kartben/hw-testing-rack/firmware/README.md

# Firmware (Zephyr)

Two applications, both on an ESP32-S3, share this tree:

| | |
|---|---|
| **Bay node** (this page) | one per bay: the board under test over USB/IP, its 5 V, its console |
| **[Power hub](power-hub/README.md)** | one per rack: USB-C PD in, rows A–D, the rack bus (CAN) master |

They speak the rack bus protocol ([docs/rack-protocol.md](../docs/rack-protocol.md))
and share [`common/`](common/): the protocol, the CH224A and CH446Q drivers,
Wi-Fi, hostname and DNS-SD, the web pages' CSS and helpers, xterm.js, the development server
and the screenshot tooling.

Firmware for the ESP32-S3 on each [bay node](../electronics/bay-node/design.py):
it exports the board under test (DUT) over the network with Zephyr's
**USB/IP host service**, switches and meters its 5 V, and gives remote access
to its console and RESET/BOOT lines.  It dogfoods Zephyr's new USB host stack
(`uhc_dwc2` on the ESP32-S3 OTG controller + `subsys/usb/host/usbip.c`).

> **Status:** builds against Zephyr main (4.5.0-rc2, pinned in
> [`west.yml`](west.yml)); **not yet run on hardware** — no bay node PCB has
> been assembled.  See [open items](#open-items).

```
firmware/
  west.yml                       west manifest (Zephyr main + hal_espressif + crypto)
  boards/hwtr/bay_node/          board definition: bay_node/esp32s3/procpu
  boards/hwtr/power_hub/         board definition: power_hub/esp32s3/procpu
  dts/bindings/                  hwtr,* bindings (dut-port, usb-mux, rack-bus, rack-rows,
                                 power-hub) and wch,ch224a (the hub's PD sink, a regulator)
  common/                        shared by both applications
    include/hwtr/, lib/          rack bus protocol (frames, hub and node state machines), Wi-Fi
    drivers/                     CH224A USB PD sink as a regulator (out of tree)
    web/                         rack.css, rack.mjs, vendor/xterm (xterm.js 6.0.0, MIT),
                                 devserver.py, shots.py
    tests/rack_bus/              the rack bus on a simulated rack (ztest, native_sim)
    tests/usbip/                 the patched USB/IP service on native_sim's virtual USB bus,
                                 a device unplugged mid-session (test_usbip.py)
  spikes/usb-hub/                bench app: a hub and several DUTs behind an ESP32-S3
  spikes/coproc/                 build-only: the DATA ×4 v2 co-processor's jobs on a Pico 2 (RP2350)
  power-hub/                     the power hub application (its own README)
  bay-node/                      the bay node application
    boards/esp32s3_devkitc_procpu.overlay   stand-in: same pin map on a DevKitC-1
    i2c-400k.overlay             the I²C bus at 400 kHz, to try at bring-up (100 kHz by default)
    app.overlay, data-x4.dtsi    a DATA ×4 on the DATA lead (the application's, not the board's: MCUboot)
    data-x6.dtsi                 or a DATA ×6: the same lead and image, told apart at each probe
    boards/m5stack_stamps3_procpu.*         bench node on a StampS3: console + network, no USB host
    boards/m5stack_cores3_procpu.*          bench node on a CoreS3: USB host and USB/IP on its USB-C ([docs/bench.md](../docs/bench.md))
    boards/xiao_esp32s3_procpu.*            bench node on a XIAO ESP32-S3: octal PSRAM as the node, USB host on its USB-C (same doc)
    web/index.html               status page and serial console (embedded gzipped)
    web/dev_server.py            the page against a simulated node, to work on the UI
    web/camera/, grab_camera.py  its camera's frames, grabbed from the 3D viewer (site/)
    tests/rfc2217/               host test of the RFC 2217 server against pyserial
    tests/console_sim/           the console, web server and RFC 2217 code on native_sim, with a Zephyr DUT
    wifi.conf.example            build-time Wi-Fi credentials (copy to wifi.conf)
```

## Building

A dedicated workspace, with this repository as the manifest repository:

```bash
west init -m https://github.com/kartben/hw-testing-rack --mf firmware/west.yml rack-ws
cd rack-ws
west update
west patch apply                        # Zephyr patches, until upstream (zephyr/patches.yml)
west blobs fetch hal_espressif          # Wi-Fi binary blobs
west packages pip --install             # esptool & co. for the ESP32 build
west build --sysbuild -b bay_node/esp32s3/procpu hw-testing-rack/firmware/bay-node
```

`--sysbuild` builds MCUboot in front of the application, for the updates
over the network ([docs/firmware.md › Over the network](../docs/firmware.md#over-the-network));
the images are signed with MCUboot's public test key unless
`HWTR_SIGNING_KEY` points at your own ([Signing key](../docs/firmware.md#signing-key)).
Without `--sysbuild`: the application alone, no updates over the network.

The repository is a Zephyr module (`zephyr/module.yml` at its root: the
boards, the bindings, `firmware/common/`).  West finds it in the workspace
above; each application also adds it itself (`ZEPHYR_EXTRA_MODULES`), so a
plain build works from any Zephyr workspace at a recent `main` (with
`hal_espressif` blobs fetched).  Sysbuild needs it known before the
application: there, add `-- -DEXTRA_ZEPHYR_MODULES=path/to/hw-testing-rack`.

```bash
west build -b bay_node/esp32s3/procpu path/to/hw-testing-rack/firmware/bay-node
west build -b power_hub/esp32s3/procpu path/to/hw-testing-rack/firmware/power-hub
```

No bay node yet?  An ESP32-S3-DevKitC-1 with the same GPIO map stands in
(status on the devkit's RGB LED, DUT on its "USB" port through an OTG adapter):

```bash
west build --sysbuild -b esp32s3_devkitc/esp32s3/procpu hw-testing-rack/firmware/bay-node
```

An M5Stack StampS3 is an even smaller bench node for the serial console and
the network side: no muxes, INA226 or USB host, and its USB-C port carries
the node's shell and logs (USB-Serial-JTAG).  The AUX UART and the
RESET/BOOT lines are on header pins (G1/G2, G4/G5; the map is in
[the overlay](bay-node/boards/m5stack_stamps3_procpu.overlay)), and
`bay aux loopback on` loops the UART back on itself to try the console
without a DUT:

```bash
west build --sysbuild -b m5stack_stamps3/esp32s3/procpu hw-testing-rack/firmware/bay-node
west flash --erase    # over its USB-C port; --erase once, see below
```

A module that ran other firmware may hold something else where the
settings live (`settings unavailable (-45)` at boot, nothing saved): erase
the flash once (`west flash --erase`, or just the `storage` partition).

Wi-Fi credentials can be built in — handy to flash a whole rack:

```bash
cp hw-testing-rack/firmware/bay-node/wifi.conf.example hw-testing-rack/firmware/bay-node/wifi.conf   # edit it
west build --sysbuild -b bay_node/esp32s3/procpu hw-testing-rack/firmware/bay-node -- -DEXTRA_CONF_FILE=wifi.conf
```

`wifi.conf` is git-ignored.  On Windows keep the workspace and build
directory on a short path (e.g. `C:\rack-ws`): `hal_espressif` and
`tf-psa-crypto` have file paths long enough to hit `MAX_PATH`.

## Flashing

The node runs from its row: the hub must have the row on (on a desk: 15–30 V
on J1, pin 1 +: the buck starts above 13.5 V).

1. Slide the bay's **SERVICE** switch on and plug a laptop into the front
   **PC** port, both on the fascia.  The firmware stops its USB host and
   hands the ESP32-S3's single USB PHY back to the USB-Serial-JTAG (LED
   yellow), which shows up as a serial port (and a JTAG adapter for
   OpenOCD).  A blank module shows it at once.
2. `west flash` (esptool resets the chip into its ROM loader over USB).  If
   the firmware is wedged (it takes the PHY and never lets it go), pull the
   drawer out, hold **BOOT** and tap **RESET**, or keep BOOT held while the
   hub power-cycles the row from its page (the row's other bays restart too):
   RESET sits partly under the drawer's left ledge, BOOT is clear.
3. SERVICE off: the host controller restarts and the DUT is back on USB/IP.

Both boards, recovery and the update plan (MCUboot, over Wi-Fi):
[docs/firmware.md › Programming](../docs/firmware.md#programming).

## First boot

The shell runs on the UART test pads (TP1 = TXD0, TP2 = RXD0, 115200 8N1) and,
once the node is on the network, over telnet (port 23).

```console
uart:~$ wifi cred add -s MyLab -k 1 -p secret      # stored in flash (settings)
uart:~$ wifi cred auto_connect
uart:~$ bay id b3                                   # hostname bay-b3.local, stored
uart:~$ bay status
```

Then, from any Linux machine on the LAN:

```console
$ usbip list -r bay-b3.local
$ sudo usbip attach -r bay-b3.local -b 1-1
$ open http://bay-b3.local/                # status page and DUT console
$ telnet bay-b3.local                     # bay shell
$ python -m serial.tools.miniterm rfc2217://bay-b3.local:4001 115200   # DUT console
```

## What it does

| Feature | Implementation |
|---|---|
| USB/IP export of the DUT | `CONFIG_USBIP` on `zephyr_uhc0` (= `&usb_otg`, DWC2 host, ESP32-S3 FS quirk), with the rack's patch (`zephyr/patches.yml`); TCP 3240; bus id by port: `1-1` (`1-1.<n>` behind a hub) |
| DUT power | TPS2553 EN on IO41, kept **on** at boot (the board pulls it up); `bay power on/off/cycle`.  Node v1.0 (`dut_port`'s `vin-efuse`): IO41 is the TPS26600's SHDN on the DATA lead's 20–28 V, **off** at boot and on only through [the DATA lead's power-on rule](../docs/firmware.md#the-data-leads-power-on-rule-node-v10) (SCL/SDA high, the INA226 answers, DATA_VIN up, the DATA board answers within `CONFIG_BAY_DATA_ANSWER_MS`); `CONFIG_BAY_DATA_POWER_AT_BOOT` tries it at boot |
| Over-current | TPS2553 ~FAULT on IO40 (interrupt): logged and counted; after `CONFIG_BAY_DUT_FAULT_OFF_MS` (1 s) in current limit VBUS is switched off and the fault latched until `bay power on`.  v1.0: the eFuse's ~FLT, or a DATA board that misses two polls, switches DATA_VIN off at once until `bay power on` |
| Telemetry | INA226 @ 0x40 through the Zephyr sensor API (`ti,ina226`, 50 mΩ, 50 µA/LSB, 4× averaging, 8.8 ms a reading): bus mV, mA, mW in `bay power` / `bay status` |
| Data path | reads PC_DET (IO13) and SVC (IO15); `bay mode classic` drives MUX_FORCE_PC (IO14), persisted |
| DATA ×4 co-processor | its image (a `no_flash` UF2, `bayctl coproc load`) in the `coproc` partition, loaded into its SRAM over PICOBOOT whenever it shows up in its bootloader on hub port 5 (`src/coproc.c`, [docs/firmware.md](../docs/firmware.md#open-items)); `/api/coproc`, `bay coproc` |
| SERVICE mode | stops the USB host and routes the internal PHY to the USB-Serial-JTAG (`CONFIG_BAY_SERVICE_PHY_HANDOVER`); restarts the host when SERVICE goes off |
| AUX console | UART1 (IO47 TX / IO21 RX), interrupt driven, shared by the web console (WebSocket, xterm.js), an RFC 2217 server (port 4001) and raw TCP (port 4000); settings persisted per bay; BREAK; TX released while the DUT is off.  See [Serial console](#serial-console) |
| AUX RESET/BOOT | open-drain pulses (IO12/IO48): `bay reset`, `bay boot`, the console's buttons, optionally RFC 2217 DTR/RTS (esptool) |
| Status LED | WS2812B on IO38 through the RMT (`worldsemi,ws2812-pulse-io`), see below |
| Buttons | BOOT (IO0) once booted: short press confirms an access claim, held ≥ 1 s power-cycles the DUT, ≥ 10 s resets access control.  RESET is the ESP32's EN |
| Camera | an Arducam Mega on J6 (SPI2, 4 MHz) and its light (LEDC PWM, 25 kHz), optional: snapshots and an MJPEG stream on TCP 8081, frames in PSRAM.  See [Camera](#camera) |
| Access control | who may use which service, a CI reservation, an admin key confirmed by a BOOT press; Zephyr's packet filter for the TCP services, a check per HTTP request.  See [Access control](#access-control) |
| USB devices | each enumerated device on the page's USB devices card, in `/api/usb` and `bay usb`: its name (the product string, else a table of known IDs, else vid:pid), maker, serial number, the classes of its interfaces (CDC ACM, HID, mass storage, CMSIS-DAP…), speed, bus id and slot, and its USB/IP client.  A thread reads each device's strings once, as it shows up, into PSRAM (`src/usb_info.c`) |
| DATA ×4 | a DATA ×4 board in the drawer (probed after each DUT_5V on): four ports, each switched on through the bay's budget, its ~FAULT, current and RESET/BOOT; `bay port`, `/api/ports`.  See [docs/multi-dut-node.md](../docs/multi-dut-node.md) |
| DATA ×6 | a DATA ×6 instead, on the same lead with the same image: the probe tells the boards apart (a DATA ×4 answers at 0x21, a DATA ×6 at 0x4C); six ports, each switched on through the bay's budget, its ~FAULT and current, no RESET/BOOT; the co-processor's hub port is its USB-C 6, left to USB/IP.  Tested on native_sim, not on a board yet ([docs/multi-dut-node.md › Which board](../docs/multi-dut-node.md#which-board-data-4-or-data-6)) |
| Board targets | each slot's Zephyr board, runner, probe and console, in NVS for the device in it; `/api/boards`, the page's Edit; `bayctl hwmap` reads them ([Board targets](#board-targets)) |
| Rack bus | CAN on the row cable (TWAI, IO18 TX / IO17 RX, 250 kbit/s) and the POS token (IO16 in, IO42 out): the node takes its position from the hub (node id = row × 16 + position, `C3` = 0x23), sends STATUS every second and INFO (IP, firmware) every 10 s, an ALERT on a DUT fault, and runs the hub's commands (power, reset, bootloader, identify, reboot; the ones that disturb the board are refused while the bay is reserved).  `src/rack.c` on `common/lib/rack_node.c`; the protocol is [docs/rack-protocol.md](../docs/rack-protocol.md) |
| Network | Wi-Fi station, DHCP, Wi-Fi credentials library (settings or build time), reconnects on its own; hostname `bay-<id>` answered over mDNS, its services advertised over DNS-SD (below); no power save, 20 MHz channels and 11 dBm of TX power, see [Wi-Fi in the rack](#wi-fi-in-the-rack) (`common/lib/net.c`, as the hub) |
| Shell | `bay …` commands, `radio`, plus the stock `wifi`, `net` shells, on UART0 and telnet |
| Fatal errors | restart the node instead of halting it (`src/fault.c`): a bay has to come back by itself, and its console is the USB host's.  The reason, the thread and the warnings and errors logged just before are kept across the restart in RTC memory, then reported: the log, `bay status` ("restarted: …"), `bay fault`, `/api/status`'s `last_fault`.  Gone at power-on |
| Web | Zephyr HTTP server on port 80: status page, JSON API (same actions as the shell), Prometheus `/metrics` through Zephyr's Prometheus library |

### Shell

| Command | Effect |
|---|---|
| `bay status` | id/hostname, IP, rack position, data path, USB host (devices, USB/IP sessions), power and V/I/P, fault count, AUX stats |
| `bay fault` | the fatal error that restarted the node and the log just before it; the warnings and errors since this boot |
| `bay power` | DUT VBUS state and V/I/P |
| `bay power on` / `off` | switch DUT VBUS (`on` also clears a latched fault) |
| `bay power cycle [ms]` | off, wait (default 1000 ms), on |
| `bay reset [ms]` | pulse the DUT's RESET line low (default 100 ms) |
| `bay reset hold` / `release` | hold / release RESET |
| `bay boot` | hold BOOT, pulse RESET, release BOOT 200 ms later: ROM bootloader on most MCUs |
| `bay boot hold` / `release` | hold / release the BOOT strap |
| `bay usb` | the USB devices: bus id, vid:pid, name and maker, serial number, read-ahead, USB/IP client |
| `bay port` | the DATA board (×4 or ×6) and its ports: busid, on/off, fault, V/I, USB device |
| `bay port <n> on` / `off` / `cycle [ms]` | one port (`on` through the bay's budget, and clears a latched fault) |
| `bay port <n> reset` / `boot [cycle]` | its RESET pulse; BOOT held across a RESET pulse, or across a power cycle of the port (a DATA ×4's ports; a DATA ×6 has no such line) |
| `bay mode [usbip\|classic]` | show, or force/release classic mode (persistent) |
| `bay aux` | AUX UART settings, consoles connected, byte counters |
| `bay aux <baud> [8N1]` | set and save the AUX UART baud rate and format (`7E1`, `8O2`, …) |
| `bay aux break [ms]` | hold the DUT's RX line low (default 250 ms) |
| `bay aux send <text>` | send a line to the DUT (with the console's Enter) |
| `bay aux loopback [on\|off]` | test without a DUT: the UART loops its TX back to its RX (ESP32) |
| `bay id [id]` | show or set the bay id (persistent), hostname `bay-<id>.local`; without one, the rack position (`bay-c3.local`) |
| `bay camera` | the camera: model, clients, frames, and its settings |
| `bay camera set <name> <value>` | one setting, saved: `exposure auto` or `1200`, `white_balance cloudy`, `brightness -1`, … ([Camera](#camera)) |
| `bay camera reset` | the image settings back to automatic (resolution, quality, light, rotation kept) |
| `bay access` | access control: admin key, rules, lease, connections, refusals |
| `bay access claim` | confirm a pending claim, like a short press on BOOT (not over telnet) |
| `bay access on` / `off` | apply the rules / let every address use everything (`off`: not over telnet) |
| `bay access release` | end the lease |
| `bay access reset` | forget the admin key, the rules and the lease (not over telnet) |
| `radio [<dBm>]` | show, or set and save, the Wi-Fi TX power (2–20 dBm; the hub has it too) |

### Network services

| Port | Service |
|---|---|
| TCP 3240 | USB/IP (`usbip list` / `usbip attach`) |
| TCP 80 | status page, serial console (WebSocket `/console/ws/<n>`), JSON API, `/metrics` (`CONFIG_BAY_HTTP_PORT`) |
| TCP 23 | telnet shell (no login of its own: give the shell right to admin hosts only) |
| TCP 4001 | AUX UART, RFC 2217, one client (`CONFIG_BAY_RFC2217_PORT`) |
| TCP 4000 | AUX UART, raw bytes, one client (`CONFIG_BAY_AUX_TCP_PORT`) |
| TCP 8081 | the camera: `/snapshot.jpg`, `/stream.mjpg`, up to 3 clients (`CONFIG_BAY_CAMERA_PORT`, `_CLIENTS`); 503 without a camera |
| UDP 5353 | mDNS: `bay-<id>.local`; without an id, the rack position the hub gave (`bay-c3.local`); before that `bay<MAC>`.  DNS-SD, under that name: `_http._tcp` (80), `_usbip._tcp` (3240) while the DUT is on the S3's USB (not in classic or service mode), `_rfc2217._tcp` (4001) while it listens; TXT `id`, `pos` (rack position), `fw`, `mode` (`usbip`, `classic`, `service`) and `slots` with a DATA ×4.  Checked every 2 s (`common/lib/dnssd.c`), answers kept 2 min in caches (`avahi-browse -rt _usbip._tcp`, `dns-sd -B _usbip._tcp`) |

Which address may use which of them: [Access control](#access-control).
Until a node is claimed it is open, as it always was.

### Wi-Fi in the rack

Twelve nodes in rows A–C (sixteen if row D is used), the hub and the DUTs' own radios
share one room, with each node's antenna about 10 cm from its DUTs.  So each
node (and the hub, through `common/lib/net.c`) sets its station's radio
before every connection.  A BabbleSim model of the rack
([docs/wifi-coexistence.md](../docs/wifi-coexistence.md)) ranks what helps a
BLE link between two DUTs: the host's channel classification first, then the
node's TX power and the AP's distance; the Wi-Fi channel and the number of
nodes hardly matter.

- **No power save**: the radio stays awake.  In modem sleep (the ESP32 driver's
  default) the AP holds every frame for the node until the next DTIM beacon:
  the bench XIAO answered a ping from a wired PC in 174 ms on average, up to
  350 ms, against 13–16 ms awake.  It costs about 0.2 W per node, already in
  [the power budget](../docs/power.md)'s 0.7–1 W.
- **20 MHz channels** (HT20): a 40 MHz channel would spill onto the next one.
- **11 dBm of TX power** instead of the radio's full 20 dBm
  (`CONFIG_HWTR_NET_TX_POWER_DBM`; `radio <dBm>` changes it and saves it).
  With the AP 1–3 m away that still leaves 30 dB of margin, and the DUTs hear
  much less of the nodes.  On the bench XIAO (RSSI −49 dBm) the status page
  loaded no slower at 11 or 8 dBm than at 20.
- **A lost link is held**: 15 s without the AP's beacons before the link
  counts as lost (`CONFIG_HWTR_NET_BEACON_TIMEOUT_S`, 6 s by default), then up
  to 30 s with the interface up and its address kept while the station
  reconnects (`CONFIG_ESP32_WIFI_STA_LINK_HOLD_MS`, a patch in
  [zephyr/patches.yml](../zephyr/patches.yml)).  Without it, every drop took
  the address and every USB/IP session down.  The connections stay open; a
  transfer in flight still has to end within its client's timeout (30 s for a
  mass storage command).  `bay fault` lists each loss with its reason ("Link
  lost, reason N").

Set the AP up for it:

- one channel for the whole rack, **6 or 11**, not 1: a DATA ×4's USB hub
  runs a 480 MHz PLL, whose 5th harmonic is 2.400 GHz, at the bottom of channel 1;
- that channel **fixed**, not chosen automatically, and **one AP, without mesh
  nodes or repeaters**: on the bench a home mesh dropped its stations now and
  then (reason 200, beacons missing; reason 6, sent away, at RSSI −46), the
  node and a PC on another of its APs at the same second, and moved the node
  from channel 6 to 2;
- 20 MHz wide on 2.4 GHz;
- 1–3 m from the rack, behind it or beside it, not in front of the drawers.

How much one channel carries (an ns-3 study, [wifi-capacity-ns3.md](../docs/wifi-capacity-ns3.md)):
- 8 simultaneous USB/IP flashes at full speed;
- saturation between 8 and 12 flashes, at about 3.2 MB/s;
- half of that when the DUTs' own Wi-Fi or a neighbour shares the channel.

So:
- a dedicated AP with 11b off;
- the DUTs' Wi-Fi inside the bays on the rack's channel, and distant DUT networks on the other;
- at most 8 flashes at once per channel.

**Radio-quiet mode** (not built yet).  A DUT's own RF test, a range or
sensitivity measurement, wants the node's radio as quiet as it can be for its
duration.  Planned: `radio quiet <s>` (and the API) drops the TX power to
2 dBm and holds the USB/IP traffic of the node's other DUTs, until the time
runs out or `radio quiet off`, then puts both back.  The node stays
associated: the session that runs the test keeps its link.

### Web page and API

`http://bay-<id>.local/` is a single self-contained page: plain HTML, CSS and
an ES module, no framework or CDN, about 25 KB gzipped in flash (plus
xterm.js for the console, below).  It follows the browser's light/dark
theme, polls `/api/status` every 2 s while visible, and offers the shell's
main actions.

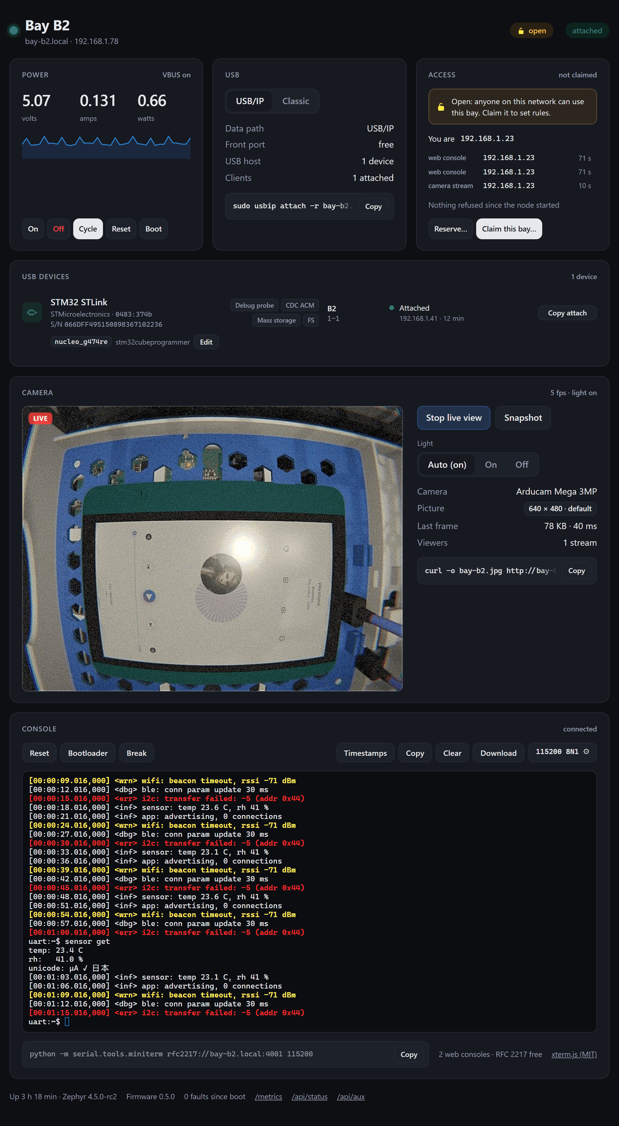
[picture p6: docs/img/web-ui-dark.png]
Status page of bay B2, dark theme: VBUS on with live V/I/P and a current sparkline, a USB/IP client attached


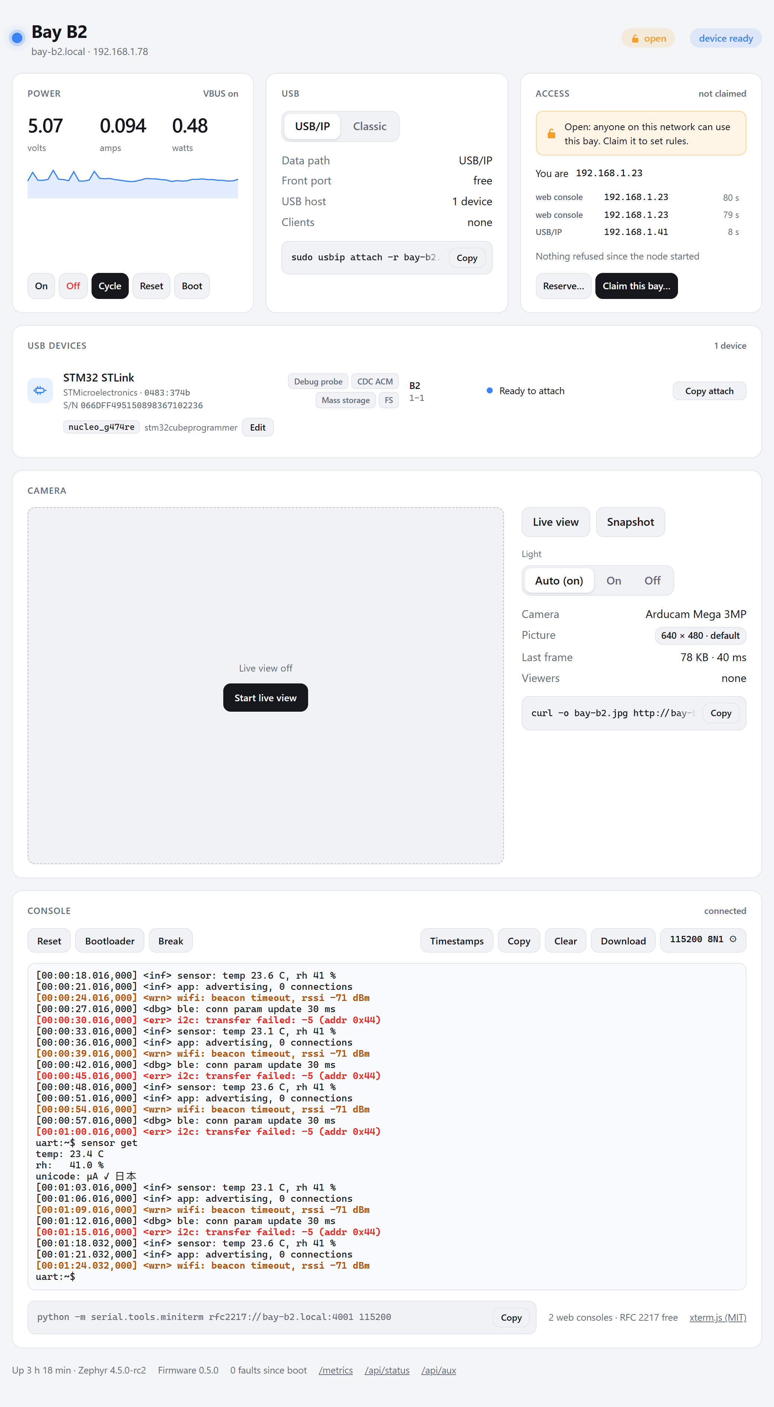
[picture p7: docs/img/web-ui-light.png]
Status page, light theme: the DUT is enumerated and ready to be attached
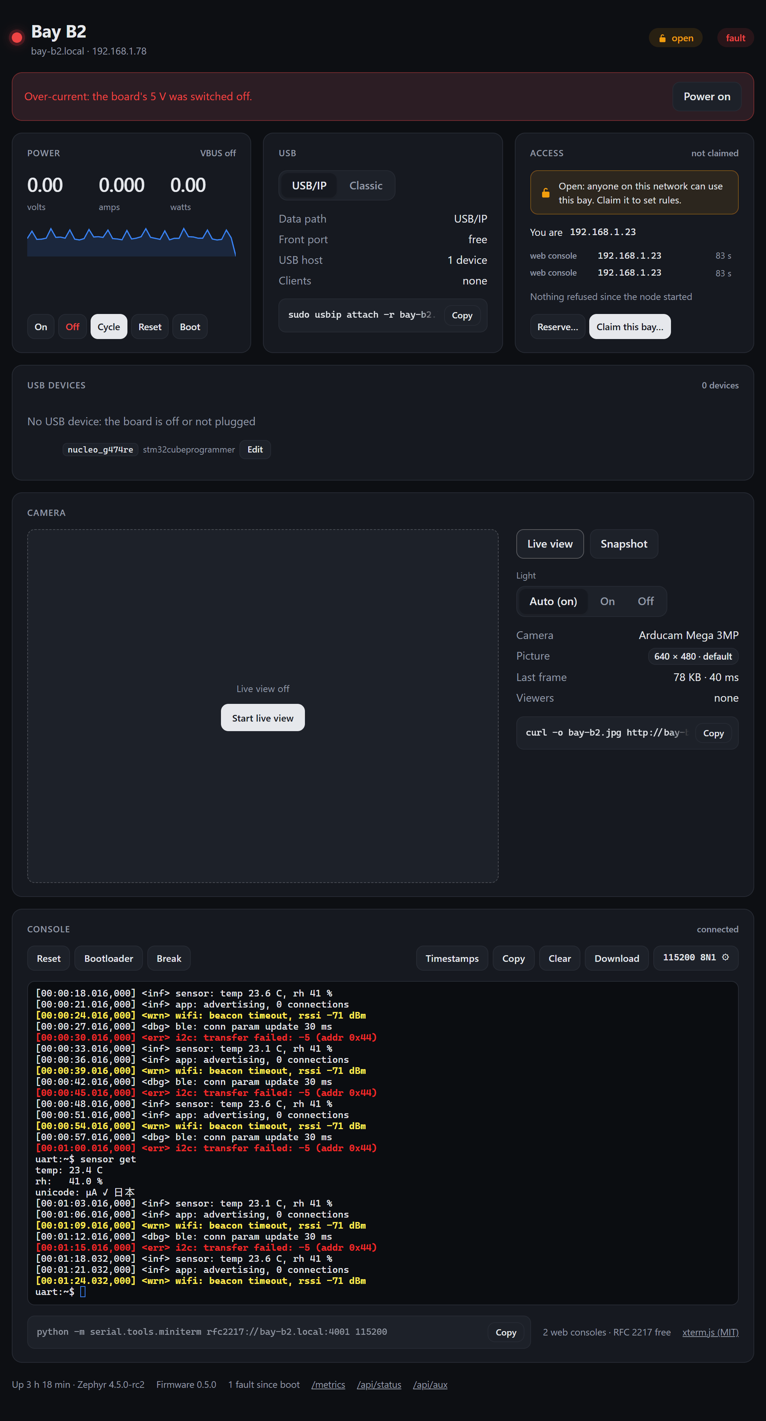
[picture p8: docs/img/web-ui-fault.png]
Status page after an over-current trip: red banner with a Power on button, VBUS off
|  |  |
|---|---|
| Light theme, DUT enumerated and ready to attach | Over-current: VBUS cut by the firmware |

| Endpoint | |
|---|---|
| `GET /api/status` | everything `bay status` shows, as JSON; `data_board`: the board on the DATA lead, `"x4"`, `"x6"`, `"unknown"` (something at 0x20 that is neither, left alone) or `null`, shown as the page's header badge; `rack`: `node` (0 before the hub gave one), `pos` (`"C3"`), the hub's contract; `camera` (camera builds): `GET /api/camera` without the settings and choices; `last_fault`: the fatal error that restarted the node ("fatal error 4 in usbh: …"), "" none since power-on; `budget`: what the ports are switched on within, `unit` `mW` (node v1.0, on DATA_VIN) or `mA` (the first design, on DUT_5V), `limit` (the hub's grant when `granted`, else the bay's own), `reserve` for a start, `draw` now, `waiting` ports, `sheds` since boot, `board` (a DATA board answers), `lead_off`: why v1.0's DATA lead is off ("SCL or SDA held low: DATA lead reversed?", …), null when it is not; each port's `power.state`: `on`, `off`, `fault`, `waiting` (wanted, kept off for its turn or for power), `shed` (shed for power, back once there is room); `power.queued`: a request to switch it on as soon as there is room is waiting |
| `POST /api/power` | `{"action": "on" \| "off" \| "cycle", "ms": 1000}` |
| `POST /api/reset` | `{"ms": 100}` (body optional) |
| `POST /api/boot` | DUT into its bootloader (BOOT held across a RESET pulse) |
| `GET /api/ports` | the boards: a DATA ×4's four ports or a DATA ×6's six, or the one DUT as port 1, each with its `hub_port` and `lines` (it has RESET and BOOT) ([docs/multi-dut-node.md](../docs/multi-dut-node.md)) |
| `GET /api/usb` | the USB devices: `{"hub": {vid, pid, name, data_x4 (true on a DATA ×4 only)} or null, "devices": [{busid, slot, hub_port, vid, pid, name, name_from (product, table, ids), manufacturer, serial, strings, speed, classes, ttys, usbip: {client, since_s, offered, read_ahead}, ma}]}`; `offered`: the USB/IP service exports it (not a hub, within `USBIP_DEVICES_COUNT`); `ttys`: the interfaces a host makes a tty of, numbered as udev does (`[{"if": "02"}]`, `"port": 0` for a serial bridge's); the strings come from the devices, escaped; the serial numbers are for everyone with the status right (twister hardware maps) |
| `POST /api/ports/<n>/power`, `/reset`, `/boot` | one port; `boot` takes `{"power_cycle": true}`; 409 when the bay's budget has no room (the message gives the draw, the reserve and the limit, and says when it is the hub's grant; the request is not queued).  `{"action": "on", "when": "available"}` queues it instead: 202 and `power.state` `waiting` until it goes on by itself, in its turn among the ports waiting; `{"action": "cancel"}` (409 when nothing is queued) or an `off` withdraws it.  On a DATA ×4 node `/api/power`, `/reset` and `/boot` need `"port": n` |
| `GET /api/boards` | each slot's [board target](#board-targets) and the device in the slot now: `{"slots": [{slot, port, board, runner, probe_id, console, map, pinned: {vid, pid, serial}, device: {busid, vid, pid, manufacturer, product, serial, strings, ttys}, mismatch}]}`, `null` where unset or empty |
| `GET`, `PUT /api/ports/<n>/board` | one slot's (`n` is 1 on a one-board node); `PUT {"board": "nucleo_g474re", "runner": "stm32cubeprogrammer", "probe_id": "…", "console": "usb" \| "usb:02" \| "aux" \| "none", "map": true}` saves it for the device in the slot now, or for `"pin": {"vid", "pid", "serial"}` (a restore); no `board` clears it; control right, and the port's lease |
| `GET /board-targets.json` | the targets the page suggests, by USB ID: `mechanical/boards/boards.yaml` at build time (`web/board_targets.py`) |
| `POST /api/mode` | `{"mode": "usbip" \| "classic"}` (persistent) |
| `GET /api/aux` | AUX UART settings, consoles connected, byte counters |
| `POST /api/aux` | any of `{"baud": 115200, "data_bits": 8, "parity": "none" \| "odd" \| "even", "stop_bits": 1, "enter": "cr" \| "lf" \| "crlf", "echo": false, "esptool_reset": false}`, applied and saved; answers with `GET /api/aux` |
| `POST /api/aux/break` | `{"ms": 250}` (body optional) |
| `POST /api/console/ticket` | a single-use ticket (10 s) for the next WebSocket, for an address with the console right |
| `GET /console/ws/<n>?t=<ticket>` | WebSocket to the AUX UART, `n` < `CONFIG_BAY_CONSOLE_WEB_CLIENTS` (see below) |
| `GET /api/camera` | the camera: `present` (false: no camera answered on J6), `model`, `port`, `resolution`, `quality`, `light` (the bay's setting), `rotation`, `lit`, `clients`, `streams`, `frames`, `errors`, `last_bytes`, `last_ms`, `fps`; its `settings` and the `choices` (lists and ranges) |
| `POST /api/camera` | any of the settings ([Camera](#camera)), e.g. `{"exposure": 1200, "white_balance": "cloudy", "brightness": -1}`, and `"reset": true` (image settings back to automatic first); all or nothing, saved; control right; 404 without a camera |
| `GET /metrics` | Prometheus: `bay_dut_vbus_volts`, `bay_dut_current_amperes`, `bay_dut_power_watts`, `bay_dut_power_on`, `bay_dut_fault`, `bay_dut_faults_total`, `bay_usb_devices`, `bay_usbip_sessions`, `bay_aux_{rx,tx}_bytes_total`, `bay_access_refused_total`, `bay_power_limit_watts` (v1.0: the grant, or the bay's own limit), `bay_ports_waiting`, `bay_ports_shed_total`, all labelled `bay="<id>"` |
| `GET /api/access` | the caller's address and rights, the lease, the connections; signed: the rules and the refusal log too |
| `POST /api/lease` | `{"ttl_s": 3600, "note": "twister job 8812"}` reserves or renews, `{"release": true}` ends it |
| `GET /api/access/nonce` | a single-use nonce (60 s) to sign an admin request |
| `POST /api/access/claim` | `{}` or `{"key": "<64 hex>"}` starts a claim, then `{"ticket": "..."}` until someone presses BOOT |
| `POST /api/access/rules` | signed: `{"enabled": true, "everyone": ["status"], "sources": [{"name": "ci-runners", "cidr": "192.168.1.40/30", "allow": ["status", "control", "console", "usbip"]}]}` |
| `POST /api/access/kick` | signed: `{"id": "usbip:51234"}`, an id from `GET /api/access` |
| `POST /api/access/key` | signed: `{"key": "<64 hex>"}`, a new admin key |
| `GET /api/update` | the firmware: `version`, image `id`, `test_key`, `trial` (what it waits for, time left), `last` update (`confirmed`, `rolled back`); also `firmware` in `/api/status` (MCUboot builds) |
| `POST /api/update/begin` | signed: `{"size": N, "sha256": "<64 hex>", "force": false}` → `{"ticket": …}`; a reserved bay needs `force` |
| `POST /api/update?ticket=…` | the image (`zephyr.signed.bin`), streamed into slot 1 → `{"state": "rebooting", "version": …}`, then a test boot ([docs/firmware.md › Over the network](../docs/firmware.md#over-the-network)) |

Every action POST answers with the new status document; errors come back as
`{"error": "..."}` with a 4xx status: 403 when the access rules refuse the
caller (with `reason`, `service` and the address the node saw), 423 while
another address holds the lease.

```console
$ curl -s bay-b3.local/api/status | jq .dut
$ curl -s -X POST bay-b3.local/api/power -d '{"action":"cycle","ms":2000}'
$ curl -s bay-b3.local/metrics
```

To work on the page without a node, `python firmware/bay-node/web/dev_server.py`
serves it on <http://localhost:8766> with a simulated node, console included
(a fake Zephyr board that boots, logs in colour and runs a small shell;
`/dev/fault` trips a fake over-current, `/dev/attach` toggles a fake USB/IP
client; `/dev/image?version=0.6.0` is an image to try a firmware update
with, `/dev/rollback` makes the next update roll back), and its camera on the
next port (8767): bay B2's camera as the [3D viewer](https://kartben.github.io/hw-testing-rack/?bay=B2&view=camera&camlight=1&preview=B2)
renders it, lens, noise and JPEG included, the GIGA's screen playing, the
light on or off (`/dev/camera` unplugs it);
`python firmware/bay-node/web/grab_camera.py` grabs those frames again from `site/`.
The screenshots come from that simulation:
`python firmware/bay-node/web/screenshots.py` (Playwright, Pillow and an
installed Chrome or Edge) regenerates `docs/img/web-ui-*.png`.

### Board targets

Each slot (the bay, or a DATA board's A1.1–A1.4 or A1.1–A1.6) keeps the Zephyr board in it,
in NVS (`src/boards.c`): its target, west runner, probe id, the console
twister reads, and whether it goes in the hardware map.  The USB devices
card shows it under the device, with Edit (control right); the dialog
suggests the targets `mechanical/boards/boards.yaml` lists for the
device's USB ID (`usb:`, per board and per target).

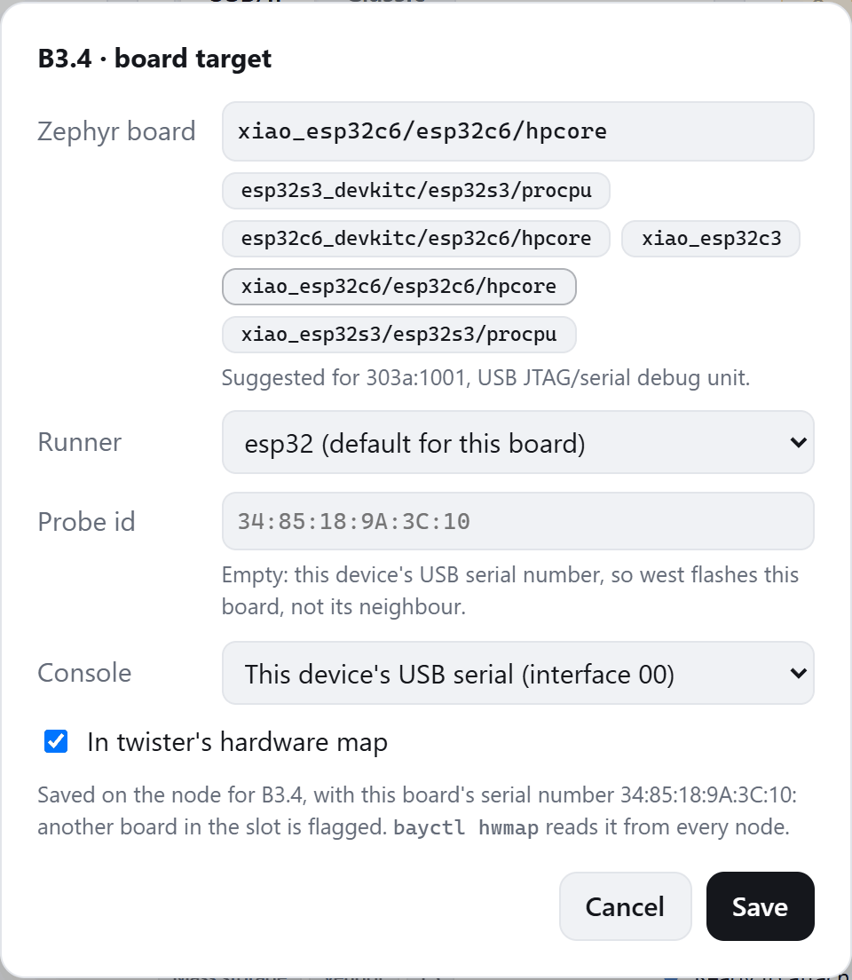
[picture p9: docs/img/web-ui-board-target.png]
Board target dialog of B3.4, a XIAO ESP32-C6 (303a:1001): the Zephyr board xiao_esp32c6/esp32c6/hpcore picked from five suggestions, runner esp32 (the board's default), probe id empty (the device's serial number), console the device's USB serial, in twister's hardware map


- **Pinned to the board.**  The target is saved for the device in the slot
  then (USB ID and serial number); another board in the slot shows
  "Another board in the slot" until its target is saved.
- **Probe id**: empty means the device's USB serial number, so west flashes
  this board and not its neighbour.
- **Console**: `usb`, the device's first tty
  (`/dev/serial/by-id/usb-…-if02` on the CI host); `usb:NN`, another
  interface; `aux`, the bay's AUX UART over RFC 2217 (one-board nodes);
  `none`.
- **`bayctl hwmap`** builds twister's hardware map from every node's
  targets, through the hub's node list, and `bayctl export lab` /
  `import lab` back them up ([docs/ci.md](../docs/ci.md)).

### Camera

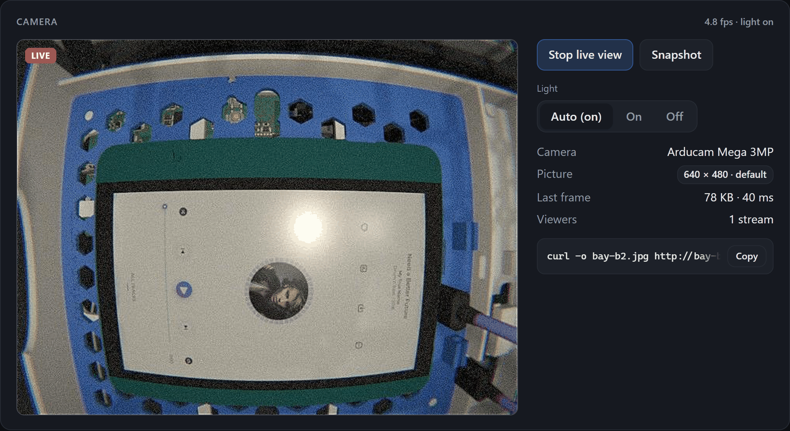
[picture p10: docs/img/web-ui-camera.png]
Camera card of bay B2: the live view of its GIGA R1 and the board's screen (simulated: as the 3D viewer renders them), the light switch (auto, on, off), the camera's model, its picture settings, the last frame's size and time, one stream watching


Each bay may have its own camera: an Arducam Mega (3 or 5 MP, JPEG made in
the camera) on a PH 8 lead to J6, and white LEDs beside it, switched by the
node.  On its own port, so that a stream never holds the web server:

| Request (TCP 8081) | |
|---|---|
| `GET /snapshot.jpg` | one JPEG, with its length |
| `GET /stream.mjpg` | MJPEG (`multipart/x-mixed-replace`), at most 5 frames a second (`CONFIG_BAY_CAMERA_FPS`) |
| `?light=on\|off\|auto` | for this client; `auto` is the bay's setting.  While the bay is reserved, only the lease holder's wish switches the light |

```console
$ curl -o b3.jpg 'http://bay-b3.local:8081/snapshot.jpg?light=on'
$ ffplay http://bay-b3.local:8081/stream.mjpg
```

One thread (`src/camera.c`) owns the camera and sends each frame to every
client, page and scripts alike.  The light comes on while frames are taken
for someone who wants it, and the first frame waits 300 ms for the sensor's
auto exposure.  Frames land in two 512 KB buffers in PSRAM, read whole
from the camera's FIFO (no SPI DMA); a frame is cut at its JPEG end
(`common/lib/jpeg.c`, host-tested), since the FIFO may run past it.  The
upstream driver keeps capturing once started (its stream stop does not stop
its work item, which spins while no buffer is queued): the node plugs the
driver's work queue between frames and runs it at the lowest priority.
Without a camera, its driver does not start: the port
answers 503, `present` is false and the rest of the node runs as before.
The hub shows which bays have one (rack bus STATUS byte 6).

**Settings**, saved per bay and applied between two frames (the page's
picture button, `POST /api/camera`, `bay camera set`):

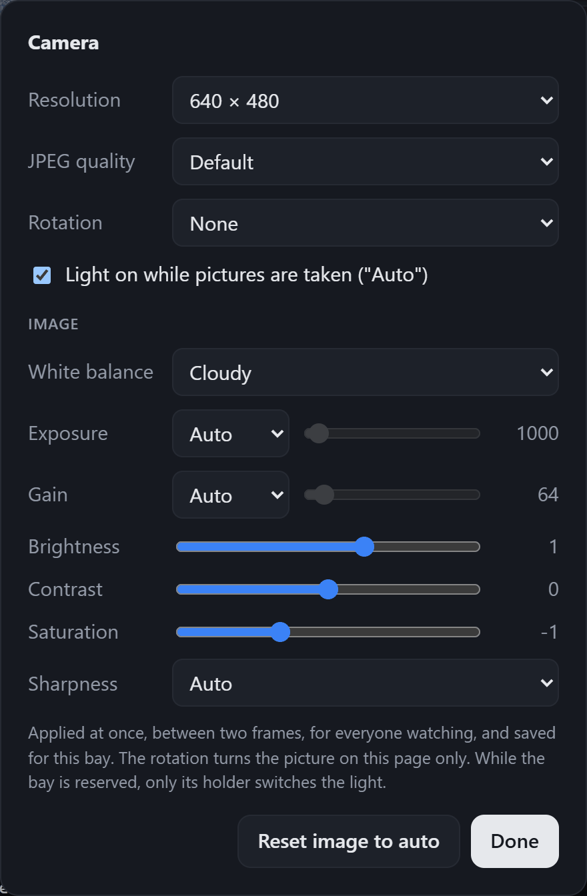
[picture p11: docs/img/web-ui-camera-settings.png]
The camera settings of bay B2: resolution, JPEG quality, rotation, the light, then the image: white balance cloudy, exposure and gain automatic, brightness +1, contrast 0, saturation -1, sharpness automatic, and a Reset image to auto button


| Setting | Values | |
|---|---|---|
| `resolution` | `320x240`, `640x480`, `1280x720`, `1600x1200`, `1920x1080` | |
| `quality` | `high`, `default`, `low` | JPEG compression |
| `light` | `on`, `off` | what `?light=auto` means |
| `rotation` | `0`, `90`, `180`, `270` | the page turns the picture (the camera's JPEGs are as taken) |
| `exposure` | `auto`, `manual`, or a value 0–30000 (manual) | the manual value in `exposure_value`, kept while automatic; the sensor's own unit, to calibrate on the bench |
| `gain` | `auto`, `manual`, or 0–1023 (manual) | `gain_value` likewise |
| `white_balance` | `auto`, `sunny`, `office`, `cloudy`, `home` | presets of the camera |
| `brightness` | −4 … 4 | 0 is the camera's default |
| `contrast`, `saturation` | −3 … 3 | |
| `sharpness` | `auto`, 1–8 | 3 MP Mega only (`none` on a 5 MP) |

They go through the Zephyr video controls of `arducam,mega`.  Two of the
driver's quirks are handled here: for it 1 means automatic exposure (Zephyr's
enum says 0), and the control framework skips a value equal to the one it
has cached, a cache that starts without the camera being written, so each
control is first written through another value.  Not offered: colour
effects, exposure compensation (the driver's is broken: every value ends as
the default), mirroring (not in the driver: use `rotation`), focus (below).

**Focusing the lens.**  The 3 MP Mega's M12 lens has no autofocus: it is
focused once, by hand, at the real distance (lens tip to board ≈ 75–80 mm).

1. Pod mounted, drawer in, a board on the plate (or a printed target:
   small text, a ruler) at its working height.
2. Bay page › Camera: resolution 1600 × 1200 (the Picture button), light on,
   **Live view**.  Each frame takes about half a second at 4 MHz.
3. Loosen the lock nut on the lens barrel and turn the lens in small steps,
   waiting a frame each time, until the silkscreen text is sharpest.  Take a
   **Snapshot** and zoom in the browser to judge.  Boards stand 36–42 mm
   high: focus on a board of middle height and the others stay sharp enough.
4. Hold the lens still and tighten the nut finger-tight; check with one
   more snapshot, then set the resolution back (640 × 480 for the stream).

### Wires

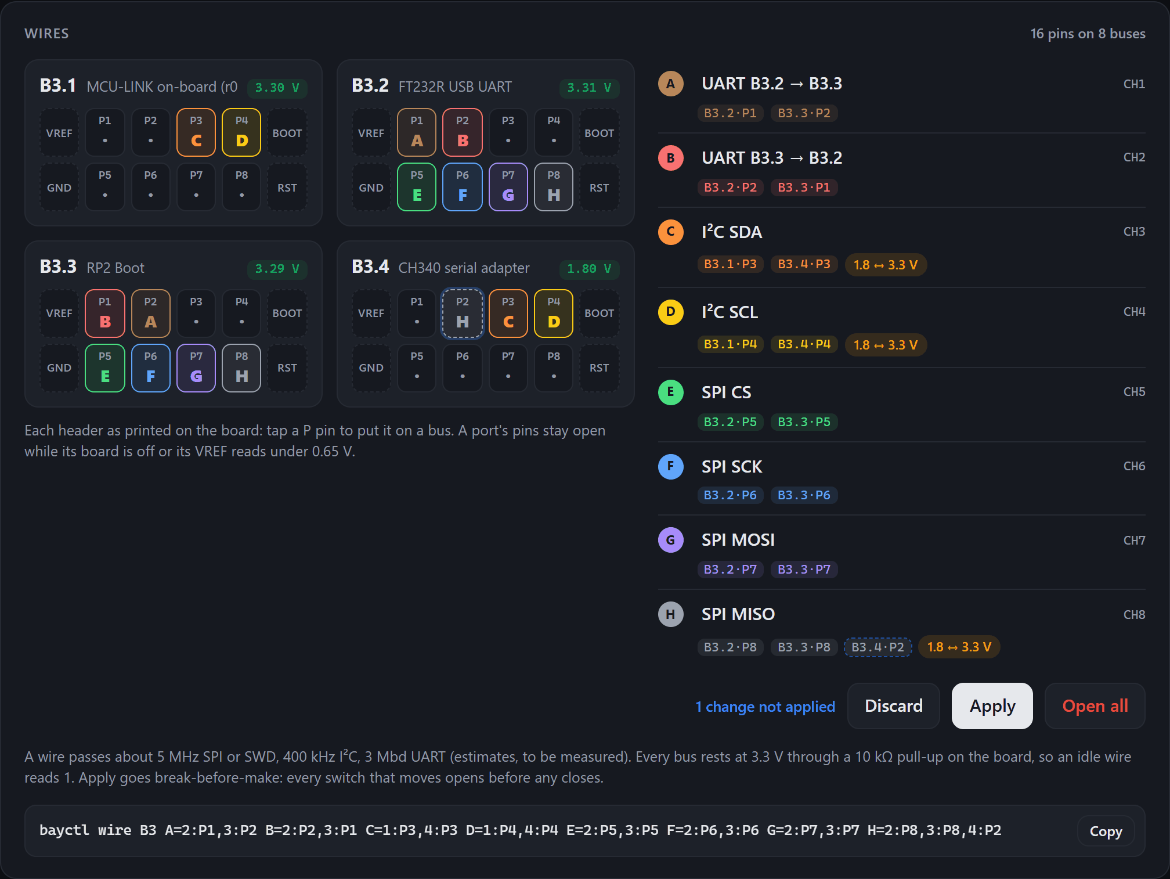
[picture p12: docs/img/web-ui-wires.png]
Wires card of a DATA ×4 bay (simulated): each port's 2 × 6 header as printed, its board and VREF; the buses A–H named, each with its pins: a UART each way between B3.2 and B3.3, I²C from B3.1 to the 1.8 V board in B3.4 (tagged 1.8 ↔ 3.3 V), SPI; one pin moved and not applied yet


On a DATA ×4 bay the page has a card for the pin matrix (`web/wires-card.mjs`,
served as `/wires-card.mjs`; `/api/wires`, `src/wires.c`).  Each port's
header is drawn as printed on the board; a P pin tapped goes on one of the
buses A–H, which the analyzer reads as CH1–8.  Changes are staged, then
**Apply** sends them together: the node opens every switch that moves before
it closes any.  **Open all** stages every pin off the buses.  The buses'
names are kept on the node, and the Logic analyzer card names its lanes
with them.  A port's pins stay open while it is off (striped), or while its
VREF reads under 0.65 V; on the v1.0 the node has no VREF reading yet
(`VREF ?`).  A tag marks a bus joining a 1.8 V and a 3.3 V board, a single
pin (probe only) and two pins of one board.  `bayctl wire B3 A=2:P1,3:P2`
does the same from a terminal; the card shows the line.  Not tried on
hardware yet.

### Logic analyzer

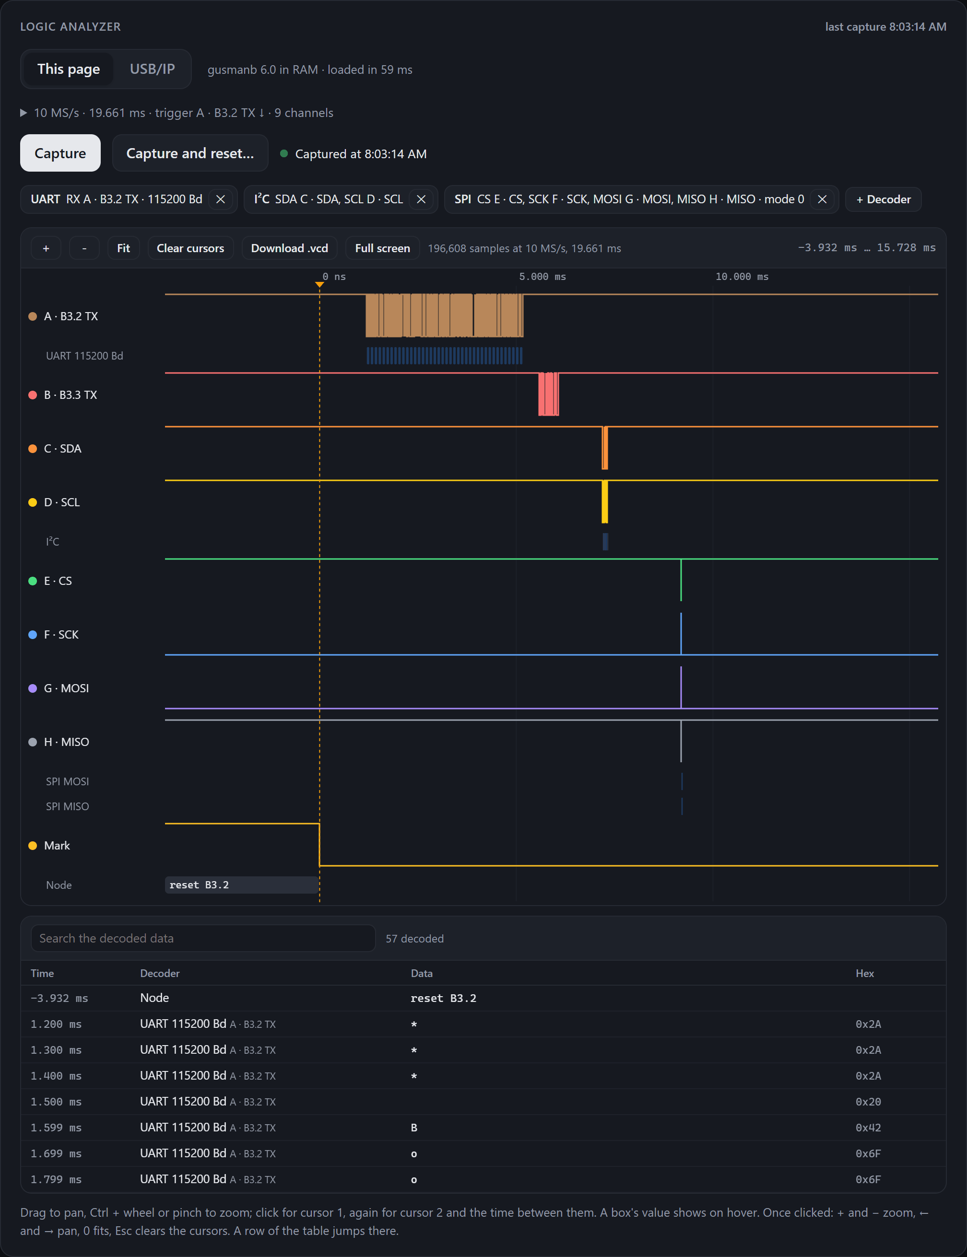
[picture p13: docs/img/web-ui-analyzer.png]
Logic analyzer card of a DATA ×4 bay (simulated) after Capture and reset on B3.2: the settings folded to one line, the buses A–H named with the Mark lane, the decoded rows under them, and the decoded table with its search


On a DATA ×4 bay the co-processor runs gusmanb's LogicAnalyzer, and the
bay page has a card for it (`web/analyzer-card.mjs`, served as
`/analyzer/card.mjs`; it loads only when `/api/status` has an `analyzer`).
Its channels are the buses A–H, which the Wires card joins to the boards'
pins, and the node's MARK on CH13.  The card captures through the node's
relay (`src/analyzer.c`, `/analyzer/ws`) with the analyzer page's own
modules (the protocol, the viewer, the decoders), and holds the analyzer
only while it captures.  **Capture and reset** turns the Mark lane on, arms
the analyzer on MARK's fall and pulses a board's RESET: the capture starts
as the board leaves reset.  **USB/IP** hands the analyzer to gusmanb's
desktop app or PulseView (`usbip attach` on the busid it shows) until it is
switched back.  Bus names, settings and decoders stay in the browser.

The card and the standalone analyzer page are one UI (`panel.mjs`).  After a
capture the settings fold to one line and the viewer takes the room; **Full
screen** gives it the window.  The decoded data is also a table: search it,
click a row or walk it with the arrows, and the viewer jumps there.  A UART's
bytes make one row per line of text, or per burst of a binary protocol, so a
search finds a whole word.  **PWM / clock** gives a signal's frequency and duty
cycle; periods alike to a sample make one box, so a change shows.  **1-Wire**
reads resets, presence, ROM commands and codes with their CRC, and bytes, at
standard speed.  **CAN** reads classic frames on a controller's TX or RX pin,
before its transceiver: identifier, data, CRC and ACK; an FD frame is named and
skipped.  **SWD** reads requests by name, ACKs and data, with their parity, line
resets and the switch from JTAG: what to look at when a flash fails.  Over a
box, a tooltip gives its value.  With the viewer focused, + and − zoom, ← and
→ pan, 0 fits and Esc clears the cursors.

A trigger fires at once if its line already rests at the level the edge leads
to, seen on the bench: `A:fall` on a line that is low does not wait for a fall.

You ask for a duration, and the card says what the buffer holds at that
rate.  It warns when the duration does not fit, or when the rate is low for a
decoder (under ten samples a bit for a UART, 10 MS/s for WS2812B; for I²C and
SPI, once a capture shows clock pulses 1 or 2 samples wide), with a button for
a rate that does.

**Save capture** writes a JSON file with the samples, the names and the
decoders; **Open a capture…** reads it back on either page, with no analyzer
there.  `format`, `version`, `channels`, `names`, `rate`, `pre`, `post`,
`decoders`, `bytesPerSample` and `samples` (base64 of little-endian words, bit
*i* = `channels[i]`, sample `pre` the trigger) are all a script needs to read it.
**Download .vcd** stays for PulseView and GTKWave.

`bayctl capture` does the same with no browser, so that a test can assert what
a board sent:

```bash
python tools/bayctl.py capture B3 --ch A --rate 10M --duration 20ms --trigger A:fall \
    --decode uart:rx=A,baud=115200 -o run1
```

It prints `armed` once the analyzer waits, then saves `run1.capture.json`, which
either page opens, and `run1.decoded.json`, with each decoded row's boxes, its
`values` in order and, where the decoder groups them, its `frames` (a UART's
lines, with their `bytes`) and `stats` (PWM's frequency and duty cycle: `min`,
`max`, `mean`).  `--reset B3.2` triggers as that board leaves reset.  A
trigger that does not come in `--timeout` seconds exits 3.  It runs the page's
own modules on Node 22 or later (`tools/analyzer_capture.mjs`), so its results
are what the viewer shows; the rest of bayctl needs only Python.  For sigrok's
many other decoders, `sigrok-cli` reads the page's .vcd as a program of its own.
`dev_server.py --ports 4` simulates the analyzer: a UART on A and B, I²C on
C and D, SPI on E–H, MARK around a reset.

### Front display (study)

A Waveshare 1.9" touch LCD (ST7789V2, 320 × 170; CST816 touch on I2C) with
the bay's status in LVGL, for the node's revision B: revision A has no
connector for it.  Built with the `front-display` snippet on the
application only:

```
west build -b bay_node/esp32s3/procpu firmware/bay-node --sysbuild -- -Dbay-node_SNIPPET=front-display
```

The panel shares SPI2 with the camera (CS on IO5, DC on IO6, the two free
pins), its reset and the touch controller's tie to EN, the backlight stays
on and the touch controller is polled (no INT pin).  LVGL's heap, render
buffer and state go to PSRAM: in internal RAM the node overflows by 15 KB.
`display` in the shell prints the refresh times.

| On bay_node | Without | With the display |
|---|---|---|
| Image | 1059 KB | 1307 KB (+247 KB, of a 3712 KB slot) |
| Internal RAM (dram0) | 345424 B, 90.7 % | 351136 B, 92.2 % (+5.7 KB: LVGL's thread stack, touch queue) |
| PSRAM, static | | +44.5 KB (27 KB render buffer, 16 KB LVGL heap) |

On the XIAO, SPI at 10 MHz without DMA: a full frame in 132 ms, one value
redrawn in 15 ms, a status refresh with nothing changed in 0.1 ms.

## Access control

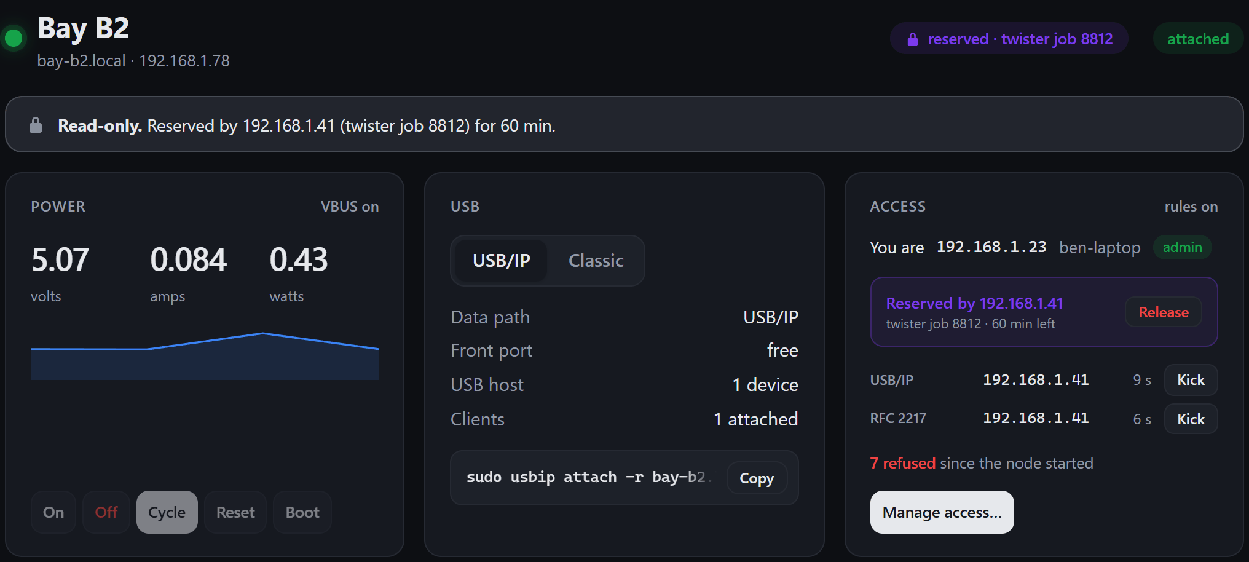
[picture p14: docs/img/web-ui-access.png]
Access card of bay B2 seen by its admin while a CI job holds the bay: the lease with its note and time left, the job's USB/IP and RFC 2217 connections with Kick buttons, the count of refused attempts


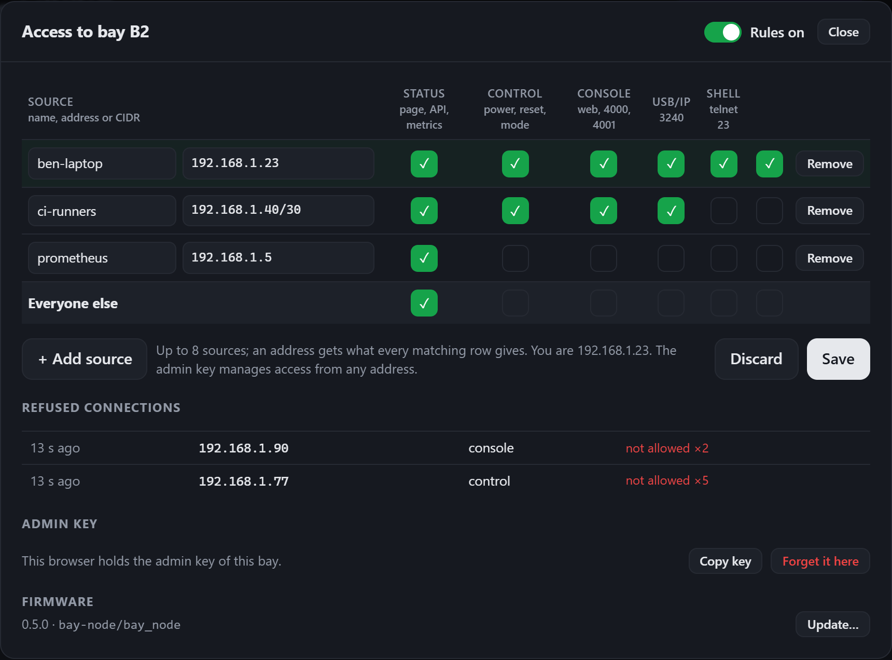
[picture p15: docs/img/web-ui-access-rules.png]
Manage access dialog: sources ben-laptop (everything), ci-runners 192.168.1.40/30 (status, control, console, USB/IP) and prometheus (status), everyone else status only, and the refused connections
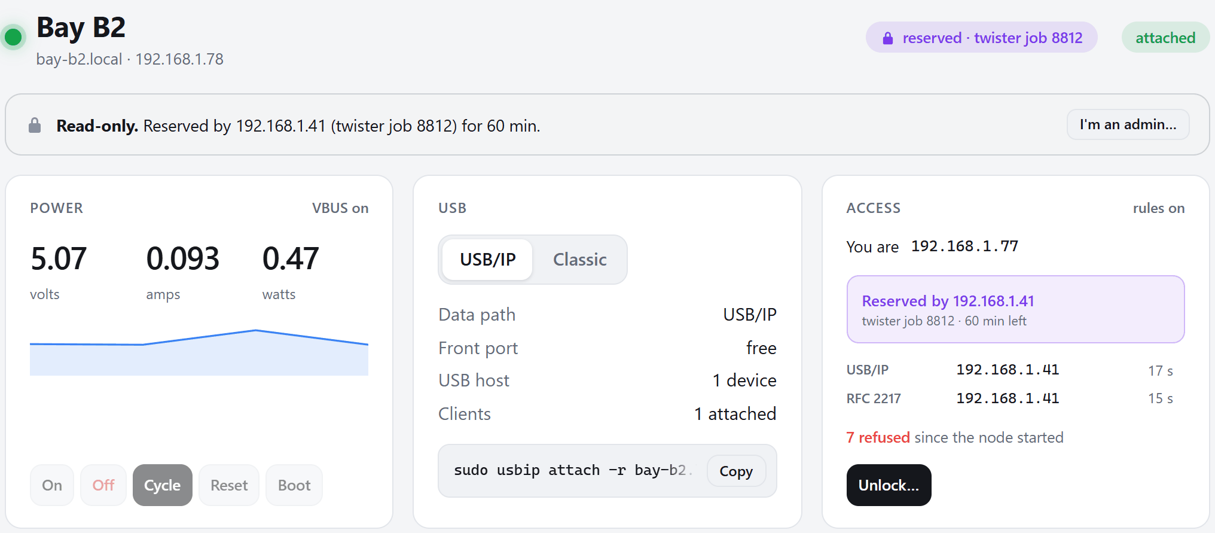
[picture p16: docs/img/web-ui-access-readonly.png]
The same bay from 192.168.1.77, light theme: read-only banner, power buttons greyed out, Unlock button
|  |  |
|---|---|
| Manage access: who may use what, refused connections | From an address without the control right |

Each node decides by itself who may use its bay.  Out of the box it is
**open**, as before: anyone on the network may do anything until the node
is claimed and its rules are switched on.

**Services.**  A rule gives an address (or a CIDR) some of six services:

| Service | Covers |
|---|---|
| status | the page, `/api/status`, `/api/aux` (read), `/metrics` |
| control | power, reset, boot, mode; taking a lease |
| console | the web console, the raw (4000) and RFC 2217 (4001) ports, the AUX settings and BREAK |
| usbip | USB/IP (3240) |
| shell | the telnet shell (23), which can do everything: admin hosts only |
| camera | the camera's pictures (8081); its settings are control's |

Up to 8 sources per node, plus a row for everyone else (status only by
default).  An address gets what every source it matches allows.

**Where it is enforced.**  TCP connections to USB/IP, telnet and the AUX
ports go through Zephyr's packet filter (`CONFIG_NET_PKT_FILTER`, its
local-in hook with our own match function): a refused client's SYN is
dropped before USB/IP or the shell, which Zephyr runs itself, ever see it
(the client times out); the AUX ports check again at `accept()`.  The web
server checks every request (403, or 423 while reserved) and the web
console needs a ticket from an address with the console right, because a
WebSocket descriptor carries no peer address.  When the rules or the lease
change, connections that are no longer allowed are closed.  mDNS and DNS-SD
are left alone.

**Reservation (lease).**  An address with the control right can reserve
the bay for 10 s to 24 h (`POST /api/lease`, `bayctl lease`, or *Reserve…*
on the page): while it lasts, control, console and USB/IP answer only that
address, and everyone else's sessions are closed when it starts.  It works
on an open node too, so CI jobs keep out of each other's way before any
rule exists.  The holder renews or releases it; it lapses by itself when a
job dies; an admin can break it.  It lives in RAM: a reboot ends it.

**Connections, kicks, refusals.**  The Access card lists who holds the
console, USB/IP and the shell; an admin's *Kick* closes a connection and
refuses its address that service for `CONFIG_BAY_ACCESS_KICK_S` (60 s).
The node keeps the last 16 kinds of refusal (address, service, reason,
count) for the admin view, and counts them in `bay_access_refused_total`.

**Admin key.**  Whoever holds the node's 32-byte key edits the rules, kicks
and breaks leases, from any address.  The first key comes from a **claim**:
*Claim this bay…* on the page (or `bayctl access claim`), then a short press
on the node's BOOT button within `CONFIG_BAY_ACCESS_CLAIM_S` (60 s) while
its LED blinks white, or `bay access claim` on the UART pads.  Nobody can
claim a node from the network alone.  The claimer may bring a key, so that
every bay shares the rack's key (`bayctl access keygen`).  After that,
admin requests carry `X-Bay-Auth: <nonce>:<HMAC-SHA256(key, nonce \n
method \n path \n body)>` with a single-use nonce from
`/api/access/nonce`: the key crosses the network once, at claim time.  The
page keeps it in the browser's local storage; `bayctl` reads `BAYCTL_KEY`.

**Recovery.**  On the node: `bay access off` (rules off), `bay access
reset` (no key, no rules), or hold BOOT for 10 s
(`CONFIG_BAY_ACCESS_RESET_HOLD_MS`) for the same reset.  These are refused
over telnet.

**Limits.**  There is no TLS on the node: the rules stop mistakes and
uninvited hosts, not someone who spoofs an allowed address on the same
network, and the key travels in clear once, when a node is claimed (claim
on a network you trust).  For more, put the rack behind a VPN or a gateway.
Refused TCP connections are dropped, not reset: `usbip attach` from a
refused host waits for its timeout.

**Code.**  The rules, the lease, the refusal log and HMAC-SHA256 are plain
C without Zephyr ([`common/lib/acl.c`](common/lib/acl.c)), tested on the
host against Python's `hashlib`/`hmac`; the admin key, its nonces, the
signature check and the claim are [`common/lib/admin.c`](common/lib/admin.c),
shared with the power hub (whose page signs its actions the same way, with
the same `rack.mjs` code); [`src/access.c`](bay-node/src/access.c) applies
them (packet filter, settings `access/rules` and `access/key`, kicks,
connections).  One key can serve the whole rack: a claim may bring it.

```bash
python firmware/bay-node/tests/acl/test_acl.py                       # CC=gcc by default
python3 firmware/bay-node/tests/console_sim/test_access.py --workspace <west workspace> --build <dir>
```

`test_access.py` runs the node on native_sim and talks to it from several
loopback addresses: claim, signed requests, rules, the web console ticket,
the AUX ports refused at `accept()`, kicks, the lease, persistence across a
restart, the local reset.  The packet filter itself (host sockets bypass
Zephyr's IP stack there), USB/IP and telnet are not covered.

**Cost.**  On `bay_node`, against the build before it: +13 KB of flash
(the page grew from 9 to 18 KB gzipped) and +5.3 KB of static RAM, now at
96.4 % (385 of 399 KB): the rules, lease and refusal log, a 1 KB request
buffer, header capture and longer header lines for `X-Bay-Auth`, and one
3 KB response buffer that replaced two.

## Serial console

The DUT's console on the AUX connector (UART1) is reachable three ways at
once.  Everything the board sends goes to every client; everything a client
sends goes to the board, so with several writers the keystrokes simply
interleave: one person typing at a time is the rule.

| Client | How | Port settings |
|---|---|---|
| Web console | the Console card of the status page (xterm.js over a binary WebSocket), up to `CONFIG_BAY_CONSOLE_WEB_CLIENTS` (2) browsers | the page's ⚙ panel: applied at once and saved for the bay (Zephyr settings) |
| RFC 2217 | one client on TCP 4001: pyserial `rfc2217://`, labgrid `NetworkSerialPort`, esptool | set by the client for its session; the saved ones come back when it disconnects |
| Raw TCP | one client on TCP 4000: `socat`, `nc` | the saved ones |

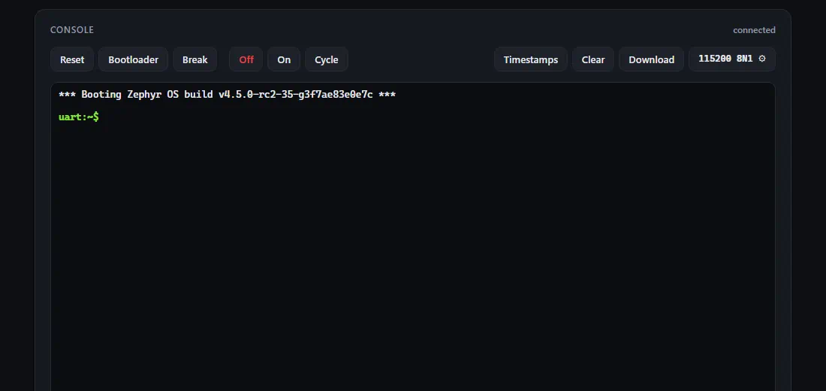
[picture p17: docs/img/web-console.webp]
Screencast of the web console: the DUT's Zephyr shell answers help and kernel version (with tab completion), the baud rate is changed from the settings panel, RESET reboots the DUT and its boot banner appears


*Recorded on [native_sim](bay-node/tests/console_sim/): the node's real
console, web server and RFC 2217 code, with Zephyr's shell sample running
as the DUT on its AUX UART.  `python firmware/bay-node/web/screencast.py
--workspace <west workspace>` records it again (Docker, Playwright, ffmpeg).*

**Web console.**  Raw bytes both ways, so full VT100/xterm escape
sequences and UTF-8 work.  The node keeps the last
`CONFIG_BAY_AUX_LOG_SIZE` (16 KB) received in RAM and replays them to a
browser that connects, so a page opened after a crash still shows it; a page
that reconnects (Wi-Fi hiccup) skips what it already shows, and marks a node
reboot.  Next to the terminal: RESET and BOOT pulses, DUT power off/on/cycle,
BREAK, timestamps (added by the browser to each line), clear, and download
of everything received since the page opened.  The ⚙ panel sets the baud
rate (9600–921600 or any value from 300 to 5 M), data bits, parity, stop
bits, what Enter sends (CR, LF, CR LF), local echo, and whether RFC 2217
DTR/RTS drive BOOT/RESET.  Default: 115200 8N1, CR, no echo.

**RFC 2217.**  Telnet with the Com Port Control option (baud, data bits,
parity none/odd/even, stop bits 1/2, BREAK, DTR/RTS, purge); mark/space
parity, 1.5 stop bits and flow control are refused, as a client expects.

```console
$ python -m serial.tools.miniterm rfc2217://bay-b3.local:4001 115200
$ esptool --port 'rfc2217://bay-b3.local:4001' chip-id    # with "DTR/RTS drive BOOT/RESET" on
```

```yaml
# labgrid
NetworkSerialPort:
  host: bay-b3.local
  port: 4001
  speed: 115200
  protocol: rfc2217
```

With *DTR/RTS drive BOOT/RESET* on, the lines behave like the two-transistor
auto-reset circuit of ESP32 boards (RESET while RTS and not DTR, BOOT while
DTR and not RTS), so esptool can reset an ESP32 DUT into its ROM loader and a
terminal that raises both lines leaves the board alone.  Off by default.

**BREAK and the TX line.**  BREAK holds the board's RX line low (`tx-gpios`
of `hwtr,dut-port` takes the pin from the UART for the duration).  While the
DUT is powered off the same pin is released (input), so the node does not
feed the unpowered board through its RX pin; it goes back to the UART when
the power comes back.

**Cost.**  About +170 KB of flash (xterm.js and its CSS, 91 KB gzipped, the
WebSocket and console code) and +25 KB of RAM: the 16 KB receive log, a
1 KB transmit ring, one 3 KB thread for all the console sockets, two
WebSocket contexts and their buffers, two more TCP contexts.  Static data
RAM is now at 95 % (379 of 399 KB, heaps included).  The knobs, if a
feature needs RAM later: `CONFIG_BAY_AUX_LOG_SIZE`,
`CONFIG_BAY_CONSOLE_WEB_CLIENTS`, and `CONFIG_USBIP_BUF_POOL_SIZE` (64 KB by
default upstream, the largest single buffer in the image).

The RFC 2217 server ([`src/rfc2217.c`](bay-node/src/rfc2217.c)) has no Zephyr
dependency and is tested on the host against pyserial's client, with a
looped-back "UART":

```bash
pip install pyserial
python firmware/bay-node/tests/rfc2217/test_rfc2217.py      # needs a C compiler (CC, default gcc)
```

The whole console also runs on native_sim, no hardware needed (Linux, or the
Zephyr build image in Docker as `screencast.py` does):
[`tests/console_sim`](bay-node/tests/console_sim/) builds `aux_console.c`,
`rfc2217.c` and `web.c` with the hardware stubbed and host sockets (NSOS),
and `run.py` starts it next to Zephyr's shell sample, wired to its AUX UART
as the DUT; RESET and the power buttons restart or stop that DUT.

```bash
python3 firmware/bay-node/tests/console_sim/run.py --workspace <west workspace> --build <dir>
# http://localhost/ (port 80), rfc2217://localhost:4001
```

### Status LED

| Colour | Meaning |
|---|---|
| off | no firmware / booting |
| white / blue, fast | identify: the hub's page asked "which one is it?" |
| white, blinking | access claim pending: press BOOT briefly to confirm |
| red, blinking | DUT VBUS in current limit, or switched off by a fault |
| yellow | SERVICE: front port → node |
| magenta | classic: DUT → front port (laptop plugged, or `bay mode classic`) |
| dim white | DUT power switched off |
| orange, blinking | USB/IP mode, no network yet |
| dim blue | USB/IP ready, nothing enumerated on the DUT port |
| blue | USB/IP, DUT enumerated and exportable |
| green | USB/IP, a client is attached |

## Pin map

From `electronics/bay-node/design.py` (U3, ESP32-S3-WROOM-1-N8R8: 8 MB flash, 8 MB octal PSRAM on IO35–IO37;
the WROOM-1 has no IO26/IO33/IO34); devicetree in
[`boards/hwtr/bay_node/bay_node.dtsi`](boards/hwtr/bay_node/bay_node.dtsi) and
[`bay_node-pinctrl.dtsi`](boards/hwtr/bay_node/bay_node-pinctrl.dtsi).  Since node v1.0 the DATA lead has no INT
(map B): the node polls the DATA board over I²C, and IO4 carries the camera's CS.

| ESP32-S3 | Net | Use | Devicetree |
|---|---|---|---|
| IO0 | BOOT | SW2 BOOT button (strapping pin, 10k pull-up); input once booted | `boot_button` (`sw0`), `gpio-keys` |
| IO1 | I2C_SCL | I²C0; also out on J7.7 to the drawer's DATA board | `&i2c0` |
| IO2 | I2C_SDA | I²C0 → INA226 @ 0x40 (2.2k pull-ups, 100 kHz: the DATA lead; `i2c-400k.overlay` tries 400 kHz); also out on J7.6 to the drawer's DATA board (its devices keep off 0x40) | `&i2c0`, `ina226` |
| IO4 | CAM_CS | camera SPI2 CS → J6.7 (33 Ω; 10k pull-up R37 beside the pin; IO8 before node v1.0) | `&spi2` `cs-gpios` |
| IO7 | CAM_LED | camera light: AO3400A Q4 gate → J6.6 LED_K (J6.8 before node v1.0; 100k pull-down: off at boot), LEDC PWM ≥ 20 kHz or on/off | `camera_light` (`pwm-leds`, `&ledc0` channel 0, 25 kHz) |
| IO9 | CAM_MISO | camera SPI2 MISO ← J6.5 (J6.6 before node v1.0; 33 Ω; R35 divider footprint if the Mega drives 5 V) | `&spi2` (`camera`: `arducam,mega`) |
| IO10 | CAM_MOSI | camera SPI2 MOSI → J6.4 (J6.5 before node v1.0; 33 Ω) | `&spi2` |
| IO11 | CAM_SCK | camera SPI2 SCK → J6.2 (J6.3 before node v1.0; 33 Ω), mode 0, 4 MHz | `&spi2` |
| IO12 | AUX_RST_CTL | 2N7002 Q2 → AUX RESET (open drain, 100k pull-down) | `dut_port` `reset-gpios` |
| IO13 | PC_DET | front port VBUS via 10k/20k: laptop plugged | `usb_mux` `pc-detect-gpios` |
| IO14 | MUX_FORCE_PC | OR gate → MUX_DUT SEL: force classic (100k pull-down) | `usb_mux` `force-pc-gpios` |
| IO15 | SVC | SERVICE slide switch | `usb_mux` `service-gpios` |
| IO16 | POS_IN | POS token from J1.6 (10k, BAT54S clamp, 100k pull-down) | `rack_bus` `pos-in-gpios` |
| IO17 | CAN_RXD | TJA1462AT RXD (rack CAN bus) | `&twai` |
| IO18 | CAN_TXD | TJA1462AT TXD | `&twai` |
| IO19 | ESP_DN | USB D−, internal FS PHY → MUX_DUT / MUX_PC | `zephyr_uhc0: &usb_otg` |
| IO20 | ESP_DP | USB D+ | `zephyr_uhc0: &usb_otg` |
| IO21 | AUX_RX | UART1 RX ← AUX pin 4 (1k) | `&uart1` |
| IO38 | LED_DIN | WS2812B (33 Ω), RMT channel 0 (the DevKitC-1 v1.1's own RGB LED pin) | `status_led` |
| IO39 | INA_ALERT_N | INA226 ~ALERT (10k pull-up): over 1.25 A on the DATA lead's supply (DUT_5V; DATA_VIN, 20–28 V, from node v1.0), the DATA ×4 port switched on last goes off (`src/ports.c`) | `ina226` `alert-gpios` |
| IO40 | DUT_FLT_N | TPS2553 ~FAULT (10k pull-up); from node v1.0 the TPS26600's ~FLT through 1k (R43), also low while it is off or ramping | `dut_port` `fault-gpios` |
| IO41 | DUT_EN | TPS2553 EN (100k pull-up: on without firmware); from node v1.0 the TPS26600's SHDN (10k pull-down: **off** without firmware, [docs/firmware.md](../docs/firmware.md#the-data-leads-power-on-rule-node-v10)) | `dut_port` `enable-gpios` |
| IO42 | POS_OUT | POS token to J2.1 (10k, BAT54S clamp): low until addressed | `rack_bus` `pos-out-gpios` |
| IO47 | AUX_TX | UART1 TX → AUX pin 3 (1k) | `&uart1` (`dut_port` `uart`) |
| IO48 | AUX_BOOT_CTL | 2N7002 Q3 → AUX BOOT (open drain, 100k pull-down) | `dut_port` `boot-gpios` |
| TXD0 (IO43) | U0TX | TP1, console + shell | `&uart0` |
| RXD0 (IO44) | U0RX | TP2 | `&uart0` |
| EN | EN | SW1 RESET button (10k/1µF) | — |

Each signal sits on the module edge that faces where it goes on the board: the right column feeds
the DUT power block (I²C at its rear end) and POS_OUT runs to J2 (docs/can.md); the bottom row the
AUX connector (right half), the mode logic and the camera's SPI (left half); the left column the
rack bus block (CAN transceiver, POS input), SERVICE, the camera's light, and its CS at the column's
rear end (IO4 since node v1.0: under the module along the B.Cu lane the DATA board's INT left;
IO8 before).  IO5, IO6 and IO8 are free.  The rack bus protocol runs on the CAN pins (`src/rack.c`, [docs/rack-protocol.md](../docs/rack-protocol.md)).
Strapping pins IO3/IO45/IO46 are not used; IO39–IO42 are the pad JTAG pins, free as GPIOs since
the node debugs over USB-Serial-JTAG.  The map is chosen so that an ESP32-S3-DevKitC-1 v1.1
(N8R8, the same module) takes it as is: every pin is on its headers, none is the octal PSRAM's
(IO35–IO37), and the status LED is the devkit's own RGB LED on IO38 (on a v1.0 devkit that LED is
on IO48, AUX_BOOT_CTL here: harmless).

`python3 firmware/tools/check_pinmap.py` checks this table and the board
devicetree against U3 in `design.py`; CI ([`firmware.yml`](../.github/workflows/firmware.yml))
runs it and builds both targets with warnings as errors on every push.

## Open items

* **Rack bus not on hardware.**  The node's and the hub's protocol code
  passes the simulated rack (`common/tests/rack_bus`: enumeration, reboots,
  dead and lost nodes, retries); the TWAI, the TJA1462AT and the POS chain
  over real row cables are untested.
* **Hardware bring-up not done.**  Nothing here has run on a bay node yet:
  the board definition, the INA226 calibration, the LED timing and the
  SERVICE-mode PHY handover (stop host → route the PHY to USB-Serial-JTAG →
  restart host) are untested.
* **Serial console: tested off the board only.**  The RFC 2217 server
  passes its host test against pyserial; the console, WebSocket and web
  server code ran on native_sim with a Zephyr DUT (the screencast), over host
  sockets rather than the node's Wi-Fi/TCP stack.  That run found that a
  browser's keep-alive connections can hold all the HTTP client slots (the
  server then stops accepting, the console's WebSocket waits), hence the 3 s
  idle timeout in `prj.conf` (on native_sim the idle timeout cannot free a
  slot at all, so the simulation uses 8 slots).  On a XIAO ESP32-S3 over
  Wi-Fi, 3 slots were too few: a browser loading the page opens up to 6
  connections at once and one over the limit is closed unanswered (the page
  came up without its CSS), so 6 slots, with `ZVFS_POLL_MAX` at 2 + 6 (the
  server polls its eventfd, listener and clients in one call; the hub's
  default of 3 made every second client drop them all).  There the node's
  and the hub's pages load whole and the web console connects.  On a StampS3 (no Wi-Fi credentials yet): it
  boots, the HTTP, RFC 2217, raw TCP and telnet listeners are up, the AUX
  settings persist, and with `bay aux loopback on` every byte sent comes
  back at 115200 and 921600, also with the DUT "off"; 22 KB of system heap
  free before Wi-Fi connects, the console thread at 768 of 3072 bytes of
  stack with no client.  Not yet over the network.  To check on a DevKitC with a
  USB-UART adapter on IO47/IO21: throughput at 921600 baud, the console
  thread's stack (3 KB, unmeasured), BREAK and the TX release on power off
  with a scope, two browsers plus miniterm at once, esptool flashing an ESP32
  DUT through RFC 2217.
* **USB transfer types.**  The DWC2 host driver does control, bulk and
  interrupt IN; interrupt OUT, isochronous and split transactions (hubs) are
  not implemented yet.  Probes with an interrupt OUT endpoint, UAC/UVC
  devices and DUTs behind an on-board hub won't work over USB/IP.
* **USB/IP service** is experimental upstream.  The rack patches it
  (`zephyr/patches.yml`, until Zephyr has it): bus ids by port, no hubs on
  offer, a DUT that resets or goes ends its session cleanly (tested on
  native_sim, `firmware/common/tests/usbip`, not yet on a node).  No access
  control of its own (the node's packet filter applies the access rules in
  front of it).
* **Access control: tested off the board only.**  The rules engine passes
  its host test; claim, signed requests, rules, tickets, kicks and leases
  passed on native_sim and against `dev_server.py`.  The packet-filter path
  (USB/IP, telnet, the AUX ports dropped before accept) has only been
  built, not run: check on a node that a refused host's `usbip attach`
  and `telnet` time out, that a kick ends a USB/IP session (shutdown of a
  socket that the USB/IP thread owns), and the BOOT presses.
* **Updates over the network not run on hardware yet** (MCUboot, signed
  images over Wi-Fi, the trial and the rollback: tested on native_sim and
  against the simulated node), then over the rack bus:
  [docs/firmware.md › Over the network](../docs/firmware.md#over-the-network).
* **Not yet written:** the shell on the USB-Serial-JTAG in SERVICE mode,
  RFC 2217 line/modem state notifications (the server
  answers polls with CTS/DSR/CD up).
* **Zephyr's HTTP server** registers every WebSocket of a resource with that
  resource's one data buffer, so two consoles on one resource would share
  it: the firmware declares one resource per console slot instead.
* **Zephyr's Prometheus library** wants exactly one label per metric and
  refuses negative gauge values (the INA226 reads a few mA below zero at no
  load), so the firmware labels everything `bay="<id>"` and clamps at 0.
