kartben/hw-testing-rack/docs/electronics.md

# Electronics

Five boards (the bay node, the power hub, the drawer's DATA port or a converted bay's DATA ×4, the camera pod), all **schematics as code**: `electronics/<board>/design.py`
describes parts (with MPN, manufacturer, LCSC number), the nets their pins
connect to and PCB placement hints.  From that single description
`electronics/tools/` writes a real hierarchical KiCad 10 project (one sheet
per functional block), builds the matching `.kicad_pcb` (footprints, nets,
outline, zones, keep-outs, mounting holes from `config/rack.yaml`), autoroutes
it with Freerouting, and proves the two views agree with KiCad's own ERC and
DRC (schematic parity).

```console
$ tools/kicad.sh bay-node                  # schematic + placed PCB + ERC/DRC
$ tools/kicad.sh bay-node --route --fab    # + Freerouting + Gerbers/CPL/BOM/PDF/renders/STEP/GLB
$ tools/kicad.sh bay-node --ses --fab      # re-import the last Freerouting session (no re-route)
$ tools/kicad.sh bay-node --check          # ERC + read-only DRC of the PCB as it is (what CI runs)
$ tools/kicad.sh bay-node --clean          # take the routed PCB's antennas off (no re-route)
```

`tools/kicad.sh` runs everything in the official `kicad/kicad:10.0-full`
image (and Freerouting in a JRE image), so the only prerequisite is Docker.
The generated projects open in a local KiCad 10 as normal projects.

**Antennas** (the layout review, 2026-10-28): every import ends with
pcbgen's `clean_antennas()`, which takes off what the router and the tidy pass
leave hanging.  That is a track end that meets nothing of its net, a via that
meets its net on one layer only, a router track lying over another of its net,
and slivers (0.1 mm or shorter), folded into their neighbours where the
clearances allow.  Drawn copper is never touched.  `electronics/tools/antennas.py`
finds them in the board file, and `tools/tests/test_antennas.py` holds every
board to none, but the ones `electronics/antennas.json` still lists.  KiCad's
DRC reports a dangling track or via as an error.

**Zone priorities** (2026-11-02): two pours of different nets on one layer,
closer than their clearance, must not share a priority.  One of them pulls
back, and with equal priorities KiCad picks it by the zones' UUIDs, which are
new at each rebuild and in each panel copy.  The fill can then flip between
builds while DRC stays clean (the DATA ×4 v2's panel halves, the DATA ×6's
power plane).  `electronics/tools/zoneprio.py` finds such pairs in the board
file; `--check` prints them and fails on any, and
`tools/tests/test_zone_priorities.py` holds every board to none.

**Decoupling** (the same review): each board's `design.py` names, in
`b.pcb["decoupling"]`, the power pin every decoupling capacitor serves.
`electronics/tools/decoupling.py` measures, from the board file, the capacitor's
pad to that pin (2 mm at most, edge to edge) and its GND pad to the nearest GND
via (1 mm at most).  `tools/tests/test_decoupling.py` prints each board's table
and holds it to both, but on the boards `electronics/decoupling.json` still
lists.  Bulk, bootstrap, timing and RC capacitors serve no one pin and stay
undeclared; the table names them.  A capacitor whose place a datasheet's
reference layout sets gets its own limit, its reason beside it: each buck's
first 10 µF input capacitor keeps TI's spot, 2.65 mm from VIN on the pins'
own top-side islands, under a 3 mm limit.  A capacitor of 100 nF or less also keeps the
pin → cap → via order: the pin reaches its pad by copper on their one layer,
with no via on the way, and reaches no via of its rail but through that pad.
On an island the pin, the capacitor and the rail's vias share (a buck's
input), a via only breaks it if it lies nearer the pin than the capacitor.  A
via that only leads on to test pads (a probe's branch) feeds nothing and
doesn't count.  The boards `decoupling.json`'s `order_pending` list names still
break it.  A capacitor that cannot keep the order where it sits (no via fits
past its pad, or its rail comes in at the pin) is exempt by name, in
`b.pcb["decoupling_order_exempt"]`, with the reason and the measures; the
table still shows its order, and an exemption no longer needed fails the test.
The DATA ×4 v2 has nine: the hub's C11 and C15, the crosspoints' C20 and C23,
the co-processor's C40, C41, C44, C45 and C46.

**Schematics** are drawn, not just generated: every part in `design.py` has
an `sch=` position on the 0.1" grid and the main paths are real wires
(`Sheet.wire("U1.SW", "L1.1")`), so each sheet reads left to right like a
hand-made schematic — power path, then control, notes with the design maths.
Pins left unwired get a short stub with their net label.  The writer adds the
junctions and refuses any wire that would touch another net's pin or wire, and
KiCad's ERC plus the PCB's schematic-parity check catch the rest.

**Stackup** (bay node, 4 layers, symmetric): F.Cu signals + GND pour · In1 solid
GND · In2 power only (+3V3 under the module, the LDO and the logic around them; +5V from the buck
to the LDO input, the DUT switch, the camera fuse and the DUT-side ESD part; the VRACK bus strip
between J1 and J2; +3V3 again under the front edge, fed by a B.Cu track) · B.Cu signals + GND
pour.  No signal is routed on In2.  The board declares JLCPCB's standard
JLC04161H-7628 build (0.21 mm prepreg between F.Cu and In1, 1.065 mm core, 0.5 oz
inner copper) and lead-free HASL (since 2026-10-19; ENIG before); the hub v1.0 the same build,
lead-free HASL too since its quote (`stackup` / `finish` in `design.py`, written into the board by `pcbgen.py`).  Before routing,
every GND and supply pin gets a short track to a via of its own on its plane (`fanout_nets` in
`design.py`, `fanout_pads()` in `pcbgen.py`), locked so Freerouting keeps it: no pin depends on
the outer GND pours, which stay as a bonus, stitched to In1.  **No drill under 0.3 mm**: JLCPCB's
0.25 mm option costs ≈ $40 more on a 20-board order (it forces a 4-wire Kelvin test and FR4 Tg155), so
the smallest via is 0.5/0.3 mm (`SMALL_VIA` in `pcbgen.py`, also written into `<board>.kicad_pro` as
the DRC minimum); most vias are 0.6/0.3 mm.  **Thermal reliefs against tombstoning, never as a
current bottleneck** (since 2026-10-20, `power_pads()` in `pcbgen.py`).  A board declares its power
nets (`power_nets` in `design.py`: GND, the bus, the supplies, ≳ 0.5 A).  On them, the pins of ICs,
connectors and inductors, and any pad of 2.5 mm² or more (bulk capacitors, TVSs, power FETs),
connect **solid** to their pour: one 0.4 mm spoke would be the narrowest point of the current's
path.  A small part (R, C, D, Q, LED) gets the same connection on every end: solid where every end
sits on a pour (a decoupling capacitor between a power island and the GND pour), reliefs where one
end is a track, the pours' reliefs (0.3 mm gap, 0.4 mm spokes) otherwise; so it heats evenly in
reflow and doesn't tombstone.  Through-hole pins keep their reliefs, so they take solder (0.8 mm
spokes on a hand-soldered power pin).  `<board>.kicad_dru` says it twice: a rule connects the
power nets' IC, connector and inductor pins solid, and another asks each power net's relieved pads
for its minimum spokes (2 on the bus and the supplies); a single spoke stays allowed elsewhere, where
fine-pitch neighbours leave no room for two.  A third (since 2026-10-27, the DATA ×4 v2 review's X2-4)
holds a supply's through-hole connector, IC and inductor pins to 4 spokes of 0.8 mm or more.  Where
fewer fit, the pin meets its plane solid (`solid` in its placement): the DATA ×4 v2's J1.8, the lead's
+5V, had 3, the split beside it taking the fourth.  GND's through-hole pins are left out: a header's GND
carries a signal's return.  No other board's pins fall short.  The LMR51625's hot loop (CIN – VIN – GND) and
its output capacitors sit on small solid top-side islands, with hand-placed
vias to In1, as TI's layout guide asks; the AP2114H's tab gets a solid +3V3
island with vias to In2.  Hand-soldered through-hole pads always get thermal
reliefs, even on solid pours.  Connectors that overhang the outline on purpose
are listed as `edge_parts`: their silkscreen may cross the board edge (the fab
clips it), every other silkscreen check still applies.

The layout review's rules are generated from what a board declares (`electronics/tools/netrules.py`), so
every board is built and checked with them; a board that declares nothing gets nothing new:

- A netclass pattern (`_patterns` in `NETCLASSES`) that matches no net stops the build.  KiCad compares
  a pattern with the whole net name, sheet path included: a bare `VIN` misses a sub-sheet's `/Power/VIN`
  and leaves it in Default without a word.  The error names the wildcard that reaches it (`*VIN`).
- A class's `_min_width` (mm) becomes a DRC error under that track width, except where
  `b.pcb["min_width_except"]` says (courtyards, nets: a fine-pitch part's fan-out).
- A `Sensitive` class (enables, faults, resets) beside a `USB` class is kept 3 × the USB track width off
  it, the layout review's spacing between a fast bus and the lines outside it.  Freerouting routes with
  it too: the DSN gets a `class_class` clearance between the two classes.
- `b.pcb["severities"]` (`{check: error | warning | ignore}`) sets one board's DRC severities in its
  `.kicad_pro`, by KiCad's check names; an unknown check or severity stops the build.  The generator
  itself silences nothing.
- A keep-out with `"footprints": True` (`b.pcb["keepouts"]`) is a rule area that bars parts, their
  courtyards included (DRC's `items_not_allowed`), and lets copper through: where a printed part
  holds the board.  Named `parts:<name>`, it stays on the routed board, stays out of Freerouting's DSN,
  and `--rules` keeps it in step with the design.

`tools/kicad.sh <board> --rules` rewrites a routed board's `.kicad_dru`, its `.kicad_pro` DRC settings
and its footprint keep-outs from the design, then runs DRC, without touching its copper.

How the routing flow keeps ground honest (`electronics/tools/pcbgen.py`):

1. The router sees the inner GND plane and the outer GND pours, and connects
   every other net with real copper.
2. Freerouting trusts the pours to connect the GND pads, but once KiCad fills
   them with real clearances they can break into pieces.  After the SES is
   imported, `stitch_gnd()` first drops a grid of GND vias tying the pours to
   the plane.  Then every fragment still without a via gets one, at the first
   spot where it fits.
3. A GND pad that no connected fill reaches gets a thin track squeezed out to
   connected GND or to a via spot.
4. Pads the router walls in completely are listed under `fanout` in the
   board's `design.py`: a dog-bone via outside the package is reserved
   before routing (a keep-out) and placed after it.  The bay node needs none: its
   `fanout_nets` give every GND and supply pin its via before routing.
5. Finally KiCad's own DRC lists the GND pads still unconnected, and each gets
   a short track to a GND via or to a spot where a small via fits.

> **Status: bay node v1.0 — the row cable becomes 6-pin (VRACK 20 / 28 V, CAN, POS:
> [can.md](can.md)), CAN transceiver and POS token added, GCT USB4105 receptacles, the bay's camera on
> J6 (Arducam Mega SPI + LEDs, PH 8) with the WROOM-1-N8R8 module (octal PSRAM; the board 10 mm longer at the rear), autorouted, checked with Konnect ([review-konnect.md](review-konnect.md)), not yet ordered.  Power hub v1.0 —
> USB-C PD input (CH224A, no input switch), 4 layers, rows off until the controller enables them, autorouted,
> checked with Konnect, quoted (2026-10-19, with the AP33772S before), not yet ordered.  Camera pod v1.0 — lead, the camera's header and 3.3 V, the
> light, autorouted, not yet ordered or quoted.  DATA port v1.0 — the drawer's USB-C port on a
> 8-wire lead to the node's J7, autorouted, not yet ordered or quoted.  DATA ×4, first design — a converted bay's
> drawer board (hub, four switched and measured USB-C), autorouted, checked with Konnect, not yet ordered
> or quoted.**  On every board ERC is clean and DRC reports
> no copper errors, no unconnected items and full schematic parity.  The buck's hot loop, the
> VRACK bus, the hub's input and VRACK pours, its Kelvin sense pair and the USB High-Speed pairs are placed or
> drawn by hand in `design.py`; the rest is the router's draft: before
> ordering, look at it in KiCad and re-run DRC.  Hand edits to the PCB are
> fine — just don't re-run the generator over them (or move the routed board
> aside first).

## Revisions at the fab

v1.0 of the five boards went to fabrication on 2026-11-11, from commit `125c4ece`: 5 PCBs and 2 assembled boards of each, at NextPCB.  What to check when they arrive: [bring-up.md](bring-up.md).

| Board | Revision | Sent | Status |
|---|---|---|---|
| Bay node (`bay-node`) | v1.0 | 2026-11-11 | at the fab |
| Power hub (`power-hub`) | v1.0 | 2026-11-11 | at the fab |
| Camera pod (`camera-pod`) | v1.0 | 2026-11-11 | at the fab |
| DATA ×6 (`data-port-x6`) | v1.0 | 2026-11-11 | at the fab |
| DATA ×4 (`data-port-x4`), assembled with its logic | v1.0 | 2026-11-11 | at the fab |

**A released revision is frozen.**  Its Gerbers, BOM and placement file stay as they were sent, so the repository always shows the boards that are on the bench.  From now on any change to one of these boards goes into a new revision, however small: a silkscreen text, a part value, one track.

1. In the board's `design.py`, raise the revision in `Board(…, "1.0")` and in its title block (`title_block("… v1.0", …)`), then make the change.
2. Regenerate the board (`tools/kicad.sh <board> --fab`; `--route` only if it needs a new routing) and update this page's headings.
3. Leave the released entry alone.  When the new revision is ordered, add its own entry: `python tools/released.py --record <board> --date … --fab …` prints it.

[`electronics/released.json`](../electronics/released.json) holds the list, with the SHA-256 of each file sent.  `python tools/released.py` compares it with the tree, and `tools/tests/test_released_boards.py` runs it with the other tool tests: a commit that changes a v1.0 board's fabrication files without a new revision fails there.  Firmware, documentation, 3D models and renders are free to change: they are not in the list.

What the bench finds on v1.0 (a wrong value, a swapped pin, a bodge wire) is written down in [bring-up.md](bring-up.md#what-the-bench-finds) and fixed in the next revision, not in v1.0.

## Bay node (×1 per unit) — 4 layers, 74 × 90 mm

Sheets: **Power · MCU · USB · DUT power & AUX · Rack bus** — see the PDF in
`electronics/bay-node/docs/`.

| Block | Parts | Notes |
|---|---|---|
| Row cable in/out | 2 × JST PH 6, side entry, SMD (S6B-PH-SM4-TB).  J1 (IN): 1 VRACK · 2 GND · 3 CAN_H · 4 CAN_L · 5 GND · 6 POS in; J2 (OUT) mirrored: 1 POS out · 3 CAN_L · 4 CAN_H · 6 VRACK ([can.md](can.md)) | daisy chain, 2 A per contact; the hub's 1.6 A eFuse protects it; each power pin on a solid island with vias to its plane; every net runs straight across (J1.1 → J2.6, J1.3/4 → J2.4/3): the jumper between nodes lies flat, no twist |
| Rack bus | TJA1462AT (NXP), signal improvement (VCC 5 V, VIO 3.3 V, STB tied low) + PESD2CAN on the tap; POS in: 10k + BAT54S + 150k pull-down (100k until the PCBA review, 470k until the schematic review's S1: a floating upstream pin and warm BAT54S leakage); POS out: 10k + BAT54S | transceiver right on the pair (stubs 1.8 / 2.3 mm routed, ≤ 20 mm asked), no termination (both are in the hub); a wrong cable (VRACK on a POS pin) costs ≈ 2.5 mA at 28 V |
| Protection | SUD50P06 P-FET + 12 V zener, SMBJ33A, 100 µF/50 V | reverse polarity, hot-plug clamp < 54 V |
| 5 V | LMR51625YDDCR (60 V, 2.5 A, synchronous, 1.1 MHz) + 4.7 µH Vishay IHLP2525CZ (75 V, for 28 V EPR; on the FXL0630 land, the part until 2026-11-01) | TI typical application (SLUSF64B table 8-1): 3 × 22 µF out (the table asks 22 µF), 2 × 10 µF + 100 nF in; the node alone, ≤ 0.8 A (the camera and its light ≤ 0.42 A) since the DATA lead takes VIN (DATA power, below; it was sized for 2.25 A with the DATA board's 5 V on it: the inductor peaks at ≈ 2.65 A from 28 V, under the 2.9 A minimum peak limit); FB 100k/18k → 5.24 V; EN 100k/10k: on above 13.5 V, off below 10.8 V |
| 3.3 V | AP2114H-3.3 (U2, C150716, SOT-223) | logic only; stable with the ceramic C11 / C12, where the AMS1117 it replaced (the schematic counter-review, 2026-10-23) guaranteed it only with 22 µF tantalum; the same SOT-223 pinout and copper |
| MCU | ESP32-S3-WROOM-1-N8R8 (8 MB flash, 8 MB octal PSRAM for the camera's frames; the DevKitC-1-N8R8's module), C2913201 | antenna on the rear edge, keep-out on all layers (the footprint's own ±24 mm band); `bench:ESP32-S3-WROOM-1_NoEPVias` (no 0.2 mm vias in the exposed pad: a GND island stitched around it); rated −40…+65 °C |
| DATA power | TPS26600 eFuse (U9: R_ILIM 6.8k → ≈ 1.76 A, 1.67–1.85 A: above the DATA ×6's ≈ 1.5 A fully loaded at 15 V, 1.0–1.2 A at 20 V, under the PH contact's 2 A; dVdT 22 nF → 3.8 ms at 20 V, 5.3 ms at 28 V; UVLO, OVP and MODE to GND: 15 V, 31–34 V, current limit with auto-retry), DFLS260-7 (D8: 60 V, 2 A, 0.62 V at 2 A, the B260A class of TI's TPS26600-02EVM, in PowerDI-123) from GND to DATA_VIN at J7 for the lead's kick when it cuts a short, 50 mΩ Kelvin shunt, INA226 @0x40 | VIN (after Q1, on D2's clamp) → DATA_VIN_SW → shunt → DATA_VIN, the DATA board's supply (it makes its ports' 5 V); the INA226 runs from +3V3 and reads the shunt's own sense pads (SHUNT_P/N), Vbus tied to Vin− at its pins (DATA_VIN at the shunt's load end, ≤ 34 V behind the eFuse's OVP); default **off** (SHDN pulled down by R17): the firmware turns it on; fault flag (~FLT, 10k pull-up R18; also low while off or starting) to IO40 through 1k (R43, the PCB review's BN-01, 2026-11-09: in USB-OTG download boot the ROM drives IO40 high against ~FLT, which is low while the eFuse is off; R43 holds that to 3.3 mA, under the pin's 10 mA) |
| USB | 2 × FSUSB42 + 74LVC1G32 (150k from its output back to PC_DET for ≈ 0.14 V of hysteresis: the laptop's VBUS rises far slower than its 10 ns/V, datasheet audit F3), 2 × USBLC6-2SC6 (100 nF on each VBUS pin: C25, C26), 1 × USB-C GCT USB4105-GF-A-120 (J3, the PC port) | modes in [architecture.md](architecture.md); the DUT side leaves on the DATA lead (J7), no receptacle on the node since the 74 × 90 re-layout (below); the classic-mode path (J3 → J7) is hand-routed for High-Speed, see below |
| UI | WS2812B-2020, SERVICE slide switch, RESET/BOOT, UART pads | |
| AUX | J5, JST PH 6, side entry, SMD (S6B-PH-SM4-TB, the row cable's type) on the right edge: GND, 3V3 (1k: a reference for the DUT's levels, not a supply), TX/RX (1k), RESET/BOOT open-drain (2N7002) | in front of J7, both facing the drag chain's fixed end (below), its 2N7002s and resistors in a column on its left; `pcb.bay_node.aux` is its centre |
| DATA | J7, JST PH 8, side entry, SMD (S8B-PH-SM4-TB, the data port's J2 type) on the right edge: 1 DATA_VIN (20–28 V, ≤ 1.76 A) · 2 GND · 3 D+ · 4 D− · 5 GND · 6 SDA · 7 SCL · 8 GND (an INT until node v1.0: the node polls the DATA board); USB through U8 (USBLC6, flow-through, at the lead's node end), I²C = the node's bus (IO2/IO1, 2.2k pull-ups) | the node's only DUT port: the lead to the drawer's DATA board (×6, or ×4 where a DUT needs wires), which makes its own 5 V from DATA_VIN; `pcb.bay_node.right.data` is its centre (KiCad y) |
| Camera | J6, JST PH 8, vertical, SMD (B8B-PH-SM4-TB): 1 GND · 2 SCK · 3 CAM_5V · 4 MOSI · 5 MISO · 6 LED_K · 7 CS · 8 GND (node v1.0; CAM_5V and LED_K reach their pads' east ends, the SPI lines the west ends); 33 Ω series on the SPI lines, 2 × USBLC6 on the lead side (their VBUS pins on +3V3 with C28 100 nF between them, datasheet audit F4; +3V3, not CAM_5V: with CAM_5V off the SPI lines can't feed the pod through them, and the clamp stays under the ESP32's 3.6 V), AO3400A low side for the LEDs (100k gate pull-down), CAM_5V through a 0.75 A PTC | this bay's Arducam Mega SPI camera and white LEDs (below); at the rear right, its lead straight back, its parts in a block west of it; `pcb.bay_node.cam` in `config/rack.yaml` is J6's centre |

**USB High-Speed path.** In classic mode a laptop on the front port talks to the DUT through both
muxes, at 480 Mb/s if the DUT can.  Freerouting can't route differential pairs, so that chain (J3 →
U4 → U5 → U6 → U8 → J7) is drawn by `usb_hs_routes()` in `design.py` and locked before routing
(`b.pcb["tracks"]`): coupled pairs on F.Cu over In1, 0.25 mm / 0.15 mm gap (≈ 90 Ω, field-solver
estimate), ESD parts in flow-through (the connector side is its own net, `PC_CONN_*` /
`DUT_CONN_*`, so the signal can only pass through the USBLC6).  Since v0.4 the PC pair runs
straight up the middle of the board from U4 to U5, right under the module; U5 → U6 → U8 → J7 then
runs east.  The two FSUSB42s need one crossover between them (PCPATH_DN hops under PCPATH_DP on
B.Cu); four small bumps on PC_DP, on the straight run, make up the two vias.  From U8 the pair runs
straight into J7's pads, one 45° step each, D− to the north on both (J7 takes D+ on pin 3, D− on
pin 4 for that; the data port's J2 and U1 follow), and J3 → J7 is matched to ≈ 0.3 mm, ≈ 2 ps (vias
counted as the 1.6 mm they cross).  Moving U4–U8 or the connectors means re-drawing those tracks.

**Kelvin shunt.** R19 uses `bench:R_1206_3216Metric_Kelvin`
(generated by `electronics/tools/footprints.py` from the stock 1206): sense pads on the inner edge of
each terminal, tied to it by net-tie pad groups, so the INA226 reads the resistor and not the load
copper.

**GPIO map** (since v0.5: each signal leaves the module on the edge that faces where it goes): right
column IO41 DUT_EN · IO40 DUT_FLT_N · IO39 INA_ALERT · IO2/IO1 I²C SDA/SCL (the DUT power block
sits in the rear-right corner) · IO42 POS_OUT towards J2 · IO38 LED; bottom row IO47/IO21 UART1
TX/RX · IO12 AUX_RST · IO48 AUX_BOOT · IO13 PC_DET · IO14 MUX_FORCE_PC and the camera on SPI2
through the GPIO matrix, IO11 SCK · IO10 MOSI · IO9 MISO; left column IO15 SVC · IO16 POS_IN ·
IO17/IO18 CAN RX/TX (TWAI) · IO4 the camera's CS (node v1.0, IO8 before) · IO7 its light; IO19/IO20 USB; TXD0/RXD0 on test
pads (bottom side).  IO5, IO6 and IO8 are free (IO4 was the DATA board's INT on J7.8 until node v1.0).  The WROOM-1's octal PSRAM takes IO35–IO37 and it has no
IO26/IO33/IO34; IO3, IO45 and IO46 (strapping) stay unused.  The map is the one an
ESP32-S3-DevKitC-1 v1.1 (N8R8, the same module) can take as is: every pin on its headers, the
status LED on its own RGB LED's IO38, so the bench stand-in needs no remap.  `firmware/README.md` has the full table, checked against the schematic by
`firmware/tools/check_pinmap.py`.

**Row power VRACK, 20 or 28 V.** The hub negotiates 20 V, or 28 V (EPR), from a USB-C PD charger
and passes it to the rows as VRACK (pin 1 of the row cable; the node's net `VRACK`, then `VIN`
after the reverse-polarity P-FET).  The input stage takes both: the SMBJ33A stands off 33 V
(28 V + 5 % = 29.4 V), the LMR51625 runs from 4.3 to 60 V and its EN divider (100k/10k) starts it
above 13.5 V, and the P-FET and its 12 V gate zener are rated 60 V.  At 20 V a row draws more
current for the same load; the hub's eFuse still caps it at 1.6 A.  The hub keeps every row off
until the PD contract is final, so a node sees one clean power-up.

**USB-C roles:** the front PC port is a sink (5.1 k Rd on CC) whose VBUS is
only sensed.  The DUT's USB-C is on the DATA board in the drawer, a source (56 k Rp, "default USB power"), its VBUS
switched here.

**Camera (J6).**  Each bay's camera, an Arducam Mega 3MP SPI (M12 version B0434, the 145° LN018 lens) in
the pod under the bay's ceiling, and its 2–4 white 5 V LEDs hang on one ≈ 50 cm PH 8 lead from the
bay's own node.  SPI2 runs in mode 0 at 4 MHz (2 MHz fallback); the 33 Ω series resistors sit
under J6, 50–65 mm of track from the module, i.e. at the source as far as the 50 cm lead is concerned;
GND on pins 2 and 4 keeps a return next to SCK.  CS has a 10k pull-up (deselected before
firmware); the light's AO3400A (5.7 A, 48 mΩ at 2.5 V gate; the 2N7002 is rated 115 mA with a 2.5 V threshold, short of
the LEDs' 150 mA) is held off by its 100k gate pull-down, PWM ≥ 20 kHz (LEDC) or plain on/off, as
slow PWM bands a rolling shutter.  CAM_5V stays behind the 0.75 A PTC (0.5 A until the schematic review's S6): the camera ≤ 317 mA
(Arducam's figure), the LEDs ≤ 102 mA.  The camera and the LEDs sit on the [camera pod board](#camera-pod-v10--2-layers-40--27-mm),
which runs the Mega from 3.3 V: its MISO is a 3.3 V output.  R35 (680 Ω, footprint fitted, not
populated) stays a fallback for a camera fed 5 V that drives MISO at 5 V: R33 becomes 330 Ω and
R35 goes on, 3.37 V.  The right edge holds J7 and J5, so J6 stays vertical, at the
rear right (below); the lead rises from it (mated height 8 mm, 14 mm to the drawer) and leaves
straight back, clear of the antenna band.

**WROOM-1 and the longer board.**  The camera's frames want PSRAM: U3 is the ESP32-S3-WROOM-1-N8R8
(8 MB flash, 8 MB octal PSRAM), the bench stand-in's own module, 18 × 25.5 mm instead of the
MINI-1's 15.4 × 20.5.  The board grew 10 mm at the rear (64 × 90, the only side with room in the
plenum): the whole layout moved 10 mm along KiCad's y, so the front edge, the four M3 holes (the
tray's standoffs) and every part keep their place in the tray, and the module's top edge sits on
the new rear edge with its antenna band (the rear 6 mm, ±24 mm around the module: no copper, no
part).  The stock footprint's 0.2 mm vias in the exposed pad are below the boards' 0.3 mm minimum
hole and wick the pad's solder: `bench:ESP32-S3-WROOM-1_NoEPVias` drops them, and the pad sits on a
top-side GND island with eight vias to In1 around it.  AUX (J5) became a vertical PH 6 like J6 and
J7 (both side entry again since the 74 × 90 re-layout, below).  The power hub keeps the MINI-1-N8.

**74 × 90 mm, the DUT on the DATA lead only.**  AUX and DATA leave the node to the right, to the
drag chain's fixed end, CAM to the rear, along the plenum to the tray's rear slot; on 64 mm they sat
30 × 38 mm apart, with no room left on the right edge.  The user chose (2026-10-19) a board 10 mm
wider on the right, then, the same day, to drop the DUT receptacle J4: in the rack every DUT hangs
on the DATA lead (a port board, or a DATA ×4 board, in the drawer), and a DUT on the bench takes
the same lead and a port board.  J7 DATA (S8B, centre y 30.0) and J5 AUX (S6B, y 50.6) now enter
from the right edge, facing the chain, pin 1 to the front; J6 CAM stays vertical at the rear right
(59.0, 17.2), its lead straight back, outside the antenna band; J2 (ROW OUT) sits on the new edge
too.  U8, the DUT side's USBLC6, is the last part before J7 (flow-through, `DUT_CONN_*` from it to
J7), the DUT power block took J4's place, J5's transistors and resistors stand in a column on its
left, and the camera's 33 Ω row, ESD, light FET and PTC in a block west of J6 (`EDGE_X` and `DX`
in `design.py`).  The front half kept its place.  The four M3 holes: the right pair at x 70.5,
with the edge, the left pair at x 3.5 as before, under the tray's left ledge: the tray has a Ø6.4
hole through the ledge over each (screw and screwdriver go through, drawer out); its standoffs and
those holes follow `pcb.bay_node.holes`.

**J7, the DATA lead (8 wires).**  Since the density decisions (2026-10-19) the DATA lead also
carries the node's I²C, for the DATA board in the drawer (its own I²C devices), on the camera's
lead type (PH 8, "Same direction").  Since node v1.0 pin 1 is DATA_VIN, the rack's VIN (20–28 V)
through the TPS26600 eFuse: one PH contact (2 A) carries its ≈ 1.76 A limit, and the DATA board
makes its own 5 V; two GND pins frame the pair, and pin 8 is GND too (the INT it carried went: the
node polls the DATA board).  The I²C bus then reaches ≈ 50 cm of lead: 400 kHz with the node's 2.2k pull-ups
(≈ 100–150 pF: ≈ 0.2 µs rise time; 5.1k until pcba-review N2), the far board adds no strong pull-ups and
keeps its addresses off the INA226's 0x40.
U8 clamps D±
right behind J7; no room was left for an ESD array on the I²C pins: the far board protects
its lines where they meet the outside.  J7 is a side-entry S8B on the right edge, pin 1 at the
front, its pads facing west, towards U8 and the DUT power block; its D± are the end of the
hand-drawn High-Speed chain (above).  J6 and J7 take the same lead type, and the silkscreen names
them (CAM, DATA): plug by the names.  The pinouts (node v1.0) make a wrong plug harmless, either
lead variant:

- a camera lead in J7: J7.1 (DATA_VIN) lands on one of the pod's end GND pins and J7.8 on the other,
  a short the eFuse cuts; the pod's other pins meet node signals at 3.3 V or less;
- a 1:1 DATA lead: J7.1 lands on the DATA board's pin 1, unconnected;
- a DATA lead in J6: no VIN there; CAM_5V (J6.3, behind its PTC) meets the DATA board's D+ or SDA (a 60 V
  pass FET and a 5 V-stand-off ESD), never its GND;
- a 1:1 camera lead: CAM_5V meets the pod's LED cathodes (pin 3), as it always did, not a camera line.

**No DUT receptacle on the node.**  Until the 74 × 90 re-layout J7 tapped the DUT pair at J4's own
pads, and whichever port was unused hung on the pair as a stub (a DATA lead left in J7 was ≈ 40 cm
of open cable for a board on J4).  With J4 gone, J7 is the pair's only end: one DUT path, no stub,
and the ESD where the lead leaves the board.  A node on the bench, out of its rack, takes a DATA
lead and a port board like a bay.

**For the next node revision** (nothing to do for this one):
- **Move C1 out from under the tray's left ledge.**  C1 is the 100 µF / 50 V bulk electrolytic
  (CP_Elec_8x10, KiCad (6, 58.4)).  The tray dropped a gusset there (2026-10-21), so the ledge now
  bridges 38 mm over C1 with 1.5 mm to spare.  That prints, but moving C1 out of the tray-frame band
  would restore the gusset.  The band is carrier y 29.5–39.8, and `NODE_C1` in
  `mechanical/lib/carrier.scad` mirrors C1's position.  A lower can is no real way out: the gusset
  needs one under 5 mm tall ([printed-parts-fdm-review.md](printed-parts-fdm-review.md)), and the
  usual 100 µF / 50 V cans are 8 × 10 or larger.

## Power hub v1.0 — 4 layers, 76 × 100 mm

One per rack.  It lives in the power box ([mechanical.md](mechanical.md#power-box)); its outline,
holes, row connectors, front LEDs and rear PD input are set in `config/rack.yaml` ›
`pcb.power_hub`, and the box is drawn around them.  KiCad y = 0 is the rear edge (the module's
antenna, the USB-C PD input), y = 100 the front (LEDs, console USB-C).  Why USB-C PD, the charger
and the sequencing: [power.md](power.md).  It was 76 × 140 until 2026-10-20: at 100 mm (86 × 100
with JLC's rails) it gets JLC's 4-layer offer, without the $25 engineering fee
([power-distribution-review.md](power-distribution-review.md), option B1).

| Block | Parts | Notes |
|---|---|---|
| USB-C PD in | GCT USB4105 (5 A) → SMAJ30A → VRACK, 100 µF / 50 V; no input switch | the whole rack's current, ≤ 5 A, in top pours.  VBUS is VRACK: the eFuses keep the rows off until the contract is final and block reverse current, so nothing switches the input (the AP33772S version had a 5 mΩ shunt and back-to-back IRF7842 NMOS here) |
| PD sink | WCH CH224A (ESSOP-10): 9 V at plug-in (CFG1 6.8 k, the one-resistor mode, I²C on), its own Rd on CC1/CC2, supply (VHV and VBUS tied) through 56 Ω + 1 µF 50 V, I²C + PG to the controller, its own LED in the front wall (PD) | the controller asks for 20 V over I²C (28 V EPR opt-in); rows stay locked out below 15 V; the chip keeps the contract through controller resets.  Its pins are rated 32 V: the RC takes surges' fast edges off |
| Rows A–D | 4 × TPS26600 (1.6 A, soft start 100 nF: ≈ 16 ms at 20 V, 22 ms at 28 V, UV 15 V / OV 31–34 V, current-limit mode, auto-retry) → 6-pin JST PH S6B-PH-SM4-TB on the left edge | pinout and bus in [can.md](can.md).  A row of four nodes is ≈ 450 µF: the soft start charges it at ≈ 0.56 A, under the limit even at the corners; the eFuse takes ≈ 7–9 W typically, ≈ 14 W worst, for 19–24 ms, inside TI's thermal-shutdown curve with its 30 % margin (Fig. 55).  22 nF until 2026-10-23 needed ≈ 2.6 A; 47 nF until 2026-10-26 met the shutdown time at 28 V and 85 °C (datasheet audit U1).  **All four rows fitted** since 2026-11-01 (below) |
| Row control | SHDN pulled low by 10 k (the pin sources up to 10 µA: 0.1 V, under its 0.55 V threshold; 100 k gave 1 V, enough to turn a row on without firmware); the controller drives ROW_EN high through 10 k (1.65 V) | **rows are off without firmware**; on once the contract is final, one after the other |
| Per row | ON (green, from the row's own output through 18 k by the eFuse: 1.4 mA, 37 mW at 28 V); FAULT (red) from the row's ROW_EN into the open-drain FLT, so it lights only for a fault on an enabled row (the TPS26600 also pulls FLT low while a row is off or starting); FLT also to the controller (100 k pull-up); a DFLS260-7 (60 V, 2 A, the B260A class of TI's TPS26600-02EVM) from GND to the output at the connector, for the cable's kick when the eFuse cuts a short | Kingbright KPA-3010 side-view LEDs in the box's front wall |
| Row current | IMON 18 k → 1.4 V/A, 1 k + 47 nF to the ESP32's ADC: the pin is a current source, so τ = (18k + 1k) × 47 nF ≈ 0.9 ms (the firmware polls every 250 ms) | |
| Controller supply | LMR51625 (2.5 A; the controller takes < 0.7 A) + 4.7 µH Vishay IHLP2525CZ (75 V, for 28 V EPR; on the FXL0630 land, the part until 2026-11-01) from VRACK, the bay node's pair (TI SLUSF64B table 8-1; the LMR51635 and 3.3 µH until 2026-10-23, same pinout and footprint) (EN 39k/18k: from ≈ 3.9 V, off below ≈ 3.8 V, the internal UVLO; FB 100k/18k: 5.24 V; the bay node's layout), B5819W diode OR with the console USB-C's VBUS → +5V, AP2112K (250 mV dropout) → 3.3 V | alive from the charger's first 5 V; runs on the console USB alone for flashing |
| Controller | ESP32-S3-MINI-1 (antenna at the rear edge), RESET / BOOT, native USB on a USB4105 (USBLC6), CTL LED | GPIO map in the controller sheet's notes |
| PD interface | SDA / SCL (the CH224A's CFG3 / CFG2) with 5.1 k pull-ups fed from a GPIO (I2C_PU), PG (open drain, low once the contract is in place) with a 10 k pull-up to 3.3 V on the net PD_INT, VBUS_SENSE 100 k / 10 k to an ADC | the pull-ups come on only once VBUS is up: a USB-powered controller never back-feeds an unpowered CH224A |
| CAN | TJA1462AT (NXP), signal improvement (VCC 5 V, VIO 3.3 V, bus pins −36 / +40 V), two split terminations 2 × 56 Ω + 47 nF (56 Ω in all), PESD2CAN | the star centre; nodes carry no termination |
| POS | 4 GPIOs → 10 k → pin 1 of each row output (the outputs have the bay nodes' OUT pinout: 1 POS · 2 GND · 3 CAN_L · 4 CAN_H · 5 GND · 6 VRACK), BAT54S clamp to GND / 3.3 V | survives a wrong cable (VRACK on POS) |

**Layout**, with the bay node's practices: JLC's 4-layer stackup (JLC04161H-7628), ENIG for now (the
node went to lead-free HASL on 2026-10-19).

* The four rows sit 17.5 mm apart down the left edge (rows A–D at y 81 / 63.5 / 46 / 28.5), each
  eFuse cluster beside its connector.  The input block and its bulk capacitor (C8) are at the rear
  right, beside the module; the buck under them, then the LDO and the CAN block down the right column.
  The front screws are at (4, 93.5) and (72, 86), clear of the LEDs and the console USB-C.
* **In1** is a solid GND plane.  **In2** carries power only: VRACK under the input block, along a
  band 8 mm wide right under the module (y 21.6–29.6, with a notch where row D's FLT pull-up takes
  +3V3) and down the eFuse column (x 16–25); +3V3 everywhere else, in one piece wrapping around it.
  +5V and the PD nets run on the outer layers.
* Every GND and supply pin gets a via of its own to its plane before routing (fan-out).  The
  eFuses' UVLO / OVP / MODE / RTN / GND pins go straight onto the exposed pad, which has six tented
  GND vias.  The outer GND pours are stitched to In1.
* The input's current runs in a top-side VRACK pour, kept free of other tracks (`exclusive`):
  connector → TVS → input capacitors → vias to In2, which carries VRACK under the whole input
  block; a 0.8 mm bottom track feeds the buck.  The buck's own VRACK island (`buck-vin`, 2.2 mm
  wide) is `exclusive` too: another net's track used to cut it in two.
* The CH224A sits beside the connector: CC1 / CC2 a few millimetres, its supply's RC and CFG1
  resistor at its pins.
* The console's USB pair runs hand-drawn on F.Cu, over In1, from the module to U5: 0.25 mm tracks
  0.2 mm apart, east just under the module, then down the free column at x ≈ 45 (87 mm each, no
  via; it crossed In2's split on B.Cu before).
  EN's 1 µF sits at the module's pin 45, beside the antenna keep-out.
* Power pads connect solid (`power_nets`): J1's GND and VBUS pins, the row connectors' GND pins,
  the eFuses' IN and GND pins and exposed pads, the buck, the LDO's GND, C8 and D1.  Decoupling
  capacitors between a VRACK island and the GND pour (C1, C2, C11–C14) are solid on both ends; R3
  (VBUS sense, one end a track) is relieved on both.
* Each eFuse has a top VRACK island on its IN pins and input capacitor, with three vias to In2.
  Each row's output runs in a hand-drawn 0.8 mm track to its connector, its output capacitor and
  its ON LED's resistor.  The SHDN pull-down and series resistor sit just below the eFuse.

The schematic uses the generator's automatic layout (blocks with labelled stubs); it is not drawn
like the bay node's yet.

## DATA port v1.0 — 2 layers, 40 × 17 mm

**Retired from the rack on 2026-10-31:** every drawer now holds a DATA ×6, or a DATA ×4 v2 where a bay
needs wires, and the drawer has lost this board's bosses.  It stays for the standalone Solo box
([standalone.md](standalone.md)) and the assembly notice's drawer step, which still draws it.

The drawer's USB-C port for the board under test (×1 per drawer): a small board screwed
components up to the floor of the drawer's rear bay (2 × PT 2.3×8 from above, one each end), the
receptacle's mouth behind a U in the port wall, an 8-wire JST PH lead from its rear edge to
the node's J7 through the drag chain ([cabling.md](cabling.md)).  It replaces the USB-C coupler
and the 90° extension.  Geometry in `config/rack.yaml` › `pcb.data_port`.

| Block | Parts | Notes |
|---|---|---|
| USB-C | GCT USB4105-GF-A-120 (J1) on the front edge at x 30.5, the board's right edge 9.5 mm from it (clear of the chain foot's lock screw); its centre 1.63 mm below the component face, 3.23 mm below the back face | a source: 56k Rp on CC1 and CC2 ("default USB power", as on the DATA ×4: the node's switch limits at 1.34–1.52 A, short of the 1.5 A that 22k would advertise); 10 µF on VBUS (C2) behind it; the shell to GND.  Its mouth stands 0.28 mm past the board edge, inside the port wall's U (checked in SolidCraft on B-rep: 2.2 mm clear each side, and a USB-C plug overmold of the spec's largest size, 12.35 × 6.5 mm, clears the U by 0.2 mm) |
| ESD | USBLC6-2SC6 (U1) flow-through, 100 nF at its VBUS pin (C3, 0402, its own GND via) and at the lead (C1): D+ through pins 1/6, D− through 3/4: J2's 5 / 6 swapped with J7's 3 / 4 (D+ on J7.3, so the node's pair runs straight), and U1's channels with them, so every pad keeps the copper it had | right at the receptacle, where the plugs go in |
| Lead | JST PH 8, side entry, SMD (S8B-PH-SM4-TB, J2), rear edge at x 14.4 (its courtyard clear of the USB4105's on a 17 mm deep board): 1–3 open (the node's INT and I²C) · 4 GND · 5 D− · 6 D+ · 7 GND · 8 VBUS | the node's J7 mirrored: a "Same direction" PH 8 lead (pin n ↔ pin 9−n), the camera's type, joins them; 8 pins, so a 6-pin row cable (VRACK) cannot go in |

USB 2.0 only: High Speed PC ↔ board in classic mode, Full Speed to the node's ESP32 otherwise.
VBUS is drawn in `design.py` (`vbus_tracks()`, netclass Power): 0.8 mm F.Cu from J2.8 under the PH's
housing to J1's two VBUS pad pairs, necked to 0.5 mm at the pad row, ≈ 15 mΩ (the routed 0.25 mm
was ≈ 0.13 Ω, 0.18 V lost at the node's 1.4 A); thin tracks feed the Rp, C1 and the ESD's VBUS pin (C3 on it).
The lead's GND pins (J2.4, J2.7: the whole DUT return) each have a drawn via to the B.Cu pour beside their pad,
and the ESD's GND (U1.2) one under the part, between its rows.
Both sides are GND pours; Freerouting does the rest like on the other boards.  Power pads connect solid
(`power_nets`: GND, VBUS): J1's four GND pins, J2's two and the ESD's; C1–C3 keep reliefs (their VBUS
end is a track).  JLC: Economic PCBA (one
side, no Standard-only part), ≈ $34 for 10 PCBs with 8 assembled (estimate in `tools/bom.py`).

A review of both boards with the Konnect MCP server (findings, fixes, what is
still open) is in [review-konnect.md](review-konnect.md).

## DATA ×4, first design (retired) — 4 layers, 100 × 37 mm

**Retired 2026-10-26:** never ordered; the DATA ×4 v2's base variant does its job, and its folder
(electronics/data-port-x4 then) is gone (git history keeps it; the folder name now holds the standing board below).  This section stays because the v2 builds on it.

A converted bay's drawer board (×1 per converted bay, `population › boards:` in `config/rack.yaml`): one
bay node serves up to four small USB boards, sub-slots `<bay>.1`–`.4` ([multi-dut-node.md](multi-dut-node.md)).
It replaces the DATA port on the drawer's rear-bay floor (3 × PT 2.3×8 from above), on the same PH 8
lead from the node's J7; its four USB-C sit behind the port wall's U's at drawer x 26 / 44 / 62 / 80
(18 mm apart, `.1` on the left).  100 mm long since 2026-10-20, for JLC's 4-layer offer (JLC adds a $25
engineering fee above 100 mm): it was 108 × 24 with a rear notch for the lead; now it is 13 mm deeper
towards the rear (as deep as the v2), the lead at the rear end of its right edge and the LDO behind it.  Geometry in
`config/rack.yaml` › `pcb.data_port_x4`; its three holes stand where they were, on the drawer's DATA ×4
bosses (the v2's first three); no fourth (v2's own lands outside it).

| Block | Parts | Notes |
|---|---|---|
| Lead | JST PH 8, side entry (S8B-PH-SM4-TB, J1) at the rear end of the right edge, its mouth out of it (drawer x 115), pin 1 at the front (drawer y 176): 1 INT · 2 SCL · 3 SDA · 4 GND · 5 D− · 6 D+ · 7 GND · 8 +5V; the plug (drawer y 174–192) drops its wires into the drawer's side window beside the board, clear of the chain foot's boss | the node's J7 mirrored ("Same direction" lead); SDA, SCL and INT pass through two USBLC6 (U4, U5, VBUS pin open; `LEAD_*` on the lead's side): the node has no ESD on them |
| I²C isolation | three 2N7002 (Q1–Q3), gate on +3V3, one per line (NXP AN10441's shifter, 3.3 V on both sides); 4.7k / 4.7k / 10k pull-ups on this board's side, the node's on the lead's (`BUS_*`) | with DUT_5V off the FETs open: the node's pull-ups cannot feed the dead +3V3 through the INA226 and TCA6408A clamps (INA226: VS + 0.3 V at most), and the node's own INA226 keeps its bus.  The firmware sets the expanders and INA226s up again after each DUT_5V on and leaves them alone while it is off |
| Hub | USB2514B (U1) on its straps (CFG_SEL 00, NON_REM 00: every strap pin on a 100k to GND, NON_REM1 sharing CFG_SEL0's), 24 MHz crystal hand-routed with no via (XI 6 mm, XO 7.7 mm), 12k RBIAS, RC reset | multi-TT, self-powered, off the I²C bus; hub port n is USB-C n (busid `1-1.n`); PRTPWR and OCS_N unused: the switches follow the expanders |
| Ports ×4 | TPS2553DBVR-1 (47k: 0.50–0.62 A; limits for 7.5 ms, then latches off until EN toggles) → 100 mΩ Kelvin shunt → VBUS; INA226 across the shunt; GCT USB4105 with Rp 56k on each CC ("default USB power"); USBLC6 in flow-through | `+5V` → `PORTn_5V_SW` → `PORTn_VBUS`, 0.4 mm tracks (netclass Port); INA226 at 0x41 / 0x43 / 0x44 / 0x45 for ports 1–4 (the node's own is 0x40), its Vbus on the shunt's load-side sense pad; 100 nF at each USBLC6's VBUS pin |
| Expanders | two TCA6408A in the rear row, each between the two ports it drives: U2 (0x20) ports 1–2, U6 (0x21) ports 3–4.  Left port of a pair: P0 RESET, P1 BOOT, P2 EN, P3 FAULT_N; right port: P4 EN, P5 FAULT_N, P6 BOOT, P7 RESET | only SDA, SCL and INT cross the board; the pins come up as inputs: **every port off until the firmware enables it** (EN pulled down by 10k, the owner's decision of 2026-10-19: four ports at 0.50–0.62 A would trip the node's 1.34–1.52 A switch), RESET/BOOT held released; both INT wired-OR with the four INA226 ALERTs to the node's IO4.  KiCad's VQFN-16 footprint with TI's 1.45 mm exposed pad (RGT0016A) |
| RESET / BOOT | per port the expander pin, open drain emulated (output register 0, the pin switched between input and output low), through 1k to a 1 × 3 2.54 mm header (GND, RESET_N, BOOT_N) | Dupont jumpers to the board's own pins; the header is not fitted (decision of 2026-10-19: decided later, soldered by hand), the 1k are.  100k pull-ups (0402) hold each expander input high with nothing plugged in: the TCA6408A has no pull-ups and no interrupt mask, a floating input would raise INT |
| 3.3 V | AP2112K-3.3 (U3) on top-side copper (VIN, EN and GND islands with vias to the planes) | ≈ 50 mV dropout: the hub, the expanders and the INA226s keep running down to ≈ 3.4 V in while the ports sag, so the firmware still sees the bay and sheds a port.  Keep a 600 mA part with thermal shutdown here: the hub draws up to 155 mA at high speed with four ports busy (84 mA at full speed), ≈ 0.31 W in the LDO from 5.24 V, above what a 200 mA SOT-23 LDO such as the basic XC6206 is rated for (tried and reverted, 2026-10-19) |

**Stackup and pairs.**  JLC04161H-7628: F.Cu signals · In1 solid GND · In2 power only (+5V, with a
+3V3 area under the ports' rear rows, the expanders, each INA226 and the hub) · B.Cu signals.  All the
ports' current crosses In2 under the hub's bottom row, a 2.5 mm +5V neck below a shallow +3V3 tab with no
via in it (the row's GND pads take an F.Cu bus to a via at each end).  The five USB pairs
are drawn in `design.py` (`usb_routes()`), 0.25 mm tracks with a 0.15 mm gap (≈ 90 Ω, as the bay
node's): ports 1–3 leave the hub through vias and run on B.Cu over the In2 plane behind the
receptacles, down beside each ESD; port 4, next to the hub, stays on F.Cu.  Each USBLC6 passes both
lines through (connector side and hub side are separate nets); its connector side runs under the
receptacle into A7 / A6, B6 joins A6 by a loop behind the pad row and B7 joins the D− line through
B.Cu.  The upstream pair goes from J1's pins 6 / 5 through two vias just inside its pads, west on
B.Cu, 45° south-west past the lead's ESDs (the +3V3 area's edge follows it on In2), west and down into the
hub's top pins with no crossover: ≈ 15 mm (≈ 25 mm round the hub's east side on the 108 mm board).  The
B.Cu pairs keep one reference plane end to end: In2's +3V3 area has a notch under the upstream pair's run
to the hub and another under PORT1's start, so all of them run over +5V.  A few short links are drawn too,
where Freerouting left one open run after run or took a detour: each left port's RESET and BOOT lines
(RESET under its header through B.Cu), every port's RESET/BOOT pull-ups, each port's switch output, R_ILIM,
VBUS and CC at its receptacle, the lead's SDA / SCL / INT from J1 into their USBLC6s, the hub's right side (RESET_N up
to R2 and C13, the CFG and NON_REM straps down to R3 / R4 / R5, VDD33 and VBUS_DET to vias), the crystal
with PLLFILT and RBIAS, and the bottom row's +3V3 and GND.  Freerouting does the rest (on the Mac, ≈ 15 s a
pass).  Power pads connect solid (`power_nets`: GND, +5V, each port's 5V_SW and VBUS): the receptacles' and
J1's GND pins, the ICs' GND pins and exposed pads (hub, expanders, INA226s, switches, ESDs) and the LDO's
VIN, EN and GND on its islands; small parts with an end on a track keep reliefs.  The ports' 5V_SW and VBUS
run in tracks, so their pads don't change.

**Power.**  The four ports share the node's DUT_5V (≈ 1.4 A, its TPS2553); the board's logic takes
≈ 0.1 A of it.  Four small boards draw 0.3–0.8 A in all (typical figures from datasheets and
measurements); the firmware admits a port only within the budget and sheds one when the node's own
INA226 alerts ([multi-dut-node.md](multi-dut-node.md)).  No batteries on the boards of a converted bay:
a LiPo charging takes more than a port's 0.5 A.

JLC: Economic PCBA (one side, no module, 4 layers allowed), ≈ $85 for 5 PCBs with 2 assembled
(estimate in `tools/bom.py`).

## DATA ×4 v1.0 (data-port-x4) — 100 × 70 mm, standing

Printed and in its KiCad title block as v1.0 (2026-11-02): no DATA ×4 was ever made, so this is the first
revision built.  Its folder and files are `electronics/data-port-x4` (`data-port-x4-v2` until 2026-11-02);
"v2" stays in the text below, where it tells it from the first design.

v1 plus virtual wires and a logic analyzer: 32 switchable pins on 8 buses and an RP2350B
co-processor (the why in [data-x4-v2-research.md](data-x4-v2-research.md), its firmware in
[coproc-firmware-research.md](coproc-firmware-research.md)).  One PCB, two assemblies: DATA-4x-logic
for the analyzer bays (B3 first), and the base DATA-4x for the other converted bays, the same board with
the logic left off (the user, 2026-10-20: "pour la data 4x on attend la version verticale"; v1 is not
ordered for the proto).  Its key ICs against their datasheets and design guides, before the order:
[datasheet-audit-data-x4-v2.md](datasheet-audit-data-x4-v2.md) (2026-10-24: nine items to fix, ten questions for the user).

**It stands.**  The board stands behind the port wall instead of lying in the drawer's rear bay
([data-x4-v2-layout-options.md](data-x4-v2-layout-options.md), option B, decided 2026-10-20).  Geometry
in `config/rack.yaml` › `pcb.data_port_x4_v2`.
- **Size and place.**  100 × 70 mm, drawer x 4–104.  KiCad x = drawer x − 4 and y = 72.5 − z, so
  y = 0 is the top edge.  The bottom edge rests on the drawer floor.
- **Holding.**  A printed cradle on the drawer's DATA ×4 bosses holds the board (the Mechanics session's
  interface, 2026-10-20), so the board has no holes:
  - its slots take each end's 5.5 mm; both faces keep those bands free of parts;
  - two T-heads come up through notches in the bottom edge (3.4 × 4.5 mm at x 31 and 67), against
    unplugging, with the front face free over each T-head bar (5.3 × 4.3 mm);
  - the base pushes on the rear face 5.3–9.3 mm above the bottom edge, which stays bare.
- **USB-C.**  Vertical receptacles (GCT USB4145-03-0170-C, 7.46 mm tall, its four shell stakes 1.70 mm long through the 1.6 mm board; the HRO TYPE-C-31-D-06 until 2026-11-02, whose 0.95 mm legs were drawn for 0.8 mm) on the front face, which faces the
  wall.  Their mouths sit 1 mm behind the wall's openings, at the ports' x and z 11, as v1's.
- **One-sided assembly.**  Every part JLC places is on the front face, so JLC's Economic assembly applies.
- **Rear face.**  Only the lead's PH 8 and the headers' tails, all soldered by hand.  J1 is a through-hole
  JST B8B-PH-K-S (C157974) at x 90, its pins in a vertical row (z 41 → 27): the lead comes up from the
  cable window beside the board's right end and plugs in from the rear.
- **SWD header** (the user, 2026-10-27, on a review suggestion).  J2 is a 1 × 5 2.54 mm through-hole header
  (hanxia HX PZ2.54-1x5P ZZ, C32713271), soldered by hand, on the logic only.
  - Its pins: 1 SWCLK · 2 GND · 3 SWDIO · 4 RUN · 5 3V3 (the probe's VTref: the board's +3V3, on the power
    plane there; +3V3_CP is the same rail through FB2).
  - Pins 1–3 follow the Pico 2's debug header, so the Raspberry Pi Debug Probe's 3-pin lead plugs straight
    on.  RUN and 3V3 serve a J-Link or an ST-Link on Dupont wires.
  - It sits on the front face's top edge, right of the co-processor, at x 59.2–69.4 (z ≈ 68.5).  Both
    faces are free there, and a probe reaches it from above with the board in its cradle.  A box4 cover
    lifts off first: the pins stop 1 mm short of its front wall.
  - The names are spelled out on the front silkscreen, over and under alternately from pin 1 (west).
  - No via within 1.6 mm of its pins: a solder bridge there on the rear face would ground SWCLK.
  - SWCLK, SWDIO and RUN reach it on the rear face, in three parallel lines along the top edge, drawn in
    `design.py` (the router left two of them open).
  - The rear test points stay: TP1–TP3 and TP12 carry the same nets.

**Two assemblies.**  `design.py` declares a variant, `b.pcb["variants"]["base"]`.  `build_board.py` then
writes a BOM and a CPL for each assembly of the same PCB, from the same Gerbers:
- **DATA-4x-logic**, everything fitted: `fab/data-port-x4-bom-jlcpcb.csv`, `…-cpl-jlcpcb.csv`.
- **DATA-4x**, the base: `fab/data-port-x4-base-bom-jlcpcb.csv`, `…-base-cpl-jlcpcb.csv`, and the
  detailed `data-port-x4-base-bom.csv`, where the unfitted parts carry DNP.  91 parts stay off:
  - the matrix sheet whole: both CH446Q, the TPS60400 and its capacitors, the TCA9534A, FB1;
  - the co-processor sheet whole: the RP2350B, its ferrite, crystal, core regulator, USB 27 Ω, LED, bus
    pull-ups and dividers;
  - each port's pin chain: both H5VU25UC, the 100 Ω arrays, the LSF0108, its Vref_B 200k and 100 nF,
    and the VREF divider.

What stays is v1's board, checked against v1's list of functions and review fixes (the DATA ×4
session's review, 2026-10-20):
- the hub;
- the four ports, each with its switch (off by default), R_ILIM, INA226, USBLC6, CC resistors, VBUS
  bulk capacitor and VBUS LED;
- the two expanders with RESET/BOOT through 1k and their 100k pull-ups;
- the lead's ESD and its I²C isolation (2N7002 ×3 with 4.7k / 4.7k / 10k);
- the 3.3 V LDO.

No base signal passes through a logic part, so the base needs no 0 Ω or solder jumper:
- The header's GND, RESET and BOOT stay live. Its P pins and VREF end on empty pads.  The base solders two
  2 × 1 pieces per port instead of the 2 × 6: the header's end columns, GND/VREF (pins 1, 2) and RESET/BOOT
  (11, 12); 16 joints for the four ports.
- Hub port 5 ends on R23/R24's empty pads: the host sees a 7-port hub with ports 1–4 in use, as with the
  logic version, whose ports 6–7 are empty too. Strapping 5–7 off (PRT_DIS pull-ups) would take six more
  resistors and gains nothing.
- +5V_MX, −5 V and +3V3_CP have no source and no load.
- The bus nets float, with nothing on them.

ENIG is there for the RP2350B's 0.4 mm QFN-80. The base's finest pitch is the hub's 0.5 mm, which v1
places on lead-free HASL. If the base is ordered on its own, HASL saves $12.

**Price.**  `tools/bom.py` prices both assemblies and the order panel below, from JLC's catalogue and fees
(`bom/README.md` › JLC).  J1 and the four headers come loose from LCSC.

The logic's core-regulator inductor (L1, Abracon AOTA-B201610S3R3-101-T, C42411119) had 3 in JLC's stock
that day: JLC Global Sourcing, as `catalog.py` notes.

**Order panel** (the orchestrator's call, 2026-10-20).  One 1 × 2 mouse-bite panel, ENIG, Economic: $240
for the rack's 2 + 2, against $270 as two orders.
- **Layout.**  100 × 142 mm.  The logic board stays as drawn; the base is turned 180° above it, top edge
  to top edge, 2 mm apart.  The bottom edges, which carry the T-head notches and sit on the cradle's base,
  and the 5.5 mm slot ends stay milled.
- **Tabs.**  Two, on the top-edge joint, at x 9 and 91: each is the other's mirror, so they meet.  These are
  the only spots both top edges leave bare, between the cradle's ends and the parts and routes across the
  top: the co-processor's test pads (on the rear), the crystal, CP_RUN and the bus tracks.
  - Each tab is 6 mm wide, with seven 0.6 mm holes at a 1 mm pitch (0.4 mm between holes) on each side,
    0.2 mm into the edge: 28 holes, within JLC's guide (5–8 a set, 0.35–0.4 mm apart).
  - The guide also asks for a set every 50–60 mm; these are 82 mm apart.  **Depanel by cutting the tabs**
    (side cutters through the bites, then sand), not by snapping the joint: bending it strains the 0402s
    along the top edge.
  - No copper within 1.2 mm of the edge there (`b.pcb["keepouts"]` "tab0", "tab1").  From a hole's edge
    (`tools/panel.sh`): the nearest copper 0.85 mm (a GND via beside a tab), the nearest courtyard 2.93 mm
    (C6, along the edge).  C17, the hub's 100 nF, sat 1.84 mm from tab1's bites, across the joint; it now
    sits over its pin 46, 7.6 mm in (R3, the strap it took the spot of, over RN1).
  - The silkscreen "DATA ×4 v2.0" moved off the left tab, to x 17.
- **Files:** `fab/data-port-x4-panel-gerbers.zip`, `-panel-bom-jlcpcb.csv` (41 lines) and
  `-panel-cpl-jlcpcb.csv`.
  - The CPL has 316 parts: 204 on the logic board (`<ref>_L`), 112 on the base (`<ref>_B`).
  - The base's 92 logic parts are DNP; their pads stay.
- **Checks.**  DRC: 0 errors, 0 unconnected, the boards' 4 silkscreen warnings twice.  All 418 models
  resolve.  Each half matches its variant's BOM and CPL.  Each copy's zone fills equal the board's.

Rebuild it after any change to the board: `tools/kicad.sh data-port-x4 --fab`, then
`tools/panel.sh data-port-x4`.

| Block | Parts | Notes |
|---|---|---|
| Lead | J1 on the rear face (pin 1 INT at the top … pin 8 +5V at the bottom); SDA, SCL and INT through an H5VU25UC (U4, right beside pins 1–3), then a 2N7002 each (Q1–Q3, gate on +3V3) with 4.7k / 4.7k / 10k pull-ups on this side (R6–R8) | One ESD part where v1 has two USBLC6.  The FETs work as v1's (PCBA review X2): with DUT_5V off they open, so the node's pull-ups cannot feed this board's dead +3V3 through the chips' clamps.  They sit in the right-hand column under J1; its +5V pin lands on a +5V tab of the power plane |
| Hub | USB2517I (U1) on its internal default configuration (CFG_SEL 110: strap options disabled, no SMBus; the other strap pins keep their pull-downs, unread), 24 MHz crystal, RBIAS 12k | 7 ports: 1–4 the USB-C (busid `1-1.n` as v1), 5 the co-processor, 6–7 declared but unused (cosmetic: the host sees a 7-port hub).  On purpose: PRTPWR unused and OCS_N open on their internal pull-ups, since the node switches each port (EN) and reads its FAULT_N through the expanders; VBUS_DET on 3.3 V, right for a self-powered hub.  Top-right corner, right over J1, turned so the downstream pins face down towards the ports; its 24 MHz crystal (Y1) 2 mm west of XTAL1/XTAL2 (the layout review, 2026-10-28): XI and XO drawn on F.Cu with no via, 5.4 and 7.5 mm with the branches to their load capacitors (C4, C5, each on its pad) and to R10, XO under the case between its two east pads; the F.Cu and B.Cu GND pours round it, In1 under it, and no other net's track or via over its four parts (a DRC rule).  Before, XI ran 16 mm and XO 19 mm through two vias.  The straps sit in two rows over its north face (RN1, RN2, R3–R5, R9), plus RN3 at its south-east corner.  CFG_SEL 110 keeps D+ / D− from being read as port-disable straps (below).  RESET_N comes from a MAX809S supervisor (U5, UMW, C347371; the audit's fix 6): its errata (DS80000628A, Module 2) say the internal POR misses a brown-out and name a MAX809S, so a DUT_5V sag can no longer leave the hub hung.  1 MΩ (R10) across its crystal, as the datasheet's Fig. 9-1 draws it, and 4.7 µF on VDD18 / VDD18PLL (C7, C8: the 1.0 µF ± 20 % the datasheet asks had no margin left once a 0402's DC bias is counted; VDD18PLL's 100 nF, C10, 0.6 mm from pin 62, C8 right behind it, under the crystal); the audit's U2 and U10 |
| Ports ×4 | As v1; EN pulled down (a port stays off until the node switches it on), R_ILIM right beside the switch's ILIM pin, the INA226's Vbus on the shunt's load-side sense pad, 100 nF at each USBLC6's VBUS pin | PCBA review X3, X4, X9.  Each port's power cluster sits between its header and its receptacle.  The USBLC6 is right of the receptacle, the CC resistors left of it  A green VBUS LED per port (D101–D401, KT-0805G through 1k, ≈ 3 mA) on its switched 5 V, before the shunt, so the INA226 doesn't count it: on while the port is on (the user, 2026-10-21).  **Source only**: Rp from the switched VBUS, no CC detection.  A foreign source that back-feeds a port is cut by the TPS2553 within ≈ 4 ms (latched, FAULT_N); the node's firmware will refuse EN while Vbus is already there |
| Expanders | As v1 (U2 0x20, U6 0x21); 100k pull-ups on the RESET/BOOT expander lines; each RESET through 10k to +3V3 (R11, R12) | X6: they float with nothing plugged in.  TI asks for a pull-up on RESET when nothing drives it (the audit's U9).  Each pair's expander sits between its two power clusters |
| 3.3 V | AP2114H-3.3 (U3, C150716, SOT-223) from +5V, 22 µF in and out (C2, C3) | It takes the hub, the expanders and the INA226s.  The USB2517I draws 330 mA with four High-Speed ports busy (its datasheet, all supplies, typical; 460 mA at most, with seven), against the USB2514B's 155 mA on v1; with the co-processor, the expanders, the INA226s and the pull-ups, 0.51 A at worst.  That is 0.74 W typical in the LDO, ≈ 1.0 W at worst from the +5V's 5.22 V, too much for v1's AP2112K in SOT-23-5.  The AP2114H keeps v1's low dropout (≈ 0.16 V at 0.35 A), so the hub keeps running while the ports sag the +5V.  It is rated 1 A with thermal shutdown at 160 °C, 128 °C/W bare.  Its tab sits on +3V3 copper that runs west to the edge band on both faces, with fifteen vias (six into the +3V3 plane), its VIN on a +5V island with two vias; Diodes gives no figure for board copper, so the bring-up measures it (pass: ≤ ≈ 86 °C/W in the closed drawer: ≤ 125 °C at 40 °C).  Left-hand column, across the power plane's split.  The AMS1117 (basic) would save $3.07 but drops 1.1 V.  Since 2026-10-21 it also feeds the co-processor (+3V3_CP through FB2, ≈ 15–45 mA), in the 0.51 A above |
| Headers ×4 | 2 × 6 2.54 mm through-hole (J102–J402), read as two rows: upper VREF · P1 · P2 · P3 · P4 · BOOT, lower GND · P5 · P6 · P7 · P8 · RESET | Soldered by hand, not by JLC (hanxia HX PZ2.54-2x6P ZZ, C32713279): out of the JLC BOM and CPL.  Through-hole, easier to solder than the SMD version (the user, 2026-10-20).  The rear face carries only J1, so the tails (1.5 mm) are free.  Layout B (the usability review; the user, 2026-10-21: "oui je valide"): one 2 × 6 per port, centred at the port's x and z 28.5, pins forward over the plate.  The odd pins are on the lower row, the even on the upper.  The names are on the silkscreen over each header, where they stay readable with the jumpers in, in two lines stacked like the rows (VREF, GND, BOOT, RST spelt out); a big port number and the port's VBUS LED sit over its west end.  Each port's pins are a voltage domain of their own (its VREF), so the four groups stay four whatever the header (layouts A and C, and the one bank, in the review).  RESET/BOOT go through an H5VU25UC in flow-through (U109–U409, fitted on the base too; the audit's fix 7 and the schematic review's N4), then 1k as v1, the 1k right behind the ESD over the header's east end (port 4's over its LSF0108's east end, clear of the pairs coming down from the hub); the expander lines' 100k pull-ups in a column right of the header (ports 1–3's lowered since the HS review, 2026-10-22: the band over the headers carries the USB pairs).  VREF has an H5VU25UC of its own (U108–U408, logic only), west of the port's LED: VREF and RESET/BOOT sit at the header's two ends, 12.7 mm apart under the pairs' trunk, too far for one part in flow-through on both.  Strain-relieve the jumpers (tie them down) rather than letting them pull on the header.  The DUT's own RESET/BOOT pull-ups should be 4.7 kΩ or more: against a 1 kΩ pull-up, the 1k in series stops an asserted line at ≈ 1.65 V |
| Pins ×4 | 2 × H5VU25UC in flow-through, 100 Ω per pin (4 × 0402 arrays), LSF0108 (U107–U407); VREF through a third H5VU25UC (U108–U408) | A side = the DUT's VREF, B side = 3.3 V.  Vref_B and EN come from the board's +5V_MX through 200k (the usability review, 2026-10-21; before, from the port's VBUS): each group is a voltage domain of its own, any board on any group, two groups for a board that needs 16 pins.  TI requires Vref_B ≥ Vref_A + 0.8 V and recommends 1.0 V: with +5V_MX at its 4.75 V low, a VREF up to ≈ 3.9 V translates as specified (the VREF rule below).  The bias current (≈ 20 µA) leaves the LSF0108 by Vref_A, so the VREF divider to the co-processor's ADC (VREF / 2, then 100k to the pin: the audit's U8) is 10k / 10k: an unwired VREF stays ≈ 0.4 V, under the 0.65 V minimum TI specifies for translation (through 100k / 100k it would float up to ≈ 2.1 V and translate).  That alone does not isolate the group: TI guarantees the off state only with EN low (SDLS966M §8.3.2), and under Vref_A + VTH the pass gates still conduct, so lows pass both ways and highs into A clamp at ≈ 0.4 V (the audit's fix 8; how it behaves at ≈ 0.4 V is a bench check).  The isolation is the crosspoints': the firmware keeps a port's switches open while its VREF reads under 0.65 V (GPIO40–43 under 0.33 V).  A DUT that is off (SLVA675B §5.6) and a board that is off (EN low with +5V_MX off) do isolate.  A wired VREF supplies VREF / 20k (165 µA at 3.3 V).  The ESD arrays are hongjiacheng's H5VU25UC (C20615800, JLC "preferred extended": no part-type fee) in place of TI's TPD4E05U06 (2026-10-20).  The same I/O and GND pins (I/O 1, 2, 4, 5; GND 8); its 3, 6, 7, 9, 10 have no internal connection (its function diagram, checked 2026-10-25), and our copper joins each line's pair of pads; its own DFN2510-10L land (`bench:`, pads 3 and 8 one bar).  The 32 P lines are drawn and locked in `design.py` › `p_lines()` (the kicad-happy review's X2-1, 2026-10-27: Freerouting had run six of them from the header straight to the 100 Ω array, the ESD on a stub), every port alike: header pin → B.Cu under the USB pairs that cross the band on F.Cu → a via (two staggered rows) → the ESD pad → across to its partner → the 100 Ω array.  Each array's GND pads, between its two middle lanes, go down to a via of their own.  `electronics/tools/flowthru.py` checks every listed line (`flow-through.json`: the P lines, VREF, RESET and BOOT) runs connector → ESD pad → partner pad → next part with no bypass or stub, and `tools/tests/test_flow_through.py` runs it in CI for every board that lists its lines.  Ports 1 and 4's 5V_SW (to the VBUS LED) are drawn too, past the header where the P lines left room.  Its stand-off is 5 V (TI's 5.5 V), breakdown 6 V at least: every line it guards stays at 5 V or less, a DUT's pins at its VREF (≤ 5 V), the lead's I²C and INT at 3.3 V |
| Matrix | 2 × CH446Q at ±5 V (U7: ports 1–2, U8: ports 3–4; their Y0–Y7 joined = buses D C B A E F G H), TPS60400 for −5 V (U9), TCA9534A at 0x38 (U10); their +5V (+5V_MX) through a 600 Ω ferrite (FB1, GZ2012D601TF) | The −5 V stays on purpose: at a single 5 V the CH446Q's R_on is 120–225 Ω, and a 1.8 V board's I²C low through it would fail.  The ferrite gives the matrix a DC path of its own (≈ 1 µH low down, it filters little at the pump's 50–250 kHz).  It carries the crosspoints, the inverter, the four LSF0108s' bias and the +5V sense divider: ≈ 1–4 mA; the co-processor takes +3V3 since 2026-10-21.  TCA9534A: P0 DAT · P1 CK · P2 STB U7 · P3 STB U8 · P4 RST (pulled up: every switch open until the node writes it) · P5 co-processor RUN · P6 BOOTSEL · P7 mark.  Each bus is pulled up to 3.3 V by 10k (RN8, RN9), the B-side pull-up of whatever pins it joins |
| Co-processor | RP2350B (U11) wired like a Pico 2 less its flash: it comes up in the USB bootloader and the analyzer is loaded into its SRAM at each power-up (an RP2354B is a drop-in that boots from its in-package flash; NextPCB had none, 2026-11-03); 12 MHz ABM8-272-T3, core regulator with 3.3 µH and 3 × 4.7 µF; its 3.3 V (+3V3_CP) from the board's +3V3 through a 600 Ω ferrite (FB2, C1017) | The core regulator is Raspberry Pi's RP2350B Minimal R4 block, turned 180° with the chip (the audit's fixes 1–3): CIN and COUT across VIN / PGND, L1 behind them along the chip's edge, its dot (pad 1, the land's silk and fab dot) on +1V1 as Fig. 26 draws it (the user's reading, 2026-10-25).  Its copper is theirs: the LX, +1V1 and PGND copper areas of their RP2350B Minimal R4-S1 file, turned with the chip, with their two V_OUT vias (VREG_FB taken there) and PGND's two adjacent GND vias; CFILT on its own via.  CIN and COUT sit on Raspberry Pi's own 0402 land (pads 0.56 mm apart, 0.94 mm pitch), so LX runs between them 0.3 mm wide as theirs.  The F.Cu GND pour leaves a hole round the block, so its high-current GND meets the main GND only through those two vias ("only connect to main GND at one point"), and nothing else lies under L1 or beside LX; no copper under LX and L1 on In1, In2 and B.Cu either.  Raspberry Pi's hardware design guide (Release 3) asks for exactly their layout: "if you choose not to use our example, then you do so at your own risk".  DVDD pin 32, the furthest from the regulator, on 4.7 µF (C47).  GPIO45 reads −5 V through 10k / 100k from +3V3_CP (R40, R41: 2.55 V nominal, ≥ −0.48 V even unpowered).  Hub port 5.  GPIO2–9 = buses A–H (gusmanb's CH1–8); GPIO0 → GPIO1 bridged (its trigger); GPIO14 = mark; GPIO25 = LED.  GPIO19, 18, 17, 16, 13, 12, 11, 10 switch the 2.2k pull-ups of buses A–H (our firmware); RN6/RN7 sit right beside them on the same face.  GPIO40, 43, 42, 41 = VREF 1–4 / 2 (through 100k; ports 2 and 4 swapped so their lines reach B.Cu round C45, DVDD pin 51's 100 nF), GPIO44–45 = the ±5 V rails.  SWD on J2, a 1 × 5 2.54 mm header on the front face's top edge (SWCLK, GND, SWDIO, RUN, 3V3; logic only), and on two test pads on the rear face, along the top edge, beside a GND (TP1–TP3).  Its crystal Y2 (the layout review, 2026-10-28): the lines drawn on F.Cu with no via, XIN 7.8 mm up between the case's two bottom pads to the top-right one, XOUT 5.6 mm up beside it and over C47 (no longer under its body, between its pads) to R22, C48 and C49 on their pads; no other net over its parts on F.Cu (a DRC rule: BUS_D, which passed under it with a via, goes round); the slow SWD/RUN lines to J2 still run under it on B.Cu, In1's solid GND between.  No LDO of its own since 2026-10-21 (the usability review: an extended part type less): U3 takes its ≈ 15–45 mA.  USB through 27 Ω (R23/R24, C25100, extended), the value Raspberry Pi specifies (22 Ω basic until 2026-11-01: Raspberry Pi publishes no driver impedance to justify it) |

**Hub configuration: CFG_SEL 110 (2026-10-25).**  The USB2517 reads CFG_SEL[2:0] as RESET_N rises; 110 is
"Internal Default Configuration, Strap Options are Disabled" (DS00001598C Table 5-2 p. 16, the user's reading;
100 and 101 add dynamic power switching, 111 is ganged / LED mode).
- The hub loads Table 7-1's internal defaults (§7.4 p. 41; straps override them only when enabled, §7.5).  They
  are what the straps used to set (Table 7-1 pp. 19–20): CFG1 9Bh (self-powered, individual port power switching,
  individual over-current sensing on the OCS_N inputs, still open on their pull-ups), NRD 00h, BOOST 00h, PRT_SWP
  00h, CFG2 20h (no dynamic power switching, 8 ms over-current timer), CFG3 00h.
- With the straps off, D+ / D− are no longer sampled as port-disable straps (PDS = PDB = 00h: all seven ports
  enabled).  So a self-powered DUT attached while the hub resets keeps its port, and the co-processor's D+
  pull-up on port 5 no longer races RESET_N: the schematic review's S2 (D2, CP_RUN to HUB_RST_N) is gone.
- CFG_SEL1 (HS_IND, pin 42) and CFG_SEL2 (pin 13) go up through their 10k (one element each of RN2 and RN3),
  CFG_SEL0 (SCL) stays down: static, stable at RESET_N's rise.  HS_IND drives after reset (I/O12, 12 mA): its
  10k takes 0.33 mA, and no LED hangs on it (CFG_SEL1 high makes it active low).
- The pins that were straps keep their pull-downs (RN1, R3, R4, R5, R9; the user's call, 2026-10-27).  110
  no longer reads them, but they are LED outputs and SUSP_IND, I/O12 buffers that may go high-impedance with
  nothing on them.  Nothing in DS00001598C says their input receiver is off then (Table 5-3 p. 16; Table 8-2
  p. 50 gives a ±10 µA tri-state leakage only).  The 10k keep the floating inputs from drawing current or
  picking up noise.  They also keep a return to strap mode open by reworking only CFG_SEL's two pull-ups.

**Bring-up test points (the DFT rule, 2026-10-26).**  Bare pads on the rear face (B.Cu, mask open, no paste,
out of the BOM and CPL), each named on B.SilkS under it: 1.5 mm on GND and the rails, 1.0 mm on signals.
They carry the bring-up's checks (no short from a supply to GND, then each rail at its voltage) and a probe
on each line that a header or J1 doesn't already bring out: the resets, the faults, SWD and the buses.
- **Rules.**  Each pad is more than 2 mm from the THT pads and from J1, the rear face's only part.  All
  stay clear of the cradle's 5.5 mm ends, the push band and the notches.  None sits on a USB pair.  The
  positions are meant to stay from one revision to the next.
- **The co-processor, along the top edge:** TP13 BOOT (CP_BOOT_N, its QSPI_SS), TP12 RUN, TP2 SWDIO,
  TP1 SWCLK, TP3 GND, TP10 +3V3_CP.  SWD was on the front face before; the front face has J2, the SWD
  header, instead.  Its core rail, TP11 +1V1, sits
  under it, on that rail's own rear track.
- **The matrix, in the left-hand column** by its TCA9534A and the TPS60400:
  - TP14 DAT, TP15 CK, TP16 STB1, TP17 STB2, TP19 GND; STB1 sits on its own rear track, and so does
    TP18 MX RST, under the co-processor's row;
  - TP4 −5V, TP5 +5V_MX, TP6 GND.
- **The supplies, lower in that column** by the AP2114H: TP7 +3V3, TP8 GND, TP9 +5V (the lead's).
- **The hub, top right:** TP20 HUB RST (HUB_RST_N, U5's output), TP21 GND, TP22 1V8 (its core rail).
- **Below J1:** TP23 INT, TP24 SDA, TP25 SCL (the board side of the lead's isolation), TP26 GND.
- **Each port's FAULT_N:** TP101–TP401 FLT1–FLT4, each on its own rear track between its expander and its
  switch.  TP27 and TP28 are GND points by the expanders.
- **The expanders' RESET** (the layout review, 2026-10-27): TP38 EXP1 RST and TP39 EXP2 RST, each by its pull-up's
  via (R11, R12).
- **The buses A–H** (the same review): TP29–TP36, named A to H, behind the co-processor's east side where all
  eight pass between it, the pull-ups and the two crosspoints, with TP37 GND.  A, B, E and F sit on a rear
  track of their own, C, D and G beside one; H, which runs on the front only, comes down a via of its own.
  Not a grid: each pad goes where its own bus passes, 2.6 mm or more from the next.
- **Left out:** VREF, RESET_N and BOOT_N (on each header), the lead's own lines (on J1) and the USB pairs.
- **LOGIC ONLY.**  The co-processor's row, its +1V1, the matrix's group and the buses carry that mark (all but
  their GND): the base leaves their parts off, so its pads there float.
- **Where the router stopped.**  Most links are Freerouting's.  Where it gave up, a TP sits on a rear track
  of its own net, or a short drawn link joins it: RUN up onto CP_RUN's track, +3V3_CP through a via to
  FB2, BUS H down its via, and TP37 to a GND via east of it (the automatic one, west, moved RN8's dog-bones).

**The VREF rule.**  Virtual wires and the analyzer are specified for boards with 0.95–3.6 V logic: wire VREF
to the board's I/O supply.
- A 5 V board works if its inputs are TTL-compatible (AVR / ATmega, most 5 V Arduinos).  Wire VREF to the
  board's own 3.3 V pin: the board receives ≈ 3.3 V highs, which its TTL inputs read, the LSF0108 stays
  within spec (Vref_B ≥ Vref_A + 0.8 V) and the bus stays at 3.3 V.
- With VREF at 5 V the bus rises to ≈ 4.0–4.2 V.  That is outside TI's recommended conditions, but nothing
  breaks: the other ports clamp to their own VREF, and the RP2350B's GPIO2–9 tolerate 5 V while it is powered.
- Strict-CMOS 5 V inputs are not guaranteed.  True 5 V support would be a v2.1: a ≈ 6.5 V rail to bias
  Vref_B, and the bus pull-ups moved to 5 V.

**Pin map.**  Each port's eight pins land on one crosspoint's X lines, in the order the layout gives;
the firmware maps them:

| Port | P1 | P2 | P3 | P4 | P5 | P6 | P7 | P8 |
|---|---|---|---|---|---|---|---|---|
| 1 (U7), 3 (U8) | X15 | X7 | X9 | X11 | X14 | X6 | X8 | X10 |
| 2 (U7), 4 (U8) | X12 | X4 | X2 | X0 | X13 | X5 | X3 | X1 |

X and Y are the chips' pin names; CH446Q's serial address codes for them follow its datasheet's table.
Y0–Y7 = buses D, C, B, A, E, F, G, H on both chips.  Y0–Y3 leave by the chips' north side, towards the
co-processor; Y4–Y7 leave by the south side.

**Layout.**  The board is laid out in bands, top to bottom:
1. The co-processor in the middle, between the two crosspoints.
   - Its bus pins face the right-hand crosspoint (south-east corner).
   - The pull-up enables and their arrays sit on its east face.
   - The ADC inputs and the ±5 V dividers are on its west face.
   - The core regulator and the USB resistors are under it.
   - The crystal and the LED are on top, by the board's edge; the
     area under it stays free for the buses between the two crosspoints.
   - The hub sits in the top-right corner, the matrix expander in the top-left one.
   - The left-hand column takes the −5 V inverter (beside the left crosspoint), the +5V_MX ferrite and
     the board's 3.3 V LDO (on the power plane's split).  The right-hand one takes J1 and its parts.
2. Per port, its pin chain, straight up from its header.
   - The header's lines leave it west → east: VREF, then P5 P1 P6 P2 P7 P3 P8 P4.  Each lower-row pin's line
     passes just west of its upper-row neighbour's.
   - Each one passes an ESD channel (flow-through), then its 100 Ω.
   - It then enters the LSF0108 from below.  The LSF0108 is turned so its A face points down, with the
     channels in the same order.
   - Its B lines turn into the crosspoint's face beside it, the westmost line at the top on the west of
     the chip, the eastmost at the top on the east.  So nothing crosses.
3. The headers.
4. Per port, its power cluster (switch, shunt, INA226).  The expanders sit between the clusters.
5. The receptacles with their ESD and CC resistors.

The power plane is split: +3V3 above the receptacles (the power clusters included), +5V under that line.
- Each port switch's IN takes its +5V by a 0.6 mm track down to a via under the split, drawn before the
  routing.  J1's pin 8 (through-hole) lands on a +5V tab of the plane.
- The loads above the split take +5V_MX, routed like a signal: the crosspoints' VDD, the −5 V inverter and
  the LSF0108s' bias.
- Both planes stay 1.4 mm in from the edge, the notches included, 1 mm further than the other copper.  GND
  vias every 5 mm round the edge, 0.9 mm in, drawn before the routing (`edge_fence`), close the GND plane
  and the outer pours on it: the power planes' cavity doesn't radiate from the edge.
- Freerouting treats a plane net's pads as connected through the plane, even over the other net's area.
  So pads there must be drawn by hand, or sit on a net of their own.  The
co-processor's +3V3_CP and +1V1 are routed as tracks.  A power-plane island poured after the routing
joins the +3V3_CP vias under the RP2350B.

Dense rules at JLC's multilayer floor:
- 0.127 mm signal tracks;
- 0.1 mm clearance (JLC: 0.09);
- 0.5 / 0.3 mm vias;
- 0.2 mm from a via hole to a track (JLC's minimum).

Routing (2026-10-22, after the user found jogs where tracks leave J1's pads).  Freerouting's optimizer only
runs on a board it sees fully routed, and its first-found routes leave many pads by a short straight, a
0.2 mm jog and then their diagonal.  So nothing is left for the pours to join:
- each QFN's exposed pad takes a via in the pad (left open at 4 layers: fine in a thermal pad, below); the
  RP2350B's takes three, at the crossings of its nine paste windows that the buses under the pad leave free
  on B.Cu (two of them since the PCB review's X4B-03, 2026-11-09: the pad is the chip's only ground but
  VREG_PGND, and one via left it no spare); the hub's 4.7 mm pad takes nine, 3 × 3 at 1.2 mm, for its
  ≈ 1.1 W.  Its paste is cut into 16 windows between
  them (0.85 mm, 47 % of the pad, 0.12 mm from each via's ring:
  `bench:QFN-64-1EP_9x9mm_P0.5mm_EP4.7x4.7mm_Paste4x4`), so no paste sits on an open hole;
- U3's islands, the hub's pin 19 and RN3's spare pad are joined by drawn tracks;
- every drawn track ends on its pad's very centre: Freerouting joins a track to a pin there only (2.5 µm off,
  it had left the HS pairs and the port switches' IN open);
- the power plane's +3V3 and +5V areas no longer overlap (they did by 0.2 mm along J1's +5V tab).
After the import, `tidy` (pcbgen's `tidy_tracks()`, on every board since 2026-10-22) straightens what the
optimizer leaves: a run of the router's segments becomes the fewest straight and 45° segments that join its
ends, where that is no longer and the clearances allow, and a run holding one under 0.6 mm loses it.  Its last
step (`unjog()`, since 2026-10-26, the user's find of micro zigzags) takes the router's micro-jogs: a few short
segments (each under 0.25 mm, 0.2 mm aside in all) stepping a track sideways between two parallel runs, often
where it necks down to pass two pads, or up and back down.  One run slides onto the other's line, each segment
keeping its width.  Where the clearance needs the offset, the jog becomes one 45° step.  The DATA ×4 v2 lost 39
of them.  J1's leads now leave their pads by one diagonal.  Jogs into vias stay, and so do the buses that weave together
between vias (on B.Cu; on In2 and In3 at 6 layers): the vias would have to move
(docs/autorouting-benchmark.md, "Straight tracks").
The switches' IN feeds stay drawn: without them no run of the portfolio came out clean.

Power tracks:
- The routed +5V stretches are 0.6 mm, as v1.
- The ports' 5V_SW and VBUS are 0.3 mm (v1: 0.4).  The vertical USB-C's VBUS pads are 0.3 mm wide at a
  0.5 mm pitch, so a wider track can't reach them without necking down.  At the switch's 0.62 A limit,
  15 mm of 0.3 mm outer copper drops ≈ 15 mV.

The USB pairs.  The hub's host is the node's ESP32-S3, full speed only (12 Mbit/s), except in classic mode:
a laptop on the bay's PC port then takes the hub at High Speed.  After the RF review (2026-10-21, against
a bench node whose Wi-Fi a USB 3 hub beside its antenna knocked out; this board has no SuperSpeed) and the
HS review (2026-10-22, the user's rule: "keep them over a continuous GND reference, preferably on F.Cu
above In1.Cu"):
- the five High-Speed pairs are drawn and locked in `design.py` as coupled pairs: their two lines side by
  side all the way, 0.15 mm apart (≈ 90 Ω, below), equal in length by construction (two bumps on D−, where
  D+ goes on to the far pin);
- the four port pairs run on F.Cu over the GND plane, from under the hub's south row to their ESD: ports 1–3
  west in three lanes over the headers, then each down its header gap; port 4 down the board's east side.
  95, 77, 61 and 47 mm.  Under the hub, ports 2 and 3 run 25 µm out from their pins' centre, so C15 (pin
  5's 100 nF) fits between them, 0.79 mm under its pin.  Freerouting had put them mostly on B.Cu, over the split power plane, each line its
  own way (up to 16 mm apart);
- the upstream pair's pins sit between the hub's straps and its crystal, walled off from J1 on F.Cu by the
  downstream pairs: it dives under the hub's body to B.Cu for ≈ 11 mm (over the +3V3 plane, among the hub's
  decoupling), then runs down the east side on F.Cu to J1, ≈ 40 mm;
- the expanders' RST_IO of ports 2 and 4 (pin 10, between INT and BOOT_IO on the side facing a pair) is drawn
  to a via south of the package: ports 1 and 3's pairs step 0.75 mm east there to leave the room;
- no B.Cu track crosses the power plane's split (+3V3 / +5V, and the +5V tab's edge by J1): a keep-out along
  it (on In3 too at 6 layers) makes every signal that does cross on F.Cu, over the GND plane, so the return
  current never changes plane there;
- the hub's two south VDD33 pins (5, 10) take their vias under its body, so its downstream pairs leave the
  south row unboxed;
- each port's leg from its ESD to its receptacle (≈ 10 mm, where D+ and D− reach the USB-C's two rows) is
  routed by Freerouting: its crossing dives to B.Cu, 6–9 mm over the +5V area (to In2 or In3 at 6 layers).
  Pad to ESD pin, D+ and D− differ by −0.06 to +1.96 mm with the plug one way and −2.22 to −3.93 mm the other
  (measured 2026-10-29): at most 3.9 mm, ≈ 25 ps against a 2.08 ns High-Speed bit, left uncompensated.  On any
  USB-C receptacle the second row mirrors the first (D+ and D− swap places), so one line's A–B link crosses the
  other's and the two ways differ: no meander evens both, and on these few millimetres one would add its own
  impedance step and only move the skew from one way to the other;
- the co-processor's pair (Full Speed only) is routed by Freerouting on F.Cu and B.Cu, matched by `match`
  (at 6 layers, mostly on In3, where it places no meander, its lines differ by 2 mm: 13 ps against an 83 ns
  bit);
- the hub's 480 MHz PLL puts its 5th harmonic at 2.400 GHz, the band's edge, 1 MHz under Wi-Fi channel 1.

ENIG, flat for the RP2350B's 0.4 mm QFN-80.

**Stackup: 4 layers** again since 2026-10-23 (the user's choice), JLC04161H-7628: F.Cu signals and the High-Speed
pairs · In1 GND · In2 power (+3V3 / +5V, the +3V3_CP island) · B.Cu signals.
- Why: the routing portfolio and its fixes (split planes, straightening, the neck-down floor, no via in an SMD pad)
  route it clean, cheaper and faster than 6 ([autorouting-benchmark.md](autorouting-benchmark.md), "The DATA ×4
  v2 on 4 layers").  On 2026-10-22 one 4-layer run had left 27–29 links open, and the HS review took it to 6.
- The 6-layer build (`X4V2_LAYERS=6`: F · GND · sig · sig · power · B) was kept routed in its own folder until
  2026-10-25; git history has it.
- Routed with the portfolio's `ripup30-order2`: 750 vias, 5194 mm, 1930 bends; F.Cu 3213 mm, B.Cu 1981 mm; In1
  and In2 carry no signal track.  The 6-layer board: 810 vias, 4828 mm, 1491 bends, B.Cu 102 mm, the rest on In2
  and In3.
- B.Cu references the split power plane: none of its tracks crosses the +3V3 / +5V split (keep-out), 9
  segments cross the +3V3_CP island's edge (21 on In3 at 6 layers).
- ≈ 90 Ω on the outer layers: 0.25 mm lines 0.15 mm apart over 0.21 mm of 7628 (estimated, not field-solved;
  0.15 mm over 0.1 mm of 3313 at 6 layers).
- Vias in pads: only the 8 drawn in the QFNs' thermal pads, left open (JLC fills and caps vias for free only
  from 6 layers), fine in a thermal pad (design review, 2026-10-23).  No via lands on any other SMD pad, where an open
  via drains the joint; the 6-layer board, routed before that rule, has 17 there, filled for free.
- Finish: ENIG for the order panel and the logic board, flat for the RP2350B's 0.4 mm QFN-80; the base ordered
  alone can take lead-free HASL (its finest pitch is the hub's 0.5 mm).
- Cost (jlcpcb.com, 5 pieces; 2026-10-20 at 4 layers, 2026-10-22 at 6): the order panel, 100 × 142 mm ENIG,
  $52.00 ($60.40 at 6 layers); one logic board alone, 100 × 70 mm ENIG, $25.40 ($49.40); one base alone in
  lead-free HASL $13.20; the black mask $8.00 an order ($33.10); 3–4 days (8–9).

## Camera pod v1.0 — 2 layers, 40 × 27 mm

The board in each camera pod, under the bay's ceiling beside the Arducam Mega (×1 per camera; 2 to
start), so that nothing is crimped or soldered by hand.  Mounted components down (the LEDs face
the bay), 2 × PT 2.6 into the printed pod.  Geometry in `config/rack.yaml` › `pcb.camera_pod`
(KiCad y = 0 is the edge beside the camera).

| Block | Parts | Notes |
|---|---|---|
| Lead | J1, JST PH 8, side entry, SMD (S8B-PH-SM4-TB), mouth out of the right edge: 1 GND · 2 CS · 3 LED_K · 4 MISO · 5 MOSI · 6 CAM_5V · 7 SCK · 8 GND (node v1.0) | the node's J6 mirrored: a ready-made "Same direction" PH 8 lead (pin n ↔ pin 9−n); GND on both end pins (the DATA lead's cross-plug rule, above) |
| Camera | J2, 1 × 6 pin header, 2.54 mm, SMD (staggered pins), in the Mega's own order VCC · GND · SCK · MISO · MOSI · CS, the names on the silkscreen | an XH 2.54 6-pin → Dupont cable from the Mega's side connector (its own, if it ends in Dupont sockets), plugged on by name |
| 3.3 V | AP2114H-3.3 (U1, C150716, the node's U2; the AMS1117 until the datasheet audit's F1: specified stable only with 22 µF tantalum) from CAM_5V, 10 µF in, 22 µF + 100 nF out, its tab on a top-side +3V3 pour and a bottom-side island (three vias) | the Mega at 3.3 V (≈ 0.5 W in U1 at its 317 mA max, Arducam): MISO at 3.3 V, the node's R35 stays unpopulated |
| Light | 4 × XL-2835UWC-02 (white, 2835, 20–33 lm at 60 mA), each from CAM_5V through 100 Ω 0805 to LED_K | 18–26 mA each over the LEDs' Vf spread and CAM_5V 5.0–5.2 V, ≤ 66 mW in a 125 mW resistor, ≤ 102 mA for the four, inside the node's camera budget (the PCBA review's P1: 56 Ω 0603 gave 36–44 mA, up to 108 mW in 100 mW).  About a third less light than the 32 mA first planned, ≈ 0.6 EV that the Mega's auto-exposure takes.  Along the edge next to the camera, beside the lens, not around it; the node's AO3400A pulls LED_K low; a thin PETG diffuser 5–10 mm in front, in the pod |

Both sides are GND pours; routed by Freerouting.  Power pads connect solid (`power_nets`: GND, CAM_5V):
J1's GND pins, J2's GND and the AP2114H's; C1–C3 keep reliefs (an end on a track).  JLC: Economic PCBA, ≈ $23 for 5 PCBs with 2
assembled (estimate in `tools/bom.py`).

For a later bay node: CAM_5V has only the PTC, no switch, and the Mega has no reset pin, so a hung
camera needs a power cycle of the whole bay (the review's P3).  A load switch on CAM_5V from a free
GPIO (IO5 or IO6) would let the firmware restart the camera alone.

## Title block

Every board's title block is the same (`electronics/tools/silk.py`, `title_block()`): the BitBunk logo
25.5 mm wide (the user, 2026-11-02), and 0.6 mm under it one line, left-aligned with it: the board's name and
revision at 1.5 mm, then 1.5 mm further the revision's date at 1.0 mm on the same baseline (pcbgen places it
from the name's ink).  On B.SilkS, read from below; about 10.3 mm tall, so it fits the camera pod's 40 × 27.
Each sits in the rear face's top-right corner as read from below (top view: x 0, y 0), at the nearest spot
that keeps 1 mm from any other silk text or mark, 0.3 mm from pads, holes and courtyards, 4 mm from the
connectors (the user: away from the connectors), and 0.5 mm outside a mounting hole's courtyard, where its
screw head, washer or standoff sits.  `electronics/tools/silkair.py` measures it on the shapes KiCad plots
(text ink, outlines); `build_board.py --check` fails on a closer item.  The bay node stays against the rear
edge 5.25 mm in (clear of H1's screw head), the DATA ×6 19 mm in; the DATA ×4 v2, with no free edge, is 17 mm
in and 19 mm down.  The camera pod's is the whole block at 0.96 scale (`POD_TITLE_SCALE`: the largest that
clears H1's screw head, its test pads and their names; the user, 2026-11-02), 3 mm along the rear edge.  The
power hub's corner has no spot clear of H2's screw head, VSNS and the UART pads nearer than 26 mm down: its
block is in the rear face's bottom-left as read from below (the user's pick), 14 mm in from the side edge and
centred between the front edge and FLT A / IMON A.

The logo is not printable as drawn: the boards on its shelves have pins and chips 1–2 units wide.
`derive_logo()` makes its silk variant from `bitbunk-logo.svg`: each shelf's board a plain silhouette, the
gaps round the frame, the B, the boards and the i's dot opened to the wordmark's tightest letter gap, the
slivers left by those cuts dropped.  At 25.5 mm its gaps are 0.25 mm (0.15 left after a 0.05 mm ink spread a
side) and its lines 0.30 mm or more; `tools/tests/test_silk.py` holds both.  The outlines the boards take are
`bitbunk-logo.silk.json`, written by `python3 electronics/tools/silk.py` (shapely, which the KiCad image
lacks); the test checks they still match the SVG.

## Test pads

Every board has bare test pads on the bottom.  Each is named on B.SilkS.  They are not in the BOM or the CPL, so there is no part and no assembly fee.  Supply and GND pads are 1.5 mm; signal pads are 1.0 mm.  Every pad is more than 2 mm from any THT pad or hole.  On the four boards below, the closest is 4.7 mm (the pod's second GND).  On the DATA ×4 v2 it is 2.1 mm (TP27, by J101); TP23 is 2.0 mm from J1's courtyard.  Their positions are fixed in each `design.py`, so a fixture or a probe card still fits after a new revision.

| Board | Pads (silkscreen names) |
|---|---|
| Bay node | under the module: TX, RX, 3V3, GND, EN, IO0, FLT (DUT_FLT_N), ALRT (INA_ALERT_N), SDA, SCL, GND; along the bottom edge: GND, VIN, 5V, 3V3, DUT 5V, CAM 5V; second round (kicad-happy review BN-2), a GND in each group: the camera SPI by R31–R34 (SCK, MOSI, MISO, CS, on the lead side of the 33 Ω); CAN TXD/RXD and POS IN by U11; AUX TX/RX, RST, BOOT and POS OUT by the AUX column.  Each on a drawn via on one of its net's tracks or on its B.Cu track: no routing moved |
| Power hub | TX, RX, 3V3, GND, EN, IO0; PD SDA/SCL (CH224A); 5V, VRACK, two more GND; FLT and IMON for each row (A–D); second round (kicad-happy review PH-2): 5V BUCK, USB 5V, VHV (CH224A); ROW A–D and EN A–D; CANH, CANL, TXD, RXD and a GND by them (U6); PD PG; VSNS.  Each on a via of its net or a B.Cu track's end: no routing moved, no new via on In2's VRACK band |
| Camera pod | GND, 5V, 3V3; a second GND at the far end; second round (kicad-happy review CP-3), 1.0 mm by J1: SCK, MOSI, MISO, CS, LED (the LEDs' switched cathode), each on a drawn via on its F.Cu track, clear of the LDO's B.Cu island |
| DATA port | 5V (VBUS), GND; a second GND by the receptacle (kicad-happy review DP-6) |
| DATA ×4 v2 | 32, listed with the board above: 8 GND; +3V3, +5V, the hub's 1V8 and the logic's −5V, +5V_MX, +3V3_CP, +1V1; SWDIO, SWCLK, RUN, BOOT; the matrix's DAT, CK, STB1, STB2, MX RST; HUB RST; INT, SDA, SCL; FLT1–FLT4 |

## Fiducials

Each of the five ordered boards has three fiducials on its top face (FID1–FID3), the marks a pick-and-place camera aligns on.  Each is 1 mm of bare copper in a 2 mm mask opening (KiCad's `Fiducial_1mm_Mask2mm`).  They are not in the BOM or the CPL.  The bottom faces have none: no machine places a part there.

Their positions are in each `design.py` (`FIDUCIALS`).  On each board they form the widest triangle among the places the routed board leaves free.  A place counts as free when the mark's centre is 1.5 mm from any other copper, courtyard or silkscreen, and 3 mm from an edge.  The camera pod is too small for that: its marks keep 1.15 mm to other copper, and two are 1.75 mm from an edge.

They were added to the routed boards on 2026-11-10 without moving a track, a via or a part.  `design.py` places them like any other part, so a regenerated board has them at the same places.

| Board | FID1 | FID2 | FID3 |
|---|---|---|---|
| Bay node | 5.75, 5.75 | 70.25, 6.0 | 58.0, 86.25 |
| Power hub | 5.75, 9.75 | 70.25, 54.0 | 10.25, 94.75 |
| Camera pod | 27.5, 3.5 | 1.75, 22.5 | 38.0, 25.25 |
| DATA ×4 v2 | 74.5, 3.75 | 7.0, 46.25 | 90.25, 66.0 |
| DATA ×6 | 9.75, 17.75 | 90.25, 18.0 | 18.0, 66.25 |

## Bring-up measurements

What the PCBA review ([pcba-review.md](pcba-review.md)) left to the bench, per board, on the first ones built.  The datasheet audit ([datasheet-audit.md](datasheet-audit.md), 2026-10-24) adds its own bring-up checks.  So does the schematic review ([schematic-review-2026-10-25.md](schematic-review-2026-10-25.md)).

| Board | What | How | Expect |
|---|---|---|---|
| DATA ×4 | VBUS at each USB-C against the total load (X11) | a resistor or an electronic load on a USB-C breakout per port, 0.25 A steps up to the admission limit (1.15 A in all, the board included); a meter at the receptacle, against the port's INA226 | ≥ 4.75 V up to ≈ 1 A in all; ≈ 4.54 V at the node's 1.34 A limit (estimate).  Lower: raise the node's +5V, or lower the admission limit |
| DATA ×4 | Ports off at power-up (X3) | DUT_5V on, no firmware command: each `PORTn_VBUS` | 0 V until the firmware enables the port |
| DATA ×4 | No back-feed with DUT_5V off (X2) | node running, DUT_5V off: the board's +3V3; an I²C scan from the node | +3V3 under 0.1 V; the node's INA226 (0x40) still answers, 0x20/0x21/0x41–0x45 don't |
| DATA port | VBUS at the receptacle at the node's limit (D1) | a 1.3 A load on a USB-C breakout; a meter at J1 and at J2.8 | under 30 mV between them (≈ 15 mΩ of copper) |
| Camera pod | 3.3 V and the LDO's heat: the AP2114H (stable on its 22 µF MLCC since the datasheet audit's F1) drops ≈ 0.5 W at the Mega's 317 mA | scope on C2, 20 MHz limit, at power-up, with the camera streaming and the LEDs switching; the tab's temperature at full capture | 3.3 V ± 3 %, no sustained ringing; the tab under ≈ 100 °C |
| Camera pod | LED current (P1) | the voltage across one 100 Ω, LEDs on | 1.8–2.6 V (18–26 mA) |

## Sourcing

Every non-generic part carries `MPN`, `Manufacturer` and `LCSC` fields
(verified against JLCPCB's live library on 2026-10-16 through the
`@jlcpcb/mcp` server — see `tools/jlc_mcp.py`).  Generic passives are
resolved to JLC **basic** parts by `electronics/tools/passives.py` (cached in
`electronics/lib/passives.json`); values were nudged to basic-library E-series
where it didn't matter (e.g. 150k RT, 100k/18k FB).

`--fab` writes, per board:

* `fab/<board>-gerbers.zip` (Gerber X2 + Excellon), ready for JLCPCB/PCBWay;
* `fab/<board>-bom-jlcpcb.csv` (one line per LCSC part) and
  `fab/<board>-cpl-jlcpcb.csv` (placement, corrected to JLC's footprints: see
  [Placement corrections](#placement-corrections));
* `<board>-bom.csv` (detailed, one line per value: MPN, manufacturer, LCSC,
  alternatives);
* `docs/<board>-schematic.pdf`, SVGs, top/bottom/iso renders;
* `fab/<board>.step` and `fab/<board>.glb` (the web viewer and the renders use the GLB: `tools/pcb_glb.py`
  turns the bay node's, the power hub's, the DATA port's, the camera pod's and the DATA ×4 v2's into
  `site/assets/pcb/<board>.glb`, each drawn where the rack puts the board; the DATA ×4 v2's GLB is its STEP's, every body, kept whole and
  meshopt-compressed, with a plain copy in `render/assets/pcb` for the renders.  Every board is painted in
  the rack's solder mask, `config/rack.yaml › pcb.solder_mask` (black since 2026-10-21: JLC's satin black, white
  silkscreen, the traces showing only by their relief; tick "PCB Color: Black" in the JLC order, free on 2 layers,
  $8.00 an order on 4, which the BOM adds); the v2's both faces are painted
  from `build/<board>-art.json`, so its base variant's empty footprints show);
* `build/<board>-3d.json`: which placed parts the 3D export gives a body.

**3D models.**  Some parts have no model in KiCad's 3D library: the ESP32-S3 module, the JST PH SMD
side-entry connectors, the side-view LEDs, the buttons.  A footprint whose model file is missing
just vanishes from the STEP, the GLB and the renders, without an error.  So the catalog attaches a
vendor model to each of them (`Cat.model`, files in `electronics/lib/3dmodels`, see its README):
Espressif's own STEP for the module, kept in the repo, and LCSC / EasyEDA models for the rest,
fetched by `python tools/fetch_pcb_models.py` into a git-ignored cache.  Run it before `--fab`.
`python tools/pcb_glb.py --check` then lists any placed part still without a body and exits 1;
the viewer conversion falls back to a stand-in of the part's real outline (or fails, `--strict`).
`build_board.py` checks the models with ERC and DRC, on every run (`check_models()`, into
`build/summary.json`): each footprint's model must resolve to a file (KiCad's library, the repo's,
or the EasyEDA cache), and a footprint without one must have no body by nature (holes, test points,
net ties, fiducials) or be listed in the board's `b.pcb["no_model"]`; otherwise `--check` fails.  An
EasyEDA model not fetched yet is only reported.  Where KiCad lacks the exact package, the catalog
borrows its nearest body: the TCA6408A's VQFN-16 3 × 3 takes the QFN-16 3 × 3 one.  Where it has no
near body (the DATA ×4 v2's RP2350B QFN-80, USB2517I QFN-64 with a 4.7 mm pad and LSF0108 DHVQFN-20),
`tools/make_step_models.py` draws one: a black body at the datasheet's size and a pin-1 dot.

The bay node has no through-hole part since v0.4, and the hub none since v0.5: their JST PH
connectors are the SMD S*B-PH-SM4-TB, and the USB-C receptacles' shield tabs go through
pin-in-paste, all placed by JLC in the same reflow pass.  A part marked `hand_solder=True` in
`electronics/tools/catalog.py` would be kept out of the JLC BOM and CPL, and flagged
"hand-solder, buy loose (LCSC)" in the detailed BOM's `Assembly` column.  A board assembled two ways
on the same PCB declares its variants in `b.pcb["variants"]` (name → the references it leaves off):
`build_board.py` writes `<board>-<variant>-bom-jlcpcb.csv`, `…-cpl-jlcpcb.csv` and the detailed
`<board>-<variant>-bom.csv` beside the board's own, and a part left off never shares a BOM line with
its fitted twins (the DATA ×4 v2's base DATA-4x).

**Order panels.**  A board ordered as a panel of its variants declares it in `b.pcb["panel"]`.
`electronics/tools/panelize.py` builds it with KiKit (`tools/panel.sh <board>`: the KiCad image plus
KiKit 1.8.1, built once), after `tools/kicad.sh <board> --fab`, which keeps the panel's outputs.
- **Placement.**  Copy 1 stays where the board is drawn.  Each next copy is turned by its `rot` and
  placed above the last, `gap` mm away.  The copies meet only through mouse-bite tabs at the given x:
  a bridge `tab_width` wide, and a line of holes along each board's edge.
- **Names.**  Parts become `<ref>_<tag>`, nets and netclasses `<tag>_<name>`, each copy keeping its own
  connectivity.  The separator is `_` because KiCad also reads a netclass pattern as a regular
  expression, and `L-+5V` would take `L--5V`.  The board's custom rules follow the renamed nets, so the
  zones fill as on the board.
- **Assembly.**  Each copy's variant leaves its parts DNP.
- **Outputs:**
  - `fab/<board>-panel-gerbers.zip`;
  - one JLC BOM and CPL for both assemblies: `fab/<board>-panel-bom-jlcpcb.csv`, `-panel-cpl-jlcpcb.csv`;
  - `docs/<board>-panel-top.jpg`.
  - The panel's KiCad project is git-ignored: the script rebuilds it.
- **Checks:**
  - DRC (no parity: the panel has no schematic);
  - every footprint's 3D model;
  - the holes against copper (≥ 0.5 mm from a hole's edge) and parts (≥ 1 mm to a courtyard);
  - each copy's rows of the panel's CPL and BOM against its variant's own files, moved and turned with it
    (`panelize.py <board> --check`, and `tools/tests/test_panel.py` on the committed files).

## Assembly at JLCPCB

Real quote taken on jlcpcb.com on 2026-10-16 from the `fab/` files (USD,
indicative; shipping, DHL ≈ $27–40, and import VAT come on top).  The full
breakdown was in [`bom/README.md`](../bom/README.md) and `tools/bom.py` (`JLC_QUOTE`) until the
bay node's estimate of 2026-10-19 (below) replaced it there:

| Board | Order | PCB | PCBA | Total |
|---|---|---:|---:|---:|
| bay node | 20 PCBs, 4-layer ENIG (JLC adds 5 mm edge rails for Standard PCBA), 16 assembled, Standard | $58.90 | $308.81, of which components $181.21 and feeders $65.10 | **$367.71** |
| power hub v0.3 (replaced by v0.4) | 5 PCBs, 2-layer ENIG, 2 assembled, Economic | $25.70 | $48.43, of which components $17.56 and extended parts $15.45 | **$74.13** |

**Bay node order: 10 PCBs, lead-free HASL, 10 assembled** (the user, 2026-10-19: 8 bays and 2
spares).  Not re-quoted yet (the full PCBA quote needs the user's JLC sign-in): `tools/bom.py`
carries an estimate from JLC's current fees, ≈ **$319**.  PCB $19.50 (10 × 74 × 90 mm 4-layer HASL,
$19.30 read live, the same as at 64 × 90: JLC's offer covers up to 100 × 100 mm; + the 5 mm rails
Standard PCBA may add; no engineering fee up to 10 PCBs).  PCBA $299:
setup $25.56, stencil $8.21, $1.53 per unique part type (38: $58.14; four values merged onto values
the board has: EN 100k/10k, PC_DET 10k/18k, I²C 5.1k, AUX VREF 33 Ω), SMT $5.90 (369 joints a
board), X-ray $16.40 ($1.64 a board, mandatory for the WROOM-1), packaging $0.52, components ≈
$185 (catalogue × 1.12; the TPS2553D saves ≈ $0.35 a board).  The 74 × 90 re-layout took ≈ $15 off (J4, its Rp pair, two part types).  ENIG would add ≈ $12.60.  JLC's page also lists a Standard handling fee
(≥ $14.93) that the 2026-10-16 quote didn't carry: to confirm at the real quote.

**Power hub v0.5: quoted on 2026-10-19, $222.48 without its AP33772S.**  On jlcpcb.com, from main's
fab files (gerbers, the JLC BOM and CPL): 5 PCBs, 4-layer, ENIG, 2 assembled, Standard PCBA.  It carries the
ESP32-S3 module, so it needs Standard PCBA, with X-ray, like the bay node.
- PCB $50.50: engineering fee $25, ENIG $18, board $7.50.  JLC adds two 5 mm rails for Standard PCBA,
  so the board was 86 × 140 mm (76 × 140 then).
- PCBA $171.98: setup $25.75, stencil $8.27, components $57.89 (47 lines), feeders $72.85, SMT $3.30,
  X-ray $3.30, packaging $0.50.  JLC charges $0.12 for the USB4105s (J1, J6), which it flags as hard to
  process.
- Shipping: ≈ $23.48 by DHL.

Two parts were out of stock that day:
- **TCAN1462V (U6), LCSC C7399456.**  Quoted as its documented alternate, NXP's TJA1462AT/0Z
  (C3234095, 10 500 in stock): same SOIC-8 pinout, signal improvement kept, bus pins −36 / +40 V
  instead of ±58 V.  Both boards take it since (hub U6, node U11; the user, 2026-10-19), and the
  TCAN1462V stays an alternate.
- **AP33772S FA01 (U1).**  LCSC has 0 (the FA02 is out until ≈ 14/12/2026), so it was left out of the
  quote.  It comes through JLC Global Sourcing from DigiKey: 5 parts with JLC's reported ≈ 50 % markup,
  ≈ $17, plus its ≈ $3 loading fee, and ≈ 2 weeks for them to clear into JLC.

`tools/bom.py` carries the quote plus that U1 line, ≈ $243.  The estimate before was ≈ $227: X-ray
cost less than estimated, feeders more.

The user found that dear.  What JLC charges for, checked on its calculator (2026-10-19, 5 boards,
4 layers):
- **The $25 engineering fee comes from the length.**  At 86 × 100 mm (the rails included) JLC's
  4-layer offer applies: $8 instead of $25 + $7.50.
- **ENIG costs $18.00, lead-free HASL $5.30.**

Two savings are applied since, as adjustments to the quote (≈ $213):
- **Lead-free HASL, as the node.**  It was ENIG for the MINI-1's LGA pads; JLC X-rays the module
  either way.  −$12.70.
- **Eleven values merged** onto values the board already has (no footprint moved), so eleven fewer
  part types at $1.55 each in Standard PCBA's feeders: 48 → 37.  −$17.05.
  - FB 100k/18k: 5.24 V, as the node; ≈ 4.9 V after D4 for the TJA1462AT.
  - EN 39k/18k: on at 3.9 V, off below ≈ 3.8 V (the internal UVLO; the divider alone 3.1 V).
  - PD INT divider 10k/18k: 3.2 V.
  - I²C pull-ups 5.1k.
  - Every front LED on 1k (1.2–1.4 mA).
  - The IMON filters and the CAN split caps on the eFuses' dVdT value (22 nF then, 47 nF from 2026-10-23; the dVdT went to 100 nF on 2026-10-26, the filters stay on 47 nF).
  - The LDO's input cap 1 µF 0805 (the eFuses' part; the buck's 3 × 22 µF sit just before D4).

**The CH224A instead of the AP33772S: ≈ $185.**  The AP33772S had no LCSC stock; the CH224A
(C42459160, 12 739 in stock, $0.43) is a plain LCSC part, and it needs no input switch:
- No Global Sourcing for U1: the quote's $20.04 for 5, $13.22 for the 3 the order bought
  since.  −$13.22.
- Out the 2 × IRF7842, the 5 mΩ shunt, the NTC and their passives; in the CH224A, its 56 Ω and
  its 6.8k.  −$2.79 of parts for the 2 boards.
- Three placed part types fewer (36 → 33, the CH224A included).  −$4.65.

**76 × 100 mm instead of 76 × 140: ≈ $161** (2026-10-20, the same parts).  86 × 100 with the rails,
so JLC's 4-layer offer: $8.00 for the 5 boards and lead-free HASL $5.20, no $25 engineering fee
(jlcpcb.com calculator).  −$24.60.  Above 10 PCBs the fee comes back (`JLC_PCB_PRICE`).

**Why 34 part types.**  The hub does five jobs, and each brings its own parts.  The four eFuse
rows add no type: they repeat the same nine.  Many values are set by a datasheet equation (eFuse
current limit and IMON, the CH224A's CFG1, the buck's FB).

| Block | Its own types |
|---|---|
| PD input | 4: CH224A, 6.8k (CFG1), SMAJ30A, 100 µF (the AP33772S version had 8: the switch, shunt and NTC) |
| 4 eFuse rows | 6: TPS26600, S6B, red LED, BAT54S, 7.5k ILIM, DFLS260-7 (the outputs' clamp, since 2026-11-02) |
| 5 V buck, 3.3 V LDO | 5: LMR51625, inductor, AP2112K, 22 µF, 39k |
| ESP32 and USB console | 4: ESP32-S3-MINI-1, USBLC6, 2 buttons, 1 µF 0603 |
| CAN | 2: TJA1462AT, PESD2CAN |
| shared | 13: 100n, 47n, 1 µF 0805, 10 µF 1206, green LED, USB4105, B5819W (the buck's OR), 1k, 100k, 10k, 5.1k, 56 Ω, 18k |

**All four rows are fitted** (the user, 2026-11-01: a third row is coming).  From 2026-10-23 rows C
and D were DNP: their eFuses U13 / U14, row connectors J4 / J5 and front LEDs D13 / D14 (ON),
D23 / D24 (FAULT).  JLC's quote of 2026-10-23 left them out; `JLC_SINCE_QUOTE` adds them back
(+$9.46 of parts and +$0.32 of joints for the 2 hubs, no part type more).

`FITTED` in `design.py` still lists the rows fitted.  A row left out keeps its footprints and routing,
its eFuse, connector and LEDs DNP; its passives stay, so FLT stays high (100k) and IMON at 0 V (18k),
and the firmware disables the row in the hub's devicetree (`power_hub.dtsi`, its `status`).

The charger stays the 100 W one: at 20 V a row is capped at ≈ 32 W, and three rows of four bays outgrow
100 W only at their worst, which the hub's budget sheds ([power.md](power.md#budget)).

The routing did not move.  JLC assembles at least 2 boards in Standard PCBA, so one hub plus a spare
is the minimum.  The MINI-1, like every ESP32 module JLC stocks, is "Standard PCBA only"; the
controller needs Wi-Fi (status page, API, updates).

Two changes were made after that quote and are not re-quoted (`JLC_FINISH`
and `jlc_order()` in `tools/bom.py` apply them, indicatively):

* (v0.3 only) **Power hub in lead-free HASL** instead of ENIG.  v0.4 has the
  ESP32 module and goes back to ENIG.
* **Through-hole connectors soldered by hand**: node J1 J2 J6 (JST PH),
  hub J1 (JST VH) and J2–J6 (JST PH).  JLC's hand-soldering fee ($3.61 per board
  order) goes, and so do the loading fees of these extended part types (pro
  rata of the quoted fee: one type on the node, −$3.43; two on the hub,
  −$4.41).  The connectors cost the same bought loose from LCSC, plus LCSC's
  shipping.

That brings the order to ≈ **$360.67** for the nodes and ≈ **$49.51** for
the hub.  The quote's "manual assembly" lines are kept: re-quote to see
whether they go too.

Rev 0.2 came after the quote as well and is not re-quoted: on the node the
LMR51635 + FXL0630 replace the TPS54360B, its B560C Schottky, the FXL1040 and
the compensation network (≈ +$0.70 of parts per board, one extended part type
fewer), and the JST PH connectors cost less than the VH ones.  Rev 0.3 (the
Konnect review) adds no part type: the hub's power pours and thermal vias are
copper only, and the node's Kelvin shunt is the same LCSC part on a new
footprint.  Rev 0.4 puts the node's JST PH connectors back in JLC's hands, as SMD parts: two
extended part types (C295747, C265405, ≈ $3 loading fee each per order), ≈ +$0.86 of parts per
board over the through-hole ones, and nothing left to solder by hand on the node.  Rev 0.5 (the rack
bus) turns J1/J2 into the 6-pin S6B (C265405, already the AUX connector: no new type) and adds three
extended part types, the CAN transceiver (TCAN1462V, C7399456, then the TJA1462AT, C3234095, when it ran out; alternate TCAN1044AV, C3234993), the PESD2CAN (C75176) and the BAT54S (C7420333).
Its USB-C receptacles become the GCT USB4105-GF-A-120 (C5184243, the part the user chose for the
hub: 5 A on VBUS), one extended type for another.  In all ≈ +$9 of loading fees per order and
≈ +$2.38 of parts per board, $1.44 of it for the two GCT receptacles.  `JLC_SINCE_QUOTE` in
`tools/bom.py` adds both to the node's order: ≈ **$387.73** for 16 assembled nodes, against
$364.10 for v0.4.  Re-quote before ordering.

* **Bay node: Standard PCBA.** JLC can only place the ESP32-S3-MINI-1 module
  (C2913206; the node's WROOM-1-N8R8 since the camera, C2913201) and the WS2812B-2020 LED with its Standard PCBA service, not
  Economic, so the node pays Standard fees (setup $25.75, stencil $8.27, X-ray
  $13.28 in the quote above).  These parts are flagged `standard_only` in
  `electronics/tools/catalog.py`, which `tools/bom.py` reads.  The WS2812C-2020-V6
  (C55109522) is Economic-capable, but the module keeps the board on Standard
  anyway.  Check the WS2812C pinout against the WS2812B-2020 footprint before
  swapping it in.  Every ESP32-S3/S2 module at JLC is Standard-only; the
  Economic-capable Ai-M62-32S (BL616) is evaluated, and kept for a v2, in
  [mcu-alternatives.md](mcu-alternatives.md).
* **Power hub: Standard PCBA since v0.4** (the ESP32 module).  Its 100 µF bulk capacitor uses
  C3352, the Economic-capable listing of RVT1H101M0810, like the node's.
* **No Basic drop-ins.** Every extended part was checked against JLC's Basic
  library (October 2026): none has a Basic equivalent with the same ratings
  and footprint, so the extended-part loading fees stay (the node's $65.10 of
  feeders, the hub's $15.45).  Near misses were rejected:
  * SS54 Schottky: 40 V, below the buck's 60 V input rating;
  * AO3401A P-FET: 30 V, on a 24 V bus with transients up to 53 V;
  * 100 mΩ / 250 mW 1206 shunt: INA226 full scale would drop to 0.82 A, below
    the 1.5 A DUT limit.
* **One BOM line per LCSC part.** JLC refuses several lines that resolve to
  the same part ("Multiple lines in the BOM have been matched to the same
  part") and deselects them, so the JLC BOM merges them: SW1/SW2,
  U5/U6 on the node; D3 + D11–D15 on the hub.  Merged lines carry
  the MPN as comment.

### Placement corrections

JLC does not place KiCad's footprint: for each LCSC part it takes its own
(EasyEDA) footprint, puts that footprint's origin on the CPL's Mid X/Y and
turns it by the CPL rotation.  Where JLC's footprint has a different 0° or a
different origin from KiCad's (connectors anchored on pin 1, SOT-23 drawn the
other way round, ICs drawn with pin 1 at the bottom), the part lands rotated
or shifted.  `JLC_CPL_FIX` in `electronics/tools/build_board.py` corrects the
CPL per LCSC part: an extra rotation (degrees, counter-clockwise) and an
origin offset in the KiCad footprint's own axes, both turned with the part.
The export stops if a part listed there changes footprint.

On the bottom side JLC takes the position as seen from the top (the pos
file's) and the rotation as seen from above the part, i.e. from below the
board: the CPL gets 180° − KiCad's rotation, plus the part's correction (KiCad
draws a bottom footprint at θ as its library footprint mirrored top-bottom,
then turned θ; an origin offset is mirrored with it).  The fits for bottom
parts un-mirror KiCad's pads first.  DATA ×4 v2 is the first
board with parts there: its bottom rows have to be confirmed in the preview
like any new row.

The values were worked out on 2026-10-16 by fitting each part's EasyEDA
footprint pads (`https://easyeda.com/api/products/<LCSC>/components`) onto
the KiCad pads, pin by pin, then checking that the bodies overlap and that
diodes, LEDs and electrolytics keep their cathode or + side.  JLC's
placement preview had shown the first three rows wrong before the fix; the
others come from the fit alone.  The through-hole connectors are soldered by
hand now and are no longer in the CPL, so their rows (JST PH/VH) don't
matter for JLC: they stay in the table for an order where JLC places them.

| LCSC part | Refs | Correction | Status |
|---|---|---|---|
| C173752 JST S2B-PH-K | node J1 J2 J6 | 180°, +1.00 mm x | was wrong in the preview; hand-soldered now, not in the CPL |
| C6186 AMS1117 SOT-223 | node U2 until 2026-10-23, camera pod U1 until the datasheet audit (F1) | 180° | looked wrong in the preview; confirm the fix |
| C165948 HRO TYPE-C-31-M-12 | node J3 J4 until v0.4 | −1.57 mm y | not on the boards since v0.5 |
| C2913206 ESP32-S3-MINI-1 | hub U4 (node U3 until the camera) | +2.55 mm y | to confirm |
| C2913201 ESP32-S3-WROOM-1-N8R8 | node U3 | +3.63 mm y | to confirm |
| C471518 JST B6B-PH-SM4-TB | node J5 until the 74 × 90 re-layout | 180°, −0.63 mm y | not on the node any more |
| C431540 MSK12C02 | node SW3 | −0.55 mm y (on its pegs: KiCad's footprint is Shouhan's land pattern, JLC's draws its pads 0.13 mm further out; −0.25 mm until the PCBA review left the pegs 0.30 mm off their 0.85 mm holes) | to confirm, drills shown |
| C45262770 LMR51635 TSOT-23-6 | node U1 and hub U2 until 2026-10-23 | 270° (same EasyEDA footprint as C7519) | to confirm |
| C44991044 LMR51625 SOT-23-6 | node U1, hub U2 | 270° (EasyEDA draws it as C45262770 and C7519) | to confirm |
| C11355 FSUSB42 MSOP-10 | node U5 U6 | 270° | to confirm |
| C49851 INA226 VSSOP-10 | node U10, DATA ×4 U102–U402 | 270° | to confirm |
| C7519 USBLC6-2SC6 SOT-23-6 | node U4 U8 U12 U13, data port U1, DATA ×4 U4 U5 U103–U403 | 270° | to confirm |
| C55266 TPS2553 SOT-23-6 | node U9 until the TPS2553D | 180° | not on the node any more |
| C521201 TPS2553D SOT-23-6 | node U9 | 270° (EasyEDA draws it as C7519, not as C55266) | to confirm |
| C10096 74LVC1G32 SOT-23-5 | node U7 | 180° | to confirm |
| C8545 2N7002 SOT-23 | node Q2 Q3 | 180° | to confirm |
| C7503186 SUD50P06 TO-252 | node Q1, hub Q1 | −1.89 mm x | to confirm |
| C495809 IRF7842 SOIC-8 | hub Q1 Q2 until the CH224A | 270° (drawn as C3234095) | not on the hub any more |
| C598310 KPA-3010CGCK / C4555382 KPA-3010SURCK | hub D3 D8 D11–D14 / D21–D24 | +0.825 mm y (JLC's origin is the pads' centre); polarity: the green's right pad is A, the red's is marked "+" | from the PCBA review; to confirm |
| C544399 TPS26600 HTSSOP-16 | hub U1–U5 | 270° | to confirm |
| C160315 JST B2P-VH | hub J1 | +1.98 mm x | hand-soldered, not in the CPL |
| C295747 JST S2B-PH-SM4-TB | node J6 until the camera | none (fit: +0.08 mm y, left alone) | not on the node since the camera |
| C495548 JST B8B-PH-SM4-TB | node J6 | −0.63 mm y | to confirm |
| C20917 AO3400A SOT-23 | node Q4 | 180° | to confirm |
| C265405 JST S6B-PH-SM4-TB | node J1 J2 J5, hub row outputs | 180° | to confirm |
| C3234095 TJA1462AT/0Z SOIC-8 (alternates C7399456 TCAN1462V, C3234993 TCAN1044AV) | node U11, hub U6 | 270° | to confirm |
| C75176 PESD2CAN SOT-23 | node D5, hub D9 | 180° | to confirm |
| C7420333 BAT54S SOT-23 | node D6 D7, hub POS clamps | 180° | to confirm |
| C5184243 GCT USB4105-GF-A-120 | node J3 (J4 too until the 74 × 90 re-layout), hub USB-C, data port J1, DATA ×4 J101–J401 | −1.30 mm y | to confirm |
| C265104 JST S5B-PH-SM4-TB | data port J2 until the 8-wire DATA lead | 180°, +0.14 mm y | not on the data port any more |
| C265085 JST B5B-PH-SM4-TB | node J7 until the 8-wire DATA lead | 180°, −0.62 mm y | not on the node any more |
| C265121 JST S8B-PH-SM4-TB | node J7, camera pod J1, data port J2, DATA ×4 J1 | none (fit: −0.03 mm y) | to confirm |
| C16251 USB2514B QFN-36 | DATA ×4 U1 | 270° | to confirm |
| C111738 TPS2553DBVR-1 SOT-23-6 | DATA ×4 U101–U401 | 270° (EasyEDA draws it as C7519, not as C55266) | to confirm |
| C51118 AP2112K-3.3 SOT-23-5 | hub U3, DATA ×4 U3 | 270° | to confirm |
| C181499 TCA6408ARGTR QFN-16 | DATA ×4 U2 U6 | 270° | to confirm |
| C2843876 XL-2835UWC-02 | camera pod D1–D4 | +0.24 mm x | to confirm |
| C41417363 HX PZ2.54-1x6P TP-YQ | camera pod J2 | 270° | to confirm |
| C109471 CH446Q LQFP-44 | DATA ×4 v2 U7 U8 | 270° | to confirm |
| C130008 LSF0108 DHVQFN-20 | DATA ×4 v2 U107–U407 | 270° | to confirm |
| C20615800 H5VU25UC DFN2510-10L | DATA ×4 v2 U4, U105… | 270° (fit by pin name: pin 1 on pin 1, 0.005 mm rms; `test_jlc_cpl.py` checks pin 1) | to confirm |
| C206010 TCA9534A TSSOP-16 | DATA ×4 v2 U10 | 270° | to confirm |
| C9839 TPS60400 SOT-23-5 | DATA ×4 v2 U9 | 180° (not C51118's 270°: another EasyEDA drawing) | to confirm |
| C150716 AP2114H-3.3 SOT-223 | node U2 (since 2026-10-23), DATA ×4 v2 U3, camera pod U1 (since the datasheet audit's F1) | 180°, as C6186 (fit: −0.03 mm x) | to confirm |
| C25725, C48442, C26075 4 × 0402 arrays | DATA ×4 v2 RN… | 90° (four equal resistors: 90° or 270°) | to confirm |
| C347371 MAX809S SOT-23 (UMW) | DATA ×4 v2 U5 | 180°, as the other SOT-23s (not fitted: no EasyEDA data on 2026-10-25) | to confirm |
| C48009678 Vishay IHLP2525CZEK4R7M01 | node L1, hub L1, DATA ×6 L2 L3 (since 2026-11-01) | none (fit on C553961's EasyEDA land, the same part on another reel: centred, pads along x; the EK listing has no footprint) | to confirm |

Checked by the fit and left alone: resistors, capacitors and the PTC (0603,
0805, 1206), the electrolytics (+ pad), the diodes and LEDs (cathode side),
the WS2812B-2020, the FXL0630 inductors (C167219, C167220: one EasyEDA footprint), the TS-1187A buttons and the 3225 crystal (C15643);
for DATA ×4 v2 the RP2350B (C42415655; the RP2354B C39843328 before 2026-11-03), the USB2517I (C478081), the ABM8 crystal
(C20625731) and the AOTA 3.3 µH inductor (C42411119: by pin name on our bench land, pad 1 the dot, on +1V1
since 2026-10-25; JLC's part has its polarity mark at its pad 1 but a silkscreen dot by pad 2: check the dot in
the preview, the v2 audit's U13).  The green
LED C2297 numbers its pads the other way round (pad 2 is the cathode), but
its cathode sits where KiCad's pad 1 is at 0°: don't "fix" it from the pad
numbers.

To confirm a part, upload the Gerber zip, BOM and CPL at jlcpcb.com, and in
the "Component Placement" step look at it in JLC's 2D and 3D preview:

1. The body sits over its pads, centred (a shift of half a pin pitch means
   an origin offset is wrong).
2. Pin 1, the cathode bar or the + side lines up with the board's silkscreen
   mark.
3. Side-entry connectors (SH, USB-C) open towards the board edge.

If a part is off, rotate or move it in JLC's editor until it fits, then copy
that change into `JLC_CPL_FIX` (add the extra degrees; an offset measured on
the board has to be turned back into the footprint's axes) and re-export with
`tools/kicad.sh <board> --check --fab`, so the next order needs no hand
correction.  Mark the row confirmed here once a preview shows it right.  A new
LCSC part needs the same check: until it is in the table it is placed exactly
as KiCad has it.

## Custom library

`electronics/lib/bench.kicad_sym` holds the symbols the stock library
lacks: TPS2553DBV, LMR51635 (the LMR51625's too, same pinout; KiCad's LMR51430 has another), and for
DATA ×4 v2 the CH446Q and the USB2517I (generated by
`electronics/tools/symbols.py`, pin names as in their datasheets).  The
footprints and 3D models come from KiCad 10's standard libraries, the few
variants in `electronics/lib/bench.pretty` from stock ones
(`electronics/tools/footprints.py`).

## Future: chip-down ESP32-S3 (v2)

Every ESP32-S3 *module* (MINI-1, MINI-1U, WROOM-1, all memory variants) is
Standard-PCBA-only at JLC, which is what keeps the bay node off Economic
PCBA.  The bare **ESP32-S3FH4R2** (C3013940, ≈ $3.67, QFN-56 7 × 7 mm, 4 MB
flash + 2 MB PSRAM in package) is Economic-capable and is the same SoC, so the
Zephyr firmware (Wi-Fi, `uhc_dwc2` USB host) carries over unchanged.

* Saves ≈ $35–45 per 16-node order: about $1 per chip, plus Economic instead
  of Standard setup and stencil fees, and no added edge rails.  That is ≈ €2.5
  per node, more for larger runs.
* Costs: 40 MHz crystal, antenna (PCB trace or ceramic chip) with a matching
  network to tune on a VNA, extra decoupling, and the loss of the module's
  radio certification.  4 MB flash is enough for the USB/IP firmware with
  dual-slot updates.
* Not worth the RF risk at 16 nodes; worth revisiting for ≥ 50.

Alternatives considered:
* ESP32-S2FN4R2: cheaper, Economic, Zephyr Wi-Fi, but `uhc_dwc2` is not yet
  validated on the S2.
* ESP32-C3/C5/C6: no USB OTG, so no USB host.
* nRF54LM20 + nRF7002, or ESP32-P4 + C6: USB host supported, but two chips and
  more cost.
* NXP RW612: good Zephyr support, but no module stocked at LCSC.
