kartben/hw-testing-rack/docs/architecture.md

# Architecture

hw-testing-rack is a desk-sized, tilted ("stadium") rack, printed end to end,
that holds 12 development boards in its default 4 × 3 layout (more by adding
columns or rows) and makes every one of them reachable over the network
**and** pluggable by hand:

* each bay has its own **bay node** — an ESP32-S3 that switches the board's
  5 V, measures its current, and exposes its USB port over **USB/IP**
  (Zephyr's `usbip` host service);
* each bay is a **drawer** that slides out 140 mm along the slope while the
  board stays powered and connected (a drag chain hidden under the floor
  carries the cable), or, per bay and on the same tray, a **sled** without a
  chain (unplug, then pull; its DATA port stays behind) or the same sled
  screwed **fixed**;
* boards are screwed onto **form-factor plates** that drop into any drawer;
* one **USB-C PD charger** powers the rack through a **power box** under the
  first column: the hub negotiates 20 or 28 V, an eFuse per row, and the rack
  controller (CAN master), see [power.md](power.md) and [can.md](can.md);
* optional **camera pods** look down into selected bays.

One bay, exploded: tray with the bay node and drag chain, drawer, board plate, board, camera pod

*One bay (B2), bottom to top: the tray with the bay-node PCB and the drag chain, the drawer with its DATA board, the board plate, the board, and the camera pod (an Arducam Mega and the pod board with its light) hanging from the ceiling above.*

## Rows, bays and columns

The structure is the **panel frame** (config: `frame:` and `rows:` in
[`config/rack.yaml`](../config/rack.yaml)): printed side walls ("ladders")
stand between the columns and are shared by neighbouring bays, one ladder per
row, stacked on base ladders and topped by cap strips; each bay's **tray**
slides into the grooves of its two ladders; an X **brace** behind every bay and
row keeps the grid square.  Rows are tilted 20° by default and stacked
`rows[].height` apart; the column pitch is 165.8 mm.  The default build is
three rows of four bays: rows A and B of plate bays, and on top row C, 120 mm high, of dense bays whose
boards stand on edge in a slotted bin, six to a bay (`population › plate: slots`, `drawer.slot_bin`).  A
fourth row is one more `rows` entry; the power hub has four row outputs.

Changing the config regenerates everything that depends on it: the OpenSCAD
constants, the web scene, the BOM and the PCB outlines/connector positions.

## One bay, top to bottom

```
            ┌───────── ceiling: tray of the row above, or the cap plate (camera pod inserts) ─────────┐
            │                                                                                         │
 drawer ──▶ │  [front panel + label]  board on its plate  ⟵ short USB ⟶ [DATA port] [rear bay]       │
 ledges ──▶ ├──── C-channel lips ────────────────────────────────────────────────── magnet detent ──┤
 plenum ──▶ │  [bay node PCB]  ─ext cable→ [chain fixed end] ⊂═══ drag chain U ═══⊃ [foot]          │
 fascia ──▶ │  PC USB-C · status LED · SERVICE switch                                                 │
            └──────── tray: runners in the grooves of the ladders on both sides (tilted) ────────────┘
```

* **Tray** (printed): slides into the ladders' grooves and clicks in; forms
  the 23 mm *plenum* that hides the bay node and the drag chain; its front
  wall is the fascia, its bottom the ceiling of the bay below; two side
  ledges under C-channel lips carry the drawer, the left one the
  closed-position magnet.
* **Drawer** (printed): front panel with label recess and finger pull, plate
  pocket, rear bay with the DATA port (our small board screwed to the floor,
  its USB-C behind a U in the port wall, the 8-wire PH lead from the node
  plugged into its rear) and the cable window; a
  foot under the rear carries the chain's moving end.
* **Plate** (printed, per board form factor): heat-set-insert or snap-pin
  standoffs at the board's holes, or corner fences for hole-less boards.

See [mechanical.md](mechanical.md) and [cabling.md](cabling.md).

## Data paths and modes

```mermaid
flowchart LR
  subgraph Node["Bay node (ESP32-S3)"]
    ESP["ESP32-S3<br/>USB OTG (FS) / USB-Serial-JTAG"]
    MUXD["MUX_DUT<br/>FSUSB42"]
    MUXP["MUX_PC<br/>FSUSB42"]
    OR["OR gate"]
    SW["TPS26600<br/>eFuse on VIN"]
    INA["INA226"]
  end
  DUT["Board under test"] -- "USB data" --> MUXD
  MUXD -- "HSD1 (USB/IP mode)" --> ESP
  MUXD -- "HSD2 (classic)" --> MUXP
  PC["Laptop on the<br/>front PC port"] --> MUXP
  MUXP -- "HSD2 (SERVICE)" --> ESP
  SW -- "20–28 V ≤1.8 A" --> INA -- "DATA board: its own 5 V" --> DUT
  PC -. "VBUS sensed only" .-> OR --> MUXD
  ESP -. "MUX_FORCE_PC" .-> OR
  ESP -. "Wi-Fi: USB/IP, REST, mDNS" .-> LAN(("LAN"))
```

| SERVICE switch | Laptop on PC port | DUT data goes to | Use |
|---|---|---|---|
| off | no | ESP32-S3 USB OTG → **USB/IP** over Wi-Fi | default, remote |
| off | yes | the laptop (**classic mode**) — automatic, even with no firmware | debugging on the bench |
| on | any | disconnected; laptop ↔ ESP32 USB-Serial-JTAG | flash / debug the node itself |

Firmware can also force classic mode (`MUX_FORCE_PC`).  In every mode the
node keeps control of the board's power (switch it off/on, read V/I) and of
the AUX lines (UART, open-drain RESET/BOOT).

**Speed.** The ESP32-S3 has one internal full-speed PHY: through USB/IP every
board enumerates at 12 Mbit/s.  That is plenty for CMSIS-DAP/J-Link/ST-LINK
probes, UARTs and DFU; mass-storage drag-and-drop of large images is slower.
Classic mode is a plain analog path (the FSUSB42 is a 480 Mbit/s switch), so a
laptop gets full high-speed.

## Power

A USB PD charger (100 W at 20 V by default, 140 W EPR at 28 V as an option; a 5 A e-marked
cable) → the power hub in the power box under A1 (CH224A sink: 20 V, or 28 V EPR on the
controller's request when offered; TVS, no input switch, one 1.6 A TPS26600 eFuse per row, off until the
contract is final) → one 6-pin JST PH feed per row (VRACK, CAN, POS) →
daisy-chained bay to bay through the ladders → each bay node's own 60 V LMR51625
buck to 5 V.  Details and alternatives (a 24 V brick, internal mains supply,
PoE++) are in [power.md](power.md); the rack bus is in [can.md](can.md).

## Radio: the nodes' antennas and the rack's Wi-Fi

Each node's ESP32-S3-WROOM-1 has its PCB antenna on the node's rear edge, in the tray under the
drawer, flat and pointing to the back of the bay.  On the node, its keep-out holds on every layer
(the rear 6 mm, ±24 mm).  What is around it, in a closed bay (review of 2026-10-21):

| What | From the antenna | Note |
|---|---|---|
| The drawer floor, the plate | 12.5 / 15–20 mm above | PETG |
| The DUT boards | 25–32 mm above.  In 6 of 8 bays within 4 mm sideways, in 2 straight over it | the closest copper, and often a radio of its own (nRF DK, GIGA R1, UNO R4 WiFi) |
| The camera lead (camera bays) | 30 mm beside its right end, routed as in [cabling.md](cabling.md) | 18 mm if run straight back from J6 |
| The DATA lead | 50 mm (J7), 55 mm (the chain's fixed end) | USB 2.0 high speed on a twisted pair |
| The DATA ×4 v2 | 117 mm to its hub's 24 MHz crystal, 126 mm to the USB2517I; behind and 60–70 mm above | USB 2.0 only.  Its PLL's 5th harmonic is at 2.400 GHz, just under channel 1 |
| The next node | ≈ 166 mm sideways, ≈ 165 mm up or down | |

So, for the rack's Wi-Fi:
- **Use one channel** for the nodes and the Wi-Fi DUTs, 6 or 11 (not 1), at 20 MHz (set the AP's
  2.4 GHz radio to 20 MHz).  Nodes 17 cm apart on neighbouring channels block each other; on one
  channel they take turns.
- **Cap the nodes' transmit power at ≈ 10 dBm** when the AP is a few metres away.  That still leaves
  30 dB or more of margin, and puts 10 dB less into the DUTs' radios 3 cm above.
- **Put the AP 1–3 m away, behind or beside the rack, at mid-height**, not on top of it.  A node
  looks out through the back and the sides of its bay; above it are its drawer and its DUT.
- **Keep big DUT boards off the plate's left-rear part** when the pegs allow: 70–100 mm from the
  plate's front edge, its left 50 mm.  That is right over the antenna.

## Software

Each node runs Zephyr: `uhc_dwc2` (ESP32-S3 OTG in host mode) + the
`usbip` host service + Wi-Fi + a small REST/shell API for power, AUX and
telemetry, mDNS-advertised as `bay-<id>.local`, its services over DNS-SD.  See [firmware.md](firmware.md).

```console
$ usbip list -r bay-b3.local
$ sudo usbip attach -r bay-b3.local -b 1-1     # the Pico in B3 is now a local USB device
```
