kartben/hw-testing-rack/docs/coproc-firmware-research.md

# DATA ×4 v2 co-processor: the firmware question (research)

**Status (2026-10-19): research and a build-only spike, nothing designed.**  **2026-11-03:** U11 is an
RP2350B (NextPCB had no RP2354B): no flash, so it comes up in the USB bootloader at each power-up and runs a
RAM image loaded into its SRAM (`picotool load -x` from the lab server over USB/IP, later the node over
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
