kartben/hw-testing-rack/docs/img/data-x4-v2-layout-ac.jpg

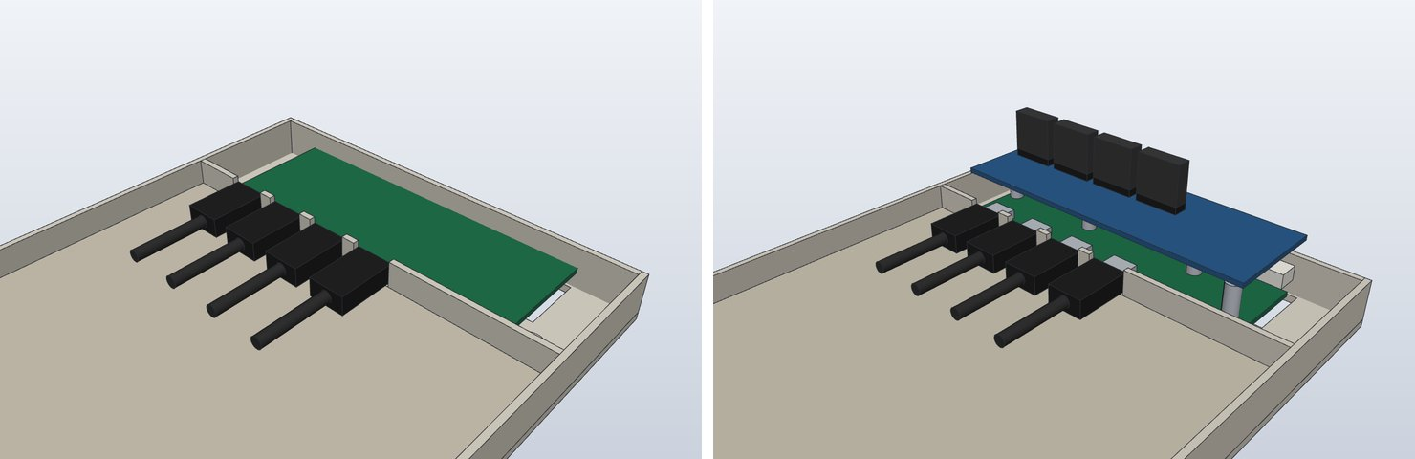
docs/img/data-x4-v2-layout-ac.jpg
