kartben/hw-testing-rack/docs/img/data-x4-v2-vertical-side.jpg

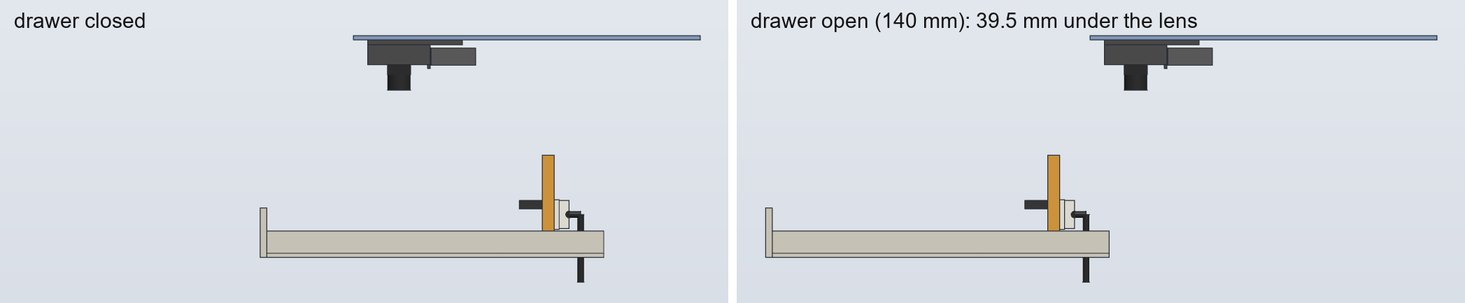
docs/img/data-x4-v2-vertical-side.jpg
