kartben/hw-testing-rack/docs/img/hero.jpg

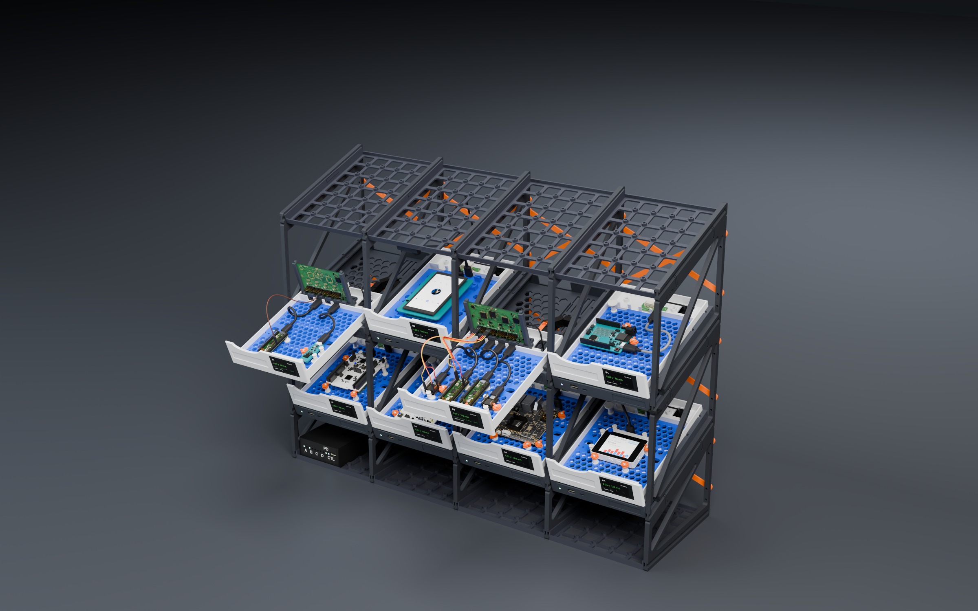
docs/img/hero.jpg
