kartben/hw-testing-rack/docs/img/hub-100mm-options.png

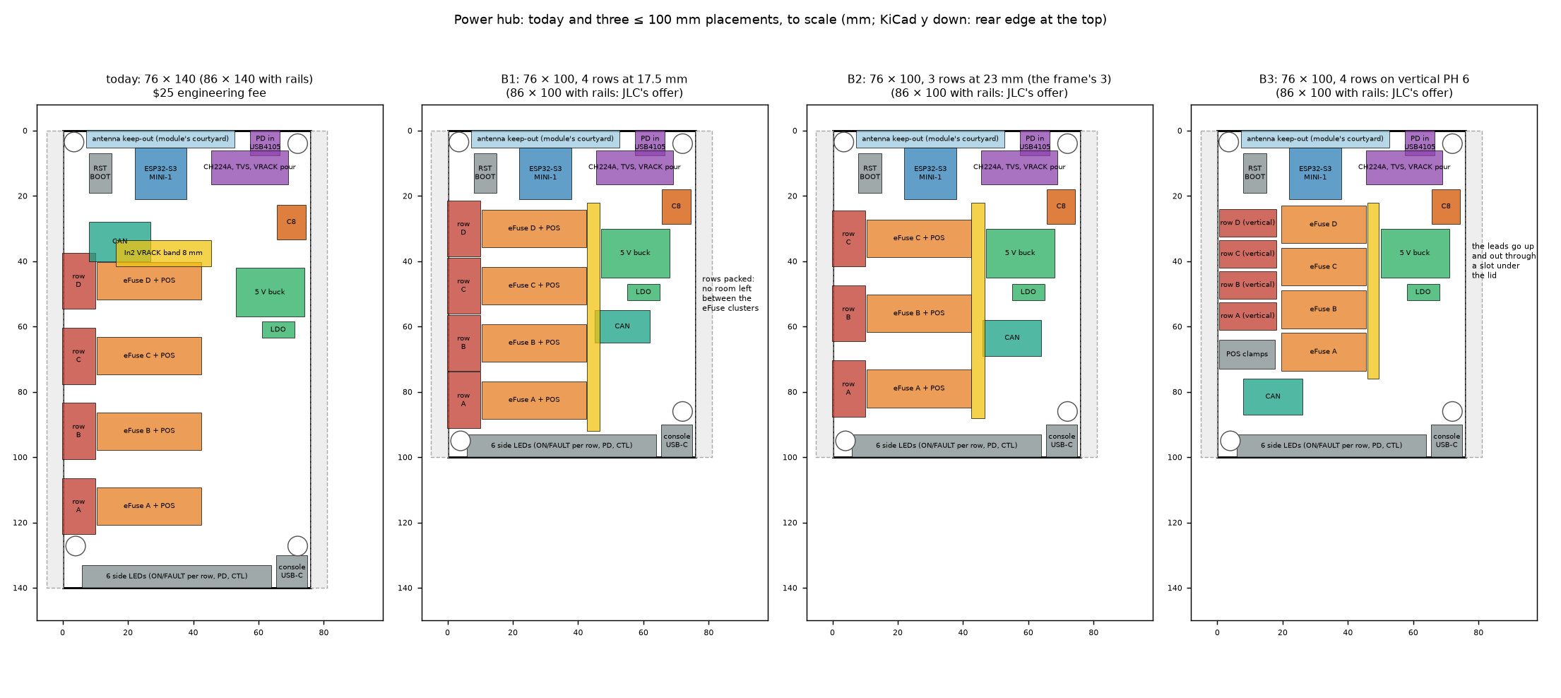
docs/img/hub-100mm-options.png
