kartben/hw-testing-rack/docs/img/row-currents.png

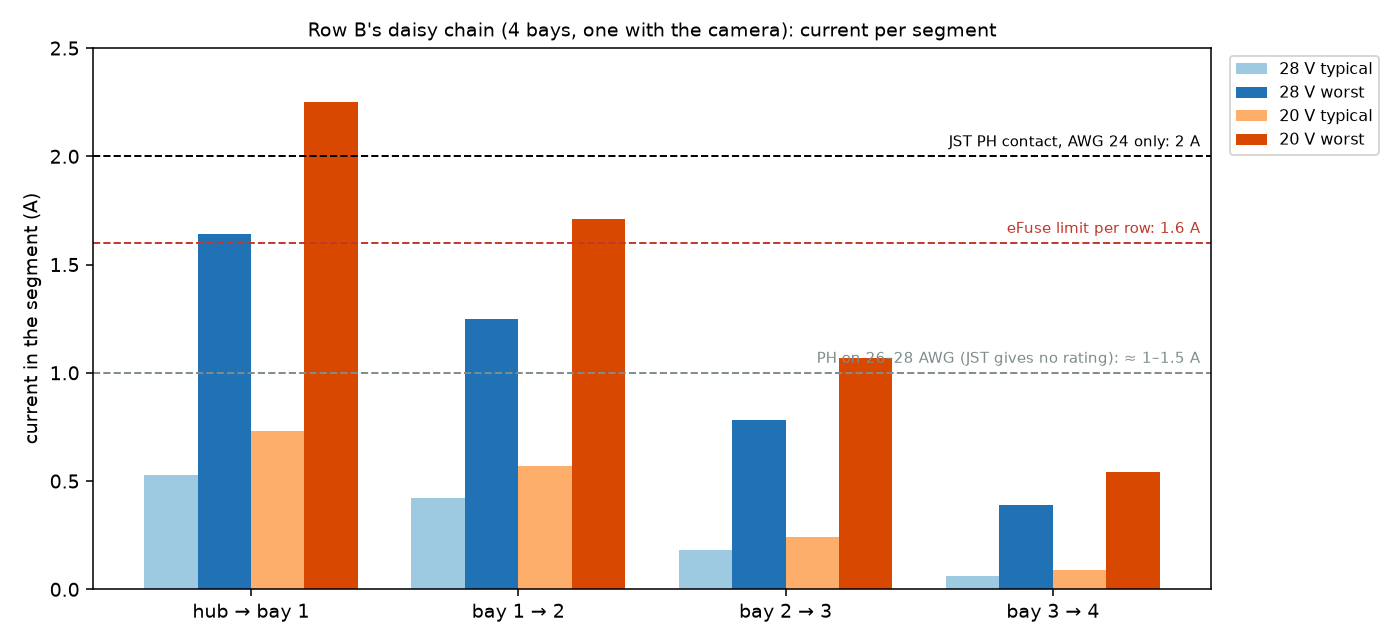
docs/img/row-currents.png
