kartben/hw-testing-rack/docs/img/web-ui-console.png

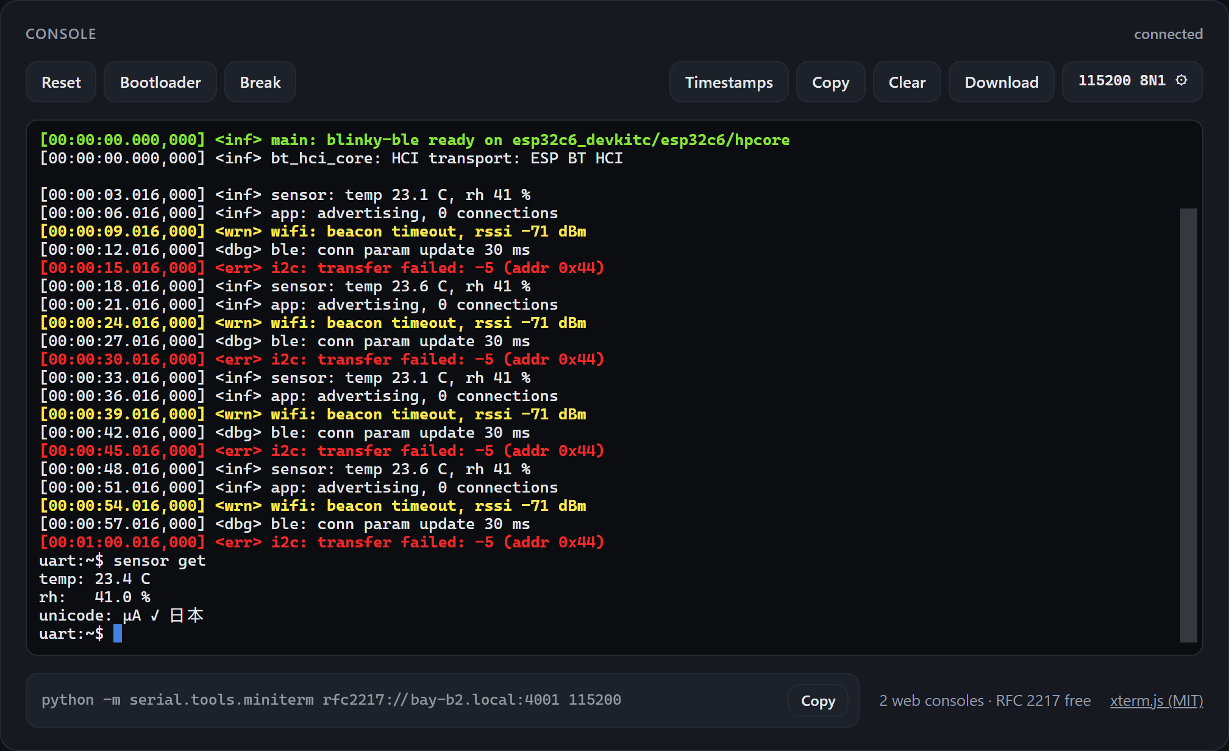
docs/img/web-ui-console.png
