kartben/hw-testing-rack/electronics/bay-node/docs/bay-node-bottom.jpg

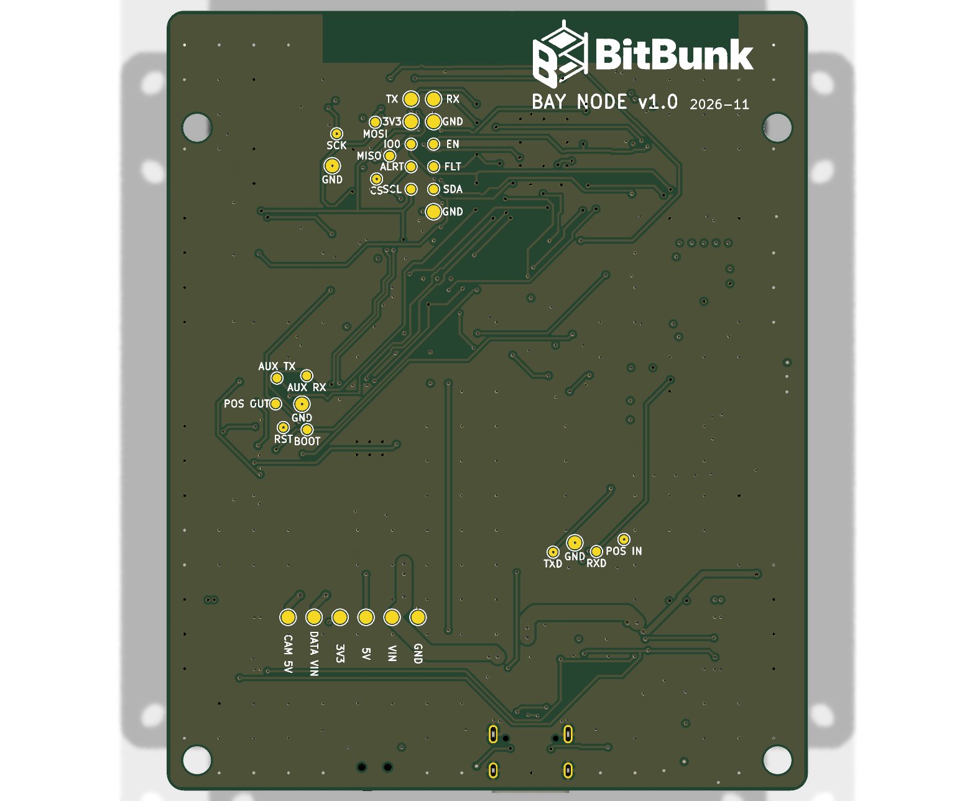
electronics/bay-node/docs/bay-node-bottom.jpg
