kartben/hw-testing-rack/electronics/bay-node/docs/bay-node-top.jpg

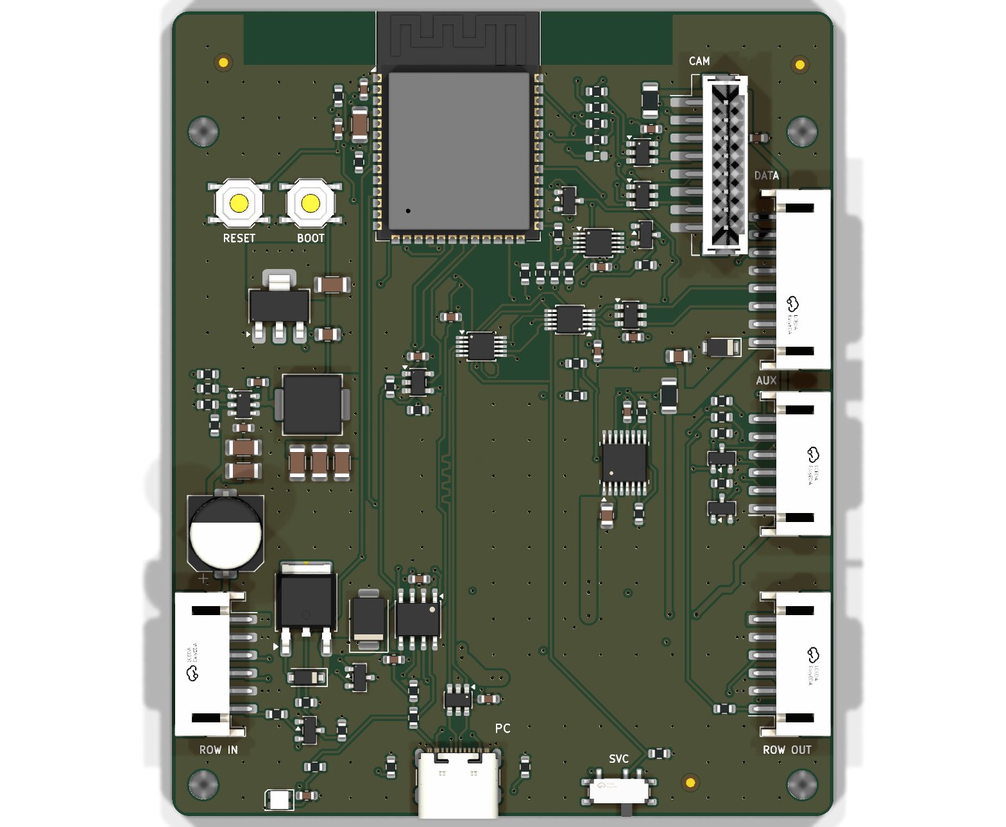
electronics/bay-node/docs/bay-node-top.jpg
