kartben/hw-testing-rack/electronics/camera-pod/docs/camera-pod-bottom.jpg

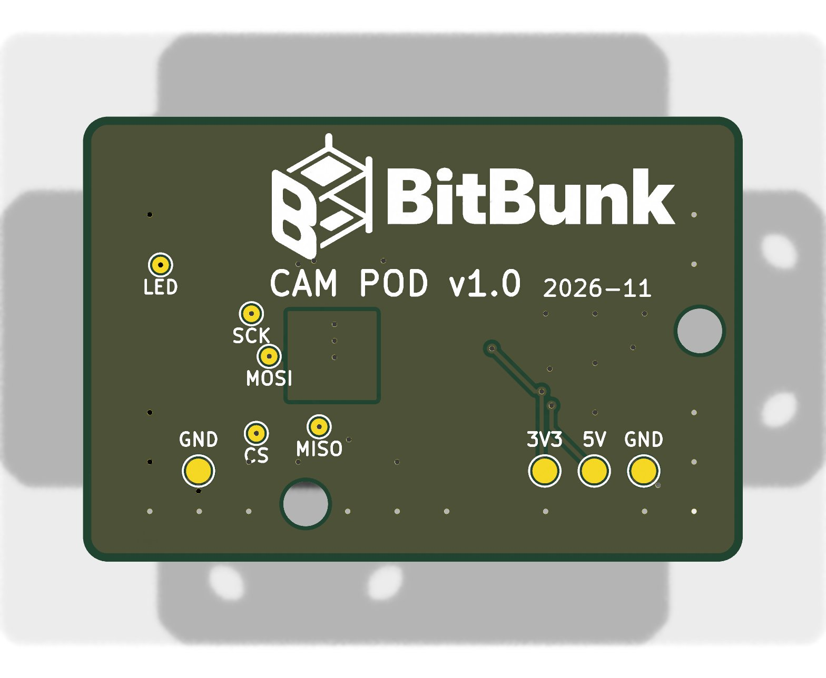
electronics/camera-pod/docs/camera-pod-bottom.jpg
