kartben/hw-testing-rack/electronics/camera-pod/docs/camera-pod-iso.jpg

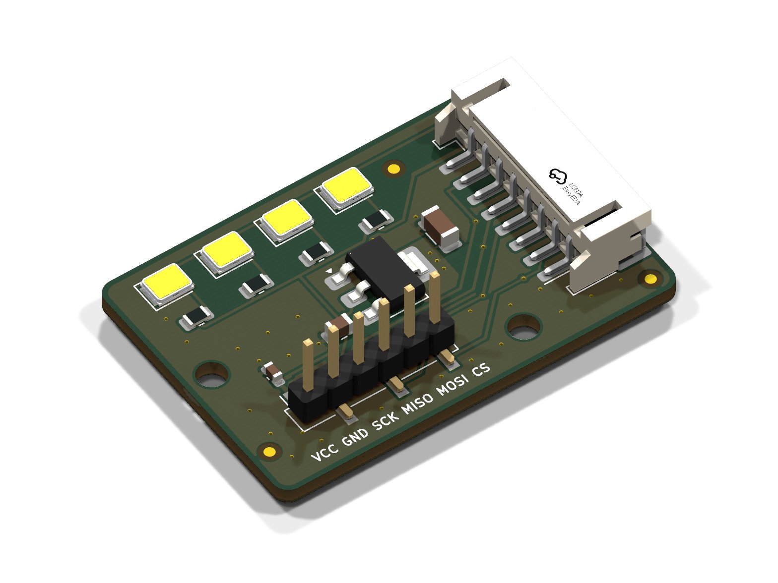
electronics/camera-pod/docs/camera-pod-iso.jpg
