kartben/hw-testing-rack/electronics/camera-pod/docs/camera-pod-top.jpg

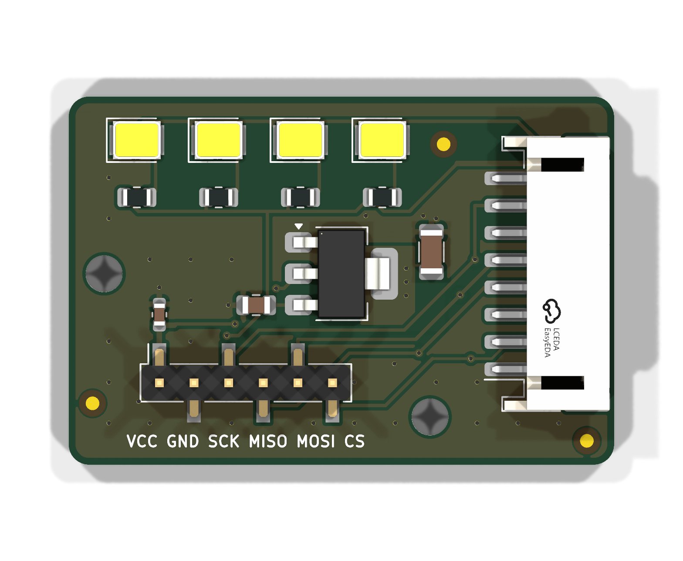
electronics/camera-pod/docs/camera-pod-top.jpg
