kartben/hw-testing-rack/electronics/data-port-x4/docs/data-port-x4-bottom.jpg

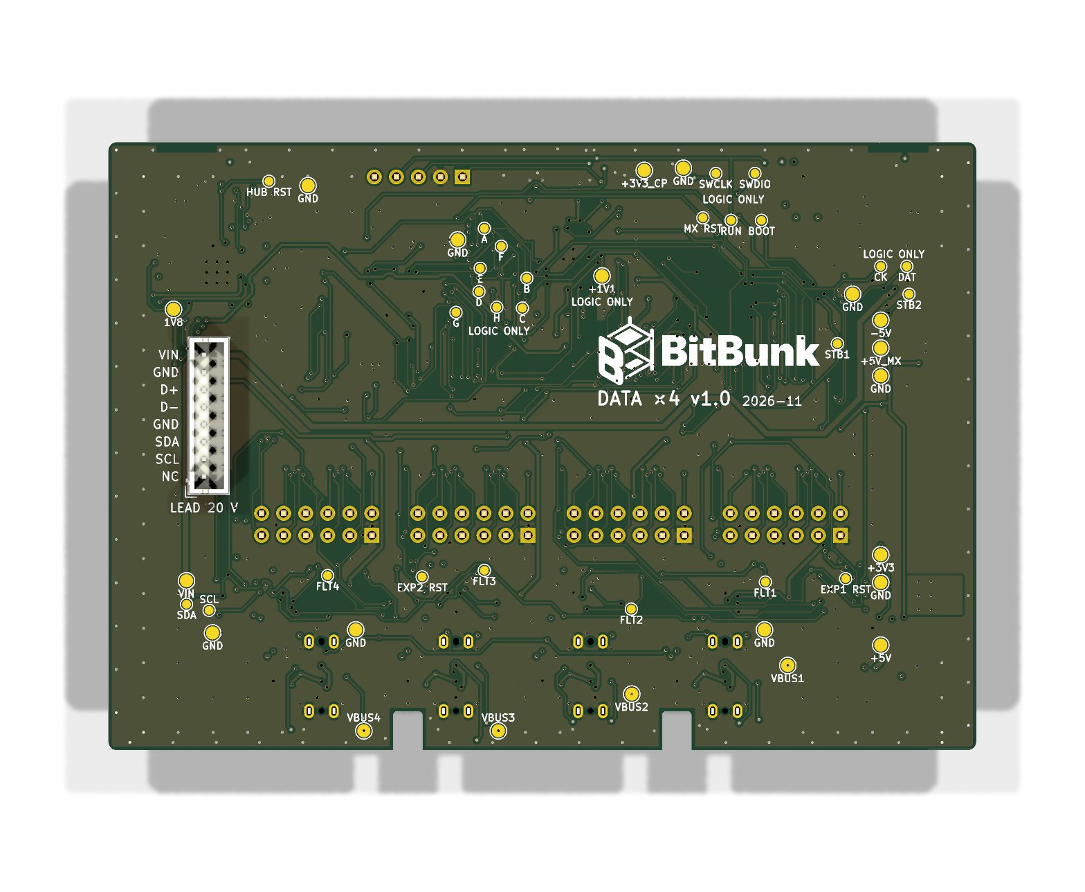
electronics/data-port-x4/docs/data-port-x4-bottom.jpg
