kartben/hw-testing-rack/electronics/data-port-x4/docs/data-port-x4-panel-top.jpg

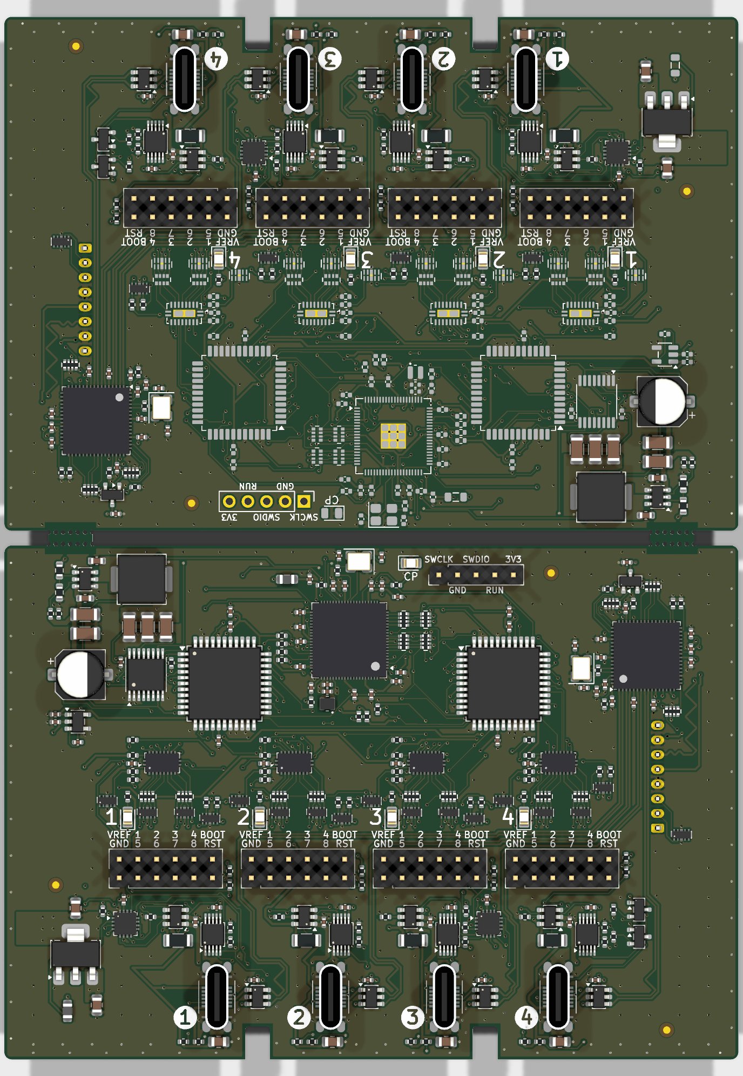
electronics/data-port-x4/docs/data-port-x4-panel-top.jpg
