kartben/hw-testing-rack/electronics/data-port-x6/docs/data-port-x6-bottom.jpg

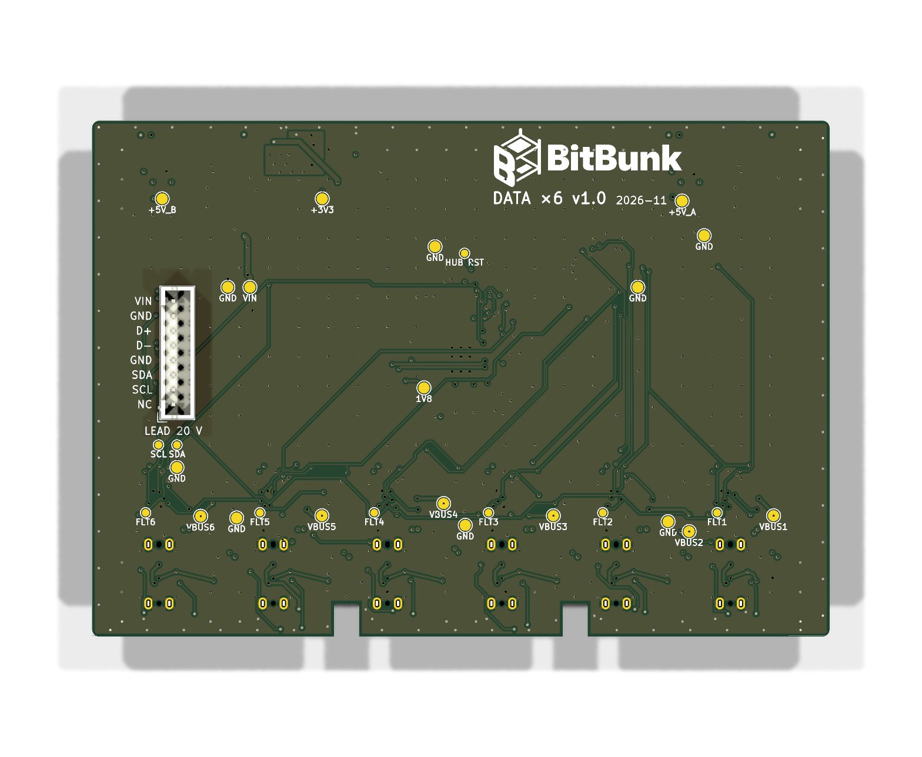
electronics/data-port-x6/docs/data-port-x6-bottom.jpg
