kartben/hw-testing-rack/electronics/data-port/docs/data-port-bottom.jpg

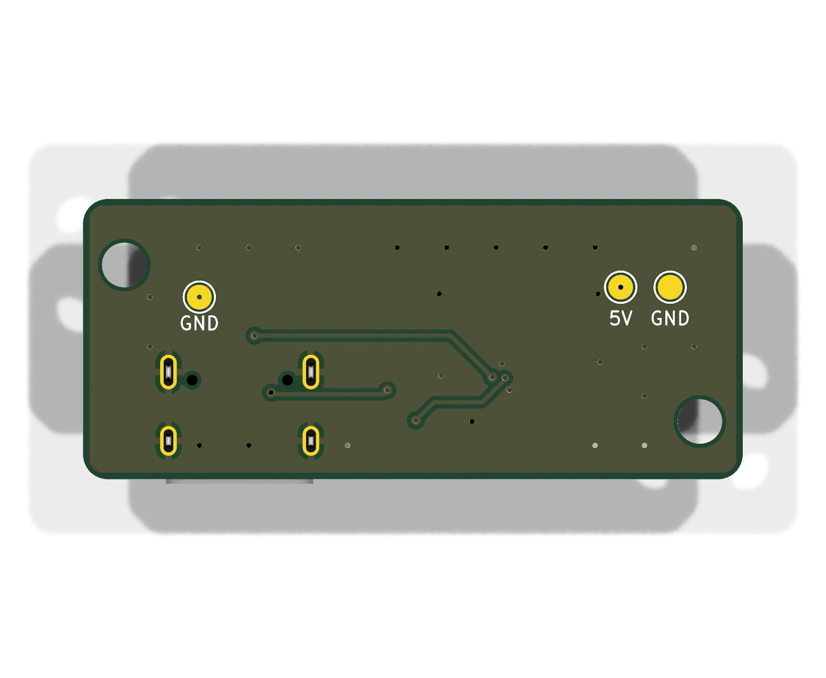
electronics/data-port/docs/data-port-bottom.jpg
