kartben/hw-testing-rack/electronics/data-port/docs/data-port-iso.jpg

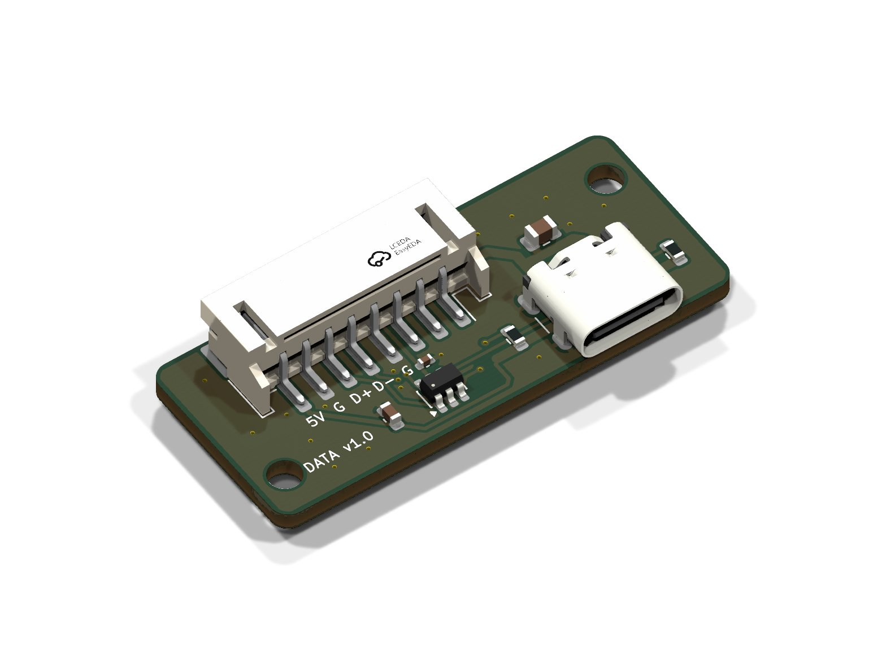
electronics/data-port/docs/data-port-iso.jpg
