kartben/hw-testing-rack/electronics/data-port/docs/data-port-top.jpg

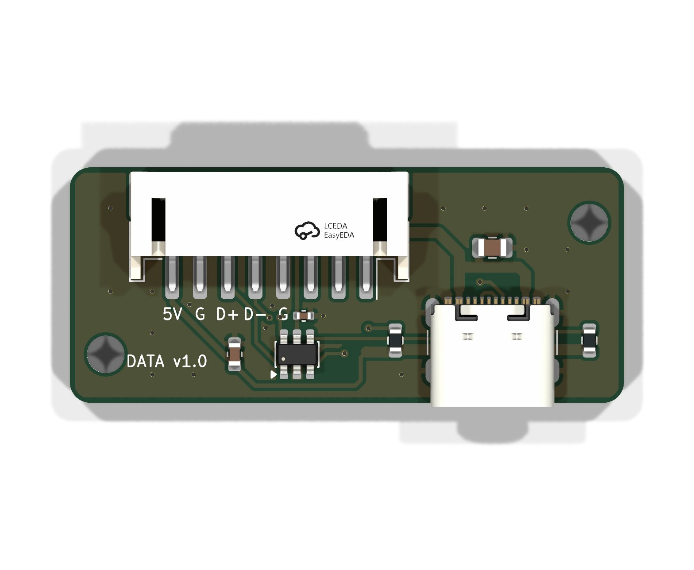
electronics/data-port/docs/data-port-top.jpg
