kartben/hw-testing-rack/electronics/power-hub/docs/power-hub-bottom.jpg

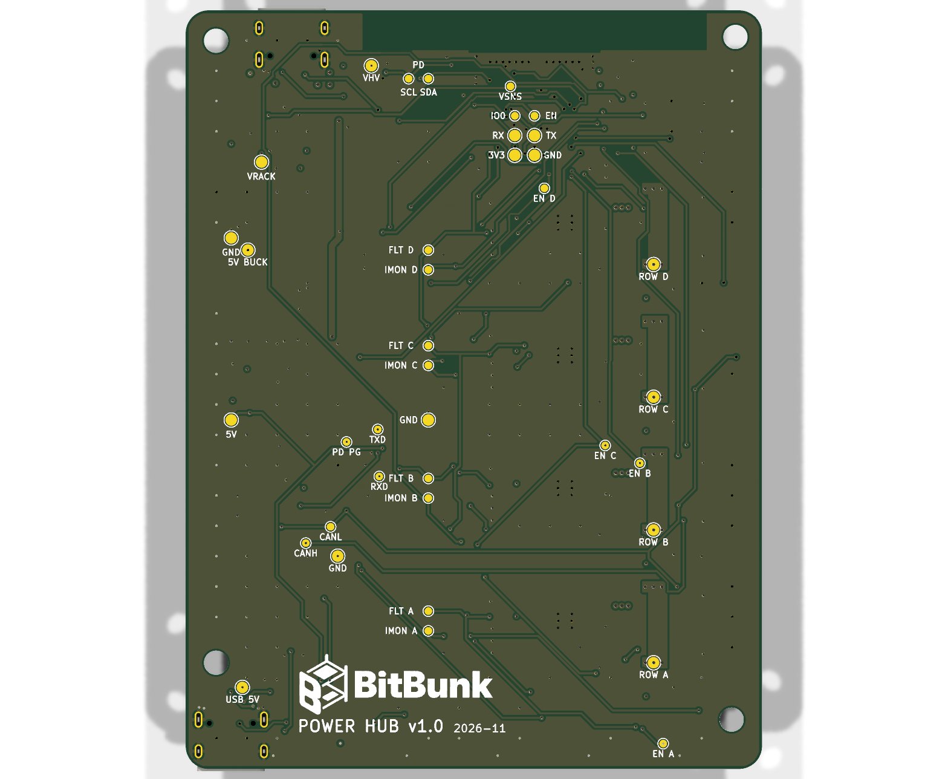
electronics/power-hub/docs/power-hub-bottom.jpg
