kartben/hw-testing-rack/electronics/power-hub/docs/power-hub-iso.jpg

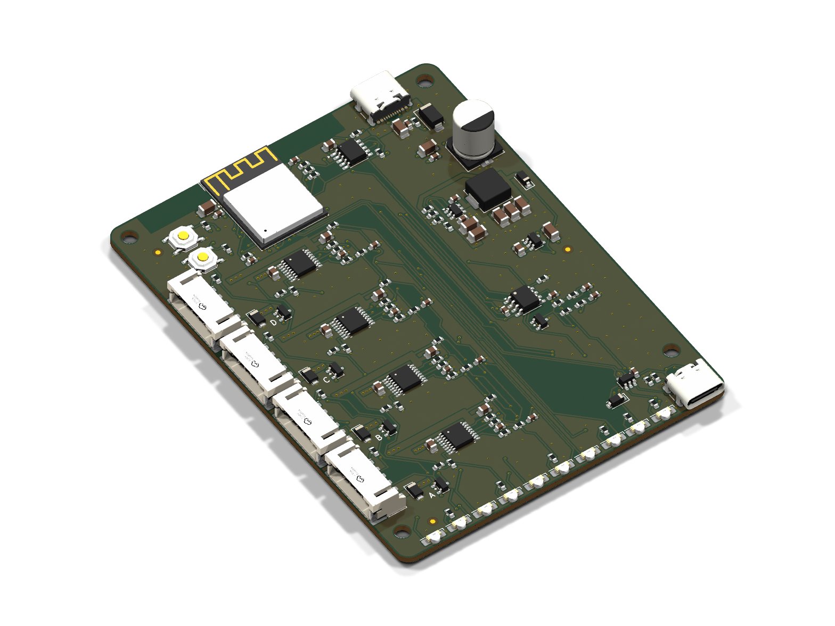
electronics/power-hub/docs/power-hub-iso.jpg
