kartben/hw-testing-rack/electronics/power-hub/docs/power-hub-top.jpg

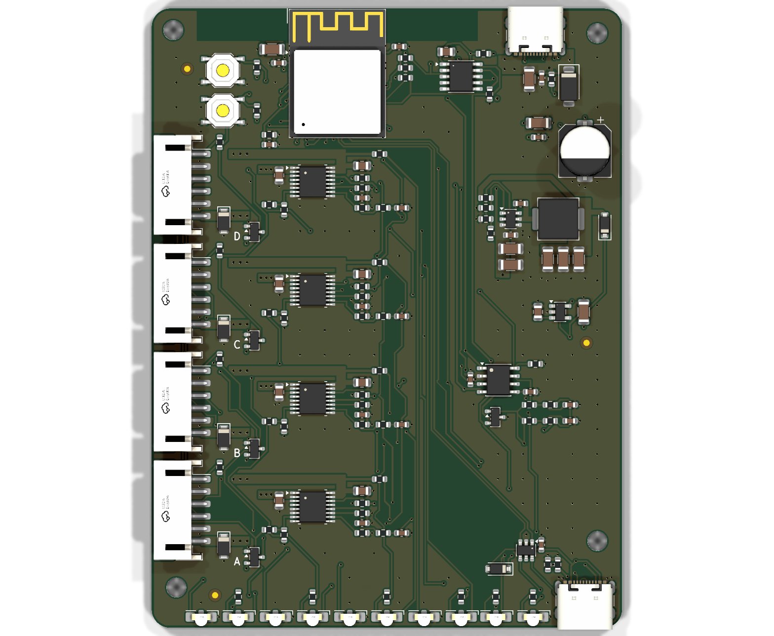
electronics/power-hub/docs/power-hub-top.jpg
