kartben/hw-testing-rack/firmware/bay-node/web/camera/b2-640x480-off-0.jpg

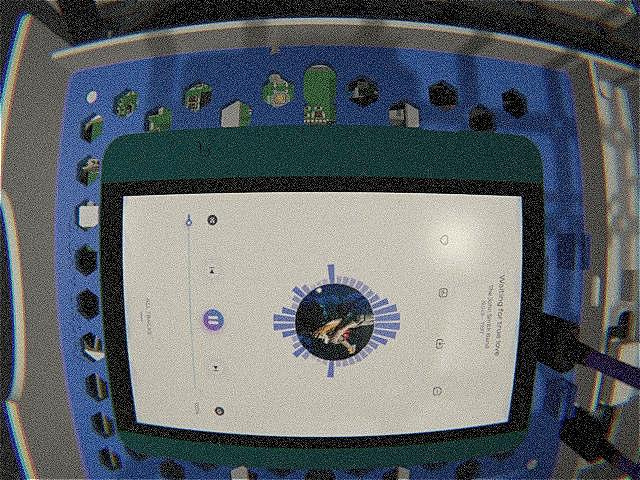
firmware/bay-node/web/camera/b2-640x480-off-0.jpg
