kartben/hw-testing-rack/mechanical/review/pairs/anchor_boss_proposed.png

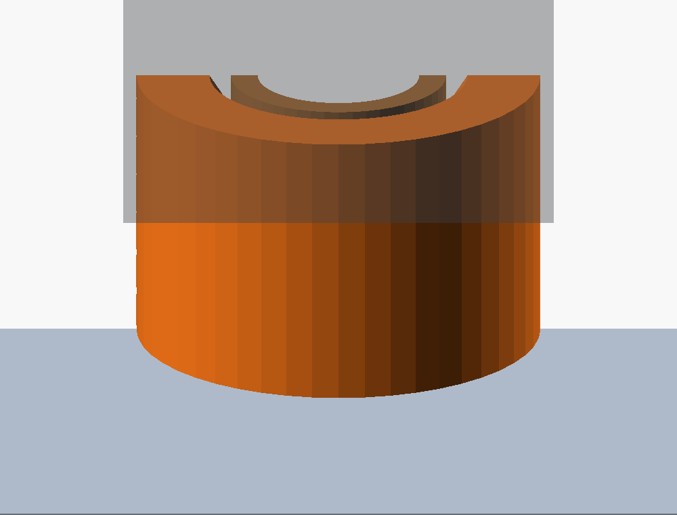
mechanical/review/pairs/anchor_boss_proposed.png
