kartben/hw-testing-rack/mechanical/review/pairs/anchor_boss_today.png

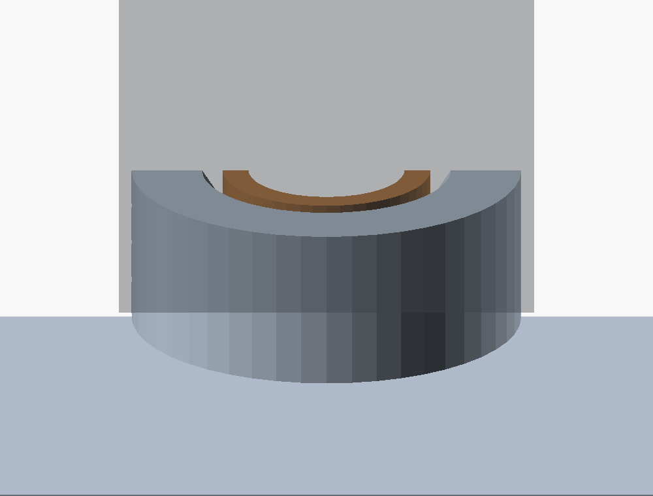
mechanical/review/pairs/anchor_boss_today.png
