kartben/hw-testing-rack/mechanical/review/pairs/cam_pin_proposed.png

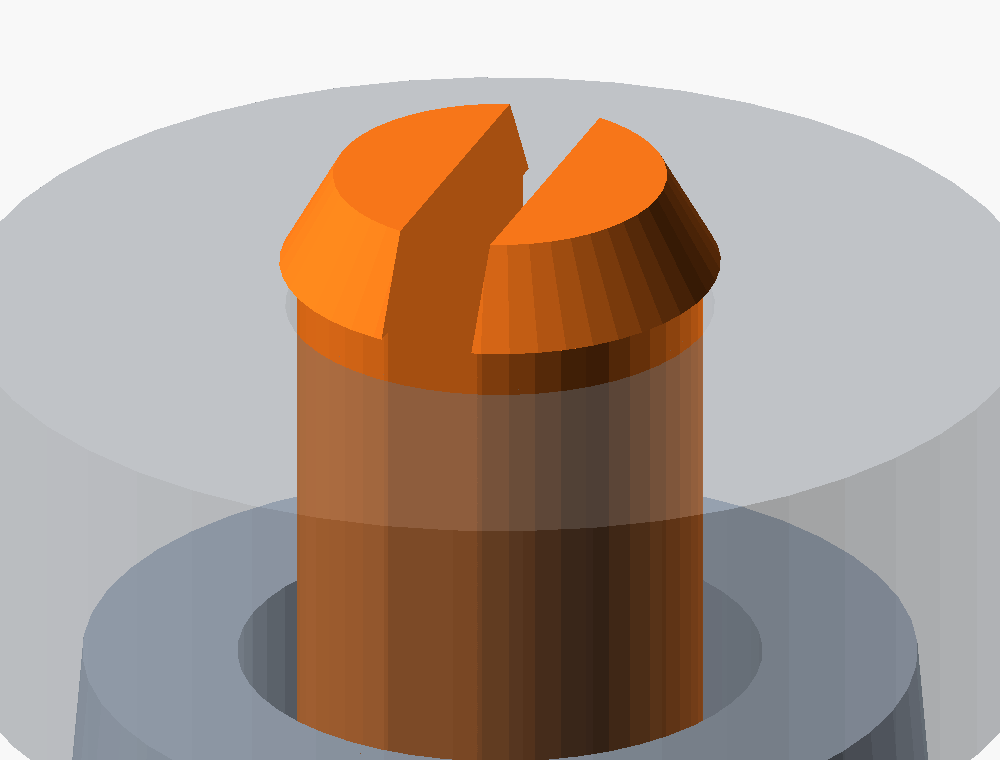
mechanical/review/pairs/cam_pin_proposed.png
