kartben/hw-testing-rack/mechanical/review/pairs/cradle_finger_proposed.png

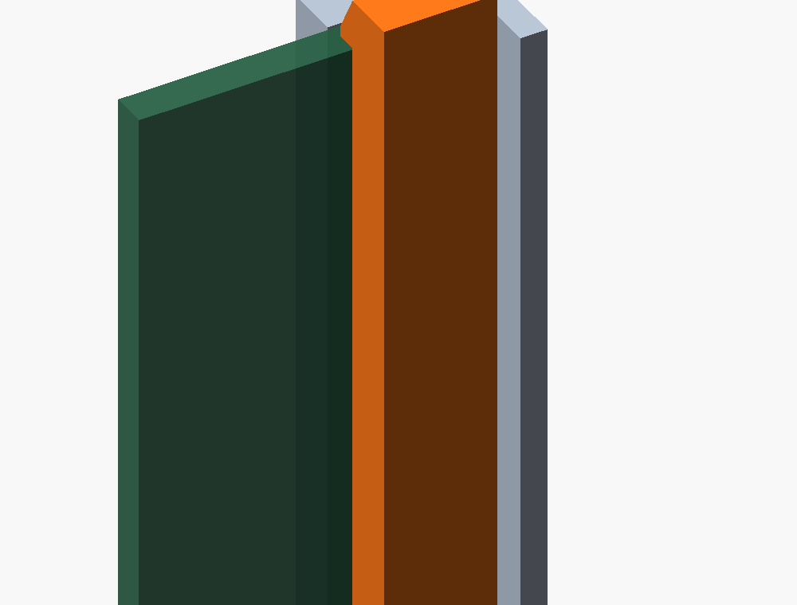
mechanical/review/pairs/cradle_finger_proposed.png
