kartben/hw-testing-rack/mechanical/review/pairs/cradle_finger_today.png

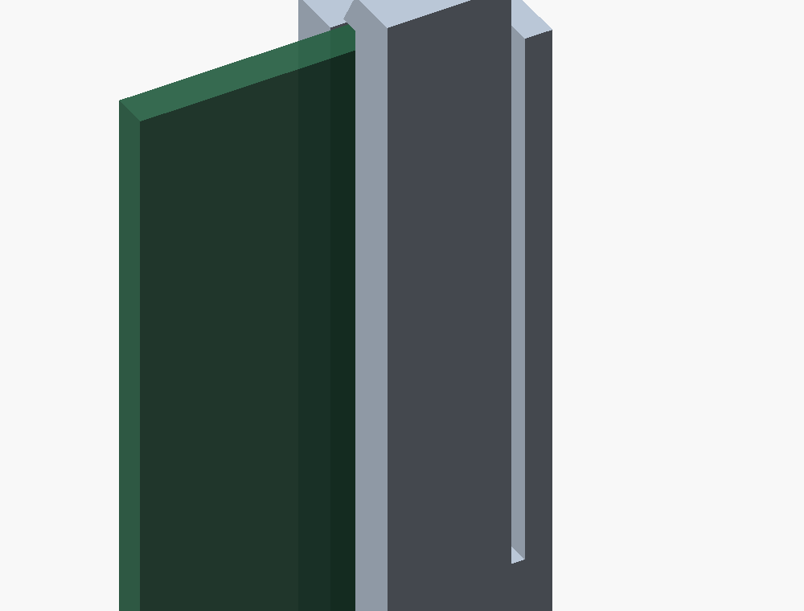
mechanical/review/pairs/cradle_finger_today.png
