kartben/hw-testing-rack/mechanical/review/pairs/detent_proposed.png

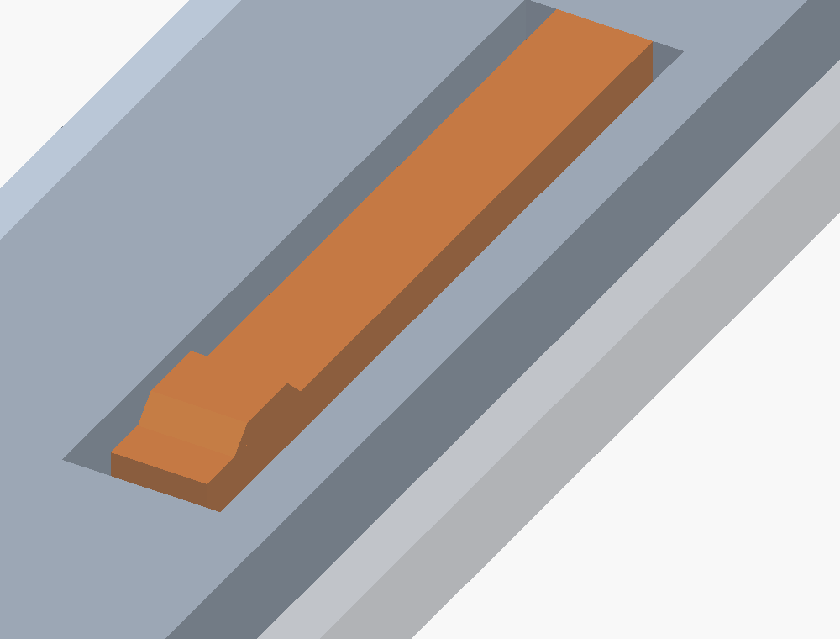
mechanical/review/pairs/detent_proposed.png
