kartben/hw-testing-rack/mechanical/review/pairs/detent_today.png

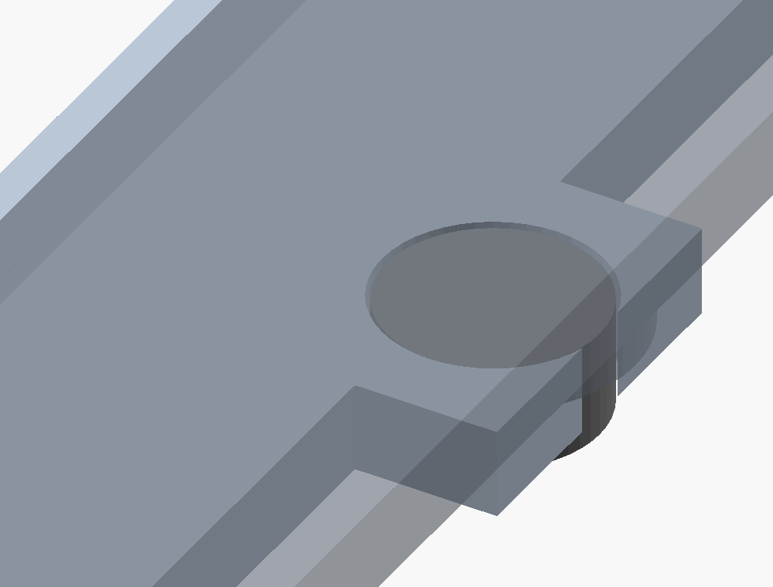
mechanical/review/pairs/detent_today.png
