kartben/hw-testing-rack/mechanical/review/pairs/ladder_hook_proposed.png

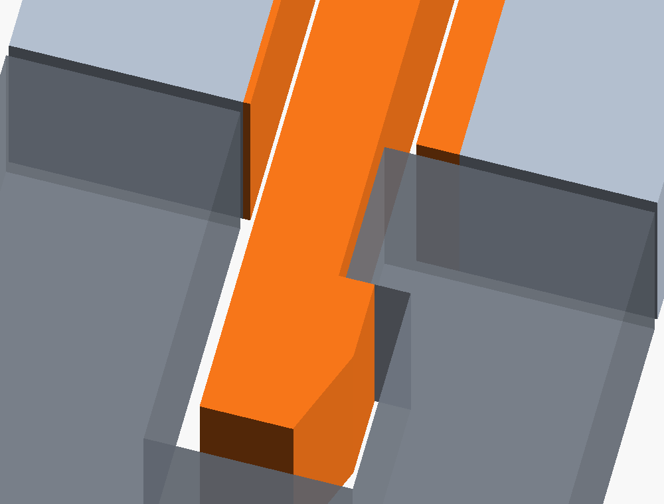
mechanical/review/pairs/ladder_hook_proposed.png
