kartben/hw-testing-rack/mechanical/review/pairs/ladder_hook_today.png

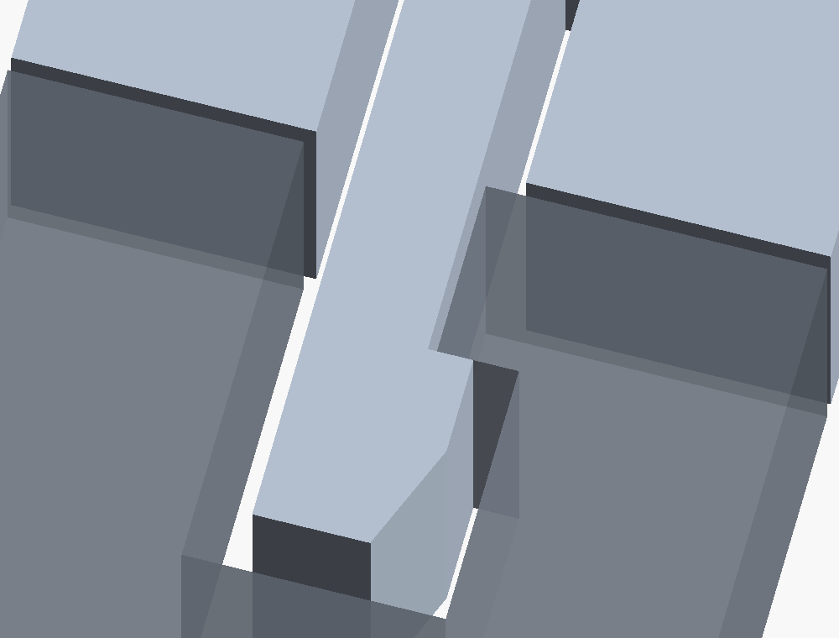
mechanical/review/pairs/ladder_hook_today.png
