kartben/hw-testing-rack/mechanical/review/pairs/ladder_nut_trap_proposed.png

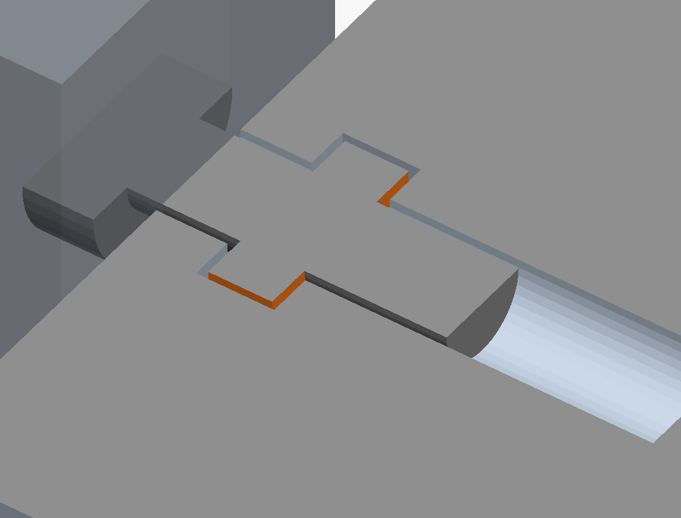
mechanical/review/pairs/ladder_nut_trap_proposed.png
