kartben/hw-testing-rack/mechanical/review/pairs/ladder_nut_trap_today.png

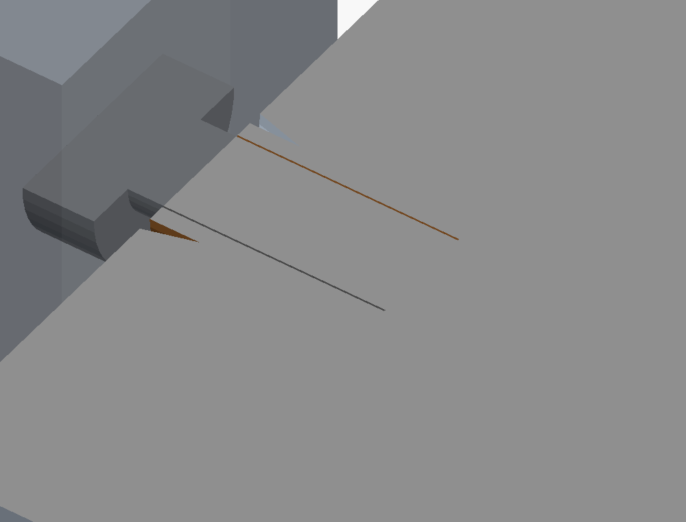
mechanical/review/pairs/ladder_nut_trap_today.png
