kartben/hw-testing-rack/mechanical/review/pairs/latch_arm_proposed.png

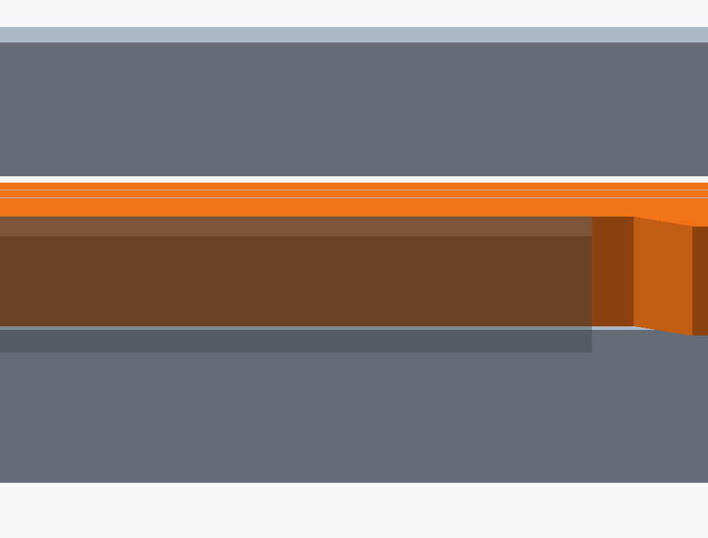
mechanical/review/pairs/latch_arm_proposed.png
