kartben/hw-testing-rack/mechanical/review/pairs/latch_arm_today.png

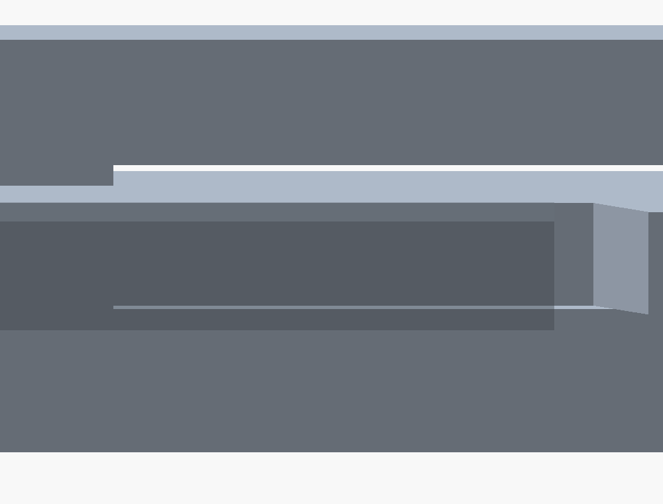
mechanical/review/pairs/latch_arm_today.png
