kartben/hw-testing-rack/mechanical/review/pairs/peg_skin_proposed.png

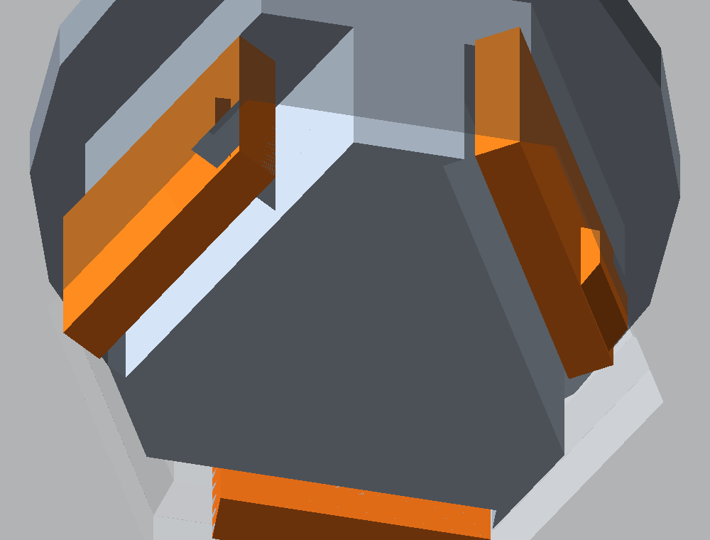
mechanical/review/pairs/peg_skin_proposed.png
