kartben/hw-testing-rack/mechanical/review/pairs/peg_skin_today.png

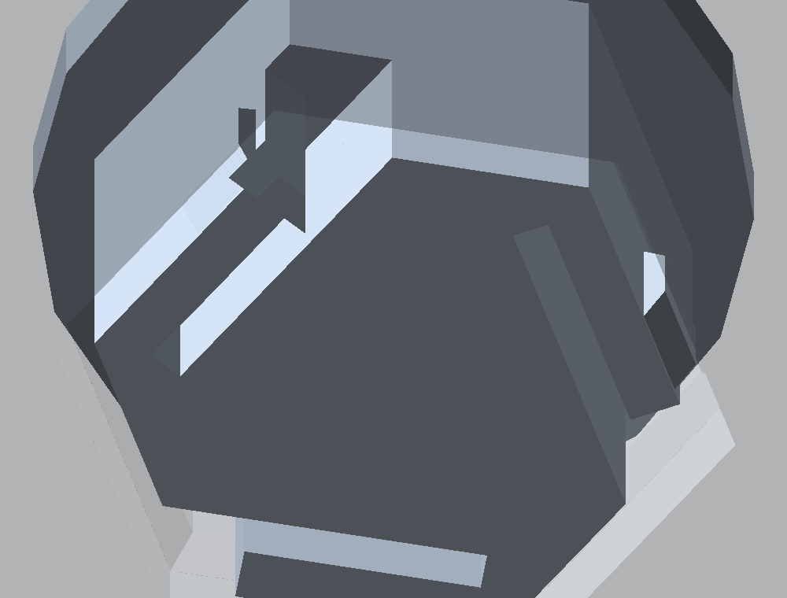
mechanical/review/pairs/peg_skin_today.png
