kartben/hw-testing-rack/mechanical/review/pairs/power_box_labels_plain.png

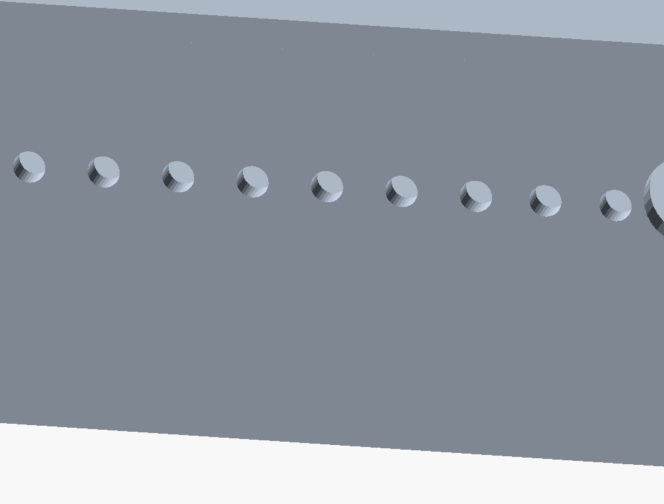
mechanical/review/pairs/power_box_labels_plain.png
