kartben/hw-testing-rack/mechanical/review/pairs/power_box_labels_small.png

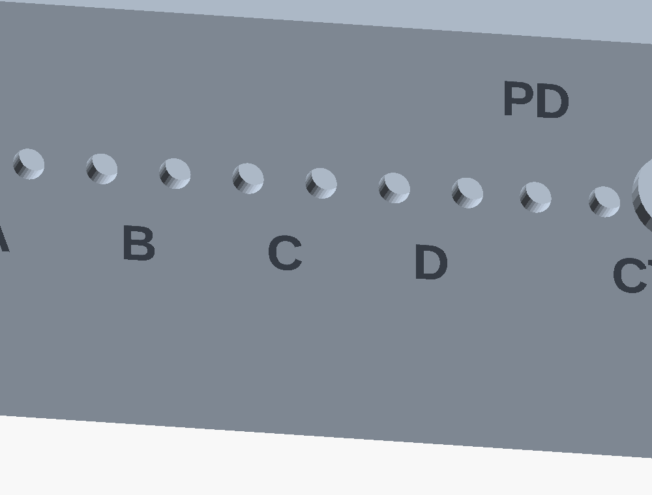
mechanical/review/pairs/power_box_labels_small.png
