kartben/hw-testing-rack/mechanical/review/pairs/power_box_labels_today.png

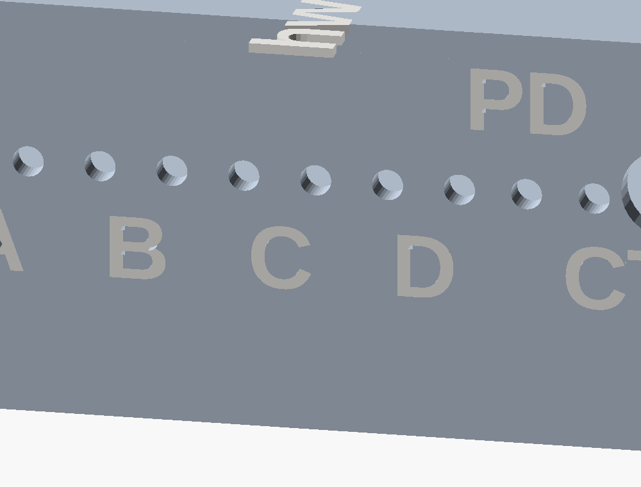
mechanical/review/pairs/power_box_labels_today.png
