kartben/hw-testing-rack/mechanical/review/pairs/sleeve_tab_proposed.png

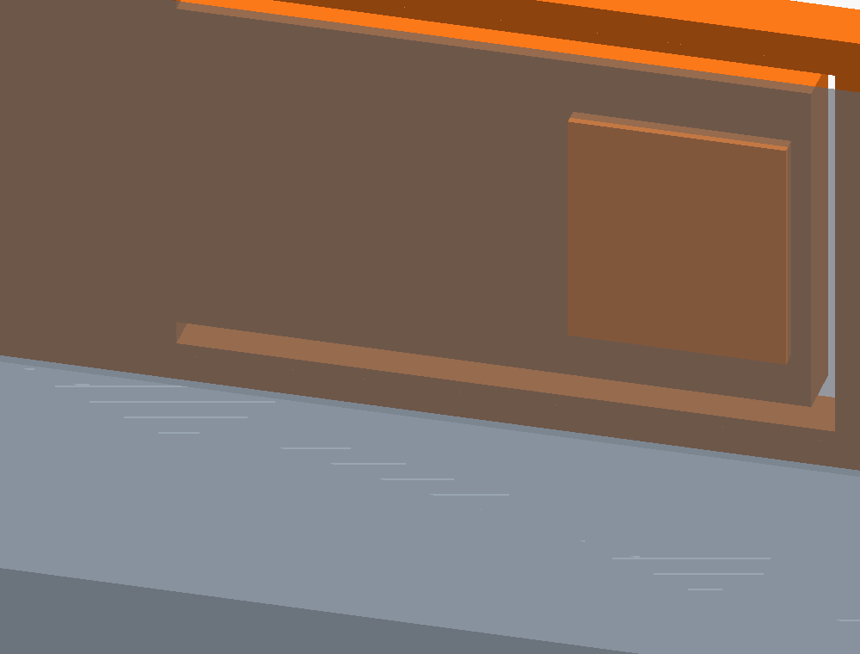
mechanical/review/pairs/sleeve_tab_proposed.png
