kartben/hw-testing-rack/mechanical/review/pairs/sleeve_tab_today.png

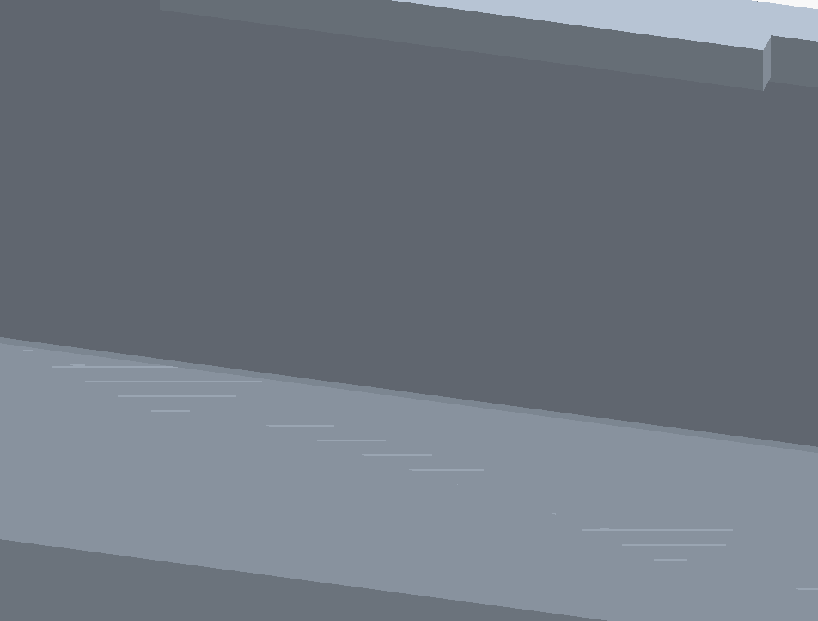
mechanical/review/pairs/sleeve_tab_today.png
