kartben/hw-testing-rack/mechanical/review/pairs/visual_language_proposed.png

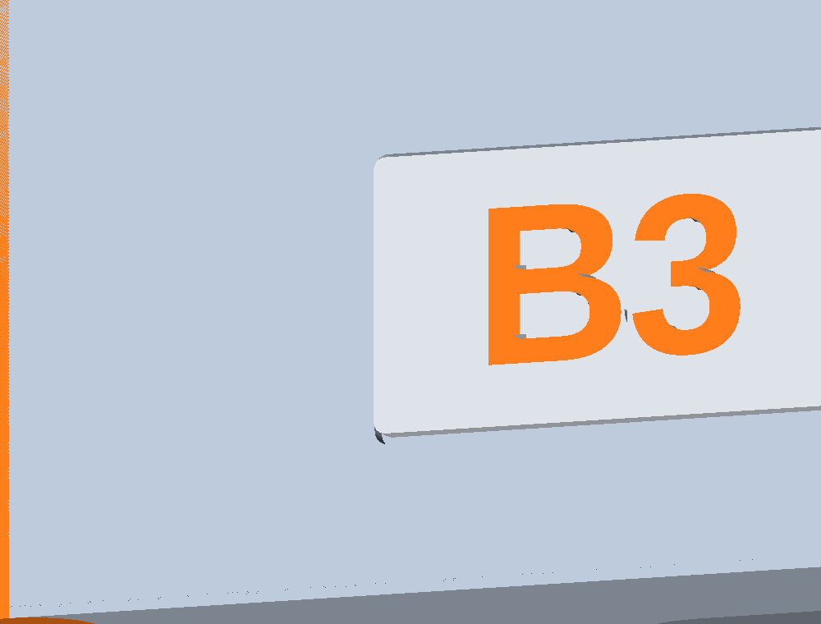
mechanical/review/pairs/visual_language_proposed.png
