kartben/hw-testing-rack/mechanical/review/pairs/visual_language_today.png

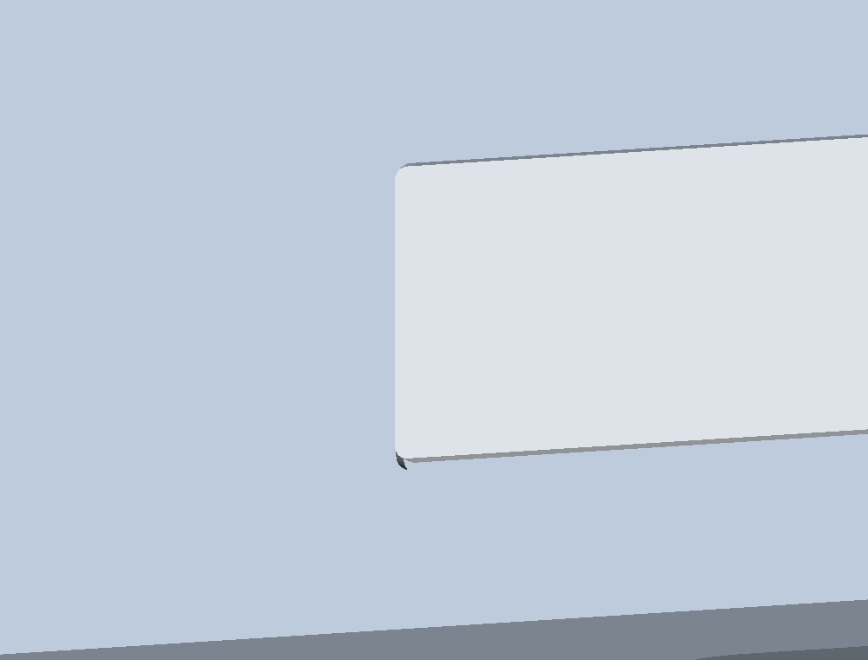
mechanical/review/pairs/visual_language_today.png
