kartben/hw-testing-rack/bom/README.md

# Bill of materials

Generated by `python tools/bom.py` from `config/rack.yaml`, the KiCad BOMs and the STL volumes.
Configuration: **12 bays** (4 columns × 3 rows) in the panel frame. Prices are indicative (EUR excl. VAT, small quantities, October 2026); re-quote before ordering. The boards follow a real JLCPCB quote of 2026-10-16, adjusted for the changes since (below, converted at $1 = €0.92); every board goes in one cart, so one shipment (DHL ≈ $27–40, $34 counted); import VAT is extra.

| Category | Cost (€) |
|---|---:|
| Electronics | 1,016 |
| Cables | 177 |
| Printed parts | 86 |
| Cameras | 73 |
| Power | 58 |
| Motion | 29 |
| Fasteners | 15 |
| Analyzer | 7 |
| **Total** | **1,461** |

≈ **€122 per bay** all-in.

Full line-item list: [`rack-bom.csv`](rack-bom.csv) · per-board JLCPCB files: `electronics/<board>/fab/` · interactive table: the viewer's BOM page.

## JLCPCB orders (estimates)

USD, without the one shipment (DHL ≈ $27–40, a line of its own) and import VAT.  The power hub is a real quote (jlcpcb.com, 2026-10-19, from the fab files, with the AP33772S then: out of stock, a Global Sourcing estimate on top; the CH224A since, from LCSC).  Every other board is an **estimate** built from JLC's fees and catalogue prices: the node's last real quote (2026-10-16: 20 PCBs ENIG, 16 assembled, $367.71) priced it before rev 0.5.  The bay node is the order the user chose on 2026-10-19: 10 PCBs, lead-free HASL, 10 assembled (8 bays, 2 spares).  The per-part lines below use catalogue prices; a *Components* line per board brings them up to the estimated components figure.  *Order* applies what changed since: the through-hole connectors hand-soldered from loose LCSC parts (LCSC shipping extra).  The DATA ×4 v2's two variants go on one order panel (data-port-x4-panel: one logic and one base per panel, one Economic order); their own estimates stay for single orders.  Every other bay's DATA board, the DATA ×6, is an estimate from JLC's fees and parts prices until a real quote.  Re-quote before ordering (the full PCBA quote needs the user's JLC sign-in).

| Board | Order | Line | USD |
|---|---|---|---:|
| bay-node | 10 PCBs (4-layer 74×90 mm (84×90 with JLC's rails), lead-free HASL), 10 assembled, Standard PCBA | PCB: special offer $14.00, lead-free HASL $5.40 | 19.40 |
| | | PCBA: setup $25.75, stencil $8.27, components $143.36, feeders $62.00, SMT $6.96, packaging $0.52, special components $0.30 | 247.16 |
| | | **Quoted total** | **266.56** |
| | | Order (indicative): IHLP2525CZ for the FXL0630 (L1, 28 V EPR): 10 at JLC's price (+$5.94 components) | 272.50 |
| power-hub | 5 PCBs (4-layer 76×100 mm (86×100 with JLC's rails), lead-free HASL), 2 assembled, Standard PCBA | PCB: special offer $8.00, lead-free HASL $5.20 | 13.20 |
| | | PCBA: setup $25.75, stencil $8.27, components $40.41, feeders $51.15, SMT $2.30, X-ray $3.30, packaging $0.50, special components $0.12 | 131.80 |
| | | **Quoted total** | **145.00** |
| | | Order (indicative): IHLP2525CZ for the FXL0630 (L1, 28 V EPR): 2 at JLC's price (+$1.19 components); rows C and D fitted: their eFuses, connectors and LEDs, 2 hubs at JLC's price (+$9.46 components); rows C and D fitted: their joints, 2 hubs (+$0.32 SMT) | 155.97 |
| data-port-x6 | 10 PCBs (4-layer 100×70 mm, JLC04161H-7628, ENIG), 10 assembled, Economic PCBA | PCB: board $19.40, ENIG $12.80 | 32.20 |
| | | PCBA: setup $8.24, stencil $1.55, components $251.99, extended parts $43.26, SMT $12.41, special components $1.80 | 319.25 |
| | | **Estimated total** | **351.45** |
| | | Order (indicative): as quoted | 351.45 |
| camera-pod | 5 PCBs (2-layer 40×27 mm, lead-free HASL), 2 assembled, Economic PCBA | PCB: special offer $4.00, lead-free HASL $1.10 | 5.10 |
| | | PCBA: setup $8.24, stencil $1.55, components $2.08, extended parts $9.27, SMT $0.18, nitrogen reflow $0.86 | 22.18 |
| | | **Quoted total** | **27.28** |
| | | Order (indicative): AP2114H-3.3 for the AMS1117 (datasheet audit F1): its extended part type (+$3.09 extended parts); AP2114H-3.3 for the AMS1117: 2 at JLC's price (+$0.05 components) | 30.42 |
| data-port-x4 | 5 PCBs (4-layer 100×70 mm, JLC04161H-7628, ENIG), 2 assembled, Economic PCBA | PCB: special offer $8.00, ENIG $17.40 | 25.40 |
| | | PCBA: setup $8.24, stencil $1.55, components $63.19, extended parts $52.53, SMT $4.30, special components $0.24 | 130.05 |
| | | **Estimated total** | **155.45** |
| | | In the rack's order on the data-port-x4-panel (one per panel) | |
| data-port-x4-base | 5 PCBs (4-layer 100×70 mm, JLC04161H-7628, lead-free HASL), 2 assembled, Economic PCBA | PCB: special offer $8.00, lead-free HASL $5.20 | 13.20 |
| | | PCBA: setup $8.24, stencil $1.55, components $31.19, extended parts $24.72, SMT $2.26, special components $0.24 | 68.20 |
| | | **Estimated total** | **81.40** |
| | | In the rack's order on the data-port-x4-panel (one per panel) | |
| data-port-x4-panel | 5 panels (4-layer 100×142 mm panel of a logic and a base, JLC04161H-7628, ENIG, mouse bites), 2 assembled: 2 of each board, Economic PCBA | PCB: engineering $25.00, ENIG $18.20, board $8.80 | 52.00 |
| | | PCBA: setup $8.24, stencil $1.55, components $101.52, extended parts $64.89, SMT $6.77, special components $0.48 | 183.45 |
| | | **Quoted total** | **235.45** |
| | | Order (indicative): C60 (33 µF 50 V), Standard-only at JLC: 4 Economic ones at JLC's price (+$0.24 components); C60: its extended part type (+$3.09 extended parts); USB-C: GCT USB4145 for the HRO TYPE-C-31-D-06, 16 at JLC's price (+$14.90 components); R23/R24 27 Ω (C25100) for 22 Ω: its extended part type (+$3.09 extended parts); R53 18.7k (C22893) for 18k: its extended part type (+$3.09 extended parts) | 259.86 |

## JLC cost

What each order pays once, whatever the number of boards, against what grows with the boards assembled (USD, the orders above).  JLC's fees (help page of 2026-09-09): **Standard** PCBA $25.75 setup + $8.27 stencil + $1.55 per unique part type, basic or extended; **Economic** PCBA $8.24 + $1.55 + $3.09 per *extended* type (basic and preferred-extended types are free); X-ray $1.64 per board with a leadless part.  A board takes Standard when one of its parts is Standard-only (every ESP32-S3 module, the WS2812B-2020), or when its mask is not green on 4 layers or more: Economic takes black on 2 layers only, in HASL (jlcpcb.com/capabilities/pcb-assembly-capabilities, 2026-10-23).  A 4-layer board within 100 × 100 mm costs $8.00 for 5 PCBs; above 100 × 100 mm, a $25 engineering fee comes on top: the v2 order panel (100 × 142 mm) pays $25.00 + $8.80 for 5, before its finish.  ENIG adds $12.40 over lead-free HASL.  A panel of different designs pays $8.21 more at PCBA and a fee at PCB.  Every board goes in one cart: one shipment for the lot ($34), the only cost the designs share.

| Board | PCBA | Needed / assembled | Part types (extended) | Type fees | Once per order | With the boards | Today | After obvious levers | After decisions |
|---|---|---|---|---:|---:|---:|---:|---:|---:|
| bay-node | Standard (ESP32-S3-WROOM-1-N8R8, WS2812B-2020-V6) | 12 / 10 | 44 (24 + 1 pref.) | 68.20 | 115.94 | 156.56 | **272.50** | 272.50 | 247.27 |
| power-hub | Standard (ESP32-S3-MINI-1-N8) | 1 / 2 | 34 (16 + 2 pref.) | 52.70 | 98.87 | 57.10 | **155.97** | 155.97 | 153.06 |
| data-port-x6 | Economic | 10 / 10 | 35 (14 + 3 pref.) | 43.26 | 85.25 | 266.20 | **351.45** | 351.45 | 351.45 |
| camera-pod | Economic | 2 / 2 | 8 (4) | 12.36 | 28.11 | 2.31 | **30.42** | 30.42 | 29.63 |
| data-port-x4-panel | Economic | 1 / 2 | 50 (24 + 3 pref.) | 74.16 | 135.95 | 123.91 | **259.86** | 259.86 | 257.84 |
| shipping | one cart, DHL | | | | 34.00 | | 34.00 | 34.00 | 34.00 |
| **All** | | | | | | | **1104.20** | **1104.20** | **1073.25** |

Levers (*obvious*: an engineering choice the board's owner applies; *decision*: the user's):

| Board | Lever | USD | Kind |
|---|---|---:|---|
| bay-node | 9 assembled instead of 10 (8 bays and 1 spare): eight parts cross back over a price break (the WROOM-1 alone $0.63 more each), so one board less saves little | 0.84 | decision |
| bay-node | USB-C J3: HRO TYPE-C-31-M-12 (C165948, 5 A, 20 V) instead of the GCT USB4105: a new footprint, re-route, mechanical check | 5.37 | decision |
| bay-node | JST PH SMD clones instead of JST's S*B / B8B-PH-SM4-TB, no-name ≈ $0.06 (SHOU HAN 2.0-xP WT / LT; CJT A2001WR / WV at $0.16-0.20 saves about 60 % of this): footprint geometry to check (5 a board) | 13.98 | decision |
| bay-node | USBLC6-2SC6 second source (UMW C2687116, same SOT-23-6 and pinout) instead of ST's C7519 (4 a board) | 5.04 | decision |
| power-hub | JST PH SMD clones instead of JST's S*B / B8B-PH-SM4-TB, no-name ≈ $0.06 (SHOU HAN 2.0-xP WT / LT; CJT A2001WR / WV at $0.16-0.20 saves about 60 % of this): footprint geometry to check (4 a board, rows A–D) | 2.66 | decision |
| power-hub | USBLC6-2SC6 second source (UMW C2687116, same SOT-23-6 and pinout) instead of ST's C7519 | 0.25 | decision |
| camera-pod | JST PH SMD clones instead of JST's S*B / B8B-PH-SM4-TB, no-name ≈ $0.06 (SHOU HAN 2.0-xP WT / LT; CJT A2001WR / WV at $0.16-0.20 saves about 60 % of this): footprint geometry to check | 0.79 | decision |
| data-port-x4-panel | USBLC6-2SC6 second source (UMW C2687116, same SOT-23-6 and pinout) instead of ST's C7519 (4 a board, 8 a panel) | 2.02 | decision |

### At volume

Unit cost (USD) of a board for n assembled in one order: the fees per order spread over n; the parts at JLC's price breaks for that quantity (the quoted components scaled by [`jlc-parts.md`](jlc-parts.md)'s prices, catalog of 2026-11-04); X-ray per board by JLC's tiers; the bare PCBs at JLC's price for that quantity (`JLC_PCB_PRICE`, measured on the calculator).  *Floor*: parts at the 100-board breaks, joints, X-ray and PCB per board, once the fees per order no longer count.

| Board | 2 | 5 | 10 | 50 | 100 | Floor |
|---|---:|---:|---:|---:|---:|---:|
| bay-node | 72.62 | 39.50 | 27.25 | 17.17 | 14.58 | 13.62 |
| power-hub | 77.97 | 46.40 | 34.78 | 23.67 | 20.94 | 20.08 |
| data-port-x6 | 69.44 | 43.94 | 35.14 | 25.89 | 23.48 | 22.95 |
| camera-pod | 15.21 | 6.78 | 3.98 | 1.79 | 1.38 | 1.15 |
| data-port-x4-panel | 129.93 | 82.53 | 67.78 | 50.32 | 46.68 | 45.61 |

One rack (12 bay-node, 1 power-hub, 10 data-port-x6, 2 camera-pod, 1 data-port-x4-panel) when building several in one order, one shipment ($34, held: it grows with the weight):

| Racks | bay-node | power-hub | data-port-x6 | camera-pod | data-port-x4-panel | Per rack |
|---|---:|---:|---:|---:|---:|---:|
| 1 | 310.48 | 155.95 | 351.45 | 30.42 | 259.86 | **1142.16** |
| 5 | 202.78 | 46.40 | 258.88 | 7.97 | 82.53 | **605.36** |
| 10 | 171.90 | 34.78 | 234.84 | 5.36 | 67.78 | **518.07** |

## Printed parts

| Part | Qty | g each (est.) | STL |
|---|---:|---:|---|
| bay_label_a1 | 1 | 0.4 | `mechanical/stl/bay_label_a1.stl` |
| bay_label_a1_inlay | 1 | – | `mechanical/stl/bay_label_a1_inlay.stl` |
| bay_label_a2 | 1 | 0.4 | `mechanical/stl/bay_label_a2.stl` |
| bay_label_a2_inlay | 1 | – | `mechanical/stl/bay_label_a2_inlay.stl` |
| bay_label_a3 | 1 | 0.4 | `mechanical/stl/bay_label_a3.stl` |
| bay_label_a3_inlay | 1 | – | `mechanical/stl/bay_label_a3_inlay.stl` |
| bay_label_a4 | 1 | 0.4 | `mechanical/stl/bay_label_a4.stl` |
| bay_label_a4_inlay | 1 | – | `mechanical/stl/bay_label_a4_inlay.stl` |
| bay_label_b1 | 1 | 0.4 | `mechanical/stl/bay_label_b1.stl` |
| bay_label_b1_inlay | 1 | – | `mechanical/stl/bay_label_b1_inlay.stl` |
| bay_label_b2 | 1 | 0.4 | `mechanical/stl/bay_label_b2.stl` |
| bay_label_b2_inlay | 1 | – | `mechanical/stl/bay_label_b2_inlay.stl` |
| bay_label_b3 | 1 | 0.4 | `mechanical/stl/bay_label_b3.stl` |
| bay_label_b3_inlay | 1 | – | `mechanical/stl/bay_label_b3_inlay.stl` |
| bay_label_b4 | 1 | 0.4 | `mechanical/stl/bay_label_b4.stl` |
| bay_label_b4_inlay | 1 | – | `mechanical/stl/bay_label_b4_inlay.stl` |
| bay_label_c1 | 1 | 0.4 | `mechanical/stl/bay_label_c1.stl` |
| bay_label_c1_inlay | 1 | – | `mechanical/stl/bay_label_c1_inlay.stl` |
| bay_label_c2 | 1 | 0.4 | `mechanical/stl/bay_label_c2.stl` |
| bay_label_c2_inlay | 1 | – | `mechanical/stl/bay_label_c2_inlay.stl` |
| bay_label_c3 | 1 | 0.4 | `mechanical/stl/bay_label_c3.stl` |
| bay_label_c3_inlay | 1 | – | `mechanical/stl/bay_label_c3_inlay.stl` |
| bay_label_c4 | 1 | 0.4 | `mechanical/stl/bay_label_c4.stl` |
| bay_label_c4_inlay | 1 | – | `mechanical/stl/bay_label_c4_inlay.stl` |
| brace_a | 4 | 6.6 | `mechanical/stl/brace_a.stl` |
| brace_b | 4 | 6.6 | `mechanical/stl/brace_b.stl` |
| brace_base | 4 | 6.4 | `mechanical/stl/brace_base.stl` |
| brace_c | 4 | 5.9 | `mechanical/stl/brace_c.stl` |
| camera_diffuser | 2 | 0.6 | `mechanical/stl/camera_diffuser.stl` |
| camera_pod | 2 | 12.2 | `mechanical/stl/camera_pod.stl` |
| cap_plate | 4 | 39.9 | `mechanical/stl/cap_plate.stl` |
| chain_anchor | 11 | 1.4 | `mechanical/stl/chain_anchor.stl` |
| chain_foot | 11 | 1.4 | `mechanical/stl/chain_foot.stl` |
| drawer | 11 | 35.6 | `mechanical/stl/drawer.stl` |
| drawer_block | 1 | 17.1 | `mechanical/stl/drawer_block.stl` |
| drawer_front | 12 | 13.7 | `mechanical/stl/drawer_front.stl` |
| drawer_sled | 1 | 19.0 | `mechanical/stl/drawer_sled.stl` |
| floor_plate | 4 | 38.8 | `mechanical/stl/floor_plate.stl` |
| ladder_a | 5 | 47.9 | `mechanical/stl/ladder_a.stl` |
| ladder_b | 5 | 47.9 | `mechanical/stl/ladder_b.stl` |
| ladder_base | 5 | 48.4 | `mechanical/stl/ladder_base.stl` |
| ladder_c | 5 | 43.5 | `mechanical/stl/ladder_c.stl` |
| ladder_cap | 5 | 14.7 | `mechanical/stl/ladder_cap.stl` |
| peg_base_h11 | 3 | 0.5 | `mechanical/stl/peg_base_h11.stl` |
| peg_base_h12 | 5 | 0.5 | `mechanical/stl/peg_base_h12.stl` |
| peg_base_h6 | 9 | 0.3 | `mechanical/stl/peg_base_h6.stl` |
| peg_base_h9 | 3 | 0.4 | `mechanical/stl/peg_base_h9.stl` |
| peg_bobbin | 5 | 0.9 | `mechanical/stl/peg_bobbin.stl` |
| peg_cam | 20 | 0.2 | `mechanical/stl/peg_cam.stl` |
| peg_pin_d21_h9 | 3 | 0.3 | `mechanical/stl/peg_pin_d21_h9.stl` |
| peg_pin_d32_h12 | 1 | 0.5 | `mechanical/stl/peg_pin_d32_h12.stl` |
| peg_pin_d32_h6 | 1 | 0.3 | `mechanical/stl/peg_pin_d32_h6.stl` |
| peg_stop_h11 | 4 | 0.5 | `mechanical/stl/peg_stop_h11.stl` |
| peg_stop_h12 | 3 | 0.6 | `mechanical/stl/peg_stop_h12.stl` |
| peg_stop_h6 | 11 | 0.4 | `mechanical/stl/peg_stop_h6.stl` |
| plate | 7 | 41.0 | `mechanical/stl/plate.stl` |
| plate_giga-r1-display | 1 | 68.3 | `mechanical/stl/plate_giga-r1-display.stl` |
| power_box_base | 1 | 35.2 | `mechanical/stl/power_box_base.stl` |
| power_box_labels | 1 | 0.1 | `mechanical/stl/power_box_labels.stl` |
| power_box_lid | 1 | 15.2 | `mechanical/stl/power_box_lid.stl` |
| slot_bin | 4 | 56.7 | `mechanical/stl/slot_bin.stl` |
| tray | 12 | 82.0 | `mechanical/stl/tray.stl` |
| x4_cradle | 12 | 12.4 | `mechanical/stl/x4_cradle.stl` |
| x4_strip | 12 | 1.3 | `mechanical/stl/x4_strip.stl` |
| cover_box4 (optional) | 12 | 31.1 | `mechanical/stl/cover_box4.stl` |

## Line items

| Category | Item | Qty | Unit € | Total € | Source |
|---|---|---:|---:|---:|---|
| Electronics | 100u/50V — 100 µF 50 V aluminium electrolytic | 10  | 0.06 | 0.64 | LCSC/JLCPCB C3352 |
| Electronics | 10u — Capacitor 10u 1206 | 20  | 0.25 | 5.01 | LCSC/JLCPCB C13585 |
| Electronics | 100n — Capacitor 100n 0603 | 140  | 0.01 | 1.74 | LCSC/JLCPCB C14663 |
| Electronics | 22u — Capacitor 22u 1206 | 50  | 0.11 | 5.69 | LCSC/JLCPCB C12891 |
| Electronics | 10u — Capacitor 10u 0805 | 10  | 0.04 | 0.40 | LCSC/JLCPCB C15850 |
| Electronics | 1u — Capacitor 1u 0603 | 10  | 0.01 | 0.13 | LCSC/JLCPCB C15849 |
| Electronics | 1u — Capacitor 1u 0805 | 20  | 0.03 | 0.54 | LCSC/JLCPCB C28323 |
| Electronics | 22n — Capacitor 22n 0603 | 10  | 0.01 | 0.07 | LCSC/JLCPCB C21122 |
| Electronics | BZT52C12 — 12 V zener, P-FET gate clamp | 10  | 0.02 | 0.18 | LCSC/JLCPCB C43491 |
| Electronics | SMBJ33A — TVS 33 V stand-off, 600 W (unidirectional) | 10  | 0.06 | 0.64 | LCSC/JLCPCB C78419 |
| Electronics | WS2812B-2020-V6 — addressable RGB LED, 3.3–5.3 V | 10  | 0.08 | 0.83 | LCSC/JLCPCB C52917434 |
| Electronics | PESD2CAN — CAN bus ESD protection, 24 V stand-off | 10  | 0.07 | 0.72 | LCSC/JLCPCB C75176 |
| Electronics | BAT54S — dual Schottky in series: clamps a line to GND and +3V3 | 20  | 0.01 | 0.24 | LCSC/JLCPCB C7420333 |
| Electronics | DFLS260-7 — 60 V 2 A Schottky, 0.62 V at 2 A | 10  | 0.31 | 3.13 | LCSC/JLCPCB C209346 |
| Electronics | 0.75A — PTC 0.75 A hold, 1.5 A trip, 1206 | 10  | 0.07 | 0.74 | LCSC/JLCPCB C20987 |
| Electronics | ROW IN — JST PH 6-pin, side entry, SMD | 10  | 0.36 | 3.59 | LCSC/JLCPCB C265405 |
| Electronics | ROW OUT — JST PH 6-pin, side entry, SMD | 10  | 0.36 | 3.59 | LCSC/JLCPCB C265405 |
| Electronics | PC — USB-C receptacle, USB 2.0, 16 pins, 5 A on VBUS | 10  | 0.84 | 8.37 | LCSC/JLCPCB C5184243 |
| Electronics | AUX — JST PH 6-pin, side entry, SMD | 10  | 0.36 | 3.59 | LCSC/JLCPCB C265405 |
| Electronics | CAM — JST PH 8-pin, vertical, SMD | 10  | 0.52 | 5.24 | LCSC/JLCPCB C495548 |
| Electronics | DATA — JST PH 8-pin, side entry, SMD | 10  | 0.41 | 4.14 | LCSC/JLCPCB C265121 |
| Electronics | 4.7u — 4.7 µH, 75 V, 10 A sat (−20 %), 5.5 A heat (ΔT 40 °C), 37 mΩ (40 max), molded | 10  | 0.63 | 6.35 | LCSC/JLCPCB C48009678 |
| Electronics | SUD50P06-15(UMW) — P-MOSFET 60 V, reverse-polarity protection | 10  | 0.33 | 3.31 | LCSC/JLCPCB C7503186 |
| Electronics | 2N7002 — N-MOSFET 60 V (open-drain AUX outputs) | 20  | 0.02 | 0.37 | LCSC/JLCPCB C8545 |
| Electronics | AO3400A — N-MOSFET 30 V 5.7 A, 48 mΩ at 2.5 V (the camera light's low side) | 10  | 0.09 | 0.92 | LCSC/JLCPCB C20917 |
| Electronics | 100k — Resistor 100k 0603 | 80  | 0.00 | 0.23 | LCSC/JLCPCB C25803 |
| Electronics | 10k — Resistor 10k 0603 | 100  | 0.00 | 0.48 | LCSC/JLCPCB C25804 |
| Electronics | 18k — Resistor 18k 0603 | 20  | 0.00 | 0.07 | LCSC/JLCPCB C25810 |
| Electronics | 33 — Resistor 33 0603 | 50  | 0.00 | 0.11 | LCSC/JLCPCB C23140 |
| Electronics | 5.1k — Resistor 5.1k 0603 | 20  | 0.00 | 0.03 | LCSC/JLCPCB C23186 |
| Electronics | 6.8k — Resistor 6.8k 0603 | 10  | 0.00 | 0.02 | LCSC/JLCPCB C23212 |
| Electronics | 50m — 50 mΩ 1 % 1 W current shunt | 10  | 0.11 | 1.10 | LCSC/JLCPCB C601102 |
| Electronics | 2.2k — Resistor 2.2k 0603 | 20  | 0.00 | 0.03 | LCSC/JLCPCB C4190 |
| Electronics | 1k — Resistor 1k 0603 | 40  | 0.00 | 0.07 | LCSC/JLCPCB C21190 |
| Electronics | 150k — Resistor 150k 0603 | 20  | 0.00 | 0.03 | LCSC/JLCPCB C22807 |
| Electronics | RESET — tactile switch 5.1 × 5.1 mm | 10  | 0.02 | 0.18 | LCSC/JLCPCB C318884 |
| Electronics | BOOT — tactile switch 5.1 × 5.1 mm | 10  | 0.02 | 0.18 | LCSC/JLCPCB C318884 |
| Electronics | SERVICE — SPDT slide switch, side actuated | 10  | 0.06 | 0.55 | LCSC/JLCPCB C431540 |
| Electronics | LMR51625YDDCR — 4.3–60 V 2.5 A synchronous buck, 1.1 MHz, PFM + spread spectrum | 10  | 1.09 | 10.95 | LCSC/JLCPCB C44991044 |
| Electronics | AP2114H-3.3TRG1 — 3.3 V 1 A LDO, 450 mV dropout at 1 A, SOT-223 | 10  | 0.21 | 2.12 | LCSC/JLCPCB C150716 |
| Electronics | ESP32-S3-WROOM-1-N8R8 — ESP32-S3 module, 8 MB flash, 8 MB octal PSRAM, PCB antenna, USB OTG (full speed) | 10  | 4.62 | 46.18 | LCSC/JLCPCB C2913201 |
| Electronics | USBLC6-2SC6 — USB ESD protection | 40  | 0.17 | 6.62 | LCSC/JLCPCB C7519 |
| Electronics | MUX_PC — USB 2.0 HS 2:1 switch | 10  | 0.29 | 2.85 | LCSC/JLCPCB C11355 |
| Electronics | MUX_DUT — USB 2.0 HS 2:1 switch | 10  | 0.29 | 2.85 | LCSC/JLCPCB C11355 |
| Electronics | SN74LVC1G32DBVR — single 2-input OR | 10  | 0.06 | 0.64 | LCSC/JLCPCB C10096 |
| Electronics | TPS26600PWPR — 4.2–60 V 2.23 A eFuse | 10  | 1.42 | 14.17 | LCSC/JLCPCB C544399 |
| Electronics | INA226AIDGSR — 36 V current/voltage/power monitor, I2C | 10  | 0.69 | 6.90 | LCSC/JLCPCB C49851 |
| Electronics | TJA1462AT — CAN FD SIC transceiver, VCC 5 V, VIO 2.95–5.5 V, bus pins −36/+40 V (MCP2562 pinout) | 10  | 0.93 | 9.29 | LCSC/JLCPCB C3234095 |
| Electronics | Bare PCB bay-node (4-layer 74×90 mm (84×90 with JLC's rails), lead-free HASL) | 10  | 1.78 | 17.85 | JLCPCB quote 2026-10-23 |
| Electronics | Standard PCBA, 10 boards: setup, stencil, feeders, SMT, packaging, special components | 1  | 95.50 | 95.50 | JLCPCB quote 2026-10-23, adjusted |
| Electronics | Components bay-node: JLC quote minus the catalogue prices above | 1  | -28.46 | -28.46 | JLCPCB quote 2026-10-23, adjusted |
| Electronics | 10u — Capacitor 10u 1206 | 8  | 0.25 | 2.00 | LCSC/JLCPCB C13585 |
| Electronics | 100n — Capacitor 100n 0603 | 24  | 0.01 | 0.30 | LCSC/JLCPCB C14663 |
| Electronics | 1u — Capacitor 1u 0805 | 20  | 0.03 | 0.54 | LCSC/JLCPCB C28323 |
| Electronics | 100u/50V — 100 µF 50 V aluminium electrolytic | 2  | 0.06 | 0.13 | LCSC/JLCPCB C3352 |
| Electronics | 47n — Capacitor 47n 0603 | 12  | 0.01 | 0.09 | LCSC/JLCPCB C1622 |
| Electronics | 22u — Capacitor 22u 1206 | 10  | 0.11 | 1.14 | LCSC/JLCPCB C12891 |
| Electronics | 1u — Capacitor 1u 0603 | 4  | 0.01 | 0.05 | LCSC/JLCPCB C15849 |
| Electronics | SMAJ30A — TVS 30 V stand-off, 400 W (unidirectional): above a 28 V EPR contract | 2  | 0.04 | 0.08 | LCSC/JLCPCB C113965 |
| Electronics | PD — green LED, side view 3 × 2 × 1 mm | 2  | 0.22 | 0.44 | LCSC/JLCPCB C598310 |
| Electronics | B5819W SL — 40 V 1 A Schottky | 4  | 0.03 | 0.11 | LCSC/JLCPCB C8598 |
| Electronics | CTL — green LED, side view 3 × 2 × 1 mm | 2  | 0.22 | 0.44 | LCSC/JLCPCB C598310 |
| Electronics | PESD2CAN,215 — CAN bus ESD protection, 24 V stand-off | 2  | 0.07 | 0.14 | LCSC/JLCPCB C75176 |
| Electronics | ON — green LED, side view 3 × 2 × 1 mm | 8  | 0.22 | 1.77 | LCSC/JLCPCB C598310 |
| Electronics | FAULT — red LED, side view 3 × 2 × 1 mm | 8  | 0.17 | 1.32 | LCSC/JLCPCB C4555382 |
| Electronics | BAT54S — dual Schottky in series: clamps a line to GND and +3V3 | 8  | 0.01 | 0.10 | LCSC/JLCPCB C7420333 |
| Electronics | DFLS260-7 — 60 V 2 A Schottky, 0.62 V at 2 A | 8  | 0.31 | 2.50 | LCSC/JLCPCB C209346 |
| Electronics | PD IN — USB-C receptacle, USB 2.0, 16 pins, 5 A on VBUS | 2  | 0.84 | 1.67 | LCSC/JLCPCB C5184243 |
| Electronics | ROW A — JST PH 6-pin, side entry, SMD | 2  | 0.36 | 0.72 | LCSC/JLCPCB C265405 |
| Electronics | ROW B — JST PH 6-pin, side entry, SMD | 2  | 0.36 | 0.72 | LCSC/JLCPCB C265405 |
| Electronics | ROW C — JST PH 6-pin, side entry, SMD | 2  | 0.36 | 0.72 | LCSC/JLCPCB C265405 |
| Electronics | ROW D — JST PH 6-pin, side entry, SMD | 2  | 0.36 | 0.72 | LCSC/JLCPCB C265405 |
| Electronics | USB — USB-C receptacle, USB 2.0, 16 pins, 5 A on VBUS | 2  | 0.84 | 1.67 | LCSC/JLCPCB C5184243 |
| Electronics | 4.7u — 4.7 µH, 75 V, 10 A sat (−20 %), 5.5 A heat (ΔT 40 °C), 37 mΩ (40 max), molded | 2  | 0.63 | 1.27 | LCSC/JLCPCB C48009678 |
| Electronics | 1k — Resistor 1k 0603 | 20  | 0.00 | 0.03 | LCSC/JLCPCB C21190 |
| Electronics | 100k — Resistor 100k 0603 | 12  | 0.00 | 0.03 | LCSC/JLCPCB C25803 |
| Electronics | 10k — Resistor 10k 0603 | 32  | 0.00 | 0.15 | LCSC/JLCPCB C25804 |
| Electronics | 56 — Resistor 56 0603 | 10  | 0.00 | 0.02 | LCSC/JLCPCB C25196 |
| Electronics | 6.8k — Resistor 6.8k 0603 | 2  | 0.00 | 0.00 | LCSC/JLCPCB C23212 |
| Electronics | 5.1k — Resistor 5.1k 0603 | 10  | 0.00 | 0.01 | LCSC/JLCPCB C23186 |
| Electronics | 7.5k — Resistor 7.5k 0603 | 8  | 0.00 | 0.01 | LCSC/JLCPCB C23234 |
| Electronics | 18k — Resistor 18k 0603 | 20  | 0.00 | 0.07 | LCSC/JLCPCB C25810 |
| Electronics | 39k — Resistor 39k 0603 | 2  | 0.00 | 0.00 | LCSC/JLCPCB C23153 |
| Electronics | RESET — tactile switch 5.1 × 5.1 mm | 2  | 0.02 | 0.04 | LCSC/JLCPCB C318884 |
| Electronics | BOOT — tactile switch 5.1 × 5.1 mm | 2  | 0.02 | 0.04 | LCSC/JLCPCB C318884 |
| Electronics | CH224A — USB PD 3.2 sink controller (EPR 28 V, PPS/AVS), I2C, power-good output | 2  | 0.40 | 0.79 | LCSC/JLCPCB C42459160 |
| Electronics | LMR51625YDDCR — 4.3–60 V 2.5 A synchronous buck, 1.1 MHz, PFM + spread spectrum | 2  | 1.09 | 2.19 | LCSC/JLCPCB C44991044 |
| Electronics | AP2112K-3.3TRG1 — 3.3 V 600 mA LDO, 250 mV dropout | 2  | 0.16 | 0.31 | LCSC/JLCPCB C51118 |
| Electronics | ESP32-S3-MINI-1-N8 — ESP32-S3 module, 8 MB flash, PCB antenna, USB OTG (full speed) | 2  | 4.34 | 8.68 | LCSC/JLCPCB C2913206 |
| Electronics | USBLC6-2SC6 — USB ESD protection | 2  | 0.17 | 0.33 | LCSC/JLCPCB C7519 |
| Electronics | TJA1462AT — CAN FD SIC transceiver, VCC 5 V, VIO 2.95–5.5 V, bus pins −36/+40 V (MCP2562 pinout) | 2  | 0.93 | 1.86 | LCSC/JLCPCB C3234095 |
| Electronics | TPS26600PWPR — 4.2–60 V 2.23 A eFuse | 8  | 1.42 | 11.33 | LCSC/JLCPCB C544399 |
| Electronics | Bare PCB power-hub (4-layer 76×100 mm (86×100 with JLC's rails), lead-free HASL) | 5  | 2.43 | 12.14 | JLCPCB quote 2026-10-23 |
| Electronics | Standard PCBA, 2 boards: setup, stencil, feeders, SMT, X-ray, packaging, special components | 1  | 84.37 | 84.37 | JLCPCB quote 2026-10-23, adjusted |
| Electronics | Components power-hub: JLC quote minus the catalogue prices above | 1  | 2.45 | 2.45 | JLCPCB quote 2026-10-23, adjusted |
| Electronics | 22u — Capacitor 22u 0805 | 80  | 0.18 | 14.28 | LCSC/JLCPCB C45783 |
| Electronics | 33p — Capacitor 33p 0402 | 20  | 0.00 | 0.06 | LCSC/JLCPCB C1562 |
| Electronics | 100n — Capacitor 100n 0402 | 230  | 0.01 | 1.17 | LCSC/JLCPCB C1525 |
| Electronics | 4.7u — Capacitor 4.7u 0402 | 20  | 0.01 | 0.21 | LCSC/JLCPCB C23733 |
| Electronics | 33u — 33 µF 50 V aluminium electrolytic, 6.3 × 7.7 mm | 10  | 0.05 | 0.54 | LCSC/JLCPCB C240518 |
| Electronics | 10u — Capacitor 10u 1206 | 40  | 0.25 | 10.02 | LCSC/JLCPCB C13585 |
| Electronics | 100n — Capacitor 100n 0603 | 40  | 0.01 | 0.50 | LCSC/JLCPCB C14663 |
| Electronics | 22u — Capacitor 22u 1206 | 60  | 0.11 | 6.83 | LCSC/JLCPCB C12891 |
| Electronics | 1u — Capacitor 1u 0402 | 60  | 0.01 | 0.38 | LCSC/JLCPCB C52923 |
| Electronics | KT-0805G — green LED 0805 | 60  | 0.02 | 1.10 | LCSC/JLCPCB C2297 |
| Electronics | LEAD — JST PH 8-pin, vertical, through-hole | 10  | 0.08 | 0.79 | LCSC (hand-solder, buy loose) C157974 |
| Electronics | PORT1 — USB-C receptacle, USB 2.0, 16 pins, vertical (top mount, 7.46 mm), 5 A on VBUS, 1.70 mm shell stakes | 10  | 0.99 | 9.94 | LCSC/JLCPCB C5181332 |
| Electronics | PORT2 — USB-C receptacle, USB 2.0, 16 pins, vertical (top mount, 7.46 mm), 5 A on VBUS, 1.70 mm shell stakes | 10  | 0.99 | 9.94 | LCSC/JLCPCB C5181332 |
| Electronics | PORT3 — USB-C receptacle, USB 2.0, 16 pins, vertical (top mount, 7.46 mm), 5 A on VBUS, 1.70 mm shell stakes | 10  | 0.99 | 9.94 | LCSC/JLCPCB C5181332 |
| Electronics | PORT4 — USB-C receptacle, USB 2.0, 16 pins, vertical (top mount, 7.46 mm), 5 A on VBUS, 1.70 mm shell stakes | 10  | 0.99 | 9.94 | LCSC/JLCPCB C5181332 |
| Electronics | PORT5 — USB-C receptacle, USB 2.0, 16 pins, vertical (top mount, 7.46 mm), 5 A on VBUS, 1.70 mm shell stakes | 10  | 0.99 | 9.94 | LCSC/JLCPCB C5181332 |
| Electronics | PORT6 — USB-C receptacle, USB 2.0, 16 pins, vertical (top mount, 7.46 mm), 5 A on VBUS, 1.70 mm shell stakes | 10  | 0.99 | 9.94 | LCSC/JLCPCB C5181332 |
| Electronics | 4.7u — 4.7 µH, 75 V, 10 A sat (−20 %), 5.5 A heat (ΔT 40 °C), 37 mΩ (40 max), molded | 20  | 0.63 | 12.70 | LCSC/JLCPCB C48009678 |
| Electronics | 2N7002 — N-MOSFET 60 V (open-drain AUX outputs) | 20  | 0.02 | 0.37 | LCSC/JLCPCB C8545 |
| Electronics | 12k — Resistor 12k 0402 | 10  | 0.00 | 0.02 | LCSC/JLCPCB C25752 |
| Electronics | 10k — Resistor 10k 0402 | 170  | 0.00 | 0.24 | LCSC/JLCPCB C25744 |
| Electronics | 4.7k — Resistor 4.7k 0402 | 20  | 0.00 | 0.04 | LCSC/JLCPCB C25900 |
| Electronics | 1M — Resistor 1M 0402 | 10  | 0.00 | 0.02 | LCSC/JLCPCB C26083 |
| Electronics | 100k — Resistor 100k 0402 | 10  | 0.00 | 0.01 | LCSC/JLCPCB C25741 |
| Electronics | 100k — Resistor 100k 0603 | 20  | 0.00 | 0.06 | LCSC/JLCPCB C25803 |
| Electronics | 18.7k — Resistor 18.7k 0603 | 20  | 0.00 | 0.00 | LCSC/JLCPCB C22893 |
| Electronics | 45.3k — Resistor 45.3k 0402 | 60  | 0.00 | 0.00 | LCSC/JLCPCB C2933099 |
| Electronics | 56k — Resistor 56k 0402 | 120  | 0.00 | 0.20 | LCSC/JLCPCB C25796 |
| Electronics | 100m — 100 mΩ 1 % 0.25 W, as a current shunt | 60  | 0.01 | 0.53 | LCSC/JLCPCB C25334 |
| Electronics | 1k — Resistor 1k 0402 | 60  | 0.00 | 0.07 | LCSC/JLCPCB C11702 |
| Electronics | 10k — 4 × resistor array 0402, 5 % | 40  | 0.00 | 0.00 | LCSC/JLCPCB C25725 |
| Electronics | USB2517I-JZX — USB 2.0 hub, 7 ports, one transaction translator per port (MTT), industrial | 10  | 4.15 | 41.49 | LCSC/JLCPCB C478081 |
| Electronics | TCA9535RTWR — 16-bit I2C I/O expander, push-pull outputs, open-drain INT, WQFN-24 4 × 4 | 10  | 1.18 | 11.78 | LCSC/JLCPCB C129354 |
| Electronics | AP2114H-3.3TRG1 — 3.3 V 1 A LDO, 450 mV dropout at 1 A, SOT-223 | 10  | 0.21 | 2.12 | LCSC/JLCPCB C150716 |
| Electronics | H5VU25UC — 4-line ESD, 0.8 pF, 5 V stand-off, DFN2510-10L, flow-through (6, 7, 9, 10 NC inside; our copper joins each pair) | 10  | 0.03 | 0.29 | LCSC/JLCPCB C20615800 |
| Electronics | MAX809S — reset supervisor 2.93 V, ≥ 150 ms, push-pull active-low RESET, SOT-23 | 10  | 0.04 | 0.39 | LCSC/JLCPCB C347371 |
| Electronics | LMR51625YDDCR — 4.3–60 V 2.5 A synchronous buck, 1.1 MHz, PFM + spread spectrum | 20  | 1.09 | 21.90 | LCSC/JLCPCB C44991044 |
| Electronics | TPS2553DBVR-1 — adjustable current-limited power switch, latch-off after 7.5 ms in limit | 60  | 0.27 | 16.01 | LCSC/JLCPCB C111738 |
| Electronics | INA226AIDGSR — 36 V current/voltage/power monitor, I2C | 60  | 0.69 | 41.40 | LCSC/JLCPCB C49851 |
| Electronics | USBLC6-2SC6 — USB ESD protection | 60  | 0.17 | 9.94 | LCSC/JLCPCB C7519 |
| Electronics | X322524MSB4SI — 24 MHz crystal, 20 pF load, ±10 ppm, 3225 | 10  | 0.09 | 0.87 | LCSC/JLCPCB C15643 |
| Electronics | Bare PCB data-port-x6 (4-layer 100×70 mm, JLC04161H-7628, ENIG) | 10  | 2.96 | 29.62 | estimate, not quoted |
| Electronics | Economic PCBA, 10 boards: setup, stencil, extended parts, SMT, special components | 1  | 61.88 | 61.88 | estimate, not quoted |
| Electronics | Components data-port-x6: JLC quote minus the catalogue prices above | 1  | -24.14 | -24.14 | estimate, not quoted |
| Electronics | 10u — Capacitor 10u 0805 | 2  | 0.04 | 0.08 | LCSC/JLCPCB C15850 |
| Electronics | 22u — Capacitor 22u 1206 | 2  | 0.11 | 0.23 | LCSC/JLCPCB C12891 |
| Electronics | 100n — Capacitor 100n 0603 | 2  | 0.01 | 0.02 | LCSC/JLCPCB C14663 |
| Electronics | XL-2835UWC-02 — LED white 6000–7500 K, 2835, 20–33 lm at 60 mA | 8  | 0.01 | 0.09 | LCSC/JLCPCB C2843876 |
| Electronics | LEAD — JST PH 8-pin, side entry, SMD | 2  | 0.41 | 0.83 | LCSC/JLCPCB C265121 |
| Electronics | MEGA — pin header 1 × 6, 2.54 mm, SMD | 2  | 0.07 | 0.15 | LCSC/JLCPCB C41417363 |
| Electronics | 100 — Resistor 100 0805 | 8  | 0.00 | 0.03 | LCSC/JLCPCB C17408 |
| Electronics | AP2114H-3.3TRG1 — 3.3 V 1 A LDO, 450 mV dropout at 1 A, SOT-223 | 2  | 0.21 | 0.42 | LCSC/JLCPCB C150716 |
| Electronics | Bare PCB camera-pod (2-layer 40×27 mm, lead-free HASL) | 5  | 0.94 | 4.69 | JLCPCB quote 2026-10-23 |
| Electronics | Economic PCBA, 2 boards: setup, stencil, extended parts, SMT, nitrogen reflow | 1  | 21.33 | 21.33 | JLCPCB quote 2026-10-23, adjusted |
| Electronics | Components camera-pod: JLC quote minus the catalogue prices above | 1  | 0.11 | 0.11 | JLCPCB quote 2026-10-23, adjusted |
| Electronics | 22u — Capacitor 22u 0805 | 12  | 0.18 | 2.14 | LCSC/JLCPCB C45783 |
| Electronics | 33p — Capacitor 33p 0402 | 4  | 0.00 | 0.01 | LCSC/JLCPCB C1562 |
| Electronics | 100n — Capacitor 100n 0402 | 82  | 0.01 | 0.42 | LCSC/JLCPCB C1525 |
| Electronics | 4.7u — Capacitor 4.7u 0402 | 10  | 0.01 | 0.10 | LCSC/JLCPCB C23733 |
| Electronics | 1u — Capacitor 1u 0402 | 18  | 0.01 | 0.11 | LCSC/JLCPCB C52923 |
| Electronics | 4.7u — Capacitor 4.7u 0402 | 4  | 0.01 | 0.04 | LCSC/JLCPCB C23733 |
| Electronics | 15p — Capacitor 15p 0402 | 4  | 0.00 | 0.01 | LCSC/JLCPCB C1548 |
| Electronics | 33u — 33 µF 50 V aluminium electrolytic, 6.3 × 7.7 mm | 2  | 0.05 | 0.11 | LCSC/JLCPCB C240518 |
| Electronics | 10u — Capacitor 10u 1206 | 4  | 0.25 | 1.00 | LCSC/JLCPCB C13585 |
| Electronics | 100n — Capacitor 100n 0603 | 4  | 0.01 | 0.05 | LCSC/JLCPCB C14663 |
| Electronics | 22u — Capacitor 22u 1206 | 6  | 0.11 | 0.68 | LCSC/JLCPCB C12891 |
| Electronics | KT-0805G — green LED 0805 | 10  | 0.02 | 0.18 | LCSC/JLCPCB C2297 |
| Electronics | GZ2012D601TF — ferrite bead 600 Ω @ 100 MHz, 500 mA, 0805 | 4  | 0.02 | 0.07 | LCSC/JLCPCB C1017 |
| Electronics | LEAD — JST PH 8-pin, vertical, through-hole | 2  | 0.08 | 0.16 | LCSC (hand-solder, buy loose) C157974 |
| Electronics | SWD — pin header 1 × 5, 2.54 mm, through-hole | 2  | 0.04 | 0.07 | LCSC (hand-solder, buy loose) C32713271 |
| Electronics | PORT1 — USB-C receptacle, USB 2.0, 16 pins, vertical (top mount, 7.46 mm), 5 A on VBUS, 1.70 mm shell stakes | 2  | 0.99 | 1.99 | LCSC/JLCPCB C5181332 |
| Electronics | PINS1 — pin header 2 × 6, 2.54 mm, through-hole, soldered by hand: Dupont jumpers to a DUT's pins | 2  | 0.09 | 0.17 | LCSC (hand-solder, buy loose) C32713279 |
| Electronics | PORT2 — USB-C receptacle, USB 2.0, 16 pins, vertical (top mount, 7.46 mm), 5 A on VBUS, 1.70 mm shell stakes | 2  | 0.99 | 1.99 | LCSC/JLCPCB C5181332 |
| Electronics | PINS2 — pin header 2 × 6, 2.54 mm, through-hole, soldered by hand: Dupont jumpers to a DUT's pins | 2  | 0.09 | 0.17 | LCSC (hand-solder, buy loose) C32713279 |
| Electronics | PORT3 — USB-C receptacle, USB 2.0, 16 pins, vertical (top mount, 7.46 mm), 5 A on VBUS, 1.70 mm shell stakes | 2  | 0.99 | 1.99 | LCSC/JLCPCB C5181332 |
| Electronics | PINS3 — pin header 2 × 6, 2.54 mm, through-hole, soldered by hand: Dupont jumpers to a DUT's pins | 2  | 0.09 | 0.17 | LCSC (hand-solder, buy loose) C32713279 |
| Electronics | PORT4 — USB-C receptacle, USB 2.0, 16 pins, vertical (top mount, 7.46 mm), 5 A on VBUS, 1.70 mm shell stakes | 2  | 0.99 | 1.99 | LCSC/JLCPCB C5181332 |
| Electronics | PINS4 — pin header 2 × 6, 2.54 mm, through-hole, soldered by hand: Dupont jumpers to a DUT's pins | 2  | 0.09 | 0.17 | LCSC (hand-solder, buy loose) C32713279 |
| Electronics | AOTA-B201610S3R3-101-T — 3.3 µH 2.4 A molded inductor, 0806, polarity dot on pad 1 (RP2350 core regulator) | 2  | 0.26 | 0.52 | LCSC/JLCPCB C42411119 |
| Electronics | 3.3u — 3.3 µH, 75 V, 13.5 A sat (−20 %), 6 A heat, 28 / 30 mΩ, molded | 2  | 0.65 | 1.31 | LCSC/JLCPCB C506574 |
| Electronics | 2N7002 — N-MOSFET 60 V (open-drain AUX outputs) | 4  | 0.02 | 0.07 | LCSC/JLCPCB C8545 |
| Electronics | 12k — Resistor 12k 0402 | 2  | 0.00 | 0.00 | LCSC/JLCPCB C25752 |
| Electronics | 10k — Resistor 10k 0402 | 52  | 0.00 | 0.07 | LCSC/JLCPCB C25744 |
| Electronics | 4.7k — Resistor 4.7k 0402 | 4  | 0.00 | 0.01 | LCSC/JLCPCB C25900 |
| Electronics | 1M — Resistor 1M 0402 | 2  | 0.00 | 0.00 | LCSC/JLCPCB C26083 |
| Electronics | 33 — Resistor 33 0402 | 2  | 0.00 | 0.00 | LCSC/JLCPCB C25105 |
| Electronics | 1k — Resistor 1k 0402 | 30  | 0.00 | 0.04 | LCSC/JLCPCB C11702 |
| Electronics | 27 — Resistor 27 0402 | 4  | 0.00 | 0.00 | LCSC/JLCPCB C25100 |
| Electronics | 100k — Resistor 100k 0402 | 30  | 0.00 | 0.04 | LCSC/JLCPCB C25741 |
| Electronics | 47k — Resistor 47k 0402 | 2  | 0.00 | 0.00 | LCSC/JLCPCB C25792 |
| Electronics | 100k — Resistor 100k 0603 | 2  | 0.00 | 0.01 | LCSC/JLCPCB C25803 |
| Electronics | 18.7k — Resistor 18.7k 0603 | 2  | 0.00 | 0.00 | LCSC/JLCPCB C22893 |
| Electronics | 45.3k — Resistor 45.3k 0402 | 8  | 0.00 | 0.00 | LCSC/JLCPCB C2933099 |
| Electronics | 56k — Resistor 56k 0402 | 16  | 0.00 | 0.03 | LCSC/JLCPCB C25796 |
| Electronics | 100m — 100 mΩ 1 % 0.25 W, as a current shunt | 8  | 0.01 | 0.07 | LCSC/JLCPCB C25334 |
| Electronics | 200k — Resistor 200k 0402 | 8  | 0.00 | 0.01 | LCSC/JLCPCB C25764 |
| Electronics | 10k — 4 × resistor array 0402, 5 % | 10  | 0.00 | 0.00 | LCSC/JLCPCB C25725 |
| Electronics | 2.2k — 4 × resistor array 0402, 5 % | 4  | 0.00 | 0.00 | LCSC/JLCPCB C26075 |
| Electronics | 100 — 4 × resistor array 0402, 5 % | 16  | 0.00 | 0.00 | LCSC/JLCPCB C48442 |
| Electronics | USB2517I-JZX — USB 2.0 hub, 7 ports, one transaction translator per port (MTT), industrial | 2  | 4.15 | 8.30 | LCSC/JLCPCB C478081 |
| Electronics | TCA6408ARGTR — 8-bit I2C I/O expander, 5.5 V tolerant I/O, open-drain INT | 4  | 0.81 | 3.24 | LCSC/JLCPCB C181499 |
| Electronics | AP2114H-3.3TRG1 — 3.3 V 1 A LDO, 450 mV dropout at 1 A, SOT-223 | 2  | 0.21 | 0.42 | LCSC/JLCPCB C150716 |
| Electronics | H5VU25UC — 4-line ESD, 0.8 pF, 5 V stand-off, DFN2510-10L, flow-through (6, 7, 9, 10 NC inside; our copper joins each pair) | 34  | 0.03 | 0.97 | LCSC/JLCPCB C20615800 |
| Electronics | MAX809S — reset supervisor 2.93 V, ≥ 150 ms, push-pull active-low RESET, SOT-23 | 2  | 0.04 | 0.08 | LCSC/JLCPCB C347371 |
| Electronics | CH446Q — 8 × 16 analog crosspoint switch, 45–65 Ω at 12 V span, serial or parallel addressing | 4  | 1.46 | 5.85 | LCSC/JLCPCB C109471 |
| Electronics | TPS60400DBVR — charge pump voltage inverter, 60 mA | 2  | 0.73 | 1.45 | LCSC/JLCPCB C9839 |
| Electronics | TCA9534APWR — 8-bit I2C I/O expander, push-pull outputs, A version (0x38–0x3F) | 2  | 1.25 | 2.50 | LCSC/JLCPCB C206010 |
| Electronics | RP2350B — RP2350, no flash in the package, QFN-80 (48 GPIO) | 2  | 1.18 | 2.36 | LCSC/JLCPCB C42415655 |
| Electronics | LMR51635YDDCR — 4.3–60 V 3.5 A synchronous buck, 1.1 MHz, PFM + spread spectrum | 2  | 1.73 | 3.46 | LCSC/JLCPCB C45262770 |
| Electronics | TPS2553DBVR-1 — adjustable current-limited power switch, latch-off after 7.5 ms in limit | 8  | 0.27 | 2.13 | LCSC/JLCPCB C111738 |
| Electronics | INA226AIDGSR — 36 V current/voltage/power monitor, I2C | 8  | 0.69 | 5.52 | LCSC/JLCPCB C49851 |
| Electronics | USBLC6-2SC6 — USB ESD protection | 8  | 0.17 | 1.32 | LCSC/JLCPCB C7519 |
| Electronics | LSF0108RKSR — 8-bit passive FET level translator, auto-bidirectional, open drain and push-pull (TI's RKS VQFN-20 has the BQ pinout) | 8  | 1.04 | 8.32 | LCSC/JLCPCB C130008 |
| Electronics | X322524MSB4SI — 24 MHz crystal, 20 pF load, ±10 ppm, 3225 | 2  | 0.09 | 0.17 | LCSC/JLCPCB C15643 |
| Electronics | ABM8-272-T3 — 12 MHz crystal, 10 pF load, 50 Ω ESR, ±30 ppm, 3225 | 2  | 0.60 | 1.20 | LCSC/JLCPCB C20625731 |
| Electronics | 22u — Capacitor 22u 0805 | 12  | 0.18 | 2.14 | LCSC/JLCPCB C45783 |
| Electronics | 33p — Capacitor 33p 0402 | 4  | 0.00 | 0.01 | LCSC/JLCPCB C1562 |
| Electronics | 100n — Capacitor 100n 0402 | 40  | 0.01 | 0.20 | LCSC/JLCPCB C1525 |
| Electronics | 4.7u — Capacitor 4.7u 0402 | 4  | 0.01 | 0.04 | LCSC/JLCPCB C23733 |
| Electronics | 33u — 33 µF 50 V aluminium electrolytic, 6.3 × 7.7 mm | 2  | 0.05 | 0.11 | LCSC/JLCPCB C240518 |
| Electronics | 10u — Capacitor 10u 1206 | 4  | 0.25 | 1.00 | LCSC/JLCPCB C13585 |
| Electronics | 100n — Capacitor 100n 0603 | 4  | 0.01 | 0.05 | LCSC/JLCPCB C14663 |
| Electronics | 22u — Capacitor 22u 1206 | 6  | 0.11 | 0.68 | LCSC/JLCPCB C12891 |
| Electronics | 1u — Capacitor 1u 0402 | 8  | 0.01 | 0.05 | LCSC/JLCPCB C52923 |
| Electronics | KT-0805G — green LED 0805 | 8  | 0.02 | 0.15 | LCSC/JLCPCB C2297 |
| Electronics | LEAD — JST PH 8-pin, vertical, through-hole | 2  | 0.08 | 0.16 | LCSC (hand-solder, buy loose) C157974 |
| Electronics | PORT1 — USB-C receptacle, USB 2.0, 16 pins, vertical (top mount, 7.46 mm), 5 A on VBUS, 1.70 mm shell stakes | 2  | 0.99 | 1.99 | LCSC/JLCPCB C5181332 |
| Electronics | PINS1 — pin header 2 × 6, 2.54 mm, through-hole, soldered by hand: Dupont jumpers to a DUT's pins | 2  | 0.09 | 0.17 | LCSC (hand-solder, buy loose) C32713279 |
| Electronics | PORT2 — USB-C receptacle, USB 2.0, 16 pins, vertical (top mount, 7.46 mm), 5 A on VBUS, 1.70 mm shell stakes | 2  | 0.99 | 1.99 | LCSC/JLCPCB C5181332 |
| Electronics | PINS2 — pin header 2 × 6, 2.54 mm, through-hole, soldered by hand: Dupont jumpers to a DUT's pins | 2  | 0.09 | 0.17 | LCSC (hand-solder, buy loose) C32713279 |
| Electronics | PORT3 — USB-C receptacle, USB 2.0, 16 pins, vertical (top mount, 7.46 mm), 5 A on VBUS, 1.70 mm shell stakes | 2  | 0.99 | 1.99 | LCSC/JLCPCB C5181332 |
| Electronics | PINS3 — pin header 2 × 6, 2.54 mm, through-hole, soldered by hand: Dupont jumpers to a DUT's pins | 2  | 0.09 | 0.17 | LCSC (hand-solder, buy loose) C32713279 |
| Electronics | PORT4 — USB-C receptacle, USB 2.0, 16 pins, vertical (top mount, 7.46 mm), 5 A on VBUS, 1.70 mm shell stakes | 2  | 0.99 | 1.99 | LCSC/JLCPCB C5181332 |
| Electronics | PINS4 — pin header 2 × 6, 2.54 mm, through-hole, soldered by hand: Dupont jumpers to a DUT's pins | 2  | 0.09 | 0.17 | LCSC (hand-solder, buy loose) C32713279 |
| Electronics | 3.3u — 3.3 µH, 75 V, 13.5 A sat (−20 %), 6 A heat, 28 / 30 mΩ, molded | 2  | 0.65 | 1.31 | LCSC/JLCPCB C506574 |
| Electronics | 2N7002 — N-MOSFET 60 V (open-drain AUX outputs) | 4  | 0.02 | 0.07 | LCSC/JLCPCB C8545 |
| Electronics | 12k — Resistor 12k 0402 | 2  | 0.00 | 0.00 | LCSC/JLCPCB C25752 |
| Electronics | 10k — Resistor 10k 0402 | 30  | 0.00 | 0.04 | LCSC/JLCPCB C25744 |
| Electronics | 4.7k — Resistor 4.7k 0402 | 4  | 0.00 | 0.01 | LCSC/JLCPCB C25900 |
| Electronics | 1M — Resistor 1M 0402 | 2  | 0.00 | 0.00 | LCSC/JLCPCB C26083 |
| Electronics | 100k — Resistor 100k 0402 | 18  | 0.00 | 0.03 | LCSC/JLCPCB C25741 |
| Electronics | 100k — Resistor 100k 0603 | 2  | 0.00 | 0.01 | LCSC/JLCPCB C25803 |
| Electronics | 18.7k — Resistor 18.7k 0603 | 2  | 0.00 | 0.00 | LCSC/JLCPCB C22893 |
| Electronics | 45.3k — Resistor 45.3k 0402 | 8  | 0.00 | 0.00 | LCSC/JLCPCB C2933099 |
| Electronics | 56k — Resistor 56k 0402 | 16  | 0.00 | 0.03 | LCSC/JLCPCB C25796 |
| Electronics | 100m — 100 mΩ 1 % 0.25 W, as a current shunt | 8  | 0.01 | 0.07 | LCSC/JLCPCB C25334 |
| Electronics | 1k — Resistor 1k 0402 | 24  | 0.00 | 0.03 | LCSC/JLCPCB C11702 |
| Electronics | 10k — 4 × resistor array 0402, 5 % | 6  | 0.00 | 0.00 | LCSC/JLCPCB C25725 |
| Electronics | USB2517I-JZX — USB 2.0 hub, 7 ports, one transaction translator per port (MTT), industrial | 2  | 4.15 | 8.30 | LCSC/JLCPCB C478081 |
| Electronics | TCA6408ARGTR — 8-bit I2C I/O expander, 5.5 V tolerant I/O, open-drain INT | 4  | 0.81 | 3.24 | LCSC/JLCPCB C181499 |
| Electronics | AP2114H-3.3TRG1 — 3.3 V 1 A LDO, 450 mV dropout at 1 A, SOT-223 | 2  | 0.21 | 0.42 | LCSC/JLCPCB C150716 |
| Electronics | H5VU25UC — 4-line ESD, 0.8 pF, 5 V stand-off, DFN2510-10L, flow-through (6, 7, 9, 10 NC inside; our copper joins each pair) | 10  | 0.03 | 0.29 | LCSC/JLCPCB C20615800 |
| Electronics | MAX809S — reset supervisor 2.93 V, ≥ 150 ms, push-pull active-low RESET, SOT-23 | 2  | 0.04 | 0.08 | LCSC/JLCPCB C347371 |
| Electronics | LMR51635YDDCR — 4.3–60 V 3.5 A synchronous buck, 1.1 MHz, PFM + spread spectrum | 2  | 1.73 | 3.46 | LCSC/JLCPCB C45262770 |
| Electronics | TPS2553DBVR-1 — adjustable current-limited power switch, latch-off after 7.5 ms in limit | 8  | 0.27 | 2.13 | LCSC/JLCPCB C111738 |
| Electronics | INA226AIDGSR — 36 V current/voltage/power monitor, I2C | 8  | 0.69 | 5.52 | LCSC/JLCPCB C49851 |
| Electronics | USBLC6-2SC6 — USB ESD protection | 8  | 0.17 | 1.32 | LCSC/JLCPCB C7519 |
| Electronics | X322524MSB4SI — 24 MHz crystal, 20 pF load, ±10 ppm, 3225 | 2  | 0.09 | 0.17 | LCSC/JLCPCB C15643 |
| Electronics | Bare PCB data-port-x4-panel (4-layer 100×142 mm panel of a logic and a base, JLC04161H-7628, ENIG, mouse bites) | 5  | 9.57 | 47.84 | JLCPCB quote 2026-11-01 |
| Electronics | Economic PCBA, 2 panels: setup, stencil, extended parts, SMT, special components | 1  | 83.90 | 83.90 | JLCPCB quote 2026-11-01, adjusted |
| Electronics | Components data-port-x4-panel: JLC quote minus the catalogue prices above | 1  | 4.31 | 4.31 | JLCPCB quote 2026-11-01, adjusted |
| Electronics | JLCPCB shipping: every board in one cart | 1  | 31.28 | 31.28 | JLCPCB |
| Printed parts | PETG filament | 4.3 kg | 20.00 | 86.00 | any |
| Printed parts | Rear bay covers (optional) | 12  | 0.00 | 0.00 | printed |
| Fasteners | M3 heat-set insert, 5.7 mm (generic brass, Ruthex-compatible holes) | 158  | 0.03 | 4.74 | AliExpress (bulk) / Ruthex |
| Fasteners | M3 square nut, DIN 562 (5.5 × 5.5 × 1.8) | 80  | 0.02 | 1.60 | AliExpress (bulk) |
| Fasteners | M3×8 pan head, Phillips (ISO 7045): rear braces, chain anchor, node PCB, power box lid, camera pods, the DATA board's cradle | 178  | 0.02 | 3.56 | AliExpress (bulk) |
| Fasteners | M3 male-female hex spacer, 12 mm + 6 mm thread, brass (≤ 5.5 mm AF) | 4  | 0.10 | 0.40 | AliExpress (bulk) |
| Fasteners | PT 2.3×8 pan head, thread-forming for plastics (M2.3×8 "ST", head ≤ Ø4.5): every printed pilot.  A drawer bay: the foot lock, 4 for the chain's end pieces, the guide lip's stop; a sled bay: its stop and 2 port-block locks (and 2 sled locks if fixed); every bay: 5 for the strip over its DATA board's receptacles (its cradle takes M3 × 8 into inserts), 2 that pull its front onto the drawer from inside | 153  | 0.02 | 3.06 | AliExpress (bulk, HZYUEGOU: M2.3×8 self-tapping pan head, stainless, ≈ €2.13 / 100) |
| Fasteners | M2×5 pan head, ISO 7045 (the front display: 4 through its frame into the module's stand-offs, from behind) | 48  | 0.02 | 0.96 | AliExpress (bulk) |
| Fasteners | M2.5 washer, DIN 125 (chain end pieces: their tab holes can be 4.3 mm) | 44  | 0.01 | 0.44 | AliExpress (bulk) |
| Motion | Drag chain 7×7 mm, links open on both sides (outer 13.5 × 10.2 mm, R18), ≈ 180 mm per drawer with its two end pieces | 3 m | 4.00 | 12.00 | Olimex DRAG-CHAIN-7X7 |
| Motion | End pieces for 7×7 chain (pair: tab with 2 holes 8 mm apart), the drawers beyond one pair per metre of chain | 8  | 2.17 | 17.36 | AliExpress 1005003181041939, "7x7mm" (or one more metre of chain per pair) |
| Cables | JST PH 8-pin lead, pin n ↔ pin 9−n (flat, no twist), 50 cm, lot of 5 (DATA leads: node J7 → drag chain → DATA board; camera leads: node J6 → pod J1) | 3 lot | 4.50 | 13.50 | AliExpress https://www.aliexpress.com/item/1005008045292937.html, "Same direction", 8P, Length50CM |
| Cables | JST PH pre-crimped lead ASPHSPH24K152, 152 mm, 24 AWG UL1007, SPH-002T-P0.5S at both ends (row cables: the 9 bay-to-bay jumpers, 6 a cable) | 58  | 0.27 | 15.43 | Digi-Key FR 455-3082-ND (or Mouser FR) |
| Cables | JST PH pre-crimped lead ASPHSPH24K305, 305 mm, 24 AWG UL1007, SPH-002T-P0.5S at both ends (row cables: the feed to row A, 6 a cable) | 8  | 0.44 | 3.52 | Digi-Key FR 455-3083-ND (or Mouser FR) |
| Cables | JST PH 6-pin housing PHR-6-R, red: a row cable's IN end (the node's J1) | 14  | 0.05 | 0.63 | LCSC C495652 |
| Cables | JST PH 6-pin housing PHR-6-BK, black: a row cable's OUT end (the node's J2, the hub's row outputs) | 14  | 0.04 | 0.55 | LCSC C495651 |
| Cables | JST PH crimp contact SPH-002T-P0.5S, 24–30 AWG, insulation Ø 0.8–1.5 mm (the feeds JST's leads don't reach: row B (60 cm), row C (80 cm)) | 50  | 0.01 | 0.41 | LCSC C111515 |
| Cables | Wire, 24 AWG stranded, UL1007 (Ø ≈ 1.4 mm, within the contact's 1.5), black, 10 m (the crimped feeds) | 1 spool | 4.00 | 4.00 | AliExpress (UL1007 24AWG) |
| Cables | Crimper for open-barrel contacts, 28–18 AWG (the crimped feeds' contacts) | 1  | 20.00 | 20.00 | IWISS SN-28B (or Engineer PA-09, ≈ €40) |
| Cables | Cable tie 2.5 × 100 mm: the row jumpers, 2 each, through the tray's two tie anchors at its front right (docs/cabling.md) | 18  | 0.02 | 0.36 | AliExpress (bulk) |
| Cables | USB-C straight ↔ USB-C 90°, 15 cm (DUT cable: BEAGLEPLAY, GIGA + display, WIO TERMINAL) | 3  | 3.69 | 11.07 | AliExpress 1005009683032517 (HDR Store, flat USB 2.0 cable, "Type-C-bend-straight", 15cm) |
| Cables | USB-C ↔ USB-C, straight, 15–20 cm (DUT cable: ESP32-C6, NANO MATTER, UNO R4, WIO TERMINAL, XIAO) | 13  | 3.69 | 47.97 | AliExpress 1005009683032517 (HDR Store, flat USB 2.0 cable, "straight-straight", 15cm) |
| Cables | USB-C ↔ USB-C, straight, 20 cm (DUT cable: UNO R4) | 1  | 4.09 | 4.09 | AliExpress 1005009683032517 (HDR Store, flat USB 2.0 cable, "straight-straight", 20cm) |
| Cables | USB-C straight ↔ micro-B straight, 25 cm, on a micro-B 90° adapter (DUT cable: NUCLEO-144, NUCLEO-64) | 2  | 4.39 | 8.78 | AliExpress 1005007989121951 (Waveshare, flat USB 2.0 cable, "Straight-Straight", 25cm) |
| Cables | USB-C ↔ micro-B, straight, 15 cm (DUT cable: ESP32-S3, MICRO:BIT, NUCLEO-64, PICO 2) | 11  | 3.69 | 40.59 | AliExpress 1005007989121951 (Waveshare, flat USB 2.0 cable, "Straight-Straight", 15cm) |
| Cables | Micro-B 90° adapter, male → female, up and down, one of each per board | 4  | 1.00 | 4.00 | AliExpress (DIY-018, "UP" and "DOWN") |
| Analyzer | Raspberry Pi Pico 2 (RP2350), the logic analyzer in B3.3 | 1  | 5.50 | 5.50 | Raspberry Pi approved reseller (Kubii, The Pi Hut, Pimoroni) |
| Analyzer | Dupont jumper wires, female–female, 10 cm, a 40-wire strip | 1  | 1.50 | 1.50 | AliExpress |
| Cables | Dupont jumper wires, female–female, 20 cm, a 40-wire strip (DATA ×4 RESET/BOOT headers → the boards' pins: 1 wire) | 1  | 2.00 | 2.00 | AliExpress |
| Power | USB PD charger, 100 W (20 V × 5 A), single port (e.g. Anker Nano 100 W, A2679) | 1  | 46.00 | 46.00 | Anker (anker.com/fr) / UGREEN / any PD 100 W |
| Power | USB-C to USB-C cable, 5 A, e-marked (100 W or 240 W rated), 1–2 m | 1  | 12.00 | 12.00 | any (check the 5 A e-marker) |
| Cameras | Arducam Mega 3MP SPI camera, M12 version (B0434), 33 × 33 mm | 2  | 28.25 | 56.50 | Welectron (33.90 € TTC) / Arducam (≈ $30) / DigiKey |
| Cameras | Arducam LN018 M12 lens (M40160M12), 1/4", 1.6 mm, 145° diagonal, 118° × 92° (the stock 90° is too narrow for a NUCLEO-144 / nRF DK) | 2  | 7.48 | 14.96 | Welectron (8.90 € TTC) |
| Cameras | Cable JST XH 2.54 6-pin → Dupont female, one 6-pin housing, 10–20 cm (the Mega → pod J2, VCC GND SCK MISO MOSI CS in order) | 2  | 0.50 | 1.00 | AliExpress |
| Cameras | Pod hardware: 2 × PT 2.6×14 (the pod board, through the diffuser's posts), cable ties 2.5 × 100 (the lead: 1 at the tray's rear slot, 3 under the ceiling) | 2 set | 0.30 | 0.60 | AliExpress (bulk) |

## Standalone bays (optional, outside the totals above)

One bay out of the rack, on a desk ([docs/standalone.md](../docs/standalone.md)): what a unit takes beyond its boards (the node and its DATA board, from the boards' order above) and a USB-C PD charger offering 20 V.  The printed parts at the estimate above (PETG, from the STL's volume).

**Solo (the node + the single DATA port board)**: ≈ €4.80, 46 g of PETG

| Item | Qty | Unit € | Total € | Source |
|---|---:|---:|---:|---|
| standalone_solo_base (printed) | 1 | 0.62 | 0.62 | `mechanical/stl/standalone_solo_base.stl` |
| standalone_solo_lid (printed) | 1 | 0.29 | 0.29 | `mechanical/stl/standalone_solo_lid.stl` |
| USB-C PD trigger module, CH224K with a DIP switch set to 20 V (a "decoy" board, ≤ 30 × 21 mm): feeds the node's J1 in place of the power hub, from any PD charger offering 20 V, ≥ 30 W (docs/cabling.md) | 1 | 2.00 | 2.00 | AliExpress 3256811726090162; its size goes in config/rack.yaml › standalone.pd_module |
| Double-sided foam pad, 1 mm, ≈ 20 × 10 mm (the PD module against its wall) | 1 | 0.05 | 0.05 | any |
| PD lead: JST PHR-6 housing, 2 × SPH-002T-P0.5S, 2 × 15 cm 24 AWG (red VRACK on pin 1, black GND on pin 2), soldered to the module's output pads | 1 | 0.30 | 0.30 | LCSC / AliExpress |
| JST PH 8-pin lead, pin n ↔ pin 9−n, 15 cm (node J7 → the DATA board): the rack's DATA lead, shorter | 1 | 0.90 | 0.90 | AliExpress https://www.aliexpress.com/item/1005008045292937.html, "Same direction", 8P |
| M3 heat-set insert, 5.7 mm | 8 | 0.03 | 0.24 | AliExpress (bulk) |
| M3×8 pan head (ISO 7045) | 8 | 0.02 | 0.16 | AliExpress (bulk) |
| PT 2.3×8 pan head, thread-forming | 2 | 0.02 | 0.04 | AliExpress (bulk) |
| Rubber bumper, self-adhesive, Ø10 × 3 mm | 4 | 0.05 | 0.20 | AliExpress (bulk) |

**Quad (the node + the DATA ×4 v2)**: ≈ €5.84, 100 g of PETG

| Item | Qty | Unit € | Total € | Source |
|---|---:|---:|---:|---|
| standalone_quad_base (printed) | 1 | 1.49 | 1.49 | `mechanical/stl/standalone_quad_base.stl` |
| standalone_quad_shelf (printed) | 1 | 0.22 | 0.22 | `mechanical/stl/standalone_quad_shelf.stl` |
| standalone_quad_lid (printed) | 1 | 0.28 | 0.28 | `mechanical/stl/standalone_quad_lid.stl` |
| USB-C PD trigger module, CH224K with a DIP switch set to 20 V (a "decoy" board, ≤ 30 × 21 mm): feeds the node's J1 in place of the power hub, from any PD charger offering 20 V, ≥ 30 W (docs/cabling.md) | 1 | 2.00 | 2.00 | AliExpress 3256811726090162; its size goes in config/rack.yaml › standalone.pd_module |
| Double-sided foam pad, 1 mm, ≈ 20 × 10 mm (the PD module against its wall) | 1 | 0.05 | 0.05 | any |
| PD lead: JST PHR-6 housing, 2 × SPH-002T-P0.5S, 2 × 15 cm 24 AWG (red VRACK on pin 1, black GND on pin 2), soldered to the module's output pads | 1 | 0.30 | 0.30 | LCSC / AliExpress |
| JST PH 8-pin lead, pin n ↔ pin 9−n, 15 cm (node J7 → the DATA board): the rack's DATA lead, shorter | 1 | 0.90 | 0.90 | AliExpress https://www.aliexpress.com/item/1005008045292937.html, "Same direction", 8P |
| M3 heat-set insert, 5.7 mm | 8 | 0.03 | 0.24 | AliExpress (bulk) |
| M3×8 pan head (ISO 7045) | 8 | 0.02 | 0.16 | AliExpress (bulk) |
| Rubber bumper, self-adhesive, Ø10 × 3 mm | 4 | 0.05 | 0.20 | AliExpress (bulk) |

**Desk frame, for either (the rack's honeycomb plate in it: the DUTs held by its pegs)**: ≈ €1.39, 69 g of PETG

| Item | Qty | Unit € | Total € | Source |
|---|---:|---:|---:|---|
| standalone_desk_frame (printed) | 1 | 0.57 | 0.57 | `mechanical/stl/standalone_desk_frame.stl` |
| plate (printed) | 1 | 0.82 | 0.82 | `mechanical/stl/plate.stl` |
