kartben/hw-testing-rack/bom/rack-bom.csv

category | group | item | qty | unit | unit_eur | ext_eur | supplier | part | mpn | manufacturer | ref | notes
Electronics | bay-node | 100u/50V — 100 µF 50 V aluminium electrolytic | 10 | pcs | 0.0635 | 0.64 | LCSC/JLCPCB | C3352 | RVT1H101M0810 | Honor Elec | C1 | 1 per board × 10 boards
Electronics | bay-node | 10u — Capacitor 10u 1206 | 20 | pcs | 0.2504 | 5.01 | LCSC/JLCPCB | C13585 | CL31A106KBHNNNE | Samsung Electro-Mechanics | C2,C3 | 2 per board × 10 boards
Electronics | bay-node | 100n — Capacitor 100n 0603 | 140 | pcs | 0.0124 | 1.74 | LCSC/JLCPCB | C14663 | CC0603KRX7R9BB104 | YAGEO | C4,C5,C14,C16,C17,C18,C19,C22,C23,C24,C25,C26,C27,C28 | 14 per board × 10 boards
Electronics | bay-node | 22u — Capacitor 22u 1206 | 50 | pcs | 0.1138 | 5.69 | LCSC/JLCPCB | C12891 | CL31A226KAHNNNE | Samsung Electro-Mechanics | C7,C8,C9,C12,C13 | 5 per board × 10 boards
Electronics | bay-node | 10u — Capacitor 10u 0805 | 10 | pcs | 0.0403 | 0.4 | LCSC/JLCPCB | C15850 | CL21A106KAYNNNE | Samsung Electro-Mechanics | C11 | 1 per board × 10 boards
Electronics | bay-node | 1u — Capacitor 1u 0603 | 10 | pcs | 0.013 | 0.13 | LCSC/JLCPCB | C15849 | CL10A105KB8NNNC | Samsung Electro-Mechanics | C15 | 1 per board × 10 boards
Electronics | bay-node | 1u — Capacitor 1u 0805 | 20 | pcs | 0.0268 | 0.54 | LCSC/JLCPCB | C28323 | CL21B105KBFNNNE | Samsung Electro-Mechanics | C20,C21 | 2 per board × 10 boards
Electronics | bay-node | 22n — Capacitor 22n 0603 | 10 | pcs | 0.0069 | 0.07 | LCSC/JLCPCB | C21122 | CL10B223KB8NNNC | Samsung Electro-Mechanics | C29 | 1 per board × 10 boards
Electronics | bay-node | BZT52C12 — 12 V zener, P-FET gate clamp | 10 | pcs | 0.0184 | 0.18 | LCSC/JLCPCB | C43491 | BZT52C12 | CJ | D1 | 1 per board × 10 boards
Electronics | bay-node | SMBJ33A — TVS 33 V stand-off, 600 W (unidirectional) | 10 | pcs | 0.0644 | 0.64 | LCSC/JLCPCB | C78419 | SMBJ33A | Brightking | D2 | 1 per board × 10 boards
Electronics | bay-node | WS2812B-2020-V6 — addressable RGB LED, 3.3–5.3 V | 10 | pcs | 0.0828 | 0.83 | LCSC/JLCPCB | C52917434 | WS2812B-2020-V6 | Worldsemi | D4 | 1 per board × 10 boards; alternative: WS2812C-2020-V6 (C55109522) is Economic-PCBA capable; check its pinout before swapping
Electronics | bay-node | PESD2CAN — CAN bus ESD protection, 24 V stand-off | 10 | pcs | 0.0718 | 0.72 | LCSC/JLCPCB | C75176 | PESD2CAN,215 | Nexperia | D5 | 1 per board × 10 boards
Electronics | bay-node | BAT54S — dual Schottky in series: clamps a line to GND and +3V3 | 20 | pcs | 0.012 | 0.24 | LCSC/JLCPCB | C7420333 | BAT54S | hongjiacheng | D6,D7 | 2 per board × 10 boards
Electronics | bay-node | DFLS260-7 — 60 V 2 A Schottky, 0.62 V at 2 A | 10 | pcs | 0.3128 | 3.13 | LCSC/JLCPCB | C209346 | DFLS260-7 | Diodes Inc. | D8 | 1 per board × 10 boards
Electronics | bay-node | 0.75A — PTC 0.75 A hold, 1.5 A trip, 1206 | 10 | pcs | 0.0736 | 0.74 | LCSC/JLCPCB | C20987 | SMD1206P075TF | RUILON | F1 | 1 per board × 10 boards
Electronics | bay-node | ROW IN — JST PH 6-pin, side entry, SMD | 10 | pcs | 0.3588 | 3.59 | LCSC/JLCPCB | C265405 | S6B-PH-SM4-TB(LF)(SN) | JST | J1 | 1 per board × 10 boards
Electronics | bay-node | ROW OUT — JST PH 6-pin, side entry, SMD | 10 | pcs | 0.3588 | 3.59 | LCSC/JLCPCB | C265405 | S6B-PH-SM4-TB(LF)(SN) | JST | J2 | 1 per board × 10 boards
Electronics | bay-node | PC — USB-C receptacle, USB 2.0, 16 pins, 5 A on VBUS | 10 | pcs | 0.8372 | 8.37 | LCSC/JLCPCB | C5184243 | USB4105-GF-A-120 | GCT | J3 | 1 per board × 10 boards
Electronics | bay-node | AUX — JST PH 6-pin, side entry, SMD | 10 | pcs | 0.3588 | 3.59 | LCSC/JLCPCB | C265405 | S6B-PH-SM4-TB(LF)(SN) | JST | J5 | 1 per board × 10 boards
Electronics | bay-node | CAM — JST PH 8-pin, vertical, SMD | 10 | pcs | 0.5244 | 5.24 | LCSC/JLCPCB | C495548 | B8B-PH-SM4-TB(LF)(SN) | JST | J6 | 1 per board × 10 boards
Electronics | bay-node | DATA — JST PH 8-pin, side entry, SMD | 10 | pcs | 0.414 | 4.14 | LCSC/JLCPCB | C265121 | S8B-PH-SM4-TB(LF)(SN) | JST | J7 | 1 per board × 10 boards
Electronics | bay-node | 4.7u — 4.7 µH, 75 V, 10 A sat (−20 %), 5.5 A heat (ΔT 40 °C), 37 mΩ (40 max), molded | 10 | pcs | 0.6348 | 6.35 | LCSC/JLCPCB | C48009678 | IHLP2525CZEK4R7M01 | Vishay | L1 | 1 per board × 10 boards; alternative: IHLP2525CZER4R7M01 (C553961): the same part on a 2000-piece reel
Electronics | bay-node | SUD50P06-15(UMW) — P-MOSFET 60 V, reverse-polarity protection | 10 | pcs | 0.3312 | 3.31 | LCSC/JLCPCB | C7503186 | SUD50P06-15(UMW) | UMW | Q1 | 1 per board × 10 boards; alternative: C7472883 (TECH PUBLIC), C141584 (Vishay)
Electronics | bay-node | 2N7002 — N-MOSFET 60 V (open-drain AUX outputs) | 20 | pcs | 0.0184 | 0.37 | LCSC/JLCPCB | C8545 | 2N7002 | CJ | Q2,Q3 | 2 per board × 10 boards
Electronics | bay-node | AO3400A — N-MOSFET 30 V 5.7 A, 48 mΩ at 2.5 V (the camera light's low side) | 10 | pcs | 0.092 | 0.92 | LCSC/JLCPCB | C20917 | AO3400A | Alpha & Omega Semicon | Q4 | 1 per board × 10 boards
Electronics | bay-node | 100k — Resistor 100k 0603 | 80 | pcs | 0.0029 | 0.23 | LCSC/JLCPCB | C25803 | 0603WAF1003T5E | UNI-ROYAL(Uniroyal Elec) | R1,R2,R4,R13,R26,R27,R36,R39 | 8 per board × 10 boards
Electronics | bay-node | 10k — Resistor 10k 0603 | 100 | pcs | 0.0048 | 0.48 | LCSC/JLCPCB | C25804 | 0603WAF1002T5E | UNI-ROYAL(Uniroyal Elec) | R3,R6,R7,R11,R17,R18,R20,R28,R30,R37 | 10 per board × 10 boards
Electronics | bay-node | 18k — Resistor 18k 0603 | 20 | pcs | 0.0037 | 0.07 | LCSC/JLCPCB | C25810 | 0603WAF1802T5E | UNI-ROYAL(Uniroyal Elec) | R5,R12 | 2 per board × 10 boards
Electronics | bay-node | 33 — Resistor 33 0603 | 50 | pcs | 0.0023 | 0.11 | LCSC/JLCPCB | C23140 | 0603WAF330JT5E | UNI-ROYAL(Uniroyal Elec) | R8,R31,R32,R33,R34 | 5 per board × 10 boards
Electronics | bay-node | 5.1k — Resistor 5.1k 0603 | 20 | pcs | 0.0014 | 0.03 | LCSC/JLCPCB | C23186 | 0603WAF5101T5E | UNI-ROYAL(Uniroyal Elec) | R9,R10 | 2 per board × 10 boards
Electronics | bay-node | 6.8k — Resistor 6.8k 0603 | 10 | pcs | 0.0021 | 0.02 | LCSC/JLCPCB | C23212 | 0603WAF6801T5E | UNI-ROYAL(Uniroyal Elec) | R16 | 1 per board × 10 boards
Electronics | bay-node | 50m — 50 mΩ 1 % 1 W current shunt | 10 | pcs | 0.1104 | 1.1 | LCSC/JLCPCB | C601102 | HoLR1206-1W-50mR-1%-75ppm | Milliohm | R19 | 1 per board × 10 boards
Electronics | bay-node | 2.2k — Resistor 2.2k 0603 | 20 | pcs | 0.0017 | 0.03 | LCSC/JLCPCB | C4190 | 0603WAF2201T5E | UNI-ROYAL(Uniroyal Elec) | R21,R22 | 2 per board × 10 boards
Electronics | bay-node | 1k — Resistor 1k 0603 | 40 | pcs | 0.0017 | 0.07 | LCSC/JLCPCB | C21190 | 0603WAF1001T5E | UNI-ROYAL(Uniroyal Elec) | R23,R24,R25,R43 | 4 per board × 10 boards
Electronics | bay-node | 150k — Resistor 150k 0603 | 20 | pcs | 0.0015 | 0.03 | LCSC/JLCPCB | C22807 | 0603WAF1503T5E | UNI-ROYAL(Uniroyal Elec) | R29,R42 | 2 per board × 10 boards
Electronics | bay-node | RESET — tactile switch 5.1 × 5.1 mm | 10 | pcs | 0.0184 | 0.18 | LCSC/JLCPCB | C318884 | TS-1187A-B-A-B | XKB | SW1 | 1 per board × 10 boards
Electronics | bay-node | BOOT — tactile switch 5.1 × 5.1 mm | 10 | pcs | 0.0184 | 0.18 | LCSC/JLCPCB | C318884 | TS-1187A-B-A-B | XKB | SW2 | 1 per board × 10 boards
Electronics | bay-node | SERVICE — SPDT slide switch, side actuated | 10 | pcs | 0.0552 | 0.55 | LCSC/JLCPCB | C431540 | MSK12C02 | SHOU HAN | SW3 | 1 per board × 10 boards
Electronics | bay-node | LMR51625YDDCR — 4.3–60 V 2.5 A synchronous buck, 1.1 MHz, PFM + spread spectrum | 10 | pcs | 1.0948 | 10.95 | LCSC/JLCPCB | C44991044 | LMR51625YDDCR | Texas Instruments | U1 | 1 per board × 10 boards; alternative: LMR51625YFDDCR (C45262768): same, forced PWM, no spread spectrum; LMR51635YDDCR (C45262770): 3.5 A, 3.3 µH
Electronics | bay-node | AP2114H-3.3TRG1 — 3.3 V 1 A LDO, 450 mV dropout at 1 A, SOT-223 | 10 | pcs | 0.2116 | 2.12 | LCSC/JLCPCB | C150716 | AP2114H-3.3TRG1 | Diodes Incorporated | U2 | 1 per board × 10 boards
Electronics | bay-node | ESP32-S3-WROOM-1-N8R8 — ESP32-S3 module, 8 MB flash, 8 MB octal PSRAM, PCB antenna, USB OTG (full speed) | 10 | pcs | 4.6184 | 46.18 | LCSC/JLCPCB | C2913201 | ESP32-S3-WROOM-1-N8R8 | Espressif | U3 | 1 per board × 10 boards
Electronics | bay-node | USBLC6-2SC6 — USB ESD protection | 40 | pcs | 0.1656 | 6.62 | LCSC/JLCPCB | C7519 | USBLC6-2SC6 | STMicroelectronics | U4,U8,U12,U13 | 4 per board × 10 boards; alternative: C2687116 (UMW clone)
Electronics | bay-node | MUX_PC — USB 2.0 HS 2:1 switch | 10 | pcs | 0.2852 | 2.85 | LCSC/JLCPCB | C11355 | FSUSB42MUX | onsemi | U5 | 1 per board × 10 boards
Electronics | bay-node | MUX_DUT — USB 2.0 HS 2:1 switch | 10 | pcs | 0.2852 | 2.85 | LCSC/JLCPCB | C11355 | FSUSB42MUX | onsemi | U6 | 1 per board × 10 boards
Electronics | bay-node | SN74LVC1G32DBVR — single 2-input OR | 10 | pcs | 0.0644 | 0.64 | LCSC/JLCPCB | C10096 | SN74LVC1G32DBVR | Texas Instruments | U7 | 1 per board × 10 boards
Electronics | bay-node | TPS26600PWPR — 4.2–60 V 2.23 A eFuse | 10 | pcs | 1.4168 | 14.17 | LCSC/JLCPCB | C544399 | TPS26600PWPR | Texas Instruments | U9 | 1 per board × 10 boards
Electronics | bay-node | INA226AIDGSR — 36 V current/voltage/power monitor, I2C | 10 | pcs | 0.69 | 6.9 | LCSC/JLCPCB | C49851 | INA226AIDGSR | Texas Instruments | U10 | 1 per board × 10 boards
Electronics | bay-node | TJA1462AT — CAN FD SIC transceiver, VCC 5 V, VIO 2.95–5.5 V, bus pins −36/+40 V (MCP2562 pinout) | 10 | pcs | 0.9292 | 9.29 | LCSC/JLCPCB | C3234095 | TJA1462AT/0Z | NXP Semiconductors | U11 | 1 per board × 10 boards; alternative: Same pinout: TI TCAN1462VDRQ1 (C7399456, SIC, bus pins ±58 V; LCSC stock 0 on 2026-10-18 and 19) or TCAN1044AVDRQ1 (C3234993, no SIC, ±58 V)
Electronics | bay-node | Bare PCB bay-node (4-layer 74×90 mm (84×90 with JLC's rails), lead-free HASL) | 10 | pcs | 1.7848 | 17.85 | JLCPCB quote 2026-10-23 |  |  |  |  | special offer $14.00, lead-free HASL $5.40 = $19.40 for 10 PCBs, 10 of them assembled
Electronics | bay-node | Standard PCBA, 10 boards: setup, stencil, feeders, SMT, packaging, special components | 1 | pcs | 95.5 | 95.5 | JLCPCB quote 2026-10-23, adjusted |  |  |  |  | setup $25.75, stencil $8.27, feeders $62.00, SMT $6.96, packaging $0.52, special components $0.30; IHLP2525CZ for the FXL0630 (L1, 28 V EPR): 10 at JLC's price (+$5.94 components); Standard because ESP32-S3-WROOM-1-N8R8, WS2812B-2020-V6 cannot be placed with Economic PCBA
Electronics | bay-node | Components bay-node: JLC quote minus the catalogue prices above | 1 | pcs | -28.46 | -28.46 | JLCPCB quote 2026-10-23, adjusted |  |  |  |  | quoted components $143.36 + $5.94 since (≈ €137.36) for 10 boards; catalogue unit prices give €165.82
Electronics | power-hub | 10u — Capacitor 10u 1206 | 8 | pcs | 0.2504 | 2.0 | LCSC/JLCPCB | C13585 | CL31A106KBHNNNE | Samsung Electro-Mechanics | C1,C9,C104,C105 | 4 per board × 2 boards
Electronics | power-hub | 100n — Capacitor 100n 0603 | 24 | pcs | 0.0124 | 0.3 | LCSC/JLCPCB | C14663 | CC0603KRX7R9BB104 | YAGEO | C2,C3,C10,C21,C22,C23,C24,C106,C107,C114,C116,C117 | 12 per board × 2 boards
Electronics | power-hub | 1u — Capacitor 1u 0805 | 20 | pcs | 0.0268 | 0.54 | LCSC/JLCPCB | C28323 | CL21B105KBFNNNE | Samsung Electro-Mechanics | C4,C11,C12,C13,C14,C31,C32,C33,C34,C111 | 10 per board × 2 boards
Electronics | power-hub | 100u/50V — 100 µF 50 V aluminium electrolytic | 2 | pcs | 0.0635 | 0.13 | LCSC/JLCPCB | C3352 | RVT1H101M0810 | Honor Elec | C8 | 1 per board × 2 boards
Electronics | power-hub | 47n — Capacitor 47n 0603 | 12 | pcs | 0.0071 | 0.09 | LCSC/JLCPCB | C1622 | CL10B473KB8NNNC | Samsung Electro-Mechanics | C61,C62,C63,C64,C118,C119 | 6 per board × 2 boards
Electronics | power-hub | 22u — Capacitor 22u 1206 | 10 | pcs | 0.1138 | 1.14 | LCSC/JLCPCB | C12891 | CL31A226KAHNNNE | Samsung Electro-Mechanics | C108,C109,C110,C112,C113 | 5 per board × 2 boards
Electronics | power-hub | 1u — Capacitor 1u 0603 | 4 | pcs | 0.013 | 0.05 | LCSC/JLCPCB | C15849 | CL10A105KB8NNNC | Samsung Electro-Mechanics | C115,C120 | 2 per board × 2 boards
Electronics | power-hub | SMAJ30A — TVS 30 V stand-off, 400 W (unidirectional): above a 28 V EPR contract | 2 | pcs | 0.0405 | 0.08 | LCSC/JLCPCB | C113965 | SMAJ30A | MDD | D1 | 1 per board × 2 boards
Electronics | power-hub | PD — green LED, side view 3 × 2 × 1 mm | 2 | pcs | 0.2208 | 0.44 | LCSC/JLCPCB | C598310 | KPA-3010CGCK | Kingbright | D3 | 1 per board × 2 boards
Electronics | power-hub | B5819W SL — 40 V 1 A Schottky | 4 | pcs | 0.0276 | 0.11 | LCSC/JLCPCB | C8598 | B5819W SL | Changjing | D4,D5 | 2 per board × 2 boards
Electronics | power-hub | CTL — green LED, side view 3 × 2 × 1 mm | 2 | pcs | 0.2208 | 0.44 | LCSC/JLCPCB | C598310 | KPA-3010CGCK | Kingbright | D8 | 1 per board × 2 boards
Electronics | power-hub | PESD2CAN,215 — CAN bus ESD protection, 24 V stand-off | 2 | pcs | 0.0718 | 0.14 | LCSC/JLCPCB | C75176 | PESD2CAN,215 | Nexperia | D9 | 1 per board × 2 boards
Electronics | power-hub | ON — green LED, side view 3 × 2 × 1 mm | 8 | pcs | 0.2208 | 1.77 | LCSC/JLCPCB | C598310 | KPA-3010CGCK | Kingbright | D11,D12,D13,D14 | 4 per board × 2 boards
Electronics | power-hub | FAULT — red LED, side view 3 × 2 × 1 mm | 8 | pcs | 0.1656 | 1.32 | LCSC/JLCPCB | C4555382 | KPA-3010SURCK | Kingbright | D21,D22,D23,D24 | 4 per board × 2 boards
Electronics | power-hub | BAT54S — dual Schottky in series: clamps a line to GND and +3V3 | 8 | pcs | 0.012 | 0.1 | LCSC/JLCPCB | C7420333 | BAT54S | hongjiacheng | D31,D32,D33,D34 | 4 per board × 2 boards
Electronics | power-hub | DFLS260-7 — 60 V 2 A Schottky, 0.62 V at 2 A | 8 | pcs | 0.3128 | 2.5 | LCSC/JLCPCB | C209346 | DFLS260-7 | Diodes Inc. | D41,D42,D43,D44 | 4 per board × 2 boards
Electronics | power-hub | PD IN — USB-C receptacle, USB 2.0, 16 pins, 5 A on VBUS | 2 | pcs | 0.8372 | 1.67 | LCSC/JLCPCB | C5184243 | USB4105-GF-A-120 | GCT | J1 | 1 per board × 2 boards
Electronics | power-hub | ROW A — JST PH 6-pin, side entry, SMD | 2 | pcs | 0.3588 | 0.72 | LCSC/JLCPCB | C265405 | S6B-PH-SM4-TB(LF)(SN) | JST | J2 | 1 per board × 2 boards
Electronics | power-hub | ROW B — JST PH 6-pin, side entry, SMD | 2 | pcs | 0.3588 | 0.72 | LCSC/JLCPCB | C265405 | S6B-PH-SM4-TB(LF)(SN) | JST | J3 | 1 per board × 2 boards
Electronics | power-hub | ROW C — JST PH 6-pin, side entry, SMD | 2 | pcs | 0.3588 | 0.72 | LCSC/JLCPCB | C265405 | S6B-PH-SM4-TB(LF)(SN) | JST | J4 | 1 per board × 2 boards
Electronics | power-hub | ROW D — JST PH 6-pin, side entry, SMD | 2 | pcs | 0.3588 | 0.72 | LCSC/JLCPCB | C265405 | S6B-PH-SM4-TB(LF)(SN) | JST | J5 | 1 per board × 2 boards
Electronics | power-hub | USB — USB-C receptacle, USB 2.0, 16 pins, 5 A on VBUS | 2 | pcs | 0.8372 | 1.67 | LCSC/JLCPCB | C5184243 | USB4105-GF-A-120 | GCT | J6 | 1 per board × 2 boards
Electronics | power-hub | 4.7u — 4.7 µH, 75 V, 10 A sat (−20 %), 5.5 A heat (ΔT 40 °C), 37 mΩ (40 max), molded | 2 | pcs | 0.6348 | 1.27 | LCSC/JLCPCB | C48009678 | IHLP2525CZEK4R7M01 | Vishay | L1 | 1 per board × 2 boards; alternative: IHLP2525CZER4R7M01 (C553961): the same part on a 2000-piece reel
Electronics | power-hub | 1k — Resistor 1k 0603 | 20 | pcs | 0.0017 | 0.03 | LCSC/JLCPCB | C21190 | 0603WAF1001T5E | UNI-ROYAL(Uniroyal Elec) | R2,R51,R52,R53,R54,R61,R62,R63,R64,R211 | 10 per board × 2 boards
Electronics | power-hub | 100k — Resistor 100k 0603 | 12 | pcs | 0.0029 | 0.03 | LCSC/JLCPCB | C25803 | 0603WAF1003T5E | UNI-ROYAL(Uniroyal Elec) | R3,R91,R92,R93,R94,R207 | 6 per board × 2 boards
Electronics | power-hub | 10k — Resistor 10k 0603 | 32 | pcs | 0.0048 | 0.15 | LCSC/JLCPCB | C25804 | 0603WAF1002T5E | UNI-ROYAL(Uniroyal Elec) | R4,R11,R71,R72,R73,R74,R81,R82,R83,R84,R101,R102,R103,R104,R209,R210 | 16 per board × 2 boards
Electronics | power-hub | 56 — Resistor 56 0603 | 10 | pcs | 0.0024 | 0.02 | LCSC/JLCPCB | C25196 | 0603WAF560JT5E | UNI-ROYAL(Uniroyal Elec) | R5,R215,R216,R217,R218 | 5 per board × 2 boards
Electronics | power-hub | 6.8k — Resistor 6.8k 0603 | 2 | pcs | 0.0021 | 0.0 | LCSC/JLCPCB | C23212 | 0603WAF6801T5E | UNI-ROYAL(Uniroyal Elec) | R6 | 1 per board × 2 boards
Electronics | power-hub | 5.1k — Resistor 5.1k 0603 | 10 | pcs | 0.0014 | 0.01 | LCSC/JLCPCB | C23186 | 0603WAF5101T5E | UNI-ROYAL(Uniroyal Elec) | R13,R14,R212,R213,R214 | 5 per board × 2 boards
Electronics | power-hub | 7.5k — Resistor 7.5k 0603 | 8 | pcs | 0.0017 | 0.01 | LCSC/JLCPCB | C23234 | 0603WAF7501T5E | UNI-ROYAL(Uniroyal Elec) | R21,R22,R23,R24 | 4 per board × 2 boards
Electronics | power-hub | 18k — Resistor 18k 0603 | 20 | pcs | 0.0037 | 0.07 | LCSC/JLCPCB | C25810 | 0603WAF1802T5E | UNI-ROYAL(Uniroyal Elec) | R31,R32,R33,R34,R41,R42,R43,R44,R206,R208 | 10 per board × 2 boards
Electronics | power-hub | 39k — Resistor 39k 0603 | 2 | pcs | 0.0021 | 0.0 | LCSC/JLCPCB | C23153 | 0603WAF3902T5E | UNI-ROYAL(Uniroyal Elec) | R205 | 1 per board × 2 boards
Electronics | power-hub | RESET — tactile switch 5.1 × 5.1 mm | 2 | pcs | 0.0184 | 0.04 | LCSC/JLCPCB | C318884 | TS-1187A-B-A-B | XKB | SW1 | 1 per board × 2 boards
Electronics | power-hub | BOOT — tactile switch 5.1 × 5.1 mm | 2 | pcs | 0.0184 | 0.04 | LCSC/JLCPCB | C318884 | TS-1187A-B-A-B | XKB | SW2 | 1 per board × 2 boards
Electronics | power-hub | CH224A — USB PD 3.2 sink controller (EPR 28 V, PPS/AVS), I2C, power-good output | 2 | pcs | 0.3956 | 0.79 | LCSC/JLCPCB | C42459160 | CH224A | WCH | U1 | 1 per board × 2 boards; alternative: CH224Q (C46061833, DFN-10-EP 2x2, the same family); the AP33772SDKZ-13-FA01 (C24374260, another board)
Electronics | power-hub | LMR51625YDDCR — 4.3–60 V 2.5 A synchronous buck, 1.1 MHz, PFM + spread spectrum | 2 | pcs | 1.0948 | 2.19 | LCSC/JLCPCB | C44991044 | LMR51625YDDCR | Texas Instruments | U2 | 1 per board × 2 boards; alternative: LMR51625YFDDCR (C45262768): same, forced PWM, no spread spectrum; LMR51635YDDCR (C45262770): 3.5 A, 3.3 µH
Electronics | power-hub | AP2112K-3.3TRG1 — 3.3 V 600 mA LDO, 250 mV dropout | 2 | pcs | 0.1564 | 0.31 | LCSC/JLCPCB | C51118 | AP2112K-3.3TRG1 | Diodes Incorporated | U3 | 1 per board × 2 boards
Electronics | power-hub | ESP32-S3-MINI-1-N8 — ESP32-S3 module, 8 MB flash, PCB antenna, USB OTG (full speed) | 2 | pcs | 4.3424 | 8.68 | LCSC/JLCPCB | C2913206 | ESP32-S3-MINI-1-N8 | Espressif | U4 | 1 per board × 2 boards
Electronics | power-hub | USBLC6-2SC6 — USB ESD protection | 2 | pcs | 0.1656 | 0.33 | LCSC/JLCPCB | C7519 | USBLC6-2SC6 | STMicroelectronics | U5 | 1 per board × 2 boards; alternative: C2687116 (UMW clone)
Electronics | power-hub | TJA1462AT — CAN FD SIC transceiver, VCC 5 V, VIO 2.95–5.5 V, bus pins −36/+40 V (MCP2562 pinout) | 2 | pcs | 0.9292 | 1.86 | LCSC/JLCPCB | C3234095 | TJA1462AT/0Z | NXP Semiconductors | U6 | 1 per board × 2 boards; alternative: Same pinout: TI TCAN1462VDRQ1 (C7399456, SIC, bus pins ±58 V; LCSC stock 0 on 2026-10-18 and 19) or TCAN1044AVDRQ1 (C3234993, no SIC, ±58 V)
Electronics | power-hub | TPS26600PWPR — 4.2–60 V 2.23 A eFuse | 8 | pcs | 1.4168 | 11.33 | LCSC/JLCPCB | C544399 | TPS26600PWPR | Texas Instruments | U11,U12,U13,U14 | 4 per board × 2 boards
Electronics | power-hub | Bare PCB power-hub (4-layer 76×100 mm (86×100 with JLC's rails), lead-free HASL) | 5 | pcs | 2.4288 | 12.14 | JLCPCB quote 2026-10-23 |  |  |  |  | special offer $8.00, lead-free HASL $5.20 = $13.20 for 5 PCBs, 2 of them assembled
Electronics | power-hub | Standard PCBA, 2 boards: setup, stencil, feeders, SMT, X-ray, packaging, special components | 1 | pcs | 84.37 | 84.37 | JLCPCB quote 2026-10-23, adjusted |  |  |  |  | setup $25.75, stencil $8.27, feeders $51.15, SMT $2.62, X-ray $3.30, packaging $0.50, special components $0.12; IHLP2525CZ for the FXL0630 (L1, 28 V EPR): 2 at JLC's price (+$1.19 components); rows C and D fitted: their eFuses, connectors and LEDs, 2 hubs at JLC's price (+$9.46 components); rows C and D fitted: their joints, 2 hubs (+$0.32 SMT); Standard because ESP32-S3-MINI-1-N8 cannot be placed with Economic PCBA
Electronics | power-hub | Components power-hub: JLC quote minus the catalogue prices above | 1 | pcs | 2.45 | 2.45 | JLCPCB quote 2026-10-23, adjusted |  |  |  |  | quoted components $40.41 + $10.65 since (≈ €46.98) for 2 boards; catalogue unit prices give €44.53
Electronics | data-port-x6 | 22u — Capacitor 22u 0805 | 80 | pcs | 0.1785 | 14.28 | LCSC/JLCPCB | C45783 | CL21A226MAQNNNE | Samsung Electro-Mechanics | C2,C3,C102,C202,C302,C402,C502,C602 | 8 per board × 10 boards
Electronics | data-port-x6 | 33p — Capacitor 33p 0402 | 20 | pcs | 0.0029 | 0.06 | LCSC/JLCPCB | C1562 | 0402CG330J500NT | FH (Guangdong Fenghua Advanced Tech) | C4,C5 | 2 per board × 10 boards
Electronics | data-port-x6 | 100n — Capacitor 100n 0402 | 230 | pcs | 0.0051 | 1.17 | LCSC/JLCPCB | C1525 | CL05B104KO5NNNC | Samsung Electro-Mechanics | C6,C9,C10,C11,C12,C13,C14,C15,C16,C17,C18,C103,C104,C203,C204,C303,C304,C403,C404,C503,C504,C603,C604 | 23 per board × 10 boards
Electronics | data-port-x6 | 4.7u — Capacitor 4.7u 0402 | 20 | pcs | 0.0104 | 0.21 | LCSC/JLCPCB | C23733 | CL05A475MP5NRNC | Samsung Electro-Mechanics | C7,C8 | 2 per board × 10 boards
Electronics | data-port-x6 | 33u — 33 µF 50 V aluminium electrolytic, 6.3 × 7.7 mm | 10 | pcs | 0.0543 | 0.54 | LCSC/JLCPCB | C240518 | VH1H330ME077000CE0 | Changzhou Huawei Electronics | C60 | 1 per board × 10 boards; alternative: Panasonic EEEFK1H330XP (C344076): 33 µF 50 V, 6.3 × 7.7 mm, 146 mA at 120 Hz; RVT1H330M0607 (C72509, JLC Standard PCBA only)
Electronics | data-port-x6 | 10u — Capacitor 10u 1206 | 40 | pcs | 0.2504 | 10.02 | LCSC/JLCPCB | C13585 | CL31A106KBHNNNE | Samsung Electro-Mechanics | C61,C62,C71,C72 | 4 per board × 10 boards
Electronics | data-port-x6 | 100n — Capacitor 100n 0603 | 40 | pcs | 0.0124 | 0.5 | LCSC/JLCPCB | C14663 | CC0603KRX7R9BB104 | YAGEO | C63,C64,C73,C74 | 4 per board × 10 boards
Electronics | data-port-x6 | 22u — Capacitor 22u 1206 | 60 | pcs | 0.1138 | 6.83 | LCSC/JLCPCB | C12891 | CL31A226KAHNNNE | Samsung Electro-Mechanics | C65,C66,C67,C75,C76,C77 | 6 per board × 10 boards
Electronics | data-port-x6 | 1u — Capacitor 1u 0402 | 60 | pcs | 0.0063 | 0.38 | LCSC/JLCPCB | C52923 | CL05A105KA5NQNC | Samsung Electro-Mechanics | C101,C201,C301,C401,C501,C601 | 6 per board × 10 boards
Electronics | data-port-x6 | KT-0805G — green LED 0805 | 60 | pcs | 0.0184 | 1.1 | LCSC/JLCPCB | C2297 | KT-0805G | Hubei KENTO | D101,D201,D301,D401,D501,D601 | 6 per board × 10 boards
Electronics | data-port-x6 | LEAD — JST PH 8-pin, vertical, through-hole | 10 | pcs | 0.0791 | 0.79 | LCSC (hand-solder, buy loose) | C157974 | B8B-PH-K-S(LF)(SN) | JST | J1 | 1 per board × 10 boards; hand-solder, buy loose (LCSC)
Electronics | data-port-x6 | PORT1 — USB-C receptacle, USB 2.0, 16 pins, vertical (top mount, 7.46 mm), 5 A on VBUS, 1.70 mm shell stakes | 10 | pcs | 0.9936 | 9.94 | LCSC/JLCPCB | C5181332 | USB4145-03-0170-C | GCT | J101 | 1 per board × 10 boards
Electronics | data-port-x6 | PORT2 — USB-C receptacle, USB 2.0, 16 pins, vertical (top mount, 7.46 mm), 5 A on VBUS, 1.70 mm shell stakes | 10 | pcs | 0.9936 | 9.94 | LCSC/JLCPCB | C5181332 | USB4145-03-0170-C | GCT | J201 | 1 per board × 10 boards
Electronics | data-port-x6 | PORT3 — USB-C receptacle, USB 2.0, 16 pins, vertical (top mount, 7.46 mm), 5 A on VBUS, 1.70 mm shell stakes | 10 | pcs | 0.9936 | 9.94 | LCSC/JLCPCB | C5181332 | USB4145-03-0170-C | GCT | J301 | 1 per board × 10 boards
Electronics | data-port-x6 | PORT4 — USB-C receptacle, USB 2.0, 16 pins, vertical (top mount, 7.46 mm), 5 A on VBUS, 1.70 mm shell stakes | 10 | pcs | 0.9936 | 9.94 | LCSC/JLCPCB | C5181332 | USB4145-03-0170-C | GCT | J401 | 1 per board × 10 boards
Electronics | data-port-x6 | PORT5 — USB-C receptacle, USB 2.0, 16 pins, vertical (top mount, 7.46 mm), 5 A on VBUS, 1.70 mm shell stakes | 10 | pcs | 0.9936 | 9.94 | LCSC/JLCPCB | C5181332 | USB4145-03-0170-C | GCT | J501 | 1 per board × 10 boards
Electronics | data-port-x6 | PORT6 — USB-C receptacle, USB 2.0, 16 pins, vertical (top mount, 7.46 mm), 5 A on VBUS, 1.70 mm shell stakes | 10 | pcs | 0.9936 | 9.94 | LCSC/JLCPCB | C5181332 | USB4145-03-0170-C | GCT | J601 | 1 per board × 10 boards
Electronics | data-port-x6 | 4.7u — 4.7 µH, 75 V, 10 A sat (−20 %), 5.5 A heat (ΔT 40 °C), 37 mΩ (40 max), molded | 20 | pcs | 0.6348 | 12.7 | LCSC/JLCPCB | C48009678 | IHLP2525CZEK4R7M01 | Vishay | L2,L3 | 2 per board × 10 boards; alternative: IHLP2525CZER4R7M01 (C553961): the same part on a 2000-piece reel
Electronics | data-port-x6 | 2N7002 — N-MOSFET 60 V (open-drain AUX outputs) | 20 | pcs | 0.0184 | 0.37 | LCSC/JLCPCB | C8545 | 2N7002 | CJ | Q1,Q2 | 2 per board × 10 boards
Electronics | data-port-x6 | 12k — Resistor 12k 0402 | 10 | pcs | 0.0017 | 0.02 | LCSC/JLCPCB | C25752 | 0402WGF1202TCE | UNI-ROYAL(Uniroyal Elec) | R1 | 1 per board × 10 boards
Electronics | data-port-x6 | 10k — Resistor 10k 0402 | 170 | pcs | 0.0014 | 0.24 | LCSC/JLCPCB | C25744 | 0402WGF1002TCE | UNI-ROYAL(Uniroyal Elec) | R3,R4,R5,R9,R51,R102,R103,R202,R203,R302,R303,R402,R403,R502,R503,R602,R603 | 17 per board × 10 boards
Electronics | data-port-x6 | 4.7k — Resistor 4.7k 0402 | 20 | pcs | 0.0019 | 0.04 | LCSC/JLCPCB | C25900 | 0402WGF4701TCE | UNI-ROYAL(Uniroyal Elec) | R6,R7 | 2 per board × 10 boards
Electronics | data-port-x6 | 1M — Resistor 1M 0402 | 10 | pcs | 0.0018 | 0.02 | LCSC/JLCPCB | C26083 | 0402WGF1004TCE | UNI-ROYAL(Uniroyal Elec) | R10 | 1 per board × 10 boards
Electronics | data-port-x6 | 100k — Resistor 100k 0402 | 10 | pcs | 0.0014 | 0.01 | LCSC/JLCPCB | C25741 | 0402WGF1003TCE | UNI-ROYAL(Uniroyal Elec) | R50 | 1 per board × 10 boards
Electronics | data-port-x6 | 100k — Resistor 100k 0603 | 20 | pcs | 0.0029 | 0.06 | LCSC/JLCPCB | C25803 | 0603WAF1003T5E | UNI-ROYAL(Uniroyal Elec) | R52,R54 | 2 per board × 10 boards
Electronics | data-port-x6 | 18.7k — Resistor 18.7k 0603 | 20 | pcs | 0.0 | 0.0 | LCSC/JLCPCB | C22893 | 0603WAF1872T5E | UNI-ROYAL(Uniroyal Elec) | R53,R55 | 2 per board × 10 boards
Electronics | data-port-x6 | 45.3k — Resistor 45.3k 0402 | 60 | pcs | 0.0 | 0.0 | LCSC/JLCPCB | C2933099 | FRC0402F4532TS | FOJAN | R101,R201,R301,R401,R501,R601 | 6 per board × 10 boards
Electronics | data-port-x6 | 56k — Resistor 56k 0402 | 120 | pcs | 0.0017 | 0.2 | LCSC/JLCPCB | C25796 | 0402WGF5602TCE | UNI-ROYAL(Uniroyal Elec) | R104,R105,R204,R205,R304,R305,R404,R405,R504,R505,R604,R605 | 12 per board × 10 boards
Electronics | data-port-x6 | 100m — 100 mΩ 1 % 0.25 W, as a current shunt | 60 | pcs | 0.0088 | 0.53 | LCSC/JLCPCB | C25334 | 1206W4F100LT5E | UNI-ROYAL(Uniroyal Elec) | R106,R206,R306,R406,R506,R606 | 6 per board × 10 boards
Electronics | data-port-x6 | 1k — Resistor 1k 0402 | 60 | pcs | 0.0012 | 0.07 | LCSC/JLCPCB | C11702 | 0402WGF1001TCE | UNI-ROYAL(Uniroyal Elec) | R114,R214,R314,R414,R514,R614 | 6 per board × 10 boards
Electronics | data-port-x6 | 10k — 4 × resistor array 0402, 5 % | 40 | pcs | 0.0 | 0.0 | LCSC/JLCPCB | C25725 | 4D02WGJ0103TCE | UNI-ROYAL(Uniroyal Elec) | RN1,RN2,RN3,RN10 | 4 per board × 10 boards
Electronics | data-port-x6 | USB2517I-JZX — USB 2.0 hub, 7 ports, one transaction translator per port (MTT), industrial | 10 | pcs | 4.1492 | 41.49 | LCSC/JLCPCB | C478081 | USB2517I-JZX | Microchip Tech | U1 | 1 per board × 10 boards
Electronics | data-port-x6 | TCA9535RTWR — 16-bit I2C I/O expander, push-pull outputs, open-drain INT, WQFN-24 4 × 4 | 10 | pcs | 1.1776 | 11.78 | LCSC/JLCPCB | C129354 | TCA9535RTWR | Texas Instruments | U2 | 1 per board × 10 boards
Electronics | data-port-x6 | AP2114H-3.3TRG1 — 3.3 V 1 A LDO, 450 mV dropout at 1 A, SOT-223 | 10 | pcs | 0.2116 | 2.12 | LCSC/JLCPCB | C150716 | AP2114H-3.3TRG1 | Diodes Incorporated | U3 | 1 per board × 10 boards
Electronics | data-port-x6 | H5VU25UC — 4-line ESD, 0.8 pF, 5 V stand-off, DFN2510-10L, flow-through (6, 7, 9, 10 NC inside; our copper joins each pair) | 10 | pcs | 0.0285 | 0.29 | LCSC/JLCPCB | C20615800 | H5VU25UC | hongjiacheng | U4 | 1 per board × 10 boards
Electronics | data-port-x6 | MAX809S — reset supervisor 2.93 V, ≥ 150 ms, push-pull active-low RESET, SOT-23 | 10 | pcs | 0.0386 | 0.39 | LCSC/JLCPCB | C347371 | MAX809S | UMW(Youtai Semiconductor Co., Ltd.) | U5 | 1 per board × 10 boards; alternative: MAX809STRG (onsemi, C9965, $0.36)
Electronics | data-port-x6 | LMR51625YDDCR — 4.3–60 V 2.5 A synchronous buck, 1.1 MHz, PFM + spread spectrum | 20 | pcs | 1.0948 | 21.9 | LCSC/JLCPCB | C44991044 | LMR51625YDDCR | Texas Instruments | U13,U14 | 2 per board × 10 boards; alternative: LMR51625YFDDCR (C45262768): same, forced PWM, no spread spectrum; LMR51635YDDCR (C45262770): 3.5 A, 3.3 µH
Electronics | data-port-x6 | TPS2553DBVR-1 — adjustable current-limited power switch, latch-off after 7.5 ms in limit | 60 | pcs | 0.2668 | 16.01 | LCSC/JLCPCB | C111738 | TPS2553DBVR-1 | Texas Instruments | U101,U201,U301,U401,U501,U601 | 6 per board × 10 boards
Electronics | data-port-x6 | INA226AIDGSR — 36 V current/voltage/power monitor, I2C | 60 | pcs | 0.69 | 41.4 | LCSC/JLCPCB | C49851 | INA226AIDGSR | Texas Instruments | U102,U202,U302,U402,U502,U602 | 6 per board × 10 boards
Electronics | data-port-x6 | USBLC6-2SC6 — USB ESD protection | 60 | pcs | 0.1656 | 9.94 | LCSC/JLCPCB | C7519 | USBLC6-2SC6 | STMicroelectronics | U103,U203,U303,U403,U503,U603 | 6 per board × 10 boards; alternative: C2687116 (UMW clone)
Electronics | data-port-x6 | X322524MSB4SI — 24 MHz crystal, 20 pF load, ±10 ppm, 3225 | 10 | pcs | 0.0874 | 0.87 | LCSC/JLCPCB | C15643 | X322524MSB4SI | YXC Crystal Oscillators | Y1 | 1 per board × 10 boards
Electronics | data-port-x6 | Bare PCB data-port-x6 (4-layer 100×70 mm, JLC04161H-7628, ENIG) | 10 | pcs | 2.9624 | 29.62 | estimate, not quoted |  |  |  |  | board $19.40, ENIG $12.80 = $32.20 for 10 PCBs, 10 of them assembled
Electronics | data-port-x6 | Economic PCBA, 10 boards: setup, stencil, extended parts, SMT, special components | 1 | pcs | 61.88 | 61.88 | estimate, not quoted |  |  |  |  | setup $8.24, stencil $1.55, extended parts $43.26, SMT $12.41, special components $1.80
Electronics | data-port-x6 | Components data-port-x6: JLC quote minus the catalogue prices above | 1 | pcs | -24.14 | -24.14 | estimate, not quoted |  |  |  |  | quoted components $251.99 (≈ €231.83) for 10 boards; catalogue unit prices give €255.97
Electronics | camera-pod | 10u — Capacitor 10u 0805 | 2 | pcs | 0.0403 | 0.08 | LCSC/JLCPCB | C15850 | CL21A106KAYNNNE | Samsung Electro-Mechanics | C1 | 1 per board × 2 boards
Electronics | camera-pod | 22u — Capacitor 22u 1206 | 2 | pcs | 0.1138 | 0.23 | LCSC/JLCPCB | C12891 | CL31A226KAHNNNE | Samsung Electro-Mechanics | C2 | 1 per board × 2 boards
Electronics | camera-pod | 100n — Capacitor 100n 0603 | 2 | pcs | 0.0124 | 0.02 | LCSC/JLCPCB | C14663 | CC0603KRX7R9BB104 | YAGEO | C3 | 1 per board × 2 boards
Electronics | camera-pod | XL-2835UWC-02 — LED white 6000–7500 K, 2835, 20–33 lm at 60 mA | 8 | pcs | 0.011 | 0.09 | LCSC/JLCPCB | C2843876 | XL-2835UWC-02 | XINGLIGHT | D1,D2,D3,D4 | 4 per board × 2 boards
Electronics | camera-pod | LEAD — JST PH 8-pin, side entry, SMD | 2 | pcs | 0.414 | 0.83 | LCSC/JLCPCB | C265121 | S8B-PH-SM4-TB(LF)(SN) | JST | J1 | 1 per board × 2 boards
Electronics | camera-pod | MEGA — pin header 1 × 6, 2.54 mm, SMD | 2 | pcs | 0.0736 | 0.15 | LCSC/JLCPCB | C41417363 | HX PZ2.54-1x6P TP-YQ | hanxia | J2 | 1 per board × 2 boards
Electronics | camera-pod | 100 — Resistor 100 0805 | 8 | pcs | 0.0039 | 0.03 | LCSC/JLCPCB | C17408 | 0805W8F1000T5E | UNI-ROYAL(Uniroyal Elec) | R1,R2,R3,R4 | 4 per board × 2 boards
Electronics | camera-pod | AP2114H-3.3TRG1 — 3.3 V 1 A LDO, 450 mV dropout at 1 A, SOT-223 | 2 | pcs | 0.2116 | 0.42 | LCSC/JLCPCB | C150716 | AP2114H-3.3TRG1 | Diodes Incorporated | U1 | 1 per board × 2 boards
Electronics | camera-pod | Bare PCB camera-pod (2-layer 40×27 mm, lead-free HASL) | 5 | pcs | 0.9384 | 4.69 | JLCPCB quote 2026-10-23 |  |  |  |  | special offer $4.00, lead-free HASL $1.10 = $5.10 for 5 PCBs, 2 of them assembled
Electronics | camera-pod | Economic PCBA, 2 boards: setup, stencil, extended parts, SMT, nitrogen reflow | 1 | pcs | 21.33 | 21.33 | JLCPCB quote 2026-10-23, adjusted |  |  |  |  | setup $8.24, stencil $1.55, extended parts $12.36, SMT $0.18, nitrogen reflow $0.86; AP2114H-3.3 for the AMS1117 (datasheet audit F1): its extended part type (+$3.09 extended parts); AP2114H-3.3 for the AMS1117: 2 at JLC's price (+$0.05 components)
Electronics | camera-pod | Components camera-pod: JLC quote minus the catalogue prices above | 1 | pcs | 0.11 | 0.11 | JLCPCB quote 2026-10-23, adjusted |  |  |  |  | quoted components $2.08 + $0.05 since (≈ €1.96) for 2 boards; catalogue unit prices give €1.85
Electronics | data-port-x4 | 22u — Capacitor 22u 0805 | 12 | pcs | 0.1785 | 2.14 | LCSC/JLCPCB | C45783 | CL21A226MAQNNNE | Samsung Electro-Mechanics | C2,C3,C102,C202,C302,C402 | 6 per board × 2 boards
Electronics | data-port-x4 | 33p — Capacitor 33p 0402 | 4 | pcs | 0.0029 | 0.01 | LCSC/JLCPCB | C1562 | 0402CG330J500NT | FH (Guangdong Fenghua Advanced Tech) | C4,C5 | 2 per board × 2 boards
Electronics | data-port-x4 | 100n — Capacitor 100n 0402 | 82 | pcs | 0.0051 | 0.42 | LCSC/JLCPCB | C1525 | CL05B104KO5NNNC | Samsung Electro-Mechanics | C6,C9,C10,C11,C12,C13,C14,C15,C16,C17,C18,C19,C20,C22,C23,C25,C29,C35,C36,C37,C38,C39,C40,C41,C42,C43,C44,C45,C46,C103,C104,C105,C203,C204,C205,C303,C304,C305,C403,C404,C405 | 41 per board × 2 boards
Electronics | data-port-x4 | 4.7u — Capacitor 4.7u 0402 | 10 | pcs | 0.0104 | 0.1 | LCSC/JLCPCB | C23733 | CL05A475MP5NRNC | Samsung Electro-Mechanics | C7,C8,C31,C34,C47 | 5 per board × 2 boards
Electronics | data-port-x4 | 1u — Capacitor 1u 0402 | 18 | pcs | 0.0063 | 0.11 | LCSC/JLCPCB | C52923 | CL05A105KA5NQNC | Samsung Electro-Mechanics | C21,C24,C26,C27,C28,C101,C201,C301,C401 | 9 per board × 2 boards
Electronics | data-port-x4 | 4.7u — Capacitor 4.7u 0402 | 4 | pcs | 0.0104 | 0.04 | LCSC/JLCPCB | C23733 | CL05A475MP5NRNC | Samsung Electro-Mechanics | C32,C33 | 2 per board × 2 boards
Electronics | data-port-x4 | 15p — Capacitor 15p 0402 | 4 | pcs | 0.0035 | 0.01 | LCSC/JLCPCB | C1548 | 0402CG150J500NT | FH (Guangdong Fenghua Advanced Tech) | C48,C49 | 2 per board × 2 boards
Electronics | data-port-x4 | 33u — 33 µF 50 V aluminium electrolytic, 6.3 × 7.7 mm | 2 | pcs | 0.0543 | 0.11 | LCSC/JLCPCB | C240518 | VH1H330ME077000CE0 | Changzhou Huawei Electronics | C60 | 1 per board × 2 boards; alternative: Panasonic EEEFK1H330XP (C344076): 33 µF 50 V, 6.3 × 7.7 mm, 146 mA at 120 Hz; RVT1H330M0607 (C72509, JLC Standard PCBA only)
Electronics | data-port-x4 | 10u — Capacitor 10u 1206 | 4 | pcs | 0.2504 | 1.0 | LCSC/JLCPCB | C13585 | CL31A106KBHNNNE | Samsung Electro-Mechanics | C61,C62 | 2 per board × 2 boards
Electronics | data-port-x4 | 100n — Capacitor 100n 0603 | 4 | pcs | 0.0124 | 0.05 | LCSC/JLCPCB | C14663 | CC0603KRX7R9BB104 | YAGEO | C63,C64 | 2 per board × 2 boards
Electronics | data-port-x4 | 22u — Capacitor 22u 1206 | 6 | pcs | 0.1138 | 0.68 | LCSC/JLCPCB | C12891 | CL31A226KAHNNNE | Samsung Electro-Mechanics | C65,C66,C67 | 3 per board × 2 boards
Electronics | data-port-x4 | KT-0805G — green LED 0805 | 10 | pcs | 0.0184 | 0.18 | LCSC/JLCPCB | C2297 | KT-0805G | Hubei KENTO | D1,D101,D201,D301,D401 | 5 per board × 2 boards
Electronics | data-port-x4 | GZ2012D601TF — ferrite bead 600 Ω @ 100 MHz, 500 mA, 0805 | 4 | pcs | 0.0184 | 0.07 | LCSC/JLCPCB | C1017 | GZ2012D601TF | Sunlord | FB1,FB2 | 2 per board × 2 boards
Electronics | data-port-x4 | LEAD — JST PH 8-pin, vertical, through-hole | 2 | pcs | 0.0791 | 0.16 | LCSC (hand-solder, buy loose) | C157974 | B8B-PH-K-S(LF)(SN) | JST | J1 | 1 per board × 2 boards; hand-solder, buy loose (LCSC)
Electronics | data-port-x4 | SWD — pin header 1 × 5, 2.54 mm, through-hole | 2 | pcs | 0.0359 | 0.07 | LCSC (hand-solder, buy loose) | C32713271 | HX PZ2.54-1x5P ZZ | hanxia | J2 | 1 per board × 2 boards; hand-solder, buy loose (LCSC)
Electronics | data-port-x4 | PORT1 — USB-C receptacle, USB 2.0, 16 pins, vertical (top mount, 7.46 mm), 5 A on VBUS, 1.70 mm shell stakes | 2 | pcs | 0.9936 | 1.99 | LCSC/JLCPCB | C5181332 | USB4145-03-0170-C | GCT | J101 | 1 per board × 2 boards
Electronics | data-port-x4 | PINS1 — pin header 2 × 6, 2.54 mm, through-hole, soldered by hand: Dupont jumpers to a DUT's pins | 2 | pcs | 0.0856 | 0.17 | LCSC (hand-solder, buy loose) | C32713279 | HX PZ2.54-2x6P ZZ | hanxia | J102 | 1 per board × 2 boards; hand-solder, buy loose (LCSC)
Electronics | data-port-x4 | PORT2 — USB-C receptacle, USB 2.0, 16 pins, vertical (top mount, 7.46 mm), 5 A on VBUS, 1.70 mm shell stakes | 2 | pcs | 0.9936 | 1.99 | LCSC/JLCPCB | C5181332 | USB4145-03-0170-C | GCT | J201 | 1 per board × 2 boards
Electronics | data-port-x4 | PINS2 — pin header 2 × 6, 2.54 mm, through-hole, soldered by hand: Dupont jumpers to a DUT's pins | 2 | pcs | 0.0856 | 0.17 | LCSC (hand-solder, buy loose) | C32713279 | HX PZ2.54-2x6P ZZ | hanxia | J202 | 1 per board × 2 boards; hand-solder, buy loose (LCSC)
Electronics | data-port-x4 | PORT3 — USB-C receptacle, USB 2.0, 16 pins, vertical (top mount, 7.46 mm), 5 A on VBUS, 1.70 mm shell stakes | 2 | pcs | 0.9936 | 1.99 | LCSC/JLCPCB | C5181332 | USB4145-03-0170-C | GCT | J301 | 1 per board × 2 boards
Electronics | data-port-x4 | PINS3 — pin header 2 × 6, 2.54 mm, through-hole, soldered by hand: Dupont jumpers to a DUT's pins | 2 | pcs | 0.0856 | 0.17 | LCSC (hand-solder, buy loose) | C32713279 | HX PZ2.54-2x6P ZZ | hanxia | J302 | 1 per board × 2 boards; hand-solder, buy loose (LCSC)
Electronics | data-port-x4 | PORT4 — USB-C receptacle, USB 2.0, 16 pins, vertical (top mount, 7.46 mm), 5 A on VBUS, 1.70 mm shell stakes | 2 | pcs | 0.9936 | 1.99 | LCSC/JLCPCB | C5181332 | USB4145-03-0170-C | GCT | J401 | 1 per board × 2 boards
Electronics | data-port-x4 | PINS4 — pin header 2 × 6, 2.54 mm, through-hole, soldered by hand: Dupont jumpers to a DUT's pins | 2 | pcs | 0.0856 | 0.17 | LCSC (hand-solder, buy loose) | C32713279 | HX PZ2.54-2x6P ZZ | hanxia | J402 | 1 per board × 2 boards; hand-solder, buy loose (LCSC)
Electronics | data-port-x4 | AOTA-B201610S3R3-101-T — 3.3 µH 2.4 A molded inductor, 0806, polarity dot on pad 1 (RP2350 core regulator) | 2 | pcs | 0.2576 | 0.52 | LCSC/JLCPCB | C42411119 | AOTA-B201610S3R3-101-T | Abracon LLC | L1 | 1 per board × 2 boards; alternative: LCSC stock low (1 on 2026-10-19): JLC Global Sourcing; YSMC201612H-3R3MB (C41405891, unmarked polarity) only at our own risk, per Raspberry Pi
Electronics | data-port-x4 | 3.3u — 3.3 µH, 75 V, 13.5 A sat (−20 %), 6 A heat, 28 / 30 mΩ, molded | 2 | pcs | 0.6532 | 1.31 | LCSC/JLCPCB | C506574 | IHLP2525CZER3R3M01 | Vishay Intertech | L2 | 1 per board × 2 boards
Electronics | data-port-x4 | 2N7002 — N-MOSFET 60 V (open-drain AUX outputs) | 4 | pcs | 0.0184 | 0.07 | LCSC/JLCPCB | C8545 | 2N7002 | CJ | Q1,Q2 | 2 per board × 2 boards
Electronics | data-port-x4 | 12k — Resistor 12k 0402 | 2 | pcs | 0.0017 | 0.0 | LCSC/JLCPCB | C25752 | 0402WGF1202TCE | UNI-ROYAL(Uniroyal Elec) | R1 | 1 per board × 2 boards
Electronics | data-port-x4 | 10k — Resistor 10k 0402 | 52 | pcs | 0.0014 | 0.07 | LCSC/JLCPCB | C25744 | 0402WGF1002TCE | UNI-ROYAL(Uniroyal Elec) | R3,R4,R5,R9,R11,R12,R20,R25,R40,R51,R102,R103,R112,R113,R202,R203,R212,R213,R302,R303,R312,R313,R402,R403,R412,R413 | 26 per board × 2 boards
Electronics | data-port-x4 | 4.7k — Resistor 4.7k 0402 | 4 | pcs | 0.0019 | 0.01 | LCSC/JLCPCB | C25900 | 0402WGF4701TCE | UNI-ROYAL(Uniroyal Elec) | R6,R7 | 2 per board × 2 boards
Electronics | data-port-x4 | 1M — Resistor 1M 0402 | 2 | pcs | 0.0018 | 0.0 | LCSC/JLCPCB | C26083 | 0402WGF1004TCE | UNI-ROYAL(Uniroyal Elec) | R10 | 1 per board × 2 boards
Electronics | data-port-x4 | 33 — Resistor 33 0402 | 2 | pcs | 0.001 | 0.0 | LCSC/JLCPCB | C25105 | 0402WGF330JTCE | UNI-ROYAL(Uniroyal Elec) | R21 | 1 per board × 2 boards
Electronics | data-port-x4 | 1k — Resistor 1k 0402 | 30 | pcs | 0.0012 | 0.04 | LCSC/JLCPCB | C11702 | 0402WGF1001TCE | UNI-ROYAL(Uniroyal Elec) | R22,R26,R27,R107,R108,R114,R207,R208,R214,R307,R308,R314,R407,R408,R414 | 15 per board × 2 boards
Electronics | data-port-x4 | 27 — Resistor 27 0402 | 4 | pcs | 0.0 | 0.0 | LCSC/JLCPCB | C25100 | 0402WGF270JTCE | UNI-ROYAL(Uniroyal Elec) | R23,R24 | 2 per board × 2 boards
Electronics | data-port-x4 | 100k — Resistor 100k 0402 | 30 | pcs | 0.0014 | 0.04 | LCSC/JLCPCB | C25741 | 0402WGF1003TCE | UNI-ROYAL(Uniroyal Elec) | R38,R41,R50,R109,R110,R115,R209,R210,R215,R309,R310,R315,R409,R410,R415 | 15 per board × 2 boards
Electronics | data-port-x4 | 47k — Resistor 47k 0402 | 2 | pcs | 0.0018 | 0.0 | LCSC/JLCPCB | C25792 | 0402WGF4702TCE | UNI-ROYAL(Uniroyal Elec) | R39 | 1 per board × 2 boards
Electronics | data-port-x4 | 100k — Resistor 100k 0603 | 2 | pcs | 0.0029 | 0.01 | LCSC/JLCPCB | C25803 | 0603WAF1003T5E | UNI-ROYAL(Uniroyal Elec) | R52 | 1 per board × 2 boards
Electronics | data-port-x4 | 18.7k — Resistor 18.7k 0603 | 2 | pcs | 0.0 | 0.0 | LCSC/JLCPCB | C22893 | 0603WAF1872T5E | UNI-ROYAL(Uniroyal Elec) | R53 | 1 per board × 2 boards
Electronics | data-port-x4 | 45.3k — Resistor 45.3k 0402 | 8 | pcs | 0.0 | 0.0 | LCSC/JLCPCB | C2933099 | FRC0402F4532TS | FOJAN | R101,R201,R301,R401 | 4 per board × 2 boards
Electronics | data-port-x4 | 56k — Resistor 56k 0402 | 16 | pcs | 0.0017 | 0.03 | LCSC/JLCPCB | C25796 | 0402WGF5602TCE | UNI-ROYAL(Uniroyal Elec) | R104,R105,R204,R205,R304,R305,R404,R405 | 8 per board × 2 boards
Electronics | data-port-x4 | 100m — 100 mΩ 1 % 0.25 W, as a current shunt | 8 | pcs | 0.0088 | 0.07 | LCSC/JLCPCB | C25334 | 1206W4F100LT5E | UNI-ROYAL(Uniroyal Elec) | R106,R206,R306,R406 | 4 per board × 2 boards
Electronics | data-port-x4 | 200k — Resistor 200k 0402 | 8 | pcs | 0.0016 | 0.01 | LCSC/JLCPCB | C25764 | 0402WGF2003TCE | UNI-ROYAL(Uniroyal Elec) | R111,R211,R311,R411 | 4 per board × 2 boards
Electronics | data-port-x4 | 10k — 4 × resistor array 0402, 5 % | 10 | pcs | 0.0 | 0.0 | LCSC/JLCPCB | C25725 | 4D02WGJ0103TCE | UNI-ROYAL(Uniroyal Elec) | RN1,RN2,RN3,RN8,RN9 | 5 per board × 2 boards
Electronics | data-port-x4 | 2.2k — 4 × resistor array 0402, 5 % | 4 | pcs | 0.0 | 0.0 | LCSC/JLCPCB | C26075 | 4D02WGJ0222TCE | UNI-ROYAL(Uniroyal Elec) | RN6,RN7 | 2 per board × 2 boards
Electronics | data-port-x4 | 100 — 4 × resistor array 0402, 5 % | 16 | pcs | 0.0 | 0.0 | LCSC/JLCPCB | C48442 | 4D02WGJ0101TCE | UNI-ROYAL(Uniroyal Elec) | RN101,RN102,RN201,RN202,RN301,RN302,RN401,RN402 | 8 per board × 2 boards
Electronics | data-port-x4 | USB2517I-JZX — USB 2.0 hub, 7 ports, one transaction translator per port (MTT), industrial | 2 | pcs | 4.1492 | 8.3 | LCSC/JLCPCB | C478081 | USB2517I-JZX | Microchip Tech | U1 | 1 per board × 2 boards
Electronics | data-port-x4 | TCA6408ARGTR — 8-bit I2C I/O expander, 5.5 V tolerant I/O, open-drain INT | 4 | pcs | 0.8096 | 3.24 | LCSC/JLCPCB | C181499 | TCA6408ARGTR | Texas Instruments | U2,U6 | 2 per board × 2 boards
Electronics | data-port-x4 | AP2114H-3.3TRG1 — 3.3 V 1 A LDO, 450 mV dropout at 1 A, SOT-223 | 2 | pcs | 0.2116 | 0.42 | LCSC/JLCPCB | C150716 | AP2114H-3.3TRG1 | Diodes Incorporated | U3 | 1 per board × 2 boards
Electronics | data-port-x4 | H5VU25UC — 4-line ESD, 0.8 pF, 5 V stand-off, DFN2510-10L, flow-through (6, 7, 9, 10 NC inside; our copper joins each pair) | 34 | pcs | 0.0285 | 0.97 | LCSC/JLCPCB | C20615800 | H5VU25UC | hongjiacheng | U4,U105,U106,U108,U109,U205,U206,U208,U209,U305,U306,U308,U309,U405,U406,U408,U409 | 17 per board × 2 boards
Electronics | data-port-x4 | MAX809S — reset supervisor 2.93 V, ≥ 150 ms, push-pull active-low RESET, SOT-23 | 2 | pcs | 0.0386 | 0.08 | LCSC/JLCPCB | C347371 | MAX809S | UMW(Youtai Semiconductor Co., Ltd.) | U5 | 1 per board × 2 boards; alternative: MAX809STRG (onsemi, C9965, $0.36)
Electronics | data-port-x4 | CH446Q — 8 × 16 analog crosspoint switch, 45–65 Ω at 12 V span, serial or parallel addressing | 4 | pcs | 1.4628 | 5.85 | LCSC/JLCPCB | C109471 | CH446Q | WCH(Jiangsu Qin Heng) | U7,U8 | 2 per board × 2 boards
Electronics | data-port-x4 | TPS60400DBVR — charge pump voltage inverter, 60 mA | 2 | pcs | 0.7268 | 1.45 | LCSC/JLCPCB | C9839 | TPS60400DBVR | Texas Instruments | U9 | 1 per board × 2 boards
Electronics | data-port-x4 | TCA9534APWR — 8-bit I2C I/O expander, push-pull outputs, A version (0x38–0x3F) | 2 | pcs | 1.2512 | 2.5 | LCSC/JLCPCB | C206010 | TCA9534APWR | Texas Instruments | U10 | 1 per board × 2 boards
Electronics | data-port-x4 | RP2350B — RP2350, no flash in the package, QFN-80 (48 GPIO) | 2 | pcs | 1.1776 | 2.36 | LCSC/JLCPCB | C42415655 | RP2350B | Raspberry Pi | U11 | 1 per board × 2 boards
Electronics | data-port-x4 | LMR51635YDDCR — 4.3–60 V 3.5 A synchronous buck, 1.1 MHz, PFM + spread spectrum | 2 | pcs | 1.7296 | 3.46 | LCSC/JLCPCB | C45262770 | LMR51635YDDCR | Texas Instruments | U13 | 1 per board × 2 boards; alternative: LMR51635YFDDCR (C44750836): same, forced PWM, no spread spectrum
Electronics | data-port-x4 | TPS2553DBVR-1 — adjustable current-limited power switch, latch-off after 7.5 ms in limit | 8 | pcs | 0.2668 | 2.13 | LCSC/JLCPCB | C111738 | TPS2553DBVR-1 | Texas Instruments | U101,U201,U301,U401 | 4 per board × 2 boards
Electronics | data-port-x4 | INA226AIDGSR — 36 V current/voltage/power monitor, I2C | 8 | pcs | 0.69 | 5.52 | LCSC/JLCPCB | C49851 | INA226AIDGSR | Texas Instruments | U102,U202,U302,U402 | 4 per board × 2 boards
Electronics | data-port-x4 | USBLC6-2SC6 — USB ESD protection | 8 | pcs | 0.1656 | 1.32 | LCSC/JLCPCB | C7519 | USBLC6-2SC6 | STMicroelectronics | U103,U203,U303,U403 | 4 per board × 2 boards; alternative: C2687116 (UMW clone)
Electronics | data-port-x4 | LSF0108RKSR — 8-bit passive FET level translator, auto-bidirectional, open drain and push-pull (TI's RKS VQFN-20 has the BQ pinout) | 8 | pcs | 1.0396 | 8.32 | LCSC/JLCPCB | C130008 | LSF0108RKSR | Texas Instruments | U107,U207,U307,U407 | 4 per board × 2 boards
Electronics | data-port-x4 | X322524MSB4SI — 24 MHz crystal, 20 pF load, ±10 ppm, 3225 | 2 | pcs | 0.0874 | 0.17 | LCSC/JLCPCB | C15643 | X322524MSB4SI | YXC Crystal Oscillators | Y1 | 1 per board × 2 boards
Electronics | data-port-x4 | ABM8-272-T3 — 12 MHz crystal, 10 pF load, 50 Ω ESR, ±30 ppm, 3225 | 2 | pcs | 0.598 | 1.2 | LCSC/JLCPCB | C20625731 | ABM8-272-T3 | Abracon LLC | Y2 | 1 per board × 2 boards
Electronics | data-port-x4-base | 22u — Capacitor 22u 0805 | 12 | pcs | 0.1785 | 2.14 | LCSC/JLCPCB | C45783 | CL21A226MAQNNNE | Samsung Electro-Mechanics | C2,C3,C102,C202,C302,C402 | 6 per board × 2 boards
Electronics | data-port-x4-base | 33p — Capacitor 33p 0402 | 4 | pcs | 0.0029 | 0.01 | LCSC/JLCPCB | C1562 | 0402CG330J500NT | FH (Guangdong Fenghua Advanced Tech) | C4,C5 | 2 per board × 2 boards
Electronics | data-port-x4-base | 100n — Capacitor 100n 0402 | 40 | pcs | 0.0051 | 0.2 | LCSC/JLCPCB | C1525 | CL05B104KO5NNNC | Samsung Electro-Mechanics | C6,C9,C10,C11,C12,C13,C14,C15,C16,C17,C18,C19,C103,C104,C203,C204,C303,C304,C403,C404 | 20 per board × 2 boards
Electronics | data-port-x4-base | 4.7u — Capacitor 4.7u 0402 | 4 | pcs | 0.0104 | 0.04 | LCSC/JLCPCB | C23733 | CL05A475MP5NRNC | Samsung Electro-Mechanics | C7,C8 | 2 per board × 2 boards
Electronics | data-port-x4-base | 33u — 33 µF 50 V aluminium electrolytic, 6.3 × 7.7 mm | 2 | pcs | 0.0543 | 0.11 | LCSC/JLCPCB | C240518 | VH1H330ME077000CE0 | Changzhou Huawei Electronics | C60 | 1 per board × 2 boards; alternative: Panasonic EEEFK1H330XP (C344076): 33 µF 50 V, 6.3 × 7.7 mm, 146 mA at 120 Hz; RVT1H330M0607 (C72509, JLC Standard PCBA only)
Electronics | data-port-x4-base | 10u — Capacitor 10u 1206 | 4 | pcs | 0.2504 | 1.0 | LCSC/JLCPCB | C13585 | CL31A106KBHNNNE | Samsung Electro-Mechanics | C61,C62 | 2 per board × 2 boards
Electronics | data-port-x4-base | 100n — Capacitor 100n 0603 | 4 | pcs | 0.0124 | 0.05 | LCSC/JLCPCB | C14663 | CC0603KRX7R9BB104 | YAGEO | C63,C64 | 2 per board × 2 boards
Electronics | data-port-x4-base | 22u — Capacitor 22u 1206 | 6 | pcs | 0.1138 | 0.68 | LCSC/JLCPCB | C12891 | CL31A226KAHNNNE | Samsung Electro-Mechanics | C65,C66,C67 | 3 per board × 2 boards
Electronics | data-port-x4-base | 1u — Capacitor 1u 0402 | 8 | pcs | 0.0063 | 0.05 | LCSC/JLCPCB | C52923 | CL05A105KA5NQNC | Samsung Electro-Mechanics | C101,C201,C301,C401 | 4 per board × 2 boards
Electronics | data-port-x4-base | KT-0805G — green LED 0805 | 8 | pcs | 0.0184 | 0.15 | LCSC/JLCPCB | C2297 | KT-0805G | Hubei KENTO | D101,D201,D301,D401 | 4 per board × 2 boards
Electronics | data-port-x4-base | LEAD — JST PH 8-pin, vertical, through-hole | 2 | pcs | 0.0791 | 0.16 | LCSC (hand-solder, buy loose) | C157974 | B8B-PH-K-S(LF)(SN) | JST | J1 | 1 per board × 2 boards; hand-solder, buy loose (LCSC)
Electronics | data-port-x4-base | PORT1 — USB-C receptacle, USB 2.0, 16 pins, vertical (top mount, 7.46 mm), 5 A on VBUS, 1.70 mm shell stakes | 2 | pcs | 0.9936 | 1.99 | LCSC/JLCPCB | C5181332 | USB4145-03-0170-C | GCT | J101 | 1 per board × 2 boards
Electronics | data-port-x4-base | PINS1 — pin header 2 × 6, 2.54 mm, through-hole, soldered by hand: Dupont jumpers to a DUT's pins | 2 | pcs | 0.0856 | 0.17 | LCSC (hand-solder, buy loose) | C32713279 | HX PZ2.54-2x6P ZZ | hanxia | J102 | 1 per board × 2 boards; hand-solder, buy loose (LCSC)
Electronics | data-port-x4-base | PORT2 — USB-C receptacle, USB 2.0, 16 pins, vertical (top mount, 7.46 mm), 5 A on VBUS, 1.70 mm shell stakes | 2 | pcs | 0.9936 | 1.99 | LCSC/JLCPCB | C5181332 | USB4145-03-0170-C | GCT | J201 | 1 per board × 2 boards
Electronics | data-port-x4-base | PINS2 — pin header 2 × 6, 2.54 mm, through-hole, soldered by hand: Dupont jumpers to a DUT's pins | 2 | pcs | 0.0856 | 0.17 | LCSC (hand-solder, buy loose) | C32713279 | HX PZ2.54-2x6P ZZ | hanxia | J202 | 1 per board × 2 boards; hand-solder, buy loose (LCSC)
Electronics | data-port-x4-base | PORT3 — USB-C receptacle, USB 2.0, 16 pins, vertical (top mount, 7.46 mm), 5 A on VBUS, 1.70 mm shell stakes | 2 | pcs | 0.9936 | 1.99 | LCSC/JLCPCB | C5181332 | USB4145-03-0170-C | GCT | J301 | 1 per board × 2 boards
Electronics | data-port-x4-base | PINS3 — pin header 2 × 6, 2.54 mm, through-hole, soldered by hand: Dupont jumpers to a DUT's pins | 2 | pcs | 0.0856 | 0.17 | LCSC (hand-solder, buy loose) | C32713279 | HX PZ2.54-2x6P ZZ | hanxia | J302 | 1 per board × 2 boards; hand-solder, buy loose (LCSC)
Electronics | data-port-x4-base | PORT4 — USB-C receptacle, USB 2.0, 16 pins, vertical (top mount, 7.46 mm), 5 A on VBUS, 1.70 mm shell stakes | 2 | pcs | 0.9936 | 1.99 | LCSC/JLCPCB | C5181332 | USB4145-03-0170-C | GCT | J401 | 1 per board × 2 boards
Electronics | data-port-x4-base | PINS4 — pin header 2 × 6, 2.54 mm, through-hole, soldered by hand: Dupont jumpers to a DUT's pins | 2 | pcs | 0.0856 | 0.17 | LCSC (hand-solder, buy loose) | C32713279 | HX PZ2.54-2x6P ZZ | hanxia | J402 | 1 per board × 2 boards; hand-solder, buy loose (LCSC)
Electronics | data-port-x4-base | 3.3u — 3.3 µH, 75 V, 13.5 A sat (−20 %), 6 A heat, 28 / 30 mΩ, molded | 2 | pcs | 0.6532 | 1.31 | LCSC/JLCPCB | C506574 | IHLP2525CZER3R3M01 | Vishay Intertech | L2 | 1 per board × 2 boards
Electronics | data-port-x4-base | 2N7002 — N-MOSFET 60 V (open-drain AUX outputs) | 4 | pcs | 0.0184 | 0.07 | LCSC/JLCPCB | C8545 | 2N7002 | CJ | Q1,Q2 | 2 per board × 2 boards
Electronics | data-port-x4-base | 12k — Resistor 12k 0402 | 2 | pcs | 0.0017 | 0.0 | LCSC/JLCPCB | C25752 | 0402WGF1202TCE | UNI-ROYAL(Uniroyal Elec) | R1 | 1 per board × 2 boards
Electronics | data-port-x4-base | 10k — Resistor 10k 0402 | 30 | pcs | 0.0014 | 0.04 | LCSC/JLCPCB | C25744 | 0402WGF1002TCE | UNI-ROYAL(Uniroyal Elec) | R3,R4,R5,R9,R11,R12,R51,R102,R103,R202,R203,R302,R303,R402,R403 | 15 per board × 2 boards
Electronics | data-port-x4-base | 4.7k — Resistor 4.7k 0402 | 4 | pcs | 0.0019 | 0.01 | LCSC/JLCPCB | C25900 | 0402WGF4701TCE | UNI-ROYAL(Uniroyal Elec) | R6,R7 | 2 per board × 2 boards
Electronics | data-port-x4-base | 1M — Resistor 1M 0402 | 2 | pcs | 0.0018 | 0.0 | LCSC/JLCPCB | C26083 | 0402WGF1004TCE | UNI-ROYAL(Uniroyal Elec) | R10 | 1 per board × 2 boards
Electronics | data-port-x4-base | 100k — Resistor 100k 0402 | 18 | pcs | 0.0014 | 0.03 | LCSC/JLCPCB | C25741 | 0402WGF1003TCE | UNI-ROYAL(Uniroyal Elec) | R50,R109,R110,R209,R210,R309,R310,R409,R410 | 9 per board × 2 boards
Electronics | data-port-x4-base | 100k — Resistor 100k 0603 | 2 | pcs | 0.0029 | 0.01 | LCSC/JLCPCB | C25803 | 0603WAF1003T5E | UNI-ROYAL(Uniroyal Elec) | R52 | 1 per board × 2 boards
Electronics | data-port-x4-base | 18.7k — Resistor 18.7k 0603 | 2 | pcs | 0.0 | 0.0 | LCSC/JLCPCB | C22893 | 0603WAF1872T5E | UNI-ROYAL(Uniroyal Elec) | R53 | 1 per board × 2 boards
Electronics | data-port-x4-base | 45.3k — Resistor 45.3k 0402 | 8 | pcs | 0.0 | 0.0 | LCSC/JLCPCB | C2933099 | FRC0402F4532TS | FOJAN | R101,R201,R301,R401 | 4 per board × 2 boards
Electronics | data-port-x4-base | 56k — Resistor 56k 0402 | 16 | pcs | 0.0017 | 0.03 | LCSC/JLCPCB | C25796 | 0402WGF5602TCE | UNI-ROYAL(Uniroyal Elec) | R104,R105,R204,R205,R304,R305,R404,R405 | 8 per board × 2 boards
Electronics | data-port-x4-base | 100m — 100 mΩ 1 % 0.25 W, as a current shunt | 8 | pcs | 0.0088 | 0.07 | LCSC/JLCPCB | C25334 | 1206W4F100LT5E | UNI-ROYAL(Uniroyal Elec) | R106,R206,R306,R406 | 4 per board × 2 boards
Electronics | data-port-x4-base | 1k — Resistor 1k 0402 | 24 | pcs | 0.0012 | 0.03 | LCSC/JLCPCB | C11702 | 0402WGF1001TCE | UNI-ROYAL(Uniroyal Elec) | R107,R108,R114,R207,R208,R214,R307,R308,R314,R407,R408,R414 | 12 per board × 2 boards
Electronics | data-port-x4-base | 10k — 4 × resistor array 0402, 5 % | 6 | pcs | 0.0 | 0.0 | LCSC/JLCPCB | C25725 | 4D02WGJ0103TCE | UNI-ROYAL(Uniroyal Elec) | RN1,RN2,RN3 | 3 per board × 2 boards
Electronics | data-port-x4-base | USB2517I-JZX — USB 2.0 hub, 7 ports, one transaction translator per port (MTT), industrial | 2 | pcs | 4.1492 | 8.3 | LCSC/JLCPCB | C478081 | USB2517I-JZX | Microchip Tech | U1 | 1 per board × 2 boards
Electronics | data-port-x4-base | TCA6408ARGTR — 8-bit I2C I/O expander, 5.5 V tolerant I/O, open-drain INT | 4 | pcs | 0.8096 | 3.24 | LCSC/JLCPCB | C181499 | TCA6408ARGTR | Texas Instruments | U2,U6 | 2 per board × 2 boards
Electronics | data-port-x4-base | AP2114H-3.3TRG1 — 3.3 V 1 A LDO, 450 mV dropout at 1 A, SOT-223 | 2 | pcs | 0.2116 | 0.42 | LCSC/JLCPCB | C150716 | AP2114H-3.3TRG1 | Diodes Incorporated | U3 | 1 per board × 2 boards
Electronics | data-port-x4-base | H5VU25UC — 4-line ESD, 0.8 pF, 5 V stand-off, DFN2510-10L, flow-through (6, 7, 9, 10 NC inside; our copper joins each pair) | 10 | pcs | 0.0285 | 0.29 | LCSC/JLCPCB | C20615800 | H5VU25UC | hongjiacheng | U4,U109,U209,U309,U409 | 5 per board × 2 boards
Electronics | data-port-x4-base | MAX809S — reset supervisor 2.93 V, ≥ 150 ms, push-pull active-low RESET, SOT-23 | 2 | pcs | 0.0386 | 0.08 | LCSC/JLCPCB | C347371 | MAX809S | UMW(Youtai Semiconductor Co., Ltd.) | U5 | 1 per board × 2 boards; alternative: MAX809STRG (onsemi, C9965, $0.36)
Electronics | data-port-x4-base | LMR51635YDDCR — 4.3–60 V 3.5 A synchronous buck, 1.1 MHz, PFM + spread spectrum | 2 | pcs | 1.7296 | 3.46 | LCSC/JLCPCB | C45262770 | LMR51635YDDCR | Texas Instruments | U13 | 1 per board × 2 boards; alternative: LMR51635YFDDCR (C44750836): same, forced PWM, no spread spectrum
Electronics | data-port-x4-base | TPS2553DBVR-1 — adjustable current-limited power switch, latch-off after 7.5 ms in limit | 8 | pcs | 0.2668 | 2.13 | LCSC/JLCPCB | C111738 | TPS2553DBVR-1 | Texas Instruments | U101,U201,U301,U401 | 4 per board × 2 boards
Electronics | data-port-x4-base | INA226AIDGSR — 36 V current/voltage/power monitor, I2C | 8 | pcs | 0.69 | 5.52 | LCSC/JLCPCB | C49851 | INA226AIDGSR | Texas Instruments | U102,U202,U302,U402 | 4 per board × 2 boards
Electronics | data-port-x4-base | USBLC6-2SC6 — USB ESD protection | 8 | pcs | 0.1656 | 1.32 | LCSC/JLCPCB | C7519 | USBLC6-2SC6 | STMicroelectronics | U103,U203,U303,U403 | 4 per board × 2 boards; alternative: C2687116 (UMW clone)
Electronics | data-port-x4-base | X322524MSB4SI — 24 MHz crystal, 20 pF load, ±10 ppm, 3225 | 2 | pcs | 0.0874 | 0.17 | LCSC/JLCPCB | C15643 | X322524MSB4SI | YXC Crystal Oscillators | Y1 | 1 per board × 2 boards
Electronics | data-port-x4-panel | Bare PCB data-port-x4-panel (4-layer 100×142 mm panel of a logic and a base, JLC04161H-7628, ENIG, mouse bites) | 5 | pcs | 9.568 | 47.84 | JLCPCB quote 2026-11-01 |  |  |  |  | engineering $25.00, ENIG $18.20, board $8.80 = $52.00 for 5 panels, 2 of them assembled
Electronics | data-port-x4-panel | Economic PCBA, 2 panels: setup, stencil, extended parts, SMT, special components | 1 | pcs | 83.9 | 83.9 | JLCPCB quote 2026-11-01, adjusted |  |  |  |  | setup $8.24, stencil $1.55, extended parts $74.16, SMT $6.77, special components $0.48; C60 (33 µF 50 V), Standard-only at JLC: 4 Economic ones at JLC's price (+$0.24 components); C60: its extended part type (+$3.09 extended parts); USB-C: GCT USB4145 for the HRO TYPE-C-31-D-06, 16 at JLC's price (+$14.90 components); R23/R24 27 Ω (C25100) for 22 Ω: its extended part type (+$3.09 extended parts); R53 18.7k (C22893) for 18k: its extended part type (+$3.09 extended parts)
Electronics | data-port-x4-panel | Components data-port-x4-panel: JLC quote minus the catalogue prices above | 1 | pcs | 4.31 | 4.31 | JLCPCB quote 2026-11-01, adjusted |  |  |  |  | quoted components $101.52 + $15.14 since (≈ €107.33) for 2 panels; catalogue unit prices give €103.02
Electronics | jlc | JLCPCB shipping: every board in one cart | 1 | pcs | 31.28 | 31.28 | JLCPCB |  |  |  |  | DHL ≈ $27–40 for the whole order (one shipment); import VAT extra
Printed parts | filament | PETG filament | 4.3 | kg | 20.0 | 86.0 | any |  |  |  |  | ≈3.9 kg estimated + 10 % waste, 243 parts
Printed parts | covers | Rear bay covers (optional) | 12 | pcs | 0 | 0.0 | printed |  |  |  |  | one per bay: cover_box4 over the standing DATA board; ≈373 g more PETG, not in the filament line
Fasteners |  | M3 heat-set insert, 5.7 mm (generic brass, Ruthex-compatible holes) | 158 | pcs | 0.03 | 4.74 | AliExpress (bulk) / Ruthex |  |  |  |  | per tray 4 node standoffs + 2 chain anchor (drawer bays); 4 under every bay's ceiling (a camera pod's mount); every drawer (or port block): 3 in its bosses, for the DATA board's cradle; power box: 4 hub standoffs
Fasteners |  | M3 square nut, DIN 562 (5.5 × 5.5 × 1.8) | 80 | pcs | 0.02 | 1.6 | AliExpress (bulk) |  |  |  |  | 4 in the rear edge of every base and row ladder, in pockets open to its face (the braces screw into them)
Fasteners |  | M3×8 pan head, Phillips (ISO 7045): rear braces, chain anchor, node PCB, power box lid, camera pods, the DATA board's cradle | 178 | pcs | 0.02 | 3.56 | AliExpress (bulk) |  |  |  |  | one M3 length everywhere: where it goes deeper than an insert, the insert's hole runs on past it (lib/common.scad › insert_hole(runout))
Fasteners |  | M3 male-female hex spacer, 12 mm + 6 mm thread, brass (≤ 5.5 mm AF) | 4 | pcs | 0.1 | 0.4 | AliExpress (bulk) |  |  |  |  | power box: through the hub's holes into the standoff inserts; the lid's M3×8 goes 5.6 mm into their tops (a female thread ≥ 6 mm deep)
Fasteners |  | PT 2.3×8 pan head, thread-forming for plastics (M2.3×8 "ST", head ≤ Ø4.5): every printed pilot. A drawer bay: the foot lock, 4 for the chain's end pieces, the guide lip's stop; a sled bay: its stop and 2 port-block locks (and 2 sled locks if fixed); every bay: 5 for the strip over its DATA board's receptacles (its cradle takes M3 × 8 into inserts), 2 that pull its front onto the drawer from inside | 153 | pcs | 0.02 | 3.06 | AliExpress (bulk, HZYUEGOU: M2.3×8 self-tapping pan head, stainless, ≈ €2.13 / 100) |  |  |  |  | pilots Ø1.9 (lib/common.scad › PT_PILOT), clearance Ø2.6; a PT 2.6's Ø5 head would rub the drawer's wall at the guide lips (lib/carrier.scad › LIP_SCREW, checked in SolidCraft)
Fasteners |  | M2×5 pan head, ISO 7045 (the front display: 4 through its frame into the module's stand-offs, from behind) | 48 | pcs | 0.02 | 0.96 | AliExpress (bulk) |  |  |  |  | the stand-offs' thread and depth aren't given (Waveshare 31122): check on arrival (config/rack.yaml › drawer.display.screw)
Fasteners |  | M2.5 washer, DIN 125 (chain end pieces: their tab holes can be 4.3 mm) | 44 | pcs | 0.01 | 0.44 | AliExpress (bulk)
Motion |  | Drag chain 7×7 mm, links open on both sides (outer 13.5 × 10.2 mm, R18), ≈ 180 mm per drawer with its two end pieces | 3 | m | 4.0 | 12.0 | Olimex DRAG-CHAIN-7X7 |  |  |  |  | open the links to lay the DATA lead in (its PH plugs, 12 mm wide, do not pass a 7×7 channel); Olimex publishes only the inner size: outer size and end holes from Electrokit 41017996, measure the bend radius and the end pieces on arrival (config/rack.yaml › chain)
Motion |  | End pieces for 7×7 chain (pair: tab with 2 holes 8 mm apart), the drawers beyond one pair per metre of chain | 8 | pcs | 2.17 | 17.36 | AliExpress 1005003181041939, "7x7mm" (or one more metre of chain per pair) |  |  |  |  | Olimex does not sell them alone; this generic chain ships with one pair per metre. The listing is for the non-opening 7×7 type: check one on the open links before buying the lot
Cables |  | JST PH 8-pin lead, pin n ↔ pin 9−n (flat, no twist), 50 cm, lot of 5 (DATA leads: node J7 → drag chain → DATA board; camera leads: node J6 → pod J1) | 3 | lot | 4.5 | 13.5 | AliExpress https://www.aliexpress.com/item/1005008045292937.html, "Same direction", 8P, Length50CM |  |  |  |  | 12 DATA + 2 camera leads; price interpolated from the 6-pin lots, not read: check the 8P lengths on the listing (45–50 cm). The DATA route is ≈ 38 cm plugs included (constant over the stroke); the spare goes in a wider bend between the node and the chain's fixed end (nothing moves there), never in front of the chain's moving end. A sled bay's route is ≈ 22 cm (no chain): the slack coiled in the plenum. On arrival: both plugs show the same face, pin 1 rings to pin 8; twist D+/D− (pins 3-4 at the node) by hand. Or crimp them: PHR-8 + 16 × SPH-002T-P0.5S, 24 AWG
Cables |  | JST PH pre-crimped lead ASPHSPH24K152, 152 mm, 24 AWG UL1007, SPH-002T-P0.5S at both ends (row cables: the 9 bay-to-bay jumpers, 6 a cable) | 58 | pcs | 0.266 | 15.43 | Digi-Key FR 455-3082-ND (or Mouser FR) |  |  |  |  | 9 × 6 and 4 spares; JST's own leads, so the gauge is right. Digi-Key FR delivers free from €75: order with something else, or pay its shipping
Cables |  | JST PH pre-crimped lead ASPHSPH24K305, 305 mm, 24 AWG UL1007, SPH-002T-P0.5S at both ends (row cables: the feed to row A, 6 a cable) | 8 | pcs | 0.44 | 3.52 | Digi-Key FR 455-3083-ND (or Mouser FR) |  |  |  |  | 1 × 6 and 2 spares; JST's own leads, so the gauge is right. Digi-Key FR delivers free from €75: order with something else, or pay its shipping
Cables |  | JST PH 6-pin housing PHR-6-R, red: a row cable's IN end (the node's J1) | 14 | pcs | 0.0451 | 0.63 | LCSC C495652 |  |  |  |  | 12 cables and 2 spares; the cable works either way round, the colours only make it readable (docs/cabling.md)
Cables |  | JST PH 6-pin housing PHR-6-BK, black: a row cable's OUT end (the node's J2, the hub's row outputs) | 14 | pcs | 0.0396 | 0.55 | LCSC C495651 |  |  |  |  | 12 cables and 2 spares
Cables |  | JST PH crimp contact SPH-002T-P0.5S, 24–30 AWG, insulation Ø 0.8–1.5 mm (the feeds JST's leads don't reach: row B (60 cm), row C (80 cm)) | 50 | pcs | 0.0083 | 0.41 | LCSC C111515 |  |  |  |  | 12 a feed, as many again to learn on: the first crimps go wrong
Cables |  | Wire, 24 AWG stranded, UL1007 (Ø ≈ 1.4 mm, within the contact's 1.5), black, 10 m (the crimped feeds) | 1 | spool | 4.0 | 4.0 | AliExpress (UL1007 24AWG) |  |  |  |  | ≈ 8.9 m. On arrival, strip one end, count the strands and measure one: 24 AWG is 7 × 0.20 mm, 11 × 0.16 or 19 × 0.12 (≈ 0.21 mm²); 7 × 0.16 is 26 AWG
Cables |  | Crimper for open-barrel contacts, 28–18 AWG (the crimped feeds' contacts) | 1 | pcs | 20.0 | 20.0 | IWISS SN-28B (or Engineer PA-09, ≈ €40) |  |  |  |  | a tool, bought once, for 24 contacts: the cheap ratchet one does, with a few practice crimps; the Engineer makes neater PH crimps if more cables come
Cables |  | Cable tie 2.5 × 100 mm: the row jumpers, 2 each, through the tray's two tie anchors at its front right (docs/cabling.md) | 18 | pcs | 0.02 | 0.36 | AliExpress (bulk)
Cables |  | USB-C straight ↔ USB-C 90°, 15 cm (DUT cable: BEAGLEPLAY, GIGA + display, WIO TERMINAL) | 3 | pcs | 3.69 | 11.07 | AliExpress 1005009683032517 (HDR Store, flat USB 2.0 cable, "Type-C-bend-straight", 15cm) |  |  |  |  | the straight end in the drawer, the bent one at the board, bent across its wide face (up / down); 4 wires, USB 2.0 data. Alternative: AliExpress 1005001325015941 (BESTAR, ADT-Link FPC, "T1-T2", 15CM, €6.79; titled USB 3.1, its photos show ADT's USB 2.0 boards). Not the OLAF "Elbow Straight C-C" (1005013255525639): its straight end is a round aluminium barrel, thicker than 6.5 mm by the photos
Cables |  | USB-C ↔ USB-C, straight, 15–20 cm (DUT cable: ESP32-C6, NANO MATTER, UNO R4, WIO TERMINAL, XIAO) | 13 | pcs | 3.69 | 47.97 | AliExpress 1005009683032517 (HDR Store, flat USB 2.0 cable, "straight-straight", 15cm) |  |  |  |  | straight at both ends, 15–20 cm. Alternative: AliExpress 1005001325015941 (BESTAR, ADT-Link FPC, "T1-T1", 15CM, €6.79)
Cables |  | USB-C ↔ USB-C, straight, 20 cm (DUT cable: UNO R4) | 1 | pcs | 4.09 | 4.09 | AliExpress 1005009683032517 (HDR Store, flat USB 2.0 cable, "straight-straight", 20cm) |  |  |  |  | straight at both ends. Alternative: AliExpress 1005001325015941 (BESTAR, ADT-Link FPC, "T1-T1", 20CM, €7.49)
Cables |  | USB-C straight ↔ micro-B straight, 25 cm, on a micro-B 90° adapter (DUT cable: NUCLEO-144, NUCLEO-64) | 2 | pcs | 4.39 | 8.78 | AliExpress 1005007989121951 (Waveshare, flat USB 2.0 cable, "Straight-Straight", 25cm) |  |  |  |  | the micro-B plug stands on the board's 90° adapter, the USB-C end straight in the drawer. Alternative: AliExpress 1005002786476442 (BESTAR, ADT-Link FPC, "T1B-W1", 25CM, €8.06). The HOQO listing of 2026-10-18 (2251832791887129) is no longer sold in France, and its USB-C end was bent
Cables |  | USB-C ↔ micro-B, straight, 15 cm (DUT cable: ESP32-S3, MICRO:BIT, NUCLEO-64, PICO 2) | 11 | pcs | 3.69 | 40.59 | AliExpress 1005007989121951 (Waveshare, flat USB 2.0 cable, "Straight-Straight", 15cm) |  |  |  |  | straight at both ends, a loop over the plate (a converted bay's Pico 2): 15 cm takes a seller's ±5 mm, 10 cm would have to be within 3. Alternative: AliExpress 1005002786476442 (BESTAR, ADT-Link FPC, "T1B-W1", 15CM, €6.99)
Cables |  | Micro-B 90° adapter, male → female, up and down, one of each per board | 4 | pcs | 1.0 | 4.0 | AliExpress (DIY-018, "UP" and "DOWN") |  |  |  |  | keep the one whose female faces up once plugged into the board (the cable's straight plug stands on it, its cable leaves upwards); the other is a spare
Analyzer |  | Raspberry Pi Pico 2 (RP2350), the logic analyzer in B3.3 | 1 | pcs | 5.5 | 5.5 | Raspberry Pi approved reseller (Kubii, The Pi Hut, Pimoroni) |  |  |  |  | an RP2350 A4 (marked on the chip): A2 has erratum E9 (an input released from high can stay at ≈ 2.1 V). gusmanb's LogicAnalyzer UF2, pinned in config/rack.yaml › analyzer
Analyzer |  | Dupont jumper wires, female–female, 10 cm, a 40-wire strip | 1 | pcs | 1.5 | 1.5 | AliExpress |  |  |  |  | its channels to the neighbours' pins, a GND beside each group; one wire, its far end cut, soldered to the Pico 2's BOOTSEL pad (TP6) for the port's BOOT pin
Cables |  | Dupont jumper wires, female–female, 20 cm, a 40-wire strip (DATA ×4 RESET/BOOT headers → the boards' pins: 1 wire) | 1 | pcs | 2.0 | 2.0 | AliExpress |  |  |  |  | the usual rainbow; GND black, RESET brown, BOOT green. The DATA ×4's 1 × 3 headers and the boards' pin headers are soldered by hand, pins up
Power |  | USB PD charger, 100 W (20 V × 5 A), single port (e.g. Anker Nano 100 W, A2679) | 1 | pcs | 46.0 | 46.0 | Anker (anker.com/fr) / UGREEN / any PD 100 W |  |  |  |  | dedicated to the rack: a multi-port charger may withdraw its full offer when something else is plugged in. Realistic load ≈ 35–40 W. At 20 V a row is capped at ≈ 32 W (its eFuse's 1.6 A), and the hub budgets the rows against the contract: it sheds rows before the charger trips. For racks full of hungry DUTs, a 140 W PD 3.1 EPR charger (28 V): no hardware change
Power |  | USB-C to USB-C cable, 5 A, e-marked (100 W or 240 W rated), 1–2 m | 1 | pcs | 12.0 | 12.0 | any (check the 5 A e-marker) |  |  |  |  | required for 100 W: above 3 A a charger only offers its full current through an e-marked 5 A cable (a 3 A one gives 60 W). A cable shipped with the charger and rated 100 W or more is one; 240 W rated for the 140 W EPR option
Cameras |  | Arducam Mega 3MP SPI camera, M12 version (B0434), 33 × 33 mm | 2 | pcs | 28.25 | 56.5 | Welectron (33.90 € TTC) / Arducam (≈ $30) / DigiKey |  |  |  |  | on arrival: its header's order (VCC GND SCK MISO MOSI CS) and its MISO high level when fed 5 V (≤ 3.6 V, or change R33 and fit R35 on the node)
Cameras |  | Arducam LN018 M12 lens (M40160M12), 1/4", 1.6 mm, 145° diagonal, 118° × 92° (the stock 90° is too narrow for a NUCLEO-144 / nRF DK) | 2 | pcs | 7.48 | 14.96 | Welectron (8.90 € TTC) |  |  |  |  | focus it on the first camera: a wide lens can need a shorter holder (bom/sourcing.md)
Cameras |  | Cable JST XH 2.54 6-pin → Dupont female, one 6-pin housing, 10–20 cm (the Mega → pod J2, VCC GND SCK MISO MOSI CS in order) | 2 | pcs | 0.5 | 1.0 | AliExpress |  |  |  |  | the Mega's own 6-pin cable does if it ends in Dupont sockets; J2's pins are named on the board, so the wires go on by name
Cameras |  | Pod hardware: 2 × PT 2.6×14 (the pod board, through the diffuser's posts), cable ties 2.5 × 100 (the lead: 1 at the tray's rear slot, 3 under the ceiling) | 2 | set | 0.3 | 0.6 | AliExpress (bulk)
