kartben/hw-testing-rack/bom/jlc-parts.md

# JLC parts: tier, stock and price at volume

Generated by `python tools/bom.py` from `electronics/lib/jlc_parts.json` (JLC's catalog of 2026-11-04, `tools/jlc_parts_snapshot.py`; prices LCSC's where the catalog has none).  Per rack: 12 bay-node, 1 power-hub, 1 data-port-x4, 1 data-port-x4-base, 10 data-port-x6, 2 camera-pod; JLC assembles at least 2 boards.  *Stock*: JLC's assembly stock against 10 racks' need of that part on every board (×: times over).  *Unit $*: at the break 1 / 5 / 10 racks reach.  *Tier*: JLC's parts library's (basic, preferred extended, extended); Economic PCBA loads basic and preferred parts free.

## bay-node

Parts per board at 1 / 5 / 10 racks (12 / 60 / 120 boards): $16.20 / $14.17 / $12.75.

| LCSC | Part | Qty | Tier | Stock (× 10 racks) | Unit $ 1 / 5 / 10 racks | Line $ at 10 |
|---|---|---:|---|---:|---|---:|
| C2913201 | ESP32-S3-WROOM-1-N8R8 | 1 | extended | 16,184 (135×) | 4.458 / 4.136 / 3.702 | 3.70 |
| C44991044 | LMR51625YDDCR | 1 | extended | 10,075 (31×) | 1.361 / 1.200 / 1.018 | 1.02 |
| C544399 | TPS26600PWPR | 1 | extended | 3,388 (21×) | 1.290 / 1.135 / 0.959 | 0.96 |
| C265405 | S6B-PH-SM4-TB(LF)(SN) | 3 | extended | 3,480 (9×) | 0.287 / 0.247 / 0.247 | 0.74 |
| C5184243 | USB4105-GF-A-120 | 1 | extended | 2,413 (17×) | 0.961 / 0.837 / 0.695 | 0.69 |
| C48009678 | IHLP2525CZEK4R7M01 | 1 | extended | 5,690 (17×) | 0.692 / 0.692 / 0.692 | 0.69 |
| C3234095 | TJA1462AT/0Z | 1 | extended | 10,079 (78×) | 0.826 / 0.721 / 0.617 | 0.62 |
| C7519 | USBLC6-2SC6 | 4 | extended | 28,498 (24×) | 0.182 / 0.119 / 0.119 | 0.48 |
| C12891 | CL31A226KAHNNNE | 5 | basic | 1,661,293 (1,249×) | 0.121 / 0.099 / 0.087 | 0.44 |
| C49851 | INA226AIDGSR | 1 | extended | 22,260 (28×) | 0.574 / 0.491 / 0.422 | 0.42 |
| C11355 | FSUSB42MUX | 2 | extended | 26,064 (109×) | 0.305 / 0.234 / 0.199 | 0.40 |
| C495548 | B8B-PH-SM4-TB(LF)(SN) | 1 | extended | 5,820 (48×) | 0.468 / 0.420 / 0.360 | 0.36 |
| C265121 | S8B-PH-SM4-TB(LF)(SN) | 1 | extended | 17,108 (122×) | 0.370 / 0.334 / 0.288 | 0.29 |
| C7503186 | SUD50P06-15(UMW) | 1 | extended | 49,435 (412×) | 0.363 / 0.284 / 0.284 | 0.28 |
| C209346 | DFLS260-7 | 1 | extended | 16,396 (102×) | 0.325 / 0.260 / 0.260 | 0.26 |
| C13585 | CL31A106KBHNNNE | 2 | basic | 3,041,879 (4,225×) | 0.143 / 0.115 / 0.115 | 0.23 |
| C150716 | AP2114H-3.3TRG1 | 1 | extended | 2,803 (11×) | 0.203 / 0.162 / 0.162 | 0.16 |
| C601102 | HoLR1206-1W-50mR-1%-75ppm | 1 | extended | 18,590 (155×) | 0.121 / 0.099 / 0.099 | 0.10 |
| C20987 | SMD1206P075TF | 1 | extended | 5,251 (44×) | 0.102 / 0.082 / 0.082 | 0.08 |
| C14663 | CC0603KRX7R9BB104 | 14 | basic | 38,288,364 (16,942×) | 0.008 / 0.006 / 0.005 | 0.08 |
| C52917434 | WS2812B-2020-V6 | 1 | extended | 796,766 (6,640×) | 0.092 / 0.074 / 0.074 | 0.07 |
| C20917 | AO3400A | 1 | basic | 910,025 (7,584×) | 0.090 / 0.072 / 0.072 | 0.07 |
| C28323 | CL21B105KBFNNNE | 2 | basic | 2,712,403 (7,978×) | 0.043 / 0.035 / 0.035 | 0.07 |
| C75176 | PESD2CAN,215 | 1 | extended | 15,587 (120×) | 0.077 / 0.061 / 0.061 | 0.06 |
| C78419 | SMBJ33A | 1 | extended | 4,005 (33×) | 0.074 / 0.074 / 0.060 | 0.06 |
| C3352 | RVT1H101M0810 | 1 | extended | 26,551 (204×) | 0.069 / 0.069 / 0.053 | 0.05 |
| C10096 | SN74LVC1G32DBVR | 1 | extended | 58,986 (492×) | 0.067 / 0.067 / 0.053 | 0.05 |
| C431540 | MSK12C02 | 1 | extended | 186,267 (1,552×) | 0.055 / 0.055 / 0.044 | 0.04 |
| C15850 | CL21A106KAYNNNE | 1 | basic | 7,752,660 (55,376×) | 0.043 / 0.043 / 0.043 | 0.04 |
| C8545 | 2N7002 | 2 | basic | 4,142,956 (8,631×) | 0.017 / 0.017 / 0.017 | 0.03 |
| C318884 | TS-1187A-B-A-B | 2 | basic | 1,015,666 (3,906×) | 0.021 / 0.021 / 0.016 | 0.03 |
| C7420333 | BAT54S | 2 | preferred | 728,855 (2,603×) | 0.013 / 0.013 / 0.013 | 0.03 |
| C25803 | 0603WAF1003T5E | 8 | basic | 16,976,842 (13,691×) | 0.003 / 0.003 / 0.003 | 0.02 |
| C43491 | BZT52C12 | 1 | extended | 210,450 (1,754×) | 0.021 / 0.021 / 0.021 | 0.02 |
| C25804 | 0603WAF1002T5E | 10 | basic | 45,230,983 (33,258×) | 0.002 / 0.002 / 0.002 | 0.02 |
| C15849 | CL10A105KB8NNNC | 1 | basic | 12,297,342 (87,838×) | 0.015 / 0.015 / 0.015 | 0.01 |
| C23140 | 0603WAF330JT5E | 5 | basic | 3,932,222 (6,554×) | 0.002 / 0.002 / 0.002 | 0.01 |
| C25810 | 0603WAF1802T5E | 2 | basic | 754,216 (1,397×) | 0.004 / 0.004 / 0.004 | 0.01 |
| C21122 | CL10B223KB8NNNC | 1 | basic | 872,144 (7,268×) | 0.006 / 0.006 / 0.006 | 0.01 |
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
| C15850 | CL21A106KAYNNNE | 1 | basic | 7,752,660 (55,376×) | 0.043 / 0.043 / 0.043 | 0.04 |
| C17408 | 0805W8F1000T5E | 4 | basic | 7,545,005 (94,313×) | 0.004 / 0.004 / 0.004 | 0.02 |
| C14663 | CC0603KRX7R9BB104 | 1 | basic | 38,288,364 (16,942×) | 0.008 / 0.008 / 0.008 | 0.01 |
