kartben/hw-testing-rack/mechanical/stl/x4_cradle.stl

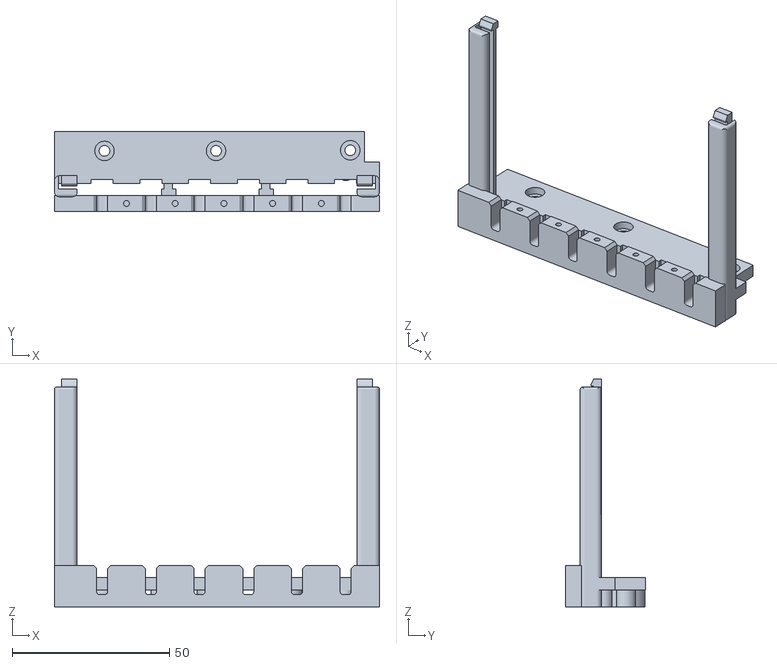
[picture p97: CAD file, 2026-11-02]
mechanical/stl/x4_cradle.stl
103.4 x 25.5 x 72.4
