kartben/hw-testing-rack/mechanical/stl/standalone_quad_base.stl

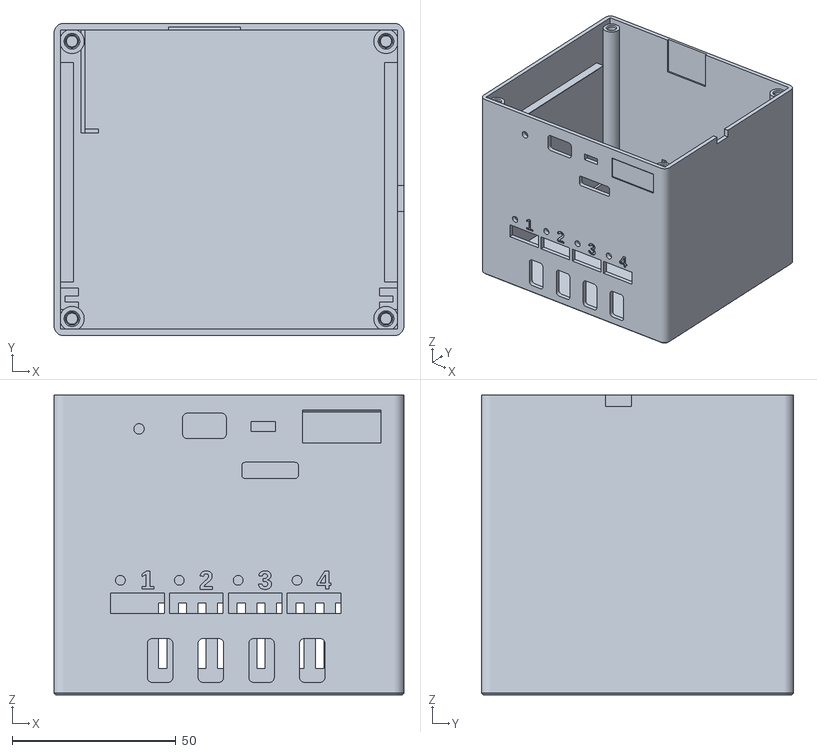
[picture p98: CAD file, 2026-11-02]
mechanical/stl/standalone_quad_base.stl
107.0 x 95.5 x 91.6
