kartben/hw-testing-rack/mechanical/stl/x4_strip.stl

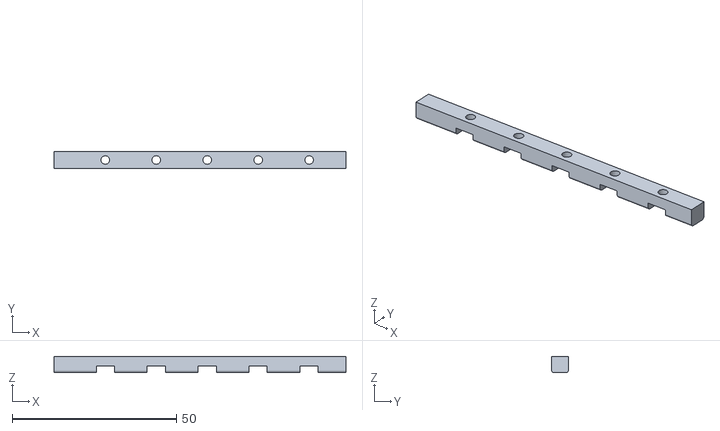
[picture p99: CAD file, 2026-11-02]
mechanical/stl/x4_strip.stl
88.8 x 5.16 x 5.00
