kartben/hw-testing-rack/mechanical/stl/bay_label_c3_inlay.stl

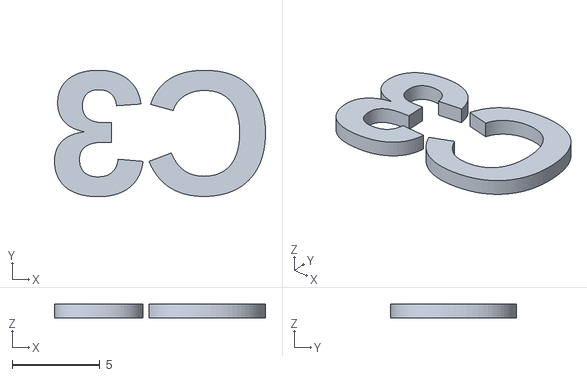
[picture p100: CAD file, 2026-11-01]
mechanical/stl/bay_label_c3_inlay.stl
12.0 x 7.19 x 0.8
