kartben/hw-testing-rack/mechanical/stl/bay_label_c1_inlay.stl

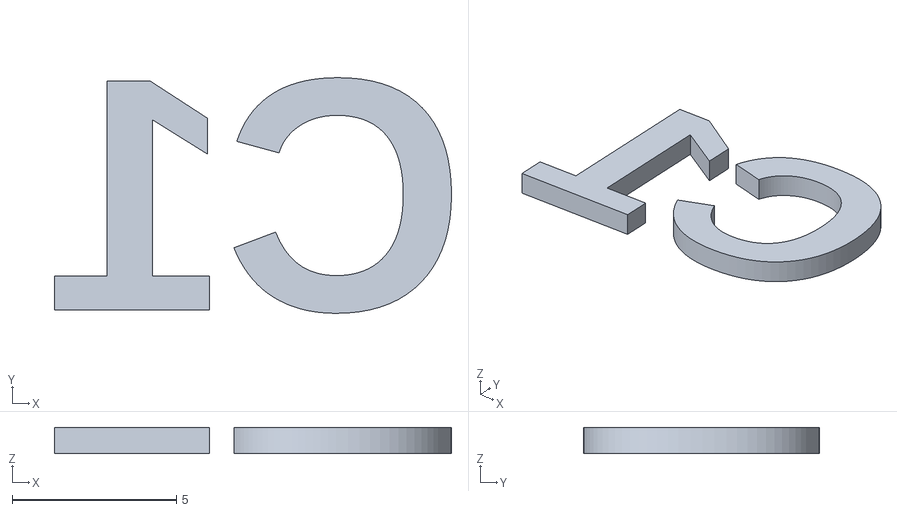
[picture p101: CAD file, 2026-11-01]
mechanical/stl/bay_label_c1_inlay.stl
12.1 x 7.18 x 0.8
