kartben/hw-testing-rack/mechanical/stl/bay_label_c3.stl

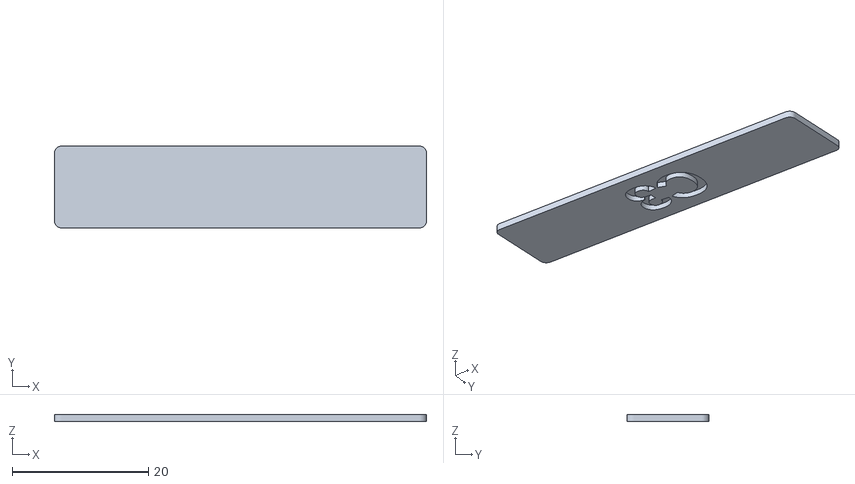
[picture p102: CAD file, 2026-11-01]
mechanical/stl/bay_label_c3.stl
54.7 x 12.0 x 1.00
