kartben/hw-testing-rack/mechanical/stl/ladder_c.stl

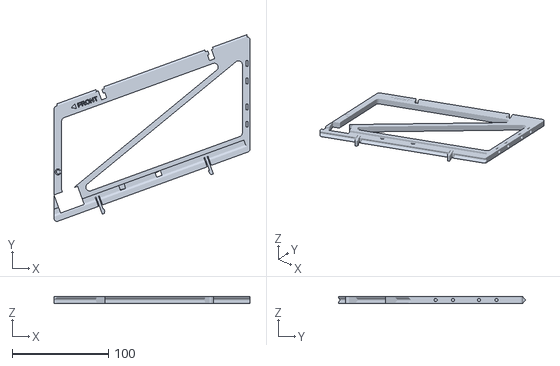
[picture p103: CAD file, 2026-11-01]
mechanical/stl/ladder_c.stl
203.3 x 193.8 x 7.40
