kartben/hw-testing-rack/mechanical/stl/ladder_cap.stl

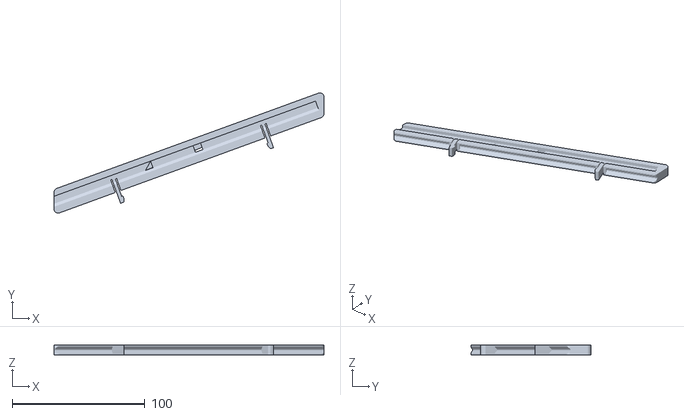
[picture p104: CAD file, 2026-11-01]
mechanical/stl/ladder_cap.stl
203.3 x 90.6 x 7.40
