kartben/hw-testing-rack/mechanical/stl/brace_c.stl

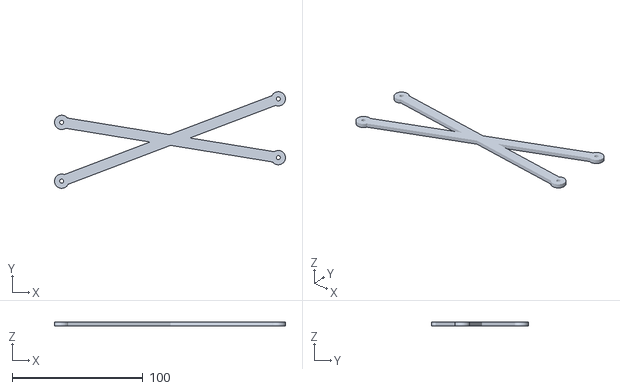
[picture p105: CAD file, 2026-11-01]
mechanical/stl/brace_c.stl
176.6 x 73.9 x 3.00
