kartben/hw-testing-rack/mechanical/stl/slot_bin.stl

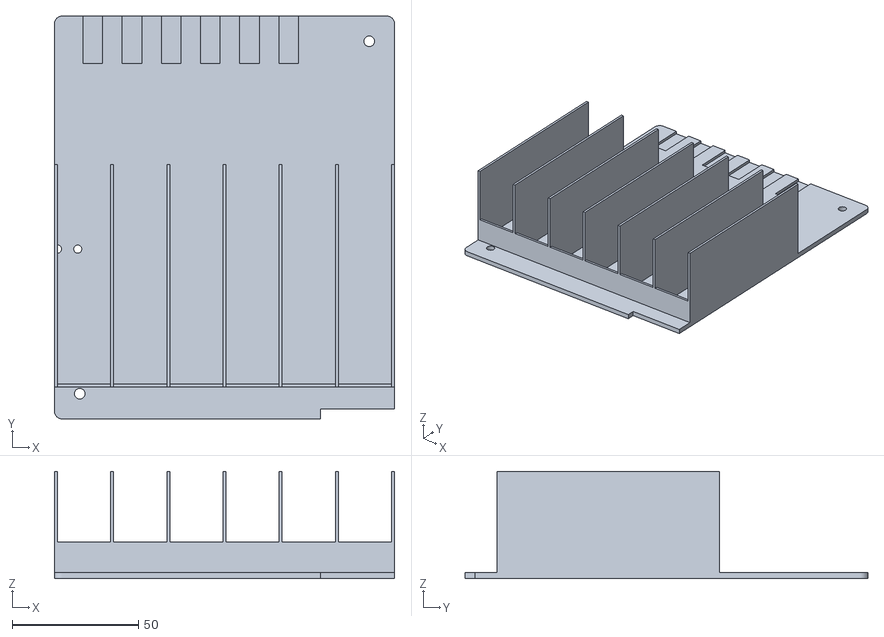
[picture p106: CAD file, 2026-11-01]
mechanical/stl/slot_bin.stl
134.5 x 159.4 x 42.4
