kartben/hw-testing-rack/mechanical/stl/plate.stl

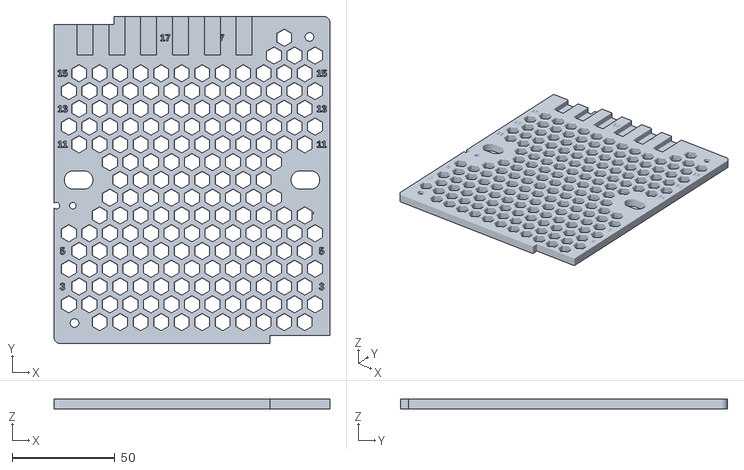
[picture p107: CAD file, 2026-11-01]
mechanical/stl/plate.stl
134.5 x 159.4 x 5.00
