kartben/hw-testing-rack/mechanical/stl/plate_giga-r1-display.stl

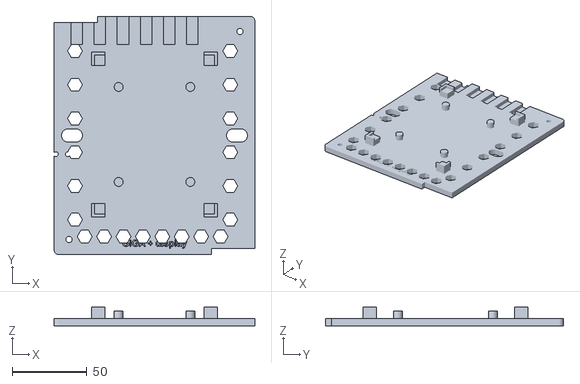
[picture p108: CAD file, 2026-11-01]
mechanical/stl/plate_giga-r1-display.stl
134.5 x 159.4 x 12.4
