kartben/hw-testing-rack/mechanical/stl/standalone_solo_base.stl

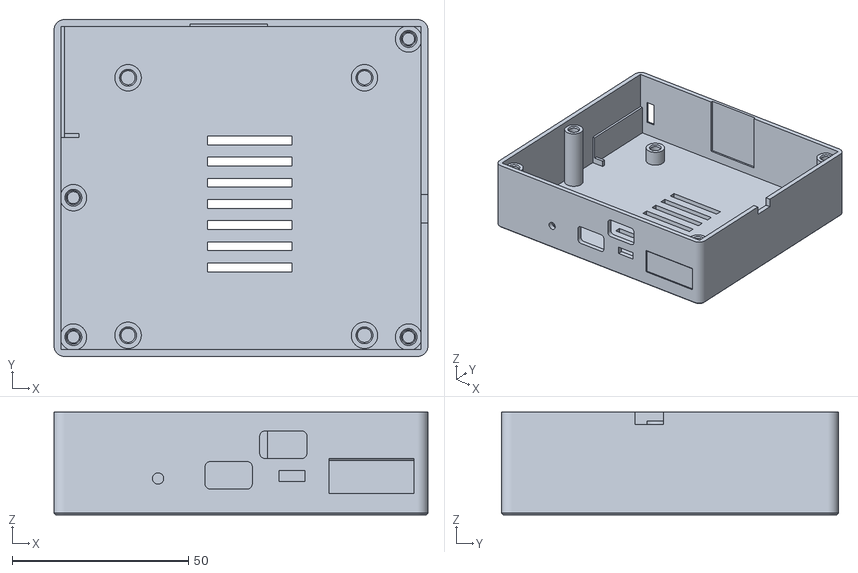
[picture p109: CAD file, 2026-11-01]
mechanical/stl/standalone_solo_base.stl
106.0 x 95.5 x 29.1
