kartben/hw-testing-rack/mechanical/stl/tray.stl

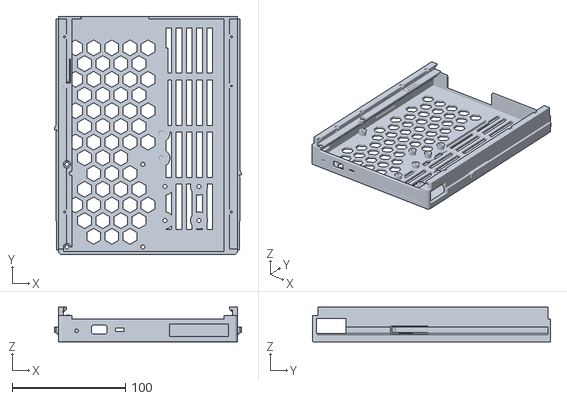
[picture p110: CAD file, 2026-11-01]
mechanical/stl/tray.stl
165.0 x 210.0 x 30.5
