kartben/hw-testing-rack/mechanical/stl/cover_box4.stl

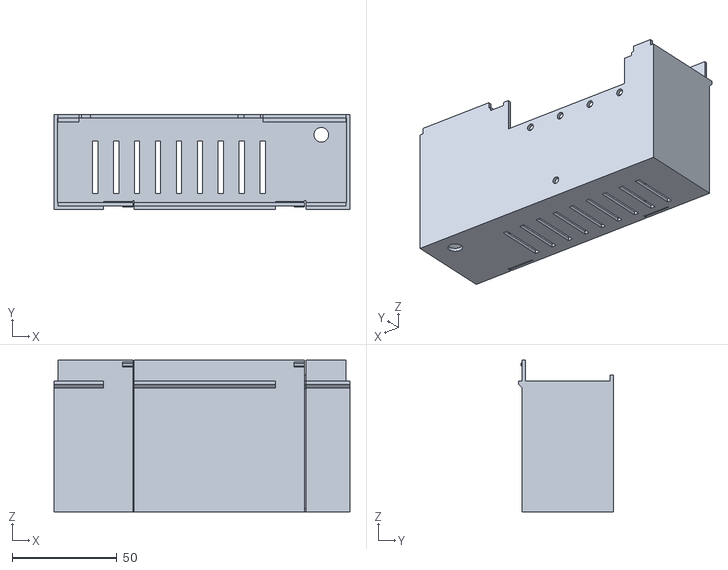
[picture p111: CAD file, 2026-11-01]
mechanical/stl/cover_box4.stl
141.4 x 45.4 x 72.5
