kartben/hw-testing-rack/mechanical/stl/drawer_block.stl

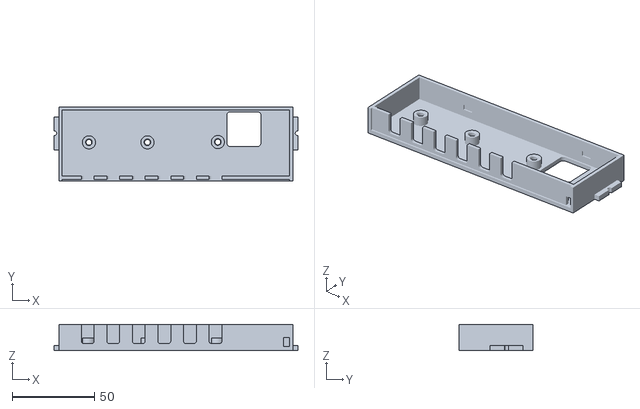
[picture p112: CAD file, 2026-11-01]
mechanical/stl/drawer_block.stl
148.0 x 45.0 x 16.0
