kartben/hw-testing-rack/mechanical/stl/drawer.stl

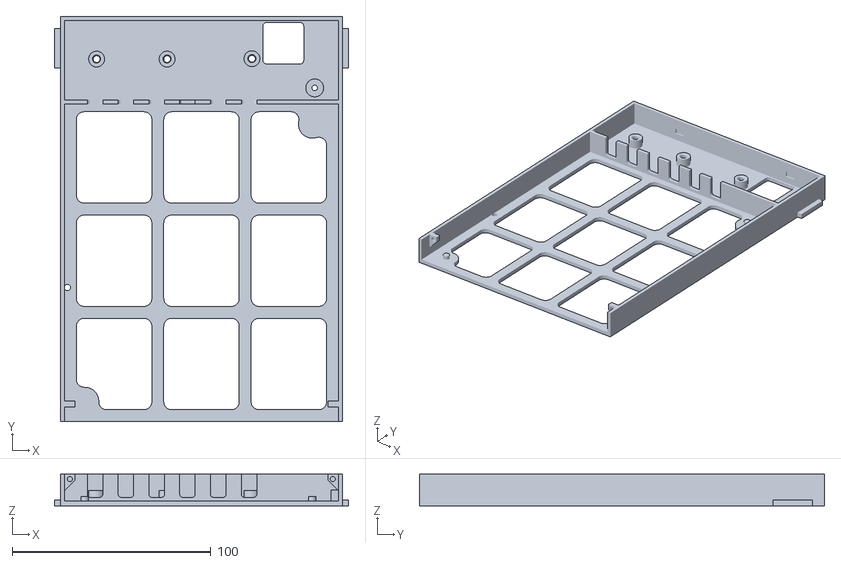
[picture p113: CAD file, 2026-11-01]
mechanical/stl/drawer.stl
148.0 x 204.0 x 16.0
