kartben/hw-testing-rack/mechanical/stl/bay_label_b4_inlay.stl

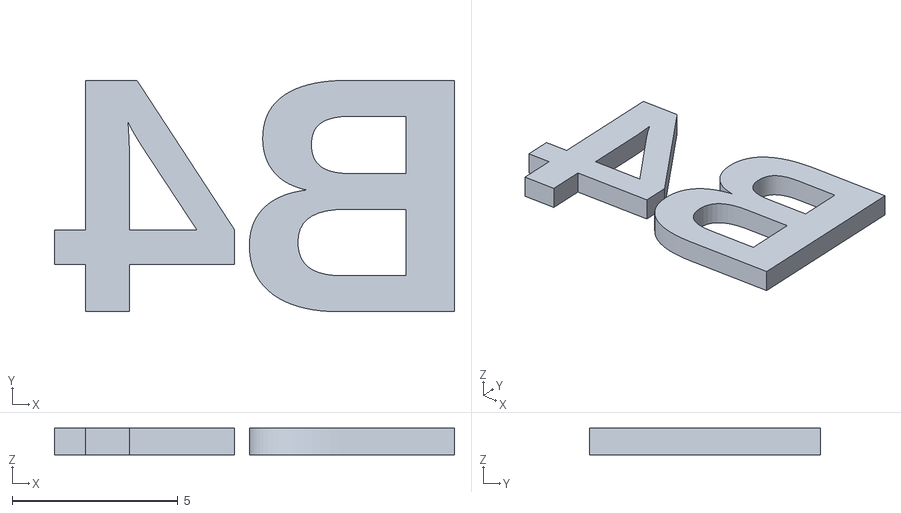
[picture p114: CAD file, 2026-10-27]
mechanical/stl/bay_label_b4_inlay.stl
12.1 x 6.97 x 0.8
