kartben/hw-testing-rack/mechanical/stl/bay_label_b3_inlay.stl

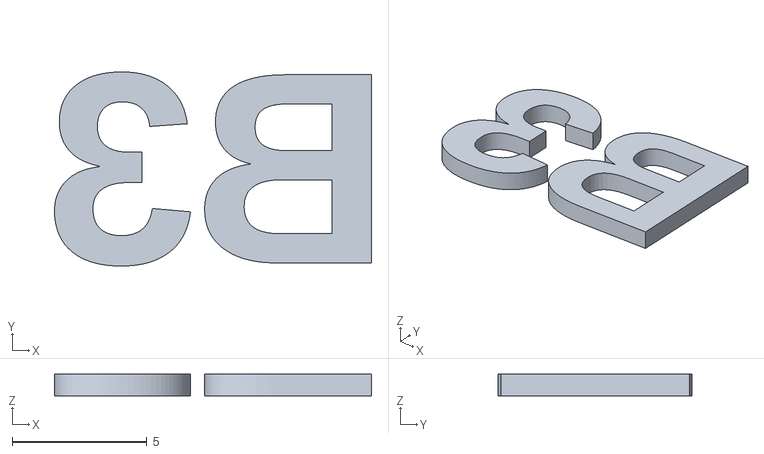
[picture p115: CAD file, 2026-10-27]
mechanical/stl/bay_label_b3_inlay.stl
11.7 x 7.19 x 0.8
