kartben/hw-testing-rack/mechanical/stl/bay_label_a1_inlay.stl

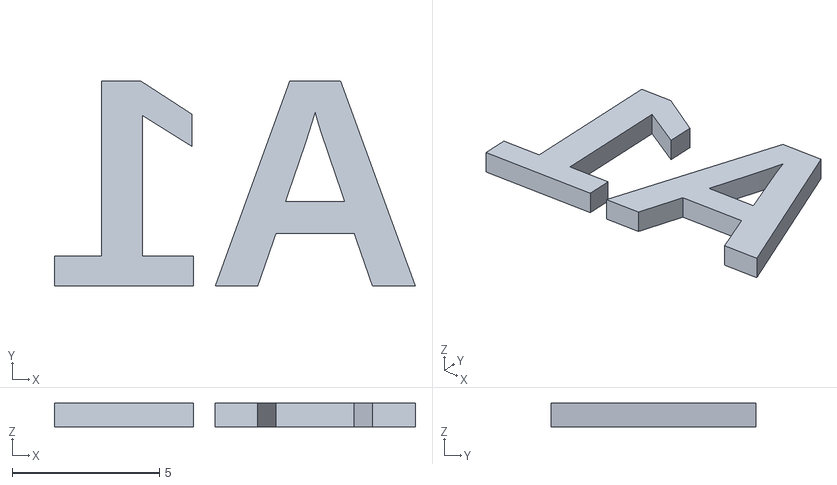
[picture p116: CAD file, 2026-10-27]
mechanical/stl/bay_label_a1_inlay.stl
12.3 x 6.97 x 0.8
