kartben/hw-testing-rack/mechanical/stl/drawer_sled.stl

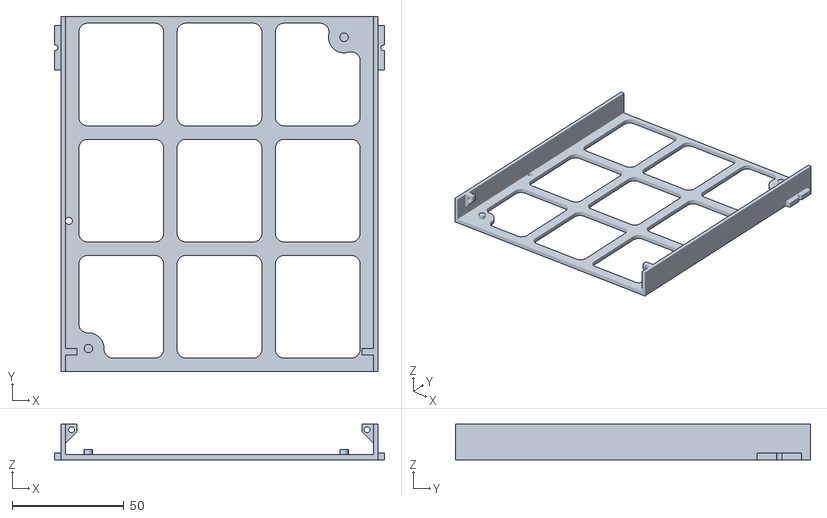
[picture p117: CAD file, 2026-10-27]
mechanical/stl/drawer_sled.stl
148.0 x 159.0 x 16.0
