kartben/hw-testing-rack/mechanical/stl/standalone_desk_frame.stl

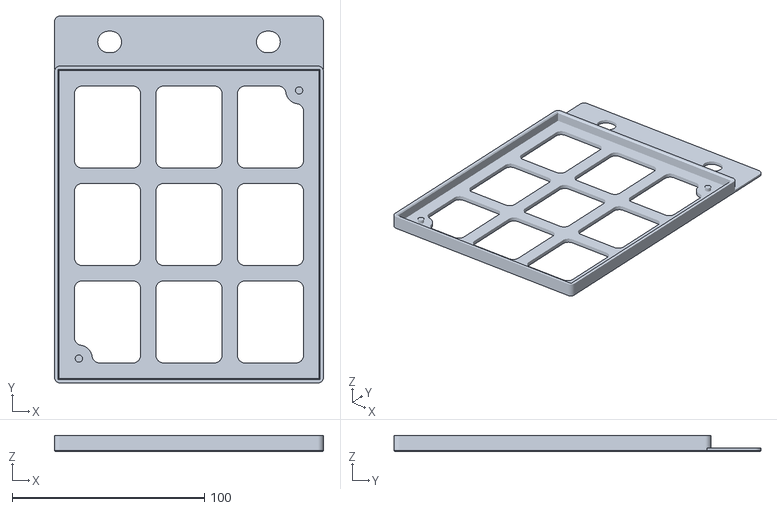
[picture p118: CAD file, 2026-10-27]
mechanical/stl/standalone_desk_frame.stl
139.9 x 190.8 x 8.50
