kartben/hw-testing-rack/mechanical/stl/bay_label_a4_inlay.stl

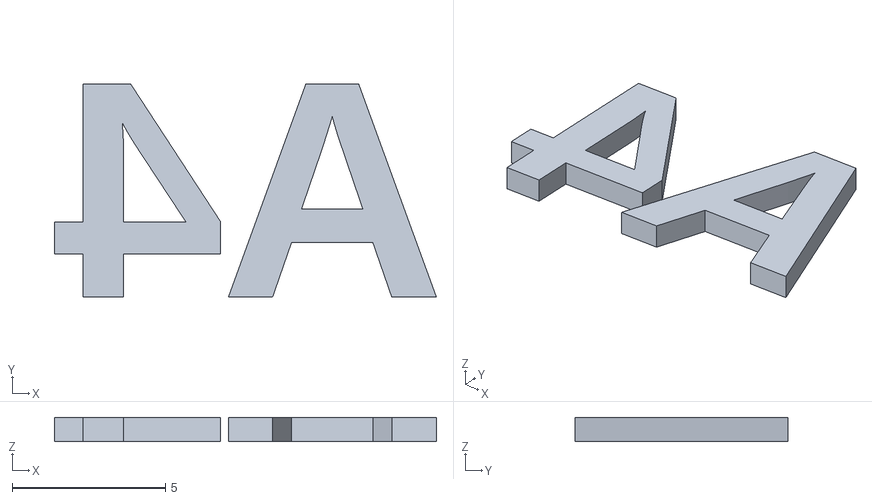
[picture p119: CAD file, 2026-10-27]
mechanical/stl/bay_label_a4_inlay.stl
12.5 x 6.97 x 0.8
