kartben/hw-testing-rack/mechanical/stl/bay_label_b2_inlay.stl

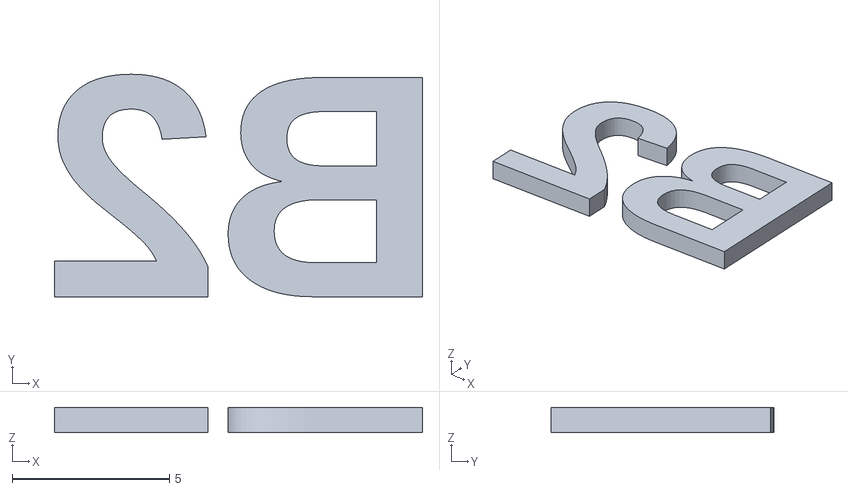
[picture p120: CAD file, 2026-10-27]
mechanical/stl/bay_label_b2_inlay.stl
11.7 x 7.08 x 0.8
