kartben/hw-testing-rack/mechanical/stl/bay_label_a2_inlay.stl

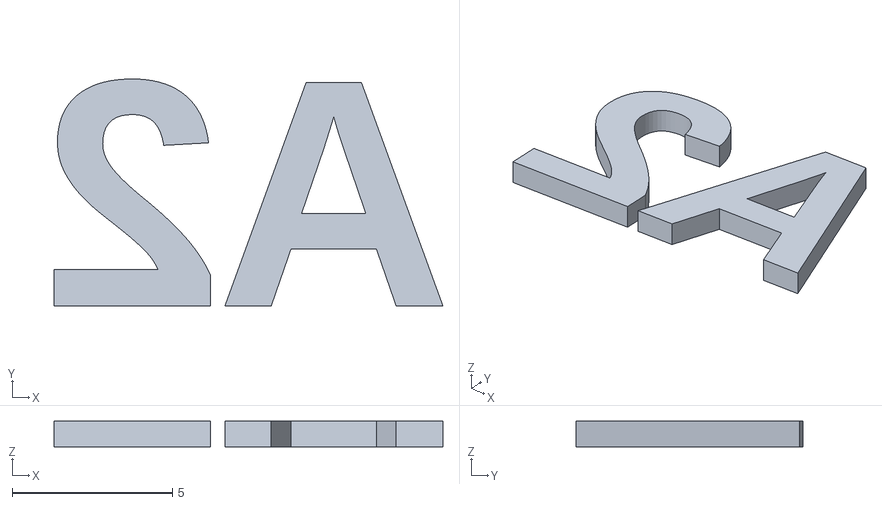
[picture p121: CAD file, 2026-10-27]
mechanical/stl/bay_label_a2_inlay.stl
12.1 x 7.08 x 0.8
