kartben/hw-testing-rack/mechanical/stl/drawer_front.stl

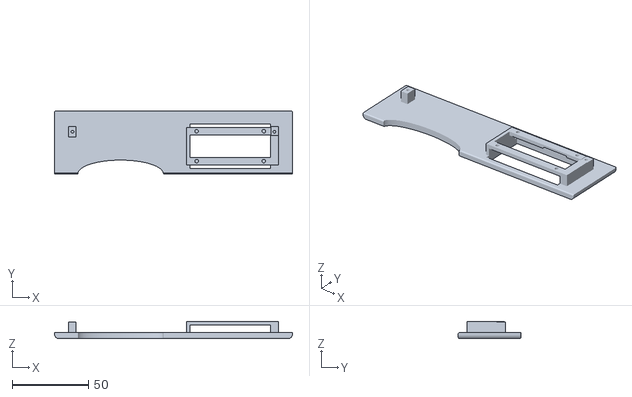
[picture p122: CAD file, 2026-10-27]
mechanical/stl/drawer_front.stl
156.0 x 41.0 x 11.4
