kartben/hw-testing-rack/mechanical/stl/bay_label_b1_inlay.stl

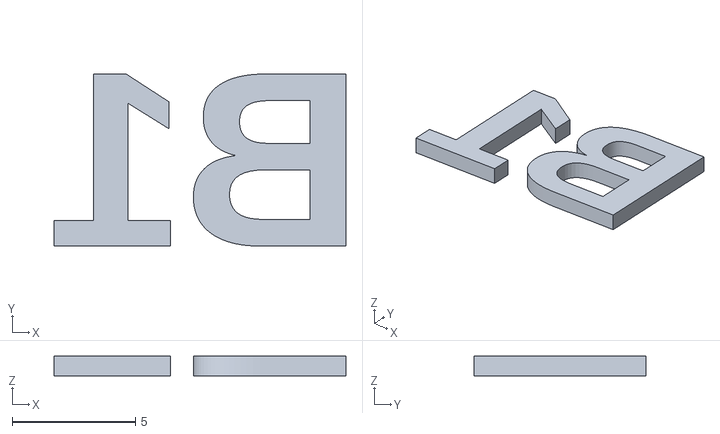
[picture p123: CAD file, 2026-10-27]
mechanical/stl/bay_label_b1_inlay.stl
11.8 x 6.97 x 0.8
