kartben/hw-testing-rack/mechanical/stl/peg_base_h11.stl

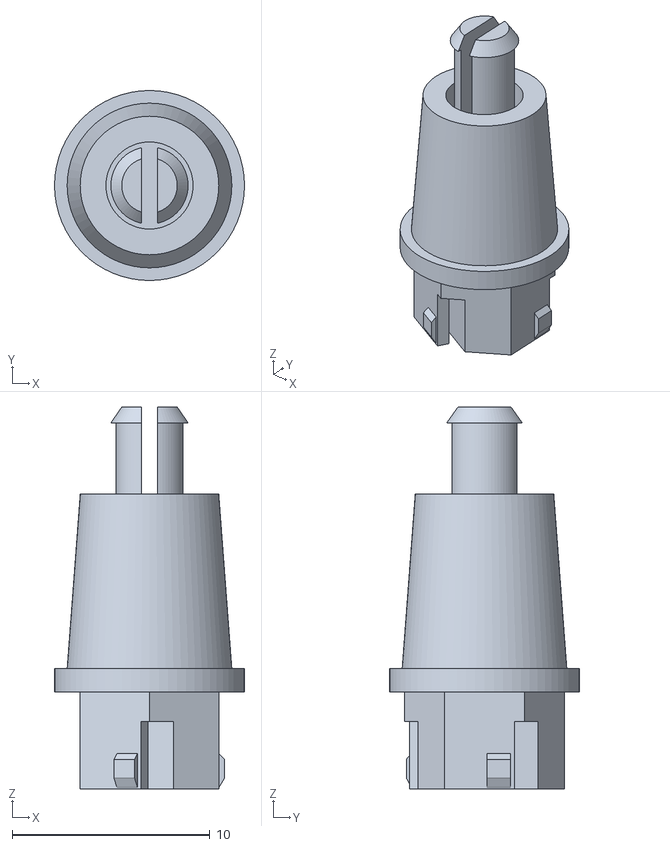
[picture p124: CAD file, 2026-10-21]
mechanical/stl/peg_base_h11.stl
9.60 x 9.60 x 19.3
