kartben/hw-testing-rack/mechanical/stl/peg_stop_h11.stl

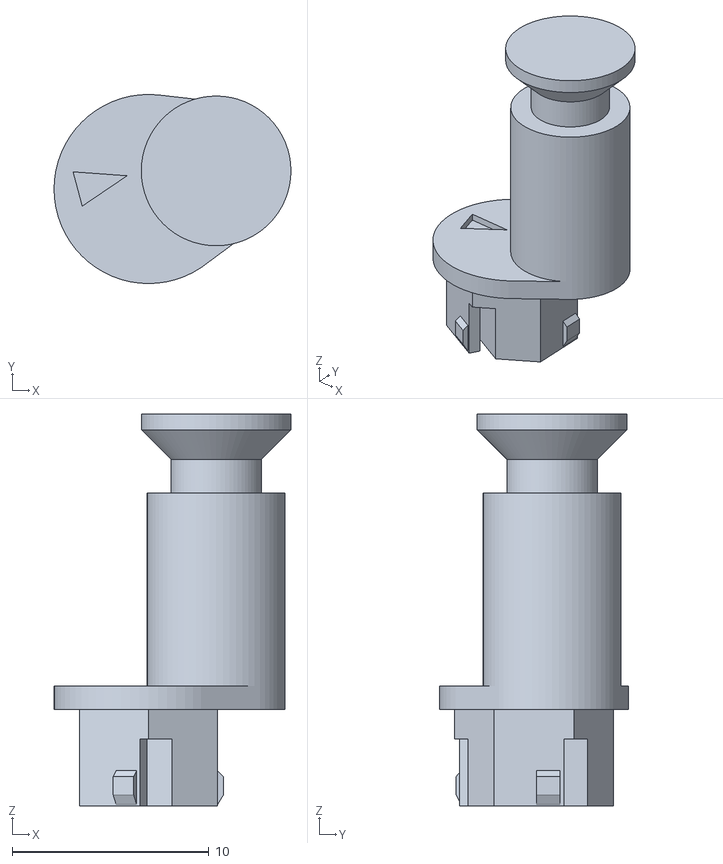
[picture p125: CAD file, 2026-10-21]
mechanical/stl/peg_stop_h11.stl
12.0 x 9.60 x 19.9
