kartben/hw-testing-rack/mechanical/stl/standalone_quad_shelf.stl

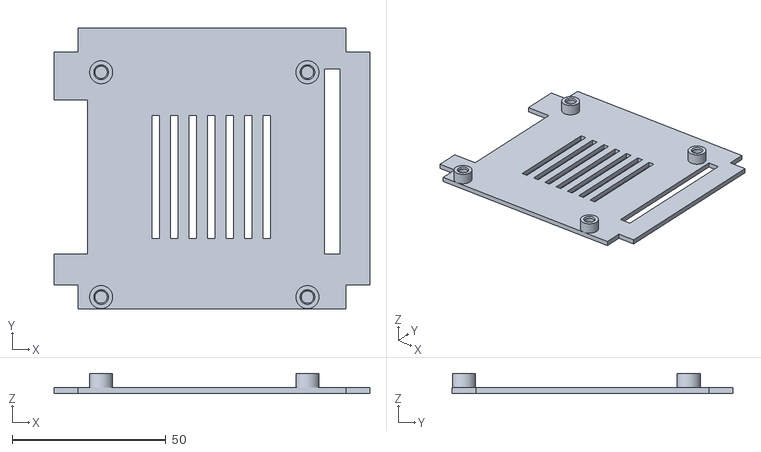
[picture p126: CAD file, 2026-10-21]
mechanical/stl/standalone_quad_shelf.stl
102.6 x 91.1 x 6.50
