kartben/hw-testing-rack/mechanical/stl/standalone_solo_lid.stl

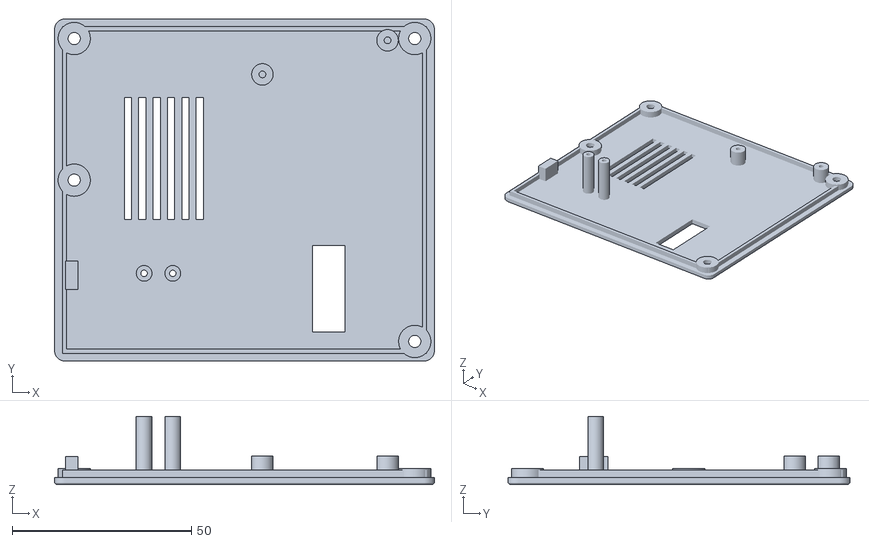
[picture p127: CAD file, 2026-10-21]
mechanical/stl/standalone_solo_lid.stl
106.0 x 95.5 x 19.0
