kartben/hw-testing-rack/mechanical/stl/standalone_quad_lid.stl

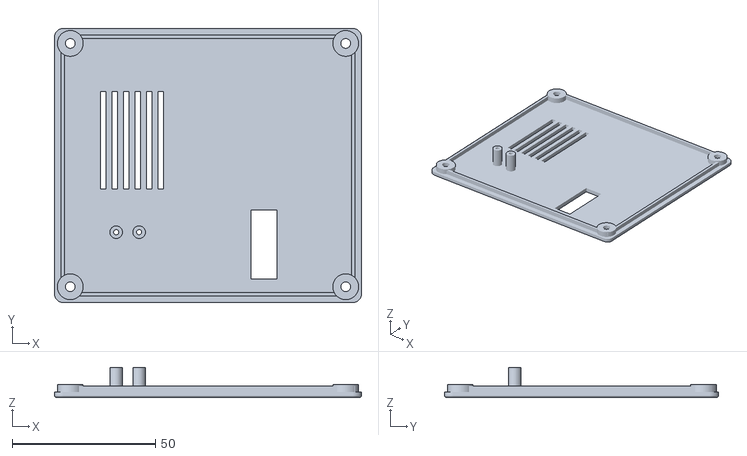
[picture p128: CAD file, 2026-10-21]
mechanical/stl/standalone_quad_lid.stl
107.0 x 95.5 x 10.5
