kartben/hw-testing-rack/mechanical/stl/cap_plate.stl

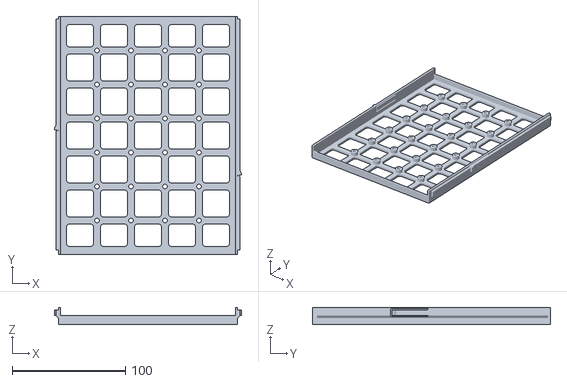
[picture p129: CAD file, 2026-10-21]
mechanical/stl/cap_plate.stl
165.0 x 210.0 x 15.0
