kartben/hw-testing-rack/mechanical/stl/floor_plate.stl

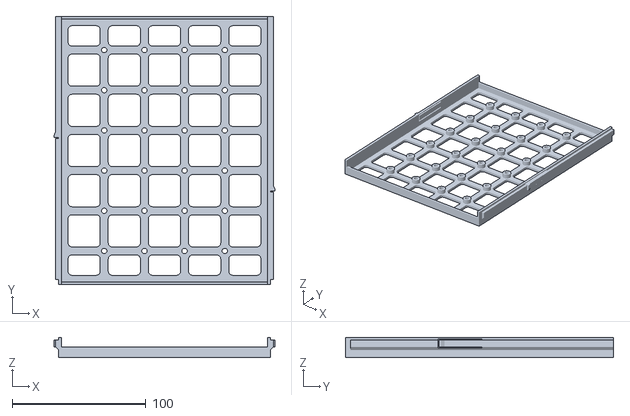
[picture p130: CAD file, 2026-10-21]
mechanical/stl/floor_plate.stl
165.0 x 200.3 x 15.0
