kartben/hw-testing-rack/mechanical/stl/ladder_a.stl

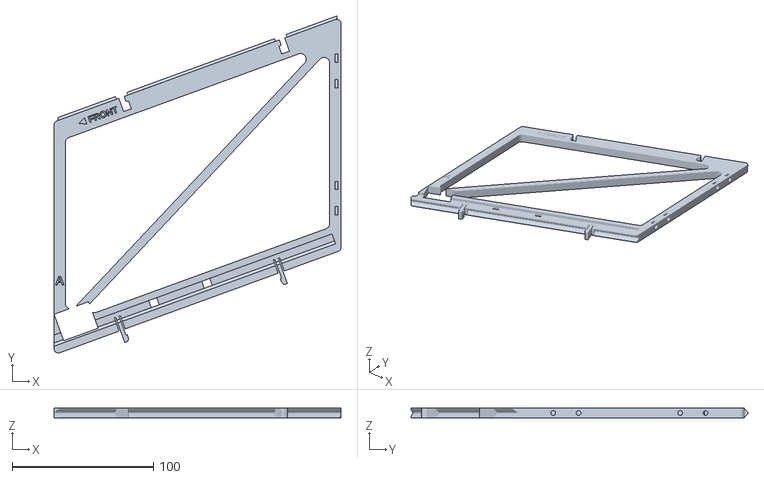
[picture p131: CAD file, 2026-10-21]
mechanical/stl/ladder_a.stl
203.3 x 238.8 x 7.40
