kartben/hw-testing-rack/mechanical/stl/ladder_base.stl

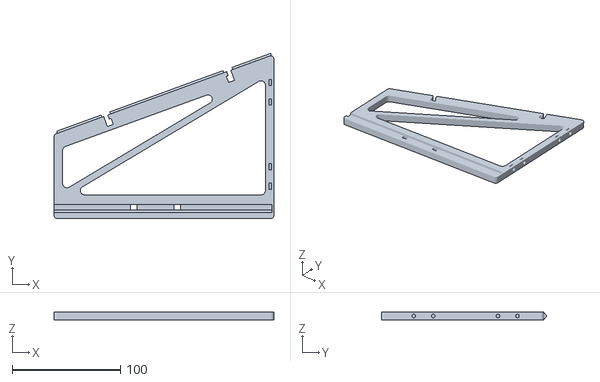
[picture p132: CAD file, 2026-10-21]
mechanical/stl/ladder_base.stl
203.3 x 152.9 x 7.40
