kartben/hw-testing-rack/mechanical/stl/camera_pod.stl

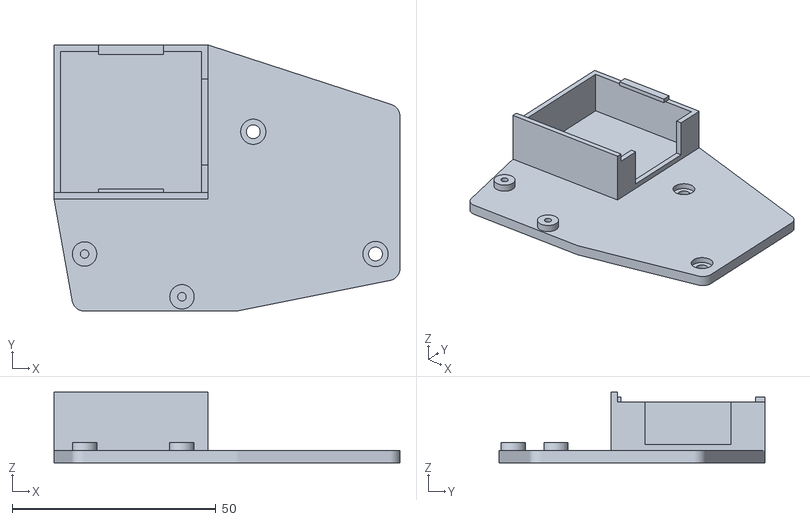
[picture p133: CAD file, 2026-10-21]
mechanical/stl/camera_pod.stl
84.9 x 65.3 x 17.4
