kartben/hw-testing-rack/mechanical/stl/chain_anchor.stl

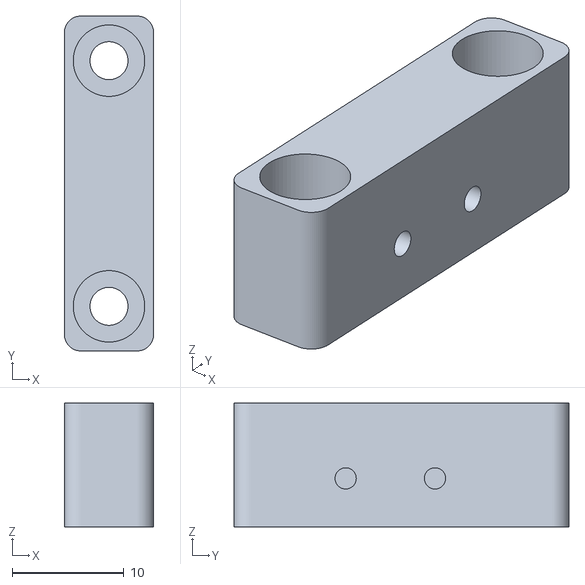
[picture p134: CAD file, 2026-10-21]
mechanical/stl/chain_anchor.stl
8.00 x 30.0 x 11.1
