kartben/hw-testing-rack/mechanical/stl/chain_foot.stl

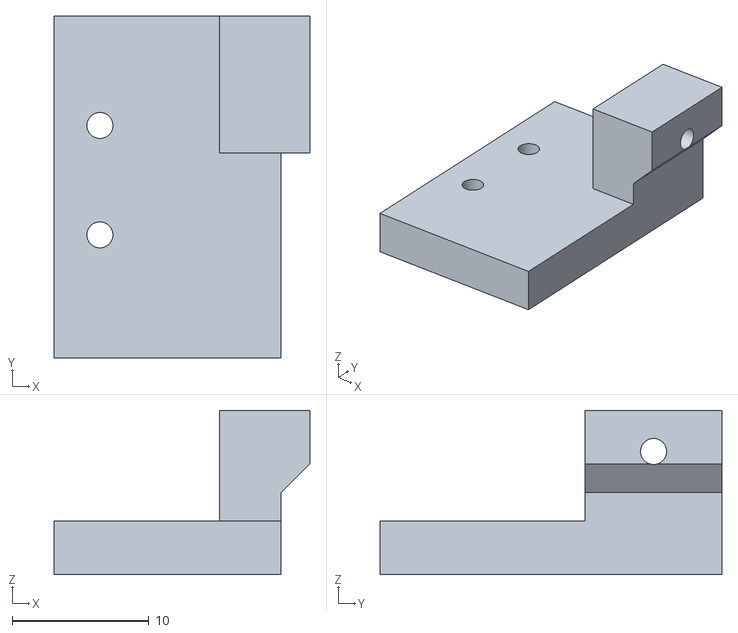
[picture p135: CAD file, 2026-10-21]
mechanical/stl/chain_foot.stl
18.7 x 25.0 x 12.0
