kartben/hw-testing-rack/mechanical/stl/power_box_lid.stl

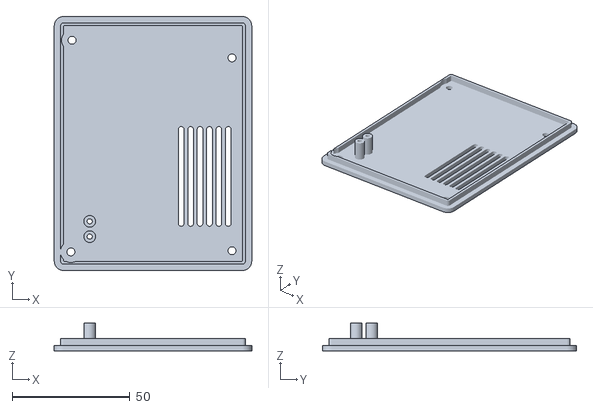
[picture p136: CAD file, 2026-10-21]
mechanical/stl/power_box_lid.stl
84.0 x 108.0 x 11.9
