kartben/hw-testing-rack/mechanical/stl/peg_pin_d21_h9.stl

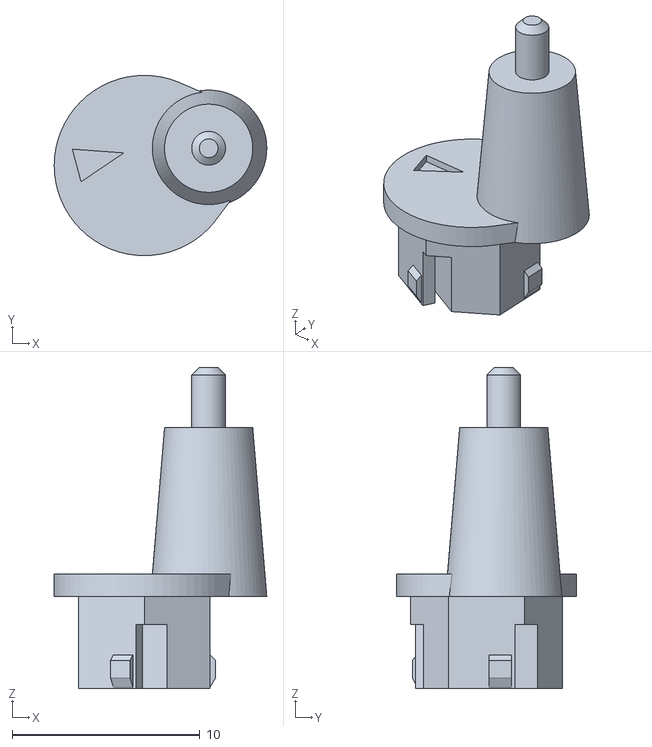
[picture p137: CAD file, 2026-10-21]
mechanical/stl/peg_pin_d21_h9.stl
11.3 x 9.60 x 17.1
