kartben/hw-testing-rack/mechanical/stl/peg_base_h12.stl

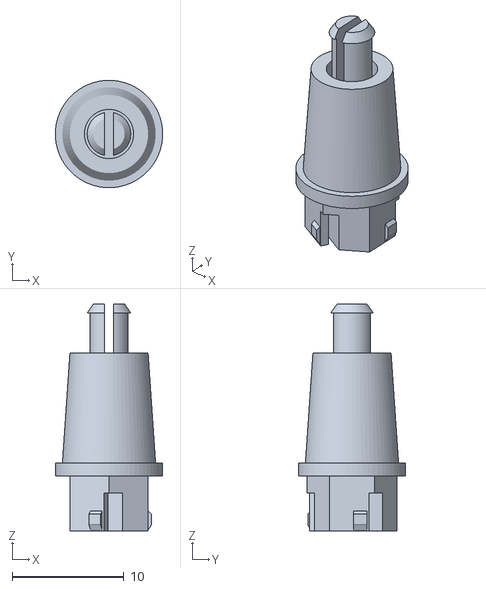
[picture p138: CAD file, 2026-10-21]
mechanical/stl/peg_base_h12.stl
9.60 x 9.60 x 20.3
