kartben/hw-testing-rack/mechanical/stl/peg_stop_h5.stl

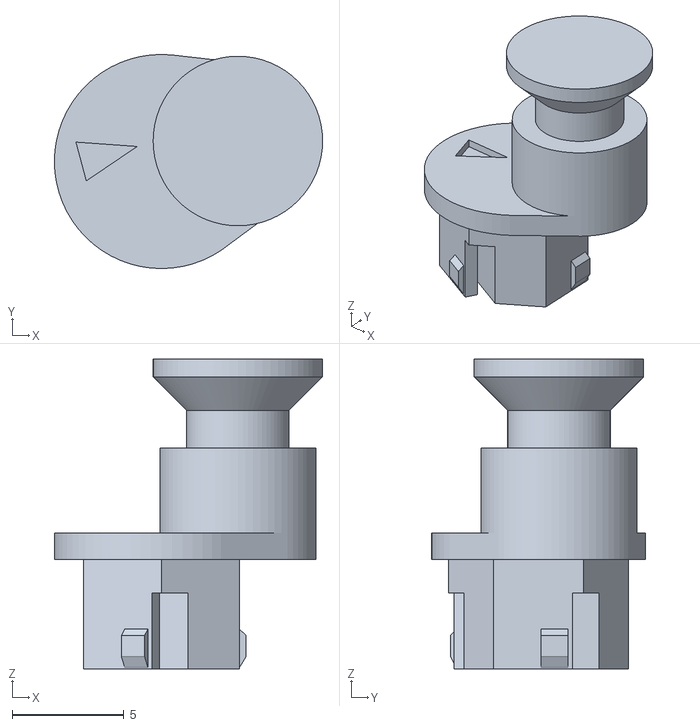
[picture p139: CAD file, 2026-10-21]
mechanical/stl/peg_stop_h5.stl
12.0 x 9.60 x 13.9
