kartben/hw-testing-rack/mechanical/stl/peg_base_h10.stl

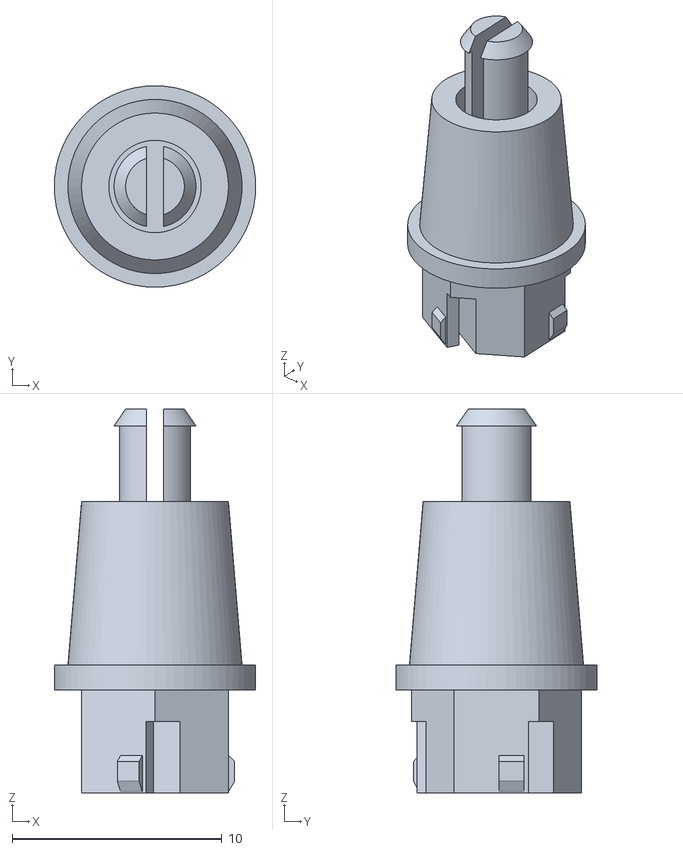
[picture p140: CAD file, 2026-10-21]
mechanical/stl/peg_base_h10.stl
9.60 x 9.60 x 18.3
