kartben/hw-testing-rack/mechanical/stl/peg_stop_h9.stl

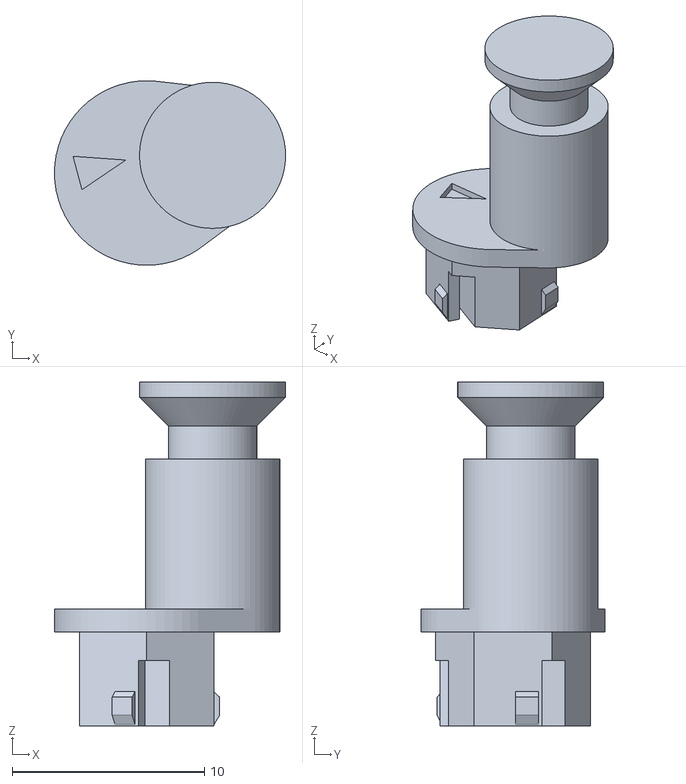
[picture p141: CAD file, 2026-10-21]
mechanical/stl/peg_stop_h9.stl
12.0 x 9.60 x 17.9
