kartben/hw-testing-rack/mechanical/stl/peg_stop_h12.stl

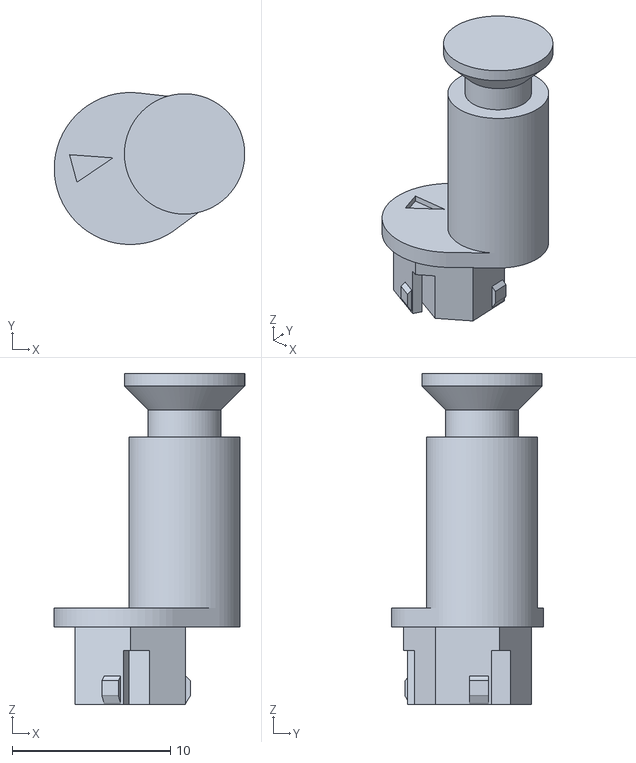
[picture p142: CAD file, 2026-10-21]
mechanical/stl/peg_stop_h12.stl
12.0 x 9.60 x 20.9
