kartben/hw-testing-rack/mechanical/stl/peg_stop_h6.stl

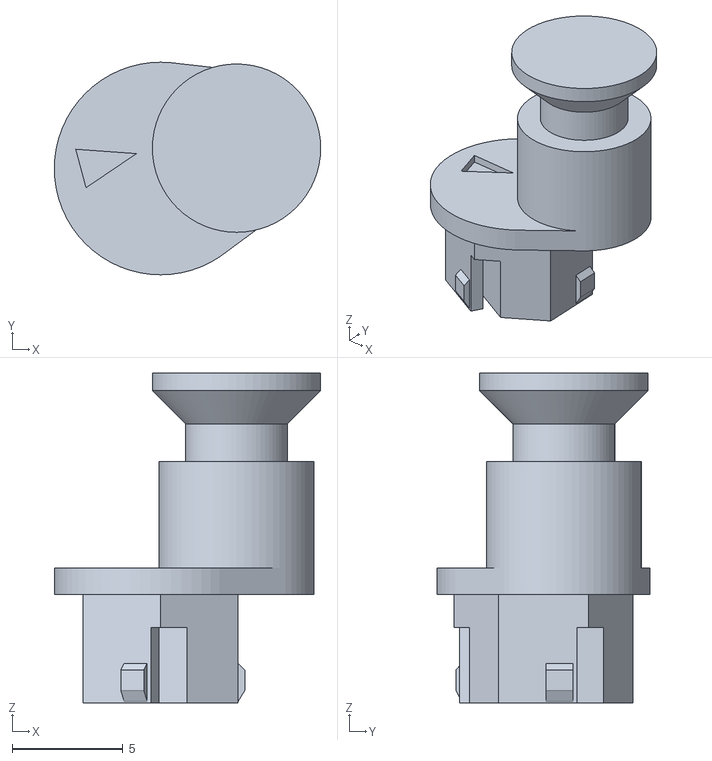
[picture p143: CAD file, 2026-10-21]
mechanical/stl/peg_stop_h6.stl
12.0 x 9.60 x 14.9
