kartben/hw-testing-rack/mechanical/stl/peg_base_h6.stl

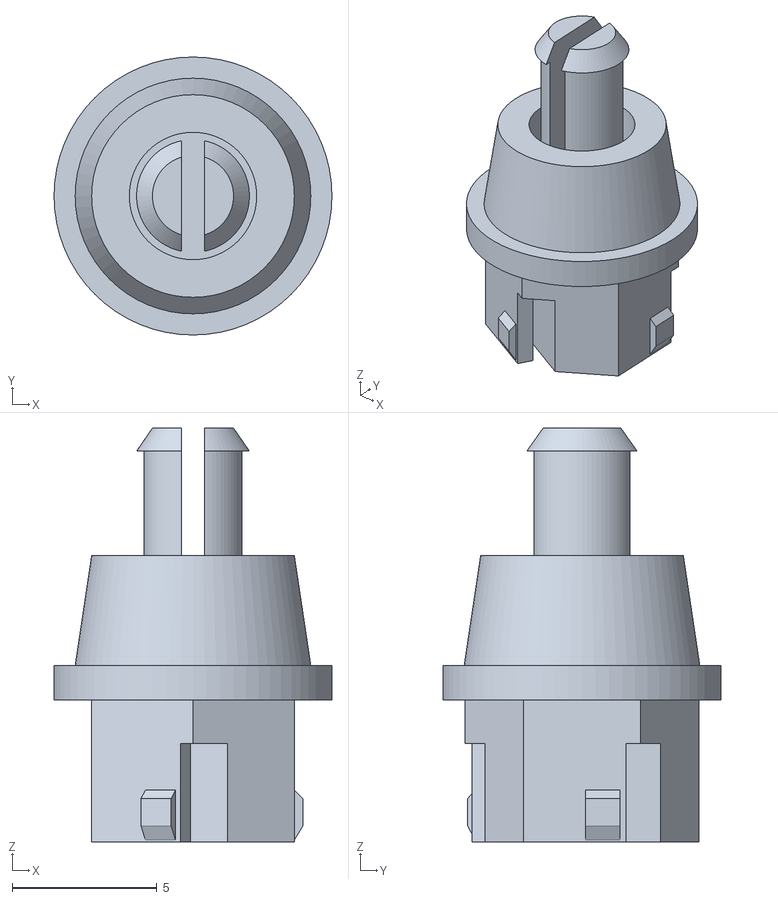
[picture p144: CAD file, 2026-10-21]
mechanical/stl/peg_base_h6.stl
9.60 x 9.60 x 14.3
