kartben/hw-testing-rack/mechanical/stl/peg_base_h5.stl

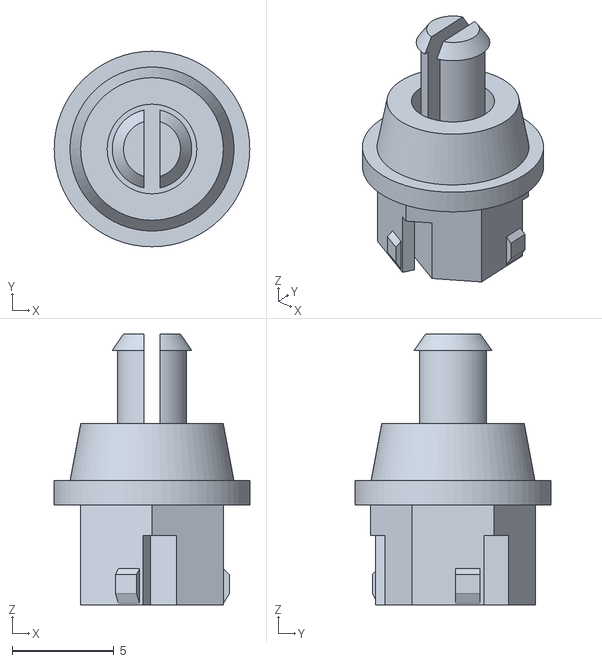
[picture p145: CAD file, 2026-10-21]
mechanical/stl/peg_base_h5.stl
9.60 x 9.60 x 13.3
