kartben/hw-testing-rack/mechanical/stl/peg_bobbin.stl

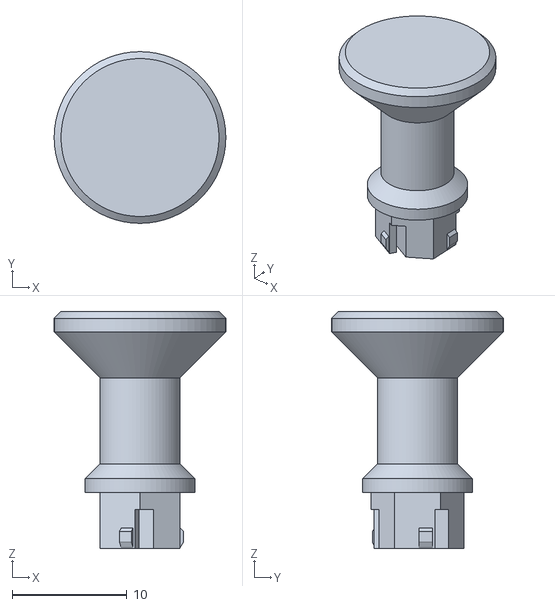
[picture p146: CAD file, 2026-10-21]
mechanical/stl/peg_bobbin.stl
15.0 x 15.0 x 20.7
