kartben/hw-testing-rack/mechanical/stl/peg_stop_h10.stl

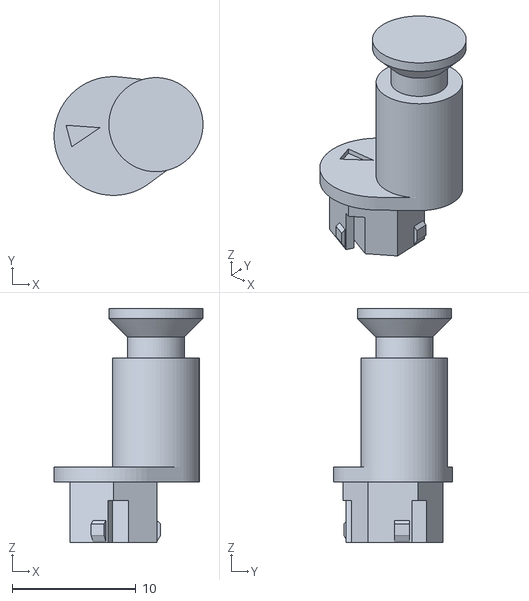
[picture p147: CAD file, 2026-10-21]
mechanical/stl/peg_stop_h10.stl
12.0 x 9.60 x 18.9
