kartben/hw-testing-rack/mechanical/stl/peg_base_h9.stl

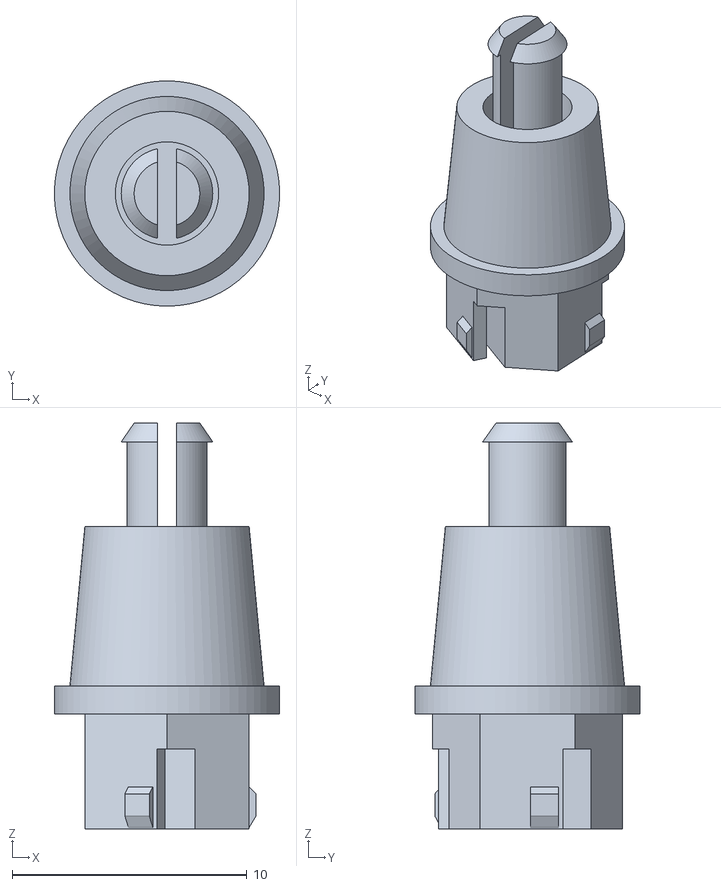
[picture p148: CAD file, 2026-10-21]
mechanical/stl/peg_base_h9.stl
9.60 x 9.60 x 17.3
