kartben/hw-testing-rack/mechanical/stl/peg_pin_d32_h12.stl

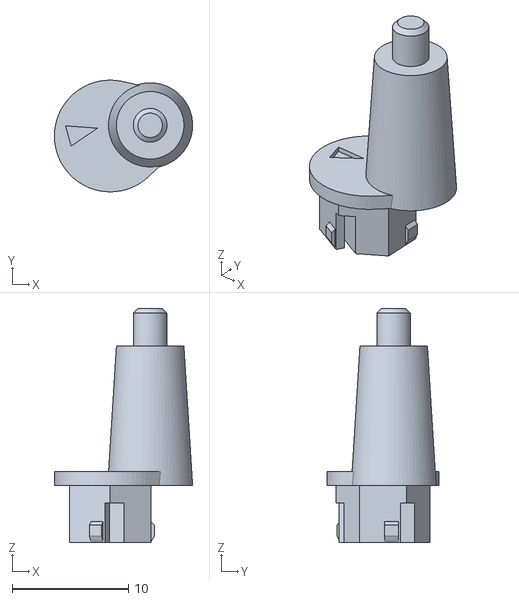
[picture p149: CAD file, 2026-10-21]
mechanical/stl/peg_pin_d32_h12.stl
11.9 x 9.60 x 20.1
