kartben/hw-testing-rack/mechanical/stl/peg_pin_d32_h6.stl

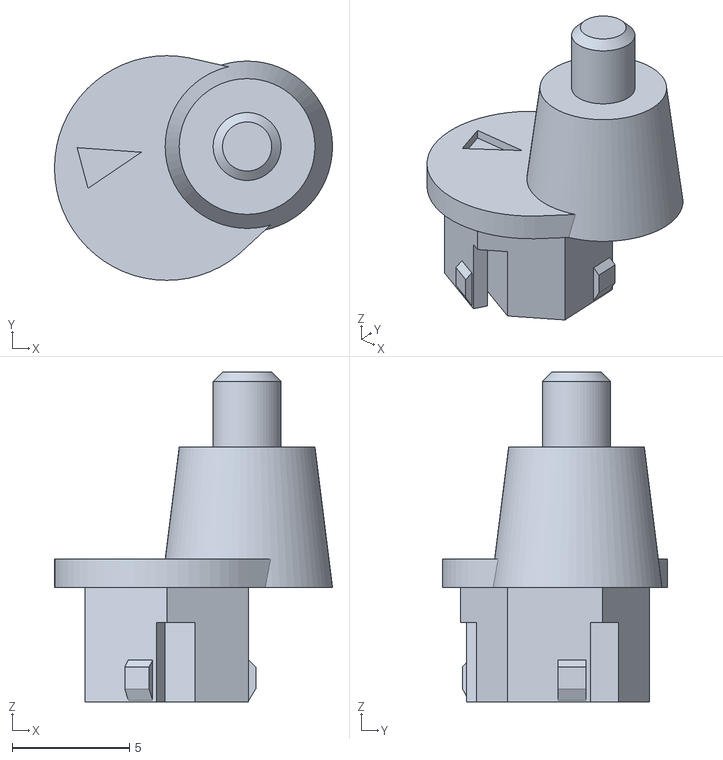
[picture p150: CAD file, 2026-10-21]
mechanical/stl/peg_pin_d32_h6.stl
11.9 x 9.60 x 14.1
