kartben/hw-testing-rack/mechanical/stl/power_box_base.stl

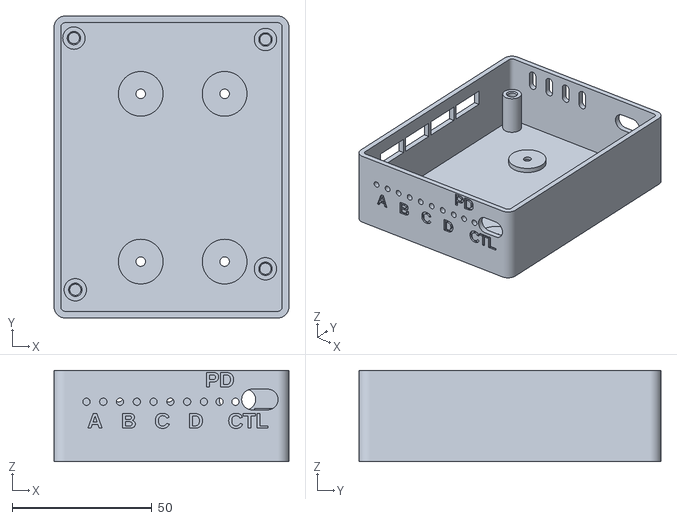
[picture p151: CAD file, 2026-10-20]
mechanical/stl/power_box_base.stl
84.0 x 108.0 x 32.6
