kartben/hw-testing-rack/mechanical/stl/power_box_labels.stl

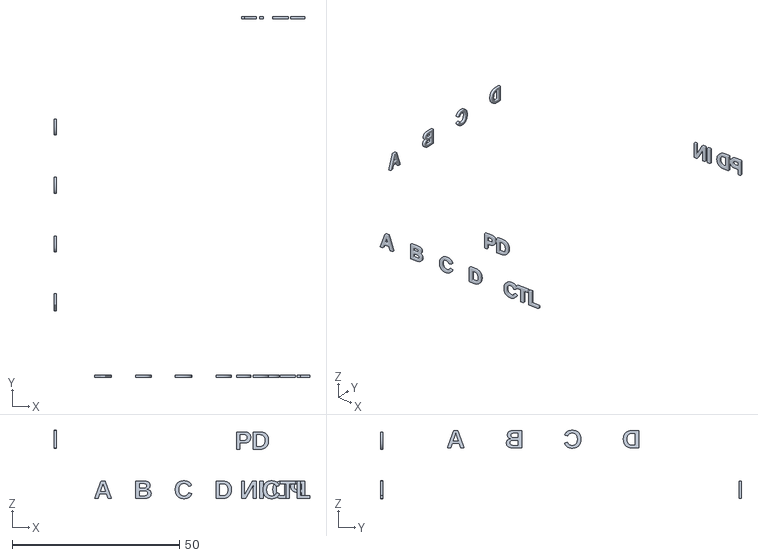
[picture p152: CAD file, 2026-10-20]
mechanical/stl/power_box_labels.stl
76.5 x 108.0 x 20.5
