kartben/hw-testing-rack/mechanical/stl/peg_cam.stl

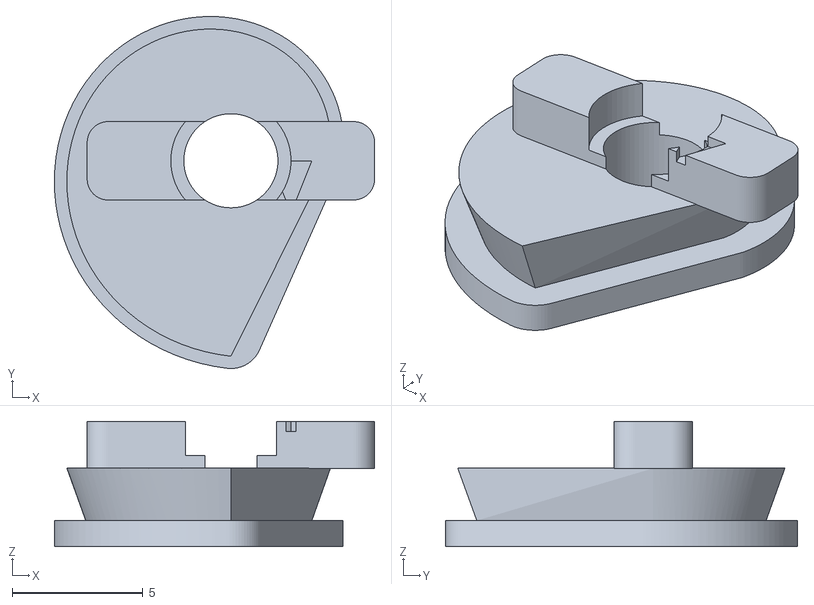
[picture p153: CAD file, 2026-10-19]
mechanical/stl/peg_cam.stl
12.3 x 13.5 x 4.80
