kartben/hw-testing-rack/mechanical/stl/camera_diffuser.stl

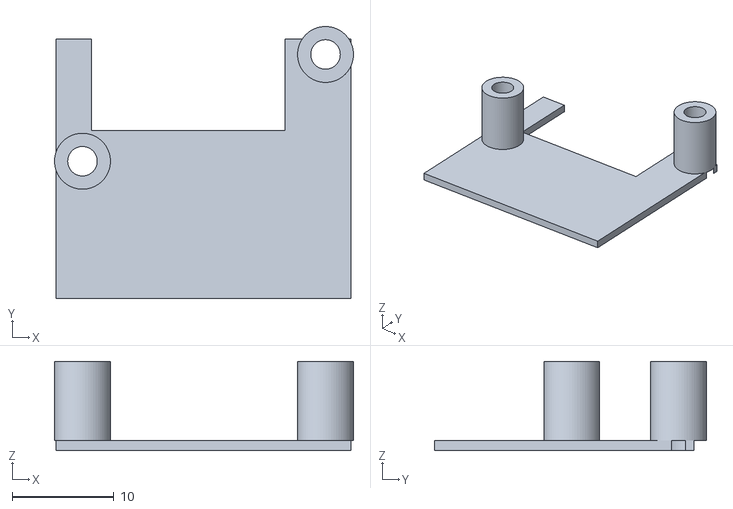
[picture p154: CAD file, 2026-10-18]
mechanical/stl/camera_diffuser.stl
29.4 x 26.8 x 8.80
