kartben/hw-testing-rack/mechanical/stl/chain_link.stl

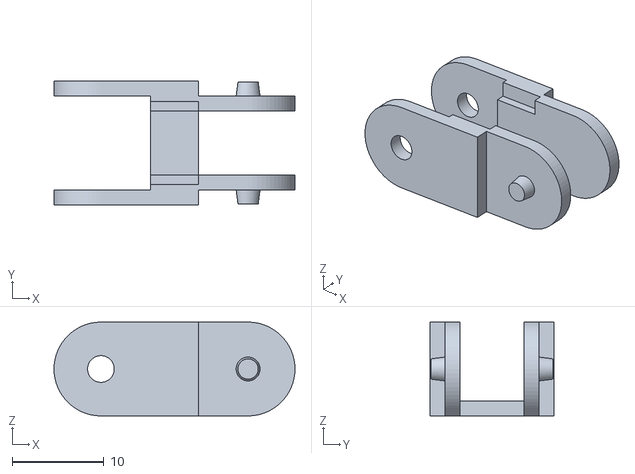
[picture p155: CAD file, 2026-10-18]
mechanical/stl/chain_link.stl
26.2 x 13.5 x 10.2
