kartben/hw-testing-rack/mechanical/stl/chain_bar.stl

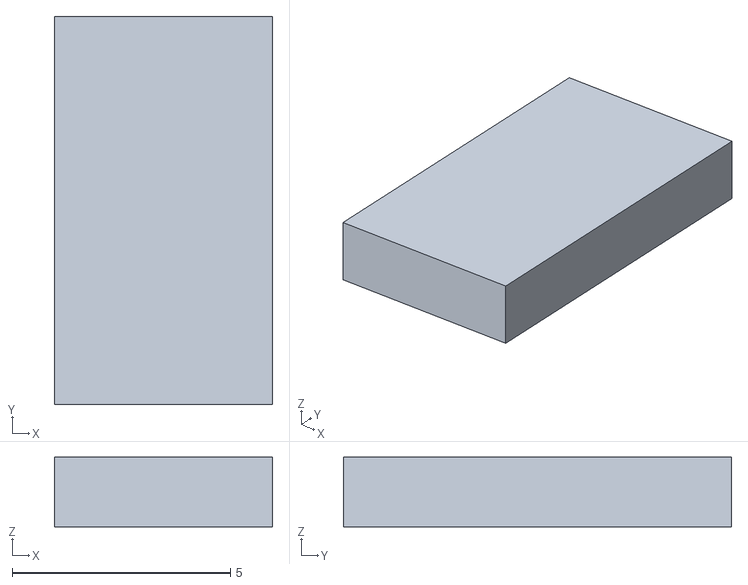
[picture p156: CAD file, 2026-10-18]
mechanical/stl/chain_bar.stl
5.00 x 8.90 x 1.60
