kartben/hw-testing-rack/mechanical/stl/brace_a.stl

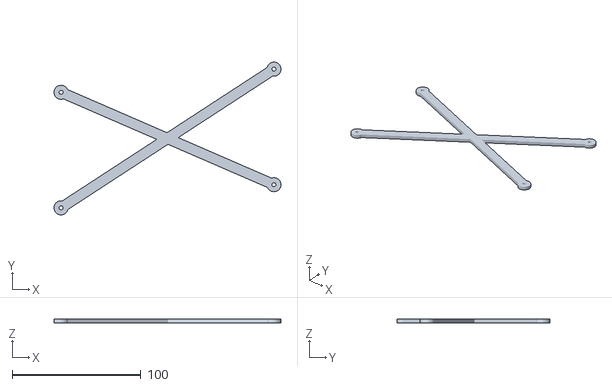
[picture p157: CAD file, 2026-10-17]
mechanical/stl/brace_a.stl
176.6 x 118.9 x 3.00
