kartben/hw-testing-rack/mechanical/stl/brace_base.stl

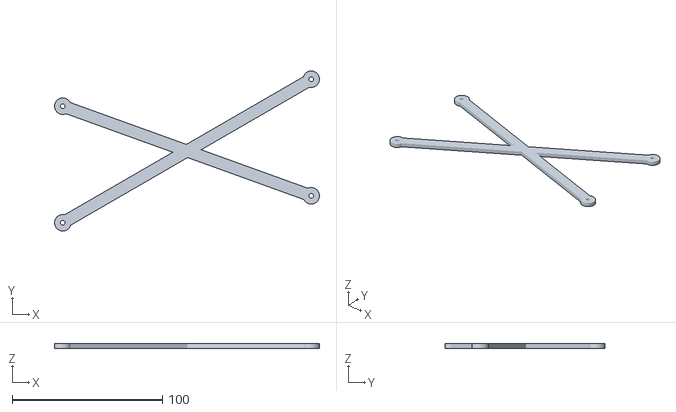
[picture p158: CAD file, 2026-10-17]
mechanical/stl/brace_base.stl
176.6 x 106.7 x 3.00
