kartben/hw-testing-rack/mechanical/generated/boards.scad

// GENERATED by tools/build.py from mechanical/boards/boards.yaml — do not edit.
// Boards are rotated so that their debug USB faces the drawer rear (+Y), or the right wall (+X)
// for boards too long for a plug behind them (usb_side).  usb_pos runs along that edge.
// [id, label, [w, l], hole_d, holes, usb_pos, usb_type, standoff, fence, height, color, verified, usb_side]
BOARD_DB = [
  ["arduino-uno-r4", "UNO R4", [68.58, 53.34], 3.2, [[54.61, 50.8], [53.34, 2.54], [2.54, 45.72], [2.54, 17.78]], 12.34, "usb-c", 6, false, 11, "#00878f", true, true],
  ["giga-r1-display", "GIGA + display", [80, 106], 3.2, [], 50.2, "usb-c", 5, true, 14.5, "#00878f", true, false],
  ["nucleo-64", "NUCLEO-64", [70, 82.5], 3.2, [[10.87, 54.61], [59.13, 53.34], [43.89, 2.54]], 35, "micro-b", 12, false, 12, "#f2f2f2", true, false],
  ["nucleo-144", "NUCLEO-144", [70, 133.34], 3.2, [[10.87, 105.41], [59.13, 104.14], [43.89, 53.34], [12.14, 29.21], [57.86, 29.21]], 49, "micro-b", 12, false, 14, "#f2f2f2", true, false],
  ["rpi-pico2", "PICO 2", [51, 21], 2.1, [[2, 16.2], [2, 4.8], [49, 16.2], [49, 4.8]], 10.5, "micro-b", 9, false, 4, "#1e7b34", true, true],
  ["esp32-s3-devkitc", "ESP32-S3", [62.74, 25.4], 3.2, [], 12.7, "micro-b", 10, true, 8, "#151515", true, true],
  ["esp32-c6-devkitc", "ESP32-C6", [51.8, 25.4], 3.2, [], 12.7, "usb-c", 10, true, 8, "#151515", true, true],
  ["xiao", "XIAO", [17.78, 20.96], 3.2, [], 8.89, "usb-c", 6, true, 4, "#202a44", true, false],
  ["arduino-nano-matter", "NANO MATTER", [17.78, 43.18], 3.2, [], 8.89, "usb-c", 6, true, 4, "#00878f", true, false],
  ["beagleplay", "BEAGLEPLAY", [80, 80], 3.2, [], 73.4, "usb-c", 6, true, 14, "#141414", true, false],
  ["wio-terminal", "WIO TERMINAL", [72, 57], 3.2, [], 36, "usb-c", 11, true, 0.5, "#f2f2f0", true, false],
  ["microbit-v2", "MICRO:BIT", [51.6, 42], 3.2, [], 25.8, "micro-b", 6, true, 6, "#111111", true, false],
  ["frdm-mcxn947", "FRDM-MCXN947", [55, 118], 3.2, [], 40, "usb-c", 10, true, 14, "#1b1b1b", false, false],
  ["nrf54l15-dk", "nRF54L15 DK", [63.55, 117.05], 3.2, [], 24, "usb-c", 10, true, 12, "#2c4763", false, false],
  ["nrf52840-dk", "nRF52840 DK", [63.55, 136.58], 3.2, [], 31.8, "micro-b", 10, true, 12, "#174a78", false, false],
  ["nrf5340-dk", "nRF5340 DK", [64, 136], 3.2, [], 20, "micro-b", 10, true, 12, "#1d3557", false, false],
  ["frdm-k64f", "FRDM-K64F", [53, 81], 3.2, [], 35, "micro-b", 10, true, 10, "#f0f0f0", false, false],
  ["stm32f746g-disco", "F746G-DISCO", [86, 154], 3.2, [], 40, "mini-b", 10, true, 10, "#0b2c4a", false, true],
  ["mimxrt1060-evkb", "RT1060-EVKB", [130, 108], 3.2, [], 30, "micro-b", 10, true, 16, "#141414", false, false],
  ["mimxrt1170-evkb", "RT1170-EVKB", [165, 127], 3.2, [], 30, "micro-b", 12, true, 16, "#141414", false, false]
];

// A converted bay's shared plate (config/rack.yaml › population › boards): its boards at their `at`, in
// plate coords (front-left corner, y to the port wall), each turned USB to the port wall unless `orient: side`.
// [bay, plate kind, [[slot, [x, y], board record as in BOARD_DB], ...]]
BAY_PLATES = [];
