kartben/hw-testing-rack/mechanical/generated/config.scad

// GENERATED by tools/build.py from config/rack.yaml — do not edit.

FRAME_W = 670.6;
FRAME_D = 225.335;
FRAME_TILT = 20;
FRAME_ROW_Y0 = 25;
FRAME_BASE_H = 80;
FRAME_TOP_Z = 530;
FRAME_PANEL_T = 7.4;
FRAME_PANEL_CLEAR = 0.2;
ROW_IDS = ["A", "B", "C"];
ROW_HEIGHTS = [165, 165, 120];
ROW_LAYOUTS = [[1, 1, 1, 1], [1, 1, 1, 1], [1, 1, 1, 1]];
BAY_PITCH = 165.8;
CARRIER_W = 158;
CARRIER_D = 210;
CARRIER_BOTTOM = 2.5;
CARRIER_WALL = 2;
CARRIER_STANDOFF = 5;
CARRIER_DECK = 3;
CARRIER_FASCIA = 2.5;
CARRIER_WALL_H = 20.1;
CARRIER_PLENUM = 23.1;
PCB_TO_FLOOR = 14;
CAM_MOUNT = [109, 45, 30];
CAM_LENS = [64, 27.6];
DRAWER_D = 208;
DRAWER_W = 142;
DRAWER_X0 = 8;
DRAWER_TRAVEL = 140;
DRAWER_GUIDE_W = 7.5;
DRAWER_CLEAR = 0.5;
DRAWER_BOTTOM = 2.5;
DRAWER_WALL = 2;
DRAWER_WALL_H = 16;
DRAWER_FRONT_H = 41;
DRAWER_FRONT_T = 4;
DRAWER_PLATE_GAP = [0.3, 3.2];
DRAWER_PORT_MOUTH = 1;
DISPLAY_GLASS = [52.36, 28.8];
DISPLAY_PCB = [51, 26.6];
DISPLAY_AT = [82, 8.5];
DISPLAY_SH = [12.3, 25.8];
DISPLAY_FIT = [0.3, 8.6, 3.5, 2];
DISPLAY_FRAME = [2.2, 2.5];
DRAWER_REAR_BAY = 42;
DRAWER_FLANGE = [3, 3];
DRAWER_MAGNET = [6, 3];
DRAWER_DETENT = "printed";
DATA_PORT_X = [80];
PLATE_T = 5;
HEX_PITCH = 10;
HEX_AF = 7.2;
HEX_U = 0.4;
HEX_CLEAR = 0.1;
HEX_HOLES = [[22.25, 10.418], [32.25, 10.418], [42.25, 10.418], [52.25, 10.418], [62.25, 10.418], [72.25, 10.418], [82.25, 10.418], [92.25, 10.418], [102.25, 10.418], [112.25, 10.418], [122.25, 10.418], [7.25, 19.078], [17.25, 19.078], [27.25, 19.078], [37.25, 19.078], [47.25, 19.078], [57.25, 19.078], [67.25, 19.078], [77.25, 19.078], [87.25, 19.078], [97.25, 19.078], [107.25, 19.078], [117.25, 19.078], [127.25, 19.078], [12.25, 27.738], [22.25, 27.738], [32.25, 27.738], [42.25, 27.738], [52.25, 27.738], [62.25, 27.738], [72.25, 27.738], [82.25, 27.738], [92.25, 27.738], [102.25, 27.738], [112.25, 27.738], [122.25, 27.738], [7.25, 36.399], [17.25, 36.399], [27.25, 36.399], [37.25, 36.399], [47.25, 36.399], [57.25, 36.399], [67.25, 36.399], [77.25, 36.399], [87.25, 36.399], [97.25, 36.399], [107.25, 36.399], [117.25, 36.399], [127.25, 36.399], [12.25, 45.059], [22.25, 45.059], [32.25, 45.059], [42.25, 45.059], [52.25, 45.059], [62.25, 45.059], [72.25, 45.059], [82.25, 45.059], [92.25, 45.059], [102.25, 45.059], [112.25, 45.059], [122.25, 45.059], [7.25, 53.719], [17.25, 53.719], [27.25, 53.719], [37.25, 53.719], [47.25, 53.719], [57.25, 53.719], [67.25, 53.719], [77.25, 53.719], [87.25, 53.719], [97.25, 53.719], [107.25, 53.719], [117.25, 53.719], [127.25, 53.719], [22.25, 62.379], [32.25, 62.379], [42.25, 62.379], [52.25, 62.379], [62.25, 62.379], [72.25, 62.379], [82.25, 62.379], [92.25, 62.379], [102.25, 62.379], [112.25, 62.379], [122.25, 62.379], [27.25, 71.04], [37.25, 71.04], [47.25, 71.04], [57.25, 71.04], [67.25, 71.04], [77.25, 71.04], [87.25, 71.04], [97.25, 71.04], [107.25, 71.04], [32.25, 79.7], [42.25, 79.7], [52.25, 79.7], [62.25, 79.7], [72.25, 79.7], [82.25, 79.7], [92.25, 79.7], [102.25, 79.7], [27.25, 88.36], [37.25, 88.36], [47.25, 88.36], [57.25, 88.36], [67.25, 88.36], [77.25, 88.36], [87.25, 88.36], [97.25, 88.36], [107.25, 88.36], [12.25, 97.021], [22.25, 97.021], [32.25, 97.021], [42.25, 97.021], [52.25, 97.021], [62.25, 97.021], [72.25, 97.021], [82.25, 97.021], [92.25, 97.021], [102.25, 97.021], [112.25, 97.021], [122.25, 97.021], [7.25, 105.681], [17.25, 105.681], [27.25, 105.681], [37.25, 105.681], [47.25, 105.681], [57.25, 105.681], [67.25, 105.681], [77.25, 105.681], [87.25, 105.681], [97.25, 105.681], [107.25, 105.681], [117.25, 105.681], [127.25, 105.681], [12.25, 114.341], [22.25, 114.341], [32.25, 114.341], [42.25, 114.341], [52.25, 114.341], [62.25, 114.341], [72.25, 114.341], [82.25, 114.341], [92.25, 114.341], [102.25, 114.341], [112.25, 114.341], [122.25, 114.341], [7.25, 123.001], [17.25, 123.001], [27.25, 123.001], [37.25, 123.001], [47.25, 123.001], [57.25, 123.001], [67.25, 123.001], [77.25, 123.001], [87.25, 123.001], [97.25, 123.001], [107.25, 123.001], [117.25, 123.001], [127.25, 123.001], [12.25, 131.662], [22.25, 131.662], [32.25, 131.662], [42.25, 131.662], [52.25, 131.662], [62.25, 131.662], [72.25, 131.662], [82.25, 131.662], [92.25, 131.662], [102.25, 131.662], [112.25, 131.662], [122.25, 131.662], [107.25, 140.322], [117.25, 140.322], [127.25, 140.322], [112.25, 148.982]];
PLATE_PORT_RECESSES = [[11.25, 140.7, 19.05, 159.4], [26.75, 140.7, 34.55, 159.4], [42.25, 140.7, 50.05, 159.4], [57.75, 140.7, 65.55, 159.4], [73.25, 140.7, 81.05, 159.4], [88.75, 140.7, 96.55, 159.4]];
PLATE_PORT_RECESS_DEPTH = 3.5;
SLOT_BIN_FLOOR = 2.4;
SLOT_BIN_RECESS = 1.4;
SLOT_BIN_WALL = 1.2;
SLOT_BIN_FRONT = [17, 12];
SLOT_BIN_DIVIDERS = [105, 40];
SLOT_BIN_LANES = [[1.2, 22.217], [23.417, 44.433], [45.633, 66.65], [67.85, 88.867], [90.067, 111.083], [112.283, 133.3]];
HEX_ROWS = [[1, 10.418], [2, 19.078], [3, 27.738], [4, 36.399], [5, 45.059], [6, 53.719], [7, 62.379], [8, 71.04], [9, 79.7], [10, 88.36], [11, 97.021], [12, 105.681], [13, 114.341], [14, 123.001], [15, 131.662], [16, 140.322], [17, 148.982]];
PEG_STOP = [3.55, 15, 4.6, 7, 7.6];
PEG_CAM = [3, 6.75, 270, 20];
CHAIN_INNER = [7, 7];
CHAIN_OUTER = [13.5, 10.2];
CHAIN_R = 18;
CHAIN_PITCH = 16;
CHAIN_END_HOLES = [8, 4];
CHAIN_FIXED = [100, 87];
CHAIN_MOVING_X = 136;
CHAIN_FOOT_Y = 172;
CHAIN_MOVING_Y = 157;
CHAIN_END_LENGTH = 26;
CHAIN_BEND_Y = 183;
NODE_SIZE = [74, 90];
NODE_T = 1.6;
NODE_HOLES = [[3.5, 13.5], [70.5, 13.5], [3.5, 86.5], [70.5, 86.5]];
NODE_X0 = 4;
NODE_FRONT_Y = 3;
NODE_PCB_TOP = 9.1;
NODE_FRONT = [32, 12, 50];
NODE_PWR_Y = 73;
NODE_DATA_Y = 30;
NODE_AUX = [69.1, 50.6];
NODE_CAM = [59, 17.2];
DATA_PCB_SIZE = [40, 17];
DATA_PCB_T = 1.6;
DATA_PCB_HOLES = [[2.6, 13.5], [37.5, 4]];
DATA_PCB_USB = 30.5;
DATA_PCB_PH = 14.4;
DATA_X4_SIZE = [100, 37];
DATA_X4_X0 = 15;
DATA_X4_HOLES = [[3.2, 16.5], [38.7, 16.5], [81.4, 16.3]];
DATA_X4_USB = [11, 29, 47, 65];
DATA_X4_LEAD = [95.1, 20];
DATA_V2_SIZE = [100, 70];
DATA_V2_X0 = 4;
DATA_V2_T = 1.6;
DATA_V2_FACE_Y = 8.46;
DATA_V2_USB_H = 7.46;
DATA_V2_USB = [28.95, 44.45, 59.95, 75.45];
DATA_V2_USB_ROT = [90, 90, 90, 90];
DATA_V2_HDR_X = [22, 40, 58, 76];
DATA_V2_NOTCH_X = [38.5, 69.5];
DATA_V2_NOTCH = [3.4, 4.5];
DATA_V2_TEE = [-2.2, 2.5];
DATA_X6_SIZE = [100, 70];
DATA_X6_X0 = 4;
DATA_X6_T = 1.6;
DATA_X6_FACE_Y = 8.46;
DATA_X6_USB_H = 7.46;
DATA_X6_USB = [13.45, 28.95, 44.45, 59.95, 75.45, 90.95];
DATA_X6_USB_ROT = [90, 90, 90, 90, 90, 90];
DATA_X6_NOTCH_X = [38.5, 69.5];
DATA_X6_NOTCH = [3.4, 4.5];
DATA_X6_TEE = [-2.2, 2.5];
DATA_X6_CORNER = [0, 0];
POD_PCB_SIZE = [40, 27];
POD_PCB_T = 1.6;
POD_PCB_HOLES = [[2.6, 13], [26.5, 23.5]];
POD_LEDS = [5, 11, 17, 23];
POD_LED_Y = 3.2;
POD_LEAD_Y = 13;
POD_HEADER = [13, 21];
HUB_SIZE = [76, 100];
HUB_HOLES = [[3.5, 3.5], [72, 4], [4, 93.5], [72, 86]];
HUB_T = 1.6;
HUB_X0 = 3.6;
HUB_FRONT_GAP = 1.2;
HUB_Z = 19;
HUB_ROWS = [81, 63.5, 46, 28.5];
HUB_LEDS = [11, 23, 35, 47, 55.6, 61.6];
HUB_USB = 70;
HUB_PD = 62;
HUB_BUTTONS = [[11.5, 10], [11.5, 16.5]];
PBOX_COLUMN = 0;
PBOX_SIZE = [84, 108, 35];
PBOX_WALL = 2.4;
PBOX_X = 3;
SA_PD = [30, 21, 1.6, 3.2];
SA_FEET = [10, 3];
