kartben/hw-testing-rack/(list of files, cad)

Other CAD files:
mechanical/stl/bay_label_c2_inlay.stl
mechanical/stl/bay_label_c2.stl
mechanical/stl/bay_label_c4_inlay.stl
mechanical/stl/bay_label_c4.stl
mechanical/stl/bay_label_c1.stl
mechanical/stl/bay_label_a4.stl
mechanical/stl/bay_label_b2.stl
mechanical/stl/bay_label_a3.stl
mechanical/stl/bay_label_a2.stl
mechanical/stl/bay_label_a1.stl
mechanical/stl/bay_label_b3.stl
mechanical/stl/bay_label_b4.stl
mechanical/stl/bay_label_b1.stl
mechanical/stl/bay_label_a3_inlay.stl
mechanical/stl/ladder_b.stl
mechanical/stl/brace_b.stl
