kartben/hw-testing-rack/mechanical/review/pairs/tray_guide_proposed.png

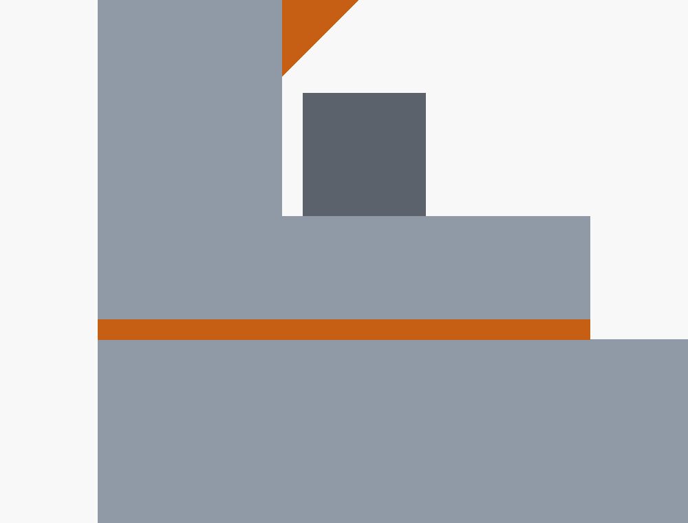
mechanical/review/pairs/tray_guide_proposed.png
