kartben/hw-testing-rack/docs/autorouting-benchmark.md

# Autorouting: a Freerouting portfolio, and three routers on our boards

**Status (2026-10-23): measured; pipeline fixes in; three design fixes, the bay node and the hub re-routed, every
board straightened (below, "Applied"); the DATA ×4 v2 routed clean on 4 layers, now the rack's board, its 6-layer
build kept.**  The question was whether a
faster, multi-core autorouter is worth building.  Plan agreed: first run Freerouting as a parallel portfolio
and fix the split-plane bug (step 0), then benchmark open-source routers on our own boards (step 1), then
decide.

**Verdict.**
- **Keep Freerouting, and run it as a portfolio.**
  - On every board the portfolio's best run is complete and clean: 0 unconnected, 0 copper DRC errors.
  - The pipeline's own single run is clean on 4 of 5.  On the hub one link stays open, and only 2 of 17 runs
    are clean.
  - Elsewhere the portfolio gains 0–12 % (copper length plus 2 mm a via): nothing on the DATA ×4 v2, which main
    has just tuned until its own run is clean.
  - It takes 2–5× a single run's wall time on 9 slots.  With as many slots as runs, it would take its slowest
    run, 1.5–2× a single one; a 45 min cap (`--run-timeout`) keeps the grinding ones out.
- **KiCadRoutingTools** (KRT: Python + Rust, MIT) is the strong newcomer.
  - 3–17× faster than Freerouting on our boards (46× against the DATA ×4 v2's 40 min run), deterministic, and
    it reads and writes `.kicad_pcb`.
  - It keeps our locked copper, and its pair router couples the pairs Freerouting routes apart.
  - But on the hub and the DATA ×4 v2 it leaves links open and breaks clearances: it has one clearance for
    every net, and no hole clearance.
- **Topola** routes none of our boards.  It can't read KiCad's fixed vias; past that, it panics or runs without
  end.
- **Don't write a router from scratch** (below: "Our own router?").  Most of what made routing painful was in our
  DSN and pipeline, now fixed generically: overlapping planes, cut-off islands, supply pads over the other net's
  area, a DSN that changed with every build, an optimizer that never ran the same way twice.
- **Straighten after routing** (below, "Straight tracks").  Freerouting's staircases cost it nothing.  A pass after
  the import takes 4–19 % of the bends off, and the farm now ranks runs by bends too.  Buses that weave together
  between vias are out of its reach: only a re-route moves them.

**Ranking** (all five boards): 1. Freerouting portfolio, 2. Freerouting single run, 3. KiCadRoutingTools,
4. Topola.

## How it was measured

- **Boards:** data-port (2 layers), camera-pod (2), bay-node (4), power-hub (4), data-port-x4 (6, as on main
  after its tidy pass).  Each is placed as `design.py` places it (`tools/kicad.sh <board> --dsn`), with the
  tracks and vias it draws and locks: the USB High-Speed pairs, the supply feeds, the fan-out vias.
- **One verdict for every router:**
  - Its result goes through the import `tools/kicad.sh --ses` runs (`pcbgen.import_session`: outer pours, GND
    stitching, plane ties, pass-through vias, pair tuning, tidy), then KiCad's DRC.
  - Runs are ranked by unconnected items, then copper DRC errors (silkscreen excluded), then copper length plus
    2 mm per via (and, since the straightening pass, 0.5 mm per bend).
  - `electronics/tools/route_metrics.py` adds vias, length per layer, locked tracks kept, copper on the plane
    layers, and each pair's skew and coupling.
- **Machines:**
  - The Mac: Apple M2 Pro, 12 cores, 32 GB, Java 27; it also ran the KiCad imports, in Docker.
  - zephyrbox: 16 cores, 14 GB, shared with firmware builds; 3 runs at a time at most.
- **"Before"** is the committed board.  All five are clean: 0 unconnected, 0 copper DRC.

## Step 0: `tools/route_farm.py`

```
python tools/route_farm.py bay-node                     # prepare, route the portfolio, score, report
python tools/route_farm.py bay-node --runs single       # only the pipeline's run (kicad.sh --route, FR_OPT_THREADS=1)
python tools/route_farm.py bay-node --apply             # + install the best run in electronics/bay-node
ROUTE_FARM_HOSTS=hosts.json python tools/route_farm.py data-port-x4 --score-on mac
```

- **prepare:** runs `tools/kicad.sh <board> --dsn` (a new mode), then puts the committed board files back.  The
  unrouted project and its DSN go to `build/farm/base`.
- **route:** each of the portfolio's runs is a whole Freerouting job, started on any free slot of the hosts.
  - Hosts are a JSON list: ssh hops, java or Docker, slots, heap.
  - Runs are keyed by DSN and settings: one already done is skipped, one still running on a host is waited for,
    one whose process died is started again.
  - Containers are named `rf-<board>-…`; nothing else on a shared machine is touched.
- **score:** each session is imported into its own copy of the project (`build_board.py --ses --outdir`).
  KiCad's DRC and the metrics land in `runs/<run>/score.json`.  `--score-on HOST` runs the imports there, on a
  copy of the files they need.
- **report:** `build/farm/report.json` and a ranked table; `--apply` copies the best board in.
- **The portfolio** (17 runs):
  - the pipeline's own run;
  - via cost 10 / 150, rip-up cost 30 / 300, plane via cost 50;
  - fan-out off, optimizer off, neck-down off;
  - five net orders (`dsn.shuffle`: nets and components permuted with a seed);
  - three mixes of the above.

Results, on the same placement as the committed board.  Cost = copper length + 2 mm a via.  Portfolio wall
times are for 17 runs on 9 slots (6 on the Mac, 3 on zephyrbox); the single run was timed alone on the Mac.

| Board | Before (committed) | Single run | Portfolio best | Clean runs | Wall: single → portfolio |
|---|---|---|---|---|---|
| data-port | 34 vias, 173.9 mm | 0 open, 33 vias, 175.6 mm | `via150`: 30 vias, 153.7 mm (−12 %) | 16 / 17 | 14 s → 67 s |
| camera-pod | 38 vias, 231.0 mm | 0 open, 33 vias, 235.6 mm | `noneck-order2`: 32 vias, 232.6 mm (−2 %) | 17 / 17 | 4 s → 88 s |
| bay-node | 401 vias, 2269.5 mm | 0 open, 422 vias, 2226.5 mm | `ripup30`: 403 vias, 2216.8 mm (−2 %) | 15 / 17 | 90 s → 361 s |
| power-hub | 433 vias, 3536.8 mm | **1 open**, 455 vias, 3517.9 mm | `via10`: 521 vias, 3460.4 mm | **2 / 17** | 246 s → 842 s |
| DATA ×4 v2 | 810 vias, 4828.3 mm | 0 open, 800 vias, 4781.6 mm | `planevia50`: 799 vias, 4781.6 mm (0 %) | 4 / 17 (7 stopped at 45 min) | 40 min → 90 min |

- **The DATA ×4 v2 before main's tidy-up** (77a0264; same portfolio, same scoring): the single run had 4 copper
  DRC errors (3 tracks necked under 0.09 mm, an isolated copper island) and 3 of 17 runs were clean; the best,
  neck-down off, was clean with 800 vias and 4772.8 mm.  Since then its own run is clean.  7 runs went past
  45 min and were stopped: autorouter passes on a board it sees almost complete, or the one-thread optimizer.
- **No setting wins twice.**  The winner is via cost 150 on the data port, rip-up cost 30 on the bay node, via
  cost 10 on the hub, neck-down off or a net order elsewhere.  That is the case for a portfolio.
- **The hub's open link**, in 15 of its runs: the narrow `buck-vin` island (VRACK, F.Cu, 2.2 mm wide) is cut in
  two by another net's track.  Freerouting doesn't treat a pour on a signal layer as an obstacle, and the island
  wasn't `exclusive` in `design.py`.  Two runs missed it.  It is `exclusive` now (below, "Applied").
- **Cores.**  Each run uses one core (CPU s ≈ wall s); the portfolio used 9.  The slowest run takes 1.5–2× the
  pipeline's run: that sets the wall time with enough slots.
- **Not applied then.**  The portfolio's boards differ from the committed ones in routing only.  The bay node
  and the hub have since been re-routed, after their design fixes (below, "Applied").
- **Looks.**  Each board's signal layers were rendered before / after, side by side.  The portfolio's best reads
  like the committed board: same router, same style.  Where it saves vias, it sometimes takes a longer way on
  B.Cu.

## Freerouting 2.5.0, what the runs showed

- **The autorouter is deterministic per DSN.**  The same DSN gives the same session on the Mac (arm64, Java 27),
  on zephyrbox (x86-64, Java 25 in Docker) and on the PC: same MD5.
- **Its optimizer is not.**  It runs only on a board Freerouting thinks complete, and on several threads by
  default.  Three runs of the camera pod gave three boards; on one thread, three runs give one.
  - On the DATA ×4 v2, now complete for Freerouting, one thread takes 33 min of a 40 min run, for 1.7 mm of
    copper (`noopt`: the same 800 vias, 4783.3 mm, in 8 min).
  - So `tools/kicad.sh --route` keeps Freerouting's default (fast, not repeatable), and `FR_OPT_THREADS=1` makes
    it repeatable.  The farm always uses one thread (its runs must be repeatable) and has its optimizer-off run.
- **The DSN wasn't stable either.**
  - KiCad writes nets, footprints, images and fixed wires in an order that follows the footprints' UUIDs, which
    are new at every build.  It also numbers same-name images (`::1`) in that order.
  - So each regeneration of an unchanged `design.py` was a different routing problem.
  - `dsn.canonical()` now sorts all of it, names those images by a hash of their definition, and rounds their
    coordinates' last digit.  Two builds of one board now give one DSN (checked on data-port, camera-pod,
    power-hub).
  - One exception: on the bay node, its overlapping strips (below) go to +3V3 in one build and +5V in the
    next.  That follows KiCad's own fill, which flips the same way.
- **One core.**  The autorouter is single-threaded (CPU s ≈ wall s); the optimizer runs only on a board it sees
  complete (above).
- **Its "unrouted" count isn't KiCad's.**  It counts as open the GND pads on the outer pours, and pads reached by
  a drawn track that doesn't end on the pad's exact centre.  KiCad then finds them connected (main fixed the
  DATA ×4 v2's drawn ends in 77a0264).
- **Neck-down goes under the floor.**  `automatic_neckdown` narrows tracks at crowded pads to 0.076 and
  0.063 mm on the DATA ×4 v2, whose floor is 0.09 mm: 1–8 `track_width` errors per run.  The portfolio has
  runs without it.
- **No-ops.**  `--router.autorouter.algorithm=freerouting-router-v19` logs "not supported" and uses the
  default.  `max_passes` 200 instead of 60 changes nothing: it stops after a few passes without gain.
- **Telemetry.**  `-da` (no analytics) is now on every call, `tools/kicad.sh --route` included.

## Step 0: split power planes

The brief: Freerouting takes a plane net's pads as connected through the plane, even over the other net's
area, and never routes them.  Its code (`BatchAutorouter`) and four experiments narrow this down to three
separate faults.  Each now has a generic fix in the pipeline; `PCBGEN_DSN_PLANES=kicad` keeps KiCad's outlines,
to compare.

1. **Overlapping outlines.**  KiCad writes each zone's outline, not what its fill can reach; Freerouting takes
   the whole outline as copper of the net.
   - Freerouting's own check ("overlapping conduction areas") fired on the bay node (+3V3 / +5V), the hub
     (VRACK / +3V3) and the DATA ×4 v2 (+3V3 / +5V).
   - On the bay node it was one 0.3 mm strip on In2, x 22.0–22.3 mm along y 34.3–44, where the +5V outline ran
     0.3 mm into the +3V3 one.  Both zones have the same priority, so KiCad's fill gave the strip to the zone
     with the larger UUID, which is new at each build.  The DATA ×4 v2 had the same along J1's +5V tab (fixed in
     its `design.py` on main, 77a0264).  The bay node's `design.py` now stops the +5V outline at x 21.7.
   - **Fix** (`pcbgen.plane_areas`, at DSN export): each plane is its outline less every other-net zone that
     wins over it on its layer (priority, then KiCad's tie-break), grown by the clearance.
   - The warning is gone from every run of the three boards.  An island poured over another net's area by
     priority (like the DATA ×4 v2's +3V3_CP island, poured after routing today) would now reach Freerouting as
     KiCad fills it; not tried.
2. **An island counts as the plane.**  An item is "connected to the plane" once its connected set holds *any*
   conduction area of its net.  So an area that nothing ties to the rest of the net makes every pad on it look
   done: the bay node's front +3V3 area, fed only by a drawn B.Cu track.
   - Test, the bay node without that feed, 2 runs per setting.  With KiCad's outlines, Freerouting lists one
     +3V3 link open and treats the front pads as connected; KiCad finds the front group cut off.
   - **Fix** (`plane_areas`): an area that no fixed via, through-hole pad or drawn track ties to the net's main
     area is left out of the DSN.
   - Freerouting then lists the front pads as open (6 links), but still can't route the 25 mm to the main area:
     KiCad finds the same group cut off.  The fault now shows in Freerouting's report; the drawn feed stays the
     way to close it.
3. **A pad over the other net's area.**  This one is not "assumed connected": Freerouting lists it open.  Its
   fan-out drops the pad's via into the wrong area, and with the long way round to its own area it often gives
   up.
   - Test, the DATA ×4 v2 without its four drawn switch feeds (the switches' IN and their 1 µF, over the +3V3
     area): 6 links open after the pipeline's own run, 5 with Freerouting's fan-out off, 1 with plane vias priced
     like signal vias.
   - Routing the split layer's nets as signals instead (`dsn.split_planes_as_signals`: the layer typed signal,
     under a wire keep-out) is far worse: 171–212 links open after 6–8 passes, against 12–14.
   - **Fix** (`pcbgen.fanout_pads`, before routing): a supply pad over another net's area gets its fan-out track
     to its own area, up to 8 mm away, with bends where a straight line doesn't fit (a 0.1 mm-grid search).  It
     is locked like the other fan-outs.
   - The same test with the fix: every supply pad connected in all three runs; the one link left open is a bus
     line (PORT1_B2 or PORT3_B2).  The eight pads get 4.8–6.2 mm feeds with 1–3 bends, the drawn feeds' job.  The
     drawn feeds stay: without them no run of five came out clean (below, "Applied").
   - On the committed designs it adds three +3V3 feeds on the DATA ×4 v2 and two on the bay node (U2.2, U11.3).
     Freerouting routed those, or the import tied them, before.

`dsn.canonical()` (above) is what makes these A/B tests repeatable.

## Step 1: three routers on our boards

Each router got the same unrouted board and the same scoring.
- **KRT:** github.com/atomic14/KiCadRoutingTools v0.17.7-2-g6ab59a6 (2026-07-11).  Its Rust core was built from
  source (`cargo build --release`, rust:1 in Docker); Python 3.13.
- **Topola:** codeberg.org/mikolaj/topola d832b16 (2026-07-02), `cargo build --release -p topola-cli`.

Cells: open links / copper DRC errors · vias, copper length · wall time.  KRT shows the best of its three setups.

| Board | Freerouting single | Freerouting portfolio | KRT | Topola |
|---|---|---|---|---|
| data-port | 0 / 0 · 33 vias, 176 mm · 14 s | 0 / 0 · 30 vias, 154 mm · 67 s | 0 / 1 · 32 vias, 147 mm · 1 s | panics after 22 s |
| camera-pod | 0 / 0 · 33 vias, 236 mm · 4 s | 0 / 0 · 32 vias, 233 mm · 88 s | 0 / 0 · 39 vias, 258 mm · 1 s | no result in 5 min |
| bay-node | 0 / 0 · 422 vias, 2227 mm · 90 s | 0 / 0 · 403 vias, 2217 mm · 361 s | 0 / 2 · 468 vias, 2238 mm · 29 s | no result in 24 min |
| power-hub | 1 / 0 · 455 vias, 3518 mm · 246 s | 0 / 0 · 521 vias, 3460 mm · 842 s | 3 / 6 · 529 vias, 3359 mm · 56 s | no result in 5 min |
| DATA ×4 v2 | 0 / 0 · 800 vias, 4782 mm · 40 min | 0 / 0 · 799 vias, 4782 mm · 90 min | 2 / 22 · 793 vias, 4826 mm · 52 s | no result in 5 min |

The renders (each board's signal layers: before, the portfolio's best, KRT) are with the session's notes.

**Freerouting 2.5.0.**
- Through the portfolio it is complete and clean on every board.  It is single-core, and takes minutes on the
  4- and 6-layer boards.
- The pairs `design.py` doesn't draw come out uncoupled.  Its lines run side by side over 0–38 % of their
  length: ESP_DP/DN on the bay node, USB_CONN on the hub, the data port's CONN and LEAD.

**KiCadRoutingTools.**
- **Speed.**  The routing itself (`route.py`) takes 0.1–45 s: 0.1 s on the data port, 12 s for the DATA ×4 v2's
  246 nets.  Add 3–9 s per plane net for `route_planes.py`.  One core.
- **Deterministic.**  Two runs give the same copper, segment for segment (checked on the bay node and the
  DATA ×4 v2).
- **Fits the pipeline without a DSN.**  It reads our unrouted `.kicad_pcb` and keeps every locked track and via.
  Its board then goes through `import_session` (`--routed`) like a session.
- **The setup that worked:**
  - `route_planes.py` once per plane net, with `--skip-existing-zones`.  Two nets on one layer make it draw its
    own Voronoi zones over ours (`zones_intersect`).
  - Then `route.py` on the signal layers, with `--power-nets` widths from our netclasses and
    `--no-fix-drc-settings --no-clamp-netclasses`.
  - A `--fab-overrides` file pinning JLC's free 0.5 / 0.3 mm via.  Without it, it escalates to 0.25 / 0.15 mm
    vias near fine-pitch parts.
- **Pairs.**  With `route_diff.py` first, the router-routed pairs run side by side over 84–99 % of their length,
  at the 0.35 mm pitch asked.  Skew stays at 1.5–4.3 mm: that flow does no length matching.
- **Limits seen:**
  - One clearance for every net.  At the board's floor it breaks the USB (0.127 mm) and power (0.15 mm)
    classes; at the largest class clearance it leaves 6–13 links open.
  - No hole clearance: tracks pass 0.21 mm from the USB-C's pegs (rule 0.25).
  - Its own summary says "470/470 pads connected" where KiCad finds 7 links open.
- **Looks.**  Tidy parallel bundles on F.Cu, with B.Cu nearly empty; longer routes on the small boards.

**Topola.**
- Its own test boards route in 0.03 s.  Ours don't.
- KiCad 10's fixed vias (`(net …)(type fix)`) stop its parser.  Without `(type fix)` it parses, then runs with no
  output: 5 min on the data port and the camera pod, 24 min on the bay node.
- Without planes, pre-routes and GND, the data port panics in its navmesh after 22 s.
- Its sessions give every wire width 0.
- Work in progress, as it says; nothing to measure yet.

**Fit with our pipeline.**

| | Input | Output | Planes | Locked copper | Pairs | Cores | Deterministic |
|---|---|---|---|---|---|---|---|
| Freerouting | DSN (with our fixes) | SES | plane layers, with the faults above | kept | single-ended | 1 per run | yes, optimizer on 1 thread |
| KRT | `.kicad_pcb` | `.kicad_pcb` | stitches existing zones | kept | coupled (`route_diff`) | 1 | yes |
| Topola | DSN (KiCad's fails) | SES (0-width wires) | no | — | — | 1 | — |

## The hybrid flow, tried

KRT routes the differential pairs `design.py` doesn't draw (`route_diff.py`, on the unrouted board); those tracks
are locked, the DSN is exported again, and the Freerouting portfolio routes the rest; then the same import and
scoring.  The same runs on both sides.

| Board | Portfolio alone: best · clean runs · pairs | Hybrid: best · clean runs · pairs |
|---|---|---|
| data-port (2 pairs) | 30 vias, 153.7 mm · 16 / 17 · coupled 11 %, 38 %; skew 2.8, 0.7 mm | 31 vias, 158.6 mm (+3 %) · **17 / 17** · coupled **88 %, 84 %**; skew 1.8, 1.5 mm |
| bay-node (ESP pair) | 403 vias, 2216.8 mm · 15 / 17 · coupled 10 %, skew 1.2 mm | 406 vias, 2190.9 mm (−0.7 %) · **17 / 17** · coupled **98 %**, skew 3.6 mm |
| DATA ×4 v2 (6 pairs) | `noopt`: 0 open, 0 DRC, 800 vias, 4783 mm · CP_HUB coupled 45 % | `noopt`: 0 open, **6 DRC**, 828 vias, 4861 mm · CP_HUB coupled 74 % |
| power-hub | — | KRT can't start the USB_CONN pair from the bare board (every cell around the connector's pins blocked) |

- On the simple boards it is a win: every run clean, and the pairs actually coupled (84–98 % of their length side
  by side, against 10–38 %), for ±3 % of copper.  Skew isn't matched by that flow: adding such a pair to
  `b.pcb["match"]` would let `pcbgen.tune_pairs` even it after routing.
- On the dense DATA ×4 v2 it isn't.  At the board's 0.1 mm floor KRT drew the pairs 0.1 mm apart (their class asks
  0.127): 19 clearance errors and two stubs short of the USB-C's A6 pads, in every run.  With the class's
  clearance its pairs are clean, but the rest routes longer (+1.6 %, +28 vias) with neck-down errors; the other
  four runs were still in the one-thread optimizer at the 45 min cap.
- So: worth it where a pair is routed by the router on a roomy board (the bay node's ESP pair, the data port's
  pairs); not on the DATA ×4 v2, whose High-Speed pairs are drawn by hand anyway.

## Straight tracks

After the user found staircases in routed copper: 45° and straight segments in turn, where one bend would do.

- **Why Freerouting leaves them.**  Its search goes round each obstacle's clearance octagon, and its optimizer
  pulls a route tight one corner at a time.  A staircase between two points is exactly as long as the path
  with one bend, so neither Freerouting nor the farm's ranking (length and vias) preferred the straighter one.
- **`pcbgen.tidy_tracks`, now on every board** (it was the DATA ×4 v2's alone, for jogs under 0.6 mm).  After the
  import, it walks each chain of the router's segments (one net, layer and width, between vias, pads and
  branches).  It replaces the longest run it can, up to 12 segments, with the fewest straight and 45° segments
  that join the same ends at no more length (`electronics/tools/octilinear.py`): one segment, one bend, or a
  dogleg whose middle segment lies on one of the run's own lines.  It does so only where every clearance holds.
  - It leaves alone what the router saw as fixed: drawn tracks, the differential pairs (they stay side by side),
    the exclusive pours' cores, the fan-out reservations, the footprints' keep-outs.
  - Before that, it widens any router track that Freerouting's neck-down left under the board's minimum width,
    where the clearances allow (below, "The DATA ×4 v2 on 4 layers").
  - `tools/kicad.sh <board> --tidy` runs it on a routed board, without re-routing.
- **Bends are counted** (`route_metrics`: where two segments of a net meet and turn).  They cost 0.5 mm each in the
  farm's ranking (`BEND_MM`): of two runs as long, with as many vias, the straighter wins.

| Board | Committed: bends · vias · copper | Now | Routing |
|---|---|---|---|
| data-port | 56 · 34 · 173.9 mm | the same | kept: nothing the pass can straighten |
| camera-pod | 59 · 38 · 231.0 mm | 48 · 38 · 225.9 mm (bends −19 %) | kept, straightened |
| bay-node | 631 · 401 · 2269.5 mm | 504 · 435 · 2183.2 mm (bends −20 %, copper −4 %) | re-routed (`noneck`), straightened |
| power-hub | 767 · 433 · 3536.8 mm | 655 · 436 · 3446.9 mm (bends −15 %, copper −3 %) | re-routed (`planevia50`), straightened |
| DATA ×4 v2 | 1505 · 810 · 4828.3 mm | 1491 · 810 · 4827.6 mm (bends −1 %) | kept, straightened |

- On the same routing, the pass alone takes 4–19 % of the bends off: the bay node's `ripup30` 607 → 583, the hub's
  single run 709 → 661, the camera pod 59 → 48.  The DATA ×4 v2 already had its jog pass.
- KiCad's DRC is clean after it on all five boards.
- **What stays.**  A staircase stays where it is hemmed in.  On the DATA ×4 v2, buses on In2 and In3 weave
  together between vias: each line follows its neighbour, and only re-routing the group would straighten them.
  The pass can't move vias either: a jog into a via stays.

## Applied (2026-10-22)

Three `design.py` fixes from the findings above, then each changed board re-routed by the portfolio on the fixed
design (`build/farm-fix`).  The best six runs of each were scored again with the straightening pass and ranked
with their bends.

- **Bay node:** In2's +5V outline stops at x 21.7, clear of the +3V3 one.  15 of 17 runs clean.  Best `noneck`
  (neck-down off): 435 vias, 2183.2 mm, 504 bends.  `ripup30`, the best before bends counted (402 vias,
  2212.1 mm, 583 bends), is a near tie on cost: 3307.6 against 3305.2.
- **Power hub:** `buck-vin` is `exclusive`.  14 of 17 runs clean (2 before).  Best `planevia50`: 436 vias,
  3446.9 mm, 655 bends; `order5` a near tie (461 vias, 3413.1 mm, 625 bends).
- **DATA ×4 v2:** its four drawn switch feeds stay.  Without them, the five settings that had been best gave no
  clean run.  `noneck` left 6 links open (SDA, INT, a port's D−).  `order4` and `noopt` left In4's +3V3_CP island
  unconnected: Freerouting joined that net by tracks only, with no via into the island (`noopt` also necked 3
  tracks under the floor).  `single` and
  `planevia50` were still in the one-thread optimizer at the 45 min cap.  Its committed routing is straightened.
- **Data port, camera pod:** routing kept, straightened (`tools/kicad.sh <board> --tidy`).
- All five: ERC 0, copper DRC 0 (the DATA ×4 v2 keeps its 4 silkscreen-over-copper warnings), parity 0, every 3D
  model found.  Fab outputs, the DATA ×4 v2's panel and the viewer's models are regenerated.

## The DATA ×4 v2 on 4 layers

Its 6-layer stackup came from one 4-layer run that left 27–29 links open (88bb19d), before the fixes above.  The
same design at `X4V2_LAYERS=4` (F · GND · power · B), through the portfolio (`--farm farm-4l`, the Mac and
zephyrbox), 2026-10-22:

- **4 clean runs of 16 scored**: `order2` (787 vias, 5172.7 mm), `nofanout-noopt`, `via10-noopt`,
  `via10-order1-noopt`.  The others leave 1–12 links open, a narrow track or a floating island.
- **The optimizer can't finish.**  9 runs reached 0 unrouted, then spent the rest of the 45 min cap in the
  one-thread optimizer and gave no session.  With it off (`-noopt`) they finish in 8–25 min; the straightening
  pass then does much of its work.
- **Neck-down under the floor.**  Most complete runs had 2–5 tracks narrowed to 0.063–0.076 mm (floor 0.09).
  `tidy_tracks` now widens such a track to the board's minimum first, where its clearances allow: all four of
  `order2`'s.  Three runs keep 2 it can't widen.
- **The +3V3_CP island** floats in 6 runs: Freerouting joins that net by tracks only, with no via into In2's
  island, as on 6 layers.  A fan-out via in `design.py` would make the join certain.
- **No via in a small part's pad** (2026-10-23).  `order2` had 29 vias in 27 SMD pads: 8 the QFNs' thermal pads'
  (drawn, accepted unfilled), 18 in 0402/0603 pads and one in a 0.4 mm pin.  JLC fills and caps vias for free
  only from 6 layers, and an open via there drains the joint.  None was Freerouting's (none is in its session):
  - pcbgen's fan-out landed a via on a neighbouring pad of the same net (13, the pin's included);
  - the GND stitching, after routing, put vias on capacitor pads (6), and in later runs on the crystal's.
  Now the fan-out, the pad ties and the stitching keep every via off every SMD pad, and the DSN says
  `(control (via_at_smd off))` (`dsn.no_via_at_smd`) so that Freerouting won't either.  The same 16 settings, optimizer off (`--farm farm-vip`): 4 clean,
  the best `ripup30-order2` with 749 vias, 5194.1 mm and 1932 bends, and only the 8 thermal-pad vias in pads.
  The others leave 2–22 links open, a narrow track (`MARK` on B.Cu) or the floating island.
- **The +3V3_CP island as a fanned-out plane, tried and dropped.**  Grown over every +3V3_CP pad and typed a
  plane, it made Freerouting take the RP2354B's 0.4 mm pins as joined through it, though they have no room for a
  via: 12–14 links open in every run.  A pin with no room would need a drawn link to its decoupling capacitor's
  via first.
- **The rack's board since 2026-10-23** (the user's choice): `electronics/data-port-x4` on 4 layers, routed
  with `ripup30-order2`'s session (750 vias, 5194 mm, 1930 bends once imported), its order panel too.  The 6-layer
  board was kept as `electronics/data-port-x4-6l` until 2026-10-25 (removed; `X4V2_LAYERS=6` still builds
  that stack-up).  The comparison (cost, vias in pads, return paths) is in docs/electronics.md.

## Our own router?

Not from scratch, and no reverse engineering needed: all three are open source.  Freerouting is GPL-3: read for
ideas, don't copy.  KRT and Topola are MIT.  What each does best is now measured:

- **Freerouting:** completion on dense boards (push-and-shove, rip-up and retry) and a well-understood output.
- **KRT:** speed (a Rust A* on a grid), coupled pairs, `.kicad_pcb` in and out, plane stitching.
- **Ours (`pcbgen`):** everything around the router: planes, fan-outs and feeds, pours and stitching, the tidy
  pass, pair tuning, scoring.

The cheap way to combine them, in order:
1. **A hybrid flow** (tried above).  KRT routes the pairs (coupled); they are locked; the Freerouting portfolio
   routes the rest; `pcbgen` tidies.  It works on the simple boards, not yet on the dense one.
2. **Contribute to KRT** what our boards need: per-netclass clearance, hole clearance, KiCad's connectivity as
   the check.  Then it may finish our dense boards as well as fast.
3. **Our own core**, in Rust, only if 1 and 2 fall short.  It would mean months of work to reach Freerouting's
   completion.

## Reproduce

- `tools/route_farm.py`, `electronics/tools/dsn.py` and `electronics/tools/octilinear.py` are in the repo; the tests
  are `tools/tests/test_dsn.py` and `tools/tests/test_octilinear.py`.
- KRT, the hybrid flow and Topola ran from scratch scripts (`bench_krt.py`, `hybrid.py`, `topola_variants.py`).
  They are kept with the renders in the session's notes, not in the repo.
