kartben/hw-testing-rack/tools/bsim-wifi-coex/results/all.csv

afh | beacons | ch | id | mode | node_dbm | nodes | profile | seed | avg_ms | connected_ms | crc_pct | cycles | disconnects | failed | first_connect_ms | ll_ok | ll_sent | loss_pct | max_ms | notifications | p50_ms | p90_ms | rx_bytes | throughput_Bps | timeouts | wifi_duty_pct
False | 11b | 6 | 0 | flow | 11 | 8 | none | 1 |  | 59083 | 0.0 |  | 0 | 0 | 415 | 95563 | 96743 | 1.22 |  | 46775 |  |  | 9355000 | 158336 | 0 | 0.0
False | 11b | 1 | 1 | flow | 20 | 8 | flash | 1 |  | 59083 | 0.55 |  | 0 | 0 | 415 | 84571 | 86191 | 1.88 |  | 41120 |  |  | 8224000 | 139194 | 0 | 8.32
False | 11b | 1 | 2 | flow | 20 | 1 | idle | 1 |  | 59083 | 0.65 |  | 0 | 0 | 415 | 88103 | 89835 | 1.93 |  | 42799 |  |  | 8559800 | 144877 | 0 | 3.43
False | 11b | 1 | 3 | flow | 20 | 4 | idle | 1 |  | 59083 | 0.68 |  | 0 | 0 | 415 | 88342 | 90095 | 1.95 |  | 42907 |  |  | 8581400 | 145243 | 0 | 3.43
False | 11b | 1 | 4 | flow | 20 | 8 | idle | 1 |  | 59083 | 0.66 |  | 0 | 0 | 415 | 88696 | 90438 | 1.93 |  | 43089 |  |  | 8617800 | 145859 | 0 | 3.43
False | 11b | 1 | 5 | flow | 20 | 16 | idle | 1 |  | 59083 | 0.64 |  | 0 | 0 | 415 | 88780 | 90508 | 1.91 |  | 43138 |  |  | 8627600 | 146025 | 0 | 3.43
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
