kartben/hw-testing-rack/tools/bsim-wifi-coex/results/extra.csv

afh | beacons | ch | id | mode | node_dbm | nodes | profile | seed | ap_m | connected_ms | crc_pct | disconnects | failed | first_connect_ms | ll_ok | ll_sent | loss_pct | notifications | rx_bytes | throughput_Bps | timeouts | wifi_duty_pct
False | ofdm | 6 | 0 | flow | 11 | 16 | idle | 1 |  | 59083 | 0.59 | 0 | 0 | 415 | 91707 | 93407 | 1.82 | 44620 | 8924000 | 151041 | 0 | 1.37
False | ofdm | 11 | 1 | flow | 11 | 16 | idle | 1 |  | 59083 | 0.52 | 0 | 0 | 415 | 92070 | 93705 | 1.74 | 44824 | 8964800 | 151732 | 0 | 1.37
False | 11b | 6 | 2 | flow | 11 | 8 | flash | 1 | 1.0 | 59083 | 1.23 | 0 | 0 | 415 | 76061 | 78015 | 2.5 | 36869 | 7373800 | 124804 | 0 | 8.32
False | 11b | 6 | 3 | flow | 11 | 8 | flash | 1 | 3.0 | 59083 | 0.57 | 0 | 0 | 415 | 84713 | 86349 | 1.89 | 41225 | 8245000 | 139549 | 0 | 8.32
False | 11b | 6 | 4 | flow | 11 | 8 | stress | 1 | 1.0 | 59083 | 0.83 | 0 | 0 | 415 | 68389 | 69958 | 2.24 | 33274 | 6654800 | 112634 | 0 | 36.65
False | 11b | 6 | 5 | flow | 11 | 8 | stress | 1 | 3.0 | 59083 | 0.79 | 0 | 0 | 415 | 68608 | 70163 | 2.22 | 33359 | 6671800 | 112922 | 0 | 36.65
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
