kartben/hw-testing-rack/tools/bsim-wifi-coex/results/racks.csv

afh | beacons | ch | id | mode | node_dbm | nodes | profile | seed | avg_ms | bays | connected_ms | crc_pct | cycles | disconnects | dut_m | failed | first_connect_ms | ll_ok | ll_sent | loss_pct | max_ms | notifications | own_m | p50_ms | p90_ms | rx_bytes | setting | throughput_Bps | timeouts | wifi_duty_pct
False | 11b | 6 | 0 | flow | 11 | 8 | none | 1 |  |  | 59083 | 0.0 |  | 0 |  | 0 | 415 | 95563 | 96743 | 1.22 |  | 46775 |  |  |  | 9355000 |  | 158336 | 0 | 0.0
False | 11b | 6 | 1 | flow | 11 | 8 | none | 1 |  |  | 59083 | 0.0 |  | 0 | 0.04 | 0 | 415 | 95563 | 96743 | 1.22 |  | 46775 |  |  |  | 9355000 |  | 158336 | 0 | 0.0
False | 11b | 6 | 2 | disc | 11 | 8 | none | 1 | 109 |  |  | 0.0 | 227 |  |  | 0 |  | 2290 | 2290 | 0.0 | 415 |  |  | 108 | 112 |  |  |  | 0 | 0.0
False | 11b | 6 | 3 | flow | 11 | 8 | idle | 1 |  | 8 | 59083 | 0.63 |  | 0 |  | 0 | 415 | 90641 | 92374 | 1.88 |  | 44077 |  |  |  | 8815400 | today | 149203 | 0 | 3.43
True | 11b | 6 | 4 | flow | 11 | 8 | idle | 1 |  | 8 | 59083 | 0.0 |  | 0 |  | 0 | 415 | 95563 | 96743 | 1.22 |  | 46775 |  |  |  | 9355000 | today | 158336 | 0 | 3.43
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
