kartben/hw-testing-rack/tools/ns3-wifi-capacity/results/summary.md

# ns-3 rack Wi-Fi sweeps: means over seeds

### idle

| bays | beacon11b | airtime % | ping p95 ms | HTTP p95 ms | runs |
|---|---|---|---|---|---|
| 8 | 0 | 1.1 | 0.31 | 0.8 | 3 |
| 8 | 1 | 2.6 | 0.31 | 0.9 | 3 |
| 16 | 0 | 1.9 | 0.31 | 1.0 | 3 |
| 16 | 1 | 3.6 | 0.31 | 1.1 | 2 (+1 dropped) |

### ci_n

| active | airtime % | USB/IP kB/s per node | worst node kB/s | total MB/s | ping p95 ms | HTTP p50 ms | HTTP p95 ms | HTTP p99 ms | MAC retx % | TCP retx % | runs |
|---|---|---|---|---|---|---|---|---|---|---|---|
| 1 | 11 | 362 | 362 | 0.36 | 1.0 | 0.8 | 2 | 2 | 3 | 0.00 | 4 |
| 2 | 20 | 362 | 362 | 0.72 | 1.3 | 0.8 | 2 | 4 | 7 | 0.00 | 4 |
| 4 | 36 | 362 | 362 | 1.45 | 2.5 | 1.1 | 4 | 5 | 33 | 0.00 | 4 |
| 6 | 53 | 362 | 362 | 2.17 | 3.1 | 2.1 | 6 | 12 | 38 | 0.00 | 4 |
| 8 | 70 | 362 | 362 | 2.90 | 7.8 | 6.1 | 15 | 29 | 65 | 0.00 | 4 |
| 12 | 81 | 268 | 259 | 3.21 | 67.5 | 86.8 | 125 | 148 | 100 | 0.00 | 3 (+1 dropped) |
| 16 | 79 | 166 | 158 | 2.65 | 103.7 | 123.8 | 199 | 271 | 97 | 0.00 | 3 (+1 dropped) |

### ci_up

| active | airtime % | USB/IP kB/s per node | worst node kB/s | total MB/s | ping p95 ms | HTTP p50 ms | HTTP p95 ms | HTTP p99 ms | MAC retx % | TCP retx % | runs |
|---|---|---|---|---|---|---|---|---|---|---|---|
| 1 | 10 | 362 | 362 | 0.36 | 0.8 | 0.8 | 2 | 3 | 35 | 0.00 | 3 |
| 4 | 34 | 362 | 362 | 1.45 | 1.4 | 1.1 | 3 | 6 | 44 | 0.00 | 3 |
| 8 | 70 | 362 | 362 | 2.90 | 9.7 | 6.0 | 20 | 41 | 65 | 0.00 | 3 |
| 12 | 88 | 298 | 287 | 3.57 | 106.9 | 123.3 | 199 | 337 | 87 | 0.00 | 2 (+1 dropped) |
| 16 | 88 | 210 | 197 | 3.36 | 158.9 | 164.4 | 268 | 438 | 86 | 0.01 | 2 (+1 dropped) |

### ci_cam

| active | cams | airtime % | USB/IP kB/s per node | worst node kB/s | total MB/s | HTTP p50 ms | HTTP p95 ms | HTTP p99 ms | MAC retx % | camera fps | frames skipped % | camera kB/s | runs |
|---|---|---|---|---|---|---|---|---|---|---|---|---|---|
| 1 | 1 | 15 | 362 | 362 | 0.36 | 0.8 | 2 | 7 | 15 | 5.0 | 0 | 224 | 3 |
| 1 | 2 | 18 | 362 | 362 | 0.36 | 0.8 | 5 | 8 | 24 | 5.0 | 0 | 225 | 3 |
| 1 | 3 | 22 | 362 | 362 | 0.36 | 0.8 | 6 | 9 | 30 | 5.0 | 0 | 225 | 3 |
| 4 | 1 | 40 | 362 | 362 | 1.45 | 1.3 | 6 | 14 | 29 | 5.0 | 0 | 224 | 3 |
| 4 | 2 | 43 | 362 | 362 | 1.45 | 1.3 | 8 | 12 | 36 | 5.0 | 0 | 222 | 3 |
| 4 | 3 | 48 | 362 | 362 | 1.45 | 1.6 | 13 | 20 | 43 | 5.0 | 0 | 222 | 3 |
| 4 | 8 | 68 | 362 | 362 | 1.45 | 7.5 | 35 | 47 | 65 | 5.0 | 0 | 223 | 3 |
| 8 | 1 | 74 | 362 | 362 | 2.90 | 9.8 | 31 | 43 | 74 | 5.0 | 0 | 224 | 3 |
| 8 | 2 | 77 | 362 | 362 | 2.90 | 14.3 | 41 | 54 | 78 | 5.0 | 0 | 222 | 3 |
| 8 | 3 | 81 | 362 | 362 | 2.90 | 27.0 | 57 | 77 | 84 | 5.0 | 0 | 222 | 3 |
| 8 | 8 | 87 | 270 | 260 | 2.16 | 80.5 | 134 | 207 | 100 | 5.0 | 1 | 222 | 3 |
| 16 | 1 | 79 | 155 | 145 | 2.47 | 131.7 | 216 | 296 | 98 | 4.6 | 8 | 211 | 2 (+1 dropped) |
| 16 | 2 | 80 | 142 | 135 | 2.27 | 148.8 | 242 | 296 | 98 | 4.5 | 11 | 201 | 2 (+1 dropped) |
| 16 | 3 | 80 | 132 | 125 | 2.11 | 162.2 | 241 | 329 | 98 | 4.1 | 19 | 182 | 2 (+1 dropped) |
| 16 | 16 | 84 | 66 | 61 | 1.06 | 317.4 | 490 | 645 | 103 | 2.4 | 51 | 109 | 2 (+1 dropped) |

### cam_only

| cams | airtime % | HTTP p95 ms | camera fps | frames skipped % | camera kB/s | runs |
|---|---|---|---|---|---|---|
| 1 | 7 | 2 | 5.0 | 0 | 221 | 2 (+1 dropped) |
| 2 | 11 | 7 | 5.0 | 0 | 222 | 2 (+1 dropped) |
| 4 | 19 | 7 | 5.0 | 0 | 225 | 2 (+1 dropped) |
| 8 | 34 | 16 | 5.0 | 0 | 226 | 2 (+1 dropped) |
| 12 | 51 | 26 | 5.0 | 0 | 226 | 2 (+1 dropped) |
| 16 | 69 | 57 | 5.0 | 0 | 225 | 2 (+1 dropped) |

### power_dist

| active | txPower | apDist | airtime % | USB/IP kB/s per node | HTTP p95 ms | MAC retx % | runs |
|---|---|---|---|---|---|---|---|
| 8 | 8 | 1 | 67 | 362 | 12 | 53 | 3 |
| 8 | 8 | 2 | 70 | 362 | 16 | 67 | 3 |
| 8 | 8 | 3 | 70 | 362 | 19 | 66 | 3 |
| 8 | 11 | 1 | 68 | 362 | 12 | 53 | 3 |
| 8 | 11 | 2 | 70 | 362 | 15 | 67 | 3 |
| 8 | 11 | 3 | 71 | 362 | 18 | 67 | 3 |
| 8 | 20 | 1 | 71 | 362 | 18 | 67 | 3 |
| 8 | 20 | 2 | 71 | 362 | 18 | 67 | 3 |
| 8 | 20 | 3 | 70 | 362 | 17 | 67 | 3 |
| 16 | 8 | 1 | 82 | 233 | 220 | 87 | 3 |
| 16 | 8 | 2 | 79 | 167 | 189 | 97 | 2 (+1 dropped) |
| 16 | 8 | 3 | 79 | 166 | 191 | 97 | 2 (+1 dropped) |
| 16 | 11 | 1 | 82 | 231 | 234 | 87 | 3 |
| 16 | 11 | 2 | 79 | 165 | 202 | 97 | 2 (+1 dropped) |
| 16 | 11 | 3 | 79 | 168 | 205 | 98 | 2 (+1 dropped) |
| 16 | 20 | 1 | 79 | 167 | 193 | 98 | 2 (+1 dropped) |
| 16 | 20 | 2 | 79 | 164 | 199 | 97 | 2 (+1 dropped) |
| 16 | 20 | 3 | 79 | 167 | 196 | 98 | 2 (+1 dropped) |

### beacon

| active | beacon11b | airtime % | USB/IP kB/s per node | HTTP p95 ms | runs |
|---|---|---|---|---|---|
| 8 | 0 | 69 | 362 | 13 | 3 |
| 8 | 1 | 70 | 362 | 15 | 3 |
| 16 | 0 | 79 | 170 | 183 | 3 |
| 16 | 1 | 79 | 165 | 202 | 2 (+1 dropped) |

### harsh

| active | beacon11b | airtime % | USB/IP kB/s per node | worst node kB/s | total MB/s | ping p95 ms | HTTP p50 ms | HTTP p95 ms | HTTP p99 ms | MAC retx % | TCP retx % | DUT Wi-Fi Mbit/s | neighbour Mbit/s | runs |
|---|---|---|---|---|---|---|---|---|---|---|---|---|---|---|
| 1 | 0 | 58 | 362 | 362 | 0.36 | 3.9 | 2.0 | 6 | 9 | 38 | 0.00 | 8.0 | 10.0 | 3 |
| 1 | 1 | 59 | 362 | 362 | 0.36 | 4.0 | 2.4 | 7 | 14 | 38 | 0.00 | 8.0 | 10.0 | 3 |
| 4 | 0 | 81 | 362 | 362 | 1.45 | 40.9 | 25.4 | 64 | 94 | 106 | 0.00 | 8.0 | 10.0 | 3 |
| 4 | 1 | 82 | 362 | 362 | 1.45 | 44.8 | 32.7 | 83 | 136 | 109 | 0.00 | 8.0 | 10.0 | 3 |
| 8 | 0 | 83 | 163 | 155 | 1.31 | 151.7 | 128.3 | 253 | 346 | 115 | 0.00 | 8.0 | 10.0 | 3 |
| 8 | 1 | 83 | 160 | 151 | 1.28 | 152.0 | 126.3 | 275 | 408 | 115 | 0.00 | 8.0 | 10.0 | 3 |
| 16 | 0 | 81 | 41 | 37 | 0.65 | 436.2 | 500.1 | 814 | 1240 | 106 | 0.18 | 8.0 | 10.0 | 3 |
| 16 | 1 | 82 | 40 | 33 | 0.63 | 459.8 | 511.0 | 829 | 1117 | 105 | 0.23 | 8.0 | 10.0 | 3 |

### channel

| active | rackChannel | dutChannel | neighbourChannel | airtime % | USB/IP kB/s per node | worst node kB/s | total MB/s | ping p95 ms | HTTP p50 ms | HTTP p95 ms | HTTP p99 ms | MAC retx % | TCP retx % | DUT Wi-Fi Mbit/s | neighbour Mbit/s | runs |
|---|---|---|---|---|---|---|---|---|---|---|---|---|---|---|---|---|
| 1 | 6 | 6 | 6 | 59 | 362 | 362 | 0.36 | 4.1 | 2.3 | 8 | 12 | 39 | 0.00 | 8.0 | 10.0 | 4 |
| 1 | 11 | 6 | 6 | 33 | 362 | 362 | 0.36 | 1.6 | 1.2 | 3 | 4 | 20 | 0.00 | 8.0 | 10.0 | 4 |
| 1 | 11 | 11 | 6 | 36 | 362 | 362 | 0.36 | 2.1 | 1.1 | 4 | 6 | 20 | 0.00 | 8.0 | 10.0 | 4 |
| 4 | 6 | 6 | 6 | 82 | 362 | 362 | 1.45 | 44.4 | 33.6 | 80 | 127 | 109 | 0.00 | 8.0 | 10.0 | 4 |
| 4 | 11 | 6 | 6 | 57 | 362 | 362 | 1.45 | 4.1 | 2.4 | 6 | 9 | 51 | 0.00 | 8.0 | 10.0 | 3 |
| 4 | 11 | 11 | 6 | 63 | 362 | 362 | 1.45 | 6.6 | 3.7 | 11 | 20 | 54 | 0.00 | 8.0 | 10.0 | 4 |
| 8 | 6 | 6 | 6 | 83 | 155 | 144 | 1.24 | 164.0 | 137.9 | 282 | 388 | 115 | 0.00 | 8.0 | 10.0 | 4 |
| 8 | 11 | 6 | 6 | 83 | 339 | 327 | 2.71 | 57.3 | 63.2 | 107 | 142 | 121 | 0.00 | 8.0 | 10.0 | 4 |
| 8 | 11 | 11 | 6 | 81 | 256 | 244 | 2.05 | 83.7 | 80.9 | 148 | 224 | 115 | 0.00 | 8.0 | 10.0 | 10 |
| 16 | 6 | 6 | 6 | 82 | 37 | 28 | 0.59 | 471.8 | 529.6 | 916 | 1718 | 107 | 0.32 | 8.0 | 10.0 | 4 |
| 16 | 11 | 6 | 6 | 80 | 107 | 101 | 1.71 | 165.3 | 190.0 | 311 | 410 | 110 | 0.00 | 8.0 | 10.0 | 7 (+1 dropped) |
| 16 | 11 | 11 | 6 | 78 | 74 | 70 | 1.19 | 244.0 | 275.8 | 456 | 538 | 102 | 0.00 | 8.0 | 10.0 | 7 (+3 dropped) |

### channel_near

| active | rackChannel | dutChannel | neighbourChannel | airtime % | USB/IP kB/s per node | worst node kB/s | total MB/s | ping p95 ms | HTTP p50 ms | HTTP p95 ms | HTTP p99 ms | MAC retx % | TCP retx % | DUT Wi-Fi Mbit/s | neighbour Mbit/s | runs |
|---|---|---|---|---|---|---|---|---|---|---|---|---|---|---|---|---|
| 1 | 6 | 6 | 6 | 59 | 362 | 362 | 0.36 | 4.2 | 2.4 | 7 | 10 | 39 | 0.00 | 8.0 | 10.0 | 4 |
| 1 | 11 | 6 | 6 | 35 | 357 | 357 | 0.36 | 1.9 | 1.2 | 606 | 1209 | 24 | 0.38 | 8.0 | 10.0 | 5 |
| 1 | 11 | 11 | 6 | 36 | 362 | 362 | 0.36 | 2.3 | 1.1 | 4 | 5 | 20 | 0.00 | 8.0 | 10.0 | 6 |
| 4 | 6 | 6 | 6 | 82 | 363 | 362 | 1.45 | 50.2 | 34.5 | 87 | 144 | 109 | 0.00 | 8.0 | 10.0 | 4 |
| 4 | 11 | 6 | 6 | 57 | 307 | 233 | 1.23 | 10.9 | 3.3 | 1245 | 3009 | 61 | 2.66 | 8.0 | 10.0 | 5 |
| 4 | 11 | 11 | 6 | 63 | 362 | 362 | 1.45 | 6.3 | 3.4 | 12 | 19 | 57 | 0.00 | 8.0 | 10.0 | 6 |
| 8 | 6 | 6 | 6 | 83 | 156 | 148 | 1.25 | 153.0 | 131.2 | 283 | 371 | 114 | 0.00 | 8.0 | 10.0 | 4 |
| 8 | 11 | 6 | 6 | 59 | 161 | 25 | 1.29 | 21.6 | 6.1 | 3006 | 3018 | 65 | 2.95 | 8.0 | 10.0 | 2 |
| 8 | 11 | 11 | 6 | 81 | 258 | 245 | 2.07 | 80.5 | 80.3 | 150 | 201 | 115 | 0.00 | 8.0 | 10.0 | 6 |
| 16 | 6 | 6 | 6 | 82 | 39 | 34 | 0.62 | 460.3 | 519.7 | 909 | 1433 | 103 | 0.31 | 8.0 | 10.0 | 4 |
| 16 | 11 | 6 | 6 | 82 | 118 | 0 | 1.89 | 131.5 | 109.1 | 3095 | 3162 | 109 | 1.36 | 8.0 | 10.0 | 2 |
| 16 | 11 | 11 | 6 | 79 | 76 | 72 | 1.22 | 242.1 | 268.3 | 442 | 549 | 100 | 0.00 | 8.0 | 10.0 | 6 |

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
| 12 | 16 | 84 | 278 | 3.34 | 116 | 121 | 2 (+1 dropped) |
| 12 | 32 | 84 | 278 | 3.34 | 116 | 121 | 2 (+1 dropped) |
| 16 | 6 | 79 | 165 | 2.65 | 202 | 97 | 2 (+1 dropped) |
| 16 | 16 | 83 | 177 | 2.83 | 214 | 120 | 2 (+1 dropped) |
| 16 | 32 | 83 | 177 | 2.83 | 214 | 120 | 2 (+1 dropped) |
