kartben/hw-testing-rack/tools/ns3-wifi-capacity/results/ampdu.csv

scenario | bays | active | cams | txPower | apDist | beacon11b | usbipDir | ampduMpdus | seed | assoc | stas | dead | airtime_pct | ping_p50_ms | ping_p95_ms | ping_p99_ms | ping_loss_pct | http_n | http_p50_ms | http_p95_ms | http_p99_ms | http_timeouts | scrape_p95_ms | mac_ok | mac_retx | mac_fail | mac_retx_pct | tcp_segs | tcp_retx | tcp_retx_pct | usbip_offered_kBps | usbip_goodput_kBps | usbip_goodput_min_kBps | cam_fps | cam_skipped_pct | cam_kBps | dut_goodput_Mbps | neighbour_goodput_Mbps | wall_s
ci | 8 | 8 | 0 | 11 | 2 | 1 | down | 6 | 3 | 9 | 9 | 0 | 69.6975 | 2.76992 | 8.26645 | 13.4686 | 0 | 139 | 6.72333 | 13.3896 | 16.8044 | 0 | 10.0248 | 66059 | 43511 | 0 | 65.8669 | 61722 | 0 | 0 | 361.984 | 361.984 | 361.882 | nan | nan | nan | 0 | 0 | 14.0244
ci | 8 | 8 | 0 | 11 | 2 | 1 | down | 6 | 2 | 9 | 9 | 0 | 70.8616 | 2.9724 | 8.30958 | 19.9579 | 0 | 173 | 6.17696 | 14.8772 | 26.2627 | 0 | 22.2707 | 66397 | 44825 | 0 | 67.5106 | 61753 | 0 | 0 | 361.933 | 361.966 | 361.882 | nan | nan | nan | 0 | 0 | 14.3989
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
