kartben/hw-testing-rack/tools/ns3-wifi-capacity/results/beacon.csv

scenario | bays | active | cams | txPower | apDist | beacon11b | usbipDir | ampduMpdus | seed | assoc | stas | dead | airtime_pct | ping_p50_ms | ping_p95_ms | ping_p99_ms | ping_loss_pct | http_n | http_p50_ms | http_p95_ms | http_p99_ms | http_timeouts | scrape_p95_ms | mac_ok | mac_retx | mac_fail | mac_retx_pct | tcp_segs | tcp_retx | tcp_retx_pct | usbip_offered_kBps | usbip_goodput_kBps | usbip_goodput_min_kBps | cam_fps | cam_skipped_pct | cam_kBps | dut_goodput_Mbps | neighbour_goodput_Mbps | wall_s
ci | 8 | 8 | 0 | 11 | 2 | 0 | down | 6 | 3 | 9 | 9 | 0 | 68.4941 | 2.94344 | 7.41249 | 12.5542 | 0 | 139 | 5.74326 | 11.9842 | 14.8386 | 0 | 12.5784 | 66077 | 42739 | 0 | 64.6806 | 61732 | 0 | 0 | 362.061 | 362.019 | 361.882 | nan | nan | nan | 0 | 0 | 14.2213
ci | 8 | 8 | 0 | 11 | 2 | 0 | down | 6 | 2 | 9 | 9 | 0 | 68.679 | 2.40881 | 7.32379 | 16.2082 | 0 | 173 | 5.68162 | 13.1421 | 15.4282 | 0 | 13.2166 | 66359 | 43027 | 0 | 64.8397 | 61760 | 0 | 0 | 361.984 | 362.001 | 361.882 | nan | nan | nan | 0 | 0 | 14.288
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
