kartben/hw-testing-rack/tools/ns3-wifi-capacity/results/cam_only.csv

scenario | bays | active | cams | txPower | apDist | beacon11b | usbipDir | ampduMpdus | seed | assoc | stas | dead | airtime_pct | ping_p50_ms | ping_p95_ms | ping_p99_ms | ping_loss_pct | http_n | http_p50_ms | http_p95_ms | http_p99_ms | http_timeouts | scrape_p95_ms | mac_ok | mac_retx | mac_fail | mac_retx_pct | tcp_segs | tcp_retx | tcp_retx_pct | usbip_offered_kBps | usbip_goodput_kBps | usbip_goodput_min_kBps | cam_fps | cam_skipped_pct | cam_kBps | dut_goodput_Mbps | neighbour_goodput_Mbps | wall_s
ci | 16 | 0 | 1 | 11 | 2 | 1 | down | 6 | 3 | 17 | 17 | 2 | 7.04453 | 0.303702 | 1.89283 | 4.38514 | 12.5 | 252 | 0.79794 | 2.08988 | 4.81515 | 30 | 6.77684 | 6412 | 1471 | 204 | 22.234 | 3531 | 0 | 0 | nan | nan | nan | 5 | 0 | 226.441 | 0 | 0 | 1.81665
ci | 16 | 0 | 1 | 11 | 2 | 1 | down | 6 | 2 | 17 | 17 | 0 | 7.19755 | 0.302856 | 0.833457 | 3.35453 | 0 | 305 | 0.800243 | 2.06956 | 4.59176 | 0 | 1.05967 | 6897 | 1475 | 0 | 21.3861 | 3602 | 0 | 0 | nan | nan | nan | 5 | 0 | 225.092 | 0 | 0 | 1.90173
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
