kartben/hw-testing-rack/electronics/data-port-x6/docs/data-port-x6-schematic.pdf

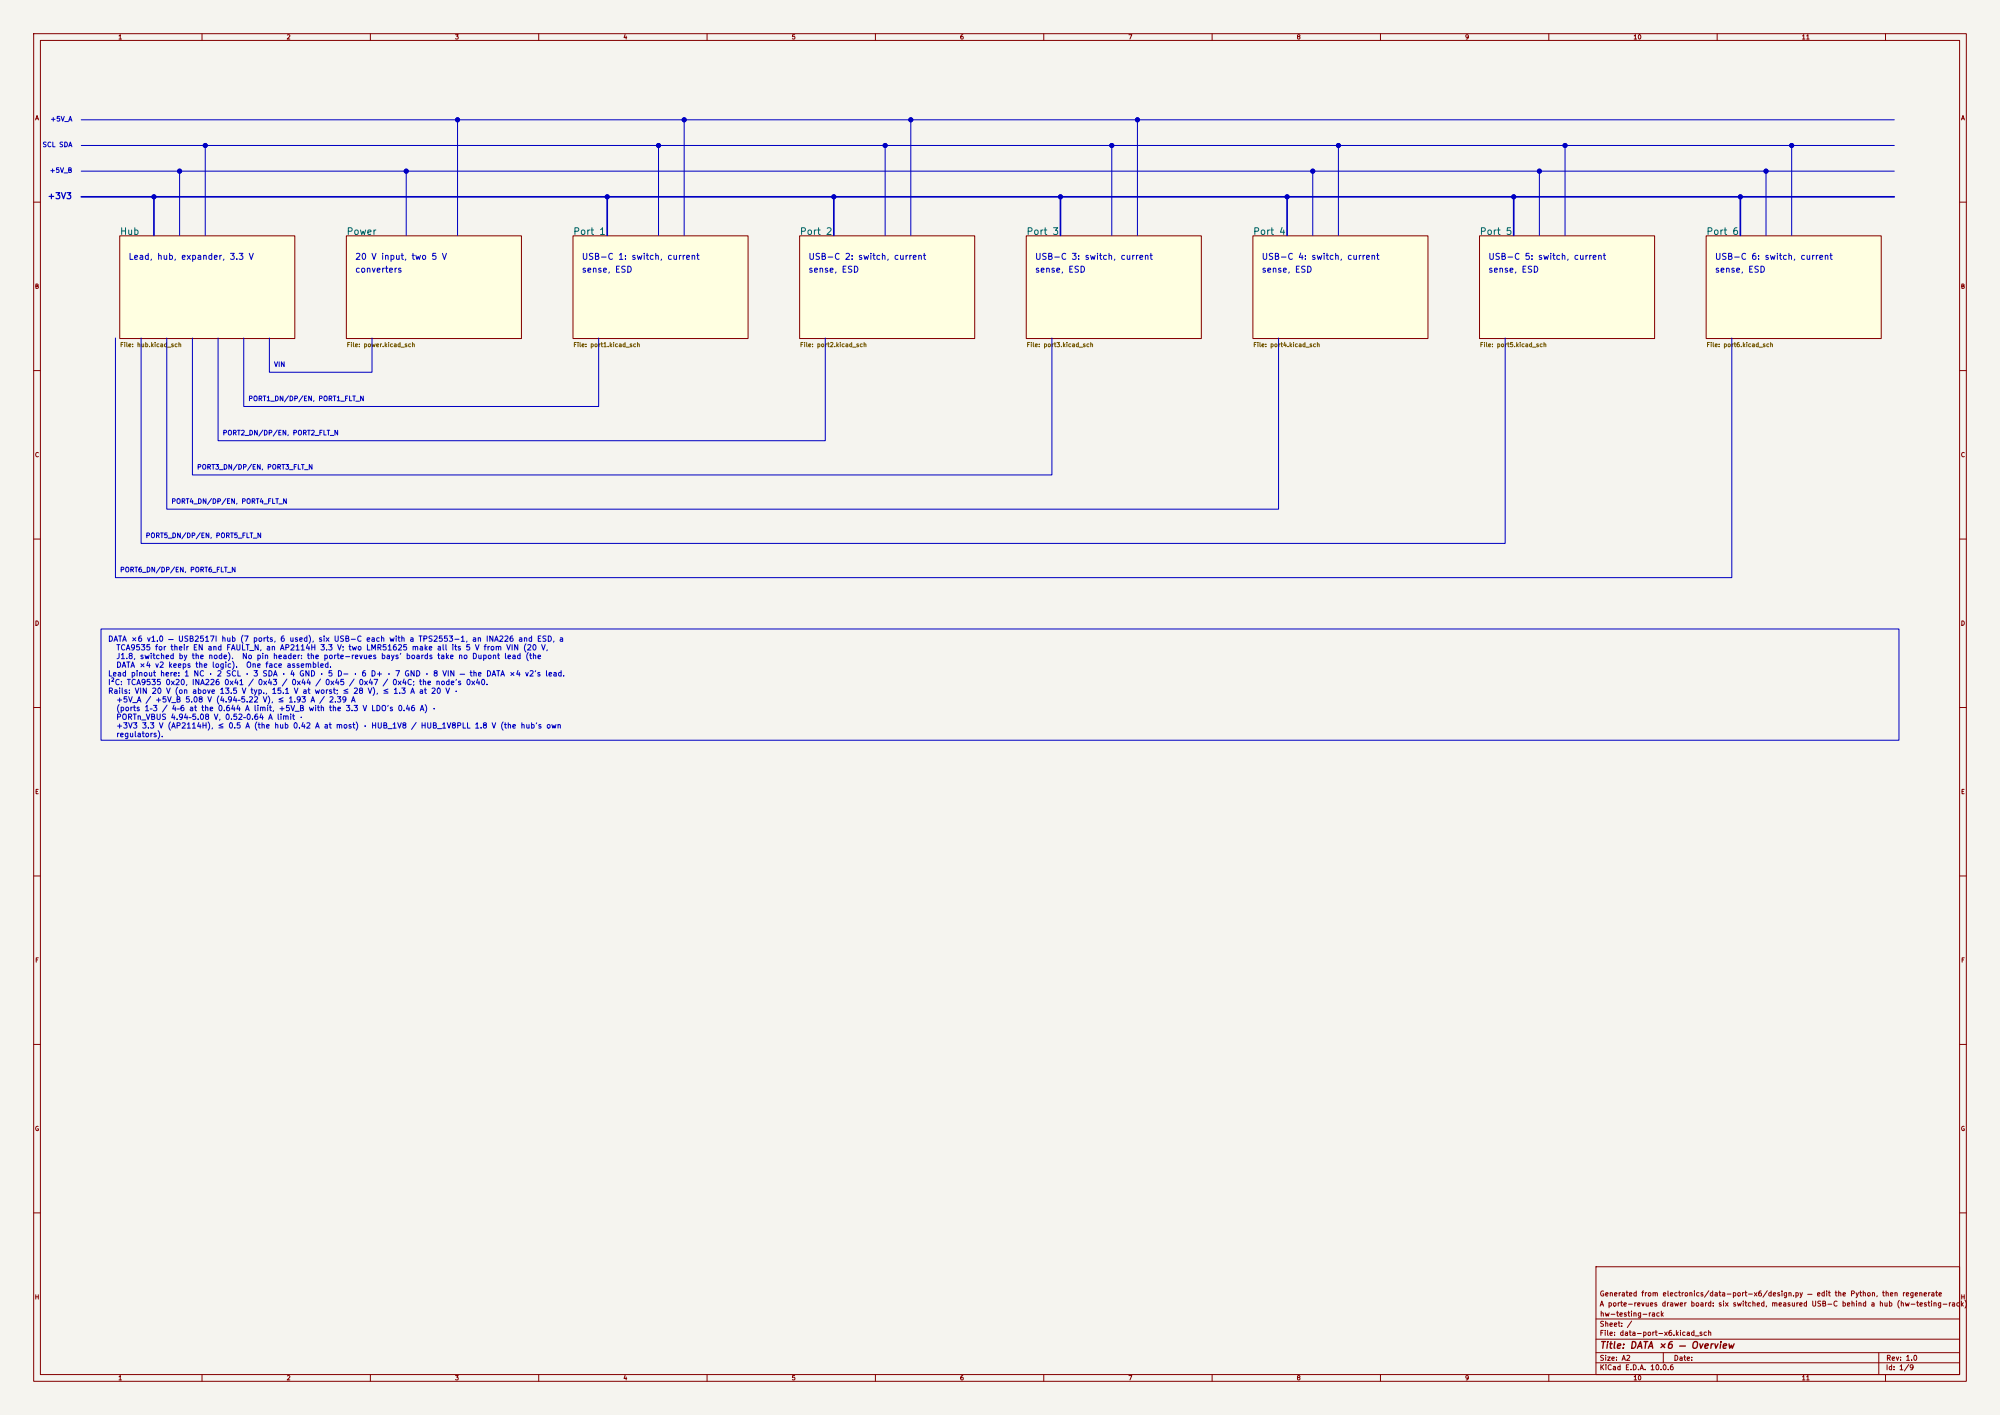
[picture p169: page 1]

DATA ×6 v1.0 — USB2517I hub (7 ports, 6 used), six USB-C each with a TPS2553-1, an INA226 and ESD, a
TCA9535 for their EN and FAULT_N, an AP2114H 3.3 V; two LMR51625 make all its 5 V from VIN (20 V,
Lead pinout here: 1 NC · 2 SCL · 3 SDA · 4 GND · 5 D− · 6 D+ · 7 GND · 8 VIN — the DATA ×4 v2's lead.
I²C: TCA9535 0x20, INA226 0x41 / 0x43 / 0x44 / 0x45 / 0x47 / 0x4C; the node's 0x40.
Rails: VIN 20 V (on above 13.5 V typ., 15.1 V at worst; ≤ 28 V), ≤ 1.3 A at 20 V · +5V_A / +5V_B 5.08 V (4.94–5.22 V), ≤ 1.93 A / 2.39 A

(ports 1–3 / 4–6 at the 0.644 A limit, +5V_B with the 3.3 V LDO's 0.46 A) · PORTn_VBUS 4.94–5.08 V, 0.52–0.64 A limit · +3V3 3.3 V (AP2114H), ≤ 0.5 A (the hub 0.42 A at most) · HUB_1V8 / HUB_1V8PLL 1.8 V (the hub's own

Generated from electronics/data-port-x6/design.py — edit the Python, then regenerate
A porte-revues drawer board: six switched, measured USB-C behind a hub (hw-testing-rack)
hw-testing-rack
Sheet: /
File: data-port-x6.kicad_sch
Title: DATA ×6 — Overview

Size: A2 | Rev: 1.0
KiCad E.D.A. 10.0.6 | Id: 1/9

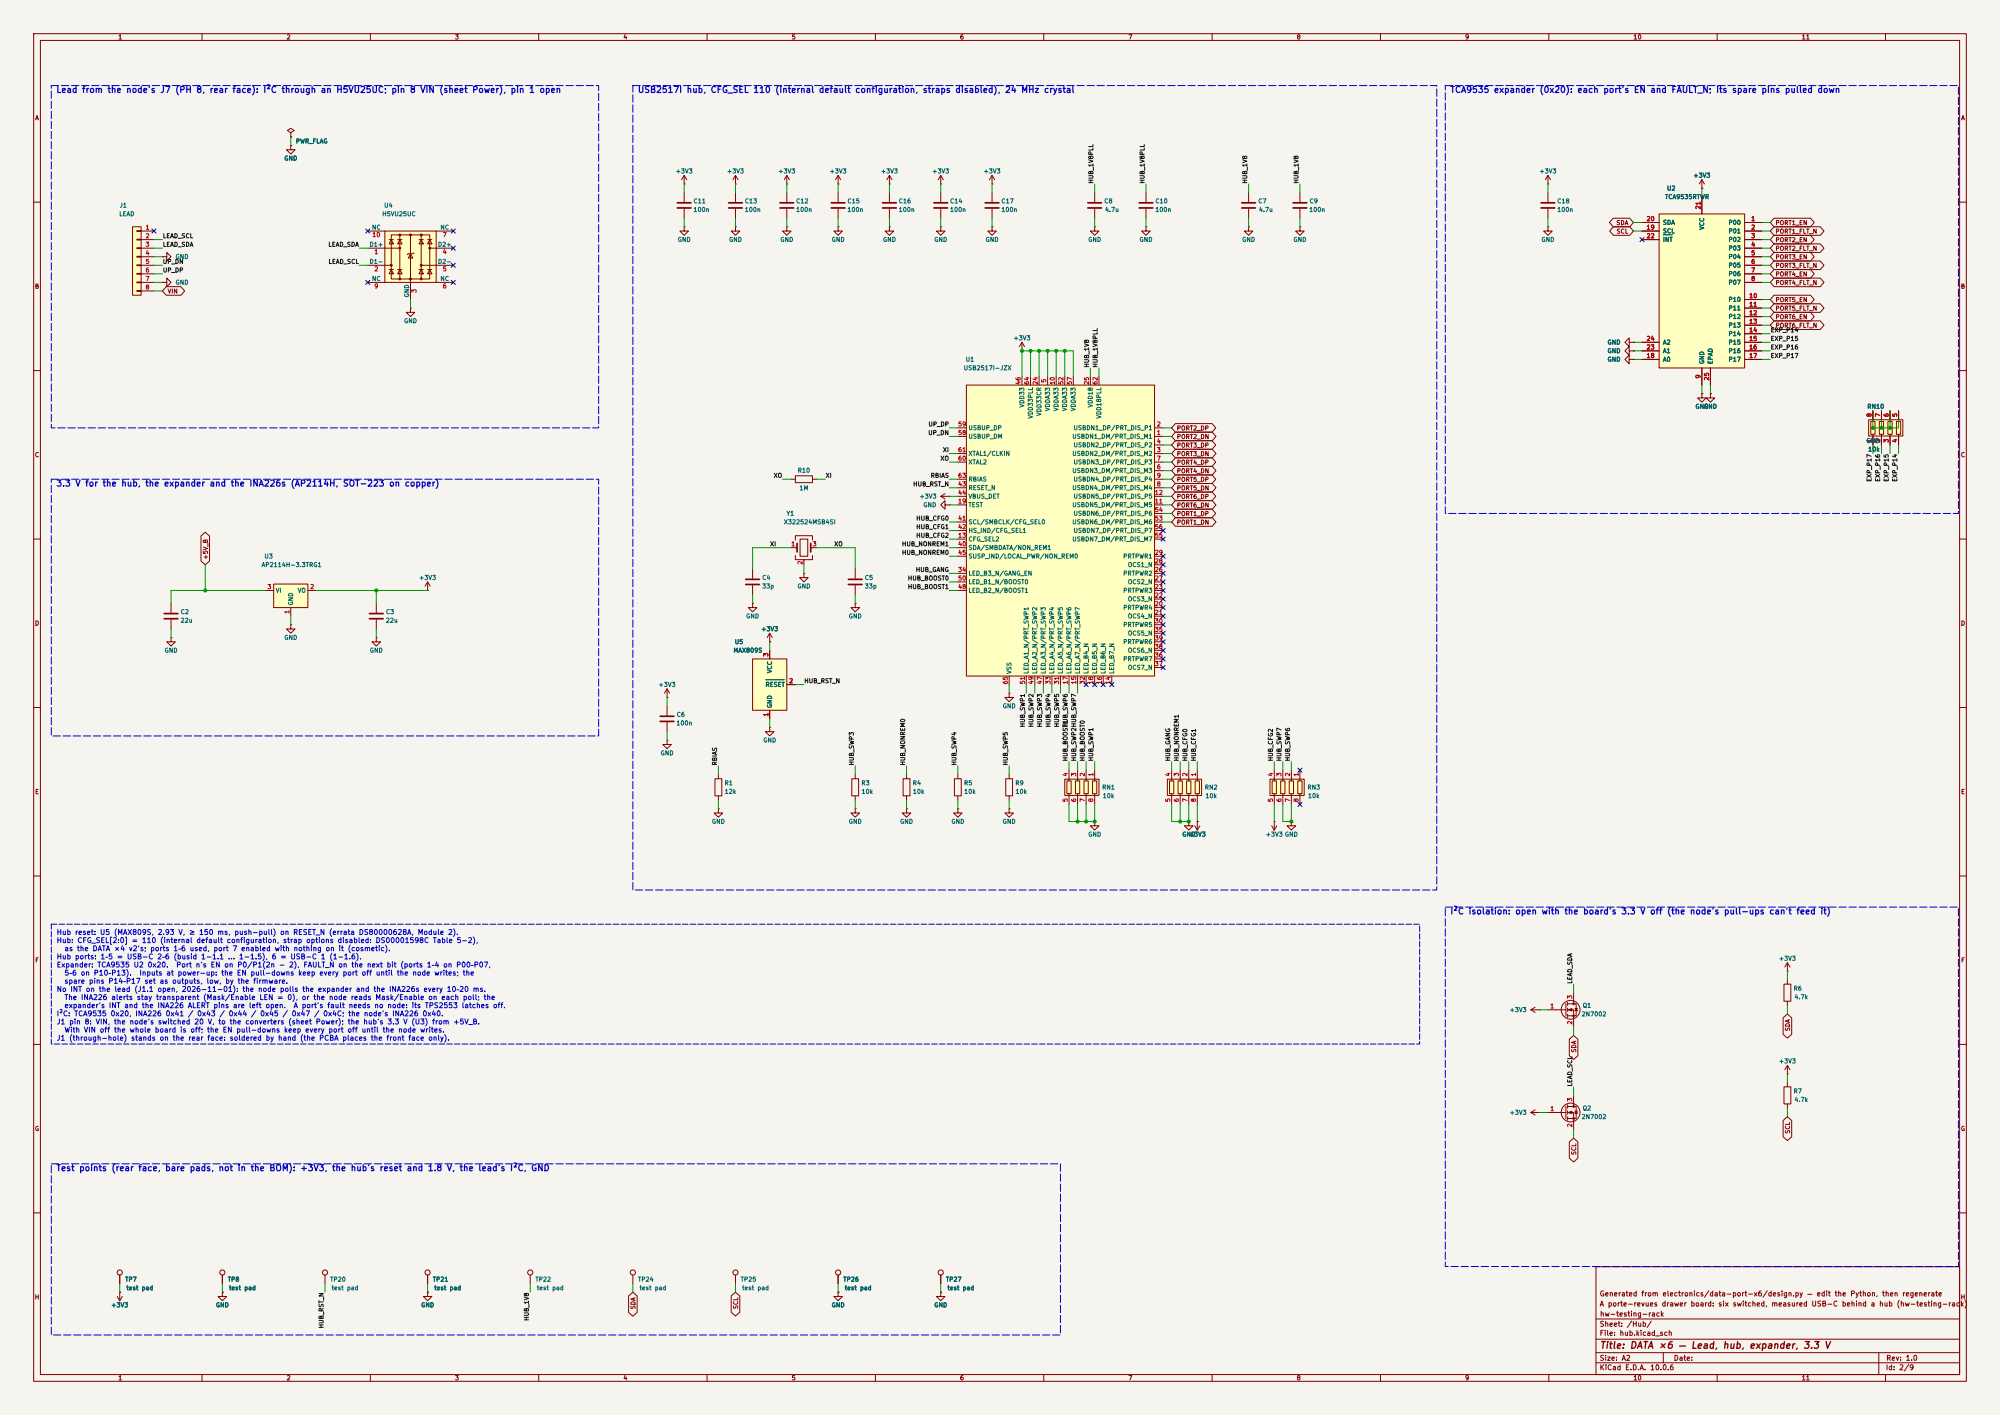
[picture p170: page 2]

TCA9535 expander (0x20): each port's EN and FAULT_N; its spare pins pulled down
TCA9535RTWR

UP_DP Hub reset: U5 (MAX809S, 2.93 V, ≥ 150 ms, push-pull) on RESET_N (errata DS80000628A, Module 2).

3.3 V for the hub, the expander and the INA226s (AP2114H, SOT-223 on copper)

I²C isolation: open with the board's 3.3 V off (the node's pull-ups can't feed it)

Hub: CFG_SEL[2:0] = 110 (internal default configuration, strap options disabled: DS00001598C Table 5-2), as the DATA ×4 v2's; ports 1–6 used, port 7 enabled with nothing on it (cosmetic).

Hub ports: 1–5 = USB-C 2–6 (busid 1-1.1 … 1-1.5), 6 = USB-C 1 (1-1.6).
Expander: TCA9535 U2 0x20. Port n's EN on P0/P1(2n − 2), FAULT_N on the next bit (ports 1–4 on P00–P07,
5–6 on P10–P13). Inputs at power-up: the EN pull-downs keep every port off until the node writes; the
spare pins P14–P17 set as outputs, low, by the firmware.
No INT on the lead (J1.1 open, 2026-11-01): the node polls the expander and the INA226s every 10–20 ms. The INA226 alerts stay transparent (Mask/Enable LEN = 0), or the node reads Mask/Enable on each poll; the

expander's INT and the INA226 ALERT pins are left open. A port's fault needs no node: its TPS2553 latches off.
I²C: TCA9535 0x20, INA226 0x41 / 0x43 / 0x44 / 0x45 / 0x47 / 0x4C; the node's INA226 0x40.
J1 pin 8: VIN, the node's switched 20 V, to the converters (sheet Power); the hub's 3.3 V (U3) from +5V_B.
With VIN off the whole board is off; the EN pull-downs keep every port off until the node writes.
J1 (through-hole) stands on the rear face: soldered by hand (the PCBA places the front face only).

Test points (rear face, bare pads, not in the BOM): +3V3, the hub's reset and 1.8 V, the lead's I²C, GND

Generated from electronics/data-port-x6/design.py — edit the Python, then regenerate
A porte-revues drawer board: six switched, measured USB-C behind a hub (hw-testing-rack)
hw-testing-rack
Sheet: /Hub/
File: hub.kicad_sch
Title: DATA ×6 — Lead, hub, expander, 3.3 V

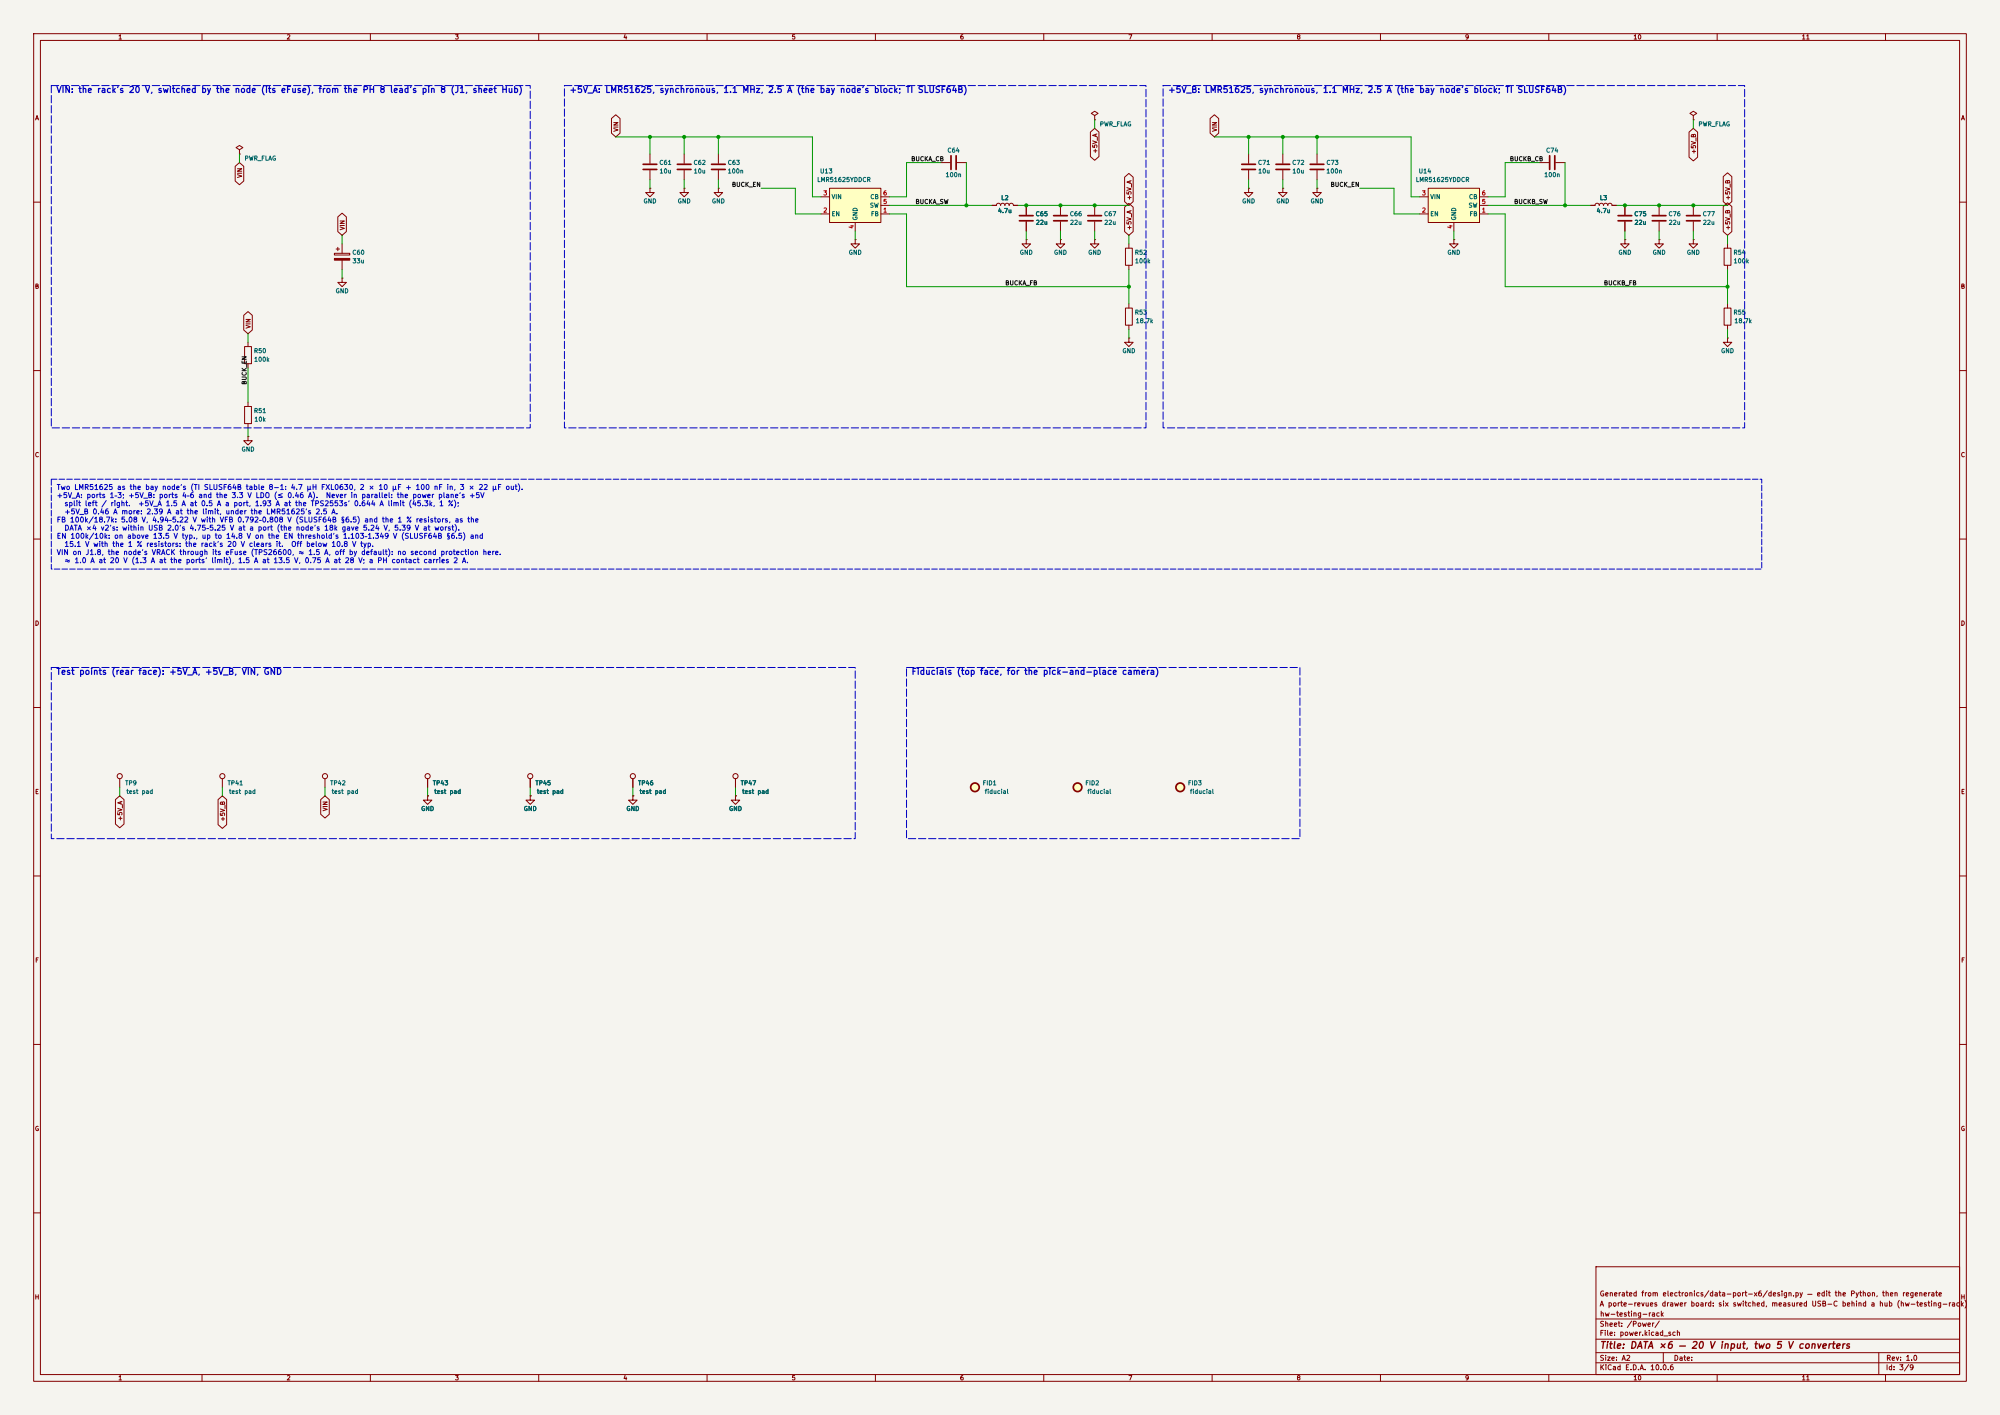
[picture p171: page 3]

Two LMR51625 as the bay node's (TI SLUSF64B table 8-1: 4.7 µH FXL0630, 2 × 10 µF + 100 nF in, 3 × 22 µF out).
+5V_A: ports 1–3; +5V_B: ports 4–6 and the 3.3 V LDO (≤ 0.46 A). Never in parallel: the power plane's +5V
split left / right. +5V_A 1.5 A at 0.5 A a port, 1.93 A at the TPS2553s' 0.644 A limit (45.3k, 1 %);
+5V_B 0.46 A more: 2.39 A at the limit, under the LMR51625's 2.5 A.
FB 100k/18.7k: 5.08 V, 4.94–5.22 V with VFB 0.792–0.808 V (SLUSF64B §6.5) and the 1 % resistors, as the
DATA ×4 v2's: within USB 2.0's 4.75–5.25 V at a port (the node's 18k gave 5.24 V, 5.39 V at worst).
EN 100k/10k: on above 13.5 V typ., up to 14.8 V on the EN threshold's 1.103–1.349 V (SLUSF64B §6.5) and
15.1 V with the 1 % resistors: the rack's 20 V clears it. Off below 10.8 V typ.
VIN on J1.8, the node's VRACK through its eFuse (TPS26600, ≈ 1.5 A, off by default): no second protection here. ≈ 1.0 A at 20 V (1.3 A at the ports' limit), 1.5 A at 13.5 V, 0.75 A at 28 V; a PH contact carries 2 A.

Generated from electronics/data-port-x6/design.py — edit the Python, then regenerate
A porte-revues drawer board: six switched, measured USB-C behind a hub (hw-testing-rack)
hw-testing-rack
Sheet: /Power/
File: power.kicad_sch
Title: DATA ×6 — 20 V input, two 5 V converters

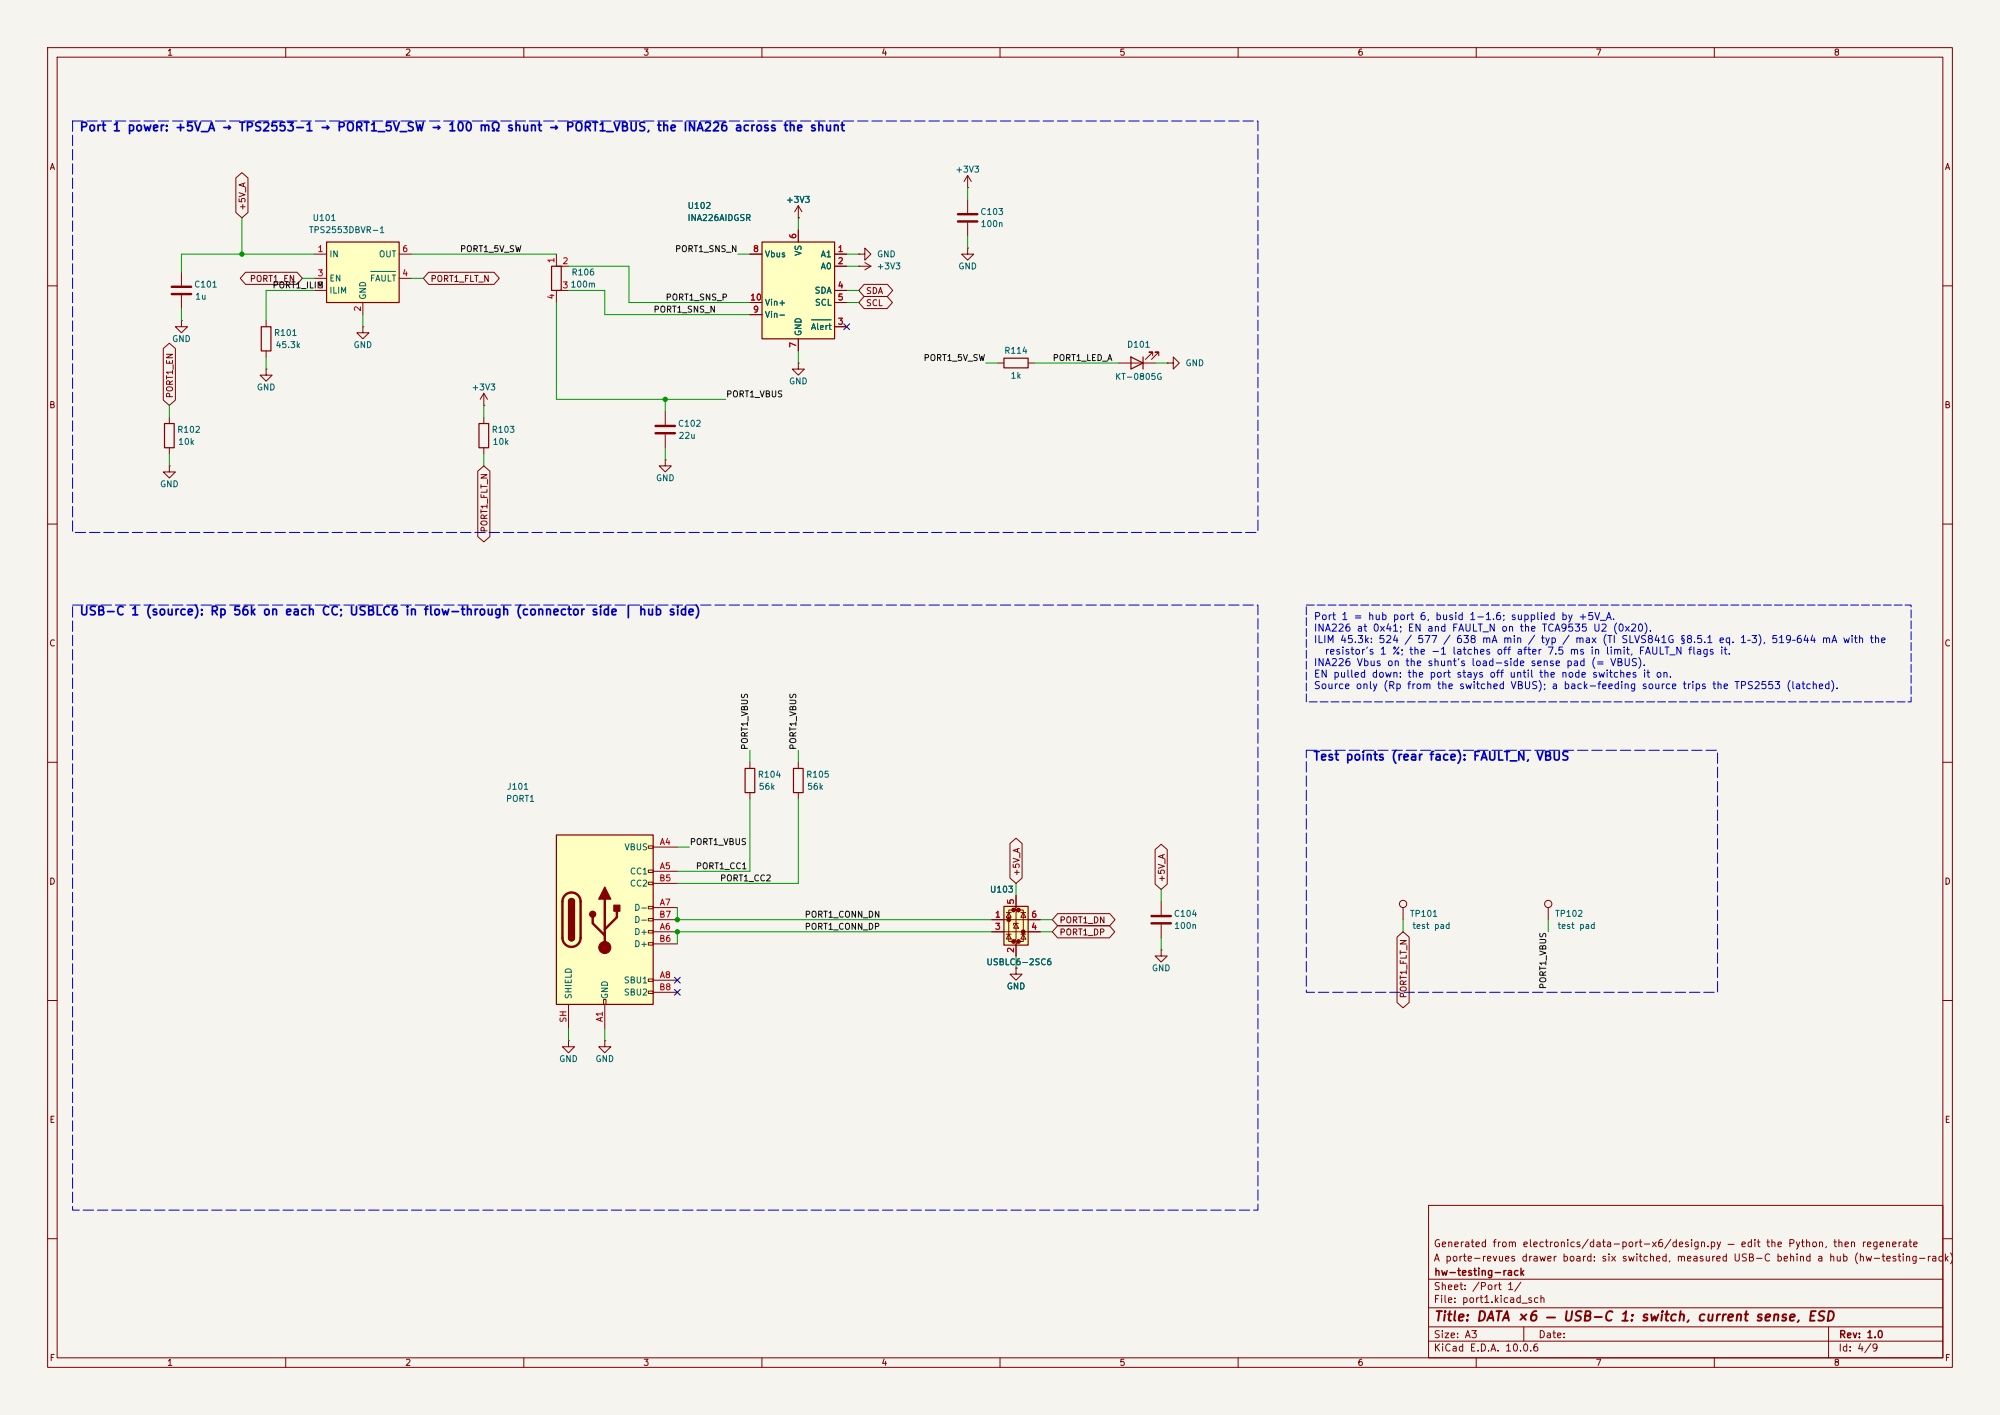
[picture p172: page 4]

Port 1 power: +5V_A → TPS2553-1 → PORT1_5V_SW → 100 mΩ shunt → PORT1_VBUS, the INA226 across the shunt

USB-C 1 (source): Rp 56k on each CC; USBLC6 in flow-through (connector side | hub side)

Port 1 = hub port 6, busid 1-1.6; supplied by +5V_A.
INA226 at 0x41; EN and FAULT_N on the TCA9535 U2 (0x20).
ILIM 45.3k: 524 / 577 / 638 mA min / typ / max (TI SLVS841G §8.5.1 eq. 1–3), 519–644 mA with the
resistor's 1 %; the -1 latches off after 7.5 ms in limit, FAULT_N flags it.
INA226 Vbus on the shunt's load-side sense pad (= VBUS).
EN pulled down: the port stays off until the node switches it on. Source only (Rp from the switched VBUS); a back-feeding source trips the TPS2553 (latched).

Test points (rear face): FAULT_N, VBUS

Generated from electronics/data-port-x6/design.py — edit the Python, then regenerate
A porte-revues drawer board: six switched, measured USB-C behind a hub (hw-testing-rack)
hw-testing-rack
Sheet: /Port 1/
File: port1.kicad_sch
Title: DATA ×6 — USB-C 1: switch, current sense, ESD

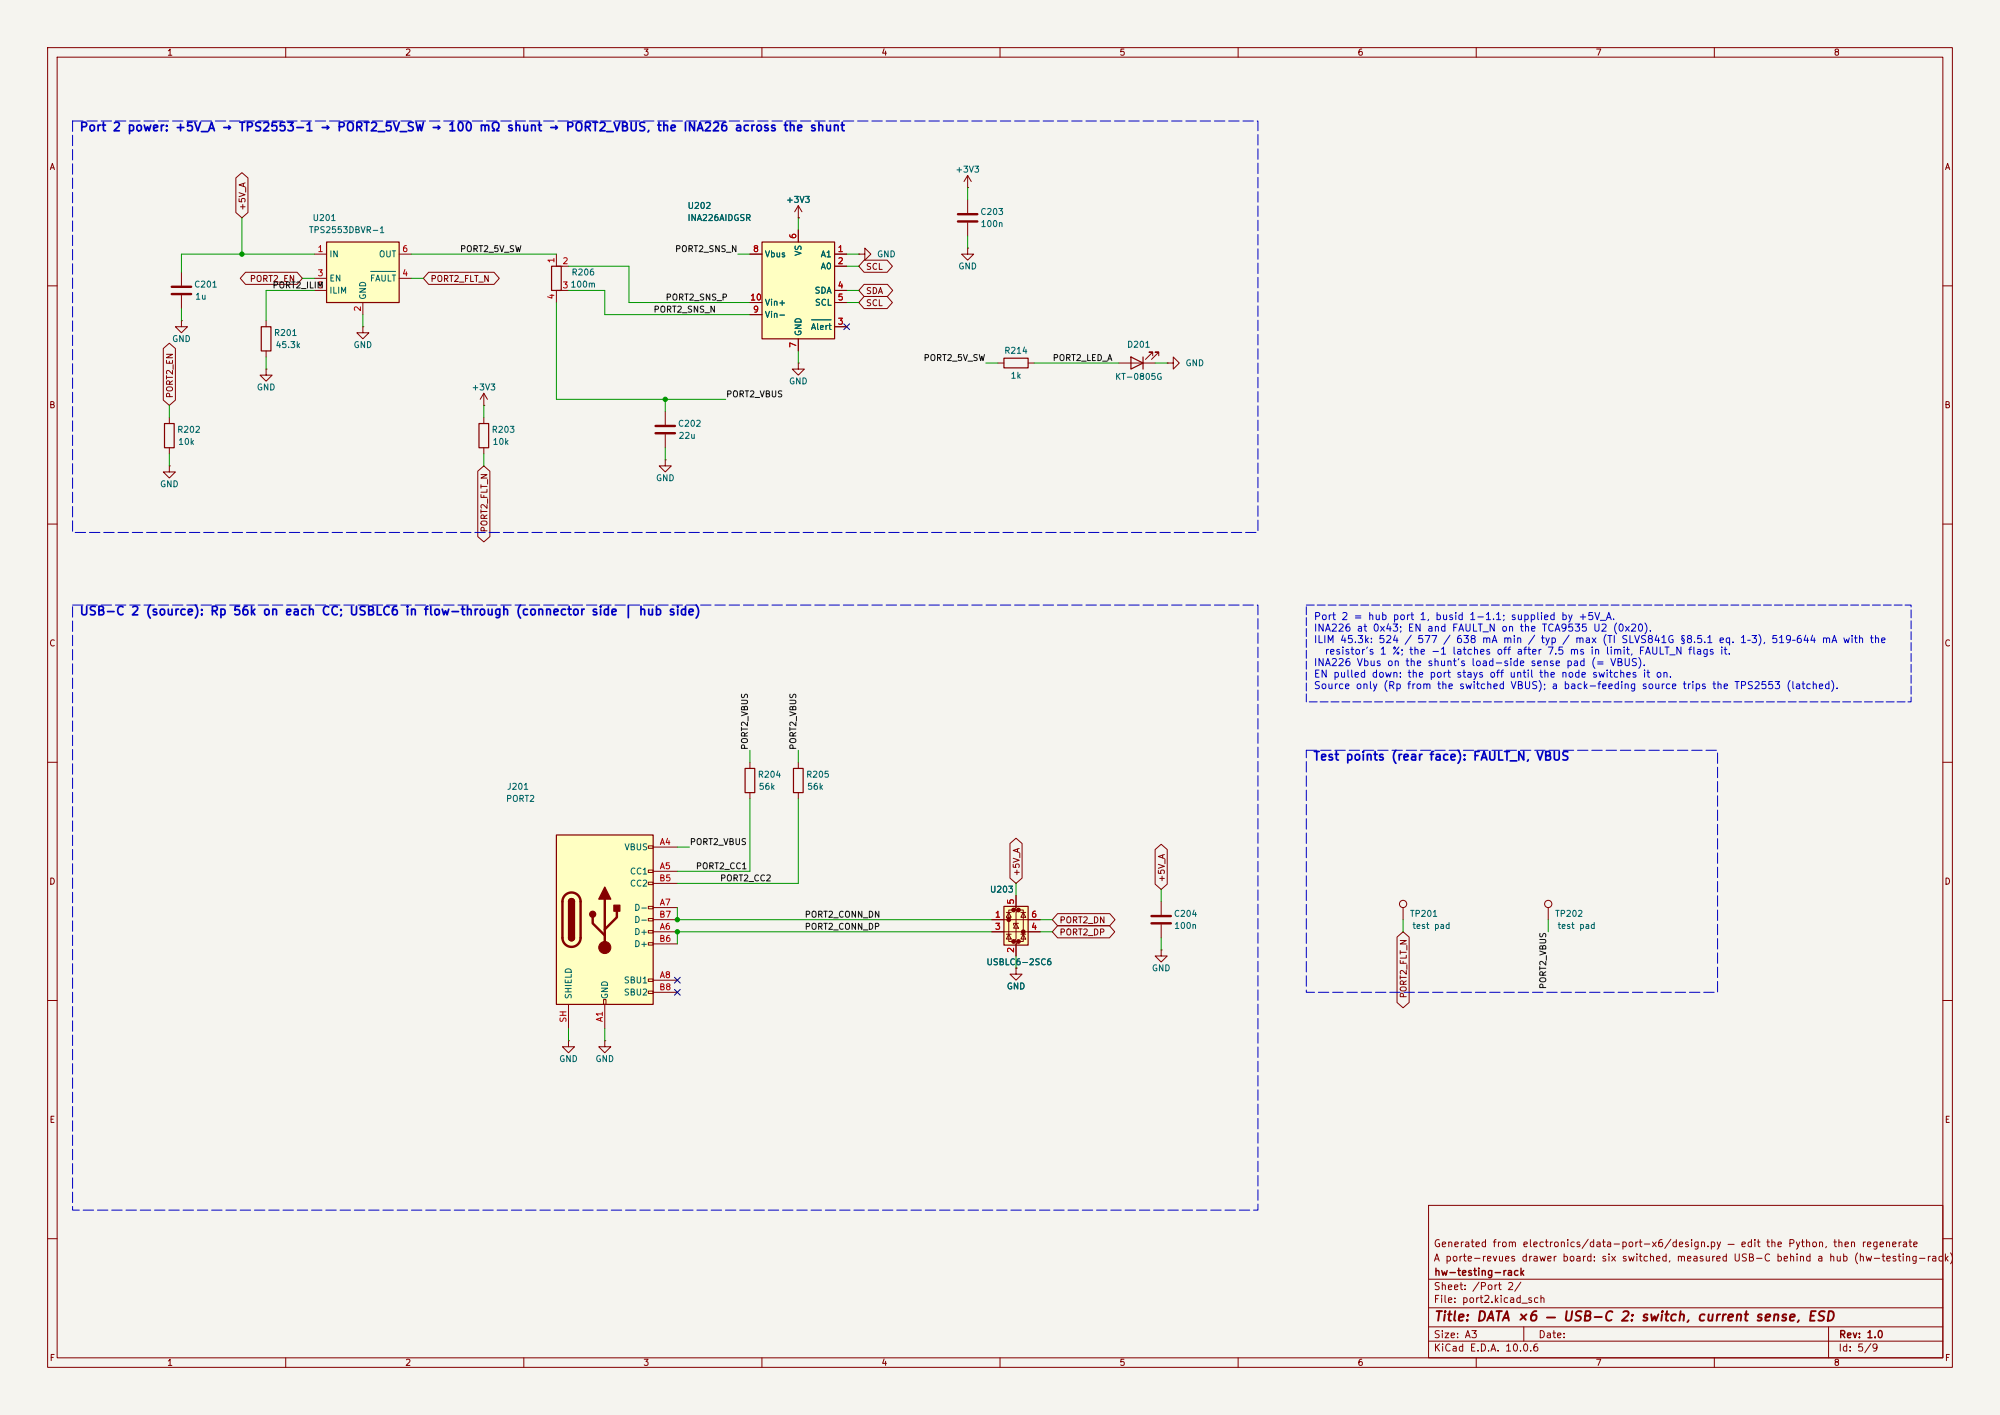
[picture p173: page 5]

Port 2 power: +5V_A → TPS2553-1 → PORT2_5V_SW → 100 mΩ shunt → PORT2_VBUS, the INA226 across the shunt

USB-C 2 (source): Rp 56k on each CC; USBLC6 in flow-through (connector side | hub side)

INA226 at 0x43; EN and FAULT_N on the TCA9535 U2 (0x20).
ILIM 45.3k: 524 / 577 / 638 mA min / typ / max (TI SLVS841G §8.5.1 eq. 1–3), 519–644 mA with the
resistor's 1 %; the -1 latches off after 7.5 ms in limit, FAULT_N flags it.
INA226 Vbus on the shunt's load-side sense pad (= VBUS).
EN pulled down: the port stays off until the node switches it on. Source only (Rp from the switched VBUS); a back-feeding source trips the TPS2553 (latched).

Test points (rear face): FAULT_N, VBUS

Generated from electronics/data-port-x6/design.py — edit the Python, then regenerate
A porte-revues drawer board: six switched, measured USB-C behind a hub (hw-testing-rack)
hw-testing-rack
Sheet: /Port 2/
File: port2.kicad_sch
Title: DATA ×6 — USB-C 2: switch, current sense, ESD

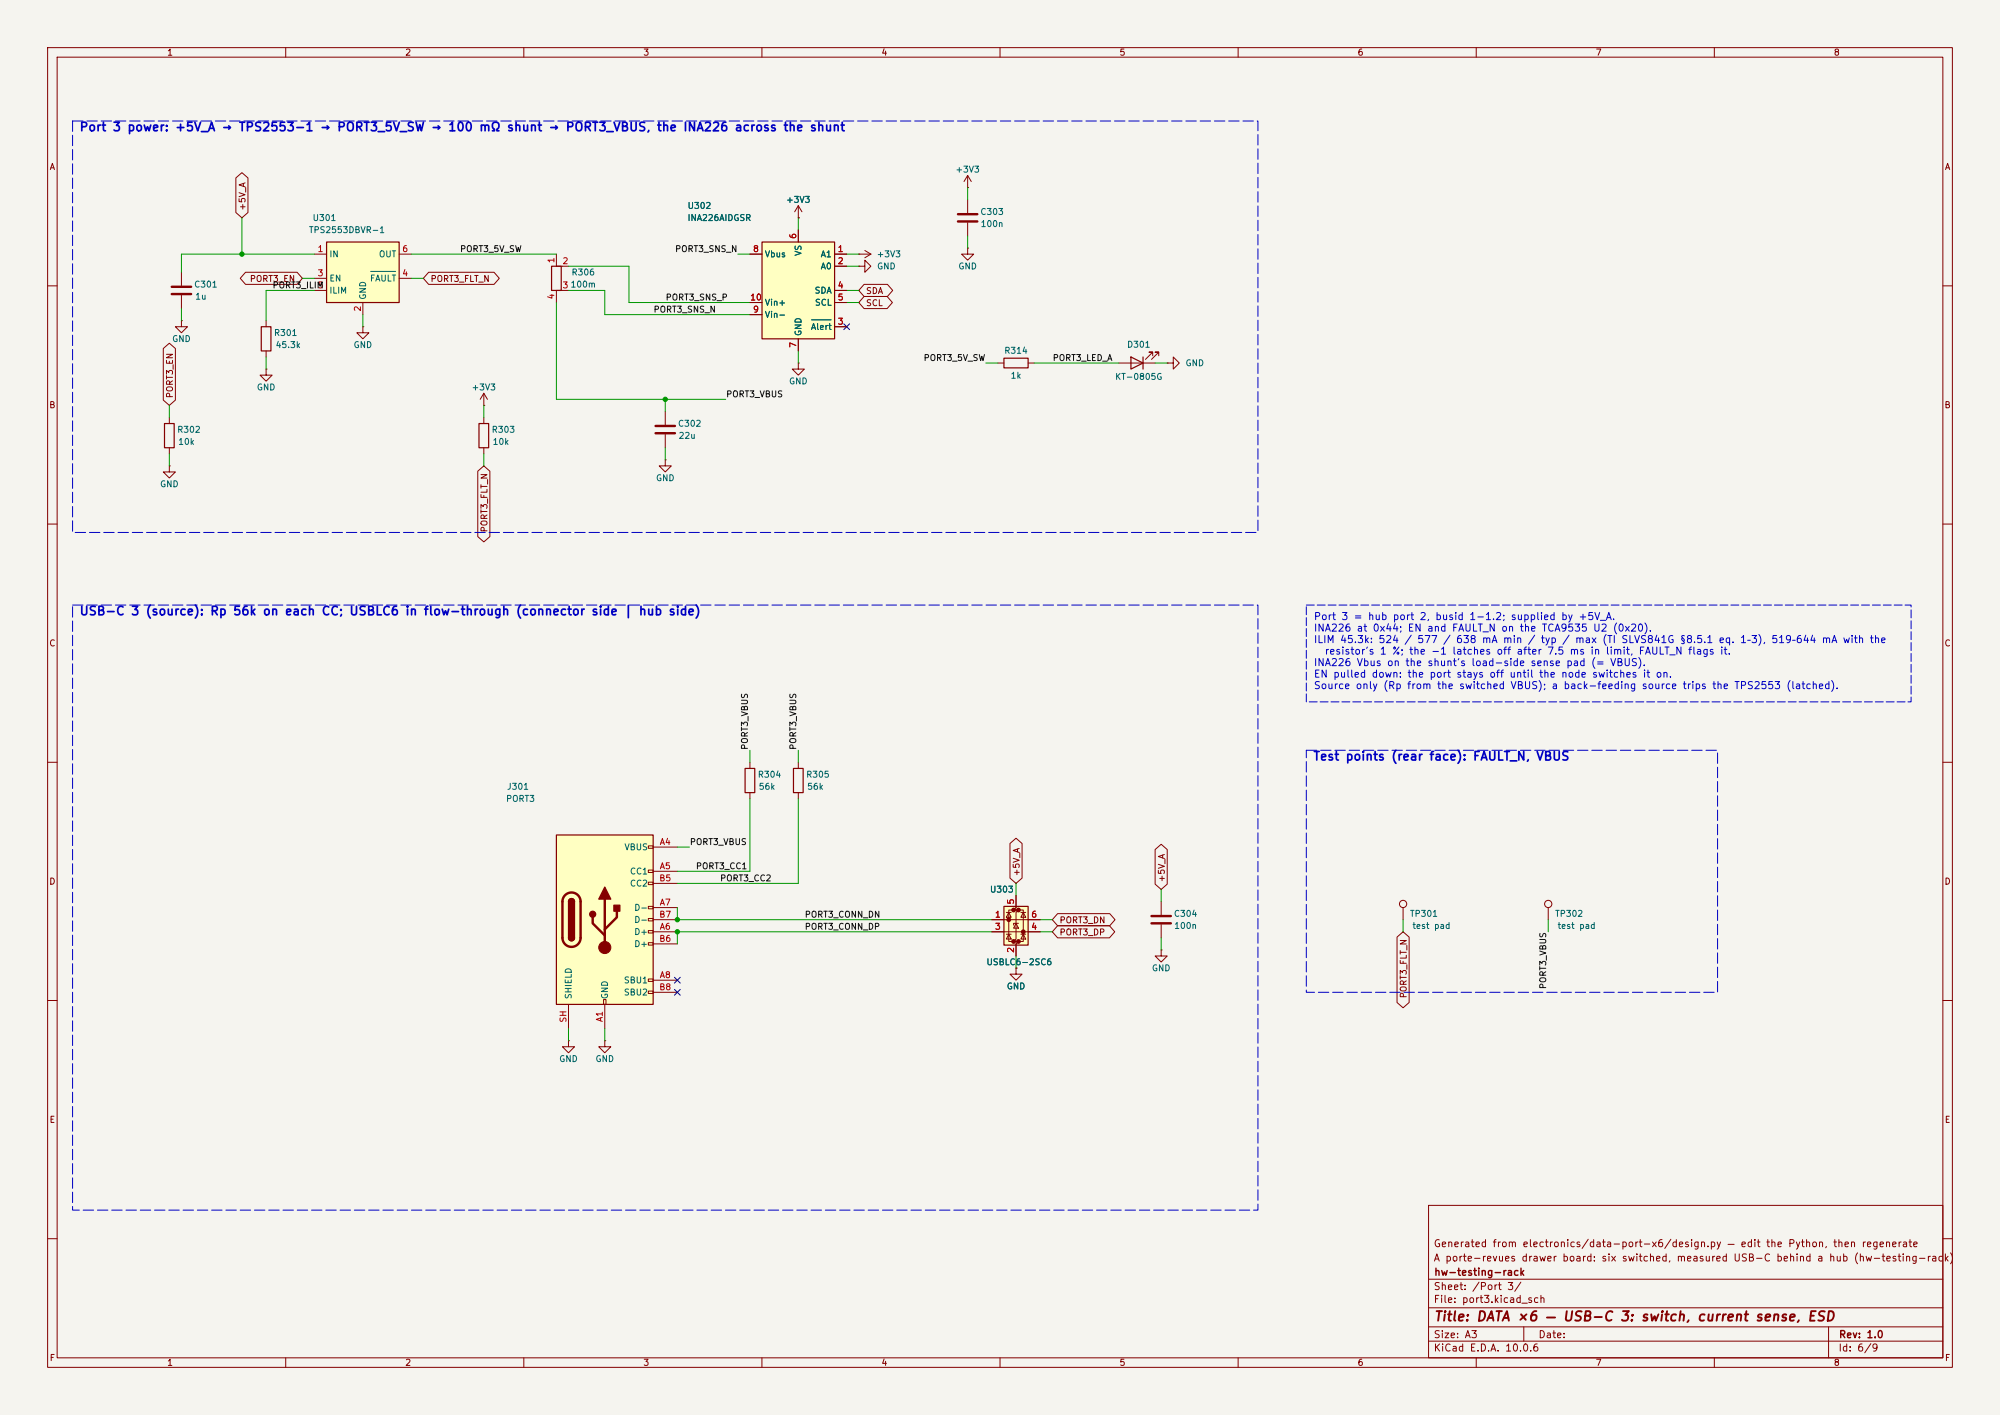
[picture p174: page 6]

Port 3 power: +5V_A → TPS2553-1 → PORT3_5V_SW → 100 mΩ shunt → PORT3_VBUS, the INA226 across the shunt

USB-C 3 (source): Rp 56k on each CC; USBLC6 in flow-through (connector side | hub side)

INA226 at 0x44; EN and FAULT_N on the TCA9535 U2 (0x20).
ILIM 45.3k: 524 / 577 / 638 mA min / typ / max (TI SLVS841G §8.5.1 eq. 1–3), 519–644 mA with the
resistor's 1 %; the -1 latches off after 7.5 ms in limit, FAULT_N flags it.
INA226 Vbus on the shunt's load-side sense pad (= VBUS).
EN pulled down: the port stays off until the node switches it on. Source only (Rp from the switched VBUS); a back-feeding source trips the TPS2553 (latched).

Test points (rear face): FAULT_N, VBUS

Generated from electronics/data-port-x6/design.py — edit the Python, then regenerate
A porte-revues drawer board: six switched, measured USB-C behind a hub (hw-testing-rack)
hw-testing-rack
Sheet: /Port 3/
File: port3.kicad_sch
Title: DATA ×6 — USB-C 3: switch, current sense, ESD

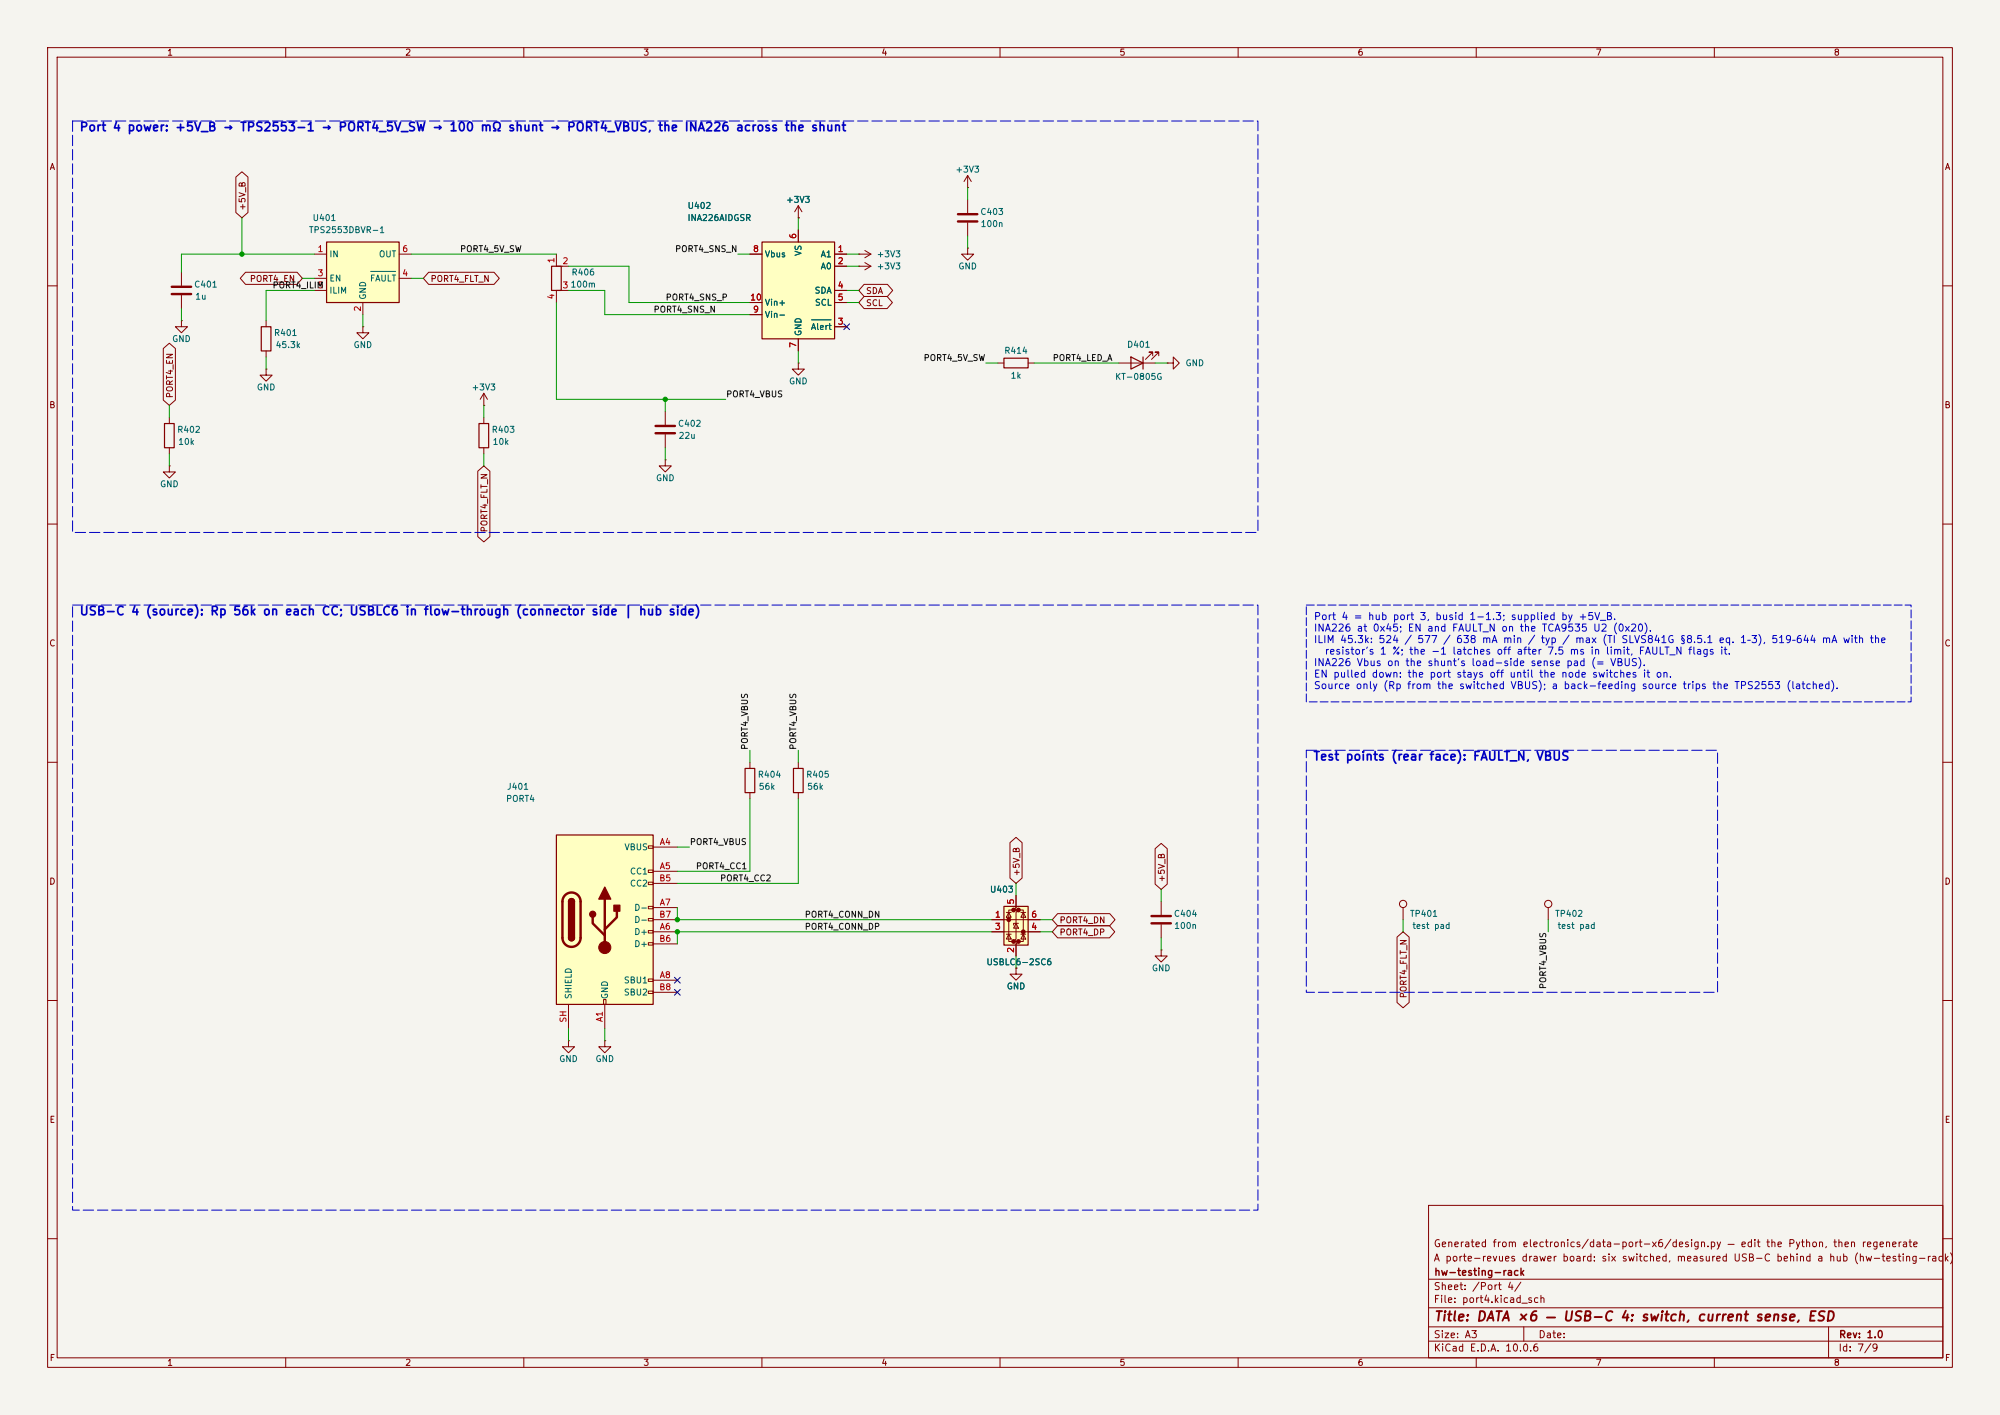
[picture p175: page 7]

Port 4 power: +5V_B → TPS2553-1 → PORT4_5V_SW → 100 mΩ shunt → PORT4_VBUS, the INA226 across the shunt
+3V3 GND A1
PORT4_FLT_NPORT4_FLT_N

USB-C 4 (source): Rp 56k on each CC; USBLC6 in flow-through (connector side | hub side)

Port 4 = hub port 3, busid 1-1.3; supplied by +5V_B.
INA226 at 0x45; EN and FAULT_N on the TCA9535 U2 (0x20).
ILIM 45.3k: 524 / 577 / 638 mA min / typ / max (TI SLVS841G §8.5.1 eq. 1–3), 519–644 mA with the
resistor's 1 %; the -1 latches off after 7.5 ms in limit, FAULT_N flags it.
INA226 Vbus on the shunt's load-side sense pad (= VBUS).
EN pulled down: the port stays off until the node switches it on. Source only (Rp from the switched VBUS); a back-feeding source trips the TPS2553 (latched).

Test points (rear face): FAULT_N, VBUS

Generated from electronics/data-port-x6/design.py — edit the Python, then regenerate
A porte-revues drawer board: six switched, measured USB-C behind a hub (hw-testing-rack)
hw-testing-rack
Sheet: /Port 4/
File: port4.kicad_sch
Title: DATA ×6 — USB-C 4: switch, current sense, ESD

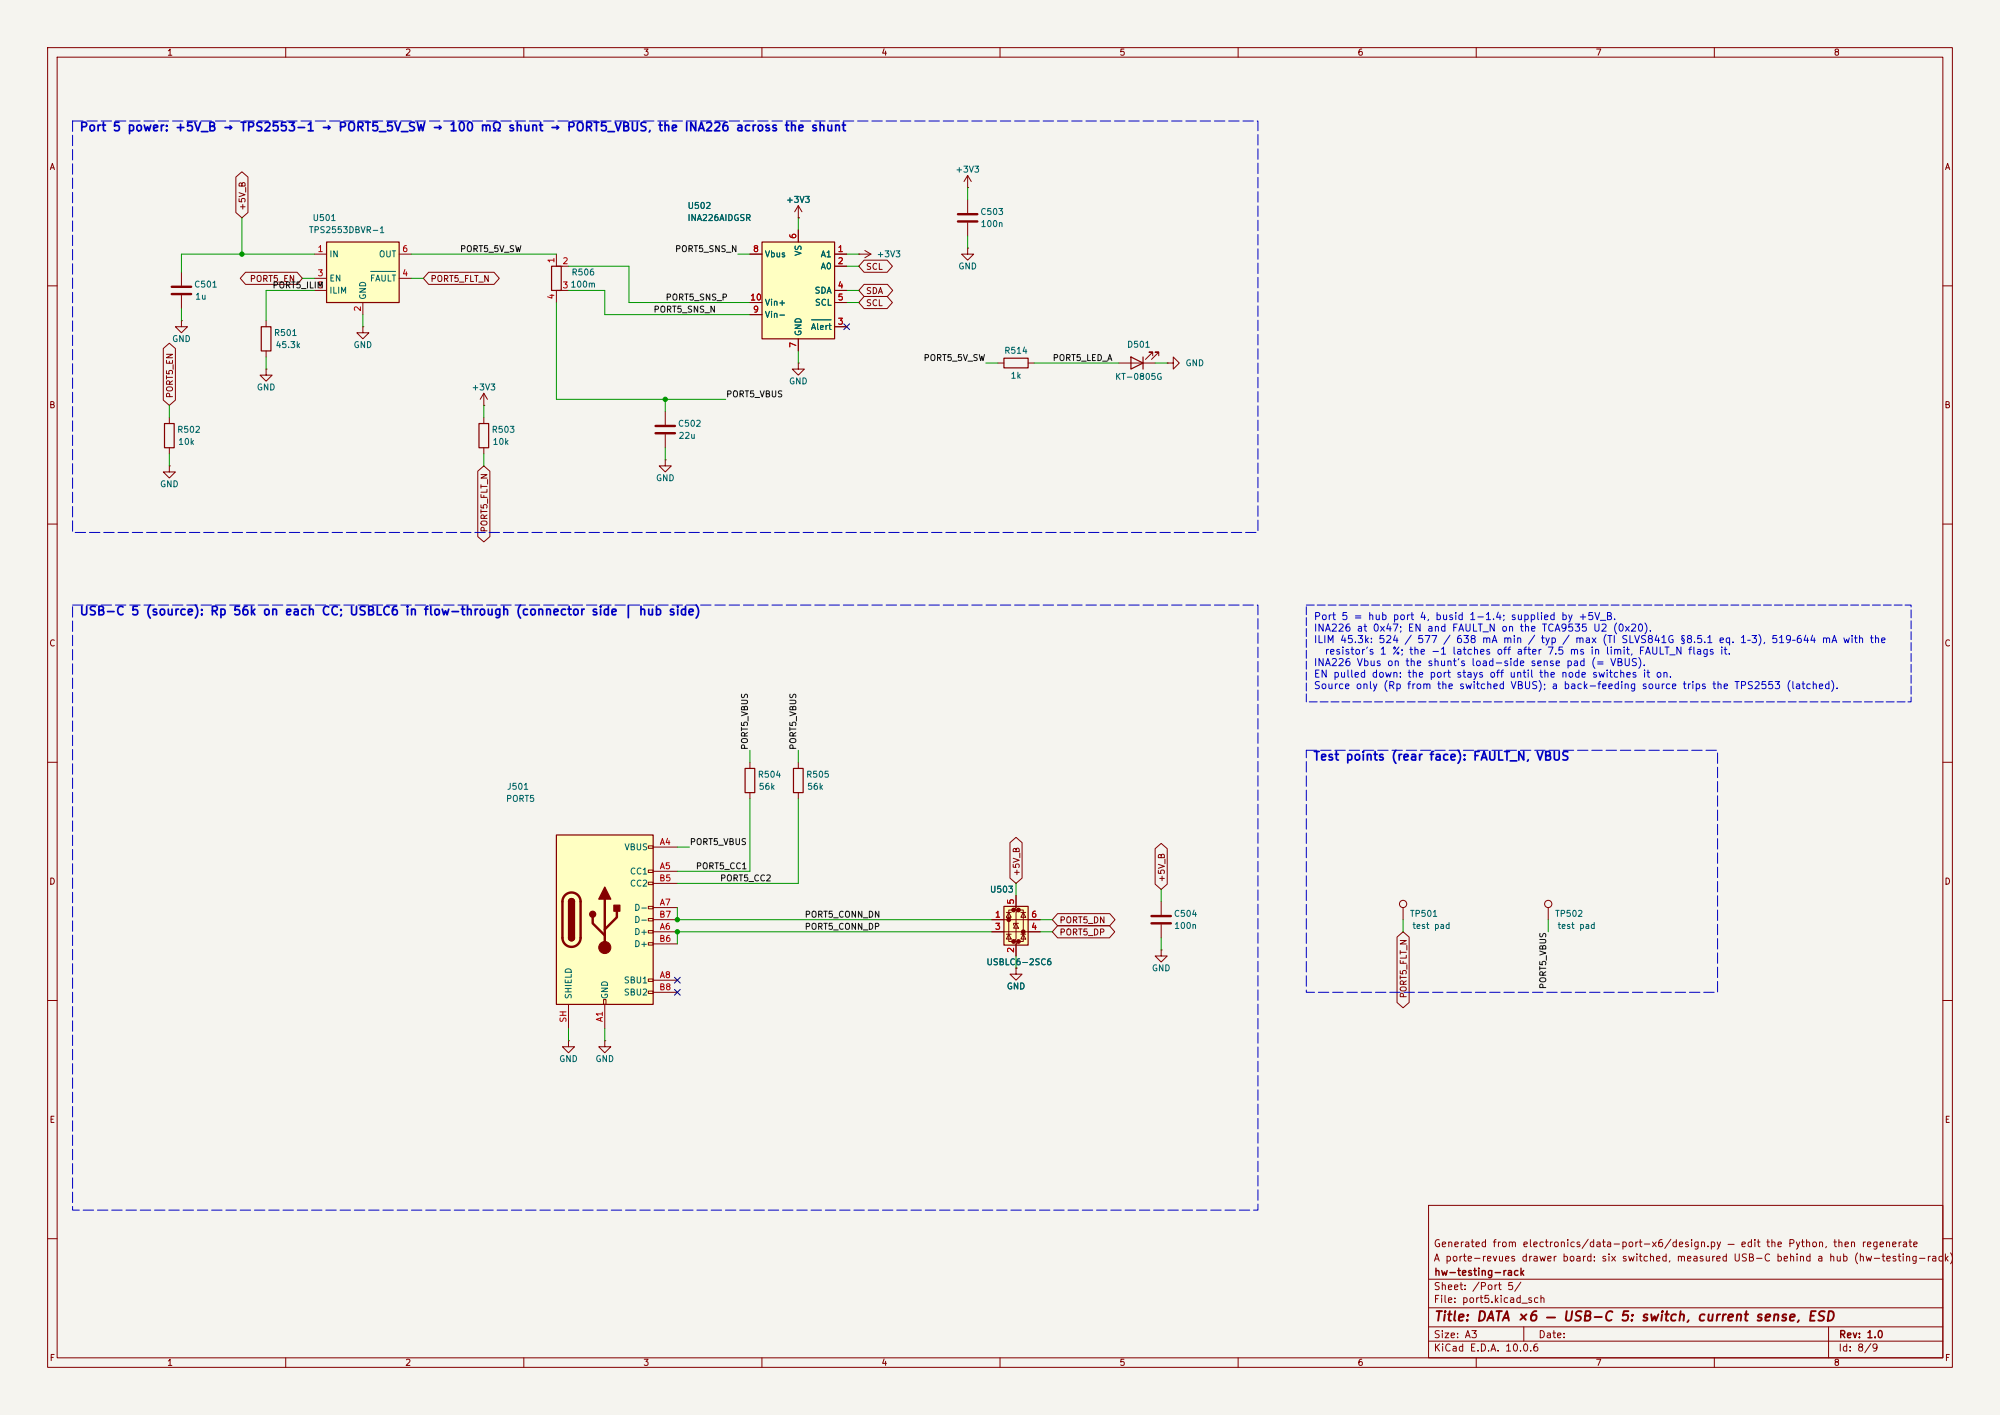
[picture p176: page 8]

Port 5 power: +5V_B → TPS2553-1 → PORT5_5V_SW → 100 mΩ shunt → PORT5_VBUS, the INA226 across the shunt

USB-C 5 (source): Rp 56k on each CC; USBLC6 in flow-through (connector side | hub side)

INA226 at 0x47; EN and FAULT_N on the TCA9535 U2 (0x20).
ILIM 45.3k: 524 / 577 / 638 mA min / typ / max (TI SLVS841G §8.5.1 eq. 1–3), 519–644 mA with the
resistor's 1 %; the -1 latches off after 7.5 ms in limit, FAULT_N flags it.
INA226 Vbus on the shunt's load-side sense pad (= VBUS).
EN pulled down: the port stays off until the node switches it on. Source only (Rp from the switched VBUS); a back-feeding source trips the TPS2553 (latched).

Test points (rear face): FAULT_N, VBUS

Generated from electronics/data-port-x6/design.py — edit the Python, then regenerate
A porte-revues drawer board: six switched, measured USB-C behind a hub (hw-testing-rack)
hw-testing-rack
Sheet: /Port 5/
File: port5.kicad_sch
Title: DATA ×6 — USB-C 5: switch, current sense, ESD

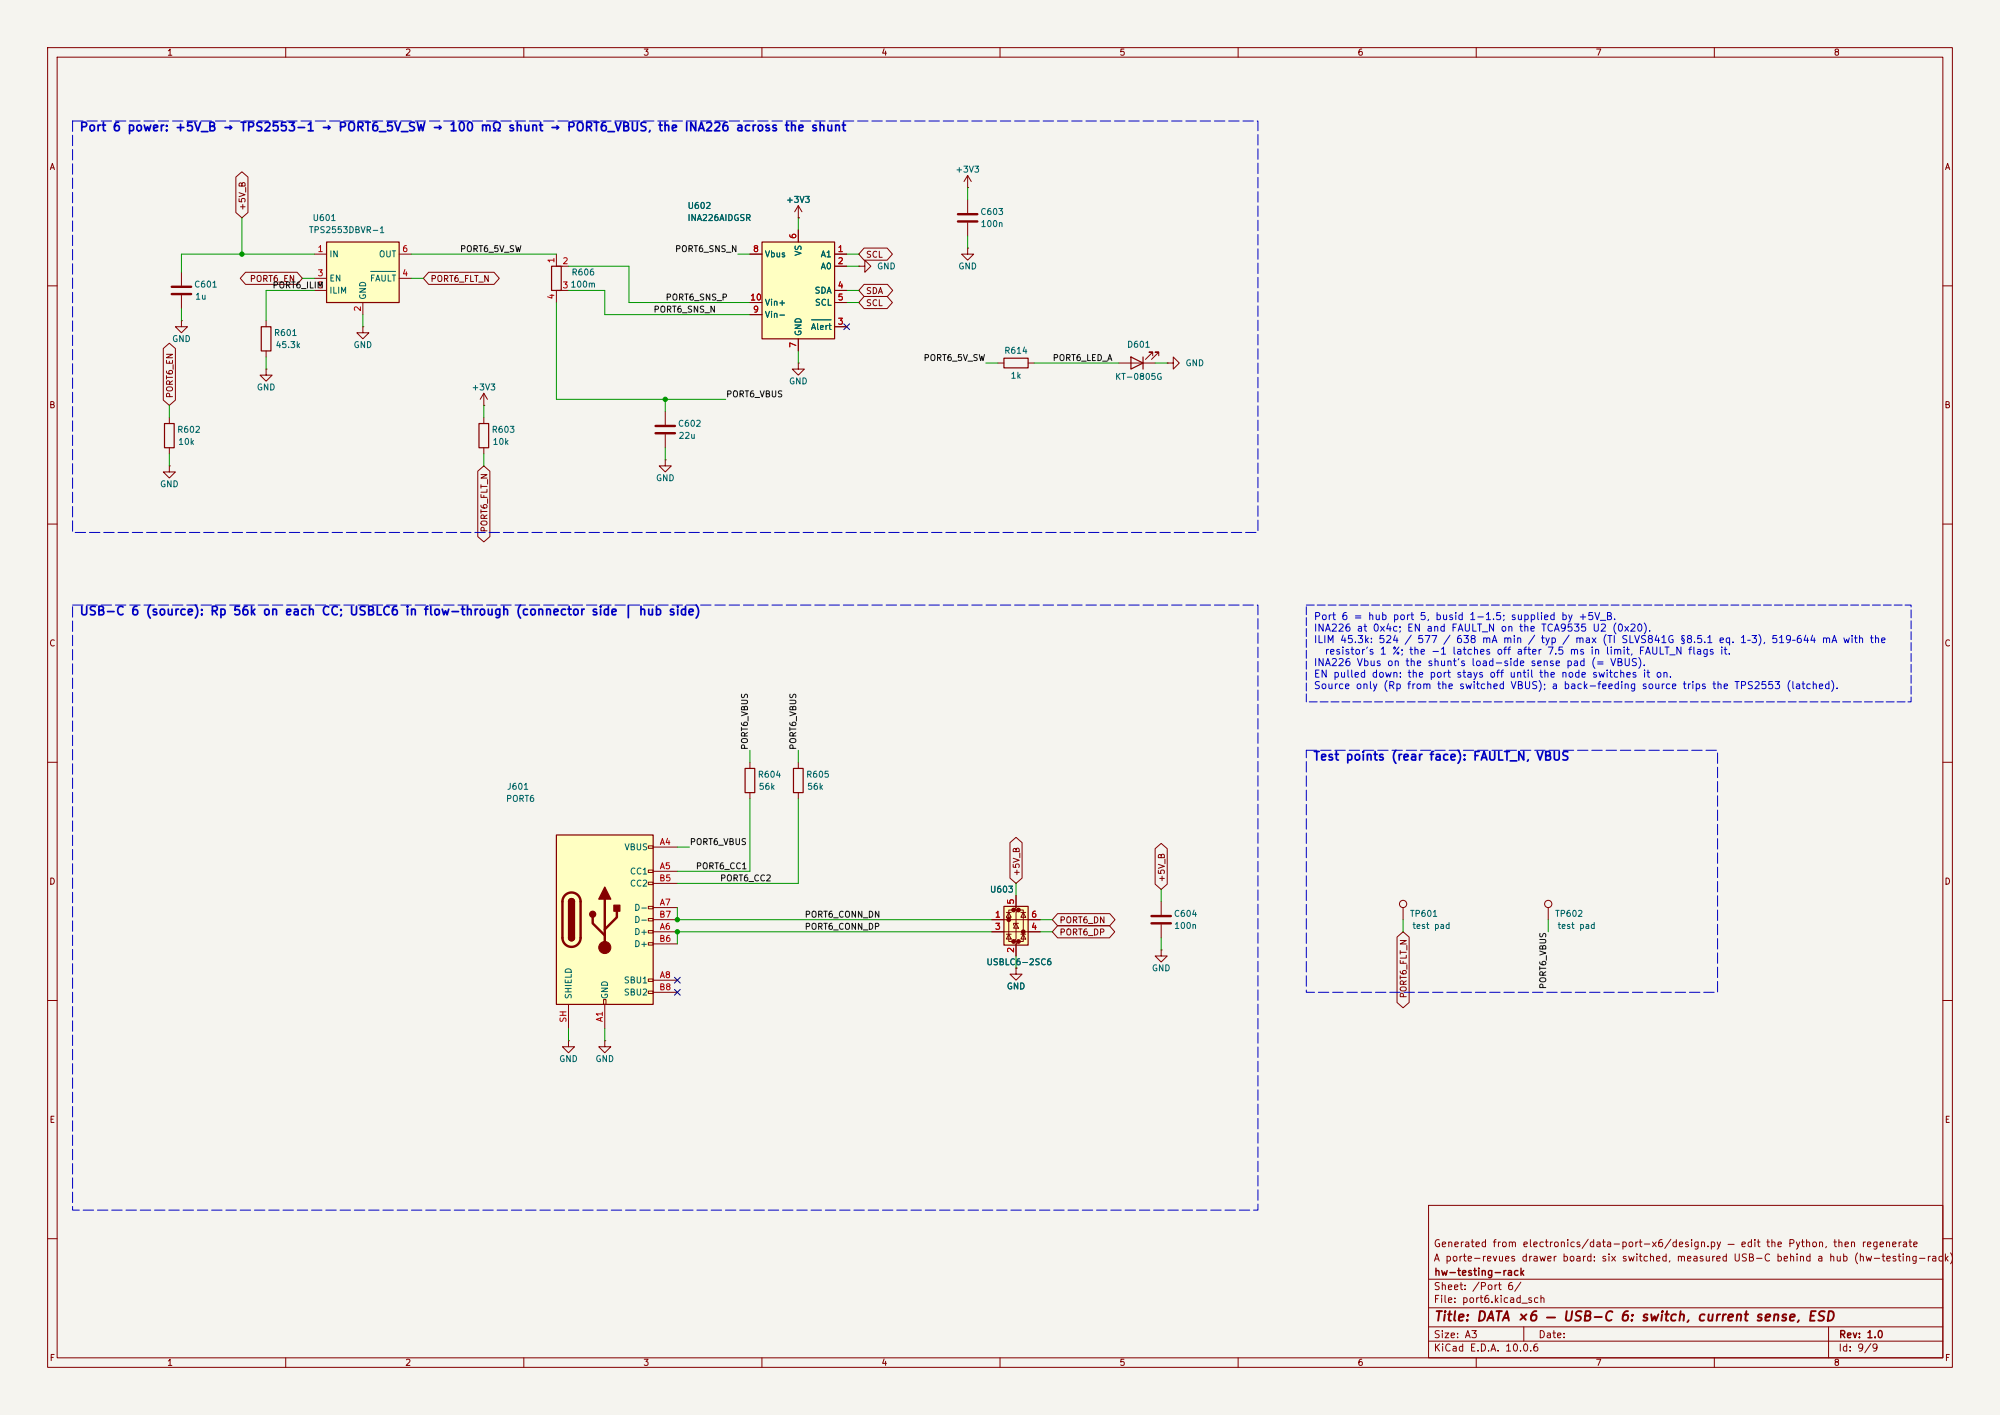
[picture p177: page 9]

Port 6 power: +5V_B → TPS2553-1 → PORT6_5V_SW → 100 mΩ shunt → PORT6_VBUS, the INA226 across the shunt

USB-C 6 (source): Rp 56k on each CC; USBLC6 in flow-through (connector side | hub side)

Port 6 = hub port 5, busid 1-1.5; supplied by +5V_B.
INA226 at 0x4c; EN and FAULT_N on the TCA9535 U2 (0x20).
ILIM 45.3k: 524 / 577 / 638 mA min / typ / max (TI SLVS841G §8.5.1 eq. 1–3), 519–644 mA with the
resistor's 1 %; the -1 latches off after 7.5 ms in limit, FAULT_N flags it.
INA226 Vbus on the shunt's load-side sense pad (= VBUS).
EN pulled down: the port stays off until the node switches it on. Source only (Rp from the switched VBUS); a back-feeding source trips the TPS2553 (latched).

Test points (rear face): FAULT_N, VBUS

Generated from electronics/data-port-x6/design.py — edit the Python, then regenerate
A porte-revues drawer board: six switched, measured USB-C behind a hub (hw-testing-rack)
hw-testing-rack
Sheet: /Port 6/
File: port6.kicad_sch
Title: DATA ×6 — USB-C 6: switch, current sense, ESD
