kartben/hw-testing-rack/electronics/bay-node/docs/bay-node-schematic.pdf

1 | 2 | 3 | 4 | 5 | 6 | 7 | 8

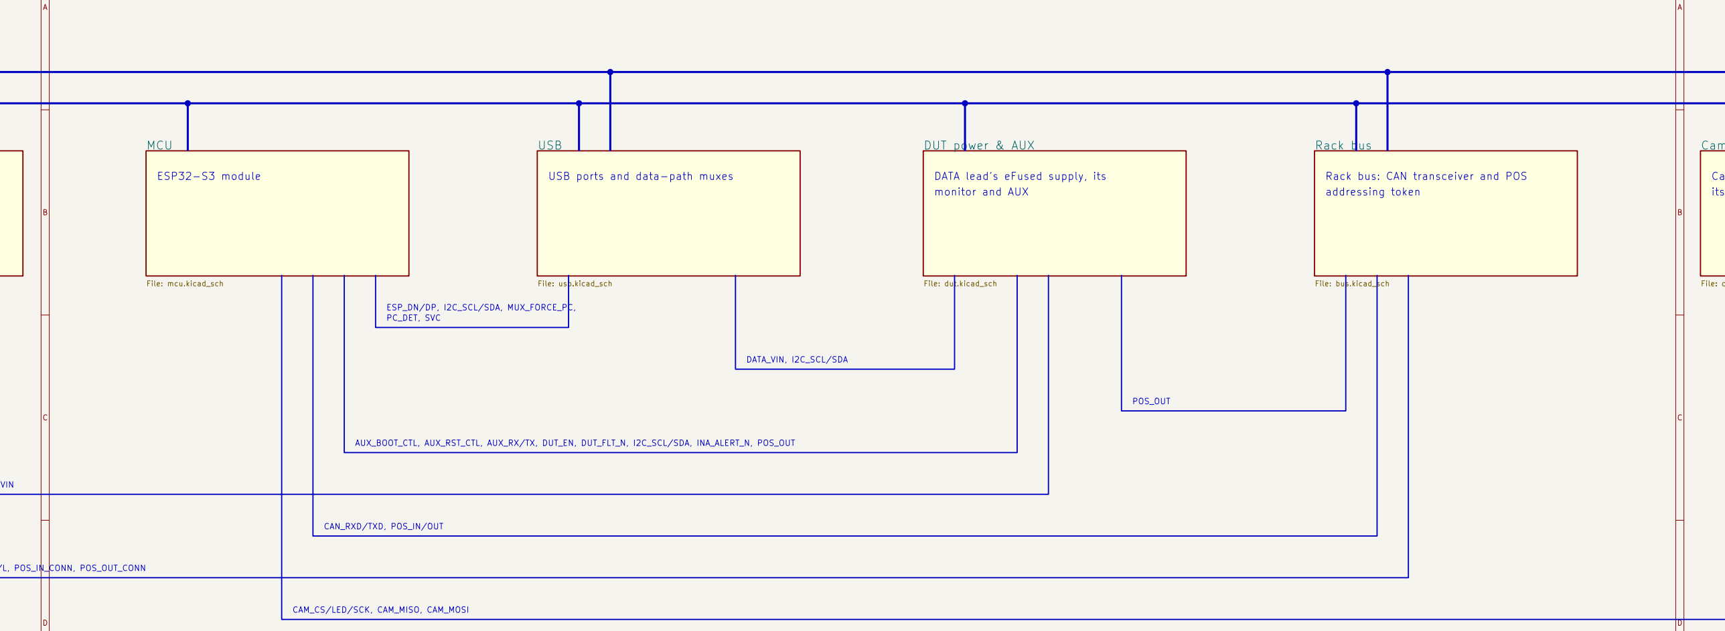
[picture p178: figure]
DUT power & AUX; File: dut.kicad_sch Power; Rack bus; File: bus.kicad_sch USB; File: usb.kicad_sch; Camera; File: cam.kicad_sch MCU; ESP32-S3 module; ESP_DN/DP, I2C_SCL/SDA, MUX_FORCE_PC, PC_DET, SVC; CAM_CS/LED/SCK, CAM_MISO, CAM_MOSI; USB ports and data-path muxes; CAN_H/L, POS_IN_CONN, POS_OUT_CONN; CAN_RXD/TXD, POS_IN/OUT; DATA lead's eFused supply, its monitor and AUX; DATA_VIN, I2C_SCL/SDA; VIN; Rack bus: CAN transceiver and POS; addressing token; POS_OUT; its; LEDs

E

F

E

Size: A3 | Rev: 1.0 | F Date:
KiCad E.D.A. 10.0.6 | Id: 1/7

## Title: Bay node — Overview

File: bay-node.kicad_sch

Sheet: /

hw-testing-rack

ESP32-S3 USB/IP host for one bay of the hw-testing-rack shelf

Generated from electronics/bay-node/design.py — edit the Python, then regenerate

Row bus 20–28 V + CAN + POS in/out · 20–28 V/1.76 A eFused supply on the DATA lead · USB 2.0 muxes · INA226 · AUX

# File: mcu.kicad_sch Bay node — one per bay. Sheets:

Power: row cable (JST PH 6: bus, GND, CAN_H, CAN_L, GND, POS), reverse protection, LMR51625 buck, AP2114H
MCU: ESP32-S3-WROOM-1-N8R8 (8 MB flash, 8 MB octal PSRAM), reset/boot, status LED, UART pads
USB: front PC port, the DUT's USB on the DATA lead (J7), two FSUSB42 muxes + OR gate (classic / USB-IP / service modes) DUT power & AUX: TPS26600 eFuse on VIN → shunt → DATA_VIN, INA226 monitor, AUX UART/RESET/BOOT
Camera: JST PH 8 to the bay's Arducam Mega (SPI2, 5 V through a PTC) and its LEDs (AO3400A low side)
Rack bus: TJA1462AT CAN transceiver on the row pair, POS token in/out (docs/can.md)

Mode truth table: SERVICE=0, PC unplugged → DUT↔ESP32 (USB/IP)
SERVICE=0, PC plugged | → DUT↔PC (classic), ESP32 still controls DATA_VIN/AUX
SERVICE=1 | → PC↔ESP32 (flash/console), DUT data disconnected
GPIO firmware can also force classic mode (MUX_FORCE_PC).

AUX_BOOT_CTL, AUX_RST_CTL, AUX_RX/TX, DUT_EN, DUT_FLT_N, I2C_SCL/SDA, INA_ALERT_N, POS_OUT

### Camera lead: Arducam Mega SPI and

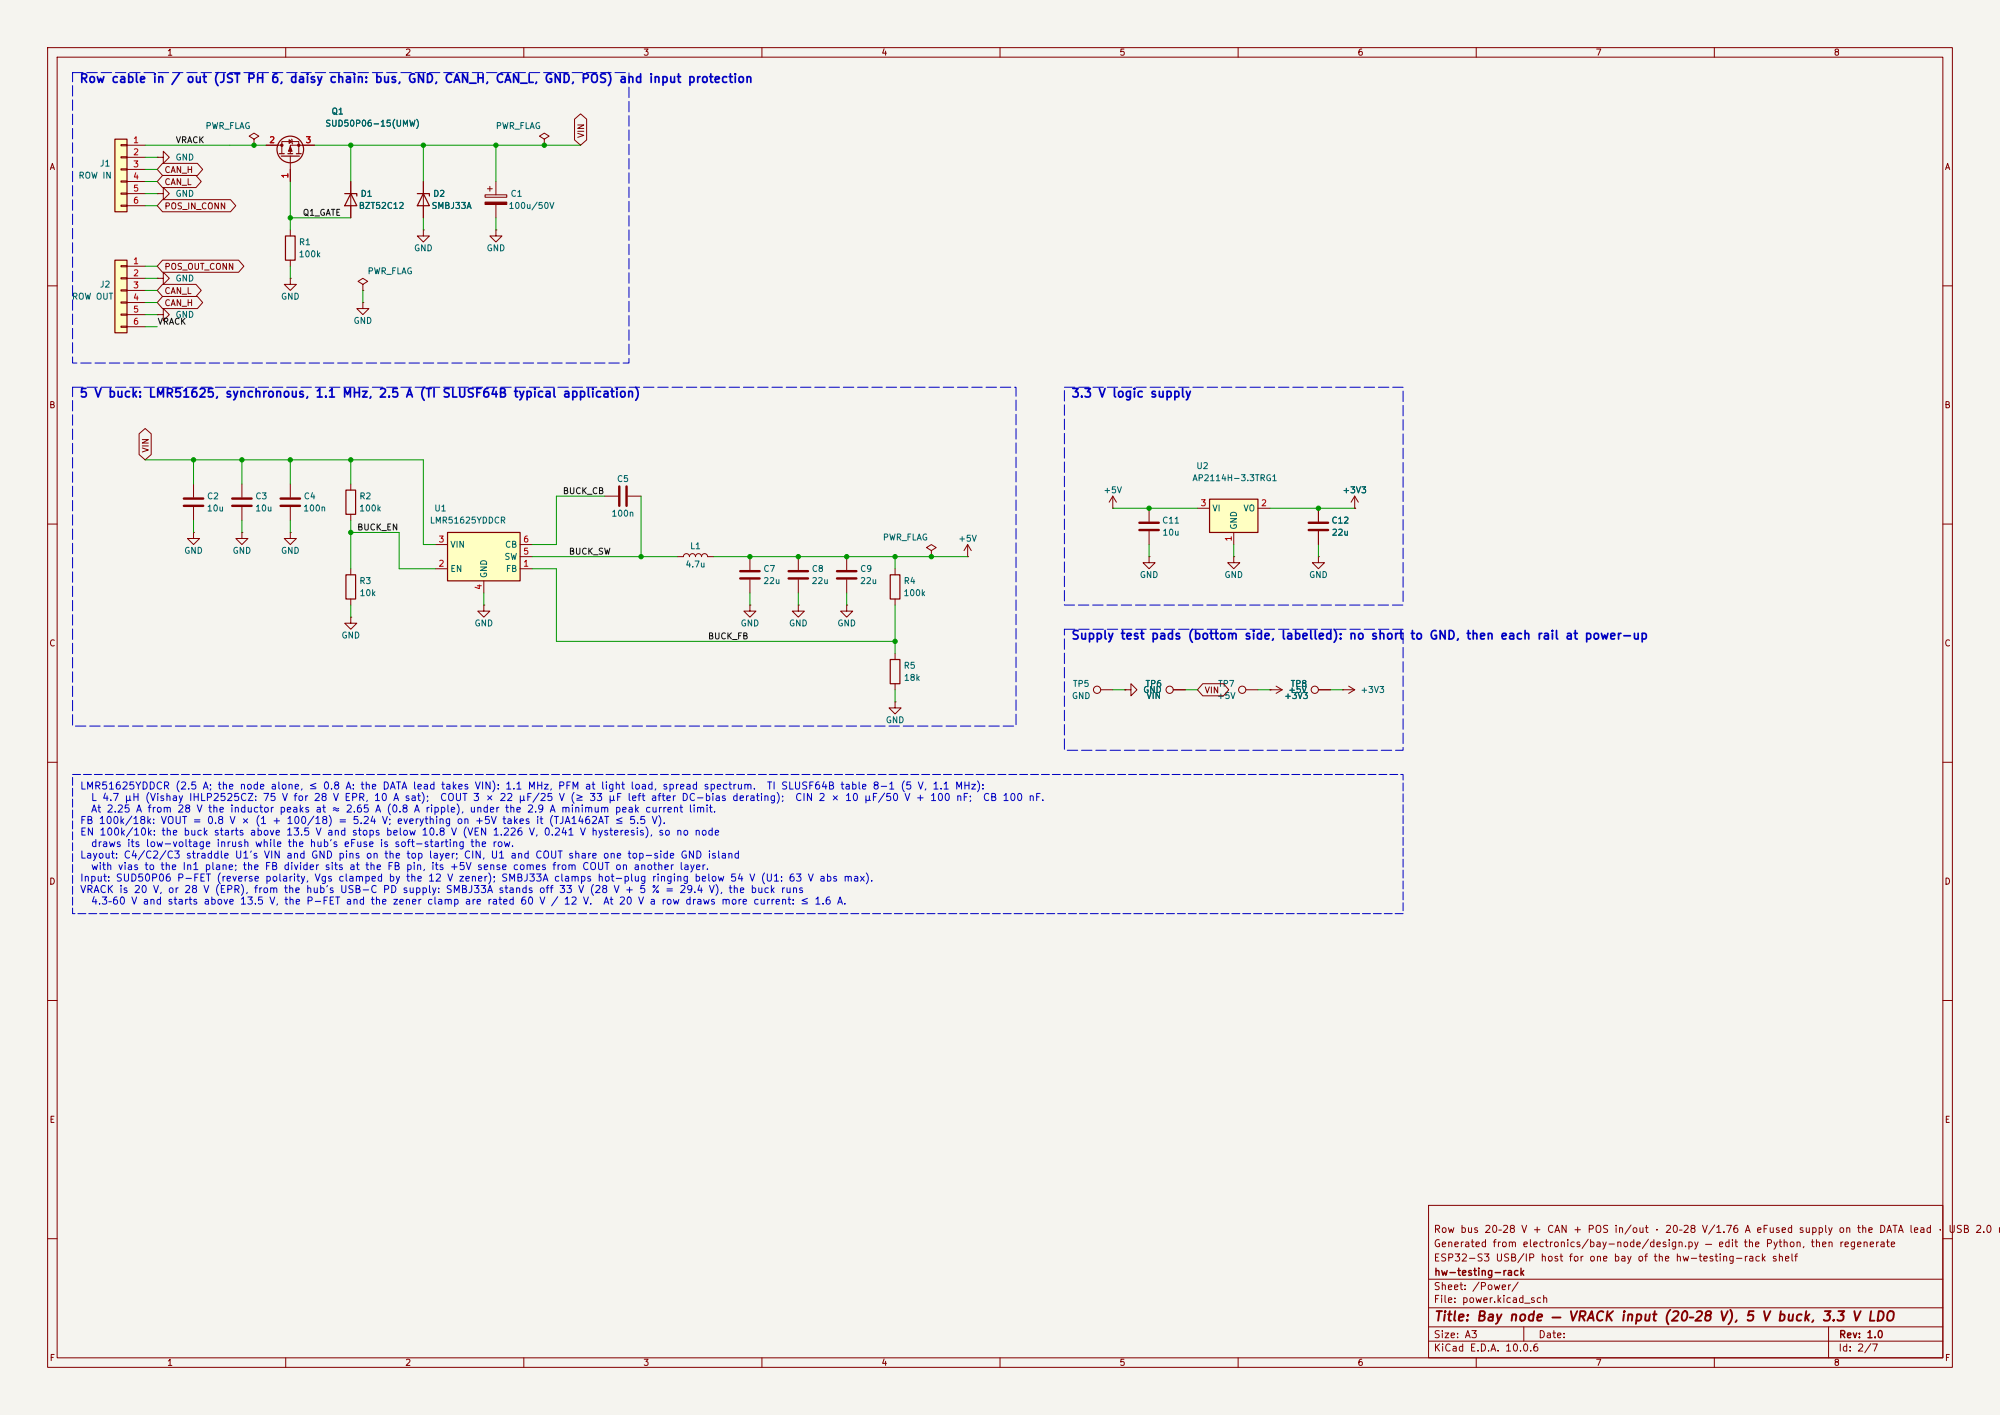
[picture p179: page 2]

Row cable in / out (JST PH 6, daisy chain: bus, GND, CAN_H, CAN_L, GND, POS) and input protection
PWR_FLAG VIN
CAN_L CAN_H
100k GND

5 V buck: LMR51625, synchronous, 1.1 MHz, 2.5 A (TI SLUSF64B typical application) Q1

Supply test pads (bottom side, labelled): no short to GND, then each rail at power-up

At 2.25 A from 28 V the inductor peaks at ≈ 2.65 A (0.8 A ripple), under the 2.9 A minimum peak current limit.
FB 100k/18k: VOUT = 0.8 V × (1 + 100/18) = 5.24 V; everything on +5V takes it (TJA1462AT ≤ 5.5 V).
EN 100k/10k: the buck starts above 13.5 V and stops below 10.8 V (VEN 1.226 V, 0.241 V hysteresis), so no node
draws its low-voltage inrush while the hub's eFuse is soft-starting the row. Layout: C4/C2/C3 straddle U1's VIN and GND pins on the top layer; CIN, U1 and COUT share one top-side GND island

with vias to the In1 plane; the FB divider sits at the FB pin, its +5V sense comes from COUT on another layer.
Input: SUD50P06 P-FET (reverse polarity, Vgs clamped by the 12 V zener); SMBJ33A clamps hot-plug ringing below 54 V (U1: 63 V abs max).

Generated from electronics/bay-node/design.py — edit the Python, then regenerate
ESP32-S3 USB/IP host for one bay of the hw-testing-rack shelf
hw-testing-rack
Sheet: /Power/
File: power.kicad_sch
Title: Bay node — VRACK input (20–28 V), 5 V buck, 3.3 V LDO

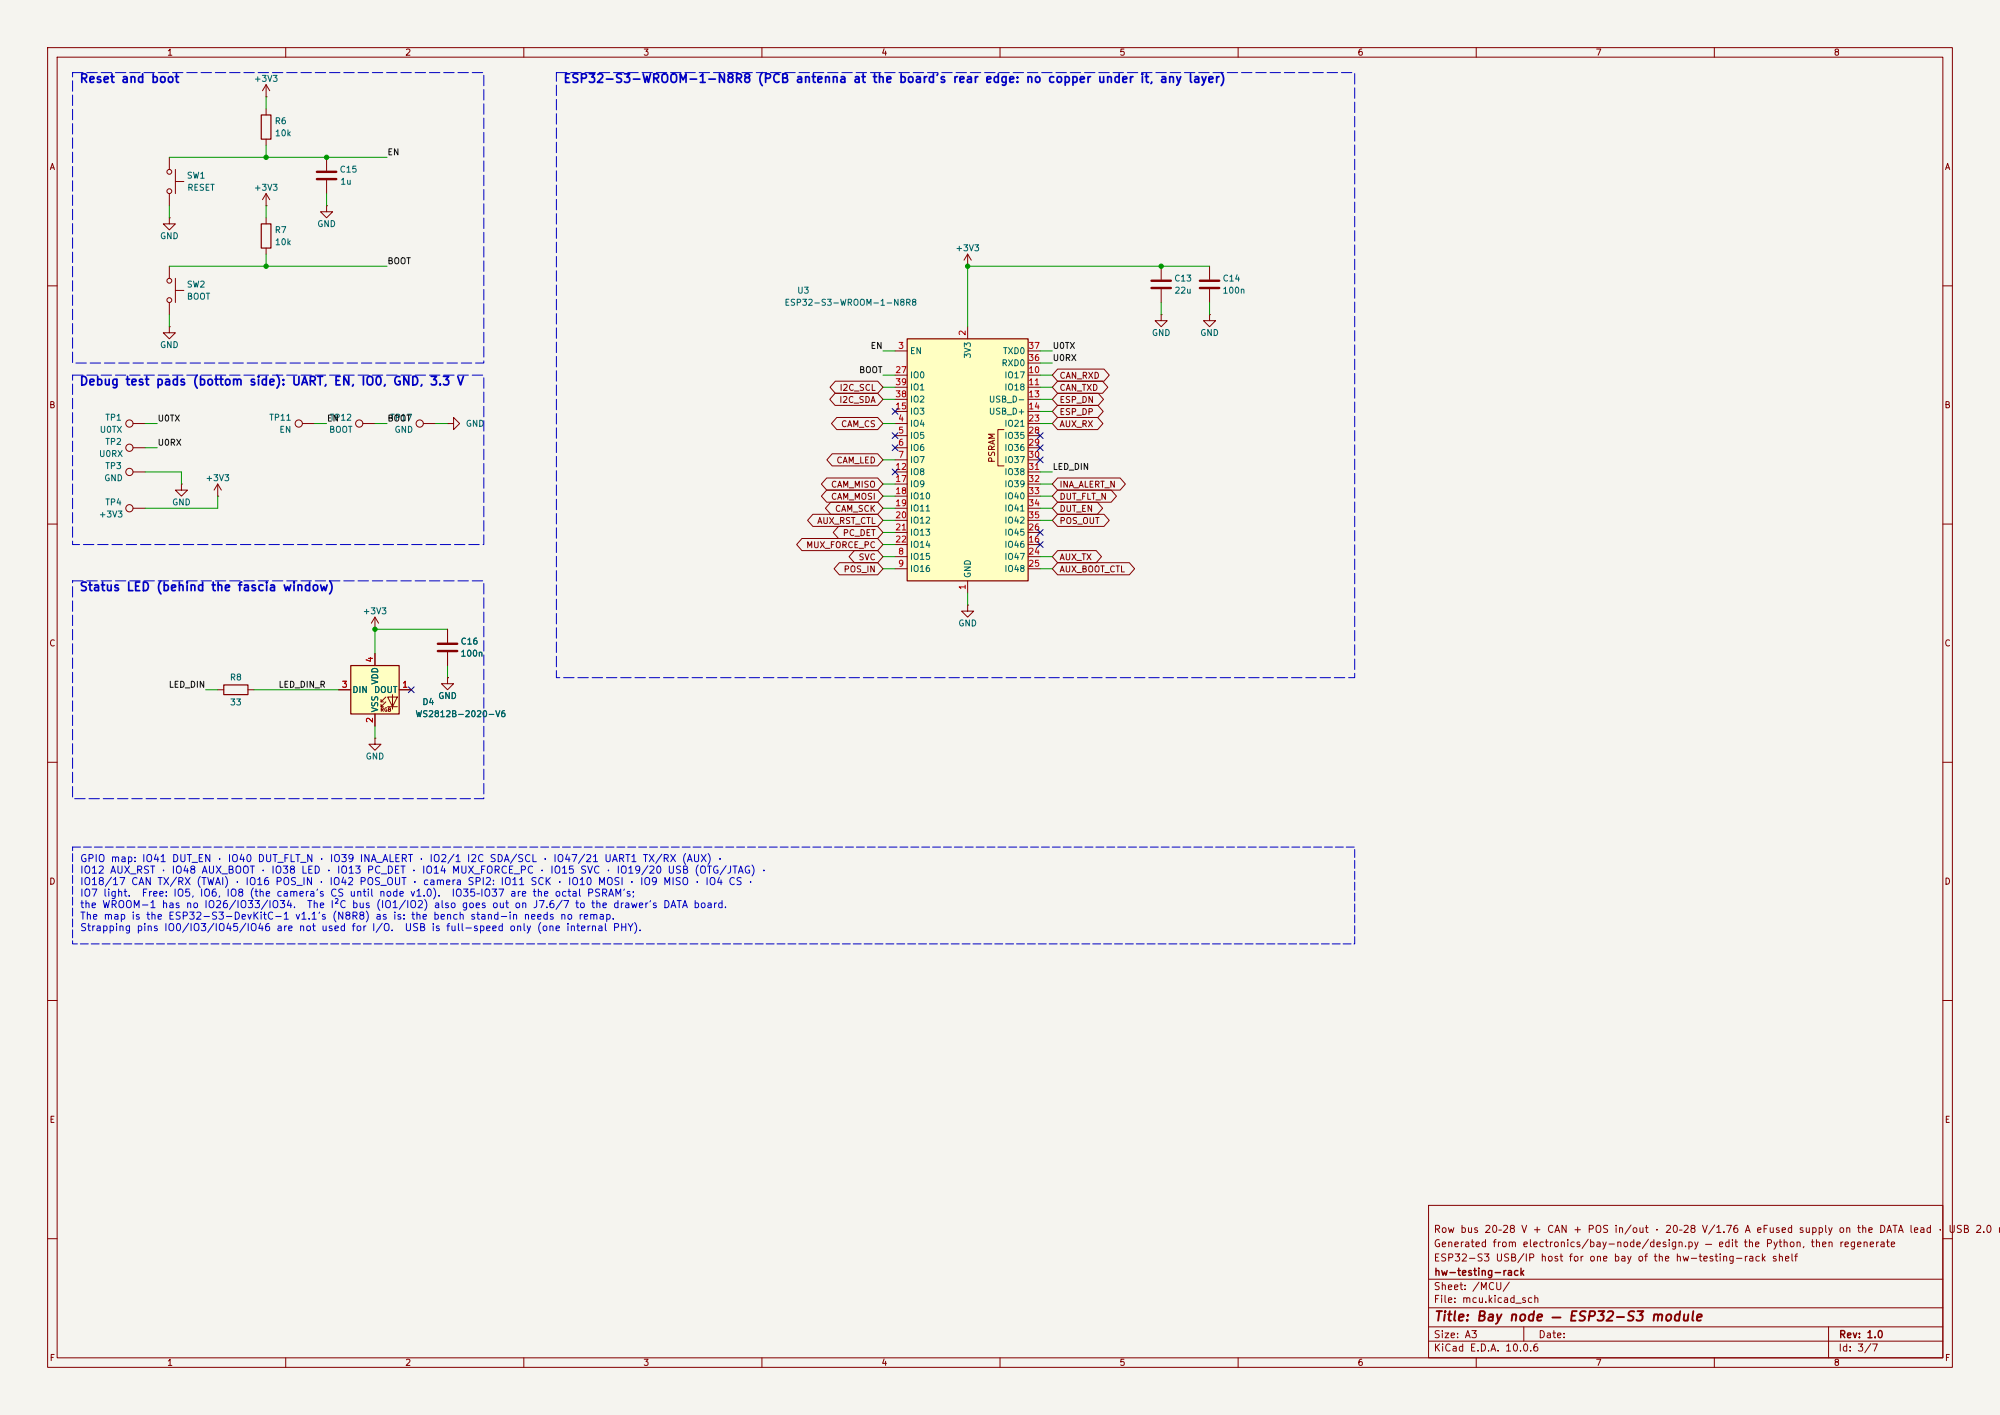
[picture p180: page 3]

ESP32-S3-WROOM-1-N8R8 (PCB antenna at the board's rear edge: no copper under it, any layer)

Debug test pads (bottom side): UART, EN, IO0, GND, 3.3 V

Status LED (behind the fascia window)

IO12 AUX_RST · IO48 AUX_BOOT · IO38 LED · IO13 PC_DET · IO14 MUX_FORCE_PC · IO15 SVC · IO19/20 USB (OTG/JTAG) ·
IO18/17 CAN TX/RX (TWAI) · IO16 POS_IN · IO42 POS_OUT · camera SPI2: IO11 SCK · IO10 MOSI · IO9 MISO · IO4 CS ·
The map is the ESP32-S3-DevKitC-1 v1.1's (N8R8) as is: the bench stand-in needs no remap.

Generated from electronics/bay-node/design.py — edit the Python, then regenerate
ESP32-S3 USB/IP host for one bay of the hw-testing-rack shelf
hw-testing-rack
Sheet: /MCU/
File: mcu.kicad_sch
Title: Bay node — ESP32-S3 module

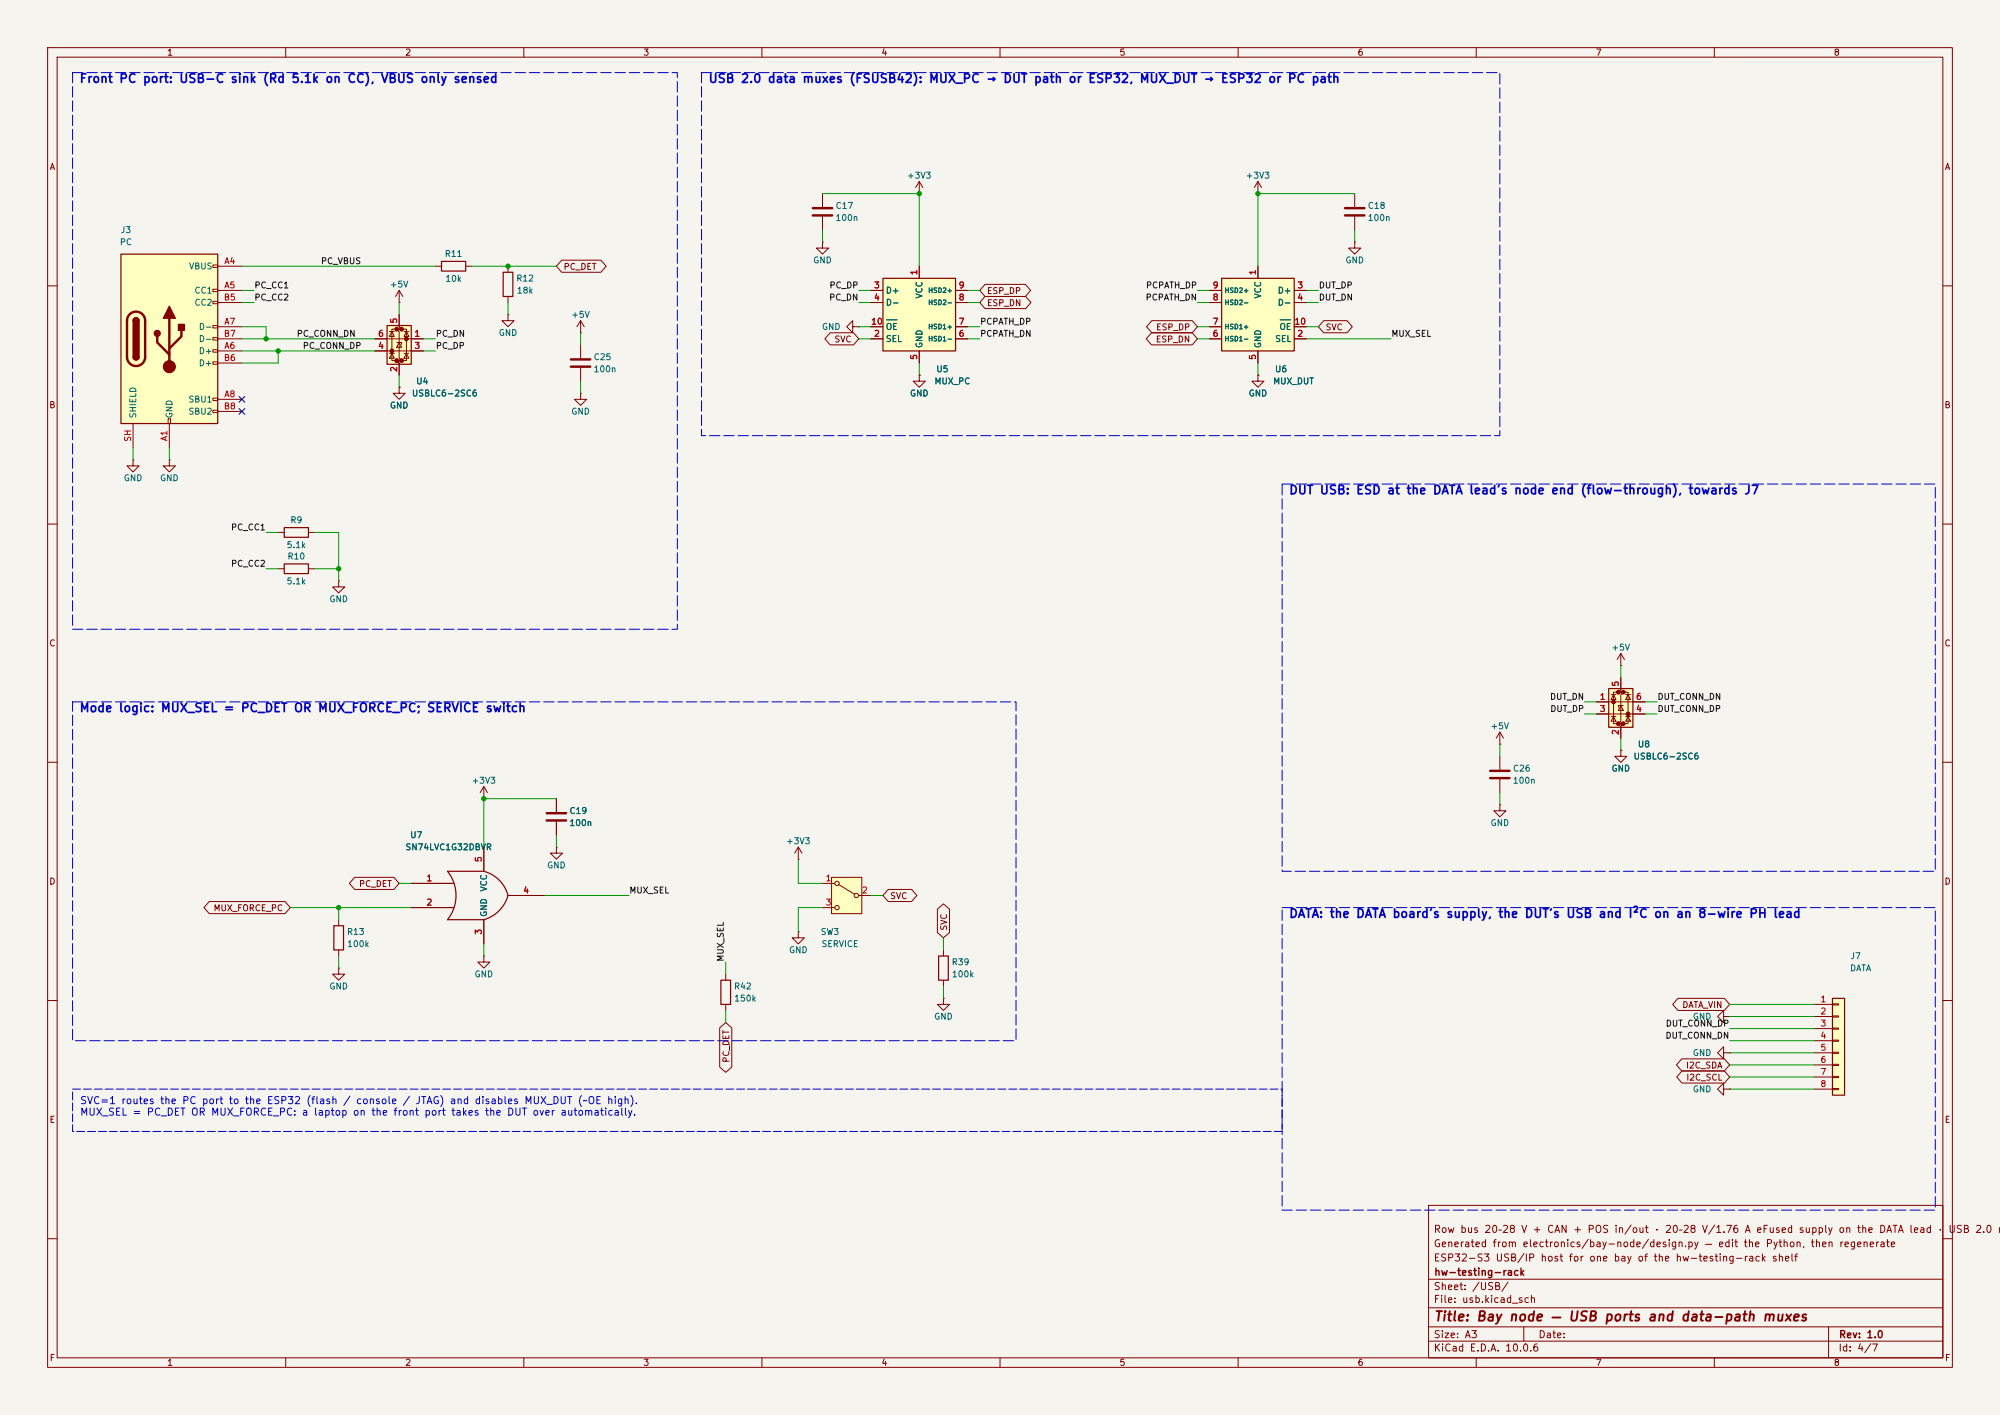
[picture p181: page 4]

Front PC port: USB-C sink (Rd 5.1k on CC), VBUS only sensed

USB 2.0 data muxes (FSUSB42): MUX_PC → DUT path or ESP32, MUX_DUT → ESP32 or PC path

DUT USB: ESD at the DATA lead's node end (flow-through), towards J7

Mode logic: MUX_SEL = PC_DET OR MUX_FORCE_PC; SERVICE switch

DATA: the DATA board's supply, the DUT's USB and I²C on an 8-wire PH lead

SVC=1 routes the PC port to the ESP32 (flash / console / JTAG) and disables MUX_DUT (~OE high).
MUX_SEL = PC_DET OR MUX_FORCE_PC: a laptop on the front port takes the DUT over automatically.

Generated from electronics/bay-node/design.py — edit the Python, then regenerate
ESP32-S3 USB/IP host for one bay of the hw-testing-rack shelf
hw-testing-rack
Sheet: /USB/
File: usb.kicad_sch
Title: Bay node — USB ports and data-path muxes

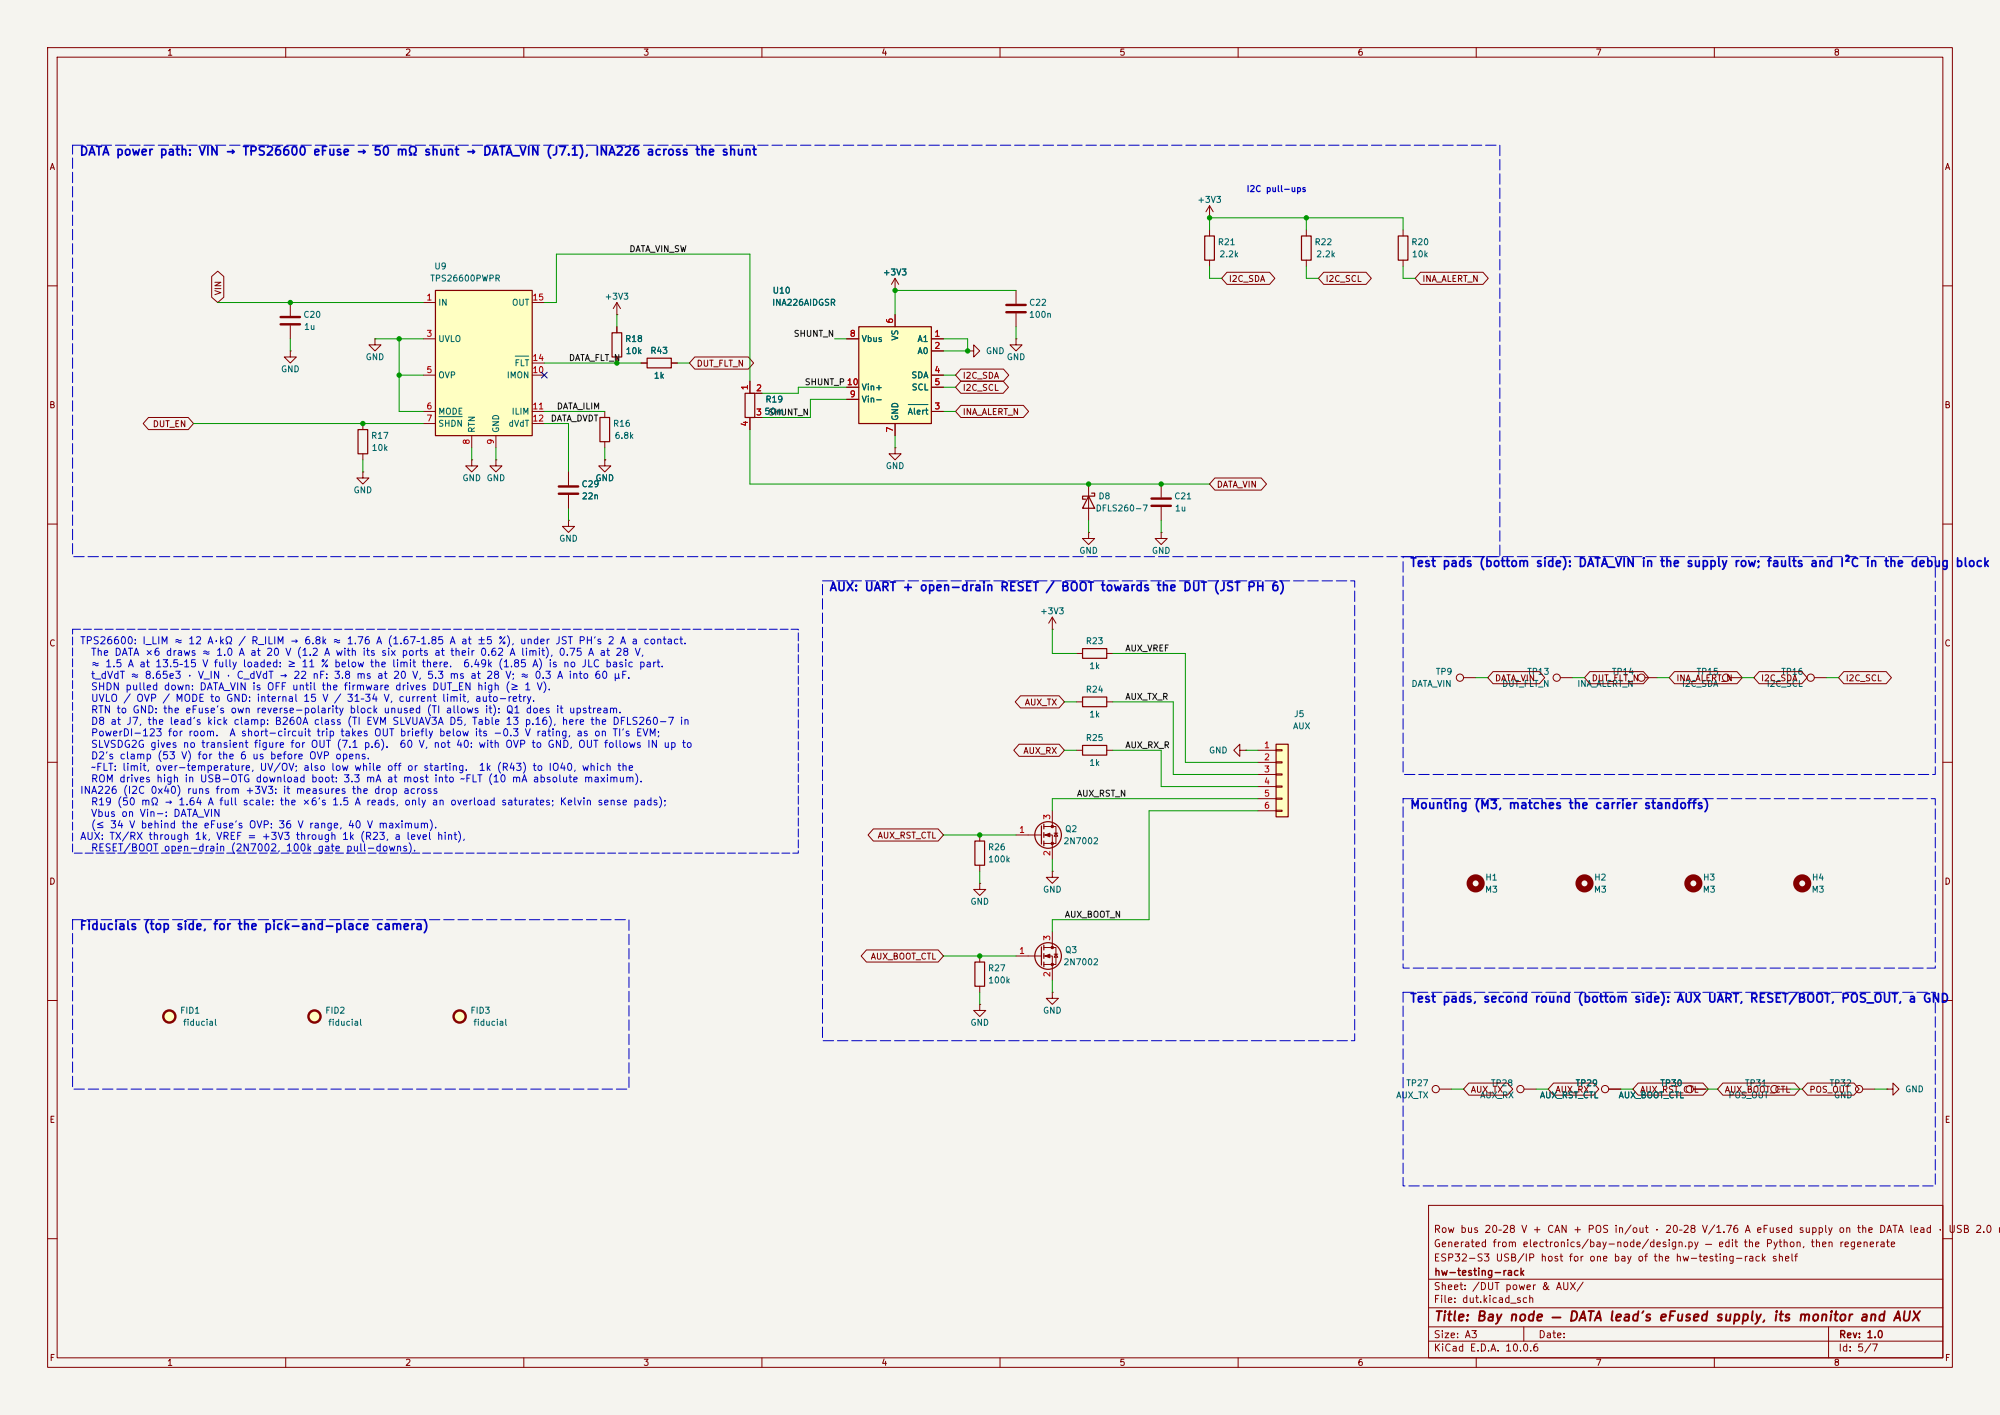
[picture p182: page 5]

DATA power path: VIN → TPS26600 eFuse → 50 mΩ shunt → DATA_VIN (J7.1), INA226 across the shunt

Test pads (bottom side): DATA_VIN in the supply row; faults and I²C in the debug block

AUX: UART + open-drain RESET / BOOT towards the DUT (JST PH 6)

TPS26600: I_LIM ≈ 12 A·kΩ / R_ILIM → 6.8k ≈ 1.76 A (1.67–1.85 A at ±5 %), under JST PH's 2 A a contact.

t_dVdT ≈ 8.65e3 · V_IN · C_dVdT → 22 nF: 3.8 ms at 20 V, 5.3 ms at 28 V; ≈ 0.3 A into 60 µF.
SHDN pulled down: DATA_VIN is OFF until the firmware drives DUT_EN high (≥ 1 V).
UVLO / OVP / MODE to GND: internal 15 V / 31–34 V, current limit, auto-retry.
RTN to GND: the eFuse's own reverse-polarity block unused (TI allows it): Q1 does it upstream.
D8 at J7, the lead's kick clamp: B260A class (TI EVM SLVUAV3A D5, Table 13 p.16), here the DFLS260-7 in
D2's clamp (53 V) for the 6 us before OVP opens.
ROM drives high in USB-OTG download boot: 3.3 mA at most into ~FLT (10 mA absolute maximum).
INA226 (I2C 0x40) runs from +3V3: it measures the drop across R19 (50 mΩ → 1.64 A full scale: the ×6's 1.5 A reads, only an overload saturates; Kelvin sense pads);

Mounting (M3, matches the carrier standoffs)

Vbus on Vin-: DATA_VIN
(≤ 34 V behind the eFuse's OVP: 36 V range, 40 V maximum).
AUX: TX/RX through 1k, VREF = +3V3 through 1k (R23, a level hint),
RESET/BOOT open-drain (2N7002, 100k gate pull-downs).

Fiducials (top side, for the pick-and-place camera)

Test pads, second round (bottom side): AUX UART, RESET/BOOT, POS_OUT, a GND

Generated from electronics/bay-node/design.py — edit the Python, then regenerate
ESP32-S3 USB/IP host for one bay of the hw-testing-rack shelf
hw-testing-rack
Sheet: /DUT power & AUX/
File: dut.kicad_sch
Title: Bay node — DATA lead's eFused supply, its monitor and AUX

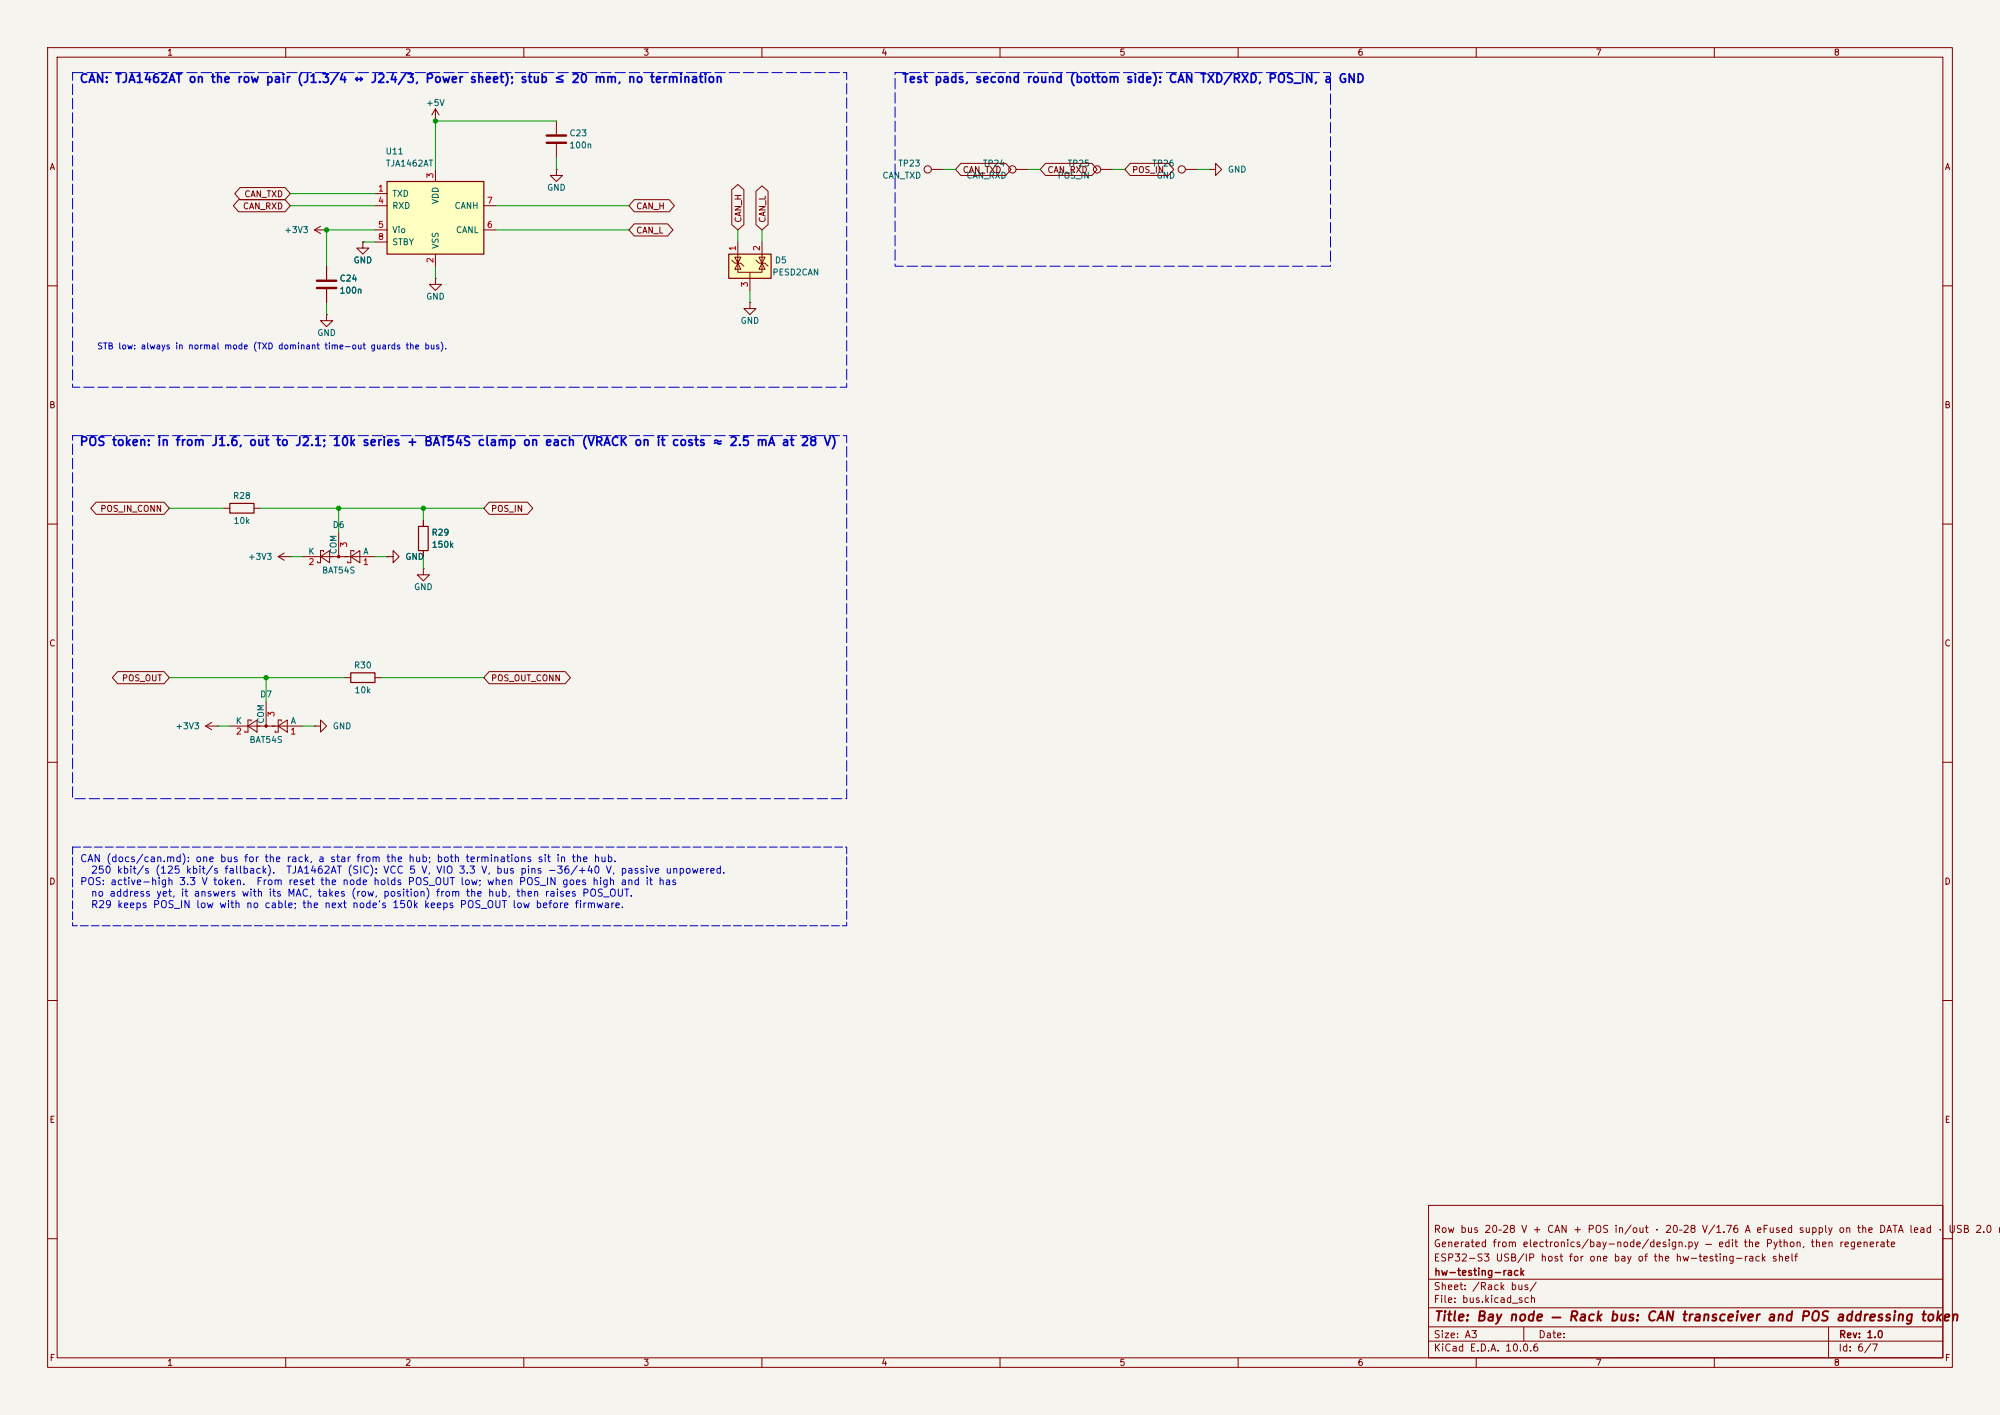
[picture p183: page 6]

STB low: always in normal mode (TXD dominant time-out guards the bus).

POS token: in from J1.6, out to J2.1; 10k series + BAT54S clamp on each (VRACK on it costs ≈ 2.5 mA at 28 V) R29

POS_IN_CONN CAN (docs/can.md): one bus for the rack, a star from the hub; both terminations sit in the hub.

R29 keeps POS_IN low with no cable; the next node's 150k keeps POS_OUT low before firmware.

Generated from electronics/bay-node/design.py — edit the Python, then regenerate
ESP32-S3 USB/IP host for one bay of the hw-testing-rack shelf
hw-testing-rack
Sheet: /Rack bus/
File: bus.kicad_sch
Title: Bay node — Rack bus: CAN transceiver and POS addressing token

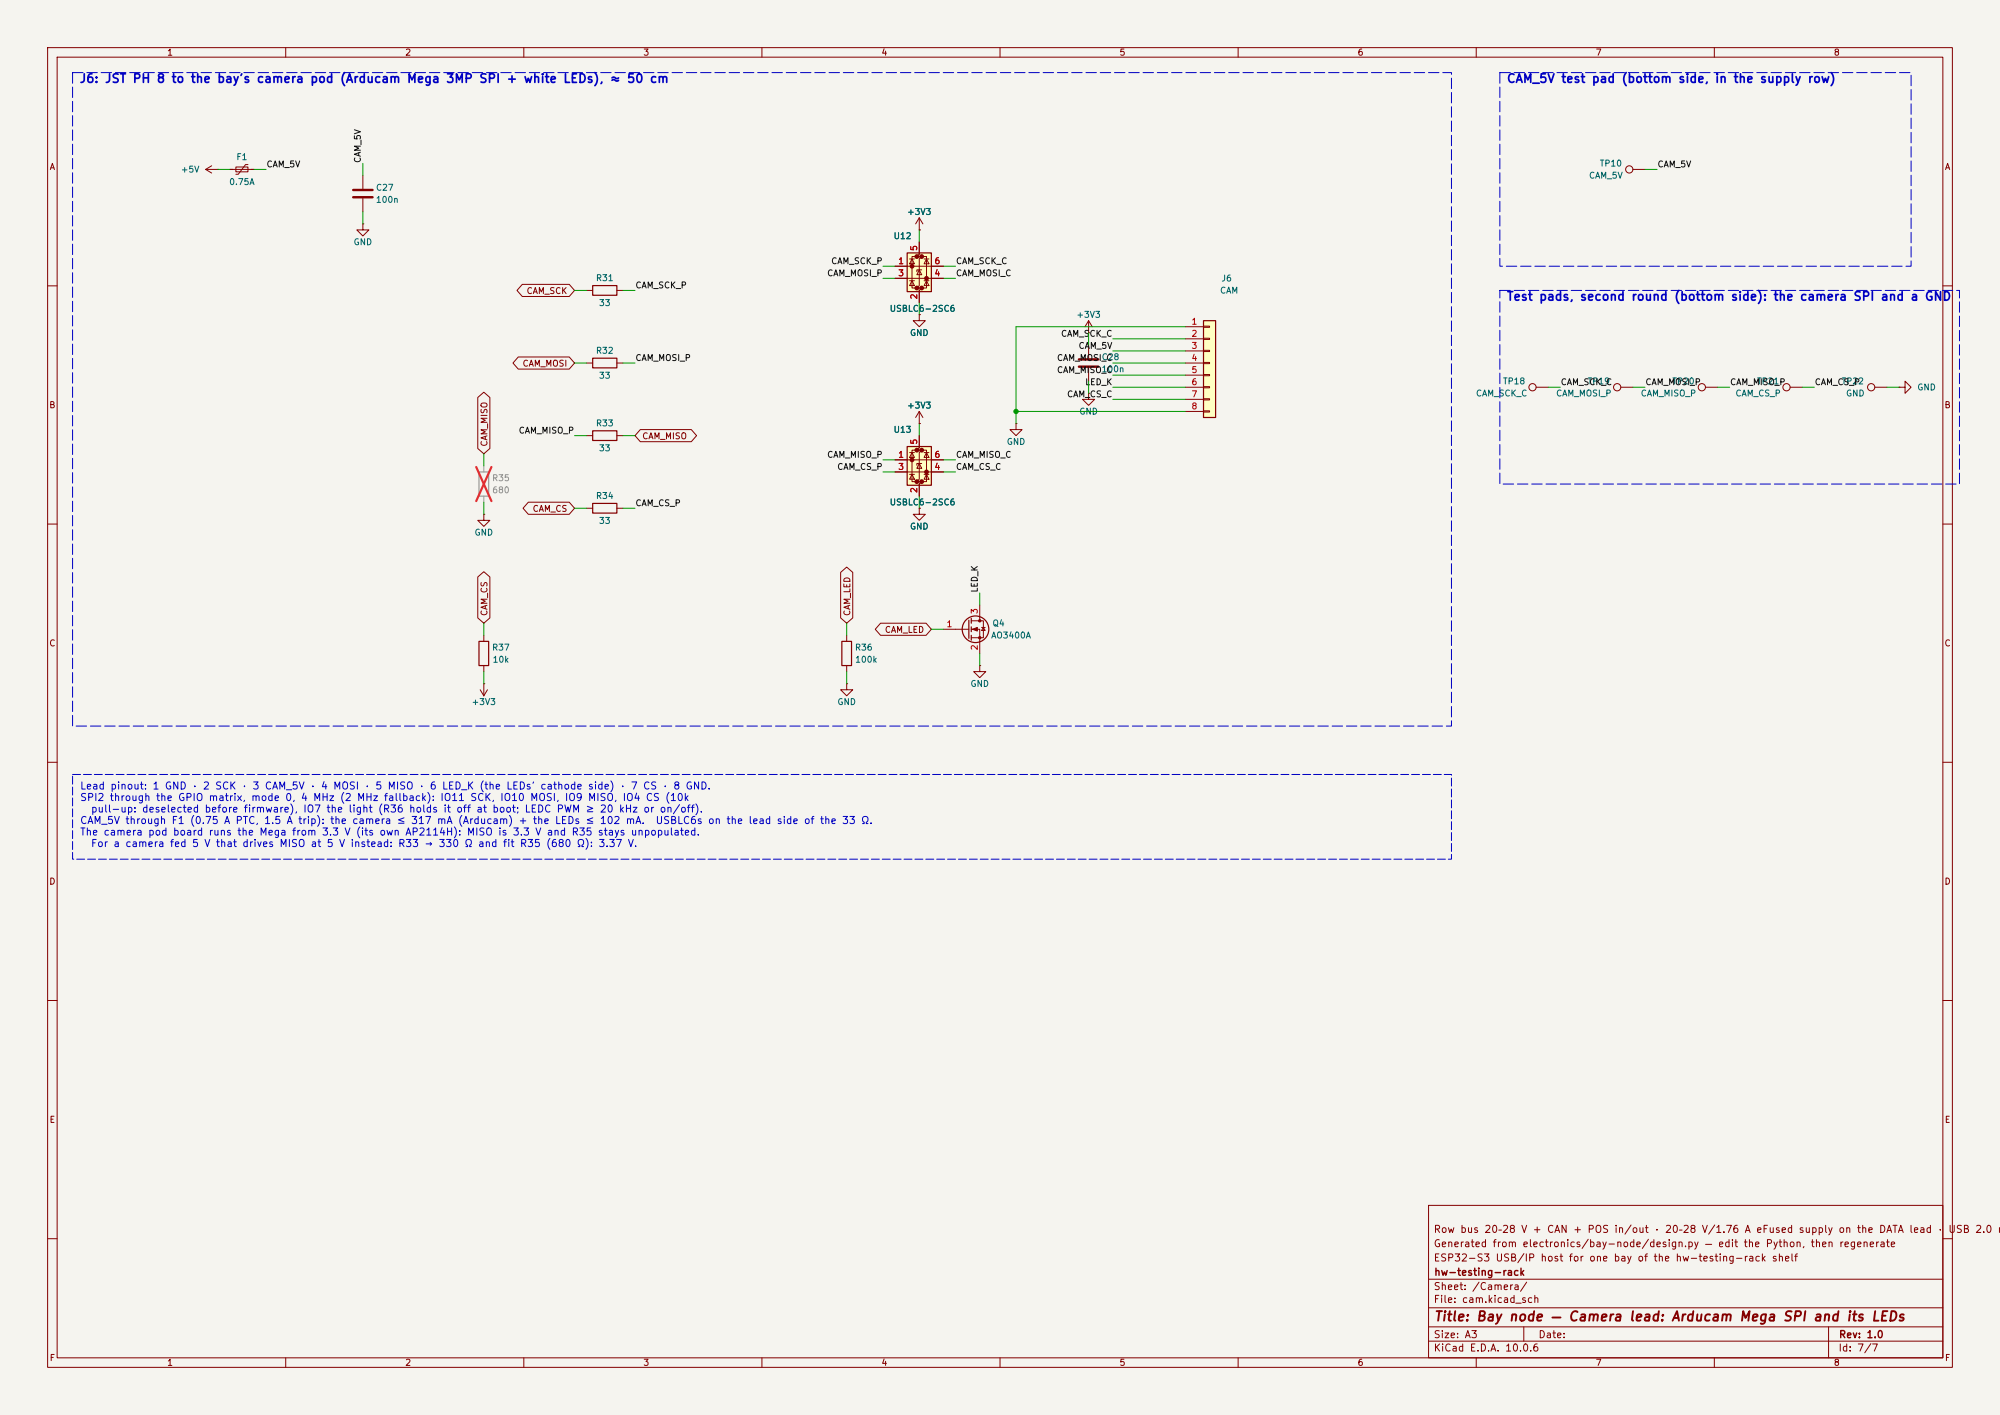
[picture p184: page 7]

Test pads, second round (bottom side): the camera SPI and a GND

Lead pinout: 1 GND · 2 SCK · 3 CAM_5V · 4 MOSI · 5 MISO · 6 LED_K (the LEDs' cathode side) · 7 CS · 8 GND.
SPI2 through the GPIO matrix, mode 0, 4 MHz (2 MHz fallback): IO11 SCK, IO10 MOSI, IO9 MISO, IO4 CS (10k
pull-up: deselected before firmware), IO7 the light (R36 holds it off at boot; LEDC PWM ≥ 20 kHz or on/off).
The camera pod board runs the Mega from 3.3 V (its own AP2114H): MISO is 3.3 V and R35 stays unpopulated.
For a camera fed 5 V that drives MISO at 5 V instead: R33 → 330 Ω and fit R35 (680 Ω): 3.37 V.

Generated from electronics/bay-node/design.py — edit the Python, then regenerate
ESP32-S3 USB/IP host for one bay of the hw-testing-rack shelf
hw-testing-rack
Sheet: /Camera/
File: cam.kicad_sch
Title: Bay node — Camera lead: Arducam Mega SPI and its LEDs
