kartben/hw-testing-rack/electronics/data-port-x4/data-port-x4.kicad_pcb

## KiCad design electronics/data-port-x4/data-port-x4.kicad_pcb (2026-11-10)

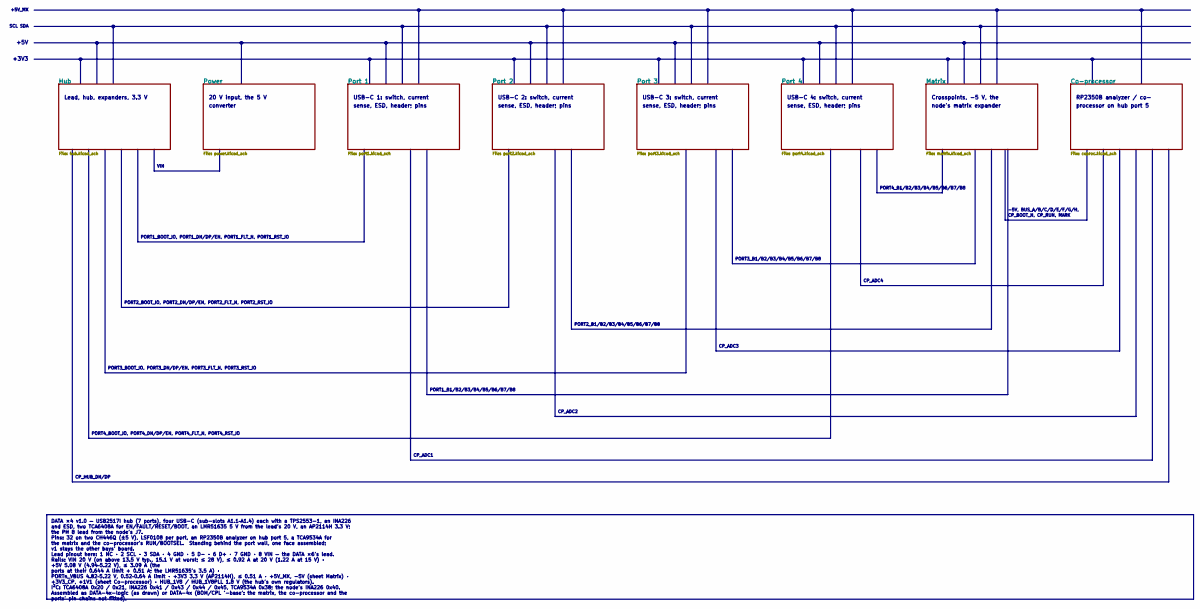
[picture p193: schematic data-port-x4.kicad_sch, DATA ×4 v2 — Overview]

Notes on the sheet:
Lead, hub, expanders, 3.3 V
20 V input, the 5 V
converter
USB-C 1: switch, current
sense, ESD, header; pins
USB-C 2: switch, current
USB-C 3: switch, current
USB-C 4: switch, current
Crosspoints, −5 V, the
node's matrix expander
RP2350B analyzer / co-
processor on hub port 5
+3V3
+5V
SCL SDA
+5V_MX
VIN
PORT4_B1/B2/B3/B4/B5/B6/B7/B8
-5V, BUS_A/B/C/D/E/F/G/H,
CP_BOOT_N, CP_RUN, MARK
PORT1_BOOT_IO, PORT1_DN/DP/EN, PORT1_FLT_N, PORT1_RST_IO
PORT3_B1/B2/B3/B4/B5/B6/B7/B8
CP_ADC4
PORT2_BOOT_IO, PORT2_DN/DP/EN, PORT2_FLT_N, PORT2_RST_IO
PORT2_B1/B2/B3/B4/B5/B6/B7/B8
CP_ADC3
PORT3_BOOT_IO, PORT3_DN/DP/EN, PORT3_FLT_N, PORT3_RST_IO
PORT1_B1/B2/B3/B4/B5/B6/B7/B8
CP_ADC2
PORT4_BOOT_IO, PORT4_DN/DP/EN, PORT4_FLT_N, PORT4_RST_IO
CP_ADC1
CP_HUB_DN/DP
DATA ×4 v1.0 — USB2517I hub (7 ports), four USB-C (sub-slots A1.1–A1.4) each with a TPS2553-1, an INA226 and ESD, two TCA6408A for EN/FAULT/RESET/BOOT, an LMR51635 5 V from the lead's 20 V, an AP2114H 3.3 V; the PH 8 lead from the node's J7. Pins: 32 on two CH446Q (±5 V), LSF0108 per port, an RP235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

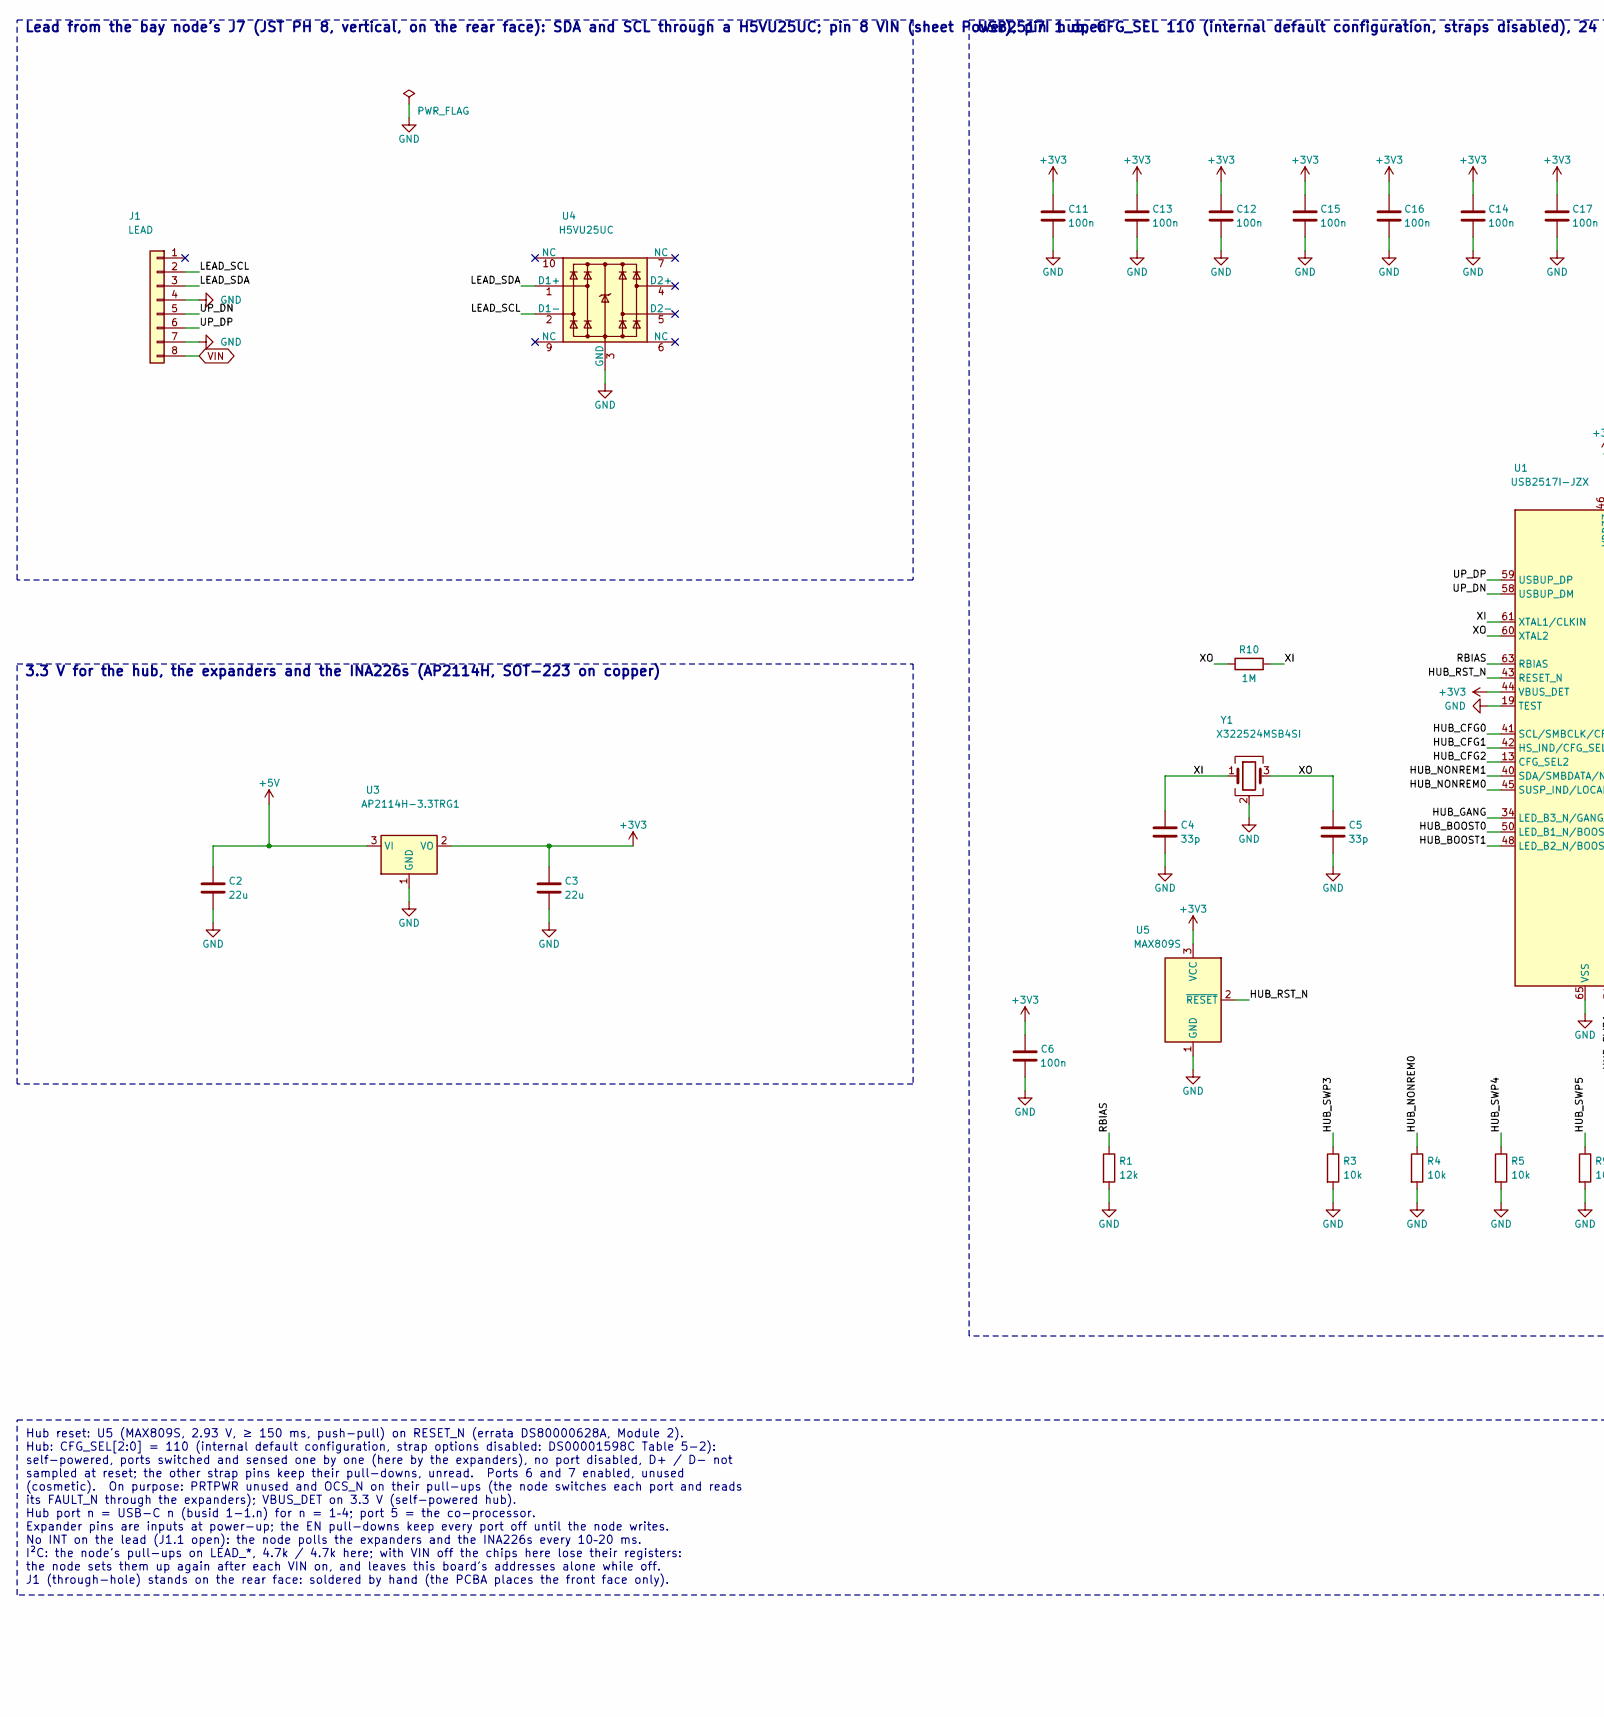
[picture p194: schematic hub.kicad_sch, DATA ×4 v2 — Lead, hub, expanders, 3.3 V, part in row 1, column 1]

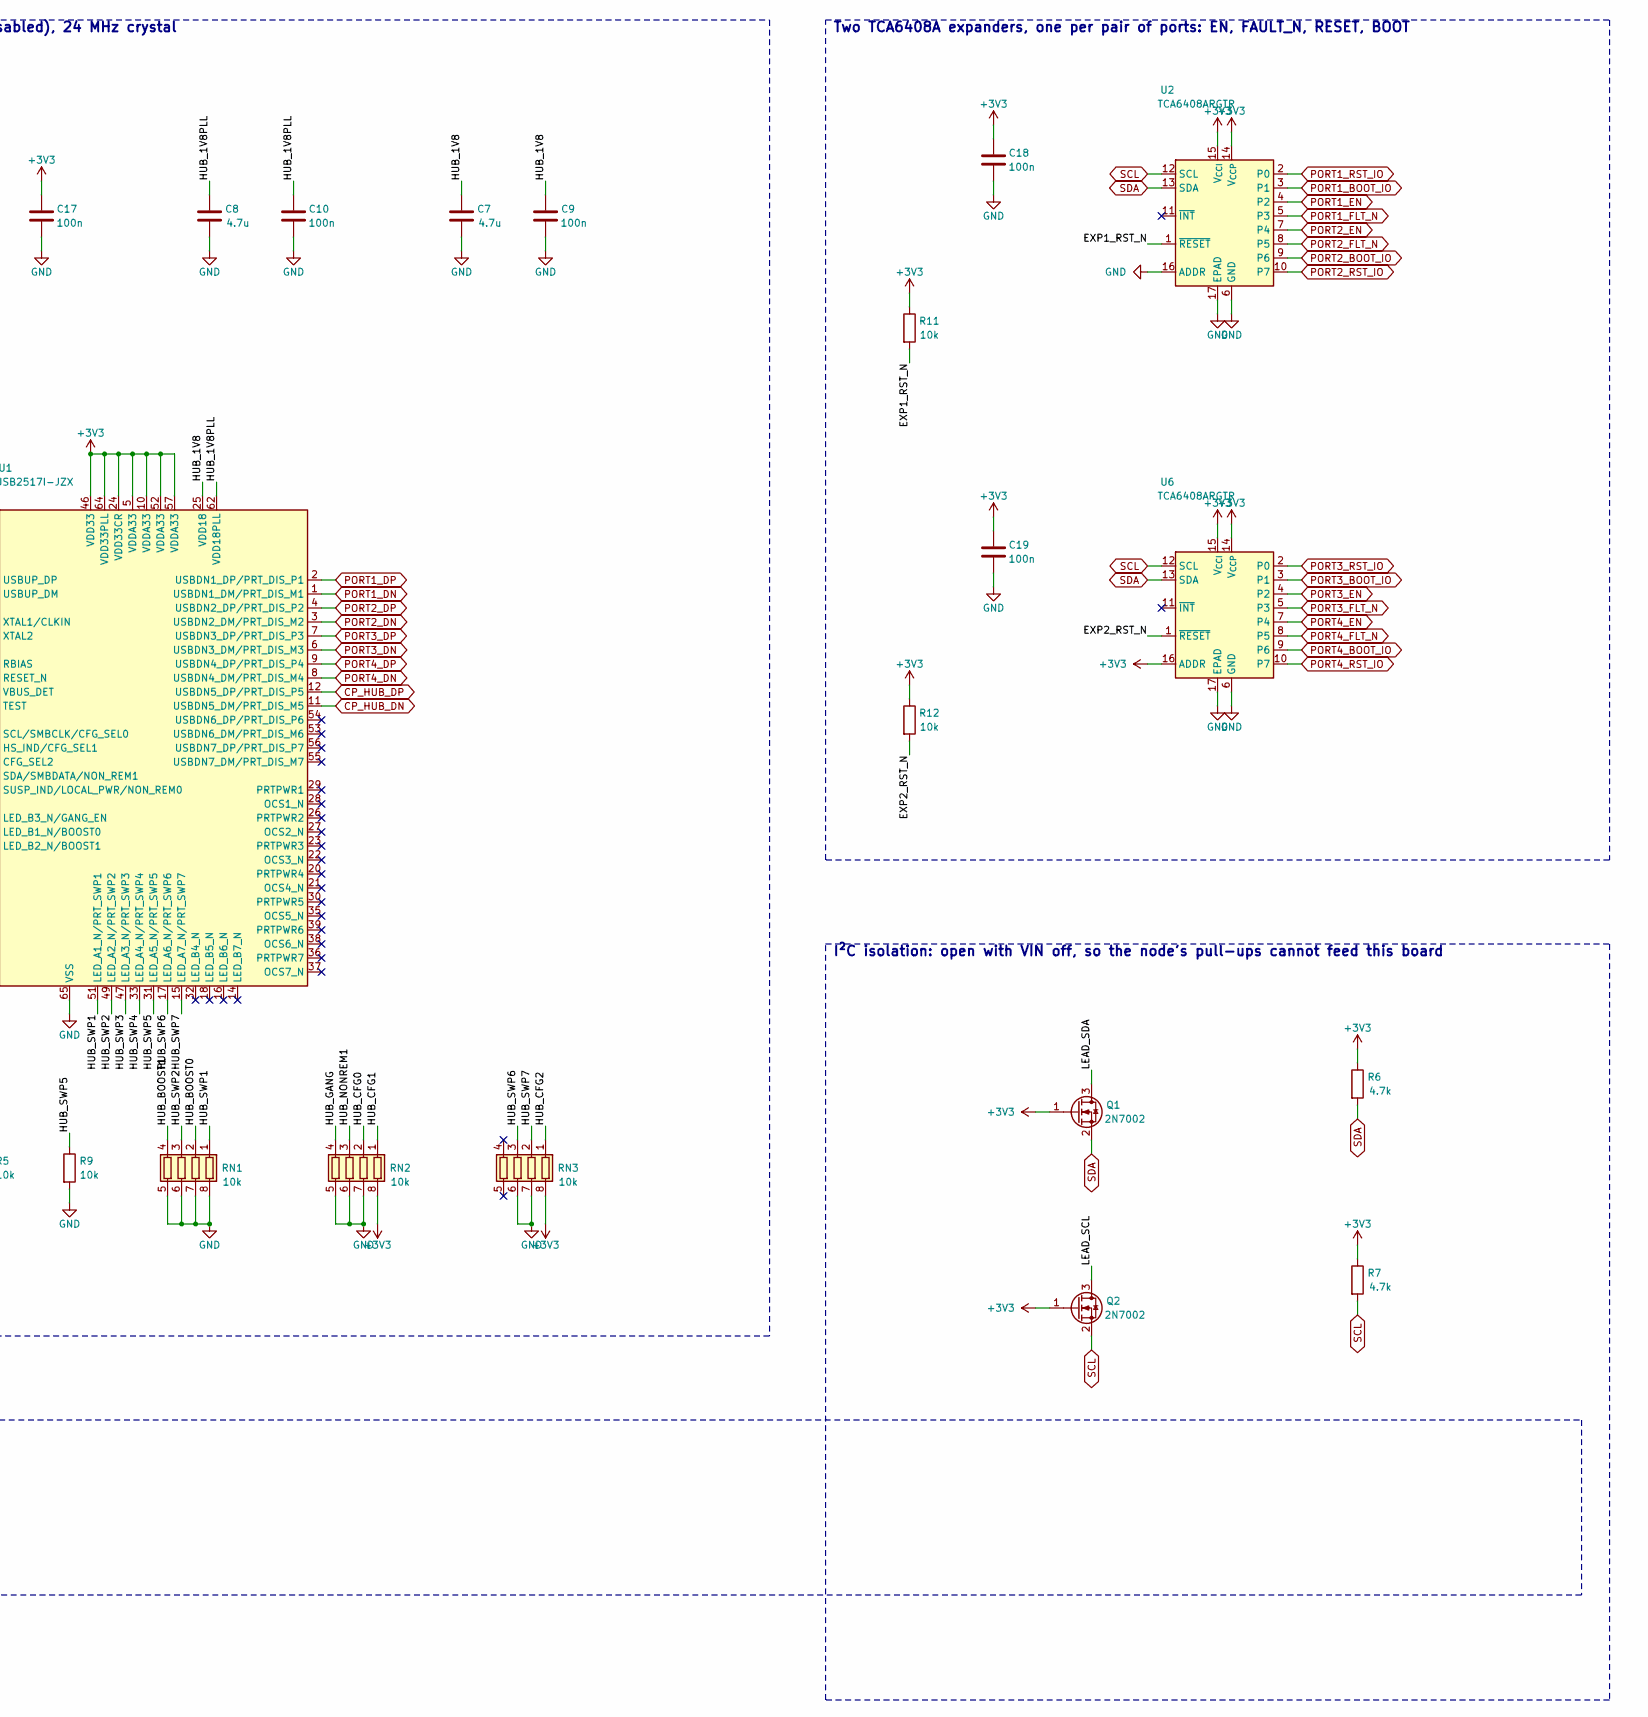
[picture p195: schematic hub.kicad_sch, DATA ×4 v2 — Lead, hub, expanders, 3.3 V, part in row 1, column 2]

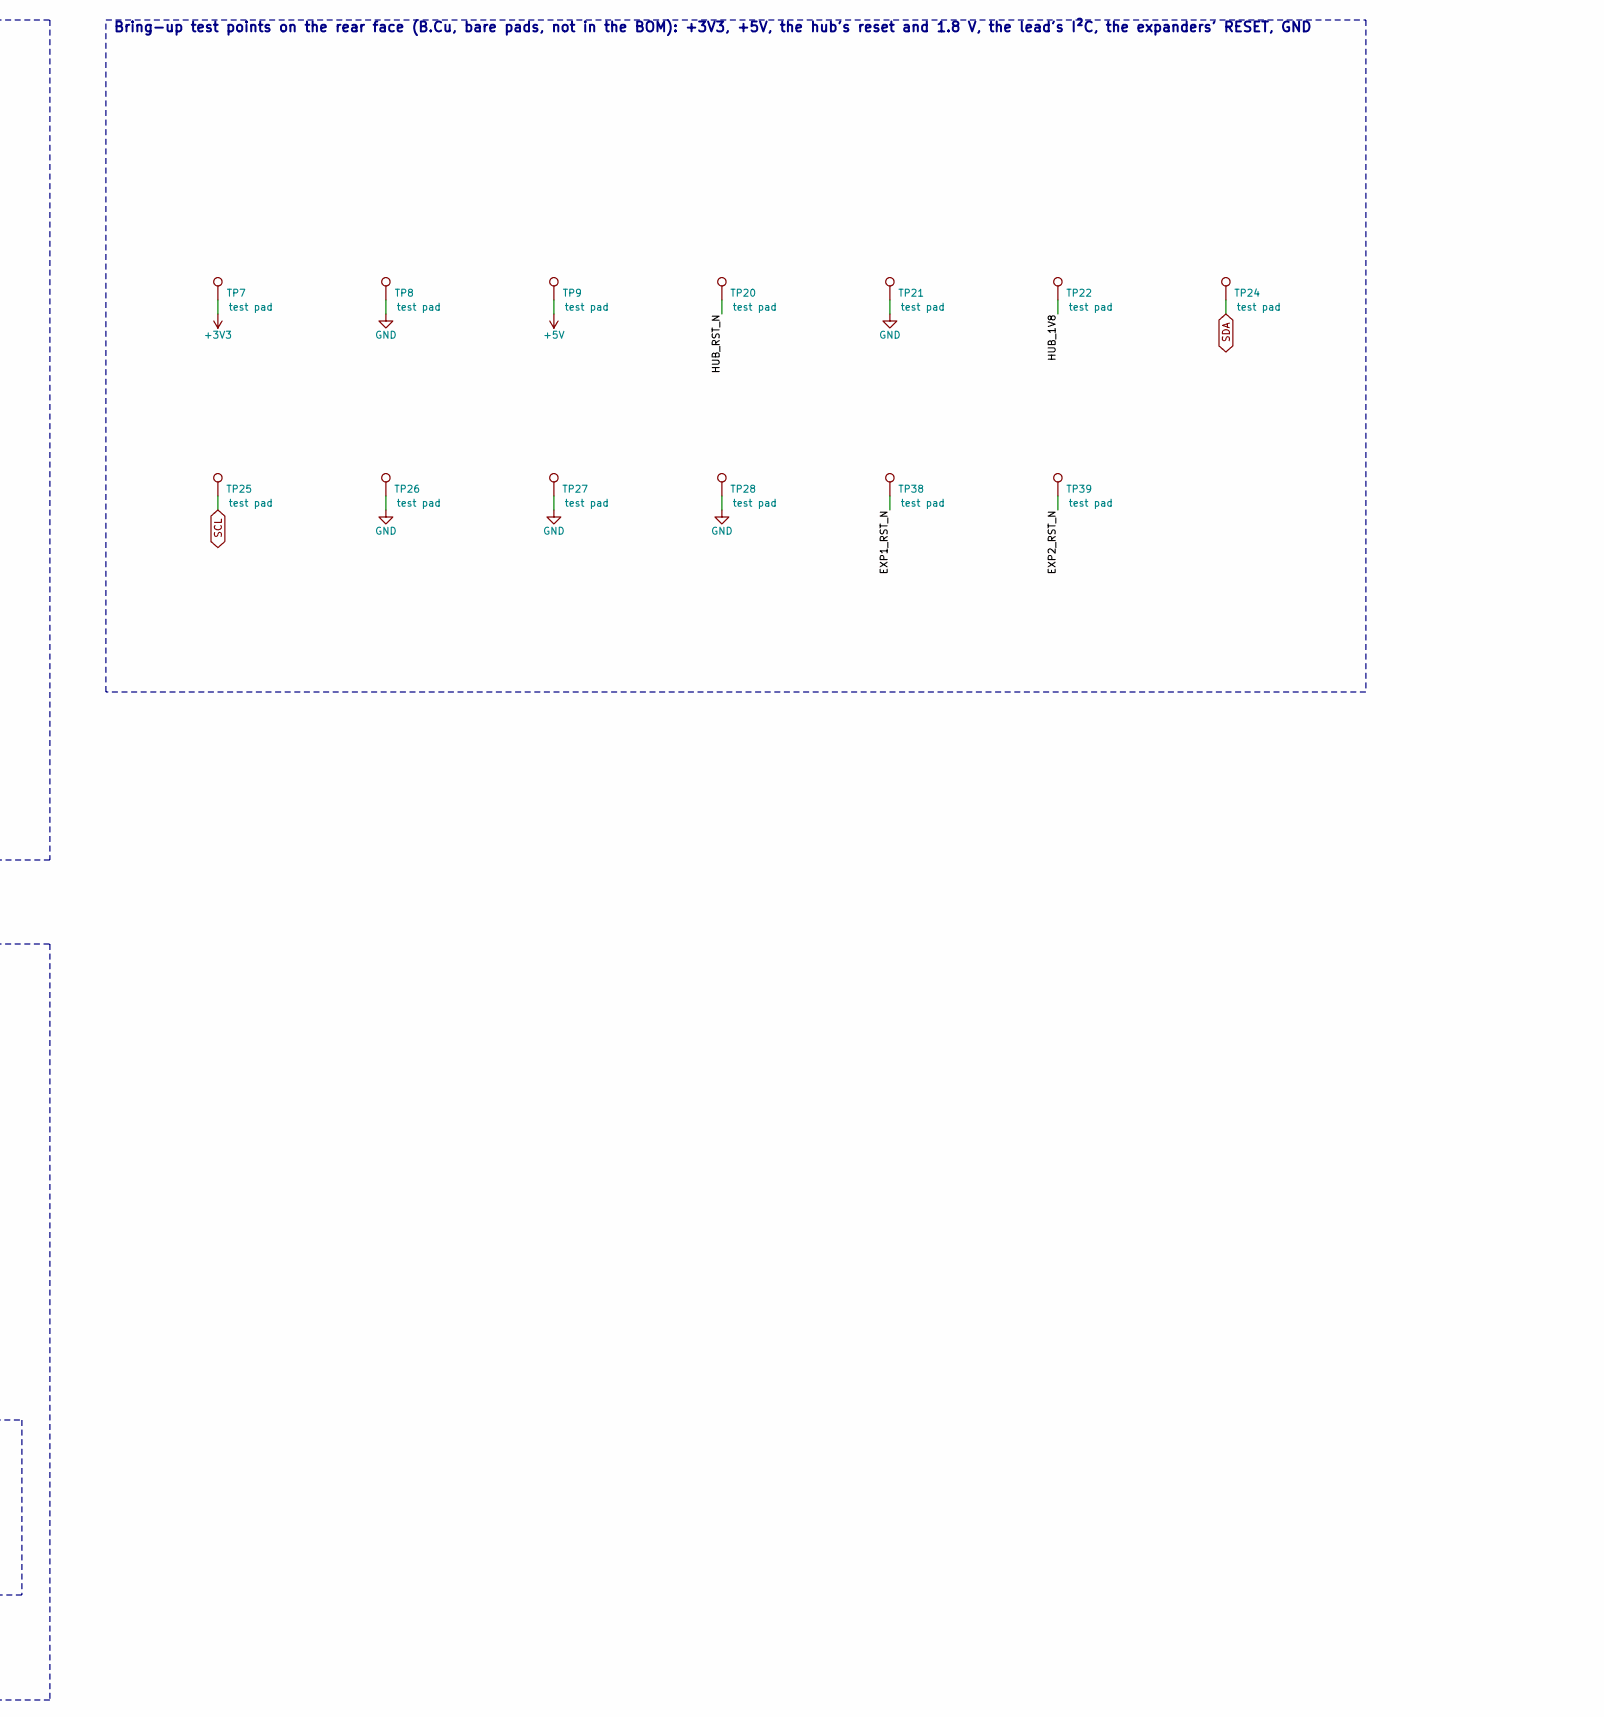
[picture p196: schematic hub.kicad_sch, DATA ×4 v2 — Lead, hub, expanders, 3.3 V, part in row 1, column 3]

Parts:
C2, C3: 22u; C_0805_2012Metric; MPN CL21A226MAQNNNE; LCSC C45783
C4, C5: 33p; C_0402_1005Metric; MPN 0402CG330J500NT; LCSC C1562
C6, C9, C10, C11, C12, C13, C14, C15, C16, C17, C18, C19: 100n; C_0402_1005Metric; MPN CL05B104KO5NNNC; LCSC C1525
C7, C8: 4.7u; C_0402_1005Metric; MPN CL05A475MP5NRNC; LCSC C23733
J1: LEAD; JST_PH_B8B-PH-K_1x08_P2.00mm_Vertical; MPN B8B-PH-K-S(LF)(SN); LCSC C157974
Q1, Q2: 2N7002; SOT-23; MPN 2N7002; LCSC C8545
R1: 12k; R_0402_1005Metric; MPN 0402WGF1202TCE; LCSC C25752
R3, R4, R5, R9, R11, R12: 10k; R_0402_1005Metric; MPN 0402WGF1002TCE; LCSC C25744
R6, R7: 4.7k; R_0402_1005Metric; MPN 0402WGF4701TCE; LCSC C25900
R10: 1M; R_0402_1005Metric; MPN 0402WGF1004TCE; LCSC C26083
RN1, RN2, RN3: 10k; R_Array_Convex_4x0402; MPN 4D02WGJ0103TCE; LCSC C25725
TP7, TP8, TP9, TP21, TP22, TP26, TP27, TP28: test pad; TestPoint_Pad_D1.5mm; MPN test pad
TP20, TP24, TP25, TP38, TP39: test pad; TestPoint_Pad_D1.0mm; MPN test pad
U1: USB2517I-JZX; QFN-64-1EP_9x9mm_P0.5mm_EP4.7x4.7mm_Paste4x4; MPN USB2517I-JZX; LCSC C478081
U2, U6: TCA6408ARGTR; VQFN-16-1EP_3x3mm_P0.5mm_EP1.45x1.45mm; MPN TCA6408ARGTR; LCSC C181499
U3: AP2114H-3.3TRG1; SOT-223-3_TabPin2; MPN AP2114H-3.3TRG1; LCSC C150716
U4: H5VU25UC; DFN2510-10L_2.5x1.0mm_P0.5mm; MPN H5VU25UC; LCSC C20615800
U5: MAX809S; SOT-23; MPN MAX809S; LCSC C347371
Y1: X322524MSB4SI; Crystal_SMD_3225-4Pin_3.2x2.5mm; MPN X322524MSB4SI; LCSC C15643

Connections:
+3V3: C3.1, C6.1, C11.1, C12.1, C13.1, C14.1, C15.1, C16.1, C17.1, C18.1, C19.1, Q1.1 (G), Q2.1 (G), R6.1, R7.1, R11.1, R12.1, RN2.8 (R1.2), RN3.8 (R1.2), TP7.1, U1.5 (VDDA33), U1.10 (VDDA33), U1.24 (VDD33CR), U1.44 (VBUS_DET), U1.46 (VDD33), U1.52 (VDDA33), U1.57 (VDDA33), U1.64 (VDD33PLL), U2.14 (V_{CCP}), U2.15 (V_{CCI}), U3.2 (VO), U5.3 (VCC), U6.14 (V_{CCP}), U6.15 (V_{CCI}), U6.16 (ADDR); also elsewhere on the board
+5V: C2.1, TP9.1, U3.3 (VI); also elsewhere on the board
/Hub/EXP1_RST_N: R11.2, TP38.1, U2.1 (~RESET)
/Hub/EXP2_RST_N: R12.2, TP39.1, U6.1 (~RESET)
/Hub/HUB_1V8: C7.1, C9.1, TP22.1, U1.25 (VDD18)
/Hub/HUB_1V8PLL: C8.1, C10.1, U1.62 (VDD18PLL)
/Hub/HUB_BOOST0: RN1.2 (R2.1), U1.50 (LED_B1_N/BOOST0)
/Hub/HUB_BOOST1: RN1.4 (R4.1), U1.48 (LED_B2_N/BOOST1)
/Hub/HUB_CFG0: RN2.2 (R2.1), U1.41 (SCL/SMBCLK/CFG_SEL0)
/Hub/HUB_CFG1: RN2.1 (R1.1), U1.42 (HS_IND/CFG_SEL1)
/Hub/HUB_CFG2: RN3.1 (R1.1), U1.13 (CFG_SEL2)
/Hub/HUB_GANG: RN2.4 (R4.1), U1.34 (LED_B3_N/GANG_EN)
/Hub/HUB_NONREM0: R4.1, U1.45 (SUSP_IND/LOCAL_PWR/NON_REM0)
/Hub/HUB_NONREM1: RN2.3 (R3.1), U1.40 (SDA/SMBDATA/NON_REM1)
/Hub/HUB_RST_N: TP20.1, U1.43 (RESET_N), U5.2 (~RESET)
/Hub/HUB_SWP1: RN1.1 (R1.1), U1.51 (LED_A1_N/PRT_SWP1)
/Hub/HUB_SWP2: RN1.3 (R3.1), U1.49 (LED_A2_N/PRT_SWP2)
/Hub/HUB_SWP3: R3.1, U1.47 (LED_A3_N/PRT_SWP3)
/Hub/HUB_SWP4: R5.1, U1.33 (LED_A4_N/PRT_SWP4)
/Hub/HUB_SWP5: R9.1, U1.31 (LED_A5_N/PRT_SWP5)
/Hub/HUB_SWP6: RN3.3 (R3.1), U1.17 (LED_A6_N/PRT_SWP6)
/Hub/HUB_SWP7: RN3.2 (R2.1), U1.15 (LED_A7_N/PRT_SWP7)
/Hub/LEAD_SCL: J1.2, Q2.3 (D), U4.2 (D1-)
/Hub/LEAD_SDA: J1.3, Q1.3 (D), U4.1 (D1+)
/Hub/RBIAS: R1.1, U1.63 (RBIAS)
/Hub/UP_DN: J1.5, U1.58 (USBUP_DM)
/Hub/UP_DP: J1.6, U1.59 (USBUP_DP)
/Hub/XI: C4.1, R10.2, U1.61 (XTAL1/CLKIN), Y1.1
/Hub/XO: C5.1, R10.1, U1.60 (XTAL2), Y1.3
CP_HUB_DN: U1.11 (USBDN5_DM/PRT_DIS_M5); also elsewhere on the board
CP_HUB_DP: U1.12 (USBDN5_DP/PRT_DIS_P5); also elsewhere on the board
GND: C2.2, C3.2, C4.2, C5.2, C6.2, C7.2, C8.2, C9.2, C10.2, C11.2, C12.2, C13.2, C14.2, C15.2, C16.2, C17.2, C18.2, C19.2, J1.4, J1.7, R1.2, R3.2, R4.2, R5.2, R9.2, RN1.5 (R4.2), RN1.6 (R3.2), RN1.7 (R2.2), RN1.8 (R1.2), RN2.5 (R4.2), RN2.6 (R3.2), RN2.7 (R2.2), RN3.6 (R3.2), RN3.7 (R2.2), TP8.1, TP21.1, TP26.1, TP27.1, TP28.1, U1.19 (TEST), U1.65 (VSS), U2.6 (GND), U2.16 (ADDR), U2.17 (EPAD), U3.1 (GND), U4.3 (GND), U4.8 (GND), U5.1 (GND), U6.6 (GND), U6.17 (EPAD), Y1.2 (G), Y1.4 (G); also elsewhere on the board
PORT1_BOOT_IO: U2.3 (P1); also elsewhere on the board
PORT1_DN: U1.1 (USBDN1_DM/PRT_DIS_M1); also elsewhere on the board
PORT1_DP: U1.2 (USBDN1_DP/PRT_DIS_P1); also elsewhere on the board
PORT1_EN: U2.4 (P2); also elsewhere on the board
PORT1_FLT_N: U2.5 (P3); also elsewhere on the board
PORT1_RST_IO: U2.2 (P0); also elsewhere on the board
PORT2_BOOT_IO: U2.9 (P6); also elsewhere on the board
PORT2_DN: U1.3 (USBDN2_DM/PRT_DIS_M2); also elsewhere on the board
PORT2_DP: U1.4 (USBDN2_DP/PRT_DIS_P2); also elsewhere on the board
PORT2_EN: U2.7 (P4); also elsewhere on the board
PORT2_FLT_N: U2.8 (P5); also elsewhere on the board
PORT2_RST_IO: U2.10 (P7); also elsewhere on the board
PORT3_BOOT_IO: U6.3 (P1); also elsewhere on the board
PORT3_DN: U1.6 (USBDN3_DM/PRT_DIS_M3); also elsewhere on the board
PORT3_DP: U1.7 (USBDN3_DP/PRT_DIS_P3); also elsewhere on the board
PORT3_EN: U6.4 (P2); also elsewhere on the board
PORT3_FLT_N: U6.5 (P3); also elsewhere on the board
PORT3_RST_IO: U6.2 (P0); also elsewhere on the board
PORT4_BOOT_IO: U6.9 (P6); also elsewhere on the board
PORT4_DN: U1.8 (USBDN4_DM/PRT_DIS_M4); also elsewhere on the board
PORT4_DP: U1.9 (USBDN4_DP/PRT_DIS_P4); also elsewhere on the board
PORT4_EN: U6.7 (P4); also elsewhere on the board
PORT4_FLT_N: U6.8 (P5); also elsewhere on the board
PORT4_RST_IO: U6.10 (P7); also elsewhere on the board
SCL: Q2.2 (S), R7.2, TP25.1, U2.12 (SCL), U6.12 (SCL); also elsewhere on the board
SDA: Q1.2 (S), R6.2, TP24.1, U2.13 (SDA), U6.13 (SDA); also elsewhere on the board
VIN: J1.8; also elsewhere on the board

Notes on the sheet:
Lead from the bay node's J7 (JST PH 8, vertical, on the rear face): SDA and SCL through a H5VU25UC; pin 8 VIN (sheet Power), pin 1 open
3.3 V for the hub, the expanders and the INA226s (AP2114H, SOT-223 on copper)
USB2517I hub, CFG_SEL 110 (internal default configuration, straps disabled), 24 MHz crystal
Two TCA6408A expanders, one per pair of ports: EN, FAULT_N, RESET, BOOT
I²C isolation: open with VIN off, so the node's pull-ups cannot feed this board
Bring-up test points on the rear face (B.Cu, bare pads, not in the BOM): +3V3, +5V, the hub's reset and 1.8 V, the lead's I²C, the expanders' RESET, GND
Hub reset: U5 (MAX809S, 2.93 V, ≥ 150 ms, push-pull) on RESET_N (errata DS80000628A, Module 2). Hub: CFG_SEL[2:0] = 110 (internal default configuration, strap options disabled: DS00001598C Table 5-2): self-powered, ports switched and sensed one by one (here by the expanders), no port disabled, D+ /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

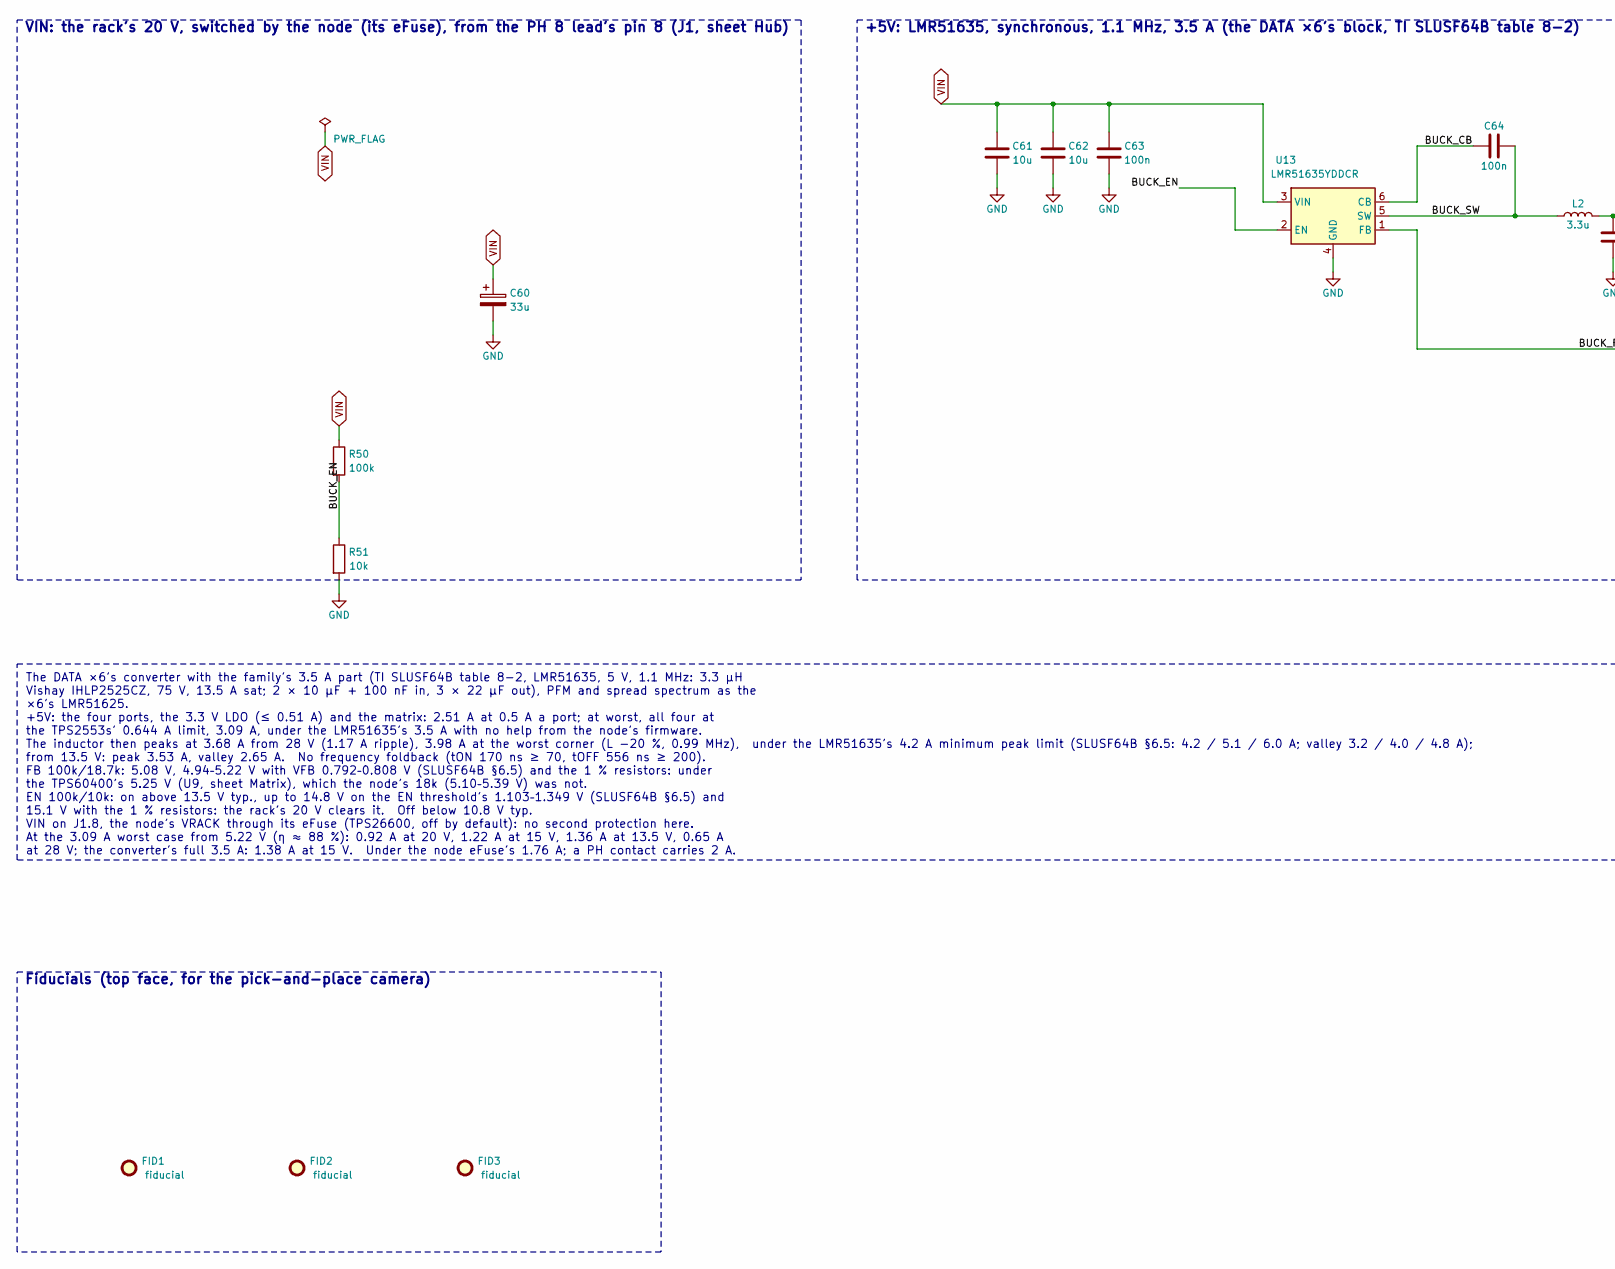
[picture p197: schematic power.kicad_sch, DATA ×4 v2 — 20 V input, the 5 V converter, part in row 1, column 1]

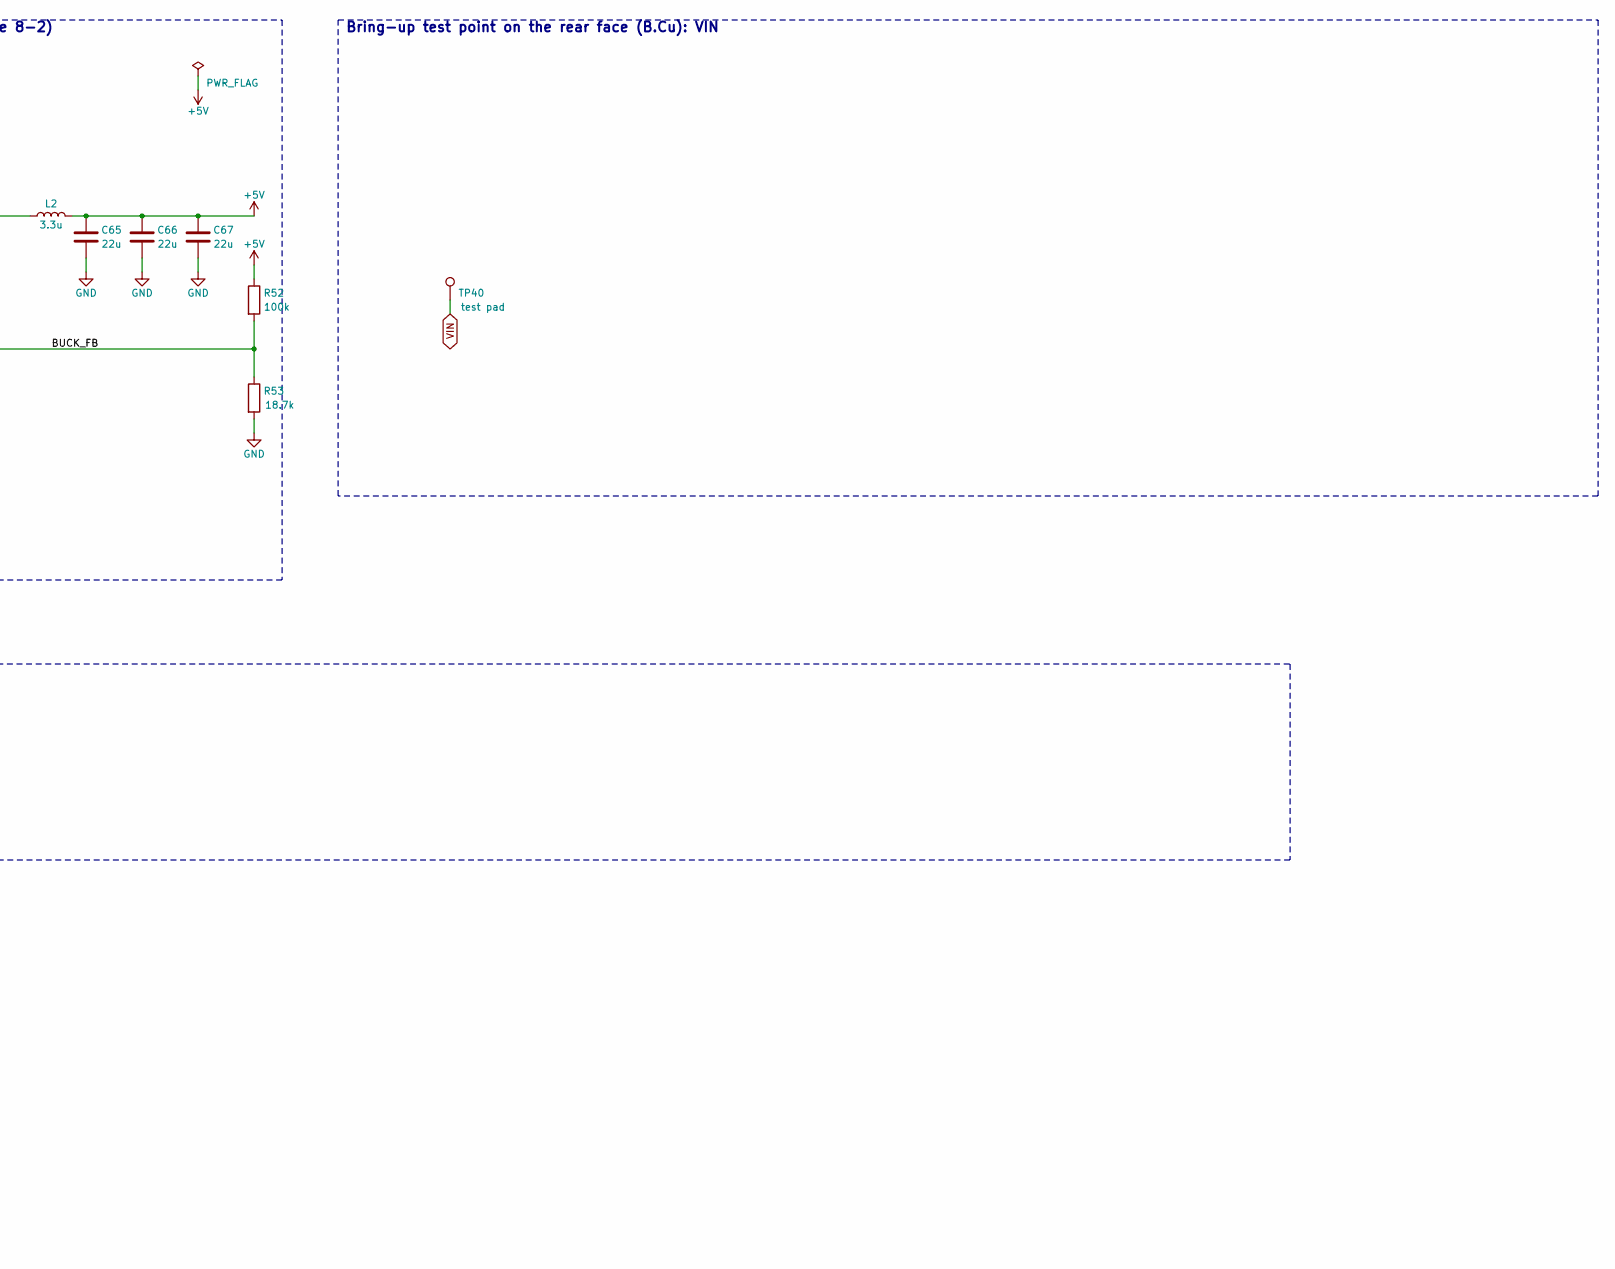
[picture p198: schematic power.kicad_sch, DATA ×4 v2 — 20 V input, the 5 V converter, part in row 1, column 2]

Parts:
C60: 33u; CP_Elec_6.3x7.7; MPN VH1H330ME077000CE0; LCSC C240518
C61, C62: 10u; C_1206_3216Metric; MPN CL31A106KBHNNNE; LCSC C13585
C63, C64: 100n; C_0603_1608Metric; MPN CC0603KRX7R9BB104; LCSC C14663
C65, C66, C67: 22u; C_1206_3216Metric; MPN CL31A226KAHNNNE; LCSC C12891
FID1, FID2, FID3: fiducial; Fiducial_1mm_Mask2mm; MPN fiducial
L2: 3.3u; L_Changjiang_FXL0630; MPN IHLP2525CZER3R3M01; LCSC C506574
R50: 100k; R_0402_1005Metric; MPN 0402WGF1003TCE; LCSC C25741
R51: 10k; R_0402_1005Metric; MPN 0402WGF1002TCE; LCSC C25744
R52: 100k; R_0603_1608Metric; MPN 0603WAF1003T5E; LCSC C25803
R53: 18.7k; R_0603_1608Metric; MPN 0603WAF1872T5E; LCSC C22893
TP40: test pad; TestPoint_Pad_D1.5mm; MPN test pad
U13: LMR51635YDDCR; TSOT-23-6; MPN LMR51635YDDCR; LCSC C45262770

Connections:
+5V: C65.1, C66.1, C67.1, L2.2, R52.1; also elsewhere on the board
/Power/BUCK_CB: C64.1, U13.6 (CB)
/Power/BUCK_EN: R50.2, R51.1, U13.2 (EN)
/Power/BUCK_FB: R52.2, R53.1, U13.1 (FB)
/Power/BUCK_SW: C64.2, L2.1, U13.5 (SW)
GND: C60.2, C61.2, C62.2, C63.2, C65.2, C66.2, C67.2, R51.2, R53.2, U13.4 (GND); also elsewhere on the board
VIN: C60.1, C61.1, C62.1, C63.1, R50.1, TP40.1, U13.3 (VIN); also elsewhere on the board

Notes on the sheet:
VIN: the rack's 20 V, switched by the node (its eFuse), from the PH 8 lead's pin 8 (J1, sheet Hub)
+5V: LMR51635, synchronous, 1.1 MHz, 3.5 A (the DATA ×6's block, TI SLUSF64B table 8-2)
Bring-up test point on the rear face (B.Cu): VIN
Fiducials (top face, for the pick-and-place camera)
The DATA ×6's converter with the family's 3.5 A part (TI SLUSF64B table 8-2, LMR51635, 5 V, 1.1 MHz: 3.3 µH Vishay IHLP2525CZ, 75 V, 13.5 A sat; 2 × 10 µF + 100 nF in, 3 × 22 µF out), PFM and spread spectrum as the ×6's LMR51625. +5V: the four ports, the 3.3 V LDO (≤ 0.51 A) and the matrix: 2.51 A 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
