kartben/hw-testing-rack/electronics/data-port-x4/data-port-x4.kicad_pcb

## KiCad design electronics/data-port-x4/data-port-x4.kicad_pcb (continued)

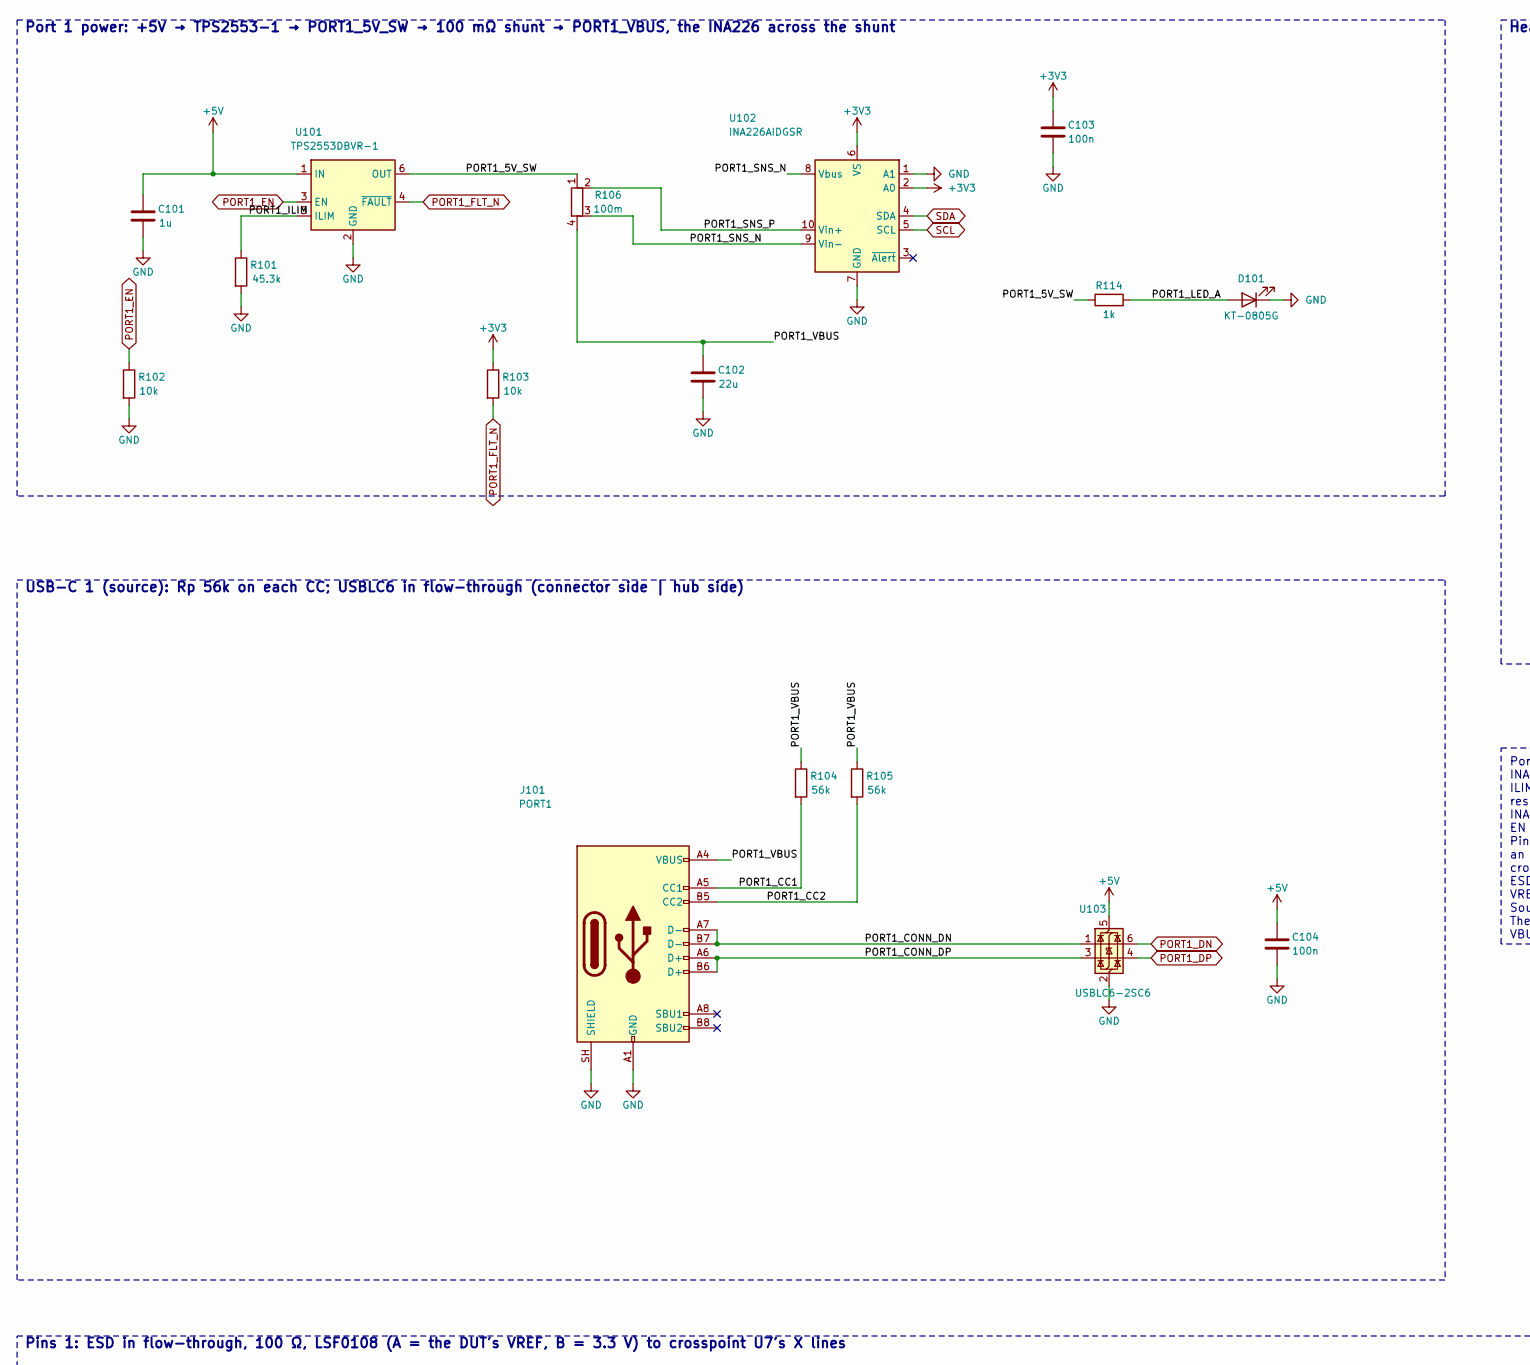
[picture p199: schematic port1.kicad_sch, DATA ×4 v2 — USB-C 1: switch, current sense, ESD, header; p…, part in row 1, column 1]

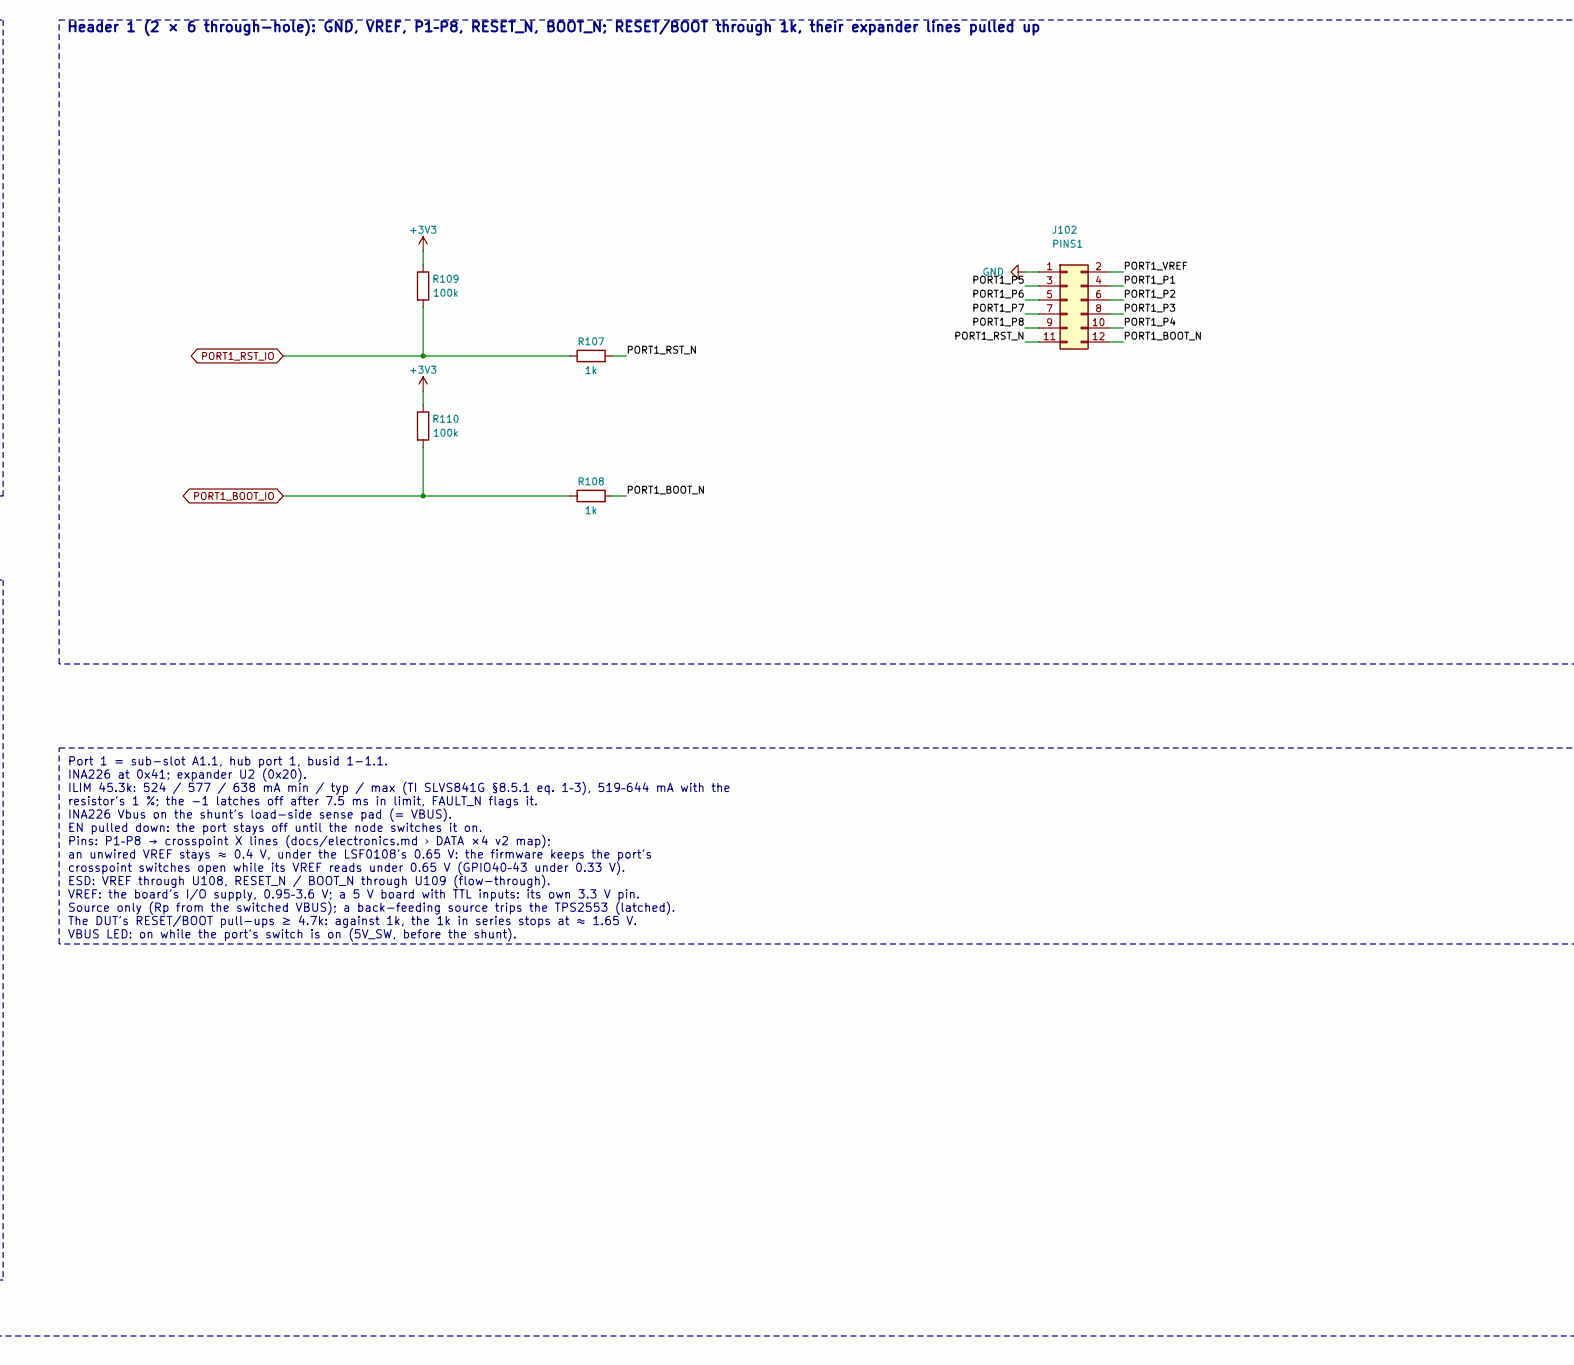
[picture p200: schematic port1.kicad_sch, DATA ×4 v2 — USB-C 1: switch, current sense, ESD, header; p…, part in row 1, column 2]

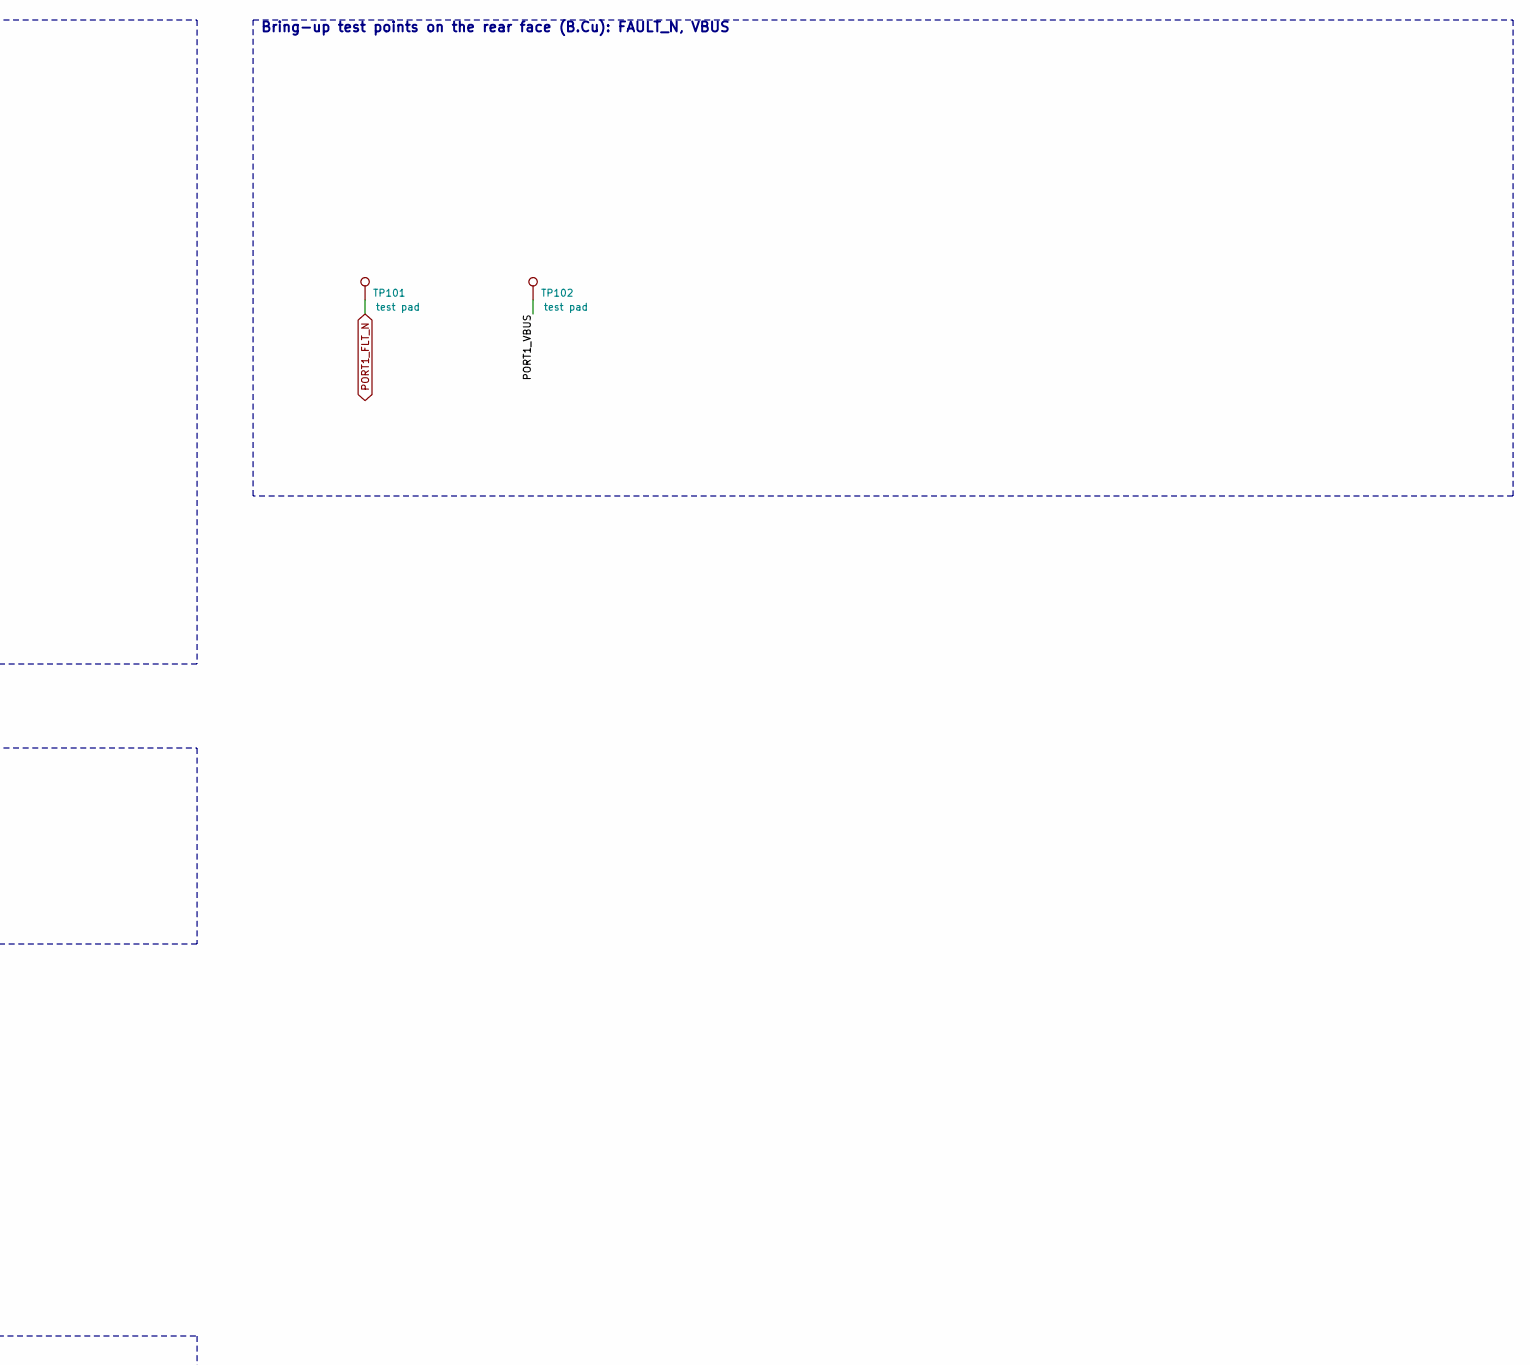
[picture p201: schematic port1.kicad_sch, DATA ×4 v2 — USB-C 1: switch, current sense, ESD, header; p…, part in row 1, column 3]

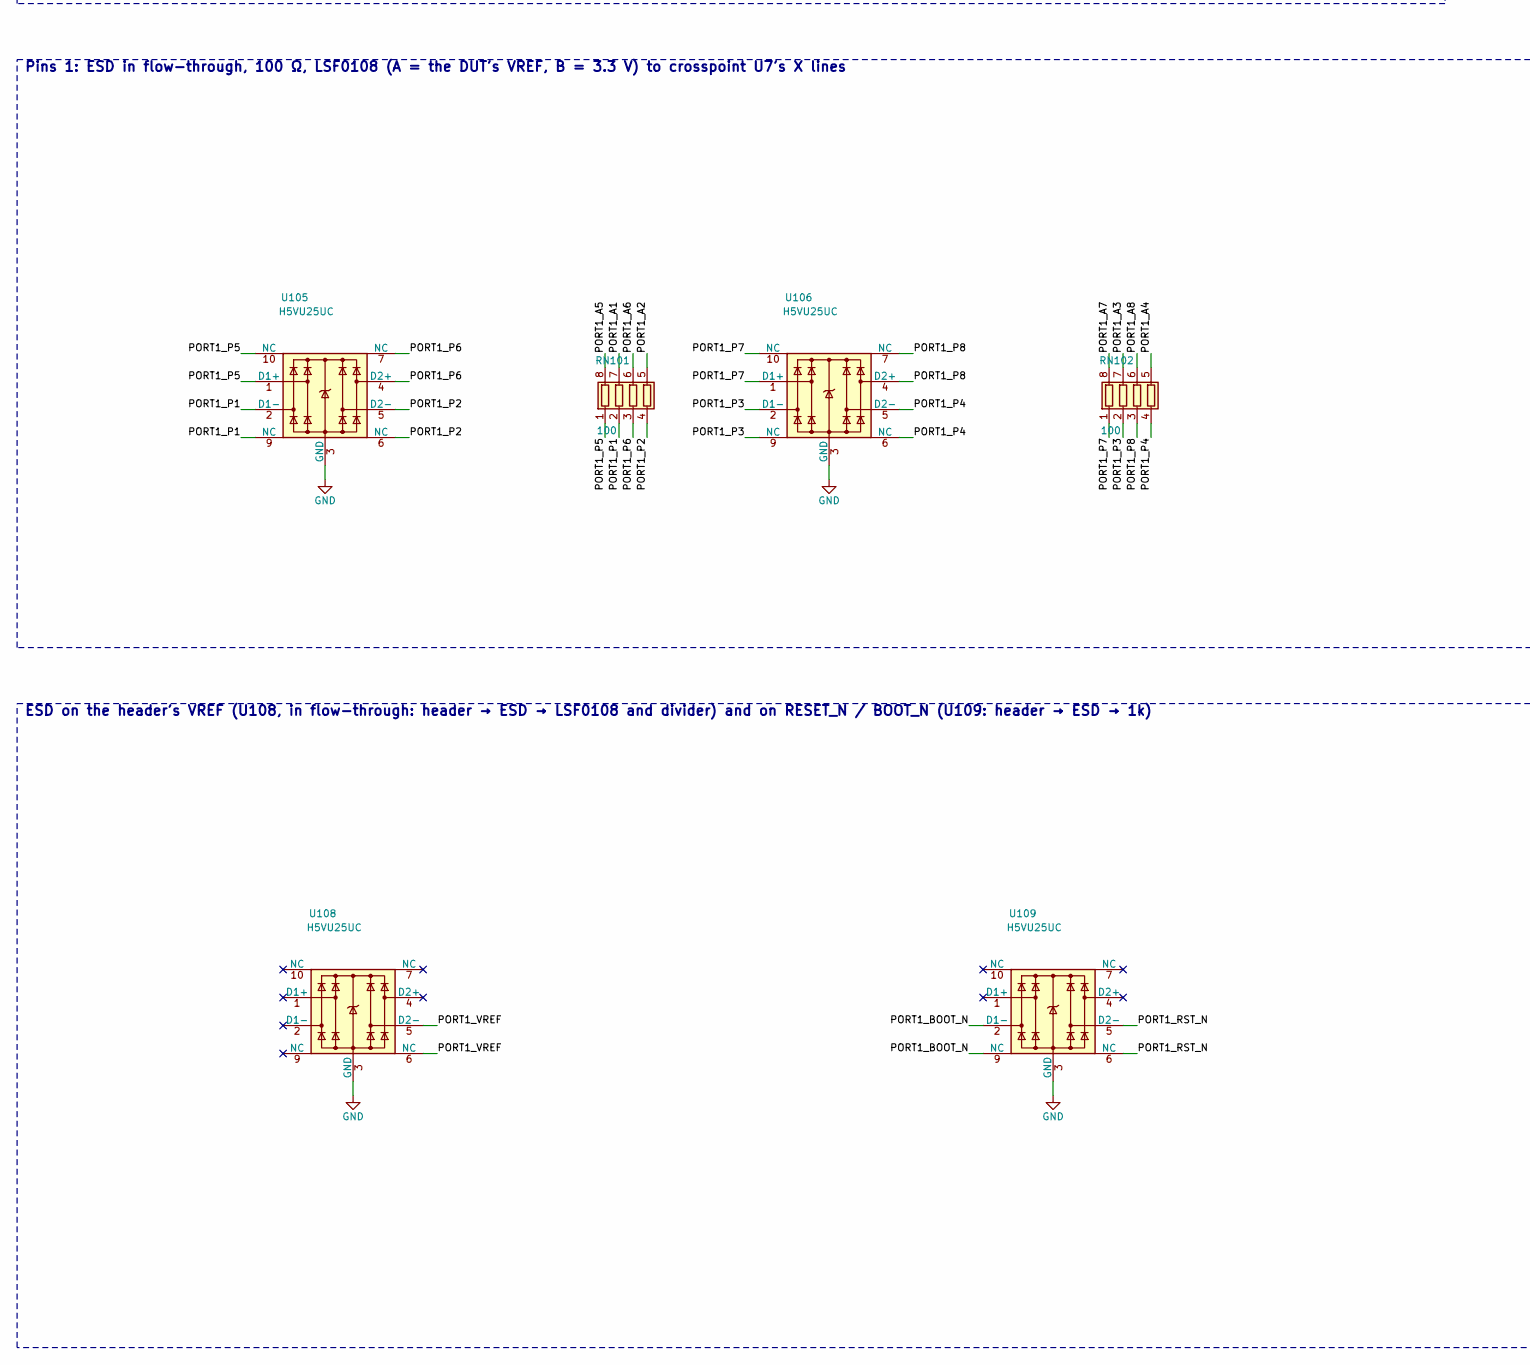
[picture p202: schematic port1.kicad_sch, DATA ×4 v2 — USB-C 1: switch, current sense, ESD, header; p…, part in row 2, column 1]

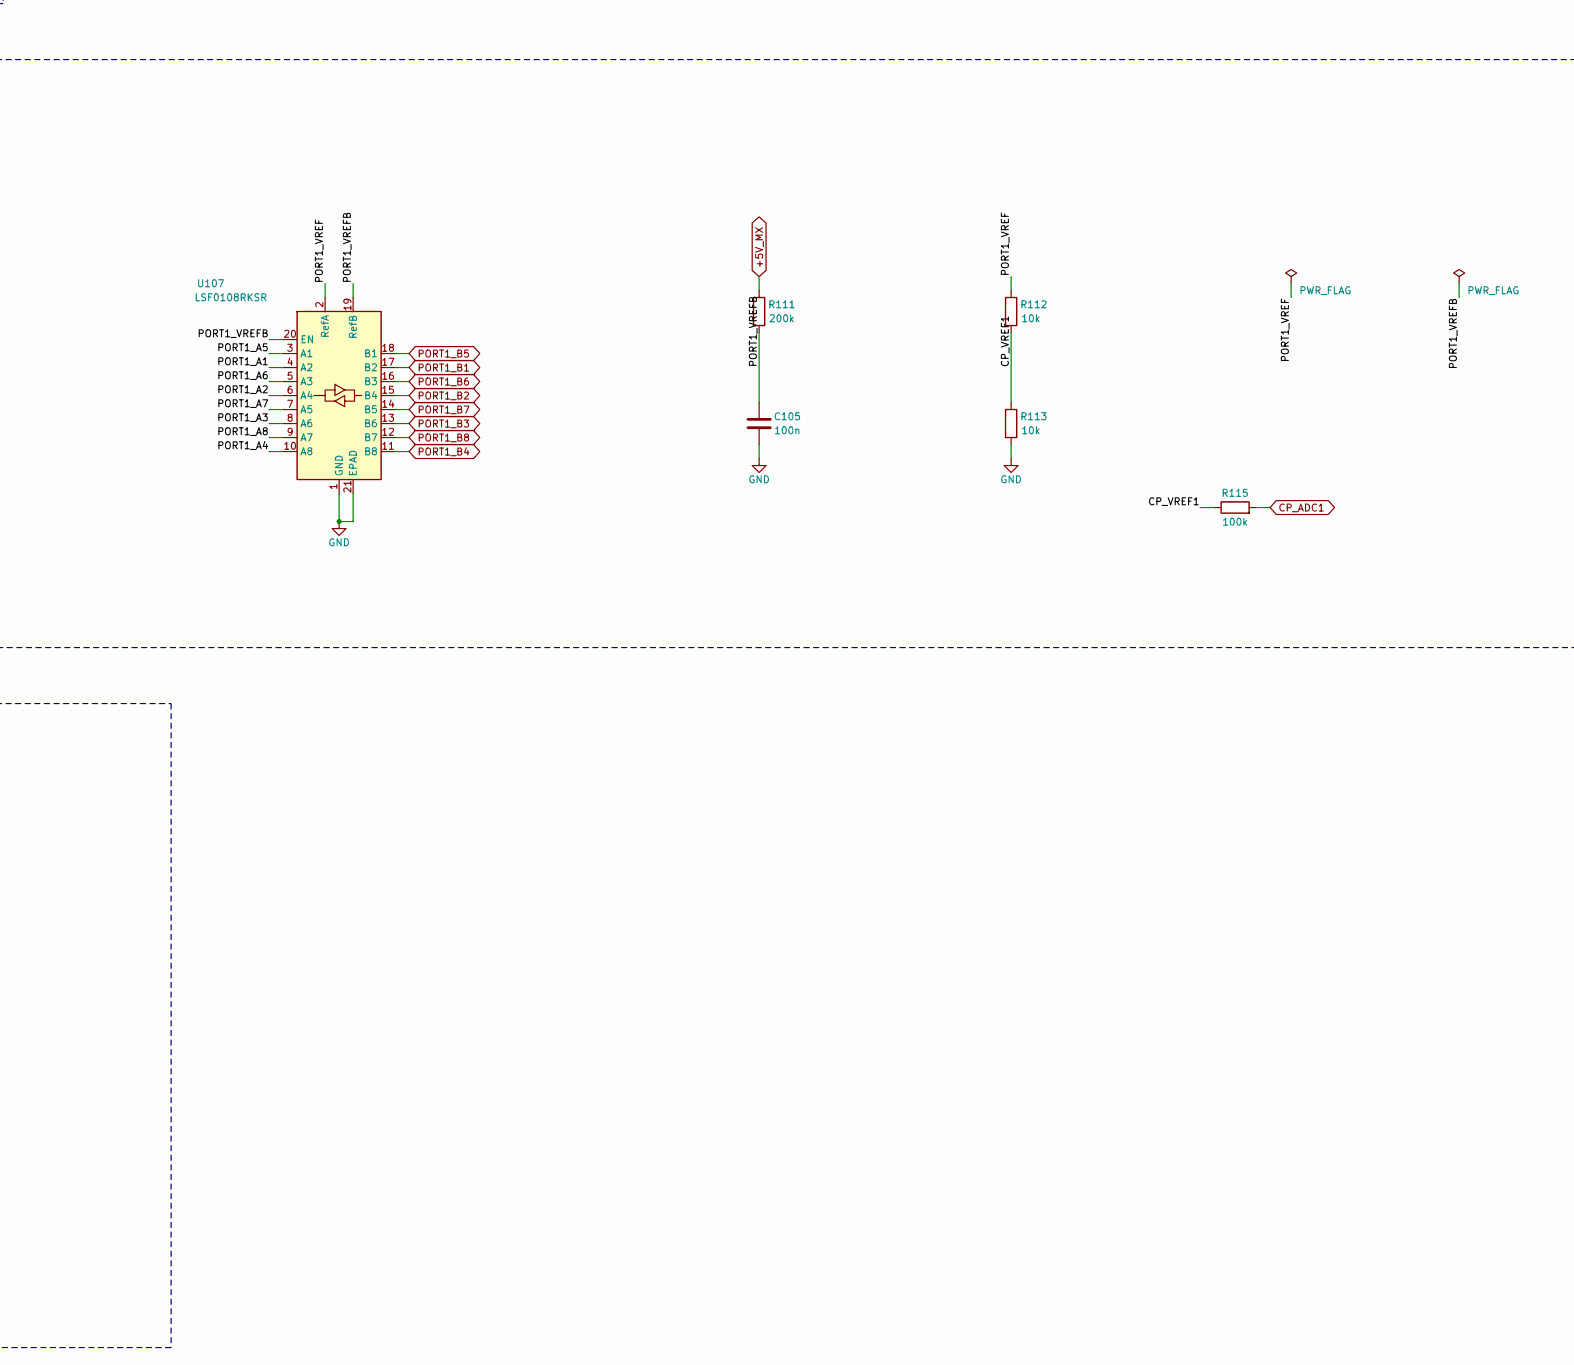
[picture p203: schematic port1.kicad_sch, DATA ×4 v2 — USB-C 1: switch, current sense, ESD, header; p…, part in row 2, column 2]

Parts:
C101: 1u; C_0402_1005Metric; MPN CL05A105KA5NQNC; LCSC C52923
C102: 22u; C_0805_2012Metric; MPN CL21A226MAQNNNE; LCSC C45783
C103, C104, C105: 100n; C_0402_1005Metric; MPN CL05B104KO5NNNC; LCSC C1525
D101: KT-0805G; LED_0805_2012Metric; MPN KT-0805G; LCSC C2297
J101: PORT1; USB_C_Receptacle_GCT_USB4145-03-0170-C_Vertical; MPN USB4145-03-0170-C; LCSC C5181332
J102: PINS1; PinHeader_2x06_P2.54mm_Vertical; MPN HX PZ2.54-2x6P ZZ; LCSC C32713279
R101: 45.3k; R_0402_1005Metric; MPN FRC0402F4532TS; LCSC C2933099
R102, R103, R112, R113: 10k; R_0402_1005Metric; MPN 0402WGF1002TCE; LCSC C25744
R104, R105: 56k; R_0402_1005Metric; MPN 0402WGF5602TCE; LCSC C25796
R106: 100m; R_1206_3216Metric_Kelvin; MPN 1206W4F100LT5E; LCSC C25334
R107, R108, R114: 1k; R_0402_1005Metric; MPN 0402WGF1001TCE; LCSC C11702
R109, R110, R115: 100k; R_0402_1005Metric; MPN 0402WGF1003TCE; LCSC C25741
R111: 200k; R_0402_1005Metric; MPN 0402WGF2003TCE; LCSC C25764
RN101, RN102: 100; R_Array_Convex_4x0402; MPN 4D02WGJ0101TCE; LCSC C48442
TP101: test pad; TestPoint_Pad_D1.0mm; MPN test pad
TP102: test pad; TestPoint_Pad_D1.5mm; MPN test pad
U101: TPS2553DBVR-1; SOT-23-6; MPN TPS2553DBVR-1; LCSC C111738
U102: INA226AIDGSR; TSSOP-10_3x3mm_P0.5mm; MPN INA226AIDGSR; LCSC C49851
U103: USBLC6-2SC6; SOT-23-6; MPN USBLC6-2SC6; LCSC C7519
U105, U106, U108, U109: H5VU25UC; DFN2510-10L_2.5x1.0mm_P0.5mm; MPN H5VU25UC; LCSC C20615800
U107: LSF0108RKSR; DHVQFN-20-1EP_2.5x4.5mm_P0.5mm_EP1x3mm; MPN LSF0108RKSR; LCSC C130008

Connections:
+3V3: C103.1, R103.1, R109.1, R110.1, U102.2 (A0), U102.6 (VS); also elsewhere on the board
+5V: C101.1, C104.1, U101.1 (IN), U103.5 (VBUS); also elsewhere on the board
+5V_MX: R111.1; also elsewhere on the board
/Port 1/CP_VREF1: R112.2, R113.1, R115.1
/Port 1/PORT1_5V_SW: R106.1, R114.1, U101.6 (OUT)
/Port 1/PORT1_A1: RN101.7 (R2.2), U107.4 (A2)
/Port 1/PORT1_A2: RN101.5 (R4.2), U107.6 (A4)
/Port 1/PORT1_A3: RN102.7 (R2.2), U107.8 (A6)
/Port 1/PORT1_A4: RN102.5 (R4.2), U107.10 (A8)
/Port 1/PORT1_A5: RN101.8 (R1.2), U107.3 (A1)
/Port 1/PORT1_A6: RN101.6 (R3.2), U107.5 (A3)
/Port 1/PORT1_A7: RN102.8 (R1.2), U107.7 (A5)
/Port 1/PORT1_A8: RN102.6 (R3.2), U107.9 (A7)
/Port 1/PORT1_BOOT_N: J102.12, R108.2, U109.2 (D1-), U109.9 (NC)
/Port 1/PORT1_CC1: J101.A5 (CC1), R104.2
/Port 1/PORT1_CC2: J101.B5 (CC2), R105.2
/Port 1/PORT1_CONN_DN: J101.A7 (D-), J101.B7 (D-), U103.1 (I/O1)
/Port 1/PORT1_CONN_DP: J101.A6 (D+), J101.B6 (D+), U103.3 (I/O2)
/Port 1/PORT1_ILIM: R101.1, U101.5 (ILIM)
/Port 1/PORT1_LED_A: D101.2 (A), R114.2
/Port 1/PORT1_P1: J102.4, RN101.2 (R2.1), U105.2 (D1-), U105.9 (NC)
/Port 1/PORT1_P2: J102.6, RN101.4 (R4.1), U105.5 (D2-), U105.6 (NC)
/Port 1/PORT1_P3: J102.8, RN102.2 (R2.1), U106.2 (D1-), U106.9 (NC)
/Port 1/PORT1_P4: J102.10, RN102.4 (R4.1), U106.5 (D2-), U106.6 (NC)
/Port 1/PORT1_P5: J102.3, RN101.1 (R1.1), U105.1 (D1+), U105.10 (NC)
/Port 1/PORT1_P6: J102.5, RN101.3 (R3.1), U105.4 (D2+), U105.7 (NC)
/Port 1/PORT1_P7: J102.7, RN102.1 (R1.1), U106.1 (D1+), U106.10 (NC)
/Port 1/PORT1_P8: J102.9, RN102.3 (R3.1), U106.4 (D2+), U106.7 (NC)
/Port 1/PORT1_RST_N: J102.11, R107.2, U109.5 (D2-), U109.6 (NC)
/Port 1/PORT1_SNS_N: R106.3, U102.8 (Vbus), U102.9 (Vin-)
/Port 1/PORT1_SNS_P: R106.2, U102.10 (Vin+)
/Port 1/PORT1_VBUS: C102.1, J101.A4 (VBUS), J101.A9 (VBUS), J101.B4 (VBUS), J101.B9 (VBUS), R104.1, R105.1, R106.4, TP102.1
/Port 1/PORT1_VREF: J102.2, R112.1, U107.2 (RefA), U108.5 (D2-), U108.6 (NC)
/Port 1/PORT1_VREFB: C105.1, R111.2, U107.19 (RefB), U107.20 (EN)
CP_ADC1: R115.2; also elsewhere on the board
GND: C101.2, C102.2, C103.2, C104.2, C105.2, D101.1 (K), J101.A1 (GND), J101.A12 (GND), J101.B1 (GND), J101.B12 (GND), J101.SH (SHIELD), J102.1, R101.2, R102.2, R113.2, U101.2 (GND), U102.1 (A1), U102.7 (GND), U103.2 (GND), U105.3 (GND), U105.8 (GND), U106.3 (GND), U106.8 (GND), U107.1 (GND), U107.21 (EPAD), U108.3 (GND), U108.8 (GND), U109.3 (GND), U109.8 (GND); also elsewhere on the board
PORT1_B1: U107.17 (B2); also elsewhere on the board
PORT1_B2: U107.15 (B4); also elsewhere on the board
PORT1_B3: U107.13 (B6); also elsewhere on the board
PORT1_B4: U107.11 (B8); also elsewhere on the board
PORT1_B5: U107.18 (B1); also elsewhere on the board
PORT1_B6: U107.16 (B3); also elsewhere on the board
PORT1_B7: U107.14 (B5); also elsewhere on the board
PORT1_B8: U107.12 (B7); also elsewhere on the board
PORT1_BOOT_IO: R108.1, R110.2; also elsewhere on the board
PORT1_DN: U103.6 (I/O1); also elsewhere on the board
PORT1_DP: U103.4 (I/O2); also elsewhere on the board
PORT1_EN: R102.1, U101.3 (EN); also elsewhere on the board
PORT1_FLT_N: R103.2, TP101.1, U101.4 (~FAULT); also elsewhere on the board
PORT1_RST_IO: R107.1, R109.2; also elsewhere on the board
SCL: U102.5 (SCL); also elsewhere on the board
SDA: U102.4 (SDA); also elsewhere on the board

Notes on the sheet:
Port 1 power: +5V → TPS2553-1 → PORT1_5V_SW → 100 mΩ shunt → PORT1_VBUS, the INA226 across the shunt
Bring-up test points on the rear face (B.Cu): FAULT_N, VBUS
USB-C 1 (source): Rp 56k on each CC; USBLC6 in flow-through (connector side | hub side)
Header 1 (2 × 6 through-hole): GND, VREF, P1–P8, RESET_N, BOOT_N; RESET/BOOT through 1k, their expander lines pulled up
ESD on the header's VREF (U108, in flow-through: header → ESD → LSF0108 and divider) and on RESET_N / BOOT_N (U109: header → ESD → 1k)
Pins 1: ESD in flow-through, 100 Ω, LSF0108 (A = the DUT's VREF, B = 3.3 V) to crosspoint U7's X lines
Port 1 = sub-slot A1.1, hub port 1, busid 1-1.1. INA226 at 0x41; expander U2 (0x20). ILIM 45.3k: 524 / 577 / 638 mA min / typ / max (TI SLVS841G §8.5.1 eq. 1–3), 519–644 mA with the resistor's 1 %; the -1 latches off after 7.5 ms in limit, FAULT_N flags it. INA226 Vbus on the shunt's load-side sens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
