kartben/hw-testing-rack/electronics/data-port-x4/data-port-x4.kicad_pcb

## KiCad design electronics/data-port-x4/data-port-x4.kicad_pcb (continued)

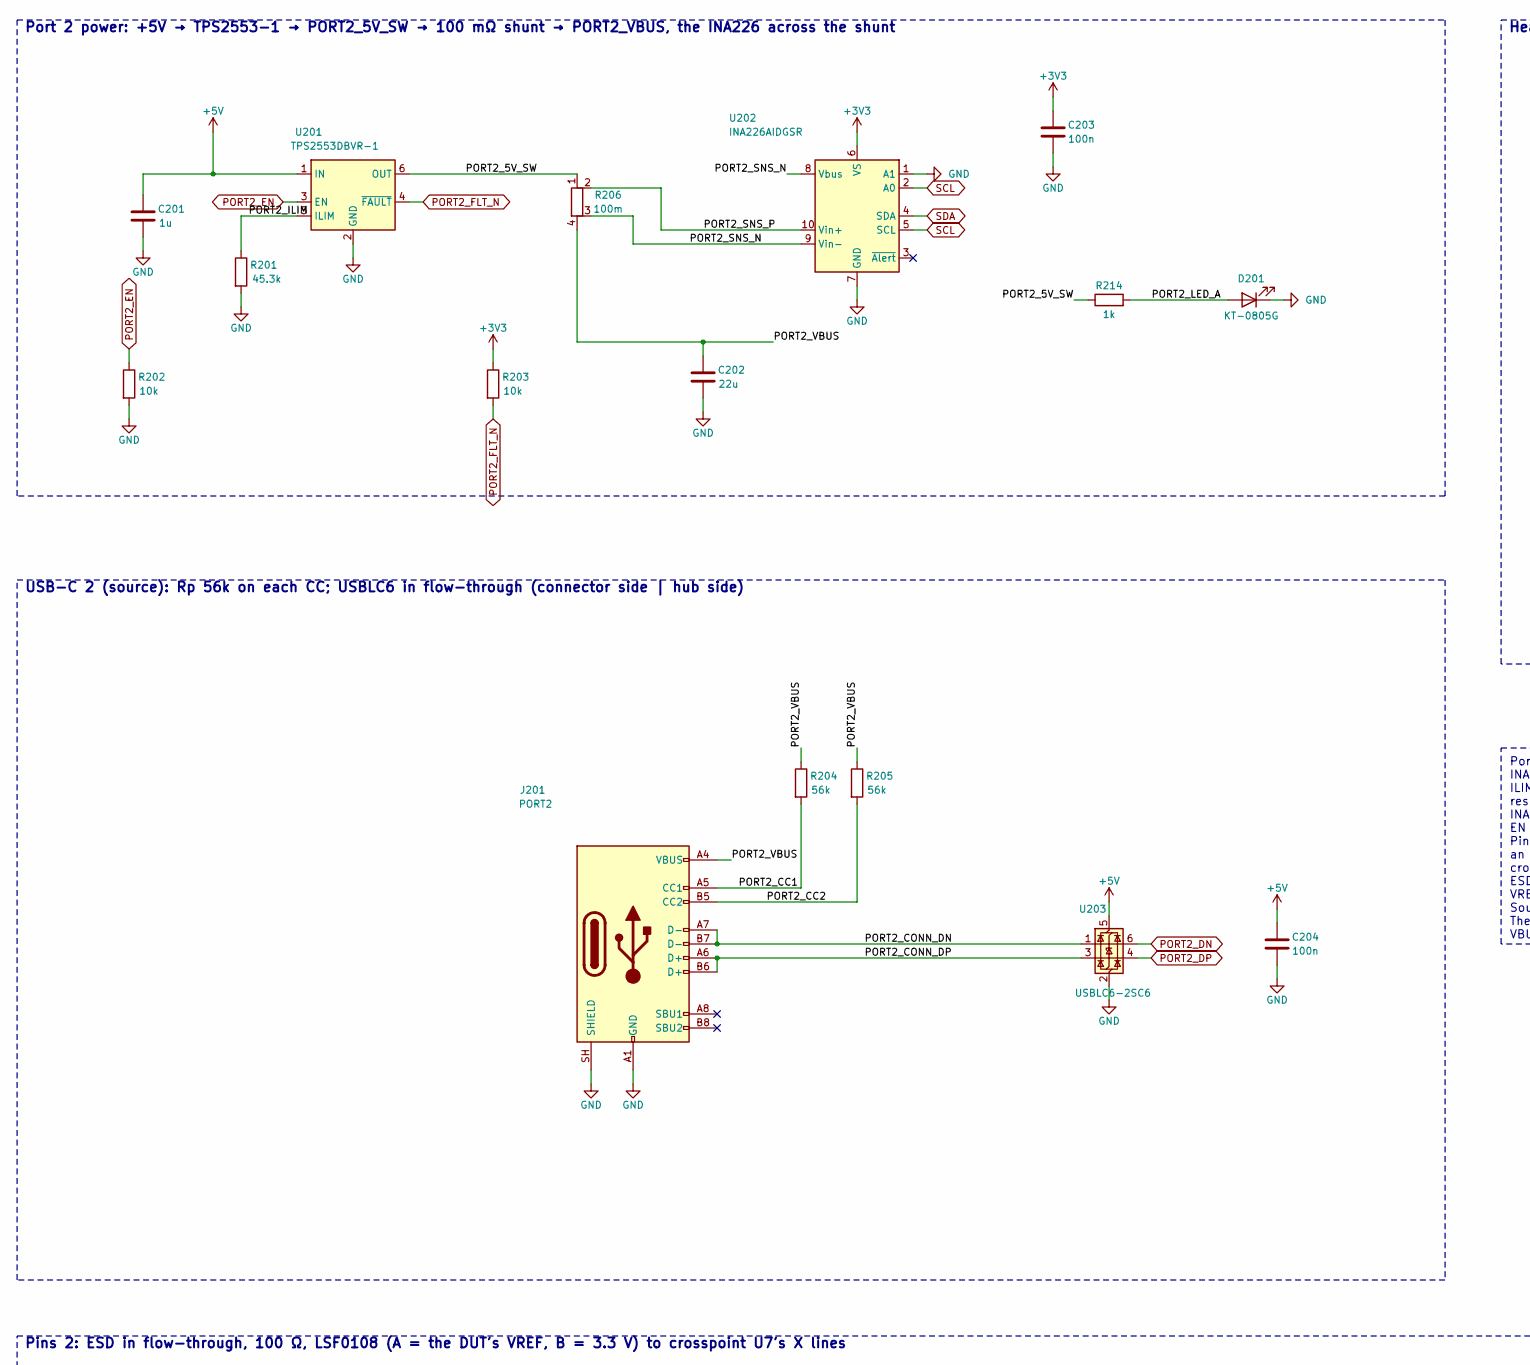
[picture p204: schematic port2.kicad_sch, DATA ×4 v2 — USB-C 2: switch, current sense, ESD, header; p…, part in row 1, column 1]

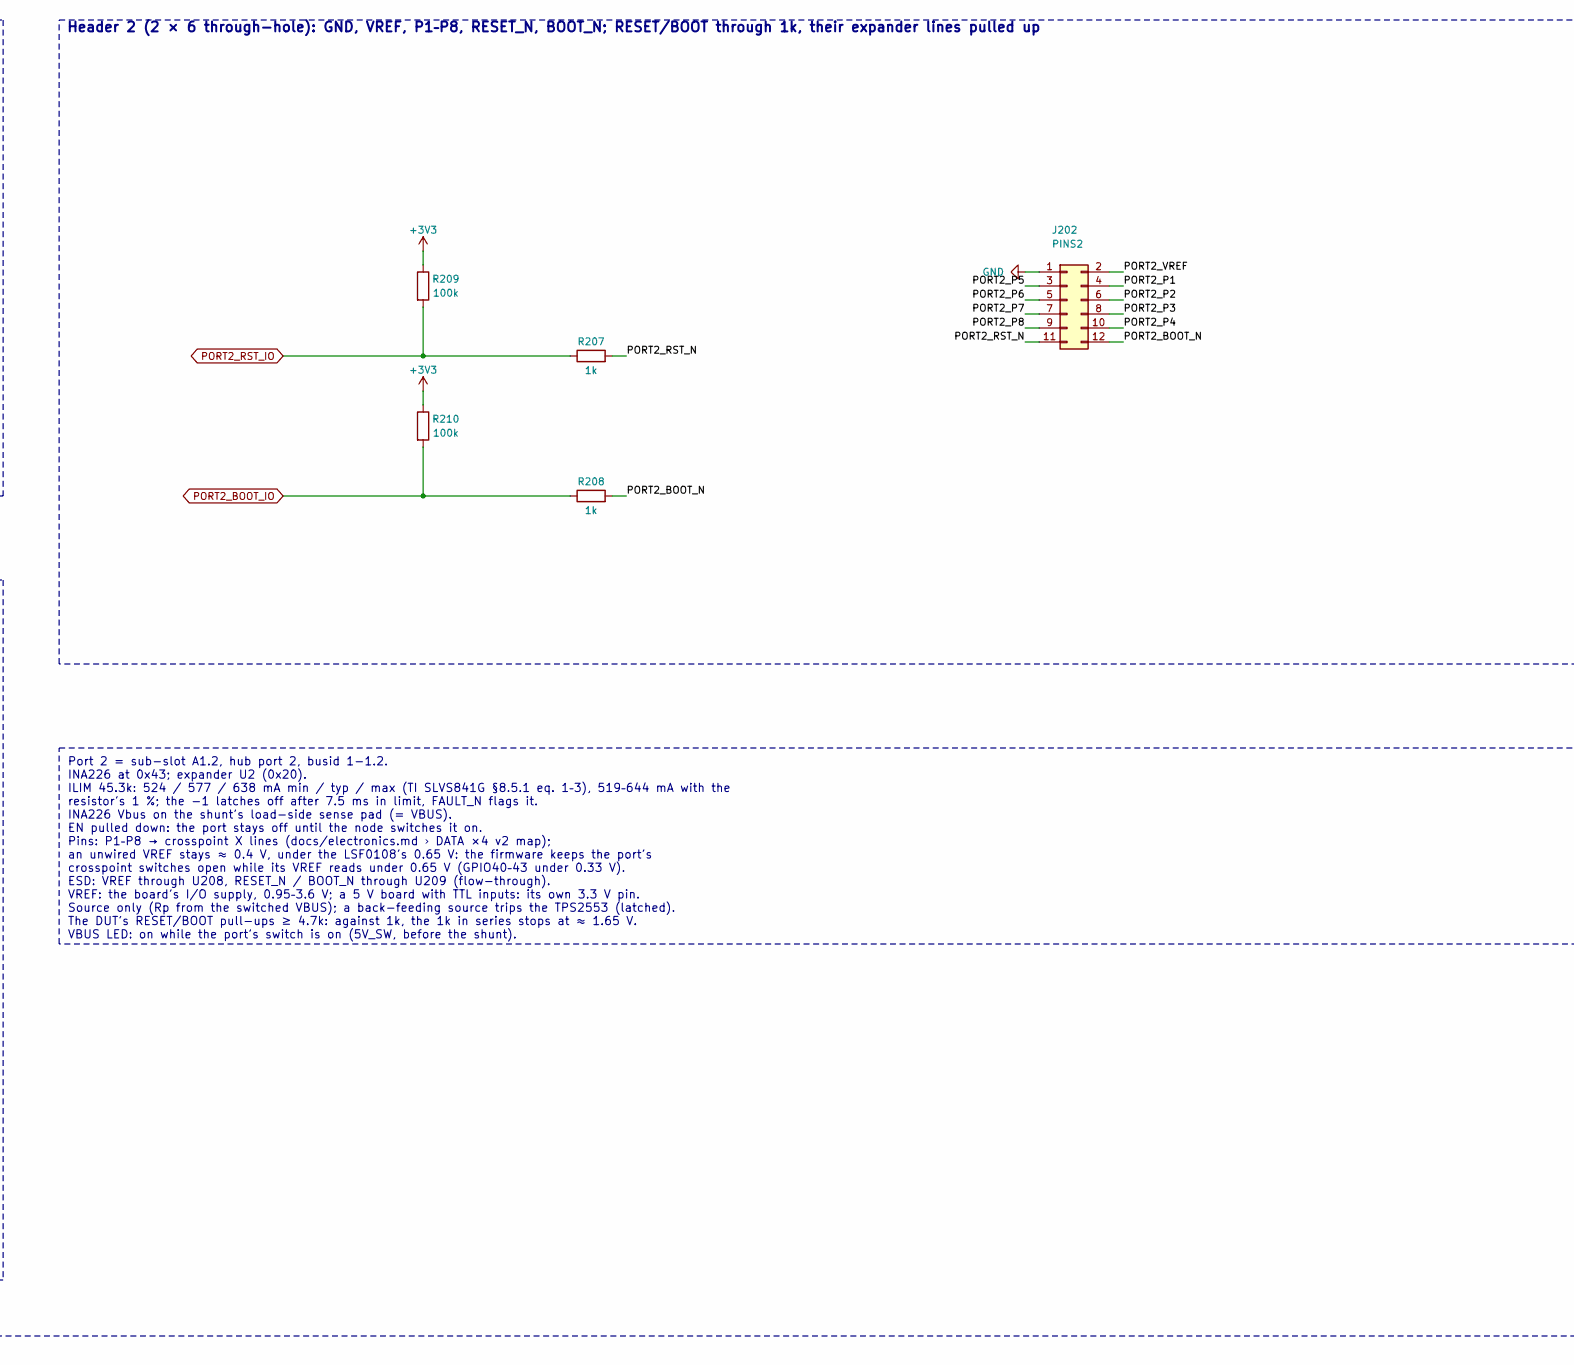
[picture p205: schematic port2.kicad_sch, DATA ×4 v2 — USB-C 2: switch, current sense, ESD, header; p…, part in row 1, column 2]

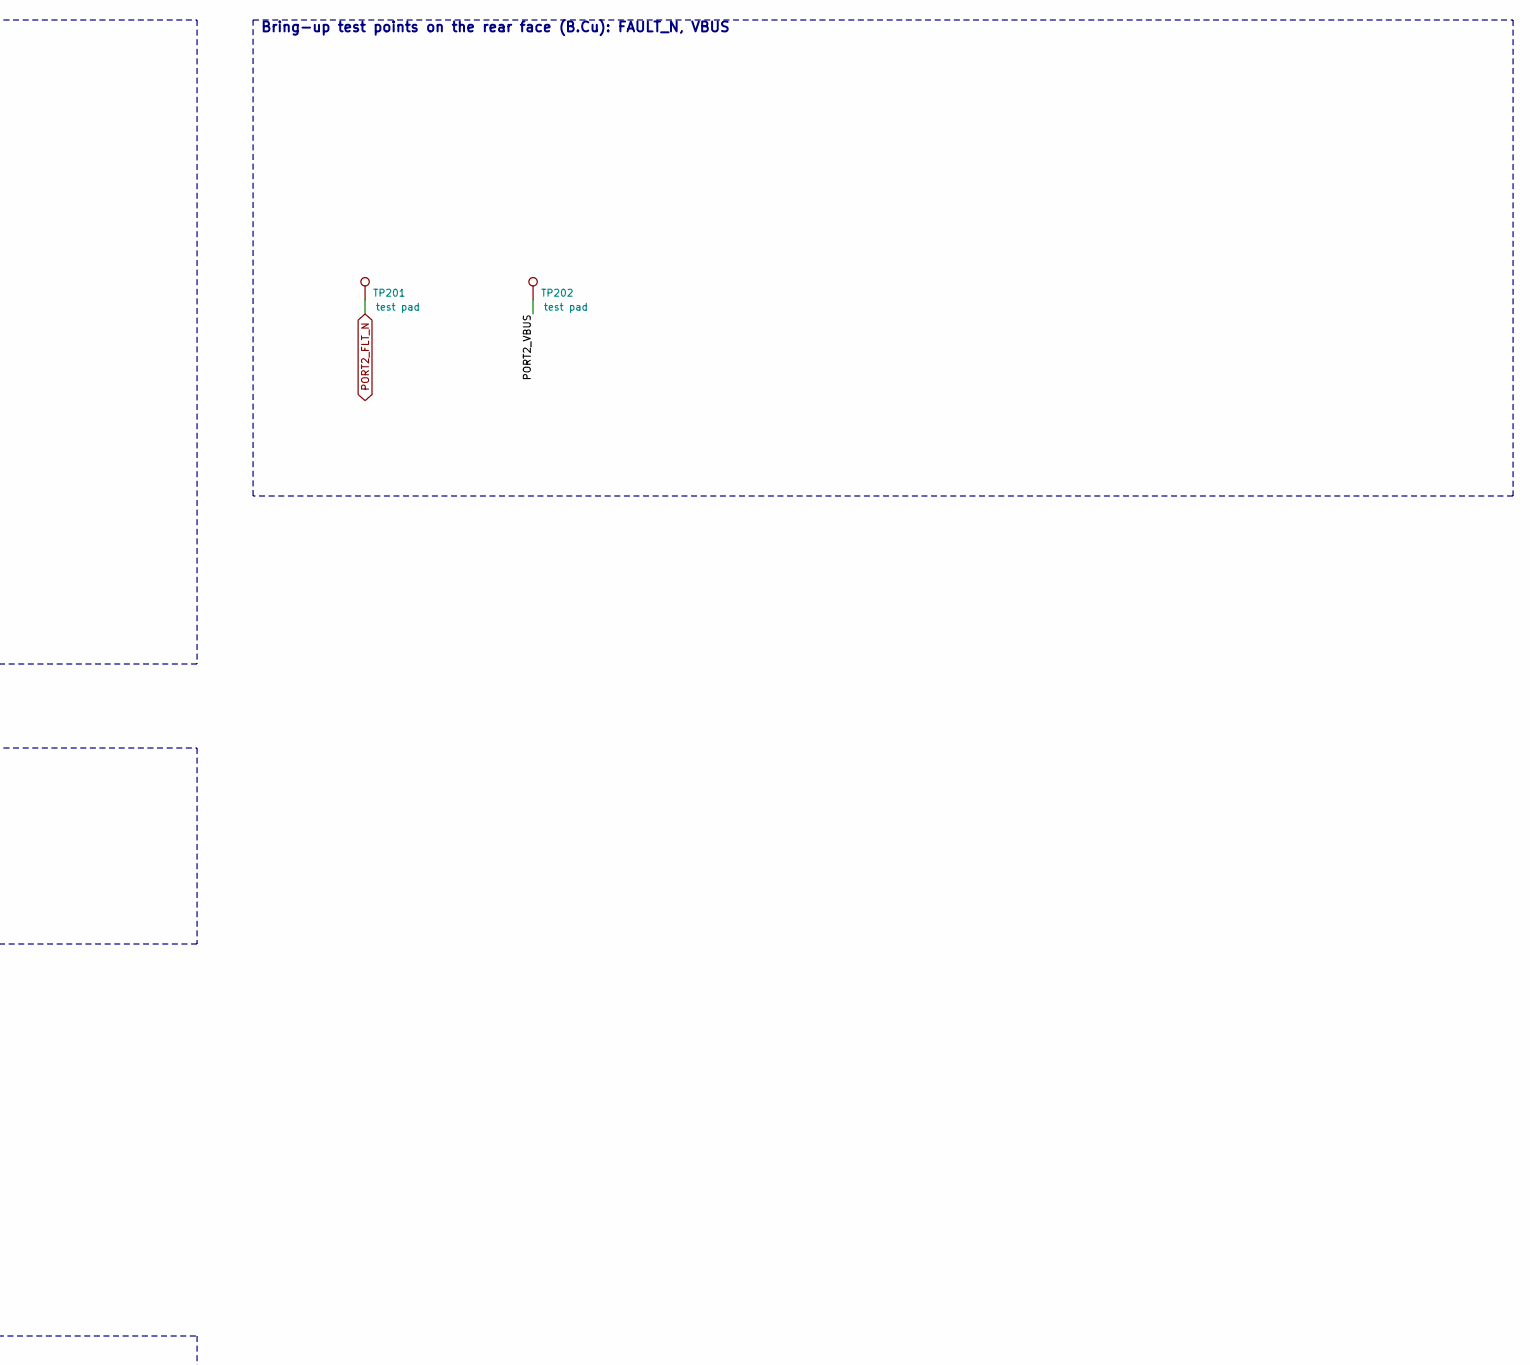
[picture p206: schematic port2.kicad_sch, DATA ×4 v2 — USB-C 2: switch, current sense, ESD, header; p…, part in row 1, column 3]

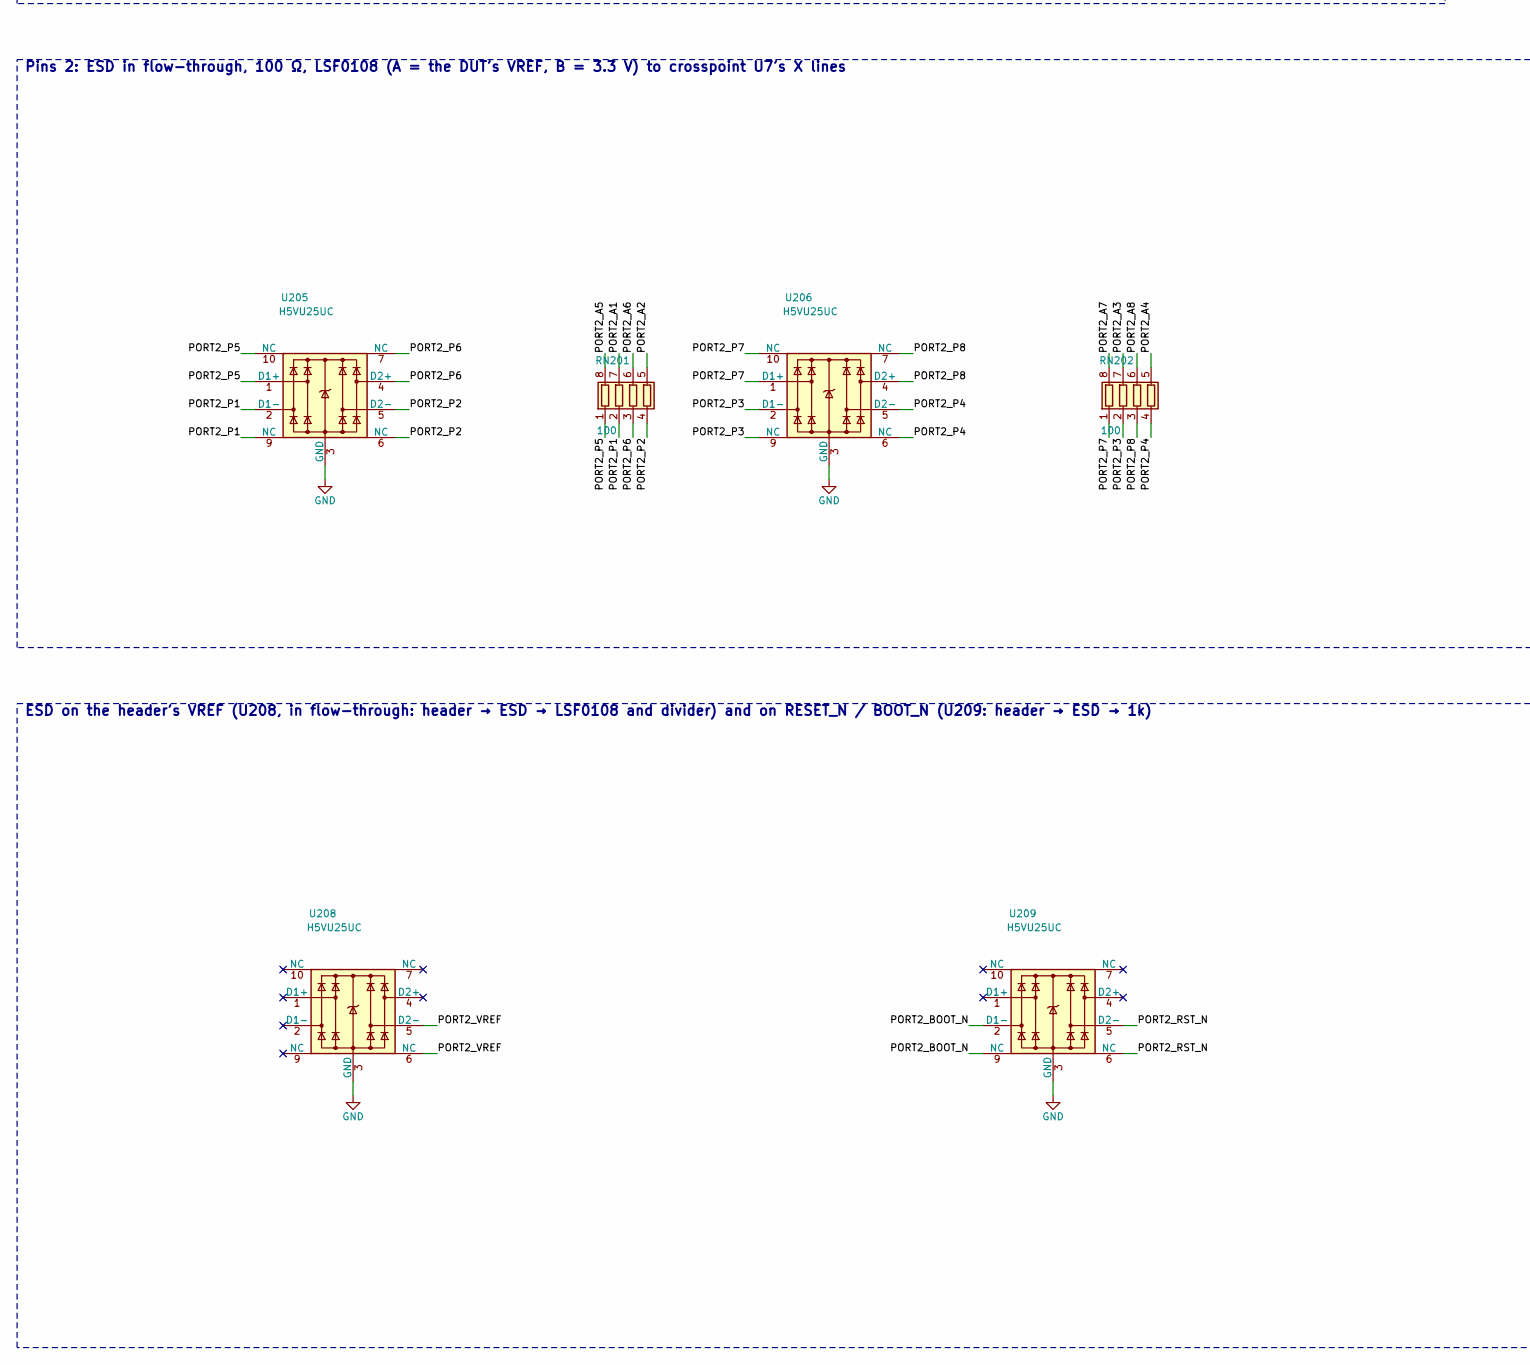
[picture p207: schematic port2.kicad_sch, DATA ×4 v2 — USB-C 2: switch, current sense, ESD, header; p…, part in row 2, column 1]

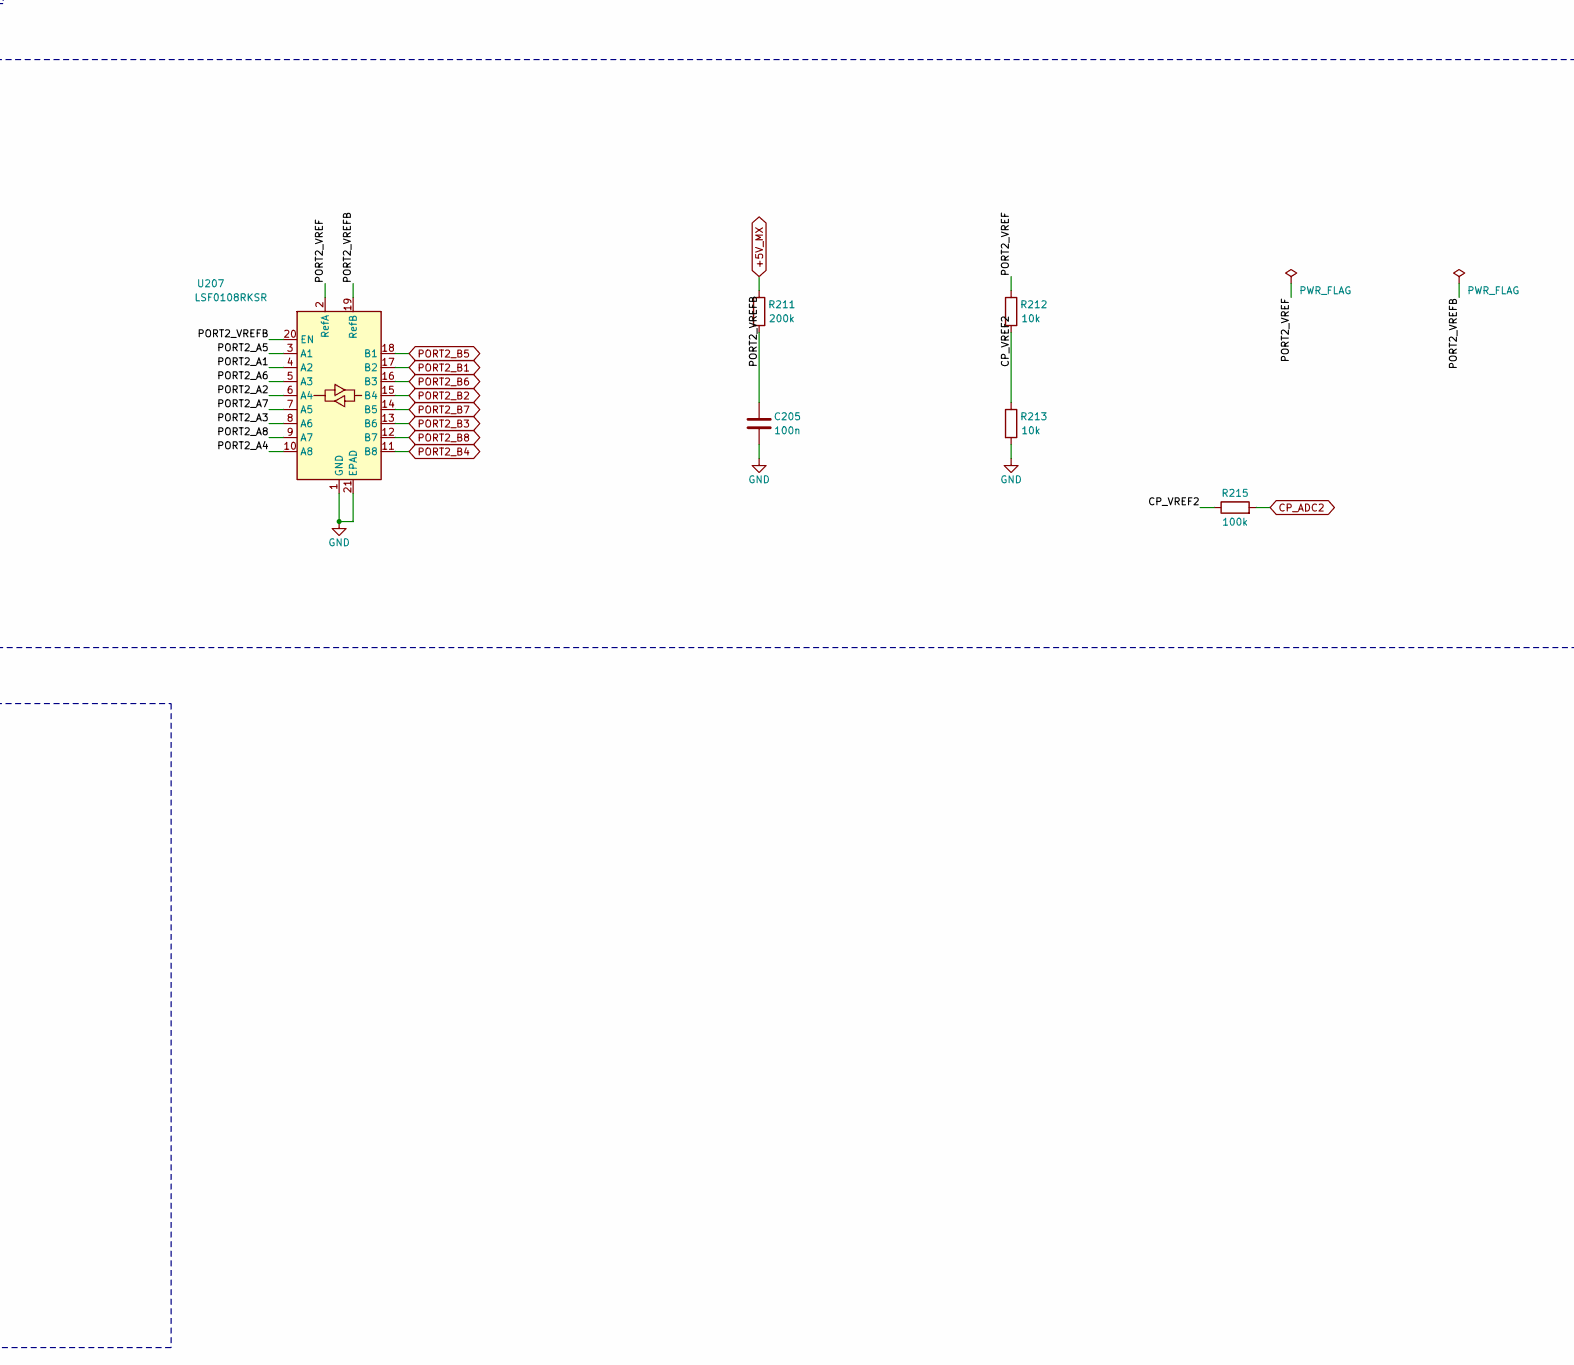
[picture p208: schematic port2.kicad_sch, DATA ×4 v2 — USB-C 2: switch, current sense, ESD, header; p…, part in row 2, column 2]

Parts:
C201: 1u; C_0402_1005Metric; MPN CL05A105KA5NQNC; LCSC C52923
C202: 22u; C_0805_2012Metric; MPN CL21A226MAQNNNE; LCSC C45783
C203, C204, C205: 100n; C_0402_1005Metric; MPN CL05B104KO5NNNC; LCSC C1525
D201: KT-0805G; LED_0805_2012Metric; MPN KT-0805G; LCSC C2297
J201: PORT2; USB_C_Receptacle_GCT_USB4145-03-0170-C_Vertical; MPN USB4145-03-0170-C; LCSC C5181332
J202: PINS2; PinHeader_2x06_P2.54mm_Vertical; MPN HX PZ2.54-2x6P ZZ; LCSC C32713279
R201: 45.3k; R_0402_1005Metric; MPN FRC0402F4532TS; LCSC C2933099
R202, R203, R212, R213: 10k; R_0402_1005Metric; MPN 0402WGF1002TCE; LCSC C25744
R204, R205: 56k; R_0402_1005Metric; MPN 0402WGF5602TCE; LCSC C25796
R206: 100m; R_1206_3216Metric_Kelvin; MPN 1206W4F100LT5E; LCSC C25334
R207, R208, R214: 1k; R_0402_1005Metric; MPN 0402WGF1001TCE; LCSC C11702
R209, R210, R215: 100k; R_0402_1005Metric; MPN 0402WGF1003TCE; LCSC C25741
R211: 200k; R_0402_1005Metric; MPN 0402WGF2003TCE; LCSC C25764
RN201, RN202: 100; R_Array_Convex_4x0402; MPN 4D02WGJ0101TCE; LCSC C48442
TP201: test pad; TestPoint_Pad_D1.0mm; MPN test pad
TP202: test pad; TestPoint_Pad_D1.5mm; MPN test pad
U201: TPS2553DBVR-1; SOT-23-6; MPN TPS2553DBVR-1; LCSC C111738
U202: INA226AIDGSR; TSSOP-10_3x3mm_P0.5mm; MPN INA226AIDGSR; LCSC C49851
U203: USBLC6-2SC6; SOT-23-6; MPN USBLC6-2SC6; LCSC C7519
U205, U206, U208, U209: H5VU25UC; DFN2510-10L_2.5x1.0mm_P0.5mm; MPN H5VU25UC; LCSC C20615800
U207: LSF0108RKSR; DHVQFN-20-1EP_2.5x4.5mm_P0.5mm_EP1x3mm; MPN LSF0108RKSR; LCSC C130008

Connections:
+3V3: C203.1, R203.1, R209.1, R210.1, U202.6 (VS); also elsewhere on the board
+5V: C201.1, C204.1, U201.1 (IN), U203.5 (VBUS); also elsewhere on the board
+5V_MX: R211.1; also elsewhere on the board
/Port 2/CP_VREF2: R212.2, R213.1, R215.1
/Port 2/PORT2_5V_SW: R206.1, R214.1, U201.6 (OUT)
/Port 2/PORT2_A1: RN201.7 (R2.2), U207.4 (A2)
/Port 2/PORT2_A2: RN201.5 (R4.2), U207.6 (A4)
/Port 2/PORT2_A3: RN202.7 (R2.2), U207.8 (A6)
/Port 2/PORT2_A4: RN202.5 (R4.2), U207.10 (A8)
/Port 2/PORT2_A5: RN201.8 (R1.2), U207.3 (A1)
/Port 2/PORT2_A6: RN201.6 (R3.2), U207.5 (A3)
/Port 2/PORT2_A7: RN202.8 (R1.2), U207.7 (A5)
/Port 2/PORT2_A8: RN202.6 (R3.2), U207.9 (A7)
/Port 2/PORT2_BOOT_N: J202.12, R208.2, U209.2 (D1-), U209.9 (NC)
/Port 2/PORT2_CC1: J201.A5 (CC1), R204.2
/Port 2/PORT2_CC2: J201.B5 (CC2), R205.2
/Port 2/PORT2_CONN_DN: J201.A7 (D-), J201.B7 (D-), U203.1 (I/O1)
/Port 2/PORT2_CONN_DP: J201.A6 (D+), J201.B6 (D+), U203.3 (I/O2)
/Port 2/PORT2_ILIM: R201.1, U201.5 (ILIM)
/Port 2/PORT2_LED_A: D201.2 (A), R214.2
/Port 2/PORT2_P1: J202.4, RN201.2 (R2.1), U205.2 (D1-), U205.9 (NC)
/Port 2/PORT2_P2: J202.6, RN201.4 (R4.1), U205.5 (D2-), U205.6 (NC)
/Port 2/PORT2_P3: J202.8, RN202.2 (R2.1), U206.2 (D1-), U206.9 (NC)
/Port 2/PORT2_P4: J202.10, RN202.4 (R4.1), U206.5 (D2-), U206.6 (NC)
/Port 2/PORT2_P5: J202.3, RN201.1 (R1.1), U205.1 (D1+), U205.10 (NC)
/Port 2/PORT2_P6: J202.5, RN201.3 (R3.1), U205.4 (D2+), U205.7 (NC)
/Port 2/PORT2_P7: J202.7, RN202.1 (R1.1), U206.1 (D1+), U206.10 (NC)
/Port 2/PORT2_P8: J202.9, RN202.3 (R3.1), U206.4 (D2+), U206.7 (NC)
/Port 2/PORT2_RST_N: J202.11, R207.2, U209.5 (D2-), U209.6 (NC)
/Port 2/PORT2_SNS_N: R206.3, U202.8 (Vbus), U202.9 (Vin-)
/Port 2/PORT2_SNS_P: R206.2, U202.10 (Vin+)
/Port 2/PORT2_VBUS: C202.1, J201.A4 (VBUS), J201.A9 (VBUS), J201.B4 (VBUS), J201.B9 (VBUS), R204.1, R205.1, R206.4, TP202.1
/Port 2/PORT2_VREF: J202.2, R212.1, U207.2 (RefA), U208.5 (D2-), U208.6 (NC)
/Port 2/PORT2_VREFB: C205.1, R211.2, U207.19 (RefB), U207.20 (EN)
CP_ADC2: R215.2; also elsewhere on the board
GND: C201.2, C202.2, C203.2, C204.2, C205.2, D201.1 (K), J201.A1 (GND), J201.A12 (GND), J201.B1 (GND), J201.B12 (GND), J201.SH (SHIELD), J202.1, R201.2, R202.2, R213.2, U201.2 (GND), U202.1 (A1), U202.7 (GND), U203.2 (GND), U205.3 (GND), U205.8 (GND), U206.3 (GND), U206.8 (GND), U207.1 (GND), U207.21 (EPAD), U208.3 (GND), U208.8 (GND), U209.3 (GND), U209.8 (GND); also elsewhere on the board
PORT2_B1: U207.17 (B2); also elsewhere on the board
PORT2_B2: U207.15 (B4); also elsewhere on the board
PORT2_B3: U207.13 (B6); also elsewhere on the board
PORT2_B4: U207.11 (B8); also elsewhere on the board
PORT2_B5: U207.18 (B1); also elsewhere on the board
PORT2_B6: U207.16 (B3); also elsewhere on the board
PORT2_B7: U207.14 (B5); also elsewhere on the board
PORT2_B8: U207.12 (B7); also elsewhere on the board
PORT2_BOOT_IO: R208.1, R210.2; also elsewhere on the board
PORT2_DN: U203.6 (I/O1); also elsewhere on the board
PORT2_DP: U203.4 (I/O2); also elsewhere on the board
PORT2_EN: R202.1, U201.3 (EN); also elsewhere on the board
PORT2_FLT_N: R203.2, TP201.1, U201.4 (~FAULT); also elsewhere on the board
PORT2_RST_IO: R207.1, R209.2; also elsewhere on the board
SCL: U202.2 (A0), U202.5 (SCL); also elsewhere on the board
SDA: U202.4 (SDA); also elsewhere on the board

Notes on the sheet:
Port 2 power: +5V → TPS2553-1 → PORT2_5V_SW → 100 mΩ shunt → PORT2_VBUS, the INA226 across the shunt
Bring-up test points on the rear face (B.Cu): FAULT_N, VBUS
USB-C 2 (source): Rp 56k on each CC; USBLC6 in flow-through (connector side | hub side)
Header 2 (2 × 6 through-hole): GND, VREF, P1–P8, RESET_N, BOOT_N; RESET/BOOT through 1k, their expander lines pulled up
ESD on the header's VREF (U208, in flow-through: header → ESD → LSF0108 and divider) and on RESET_N / BOOT_N (U209: header → ESD → 1k)
Pins 2: ESD in flow-through, 100 Ω, LSF0108 (A = the DUT's VREF, B = 3.3 V) to crosspoint U7's X lines
Port 2 = sub-slot A1.2, hub port 2, busid 1-1.2. INA226 at 0x43; expander U2 (0x20). ILIM 45.3k: 524 / 577 / 638 mA min / typ / max (TI SLVS841G §8.5.1 eq. 1–3), 519–644 mA with the resistor's 1 %; the -1 latches off after 7.5 ms in limit, FAULT_N flags it. INA226 Vbus on the shunt's load-side sens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
