kartben/hw-testing-rack/electronics/data-port-x4/data-port-x4.kicad_pcb

## KiCad design electronics/data-port-x4/data-port-x4.kicad_pcb (continued)

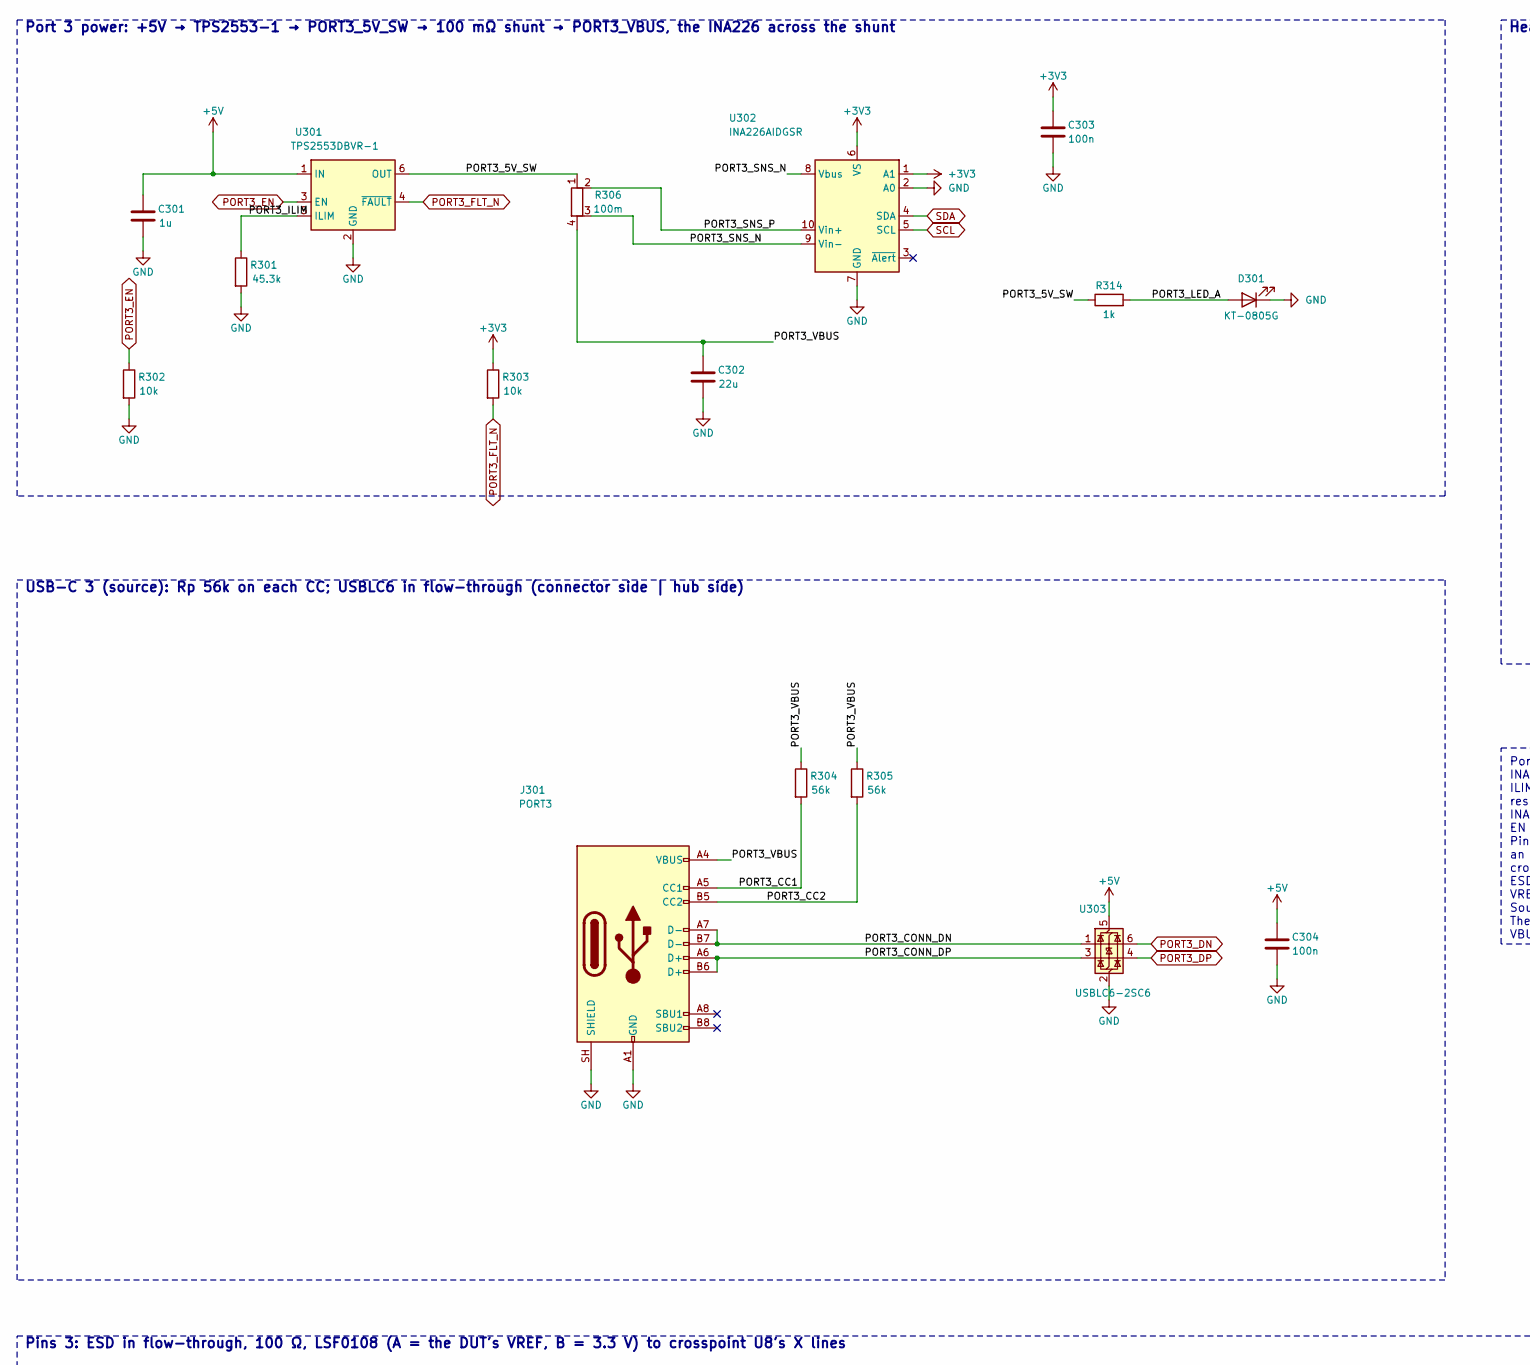
[picture p209: schematic port3.kicad_sch, DATA ×4 v2 — USB-C 3: switch, current sense, ESD, header; p…, part in row 1, column 1]

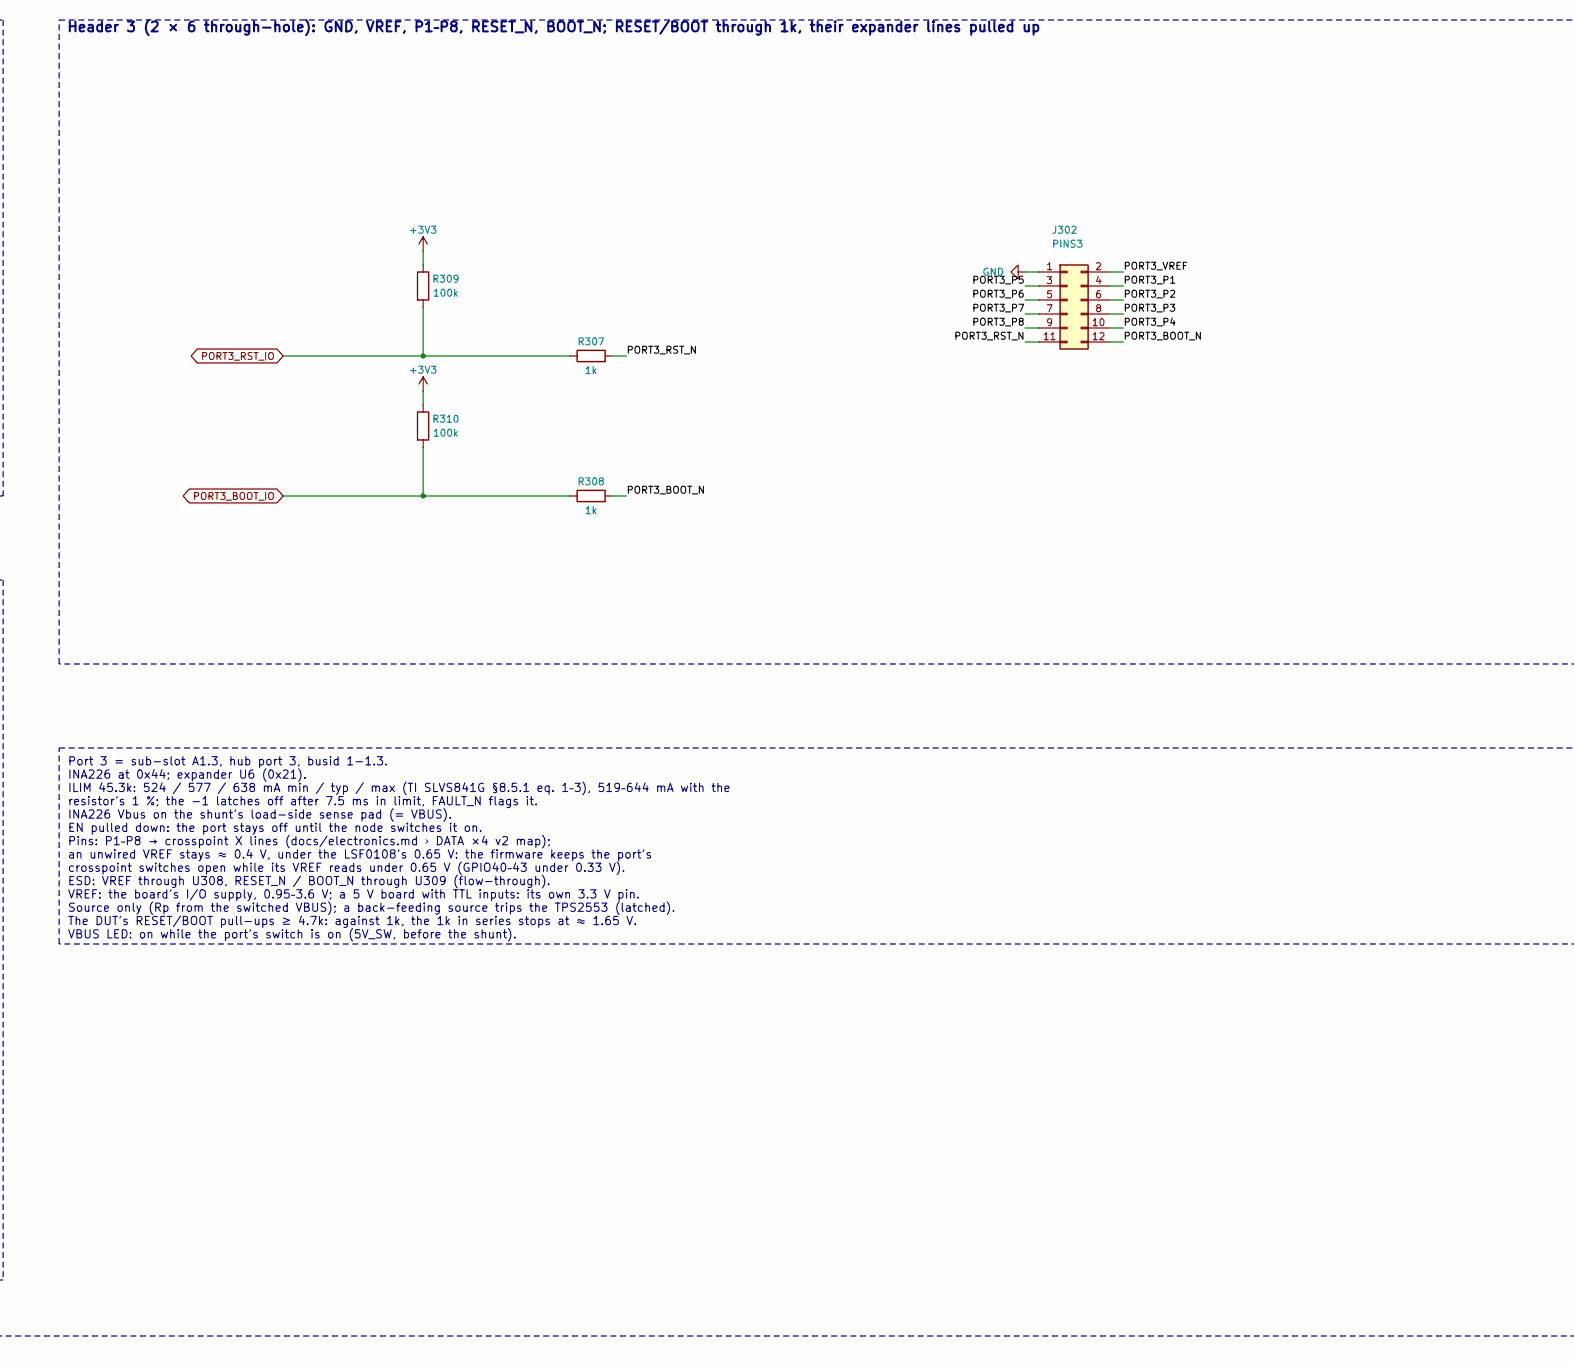
[picture p210: schematic port3.kicad_sch, DATA ×4 v2 — USB-C 3: switch, current sense, ESD, header; p…, part in row 1, column 2]

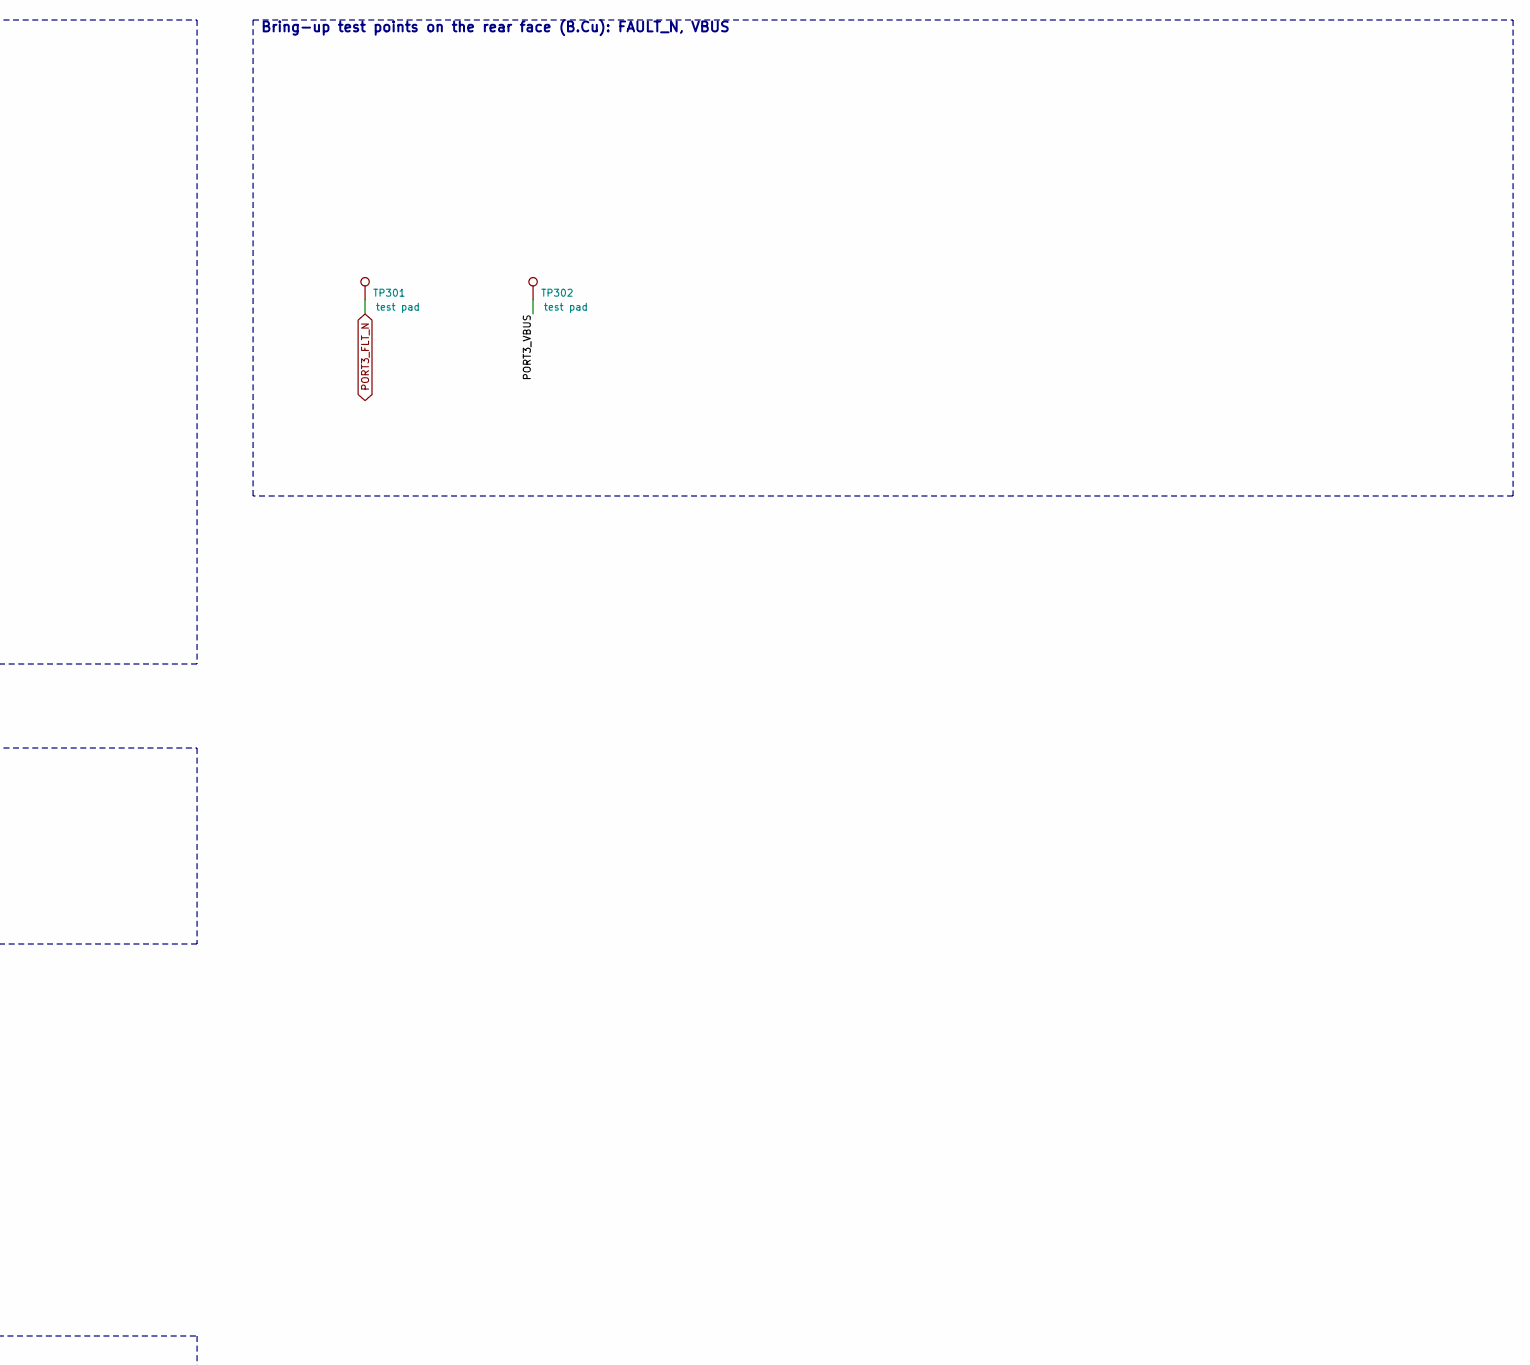
[picture p211: schematic port3.kicad_sch, DATA ×4 v2 — USB-C 3: switch, current sense, ESD, header; p…, part in row 1, column 3]

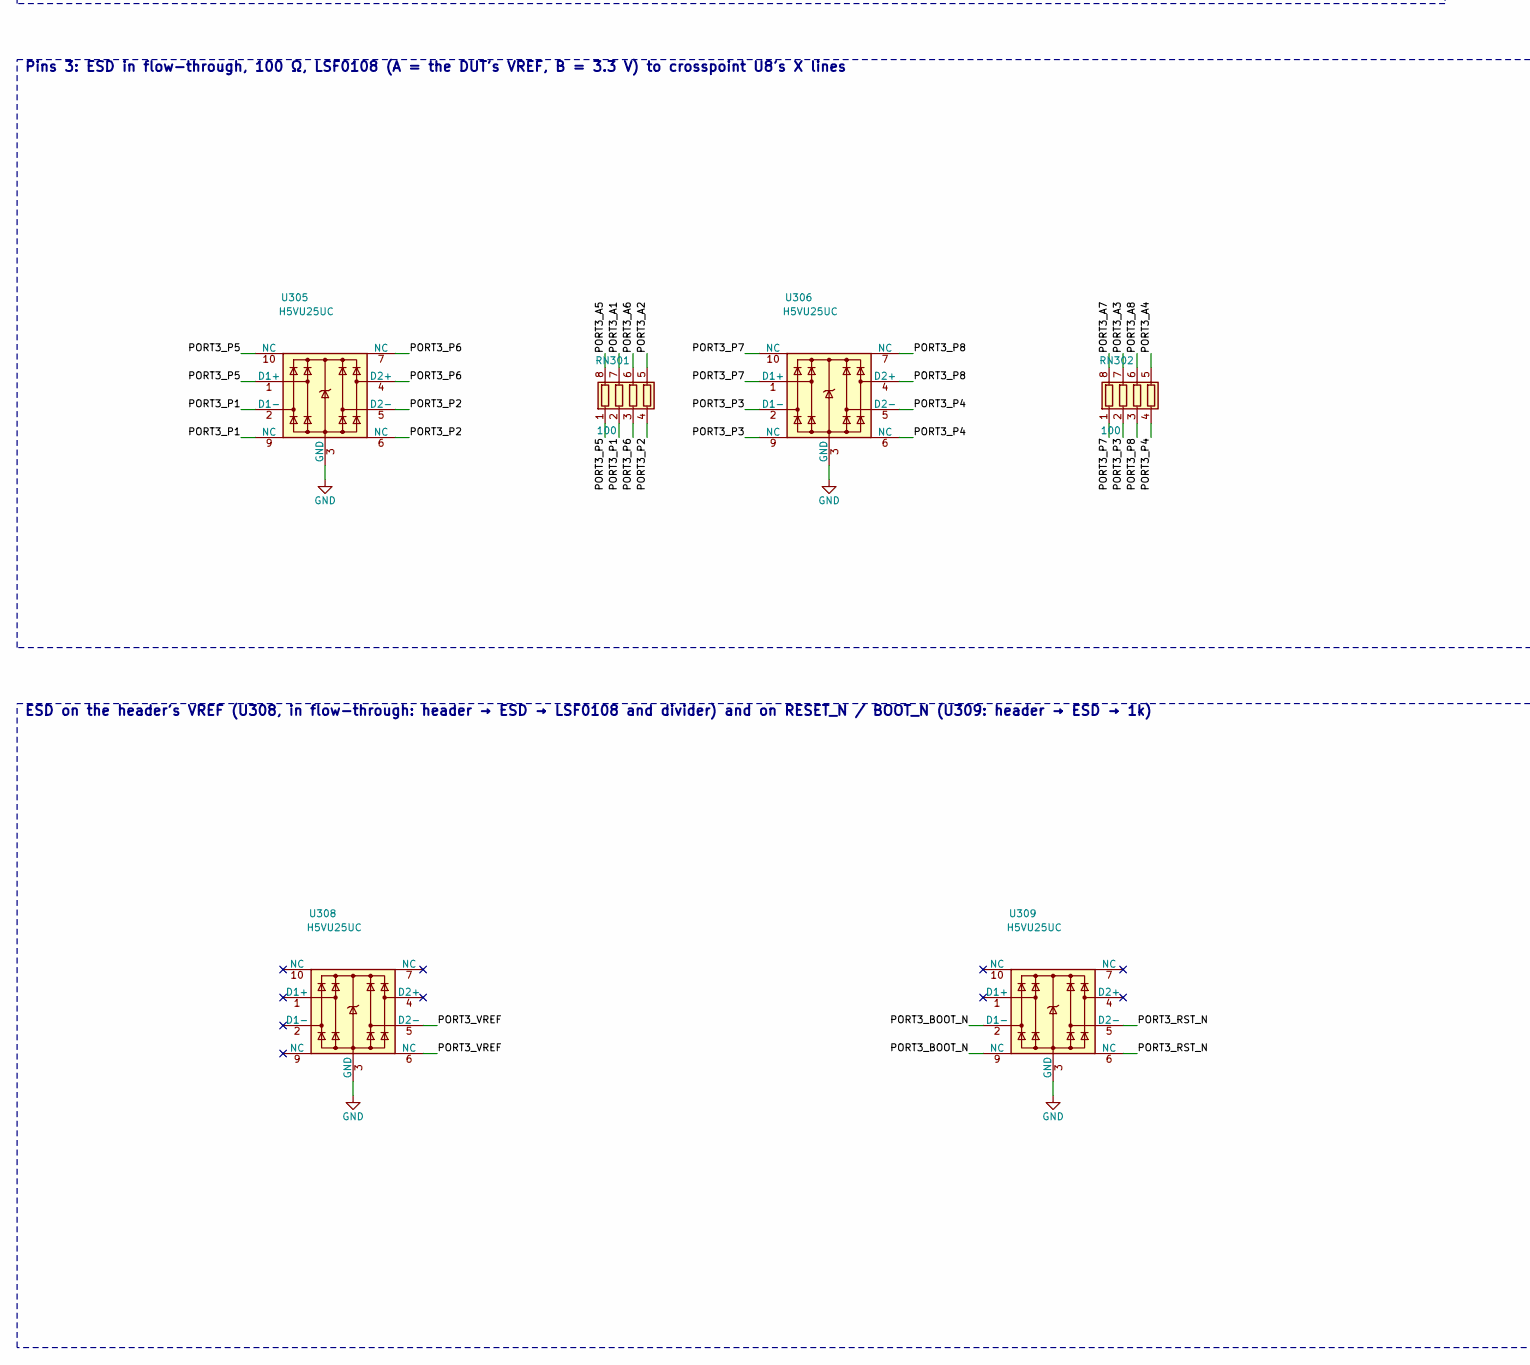
[picture p212: schematic port3.kicad_sch, DATA ×4 v2 — USB-C 3: switch, current sense, ESD, header; p…, part in row 2, column 1]

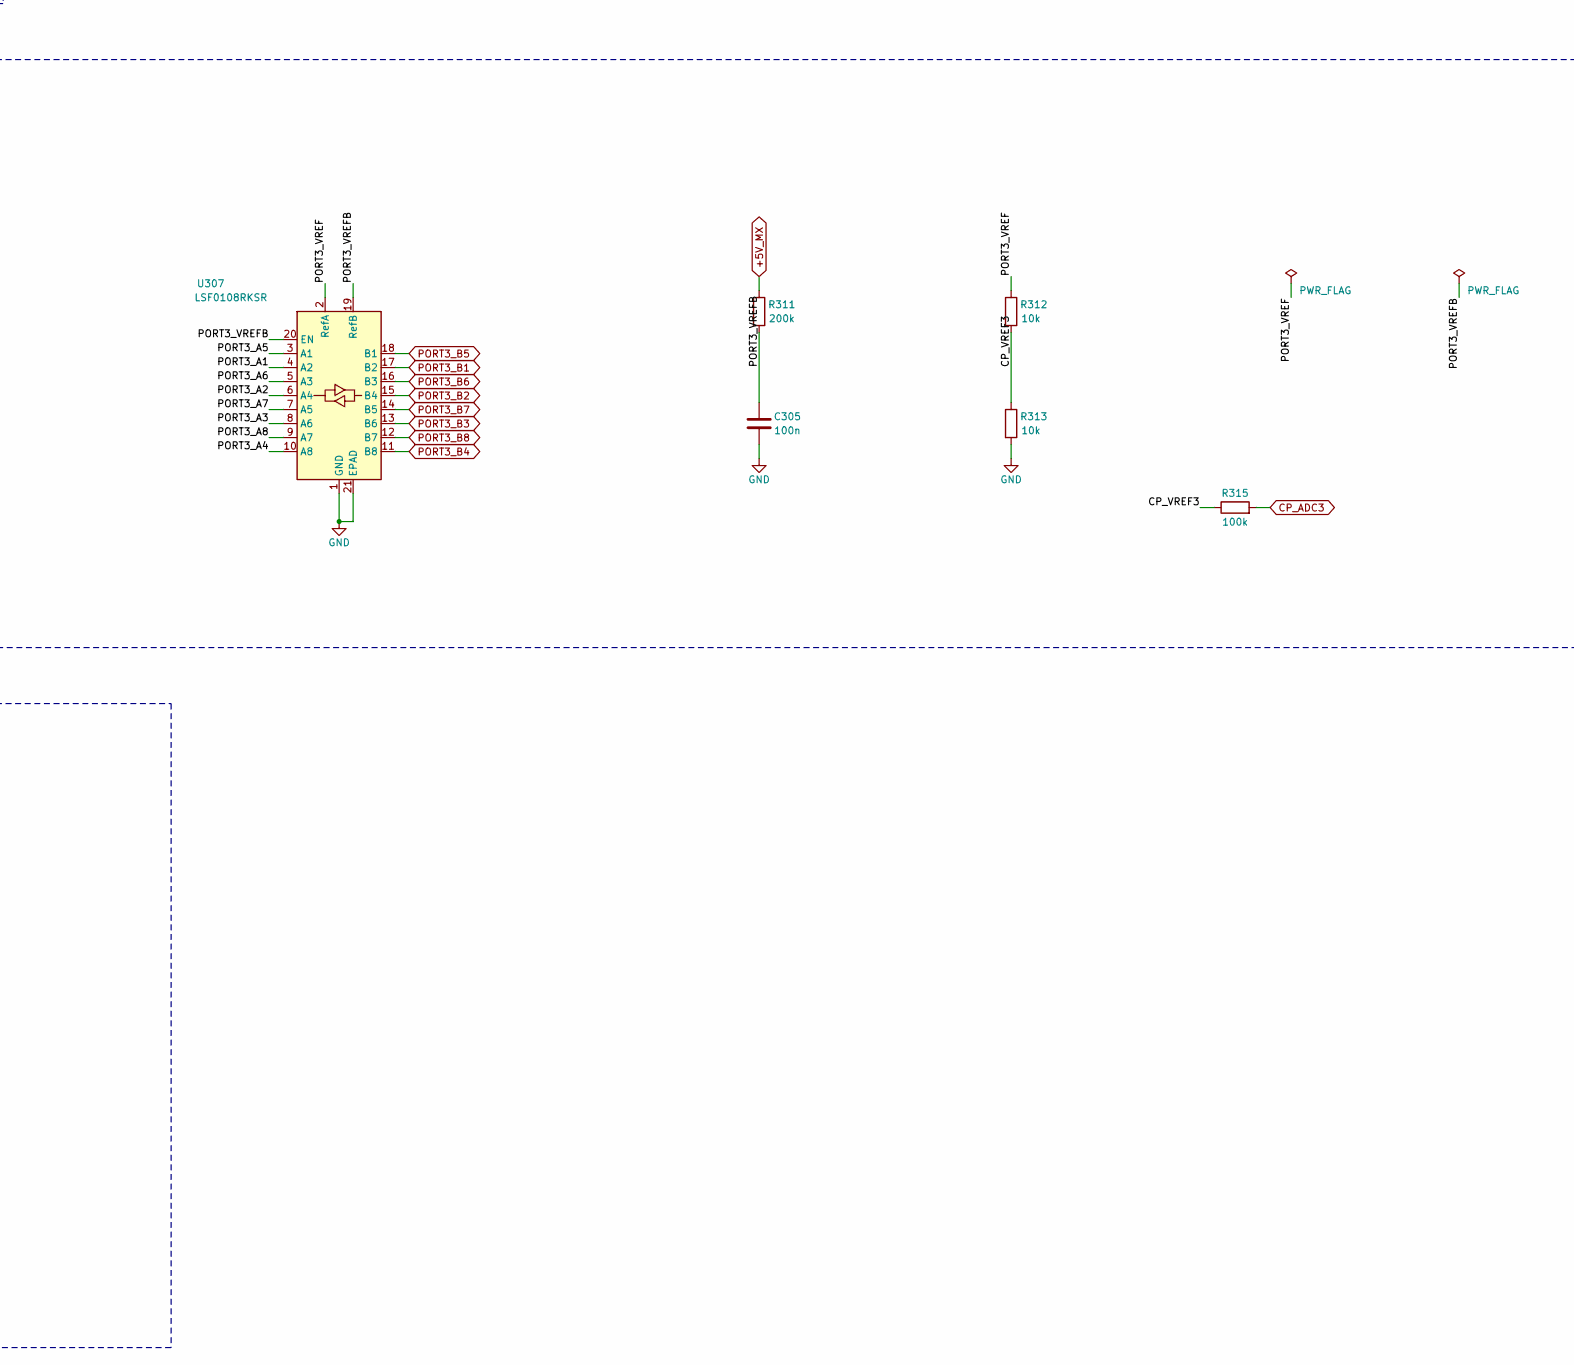
[picture p213: schematic port3.kicad_sch, DATA ×4 v2 — USB-C 3: switch, current sense, ESD, header; p…, part in row 2, column 2]

Parts:
C301: 1u; C_0402_1005Metric; MPN CL05A105KA5NQNC; LCSC C52923
C302: 22u; C_0805_2012Metric; MPN CL21A226MAQNNNE; LCSC C45783
C303, C304, C305: 100n; C_0402_1005Metric; MPN CL05B104KO5NNNC; LCSC C1525
D301: KT-0805G; LED_0805_2012Metric; MPN KT-0805G; LCSC C2297
J301: PORT3; USB_C_Receptacle_GCT_USB4145-03-0170-C_Vertical; MPN USB4145-03-0170-C; LCSC C5181332
J302: PINS3; PinHeader_2x06_P2.54mm_Vertical; MPN HX PZ2.54-2x6P ZZ; LCSC C32713279
R301: 45.3k; R_0402_1005Metric; MPN FRC0402F4532TS; LCSC C2933099
R302, R303, R312, R313: 10k; R_0402_1005Metric; MPN 0402WGF1002TCE; LCSC C25744
R304, R305: 56k; R_0402_1005Metric; MPN 0402WGF5602TCE; LCSC C25796
R306: 100m; R_1206_3216Metric_Kelvin; MPN 1206W4F100LT5E; LCSC C25334
R307, R308, R314: 1k; R_0402_1005Metric; MPN 0402WGF1001TCE; LCSC C11702
R309, R310, R315: 100k; R_0402_1005Metric; MPN 0402WGF1003TCE; LCSC C25741
R311: 200k; R_0402_1005Metric; MPN 0402WGF2003TCE; LCSC C25764
RN301, RN302: 100; R_Array_Convex_4x0402; MPN 4D02WGJ0101TCE; LCSC C48442
TP301: test pad; TestPoint_Pad_D1.0mm; MPN test pad
TP302: test pad; TestPoint_Pad_D1.5mm; MPN test pad
U301: TPS2553DBVR-1; SOT-23-6; MPN TPS2553DBVR-1; LCSC C111738
U302: INA226AIDGSR; TSSOP-10_3x3mm_P0.5mm; MPN INA226AIDGSR; LCSC C49851
U303: USBLC6-2SC6; SOT-23-6; MPN USBLC6-2SC6; LCSC C7519
U305, U306, U308, U309: H5VU25UC; DFN2510-10L_2.5x1.0mm_P0.5mm; MPN H5VU25UC; LCSC C20615800
U307: LSF0108RKSR; DHVQFN-20-1EP_2.5x4.5mm_P0.5mm_EP1x3mm; MPN LSF0108RKSR; LCSC C130008

Connections:
+3V3: C303.1, R303.1, R309.1, R310.1, U302.1 (A1), U302.6 (VS); also elsewhere on the board
+5V: C301.1, C304.1, U301.1 (IN), U303.5 (VBUS); also elsewhere on the board
+5V_MX: R311.1; also elsewhere on the board
/Port 3/CP_VREF3: R312.2, R313.1, R315.1
/Port 3/PORT3_5V_SW: R306.1, R314.1, U301.6 (OUT)
/Port 3/PORT3_A1: RN301.7 (R2.2), U307.4 (A2)
/Port 3/PORT3_A2: RN301.5 (R4.2), U307.6 (A4)
/Port 3/PORT3_A3: RN302.7 (R2.2), U307.8 (A6)
/Port 3/PORT3_A4: RN302.5 (R4.2), U307.10 (A8)
/Port 3/PORT3_A5: RN301.8 (R1.2), U307.3 (A1)
/Port 3/PORT3_A6: RN301.6 (R3.2), U307.5 (A3)
/Port 3/PORT3_A7: RN302.8 (R1.2), U307.7 (A5)
/Port 3/PORT3_A8: RN302.6 (R3.2), U307.9 (A7)
/Port 3/PORT3_BOOT_N: J302.12, R308.2, U309.2 (D1-), U309.9 (NC)
/Port 3/PORT3_CC1: J301.A5 (CC1), R304.2
/Port 3/PORT3_CC2: J301.B5 (CC2), R305.2
/Port 3/PORT3_CONN_DN: J301.A7 (D-), J301.B7 (D-), U303.1 (I/O1)
/Port 3/PORT3_CONN_DP: J301.A6 (D+), J301.B6 (D+), U303.3 (I/O2)
/Port 3/PORT3_ILIM: R301.1, U301.5 (ILIM)
/Port 3/PORT3_LED_A: D301.2 (A), R314.2
/Port 3/PORT3_P1: J302.4, RN301.2 (R2.1), U305.2 (D1-), U305.9 (NC)
/Port 3/PORT3_P2: J302.6, RN301.4 (R4.1), U305.5 (D2-), U305.6 (NC)
/Port 3/PORT3_P3: J302.8, RN302.2 (R2.1), U306.2 (D1-), U306.9 (NC)
/Port 3/PORT3_P4: J302.10, RN302.4 (R4.1), U306.5 (D2-), U306.6 (NC)
/Port 3/PORT3_P5: J302.3, RN301.1 (R1.1), U305.1 (D1+), U305.10 (NC)
/Port 3/PORT3_P6: J302.5, RN301.3 (R3.1), U305.4 (D2+), U305.7 (NC)
/Port 3/PORT3_P7: J302.7, RN302.1 (R1.1), U306.1 (D1+), U306.10 (NC)
/Port 3/PORT3_P8: J302.9, RN302.3 (R3.1), U306.4 (D2+), U306.7 (NC)
/Port 3/PORT3_RST_N: J302.11, R307.2, U309.5 (D2-), U309.6 (NC)
/Port 3/PORT3_SNS_N: R306.3, U302.8 (Vbus), U302.9 (Vin-)
/Port 3/PORT3_SNS_P: R306.2, U302.10 (Vin+)
/Port 3/PORT3_VBUS: C302.1, J301.A4 (VBUS), J301.A9 (VBUS), J301.B4 (VBUS), J301.B9 (VBUS), R304.1, R305.1, R306.4, TP302.1
/Port 3/PORT3_VREF: J302.2, R312.1, U307.2 (RefA), U308.5 (D2-), U308.6 (NC)
/Port 3/PORT3_VREFB: C305.1, R311.2, U307.19 (RefB), U307.20 (EN)
CP_ADC3: R315.2; also elsewhere on the board
GND: C301.2, C302.2, C303.2, C304.2, C305.2, D301.1 (K), J301.A1 (GND), J301.A12 (GND), J301.B1 (GND), J301.B12 (GND), J301.SH (SHIELD), J302.1, R301.2, R302.2, R313.2, U301.2 (GND), U302.2 (A0), U302.7 (GND), U303.2 (GND), U305.3 (GND), U305.8 (GND), U306.3 (GND), U306.8 (GND), U307.1 (GND), U307.21 (EPAD), U308.3 (GND), U308.8 (GND), U309.3 (GND), U309.8 (GND); also elsewhere on the board
PORT3_B1: U307.17 (B2); also elsewhere on the board
PORT3_B2: U307.15 (B4); also elsewhere on the board
PORT3_B3: U307.13 (B6); also elsewhere on the board
PORT3_B4: U307.11 (B8); also elsewhere on the board
PORT3_B5: U307.18 (B1); also elsewhere on the board
PORT3_B6: U307.16 (B3); also elsewhere on the board
PORT3_B7: U307.14 (B5); also elsewhere on the board
PORT3_B8: U307.12 (B7); also elsewhere on the board
PORT3_BOOT_IO: R308.1, R310.2; also elsewhere on the board
PORT3_DN: U303.6 (I/O1); also elsewhere on the board
PORT3_DP: U303.4 (I/O2); also elsewhere on the board
PORT3_EN: R302.1, U301.3 (EN); also elsewhere on the board
PORT3_FLT_N: R303.2, TP301.1, U301.4 (~FAULT); also elsewhere on the board
PORT3_RST_IO: R307.1, R309.2; also elsewhere on the board
SCL: U302.5 (SCL); also elsewhere on the board
SDA: U302.4 (SDA); also elsewhere on the board

Notes on the sheet:
Port 3 power: +5V → TPS2553-1 → PORT3_5V_SW → 100 mΩ shunt → PORT3_VBUS, the INA226 across the shunt
Bring-up test points on the rear face (B.Cu): FAULT_N, VBUS
USB-C 3 (source): Rp 56k on each CC; USBLC6 in flow-through (connector side | hub side)
Header 3 (2 × 6 through-hole): GND, VREF, P1–P8, RESET_N, BOOT_N; RESET/BOOT through 1k, their expander lines pulled up
ESD on the header's VREF (U308, in flow-through: header → ESD → LSF0108 and divider) and on RESET_N / BOOT_N (U309: header → ESD → 1k)
Pins 3: ESD in flow-through, 100 Ω, LSF0108 (A = the DUT's VREF, B = 3.3 V) to crosspoint U8's X lines
Port 3 = sub-slot A1.3, hub port 3, busid 1-1.3. INA226 at 0x44; expander U6 (0x21). ILIM 45.3k: 524 / 577 / 638 mA min / typ / max (TI SLVS841G §8.5.1 eq. 1–3), 519–644 mA with the resistor's 1 %; the -1 latches off after 7.5 ms in limit, FAULT_N flags it. INA226 Vbus on the shunt's load-side sens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
