kartben/hw-testing-rack/electronics/data-port-x4/data-port-x4.kicad_pcb

## KiCad design electronics/data-port-x4/data-port-x4.kicad_pcb (continued)

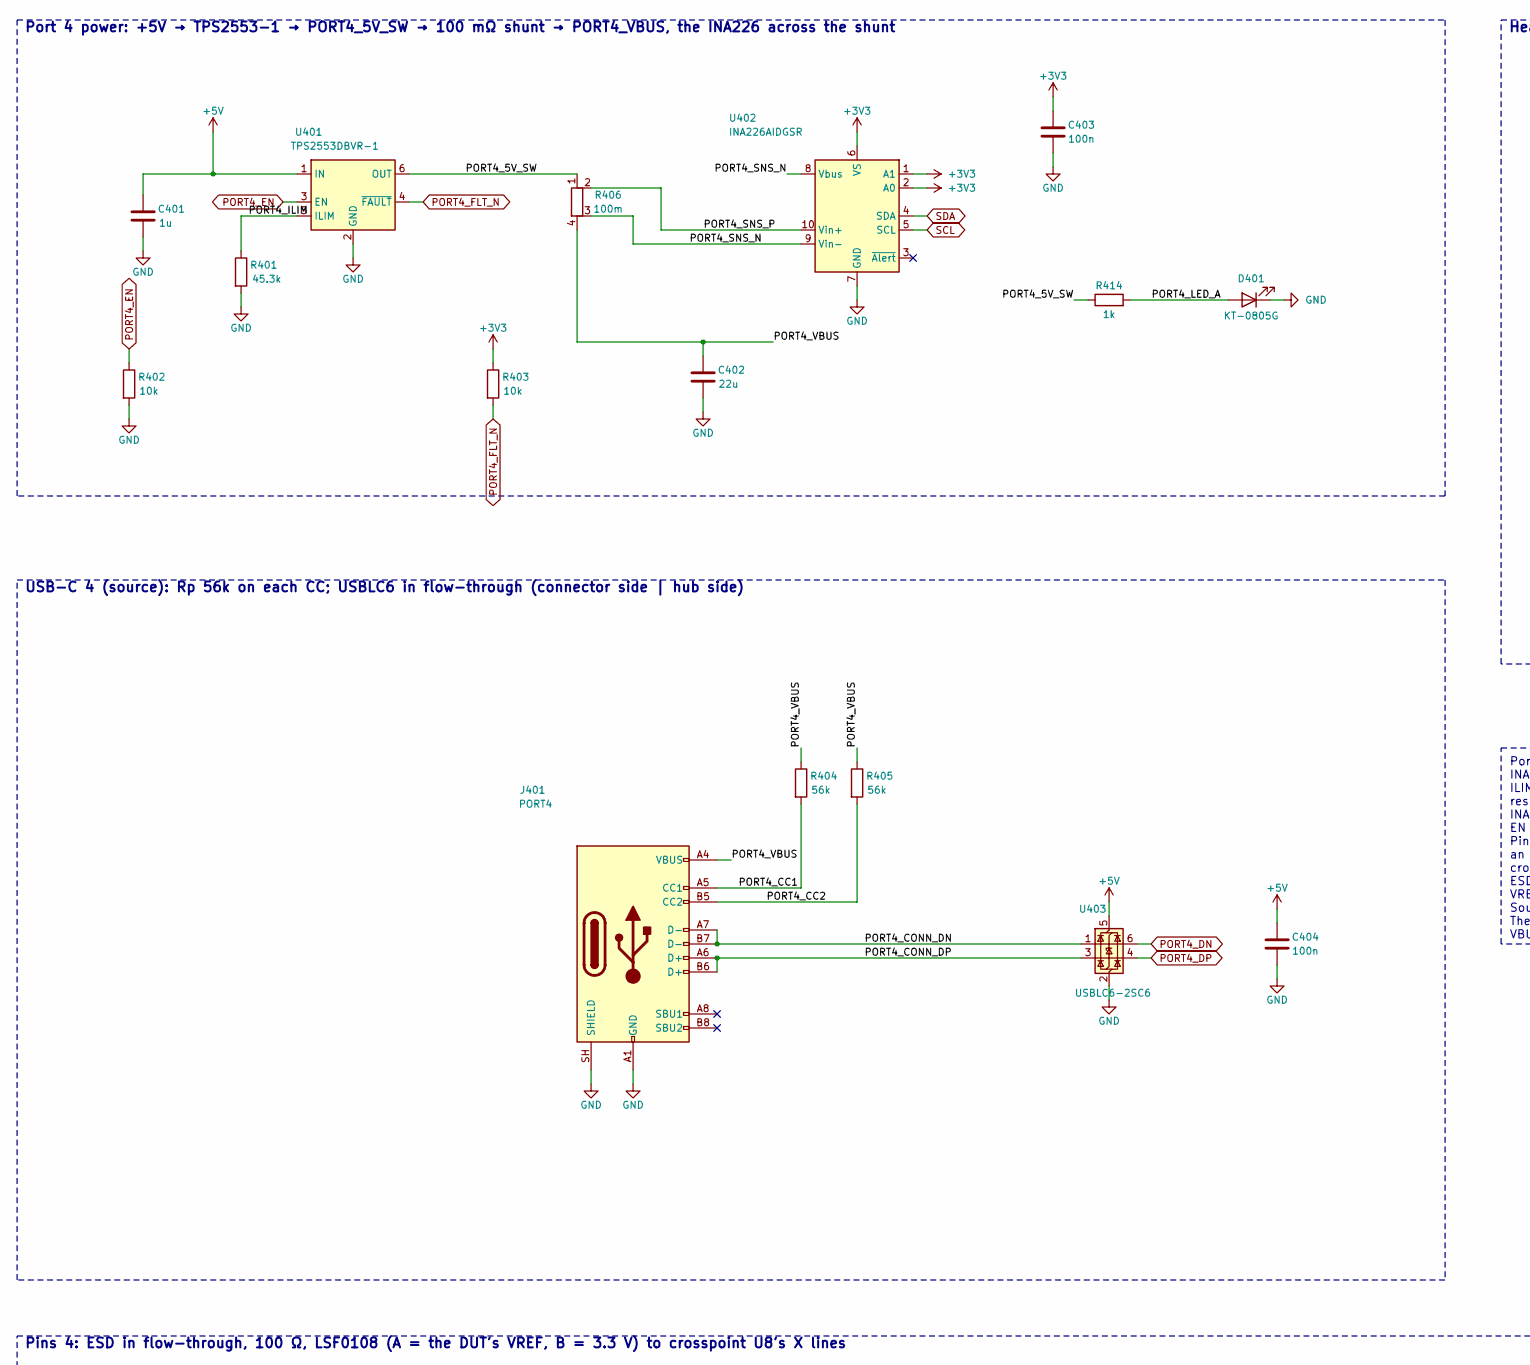
[picture p214: schematic port4.kicad_sch, DATA ×4 v2 — USB-C 4: switch, current sense, ESD, header; p…, part in row 1, column 1]

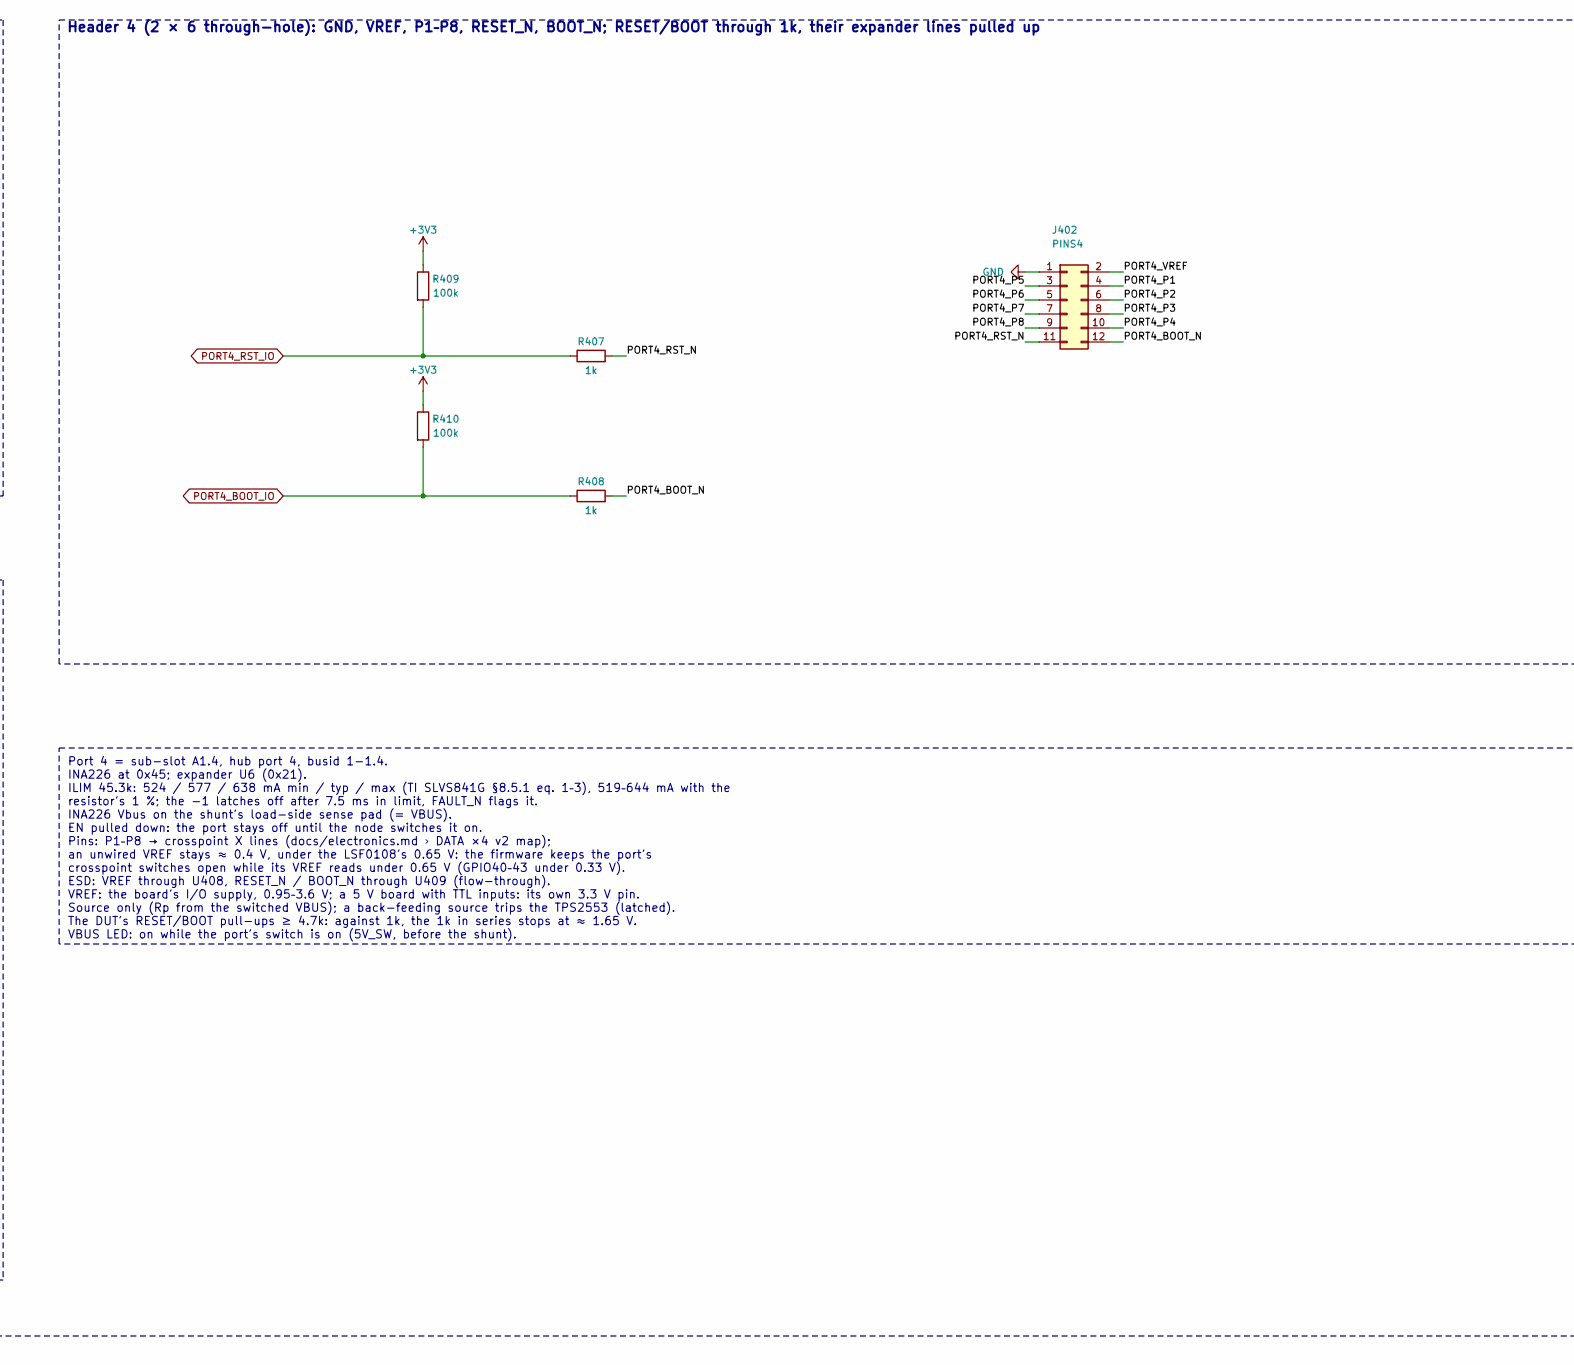
[picture p215: schematic port4.kicad_sch, DATA ×4 v2 — USB-C 4: switch, current sense, ESD, header; p…, part in row 1, column 2]

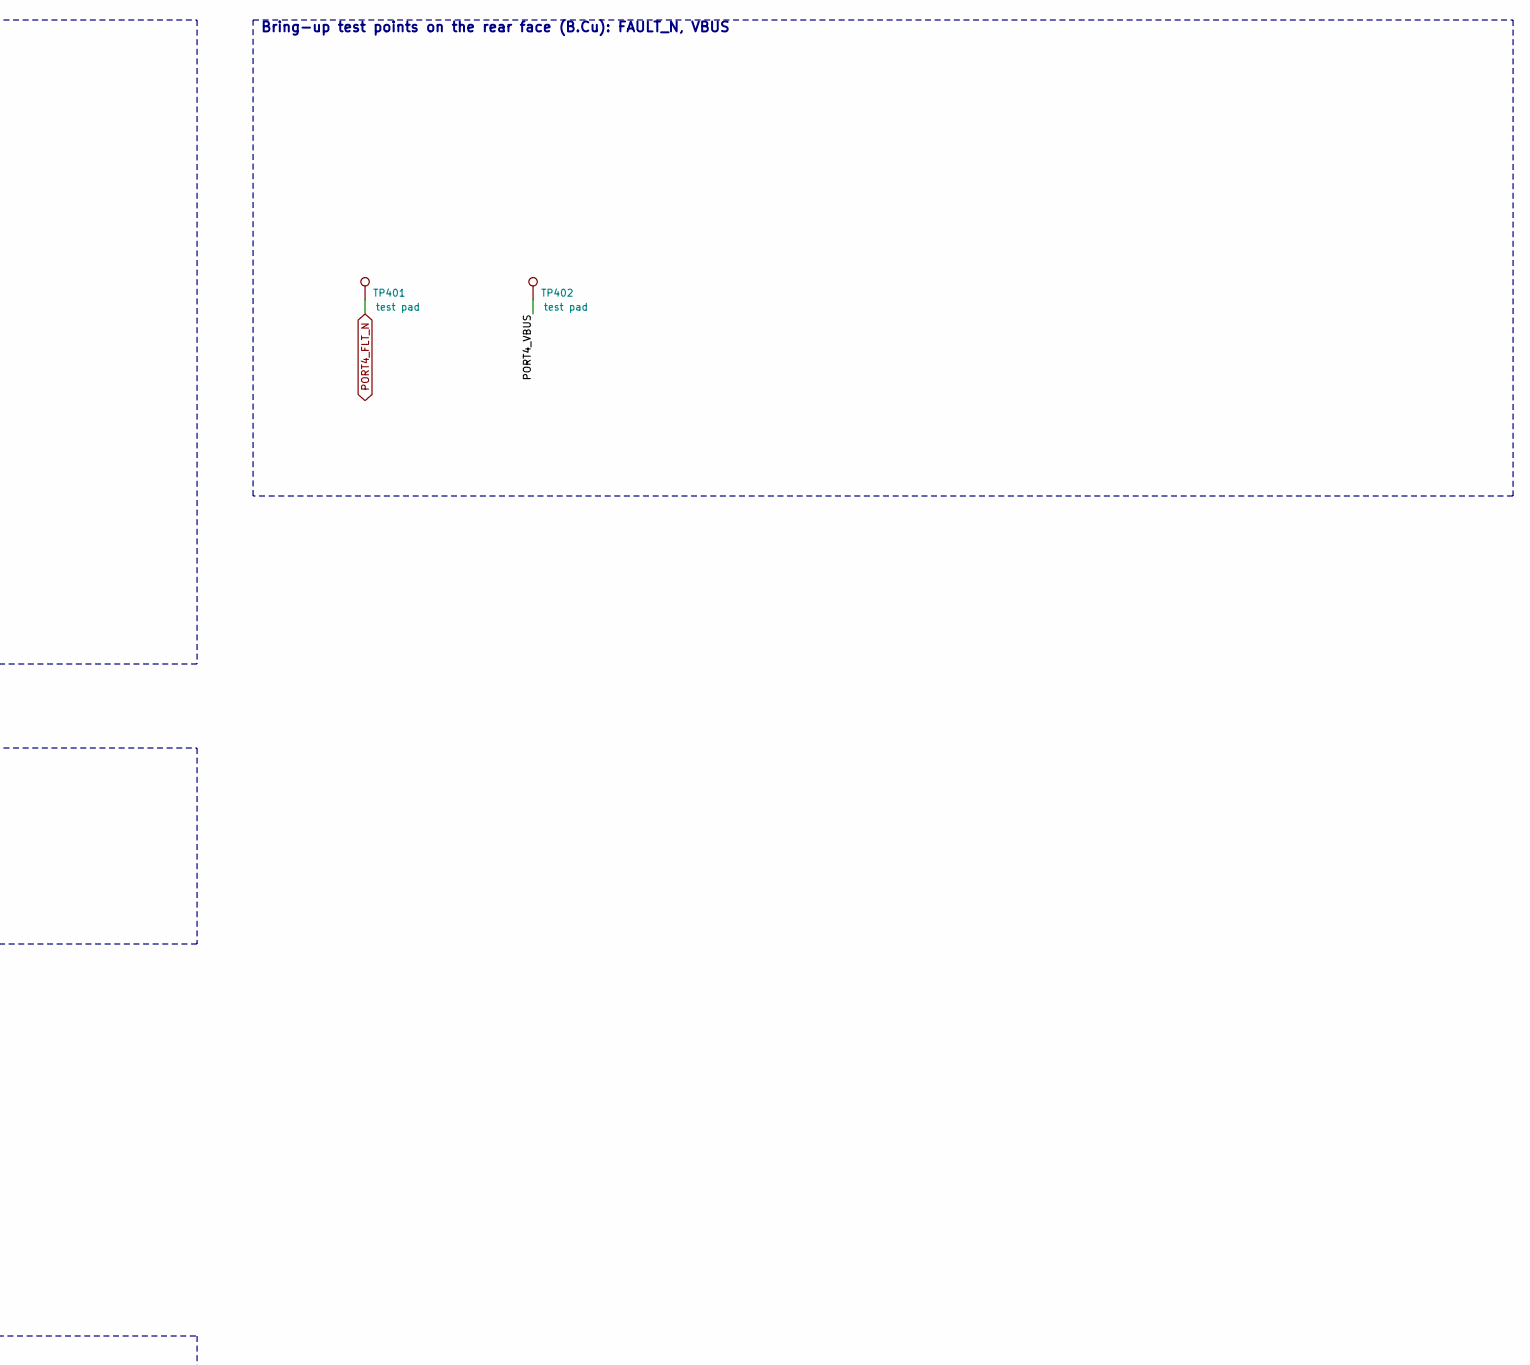
[picture p216: schematic port4.kicad_sch, DATA ×4 v2 — USB-C 4: switch, current sense, ESD, header; p…, part in row 1, column 3]

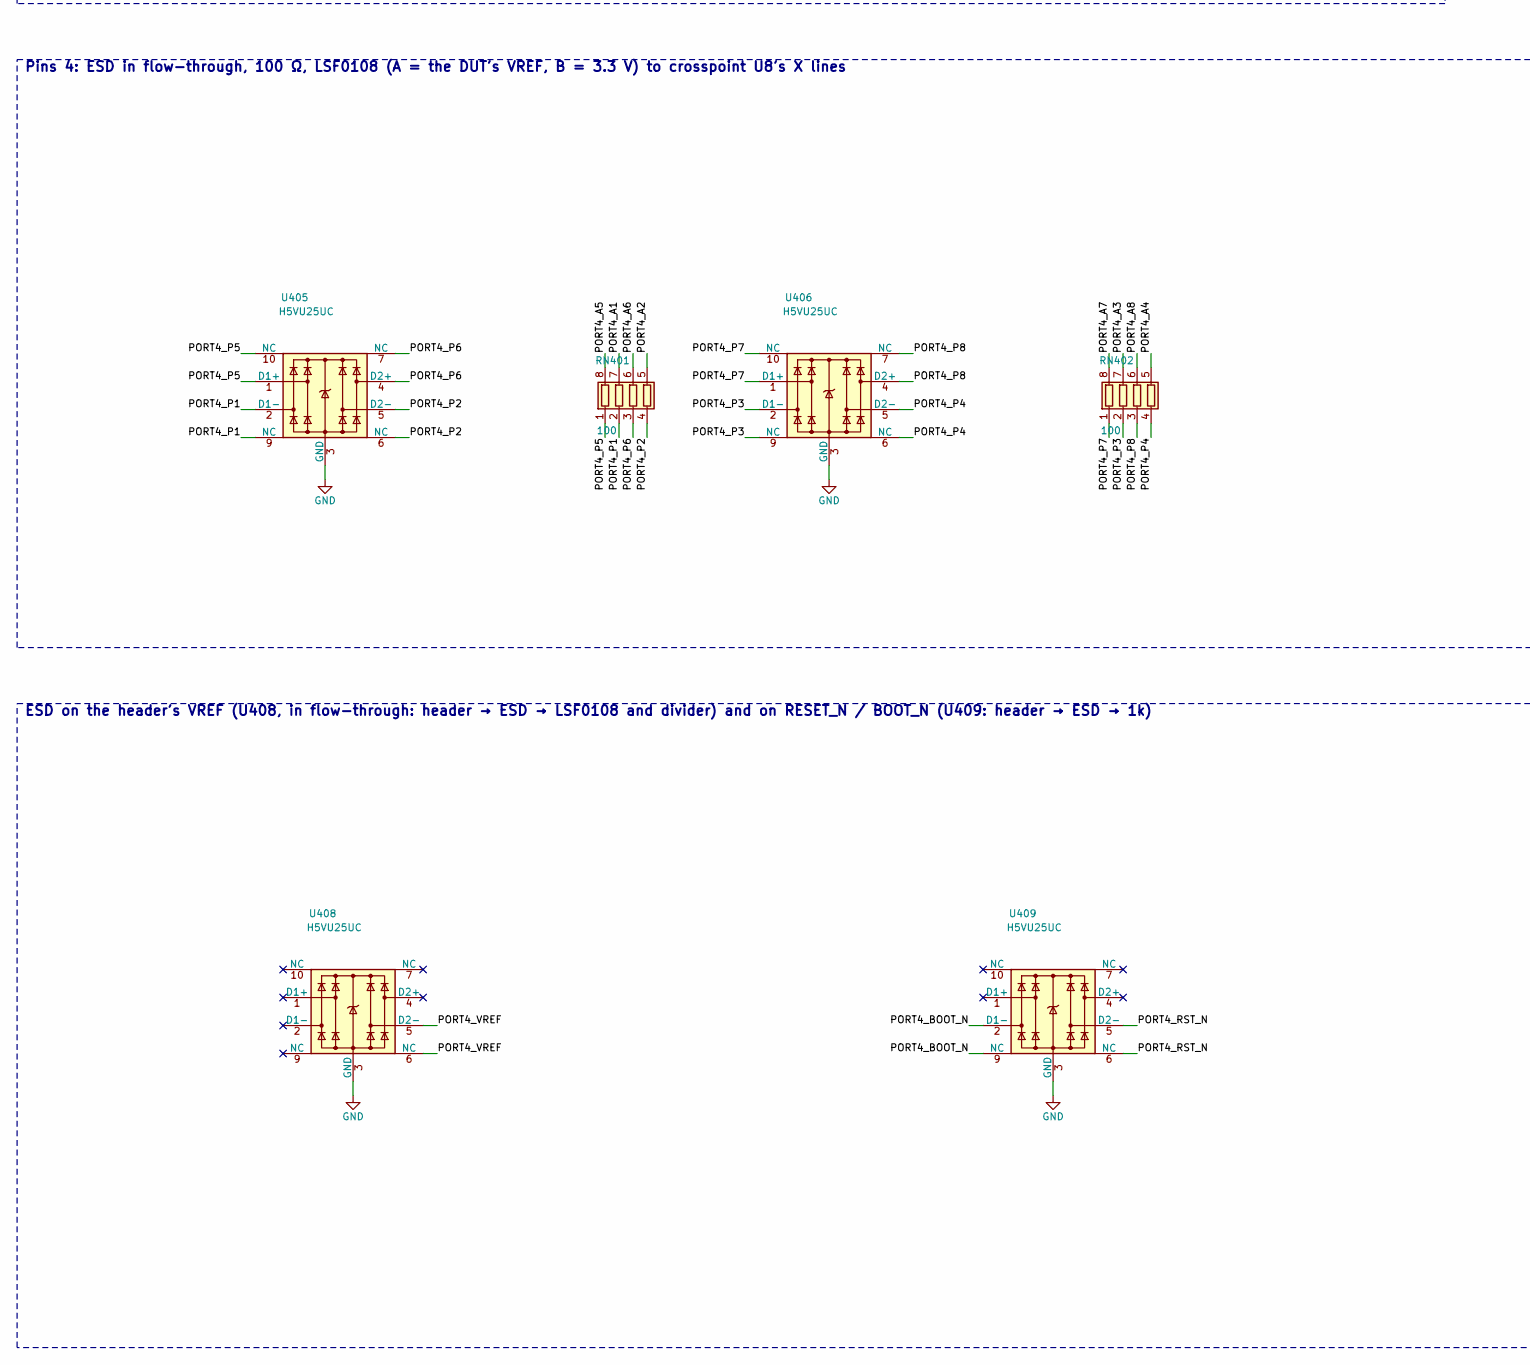
[picture p217: schematic port4.kicad_sch, DATA ×4 v2 — USB-C 4: switch, current sense, ESD, header; p…, part in row 2, column 1]

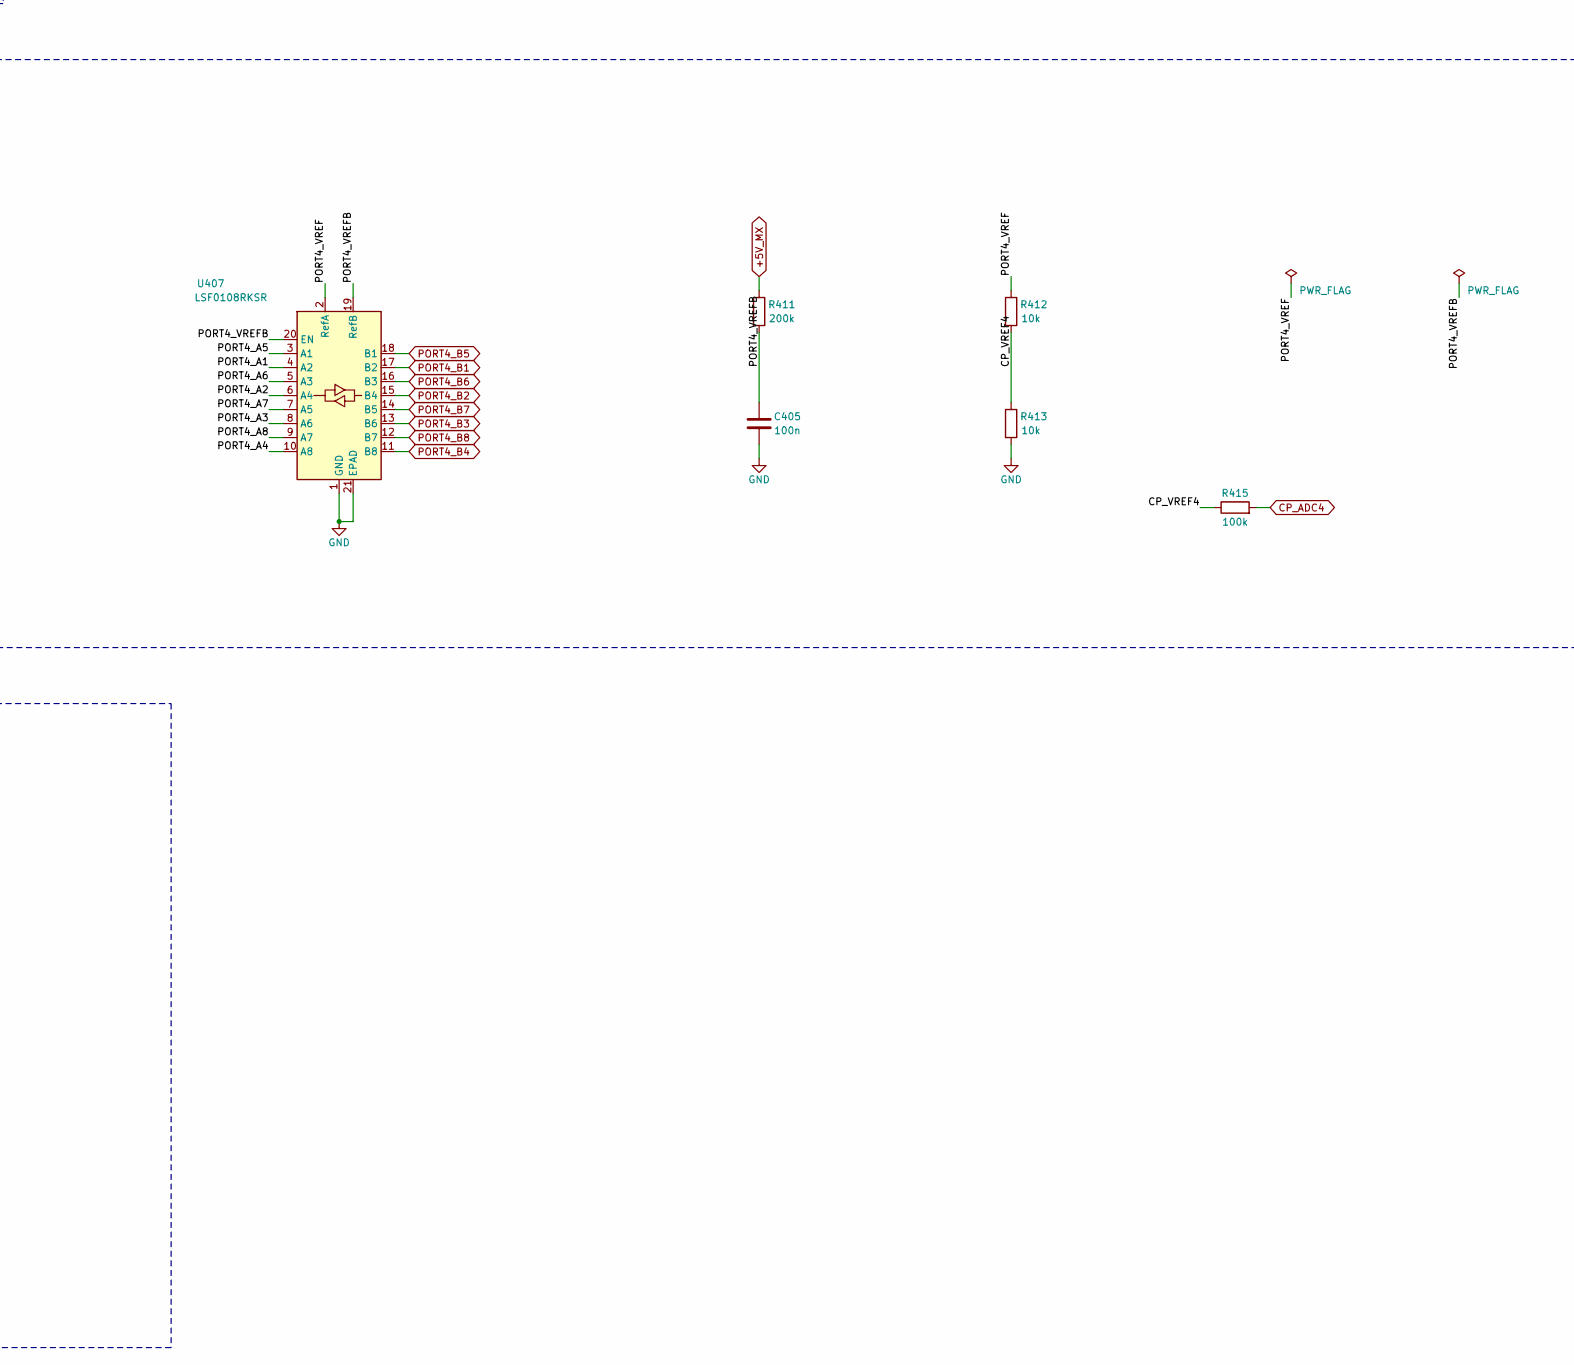
[picture p218: schematic port4.kicad_sch, DATA ×4 v2 — USB-C 4: switch, current sense, ESD, header; p…, part in row 2, column 2]

Parts:
C401: 1u; C_0402_1005Metric; MPN CL05A105KA5NQNC; LCSC C52923
C402: 22u; C_0805_2012Metric; MPN CL21A226MAQNNNE; LCSC C45783
C403, C404, C405: 100n; C_0402_1005Metric; MPN CL05B104KO5NNNC; LCSC C1525
D401: KT-0805G; LED_0805_2012Metric; MPN KT-0805G; LCSC C2297
J401: PORT4; USB_C_Receptacle_GCT_USB4145-03-0170-C_Vertical; MPN USB4145-03-0170-C; LCSC C5181332
J402: PINS4; PinHeader_2x06_P2.54mm_Vertical; MPN HX PZ2.54-2x6P ZZ; LCSC C32713279
R401: 45.3k; R_0402_1005Metric; MPN FRC0402F4532TS; LCSC C2933099
R402, R403, R412, R413: 10k; R_0402_1005Metric; MPN 0402WGF1002TCE; LCSC C25744
R404, R405: 56k; R_0402_1005Metric; MPN 0402WGF5602TCE; LCSC C25796
R406: 100m; R_1206_3216Metric_Kelvin; MPN 1206W4F100LT5E; LCSC C25334
R407, R408, R414: 1k; R_0402_1005Metric; MPN 0402WGF1001TCE; LCSC C11702
R409, R410, R415: 100k; R_0402_1005Metric; MPN 0402WGF1003TCE; LCSC C25741
R411: 200k; R_0402_1005Metric; MPN 0402WGF2003TCE; LCSC C25764
RN401, RN402: 100; R_Array_Convex_4x0402; MPN 4D02WGJ0101TCE; LCSC C48442
TP401: test pad; TestPoint_Pad_D1.0mm; MPN test pad
TP402: test pad; TestPoint_Pad_D1.5mm; MPN test pad
U401: TPS2553DBVR-1; SOT-23-6; MPN TPS2553DBVR-1; LCSC C111738
U402: INA226AIDGSR; TSSOP-10_3x3mm_P0.5mm; MPN INA226AIDGSR; LCSC C49851
U403: USBLC6-2SC6; SOT-23-6; MPN USBLC6-2SC6; LCSC C7519
U405, U406, U408, U409: H5VU25UC; DFN2510-10L_2.5x1.0mm_P0.5mm; MPN H5VU25UC; LCSC C20615800
U407: LSF0108RKSR; DHVQFN-20-1EP_2.5x4.5mm_P0.5mm_EP1x3mm; MPN LSF0108RKSR; LCSC C130008

Connections:
+3V3: C403.1, R403.1, R409.1, R410.1, U402.1 (A1), U402.2 (A0), U402.6 (VS); also elsewhere on the board
+5V: C401.1, C404.1, U401.1 (IN), U403.5 (VBUS); also elsewhere on the board
+5V_MX: R411.1; also elsewhere on the board
/Port 4/CP_VREF4: R412.2, R413.1, R415.1
/Port 4/PORT4_5V_SW: R406.1, R414.1, U401.6 (OUT)
/Port 4/PORT4_A1: RN401.7 (R2.2), U407.4 (A2)
/Port 4/PORT4_A2: RN401.5 (R4.2), U407.6 (A4)
/Port 4/PORT4_A3: RN402.7 (R2.2), U407.8 (A6)
/Port 4/PORT4_A4: RN402.5 (R4.2), U407.10 (A8)
/Port 4/PORT4_A5: RN401.8 (R1.2), U407.3 (A1)
/Port 4/PORT4_A6: RN401.6 (R3.2), U407.5 (A3)
/Port 4/PORT4_A7: RN402.8 (R1.2), U407.7 (A5)
/Port 4/PORT4_A8: RN402.6 (R3.2), U407.9 (A7)
/Port 4/PORT4_BOOT_N: J402.12, R408.2, U409.2 (D1-), U409.9 (NC)
/Port 4/PORT4_CC1: J401.A5 (CC1), R404.2
/Port 4/PORT4_CC2: J401.B5 (CC2), R405.2
/Port 4/PORT4_CONN_DN: J401.A7 (D-), J401.B7 (D-), U403.1 (I/O1)
/Port 4/PORT4_CONN_DP: J401.A6 (D+), J401.B6 (D+), U403.3 (I/O2)
/Port 4/PORT4_ILIM: R401.1, U401.5 (ILIM)
/Port 4/PORT4_LED_A: D401.2 (A), R414.2
/Port 4/PORT4_P1: J402.4, RN401.2 (R2.1), U405.2 (D1-), U405.9 (NC)
/Port 4/PORT4_P2: J402.6, RN401.4 (R4.1), U405.5 (D2-), U405.6 (NC)
/Port 4/PORT4_P3: J402.8, RN402.2 (R2.1), U406.2 (D1-), U406.9 (NC)
/Port 4/PORT4_P4: J402.10, RN402.4 (R4.1), U406.5 (D2-), U406.6 (NC)
/Port 4/PORT4_P5: J402.3, RN401.1 (R1.1), U405.1 (D1+), U405.10 (NC)
/Port 4/PORT4_P6: J402.5, RN401.3 (R3.1), U405.4 (D2+), U405.7 (NC)
/Port 4/PORT4_P7: J402.7, RN402.1 (R1.1), U406.1 (D1+), U406.10 (NC)
/Port 4/PORT4_P8: J402.9, RN402.3 (R3.1), U406.4 (D2+), U406.7 (NC)
/Port 4/PORT4_RST_N: J402.11, R407.2, U409.5 (D2-), U409.6 (NC)
/Port 4/PORT4_SNS_N: R406.3, U402.8 (Vbus), U402.9 (Vin-)
/Port 4/PORT4_SNS_P: R406.2, U402.10 (Vin+)
/Port 4/PORT4_VBUS: C402.1, J401.A4 (VBUS), J401.A9 (VBUS), J401.B4 (VBUS), J401.B9 (VBUS), R404.1, R405.1, R406.4, TP402.1
/Port 4/PORT4_VREF: J402.2, R412.1, U407.2 (RefA), U408.5 (D2-), U408.6 (NC)
/Port 4/PORT4_VREFB: C405.1, R411.2, U407.19 (RefB), U407.20 (EN)
CP_ADC4: R415.2; also elsewhere on the board
GND: C401.2, C402.2, C403.2, C404.2, C405.2, D401.1 (K), J401.A1 (GND), J401.A12 (GND), J401.B1 (GND), J401.B12 (GND), J401.SH (SHIELD), J402.1, R401.2, R402.2, R413.2, U401.2 (GND), U402.7 (GND), U403.2 (GND), U405.3 (GND), U405.8 (GND), U406.3 (GND), U406.8 (GND), U407.1 (GND), U407.21 (EPAD), U408.3 (GND), U408.8 (GND), U409.3 (GND), U409.8 (GND); also elsewhere on the board
PORT4_B1: U407.17 (B2); also elsewhere on the board
PORT4_B2: U407.15 (B4); also elsewhere on the board
PORT4_B3: U407.13 (B6); also elsewhere on the board
PORT4_B4: U407.11 (B8); also elsewhere on the board
PORT4_B5: U407.18 (B1); also elsewhere on the board
PORT4_B6: U407.16 (B3); also elsewhere on the board
PORT4_B7: U407.14 (B5); also elsewhere on the board
PORT4_B8: U407.12 (B7); also elsewhere on the board
PORT4_BOOT_IO: R408.1, R410.2; also elsewhere on the board
PORT4_DN: U403.6 (I/O1); also elsewhere on the board
PORT4_DP: U403.4 (I/O2); also elsewhere on the board
PORT4_EN: R402.1, U401.3 (EN); also elsewhere on the board
PORT4_FLT_N: R403.2, TP401.1, U401.4 (~FAULT); also elsewhere on the board
PORT4_RST_IO: R407.1, R409.2; also elsewhere on the board
SCL: U402.5 (SCL); also elsewhere on the board
SDA: U402.4 (SDA); also elsewhere on the board

Notes on the sheet:
Port 4 power: +5V → TPS2553-1 → PORT4_5V_SW → 100 mΩ shunt → PORT4_VBUS, the INA226 across the shunt
Bring-up test points on the rear face (B.Cu): FAULT_N, VBUS
USB-C 4 (source): Rp 56k on each CC; USBLC6 in flow-through (connector side | hub side)
Header 4 (2 × 6 through-hole): GND, VREF, P1–P8, RESET_N, BOOT_N; RESET/BOOT through 1k, their expander lines pulled up
ESD on the header's VREF (U408, in flow-through: header → ESD → LSF0108 and divider) and on RESET_N / BOOT_N (U409: header → ESD → 1k)
Pins 4: ESD in flow-through, 100 Ω, LSF0108 (A = the DUT's VREF, B = 3.3 V) to crosspoint U8's X lines
Port 4 = sub-slot A1.4, hub port 4, busid 1-1.4. INA226 at 0x45; expander U6 (0x21). ILIM 45.3k: 524 / 577 / 638 mA min / typ / max (TI SLVS841G §8.5.1 eq. 1–3), 519–644 mA with the resistor's 1 %; the -1 latches off after 7.5 ms in limit, FAULT_N flags it. INA226 Vbus on the shunt's load-side sens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
