kartben/hw-testing-rack/electronics/data-port-x4/data-port-x4.kicad_pcb

## KiCad design electronics/data-port-x4/data-port-x4.kicad_pcb (continued)

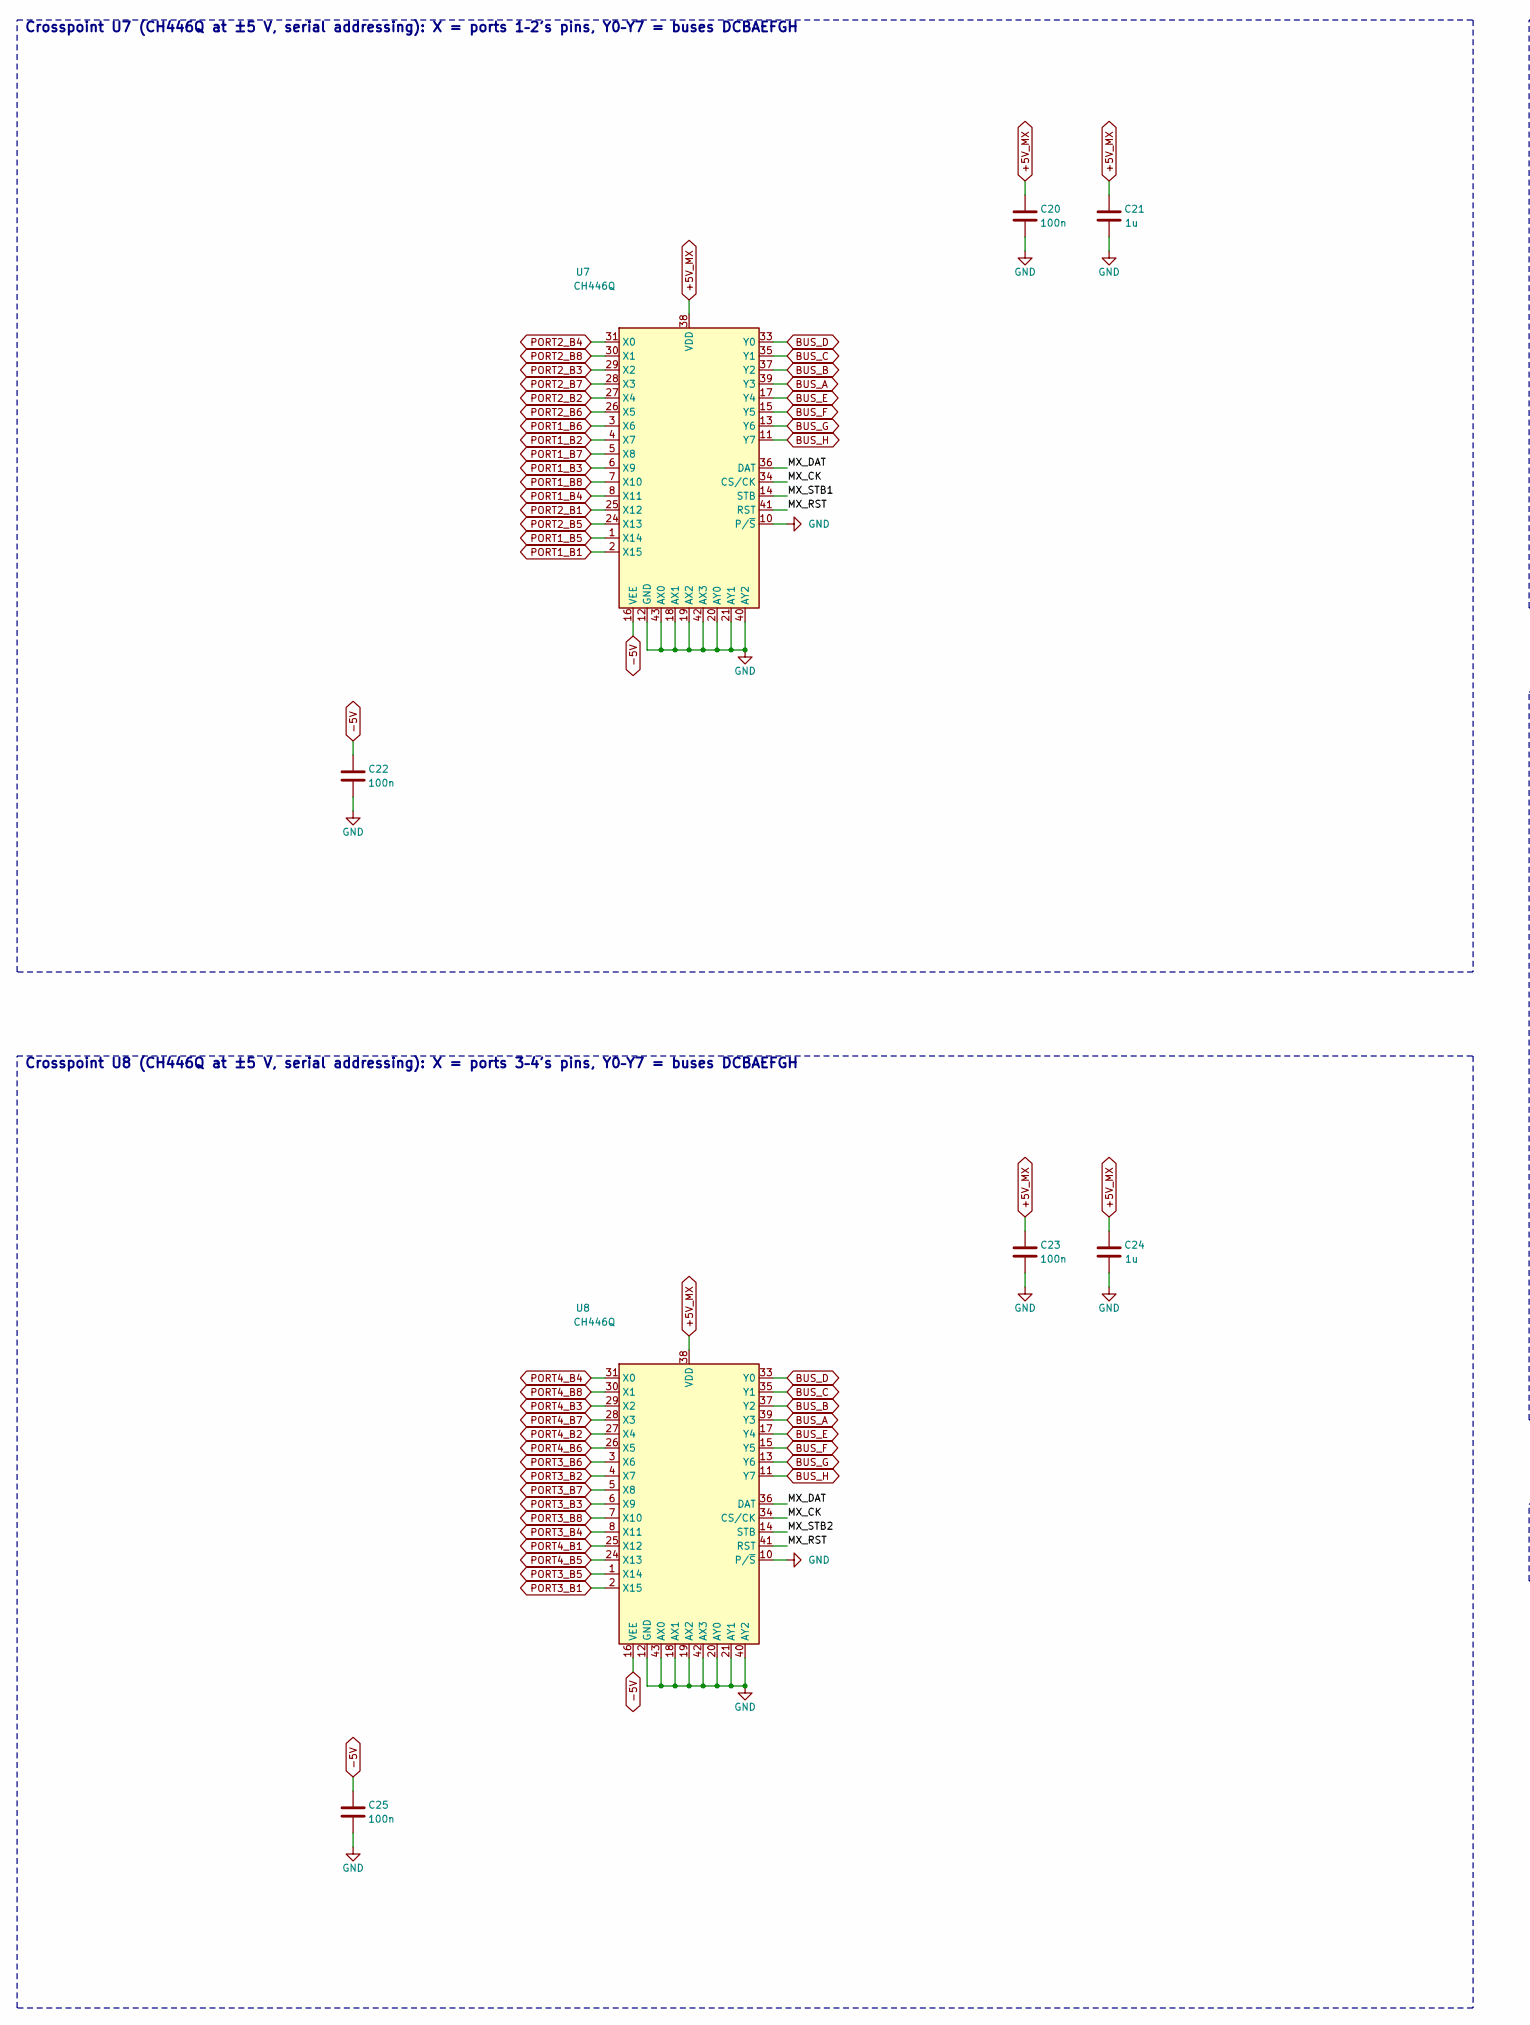
[picture p219: schematic matrix.kicad_sch, DATA ×4 v2 — Crosspoints, −5 V, the node's matrix expander, part in row 1, column 1]

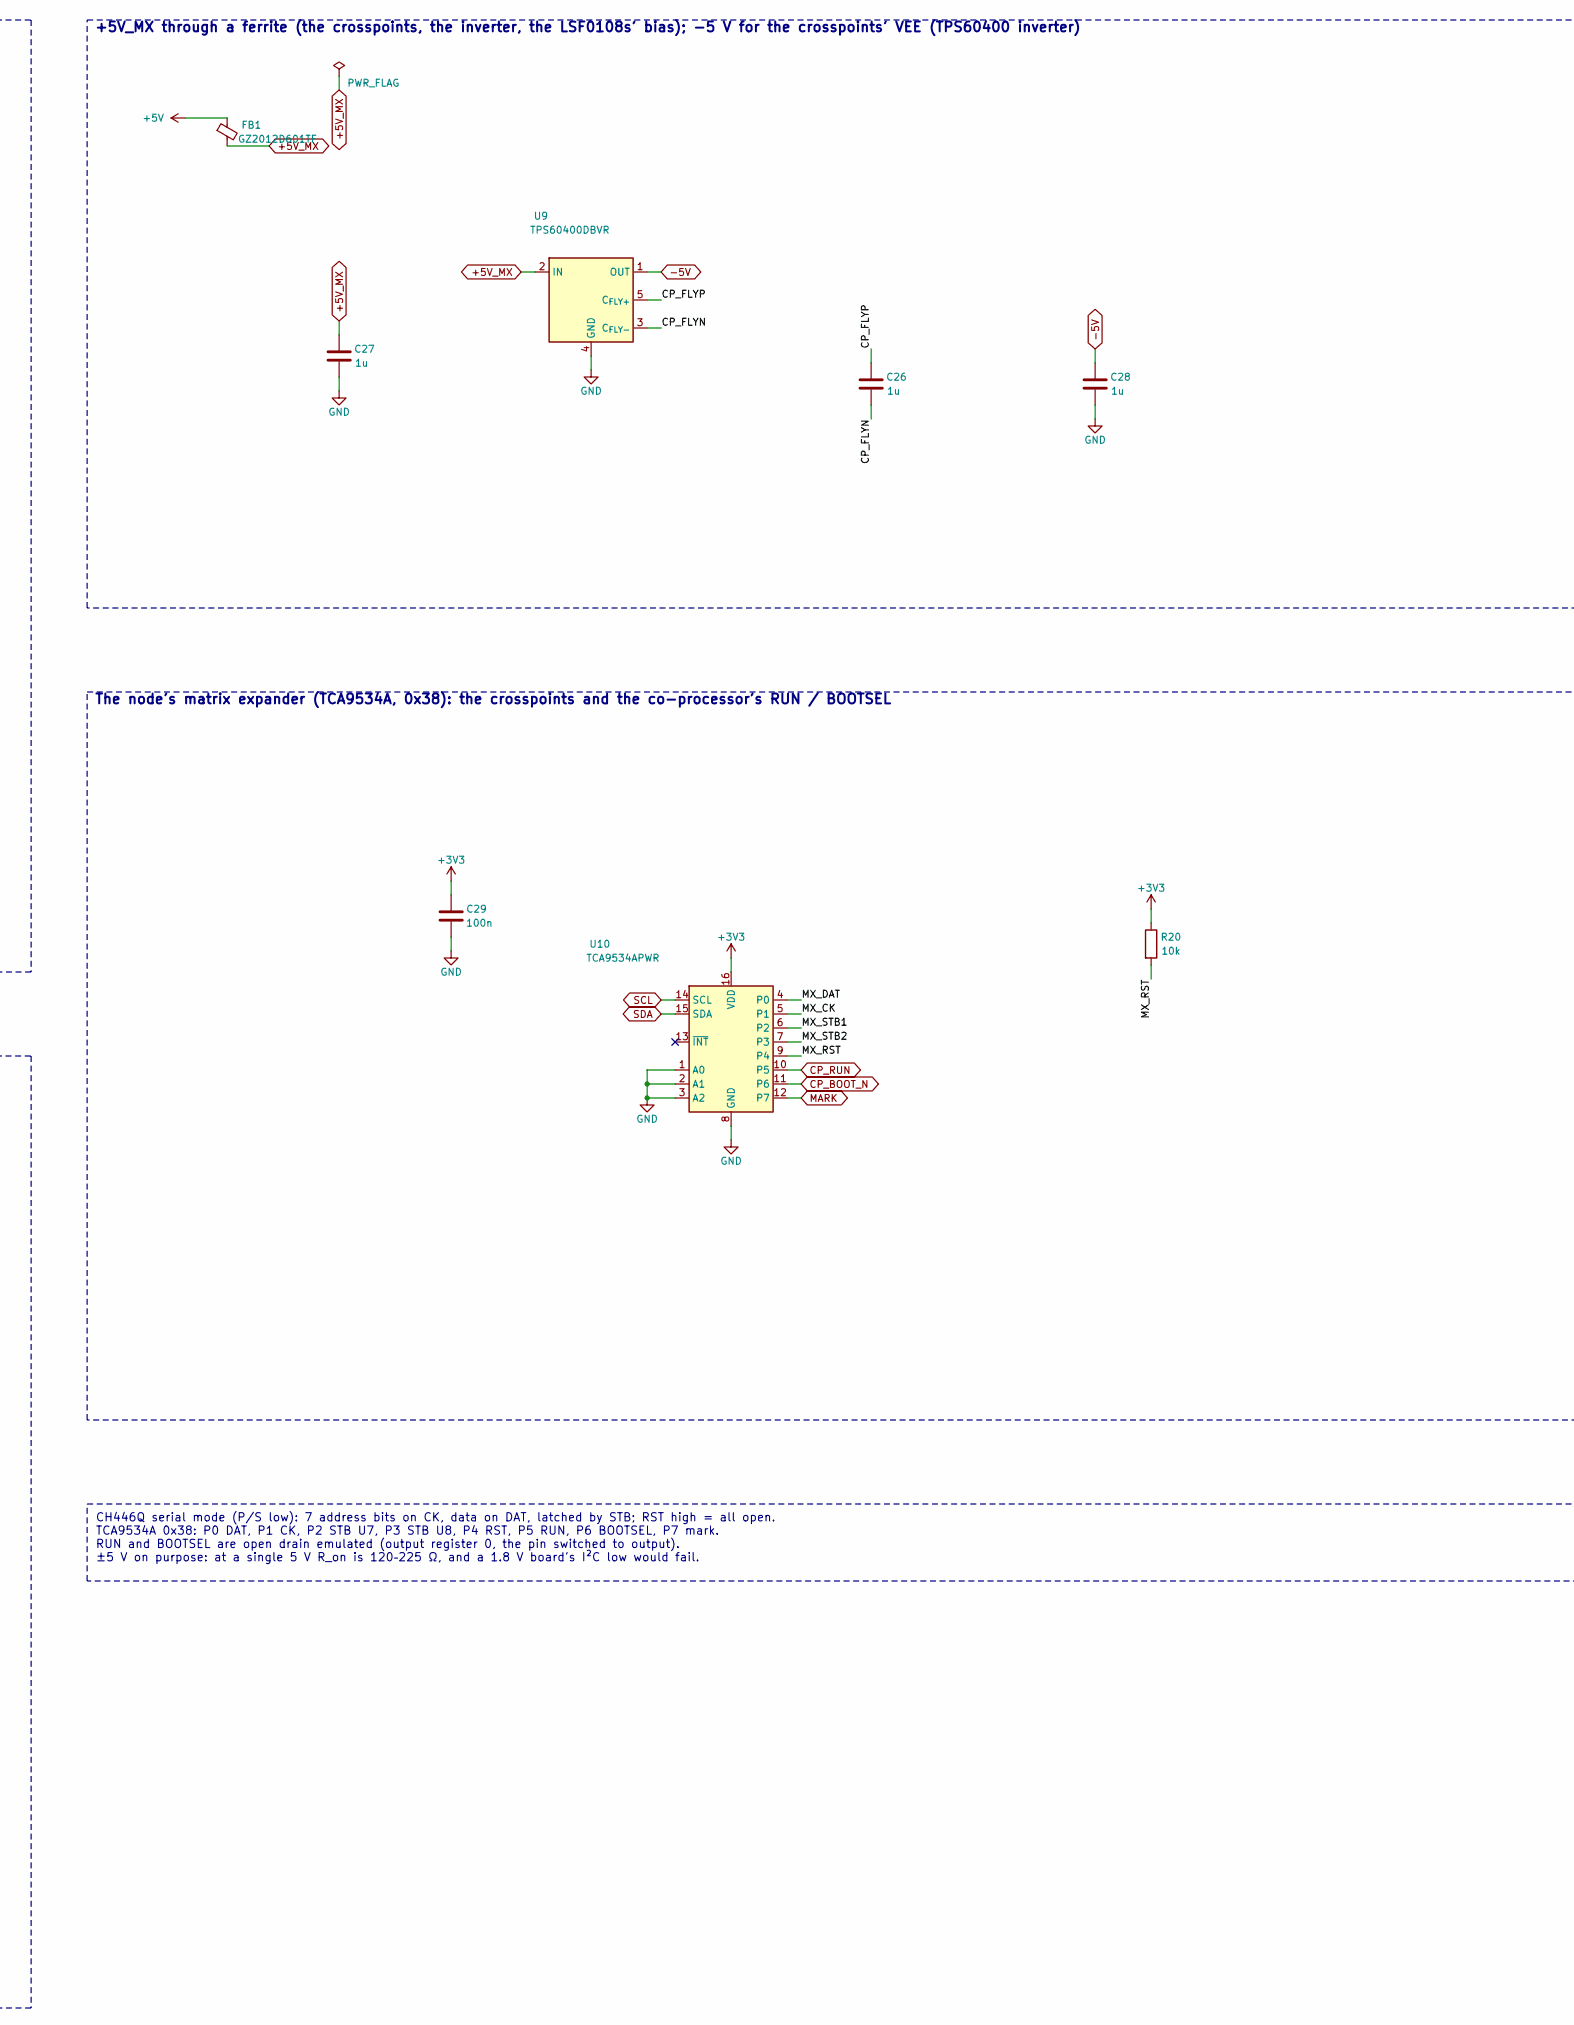
[picture p220: schematic matrix.kicad_sch, DATA ×4 v2 — Crosspoints, −5 V, the node's matrix expander, part in row 1, column 2]

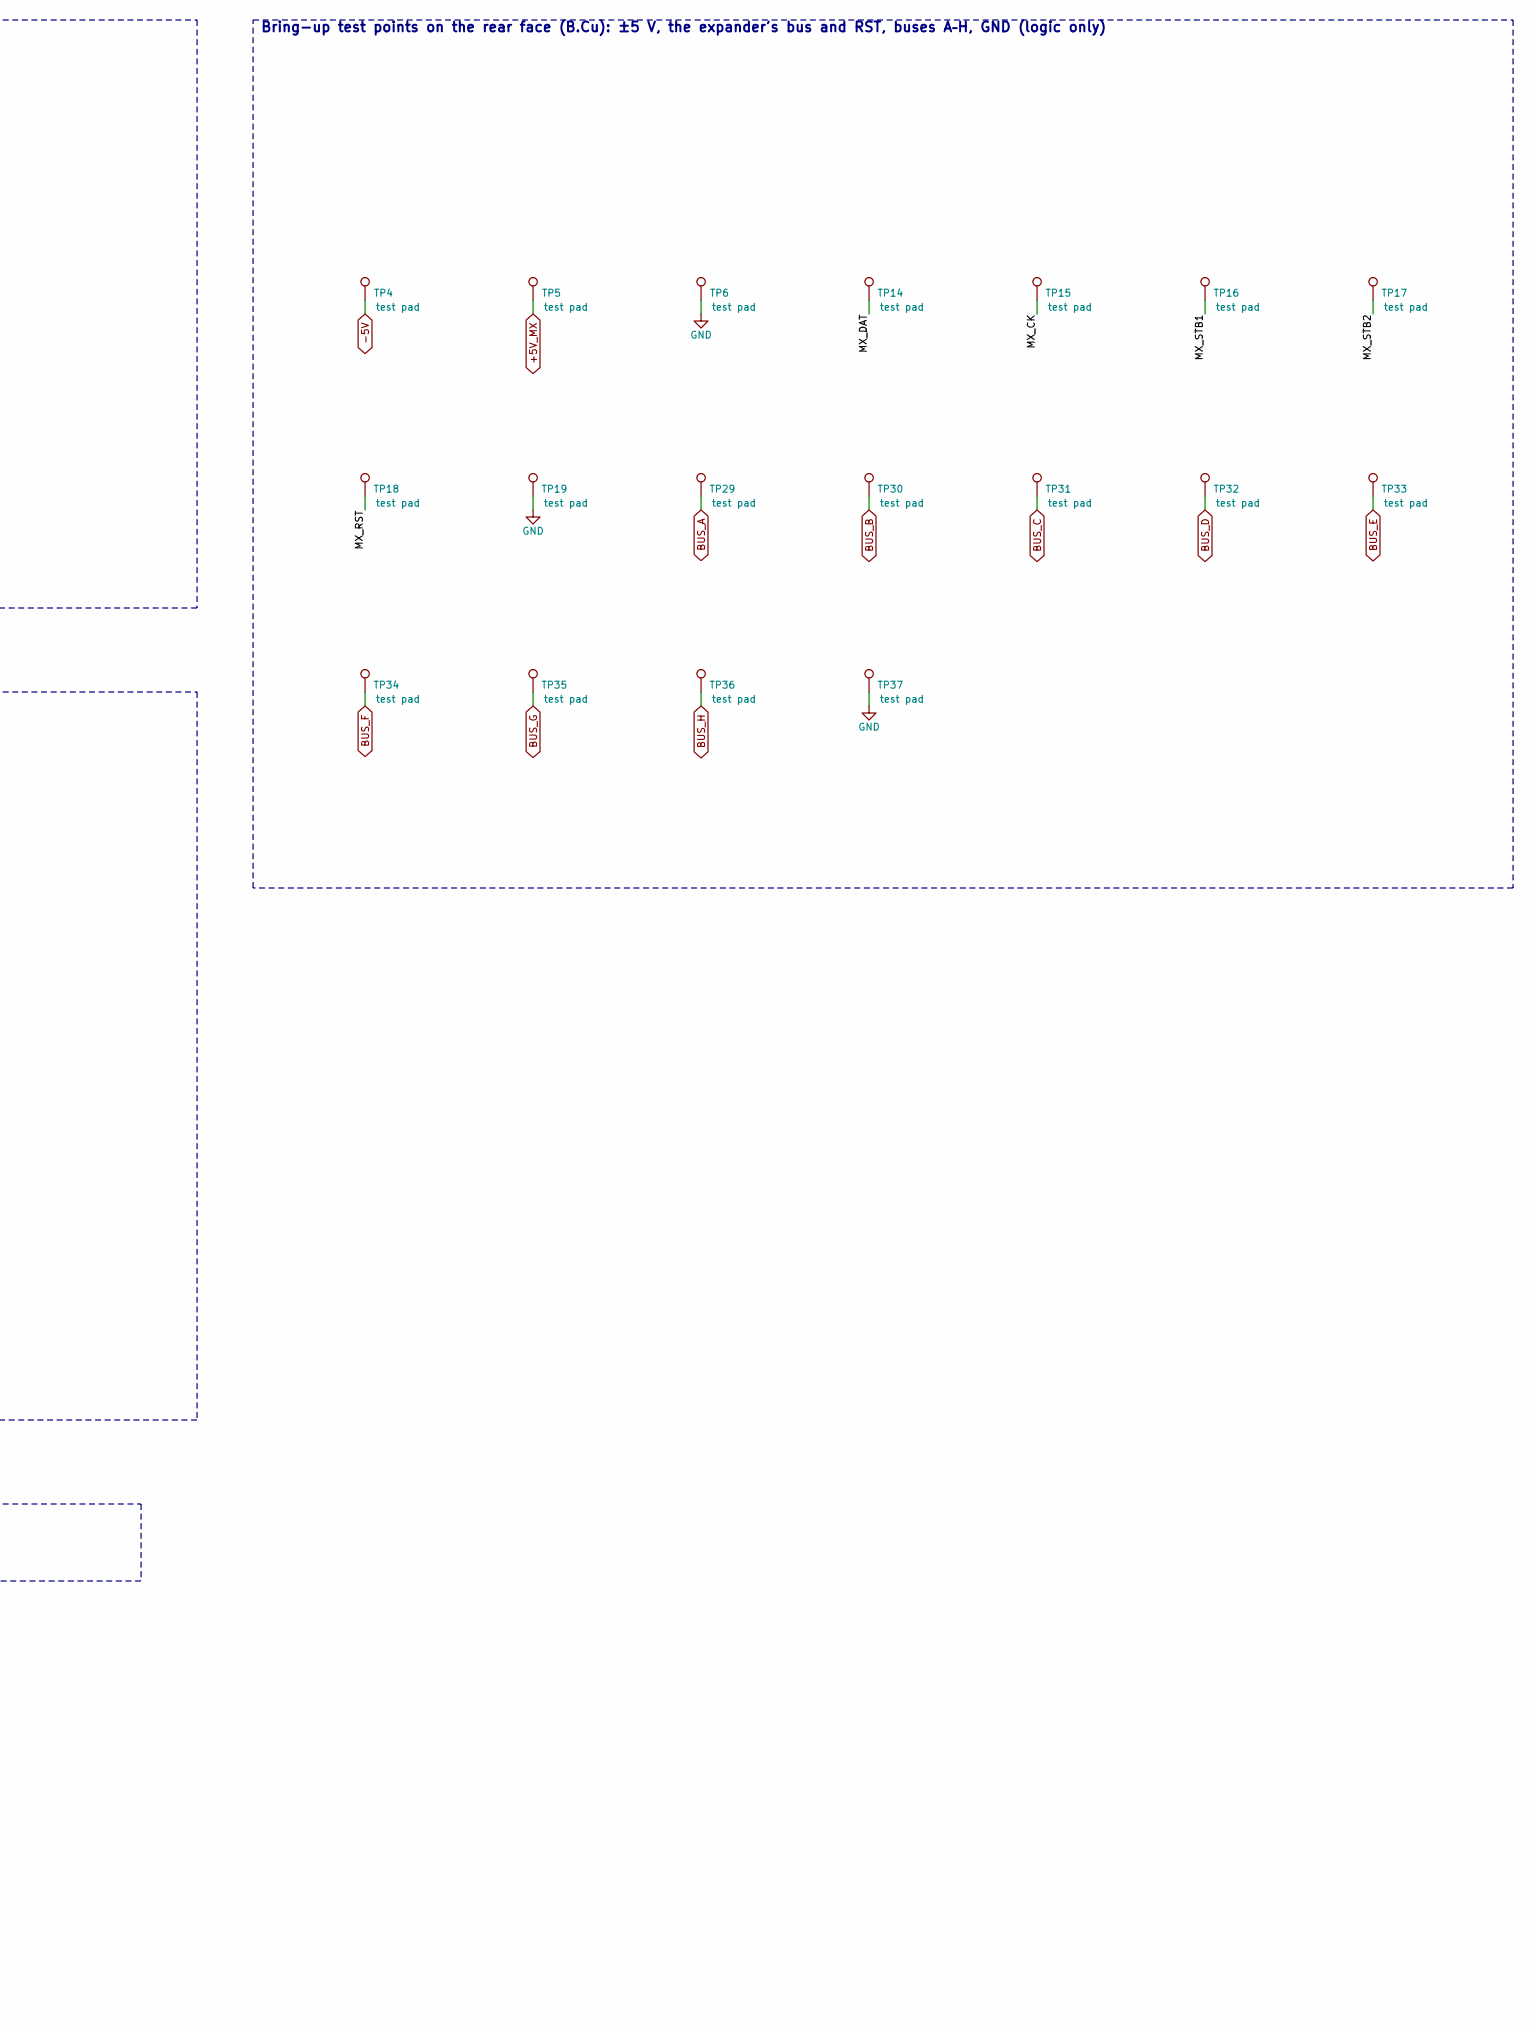
[picture p221: schematic matrix.kicad_sch, DATA ×4 v2 — Crosspoints, −5 V, the node's matrix expander, part in row 1, column 3]

Parts:
C20, C22, C23, C25, C29: 100n; C_0402_1005Metric; MPN CL05B104KO5NNNC; LCSC C1525
C21, C24, C26, C27, C28: 1u; C_0402_1005Metric; MPN CL05A105KA5NQNC; LCSC C52923
FB1: GZ2012D601TF; L_0805_2012Metric; MPN GZ2012D601TF; LCSC C1017
R20: 10k; R_0402_1005Metric; MPN 0402WGF1002TCE; LCSC C25744
TP4, TP5, TP6, TP19, TP37: test pad; TestPoint_Pad_D1.5mm; MPN test pad
TP14, TP15, TP16, TP17, TP18, TP29, TP30, TP31, TP32, TP33, TP34, TP35, TP36: test pad; TestPoint_Pad_D1.0mm; MPN test pad
U7, U8: CH446Q; LQFP-44_10x10mm_P0.8mm; MPN CH446Q; LCSC C109471
U9: TPS60400DBVR; SOT-23-5; MPN TPS60400DBVR; LCSC C9839
U10: TCA9534APWR; TSSOP-16_4.4x5mm_P0.65mm; MPN TCA9534APWR; LCSC C206010

Connections:
+3V3: C29.1, R20.1, U10.16 (VDD); also elsewhere on the board
+5V: FB1.1; also elsewhere on the board
+5V_MX: C20.1, C21.1, C23.1, C24.1, C27.1, FB1.2, TP5.1, U7.38 (VDD), U8.38 (VDD), U9.2 (IN); also elsewhere on the board
-5V: C22.1, C25.1, C28.1, TP4.1, U7.16 (VEE), U8.16 (VEE), U9.1 (OUT); also elsewhere on the board
/Matrix/CP_FLYN: C26.2, U9.3 (C_{FLY-})
/Matrix/CP_FLYP: C26.1, U9.5 (C_{FLY+})
/Matrix/MX_CK: TP15.1, U7.34 (CS/CK), U8.34 (CS/CK), U10.5 (P1)
/Matrix/MX_DAT: TP14.1, U7.36 (DAT), U8.36 (DAT), U10.4 (P0)
/Matrix/MX_RST: R20.2, TP18.1, U7.41 (RST), U8.41 (RST), U10.9 (P4)
/Matrix/MX_STB1: TP16.1, U7.14 (STB), U10.6 (P2)
/Matrix/MX_STB2: TP17.1, U8.14 (STB), U10.7 (P3)
BUS_A: TP29.1, U7.39 (Y3), U8.39 (Y3); also elsewhere on the board
BUS_B: TP30.1, U7.37 (Y2), U8.37 (Y2); also elsewhere on the board
BUS_C: TP31.1, U7.35 (Y1), U8.35 (Y1); also elsewhere on the board
BUS_D: TP32.1, U7.33 (Y0), U8.33 (Y0); also elsewhere on the board
BUS_E: TP33.1, U7.17 (Y4), U8.17 (Y4); also elsewhere on the board
BUS_F: TP34.1, U7.15 (Y5), U8.15 (Y5); also elsewhere on the board
BUS_G: TP35.1, U7.13 (Y6), U8.13 (Y6); also elsewhere on the board
BUS_H: TP36.1, U7.11 (Y7), U8.11 (Y7); also elsewhere on the board
CP_BOOT_N: U10.11 (P6); also elsewhere on the board
CP_RUN: U10.10 (P5); also elsewhere on the board
GND: C20.2, C21.2, C22.2, C23.2, C24.2, C25.2, C27.2, C28.2, C29.2, TP6.1, TP19.1, TP37.1, U7.10 (P/~S), U7.12 (GND), U7.18 (AX1), U7.19 (AX2), U7.20 (AY0), U7.21 (AY1), U7.40 (AY2), U7.42 (AX3), U7.43 (AX0), U8.10 (P/~S), U8.12 (GND), U8.18 (AX1), U8.19 (AX2), U8.20 (AY0), U8.21 (AY1), U8.40 (AY2), U8.42 (AX3), U8.43 (AX0), U9.4 (GND), U10.1 (A0), U10.2 (A1), U10.3 (A2), U10.8 (GND); also elsewhere on the board
MARK: U10.12 (P7); also elsewhere on the board
PORT1_B1: U7.2 (X15); also elsewhere on the board
PORT1_B2: U7.4 (X7); also elsewhere on the board
PORT1_B3: U7.6 (X9); also elsewhere on the board
PORT1_B4: U7.8 (X11); also elsewhere on the board
PORT1_B5: U7.1 (X14); also elsewhere on the board
PORT1_B6: U7.3 (X6); also elsewhere on the board
PORT1_B7: U7.5 (X8); also elsewhere on the board
PORT1_B8: U7.7 (X10); also elsewhere on the board
PORT2_B1: U7.25 (X12); also elsewhere on the board
PORT2_B2: U7.27 (X4); also elsewhere on the board
PORT2_B3: U7.29 (X2); also elsewhere on the board
PORT2_B4: U7.31 (X0); also elsewhere on the board
PORT2_B5: U7.24 (X13); also elsewhere on the board
PORT2_B6: U7.26 (X5); also elsewhere on the board
PORT2_B7: U7.28 (X3); also elsewhere on the board
PORT2_B8: U7.30 (X1); also elsewhere on the board
PORT3_B1: U8.2 (X15); also elsewhere on the board
PORT3_B2: U8.4 (X7); also elsewhere on the board
PORT3_B3: U8.6 (X9); also elsewhere on the board
PORT3_B4: U8.8 (X11); also elsewhere on the board
PORT3_B5: U8.1 (X14); also elsewhere on the board
PORT3_B6: U8.3 (X6); also elsewhere on the board
PORT3_B7: U8.5 (X8); also elsewhere on the board
PORT3_B8: U8.7 (X10); also elsewhere on the board
PORT4_B1: U8.25 (X12); also elsewhere on the board
PORT4_B2: U8.27 (X4); also elsewhere on the board
PORT4_B3: U8.29 (X2); also elsewhere on the board
PORT4_B4: U8.31 (X0); also elsewhere on the board
PORT4_B5: U8.24 (X13); also elsewhere on the board
PORT4_B6: U8.26 (X5); also elsewhere on the board
PORT4_B7: U8.28 (X3); also elsewhere on the board
PORT4_B8: U8.30 (X1); also elsewhere on the board
SCL: U10.14 (SCL); also elsewhere on the board
SDA: U10.15 (SDA); also elsewhere on the board

Notes on the sheet:
Crosspoint U7 (CH446Q at ±5 V, serial addressing): X = ports 1–2's pins, Y0–Y7 = buses DCBAEFGH
Crosspoint U8 (CH446Q at ±5 V, serial addressing): X = ports 3–4's pins, Y0–Y7 = buses DCBAEFGH
+5V_MX through a ferrite (the crosspoints, the inverter, the LSF0108s' bias); −5 V for the crosspoints' VEE (TPS60400 inverter)
The node's matrix expander (TCA9534A, 0x38): the crosspoints and the co-processor's RUN / BOOTSEL
Bring-up test points on the rear face (B.Cu): ±5 V, the expander's bus and RST, buses A–H, GND (logic only)
CH446Q serial mode (P/S low): 7 address bits on CK, data on DAT, latched by STB; RST high = all open. TCA9534A 0x38: P0 DAT, P1 CK, P2 STB U7, P3 STB U8, P4 RST, P5 RUN, P6 BOOTSEL, P7 mark. RUN and BOOTSEL are open drain emulated (output register 0, the pin switched to output). ±5 V on purpose: at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
