kartben/hw-testing-rack/electronics/data-port-x4/data-port-x4.kicad_pcb

## KiCad design electronics/data-port-x4/data-port-x4.kicad_pcb (continued)

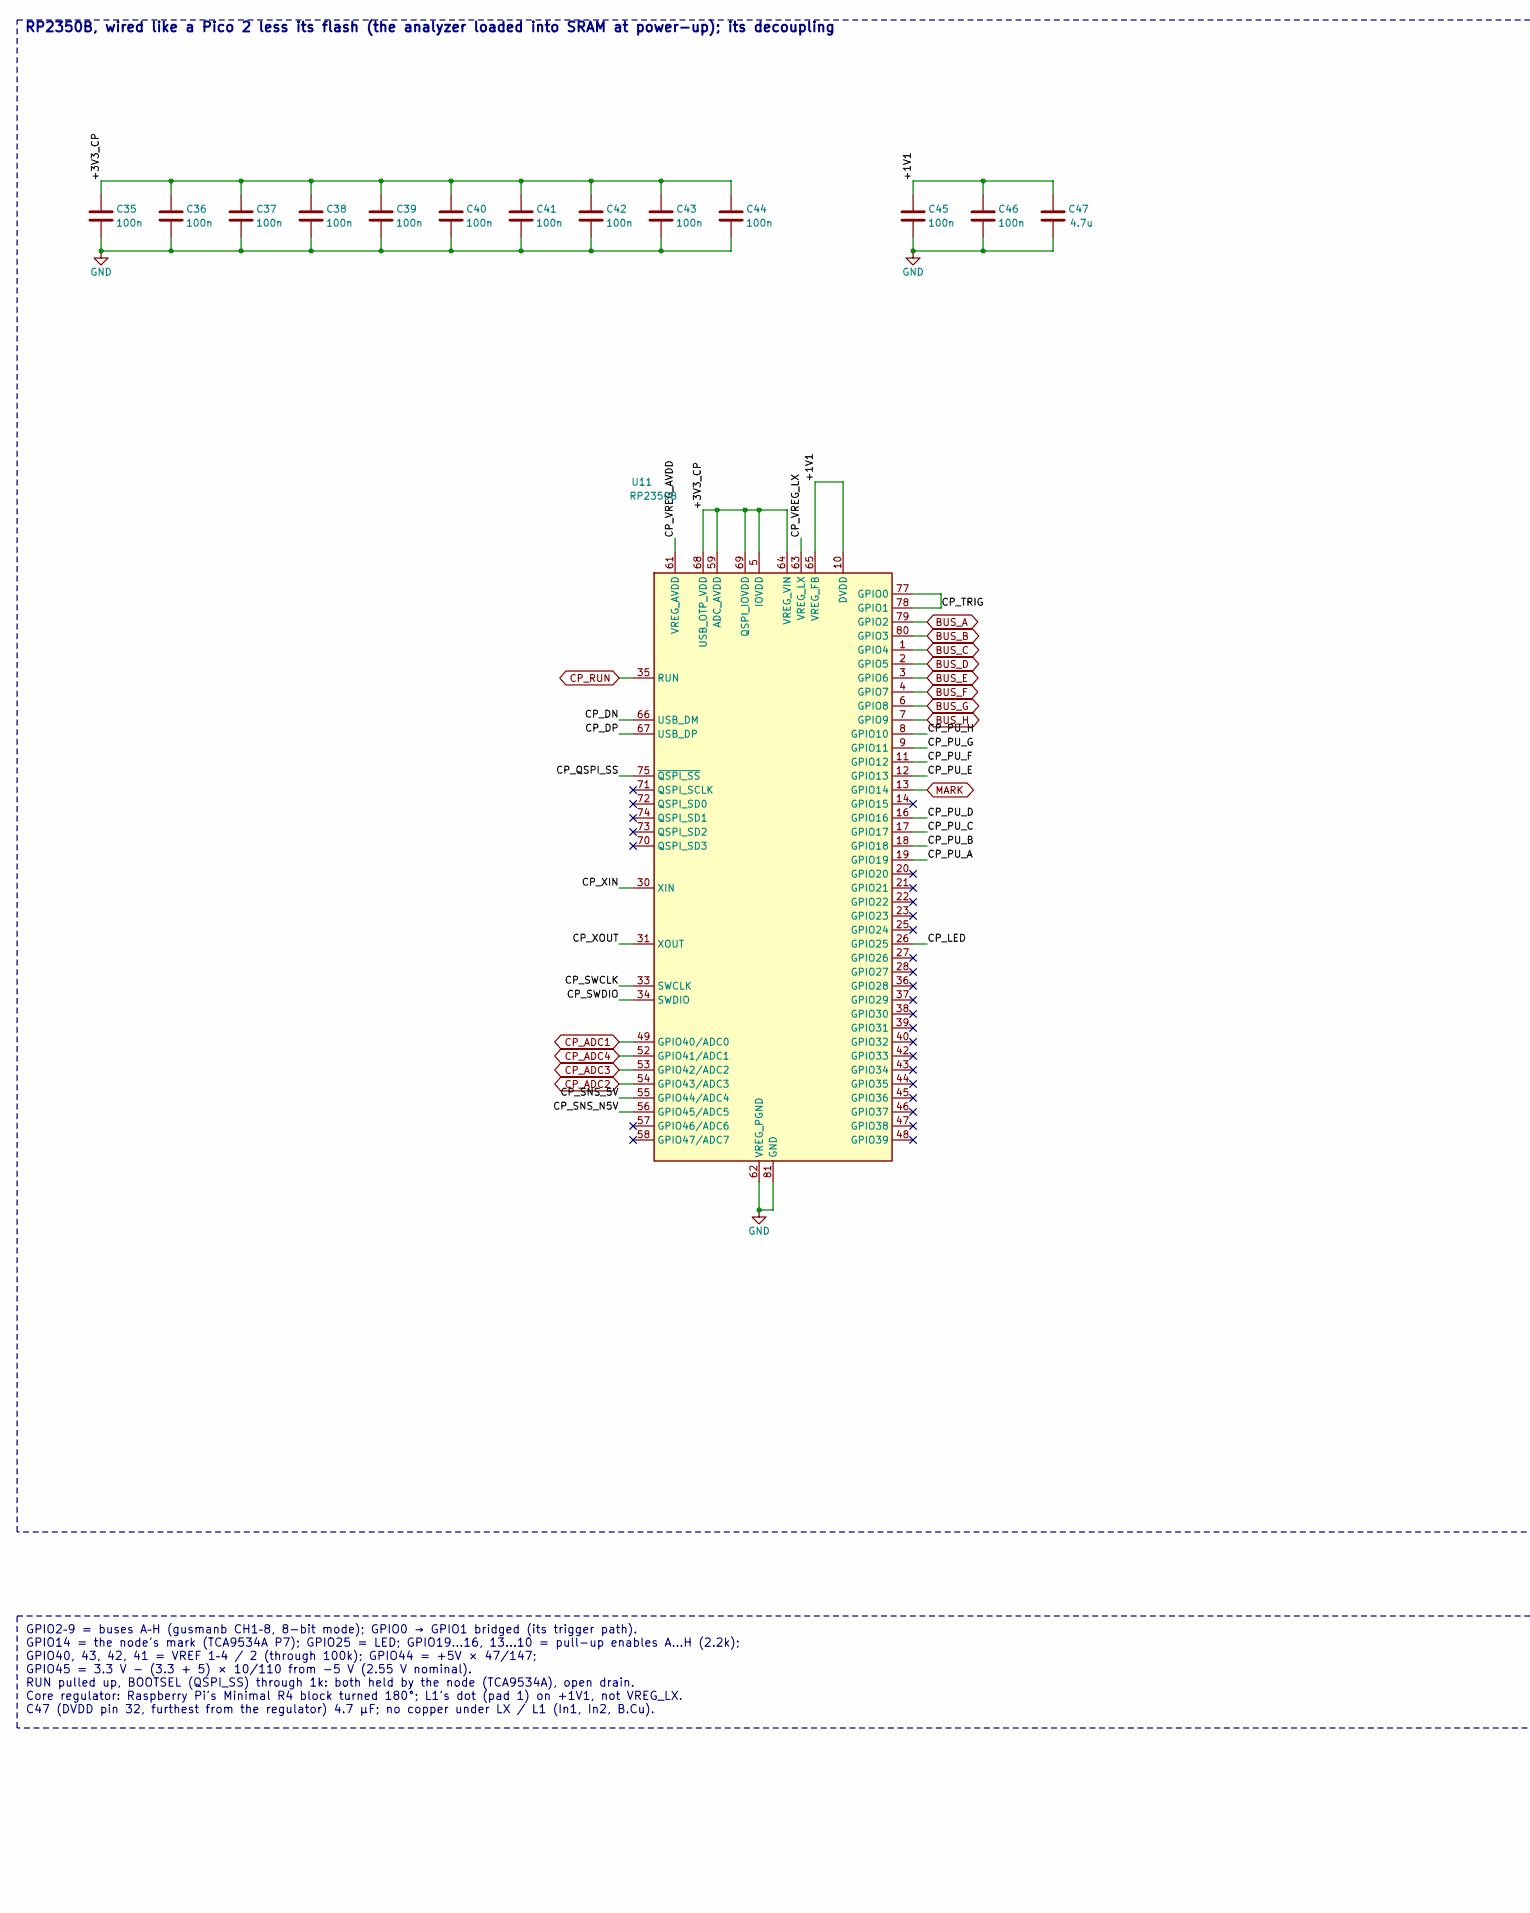
[picture p222: schematic coproc.kicad_sch, DATA ×4 v2 — RP2350B analyzer / co-processor on hub port 5, part in row 1, column 1]

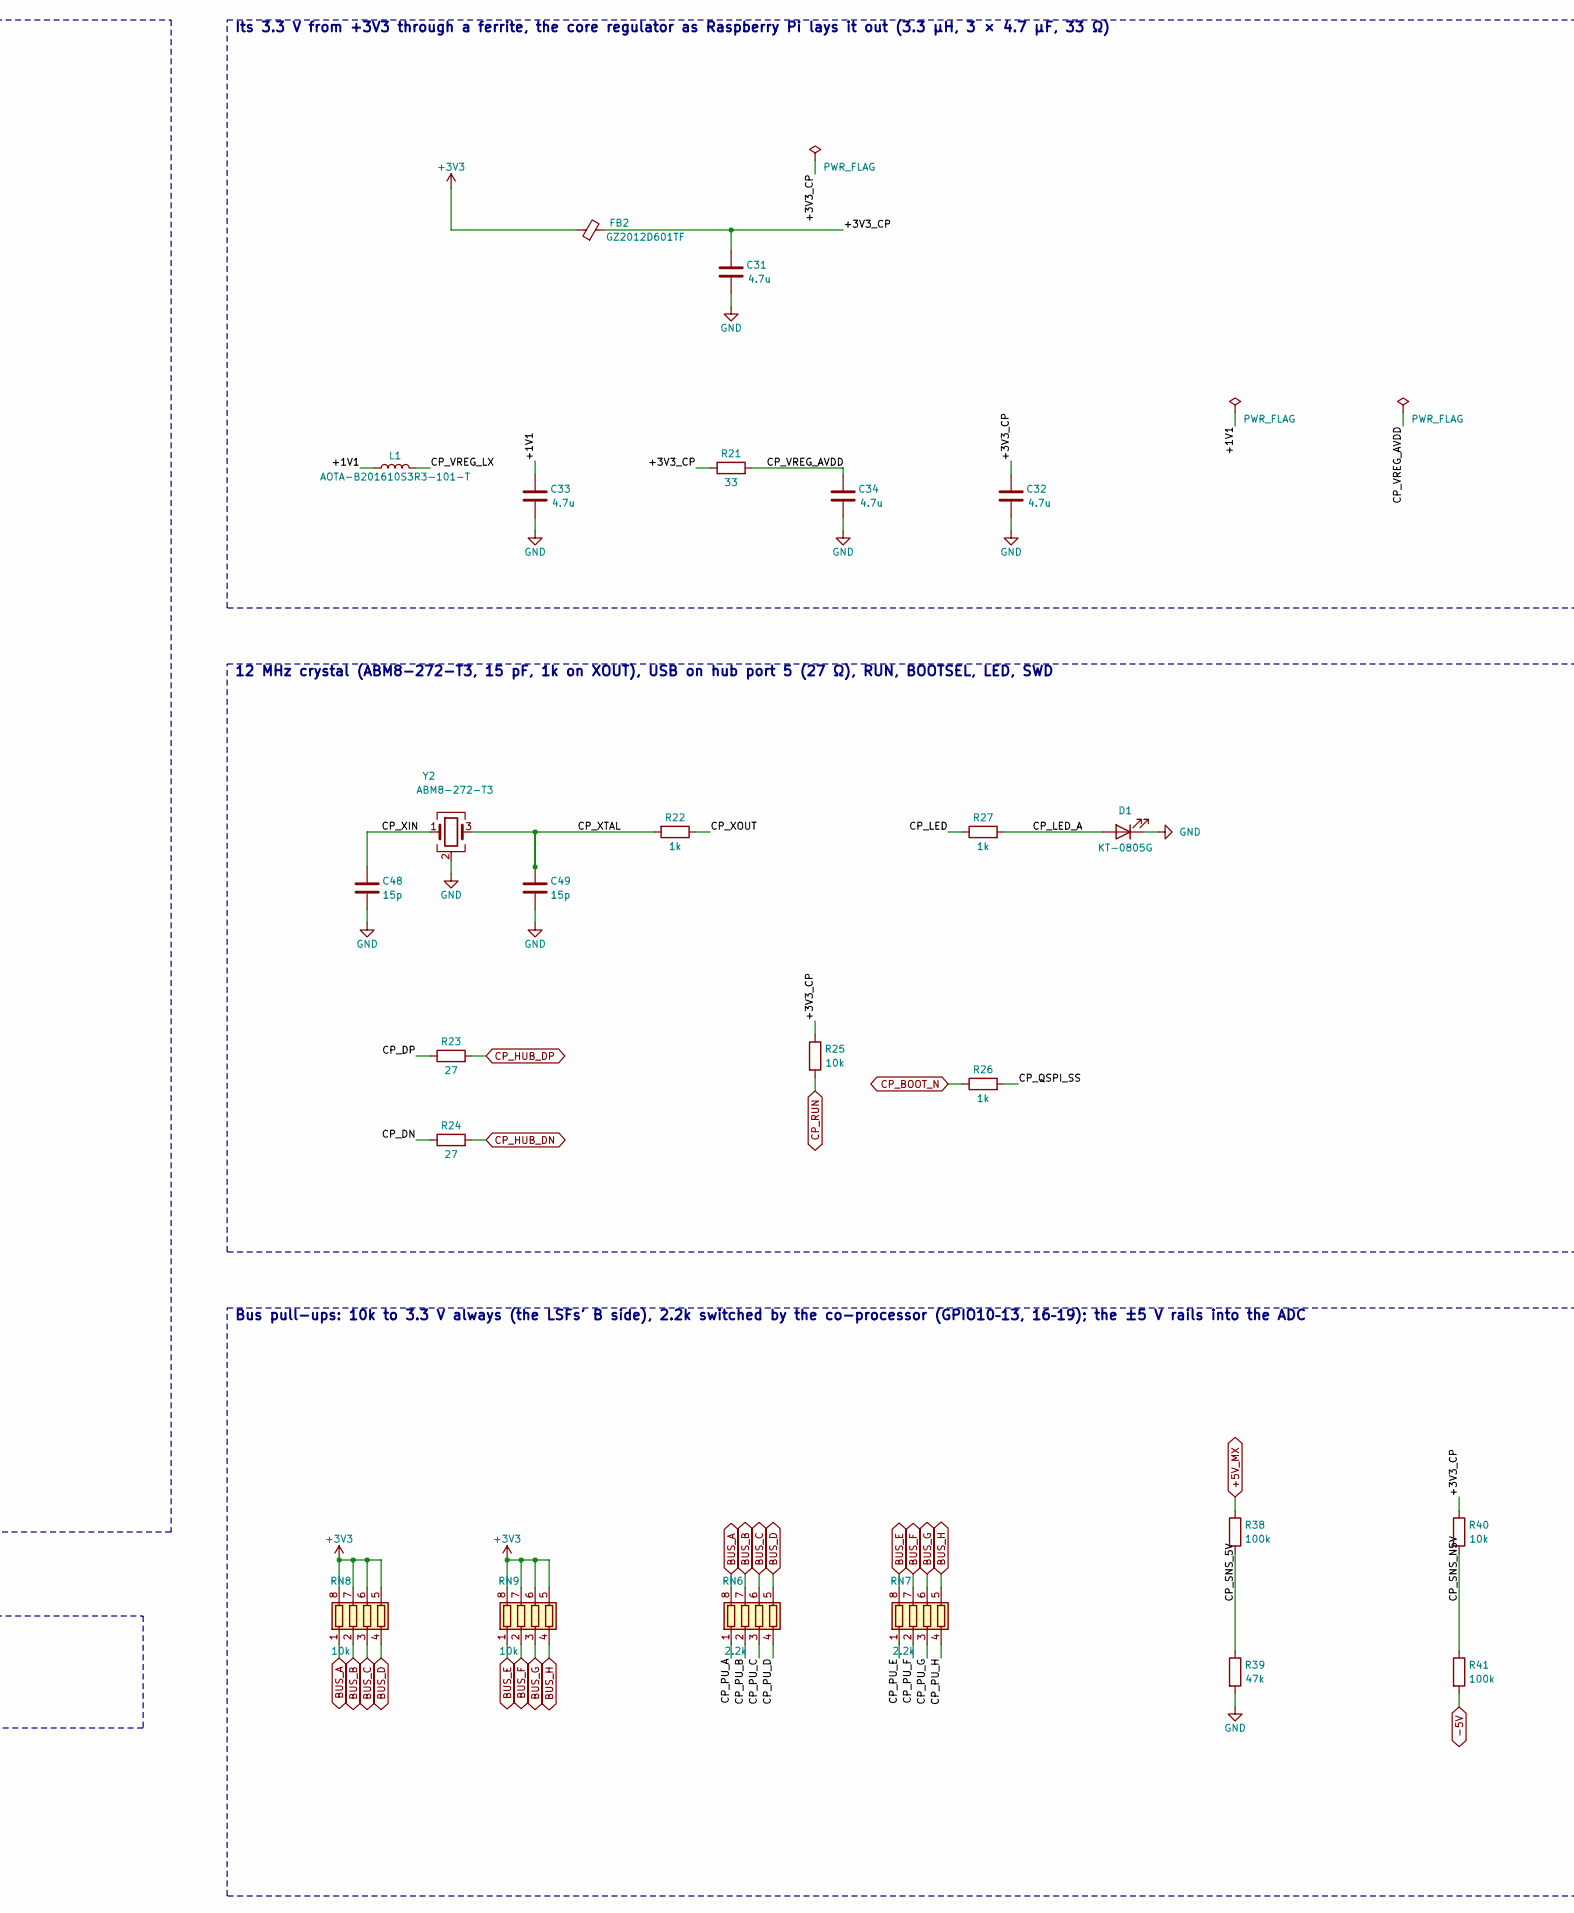
[picture p223: schematic coproc.kicad_sch, DATA ×4 v2 — RP2350B analyzer / co-processor on hub port 5, part in row 1, column 2]

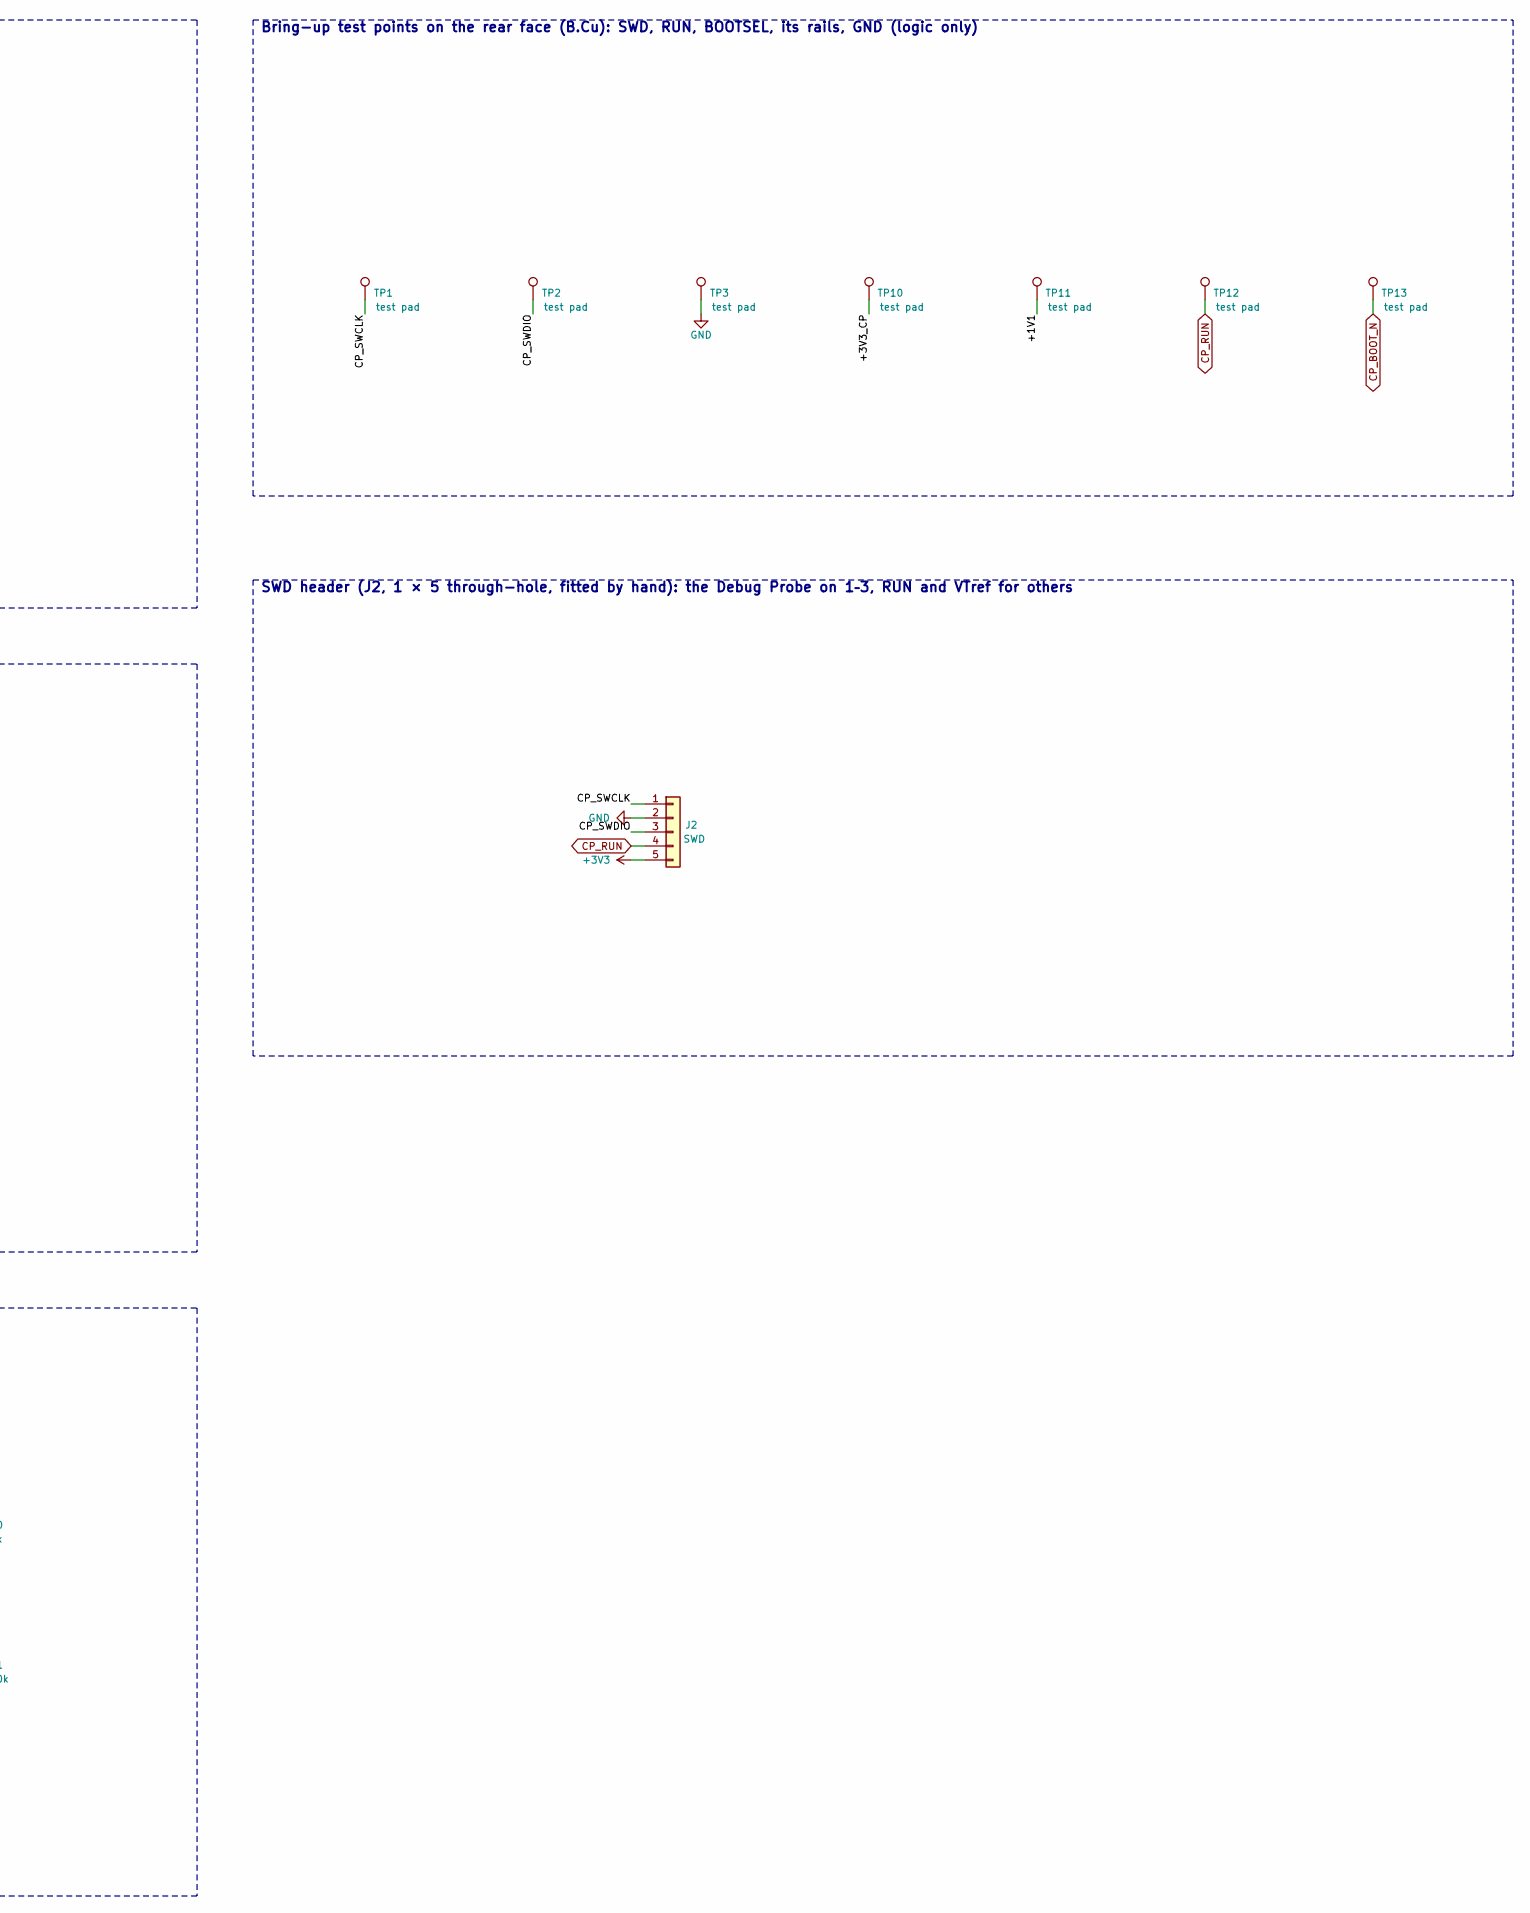
[picture p224: schematic coproc.kicad_sch, DATA ×4 v2 — RP2350B analyzer / co-processor on hub port 5, part in row 1, column 3]

Parts:
C31, C34, C47: 4.7u; C_0402_1005Metric; MPN CL05A475MP5NRNC; LCSC C23733
C32, C33: 4.7u; C_0402_1005Metric_RP; MPN CL05A475MP5NRNC; LCSC C23733
C35, C36, C37, C38, C39, C40, C41, C42, C43, C44, C45, C46: 100n; C_0402_1005Metric; MPN CL05B104KO5NNNC; LCSC C1525
C48, C49: 15p; C_0402_1005Metric; MPN 0402CG150J500NT; LCSC C1548
D1: KT-0805G; LED_0805_2012Metric; MPN KT-0805G; LCSC C2297
FB2: GZ2012D601TF; L_0805_2012Metric; MPN GZ2012D601TF; LCSC C1017
J2: SWD; PinHeader_1x05_P2.54mm_Vertical; MPN HX PZ2.54-1x5P ZZ; LCSC C32713271
L1: AOTA-B201610S3R3-101-T; L_Abracon_AOTA-B201610; MPN AOTA-B201610S3R3-101-T; LCSC C42411119
R21: 33; R_0402_1005Metric; MPN 0402WGF330JTCE; LCSC C25105
R22, R26, R27: 1k; R_0402_1005Metric; MPN 0402WGF1001TCE; LCSC C11702
R23, R24: 27; R_0402_1005Metric; MPN 0402WGF270JTCE; LCSC C25100
R25, R40: 10k; R_0402_1005Metric; MPN 0402WGF1002TCE; LCSC C25744
R38, R41: 100k; R_0402_1005Metric; MPN 0402WGF1003TCE; LCSC C25741
R39: 47k; R_0402_1005Metric; MPN 0402WGF4702TCE; LCSC C25792
RN6, RN7: 2.2k; R_Array_Convex_4x0402; MPN 4D02WGJ0222TCE; LCSC C26075
RN8, RN9: 10k; R_Array_Convex_4x0402; MPN 4D02WGJ0103TCE; LCSC C25725
TP1, TP2, TP12, TP13: test pad; TestPoint_Pad_D1.0mm; MPN test pad
TP3, TP10, TP11: test pad; TestPoint_Pad_D1.5mm; MPN test pad
U11: RP2350B; QFN-80-1EP_10x10mm_P0.4mm_EP3.4x3.4mm; MPN RP2350B; LCSC C42415655
Y2: ABM8-272-T3; Crystal_SMD_3225-4Pin_3.2x2.5mm; MPN ABM8-272-T3; LCSC C20625731

Connections:
+3V3: FB2.1, J2.5, RN8.5 (R4.2), RN8.6 (R3.2), RN8.7 (R2.2), RN8.8 (R1.2), RN9.5 (R4.2), RN9.6 (R3.2), RN9.7 (R2.2), RN9.8 (R1.2); also elsewhere on the board
+5V_MX: R38.1; also elsewhere on the board
-5V: R41.2; also elsewhere on the board
/Co-processor/+1V1: C33.1, C45.1, C46.1, C47.1, L1.1, TP11.1, U11.10 (DVDD), U11.32 (DVDD), U11.51 (DVDD), U11.65 (VREG_FB)
/Co-processor/+3V3_CP: C31.1, C32.1, C35.1, C36.1, C37.1, C38.1, C39.1, C40.1, C41.1, C42.1, C43.1, C44.1, FB2.2, R21.1, R25.1, R40.1, TP10.1, U11.5 (IOVDD), U11.15 (IOVDD), U11.24 (IOVDD), U11.29 (IOVDD), U11.41 (IOVDD), U11.50 (IOVDD), U11.59 (ADC_AVDD), U11.60 (IOVDD), U11.64 (VREG_VIN), U11.68 (USB_OTP_VDD), U11.69 (QSPI_IOVDD), U11.76 (IOVDD)
/Co-processor/CP_DN: R24.1, U11.66 (USB_DM)
/Co-processor/CP_DP: R23.1, U11.67 (USB_DP)
/Co-processor/CP_LED: R27.1, U11.26 (GPIO25)
/Co-processor/CP_LED_A: D1.2 (A), R27.2
/Co-processor/CP_PU_A: RN6.1 (R1.1), U11.19 (GPIO19)
/Co-processor/CP_PU_B: RN6.2 (R2.1), U11.18 (GPIO18)
/Co-processor/CP_PU_C: RN6.3 (R3.1), U11.17 (GPIO17)
/Co-processor/CP_PU_D: RN6.4 (R4.1), U11.16 (GPIO16)
/Co-processor/CP_PU_E: RN7.1 (R1.1), U11.12 (GPIO13)
/Co-processor/CP_PU_F: RN7.2 (R2.1), U11.11 (GPIO12)
/Co-processor/CP_PU_G: RN7.3 (R3.1), U11.9 (GPIO11)
/Co-processor/CP_PU_H: RN7.4 (R4.1), U11.8 (GPIO10)
/Co-processor/CP_QSPI_SS: R26.2, U11.75 (~QSPI_SS)
/Co-processor/CP_SNS_5V: R38.2, R39.1, U11.55 (GPIO44/ADC4)
/Co-processor/CP_SNS_N5V: R40.2, R41.1, U11.56 (GPIO45/ADC5)
/Co-processor/CP_SWCLK: J2.1, TP1.1, U11.33 (SWCLK)
/Co-processor/CP_SWDIO: J2.3, TP2.1, U11.34 (SWDIO)
/Co-processor/CP_TRIG: U11.77 (GPIO0), U11.78 (GPIO1)
/Co-processor/CP_VREG_AVDD: C34.1, R21.2, U11.61 (VREG_AVDD)
/Co-processor/CP_VREG_LX: L1.2, U11.63 (VREG_LX)
/Co-processor/CP_XIN: C48.1, U11.30 (XIN), Y2.1
/Co-processor/CP_XOUT: R22.1, U11.31 (XOUT)
/Co-processor/CP_XTAL: C49.1, R22.2, Y2.3
BUS_A: RN6.8 (R1.2), RN8.1 (R1.1), U11.79 (GPIO2); also elsewhere on the board
BUS_B: RN6.7 (R2.2), RN8.2 (R2.1), U11.80 (GPIO3); also elsewhere on the board
BUS_C: RN6.6 (R3.2), RN8.3 (R3.1), U11.1 (GPIO4); also elsewhere on the board
BUS_D: RN6.5 (R4.2), RN8.4 (R4.1), U11.2 (GPIO5); also elsewhere on the board
BUS_E: RN7.8 (R1.2), RN9.1 (R1.1), U11.3 (GPIO6); also elsewhere on the board
BUS_F: RN7.7 (R2.2), RN9.2 (R2.1), U11.4 (GPIO7); also elsewhere on the board
BUS_G: RN7.6 (R3.2), RN9.3 (R3.1), U11.6 (GPIO8); also elsewhere on the board
BUS_H: RN7.5 (R4.2), RN9.4 (R4.1), U11.7 (GPIO9); also elsewhere on the board
CP_ADC1: U11.49 (GPIO40/ADC0); also elsewhere on the board
CP_ADC2: U11.54 (GPIO43/ADC3); also elsewhere on the board
CP_ADC3: U11.53 (GPIO42/ADC2); also elsewhere on the board
CP_ADC4: U11.52 (GPIO41/ADC1); also elsewhere on the board
CP_BOOT_N: R26.1, TP13.1; also elsewhere on the board
CP_HUB_DN: R24.2; also elsewhere on the board
CP_HUB_DP: R23.2; also elsewhere on the board
CP_RUN: J2.4, R25.2, TP12.1, U11.35 (RUN); also elsewhere on the board
GND: C31.2, C32.2, C33.2, C34.2, C35.2, C36.2, C37.2, C38.2, C39.2, C40.2, C41.2, C42.2, C43.2, C44.2, C45.2, C46.2, C47.2, C48.2, C49.2, D1.1 (K), J2.2, R39.2, TP3.1, U11.62 (VREG_PGND), U11.81 (GND), Y2.2 (G), Y2.4 (G); also elsewhere on the board
MARK: U11.13 (GPIO14); also elsewhere on the board

Notes on the sheet:
RP2350B, wired like a Pico 2 less its flash (the analyzer loaded into SRAM at power-up); its decoupling
Its 3.3 V from +3V3 through a ferrite, the core regulator as Raspberry Pi lays it out (3.3 µH, 3 × 4.7 µF, 33 Ω)
12 MHz crystal (ABM8-272-T3, 15 pF, 1k on XOUT), USB on hub port 5 (27 Ω), RUN, BOOTSEL, LED, SWD
Bring-up test points on the rear face (B.Cu): SWD, RUN, BOOTSEL, its rails, GND (logic only)
SWD header (J2, 1 × 5 through-hole, fitted by hand): the Debug Probe on 1–3, RUN and VTref for others
Bus pull-ups: 10k to 3.3 V always (the LSFs' B side), 2.2k switched by the co-processor (GPIO10–13, 16–19); the ±5 V rails into the ADC
GPIO2–9 = buses A–H (gusmanb CH1–8, 8-bit mode); GPIO0 → GPIO1 bridged (its trigger path). GPIO14 = the node's mark (TCA9534A P7); GPIO25 = LED; GPIO19…16, 13…10 = pull-up enables A…H (2.2k); GPIO40, 43, 42, 41 = VREF 1–4 / 2 (through 100k); GPIO44 = +5V × 47/147; GPIO45 = 3.3 V − (3.3 + 5) × 10/11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

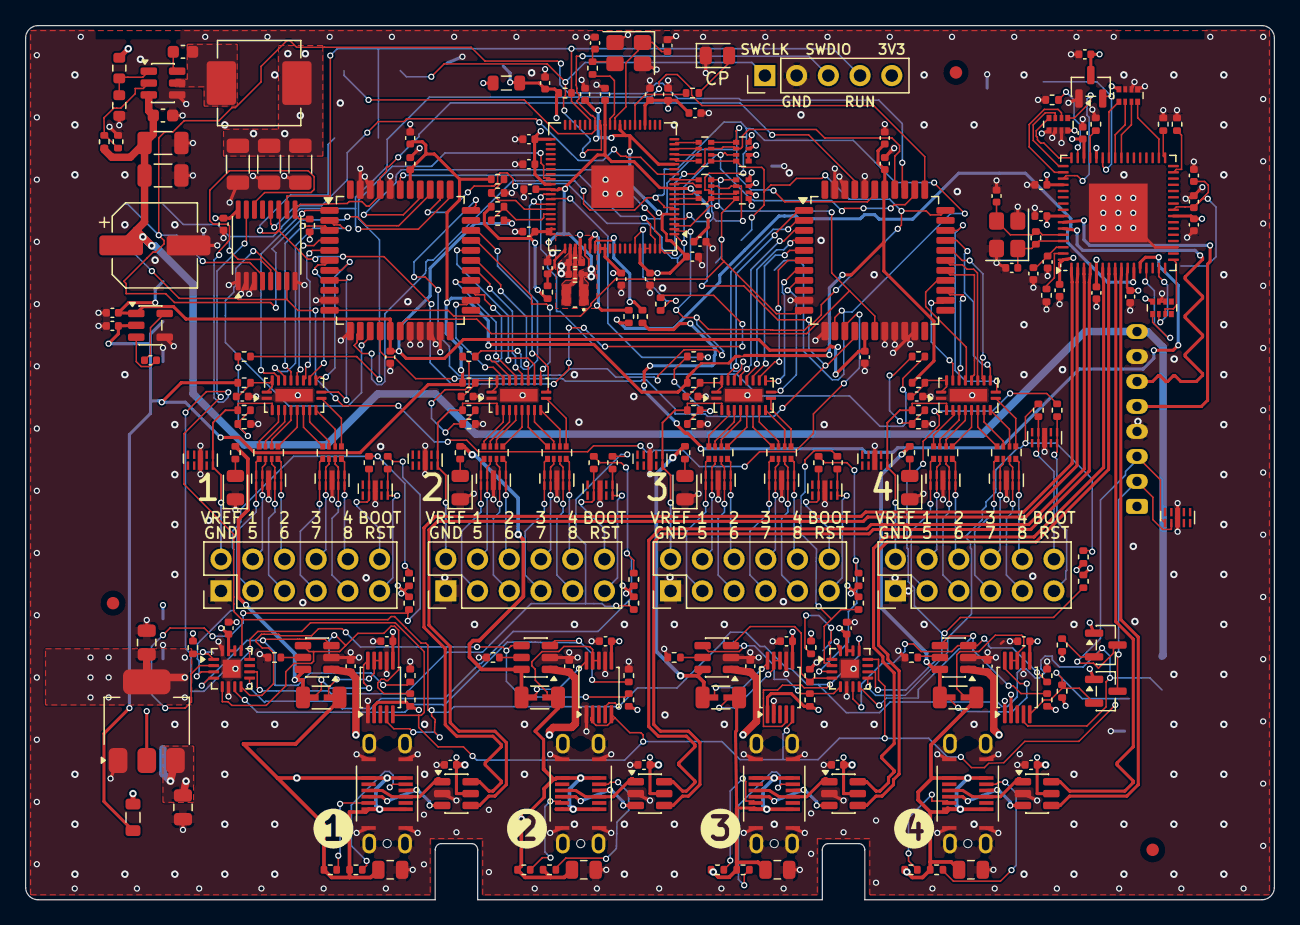
[picture p225: board data-port-x4.kicad_pcb from above]

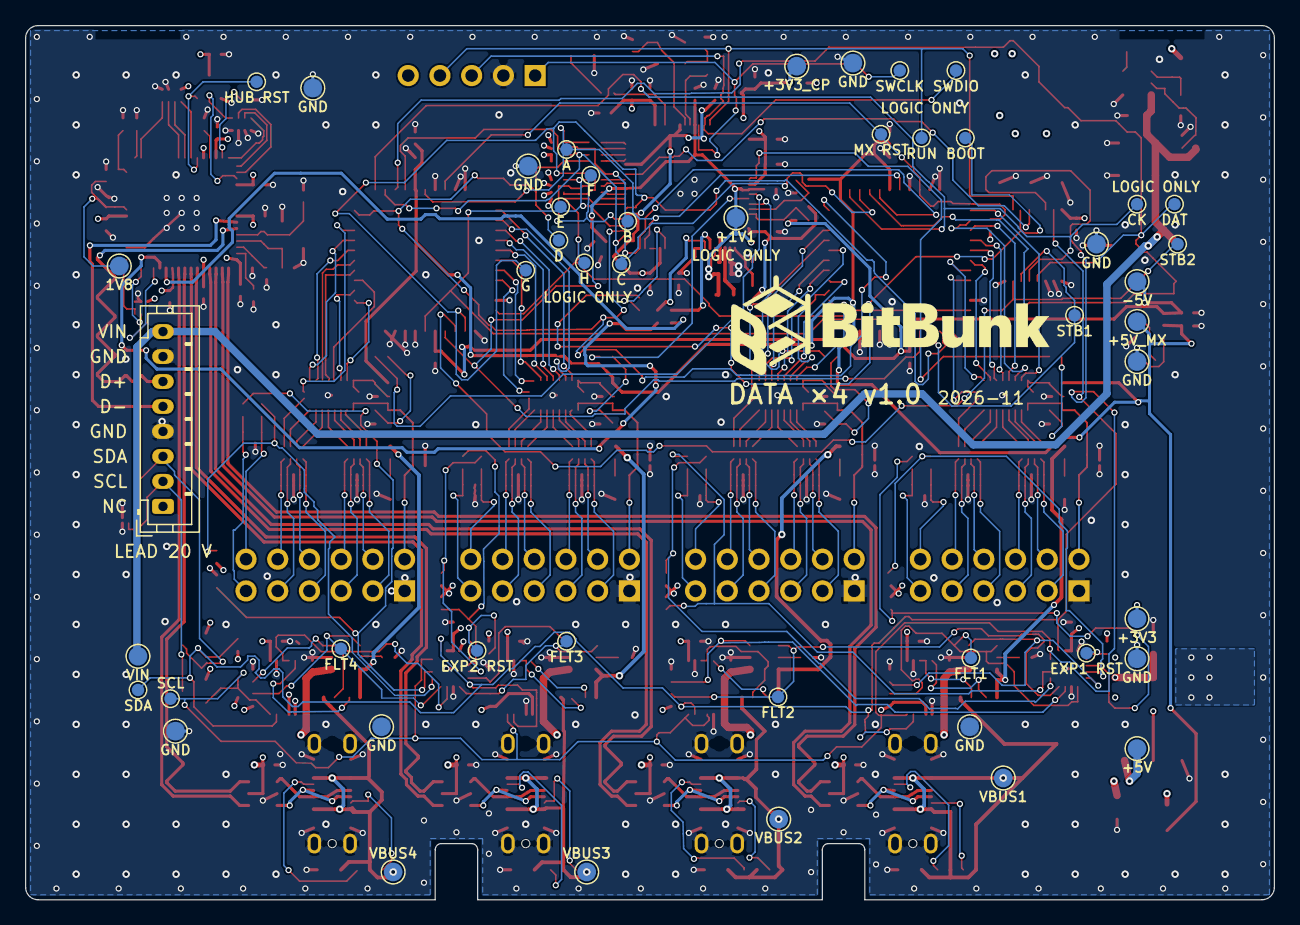
[picture p226: board data-port-x4.kicad_pcb from below]

Board: 4 copper layers, 100.0 x 70.0 mm, 293 parts (48 on the bottom side), 268 nets.
