kartben/hw-testing-rack/electronics/bay-node/bay-node.kicad_pcb

## KiCad design electronics/bay-node/bay-node.kicad_pcb (2026-11-10)

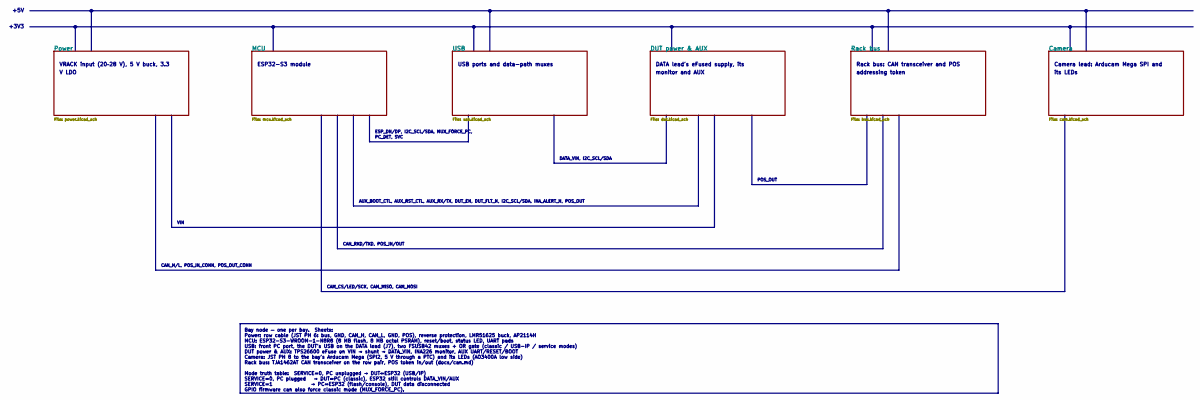
[picture p227: schematic bay-node.kicad_sch, Bay node — Overview]

Notes on the sheet:
VRACK input (20–28 V), 5 V buck, 3.3
V LDO
ESP32-S3 module
USB ports and data-path muxes
DATA lead's eFused supply, its
monitor and AUX
Rack bus: CAN transceiver and POS
addressing token
Camera lead: Arducam Mega SPI and
its LEDs
+3V3
+5V
ESP_DN/DP, I2C_SCL/SDA, MUX_FORCE_PC,
PC_DET, SVC
DATA_VIN, I2C_SCL/SDA
POS_OUT
AUX_BOOT_CTL, AUX_RST_CTL, AUX_RX/TX, DUT_EN, DUT_FLT_N, I2C_SCL/SDA, INA_ALERT_N, POS_OUT
VIN
CAN_RXD/TXD, POS_IN/OUT
CAN_H/L, POS_IN_CONN, POS_OUT_CONN
CAM_CS/LED/SCK, CAM_MISO, CAM_MOSI
Bay node — one per bay. Sheets: Power: row cable (JST PH 6: bus, GND, CAN_H, CAN_L, GND, POS), reverse protection, LMR51625 buck, AP2114H MCU: ESP32-S3-WROOM-1-N8R8 (8 MB flash, 8 MB octal PSRAM), reset/boot, status LED, UART pads USB: front PC port, the DUT's USB on the DATA lead (J7), two FSUSB42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

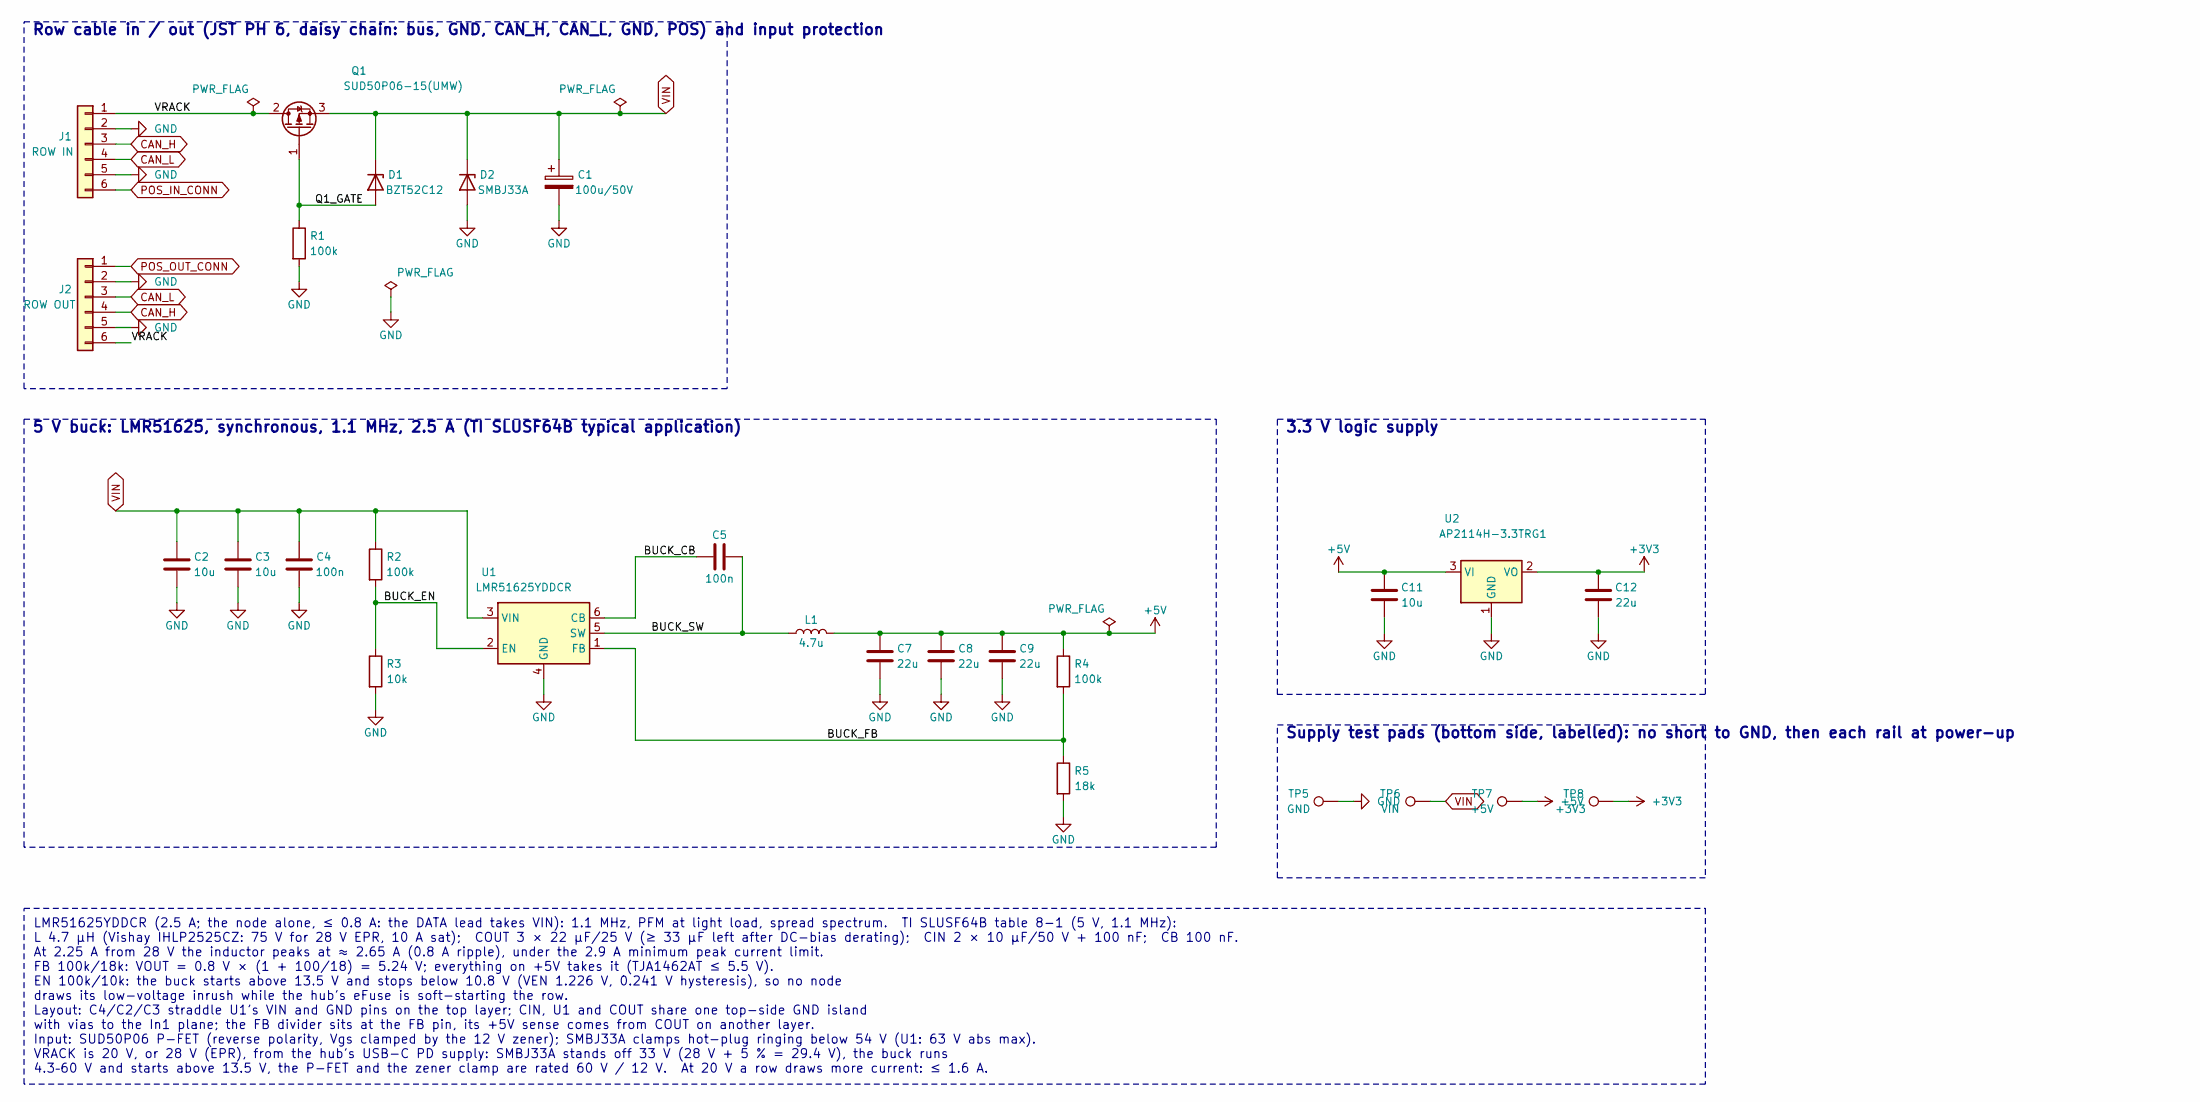
[picture p228: schematic power.kicad_sch, Bay node — VRACK input (20–28 V), 5 V buck, 3.3 V LDO]

Parts:
C1: 100u/50V; CP_Elec_8x10; MPN RVT1H101M0810; LCSC C3352
C2, C3: 10u; C_1206_3216Metric; MPN CL31A106KBHNNNE; LCSC C13585
C4, C5: 100n; C_0603_1608Metric; MPN CC0603KRX7R9BB104; LCSC C14663
C7, C8, C9, C12: 22u; C_1206_3216Metric; MPN CL31A226KAHNNNE; LCSC C12891
C11: 10u; C_0805_2012Metric; MPN CL21A106KAYNNNE; LCSC C15850
D1: BZT52C12; D_SOD-123; MPN BZT52C12; LCSC C43491
D2: SMBJ33A; D_SMB; MPN SMBJ33A; LCSC C78419
J1: ROW IN; JST_PH_S6B-PH-SM4-TB_1x06-1MP_P2.00mm_Horizontal; MPN S6B-PH-SM4-TB(LF)(SN); LCSC C265405
J2: ROW OUT; JST_PH_S6B-PH-SM4-TB_1x06-1MP_P2.00mm_Horizontal; MPN S6B-PH-SM4-TB(LF)(SN); LCSC C265405
L1: 4.7u; L_Changjiang_FXL0630; MPN IHLP2525CZEK4R7M01; LCSC C48009678
Q1: SUD50P06-15(UMW); TO-252-2; MPN SUD50P06-15(UMW); LCSC C7503186
R1, R2, R4: 100k; R_0603_1608Metric; MPN 0603WAF1003T5E; LCSC C25803
R3: 10k; R_0603_1608Metric; MPN 0603WAF1002T5E; LCSC C25804
R5: 18k; R_0603_1608Metric; MPN 0603WAF1802T5E; LCSC C25810
TP5: GND; TestPoint_Pad_D1.5mm; MPN test pad
TP6: VIN; TestPoint_Pad_D1.5mm; MPN test pad
TP7: +5V; TestPoint_Pad_D1.5mm; MPN test pad
TP8: +3V3; TestPoint_Pad_D1.5mm; MPN test pad
U1: LMR51625YDDCR; TSOT-23-6; MPN LMR51625YDDCR; LCSC C44991044
U2: AP2114H-3.3TRG1; SOT-223-3_TabPin2; MPN AP2114H-3.3TRG1; LCSC C150716

Connections:
+3V3: C12.1, TP8.1, U2.2 (VO); also elsewhere on the board
+5V: C7.1, C8.1, C9.1, C11.1, L1.2, R4.1, TP7.1, U2.3 (VI); also elsewhere on the board
/Power/BUCK_CB: C5.1, U1.6 (CB)
/Power/BUCK_EN: R2.2, R3.1, U1.2 (EN)
/Power/BUCK_FB: R4.2, R5.1, U1.1 (FB)
/Power/BUCK_SW: C5.2, L1.1, U1.5 (SW)
/Power/Q1_GATE: D1.2 (A), Q1.1 (G), R1.1
/Power/VRACK: J1.1, J2.6, Q1.2 (D)
CAN_H: J1.3, J2.4; also elsewhere on the board
CAN_L: J1.4, J2.3; also elsewhere on the board
GND: C1.2, C2.2, C3.2, C4.2, C7.2, C8.2, C9.2, C11.2, C12.2, D2.2 (A), J1.2, J1.5, J2.2, J2.5, R1.2, R3.2, R5.2, TP5.1, U1.4 (GND), U2.1 (GND); also elsewhere on the board
POS_IN_CONN: J1.6; also elsewhere on the board
POS_OUT_CONN: J2.1; also elsewhere on the board
VIN: C1.1, C2.1, C3.1, C4.1, D1.1 (K), D2.1 (K), Q1.3 (S), R2.1, TP6.1, U1.3 (VIN); also elsewhere on the board

Notes on the sheet:
Row cable in / out (JST PH 6, daisy chain: bus, GND, CAN_H, CAN_L, GND, POS) and input protection
5 V buck: LMR51625, synchronous, 1.1 MHz, 2.5 A (TI SLUSF64B typical application)
3.3 V logic supply
Supply test pads (bottom side, labelled): no short to GND, then each rail at power-up
LMR51625YDDCR (2.5 A; the node alone, ≤ 0.8 A: the DATA lead takes VIN): 1.1 MHz, PFM at light load, spread spectrum. TI SLUSF64B table 8-1 (5 V, 1.1 MHz): L 4.7 µH (Vishay IHLP2525CZ: 75 V for 28 V EPR, 10 A sat); COUT 3 × 22 µF/25 V (≥ 33 µF left after DC-bias derating); CIN 2 × 10 µF/50 V + 100 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
