kartben/hw-testing-rack/electronics/bay-node/bay-node.kicad_pcb

## KiCad design electronics/bay-node/bay-node.kicad_pcb (continued)

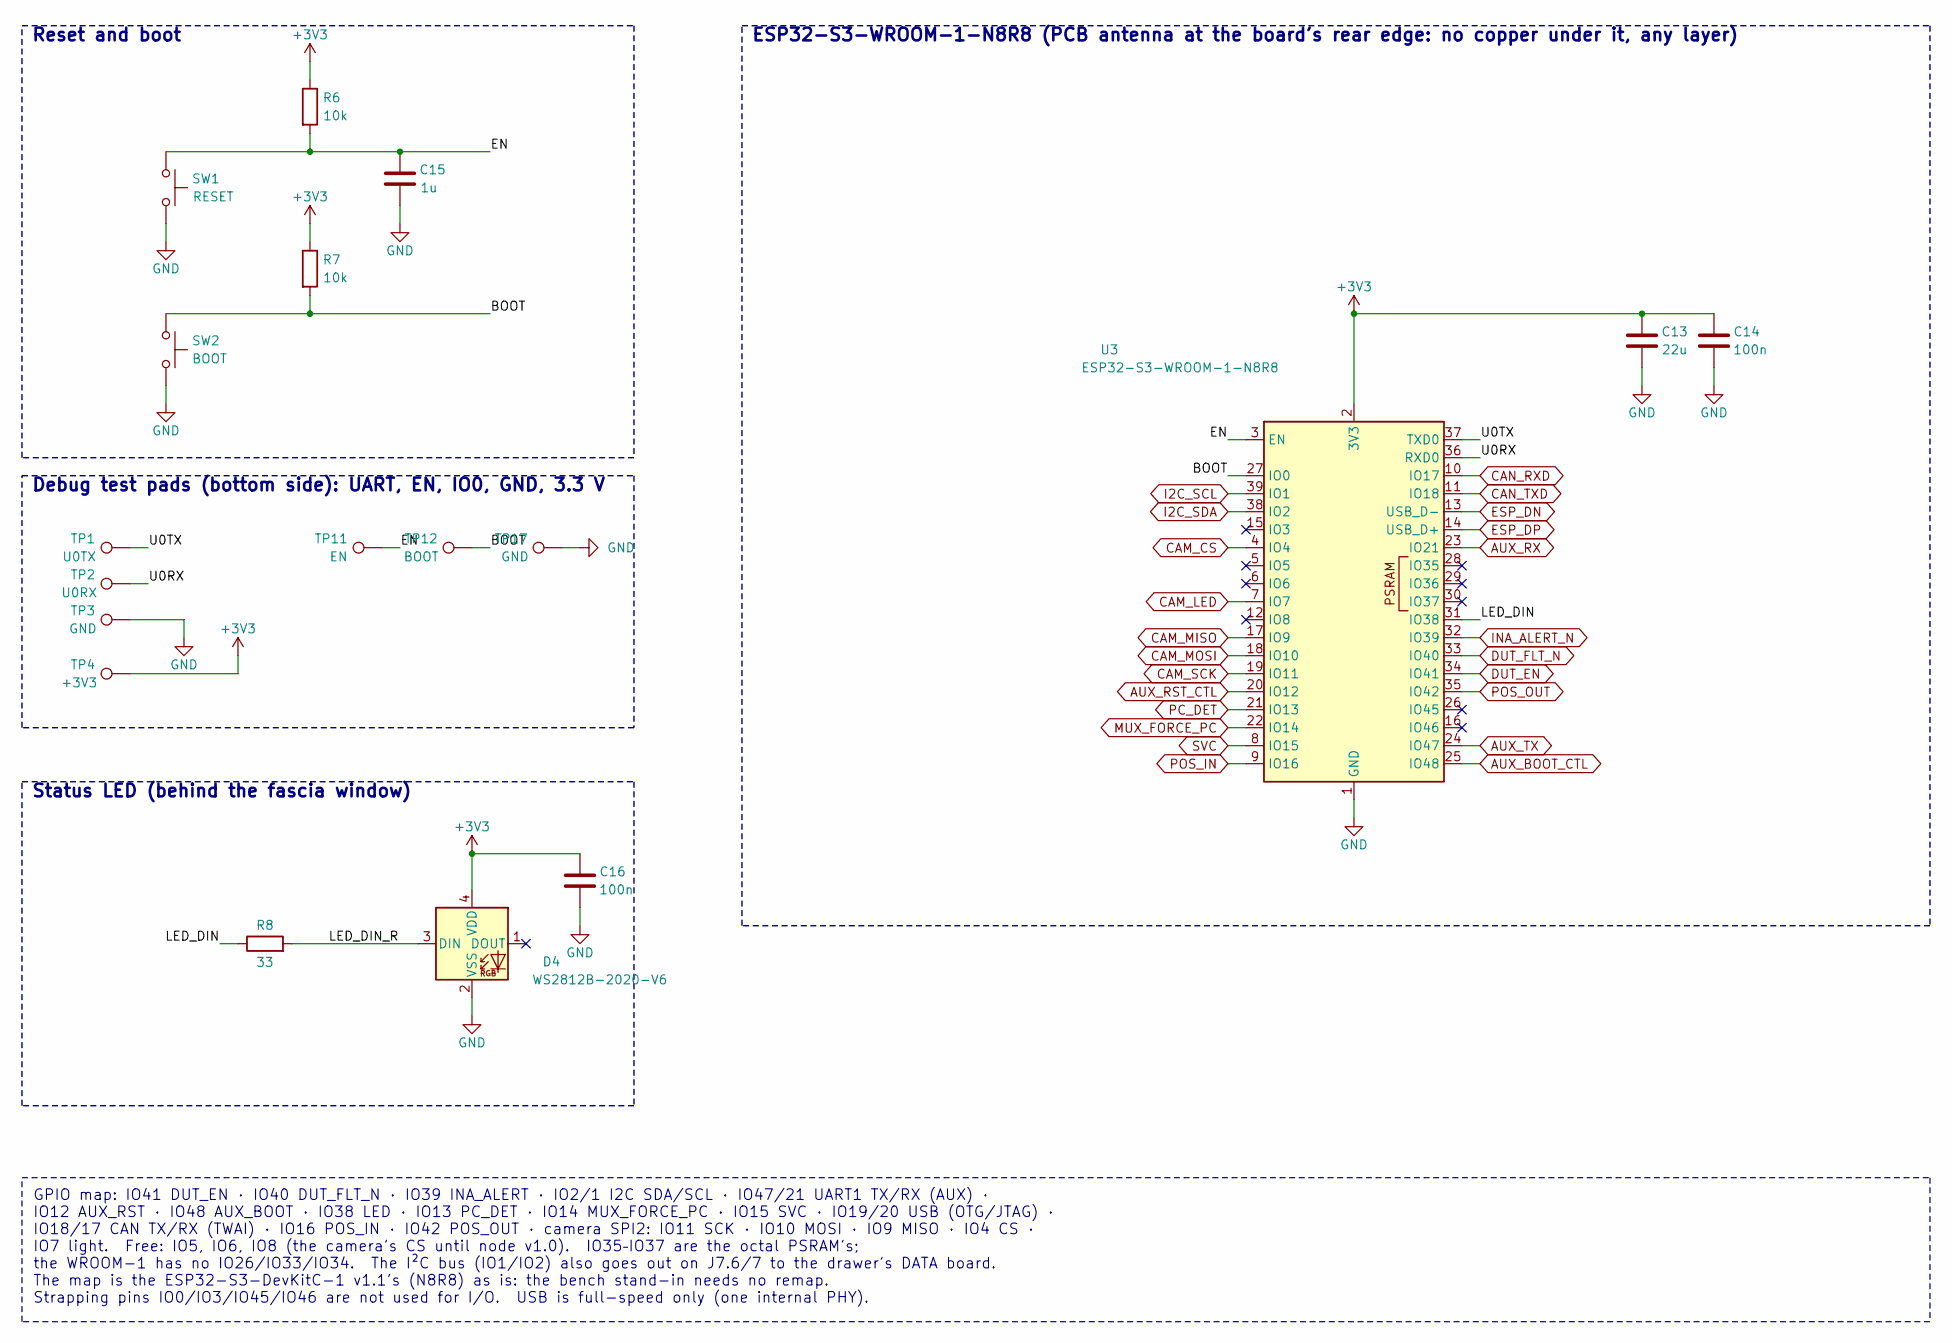
[picture p229: schematic mcu.kicad_sch, Bay node — ESP32-S3 module]

Parts:
C13: 22u; C_1206_3216Metric; MPN CL31A226KAHNNNE; LCSC C12891
C14, C16: 100n; C_0603_1608Metric; MPN CC0603KRX7R9BB104; LCSC C14663
C15: 1u; C_0603_1608Metric; MPN CL10A105KB8NNNC; LCSC C15849
D4: WS2812B-2020-V6; LED_WS2812B-2020_PLCC4_2.0x2.0mm; MPN WS2812B-2020-V6; LCSC C52917434
R6, R7: 10k; R_0603_1608Metric; MPN 0603WAF1002T5E; LCSC C25804
R8: 33; R_0603_1608Metric; MPN 0603WAF330JT5E; LCSC C23140
SW1: RESET; SW_Push_1P1T_XKB_TS-1187A; MPN TS-1187A-B-A-B; LCSC C318884
SW2: BOOT; SW_Push_1P1T_XKB_TS-1187A; MPN TS-1187A-B-A-B; LCSC C318884
TP1: U0TX; TestPoint_Pad_D1.5mm; MPN test pad
TP2: U0RX; TestPoint_Pad_D1.5mm; MPN test pad
TP3, TP17: GND; TestPoint_Pad_D1.5mm; MPN test pad
TP4: +3V3; TestPoint_Pad_D1.5mm; MPN test pad
TP11: EN; TestPoint_Pad_D1.0mm; MPN test pad
TP12: BOOT; TestPoint_Pad_D1.0mm; MPN test pad
U3: ESP32-S3-WROOM-1-N8R8; ESP32-S3-WROOM-1_NoEPVias; MPN ESP32-S3-WROOM-1-N8R8; LCSC C2913201

Connections:
+3V3: C13.1, C14.1, C16.1, D4.4 (VDD), R6.1, R7.1, TP4.1, U3.2 (3V3); also elsewhere on the board
/MCU/BOOT: R7.2, SW2.1, TP12.1, U3.27 (IO0)
/MCU/EN: C15.1, R6.2, SW1.1, TP11.1, U3.3 (EN)
/MCU/LED_DIN: R8.1, U3.31 (IO38)
/MCU/LED_DIN_R: D4.3 (DIN), R8.2
/MCU/U0RX: TP2.1, U3.36 (RXD0)
/MCU/U0TX: TP1.1, U3.37 (TXD0)
AUX_BOOT_CTL: U3.25 (IO48); also elsewhere on the board
AUX_RST_CTL: U3.20 (IO12); also elsewhere on the board
AUX_RX: U3.23 (IO21); also elsewhere on the board
AUX_TX: U3.24 (IO47); also elsewhere on the board
CAM_CS: U3.4 (IO4); also elsewhere on the board
CAM_LED: U3.7 (IO7); also elsewhere on the board
CAM_MISO: U3.17 (IO9); also elsewhere on the board
CAM_MOSI: U3.18 (IO10); also elsewhere on the board
CAM_SCK: U3.19 (IO11); also elsewhere on the board
CAN_RXD: U3.10 (IO17); also elsewhere on the board
CAN_TXD: U3.11 (IO18); also elsewhere on the board
DUT_EN: U3.34 (IO41); also elsewhere on the board
DUT_FLT_N: U3.33 (IO40); also elsewhere on the board
ESP_DN: U3.13 (USB_D-); also elsewhere on the board
ESP_DP: U3.14 (USB_D+); also elsewhere on the board
GND: C13.2, C14.2, C15.2, C16.2, D4.2 (VSS), SW1.2, SW2.2, TP3.1, TP17.1, U3.1 (GND), U3.40 (GND), U3.41 (GND); also elsewhere on the board
I2C_SCL: U3.39 (IO1); also elsewhere on the board
I2C_SDA: U3.38 (IO2); also elsewhere on the board
INA_ALERT_N: U3.32 (IO39); also elsewhere on the board
MUX_FORCE_PC: U3.22 (IO14); also elsewhere on the board
PC_DET: U3.21 (IO13); also elsewhere on the board
POS_IN: U3.9 (IO16); also elsewhere on the board
POS_OUT: U3.35 (IO42); also elsewhere on the board
SVC: U3.8 (IO15); also elsewhere on the board

Notes on the sheet:
Reset and boot
Debug test pads (bottom side): UART, EN, IO0, GND, 3.3 V
ESP32-S3-WROOM-1-N8R8 (PCB antenna at the board's rear edge: no copper under it, any layer)
Status LED (behind the fascia window)
GPIO map: IO41 DUT_EN · IO40 DUT_FLT_N · IO39 INA_ALERT · IO2/1 I2C SDA/SCL · IO47/21 UART1 TX/RX (AUX) · IO12 AUX_RST · IO48 AUX_BOOT · IO38 LED · IO13 PC_DET · IO14 MUX_FORCE_PC · IO15 SVC · IO19/20 USB (OTG/JTAG) · IO18/17 CAN TX/RX (TWAI) · IO16 POS_IN · IO42 POS_OUT · camera SPI2: IO11 SCK · I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

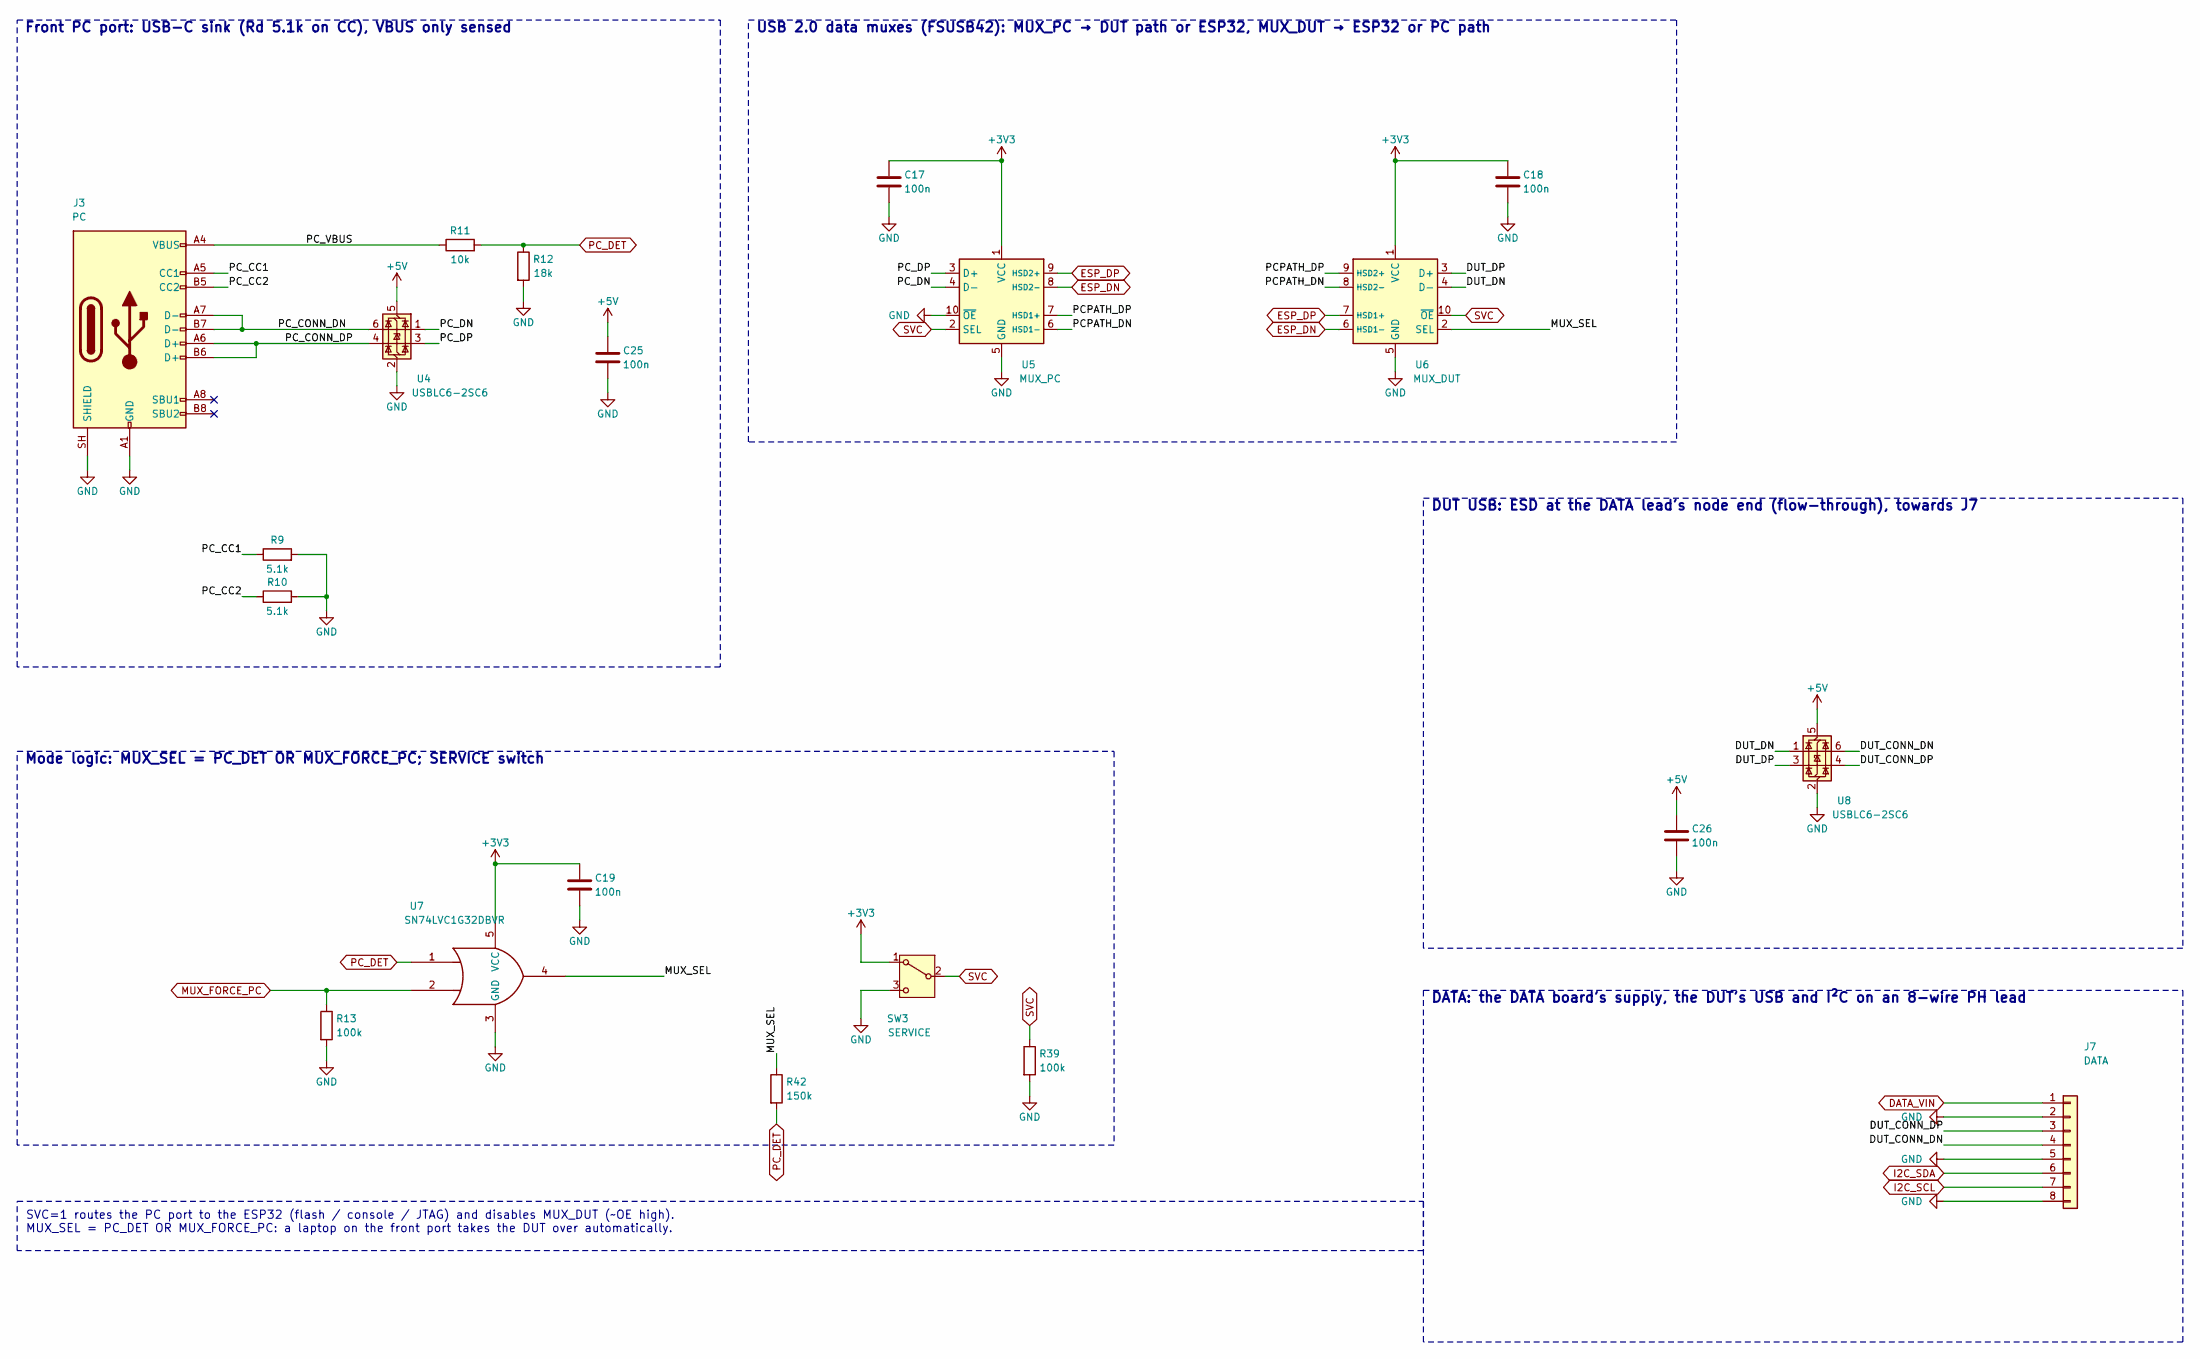
[picture p230: schematic usb.kicad_sch, Bay node — USB ports and data-path muxes]

Parts:
C17, C18, C19, C25, C26: 100n; C_0603_1608Metric; MPN CC0603KRX7R9BB104; LCSC C14663
J3: PC; USB_C_Receptacle_GCT_USB4105-xx-A_16P_TopMnt_Horizontal; MPN USB4105-GF-A-120; LCSC C5184243
J7: DATA; JST_PH_S8B-PH-SM4-TB_1x08-1MP_P2.00mm_Horizontal; MPN S8B-PH-SM4-TB(LF)(SN); LCSC C265121
R9, R10: 5.1k; R_0603_1608Metric; MPN 0603WAF5101T5E; LCSC C23186
R11: 10k; R_0603_1608Metric; MPN 0603WAF1002T5E; LCSC C25804
R12: 18k; R_0603_1608Metric; MPN 0603WAF1802T5E; LCSC C25810
R13, R39: 100k; R_0603_1608Metric; MPN 0603WAF1003T5E; LCSC C25803
R42: 150k; R_0603_1608Metric; MPN 0603WAF1503T5E; LCSC C22807
SW3: SERVICE; SW_SPDT_Shouhan_MSK12C02; MPN MSK12C02; LCSC C431540
U4, U8: USBLC6-2SC6; SOT-23-6; MPN USBLC6-2SC6; LCSC C7519
U5: MUX_PC; MSOP-10_3x3mm_P0.5mm; MPN FSUSB42MUX; LCSC C11355
U6: MUX_DUT; MSOP-10_3x3mm_P0.5mm; MPN FSUSB42MUX; LCSC C11355
U7: SN74LVC1G32DBVR; SOT-23-5; MPN SN74LVC1G32DBVR; LCSC C10096

Connections:
+3V3: C17.1, C18.1, C19.1, SW3.1 (A), U5.1 (VCC), U6.1 (VCC), U7.5 (VCC); also elsewhere on the board
+5V: C25.1, C26.1, U4.5 (VBUS), U8.5 (VBUS); also elsewhere on the board
/USB/DUT_CONN_DN: J7.4, U8.6 (I/O1)
/USB/DUT_CONN_DP: J7.3, U8.4 (I/O2)
/USB/DUT_DN: U6.4 (D-), U8.1 (I/O1)
/USB/DUT_DP: U6.3 (D+), U8.3 (I/O2)
/USB/MUX_SEL: R42.1, U6.2 (SEL), U7.4
/USB/PCPATH_DN: U5.6 (HSD1-), U6.8 (HSD2-)
/USB/PCPATH_DP: U5.7 (HSD1+), U6.9 (HSD2+)
/USB/PC_CC1: J3.A5 (CC1), R9.1
/USB/PC_CC2: J3.B5 (CC2), R10.1
/USB/PC_CONN_DN: J3.A7 (D-), J3.B7 (D-), U4.6 (I/O1)
/USB/PC_CONN_DP: J3.A6 (D+), J3.B6 (D+), U4.4 (I/O2)
/USB/PC_DN: U4.1 (I/O1), U5.4 (D-)
/USB/PC_DP: U4.3 (I/O2), U5.3 (D+)
/USB/PC_VBUS: J3.A4 (VBUS), J3.A9 (VBUS), J3.B4 (VBUS), J3.B9 (VBUS), R11.1
DATA_VIN: J7.1; also elsewhere on the board
ESP_DN: U5.8 (HSD2-), U6.6 (HSD1-); also elsewhere on the board
ESP_DP: U5.9 (HSD2+), U6.7 (HSD1+); also elsewhere on the board
GND: C17.2, C18.2, C19.2, C25.2, C26.2, J3.A1 (GND), J3.A12 (GND), J3.B1 (GND), J3.B12 (GND), J3.SH (SHIELD), J7.2, J7.5, J7.8, R9.2, R10.2, R12.2, R13.2, R39.2, SW3.3 (C), U4.2 (GND), U5.5 (GND), U5.10 (~OE), U6.5 (GND), U7.3 (GND), U8.2 (GND); also elsewhere on the board
I2C_SCL: J7.7; also elsewhere on the board
I2C_SDA: J7.6; also elsewhere on the board
MUX_FORCE_PC: R13.1, U7.2; also elsewhere on the board
PC_DET: R11.2, R12.1, R42.2, U7.1; also elsewhere on the board
SVC: R39.1, SW3.2 (B), U5.2 (SEL), U6.10 (~OE); also elsewhere on the board

Notes on the sheet:
Front PC port: USB-C sink (Rd 5.1k on CC), VBUS only sensed
USB 2.0 data muxes (FSUSB42): MUX_PC → DUT path or ESP32, MUX_DUT → ESP32 or PC path
DUT USB: ESD at the DATA lead's node end (flow-through), towards J7
DATA: the DATA board's supply, the DUT's USB and I²C on an 8-wire PH lead
Mode logic: MUX_SEL = PC_DET OR MUX_FORCE_PC; SERVICE switch
SVC=1 routes the PC port to the ESP32 (flash / console / JTAG) and disables MUX_DUT (~OE high). MUX_SEL = PC_DET OR MUX_FORCE_PC: a laptop on the front port takes the DUT over automatically.

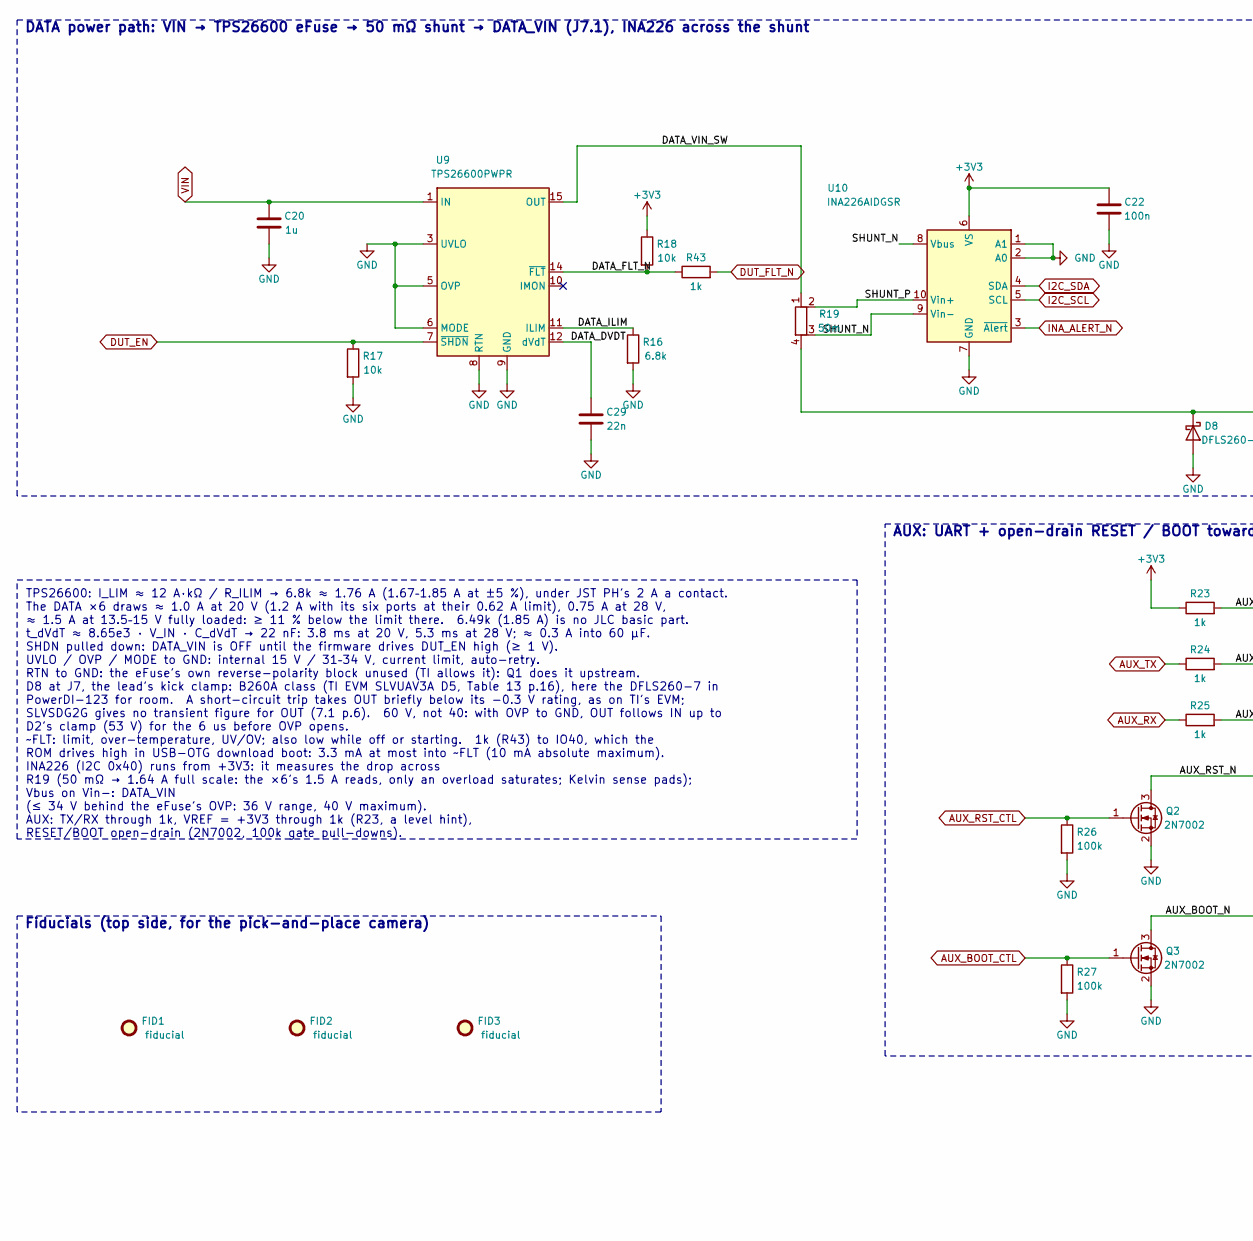
[picture p231: schematic dut.kicad_sch, Bay node — DATA lead's eFused supply, its monitor and AUX, part in row 1, column 1]

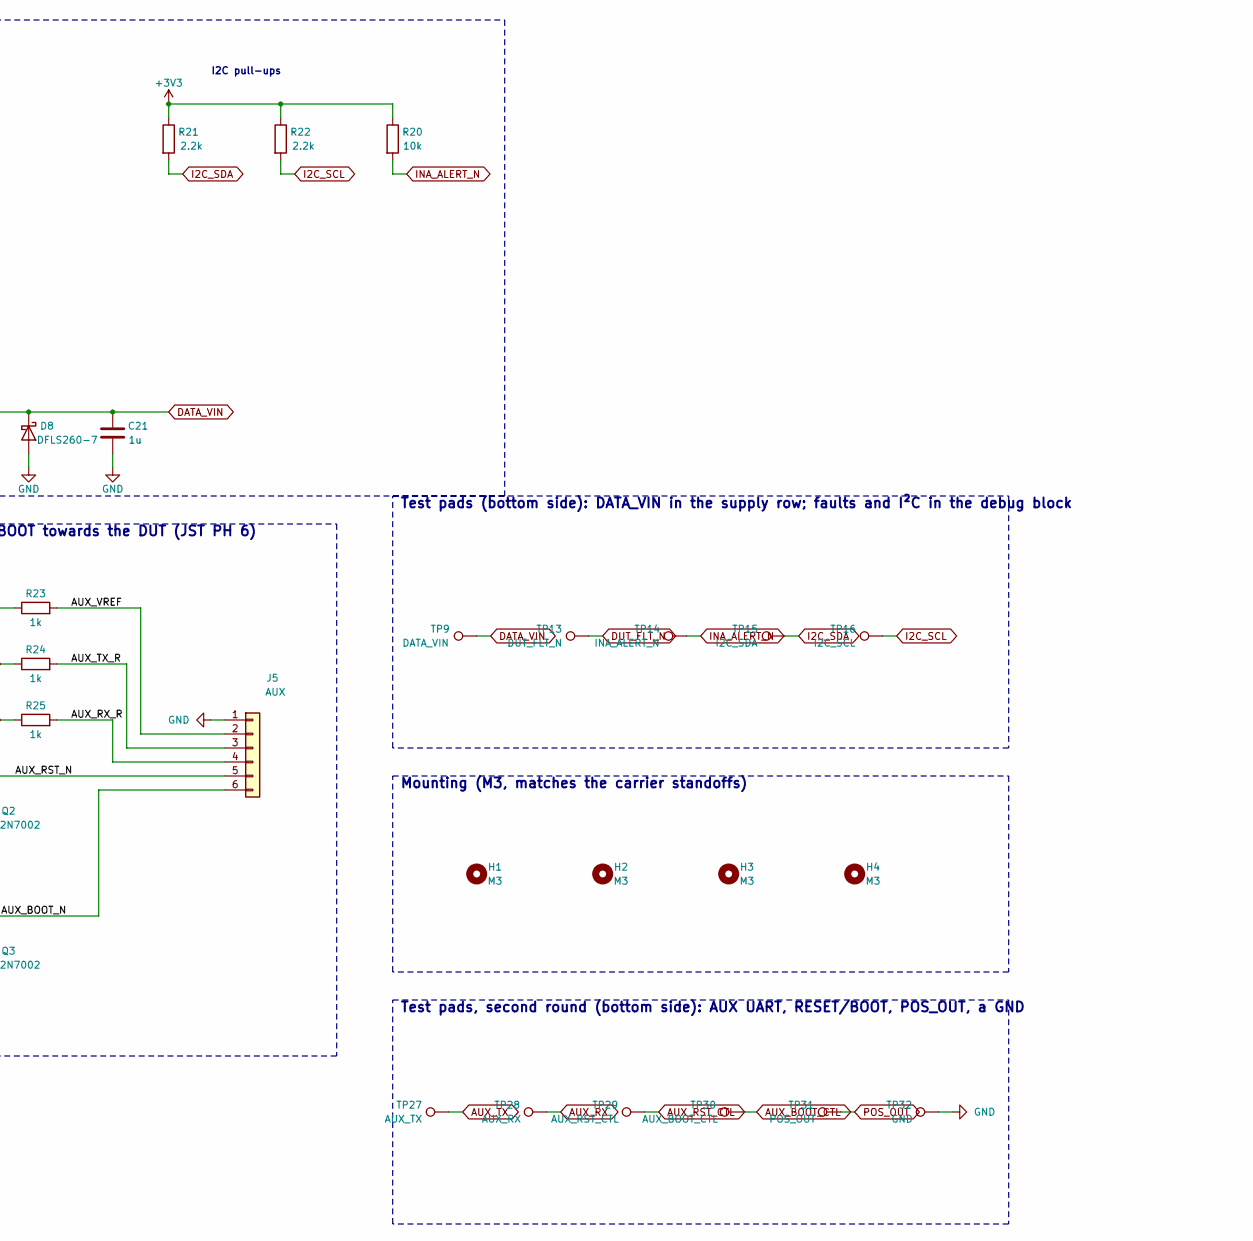
[picture p232: schematic dut.kicad_sch, Bay node — DATA lead's eFused supply, its monitor and AUX, part in row 1, column 2]

Parts:
C20, C21: 1u; C_0805_2012Metric; MPN CL21B105KBFNNNE; LCSC C28323
C22: 100n; C_0603_1608Metric; MPN CC0603KRX7R9BB104; LCSC C14663
C29: 22n; C_0603_1608Metric; MPN CL10B223KB8NNNC; LCSC C21122
D8: DFLS260-7; D_PowerDI-123; MPN DFLS260-7; LCSC C209346
FID1, FID2, FID3: fiducial; Fiducial_1mm_Mask2mm; MPN fiducial
H1, H2, H3, H4: M3; MountingHole_3.2mm_M3; MPN M3 mounting hole
J5: AUX; JST_PH_S6B-PH-SM4-TB_1x06-1MP_P2.00mm_Horizontal; MPN S6B-PH-SM4-TB(LF)(SN); LCSC C265405
Q2, Q3: 2N7002; SOT-23; MPN 2N7002; LCSC C8545
R16: 6.8k; R_0603_1608Metric; MPN 0603WAF6801T5E; LCSC C23212
R17, R18, R20: 10k; R_0603_1608Metric; MPN 0603WAF1002T5E; LCSC C25804
R19: 50m; R_1206_3216Metric_Kelvin; MPN HoLR1206-1W-50mR-1%-75ppm; LCSC C601102
R21, R22: 2.2k; R_0603_1608Metric; MPN 0603WAF2201T5E; LCSC C4190
R23, R24, R25, R43: 1k; R_0603_1608Metric; MPN 0603WAF1001T5E; LCSC C21190
R26, R27: 100k; R_0603_1608Metric; MPN 0603WAF1003T5E; LCSC C25803
TP9: DATA_VIN; TestPoint_Pad_D1.5mm; MPN test pad
TP13: DUT_FLT_N; TestPoint_Pad_D1.0mm; MPN test pad
TP14: INA_ALERT_N; TestPoint_Pad_D1.0mm; MPN test pad
TP15: I2C_SDA; TestPoint_Pad_D1.0mm; MPN test pad
TP16: I2C_SCL; TestPoint_Pad_D1.0mm; MPN test pad
TP27: AUX_TX; TestPoint_Pad_D1.0mm; MPN test pad
TP28: AUX_RX; TestPoint_Pad_D1.0mm; MPN test pad
TP29: AUX_RST_CTL; TestPoint_Pad_D1.0mm; MPN test pad
TP30: AUX_BOOT_CTL; TestPoint_Pad_D1.0mm; MPN test pad
TP31: POS_OUT; TestPoint_Pad_D1.0mm; MPN test pad
TP32: GND; TestPoint_Pad_D1.5mm; MPN test pad
U9: TPS26600PWPR; HTSSOP-16-1EP_4.4x5mm_P0.65mm_EP3.4x5mm_Mask2.66x2.46mm; MPN TPS26600PWPR; LCSC C544399
U10: INA226AIDGSR; TSSOP-10_3x3mm_P0.5mm; MPN INA226AIDGSR; LCSC C49851

Connections:
+3V3: C22.1, R18.1, R20.1, R21.1, R22.1, R23.1, U10.6 (VS); also elsewhere on the board
/DUT power & AUX/AUX_BOOT_N: J5.6, Q3.3 (D)
/DUT power & AUX/AUX_RST_N: J5.5, Q2.3 (D)
/DUT power & AUX/AUX_RX_R: J5.4, R25.2
/DUT power & AUX/AUX_TX_R: J5.3, R24.2
/DUT power & AUX/AUX_VREF: J5.2, R23.2
/DUT power & AUX/DATA_DVDT: C29.1, U9.12 (dVdT)
/DUT power & AUX/DATA_FLT_N: R18.2, R43.1, U9.14 (~FLT)
/DUT power & AUX/DATA_ILIM: R16.1, U9.11 (ILIM)
/DUT power & AUX/DATA_VIN_SW: R19.1, U9.15 (OUT), U9.16 (OUT)
/DUT power & AUX/SHUNT_N: R19.3, U10.8 (Vbus), U10.9 (Vin-)
/DUT power & AUX/SHUNT_P: R19.2, U10.10 (Vin+)
AUX_BOOT_CTL: Q3.1 (G), R27.1, TP30.1; also elsewhere on the board
AUX_RST_CTL: Q2.1 (G), R26.1, TP29.1; also elsewhere on the board
AUX_RX: R25.1, TP28.1; also elsewhere on the board
AUX_TX: R24.1, TP27.1; also elsewhere on the board
DATA_VIN: C21.1, D8.1 (K), R19.4, TP9.1; also elsewhere on the board
DUT_EN: R17.1, U9.7 (~SHDN); also elsewhere on the board
DUT_FLT_N: R43.2, TP13.1; also elsewhere on the board
GND: C20.2, C21.2, C22.2, C29.2, D8.2 (A), J5.1, Q2.2 (S), Q3.2 (S), R16.2, R17.2, R26.2, R27.2, TP32.1, U9.3 (UVLO), U9.5 (OVP), U9.6 (MODE), U9.8 (RTN), U9.9 (GND), U9.17 (RTN), U10.1 (A1), U10.2 (A0), U10.7 (GND); also elsewhere on the board
I2C_SCL: R22.2, TP16.1, U10.5 (SCL); also elsewhere on the board
I2C_SDA: R21.2, TP15.1, U10.4 (SDA); also elsewhere on the board
INA_ALERT_N: R20.2, TP14.1, U10.3 (~Alert); also elsewhere on the board
POS_OUT: TP31.1; also elsewhere on the board
VIN: C20.1, U9.1 (IN), U9.2 (IN); also elsewhere on the board

Notes on the sheet:
DATA power path: VIN → TPS26600 eFuse → 50 mΩ shunt → DATA_VIN (J7.1), INA226 across the shunt
AUX: UART + open-drain RESET / BOOT towards the DUT (JST PH 6)
Test pads (bottom side): DATA_VIN in the supply row; faults and I²C in the debug block
Mounting (M3, matches the carrier standoffs)
Fiducials (top side, for the pick-and-place camera)
Test pads, second round (bottom side): AUX UART, RESET/BOOT, POS_OUT, a GND
I2C pull-ups
TPS26600: I_LIM ≈ 12 A·kΩ / R_ILIM → 6.8k ≈ 1.76 A (1.67–1.85 A at ±5 %), under JST PH's 2 A a contact. The DATA ×6 draws ≈ 1.0 A at 20 V (1.2 A with its six ports at their 0.62 A limit), 0.75 A at 28 V, ≈ 1.5 A at 13.5–15 V fully loaded: ≥ 11 % below the limit there. 6.49k (1.85 A) is no JLC basic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

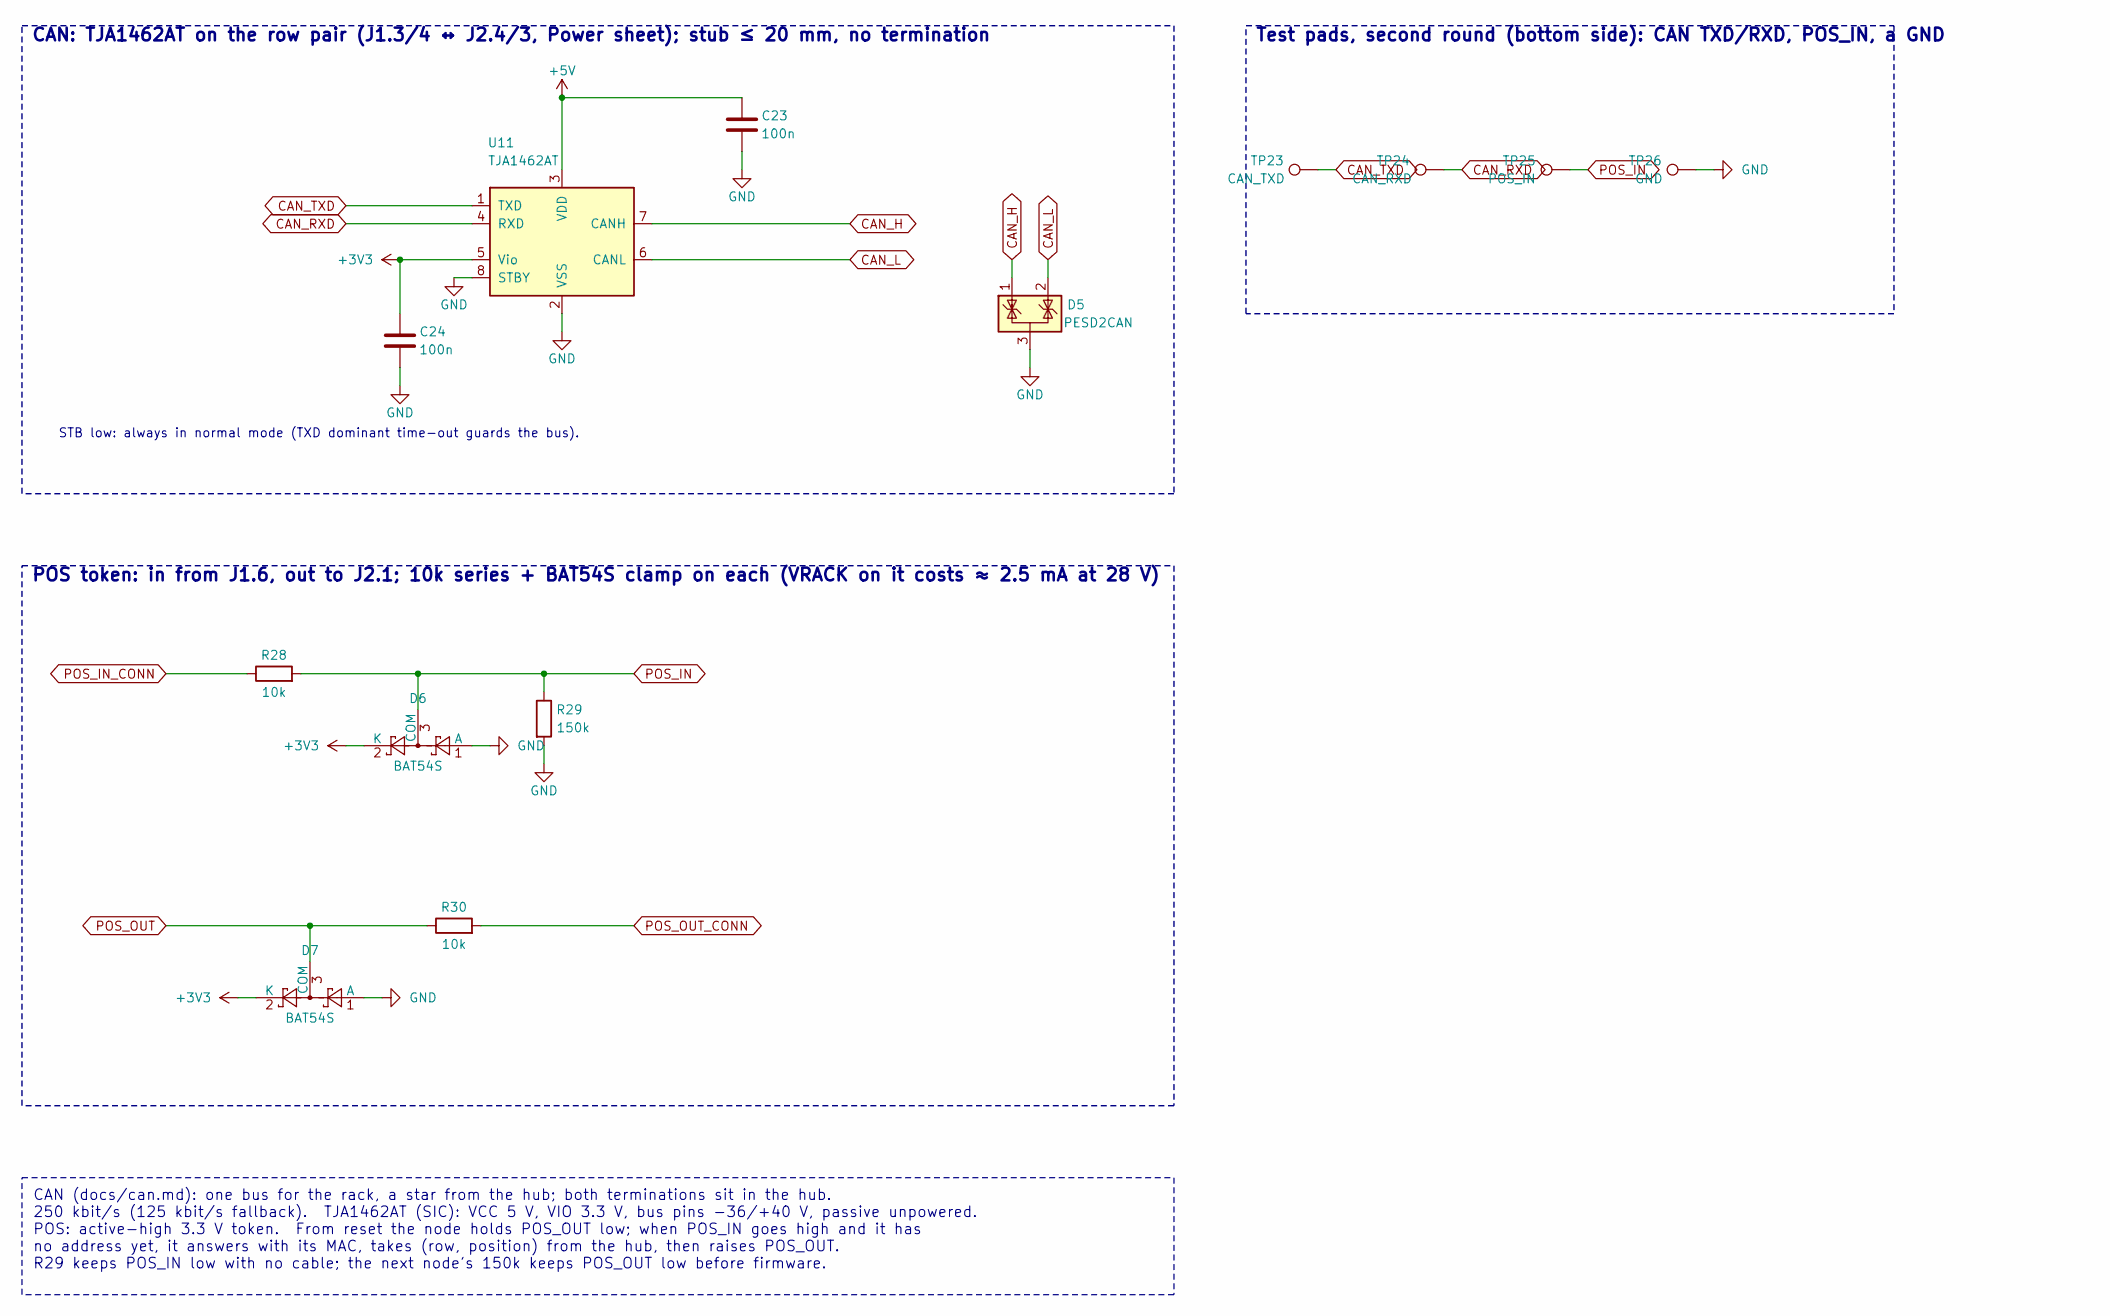
[picture p233: schematic bus.kicad_sch, Bay node — Rack bus: CAN transceiver and POS addressing tok…]

Parts:
C23, C24: 100n; C_0603_1608Metric; MPN CC0603KRX7R9BB104; LCSC C14663
D5: PESD2CAN; SOT-23; MPN PESD2CAN,215; LCSC C75176
D6, D7: BAT54S; SOT-23; MPN BAT54S; LCSC C7420333
R28, R30: 10k; R_0603_1608Metric; MPN 0603WAF1002T5E; LCSC C25804
R29: 150k; R_0603_1608Metric; MPN 0603WAF1503T5E; LCSC C22807
TP23: CAN_TXD; TestPoint_Pad_D1.0mm; MPN test pad
TP24: CAN_RXD; TestPoint_Pad_D1.0mm; MPN test pad
TP25: POS_IN; TestPoint_Pad_D1.0mm; MPN test pad
TP26: GND; TestPoint_Pad_D1.5mm; MPN test pad
U11: TJA1462AT; SOIC-8_3.9x4.9mm_P1.27mm; MPN TJA1462AT/0Z; LCSC C3234095

Connections:
+3V3: C24.1, D6.2 (K), D7.2 (K), U11.5 (Vio); also elsewhere on the board
+5V: C23.1, U11.3 (VDD); also elsewhere on the board
CAN_H: D5.1 (K), U11.7 (CANH); also elsewhere on the board
CAN_L: D5.2 (K), U11.6 (CANL); also elsewhere on the board
CAN_RXD: TP24.1, U11.4 (RXD); also elsewhere on the board
CAN_TXD: TP23.1, U11.1 (TXD); also elsewhere on the board
GND: C23.2, C24.2, D5.3 (A), D6.1 (A), D7.1 (A), R29.2, TP26.1, U11.2 (VSS), U11.8 (STBY); also elsewhere on the board
POS_IN: D6.3 (COM), R28.2, R29.1, TP25.1; also elsewhere on the board
POS_IN_CONN: R28.1; also elsewhere on the board
POS_OUT: D7.3 (COM), R30.1; also elsewhere on the board
POS_OUT_CONN: R30.2; also elsewhere on the board

Notes on the sheet:
CAN: TJA1462AT on the row pair (J1.3/4 ↔ J2.4/3, Power sheet); stub ≤ 20 mm, no termination
POS token: in from J1.6, out to J2.1; 10k series + BAT54S clamp on each (VRACK on it costs ≈ 2.5 mA at 28 V)
Test pads, second round (bottom side): CAN TXD/RXD, POS_IN, a GND
STB low: always in normal mode (TXD dominant time-out guards the bus).
CAN (docs/can.md): one bus for the rack, a star from the hub; both terminations sit in the hub. 250 kbit/s (125 kbit/s fallback). TJA1462AT (SIC): VCC 5 V, VIO 3.3 V, bus pins −36/+40 V, passive unpowered. POS: active-high 3.3 V token. From reset the node holds POS_OUT low; when POS_IN goes high an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

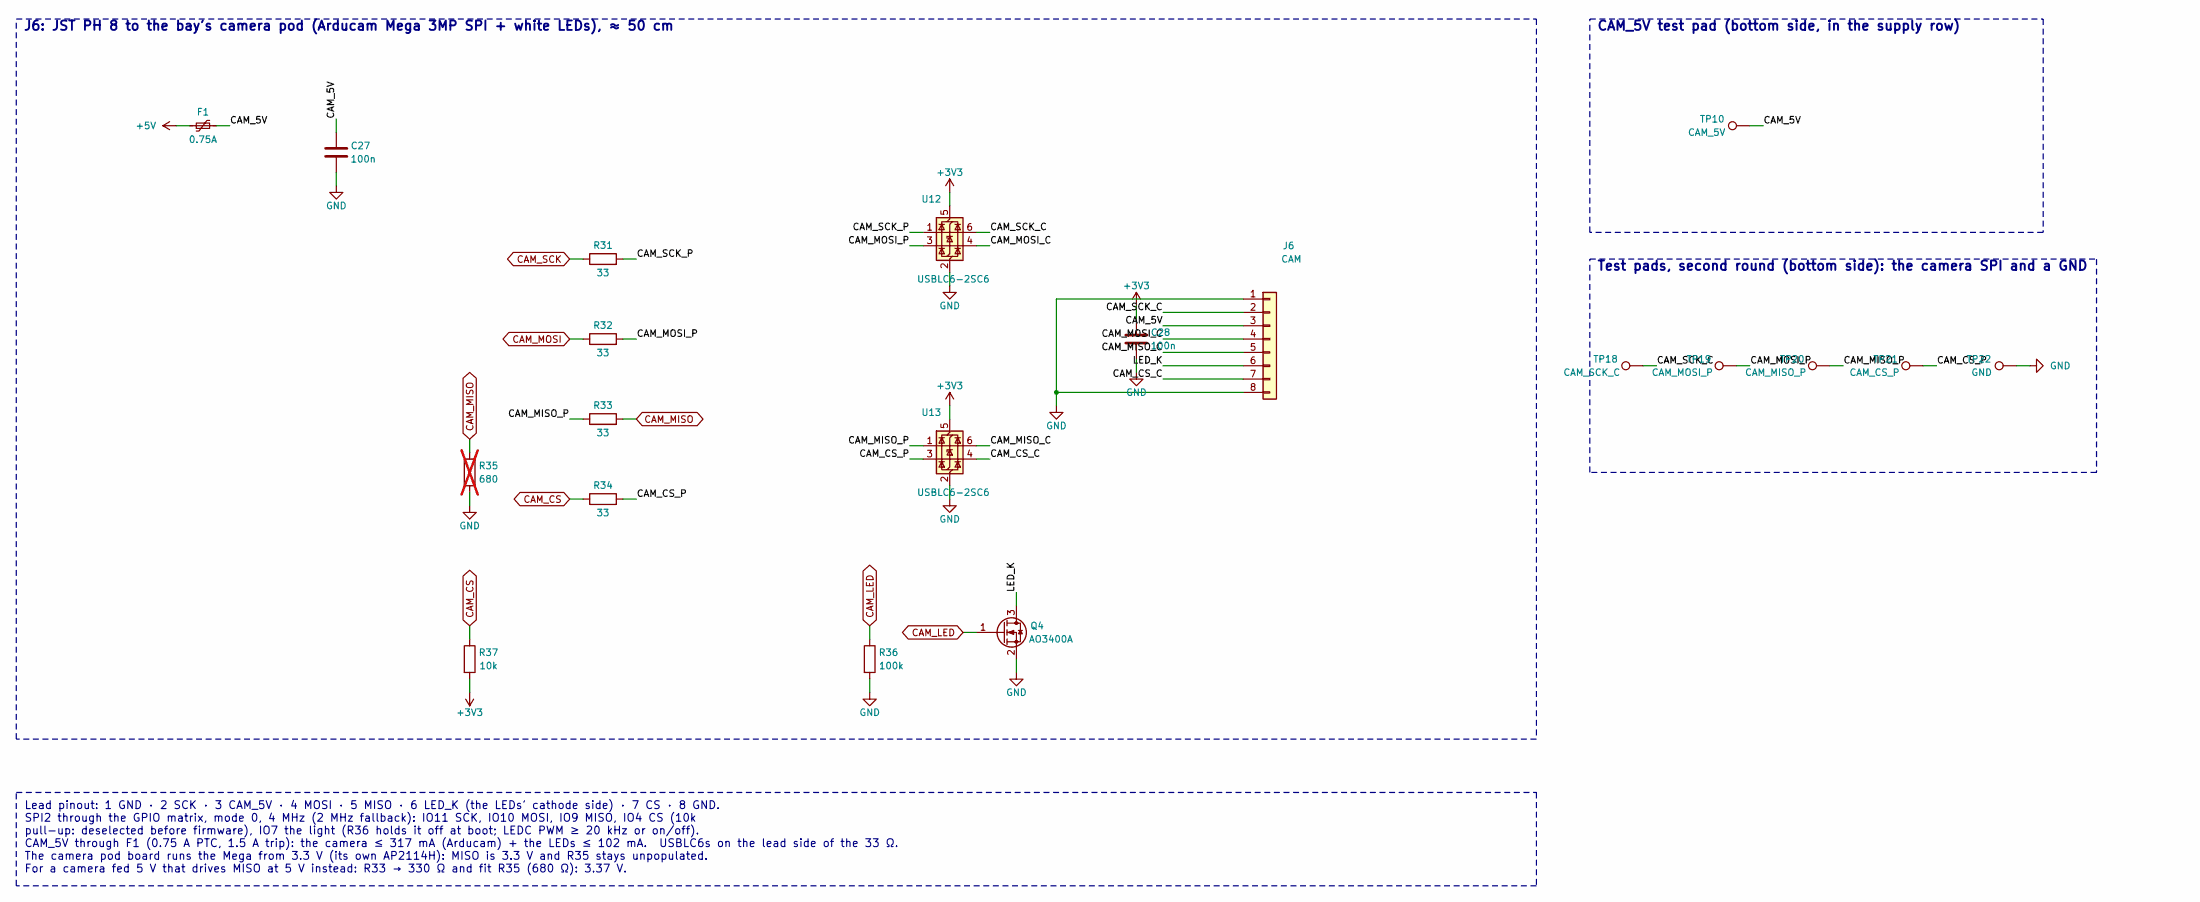
[picture p234: schematic cam.kicad_sch, Bay node — Camera lead: Arducam Mega SPI and its LEDs]

Parts:
C27, C28: 100n; C_0603_1608Metric; MPN CC0603KRX7R9BB104; LCSC C14663
F1: 0.75A; Fuse_1206_3216Metric; MPN SMD1206P075TF; LCSC C20987
J6: CAM; JST_PH_B8B-PH-SM4-TB_1x08-1MP_P2.00mm_Vertical; MPN B8B-PH-SM4-TB(LF)(SN); LCSC C495548
Q4: AO3400A; SOT-23; MPN AO3400A; LCSC C20917
R31, R32, R33, R34: 33; R_0603_1608Metric; MPN 0603WAF330JT5E; LCSC C23140
R35: 680; R_0603_1608Metric; MPN 0603WAF6800T5E; LCSC C23228; not fitted
R36: 100k; R_0603_1608Metric; MPN 0603WAF1003T5E; LCSC C25803
R37: 10k; R_0603_1608Metric; MPN 0603WAF1002T5E; LCSC C25804
TP10: CAM_5V; TestPoint_Pad_D1.5mm; MPN test pad
TP18: CAM_SCK_C; TestPoint_Pad_D1.0mm; MPN test pad
TP19: CAM_MOSI_P; TestPoint_Pad_D1.0mm; MPN test pad
TP20: CAM_MISO_P; TestPoint_Pad_D1.0mm; MPN test pad
TP21: CAM_CS_P; TestPoint_Pad_D1.0mm; MPN test pad
TP22: GND; TestPoint_Pad_D1.5mm; MPN test pad
U12, U13: USBLC6-2SC6; SOT-23-6; MPN USBLC6-2SC6; LCSC C7519

Connections:
+3V3: C28.1, R37.2, U12.5 (VBUS), U13.5 (VBUS); also elsewhere on the board
+5V: F1.1; also elsewhere on the board
/Camera/CAM_5V: C27.1, F1.2, J6.3, TP10.1
/Camera/CAM_CS_C: J6.7, U13.4 (I/O2)
/Camera/CAM_CS_P: R34.2, TP21.1, U13.3 (I/O2)
/Camera/CAM_MISO_C: J6.5, U13.6 (I/O1)
/Camera/CAM_MISO_P: R33.1, TP20.1, U13.1 (I/O1)
/Camera/CAM_MOSI_C: J6.4, U12.4 (I/O2)
/Camera/CAM_MOSI_P: R32.2, TP19.1, U12.3 (I/O2)
/Camera/CAM_SCK_C: J6.2, TP18.1, U12.6 (I/O1)
/Camera/CAM_SCK_P: R31.2, U12.1 (I/O1)
/Camera/LED_K: J6.6, Q4.3 (D)
CAM_CS: R34.1, R37.1; also elsewhere on the board
CAM_LED: Q4.1 (G), R36.1; also elsewhere on the board
CAM_MISO: R33.2, R35.1; also elsewhere on the board
CAM_MOSI: R32.1; also elsewhere on the board
CAM_SCK: R31.1; also elsewhere on the board
GND: C27.2, C28.2, J6.1, J6.8, Q4.2 (S), R35.2, R36.2, TP22.1, U12.2 (GND), U13.2 (GND); also elsewhere on the board

Notes on the sheet:
J6: JST PH 8 to the bay's camera pod (Arducam Mega 3MP SPI + white LEDs), ≈ 50 cm
CAM_5V test pad (bottom side, in the supply row)
Test pads, second round (bottom side): the camera SPI and a GND
Lead pinout: 1 GND · 2 SCK · 3 CAM_5V · 4 MOSI · 5 MISO · 6 LED_K (the LEDs' cathode side) · 7 CS · 8 GND. SPI2 through the GPIO matrix, mode 0, 4 MHz (2 MHz fallback): IO11 SCK, IO10 MOSI, IO9 MISO, IO4 CS (10k pull-up: deselected before firmware), IO7 the light (R36 holds it off at boot; LEDC PWM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
