kartben/hw-testing-rack/electronics/bay-node/bay-node.kicad_pcb

## KiCad design electronics/bay-node/bay-node.kicad_pcb (continued)

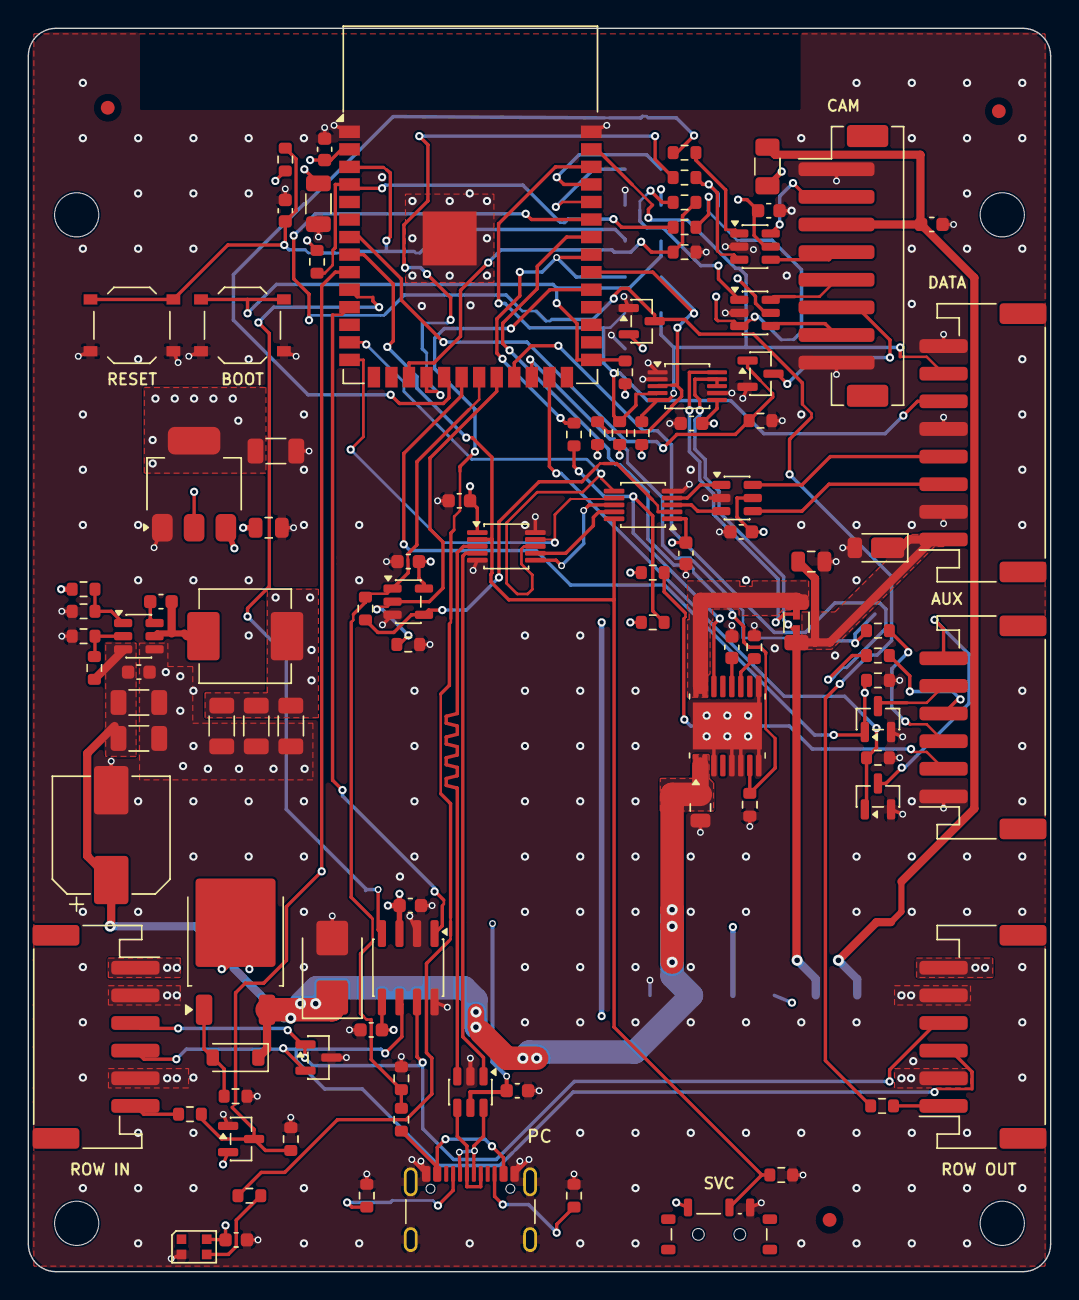
[picture p235: board bay-node.kicad_pcb from above]

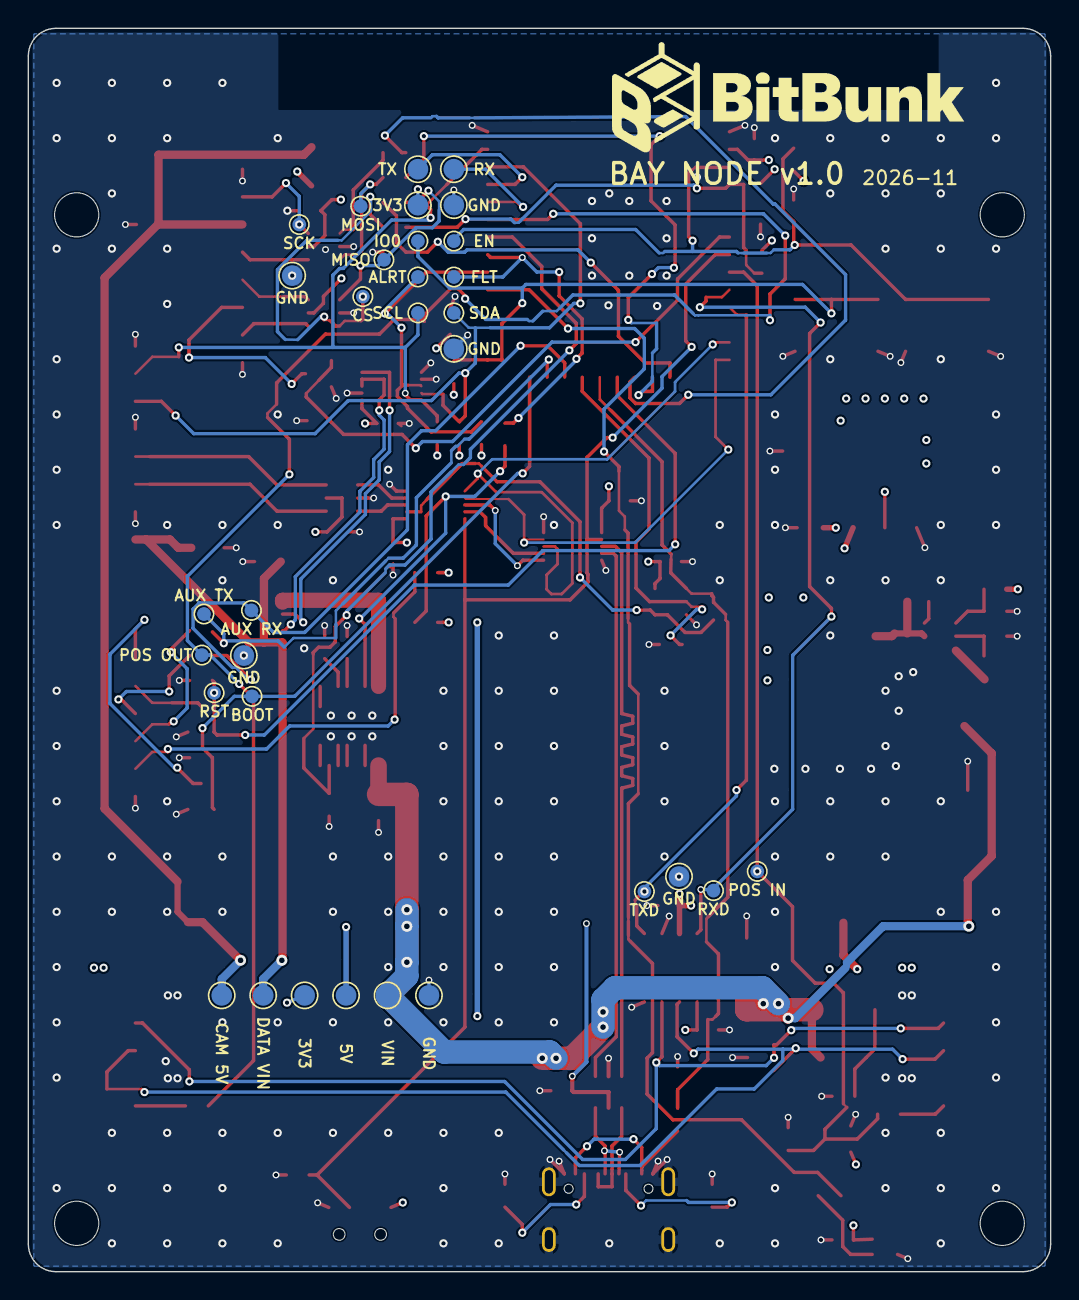
[picture p236: board bay-node.kicad_pcb from below]

Board: 4 copper layers, 74.0 x 90.0 mm, 139 parts (32 on the bottom side), 79 nets.
