kartben/hw-testing-rack/electronics/power-hub/power-hub.kicad_pcb

## KiCad design electronics/power-hub/power-hub.kicad_pcb (2026-11-10)

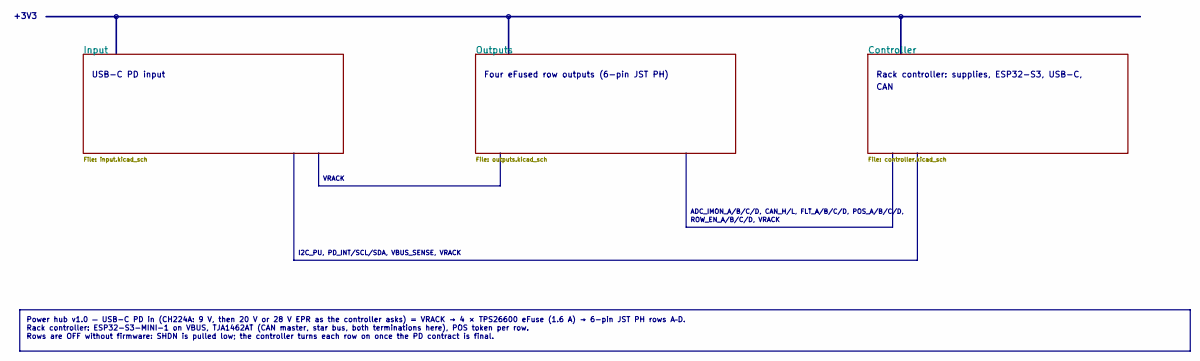
[picture p237: schematic power-hub.kicad_sch, Power hub — Overview]

Notes on the sheet:
USB-C PD input
Four eFused row outputs (6-pin JST PH)
Rack controller: supplies, ESP32-S3, USB-C,
CAN
+3V3
VRACK
ADC_IMON_A/B/C/D, CAN_H/L, FLT_A/B/C/D, POS_A/B/C/D,
ROW_EN_A/B/C/D, VRACK
I2C_PU, PD_INT/SCL/SDA, VBUS_SENSE, VRACK
Power hub v1.0 — USB-C PD in (CH224A: 9 V, then 20 V or 28 V EPR as the controller asks) = VRACK → 4 × TPS26600 eFuse (1.6 A) → 6-pin JST PH rows A–D. Rack controller: ESP32-S3-MINI-1 on VBUS, TJA1462AT (CAN master, star bus, both terminations here), POS token per row. Rows are OFF without firmware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

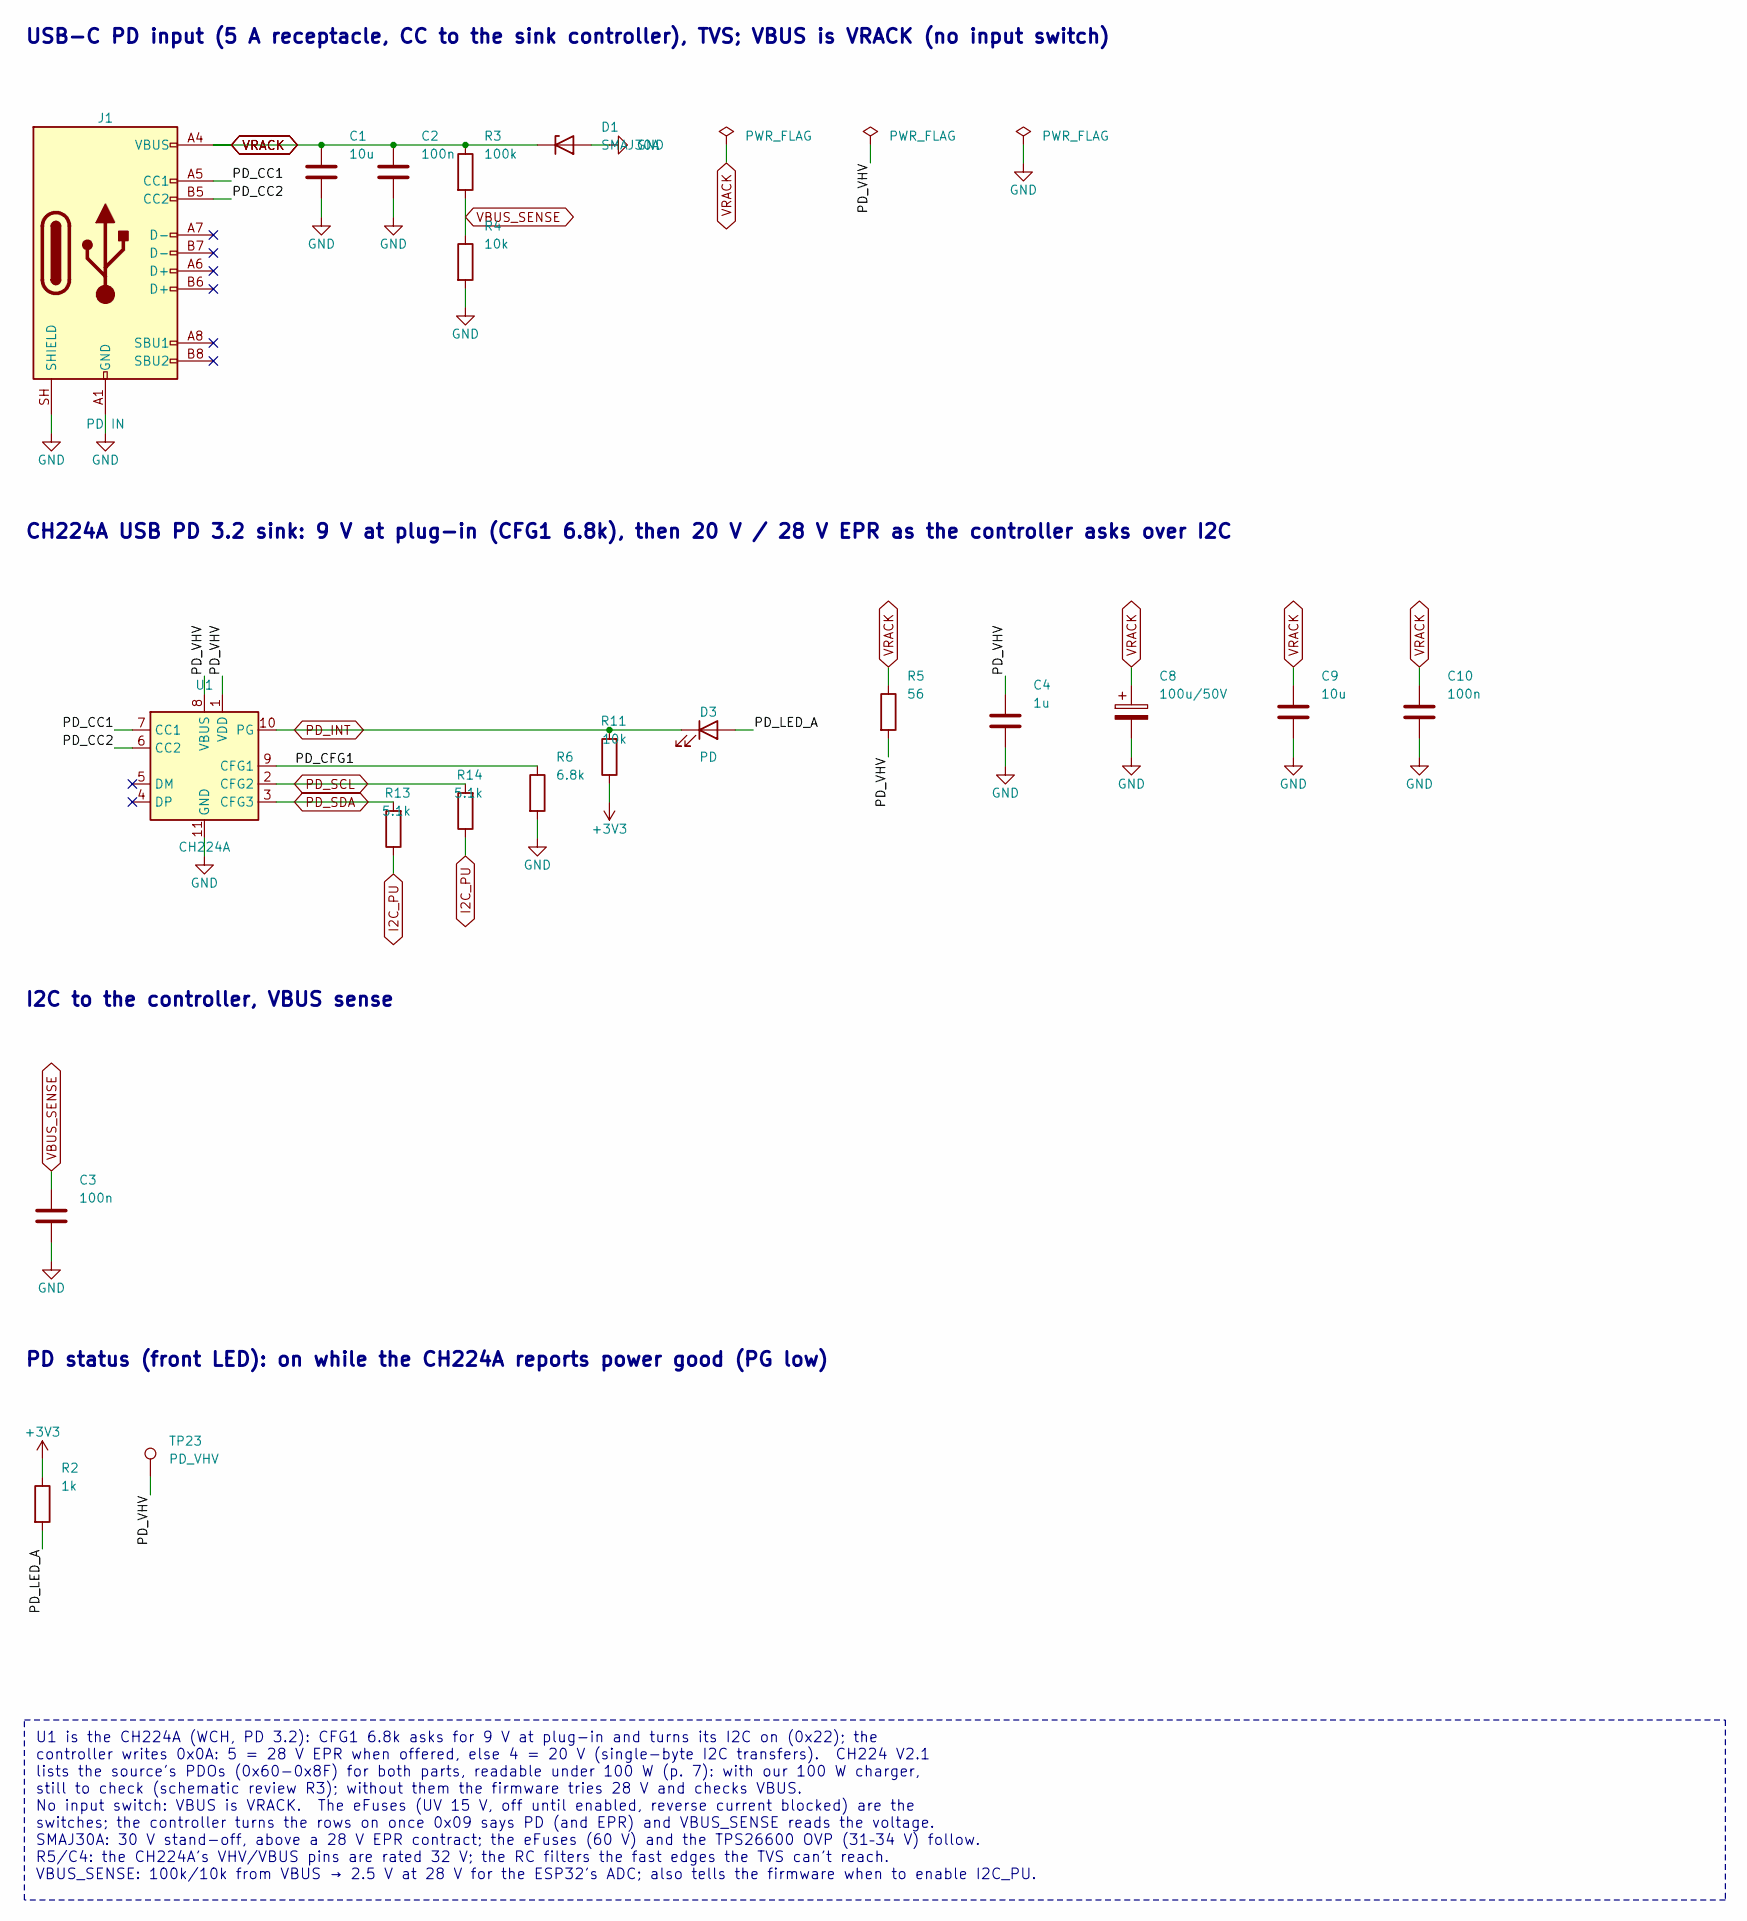
[picture p238: schematic input.kicad_sch, Power hub — USB-C PD input]

Parts:
C1, C9: 10u; C_1206_3216Metric; MPN CL31A106KBHNNNE; LCSC C13585
C2, C3, C10: 100n; C_0603_1608Metric; MPN CC0603KRX7R9BB104; LCSC C14663
C4: 1u; C_0805_2012Metric; MPN CL21B105KBFNNNE; LCSC C28323
C8: 100u/50V; CP_Elec_8x10; MPN RVT1H101M0810; LCSC C3352
D1: SMAJ30A; D_SMA; MPN SMAJ30A; LCSC C113965
D3: PD; LED_Kingbright_KPA-3010_3x2x1mm; MPN KPA-3010CGCK; LCSC C598310
J1: PD IN; USB_C_Receptacle_GCT_USB4105-xx-A_16P_TopMnt_Horizontal; MPN USB4105-GF-A-120; LCSC C5184243
R2: 1k; R_0603_1608Metric; MPN 0603WAF1001T5E; LCSC C21190
R3: 100k; R_0603_1608Metric; MPN 0603WAF1003T5E; LCSC C25803
R4, R11: 10k; R_0603_1608Metric; MPN 0603WAF1002T5E; LCSC C25804
R5: 56; R_0603_1608Metric; MPN 0603WAF560JT5E; LCSC C25196
R6: 6.8k; R_0603_1608Metric; MPN 0603WAF6801T5E; LCSC C23212
R13, R14: 5.1k; R_0603_1608Metric; MPN 0603WAF5101T5E; LCSC C23186
TP23: PD_VHV; TestPoint_Pad_D1.5mm; MPN test pad
U1: CH224A; SSOP-10-1EP_3.9x4.9mm_P1mm_EP2.1x3.3mm; MPN CH224A; LCSC C42459160

Connections:
+3V3: R2.1, R11.1; also elsewhere on the board
/Input/PD_CC1: J1.A5 (CC1), U1.7 (CC1)
/Input/PD_CC2: J1.B5 (CC2), U1.6 (CC2)
/Input/PD_CFG1: R6.1, U1.9 (CFG1)
/Input/PD_LED_A: D3.2 (A), R2.2
/Input/PD_VHV: C4.1, R5.2, TP23.1, U1.1 (VDD), U1.8 (VBUS)
GND: C1.2, C2.2, C3.2, C4.2, C8.2, C9.2, C10.2, D1.2 (A), J1.A1 (GND), J1.A12 (GND), J1.B1 (GND), J1.B12 (GND), J1.SH (SHIELD), R4.2, R6.2, U1.11 (GND); also elsewhere on the board
I2C_PU: R13.1, R14.1; also elsewhere on the board
PD_INT: D3.1 (K), R11.2, U1.10 (PG); also elsewhere on the board
PD_SCL: R14.2, U1.2 (CFG2); also elsewhere on the board
PD_SDA: R13.2, U1.3 (CFG3); also elsewhere on the board
VBUS_SENSE: C3.1, R3.2, R4.1; also elsewhere on the board
VRACK: C1.1, C2.1, C8.1, C9.1, C10.1, D1.1 (K), J1.A4 (VBUS), J1.A9 (VBUS), J1.B4 (VBUS), J1.B9 (VBUS), R3.1, R5.1; also elsewhere on the board

Notes on the sheet:
USB-C PD input (5 A receptacle, CC to the sink controller), TVS; VBUS is VRACK (no input switch)
CH224A USB PD 3.2 sink: 9 V at plug-in (CFG1 6.8k), then 20 V / 28 V EPR as the controller asks over I2C
I2C to the controller, VBUS sense
PD status (front LED): on while the CH224A reports power good (PG low)
U1 is the CH224A (WCH, PD 3.2): CFG1 6.8k asks for 9 V at plug-in and turns its I2C on (0x22); the controller writes 0x0A: 5 = 28 V EPR when offered, else 4 = 20 V (single-byte I2C transfers). CH224 V2.1 lists the source's PDOs (0x60-0x8F) for both parts, readable under 100 W (p. 7): with our 100 W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

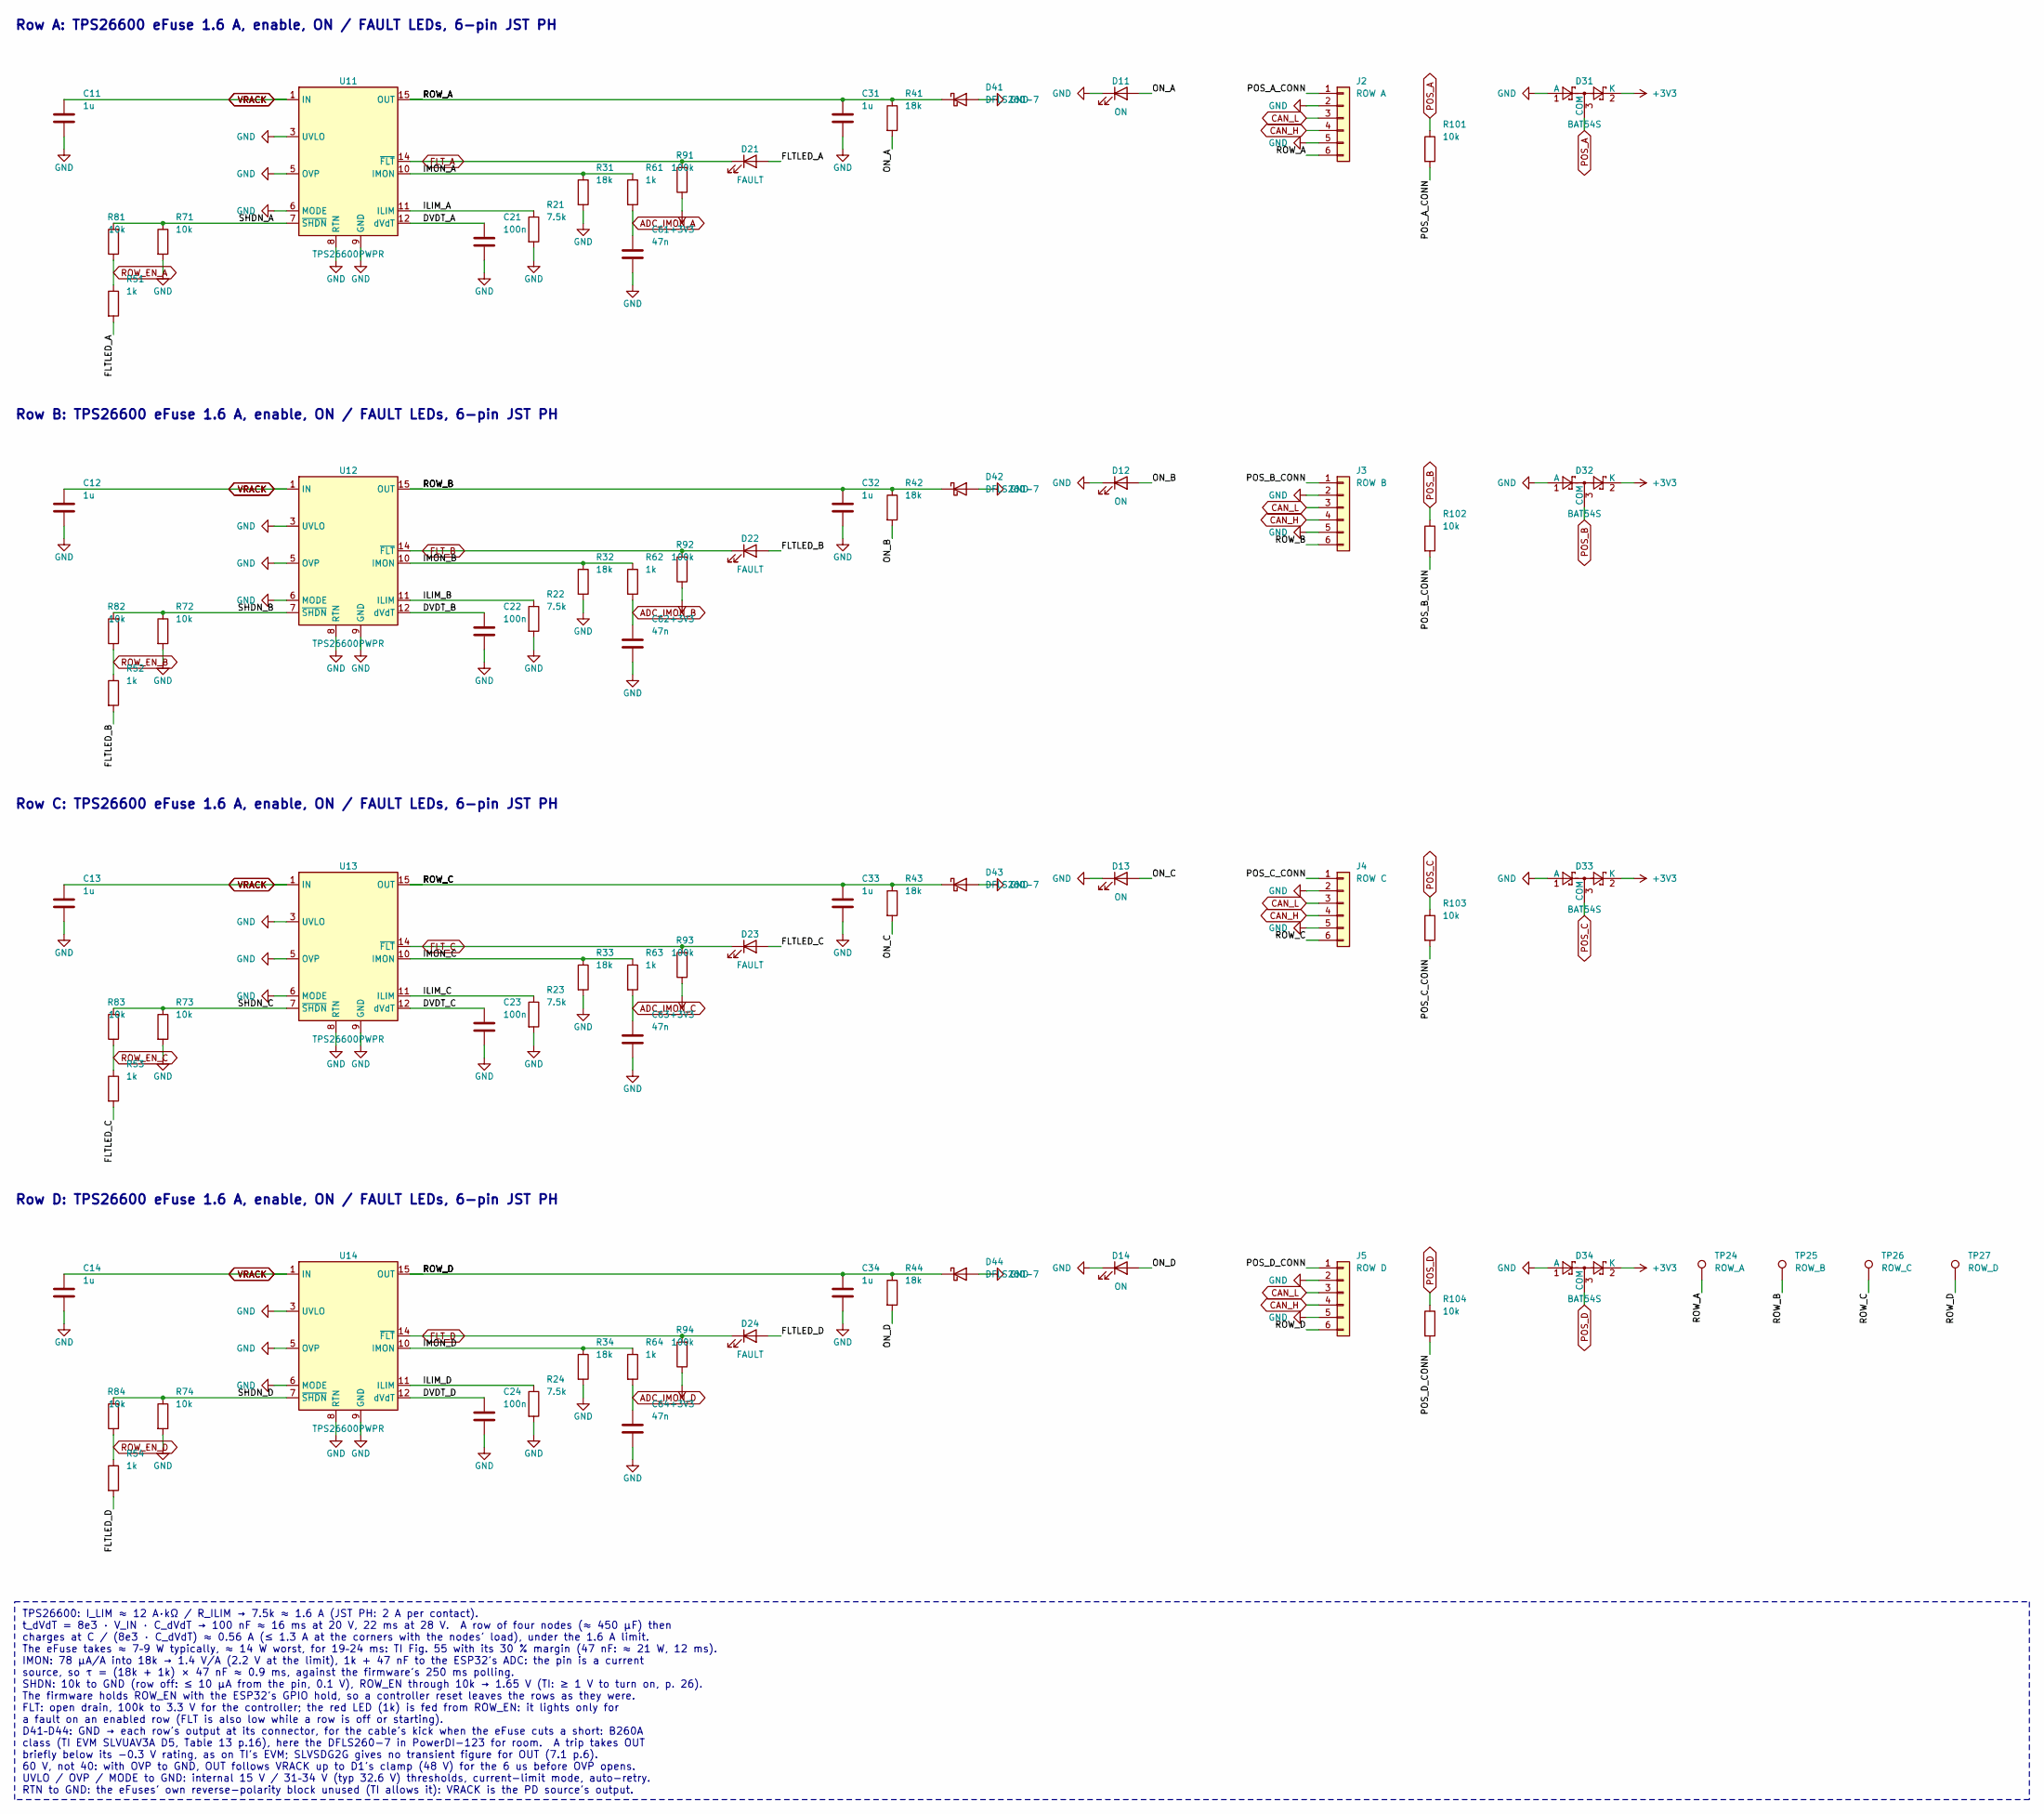
[picture p239: schematic outputs.kicad_sch, Power hub — Four eFused row outputs (6-pin JST PH)]

Parts:
C11, C12, C13, C14, C31, C32, C33, C34: 1u; C_0805_2012Metric; MPN CL21B105KBFNNNE; LCSC C28323
C21, C22, C23, C24: 100n; C_0603_1608Metric; MPN CC0603KRX7R9BB104; LCSC C14663
C61, C62, C63, C64: 47n; C_0603_1608Metric; MPN CL10B473KB8NNNC; LCSC C1622
D11, D12, D13, D14: ON; LED_Kingbright_KPA-3010_3x2x1mm; MPN KPA-3010CGCK; LCSC C598310
D21, D22, D23, D24: FAULT; LED_Kingbright_KPA-3010_3x2x1mm; MPN KPA-3010SURCK; LCSC C4555382
D31, D32, D33, D34: BAT54S; SOT-23; MPN BAT54S; LCSC C7420333
D41, D42, D43, D44: DFLS260-7; D_PowerDI-123; MPN DFLS260-7; LCSC C209346
J2: ROW A; JST_PH_S6B-PH-SM4-TB_1x06-1MP_P2.00mm_Horizontal; MPN S6B-PH-SM4-TB(LF)(SN); LCSC C265405
J3: ROW B; JST_PH_S6B-PH-SM4-TB_1x06-1MP_P2.00mm_Horizontal; MPN S6B-PH-SM4-TB(LF)(SN); LCSC C265405
J4: ROW C; JST_PH_S6B-PH-SM4-TB_1x06-1MP_P2.00mm_Horizontal; MPN S6B-PH-SM4-TB(LF)(SN); LCSC C265405
J5: ROW D; JST_PH_S6B-PH-SM4-TB_1x06-1MP_P2.00mm_Horizontal; MPN S6B-PH-SM4-TB(LF)(SN); LCSC C265405
R21, R22, R23, R24: 7.5k; R_0603_1608Metric; MPN 0603WAF7501T5E; LCSC C23234
R31, R32, R33, R34, R41, R42, R43, R44: 18k; R_0603_1608Metric; MPN 0603WAF1802T5E; LCSC C25810
R51, R52, R53, R54, R61, R62, R63, R64: 1k; R_0603_1608Metric; MPN 0603WAF1001T5E; LCSC C21190
R71, R72, R73, R74, R81, R82, R83, R84, R101, R102, R103, R104: 10k; R_0603_1608Metric; MPN 0603WAF1002T5E; LCSC C25804
R91, R92, R93, R94: 100k; R_0603_1608Metric; MPN 0603WAF1003T5E; LCSC C25803
TP24: ROW_A; TestPoint_Pad_D1.5mm; MPN test pad
TP25: ROW_B; TestPoint_Pad_D1.5mm; MPN test pad
TP26: ROW_C; TestPoint_Pad_D1.5mm; MPN test pad
TP27: ROW_D; TestPoint_Pad_D1.5mm; MPN test pad
U11, U12, U13, U14: TPS26600PWPR; HTSSOP-16-1EP_4.4x5mm_P0.65mm_EP3.4x5mm_Mask2.66x2.46mm; MPN TPS26600PWPR; LCSC C544399

Connections:
+3V3: D31.2 (K), D32.2 (K), D33.2 (K), D34.2 (K), R91.1, R92.1, R93.1, R94.1; also elsewhere on the board
/Outputs/DVDT_A: C21.1, U11.12 (dVdT)
/Outputs/DVDT_B: C22.1, U12.12 (dVdT)
/Outputs/DVDT_C: C23.1, U13.12 (dVdT)
/Outputs/DVDT_D: C24.1, U14.12 (dVdT)
/Outputs/FLTLED_A: D21.2 (A), R51.2
/Outputs/FLTLED_B: D22.2 (A), R52.2
/Outputs/FLTLED_C: D23.2 (A), R53.2
/Outputs/FLTLED_D: D24.2 (A), R54.2
/Outputs/ILIM_A: R21.1, U11.11 (ILIM)
/Outputs/ILIM_B: R22.1, U12.11 (ILIM)
/Outputs/ILIM_C: R23.1, U13.11 (ILIM)
/Outputs/ILIM_D: R24.1, U14.11 (ILIM)
/Outputs/IMON_A: R31.1, R61.1, U11.10 (IMON)
/Outputs/IMON_B: R32.1, R62.1, U12.10 (IMON)
/Outputs/IMON_C: R33.1, R63.1, U13.10 (IMON)
/Outputs/IMON_D: R34.1, R64.1, U14.10 (IMON)
/Outputs/ON_A: D11.2 (A), R41.2
/Outputs/ON_B: D12.2 (A), R42.2
/Outputs/ON_C: D13.2 (A), R43.2
/Outputs/ON_D: D14.2 (A), R44.2
/Outputs/POS_A_CONN: J2.1, R101.2
/Outputs/POS_B_CONN: J3.1, R102.2
/Outputs/POS_C_CONN: J4.1, R103.2
/Outputs/POS_D_CONN: J5.1, R104.2
/Outputs/ROW_A: C31.1, D41.1 (K), J2.6, R41.1, TP24.1, U11.15 (OUT), U11.16 (OUT)
/Outputs/ROW_B: C32.1, D42.1 (K), J3.6, R42.1, TP25.1, U12.15 (OUT), U12.16 (OUT)
/Outputs/ROW_C: C33.1, D43.1 (K), J4.6, R43.1, TP26.1, U13.15 (OUT), U13.16 (OUT)
/Outputs/ROW_D: C34.1, D44.1 (K), J5.6, R44.1, TP27.1, U14.15 (OUT), U14.16 (OUT)
/Outputs/SHDN_A: R71.1, R81.2, U11.7 (~SHDN)
/Outputs/SHDN_B: R72.1, R82.2, U12.7 (~SHDN)
/Outputs/SHDN_C: R73.1, R83.2, U13.7 (~SHDN)
/Outputs/SHDN_D: R74.1, R84.2, U14.7 (~SHDN)
ADC_IMON_A: C61.1, R61.2; also elsewhere on the board
ADC_IMON_B: C62.1, R62.2; also elsewhere on the board
ADC_IMON_C: C63.1, R63.2; also elsewhere on the board
ADC_IMON_D: C64.1, R64.2; also elsewhere on the board
CAN_H: J2.4, J3.4, J4.4, J5.4; also elsewhere on the board
CAN_L: J2.3, J3.3, J4.3, J5.3; also elsewhere on the board
FLT_A: D21.1 (K), R91.2, U11.14 (~FLT); also elsewhere on the board
FLT_B: D22.1 (K), R92.2, U12.14 (~FLT); also elsewhere on the board
FLT_C: D23.1 (K), R93.2, U13.14 (~FLT); also elsewhere on the board
FLT_D: D24.1 (K), R94.2, U14.14 (~FLT); also elsewhere on the board
GND: C11.2, C12.2, C13.2, C14.2, C21.2, C22.2, C23.2, C24.2, C31.2, C32.2, C33.2, C34.2, C61.2, C62.2, C63.2, C64.2, D11.1 (K), D12.1 (K), D13.1 (K), D14.1 (K), D31.1 (A), D32.1 (A), D33.1 (A), D34.1 (A), D41.2 (A), D42.2 (A), D43.2 (A), D44.2 (A), J2.2, J2.5, J3.2, J3.5, J4.2, J4.5, J5.2, J5.5, R21.2, R22.2, R23.2, R24.2, R31.2, R32.2, R33.2, R34.2, R71.2, R72.2, R73.2, R74.2, U11.3 (UVLO), U11.5 (OVP), U11.6 (MODE), U11.8 (RTN), U11.9 (GND), U11.17 (RTN), U12.3 (UVLO), U12.5 (OVP), U12.6 (MODE), U12.8 (RTN), U12.9 (GND), U12.17 (RTN), U13.3 (UVLO), U13.5 (OVP), U13.6 (MODE), U13.8 (RTN), U13.9 (GND), U13.17 (RTN), U14.3 (UVLO), U14.5 (OVP), U14.6 (MODE), U14.8 (RTN), U14.9 (GND), U14.17 (RTN); also elsewhere on the board
POS_A: D31.3 (COM), R101.1; also elsewhere on the board
POS_B: D32.3 (COM), R102.1; also elsewhere on the board
POS_C: D33.3 (COM), R103.1; also elsewhere on the board
POS_D: D34.3 (COM), R104.1; also elsewhere on the board
ROW_EN_A: R51.1, R81.1; also elsewhere on the board
ROW_EN_B: R52.1, R82.1; also elsewhere on the board
ROW_EN_C: R53.1, R83.1; also elsewhere on the board
ROW_EN_D: R54.1, R84.1; also elsewhere on the board
VRACK: C11.1, C12.1, C13.1, C14.1, U11.1 (IN), U11.2 (IN), U12.1 (IN), U12.2 (IN), U13.1 (IN), U13.2 (IN), U14.1 (IN), U14.2 (IN); also elsewhere on the board

Notes on the sheet:
Row A: TPS26600 eFuse 1.6 A, enable, ON / FAULT LEDs, 6-pin JST PH
Row B: TPS26600 eFuse 1.6 A, enable, ON / FAULT LEDs, 6-pin JST PH
Row C: TPS26600 eFuse 1.6 A, enable, ON / FAULT LEDs, 6-pin JST PH
Row D: TPS26600 eFuse 1.6 A, enable, ON / FAULT LEDs, 6-pin JST PH
TPS26600: I_LIM ≈ 12 A·kΩ / R_ILIM → 7.5k ≈ 1.6 A (JST PH: 2 A per contact). t_dVdT = 8e3 · V_IN · C_dVdT → 100 nF ≈ 16 ms at 20 V, 22 ms at 28 V. A row of four nodes (≈ 450 µF) then charges at C / (8e3 · C_dVdT) ≈ 0.56 A (≤ 1.3 A at the corners with the nodes' load), under the 1.6 A limit. The eFu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
