kartben/hw-testing-rack/electronics/power-hub/power-hub.kicad_pcb

## KiCad design electronics/power-hub/power-hub.kicad_pcb (continued)

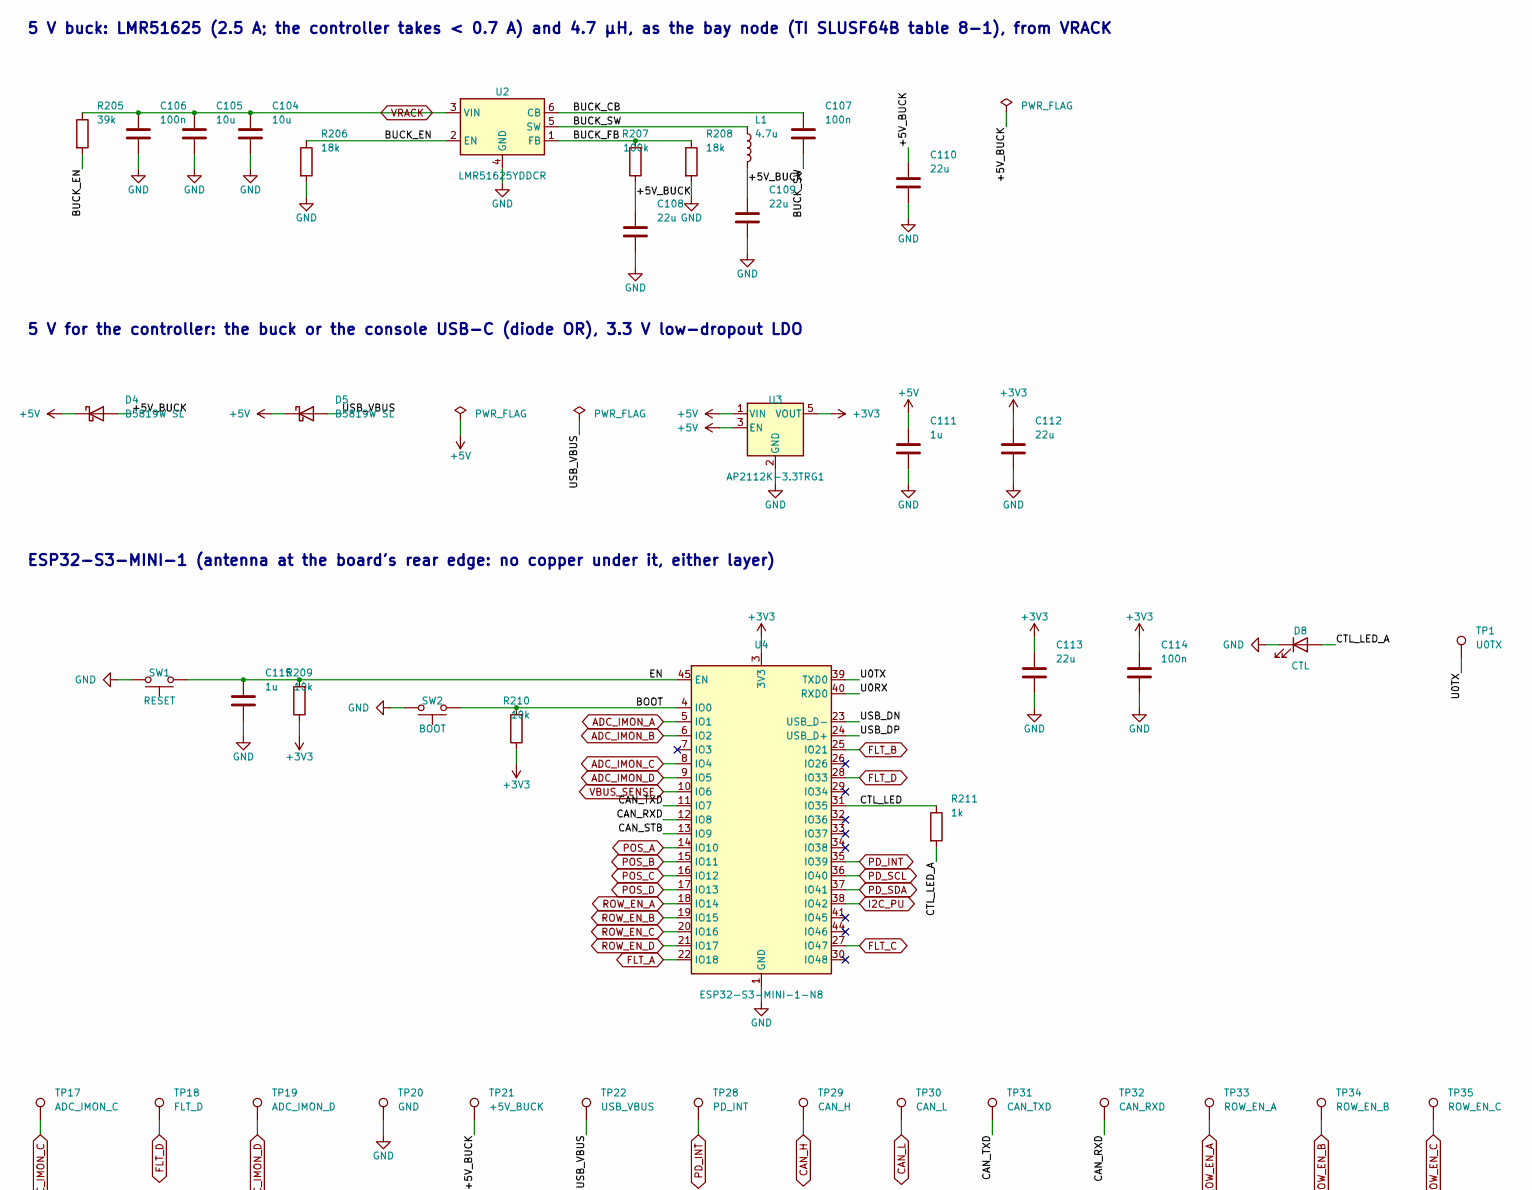
[picture p240: schematic controller.kicad_sch, Power hub — Rack controller: supplies, ESP32-S3, USB-C, CAN, part in row 1, column 1]

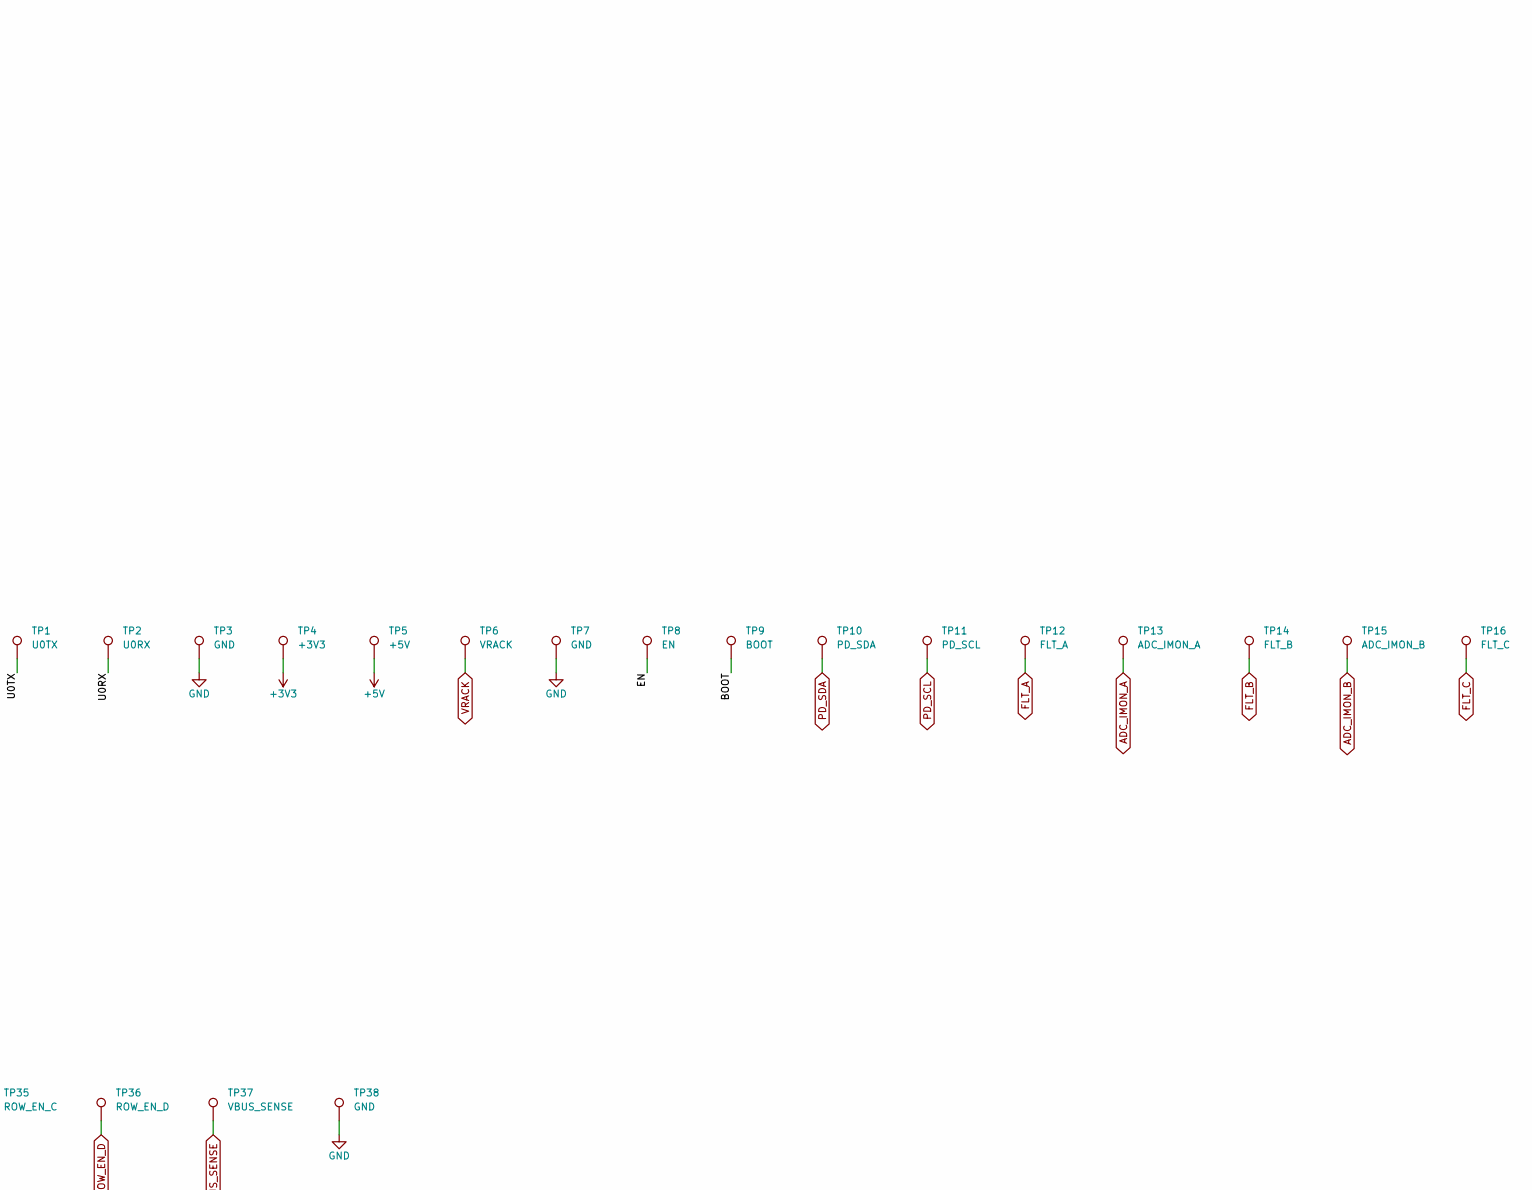
[picture p241: schematic controller.kicad_sch, Power hub — Rack controller: supplies, ESP32-S3, USB-C, CAN, part in row 1, column 2]

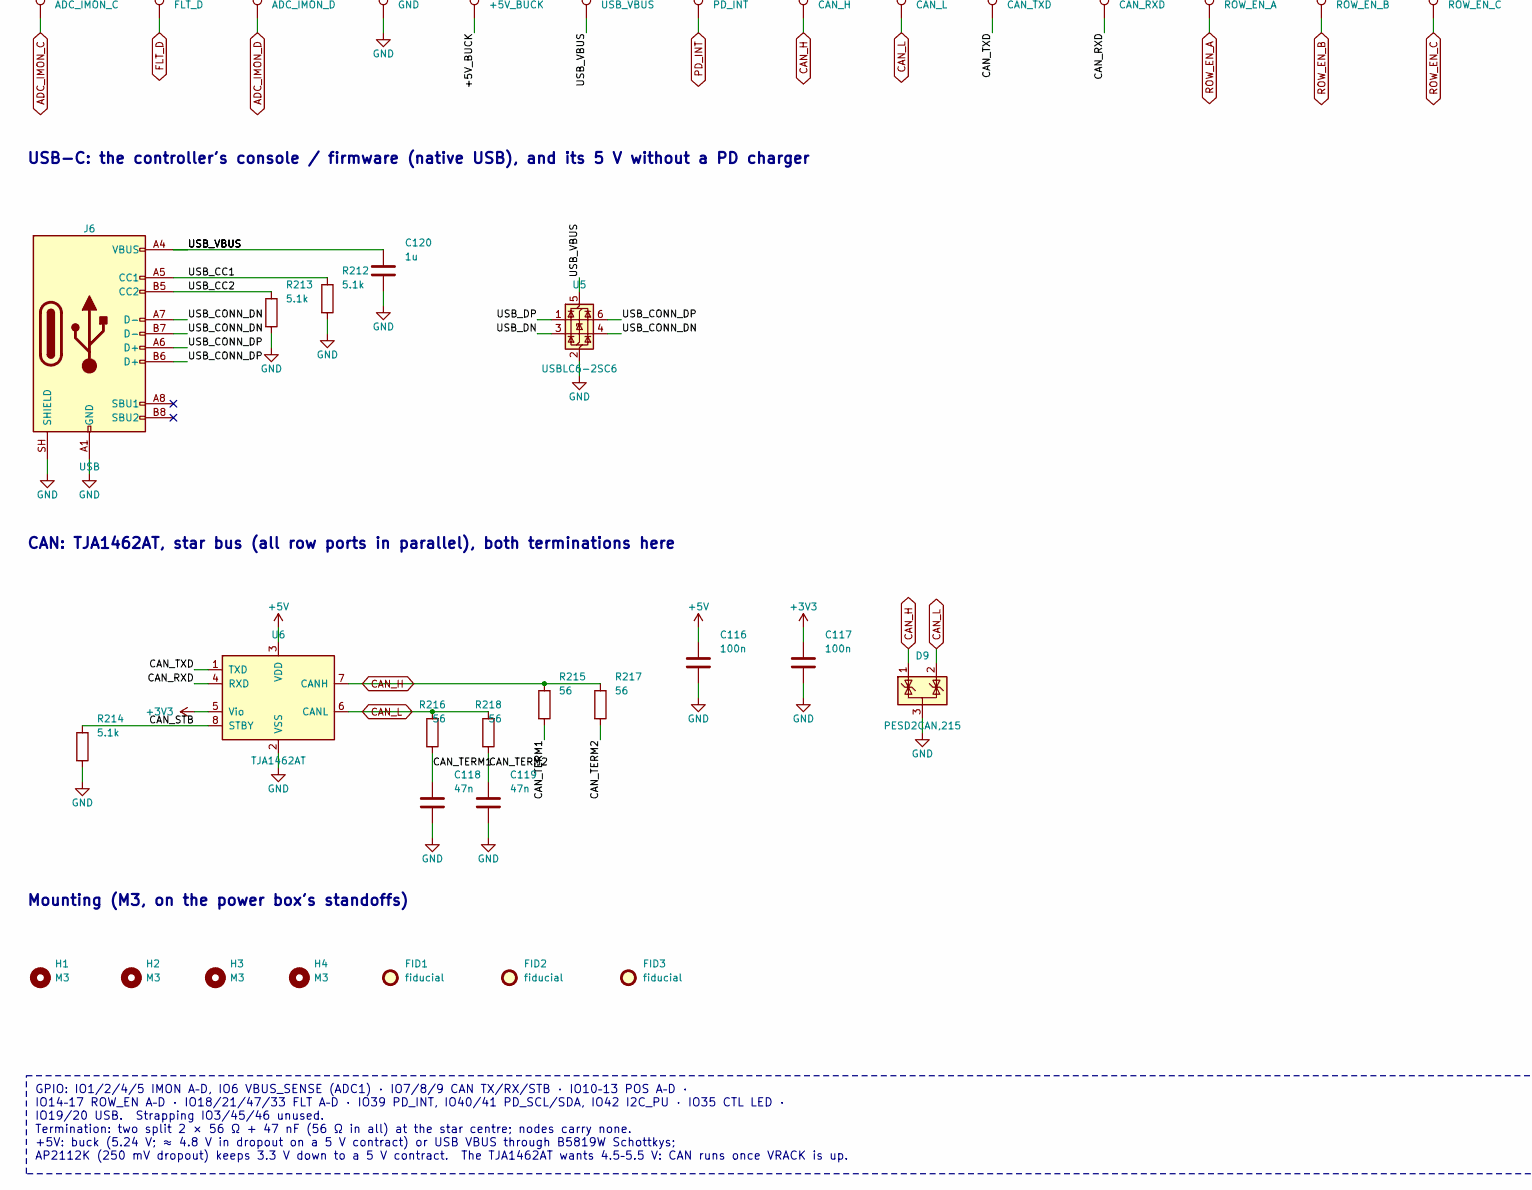
[picture p242: schematic controller.kicad_sch, Power hub — Rack controller: supplies, ESP32-S3, USB-C, CAN, part in row 2, column 1]

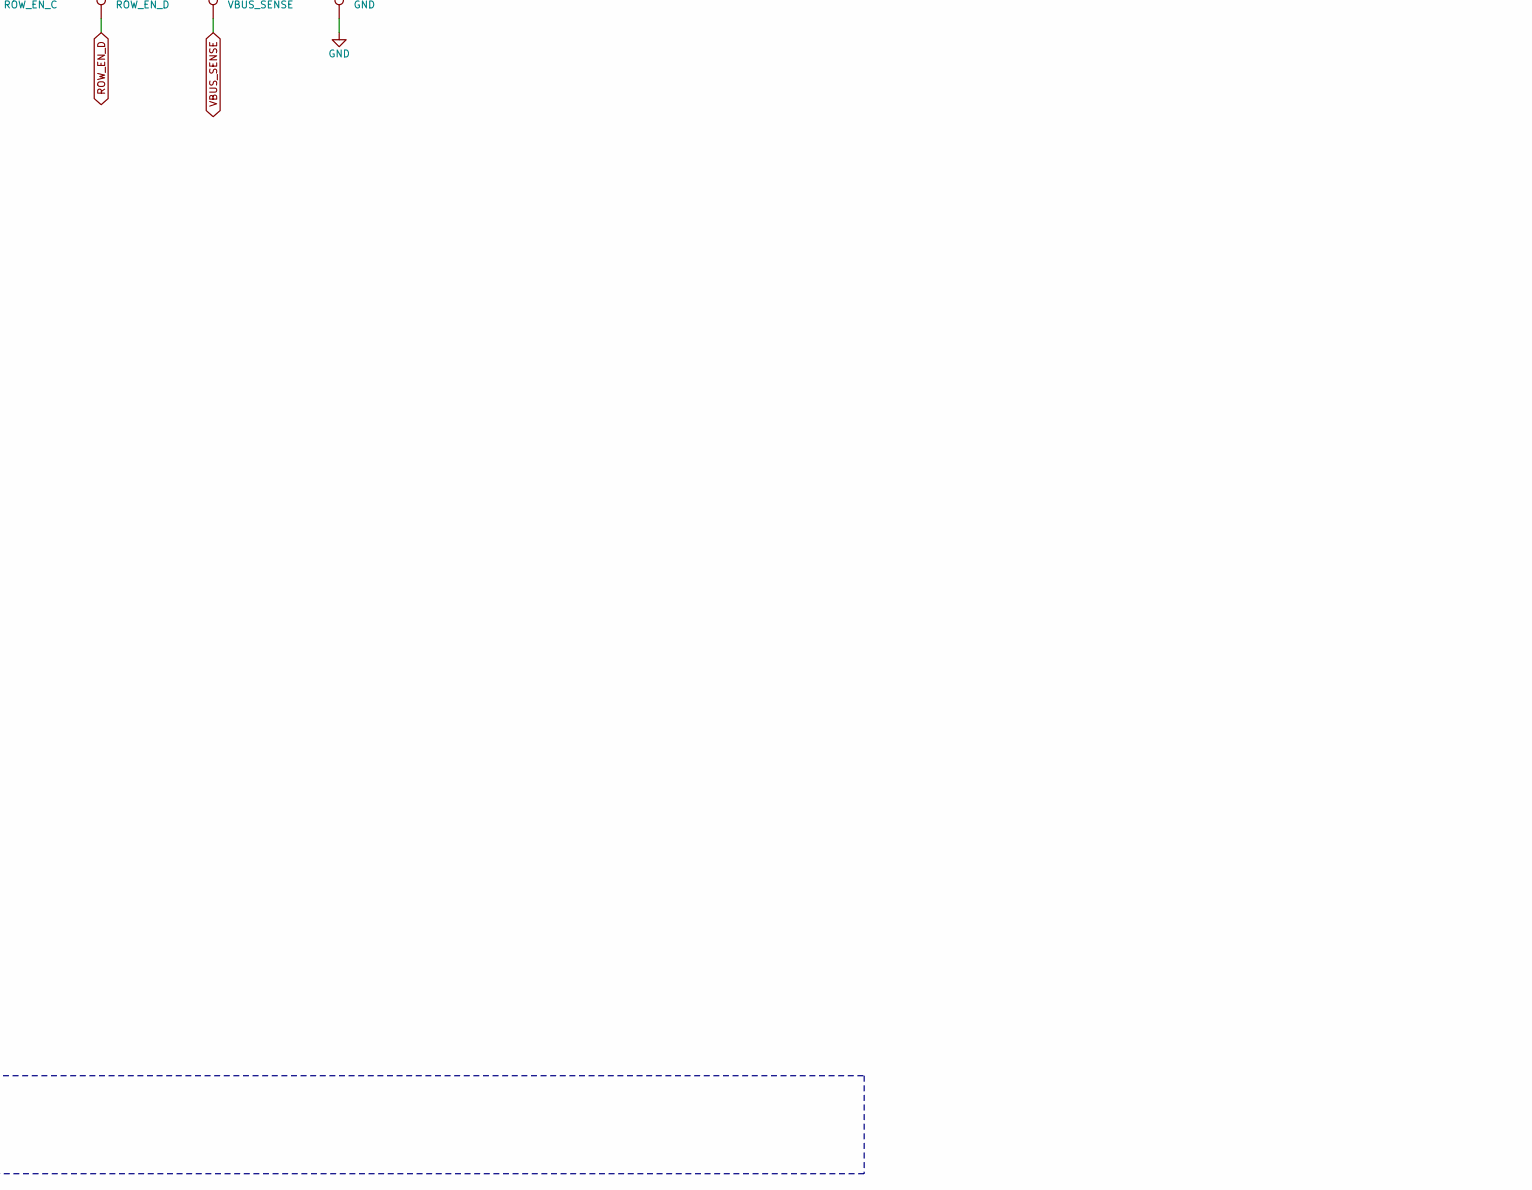
[picture p243: schematic controller.kicad_sch, Power hub — Rack controller: supplies, ESP32-S3, USB-C, CAN, part in row 2, column 2]

Parts:
C104, C105: 10u; C_1206_3216Metric; MPN CL31A106KBHNNNE; LCSC C13585
C106, C107, C114, C116, C117: 100n; C_0603_1608Metric; MPN CC0603KRX7R9BB104; LCSC C14663
C108, C109, C110, C112, C113: 22u; C_1206_3216Metric; MPN CL31A226KAHNNNE; LCSC C12891
C111: 1u; C_0805_2012Metric; MPN CL21B105KBFNNNE; LCSC C28323
C115, C120: 1u; C_0603_1608Metric; MPN CL10A105KB8NNNC; LCSC C15849
C118, C119: 47n; C_0603_1608Metric; MPN CL10B473KB8NNNC; LCSC C1622
D4, D5: B5819W SL; D_SOD-123; MPN B5819W SL; LCSC C8598
D8: CTL; LED_Kingbright_KPA-3010_3x2x1mm; MPN KPA-3010CGCK; LCSC C598310
D9: PESD2CAN,215; SOT-23; MPN PESD2CAN,215; LCSC C75176
FID1, FID2, FID3: fiducial; Fiducial_1mm_Mask2mm; MPN fiducial
H1, H2, H3, H4: M3; MountingHole_3.2mm_M3; MPN M3 mounting hole
J6: USB; USB_C_Receptacle_GCT_USB4105-xx-A_16P_TopMnt_Horizontal; MPN USB4105-GF-A-120; LCSC C5184243
L1: 4.7u; L_Changjiang_FXL0630; MPN IHLP2525CZEK4R7M01; LCSC C48009678
R205: 39k; R_0603_1608Metric; MPN 0603WAF3902T5E; LCSC C23153
R206, R208: 18k; R_0603_1608Metric; MPN 0603WAF1802T5E; LCSC C25810
R207: 100k; R_0603_1608Metric; MPN 0603WAF1003T5E; LCSC C25803
R209, R210: 10k; R_0603_1608Metric; MPN 0603WAF1002T5E; LCSC C25804
R211: 1k; R_0603_1608Metric; MPN 0603WAF1001T5E; LCSC C21190
R212, R213, R214: 5.1k; R_0603_1608Metric; MPN 0603WAF5101T5E; LCSC C23186
R215, R216, R217, R218: 56; R_0603_1608Metric; MPN 0603WAF560JT5E; LCSC C25196
SW1: RESET; SW_Push_1P1T_XKB_TS-1187A; MPN TS-1187A-B-A-B; LCSC C318884
SW2: BOOT; SW_Push_1P1T_XKB_TS-1187A; MPN TS-1187A-B-A-B; LCSC C318884
TP1: U0TX; TestPoint_Pad_D1.5mm; MPN test pad
TP2: U0RX; TestPoint_Pad_D1.5mm; MPN test pad
TP3, TP7, TP20, TP38: GND; TestPoint_Pad_D1.5mm; MPN test pad
TP4: +3V3; TestPoint_Pad_D1.5mm; MPN test pad
TP5: +5V; TestPoint_Pad_D1.5mm; MPN test pad
TP6: VRACK; TestPoint_Pad_D1.5mm; MPN test pad
TP8: EN; TestPoint_Pad_D1.0mm; MPN test pad
TP9: BOOT; TestPoint_Pad_D1.0mm; MPN test pad
TP10: PD_SDA; TestPoint_Pad_D1.0mm; MPN test pad
TP11: PD_SCL; TestPoint_Pad_D1.0mm; MPN test pad
TP12: FLT_A; TestPoint_Pad_D1.0mm; MPN test pad
TP13: ADC_IMON_A; TestPoint_Pad_D1.0mm; MPN test pad
TP14: FLT_B; TestPoint_Pad_D1.0mm; MPN test pad
TP15: ADC_IMON_B; TestPoint_Pad_D1.0mm; MPN test pad
TP16: FLT_C; TestPoint_Pad_D1.0mm; MPN test pad
TP17: ADC_IMON_C; TestPoint_Pad_D1.0mm; MPN test pad
TP18: FLT_D; TestPoint_Pad_D1.0mm; MPN test pad
TP19: ADC_IMON_D; TestPoint_Pad_D1.0mm; MPN test pad
TP21: +5V_BUCK; TestPoint_Pad_D1.5mm; MPN test pad
TP22: USB_VBUS; TestPoint_Pad_D1.5mm; MPN test pad
TP28: PD_INT; TestPoint_Pad_D1.0mm; MPN test pad
TP29: CAN_H; TestPoint_Pad_D1.0mm; MPN test pad
TP30: CAN_L; TestPoint_Pad_D1.0mm; MPN test pad
TP31: CAN_TXD; TestPoint_Pad_D1.0mm; MPN test pad
TP32: CAN_RXD; TestPoint_Pad_D1.0mm; MPN test pad
TP33: ROW_EN_A; TestPoint_Pad_D1.0mm; MPN test pad
TP34: ROW_EN_B; TestPoint_Pad_D1.0mm; MPN test pad
TP35: ROW_EN_C; TestPoint_Pad_D1.0mm; MPN test pad
TP36: ROW_EN_D; TestPoint_Pad_D1.0mm; MPN test pad
TP37: VBUS_SENSE; TestPoint_Pad_D1.0mm; MPN test pad
U2: LMR51625YDDCR; TSOT-23-6; MPN LMR51625YDDCR; LCSC C44991044
U3: AP2112K-3.3TRG1; SOT-23-5; MPN AP2112K-3.3TRG1; LCSC C51118
U4: ESP32-S3-MINI-1-N8; ESP32-S2-MINI-1; MPN ESP32-S3-MINI-1-N8; LCSC C2913206
U5: USBLC6-2SC6; SOT-23-6; MPN USBLC6-2SC6; LCSC C7519
U6: TJA1462AT; SOIC-8_3.9x4.9mm_P1.27mm; MPN TJA1462AT/0Z; LCSC C3234095

Connections:
+3V3: C112.1, C113.1, C114.1, C117.1, R209.1, R210.1, TP4.1, U3.5 (VOUT), U4.3 (3V3), U6.5 (Vio); also elsewhere on the board
+5V: C111.1, C116.1, D4.1 (K), D5.1 (K), TP5.1, U3.1 (VIN), U3.3 (EN), U6.3 (VDD)
/Controller/+5V_BUCK: C108.1, C109.1, C110.1, D4.2 (A), L1.2, R207.1, TP21.1
/Controller/BOOT: R210.2, SW2.1, TP9.1, U4.4 (IO0)
/Controller/BUCK_CB: C107.1, U2.6 (CB)
/Controller/BUCK_EN: R205.2, R206.1, U2.2 (EN)
/Controller/BUCK_FB: R207.2, R208.1, U2.1 (FB)
/Controller/BUCK_SW: C107.2, L1.1, U2.5 (SW)
/Controller/CAN_RXD: TP32.1, U4.12 (IO8), U6.4 (RXD)
/Controller/CAN_STB: R214.1, U4.13 (IO9), U6.8 (STBY)
/Controller/CAN_TERM1: C118.1, R215.2, R216.1
/Controller/CAN_TERM2: C119.1, R217.2, R218.1
/Controller/CAN_TXD: TP31.1, U4.11 (IO7), U6.1 (TXD)
/Controller/CTL_LED: R211.1, U4.31 (IO35)
/Controller/CTL_LED_A: D8.2 (A), R211.2
/Controller/EN: C115.1, R209.2, SW1.1, TP8.1, U4.45 (EN)
/Controller/U0RX: TP2.1, U4.40 (RXD0)
/Controller/U0TX: TP1.1, U4.39 (TXD0)
/Controller/USB_CC1: J6.A5 (CC1), R212.1
/Controller/USB_CC2: J6.B5 (CC2), R213.1
/Controller/USB_CONN_DN: J6.A7 (D-), J6.B7 (D-), U5.4 (I/O2)
/Controller/USB_CONN_DP: J6.A6 (D+), J6.B6 (D+), U5.6 (I/O1)
/Controller/USB_DN: U4.23 (USB_D-), U5.3 (I/O2)
/Controller/USB_DP: U4.24 (USB_D+), U5.1 (I/O1)
/Controller/USB_VBUS: C120.1, D5.2 (A), J6.A4 (VBUS), J6.A9 (VBUS), J6.B4 (VBUS), J6.B9 (VBUS), TP22.1, U5.5 (VBUS)
ADC_IMON_A: TP13.1, U4.5 (IO1); also elsewhere on the board
ADC_IMON_B: TP15.1, U4.6 (IO2); also elsewhere on the board
ADC_IMON_C: TP17.1, U4.8 (IO4); also elsewhere on the board
ADC_IMON_D: TP19.1, U4.9 (IO5); also elsewhere on the board
CAN_H: D9.1 (K), R215.1, R217.1, TP29.1, U6.7 (CANH); also elsewhere on the board
CAN_L: D9.2 (K), R216.2, R218.2, TP30.1, U6.6 (CANL); also elsewhere on the board
FLT_A: TP12.1, U4.22 (IO18); also elsewhere on the board
FLT_B: TP14.1, U4.25 (IO21); also elsewhere on the board
FLT_C: TP16.1, U4.27 (IO47); also elsewhere on the board
FLT_D: TP18.1, U4.28 (IO33); also elsewhere on the board
GND: C104.2, C105.2, C106.2, C108.2, C109.2, C110.2, C111.2, C112.2, C113.2, C114.2, C115.2, C116.2, C117.2, C118.2, C119.2, C120.2, D8.1 (K), D9.3 (A), J6.A1 (GND), J6.A12 (GND), J6.B1 (GND), J6.B12 (GND), J6.SH (SHIELD), R206.2, R208.2, R212.2, R213.2, R214.2, SW1.2, SW2.2, TP3.1, TP7.1, TP20.1, TP38.1, U2.4 (GND), U3.2 (GND), U4.1 (GND), U4.2 (GND), U4.42 (GND), U4.43 (GND), U4.46 (GND), U4.47 (GND), U4.48 (GND), U4.49 (GND), U4.50 (GND), U4.51 (GND), U4.52 (GND), U4.53 (GND), U4.54 (GND), U4.55 (GND), U4.56 (GND), U4.57 (GND), U4.58 (GND), U4.59 (GND), U4.60 (GND), U4.61 (GND), U4.62 (GND), U4.63 (GND), U4.64 (GND), U4.65 (GND), U5.2 (GND), U6.2 (VSS); also elsewhere on the board
I2C_PU: U4.38 (IO42); also elsewhere on the board
PD_INT: TP28.1, U4.35 (IO39); also elsewhere on the board
PD_SCL: TP11.1, U4.36 (IO40); also elsewhere on the board
PD_SDA: TP10.1, U4.37 (IO41); also elsewhere on the board
POS_A: U4.14 (IO10); also elsewhere on the board
POS_B: U4.15 (IO11); also elsewhere on the board
POS_C: U4.16 (IO12); also elsewhere on the board
POS_D: U4.17 (IO13); also elsewhere on the board
ROW_EN_A: TP33.1, U4.18 (IO14); also elsewhere on the board
ROW_EN_B: TP34.1, U4.19 (IO15); also elsewhere on the board
ROW_EN_C: TP35.1, U4.20 (IO16); also elsewhere on the board
ROW_EN_D: TP36.1, U4.21 (IO17); also elsewhere on the board
VBUS_SENSE: TP37.1, U4.10 (IO6); also elsewhere on the board
VRACK: C104.1, C105.1, C106.1, R205.1, TP6.1, U2.3 (VIN); also elsewhere on the board

Notes on the sheet:
5 V buck: LMR51625 (2.5 A; the controller takes < 0.7 A) and 4.7 µH, as the bay node (TI SLUSF64B table 8-1), from VRACK
5 V for the controller: the buck or the console USB-C (diode OR), 3.3 V low-dropout LDO
ESP32-S3-MINI-1 (antenna at the board's rear edge: no copper under it, either layer)
USB-C: the controller's console / firmware (native USB), and its 5 V without a PD charger
CAN: TJA1462AT, star bus (all row ports in parallel), both terminations here
Mounting (M3, on the power box's standoffs)
GPIO: IO1/2/4/5 IMON A–D, IO6 VBUS_SENSE (ADC1) · IO7/8/9 CAN TX/RX/STB · IO10–13 POS A–D · IO14–17 ROW_EN A–D · IO18/21/47/33 FLT A–D · IO39 PD_INT, IO40/41 PD_SCL/SDA, IO42 I2C_PU · IO35 CTL LED · IO19/20 USB. Strapping IO3/45/46 unused. Termination: two split 2 × 56 Ω + 47 nF (56 Ω in all) at th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

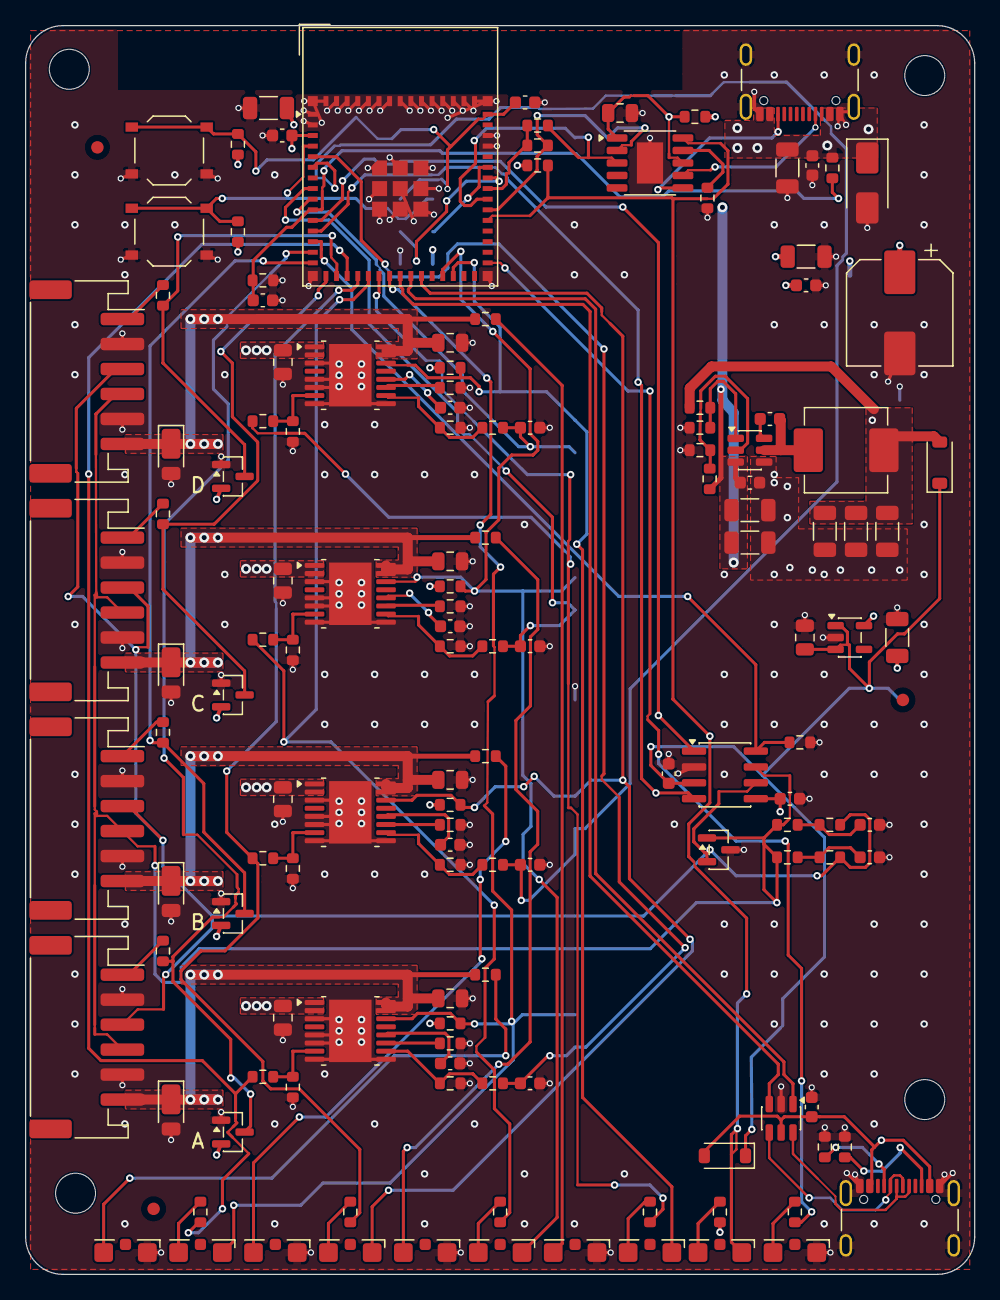
[picture p244: board power-hub.kicad_pcb from above]

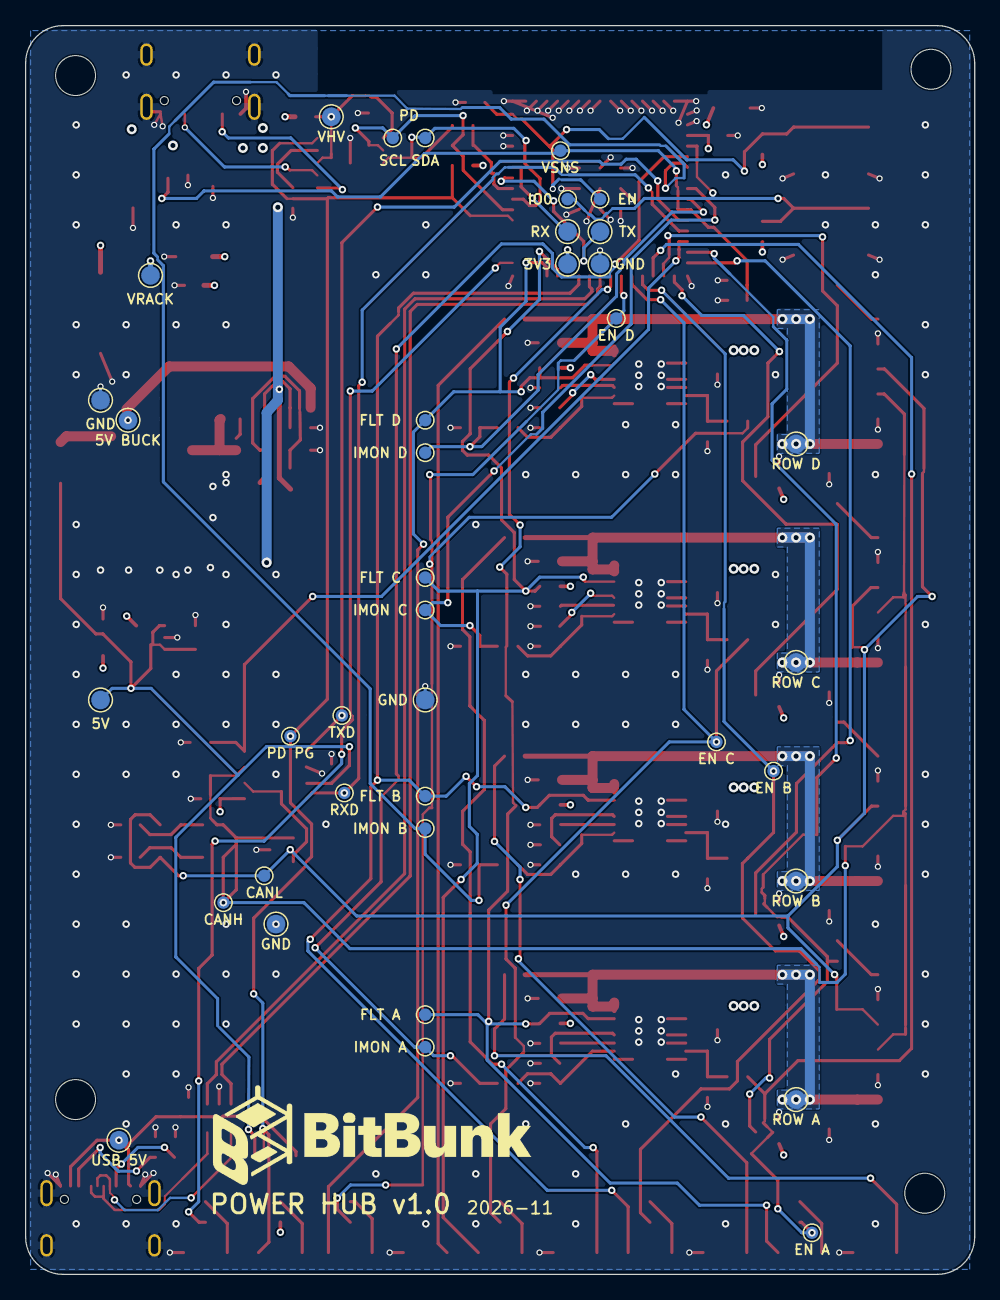
[picture p245: board power-hub.kicad_pcb from below]

Board: 4 copper layers, 76.0 x 100.0 mm, 184 parts (38 on the bottom side), 87 nets.
