kartben/hw-testing-rack/electronics/camera-pod/camera-pod.kicad_pcb

## KiCad design electronics/camera-pod/camera-pod.kicad_pcb (2026-11-10)

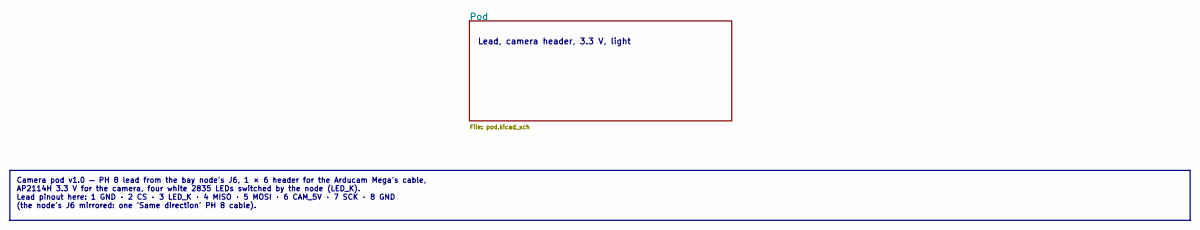
[picture p246: schematic camera-pod.kicad_sch, Camera pod — Overview]

Notes on the sheet:
Lead, camera header, 3.3 V, light
Camera pod v1.0 — PH 8 lead from the bay node's J6, 1 × 6 header for the Arducam Mega's cable, AP2114H 3.3 V for the camera, four white 2835 LEDs switched by the node (LED_K). Lead pinout here: 1 GND · 2 CS · 3 LED_K · 4 MISO · 5 MOSI · 6 CAM_5V · 7 SCK · 8 GND (the node's J6 mirrored: one 'Same di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

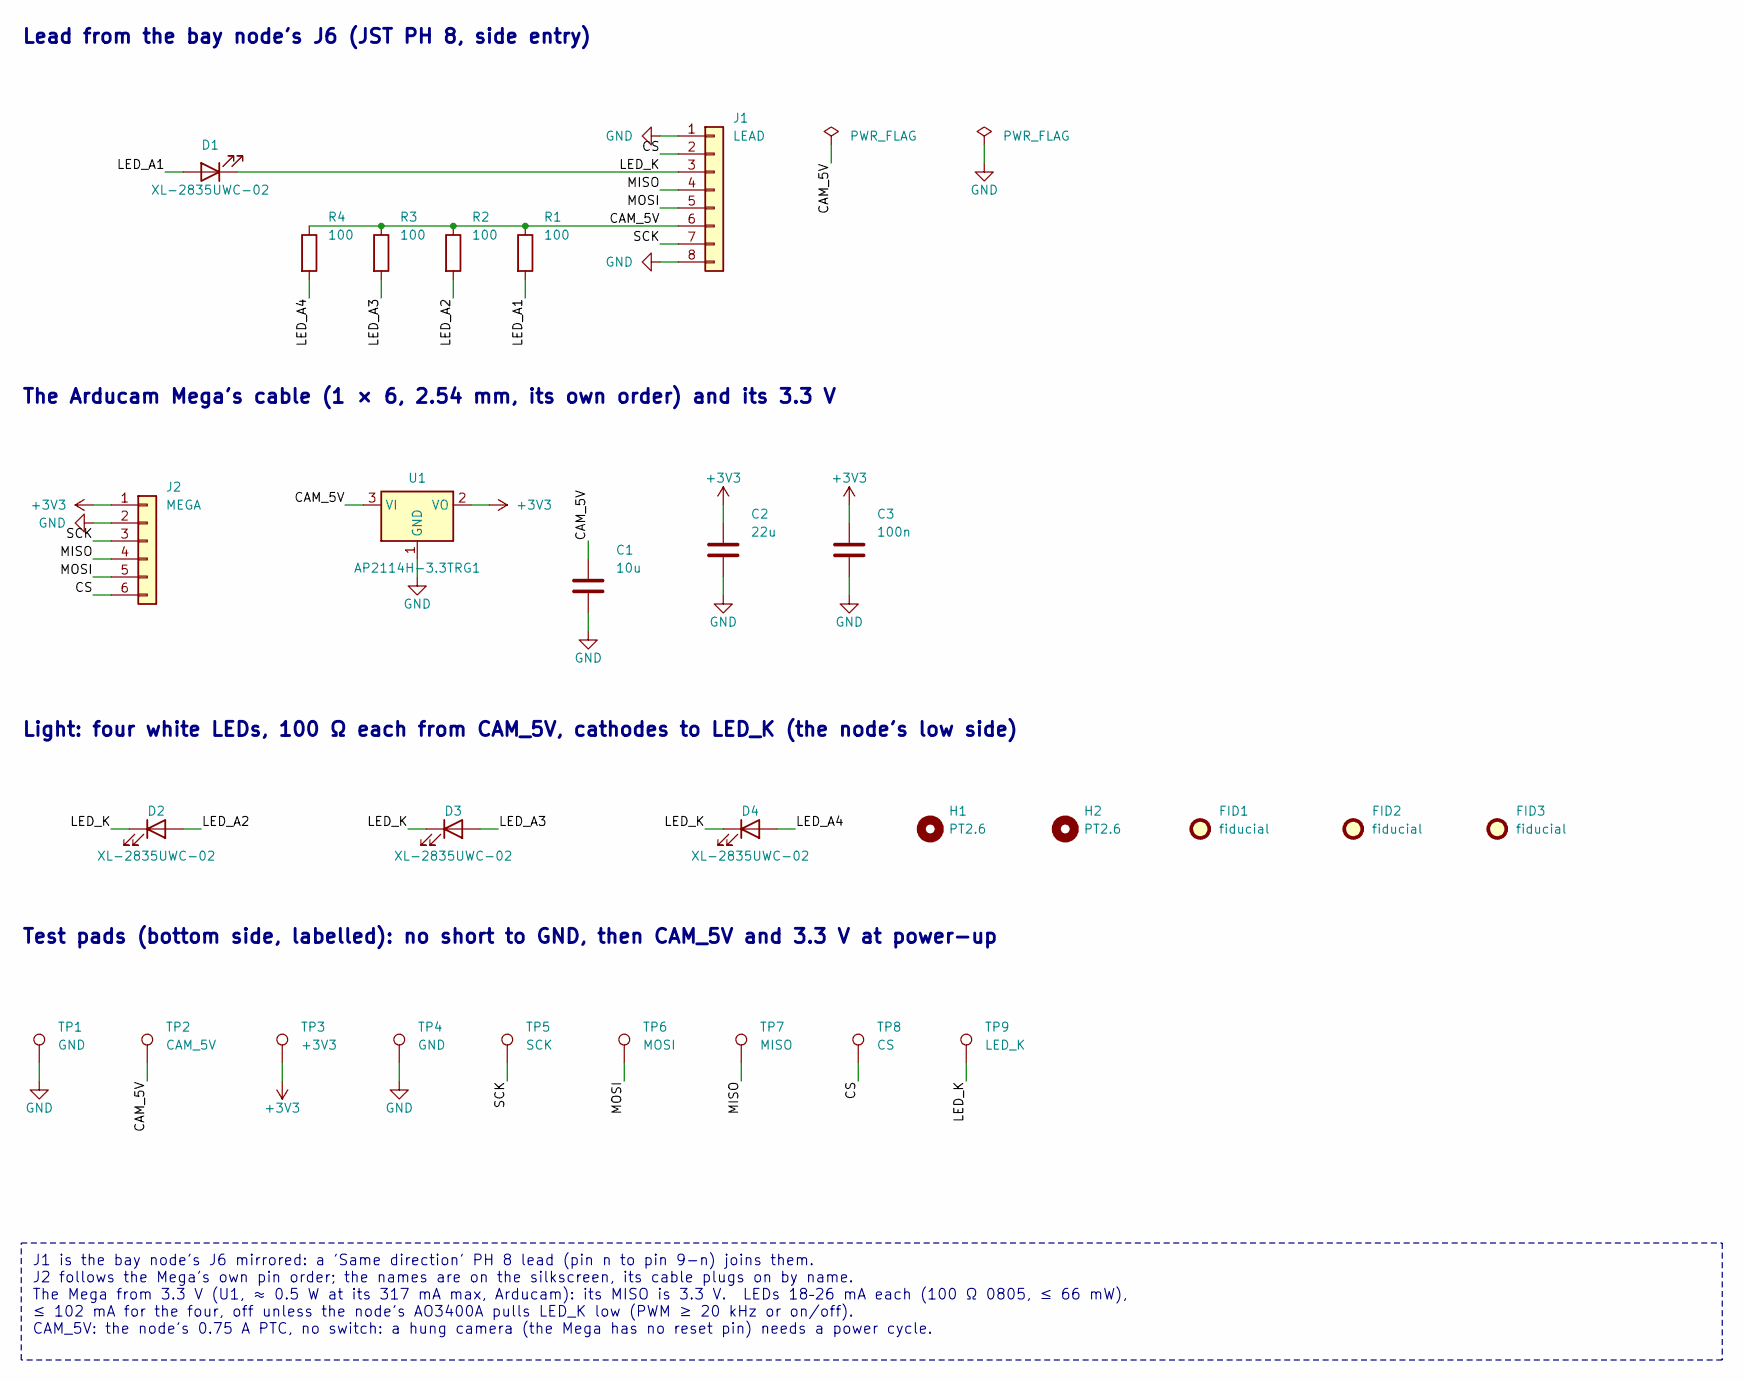
[picture p247: schematic pod.kicad_sch, Camera pod — Lead, camera header, 3.3 V, light]

Parts:
C1: 10u; C_0805_2012Metric; MPN CL21A106KAYNNNE; LCSC C15850
C2: 22u; C_1206_3216Metric; MPN CL31A226KAHNNNE; LCSC C12891
C3: 100n; C_0603_1608Metric; MPN CC0603KRX7R9BB104; LCSC C14663
D1, D2, D3, D4: XL-2835UWC-02; LED_PLCC_2835; MPN XL-2835UWC-02; LCSC C2843876
FID1, FID2, FID3: fiducial; Fiducial_1mm_Mask2mm; MPN fiducial
H1, H2: PT2.6; MountingHole_2.7mm_M2.5; MPN M2.5 / PT 2.6 mounting hole
J1: LEAD; JST_PH_S8B-PH-SM4-TB_1x08-1MP_P2.00mm_Horizontal; MPN S8B-PH-SM4-TB(LF)(SN); LCSC C265121
J2: MEGA; PinHeader_1x06_P2.54mm_Vertical_SMD_Pin1Right; MPN HX PZ2.54-1x6P TP-YQ; LCSC C41417363
R1, R2, R3, R4: 100; R_0805_2012Metric; MPN 0805W8F1000T5E; LCSC C17408
TP1, TP4: GND; TestPoint_Pad_D1.5mm; MPN test pad
TP2: CAM_5V; TestPoint_Pad_D1.5mm; MPN test pad
TP3: +3V3; TestPoint_Pad_D1.5mm; MPN test pad
TP5: SCK; TestPoint_Pad_D1.0mm; MPN test pad
TP6: MOSI; TestPoint_Pad_D1.0mm; MPN test pad
TP7: MISO; TestPoint_Pad_D1.0mm; MPN test pad
TP8: CS; TestPoint_Pad_D1.0mm; MPN test pad
TP9: LED_K; TestPoint_Pad_D1.0mm; MPN test pad
U1: AP2114H-3.3TRG1; SOT-223-3_TabPin2; MPN AP2114H-3.3TRG1; LCSC C150716

Connections:
+3V3: C2.1, C3.1, J2.1, TP3.1, U1.2 (VO)
/Pod/CAM_5V: C1.1, J1.6, R1.1, R2.1, R3.1, R4.1, TP2.1, U1.3 (VI)
/Pod/CS: J1.2, J2.6, TP8.1
/Pod/LED_A1: D1.2 (A), R1.2
/Pod/LED_A2: D2.2 (A), R2.2
/Pod/LED_A3: D3.2 (A), R3.2
/Pod/LED_A4: D4.2 (A), R4.2
/Pod/LED_K: D1.1 (K), D2.1 (K), D3.1 (K), D4.1 (K), J1.3, TP9.1
/Pod/MISO: J1.4, J2.4, TP7.1
/Pod/MOSI: J1.5, J2.5, TP6.1
/Pod/SCK: J1.7, J2.3, TP5.1
GND: C1.2, C2.2, C3.2, J1.1, J1.8, J2.2, TP1.1, TP4.1, U1.1 (GND)

Notes on the sheet:
Lead from the bay node's J6 (JST PH 8, side entry)
The Arducam Mega's cable (1 × 6, 2.54 mm, its own order) and its 3.3 V
Light: four white LEDs, 100 Ω each from CAM_5V, cathodes to LED_K (the node's low side)
Test pads (bottom side, labelled): no short to GND, then CAM_5V and 3.3 V at power-up
J1 is the bay node's J6 mirrored: a 'Same direction' PH 8 lead (pin n to pin 9−n) joins them. J2 follows the Mega's own pin order; the names are on the silkscreen, its cable plugs on by name. The Mega from 3.3 V (U1, ≈ 0.5 W at its 317 mA max, Arducam): its MISO is 3.3 V. LEDs 18–26 mA each (100 Ω 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

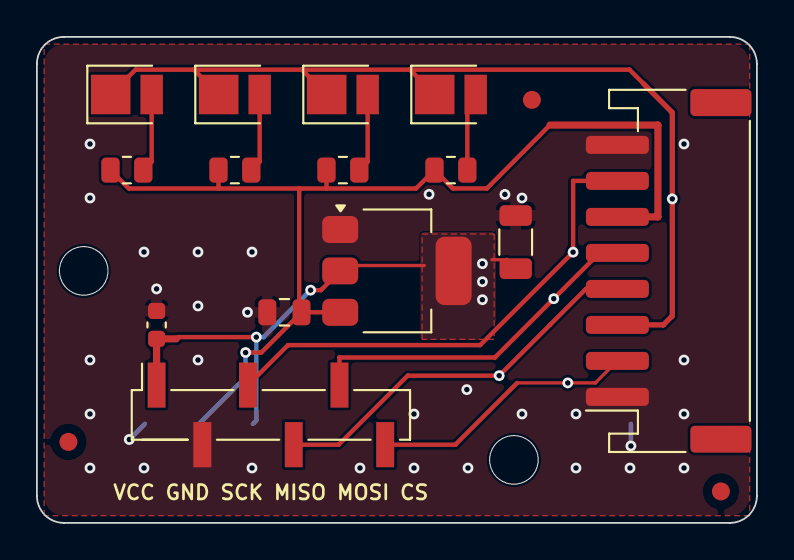
[picture p248: board camera-pod.kicad_pcb from above]

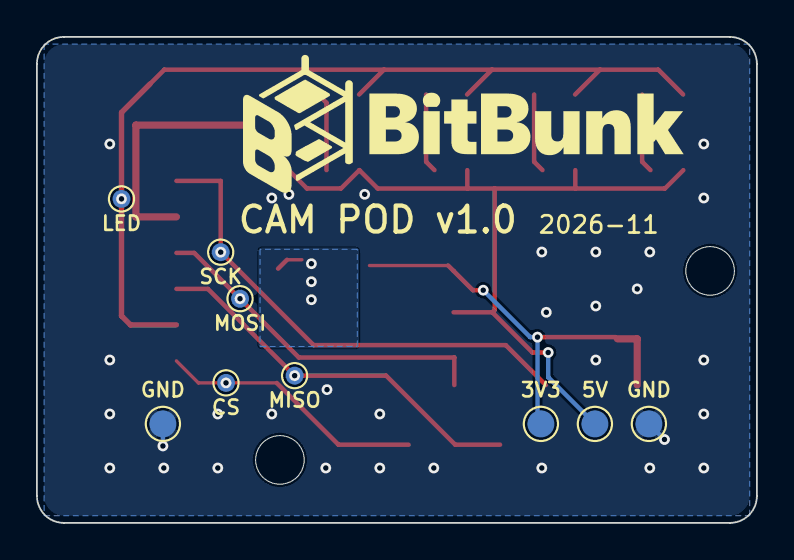
[picture p249: board camera-pod.kicad_pcb from below]

Board: 2 copper layers, 40.0 x 27.0 mm, 28 parts (9 on the bottom side), 12 nets.
