kartben/hw-testing-rack/electronics/data-port/data-port.kicad_pcb

## KiCad design electronics/data-port/data-port.kicad_pcb (2026-10-28)

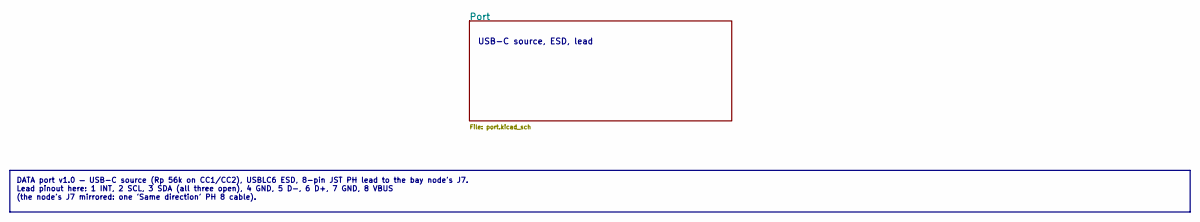
[picture p250: schematic data-port.kicad_sch, DATA port — Overview]

Notes on the sheet:
USB-C source, ESD, lead
DATA port v1.0 — USB-C source (Rp 56k on CC1/CC2), USBLC6 ESD, 8-pin JST PH lead to the bay node's J7. Lead pinout here: 1 INT, 2 SCL, 3 SDA (all three open), 4 GND, 5 D−, 6 D+, 7 GND, 8 VBUS (the node's J7 mirrored: one 'Same direction' PH 8 cable).
