kartben/hw-testing-rack/electronics/data-port/data-port.kicad_pcb

## KiCad design electronics/data-port/data-port.kicad_pcb (continued)

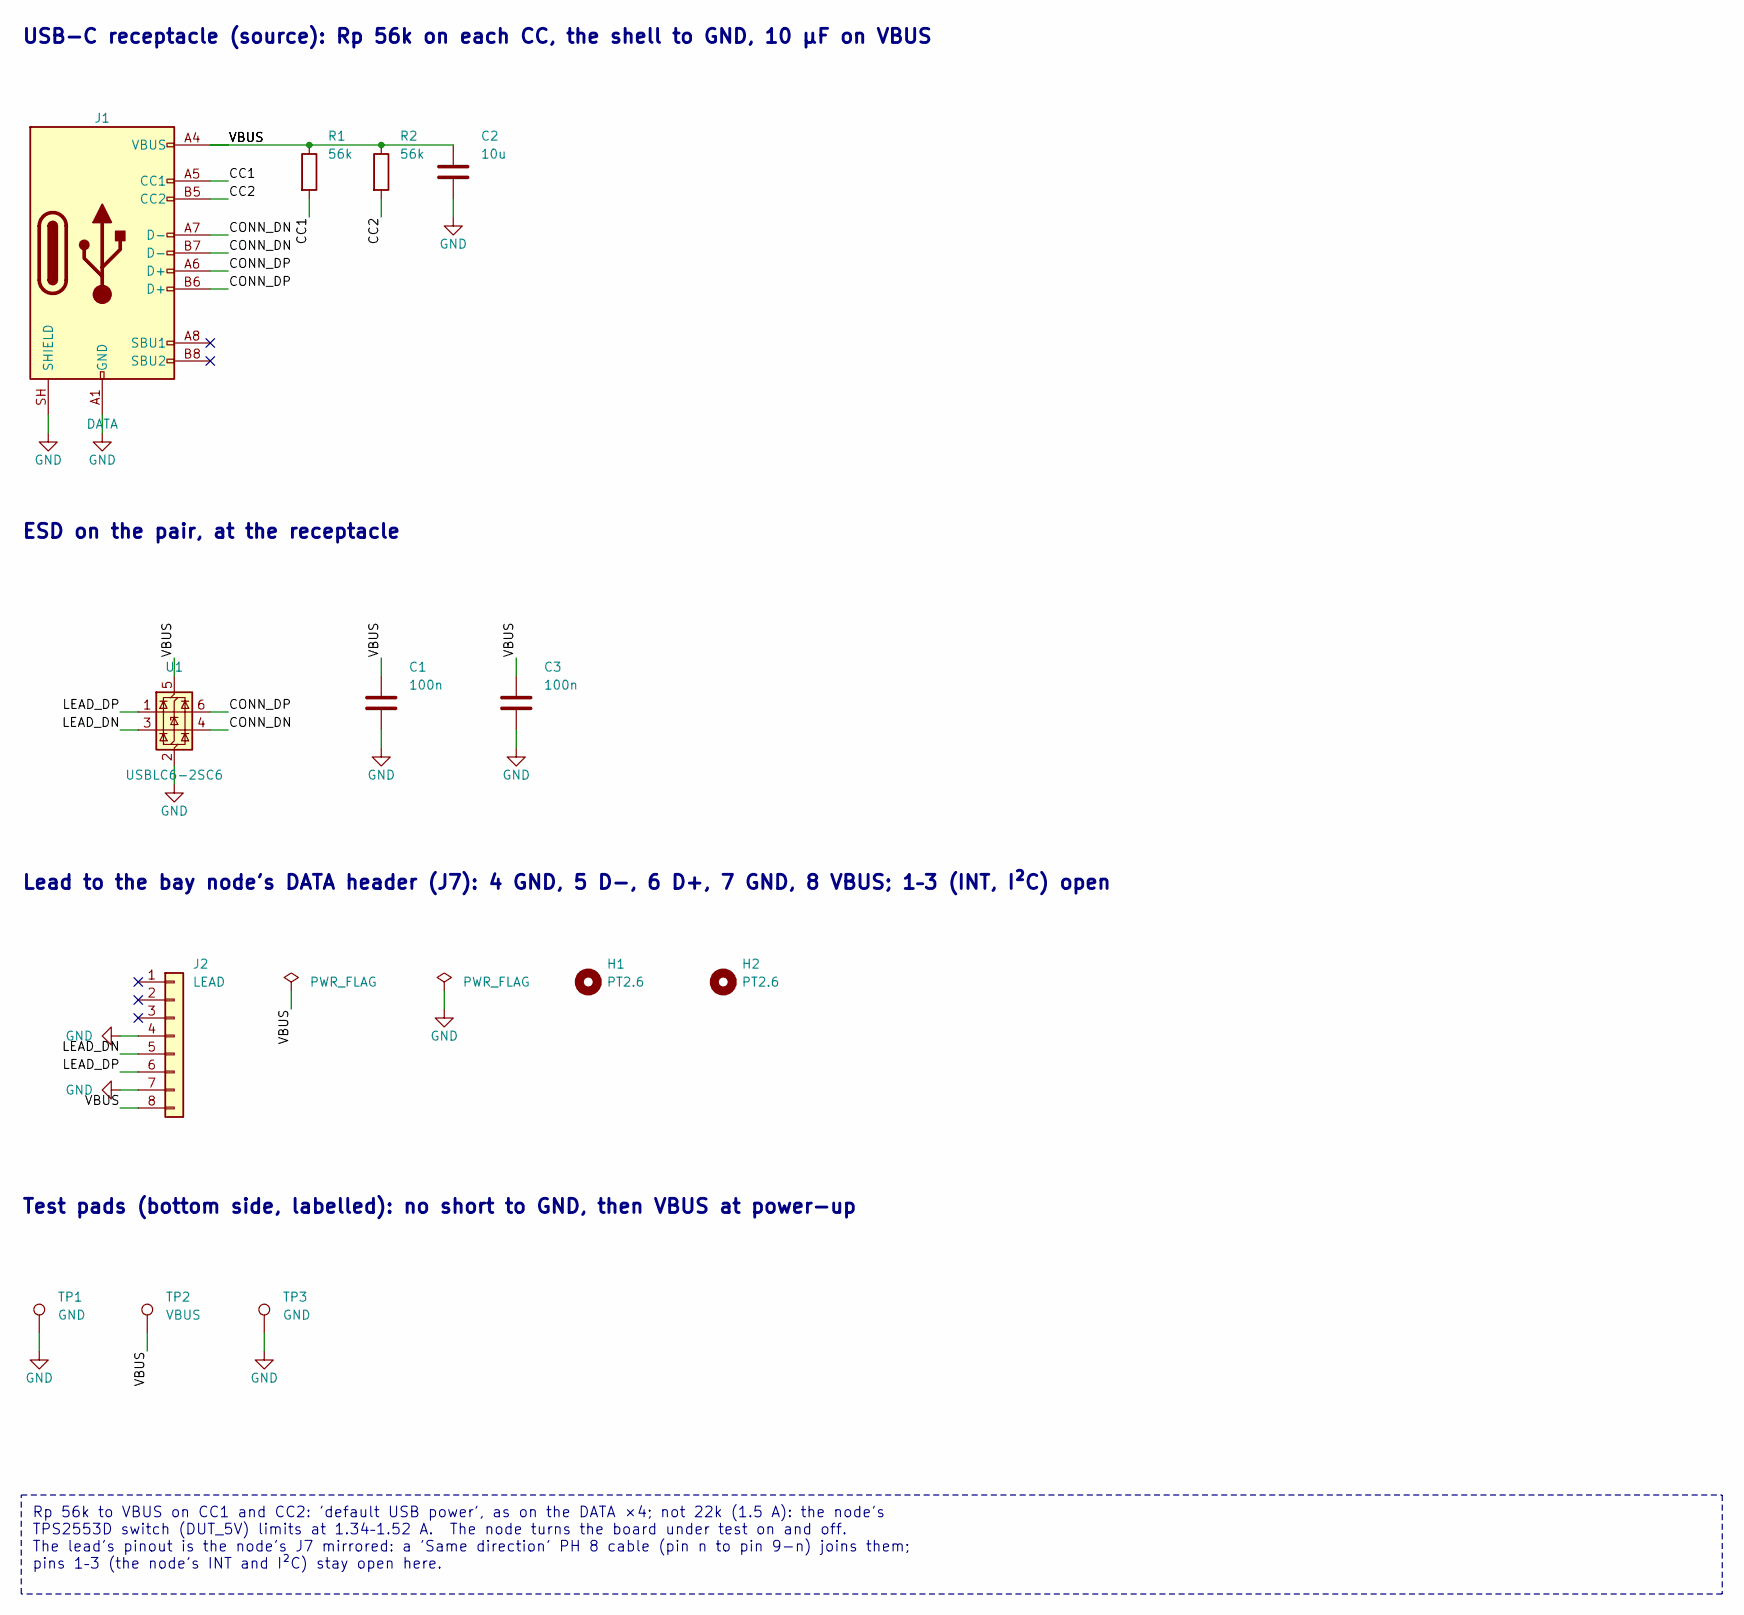
[picture p251: schematic port.kicad_sch, DATA port — USB-C source, ESD, lead]

Parts:
C1: 100n; C_0603_1608Metric; MPN CC0603KRX7R9BB104; LCSC C14663
C2: 10u; C_0805_2012Metric; MPN CL21A106KAYNNNE; LCSC C15850
C3: 100n; C_0402_1005Metric; MPN CL05B104KO5NNNC; LCSC C1525
H1, H2: PT2.6; MountingHole_2.7mm_M2.5; MPN M2.5 / PT 2.6 mounting hole
J1: DATA; USB_C_Receptacle_GCT_USB4105-xx-A_16P_TopMnt_Horizontal; MPN USB4105-GF-A-120; LCSC C5184243
J2: LEAD; JST_PH_S8B-PH-SM4-TB_1x08-1MP_P2.00mm_Horizontal; MPN S8B-PH-SM4-TB(LF)(SN); LCSC C265121
R1, R2: 56k; R_0603_1608Metric; MPN 0603WAF5602T5E; LCSC C23206
TP1, TP3: GND; TestPoint_Pad_D1.5mm; MPN test pad
TP2: VBUS; TestPoint_Pad_D1.5mm; MPN test pad
U1: USBLC6-2SC6; SOT-23-6; MPN USBLC6-2SC6; LCSC C7519

Connections:
/Port/CC1: J1.A5 (CC1), R1.2
/Port/CC2: J1.B5 (CC2), R2.2
/Port/CONN_DN: J1.A7 (D-), J1.B7 (D-), U1.4 (I/O2)
/Port/CONN_DP: J1.A6 (D+), J1.B6 (D+), U1.6 (I/O1)
/Port/LEAD_DN: J2.5, U1.3 (I/O2)
/Port/LEAD_DP: J2.6, U1.1 (I/O1)
/Port/VBUS: C1.1, C2.1, C3.1, J1.A4 (VBUS), J1.A9 (VBUS), J1.B4 (VBUS), J1.B9 (VBUS), J2.8, R1.1, R2.1, TP2.1, U1.5 (VBUS)
GND: C1.2, C2.2, C3.2, J1.A1 (GND), J1.A12 (GND), J1.B1 (GND), J1.B12 (GND), J1.SH (SHIELD), J2.4, J2.7, TP1.1, TP3.1, U1.2 (GND)

Notes on the sheet:
USB-C receptacle (source): Rp 56k on each CC, the shell to GND, 10 µF on VBUS
ESD on the pair, at the receptacle
Lead to the bay node's DATA header (J7): 4 GND, 5 D−, 6 D+, 7 GND, 8 VBUS; 1–3 (INT, I²C) open
Test pads (bottom side, labelled): no short to GND, then VBUS at power-up
Rp 56k to VBUS on CC1 and CC2: 'default USB power', as on the DATA ×4; not 22k (1.5 A): the node's TPS2553D switch (DUT_5V) limits at 1.34–1.52 A. The node turns the board under test on and off. The lead's pinout is the node's J7 mirrored: a 'Same direction' PH 8 cable (pin n to pin 9−n) joins them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

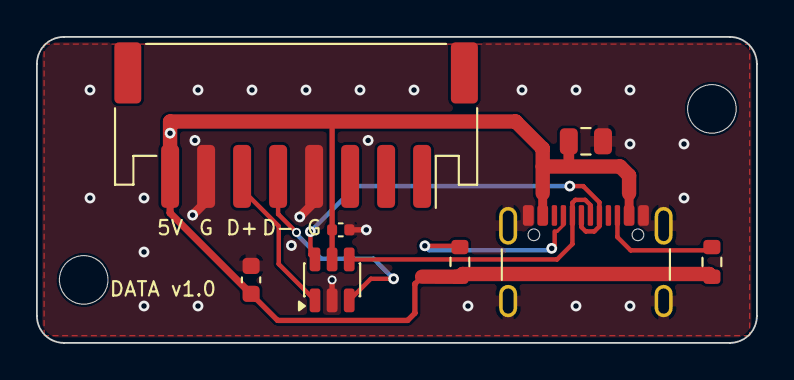
[picture p252: board data-port.kicad_pcb from above]

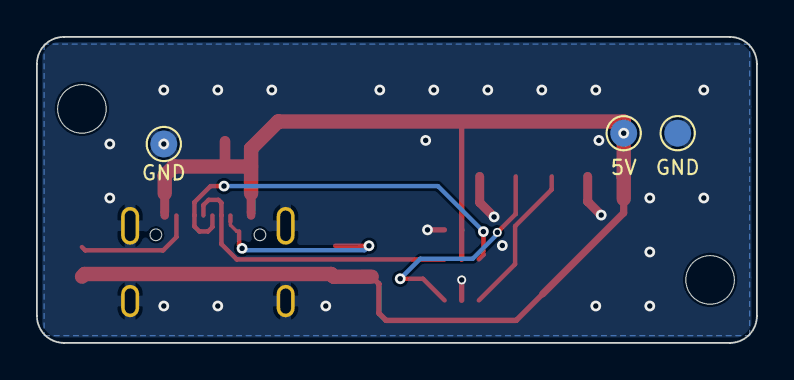
[picture p253: board data-port.kicad_pcb from below]

Board: 2 copper layers, 40.0 x 17.0 mm, 13 parts (3 on the bottom side), 8 nets.
