kartben/hw-testing-rack/firmware/bay-node/web/dev_server.py

"""Serve the bay node web page with a simulated node, to work on the UI without one.

    python firmware/bay-node/web/dev_server.py [port] [--ports 4|6]    # then open http://localhost:8766

Same endpoints and JSON as src/web.c, the web console's WebSockets
(/console/ws/<n>) and access control included, and the camera's port
(src/camera.c) on the next port: /snapshot.jpg and /stream.mjpg, B2's camera
as the viewer (site/) renders it, the GIGA's screen playing, the light on or
off (frames in camera/, grabbed by grab_camera.py; Pillow brings them to the
other resolutions and applies the image settings, without it they go as
grabbed).  The "node" is a dict the
POSTs change; its DUT is a fake Zephyr board that boots, logs in colour and
runs a tiny shell on the console.  With --ports 4 it is a bay with a DATA ×4
board (docs/multi-dut-node.md): four boards, sub-slots B3.1 to B3.4, served by
/api/ports and /api/ports/<n>/{power,reset,boot}, leased one by one.  With --ports 6 it
is a DATA ×6 instead: six boards, B3.1 to B3.6, USB-C 1 on hub port 6 and USB-C n on
n - 1, no RESET or BOOT line, no matrix, no co-processor.  Each slot's
Zephyr board target (GET /api/boards, GET and PUT /api/ports/<n>/board, src/boards.c)
lives in memory; /board-targets.json is built from mechanical/boards/boards.yaml
as the firmware's build does (board_targets.py).  Test hooks:

    /dev/fault[?port=n]   trip a fake over-current (the DUT, or port n)
    /dev/draw?port=n&ma=900   port n's board draws this much (ma=0: its usual), for the admission rule
    /dev/foreign?port=n   toggle a board on port n powered from elsewhere (its VBUS up while the port is off)
    /dev/attach[?port=n]  toggle a fake USB/IP client (192.168.1.41; on port n's board)
    /dev/rfc2217          toggle a fake RFC 2217 client (192.168.1.41)
    /dev/boot             a short press on BOOT: confirms a pending claim
    /dev/peer?ip=a.b.c.d  requests from this machine look like they come from
                          that address (no ip: back to the real one)
    /dev/rollback         the next firmware update does not confirm itself (MCUboot goes back)
    /dev/image?version=0.6.0[&id=power-hub/power_hub]   an image to upload (unsigned, laid
                          out as zephyr.signed.bin; the bay's own id by default)
    /dev/camera           unplug or plug the camera
    /dev/usb?preset=xiao[&port=n]   another device on the one DUT's port, or on port n
    /dev/vref?port=n&mv=0   port n's VREF as the co-processor would read it (under 650 mV: its pins held open)

With --ports 4 the board's pin matrix answers /api/wires (src/wires.c's rules,
the ports' VREF made up: 3.3 V, and 1.8 V on B3.4), and the co-processor runs
gusmanb's analyzer (an image is stored):
/api/analyzer and the page's WebSocket /analyzer/ws, which answers the
analyzer's ID and capture requests with made-up signals: a UART on bus A and
B, I2C on C and D, SPI on E to H, and the node's MARK on CH13 around a reset.
"""

from __future__ import annotations

import base64
import hashlib
import hmac
import ipaddress
import json
import math
import os
import random
import re
import secrets
import socket
import struct
import sys
import threading
import time
from http.server import BaseHTTPRequestHandler, ThreadingHTTPServer
from pathlib import Path
from urllib.parse import parse_qs, urlsplit

WEB = Path(__file__).resolve().parent
sys.path.insert(0, str(WEB))
sys.path.insert(0, str(WEB.parents[1] / "common" / "web"))
import board_targets  # noqa: E402
from devserver import COMMON_STATIC, XTERM_STATIC, Firmware, make_image, ws_frame, ws_read  # noqa: E402

# The page, and what firmware/common serves on the node too (/rack.css, xterm.js, the analyzer's modules)
ANALYZER = WEB.parents[1] / "common" / "web" / "analyzer"
ANALYZER_STATIC = {f"/analyzer/{m}.mjs": (ANALYZER / f"{m}.mjs", "text/javascript")
                   for m in ("capture", "decoders", "decoding", "panel", "protocol", "relay", "vcd", "viewer")}
STATIC = {"/": (WEB / "index.html", "text/html"), **COMMON_STATIC, **XTERM_STATIC, **ANALYZER_STATIC,
          "/analyzer/card.mjs": (WEB / "analyzer-card.mjs", "text/javascript"),
          "/wires-card.mjs": (WEB / "wires-card.mjs", "text/javascript")}
START = time.monotonic() - 3 * 3600 - 17 * 60
WEB_SLOTS = 2
LOG_WINDOW = 16384 - 512

node = {
    "id": "b3", "hostname": "bay-b3", "ip": "192.168.1.53", "version": "4.5.0-rc2",
    "path": "usbip", "last_fault": "", "service": False, "pc_detected": False, "force_classic": False,
    "usb": {"running": True, "devices": 1, "sessions": 0},
    "dut": {"on": True, "fault": False, "latched": False, "faults": 0, "meter": True,
            "mv": 0, "ma": 0, "mw": 0},
    "rack": {"node": 0, "pos": "", "hub": False, "hub_mv": 0, "hub_epr": False, "rows_on": 0},
}
aux = {"baud": 115200, "data_bits": 8, "parity": "none", "stop_bits": 1, "enter": "cr",
       "echo": False, "esptool_reset": False}


def dut_current_ma(t: float) -> int:
    """A board idling at ~90 mA with a radio burst every 8 s."""
    burst = 42 if t % 8 < 1.6 else 0
    return 90 + burst + int(6 * math.sin(t / 3)) + random.randint(-3, 3)


# --- Ports: a bay with a DATA ×4 board (--ports 4) or a DATA ×6 (--ports 6) ---

PORTS = 1           # the boards the node serves; 1: today's one DUT (node["dut"])
ports: list[dict] = []
UP_S = 0.8          # a board's USB enumeration after power on or reset
# The admission rule (docs/multi-dut-node.md, Power budget; ports.c), node v1.0: a port goes on only
# if what the bay draws on DATA_VIN (the node's INA226: the DATA x4 board itself counts) plus a
# reserve for its inrush stays within the hub's grant
GRANT_MW = 5400     # the hub's GRANT: 100 W at 20 V, 12 bays, four a row
RESERVE_MW = 600    # CONFIG_BAY_PORTS_RESERVE_MW
DATA_VIN_MV = 19850  # the rack's 20 V at the bay, after the row's drop
BOARD_MA = 380      # the DATA x4 board's own draw at 5 V: its hub, co-processor and LEDs (0.3-0.46 A)
STAGGER_S = 0.3     # the ports' start, one after the other
DISCHARGE_S = 0.3   # a power cycle without "ms": until the port's VBUS is under 1 V (2 s at most)


def hub_port(n: int) -> int:
    """The hub's port wired to port n: a DATA x4's USB-C n is hub port n; a DATA x6's USB-C 1 is hub
    port 6 and USB-C n hub port n - 1 (data-x6.dtsi)."""
    return n if PORTS != 6 else 6 if n == 1 else n - 1


def x4() -> bool:
    """A DATA x4: its pin matrix, co-processor and RESET/BOOT lines (a DATA x6 has none)."""
    return PORTS == 4


def set_ports(n: int) -> None:
    """Port n on its hub port (hub_port()), so its busid is 1-1.<hub port> (A1.2 -> 1-1.2 on a
    DATA x4).  The ports come up off (EN pulled down): the firmware switches them on one by one,
    each through the admission rule."""
    global PORTS
    PORTS = n
    presets = X4_PRESETS + X6_MORE
    ports[:] = [{"port": i, "hub_port": hub_port(i), "on": False, "latched": False, "faults": 0,
                 "up_at": 0.0, "client": None, "lease": None, "draw": 0, "foreign": False,
                 "waiting": False, "queued": False,
                 "usb": dict(USB_PRESETS[presets[i - 1]])}
                for i in range(1, n + 1)] if n > 1 else []
    start = time.monotonic()
    for k, pt in enumerate(ports):
        if admission(pt) is None:
            pt["on"], pt["up_at"] = True, start + k * STAGGER_S + UP_S


def port_ma(pt: dict, now: float) -> int:
    """What a port's board draws (its INA226)."""
    if not pt["on"]:
        return 0
    return pt["draw"] or dut_current_ma(now + 2.1 * pt["port"])


def bay_ma(now: float) -> int:
    """What the DATA x4 board and its ports draw at 5 V."""
    return BOARD_MA + int(8 * math.sin(now / 5)) + sum(port_ma(q, now) for q in ports)


def bay_mw(now: float) -> int:
    """What the node's INA226 reads on DATA_VIN: the board's 5 V through its converters (88 %)."""
    return int(bay_ma(now) * 5.08 / 0.88)


def admission(pt: dict) -> str | None:
    """Why the port (off) may not go on now, as web.c words it (409), or None."""
    if pt["foreign"]:
        return ("the port's VBUS is up while it is off (a board powered from elsewhere): "
                "it comes on once that has gone")
    bay = bay_mw(time.monotonic())
    if bay + RESERVE_MW > GRANT_MW:
        return (f"no room in the bay's budget: the bay draws {bay} mW, "
                f"{RESERVE_MW} mW kept for a start, {GRANT_MW} mW in all (the hub's grant)")
    return None


def admit() -> None:
    """The node's admission work: the first port waiting for power goes on once there is room."""
    pt = next((q for q in ports if q["waiting"] and not q["on"] and not q["latched"]), None)
    if pt is not None and admission(pt) is None:
        pt.update(on=True, waiting=False, queued=False, client=None, up_at=time.monotonic() + UP_S)


def multi() -> bool:
    return PORTS > 1


def slot_name(n: int) -> str:
    return f"{node['id'].upper()}.{n}" if multi() else node["id"].upper()


def port_lease_active(pt: dict) -> bool:
    return pt["lease"] is not None and time.monotonic() < pt["lease"]["until"]


def port_reserved(pt: dict, ip: int) -> bool:
    return port_lease_active(pt) and pt["lease"]["holder"] != ip


def secs_left(until: float, now: float) -> int:
    """Seconds left, rounded up from whole milliseconds as the node counts them: a lease just
    taken for 600 s reads 600 (the float difference alone can come out a hair over)."""
    return math.ceil(round(until - now, 3))


def lease_doc(lease: dict | None, ip: int, now: float) -> dict | None:
    if lease is None or now >= lease["until"]:
        return None
    return {"holder": ip_str(lease["holder"]), "note": lease["note"],
            "remaining_s": secs_left(lease["until"], now), "yours": lease["holder"] == ip}


def port_doc(pt: dict, ip: int = 0) -> dict:
    """One object of GET /api/ports."""
    now = time.monotonic()
    ma = port_ma(pt, now)
    mv = 5080 - ma // 10 if pt["on"] else 0
    usb = {**pt["usb"], "busid": f"1-1.{pt['hub_port']}"} if pt["on"] and now >= pt["up_at"] else None
    return {"slot": slot_name(pt["port"]), "port": pt["port"], "hub_port": pt["hub_port"], "lines": x4(),
            "power": {"on": pt["on"], "mv": mv, "ma": ma, "mw": ma * mv // 1000, "faults": pt["faults"],
                      "state": power_state(pt["on"], pt["latched"], pt["waiting"]),
                      "queued": pt["queued"] and not pt["on"]},
            "fault": pt["latched"], "usb": usb,
            "usbip": {"client": ip_str(pt["client"])} if pt["client"] and usb else None,
            "lease": lease_doc(pt["lease"], ip, now)}


def one_port_doc(s: dict) -> dict:
    """A one-port node's DUT as port 1 (no hub: busid 1-1)."""
    dut, lease = s["dut"], s["access"]["lease"]
    client = next((c for c in access.fake if c["service"] == "usbip"), None)
    usb = ({"vid": "2fe3", "pid": "0004", "product": "USB-DEV", "serial": "005EC0A1", "busid": "1-1"}
           if dut["on"] and s["usb"]["devices"] else None)
    return {"slot": slot_name(1), "port": 1, "hub_port": None, "lines": True,
            "power": {**{k: dut[k] for k in ("on", "mv", "ma", "mw", "faults")},
                      "state": power_state(dut["on"], dut["latched"]), "queued": False},
            "fault": dut["latched"],
            "usb": usb, "usbip": {"client": ip_str(client["peer"])} if client and usb else None,
            "lease": lease if lease["remaining_s"] else None}


def power_state(on: bool, latched: bool, waiting: bool = False) -> str:
    """A port's power in a word, as the firmware's: on, fault, waiting (for power), off."""
    return "on" if on else "fault" if latched else "waiting" if waiting else "off"


def short_port(d: dict) -> dict:
    """The same object, shorter: /api/status's `ports`."""
    return {"slot": d["slot"], "port": d["port"], "hub_port": d["hub_port"], "lines": d["lines"],
            "power": {k: d["power"][k] for k in ("on", "ma", "state", "queued")},
            "fault": d["fault"], "usb": {"busid": d["usb"]["busid"]} if d["usb"] else None,
            "usbip": d["usbip"], "lease": d["lease"]}


def ports_doc(ip: int = 0) -> list[dict]:
    admit()                             # the node's admission runs on its own: any poll sees it here
    return [port_doc(pt, ip) for pt in ports] if multi() else [one_port_doc(status(ip))]


# --- USB devices (/api/usb): what the node's USB host enumerated --------------

# Read once at enumeration: the device descriptor, the class of each interface
# (CMSIS-DAP by its interface string) and the three strings.  The name is
# iProduct, else the node's table of known IDs, else vid:pid.
USB_PRESETS = {
    "nucleo": {"vid": "0483", "pid": "374b", "manufacturer": "STMicroelectronics",
               "product": "STM32 STLink", "serial": "066DFF495150898367102236", "speed": "full",
               "classes": ["Debug probe", "CDC ACM", "Mass storage"], "serial_bridge": False,
               "ttys": [{"if": "02"}]},
    "mculink": {"vid": "1fc9", "pid": "0143", "manufacturer": "NXP Semiconductors",
                "product": "MCU-LINK on-board (r0E7) CMSIS-DAP V3.172", "serial": "3ZQ1J4ZBMTNKS",
                "speed": "full", "classes": ["CMSIS-DAP", "CDC ACM", "HID"], "serial_bridge": False,
                "ttys": [{"if": "01"}]},
    "ft232": {"vid": "0403", "pid": "6001", "manufacturer": "FTDI", "product": "FT232R USB UART",
              "serial": "A50285BI", "speed": "full", "classes": ["Serial (FTDI)"], "serial_bridge": True,
              "ttys": [{"if": "00", "port": 0}]},
    "ch340": {"vid": "1a86", "pid": "7523", "manufacturer": None, "product": None, "serial": None,
              "speed": "full", "classes": ["Serial (CH34x)"], "serial_bridge": True,
              "ttys": [{"if": "00", "port": 0}]},
    "pico": {"vid": "2e8a", "pid": "0003", "manufacturer": "Raspberry Pi", "product": "RP2 Boot",
             "serial": "E0C9125B0D9B", "speed": "full", "classes": ["Mass storage", "Vendor"],
             "serial_bridge": False, "ttys": []},
    "xiao": {"vid": "303a", "pid": "1001", "manufacturer": "Espressif", "product": "USB JTAG/serial debug unit",
             "serial": "34:85:18:9A:3C:10", "speed": "full", "classes": ["CDC ACM", "Vendor"],
             "serial_bridge": False, "ttys": [{"if": "00"}]},
    "unknown": {"vid": "1209", "pid": "c0de", "manufacturer": None, "product": None, "serial": None,
                "speed": "full", "classes": ["Vendor"], "serial_bridge": False, "ttys": []},
}
# The node's table of known IDs (src/usb_names.c): names for devices without iProduct
USB_KNOWN = {("1a86", "7523"): "CH340 serial adapter", ("0403", "6001"): "FT232 serial adapter",
             ("2e8a", "0003"): "RP2040 in BOOTSEL", ("1fc9", "0143"): "MCU-Link",
             ("0483", "374b"): "ST-LINK/V2-1"}
X4_PRESETS = ["mculink", "ft232", "pico", "ch340"]   # DATA x4 ports 1..4
X6_MORE = ["nucleo", "ft232"]                          # and a DATA x6's ports 5 and 6
usb_one = "nucleo"                                      # a one-port bay's DUT: /dev/usb?preset=
USB_SINCE = {}                                          # busid -> when its USB/IP client attached
HUB = {"vid": "0424", "pid": "2517", "name": "USB2517 hub", "data_x4": True}


def usb_dev_doc(dev: dict, busid: str, slot: str, hub_port, client: int | None, ma) -> dict:
    """One object of GET /api/usb's devices."""
    name, source = dev["product"], "product"
    if not name:
        name, source = USB_KNOWN.get((dev["vid"], dev["pid"])), "table"
    if not name:
        name, source = f"{dev['vid']}:{dev['pid']}", "ids"
    now = time.monotonic()
    if client:
        USB_SINCE.setdefault(busid, now - 754)
    else:
        USB_SINCE.pop(busid, None)
    return {"busid": busid, "slot": slot, "hub_port": hub_port, "vid": dev["vid"], "pid": dev["pid"],
            "name": name, "name_from": source, "manufacturer": dev["manufacturer"], "serial": dev["serial"],
            "strings": True, "speed": dev["speed"], "classes": dev["classes"],
            "ttys": dev.get("ttys", []),
            "usbip": {"client": ip_str(client) if client else None,
                      "since_s": int(now - USB_SINCE[busid]) if client else None,
                      "offered": True, "read_ahead": dev["serial_bridge"]},
            "ma": ma}


def usb_doc() -> dict:
    s = status()
    if multi():
        devs = []
        for d in ports_doc():
            if d["usb"]:
                pt = ports[d["port"] - 1]
                devs.append(usb_dev_doc(pt["usb"], d["usb"]["busid"], d["slot"], d["hub_port"],
                                        pt["client"], d["power"]["ma"]))
        return {"hub": {**HUB, "data_x4": x4()}, "devices": devs}
    d = one_port_doc(s)
    client = next((c["peer"] for c in access.fake if c["service"] == "usbip"), None)
    devs = [usb_dev_doc(USB_PRESETS[usb_one], "1-1", d["slot"], None, client, None)] if d["usb"] else []
    return {"hub": None, "devices": devs}


# --- Board targets (GET /api/boards, GET and PUT /api/ports/<n>/board): src/boards.c ---------

BOARDS_YAML = WEB.parents[2] / "mechanical" / "boards" / "boards.yaml"
boards: dict[int, dict] = {}        # port -> board, runner, probe_id, console, map, pinned
BOARD_RE = re.compile(r"[A-Za-z0-9_@./+-]{1,63}$")
RUNNER_RE = re.compile(r"[a-z0-9_-]{1,23}$")
PROBE_RE = re.compile(r"[!#-\[\]-~]{1,47}$")      # printable, no space, quote or backslash
CONSOLE_RE = re.compile(r"(usb|usb:[0-9a-f]{2}|aux|none)$")
USB_SERIAL_RE = re.compile(r"[ !#-\[\]-~]{0,47}$")


def slot_count() -> int:
    return PORTS if multi() else 1


def slot_device(n: int) -> dict | None:
    """The device in port n's slot now, as /api/boards gives it, or None."""
    if multi():
        pt = ports[n - 1]
        d = port_doc(pt)
        dev, busid = pt["usb"], d["usb"]["busid"] if d["usb"] else None
    else:
        d = one_port_doc(status())
        dev, busid = USB_PRESETS[usb_one], "1-1" if d["usb"] else None
    if busid is None:
        return None
    return {"busid": busid, "vid": dev["vid"], "pid": dev["pid"], "manufacturer": dev["manufacturer"],
            "product": dev["product"], "serial": dev["serial"], "strings": True, "ttys": dev.get("ttys", [])}


def board_doc(n: int) -> dict:
    """One slot of GET /api/boards: its target, what it was set for, what is in it now."""
    rec, dev = boards.get(n), slot_device(n)
    pinned = rec["pinned"] if rec else None
    mismatch = False
    if pinned and dev:
        mismatch = ((pinned["serial"] or "") != (dev["serial"] or "") if pinned["serial"]
                    else (pinned["vid"], pinned["pid"]) != (dev["vid"], dev["pid"]))
    return {"slot": slot_name(n), "port": n,
            "board": rec["board"] if rec else None, "runner": rec["runner"] if rec else None,
            "probe_id": rec["probe_id"] if rec else None, "console": rec["console"] if rec else "usb",
            "map": rec["map"] if rec else True, "pinned": pinned, "device": dev, "mismatch": mismatch}


def boards_doc() -> dict:
    return {"slots": [board_doc(n) for n in range(1, slot_count() + 1)]}


def set_board(n: int, body: dict) -> str | None:
    """PUT /api/ports/<n>/board: an error, or None once saved.  The record is pinned to the device in the
    slot now (or to the body's `pin`, for a restore); no board clears the slot."""
    if not body.get("board"):
        boards.pop(n, None)
        return None
    board, runner, probe = body["board"], body.get("runner") or None, body.get("probe_id") or None
    console, in_map = body.get("console") or "usb", body.get("map", True)
    if not isinstance(board, str) or not BOARD_RE.match(board):
        return "board: a Zephyr board target, 1-63 of A-Z a-z 0-9 _ @ . / + -"
    if runner is not None and (not isinstance(runner, str) or not RUNNER_RE.match(runner)):
        return "runner: a west runner, 1-23 of a-z 0-9 _ -"
    if probe is not None and (not isinstance(probe, str) or not PROBE_RE.match(probe)):
        return "probe_id: 1-47 printable characters, no space, quote or backslash"
    if not isinstance(console, str) or not CONSOLE_RE.match(console):
        return "console: usb, usb:<interface, 2 hex digits>, aux or none"
    if console == "aux" and multi():
        return "console: a DATA x4 port has no AUX UART: its board's USB, or none"
    if not isinstance(in_map, bool):
        return "map: true or false"
    if body.get("pin") is not None:            # null, as absent (the node's JSON parser skips nulls)
        pin = body["pin"]
        if not (isinstance(pin, dict) and all(
                isinstance(pin.get(k), str) and re.fullmatch(r"[0-9a-f]{4}", pin[k]) for k in ("vid", "pid"))
                and USB_SERIAL_RE.match(pin.get("serial") or "")):
            return "pin: {\"vid\": \"0483\", \"pid\": \"374b\", \"serial\": \"...\"}"
        pinned = {"vid": pin["vid"], "pid": pin["pid"], "serial": pin.get("serial") or None}
    else:
        dev = slot_device(n)
        pinned = {"vid": dev["vid"], "pid": dev["pid"], "serial": dev["serial"]} if dev else None
    boards[n] = {"board": board, "runner": runner, "probe_id": probe, "console": console, "map": in_map,
                 "pinned": pinned}
    return None


def port_act(pt: dict, what: str, body: dict) -> tuple[int, str | None] | None:
    """Power, reset or boot one port, as the node's dut.c does for its one DUT; (status, error),
    (202, None) when a request waits for room, or None."""
    if what == "power":
        action = body.get("action")
        if action not in ("on", "off", "cycle", "cancel"):
            return 400, "action must be on, off, cycle or cancel"
        if "when" in body and (action != "on" or body["when"] != "available"):
            return 400, '"when": "available" goes with "action": "on"'
        if action == "cancel":
            if not pt["queued"] or pt["on"]:
                return 409, "no queued request on this port"
            pt["queued"] = pt["waiting"] = False
            return None
        if action != "off":
            was = pt["on"]
            pt["on"] = False                  # its own draw does not count against it
            refused = admission(pt)
            pt["on"] = was
            if refused is not None and "when" in body:
                pt["queued"] = pt["waiting"] = True   # on as soon as there is room (admit())
                return 202, None
            if refused is not None:
                return 409, refused
        if action == "cycle":
            time.sleep(min(int(body["ms"]), 2000) / 1000 if "ms" in body else DISCHARGE_S)
        was_on = pt["on"]
        pt["on"] = action != "off"
        pt["waiting"] = pt["queued"] = False   # on, or switched off by hand: no longer wanted back
        if pt["on"]:
            pt["latched"] = False
        if not pt["on"] or action == "cycle" or not was_on:
            pt["client"] = None           # the board left the bus: its USB/IP session ends
            pt["up_at"] = time.monotonic() + UP_S
    elif what == "boot" and body.get("power_cycle"):
        was = pt["on"]
        pt["on"] = False                  # back on through the admission rule, as any power on
        refused = admission(pt)
        pt["on"] = was
        if refused is not None:
            return 409, refused
        time.sleep(1.0)                   # BOOT held across a power cycle of the port: the board comes up in its ROM
        pt.update(on=True, latched=False, client=None, waiting=False, queued=False)
        pt["up_at"] = time.monotonic() + UP_S
    else:
        if not x4():                      # a DATA x6: no RESET or BOOT line
            return 400, "this port has no such line"
        if not pt["on"]:                  # RESET and BOOT are held while the port is off
            return 503, "the port is off, or the DATA board is not set up (DUT_5V off?)"
        time.sleep(0.3 if what == "boot" else min(int(body.get("ms", 100)), 500) / 1000)
        logic.reset.set()                 # MARK falls: the board starts again
        if pt["on"]:
            pt["client"] = None           # a reset re-enumerates the board, under the same busid
            pt["up_at"] = time.monotonic() + UP_S
    return None


# --- The fake DUT console ---------------------------------------------------

class Console:
    """UART log of the fake board, shared by the WebSocket clients."""

    def __init__(self) -> None:
        self.lock = threading.Lock()
        self.log = bytearray()      # everything since "boot"; positions index it
        self.tx = 0
        self.boot = random.randrange(1 << 31)
        self.clients: dict[int, socket.socket] = {}
        self.info: dict[int, tuple[int, float]] = {}   # slot -> peer, since
        self.line = ""
        self.booted_at = time.monotonic()

    def emit(self, text: str) -> None:
        data = text.encode()
        with self.lock:
            self.log += data
            dead = []
            for slot, sock in self.clients.items():
                try:
                    sock.sendall(ws_frame(2, data))
                except OSError:
                    dead.append(slot)
            for slot in dead:
                self.clients.pop(slot, None)
                self.info.pop(slot, None)

    def kick(self, slot: int) -> None:
        with self.lock:
            sock = self.clients.pop(slot, None)
            self.info.pop(slot, None)
        if sock is not None:
            try:
                sock.sendall(ws_frame(8, b""))
                sock.shutdown(socket.SHUT_RDWR)
            except OSError:
                pass

    def broadcast_config(self) -> None:
        msg = ws_frame(1, json.dumps({"type": "config", **aux}).encode())
        with self.lock:
            for sock in list(self.clients.values()):
                try:
                    sock.sendall(msg)
                except OSError:
                    pass

    def stamp(self) -> str:
        t = time.monotonic() - self.booted_at
        return f"[{int(t // 3600):02}:{int(t // 60) % 60:02}:{t % 60:06.3f},000]"

    def boot_banner(self) -> None:
        self.booted_at = time.monotonic()
        self.emit("\r\nESP-ROM:esp32c6-20220919\r\nBuild:Sep 19 2022\r\n"
                  "rst:0x1 (POWERON),boot:0x6c (SPI_FAST_FLASH_BOOT)\r\n")
        self.emit("*** Booting Zephyr OS build v4.5.0-rc2-317-g3f7ae83e0e7c ***\r\n")
        self.emit(f"\x1b[1;32m{self.stamp()} <inf> main: blinky-ble ready on "
                  "esp32c6_devkitc/esp32c6/hpcore\x1b[0m\r\n")
        self.emit(f"{self.stamp()} <inf> bt_hci_core: HCI transport: ESP BT HCI\r\n")
        self.emit("\r\nuart:~$ ")

    def background(self) -> None:
        """Periodic log lines while the board is powered."""
        messages = [
            ("", "<inf> sensor: temp 23.{} C, rh 41 %"),
            ("", "<inf> app: advertising, 0 connections"),
            ("\x1b[1;33m", "<wrn> wifi: beacon timeout, rssi -71 dBm"),
            ("", "<dbg> ble: conn param update 30 ms"),
            ("\x1b[1;31m", "<err> i2c: transfer failed: -5 (addr 0x44)"),
        ]
        n = 0
        while True:
            time.sleep(3)
            if not node["dut"]["on"]:
                continue
            color, text = messages[n % len(messages)]
            n += 1
            reset = "\x1b[0m" if color else ""
            self.emit(f"\r\x1b[K{color}{self.stamp()} {text.format(n % 10)}{reset}\r\n"
                      f"uart:~$ {self.line}")

    def type(self, data: bytes) -> None:
        """Bytes from a web console: the fake shell echoes and runs commands."""
        self.tx += len(data)
        if not node["dut"]["on"]:
            return
        for ch in data.decode(errors="replace"):
            if ch in "\r\n":
                cmd, self.line = self.line.strip(), ""
                self.emit("\r\n" + self.run(cmd) + "uart:~$ ")
            elif ch in "\x7f\b":
                if self.line:
                    self.line = self.line[:-1]
                    self.emit("\b \b")
            elif ch == "\x03":
                self.line = ""
                self.emit("^C\r\nuart:~$ ")
            elif ch.isprintable():
                self.line += ch
                self.emit(ch)

    def run(self, cmd: str) -> str:
        if not cmd:
            return ""
        if cmd == "help":
            return ("Available commands:\r\n  help    kernel  led     reboot  sensor\r\n")
        if cmd == "kernel uptime":
            return f"Uptime: {int((time.monotonic() - self.booted_at) * 1000)} ms\r\n"
        if cmd.startswith("led"):
            return "\x1b[32mled0 on\x1b[0m\r\n"
        if cmd == "sensor get":
            return "temp: 23.4 C\r\nrh:   41.0 %\r\nunicode: µA ✓ 日本\r\n"
        if cmd == "reboot":
            threading.Timer(0.2, self.boot_banner).start()
            return ""
        return f"{cmd.split()[0]}: command not found\r\n"


console = Console()


# --- Access control (src/access.c, src/acl.c), simulated ----------------------

SERVICES = ["status", "control", "console", "usbip", "shell", "camera"]
ALL = (1 << len(SERVICES)) - 1
LEASED = 0b01110        # control, console, usbip
LEASE_DEFAULT_S = 3600
CLAIM_S = 60
KICK_S = 60


def bit(name: str) -> int:
    return 1 << SERVICES.index(name)


def mask_names(mask: int) -> list[str]:
    return ["all"] if mask == ALL else [n for i, n in enumerate(SERVICES) if mask & (1 << i)]


def names_mask(names) -> int | None:
    if not isinstance(names, list):
        return None
    mask = 0
    for n in names:
        if n == "all":
            mask |= ALL
        elif n in SERVICES:
            mask |= bit(n)
        else:
            return None
    return mask


def ip_int(text: str) -> int:
    try:
        return int(ipaddress.IPv4Address(text))
    except ValueError:
        return 0


def ip_str(value: int) -> str:
    return str(ipaddress.IPv4Address(value))


NAME_RE = re.compile(r"[A-Za-z0-9._-]{1,15}$")
CIDR_RE = re.compile(r"(\d{1,3}\.){3}\d{1,3}(/\d{1,2})?$")


def clean_note(note: str) -> str:
    return "".join(c if c.isascii() and (c.isalnum() or c in " ._:#/+-") else "_" for c in note)[:39]


class Access:
    """The node's rules, lease, kicks, refusal log, admin key and claim."""

    def __init__(self) -> None:
        self.lock = threading.RLock()
        self.enabled = False
        self.everyone = bit("status")
        self.sources: list[dict] = []      # name, addr, prefix, allow
        self.lease: dict | None = None     # holder, until, note
        self.blocks: dict[int, tuple[int, float]] = {}
        self.log: list[dict] = []
        self.refused_total = 0
        self.key: bytes | None = None
        self.nonces: dict[str, float] = {}
        self.claim: dict | None = None
        self.tickets: dict[str, tuple[int, float]] = {}
        self.fake: list[dict] = []         # USB/IP, RFC 2217 clients the simulation makes up

    # Rules -------------------------------------------------------------

    def rights(self, ip: int) -> int:
        if not self.enabled:
            return ALL
        mask = self.everyone
        for s in self.sources:
            net = ipaddress.IPv4Network((s["addr"], s["prefix"]))
            if ip and ipaddress.IPv4Address(ip) in net:
                mask |= s["allow"]
        return mask

    def source_of(self, ip: int) -> str:
        best = None
        for s in self.sources:
            if ip and ipaddress.IPv4Address(ip) in ipaddress.IPv4Network((s["addr"], s["prefix"])):
                if best is None or s["prefix"] > best["prefix"]:
                    best = s
        return best["name"] if best else ""

    def lease_active(self) -> bool:
        return self.lease is not None and time.monotonic() < self.lease["until"]

    def verdict(self, svc: str, ip: int) -> str:
        mask, until = self.blocks.get(ip, (0, 0))
        if mask & bit(svc) and time.monotonic() < until:
            return "kicked"
        if bit(svc) & LEASED and self.lease_active() and ip != self.lease["holder"]:
            return "reserved"
        return "ok" if self.rights(ip) & bit(svc) else "not_allowed"

    def check(self, svc: str, ip: int) -> str:
        with self.lock:
            v = self.verdict(svc, ip)
            if v != "ok":
                self.refused_total += 1
                now = time.monotonic()
                for e in self.log:
                    if (e["ip"], e["service"], e["reason"]) == (ip, svc, v):
                        e["count"] += 1
                        e["last"] = now
                        break
                else:
                    self.log.append({"ip": ip, "service": svc, "reason": v, "count": 1,
                                     "first": now, "last": now})
                    if len(self.log) > 16:
                        self.log.remove(min(self.log, key=lambda e: e["last"]))
            return v

    def allowed(self, ip: int) -> int:
        with self.lock:
            return sum(1 << i for i, s in enumerate(SERVICES) if self.verdict(s, ip) == "ok")

    def set_rules(self, body: dict) -> str | None:
        with self.lock:
            enabled, everyone, sources = self.enabled, self.everyone, list(self.sources)
            if "enabled" in body:
                enabled = bool(body["enabled"])
            if "everyone" in body:
                everyone = names_mask(body["everyone"])
                if everyone is None:
                    return "everyone: services are status, control, console, usbip, shell, camera or all"
            if "sources" in body:
                if not isinstance(body["sources"], list) or len(body["sources"]) > 8:
                    return "bad JSON (at most 8 sources)"
                sources = []
                for s in body["sources"]:
                    if not isinstance(s.get("name"), str) or not NAME_RE.match(s["name"]):
                        return "source name: 1-15 letters, digits, '.', '_' or '-'"
                    try:
                        if not CIDR_RE.match(s.get("cidr", "")):
                            raise ValueError
                        net = ipaddress.IPv4Network(s["cidr"], strict=False)
                    except (ValueError, TypeError):
                        return "source cidr: a.b.c.d or a.b.c.d/n"
                    allow = names_mask(s.get("allow"))
                    if allow is None:
                        return "source allow: status, control, console, usbip, shell, camera, all"
                    sources.append({"name": s["name"], "addr": int(net.network_address),
                                    "prefix": net.prefixlen, "allow": allow})
            self.enabled, self.everyone, self.sources = enabled, everyone, sources
        self.enforce()
        return None

    # Lease -------------------------------------------------------------

    def take(self, ip: int, ttl: int, note: str) -> str | None:
        if not 10 <= ttl <= 86400:
            return "ttl_s must be 10..86400"
        with self.lock:
            renew = self.lease_active() and self.lease["holder"] == ip
            self.lease = {"holder": ip, "until": time.monotonic() + ttl, "note": clean_note(note)}
        if not renew:
            self.enforce()
        return None

    # Admin key ---------------------------------------------------------

    def nonce(self) -> str:
        n = os.urandom(8).hex()
        with self.lock:
            now = time.monotonic()
            self.nonces = {k: t for k, t in self.nonces.items() if t > now}
            self.nonces[n] = now + 60
        return n

    def admin(self, auth: str, method: str, path: str, body: bytes) -> bool:
        if self.key is None or len(auth) != 81 or auth[16] != ":":
            return False
        nonce, mac = auth[:16], auth[17:]
        with self.lock:
            if self.nonces.pop(nonce, 0) <= time.monotonic():
                return False
        want = hmac.new(self.key, f"{nonce}\n{method}\n{path}\n".encode() + body, hashlib.sha256)
        return hmac.compare_digest(want.hexdigest(), mac.lower())

    def press_boot(self) -> bool:
        """A short press on BOOT (or "bay access claim" on the local shell)."""
        with self.lock:
            c = self.claim
            if c is None or c["done"] or time.monotonic() >= c["until"]:
                return False
            self.key = c["key"] or os.urandom(32)
            c.update(done=True, key=self.key, until=time.monotonic() + CLAIM_S)
            return True

    # Connections -------------------------------------------------------

    def connections(self) -> list[dict]:
        out = []
        with console.lock:
            for slot, (ip, since) in console.info.items():
                out.append({"id": f"web{slot}", "service": "console", "label": "web console",
                            "peer": ip, "port": 0, "since": since})
        with camera.lock:
            for slot, c in camera.clients.items():
                out.append({"id": f"cam{slot}", "service": "camera",
                            "label": "camera stream" if c["stream"] else "snapshot",
                            "peer": c["ip"], "port": c["port"], "since": c["since"]})
        return out + [dict(c) for c in self.fake]

    def close(self, conn: dict) -> None:
        if conn["id"].startswith("web"):
            console.kick(int(conn["id"][3:]))
        elif conn["id"].startswith("cam"):
            camera.kick(int(conn["id"][3:]))
        else:
            self.fake = [c for c in self.fake if c["id"] != conn["id"]]
            node["usb"]["sessions"] = sum(c["service"] == "usbip" for c in self.fake)

    def kick(self, cid: str) -> bool:
        for c in self.connections():
            if c["id"] == cid:
                with self.lock:
                    mask, until = self.blocks.get(c["peer"], (0, 0))
                    if until < time.monotonic():
                        mask = 0
                    self.blocks[c["peer"]] = (mask | bit(c["service"]), time.monotonic() + KICK_S)
                self.close(c)
                return True
        return False

    def enforce(self) -> None:
        """After a rules change or a new lease: close what is no longer allowed."""
        for c in self.connections():
            with self.lock:
                v = self.verdict(c["service"], c["peer"])
            if v != "ok":
                self.close(c)

    # Documents ---------------------------------------------------------

    def summary(self, ip: int) -> dict:
        """The "access" object of /api/status."""
        with self.lock:
            lease = {"holder": "", "note": "", "remaining_s": 0, "yours": False}
            if self.lease_active():
                lease = {"holder": ip_str(self.lease["holder"]), "note": self.lease["note"],
                         "remaining_s": secs_left(self.lease["until"], time.monotonic()),
                         "yours": self.lease["holder"] == ip}
            allow = self.allowed(ip)
            return {"enabled": self.enabled, "claimed": self.key is not None, "you": ip_str(ip),
                    "allow": [n for i, n in enumerate(SERVICES) if allow & (1 << i)],
                    "refused": self.refused_total, "lease": lease}

    def doc(self, ip: int, admin: bool) -> dict:
        now = time.monotonic()
        with self.lock:
            d = {"enabled": self.enabled, "claimed": self.key is not None, "admin": admin,
                 "you": ip_str(ip), "source": self.source_of(ip), "allow": mask_names(self.allowed(ip)),
                 "lease": None, "connections": [], "refused_total": self.refused_total,
                 "claim": "pending" if self.claim and not self.claim["done"] and now < self.claim["until"] else "none"}
            if self.lease_active():
                d["lease"] = {"holder": ip_str(self.lease["holder"]), "note": self.lease["note"],
                              "remaining_s": secs_left(self.lease["until"], now),
                              "yours": self.lease["holder"] == ip}
        for c in self.connections():
            d["connections"].append({"id": c["id"], "service": c["service"], "label": c["label"],
                                     "peer": ip_str(c["peer"]), "port": c["port"],
                                     "since_s": int(now - c["since"])})
        if admin:
            with self.lock:
                d["rules"] = {"everyone": mask_names(self.everyone), "sources": [
                    {"name": s["name"], "cidr": str(ipaddress.IPv4Network((s["addr"], s["prefix"]))).removesuffix("/32"),
                     "allow": mask_names(s["allow"])} for s in self.sources]}
                d["refused"] = [{"ip": ip_str(e["ip"]), "service": e["service"], "reason": e["reason"],
                                 "count": e["count"], "first_s": int(now - e["first"]),
                                 "last_s": int(now - e["last"])}
                                for e in sorted(self.log, key=lambda e: -e["last"])]
        return d


access = Access()


firmware = Firmware("0.5.0", "bay-node/bay_node")


class Coproc:
    """The DATA ×4 co-processor's image (src/coproc.c): the same checks and refusals, kept in memory."""

    MAGIC, FAMILY, SRAM, AREA = 0x50435748, 0xE48BFF59, (0x20000000, 0x20082000), 256 * 1024

    def __init__(self) -> None:
        self.image: dict | None = None
        self.ticket: dict | None = None
        self.error: str | None = None

    def doc(self) -> dict:
        load = ({"state": "loaded", "loads": 1, "failures": 0, "last_ms": 59, "error": None} if self.image
                else {"state": "idle", "loads": 0, "failures": 0, "last_ms": 0, "error": None})
        return {"image": self.image, "upload": "ready" if self.ticket else "idle", "error": self.error,
                "load": load}

    def begin(self, ip: str, body: dict) -> tuple[int, dict]:
        size, sha = body.get("size"), str(body.get("sha256", ""))
        if not isinstance(size, int) or size <= 0 or not re.fullmatch(r"[0-9a-fA-F]{64}", sha):
            return 400, {"error": "size and sha256 (64 hex digits) needed"}
        if size <= 64 or size > self.AREA:
            return 413, {"error": "size: larger than the coproc partition"}
        self.ticket = {"ticket": secrets.token_hex(8), "ip": ip, "size": size, "sha256": sha.lower(),
                       "until": time.monotonic() + 60}
        return 200, {"ticket": self.ticket["ticket"]}

    def _refuse(self, why: str) -> tuple[int, dict]:
        self.error, self.ticket = why, None
        return 400, {"error": why}

    def upload(self, ip: str, ticket: str, raw: bytes) -> tuple[int, dict]:
        t = self.ticket
        if not t or t["ticket"] != ticket or t["ip"] != ip or time.monotonic() > t["until"]:
            return 403, {"error": "no such ticket: begin again"}
        self.image = None                   # the old image goes when an upload starts
        if len(raw) > t["size"]:
            return self._refuse("more bytes than announced")
        if len(raw) < t["size"]:
            return self._refuse("fewer bytes than announced")
        if hashlib.sha256(raw).hexdigest() != t["sha256"]:
            return self._refuse("SHA-256 does not match")
        magic, version, hdr_size, family, addr, size = struct.unpack_from("<IHHIII", raw)
        if magic != self.MAGIC or version != 1 or hdr_size != 64:
            return self._refuse("not a co-processor image (make it with bayctl coproc load)")
        if family != self.FAMILY:
            return self._refuse("not an RP2350 Arm image")
        if size == 0 or size > self.AREA - 64:
            return self._refuse("image larger than the coproc partition")
        if addr % 4 or addr < self.SRAM[0] or addr > self.SRAM[1] - size:
            return self._refuse("image outside the RP2350's SRAM (a no_flash build is needed)")
        if len(raw) - 64 != size:
            return self._refuse("the header's size is not the image's")
        if hashlib.sha256(raw[64:]).digest() != raw[20:52]:
            return self._refuse("the header's SHA-256 is not the image's")
        name = raw[52:64].split(b"\0")[0].decode("ascii", "replace")
        self.image = {"name": name, "size": size, "addr": f"0x{addr:08x}", "sha256": raw[20:52].hex()}
        self.ticket, self.error = None, None
        return 200, self.doc()


coproc = Coproc()


# --- The co-processor's logic analyzer (src/analyzer.c) and gusmanb's firmware on it ------

LA_ID = b"LOGIC_ANALYZER_PICO_2_V6_0\nFREQ:100000000\nBLASTFREQ:200000000\nBUFFER:393216\nCHANNELS:24\n"
LA_BUFFER = 393216
LA_MARK = 12                # CH13: the node's MARK
LA_SEND_BPS = 360 * 1024    # what the node's relay sends on the bench


def uart_edges(t: float, text: bytes, baud: int) -> list[tuple[float, int]]:
    """8N1 from t, a stop bit and a half between characters."""
    out, bit = [], 1 / baud
    for ch in text:
        for i, b in enumerate([0] + [(ch >> i) & 1 for i in range(8)] + [1]):
            out.append((t + i * bit, b))
        t += 11.5 * bit
    return out


def i2c_edges(t: float, hz: float, parts) -> tuple[list, list]:
    """SDA and SCL from t: "S" a (repeated) start, "P" a stop, (byte, acked) a byte and its ninth bit."""
    q, sda, scl = 1 / hz / 4, [], []
    for part in parts:
        if part == "S":
            sda.append((t, 1)), scl.append((t + q, 1)), sda.append((t + 2 * q, 0)), scl.append((t + 3 * q, 0))
            t += 4 * q
        elif part == "P":
            sda.append((t, 0)), scl.append((t + q, 1)), sda.append((t + 2 * q, 1))
            t += 3 * q
        else:
            byte, acked = part
            for b in [(byte >> (7 - i)) & 1 for i in range(8)] + [0 if acked else 1]:
                sda.append((t, b)), scl.append((t + q, 1)), scl.append((t + 3 * q, 0))
                t += 4 * q
    return sda, scl


def spi_edges(t: float, hz: float, mosi_bytes: bytes, miso_bytes: bytes) -> tuple[list, list, list, list]:
    """CS, SCK, MOSI and MISO from t, mode 0, MSB first."""
    h, cs, sck, mosi, miso = 1 / hz / 2, [(t, 0)], [], [], []
    t += h
    for mo, mi in zip(mosi_bytes, miso_bytes):
        for i in range(8):
            mosi.append((t, (mo >> (7 - i)) & 1)), miso.append((t, (mi >> (7 - i)) & 1))
            sck.append((t + h, 1)), sck.append((t + 2 * h, 0))
            t += 2 * h
    cs.append((t + h, 1)), miso.append((t + h, 1))
    return cs, sck, mosi, miso


def la_scenario(reset: bool) -> dict[int, tuple[int, list]]:
    """Each channel: its level before its first change, and its changes (seconds from the trigger, level)."""
    t0 = 1.2e-3 if reset else 0.0
    a = uart_edges(t0, b"*** Booting Zephyr OS build v4.3.0 ***\r\n" if reset else b"Hello from B3.2\r\n", 115200)
    b = uart_edges(t0 + 4.4e-3 if reset else 2.2e-3, b"ack\r\n", 115200)
    sda, scl = i2c_edges(t0 + 6e-3 if reset else 4.5e-3, 400e3,
                         ["S", (0x90, True), (0x00, True), "S", (0x91, True), (0x1A, True), (0x60, False), "P"])
    cs, sck, mosi, miso = spi_edges(t0 + 8e-3 if reset else 6.5e-3, 4e6, b"\x9f\0\0\0", b"\xff\xef\x40\x18")
    return {0: (1, a), 1: (1, b), 2: (1, sda), 3: (1, scl), 4: (1, cs), 5: (0, sck), 6: (0, mosi), 7: (1, miso),
            LA_MARK: (0, [(-0.1, 1), (0.0, 0)]) if reset else (0, [])}


def la_samples(channels: list[int], rate: int, pre: int, post: int, trigger: tuple[int, bool]) -> bytes:
    """The capture as gusmanb's firmware sends it: a word a sample, bit i = channels[i]."""
    reset = trigger[0] == LA_MARK
    lines = la_scenario(reset)
    # The trigger at 0: the first edge of its channel in its direction
    level, changes = lines.get(trigger[0], (0, []))
    shift = 0.0
    for t, lv in changes:
        if lv != level and lv == (0 if trigger[1] else 1):
            shift = t
            break
        level = lv
    n, bps = pre + post, 1 if max(channels) < 8 else 2 if max(channels) < 16 else 4
    words = 0
    for bit, c in enumerate(channels):
        level, changes = lines.get(c, (0, []))
        one = bytes([1 << (bit % 8)])
        lane, start = bytearray(n), 0
        for t, lv in changes:
            i = min(n, max(0, round((t - shift) * rate) + pre))
            if level and i > start:
                lane[start:i] = one * (i - start)
            start, level = max(start, i), lv
        if level and n > start:
            lane[start:n] = one * (n - start)
        word = bytearray(n * bps)
        word[bit // 8::bps] = lane
        words |= int.from_bytes(word, "little")
    return words.to_bytes(n * bps, "little")


def la_requests(buf: bytearray):
    """The requests in what the page sent, unescaped: (command, data); buf keeps what is left."""
    while (start := buf.find(b"\x55\xaa")) >= 0 and (end := buf.find(b"\xaa\x55", start + 2)) >= 0:
        body, out, esc = buf[start + 2:end], bytearray(), False
        for b in body:
            if esc:
                out.append(b ^ 0xF0)
                esc = False
            elif b == 0xF0:
                esc = True
            else:
                out.append(b)
        del buf[:end + 2]
        if out:
            yield out[0], bytes(out[1:])


class LogicAnalyzer:
    """/api/analyzer and /analyzer/ws as the node's relay serves them, gusmanb's analyzer behind."""

    def __init__(self) -> None:
        self.owner = "page"
        self.lock = threading.Lock()
        self.page: tuple[int, float, socket.socket] | None = None
        self.from_device = self.to_device = 0
        self.reset = threading.Event()

    def present(self) -> bool:
        return x4() and coproc.image is not None

    def doc(self) -> dict:
        with self.lock:
            page = ({"ip": ip_str(self.page[0]), "since_s": int(time.monotonic() - self.page[1])}
                    if self.page else None)
        return {"owner": self.owner, "present": self.present(), "busid": f"1-1.{PORTS + 1}", "page": page,
                "from_device": self.from_device, "to_device": self.to_device, "dropped": 0, "error": None}

    def kick(self) -> None:
        with self.lock:
            if self.page:
                try:
                    self.page[2].shutdown(socket.SHUT_RDWR)
                except OSError:
                    pass

    def set_owner(self, body: dict) -> tuple[int, dict]:
        if body.get("owner") not in ("page", "usbip"):
            return 400, {"error": 'owner: "page" or "usbip"'}
        self.owner = body["owner"]
        if self.owner == "usbip":
            self.kick()
        return 200, self.doc()

    def refusal(self, ip: int) -> str | None:
        """Why the node would not give this page the analyzer"""
        with self.lock:
            other = self.page is not None and self.page[0] != ip
        return ("no analyzer" if not self.present() else "the analyzer is USB/IP's" if self.owner != "page"
                else "another address has the analyzer" if other else None)

    def serve(self, handler, ip: int) -> None:
        """The page's WebSocket, upgraded: one page at a time, the same address takes it over."""
        sock, send_lock, buf = handler.connection, threading.Lock(), bytearray()
        waiting = threading.Event()     # a capture waits for its trigger: any byte cancels it
        cancel = threading.Event()
        self.kick()
        with self.lock:
            self.page = (ip, time.monotonic(), sock)

        def send(data: bytes) -> None:
            with send_lock:
                sock.sendall(ws_frame(2, data))
            self.from_device += len(data)

        def capture(req: bytes) -> None:
            kind, trig, inverted = req[0], req[1], bool(req[2])
            channels = list(req[6:6 + req[30]])
            rate, pre, post = struct.unpack_from("<III", req, 32)
            self.reset.clear()
            waiting.set()
            # Triggered on MARK: a reset of a port releases it; else the board's own traffic, soon
            fired = (self.reset.wait(30) if trig == LA_MARK else not cancel.wait(0.4)) and not cancel.is_set()
            waiting.clear()
            if not fired:
                return
            data = la_samples(channels, rate, pre, post, (trig, inverted))
            data = struct.pack("<I", pre + post) + data + b"\0"
            for i in range(0, len(data), 16384):
                send(data[i:i + 16384])
                time.sleep(min(16384, len(data) - i) / LA_SEND_BPS)

        try:
            while (frame := ws_read(handler.rfile)) is not None:
                opcode, data = frame
                if opcode == 8:
                    break
                if opcode == 9:
                    with send_lock:
                        sock.sendall(ws_frame(10, data))
                if opcode not in (1, 2):
                    continue
                self.to_device += len(data)
                if waiting.is_set():
                    cancel.set()        # gusmanb: any byte cancels a capture waiting for its trigger
                    continue
                buf += data
                for cmd, body in la_requests(buf):
                    if cmd == 0:
                        send(LA_ID)
                    elif cmd == 1 and len(body) >= 48:
                        channels = list(body[6:6 + body[30]])
                        bps = 1 if max(channels, default=0) < 8 else 2 if max(channels) < 16 else 4
                        pre, post = struct.unpack_from("<II", body, 36)
                        if not channels or pre + post > LA_BUFFER // bps:
                            send(b"CAPTURE_ERROR\n")
                            continue
                        send(b"CAPTURE_STARTED\n")
                        cancel.clear()
                        threading.Thread(target=capture, args=(body,), daemon=True).start()
                    elif cmd == 4:
                        send(b"RESTARTING_BOOTLOADER\n")
        except OSError:
            pass
        finally:
            cancel.set()
            with self.lock:
                if self.page and self.page[2] is sock:
                    self.page = None
        handler.close_connection = True


logic = LogicAnalyzer()


# --- The DATA x4's pin matrix (src/wires.c) -------------------------------------------

WIRE_BUSES = "ABCDEFGH"


class Wires:
    """/api/wires: each port pin on one bus at most, held open while its port is off or its VREF reads under
    0.65 V.  The node has no VREF reading yet (null); here it is made up, B3.4 a 1.8 V board."""

    def __init__(self) -> None:
        self.wanted: dict[tuple[int, int], str] = {}
        self.names = [""] * len(WIRE_BUSES)
        self.vref = {1: 3300, 2: 3310, 3: 3290, 4: 1800}

    def held(self, port: int) -> bool:
        pt = next((x for x in ports if x["port"] == port), None)
        return pt is None or not pt["on"] or self.vref.get(port, 0) < 650

    def closed(self) -> dict[tuple[int, int], str]:
        return {k: b for k, b in self.wanted.items() if not self.held(k[0])}

    def doc(self, changed: int | None = None) -> dict:
        d = {"matrix": True, "error": None, "names": list(self.names),
             "pins": [{"port": p, "pin": n, "bus": b, "closed": not self.held(p)}
                      for (p, n), b in sorted(self.wanted.items())],
             "ports": [{"port": pt["port"], "on": pt["on"], "vref_mv": self.vref.get(pt["port"]),
                        "held": self.held(pt["port"])} for pt in ports]}
        if changed is not None:
            d["changed"] = changed
        return d

    def post(self, body: dict, ip: int) -> tuple[int, dict]:
        wanted = None
        if "pins" in body:
            wanted = {}
            for e in body["pins"] if isinstance(body["pins"], list) else [None]:
                if not isinstance(e, dict) or e.get("port") not in range(1, 5) or e.get("pin") not in range(1, 9):
                    return 400, {"error": "port: 1-4, pin: 1-8"}
                if e.get("bus") not in list(WIRE_BUSES):
                    return 400, {"error": "bus: A-H"}
                if (e["port"], e["pin"]) in wanted:
                    return 400, {"error": "a pin goes on one bus"}
                wanted[(e["port"], e["pin"])] = e["bus"]
        names = body.get("names")
        if names is not None and (not isinstance(names, list) or len(names) != len(WIRE_BUSES)):
            return 400, {"error": "names: one per bus, A to H"}
        if names is not None and any(not isinstance(x, str) or len(x) >= 24 or re.search(r'["\\<>]|[\x00-\x1f]', x)
                                     for x in names):
            return 400, {"error": "a name: under 24 characters, no quotes, backslashes or angle brackets"}
        if wanted is not None:
            for pt in ports:
                mine = lambda w: {k: b for k, b in w.items() if k[0] == pt["port"]}  # noqa: E731
                if mine(wanted) != mine(self.wanted) and port_reserved(pt, ip):
                    return 423, {"error": f"{slot_name(pt['port'])} is reserved by another address"}
        if names is not None:
            self.names = list(names)
        changed = 0
        if wanted is not None:
            before = self.closed()
            self.wanted = wanted
            after = self.closed()
            # Each pin that moves opens one switch and closes another
            changed = sum((k in before and before[k] != after.get(k)) + (k in after and after[k] != before.get(k))
                          for k in set(before) | set(after))
        return 200, self.doc(changed)


wires = Wires()


# --- The fake camera: an Arducam Mega looking down at the drawer -------------

CAM_RESOLUTIONS = ["320x240", "640x480", "1280x720", "1600x1200", "1920x1080"]
CAM_QUALITIES = {"high": 90, "default": 75, "low": 50}
# White balance presets as a colour cast (red, green, blue gains)
CAM_WB = {"auto": (1, 1, 1), "sunny": (1.06, 1.0, 0.92), "office": (0.96, 1.03, 1.05),
          "cloudy": (1.1, 1.0, 0.86), "home": (1.16, 1.0, 0.8)}
CAM_IMAGE_DEFAULTS = {"exposure": "auto", "exposure_value": 1000, "gain": "auto", "gain_value": 64,
                      "white_balance": "auto", "brightness": 0, "contrast": 0, "saturation": 0,
                      "sharpness": "auto"}
CAM_CHOICES = {"resolutions": CAM_RESOLUTIONS, "qualities": list(CAM_QUALITIES),
               "white_balances": list(CAM_WB), "exposure_value": [0, 30000], "gain_value": [0, 1023],
               "brightness": [-4, 4], "contrast": [-3, 3], "saturation": [-3, 3], "sharpness": [1, 8],
               "rotation": [0, 90, 180, 270]}


def cam_int(value, lo: int, hi: int) -> int | None:
    """Like parse_int() in camera.c: a whole number in [lo, hi], given as a number or text."""
    try:
        v = int(str(value), 10)
    except ValueError:
        return None
    return v if lo <= v <= hi else None


def cam_set_one(c: dict, name: str, value) -> str | None:
    """set_one() in camera.c: one setting by name into c, or the error."""
    v = str(value)
    if name == "resolution":
        if v not in CAM_RESOLUTIONS:
            return "resolution: 320x240, 640x480, 1280x720, 1600x1200 or 1920x1080"
        c[name] = v
    elif name == "quality":
        if v not in CAM_QUALITIES:
            return "quality: high, default or low"
        c[name] = v
    elif name == "light":
        if v not in ("on", "off"):
            return "light: on or off"
        c[name] = v
    elif name in ("exposure", "gain"):
        hi = 30000 if name == "exposure" else 1023
        if v in ("auto", "manual"):
            c[name] = v
        elif (n := cam_int(v, 0, hi)) is not None:
            c[name], c[name + "_value"] = "manual", n
        else:
            return f"{name}: auto, manual or 0-{hi}"
    elif name in ("exposure_value", "gain_value"):
        hi = 30000 if name == "exposure_value" else 1023
        if (n := cam_int(v, 0, hi)) is None:
            return f"{name}: 0-{hi}"
        c[name] = n
    elif name == "white_balance":
        if v not in CAM_WB:
            return "white_balance: auto, sunny, office, cloudy or home"
        c[name] = v
    elif name in ("brightness", "contrast", "saturation"):
        lim = 4 if name == "brightness" else 3
        if (n := cam_int(v, -lim, lim)) is None:
            return f"{name}: -{lim} to {lim}"
        c[name] = n
    elif name == "sharpness":
        if v == "auto":
            c[name] = "auto"
        elif (n := cam_int(v, 1, 8)) is not None:
            c[name] = n
        else:
            return "sharpness: auto or 1-8"
    elif name == "rotation":
        if (n := cam_int(v, 0, 270)) is None or n % 90:
            return "rotation: 0, 90, 180 or 270"
        c[name] = n
    else:
        return "unknown setting"
    return None
CAM_SLOTS = 3
CAM_FPS = 5
CAM_SETTLE_S = 0.3
# B2's camera as the viewer (site/) renders it, grabbed by grab_camera.py at these
# resolutions, frames 300 ms apart (the GIGA's screen plays), the light on and off
CAM_FRAMES = WEB / "camera"
CAM_GRABBED = ((640, 480), (1600, 1200))
CAM_FRAME_S = 0.3


def cam_frames() -> dict[tuple[int, int, str], list[bytes]]:
    """The grabbed frames: {(width, height, "on" or "off"): [JPEG, ...]}."""
    frames: dict[tuple[int, int, str], list[bytes]] = {}
    for path in sorted(CAM_FRAMES.glob("b2-*.jpg")):
        if m := re.fullmatch(r"b2-(\d+)x(\d+)-(on|off)-\d+\.jpg", path.name):
            frames.setdefault((int(m[1]), int(m[2]), m[3]), []).append(path.read_bytes())
    return frames


def cam_process(data: bytes, w: int, h: int, c: dict) -> bytes:
    """What the Mega's image processor would do to a grabbed frame, roughly (needs Pillow):
    the resolution (16:9 cut from the middle of the 4:3 frame), a manual exposure or gain,
    the image settings, the JPEG quality."""
    from io import BytesIO

    from PIL import Image, ImageEnhance

    img = Image.open(BytesIO(data)).convert("RGB")
    if w * 3 != h * 4:
        ch = img.width * h // w
        top = (img.height - ch) // 2
        img = img.crop((0, top, img.width, top + ch))
    if img.size != (w, h):
        img = img.resize((w, h), Image.LANCZOS)
    level = 1.0
    if c["exposure"] == "manual":
        level *= min(3.0, max(0.05, c["exposure_value"] / 1000))
    if c["gain"] == "manual":
        level *= min(3.0, max(0.2, (c["gain_value"] / 64) ** 0.5))
    img = ImageEnhance.Brightness(img).enhance(level * (1 + 0.12 * c["brightness"]))
    img = ImageEnhance.Contrast(img).enhance(1 + 0.2 * c["contrast"])
    img = ImageEnhance.Color(img).enhance(max(0.0, 1 + 0.3 * c["saturation"]))
    if c["sharpness"] != "auto":
        img = ImageEnhance.Sharpness(img).enhance(0.25 * c["sharpness"])
    if c["white_balance"] != "auto":
        gains = CAM_WB[c["white_balance"]]
        img = Image.merge("RGB", [band.point(lambda v, g=g: min(255, int(v * g)))
                                  for band, g in zip(img.split(), gains)])
    out = BytesIO()
    img.save(out, "JPEG", quality=CAM_QUALITIES[c["quality"]])
    return out.getvalue()


class Camera:
    """src/camera.c: the settings, the clients, the frames."""

    def __init__(self) -> None:
        self.lock = threading.Lock()
        self.present = True
        self.port = 0
        self.cfg = {"resolution": "640x480", "quality": "default", "light": "on", "rotation": 0,
                    **CAM_IMAGE_DEFAULTS}
        self.clients: dict[int, dict] = {}   # slot -> stream, ip, port, since, light, kicked
        self.frames = self.errors = self.last_bytes = self.last_ms = 0
        self.stamps: list[float] = []
        self.grabbed: dict[tuple[int, int, str], list[bytes]] | None = None

    def lit(self) -> bool:
        """Like want_light(): during a lease only the holder's wish counts."""
        holder = access.lease["holder"] if access.lease_active() else None
        return any((c["light"] or self.cfg["light"]) == "on" for c in self.clients.values()
                   if holder is None or c["ip"] == holder)

    def doc(self, full: bool = False) -> dict:
        """The camera object of /api/status; with full, GET /api/camera's."""
        with self.lock:
            streams = sum(c["stream"] for c in self.clients.values())
            now = time.monotonic()
            recent = [t for t in self.stamps if now - t < 5]
            cfg = dict(self.cfg)
            d = {"present": self.present, "model": "Arducam Mega 3MP" if self.present else "",
                 "port": self.port, "resolution": cfg["resolution"], "quality": cfg["quality"],
                 "light": cfg["light"], "rotation": cfg["rotation"],
                 "lit": bool(self.clients) and self.lit(),
                 "clients": len(self.clients), "streams": streams, "slots": CAM_SLOTS,
                 "frames": self.frames, "errors": self.errors, "last_bytes": self.last_bytes,
                 "last_ms": self.last_ms, "fps": round(len(recent) / 5, 1) if streams else 0}
        if full:
            d.update(settings=cfg, choices=CAM_CHOICES)
        return d

    def configure(self, body: dict) -> str | None:
        """camera_configure(): all or nothing; "reset": true, the image settings to auto first."""
        with self.lock:
            c = dict(self.cfg)
        if body.get("reset") is True:
            c.update(CAM_IMAGE_DEFAULTS)
        for name, value in body.items():
            if name != "reset" and (err := cam_set_one(c, name, value)) is not None:
                return err
        with self.lock:
            self.cfg = c
        return None

    def frame(self) -> bytes:
        """A JPEG at the set resolution and quality: a grabbed frame, the light on or off, the
        next one every CAM_FRAME_S.  Pillow brings it to the other resolutions and applies the
        image settings; without it, the frame goes as grabbed."""
        t0 = time.monotonic()
        with self.lock:
            if self.grabbed is None:
                self.grabbed = cam_frames()
            lit = self.lit()
            c = dict(self.cfg)
        w, h = map(int, c["resolution"].split("x"))
        # the grab at this resolution, or the smallest one at least as wide
        gw, gh = next(((gw, gh) for gw, gh in CAM_GRABBED if gw >= w), CAM_GRABBED[-1])
        shots = self.grabbed[(gw, gh, "on" if lit else "off")]
        data = shots[int(t0 / CAM_FRAME_S) % len(shots)]
        if (gw, gh) != (w, h) or c["quality"] != "default" or any(
                c[k] != v for k, v in CAM_IMAGE_DEFAULTS.items()):
            try:
                data = cam_process(data, w, h, c)
            except ImportError:
                pass
        with self.lock:
            self.frames += 1
            self.last_bytes = len(data)
            self.last_ms = int((time.monotonic() - t0) * 1000) + 40
            self.stamps = [t for t in self.stamps if time.monotonic() - t < 5] + [time.monotonic()]
        return data

    def kick(self, slot: int) -> None:
        with self.lock:
            if slot in self.clients:
                self.clients[slot]["kicked"] = True


camera = Camera()


class CameraHandler(BaseHTTPRequestHandler):
    """The camera's port: GET /snapshot.jpg, /stream.mjpg [?light=on|off|auto]."""

    def text(self, code: int, msg: str) -> None:
        body = (msg + "\n").encode()
        self.send_response(code)
        self.send_header("Content-Type", "text/plain")
        self.send_header("Content-Length", str(len(body)))
        self.end_headers()
        self.wfile.write(body)

    def do_GET(self) -> None:  # noqa: N802
        real = self.client_address[0]
        ip = ip_int(PEER_OVERRIDE.get(real, real))
        if access.check("camera", ip) != "ok":
            self.close_connection = True   # the node closes a refused connection at once
            return
        url = urlsplit(self.path)
        light = parse_qs(url.query).get("light", ["auto"])[0]
        if url.path not in ("/snapshot.jpg", "/stream.mjpg"):
            return self.text(404, "GET /snapshot.jpg or /stream.mjpg [?light=on|off|auto]")
        if not camera.present:
            return self.text(503, "no camera on this bay")
        stream = url.path == "/stream.mjpg"
        with camera.lock:
            free = [s for s in range(CAM_SLOTS) if s not in camera.clients]
            if not free:
                return self.text(503, "camera busy: too many clients")
            slot = free[0]
            was_lit = bool(camera.clients) and camera.lit()
            me = camera.clients[slot] = {"stream": stream, "ip": ip, "port": self.client_address[1],
                                        "since": time.monotonic(), "kicked": False,
                                        "light": light if light in ("on", "off") else None}
            now_lit = camera.lit()
        try:
            if now_lit and not was_lit:
                time.sleep(CAM_SETTLE_S)
            if not stream:
                data = camera.frame()
                self.send_response(200)
                self.send_header("Content-Type", "image/jpeg")
                self.send_header("Cache-Control", "no-store")
                self.send_header("Content-Length", str(len(data)))
                self.end_headers()
                self.wfile.write(data)
                return
            self.send_response(200)
            self.send_header("Content-Type", "multipart/x-mixed-replace; boundary=frame")
            self.send_header("Cache-Control", "no-store")
            self.end_headers()
            while not me["kicked"]:
                t = time.monotonic()
                data = camera.frame()
                self.wfile.write(b"--frame\r\nContent-Type: image/jpeg\r\n"
                                 + f"Content-Length: {len(data)}\r\n\r\n".encode() + data + b"\r\n")
                self.wfile.flush()
                time.sleep(max(0.0, 1 / CAM_FPS - (time.monotonic() - t)))
        except OSError:
            pass
        finally:
            with camera.lock:
                camera.clients.pop(slot, None)
            self.close_connection = True

    def log_message(self, fmt: str, *args) -> None:
        pass


def status(ip: int = 0) -> dict:
    dut = node["dut"]
    ma = dut_current_ma(time.monotonic()) if dut["on"] else 0
    mv = (5080 - ma // 10) if dut["on"] else 0
    dut.update(ma=ma, mv=mv, mw=ma * mv // 1000)
    node["path"] = "classic" if node["force_classic"] else "usbip"
    admit()
    docs = [port_doc(pt, ip) for pt in ports]
    if docs:                            # the node's totals: its own meter on DATA_VIN (the board counts), flags ORed
        mw = bay_mw(time.monotonic())
        dut.update(on=any(d["power"]["on"] for d in docs), latched=any(d["fault"] for d in docs),
                   faults=sum(d["power"]["faults"] for d in docs), ma=mw * 1000 // DATA_VIN_MV,
                   mv=DATA_VIN_MV, mw=mw)
        node["usb"]["devices"] = sum(d["usb"] is not None for d in docs)
        node["usb"]["sessions"] = (sum(d["usbip"] is not None for d in docs)
                                   + sum(c["service"] == "usbip" for c in access.fake))
    fmt = f"{aux['data_bits']}{aux['parity'][0].upper()}{aux['stop_bits']}"
    s = {**node, "uptime_s": int(time.monotonic() - START),
            "aux": {"baud": aux["baud"], "format": fmt, "port": 4000, "rfc2217_port": 4001,
                    "web_clients": len(console.clients),
                    "rfc2217": any(c["id"] == "rfc2217" for c in access.fake), "raw": False,
                    "rx": len(console.log), "tx": console.tx, "dropped": 0},
            "access": access.summary(ip), "firmware": firmware.doc(), "camera": camera.doc()}
    if x4():                            # a DATA ×4 bay: its co-processor and its analyzer
        s["coproc"] = coproc.doc()
        s["analyzer"] = logic.doc()
    s["data_board"] = {4: "x4", 6: "x6"}.get(PORTS)
    # A DATA x4 or x6 bay is node v1.0's: mW on the DATA lead against the hub's grant.  The one-DUT node
    # is a stand-in's, in mA on its 5 V (the page shows no budget for it)
    s["budget"] = ({"unit": "mW", "limit": GRANT_MW, "granted": True, "reserve": RESERVE_MW,
                    "draw": dut["mw"], "waiting": sum(pt["waiting"] for pt in ports), "sheds": 0,
                    "board": True, "lead_off": None} if docs else
                   {"unit": "mA", "limit": 1150, "granted": False, "reserve": 100, "draw": 0,
                    "waiting": 0, "sheds": 0, "board": False, "lead_off": None})
    s["ports"] = [short_port(d) for d in docs or [one_port_doc(s)]]
    return s


def aux_doc() -> dict:
    return {"type": "aux", **aux, "web_clients": len(console.clients), "web_slots": WEB_SLOTS,
            "rfc2217": False, "rfc2217_port": 4001, "raw": False, "raw_port": 4000,
            "rx": len(console.log), "tx": console.tx, "dropped": 0}


def metrics() -> str:
    s = status()
    dut, usb, a = s["dut"], s["usb"], s["aux"]
    bay = f'bay="{s["id"]}"'
    # The DUT metrics: the one DUT's, or each port's, labelled port="B3.2"
    duts = ([(f'{bay},port="{d["slot"]}"', d["power"], d["fault"]) for d in ports_doc()] if multi()
            else [(bay, dut, dut["fault"] or dut["latched"])])
    rows = [
        ("bay_dut_vbus_volts", "gauge", [(lb, pw["mv"] / 1000) for lb, pw, _ in duts]),
        ("bay_dut_current_amperes", "gauge", [(lb, pw["ma"] / 1000) for lb, pw, _ in duts]),
        ("bay_dut_power_watts", "gauge", [(lb, pw["mw"] / 1000) for lb, pw, _ in duts]),
        ("bay_dut_power_on", "gauge", [(lb, int(pw["on"])) for lb, pw, _ in duts]),
        ("bay_dut_fault", "gauge", [(lb, int(f)) for lb, _, f in duts]),
        ("bay_dut_faults_total", "counter", [(lb, pw["faults"]) for lb, pw, _ in duts]),
        ("bay_usb_devices", "gauge", [(bay, usb["devices"])]),
        ("bay_usbip_sessions", "gauge", [(bay, usb["sessions"])]),
        ("bay_aux_rx_bytes_total", "counter", [(bay, a["rx"])]),
        ("bay_aux_tx_bytes_total", "counter", [(bay, a["tx"])]),
        ("bay_access_refused_total", "counter", [(bay, access.refused_total)]),
    ]
    out = []
    for name, kind, values in rows:
        out.append(f"# TYPE {name} {kind}")
        out += [f"{name}{{{lb}}} {value:f}" for lb, value in values]
    return "\n".join(out) + "\n"


PEER_OVERRIDE: dict[str, str] = {}


def fake_client(cid: str, service: str, label: str, port: int) -> None:
    """Toggle a made-up client from 192.168.1.41 (the CI runner of the examples)."""
    if any(c["id"] == cid for c in access.fake):
        access.fake = [c for c in access.fake if c["id"] != cid]
    else:
        access.fake.append({"id": cid, "service": service, "label": label,
                            "peer": ip_int("192.168.1.41"), "port": port, "since": time.monotonic()})
    node["usb"]["sessions"] = sum(c["service"] == "usbip" for c in access.fake)


class Handler(BaseHTTPRequestHandler):
    def peer(self) -> int:
        real = self.client_address[0]
        return ip_int(PEER_OVERRIDE.get(real, real))

    def refused(self, svc: str) -> bool:
        """Like web.c's refused(): 403, or 423 with the holder, when the rules say no."""
        ip = self.peer()
        v = access.check(svc, ip)
        if v == "ok":
            return False
        if v == "reserved":
            lease = access.lease
            note = f" ({lease['note']})" if lease["note"] else ""
            left = math.ceil((lease["until"] - time.monotonic()) / 60)
            body = {"error": f"reserved by {ip_str(lease['holder'])}{note}, {left} min left"}
            code = 423
        else:
            body = {"error": "kicked by an admin: retry in a minute" if v == "kicked"
                    else "not allowed from this address"}
            code = 403
        self.json(code, {**body, "reason": v, "service": svc, "you": ip_str(ip)})
        return True

    def send(self, code: int, body: bytes, ctype: str) -> None:
        self.send_response(code)
        self.send_header("Content-Type", ctype)
        self.send_header("Content-Length", str(len(body)))
        self.end_headers()
        self.wfile.write(body)

    def json(self, code: int, obj: dict) -> None:
        self.send(code, json.dumps(obj).encode(), "application/json")

    def do_GET(self) -> None:  # noqa: N802
        url = urlsplit(self.path)
        path, query = url.path, parse_qs(url.query)
        if firmware.down() and not path.startswith("/dev/"):
            self.json(503, {"error": "restarting"})
        elif path in STATIC:
            file, ctype = STATIC[path]
            self.send(200, file.read_bytes(), ctype)
        elif path.startswith("/console/ws/"):
            self.websocket(int(path.rsplit("/", 1)[1]), query.get("t", [""])[0])
        elif path == "/analyzer/ws":
            self.analyzer_ws(query.get("t", [""])[0])
        elif path == "/api/wires":
            if not multi():
                self.json(404, {"error": "not found"})
            elif not self.refused("status"):
                self.json(200, wires.doc())
        elif path == "/dev/vref":
            wires.vref[int(query.get("port", ["1"])[0])] = int(query.get("mv", ["0"])[0])
            self.json(200, wires.doc())
        elif path == "/api/analyzer":
            if not multi():
                self.json(404, {"error": "not found"})
            elif not self.refused("status"):
                self.json(200, logic.doc())
        elif path == "/api/status":
            if not self.refused("status"):
                self.json(200, status(self.peer()))
        elif path == "/api/ports":
            if not self.refused("status"):
                self.json(200, ports_doc(self.peer()))
        elif path == "/api/aux":
            if not self.refused("status"):
                self.json(200, aux_doc())
        elif path == "/api/usb":
            if not self.refused("status"):
                self.json(200, usb_doc())
        elif path == "/board-targets.json":
            self.send(200, json.dumps(board_targets.targets(BOARDS_YAML), separators=(",", ":")).encode(),
                      "application/json")
        elif path == "/api/boards":
            if not self.refused("status"):
                self.json(200, boards_doc())
        elif (m := re.fullmatch(r"/api/ports/(\d+)/board", path)):
            if not 1 <= int(m[1]) <= slot_count():
                self.json(404, {"error": f"no port {m[1]} on this node (1..{slot_count()})"})
            elif not self.refused("status"):
                self.json(200, board_doc(int(m[1])))
        elif path == "/dev/usb":
            global usb_one
            preset = query.get("preset", ["nucleo"])[0]
            if preset not in USB_PRESETS:
                return self.json(404, {"error": f"presets: {', '.join(USB_PRESETS)}"})
            if "port" in query and multi():
                ports[int(query["port"][0]) - 1]["usb"] = dict(USB_PRESETS[preset])
            else:
                usb_one = preset
            self.json(200, usb_doc())
        elif path == "/metrics":
            if not self.refused("status"):
                self.send(200, metrics().encode(), "text/plain")
        elif path == "/api/access":
            auth = self.headers.get("X-Bay-Auth", "")
            admin = bool(auth) and access.admin(auth, "GET", path, b"")
            if auth and not admin:
                self.json(403, {"error": "bad or expired admin signature"})
            elif admin or not self.refused("status"):
                self.json(200, access.doc(self.peer(), admin))
        elif path == "/api/access/nonce":
            self.json(200, {"nonce": access.nonce()})
        elif path == "/api/update":
            self.json(200, firmware.doc())
        elif path == "/api/coproc":
            self.json(200, coproc.doc())
        elif path == "/api/camera":
            if not self.refused("status"):
                self.json(200, camera.doc(full=True))
        elif path == "/dev/camera":
            camera.present = not camera.present
            self.json(200, camera.doc())
        elif path == "/dev/rollback":
            firmware.rollback()
            self.json(200, {"rollback": True})
        elif path == "/dev/image":
            self.send(200, make_image(query.get("version", ["0.6.0"])[0],
                                      query.get("id", [firmware.image_id])[0]), "application/octet-stream")
        elif path in ("/dev/draw", "/dev/foreign") and "port" in query and multi():
            pt = next((x for x in ports if str(x["port"]) == query["port"][0]), None)
            if pt is None:
                return self.json(404, {"error": f"no port {query['port'][0]} (1..{PORTS})"})
            if path == "/dev/foreign":
                pt["foreign"] = not pt["foreign"]
            else:
                pt["draw"] = max(0, int(query.get("ma", ["0"])[0]))
            self.json(200, port_doc(pt))
        elif path in ("/dev/fault", "/dev/attach") and "port" in query and multi():
            pt = next((x for x in ports if str(x["port"]) == query["port"][0]), None)
            if pt is None:
                return self.json(404, {"error": f"no port {query['port'][0]} (1..{PORTS})"})
            if path == "/dev/fault":
                pt.update(on=False, latched=True, faults=pt["faults"] + 1, client=None)
            else:
                pt["client"] = None if pt["client"] else ip_int("192.168.1.41")
            self.json(200, port_doc(pt))
        elif path == "/dev/fault":
            node["dut"].update(on=False, latched=True, faults=node["dut"]["faults"] + 1)
            self.json(200, status())
        elif path == "/dev/attach":
            fake_client("usbip:51234", "usbip", "USB/IP", 51234)
            self.json(200, status())
        elif path == "/dev/rfc2217":
            fake_client("rfc2217", "console", "RFC 2217", 40112)
            self.json(200, status())
        elif path == "/dev/boot":
            self.json(200, {"claimed": access.press_boot()})
        elif path == "/dev/peer":
            ip = query.get("ip", [""])[0]
            if ip:
                PEER_OVERRIDE[self.client_address[0]] = ip
            else:
                PEER_OVERRIDE.pop(self.client_address[0], None)
            self.json(200, {"you": ip_str(self.peer())})
        else:
            self.json(404, {"error": "not found"})

    def websocket(self, slot: int, ticket: str) -> None:
        # Like the node: a ticket from POST /api/console/ticket, else no upgrade
        with access.lock:
            ip, until = access.tickets.pop(ticket, (0, 0))
        if until < time.monotonic() or access.check("console", ip) != "ok":
            self.json(403, {"error": "no console ticket"})
            return
        key = self.headers.get("Sec-WebSocket-Key", "")
        accept = base64.b64encode(hashlib.sha1(
            (key + "258EAFA5-E914-47DA-95CA-C5AB0DC85B11").encode()).digest()).decode()
        self.send_response(101)
        self.send_header("Upgrade", "websocket")
        self.send_header("Connection", "Upgrade")
        self.send_header("Sec-WebSocket-Accept", accept)
        self.end_headers()
        sock = self.connection
        with console.lock:
            if slot >= WEB_SLOTS or slot in console.clients:
                return  # like the node: busy slot, closed without a hello
            start = max(0, len(console.log) - LOG_WINDOW)
            hello = {"type": "hello", "slot": slot, "boot": console.boot, "pos": start,
                     "config": {"type": "config", **aux}}
            sock.sendall(ws_frame(1, json.dumps(hello).encode()))
            if len(console.log) > start:
                sock.sendall(ws_frame(2, bytes(console.log[start:])))
            console.clients[slot] = sock
            console.info[slot] = (ip, time.monotonic())
        try:
            while (frame := ws_read(self.rfile)) is not None:
                opcode, data = frame
                if opcode == 8:
                    break
                if opcode in (1, 2):
                    console.type(data)
        except OSError:
            pass
        finally:
            with console.lock:
                if console.clients.get(slot) is sock:
                    console.clients.pop(slot, None)
                    console.info.pop(slot, None)
        self.close_connection = True

    def analyzer_ws(self, ticket: str) -> None:
        # Like the node: a console ticket, and the analyzer this page's to take
        with access.lock:
            ip, until = access.tickets.pop(ticket, (0, 0))
        if until < time.monotonic() or access.check("console", ip) != "ok":
            return self.json(403, {"error": "no console ticket"})
        if (why := logic.refusal(ip)) is not None:
            return self.json(409, {"error": why})
        key = self.headers.get("Sec-WebSocket-Key", "")
        accept = base64.b64encode(hashlib.sha1(
            (key + "258EAFA5-E914-47DA-95CA-C5AB0DC85B11").encode()).digest()).decode()
        self.send_response(101)
        self.send_header("Upgrade", "websocket")
        self.send_header("Connection", "Upgrade")
        self.send_header("Sec-WebSocket-Accept", accept)
        self.end_headers()
        logic.serve(self, ip)

    def do_POST(self) -> None:  # noqa: N802
        length = int(self.headers.get("Content-Length") or 0)
        raw = self.rfile.read(length)
        url = urlsplit(self.path)
        if firmware.down():
            return self.json(503, {"error": "restarting"})
        if url.path == "/api/update":
            ticket = parse_qs(url.query).get("ticket", [""])[0]
            return self.json(*firmware.upload(self.client_address[0], ticket, raw))
        if url.path == "/api/coproc":
            ticket = parse_qs(url.query).get("ticket", [""])[0]
            return self.json(*coproc.upload(self.client_address[0], ticket, raw))
        try:
            body = json.loads(raw or b"{}")
        except json.JSONDecodeError:
            return self.json(400, {"error": "bad JSON"})
        path = urlsplit(self.path).path
        if path == "/api/coproc/begin":
            if not access.admin(self.headers.get("X-Bay-Auth", ""), "POST", path, raw):
                return self.json(403, {"error": "admin only: unlock with the admin key"})
            return self.json(*coproc.begin(self.client_address[0], body))
        if path == "/api/update/begin":
            if not access.admin(self.headers.get("X-Bay-Auth", ""), "POST", path, raw):
                return self.json(403, {"error": "admin only: unlock with the admin key"})
            firmware.busy = None
            if access.lease_active():
                lease = access.lease
                firmware.busy = (f"reserved by {ip_str(lease['holder'])} for "
                                 f"{math.ceil((lease['until'] - time.monotonic()) / 60)} min more: "
                                 "force to update anyway")
            return self.json(*firmware.begin(self.client_address[0], body))
        if path.startswith("/api/access/") or path in ("/api/lease", "/api/console/ticket"):
            return self.access_post(path, raw, body)
        if path == "/api/camera":
            if self.refused("control"):
                return
            if not camera.present:
                return self.json(404, {"error": "no camera on this bay"})
            if (err := camera.configure(body)) is not None:
                return self.json(400, {"error": err})
            return self.json(200, camera.doc(full=True))
        if self.refused("console" if path in ("/api/aux", "/api/aux/break") else "control"):
            return
        if path == "/api/analyzer":
            return self.json(*logic.set_owner(body)) if x4() else self.json(404, {"error": "not found"})
        if path == "/api/wires":
            return self.json(*wires.post(body, self.peer())) if x4() else self.json(404, {"error": "not found"})
        m = re.fullmatch(r"/api/ports/(\d+)/(power|reset|boot)", path)
        if m:
            return self.port_post(int(m[1]), m[2], body, port_reply=True)
        if multi() and path in ("/api/power", "/api/reset", "/api/boot"):
            if "port" not in body:
                return self.json(409, {"error": f"this node serves {PORTS} boards: say which "
                                                f"(\"port\": 1..{PORTS}, or /api/ports/<n>{path[4:]})"})
            return self.port_post(body["port"], path[5:], body, port_reply=False)
        dut = node["dut"]
        if self.path == "/api/power":
            action = body.get("action")
            if action not in ("on", "off", "cycle"):
                return self.json(400, {"error": "action must be on, off or cycle"})
            if "when" in body:
                return self.json(400, {"error": "\"when\" is a DATA x4 port's"})
            if action == "cycle":
                time.sleep(1)
            was_on = dut["on"]
            dut["on"] = action != "off"
            if dut["on"]:
                dut["latched"] = False
            if dut["on"] and (action == "cycle" or not was_on):
                console.boot_banner()
        elif self.path == "/api/reset":
            time.sleep(0.1)
            if dut["on"]:
                console.boot_banner()
        elif self.path == "/api/boot":
            time.sleep(0.3)
            if dut["on"]:
                console.emit("\r\nESP-ROM:esp32c6-20220919\r\nBuild:Sep 19 2022\r\n"
                             "rst:0x1 (POWERON),boot:0x4 (DOWNLOAD(USB/UART0/SDIO_FEI_FEO))\r\n"
                             "waiting for download\r\n")
        elif self.path == "/api/mode":
            if body.get("mode") not in ("usbip", "classic"):
                return self.json(400, {"error": "mode must be usbip or classic"})
            node["force_classic"] = body["mode"] == "classic"
        elif self.path == "/api/aux":
            new = {**aux, **{k: v for k, v in body.items() if k in aux}}
            if not (300 <= int(new["baud"]) <= 5_000_000 and 5 <= int(new["data_bits"]) <= 8
                    and new["parity"] in ("none", "odd", "even") and new["stop_bits"] in (1, 2)
                    and new["enter"] in ("cr", "lf", "crlf")):
                return self.json(400, {"error": "baud 300..5000000, data bits 5..8, stop bits 1 or 2"})
            aux.update(new)
            console.broadcast_config()
            return self.json(200, aux_doc())
        elif self.path == "/api/aux/break":
            if not dut["on"]:
                return self.json(400, {"error": "the DUT is powered off"})
            console.emit("\r\n\x1b[2m(break)\x1b[0m\r\nuart:~$ ")
        else:
            return self.json(404, {"error": "not found"})
        self.json(200, status(self.peer()))

    def do_PUT(self) -> None:  # noqa: N802
        """PUT /api/ports/<n>/board: a slot's board target (the control right, the port's lease)."""
        raw = self.rfile.read(int(self.headers.get("Content-Length") or 0))
        path = urlsplit(self.path).path
        if firmware.down():
            return self.json(503, {"error": "restarting"})
        m = re.fullmatch(r"/api/ports/(\d+)/board", path)
        if not m:
            return self.json(404, {"error": "not found"})
        try:
            body = json.loads(raw or b"{}")
        except json.JSONDecodeError:
            return self.json(400, {"error": "bad JSON"})
        n = int(m[1])
        if not isinstance(body, dict):
            return self.json(400, {"error": "bad JSON"})
        if not 1 <= n <= slot_count():
            return self.json(404, {"error": f"no port {n} on this node (1..{slot_count()})"})
        if self.refused("control"):
            return
        ip = self.peer()
        if multi() and port_reserved(ports[n - 1], ip):
            lease = ports[n - 1]["lease"]
            note = f" ({lease['note']})" if lease["note"] else ""
            left = math.ceil((lease["until"] - time.monotonic()) / 60)
            return self.json(423, {"error": f"{slot_name(n)} reserved by {ip_str(lease['holder'])}{note}, "
                                            f"{left} min left", "reason": "reserved", "service": "control",
                                   "you": ip_str(ip)})
        if (err := set_board(n, body)) is not None:
            return self.json(400, {"error": err})
        self.json(200, board_doc(n))

    def port_post(self, n, what: str, body: dict, port_reply: bool) -> None:
        """POST /api/ports/<n>/<what>, or /api/<what> with "port": n: the port's object, or the status."""
        pt = next((x for x in ports if x["port"] == n), None) if multi() else None
        if pt is None:
            return self.json(404, {"error": f"no port {n} on this node" + (f" (1..{PORTS})" if multi() else "")})
        ip = self.peer()
        if port_reserved(pt, ip):
            lease = pt["lease"]
            note = f" ({lease['note']})" if lease["note"] else ""
            left = math.ceil((lease["until"] - time.monotonic()) / 60)
            return self.json(423, {"error": f"{slot_name(n)} reserved by {ip_str(lease['holder'])}{note}, "
                                            f"{left} min left", "reason": "reserved", "service": "control",
                                   "you": ip_str(ip)})
        if (err := port_act(pt, what, body)) is not None and err[1] is not None:
            return self.json(err[0], {"error": err[1]})
        self.json(err[0] if err else 200, port_doc(pt, ip) if port_reply else status(ip))

    def port_lease(self, ip: int, admin: bool, body: dict) -> bool:
        """A lease on sub-slots, {"ttl_s": 3600, "ports": ["B3.2"]}, or its release; True once answered with an error."""
        names = body["ports"]
        if not multi():
            self.json(400, {"error": "this node serves one board: lease the bay (no \"ports\")"})
            return True
        by_name = {slot_name(pt["port"]): pt for pt in ports}
        if not isinstance(names, list) or not names or any(str(x).upper() not in by_name for x in names):
            self.json(400, {"error": f"ports: a list of {', '.join(by_name)}"})
            return True
        chosen = [by_name[str(x).upper()] for x in names]
        with access.lock:
            if body.get("release"):
                if not admin and any(port_lease_active(pt) and pt["lease"]["holder"] != ip for pt in chosen):
                    self.json(403, {"error": "only its holder or an admin may release it"})
                    return True
                for pt in chosen:
                    pt["lease"] = None
                return False
            ttl = int(body.get("ttl_s", LEASE_DEFAULT_S))
            if not 10 <= ttl <= 86400:
                self.json(400, {"error": "ttl_s must be 10..86400"})
                return True
            taken = next((pt for pt in chosen if port_reserved(pt, ip)), None)
            if taken is not None:
                self.json(423, {"error": f"{slot_name(taken['port'])} reserved by "
                                         f"{ip_str(taken['lease']['holder'])}", "reason": "reserved"})
                return True
            for pt in chosen:
                pt["lease"] = {"holder": ip, "until": time.monotonic() + ttl,
                               "note": clean_note(str(body.get("note", "")))}
                if pt["client"] not in (None, ip):
                    pt["client"] = None   # its USB/IP import belongs to the holder now
        return False

    def access_post(self, path: str, raw: bytes, body: dict) -> None:
        ip = self.peer()
        auth = self.headers.get("X-Bay-Auth", "")
        admin = bool(auth) and access.admin(auth, "POST", path, raw)
        if auth and not admin:
            return self.json(403, {"error": "bad or expired admin signature"})
        if path in ("/api/access/rules", "/api/access/kick", "/api/access/key") and not admin:
            return self.json(403, {"error": "admin only: sign the request with the key"})

        if path == "/api/access/rules":
            if (err := access.set_rules(body)) is not None:
                return self.json(400, {"error": err})
        elif path == "/api/access/kick":
            if not access.kick(body.get("id", "")):
                return self.json(404, {"error": "no such connection"})
        elif path == "/api/access/key":
            try:
                access.key = bytes.fromhex(body.get("key", ""))
                assert len(access.key) == 32
            except (ValueError, AssertionError):
                return self.json(400, {"error": "key: 64 hex digits"})
            return self.json(200, {"saved": True})
        elif path == "/api/access/claim":
            return self.claim(ip, body)
        elif path == "/api/console/ticket":
            if self.refused("console"):
                return
            ticket = os.urandom(8).hex()
            with access.lock:
                access.tickets[ticket] = (ip, time.monotonic() + 10)
            return self.json(200, {"ticket": ticket})
        elif path == "/api/lease" and "ports" in body:
            if not body.get("release") and self.refused("control"):
                return
            if self.port_lease(ip, admin, body):
                return
        elif path == "/api/lease":
            if body.get("release"):
                with access.lock:
                    if access.lease_active() and not admin and access.lease["holder"] != ip:
                        return self.json(403, {"error": "only its holder or an admin may release it"})
                    access.lease = None
            else:
                if self.refused("control"):
                    return
                taken = next((pt for pt in ports if port_reserved(pt, ip)), None)
                if taken is not None:
                    return self.json(423, {"error": f"{slot_name(taken['port'])} reserved by "
                                                    f"{ip_str(taken['lease']['holder'])}", "reason": "reserved"})
                if (err := access.take(ip, int(body.get("ttl_s", LEASE_DEFAULT_S)), str(body.get("note", "")))):
                    return self.json(400, {"error": err})
        else:
            return self.json(404, {"error": "not found"})
        d = access.doc(ip, admin)
        if path == "/api/lease" and multi():
            d["ports"] = [short_port(port_doc(pt, ip)) for pt in ports]
        self.json(200, d)

    def claim(self, ip: int, body: dict) -> None:
        now = time.monotonic()
        with access.lock:
            c = access.claim
            if "ticket" in body:
                if c is None or c["ticket"] != body["ticket"] or c["ip"] != ip:
                    return self.json(404, {"error": "no such claim from this address"})
                if now >= c["until"]:
                    access.claim = None
                    return self.json(404, {"error": "nobody pressed BOOT in time"})
                if not c["done"]:
                    return self.json(200, {"state": "pending", "remaining_s": math.ceil(c["until"] - now)})
                access.claim = None
                return self.json(200, {"state": "done", "key": c["key"].hex()})
            if access.key is not None:
                return self.json(409, {"error": "already claimed: unlock with the admin key, or reset the node"})
            offered = None
            if "key" in body:
                try:
                    offered = bytes.fromhex(body["key"])
                    assert len(offered) == 32
                except (ValueError, AssertionError, TypeError):
                    return self.json(400, {"error": "key: 64 hex digits"})
            access.claim = {"ticket": os.urandom(8).hex(), "ip": ip, "until": now + CLAIM_S,
                            "key": offered, "done": False}
            print(f"claim requested by {ip_str(ip)}: GET /dev/boot to press BOOT", flush=True)
            return self.json(200, {"state": "pending", "ticket": access.claim["ticket"],
                                   "remaining_s": CLAIM_S})

    def log_message(self, fmt: str, *args) -> None:
        pass


def serve(port: int = 8766) -> ThreadingHTTPServer:
    if not console.log:
        console.boot_banner()
        threading.Thread(target=console.background, daemon=True).start()
    server = ThreadingHTTPServer(("127.0.0.1", port), Handler)
    server.daemon_threads = True
    # The camera on the next port, as the node has it on its own (8081)
    cam_server = ThreadingHTTPServer(("127.0.0.1", port + 1 if port else 0), CameraHandler)
    camera.port = cam_server.server_address[1]
    cam_server.daemon_threads = True
    threading.Thread(target=cam_server.serve_forever, daemon=True).start()
    return server


if __name__ == "__main__":
    import argparse
    ap = argparse.ArgumentParser(description="The bay node's web page and API, on a simulated node.")
    ap.add_argument("port", type=int, nargs="?", default=8766)
    ap.add_argument("--ports", type=int, default=1, choices=(1, 4, 6),
                    help="boards the node serves: 4 for a bay with a DATA ×4 board, 6 for a DATA ×6 "
                         "(docs/multi-dut-node.md)")
    a = ap.parse_args()
    set_ports(a.ports)
    if a.ports == 4:
        coproc.image = {"name": "gusmanb 6.0", "size": 40704, "addr": "0x20000000", "sha256": "61b75a29" * 8}
    print(f"bay node mock on http://localhost:{a.port} (camera on port {a.port + 1})"
          + (f", {a.ports} ports" if a.ports > 1 else ""))
    serve(a.port).serve_forever()
