kartben/hw-testing-rack/mechanical/boards/boards.yaml

# Dev-board library used to generate board plates and the 3D viewer stand-ins.
#
# Coordinates are given exactly as in the vendor's mechanical drawing:
# origin = bottom-left corner of the PCB outline, X along `size[0]`.
# `usb.edge` is the edge (top/bottom/left/right of that drawing) carrying the
# debug USB connector; `usb.pos` its centre along that edge (from left for
# top/bottom, from bottom for left/right).  tools/build.py rotates every board
# so that this connector faces the REAR of the drawer, where the drawer's
# DATA port is.
#
# `verified: false` means the outline or holes come from secondary sources:
# such boards get a "fence" plate (corner fences, no screws) until someone
# measures the real hole pattern — PRs welcome.
#
# standoff     = plate-to-PCB distance (Nucleo morpho pins stick out underneath!)
# height       = tallest component above the PCB (viewer only)
# on_edge      = a dense bay's board on edge in its lane (config/rack.yaml › drawer.slot_bin): how far it reaches
#                under its PCB's bottom face and over it (PCB, parts, a plug in its USB), mm; standoff and
#                pcb_t + height when not given (they are the plate's, with a margin)
# fence        = true → hole-less corner-fence mounting
# orient: side = turn the debug USB towards the drawer's right wall; the board then sits to the
#                left of its plate.  For a board too long for a plug behind it, and for a small
#                one: its cable is then straight at both ends and lies flat (docs/cabling.md)
# pegs         = the honeycomb plate's pegs (tools/plate_layout.py): `keepout`, [edge, from, to] in the drawing
#                frame (edge and positions as usb counts them), spans of the outline no peg may touch: a header
#                or a connector at the edge, pins under it.  The debug USB's plug is kept out by itself.
# zephyr       = CI defaults for tools/bayctl.py (twister hardware map): `platform` is the target
#                as twister names it (the board YAML's `identifier`), `runner` the west runner,
#                `console` usb (the debugger's VCOM, default) or aux (the bay's AUX UART).
#                Board families list `choices`: the node's page (or config/lab.yaml) picks one per slot.
#                `usb`: the VID:PID the debug USB shows (vvvv:pppp, or vvvv:* for any of a vendor's): the
#                node's page suggests these targets for a device with that id (firmware/bay-node/web/
#                board_targets.py builds its table).  `targets`: per target, a `runner` and `usb` of its own.
# headers      = 2.54 mm pin headers soldered pins up, where Dupont jumpers plug on (viewer: the pins, and the
#                jumpers' ends): rows of `n` pins from pin `at` [x, y] (drawing frame) by `step` [dx, dy], their
#                `names` in order (a name may repeat, GND: a jumper takes the one nearest its other end)

boards:
  arduino-uno-r4:
    name: Arduino UNO R4 Minima / WiFi (UNO R3 footprint)
    short: UNO R4
    size: [68.58, 53.34]
    holes: [[13.97, 2.54], [15.24, 50.80], [66.04, 7.62], [66.04, 35.56]]
    hole_d: 3.2
    usb: { edge: left, pos: 41.0, type: usb-c }
    orient: side            # small: a straight cable, flat, from the right DATA socket
    pegs: { keepout: [[left, 2, 16], [top, 17, 66], [bottom, 26, 66], [right, 30, 48]] }   # jack; headers; ICSP, Qwiic
    standoff: 6
    height: 11
    on_edge: [1.8, 12.7]    # the THT pins 1.8 under, the jack 11 over the PCB (Arduino's model, 14.5)
    color: "#00878f"
    model: { web: true, recolour: { "#010a20": "#00828a" },
             credit: "UNO R4 WiFi model © Arduino S.r.l., CC BY-SA 4.0 (recoloured)" }
                            # Arduino's UNO R4 WiFi STEP (tools/fetch_render_assets.py), CC BY-SA 4.0: the viewer's copy
                            # is published; its navy PCB → Arduino's teal (the Minima: the same outline, no matrix, no module)
    source: "Arduino ABX00080 datasheet, mechanical drawing"
    verified: true
    zephyr: { choices: ["arduino_uno_r4@minima", "arduino_uno_r4@wifi"], runner: pyocd,
              targets: { "arduino_uno_r4@minima": { usb: ["2341:0069"] }, "arduino_uno_r4@wifi": { usb: ["2341:1002"] } },
              note: "the UNO R4 WiFi's ESP32-S3 is its CMSIS-DAP probe and USB console; the Minima has neither: SWD probe, console on AUX" }

  giga-r1-display:
    name: Arduino GIGA R1 WiFi + GIGA Display Shield
    short: GIGA + display
    # The shield's Samtec strips plug into the GIGA's two HLE sockets: the shield sits 7.5 mm over the
    # GIGA's top face, its 3.97" display (480 × 800) facing up, away from the GIGA.  Drawing frame: the
    # shield's outline (it covers the GIGA), the GIGA's underside at z = 0, its USB-C edge on the left.
    size: [106.0, 80.0]
    holes: []
    fence: true             # the GIGA's Mega holes are under the shield: corner fences until the plate holds the stack
    usb: { edge: left, pos: 50.2, type: usb-c }   # J12 (CX90B-16P), 0.9 mm proud of the GIGA's edge
    standoff: 5             # the GIGA's underside: the USB-A shell's tabs reach 1.9 mm below it
    height: 14.5            # top of the display above the GIGA's PCB
    color: "#00878f"
    screen: { at: [9.8, 15.58], size: [86.4, 51.84], px: [480, 800], top: -x, z: 16.21, demo: music }   # portrait, top at the USB edge
    model:                  # tools/board_models.py stacks Arduino's two STEP files (tools/fetch_render_assets.py)
      stack:
        - { src: giga-r1-wifi }
        - { src: giga-display-shield, rot_x: 180, at: [-0.16, 69.28, 7.53] }   # strips into sockets, measured on the models
      offset: [0.16, 10.72, 1.68]
      recolour: { "#003700": "#00828a" }   # the STEP's generic green PCBs → Arduino's teal
      web: true             # CC BY-SA 4.0: the viewer's copy is published, with credit (docs/boards-3d.md)
      credit: "© Arduino S.r.l., CC BY-SA 4.0 (stacked, recoloured)"
    source: "Arduino STEP files ABX00063 + ASX00039 (CC BY-SA 4.0); datasheets ABX00063, ASX00039"
    verified: true
    zephyr: { platform: arduino_giga_r1/stm32h747xx/m7, runner: dfu-util, usb: ["2341:0266", "2341:0366"],
              note: "build with --shield arduino_giga_display_shield (LVGL samples run on it); dfu-util needs the bootloader: double-tap RESET (AUX RESET)" }

  nucleo-64:
    name: ST NUCLEO-64 (MB1136 / MB1367)
    short: NUCLEO-64
    size: [70.0, 82.5]
    holes: [[10.87, 54.61], [59.13, 53.34], [43.89, 2.54]]
    hole_d: 3.2
    usb: { edge: top, pos: 35.0, type: micro-b }    # MB1367's ST-LINK V3E (Molex 105017, as its STEP); MB1136: mini-B at 47
    pegs: { keepout: [[left, 4, 60], [right, 4, 60]] }        # the morpho headers' pins under the long edges
    standoff: 12
    height: 12
    on_edge: [8.9, 10.1]    # 19 overall, measured (the user, 2026-10-31): the morpho pins 8.9 under
    color: "#f2f2f2"
    model: { flip: true, web: true, recolour: { "#003700": "#f4f4f2" },
             credit: "NUCLEO-G474RE (MB1367) model © STMicroelectronics, Open Platform License Agreement" }
                            # ST's STEP (tools/fetch_render_assets.py), published: ST's Open Platform License Agreement
                            # lets it be distributed for testing boards based on ST products, which this rack does (the
                            # user's call, 2026-10-21); flip: its morpho pins reach further below than its parts above;
                            # its generic green PCB → the NUCLEO's white
    source: "ST UM1724 fig. 5 (holes drawing-derived, ±0.1 mm)"
    verified: true
    zephyr: { choices: [nucleo_c031c6, nucleo_f401re, nucleo_f446re, nucleo_g071rb, nucleo_g474re, nucleo_l476rg],
              runner: stm32cubeprogrammer, usb: ["0483:374b", "0483:374e", "0483:374f"] }   # ST-LINK/V2-1, V3E

  nucleo-144:
    name: ST NUCLEO-144 (MB1137 / MB1364 / MB1404)
    short: NUCLEO-144
    size: [70.0, 133.34]
    holes: [[10.87, 105.41], [59.13, 104.14], [43.89, 53.34], [12.14, 29.21], [57.86, 29.21]]
    hole_d: 3.2
    usb: { edge: top, pos: 49.0, type: micro-b }    # MB1404 (H5) uses USB-C
    pegs: { keepout: [[left, 15, 112], [right, 15, 112]] }    # the morpho headers' pins under the long edges
    standoff: 12
    height: 14
    color: "#f2f2f2"
    model: { web: true, credit: "NUCLEO-U575ZI-Q (MB1549) model © STMicroelectronics, Open Platform License Agreement" }
                            # ST's STEP (tools/fetch_render_assets.py), published as the NUCLEO-64's; its ST-LINK V3E
                            # micro-B where the drawing has it
    source: "ST UM1974 fig. 6 (holes drawing-derived)"
    verified: true
    zephyr: { choices: [nucleo_f429zi, nucleo_f767zi, nucleo_h563zi, nucleo_h743zi, nucleo_u575zi_q],
              runner: stm32cubeprogrammer, usb: ["0483:374b", "0483:374e", "0483:374f", "0483:3753", "0483:3754"] }

  rpi-pico2:
    name: Raspberry Pi Pico / Pico 2 (W)
    short: PICO 2
    size: [21.0, 51.0]
    headers:                # pins 1–20 down the left (USB at the top), 21–40 up the right, the SWD three at the bottom
      - { at: [1.61, 49.63], step: [0, -2.54], n: 20,
          names: [GP0, GP1, GND, GP2, GP3, GP4, GP5, GND, GP6, GP7, GP8, GP9, GND, GP10, GP11, GP12, GP13, GND, GP14, GP15] }
      - { at: [19.39, 1.37], step: [0, 2.54], n: 20,
          names: [GP16, GP17, GND, GP18, GP19, GP20, GP21, GND, GP22, RUN, GP26, GP27, GND, GP28, ADC_VREF, 3V3,
                  3V3_EN, GND, VSYS, VBUS] }
      - { at: [7.96, 1.6], step: [2.54, 0], n: 3, names: [SWCLK, GND, SWDIO] }
    holes: [[4.8, 2.0], [16.2, 2.0], [4.8, 49.0], [16.2, 49.0]]
    hole_d: 2.1
    usb: { edge: top, pos: 10.5, type: micro-b }
    orient: side            # small: a straight cable, flat, from the right DATA socket
    pegs: { keepout: [[left, 0, 51], [right, 0, 51]] }        # headers along both long edges: a pin through a hole
    standoff: 9
    height: 4
    color: "#1e7b34"
    source: "Raspberry Pi Pico 2 datasheet"
    model: { web: true, credit: "Pico 2 model © Raspberry Pi Ltd, MIT" }
                            # Raspberry Pi's STEP (tools/fetch_render_assets.py), MIT: the viewer's copy is published
    pcb_t: 1.0
    verified: true
    zephyr: { platform: rpi_pico2/rp2350a/m33_0, runner: uf2, console: aux,
              usb: ["2e8a:000f", "2e8a:0003"],     # in BOOTSEL: RP2350, RP2040
              note: "no on-board probe: uf2 needs BOOTSEL (AUX BOOT to TP6, AUX RESET to RUN) and an automounted RP2350 drive; or add a Raspberry Pi Debug Probe (runner openocd)" }

  esp32-s3-devkitc:
    name: Espressif ESP32-S3-DevKitC-1 v1.1
    short: ESP32-S3
    size: [25.4, 62.74]
    holes: []
    fence: true
    usb: { edge: bottom, pos: 12.7, type: micro-b }  # two micro-B (UART + USB-OTG)
    orient: side            # small: a straight cable, flat, from the right DATA socket
    pegs: { keepout: [[left, 0, 62.74], [right, 0, 62.74], [bottom, 0, 25.4]] }   # headers; both USB ports
    standoff: 10            # header pins underneath
    height: 8
    on_edge: [8.5, 6.5]     # the pins 8.5 under, a USB-C overmold 4.85 over the parts: 15 overall
    color: "#151515"
    source: "Espressif DXF ESP32-S3-DevKitC-1 v1.1"
    verified: true
    zephyr: { platform: esp32s3_devkitc/esp32s3/procpu, runner: esp32, usb: ["303a:1001", "10c4:ea60"] }

  esp32-c6-devkitc:
    name: Espressif ESP32-C6-DevKitC-1 v1.2
    short: ESP32-C6
    size: [25.4, 51.8]
    headers:                # J1 down the left, J3 down the right, from the module's end (the USB-Cs at the bottom)
      - { at: [1.27, 45.8], step: [0, -2.54], n: 16, names: [3V3, RST, IO4, IO5, IO6, IO7, IO0, IO1, IO8, IO10, IO11,
                                                              IO2, IO3, 5V, GND, NC] }
      - { at: [24.13, 45.8], step: [0, -2.54], n: 16, names: [GND, TX, RX, IO15, IO23, IO22, IO21, IO20, IO19, IO18,
                                                               IO9, GND, IO13, IO12, GND, NC] }
    holes: []
    fence: true
    usb: { edge: bottom, pos: 12.7, type: usb-c }    # two USB-C
    orient: side            # small: a straight cable, flat, from the right DATA socket
    pegs: { keepout: [[left, 0, 51.8], [right, 0, 51.8], [bottom, 0, 25.4]] }     # headers; both USB ports
    standoff: 10
    height: 8
    on_edge: [8.5, 6.5]     # the S3's form factor
    color: "#151515"
    source: "Espressif dimension drawing v1.2"
    verified: true
    zephyr: { platform: esp32c6_devkitc/esp32c6/hpcore, runner: esp32, usb: ["303a:1001"] }

  xiao:
    name: Seeed Studio XIAO (any)
    short: XIAO
    size: [17.78, 20.96]    # its USB-C on a short edge, seven pins down each long one (Seeed's XIAO ESP32C3 v1.3 KiCad)
    holes: []
    fence: true
    usb: { edge: top, pos: 8.89, type: usb-c }
    headers:                # top view, USB at the top: D0–D6 down the left, 5V GND 3V3 D10–D7 down the right
      - { at: [1.27, 18.03], step: [0, -2.54], n: 7, names: [D0, D1, D2, D3, D4, D5, D6] }
      - { at: [16.51, 18.03], step: [0, -2.54], n: 7, names: [5V, GND, 3V3, D10, D9, D8, D7] }
    standoff: 6
    height: 4
    color: "#202a44"
    source: "Seeed wiki"
    model: { web: true, offset: [0, 0.76], credit: "XIAO ESP32S3 model © Seeed Studio, CC BY-SA 4.0" }
                            # Seeed's STEP (tools/fetch_render_assets.py), CC BY-SA 4.0:
                            # the viewer's copy is published (its USB-C overhang had shifted the outline)
    pcb_t: 1.25             # its PCB's thickness (viewer: the headers sit on it)
    verified: true
    zephyr: { choices: [xiao_ble, xiao_esp32c3, xiao_esp32c6/esp32c6/hpcore, xiao_esp32s3/esp32s3/procpu, xiao_rp2040],
              targets: { xiao_ble: { runner: uf2, usb: ["2886:8045", "2886:0045"] },
                         xiao_esp32c3: { runner: esp32, usb: ["303a:1001"] },
                         xiao_esp32c6/esp32c6/hpcore: { runner: esp32, usb: ["303a:1001"] },
                         xiao_esp32s3/esp32s3/procpu: { runner: esp32, usb: ["303a:1001"] },
                         xiao_rp2040: { runner: uf2, usb: ["2e8a:0003"] } },
              note: "pick the runner with the platform (esp32, uf2, ...)" }

  arduino-nano-matter:
    name: Arduino Nano Matter (Silicon Labs MGM240S)
    short: NANO MATTER
    size: [17.78, 43.18]    # the Nano outline, its USB-C on a short edge (Arduino's STEP)
    holes: []
    fence: true
    usb: { edge: top, pos: 8.89, type: usb-c }
    standoff: 6             # no headers: its castellated pads on the long edges take the pegs' plastic lips, as a XIAO's
    height: 4
    color: "#00878f"
    model: { rot: 180, web: true, recolour: { "#010a20": "#00828a" },
             credit: "Nano Matter model © Arduino S.r.l., CC BY-SA 4.0 (recoloured)" }
                            # Arduino's STEP (tools/fetch_render_assets.py), CC BY-SA 4.0: the viewer's copy is
                            # published; its navy PCB → Arduino's teal
    pcb_t: 1.6
    source: "Arduino ABX00112 datasheet and STEP"
    verified: true
    zephyr: { platform: arduino_nano_matter, runner: openocd,
              note: "its SAMD11 is a CMSIS-DAP probe on the USB-C; openocd needs Arduino's fork for the MG24's flash (or runner jlink)" }

  beagleplay:
    name: BeagleBoard.org BeaglePlay (TI AM6254 + CC1352P7)
    short: BEAGLEPLAY
    size: [80.0, 80.0]
    holes: []
    fence: true
    usb: { edge: bottom, pos: 6.6, type: usb-c }     # its USB-C (power and gadget), at the end of the I/O edge (USB-A, HDMI, RJ45s)
    standoff: 6
    height: 14              # the RJ45 jacks
    color: "#141414"
    model: { web: true, paint: beagleplay-design.PcbDoc, mask: "#161616", silk: "#f0f0ea", finish: ENIG, tent_vias: true,
             recolour: { "#666666": "#b9bcc1", "#97a3da": "#c3c6cb", "#bee2ff": "#c3c6cb", "#67728d": "#c3c6cb",
                         "#5d2209": "#1d1d1d", "#e28807": "#c9a24c", "#ce2a01": "#b39470", "#ce4906": "#b39470",
                         "#00005a": "#ecebe4" },
             recolour_in: [["#666666", [0, 70, 50, 82], "#e8e5d8"]],   # the OLDI and CSI FPC connectors: cream
             credit: "BeaglePlay model © Seeed Technology Co., Ltd and BeagleBoard.org Foundation, CC BY 4.0 (recoloured)" }
                            # the makers' STEP (tools/fetch_render_assets.py), CC BY 4.0: the viewer's copy is published.
                            # Its PCB (a grey slab) painted from their PCB design: black mask, ENIG pads, white silkscreen;
                            # its design colours → nickel shells (the RJ45s, USB-A, HDMI, USB-C), tan capacitors, the RTC
                            # cell holder's black base and brass clip, cream Grove, QWIIC and FPC connectors (the makers'
                            # photo, docs.beagleboard.org › BeaglePlay › components-front)
    source: "BeaglePlay rev A2 STEP (git.beagleboard.org/beagleplay/beagleplay, Design/)"
    verified: true
    zephyr: { choices: ["beagleplay/cc1352p7", "beagleplay/am6254/m4"],
              note: "flashed from its own Linux (the CC1352: cc1352_flasher --play; the M4: remoteproc), over SSH on its USB gadget link: no host-side probe" }

  wio-terminal:
    name: Seeed Wio Terminal (Microchip ATSAMD51P19 + Realtek RTL8720DN)
    short: WIO TERMINAL
    # a whole device: its case lies on its back on the plate, the pegs' lips over its top edge (standoff + the
    # 1.6 mm a board's edge would be = the case's 12.6 mm with its feet), its 2.4" LCD up, its USB-C on its bottom edge
    size: [72.0, 57.0]
    holes: []
    fence: true
    usb: { edge: bottom, pos: 36.0, type: usb-c, z: 6.3 }   # z: its centre above the plate (Seeed's model)
    standoff: 11.0
    height: 0.5
    on_edge: [11.0, 4.4]    # its case, as Seeed's model (15.4 overall)
    color: "#f2f2f0"
    screen: { at: [11.52, 14.39], size: [48.96, 36.72], px: [320, 240], top: "-y", z: 1.6, demo: widgets }
                            # the ILI9341's active area behind the front's clear window; the image turned so it reads from the
                            # rack's front (its top towards the USB, the port wall: the firmware's display rotated 180°)
    model: { flip: true, rot: 180, web: true, offset: [0, 0, -3.6],
             recolour: { "#50676d": "#f2f2f0", "#ff5100": "#0b0c0e", "#000fff": "#2348d8" },
             credit: "Wio Terminal model © Seeed Studio, Apache License 2.0 (recoloured)" }
                            # Seeed's STEP of the whole device (tools/fetch_render_assets.py), Apache 2.0: published; its
                            # design colours → white case, black glass, blue joystick
    source: "Seeed OSHW-WioTerminal (Wio Terminal 3D.stp)"
    verified: true
    zephyr: { platform: wio_terminal, runner: bossac, usb: ["2886:802d", "2886:002d"],
              note: "its UF2 bootloader on the USB-C: a double reset enters it (the bay's AUX RESET); no on-board probe" }

  microbit-v2:
    name: BBC micro:bit v2
    short: MICRO:BIT
    size: [51.6, 42.0]
    holes: []
    fence: true
    usb: { edge: top, pos: 25.8, type: micro-b }
    pegs: { keepout: [[bottom, 0, 51.6]] }                    # the edge connector
    standoff: 6
    height: 6
    color: "#111111"
    source: "Mouser listing (outline only)"
    verified: true
    zephyr: { platform: bbc_microbit_v2, runner: pyocd, usb: ["0d28:0204"] }   # DAPLink

  frdm-mcxn947:
    name: NXP FRDM-MCXN947
    short: FRDM-MCXN947
    size: [118.0, 55.0]
    holes: []
    fence: true
    usb: { edge: left, pos: 40.0, type: usb-c }      # MCU-Link J17 + J11 + RJ45 on one short edge
    standoff: 10
    height: 14
    color: "#1b1b1b"
    source: "NXP UM12018 (outline only; holes not published)"
    verified: false
    zephyr: { platform: frdm_mcxn947/mcxn947/cpu0, runner: linkserver, usb: ["1fc9:0143"] }   # MCU-Link

  nrf54l15-dk:
    name: Nordic nRF54L15 DK
    short: nRF54L15 DK
    size: [63.55, 117.05]   # Nordic's PCB (hardware files PCA10156 1.0.0)
    holes: []
    fence: true
    usb: { edge: top, pos: 24.0, type: usb-c }      # J3, the debugger's
    standoff: 10
    height: 12
    color: "#2c4763"
    model: { rot: 180, mask: "#2c4763", vars: { PCBNUMBER: "PCA10156", PCBREVISION: "1.0.0" },
             credit: "nRF54L15 DK model from Nordic Semiconductor's hardware files (PCA10156 1.0.0)" }
                            # Nordic's Altium PCB through KiCad (tools/vendor_pcb.py), the renders only (no licence
                            # stated); painted in its slate blue
    source: "Nordic hardware files PCA10156 1.0.0 (outline, USB; its holes not taken over yet)"
    verified: false
    zephyr: { platform: nrf54l15dk/nrf54l15/cpuapp, runner: nrfutil, usb: ["1366:*"] }   # J-Link OB

  nrf52840-dk:
    name: Nordic nRF52840 DK
    short: nRF52840 DK
    size: [63.55, 136.58]   # Nordic's PCB (hardware files PCA10056 3.0.3)
    holes: []
    fence: true
    usb: { edge: top, pos: 31.8, type: micro-b }    # J2, the interface MCU's (IMCU USB), mid short edge
    standoff: 10
    height: 12
    color: "#174a78"
    model: { rot: 180, mask: "#174a78", vars: { PRODUCTNAME: "nRF52840 DK", PCBNUMBER: "PCA10056", PCBREVISION: "3.0.3" },
             credit: "nRF52840 DK model from Nordic Semiconductor's hardware files (PCA10056 3.0.3), Nordic 5-clause licence" }
                            # Nordic's Altium PCB through KiCad (tools/vendor_pcb.py), painted in Nordic blue
    source: "Nordic hardware files PCA10056 3.0.3 (outline, USB; its holes not taken over yet)"
    verified: false
    zephyr: { platform: nrf52840dk/nrf52840, runner: nrfutil, usb: ["1366:*"] }   # J-Link OB

  nrf5340-dk:
    name: Nordic nRF5340 DK
    short: nRF5340 DK
    size: [64.0, 136.0]
    holes: []
    fence: true
    usb: { edge: top, pos: 20.0, type: micro-b }
    standoff: 10
    height: 12
    color: "#1d3557"
    source: "approximate — measure your board"
    verified: false
    zephyr: { platform: nrf5340dk/nrf5340/cpuapp, runner: nrfutil, usb: ["1366:*"] }   # J-Link OB

  frdm-k64f:
    name: NXP FRDM-K64F
    short: FRDM-K64F
    size: [81.0, 53.0]
    holes: []
    fence: true
    usb: { edge: left, pos: 35.0, type: micro-b }
    standoff: 10
    height: 10
    color: "#f0f0f0"
    source: "community measurement (outline only)"
    verified: false
    zephyr: { platform: frdm_k64f, runner: pyocd, usb: ["0d28:0204"] }   # OpenSDA, DAPLink firmware

  stm32f746g-disco:
    name: ST STM32F746G-DISCO
    short: F746G-DISCO
    size: [86.0, 154.0]
    holes: []
    fence: true
    # ST-LINK USB (CN14, mini-B) on a long edge (position to confirm on a real board), turned
    # towards the drawer's side wall: at 154 mm the board leaves no room for a plug behind it
    usb: { edge: right, pos: 40.0, type: mini-b }
    orient: side
    standoff: 10
    height: 10
    color: "#0b2c4a"
    source: "approximate — measure your board"
    verified: false
    zephyr: { platform: stm32f746g_disco, runner: stm32cubeprogrammer, usb: ["0483:374b"] }

  mimxrt1060-evkb:
    name: NXP MIMXRT1060-EVKB
    short: RT1060-EVKB
    size: [130.0, 108.0]
    holes: []
    fence: true
    usb: { edge: top, pos: 30.0, type: micro-b }
    second_usb: { edge: top, pos: 100.0, type: usb-c }
    standoff: 10
    height: 16
    color: "#141414"
    source: "approximate — measure your board"
    verified: false
    zephyr: { platform: "mimxrt1060_evk@B/mimxrt1062/qspi", runner: linkserver, usb: ["1fc9:0143"] }

  mimxrt1170-evkb:
    name: NXP MIMXRT1170-EVKB
    short: RT1170-EVKB
    size: [165.0, 127.0]
    holes: []
    fence: true
    usb: { edge: top, pos: 30.0, type: micro-b }
    second_usb: { edge: top, pos: 140.0, type: usb-c }   # second node's DATA port (power / OTG)
    standoff: 12
    height: 16
    color: "#141414"
    span: 2
    source: "approximate — measure your board"
    verified: false
    zephyr: { platform: "mimxrt1170_evk@B/mimxrt1176/cm7", runner: linkserver, usb: ["1fc9:0143"] }
