kartben/hw-testing-rack/config/rack.yaml

# hw-testing-rack — single source of truth for the shelf geometry.
#
# Everything is in millimetres.  Frame coordinates: X = left→right (width),
# Y = front→back (depth), Z = up, origin = front-left-bottom corner of the
# leftmost base ladder.  The structure is the PANEL FRAME: printed ladders
# (side walls shared by neighbouring bays) stacked row on row, trays sliding
# into their grooves, an X brace behind every bay and row (see docs/mechanical.md).
# Shelves are tilted ("stadium"): each row is a module in its own ROW
# coordinates (X same, Y along the slope towards the back, Z perpendicular to
# the shelf), rotated by `frame.tilt` about X so the front edge is lower.
# "Carrier coordinates" = row coordinates shifted to the front-left corner of
# one bay's tray.
#
# `tools/build.py` turns this file into:
#   mechanical/generated/config.scad   (OpenSCAD constants)
#   site/assets/rack.json              (3D viewer scene: instances + cables)
# and the electronics generators read the `pcb:` section so that the board
# outlines, mounting holes and connector positions always match the prints.

frame:
  tilt: 20               # shelf tilt in degrees (front edge lower) — 0 gives flat shelves
  row_origin_y: 25       # frame Y of every row's front-bottom edge
  base_height: 80        # base ladders: floor → row A's origin (floor plates in between)
  panel_thickness: 7.4   # ladder thickness (X); one ladder between neighbouring bays
  panel_clearance: 0.2   # tray wall ↔ ladder face, per side

bay:
  width: 158             # tray outer width (X); the column pitch adds a ladder and two clearances (165.8)
  depth: 210             # tray depth along the slope
  carrier:
    bottom: 2.5          # bottom plate (= ceiling of the bay below)
    wall: 2.0
    standoff: 5.0        # bay-node PCB standoff height above the bottom plate
    pcb_to_floor: 14.0   # PCB top surface → bay floor surface (deck top)
    deck: 3.0            # removable deck plate thickness
    fascia: 2.5          # front wall thickness
  camera_mount: [109, 45, 30]   # camera pod's insert square under the ceiling: centre X, Y and pitch, carrier
                                # coords; right of the node above, clear of its chain, on the cap plate's grid
  camera_lens: [64, 27.6]       # the pod's lens axis, straight down, carrier coords of the ceiling: bay (64, 84)
                                # below (rows are staggered by height·sin(tilt) = 56.4 mm)

drawer:
  depth: 208             # outer, front panel included (196 until 2026-10-20: 12 mm more at the back, for a deeper DATA ×4 v2; 208 is the most without touching the tray)
  travel: 140            # pull-out stroke (the drag chain keeps the DUT connected)
  guide_width: 7.5       # each side rail on the deck (C-channel capturing the drawer flange)
  clearance: 0.5         # per side, drawer ↔ guide
  bottom: 2.5
  wall: 2.0
  wall_height: 16        # side/rear walls above the drawer bottom
  front_height: 41       # front panel height above the deck (30 until 2026-10-26): the display's window, 1 mm over
                         # the plate, and a 3.5 mm strip over it.  The front is its own part, printed face down
                         # (parts/drawer.scad › front), screwed to the drawer's side walls from inside
  front_thickness: 4
  plate_gap: [0.3, 3.2]  # between the board plate and the left, right walls (0.3 each until 2026-10-26): the
                         # display's lead runs at floor level in the right one
  display:               # the node v1.0's front display (the user, 2026-10-26): Waveshare 1.9inch Touch LCD (31122),
                         # turned over (its SH 12 header down, its lead at floor level to the rear bay)
    glass: [52.36, 28.80]  # cover glass W × H (Waveshare's drawing); its PCB 51.0 × 26.6 centred behind it
    pcb: [51.0, 26.6]
    active: [2.8, 3.05]  # its LCD's 42.72 × 22.70 active area: left and bottom edges from the glass's, seen from
                         # the front (Waveshare's photo, the user 2026-10-27: the wide black border on the right)
    x: 82.0              # drawer x of the glass's left edge: its frame's right leg, between the window and the right
                         # wall, takes the front's right screw (parts/drawer.scad › JOINTS)
    z: 8.5               # its bottom edge above the deck: 1 mm over the plate, whatever the module's thickness
    # it goes in from the front, through a plain window, its stand-offs seated on the frame behind the front and
    # screwed from behind (the user's idea, 2026-10-27): no glue, and a press on the glass goes straight into the frame
    recess: 0.3          # the glass's face behind the front's
    seat: 8.6            # the glass's face to its stand-offs' ends, assumed (glass + LCD 4.0, PCB 1.6, stand-offs 3.0):
                         # measure on arrival.  If it is off, the glass only stands out or sinks in by as much
    holes: 3.5           # its four holes, from the PCB's edges (Waveshare's drawing)
    screw: 2.0           # M2 into its stand-offs (the holes' Ø isn't given: measure)
    sh: [12.3, 25.8]     # its SH 12 header along the bottom edge, from the glass's right end (Waveshare's photo):
                         # the plate's front-right notch starts left of it
  rear_bay: 42           # enclosed strip at the back: the DATA board(s) + cable entry; 40 mm inside, y 166–206
                         # one drawer for both DATA boards (2026-10-19): the port wall has the DATA ×4's four U's
                         # (pcb.data_port_x4.usb); a single DATA board's USB-C sits on the fourth, and the
                         # optional AUX pigtail goes through a free one
  flange: [3.0, 3.0]     # runner flange (width, height) captured by the guides
  detent: printed        # the closed drawer's detent: printed, a spring tab in the tray's left ledge and a notch under
                         # the drawer (no parts, ≈ 3 N); magnet, the two magnets below (≈ 10 N, glued).  The user,
                         # 2026-10-21: printed, after a test print, back to magnets if it doesn't suit
  magnet: [6, 3]         # the detent magnets (detent: magnet): Ø × t, one in the drawer, one in the tray's ledge
  plate: 5.0             # board plate thickness: the pegs' clip sits inside it (plate_grid)
  port_mouth: 1.0        # the standing DATA boards' USB-C mouths behind the port wall's back face: a straight plug's
                         # overmold (its top 1.2 over the wall's) goes in until the plug seats.  A board's front face
                         # stands port_mouth + its usb_h behind the wall (rackcfg: pcb.<board>.face_y)
  port_recess: { width: 7.8, length: 22, depth: 3.5 }   # under each DATA port's slot, in the plate's rear
                         # edge (only: a plate turned round carries its boards the wrong way): a standing USB-IF overmold
                         # (12.35 tall on the ports' axis) comes down to 4.8 over the drawer floor, 2.7 into
                         # the plate, for 20 mm in front of the receptacle's mouth.  The slot's width, `length`
                         # from the mouth to the edge, `depth` from the top (a 1.5 mm floor): 0.65 by its
                         # sides, 0.8 under it.  No peg hole near one (rackcfg.plate_holes)
  slot_bin:              # a dense bay's bin, the "porte-revues" (population › plate: slots; parts/slot_bin.scad): one
                         # printed part in the plate's place, its boards on edge in six equal lanes, lane k (from
                         # the left) to the DATA ×6's port k, USB to the port wall; behind the lanes, a cable zone
                         # where each short straight cable reaches its port.  The rack's tilt slides each board
                         # forwards to the front stop.  Any board up to 19.8 mm thick overall, 86.5 long, 82 tall
    floor: 2.4           # over the drawer floor: the plate's pins (2.2) go into it
    recess: 1.4          # under the ports' plugs, the plate's recesses (port_recess) this deep: 1.3 under an overmold
    wall: 1.2            # its end walls and five dividers: six lanes of 21.0
    front: [17.0, 12.0]  # its front stop: drawer y of its front face, height over the floor (behind the display's
                         # PCB and the front's screws)
    dividers: [105.0, 40.0]  # their rear end (drawer y) and height over the floor: past the longest board (a
                         # NUCLEO-64 to y 101), the outer lanes' cables fanning in to their ports behind them

plate_grid:              # the board plate: one honeycomb for every board, and clip-in pegs that hold them
                         # (mechanical/lib/hexgrid.scad, parts/pegs.scad; tools/plate_layout.py places them)
  pitch: 10.0            # hex centre to centre; rows along X, one every pitch·√3/2 (8.66)
  hole: 7.2              # a hole's waist across flats
  undercut: 0.4          # wider by this per side over the bottom 1.4 mm; the pegs' nubs catch its 45° ledge
  margin: 1.8            # least plastic between a hole (its undercut) and the plate's edge, a pin or a slot
  clear: 0.1             # a peg's plug in its hole, per side
  stop: { offset: 3.55, angle: 15, neck: 4.6, ledge: 7.0, lip: 7.6 }   # eccentric lip stop: its post's offset
                         # from the plug's axis, at `angle` from a flat: 6 turns, 6 positions; neck, ledge, lip Ø
  cam: { r0: 3.0, r1: 6.75, arc: 270, under: 20 }   # the cam's spiral band (radius r0 → r1 over arc°), its
                         # 20° undercut presses the PCB's top edge down; the stops place, the cams clamp

chain:                   # drag chain lying flat in the plenum (bends in the XY plane)
                         # reference: Olimex DRAG-CHAIN-7X7, links open on both sides.  Olimex gives
                         # only the inner size; outer size and end holes are Electrokit's figures for
                         # the same generic chain (art. 41017996).  Measure yours on arrival.
  inner: [7, 7]          # 7×7 mm, the common 3D-printer size
  outer: [13.5, 10.2]    # across the side plates (= vertical here) × in the bend plane (= X here)
  radius: 18             # bend radius to the chain centre line: not published, measure it
  pitch: 16              # link pitch of the printable link (parts/chain_parts.scad) and the viewer
  end_holes: [8, 4]      # end pieces: 2 holes 8 mm apart on a tab flush with the outer face of the U,
                         # the first one 4 mm from the mouth (M2.5 self-tapping + washer)
  end_length: 26         # rigid end piece, mouth → its pivot on the chain: it must stay in a straight
                         # run over the whole stroke (checked in lib/carrier.scad).  Measure it.
  fixed: [100, 87]       # fixed end (the end piece's mouth), carrier XY
  moving_x: 136          # X of the moving run (the drawer foot)
  moving_y: 157          # moving end's mouth, measured from the drawer front face
  foot_y: 172            # the foot's lock screw (in the drawer's rear bay), from the drawer front face
  bend_y: 183            # centre of the U bend (closed drawer)

rows:                     # bottom → top; each row is an independent module
  - id: A
    height: 165           # vertical pitch to the next row's origin
    layout: [1, 1, 1, 1]  # single bays (double-width bays are not designed for the panel frame yet)
  - id: B
    height: 165
    layout: [1, 1, 1, 1]
  - id: C                 # the dense row, on top (the user, 2026-11-01): its bays' boards on edge in a slotted bin
    height: 120           # (drawer.slot_bin), up to 82 mm tall: 85 from the bin's floor to the cap plate, the
    layout: [1, 1, 1, 1]  # tallest (a Wio Terminal, 72) 13 under it.  It takes the hub's third row output (C)

cameras:                  # bays that get a camera pod on their ceiling (the tray above, or the cap plate)
  - B2

power_box:                # mechanical/parts/power_box.scad: the power hub's enclosure, in a base cell under row A
  column: 0               # base cell (under row A) it sits in: its floor sockets take the floor plate's bosses
  x: 3                    # its left outer face from the cell's left (the row cables leave through the ladder window)
  size: [84, 108, 35]     # outer W × D × H: the hub (76 × 100) and its tallest part (the 100 µF bulk capacitor)
  wall: 2.4
  charger:                # outside the rack, on the USB-C PD input in the box's rear wall
    part: "USB PD charger, 100 W (20 V × 5 A), single port (e.g. Anker Nano 100 W, A2679)"
    price: 46               # EUR, anker.com/fr 2026-10-21
    cable: "USB-C to USB-C cable, 5 A, e-marked (100 W or 240 W rated), 1–2 m"
    # the option for racks full of hungry DUTs: a PD 3.1 EPR charger, 140 W (28 V × 5 A), single port, e.g.
    # Samsung EP-TB410 (≈ €84 without a cable, the cheapest found in France on 2026-10-21; UGREEN Nexode or
    # Anker 717 140 W often €60–80 on sale, unverified).  The hub asks for 28 V EPR whenever it is offered:
    # no hardware change, a 240 W e-marked cable

standalone:               # mechanical/parts/standalone.scad, docs/standalone.md: one bay out of the rack, on a desk
  pd_module:              # the USB-C PD trigger module, a CH224K set to 20 V with its DIP switch (bought: AliExpress
                          # 3256811726090162; docs/cabling.md), feeding the node's J1 instead of the power hub.  It stands on
                          # its long edge in the boxes.  The seller gives no size: these are the largest the photos allow;
                          # measure the board bought.  The rear wall centres its USB-C's shell, any board
    size: [30, 21]        # its PCB: length (from the edge its USB-C sits on), width (it stands on this edge)
    thickness: 1.6        # its PCB
    usb_axis: 3.2         # the receptacle's axis off the PCB's back face (a top-mount one: t + 1.6)
  feet: [10, 3]           # stick-on rubber bumpers under the boxes: Ø, height

# Example population used by the docs, the BOM roll-up and the 3D viewer.
# board ids refer to mechanical/boards/boards.yaml; cable ids to cables below.  `mount`, per bay, the same
# tray for all: drawer (default: on a drag chain, the board stays plugged while it slides out), sled (the
# drawer's front alone, no chain: unplug the DUT cable, then pull; the DATA port stays behind in a port
# block) or fixed (a sled screwed in place).  Any bay converts either way.
# A bay with a DATA ×4 board in its drawer holds up to four boards (docs/multi-dut-node.md): `boards:`
# instead of `board:`, sub-slots <bay>.1–.4 by DATA ×4 port (`slot:`, else the entry's rank).  They share
# one plate (plate_bay_<id>, `plate: boards`): each board's front-left corner `at` [x, y] in plate coords
# (front-left origin, y to the port wall; without it they are packed in a row), turned USB to the port wall
# (`orient: side` to turn it to the right wall).  tools/rackcfg.py checks the layout.
# Every bay's plate is the honeycomb plate (`plate: pegs`, the default): its boards held by clip-in pegs, placed by
# tools/plate_layout.py from the board's usual place (a converted bay's: its `at`), moved a few mm to fit the
# grid.  `plate: boards` asks for the former kind instead: the board's own plate (plate_<board>), or a converted
# bay's (plate_bay_<id>), standoffs or corner fences at each `at`.
population:
  A1: { board: nucleo-64,        cable: c-to-micro-b }
  A2: { board: nucleo-144,       cable: c-to-micro-b }
  A3: { board: beagleplay,       cable: c-to-c, mount: sled }      # a sled bay: no drag chain
  A4: { board: wio-terminal,     cable: c-to-c }                   # A3, A4: the user's picks (2026-10-21) for boards whose
                                                                   # makers publish an open 3D model; they replaced the
                                                                   # nRF52840 and nRF54L15 DKs
  B1:                                                              # converted: a Pico 2 and a Nano Matter on a base DATA-4x's
    open: true                                                     # drawer shown pulled out
    x4: base                 # the standing DATA ×4 v2 assembled as DATA-4x (b.pcb variants › base: no matrix, no analyzer,
                             # no pin chain), in its cradle; the viewer shows it, the BOM prices that variant
    boards:                  # ports 2 and 4, ports 1 and 3 free (a third board leaves no room for its pegs' cams, 2026-10-20)
      - { board: rpi-pico2,    cable: c-to-micro-b-straight, slot: 2, at: [34.0, 16.0] }   # a straight 15 cm cable, an S
      - { board: arduino-nano-matter, cable: c-to-c-straight, slot: 4, at: [107.7, 24.0] }  # the same, as B3's XIAOs (it
          # replaced the FRDM-MCXN947, which has no public 3D model: the user's pick, 2026-10-21)
    jumpers:                 # Dupont female–female, 20 cm, from the base's two 2 × 1 per port (GND/VREF, RESET/BOOT: the 2 × 6's
                             # end columns, only GND, RESET and BOOT live): the Pico 2's
      B1.2: { RESET: RUN }     # RESET is RUN (its BOOTSEL a test pad; no GND wire: the USB cable carries it)
  B2: { board: giga-r1-display,  cable: c-to-c, plate: boards }   # the camera bay: a live LVGL screen (2026-10-18);
                                                                   # the shield hides the GIGA's edges: its own fenced plate
  B3:                                                              # converted: B3.1–B3.4 on a DATA ×4 board
    open: true                                                     # drawer shown pulled out
    x4: v2                   # a DATA ×4 v2 here (decided 2026-10-19): the viewer shows it, the BOM prices its logic variant
    jumpers:                 # Dupont female–female, 20 cm, one 3-wire ribbon per board from the DATA ×4's header (its port)
      B3.1: { VREF: 3V3, P1: D7, P2: D6 }      # to its pins, header pin: board pin.  A UART between B3.1 and B3.2, each
      B3.2: { VREF: 3V3, P1: GP0, P2: GP1 }    # P to the same P: GP0 (TX) → D7 (RX), D6 (TX) → GP1 (RX); and the VREF
                               # the LSF0108 needs (GND comes with the USB cable).  Red, orange, yellow off the strip: in
                               # that order the strip lies flat onto each board's pins
    boards:                  # straight 15 cm cables, each at rest in a gentle arch (tools/webscene.py › rod_cable)
      - { board: xiao,      cable: c-to-c-straight,       at: [8.7, 30.0] }     # over 14.5-15.5 cm: the boards forward,
      - { board: rpi-pico2, cable: c-to-micro-b-straight, at: [41.7, 16.0] }    # 33 mm apart for the pegs between
      - { board: rpi-pico2, cable: c-to-micro-b-straight, at: [74.7, 16.0],     # them (tools/plate_layout.py moves
          role: analyzer }                                                      # each a few mm to its stops)
      - { board: xiao,      cable: c-to-c-straight,       at: [107.7, 30.0] }   # B3.3: the bay's logic analyzer (below)
  B4: { board: arduino-uno-r4,   cable: c-to-c-straight-20, pc_cable: true }      # "classic" mode: laptop on the front port
  C1:                                                              # dense: up to six boards on edge in the slotted bin
    plate: slots             # (drawer.slot_bin), lane k to the DATA ×6's port k; no Dupont there (a board that needs
    boards:                  # wires goes to a plate bay), one straight 15 cm cable each
      - { board: nucleo-64,        cable: c-to-micro-b-straight, slot: 1 }
      - { board: xiao,             cable: c-to-c-straight,       slot: 2 }
      - { board: esp32-s3-devkitc, cable: c-to-micro-b-straight, slot: 3 }
      - { board: microbit-v2,      cable: c-to-micro-b-straight, slot: 4 }
      - { board: rpi-pico2,        cable: c-to-micro-b-straight, slot: 5 }
      - { board: wio-terminal,     cable: c-to-c-straight,       slot: 6 }
  C2:
    plate: slots
    open: true                                                     # drawer shown pulled out
    boards:
      - { board: nucleo-64,        cable: c-to-micro-b-straight, slot: 1 }
      - { board: arduino-uno-r4,   cable: c-to-c-straight,       slot: 3 }
      - { board: rpi-pico2,        cable: c-to-micro-b-straight, slot: 4 }
      - { board: xiao,             cable: c-to-c-straight,       slot: 5 }
  C3:
    plate: slots
    boards:
      - { board: arduino-nano-matter, cable: c-to-c-straight,    slot: 1 }
      - { board: xiao,             cable: c-to-c-straight,       slot: 2 }
      - { board: xiao,             cable: c-to-c-straight,       slot: 3 }
      - { board: esp32-c6-devkitc, cable: c-to-c-straight,       slot: 4 }
      - { board: rpi-pico2,        cable: c-to-micro-b-straight, slot: 6 }
  C4:
    plate: slots
    boards:
      - { board: wio-terminal,     cable: c-to-c-straight,       slot: 2 }
      - { board: nucleo-64,        cable: c-to-micro-b-straight, slot: 3 }
      - { board: arduino-nano-matter, cable: c-to-c-straight,    slot: 5 }

# A sub-slot's board with `role: analyzer` (one Pico 2, until the DATA ×4 v2's RP2350B; decided 2026-10-19): gusmanb's
# LogicAnalyzer, stock, its channels on Dupont jumpers to the neighbours' pins (docs/multi-dut-node.md › "A logic
# analyzer in a sub-slot").  bayctl keeps it out of the twister map; the BOM adds the Pico 2 and the jumpers.
analyzer:
  project: https://github.com/gusmanb/logicanalyzer        # GPL-3.0: point at the exact tag, the UF2 is not redistributed
  app: "6.0.0.1"          # the desktop app, release v6.0.0.1 (logicanalyzer_6.0.0.1-<os>.zip): sigrok decoders included
  firmware:               # by board: the release that carries it, its asset (a zip holding the UF2) and size in bytes
    rpi-pico2: { release: v6.0.0.0, asset: logic-analyzer-firmware_v6.0.0_BOARD_PICO_2.zip, size: 32325,
                 sha256: 1179fcb165064913855875cd9e96bd11f2a86a2b5a8eaab340f9826a9d0f665a }
                          # 6.0.0.1 changed only the apps.  Not the _Turbo build (a 400 MHz overclock, 200 MS/s).
                          # The sha256: downloaded 2026-11-03 (GitHub gives no digest for assets of that age)
  usb: "1209:3020"        # what it enumerates as: one CDC ACM port, "Dr. Gusman" "LogicAnalyzer"; the app finds it by this
                          # (plus the SDK's reset interface: `picotool reboot -u -f` takes it to BOOTSEL)

cables:
  # DUT cables (DATA socket → board), `length` end to end.  A board whose USB faces the port wall: a
  # right-angle USB-C at the socket and, at the board, a right-angle USB-C (style right) or, micro-B and
  # mini-B not being reversible, a 90° adapter with the cable's straight plug standing on it (style
  # adapter): an arch over the board's rear edge.  A small board turned to the side wall (orient: side):
  # straight plugs at both ends, one flat bend (style straight).  A long one turned to it (the
  # F746G-DISCO): its straight plug fits beside it, bends up and arches over to the socket (style side).
  # A board facing the port wall far enough from it for two straight plugs (a converted bay's): straight
  # at both ends too, the cable lying in an S between them (style straight; no right angle where none is needed).
  c-to-c:       { label: "USB-C straight ↔ USB-C 90°, 15 cm",   a: usb-c, b: usb-c,   length: 150 }
  c-to-micro-b: { label: "USB-C straight ↔ micro-B straight, 25 cm, on a micro-B 90° adapter", a: usb-c, b: micro-b,
                  length: 250, style: adapter }
  c-to-mini-b:  { label: "USB-C straight ↔ mini-B straight, 25 cm", a: usb-c, b: mini-b,
                  length: 250, style: side }       # the F746G-DISCO: its USB faces the side wall, 49 mm away
  c-to-c-straight:       { label: "USB-C ↔ USB-C, straight, 15–20 cm", a: usb-c, b: usb-c,   length: 150, style: straight }
  c-to-c-straight-20:    { label: "USB-C ↔ USB-C, straight, 20 cm", a: usb-c, b: usb-c,      length: 200, style: straight }
  c-to-micro-b-straight: { label: "USB-C ↔ micro-B, straight, 15 cm", a: usb-c, b: micro-b, length: 150, style: straight }
  data-lead:    { label: "JST PH 8-pin DATA lead, pin n ↔ pin 9−n, 400–500 mm (node J7 → DATA port board)", length: 400 }
  row-jumper:   { label: "JST PH 6-pin row cable, pin n ↔ pin 7−n, 24 AWG, 120 mm", length: 120 }
  row-feed:     { label: "JST PH 6-pin feed, pin n ↔ pin 7−n, 24 AWG (VRACK, CAN, POS)", length: 600 }

pcb:
  solder_mask: green        # the rack's own boards, every one (the user, 2026-10-23: "faisons tout en vert"; black from
                            # 2026-10-21): JLC's green, white silkscreen, at no charge.  JLC's Economic PCBA takes 4 layers in
                            # green only, and black cost $8.00 an order on 4 layers (jlcpcb.com, 2026-10-23).  The viewer and
                            # the renders paint it (tools/pcb_glb.py); order it in the JLC form's "PCB Color".  A board's own
                            # pcb.<board>.solder_mask overrides it (rackcfg.Rack.solder_mask)
  bay_node:
    size: [74, 90]          # X × Y; KiCad y=0 is the REAR edge, y=90 the front edge (grown 10 mm at the rear for
                            # the WROOM-1 module: every y below moved by 10, the board's front and holes stay put;
                            # then 10 mm wider on the right, 2026-10-19, for AUX / CAM / DATA in one row there)
    thickness: 1.6
    layers: 4
    x0: 4                   # left edge, carrier X
    front_gap: 0.5          # PCB front edge → fascia inner face
    holes: [[3.5, 13.5], [70.5, 13.5], [3.5, 86.5], [70.5, 86.5]]   # M3, KiCad coordinates (the right pair moved with the edge;
                            # the left pair sits under the tray's ledge: a Ø6.4 access hole through it over each)
    front: { pc_port: 32, led: 12, svc: 50 }        # KiCad X of the front-edge parts
    pwr_y: 73               # KiCad Y of the row cable connectors (JST PH 6, left/right edges)
    right: { data: 30.0 }   # KiCad Y of J7's centre (DATA, PH 8 side entry on the right edge, pin 1 at the front)
    aux: [69.1, 50.6]       # J5 (AUX, PH 6 side entry on the right edge, pin 1 at the front), its centre, KiCad
    cam: [59.0, 17.2]       # J6, the camera lead (JST PH 8, vertical: plugged from above, at the rear right), its centre, KiCad
  power_hub:                # v1.0: USB-C PD in (CH224A), eFuses, rack controller (ESP32-S3, CAN master)
    size: [76, 100]         # X × Y; KiCad y=0 is the REAR edge, y=100 the front edge (like the bay node)
    thickness: 1.6
    layers: 4               # as the bay node: In1 solid GND, In2 power only, signals outside
    holes: [[3.5, 3.5], [72, 4], [4, 93.5], [72, 86.0]]   # M3, KiCad coordinates (the front pair clears the LEDs and USB-C)
    x0: 3.6                 # left edge, box X (the row connectors' mouths reach into the left wall)
    front_gap: 1.2          # PCB front edge -> box front wall inner face
    z: 19.0                 # PCB bottom above the box bottom: the row connectors clear the base ladder's window sill
    rows: [81, 63.5, 46, 28.5] # KiCad y of the row A, B, C, D connectors (6-pin JST PH, side entry, left edge, 17.5 mm apart)
    front: { leds: [11, 23, 35, 47, 55.6, 61.6], usb: 70 }  # KiCad x: ON/FAULT pair centres (±3) for rows A-D, then PD (the CH224A's PG), CTL; USB-C
    rear: { pd: 62 }            # KiCad x on the rear edge: the USB-C PD input
    buttons: [[11.5, 10.0], [11.5, 16.5]]   # KiCad: SW1 RESET, SW2 BOOT (design.py), top-actuated, 1.5 mm tall: pin holes in the lid
  data_port:                # the single-port board, retired from the rack on 2026-10-31: only the standalone Solo box and
                            # the assembly notice still use it (a USB-C source on a small board)
    size: [40, 17]          # X × Y; KiCad y=0 is the REAR edge (the 8-pin PH lead to the node), y=17 the FRONT edge (USB-C mouth)
                            # ≤ 17 deep: the PH plug and the wires' turn down fit in the drawer's rear bay
    thickness: 1.6
    layers: 2
    holes: [[2.6, 13.5], [37.5, 4.0]]    # Ø2.7, PT 2.3 × 8 from above into the drawer's floor bosses (the left one clear of the PH 8)
    usb: 30.5               # KiCad x of the USB-C (GCT USB4105) on the front edge: the right edge ≤ 9.5 mm right of it (the
                            # chain foot's lock screw); its centre 1.63 mm above the component face (3.23 above the underside)
    ph: 14.4                # KiCad x of the JST PH 8-pin (side entry) on the rear edge: its courtyard clear of the USB4105's (x ≤ 14.5)
  data_port_x4:             # a converted bay's (population › boards:) DATA ×4: a USB hub and four USB-C sources, in the drawer's
                            # rear bay (the data-x4-board proposal, 2026-10-19; drawer.scad and the viewer follow it)
    size: [100, 37]         # X × Y; KiCad y=0 is the REAR edge, y=37 the FRONT edge (the USB-C mouths, against the port wall).
                            # 100 mm long since 2026-10-20 (JLC's 4-layer offer, no engineering fee): 13 mm deeper, to the rear,
                            # as deep as the v2
    x0: 15                  # drawer x of its left edge (KiCad x = drawer x − 15): drawer x 15–115
    thickness: 1.6
    layers: 4
    holes: [[3.2, 16.5], [38.7, 16.5], [81.4, 16.3]]   # Ø2.7, PT 2.3 × 8 from above into the floor bosses: where they were
                            # on the 24 mm board, the drawer's DATA ×4 bosses (the v2's first three)
    usb: [11, 29, 47, 65]   # KiCad x of the four USB-C (USB4105), ports 1–4 left to right: drawer x 26, 44, 62, 80 (18 mm pitch)
    lead: [95.1, 20.0]      # J1, the JST PH 8 (S8B-PH-SM4-TB, side entry) at the rear end of the RIGHT edge: its footprint centre
                            # (KiCad), its mouth +x at x 100 (drawer x 115), pin 1 (INT) at y 27 (drawer y 176), pin 8 (+5V) at
                            # y 13 (drawer 190); the plug (drawer y 174–192) drops its wires into the side window beside the board
    aux: { y: 15.9, pin1: [8.5, 30.0, 44.5, 66.0], step: [2.54, -2.54, 2.54, -2.54], names: [GND, RESET, BOOT] }
                            # J102–J402: per port a 1 × 3 2.54 header (GND, RESET_N, BOOT_N) along x, pin 1 at pin1[n] (KiCad),
                            # the right port of a pair mirrored; not fitted by JLC, soldered by hand for Dupont jumpers
  data_port_x4_v2:          # DATA ×4 v2 (electronics/data-port-x4, docs/data-x4-v2-research.md): v1 plus 32 switchable pins
                            # on 8 buses and the RP2350B analyzer (DATA-4x-logic); the same PCB with the logic left off is
                            # the base DATA-4x of the other converted bays (the user, 2026-10-20: v1 is not ordered for the
                            # proto).  A bay with `x4: v2` shows it in the viewer and the BOM prices its logic variant
                            # (tools/bom.py); the BOM gives the other converted bays its base.
                            # It STANDS at the back of the drawer's rear bay (docs/data-x4-v2-layout-options.md, option B),
                            # held by its printed cradle (parts/x4_cradle.scad).  KiCad x = board x = drawer x − x0, KiCad
                            # y = top_z − drawer z (y = 0 its top edge).  Its front face (F.Cu, every part JLC places:
                            # Economic PCBA, one side) faces the port wall
    size: [100, 70]         # length (drawer x) × height (z), 1.6 thick; these mirror x4_cradle.scad (V2, V2_X0, V2_Y, NOTCH*)
    x0: 4                   # drawer x of its left edge (the board spans x 4–104); its bottom edge on the drawer floor
    top_z: 72.5             # drawer z of its top edge (the drawer's underside z = 0, its floor's top 2.5)
    usb_h: 7.46             # its standing USB-C's mouth off its front face (GCT USB4145-03-0170-C): the board stands
                            # drawer.port_mouth + usb_h behind the port wall's back face (rackcfg derives face_y)
    thickness: 1.6
    layers: 4               # F · GND · power (+3V3 above y 55.7, +5V below) · B: 4 layers again since 2026-10-23 (the
                            # routing portfolio and its fixes route it clean); X4V2_LAYERS=6 still builds the 6-layer
                            # stack-up for a comparison
    cradle: 5.5             # each end's 5.5 mm in the cradle's slots (and its latches), both faces free of parts
    notches: { x: [38.5, 69.5], size: [3.4, 4.5], tee: [-2.2, 2.5] }   # its bottom edge's two notches (drawer x of
                            # their centres; width, depth), the cradle's T-heads, as the DATA ×6's (2026-11-01); tee:
                            # each T-head bar's ends off its notch's centre (x4_cradle.scad reads it), the bar 0.5 under
                            # the notch's depth: the front face free of parts over it, 0.3 mm round.  Rear face bare
                            # 5.3–9.3 mm above the bottom edge (the base's push band)
    usb: [28.95, 44.45, 59.95, 75.45]   # board x of the four vertical USB-C (GCT USB4145-03-0170-C, 7.46 mm tall), mouths
                            # towards the wall: the DATA ×6's positions 2–5 (drawer x 32.95 … 79.45, 15.5 mm apart), so
                            # one drawer takes either board (layout B, 2026-11-01; the headers stay at their x)
    usb_rot: [90, 90, 90, 90]   # each one's turn on the board: standing, slot upright, all alike, as the DATA ×6's
    usb_z: 11               # their axis: the port wall's openings, as v1's
    header: { x: [22, 40, 58, 76], z: 28.5, odd_z: 27.23, even_z: 29.77, cols: 6,
              names: [GND, VREF, P5, P1, P6, P2, P7, P3, P8, P4, RESET, BOOT] }
                            # per port a 2 × 6 2.54 through-hole header (hand-soldered, its tails 1.5 mm out of the rear
                            # face) on the FRONT face, pins forward, centred on v1's port x and on drawer z 28.5 (layout
                            # B, 2026-10-21: its names over it, its port number and VBUS LED by its west end), pin 1
                            # at x − 6.35: column k (from the left) holds pins 2k−1 on the lower row (odd_z) and 2k on the
                            # upper one.  Read as rows (the user, 2026-10-20): upper VREF 1 2 3 4 BOOT, lower GND 5 6 7 8
                            # RESET.  names: in pin order 1–12
    lead: [89, 41]          # J1, the JST PH 8 vertical through-hole (B8B-PH-K-S) on the REAR face, soldered by hand: board
                            # x and drawer z of its centre, the DATA ×6's (the user, 2026-11-01: one lead and one cable
                            # window for both).  Its pins run UP the board, every 2 mm, from pin 1 at z 34 to pin 8 at
                            # z 48, the ×6's map: 1 NC · 2 SCL · 3 SDA · 4 GND · 5 D− · 6 D+ · 7 GND · 8 VIN (the node's
                            # switched 20 V); the housing 4.5 (x) × 17.9 (z), 6.0 off the face, its mouth towards the
                            # rear: the lead plugs in from behind and drops into the cable window
  data_port_x6:             # DATA ×6 (electronics/data-port-x6, prototype, 2026-10-31): six ports for the porte-revues
                            # bays, power only since 2026-10-31 (hub, switch and INA226 per port; no pin header: the
                            # DATA ×4 v2 keeps the logic); same frame as the v2: board x = drawer x − x0, KiCad y =
                            # top_z − drawer z.  It stands where the v2 stands, its front face towards the port wall
                            # (six U's at 15.5 mm).  100 × 70 since it lost the logic (2026-11-01), the v2's outline
                            # (one cradle and drawer for both): the six USB-C on the common 15.5 mm grid (the v2's four
                            # on positions 2–5), the converters, the hub and the leads' connectors over them
    size: [100, 70]
    corner_notch: [0, 0]       # its bottom-right corner cut (width, height): none at 100 mm (the 120 mm board's
                               # cleared the drag chain foot's boss)
    x0: 4
    top_z: 72.5
    usb_h: 7.46                # as the v2's
    thickness: 1.6
    layers: 4
    cradle: 5.5
    notches: { x: [38.5, 69.5], size: [3.4, 4.5], tee: [-2.2, 2.5] }   # DRAWER x (not board x) of their centres:
                            # between ports 2–3, 4–5; tee: each T-head bar's ends off its notch's centre, as the v2's
    usb: [13.45, 28.95, 44.45, 59.95, 75.45, 90.95]  # board x of the six vertical USB-C, 15.5 mm apart (the grid shared
                                                     # with the v2: its 15.24 mm headers fit), mouths to the wall; 2.2 mm
                                                     # east of their clusters since they stand (USB-C 1's USBLC6 beside
                                                     # it, clear of the cradle's band; USB-C 6 0.5 mm clear of the east one)
    usb_rot: [90, 90, 90, 90, 90, 90]  # each receptacle's turn on the board (KiCad degrees): 90 standing, its slot
                                       # upright (3.2 wide, 8.9 tall, same centre), its pins facing its USBLC6 west of
                                       # it (2026-11-01); 0 would lie (8.9 × 3.2).  All six alike: one slot shape
    usb_z: 11
    lead: [89, 41]          # J1, the PH 8 lead (the v2's pinout), rear face: board x, drawer z of its centre; its pins
                            # run up the board, 2 mm apart: 1 NC · 2 SCL · 3 SDA · 4 GND · 5 D− · 6 D+ · 7 GND · 8 VIN
                            # (the node's switched 20 V), pin 8 at the top.  At the east end, its upstream pins level
                            # with the hub's; the lead runs behind the board to the rear cable window
  camera_pod:             # the board in each camera pod, beside the Arducam Mega, mounted components (LEDs) down
    size: [40, 27]          # X × Y; KiCad y=0 is the edge beside the camera (the LEDs), x=40 the lead's edge
    thickness: 1.6
    layers: 2
    holes: [[2.6, 13.0], [26.5, 23.5]]   # Ø2.7, PT 2.6 into the printed pod
    leds: [5, 11, 17, 23]   # KiCad x of the four white 2835 LEDs, at y = led_y
    led_y: 3.2
    lead: 13                # KiCad y of J1 (JST PH 8, side entry) on the right edge, its mouth facing +x
    header: [13, 21]        # J2 (1 × 6, 2.54 mm, pins out of the component face): its centre, pin 1 at x − 6.35
