kartben/hw-testing-rack/firmware/bay-node/web/screenshots.py

"""Render the screenshots of the bay node web page used in the docs.

    pip install playwright pillow
    python firmware/bay-node/web/screenshots.py            # -> docs/img/web-ui-*.png

Runs dev_server.py in-process (simulated node), opens the page in the
installed Chrome (--channel msedge for Edge, or --channel chromium after
`playwright install chromium`), lets it collect a minute of current samples
for the sparkline (and of the fake board's log for the console), then
shoots each state, then access control (web-ui-access*.png): the node
claimed with a key made up for the run, rules, a CI job holding the bay;
then a DATA x4 bay's ports, a board target's dialog, the Wires card and the logic analyzer card.
The browser and server plumbing is firmware/common/web/shots.py.
"""

from __future__ import annotations

import argparse
import json
import os
import sys
import time
import urllib.request
from pathlib import Path

WEB = Path(__file__).resolve().parent
sys.path.insert(0, str(WEB.parents[1] / "common" / "web"))

import dev_server  # noqa: E402
from shots import DESKTOP, DOCS_IMG, POLL_S, Shots  # noqa: E402


def main() -> None:
    ap = argparse.ArgumentParser(description=__doc__.splitlines()[0])
    ap.add_argument("--channel", default="chrome", help="browser: chrome, msedge or chromium")
    ap.add_argument("--warmup", type=float, default=60, help="seconds of samples before shooting")
    ap.add_argument("--out", type=Path, default=DOCS_IMG)
    args = ap.parse_args()

    # This machine plays the admin's laptop of the examples
    dev_server.PEER_OVERRIDE["127.0.0.1"] = "192.168.1.23"
    # The node is B2's, the bay its camera frames show (camera/, the GIGA R1)
    dev_server.node.update(id="b2", hostname="bay-b2", ip="192.168.1.78")
    # Its board's target, for bayctl hwmap (the USB devices card's line)
    dev_server.set_board(1, {"board": "nucleo_g474re"})

    with Shots(dev_server.serve(0), args.out, args.channel) as s:
        poke, shoot, base = s.poke, s.shoot, s.base
        dark = s.page("dark", DESKTOP)
        light = s.page("light", DESKTOP)
        print(f"collecting {args.warmup:.0f} s of samples...")
        time.sleep(args.warmup)

        # Use the board's shell from the web console
        dark.click(".term")
        dark.keyboard.type("sensor get")
        dark.keyboard.press("Enter")
        time.sleep(1)
        shoot(dark, "web-ui-console", ".console")

        # The camera's live view (the simulated camera: B2 in the viewer, grab_camera.py)
        dark.click("#cam-live")
        time.sleep(3 * POLL_S)
        shoot(dark, "web-ui-camera", "#cam-card", palette=True)

        # Its settings, tuned a little (a cloudy-day white balance, brighter), then back to auto
        dev_server.camera.configure({"white_balance": "cloudy", "brightness": 1, "saturation": -1})
        dark.set_viewport_size({"width": DESKTOP["width"], "height": 1000})   # the whole popover
        dark.click("#cam-fmt")
        dark.wait_for_selector("#cam-settings:popover-open")
        time.sleep(1.5)
        shoot(dark, "web-ui-camera-settings", "#cam-settings")
        dark.click("#cam-settings [data-camset=reset]")
        dark.keyboard.press("Escape")
        dark.evaluate("document.activeElement.blur()")   # no focus ring left on the picture pill
        dark.set_viewport_size(DESKTOP)

        poke("/dev/attach")             # a USB/IP client is attached: green
        shoot(dark, "web-ui-dark", palette=True)
        dark.click("#cam-live")         # stopped: the next shots list no camera client
        time.sleep(5)                   # the Access card polls every 4 s
        poke("/dev/attach")             # detached again: device ready, blue
        shoot(light, "web-ui-light")
        poke("/dev/fault")              # over-current trip
        shoot(dark, "web-ui-fault")
        urllib.request.urlopen(base + "/api/power", data=b'{"action": "on"}').read()

        # Access control: claimed, three sources, refused attempts, a CI job holds the bay
        acc, ip = dev_server.access, dev_server.ip_int
        acc.key = os.urandom(32)
        acc.set_rules({"enabled": True, "everyone": ["status"], "sources": [
            {"name": "ben-laptop", "cidr": "192.168.1.23", "allow": ["all"]},
            {"name": "ci-runners", "cidr": "192.168.1.40/30", "allow": ["status", "control", "console", "usbip"]},
            {"name": "prometheus", "cidr": "192.168.1.5", "allow": ["status"]}]})
        for addr, svc, n in (("192.168.1.90", "console", 2), ("192.168.1.77", "control", 5),
                             ("192.168.1.42", "control", 1)):
            for _ in range(n):
                acc.check(svc, ip(addr))
        acc.take(ip("192.168.1.41"), 3600, "twister job 8812")
        poke("/dev/attach")             # the job's USB/IP and RFC 2217 clients
        poke("/dev/rfc2217")
        for page in (dark, light):
            page.evaluate(f"localStorage.setItem('bay-admin-key', '{acc.key.hex()}')")
            page.reload()
        time.sleep(3 * POLL_S)

        def shoot_top(page, name: str) -> None:
            s.shoot_span(page, name, ".wrap > header", ".cards")

        shoot_top(dark, "web-ui-access")
        dark.set_viewport_size({"width": DESKTOP["width"], "height": 760})
        dark.click("#btn-admin")
        dark.wait_for_selector("#dlg-access[open]")
        time.sleep(0.5)
        shoot(dark, "web-ui-access-rules", "#dlg-access")

        dev_server.PEER_OVERRIDE["127.0.0.1"] = "192.168.1.77"   # another host: read-only
        light.evaluate("localStorage.removeItem('bay-admin-key')")
        light.reload()
        time.sleep(3 * POLL_S)
        shoot_top(light, "web-ui-access-readonly")

        # DATA x4: four sub-slots (B3.1-B3.4) with per-port controls
        dev_server.PEER_OVERRIDE["127.0.0.1"] = "192.168.1.23"
        acc.set_rules({"enabled": False, "everyone": ["all"], "sources": []})
        acc.lease = None
        dev_server.node.update(id="b3", hostname="bay-b3", ip="192.168.1.53")
        dev_server.set_ports(4)
        time.sleep(2.2)
        dev_server.ports[0]["client"] = ip("192.168.1.41")
        dev_server.ports[2]["lease"] = {"holder": ip("192.168.1.41"), "note": "twister job 8812",
                                        "until": time.monotonic() + 3600}
        # B3.1's FRDM board draws 300 mA: no room left in the hub's 5.4 W (node v1.0) for B3.4's
        # start, asked on as soon as there is
        dev_server.ports[0]["draw"] = 300
        dev_server.ports[3].update(on=False, waiting=True, queued=True)
        # Board targets: two set (B3.3's held by the job), B3.2's serial adapter not yet
        dev_server.boards.clear()
        dev_server.set_board(1, {"board": "frdm_mcxn947/mcxn947/cpu0"})
        dev_server.set_board(3, {"board": "rpi_pico2/rp2350a/m33_0"})
        dark.set_viewport_size(DESKTOP)
        dark.reload()
        # The power card's sparkline: the bay's draw on its DATA lead, a minute of it
        time.sleep(max(POLL_S, min(args.warmup, 60)))
        shoot(dark, "web-ui-ports", "#usb-card")
        shoot(dark, "web-ui-budget", "#power-card")

        # A XIAO ESP32-C6 in B3.4: its board target, picked from the suggestions for 303a:1001
        poke("/dev/usb?preset=xiao&port=4", wait=0)
        dev_server.ports[3].update(on=True, waiting=False, queued=False, up_at=time.monotonic())
        light.set_viewport_size({"width": DESKTOP["width"], "height": 900})
        light.reload()
        time.sleep(2 * POLL_S)
        light.click("#usb-list button[data-board='4']")
        light.wait_for_selector("#board-settings:popover-open")
        light.click("#b-sugg button[data-pick='xiao_esp32c6/esp32c6/hpcore']")
        light.evaluate("document.activeElement.blur()")
        time.sleep(0.5)
        shoot(light, "web-ui-board-target", "#board-settings")

        shoot_wires(dark, shoot)
        shoot_analyzer(dark, shoot)


# The mock's wiring: a UART each way between B3.2 and B3.3, I2C from B3.1 to B3.4 (a 1.8 V board), SPI
WIRES = {"A": ["2/1", "3/2"], "B": ["3/1", "2/2"], "C": ["1/3", "4/3"], "D": ["1/4", "4/4"],
         "E": ["2/5", "3/5"], "F": ["2/6", "3/6"], "G": ["2/7", "3/7"], "H": ["3/8", "2/8"]}
WIRE_NAMES = ["UART B3.2 → B3.3", "UART B3.3 → B3.2", "I²C SDA", "I²C SCL", "SPI CS", "SPI SCK", "SPI MOSI",
              "SPI MISO"]


def shoot_wires(page, shoot) -> None:
    """The Wires card with the mock's wiring applied, then one pin moved and not applied yet."""
    dev_server.wires.wanted = {tuple(map(int, k.split("/"))): b for b, ks in WIRES.items() for k in ks}
    dev_server.wires.names = list(WIRE_NAMES)
    page.set_viewport_size({"width": DESKTOP["width"], "height": 1100})
    page.reload()
    time.sleep(2 * POLL_S)
    page.click("#wire-ports .pin[data-key='4/2']")
    page.wait_for_selector("#wire-pick:popover-open")
    page.click("#wire-pick-grid button[data-bus='H']")
    page.evaluate("document.activeElement.blur()")
    time.sleep(0.5)
    shoot(page, "web-ui-wires", "#wire-card")


# What the buses carry in the simulated bay, and the decoders on them (the card keeps both in the browser)
ANALYZER_SETTINGS = {
    "on": [0, 1, 2, 3, 4, 5, 6, 7], "rate": 10e6, "pre": 0.2, "trig": "0:fall",
    "names": {"0": "B3.2 TX", "1": "B3.3 TX", "2": "SDA", "3": "SCL", "4": "CS", "5": "SCK", "6": "MOSI",
              "7": "MISO"},
    "decoders": [{"type": "uart", "lines": {"rx": 0}, "baud": 115200},
                 {"type": "i2c", "lines": {"sda": 2, "scl": 3}},
                 {"type": "spi", "lines": {"cs": 4, "sck": 5, "mosi": 6, "miso": 7}, "mode": 0}],
}


def shoot_analyzer(page, shoot) -> None:
    """The logic analyzer card after "Capture and reset" on B3.2: the simulated analyzer's boot banner
    on bus A, then I2C and SPI, the node's MARK around the reset."""
    dev_server.coproc.image = {"name": "gusmanb 6.0", "size": 40704, "addr": "0x20000000",
                               "sha256": "61b75a29" * 8}
    page.set_viewport_size({"width": DESKTOP["width"], "height": 1100})
    page.evaluate(f"localStorage.setItem('hwtr-bay-analyzer', '{json.dumps(ANALYZER_SETTINGS)}')")
    page.reload()
    time.sleep(2 * POLL_S)
    page.click("#la-cap-reset")
    page.click("#la-reset-ports button[data-port='2']")
    page.wait_for_function("document.getElementById('la-state').textContent.includes('Captured')",
                           timeout=30000)
    page.evaluate("document.activeElement.blur()")
    time.sleep(0.5)
    shoot(page, "web-ui-analyzer", "#la-card")


if __name__ == "__main__":
    main()
