kartben/hw-testing-rack/firmware/bay-node/src/ports.c

/*
 * The drawer's DATA board, behind a hub (docs/multi-dut-node.md): a DATA x4,
 * four boards each on its own switch (TPS2553-1), current sense (INA226)
 * and RESET/BOOT lines, on two TCA6408A expanders; or a DATA x6, six boards
 * each on its switch and current sense, their EN and FAULT_N on one TCA9535,
 * no RESET/BOOT.
 *
 * The board runs from DUT_5V and its chips lose their registers with it, so
 * this file drives them itself over I2C, with shadow registers, instead of
 * through the GPIO and sensor drivers (whose cached state would not match a
 * chip that has just been powered up).  The devicetree still describes them
 * (data-x4.dtsi, data-x6.dtsi: the ports grouped per board): it gives the
 * addresses and the pins.  The one exception is the DATA x4's matrix
 * expander (ports_mx): its driver drives it, because the crosspoints' driver
 * shares it (MARK, below).
 *
 *  - The board is probed after each DUT_5V on: no answer at 0x20, no board,
 *    a one-port node (today's DUT, dut.c).  Both boards answer at 0x20; only
 *    a DATA x4 has a second expander (0x21), only a DATA x6 an INA226 at
 *    0x4C (its port 6's), so the probe reads those next and drives the board
 *    that answered.  One image serves both, and a board is driven only once
 *    it is known: the TCA6408A and the TCA9535 keep their output and
 *    direction registers at different places.  A board that answers at 0x20
 *    and at neither of the others is left alone, as no board.
 *  - Node v1.0 (DATA_VIN through an
 *    eFuse, dut.c): the board must answer within CONFIG_BAY_DATA_ANSWER_MS,
 *    and two polls without an answer switch DATA_VIN off (no INT line on the
 *    lead: the poll, every CONFIG_BAY_PORTS_POLL_MS, is how a fault or a board
 *    that went away shows).
 *  - No I2C to it while DUT_5V is off.  Before DUT_5V goes off every EN goes
 *    low; after it comes back, CONFIG_BAY_PORTS_SETTLE_MS later, the
 *    expanders and the INA226s are set up again, every port off.
 *  - Ports come up off (EN pulled down) and go on one at a time, every
 *    CONFIG_BAY_PORTS_STAGGER_MS, through the admission rule: what the bay
 *    draws plus CONFIG_BAY_PORTS_RESERVE_MA must stay within
 *    CONFIG_BAY_PORTS_BUDGET_MA.  The bay's draw is the node's own INA226,
 *    on DUT_5V (the board itself, its hub and co-processor, counts too);
 *    without one, the ports' sum plus CONFIG_BAY_PORTS_BOARD_MA.
 *  - Over CONFIG_BAY_PORTS_SHED_MA (the node's INA226 ALERT, or the poll as
 *    a backup), the last port switched on goes off; it stays wanted, and
 *    comes back once the budget has room for what it drew.
 *  - A port's ~FAULT (the TPS2553-1 latches off after 7.5 ms in current
 *    limit) is polled every CONFIG_BAY_PORTS_POLL_MS: the port is marked
 *    latched and goes off; "on" again restarts it.
 *  - A DATA x6's spare expander lines (P14-P17, pulled down) are outputs, low.
 *  - A DATA x4's RESET and BOOT are open drain, emulated: output register 0,
 *    the pin an output to assert, an input (100k pull-up, reads 1) to release.  A port
 *    that is off holds both asserted (no pull-up feeds an unpowered board);
 *    after EN, BOOT is released, then RESET.
 *  - The ports are sink-only, with no CC detection: a port whose VBUS reads
 *    over CONFIG_BAY_PORTS_VBUS_FOREIGN_MV while off is not switched on (a
 *    board powered from elsewhere); a wanted one comes on once it has gone.
 *    A power cycle waits for the port's VBUS to read under
 *    CONFIG_BAY_PORTS_VBUS_OFF_MV, CONFIG_BAY_PORTS_DISCHARGE_MS at most:
 *    the TPS2553-1 does not discharge its output, a port with nothing on it
 *    keeps 1.5-2 V.
 *
 * SPDX-License-Identifier: Apache-2.0
 */

#include <stdio.h>

#include <zephyr/kernel.h>
#include <zephyr/device.h>
#include <zephyr/devicetree.h>
#include <zephyr/drivers/gpio.h>
#include <zephyr/drivers/i2c.h>
#include <zephyr/logging/log.h>
#include <zephyr/sys/byteorder.h>

#include "bay.h"

LOG_MODULE_REGISTER(ports, CONFIG_BAY_LOG_LEVEL);

#if DT_NODE_EXISTS(DT_NODELABEL(data_x4))

/*
 * TCA6408A registers (the TCA9534A's are the same).  A TCA9535 has each one
 * as a pair at twice the number, port 0 then port 1 (the PCA9555's map).
 */
#define IO_INPUT    0x00
#define IO_OUTPUT   0x01
#define IO_POLARITY 0x02
#define IO_CONFIG   0x03 /* 1: input */

/* INA226 registers */
#define INA_CONFIG 0x00
#define INA_SHUNT  0x01 /* 2.5 uV/LSB, signed */
#define INA_BUS    0x02 /* 1.25 mV/LSB */
#define INA_MASK   0x06
#define INA_LIMIT  0x07
#define INA_SOL    BIT(15) /* ALERT on the shunt over the limit, not latched */
/* Averages 16, 1.1 ms conversions, shunt and bus continuous */
#define INA_CONFIG_VALUE 0x4527

/* Node v1.0: DATA_VIN through an eFuse, off when the board does not answer */
#define EFUSE DT_PROP(DT_NODELABEL(dut_port), vin_efuse)

#define IO_MAX       2
#define FAIL_LIMIT   (EFUSE ? 2 : 3) /* polls without an answer: the board is gone */
#define REPROBE_MS   2000 /* while DUT_5V is on and no board answers */
#define ANSWER_TRY_MS 100 /* v1.0: probes within CONFIG_BAY_DATA_ANSWER_MS */
#define REFUSED_MS   1000 /* a wanted port the budget refused: try again */
#define RELEASE_MS   5    /* EN to BOOT and RESET released: the port's VBUS is up */
#define SHED_MS      20   /* a port shed to the next reading: the meter averages 8.8 ms */
#define OVER_POLLS   (EFUSE ? 2 : 1) /* polls over the budget before a port is shed */
#define CONV_PCT     88   /* v1.0: the DATA board's converters, DATA_VIN to its 5 V */

/*
 * DATA x4: U11's MARK, the matrix expander's P7 (TCA9534A, not fitted on
 * the base DATA-4x), as the coproc node's mark-gpios.  It is high while the node
 * holds a port's RESET or has it off for a power cycle, until the last of
 * them ends: its falling edge is a board starting again, what the bay page's
 * "Capture and reset" triggers on (the analyzer's CH13).  Through the
 * expander's driver, shared with the crosspoints' (DAT, CK, STB, RST): MARK
 * changes only its pin, and the crosspoints' writes keep MARK.
 */
#define HAS_MARK DT_NODE_HAS_PROP(DT_NODELABEL(coproc), mark_gpios)
#if HAS_MARK
static const struct gpio_dt_spec mark_line = GPIO_DT_SPEC_GET(DT_NODELABEL(coproc), mark_gpios);
static int marks; /* actions holding MARK high (lock held) */
#endif

/*
 * The node's own INA226 (dut_port's power-monitor) on DUT_5V, or DATA_VIN on
 * node v1.0: what the whole bay draws.  Its driver sets it up (dut.c reads
 * it); this file reads its shunt and bus voltage and sets its ALERT for the
 * shedding.  The budget is in mA on DUT_5V (the first design), in mW on DATA_VIN against
 * the hub's grant (v1.0).
 */
#define METER     DT_PHANDLE(DT_NODELABEL(dut_port), power_monitor)
#define HAS_METER DT_NODE_HAS_PROP(DT_NODELABEL(dut_port), power_monitor)

static const struct i2c_dt_spec meter = COND_CODE_1(HAS_METER, (I2C_DT_SPEC_GET(METER)), ({0}));
static const struct gpio_dt_spec meter_alert =
	COND_CODE_1(HAS_METER, (GPIO_DT_SPEC_GET_OR(METER, alert_gpios, {0})), ({0}));
#define METER_UOHM COND_CODE_1(HAS_METER, (DT_PROP(METER, rshunt_micro_ohms)), (1))

struct port_cfg {
	uint8_t slot;
	uint8_t hub_port;
	uint8_t io;  /* the expander's I2C address */
	uint8_t en;  /* pins on that expander */
	uint8_t flt;
	uint8_t rst; /* 0xFF: none */
	uint8_t bst;
	uint8_t ina; /* the INA226's I2C address */
	bool wide;   /* the expander is a TCA9535: 16 lines */
	uint32_t rshunt_uohm;
};

#define PIN_OR_NONE(node, prop) COND_CODE_1(DT_NODE_HAS_PROP(node, prop), (DT_GPIO_PIN(node, prop)), (0xFF))

#define PORT_CFG(node)                                                                             \
	IF_ENABLED(DT_NODE_HAS_PROP(node, sub_slot), ({                                            \
		.slot = DT_PROP(node, sub_slot),                                                   \
		.hub_port = DT_PROP(node, hub_port),                                               \
		.io = DT_REG_ADDR(DT_GPIO_CTLR(node, enable_gpios)),                               \
		.en = DT_GPIO_PIN(node, enable_gpios),                                             \
		.flt = DT_GPIO_PIN(node, fault_gpios),                                             \
		.rst = PIN_OR_NONE(node, reset_gpios),                                             \
		.bst = PIN_OR_NONE(node, boot_gpios),                                              \
		.ina = DT_REG_ADDR(DT_PHANDLE(node, power_monitor)),                               \
		.wide = DT_NODE_HAS_COMPAT(DT_GPIO_CTLR(node, enable_gpios), nxp_pca95xx),        \
		.rshunt_uohm = DT_PROP(DT_PHANDLE(node, power_monitor), rshunt_micro_ohms),        \
	},))

#define HAS_X6 DT_NODE_EXISTS(DT_NODELABEL(data_x6))

static const struct port_cfg cfg_x4[] = {DT_FOREACH_CHILD_STATUS_OKAY(DT_NODELABEL(data_x4), PORT_CFG)};
#if HAS_X6
static const struct port_cfg cfg_x6[] = {DT_FOREACH_CHILD_STATUS_OKAY(DT_NODELABEL(data_x6), PORT_CFG)};
#define X6_PORTS ARRAY_SIZE(cfg_x6)
#else
#define X6_PORTS 0
#endif

#define MAX_PORTS MAX(ARRAY_SIZE(cfg_x4), X6_PORTS)

#if HAS_X6
/* Under one node name the two expanders at 0x20 merge, and the DATA x4's becomes the DATA x6's */
BUILD_ASSERT(!DT_SAME_NODE(DT_NODELABEL(ports_io0), DT_NODELABEL(ports_x6_io)) &&
		     DT_NODE_HAS_COMPAT(DT_NODELABEL(ports_io0), ti_tca9538),
	     "data-x6.dtsi: its expander's node must not be the DATA x4's");
#endif

/* The address both boards answer at: the DATA x4's first expander, the DATA x6's only one */
#define SHARED_IO DT_REG_ADDR(DT_NODELABEL(ports_io0))

struct board {
	enum data_board kind;
	const char *name;
	const struct port_cfg *cfg;
	uint8_t nports;
	uint8_t ident; /* an address only this board answers at */
	bool logic;    /* the DATA x4's co-processor, matrix and MARK */
};

static const struct board boards[] = {
	/* Its second expander */
	{DATA_X4, "DATA x4", cfg_x4, ARRAY_SIZE(cfg_x4), DT_REG_ADDR(DT_NODELABEL(ports_io1)), true},
#if HAS_X6
	/* Its port 6's INA226 */
	{DATA_X6, "DATA x6", cfg_x6, ARRAY_SIZE(cfg_x6), DT_REG_ADDR(DT_NODELABEL(port6_sense)), false},
#endif
};

static const struct device *const bus = DEVICE_DT_GET(DT_BUS(DT_NODELABEL(ports_io0)));

struct port {
	bool wanted;  /* to be on: at boot, and after each DUT_5V on */
	bool on;
	bool latched; /* off after a fault, until switched on again */
	bool refused; /* the budget, or its VBUS, kept it off: said once */
	bool foreign; /* its VBUS is up while off: waits for that, not for power */
	bool shed;    /* switched off by the shedding, wanted back */
	bool queued;  /* a request to switch it on as soon as the budget has room */
	uint32_t seq; /* when it went on: the last one goes first when the bay sheds */
	int32_t need; /* shed: what it drew, the room it needs to come back (mA, v1.0 mW) */
	uint32_t faults;
};

/* An expander's shadow registers: the chip loses them with DUT_5V */
struct io {
	uint8_t addr;
	bool wide; /* a TCA9535: 16 lines, register pairs */
	uint16_t out;
	uint16_t cfg;
};

/* The board the last probe found, kept while it is away: its ports, its expanders */
static const struct board *brd;
static const struct port_cfg *cfg;
static int nports;
static struct port ports[MAX_PORTS];
static struct io io[IO_MAX];
static int nio;
static bool present;  /* the board answered at the last probe */
static bool unknown;  /* at the last probe, something answered at 0x20 that is neither board */
static bool chips_up; /* DUT_5V on and the chips set up */
static int failures;
static uint32_t admissions;
static uint32_t sheds;
static int over_polls;
static int64_t shed_at;
static int64_t powered_at; /* the last DUT_5V / DATA_VIN on */
static struct gpio_callback alert_cb;
static K_MUTEX_DEFINE(lock);

static void setup_handler(struct k_work *work);
static void admit_handler(struct k_work *work);
static void poll_handler(struct k_work *work);
static void shed_handler(struct k_work *work);
static K_WORK_DELAYABLE_DEFINE(setup_work, setup_handler);
static K_WORK_DELAYABLE_DEFINE(admit_work, admit_handler);
static K_WORK_DELAYABLE_DEFINE(poll_work, poll_handler);
static K_WORK_DELAYABLE_DEFINE(shed_work, shed_handler);

static struct io *io_of(const struct port_cfg *c)
{
	for (int i = 0; i < nio; i++) {
		if (io[i].addr == c->io) {
			return &io[i];
		}
	}
	return NULL;
}

static int io_write(const struct io *x, uint8_t reg, uint16_t val)
{
	uint8_t buf[3] = {x->wide ? reg * 2 : reg, val & 0xFF, val >> 8};

	return i2c_write(bus, buf, x->wide ? 3 : 2, x->addr);
}

static int io_input(const struct io *x, uint16_t *val)
{
	uint8_t reg = IO_INPUT, buf[2] = {0};
	int ret = i2c_write_read(bus, x->addr, &reg, 1, buf, x->wide ? 2 : 1);

	*val = sys_get_le16(buf);
	return ret;
}

static int ina_read(uint8_t addr, uint8_t reg, uint16_t *val)
{
	uint8_t buf[2];
	int ret = i2c_write_read(bus, addr, &reg, 1, buf, sizeof(buf));

	if (ret == 0) {
		*val = sys_get_be16(buf);
	}
	return ret;
}

static int ina_write(uint8_t addr, uint8_t reg, uint16_t val)
{
	uint8_t buf[3] = {reg, val >> 8, val & 0xFF};

	return i2c_write(bus, buf, sizeof(buf), addr);
}

/* A port's VBUS and current (lock held, chips up) */
static int read_meter(int i, int32_t *mv, int32_t *ma)
{
	uint16_t shunt, vbus;
	int ret = ina_read(cfg[i].ina, INA_SHUNT, &shunt);

	if (ret == 0) {
		ret = ina_read(cfg[i].ina, INA_BUS, &vbus);
	}
	if (ret != 0) {
		return ret;
	}
	/* 2.5 uV/LSB across the shunt; 1.25 mV/LSB on the bus */
	*ma = (int32_t)((int64_t)(int16_t)shunt * 2500 / cfg[i].rshunt_uohm);
	*mv = vbus * 5 / 4;

	return 0;
}

/* What the ports that are on draw (lock held) */
static int32_t ports_ma(void)
{
	int32_t total = 0, mv, ma;

	for (int i = 0; i < nports; i++) {
		if (ports[i].on && read_meter(i, &mv, &ma) == 0) {
			total += MAX(ma, 0);
		}
	}
	return total;
}

/*
 * What the bay draws from DUT_5V (lock held): the node's INA226, or without
 * one (a stand-in, or it does not answer) the ports' sum plus
 * CONFIG_BAY_PORTS_BOARD_MA for the board itself.
 */
static int32_t bay_ma(void)
{
	uint8_t reg = INA_SHUNT, buf[2];

	if (meter.bus != NULL && i2c_write_read_dt(&meter, &reg, 1, buf, sizeof(buf)) == 0) {
		return MAX((int32_t)((int64_t)(int16_t)sys_get_be16(buf) * 2500 / METER_UOHM), 0);
	}
	return ports_ma() + CONFIG_BAY_PORTS_BOARD_MA;
}

/*
 * v1.0, what the bay draws from DATA_VIN, mW (lock held): the node's INA226,
 * or without it the ports and the board at 5 V through the converters.
 */
static int32_t bay_mw(void)
{
	uint8_t shunt = INA_SHUNT, bus_reg = INA_BUS, s[2], v[2];

	if (meter.bus != NULL && i2c_write_read_dt(&meter, &shunt, 1, s, sizeof(s)) == 0 &&
	    i2c_write_read_dt(&meter, &bus_reg, 1, v, sizeof(v)) == 0) {
		int64_t ma = MAX((int64_t)(int16_t)sys_get_be16(s) * 2500 / METER_UOHM, 0);

		return (int32_t)(ma * (sys_get_be16(v) * 5 / 4) / 1000);
	}
	return (ports_ma() + CONFIG_BAY_PORTS_BOARD_MA) * 5 * 100 / CONV_PCT;
}

/* What the bay draws, in its budget's unit: mA on DUT_5V, v1.0 mW on DATA_VIN */
static int32_t bay_draw(void)
{
	return EFUSE ? bay_mw() : bay_ma();
}

/* A port's draw in that unit, 0 unread (lock held, chips up) */
static int32_t port_draw(int i)
{
	int32_t mv, ma;

	if (read_meter(i, &mv, &ma) != 0) {
		return 0;
	}
	ma = MAX(ma, 0);
	return EFUSE ? (int32_t)((int64_t)mv * ma / 1000 * 100 / CONV_PCT) : ma;
}

/* What a port is switched on within: v1.0 the hub's grant, or the bay's own limit */
static int32_t budget_limit(bool *granted)
{
	struct rack_grant g;

	*granted = false;
	if (!EFUSE) {
		return CONFIG_BAY_PORTS_BUDGET_MA;
	}
	if (bay_rack_grant(&g)) {
		*granted = true;
		return g.mw;
	}
	return CONFIG_BAY_PORTS_LIMIT_MW;
}

static int32_t budget_reserve(void)
{
	return EFUSE ? CONFIG_BAY_PORTS_RESERVE_MW : CONFIG_BAY_PORTS_RESERVE_MA;
}

/*
 * Over the budget, the last port switched on goes (lock held): the first design over
 * CONFIG_BAY_PORTS_SHED_MA; v1.0 over the grant, or over that current on
 * DATA_VIN (the ALERT's level, below the eFuse's)
 */
static bool over_budget(int32_t *draw)
{
	bool granted;

	*draw = bay_draw();
	if (EFUSE) {
		return *draw > budget_limit(&granted) || bay_ma() > CONFIG_BAY_PORTS_SHED_MA;
	}
	return *draw > CONFIG_BAY_PORTS_SHED_MA;
}

static const char *unit(void)
{
	return EFUSE ? "mW" : "mA";
}

/* The node's INA226 ALERT while its shunt reads over CONFIG_BAY_PORTS_SHED_MA */
static void meter_setup(void)
{
	uint16_t limit = MIN((uint64_t)CONFIG_BAY_PORTS_SHED_MA * METER_UOHM / 2500, INT16_MAX);
	uint8_t lim[3] = {INA_LIMIT, limit >> 8, limit & 0xFF};
	uint8_t mask[3] = {INA_MASK, INA_SOL >> 8, INA_SOL & 0xFF};

	if (meter.bus == NULL || i2c_write_dt(&meter, lim, sizeof(lim)) != 0 ||
	    i2c_write_dt(&meter, mask, sizeof(mask)) != 0) {
		LOG_WRN("no ALERT from the node's INA226: the poll sheds");
	}
}

static int en_write(int i, bool on)
{
	struct io *x = io_of(&cfg[i]);

	WRITE_BIT(x->out, cfg[i].en, on);
	return io_write(x, IO_OUTPUT, x->out);
}

/* RESET or BOOT: an output (its register bit is 0) asserts it, an input releases it */
static int line_write(int i, uint8_t pin, bool asserted)
{
	struct io *x = io_of(&cfg[i]);

	if (pin == 0xFF) {
		return -ENOTSUP;
	}
	WRITE_BIT(x->cfg, pin, !asserted);
	return io_write(x, IO_CONFIG, x->cfg);
}

/* Switch a port on (lock held): the admission rule, its VBUS, then BOOT and RESET released */
static int port_on(int i, bool keep_boot)
{
	int32_t mv, ma;
	bool granted;
	int ret;

	if (!chips_up) {
		return -EAGAIN;
	}
	if (bay_draw() + MAX(budget_reserve(), ports[i].need) > budget_limit(&granted)) {
		return -EBUSY;
	}
	/* Sink-only, no CC detection: a VBUS already there is not ours to meet */
	ret = read_meter(i, &mv, &ma);
	if (ret != 0) {
		return ret;
	}
	if (mv > CONFIG_BAY_PORTS_VBUS_FOREIGN_MV) {
		if (!ports[i].refused) {
			LOG_WRN("port %u: VBUS %d mV while off, not switched on", cfg[i].slot, mv);
		}
		ports[i].foreign = true;
		return -EALREADY;
	}
	ports[i].foreign = false;
	/* A latched TPS2553-1 restarts on an EN low-to-high edge */
	if (ports[i].latched) {
		(void)en_write(i, false);
	}
	ret = en_write(i, true);
	if (ret != 0) {
		return ret;
	}
	ports[i].on = true;
	ports[i].latched = false;
	ports[i].refused = false;
	ports[i].shed = false;
	ports[i].need = 0;
	ports[i].seq = ++admissions;

	k_sleep(K_MSEC(RELEASE_MS));
	if (!keep_boot && cfg[i].bst != 0xFF) {
		ret = line_write(i, cfg[i].bst, false);
	}
	if (ret == 0 && cfg[i].rst != 0xFF) {
		ret = line_write(i, cfg[i].rst, false);
	}
#if defined(CONFIG_BAY_WIRES)
	/* Its pins back on their buses, now that it runs */
	if (ret == 0 && brd->logic) {
		wires_port(cfg[i].slot, true);
	}
#endif
	return ret;
}

/* A port off: RESET and BOOT asserted, then EN low (lock held) */
static int port_off(int i)
{
	struct io *x = io_of(&cfg[i]);
	int ret;

	ports[i].on = false;
#if defined(CONFIG_BAY_WIRES)
	/* Its pins off the buses while it still has power */
	if (brd->logic) {
		wires_port(cfg[i].slot, false);
	}
#endif
	if (!chips_up) {
		return 0;
	}
	if (cfg[i].rst != 0xFF) {
		WRITE_BIT(x->cfg, cfg[i].rst, 0);
	}
	if (cfg[i].bst != 0xFF) {
		WRITE_BIT(x->cfg, cfg[i].bst, 0);
	}
	ret = io_write(x, IO_CONFIG, x->cfg);
	if (ret == 0) {
		ret = en_write(i, false);
	}
	return ret;
}

#if HAS_MARK
/*
 * The expander's driver starts the first time the chip answers.  After
 * DUT_5V was off the chip starts from its defaults again: configuring MARK
 * writes its output and direction registers back from the driver's copy,
 * the crosspoints' pins with them (lock held).
 */
static void mx_setup(void)
{
	uint8_t in;

	if (i2c_reg_read_byte(bus, DT_REG_ADDR(DT_GPIO_CTLR(DT_NODELABEL(coproc), mark_gpios)),
			      IO_INPUT, &in) != 0) {
		return; /* no matrix: a base board */
	}
	if (!device_is_ready(mark_line.port) && device_init(mark_line.port) != 0) {
		LOG_ERR("DATA x4: the matrix expander's driver did not start");
		return;
	}
	(void)gpio_pin_configure_dt(&mark_line, marks > 0 ? GPIO_OUTPUT_ACTIVE : GPIO_OUTPUT_INACTIVE);
#if defined(CONFIG_BAY_WIRES)
	wires_matrix(true);
#endif
}
#endif

/* The board's expanders, as many as its ports use (lock held) */
static int ios_of(const struct board *b, struct io *out)
{
	int n = 0;

	for (int i = 0; i < b->nports; i++) {
		bool known = false;

		for (int k = 0; k < n; k++) {
			known |= out[k].addr == b->cfg[i].io;
		}
		if (!known) {
			if (n == IO_MAX) {
				return -EINVAL;
			}
			out[n++] = (struct io){.addr = b->cfg[i].io, .wide = b->cfg[i].wide};
		}
	}
	return n;
}

/* Another board than the last one: its ports, every one as at boot (lock held) */
static void use_board(const struct board *b)
{
	brd = b;
	cfg = b->cfg;
	nports = b->nports;
	nio = ios_of(b, io);
	for (int i = 0; i < MAX_PORTS; i++) {
		ports[i] = (struct port){.wanted = IS_ENABLED(CONFIG_BAY_PORTS_ON_AT_BOOT)};
	}
}

/*
 * Which board is on the lead (lock held): see the top of this file.  odd:
 * something answers at 0x20 but at neither board's own address.
 */
static const struct board *probe(bool *odd)
{
	uint8_t in;

	*odd = false;
	if (i2c_reg_read_byte(bus, SHARED_IO, IO_INPUT, &in) != 0) {
		return NULL;
	}
	for (int b = 0; b < ARRAY_SIZE(boards); b++) {
		if (i2c_reg_read_byte(bus, boards[b].ident, 0, &in) == 0) {
			return &boards[b];
		}
	}
	*odd = true;
	return NULL;
}

/* Probe and set up the board, every port off (lock held) */
static int setup_chips(void)
{
	bool odd;
	const struct board *b = probe(&odd);
	int ret = 0;

	present = b != NULL;
	unknown = odd;
	if (!present) {
		return odd ? -ENOTSUP : -ENODEV;
	}
	if (b != brd) {
		use_board(b);
	}

	for (int k = 0; k < nio && ret == 0; k++) {
		struct io *x = &io[k];
		uint16_t used = 0;

		/* Output register 0, then EN, RESET and BOOT outputs: off, both lines asserted */
		x->out = 0;
		x->cfg = x->wide ? 0xFFFF : 0xFF;
		for (int i = 0; i < nports; i++) {
			if (cfg[i].io == x->addr) {
				x->cfg &= ~BIT(cfg[i].en);
				x->cfg &= cfg[i].rst != 0xFF ? ~BIT(cfg[i].rst) : 0xFFFF;
				x->cfg &= cfg[i].bst != 0xFF ? ~BIT(cfg[i].bst) : 0xFFFF;
				used |= BIT(cfg[i].en) | BIT(cfg[i].flt);
				used |= (cfg[i].rst != 0xFF ? BIT(cfg[i].rst) : 0) |
					(cfg[i].bst != 0xFF ? BIT(cfg[i].bst) : 0);
			}
		}
		/* The lines no port uses (a DATA x6's P14-P17, pulled down): outputs, low */
		x->cfg &= used;
		ret = io_write(x, IO_OUTPUT, x->out);
		if (ret == 0) {
			ret = io_write(x, IO_POLARITY, 0);
		}
		if (ret == 0) {
			ret = io_write(x, IO_CONFIG, x->cfg);
		}
	}
	for (int i = 0; i < nports && ret == 0; i++) {
		ret = ina_write(cfg[i].ina, INA_CONFIG, INA_CONFIG_VALUE);
		ports[i].on = false;
	}
	if (ret != 0) {
		LOG_ERR("%s set-up failed (%d)", brd->name, ret);
		return ret;
	}
#if HAS_MARK
	if (brd->logic) {
		mx_setup();
	}
#endif
	meter_setup();

	chips_up = true;
	failures = 0;
	return 0;
}

static void setup_handler(struct k_work *work)
{
	static bool said_odd;
	bool had = present;
	int ret;

	ARG_UNUSED(work);

	if (!dut_power_get()) {
		return;
	}

	k_mutex_lock(&lock, K_FOREVER);
	ret = setup_chips();
	k_mutex_unlock(&lock);

	if (ret == -ENOTSUP && !said_odd) {
		LOG_ERR("a board answers at 0x%02x, but neither as a DATA x4 nor as a DATA x6: "
			"left alone", SHARED_IO);
	}
	said_odd = ret == -ENOTSUP;
	if (ret == 0) {
		LOG_INF("%s: %d ports, every port off; switching on the wanted ones", brd->name,
			nports);
		k_work_reschedule(&admit_work, K_NO_WAIT);
		k_work_reschedule(&poll_work, K_MSEC(CONFIG_BAY_PORTS_POLL_MS));
	} else if (EFUSE) {
		/* No one-port node on v1.0: no board, no DATA_VIN */
		if (k_uptime_get() - powered_at < CONFIG_BAY_DATA_ANSWER_MS) {
			k_work_reschedule(&setup_work, K_MSEC(ANSWER_TRY_MS));
		} else {
			dut_lead_lost(DUT_LEAD_NO_BOARD);
		}
	} else {
		if (had) {
			LOG_WRN("%s not answering: a one-port node until it does", brd->name);
		}
		k_work_reschedule(&setup_work, K_MSEC(REPROBE_MS));
	}
}

/* The wanted ports on, one per CONFIG_BAY_PORTS_STAGGER_MS */
static void admit_handler(struct k_work *work)
{
	int next = -1, ret = 0;
	bool more = false, said = false, granted = false, queued = false;
	int32_t bay = 0, limit = 0;

	ARG_UNUSED(work);

	k_mutex_lock(&lock, K_FOREVER);
	for (int i = 0; i < nports && chips_up; i++) {
		if (ports[i].wanted && !ports[i].on && !ports[i].latched) {
			if (next < 0) {
				next = i;
			} else {
				more = true;
			}
		}
	}
	if (next >= 0) {
		queued = ports[next].queued;
		ret = port_on(next, false);
		if (ret == 0) {
			ports[next].queued = false;
		}
		if ((ret == -EBUSY || ret == -EALREADY) && !ports[next].refused) {
			ports[next].refused = true;
			said = ret == -EBUSY;
			bay = bay_draw();
			limit = budget_limit(&granted);
		}
	}
	k_mutex_unlock(&lock);

	if (next < 0) {
		return;
	}
	if (ret == 0) {
		LOG_INF("port %u on%s", cfg[next].slot, queued ? ": its queued request started" : "");
	} else if (said) {
		LOG_WRN("port %u waits for power: the bay draws %d %s (budget %d %s%s)", cfg[next].slot,
			bay, unit(), limit, unit(), granted ? ", the hub's grant" : "");
	}
	if (ret != 0 || more) {
		k_work_reschedule(&admit_work,
				  K_MSEC(ret == -EBUSY || ret == -EALREADY ? REFUSED_MS
									 : CONFIG_BAY_PORTS_STAGGER_MS));
	}
}

/*
 * The bay over its budget (over_budget()): the last port switched on goes
 * off, still wanted (it comes back once the budget has room for what it
 * drew), and the bay is read again once the meter has a new average.
 */
static void shed_handler(struct k_work *work)
{
	int32_t bay = 0, drew = 0;
	bool over = false;
	int64_t wait;
	int last = -1;

	ARG_UNUSED(work);

	k_mutex_lock(&lock, K_FOREVER);
	wait = shed_at + SHED_MS - k_uptime_get();
	if (wait > 0) {
		k_mutex_unlock(&lock);
		k_work_reschedule(&shed_work, K_MSEC(wait));
		return;
	}
	if (chips_up) {
		over = over_budget(&bay);
	}
	for (int i = 0; i < nports && over; i++) {
		if (ports[i].on && (last < 0 || ports[i].seq > ports[last].seq)) {
			last = i;
		}
	}
	if (last >= 0) {
		drew = port_draw(last);
		(void)port_off(last);
		ports[last].need = drew;
		ports[last].refused = false;
		ports[last].shed = true;
		sheds++;
		over_polls = 0;
		shed_at = k_uptime_get();
	}
	k_mutex_unlock(&lock);

	if (last < 0) {
		return;
	}
	LOG_WRN("the bay draws %d %s, over its budget: port %u shed (it drew %d %s) until there is "
		"room", bay, unit(), cfg[last].slot, drew, unit());
	k_work_reschedule(&shed_work, K_MSEC(SHED_MS));
	k_work_reschedule(&admit_work, K_MSEC(REFUSED_MS));
}

static void alert_isr(const struct device *dev, struct gpio_callback *cb, uint32_t pins)
{
	ARG_UNUSED(dev);
	ARG_UNUSED(cb);
	ARG_UNUSED(pins);

	k_work_reschedule(&shed_work, K_NO_WAIT);
}

/* ~FAULT of the ports that are on, whether the board still answers, the bay's draw */
static void poll_handler(struct k_work *work)
{
	uint16_t in[IO_MAX];
	int ret = 0;
	bool gone = false, over = false;
	int32_t draw;
	uint32_t tripped = 0;

	ARG_UNUSED(work);

	k_mutex_lock(&lock, K_FOREVER);
	if (!chips_up) {
		k_mutex_unlock(&lock);
		return;
	}
	for (int k = 0; k < nio && ret == 0; k++) {
		ret = io_input(&io[k], &in[k]);
	}
	if (ret != 0) {
		gone = ++failures >= FAIL_LIMIT;
		if (gone) {
#if defined(CONFIG_BAY_WIRES)
			wires_matrix(false);
#endif
			chips_up = false;
			present = false;
			for (int i = 0; i < nports; i++) {
				ports[i].on = false;
			}
		}
	} else {
		failures = 0;
		for (int i = 0; i < nports; i++) {
			const struct io *x = io_of(&cfg[i]);
			bool flt = (in[x - io] & BIT(cfg[i].flt)) == 0; /* ~FAULT, active low */

			if (ports[i].on && flt) {
				(void)port_off(i);
				ports[i].latched = true;
				ports[i].faults++;
				tripped |= BIT(i);
			}
		}
		/* v1.0: two polls over the grant in a row, a start's surge is not shed */
		over_polls = over_budget(&draw) ? over_polls + 1 : 0;
		over = over_polls >= OVER_POLLS;
	}
	k_mutex_unlock(&lock);

	for (int i = 0; i < nports; i++) {
		if (tripped & BIT(i)) {
			LOG_ERR("port %u in current limit: off (\"on\" again to retry)", cfg[i].slot);
		}
	}
	if (gone) {
		LOG_ERR("%s stopped answering: its ports are off", brd->name);
		if (EFUSE) {
			dut_lead_lost(DUT_LEAD_BOARD_GONE);
		} else {
			k_work_reschedule(&setup_work, K_MSEC(REPROBE_MS));
		}
		return;
	}
	if (over) {
		k_work_reschedule(&shed_work, K_NO_WAIT);
	}
	k_work_reschedule(&poll_work, K_MSEC(CONFIG_BAY_PORTS_POLL_MS));
}

void ports_dut_power(bool on)
{
	if (on) {
		powered_at = k_uptime_get();
		k_work_reschedule(&setup_work, K_MSEC(CONFIG_BAY_PORTS_SETTLE_MS));
		return;
	}

	/* DUT_5V goes off: every EN low while the chips still answer, then hands off */
	k_work_cancel_delayable(&setup_work);
	k_work_cancel_delayable(&admit_work);
	k_work_cancel_delayable(&shed_work);
	k_mutex_lock(&lock, K_FOREVER);
#if defined(CONFIG_BAY_WIRES)
	/* Every switch open while the chips still answer */
	wires_matrix(false);
#endif
	if (chips_up) {
		for (int k = 0; k < nio; k++) {
			io[k].out = 0;
			(void)io_write(&io[k], IO_OUTPUT, 0);
		}
	}
	for (int i = 0; i < nports; i++) {
		ports[i].on = false;
		ports[i].shed = false;
		ports[i].need = 0;
	}
	chips_up = false;
	over_polls = 0;
	k_mutex_unlock(&lock);
}

int ports_init(void)
{
	struct io check[IO_MAX];

	if (!device_is_ready(bus)) {
		return -ENODEV;
	}

	for (int b = 0; b < ARRAY_SIZE(boards); b++) {
		if (ios_of(&boards[b], check) < 0) {
			return -EINVAL;
		}
	}
	for (int i = 0; i < MAX_PORTS; i++) {
		ports[i].wanted = IS_ENABLED(CONFIG_BAY_PORTS_ON_AT_BOOT);
	}
	/* The node's INA226 ALERT (IO39): the bay over CONFIG_BAY_PORTS_SHED_MA */
	if (meter_alert.port != NULL && gpio_is_ready_dt(&meter_alert) &&
	    gpio_pin_configure_dt(&meter_alert, GPIO_INPUT) == 0) {
		gpio_init_callback(&alert_cb, alert_isr, BIT(meter_alert.pin));
		if (gpio_add_callback_dt(&meter_alert, &alert_cb) == 0) {
			(void)gpio_pin_interrupt_configure_dt(&meter_alert, GPIO_INT_EDGE_TO_ACTIVE);
		}
	}
	/* DUT_5V is on (dut_init keeps it so): look for the board */
	k_work_reschedule(&setup_work, K_MSEC(CONFIG_BAY_PORTS_SETTLE_MS));

	return 0;
}

int ports_count(void)
{
	return present ? nports : 0;
}

enum data_board ports_board(void)
{
	const struct board *b = brd;

	return present && b != NULL ? b->kind : unknown ? DATA_UNKNOWN : DATA_NONE;
}

/* Wanted, off, not in a fault and not waiting for a foreign VBUS to go (lock held) */
static bool waiting(int i)
{
	return chips_up && ports[i].wanted && !ports[i].on && !ports[i].latched && !ports[i].foreign;
}

int ports_waiting(void)
{
	int n = 0;

	k_mutex_lock(&lock, K_FOREVER);
	for (int i = 0; i < nports; i++) {
		n += waiting(i);
	}
	k_mutex_unlock(&lock);

	return n;
}

int ports_budget(struct ports_budget *pb)
{
	*pb = (struct ports_budget){.power = EFUSE};
	k_mutex_lock(&lock, K_FOREVER);
	pb->limit = budget_limit(&pb->granted);
	pb->reserve = budget_reserve();
	pb->draw = chips_up ? bay_draw() : 0;
	for (int i = 0; i < nports; i++) {
		pb->waiting += waiting(i);
	}
	pb->sheds = sheds;
	k_mutex_unlock(&lock);

	return present ? 0 : -ENODEV;
}

static int index_of(int slot)
{
	if (!present) {
		return slot >= 1 && slot <= MAX_PORTS ? -ENODEV : -ENOENT;
	}
	for (int i = 0; i < nports; i++) {
		if (cfg[i].slot == slot) {
			return i;
		}
	}
	return -ENOENT;
}

int ports_info(int slot, struct port_info *pi)
{
	int i = index_of(slot);

	if (i < 0) {
		return i;
	}

	*pi = (struct port_info){.slot = cfg[i].slot, .hub_port = cfg[i].hub_port,
				 .lines = cfg[i].rst != 0xFF || cfg[i].bst != 0xFF};
	k_mutex_lock(&lock, K_FOREVER);
	pi->on = ports[i].on;
	pi->wanted = ports[i].wanted;
	pi->latched = ports[i].latched;
	pi->waiting = waiting(i);
	pi->shed = ports[i].shed;
	pi->queued = ports[i].queued && !ports[i].on;
	pi->faults = ports[i].faults;
	pi->meter = ports[i].on && read_meter(i, &pi->mv, &pi->ma) == 0;
	k_mutex_unlock(&lock);
	pi->mw = pi->meter ? pi->mv * pi->ma / 1000 : 0;
	pi->usb = usb_host_port_device(cfg[i].hub_port, &pi->vid, &pi->pid) == 0;

	return 0;
}

static int power_on(int slot, int32_t *others, bool keep_boot)
{
	int i = index_of(slot);
	int ret;

	if (i < 0) {
		return i;
	}

	k_mutex_lock(&lock, K_FOREVER);
	ret = ports[i].on ? 0 : port_on(i, keep_boot);
	/*
	 * Refused by the budget: not wanted either, it would come on behind the
	 * caller's back (unless a queued request asked for that).  VBUS still
	 * up: wanted, on once it has dropped.
	 */
	ports[i].wanted = ret == 0 || ret == -EALREADY || ports[i].queued;
	ports[i].refused = ret == -EALREADY;
	if (ret == 0) {
		ports[i].queued = false;
	}
	if (!ports[i].wanted) {
		ports[i].shed = false;
	}
	if (ret == -EBUSY && others != NULL) {
		*others = bay_draw();
	}
	k_mutex_unlock(&lock);

	if (ret == -EALREADY) {
		k_work_reschedule(&admit_work, K_MSEC(REFUSED_MS));
	}
	LOG_INF("port %d on%s", slot, ret == 0 ? "" : ": refused");
	return ret;
}

int ports_power_wait(int slot)
{
	int i = index_of(slot);
	int ret;

	if (i < 0) {
		return i;
	}

	k_mutex_lock(&lock, K_FOREVER);
	ret = ports[i].on ? 0 : port_on(i, false);
	if (ret == 0) {
		ports[i].wanted = true;
		ports[i].queued = false;
	} else if (ret == -EBUSY || ret == -EAGAIN || ret == -EALREADY) {
		/* No room yet, the board not set up, or a foreign VBUS: in its turn */
		ports[i].wanted = true;
		ports[i].queued = true;
		ports[i].refused = ret == -EALREADY;
		ret = -EINPROGRESS;
	}
	k_mutex_unlock(&lock);

	if (ret == -EINPROGRESS) {
		LOG_INF("port %d queued: on as soon as the bay's budget has room", slot);
		k_work_reschedule(&admit_work, K_MSEC(REFUSED_MS));
	} else {
		LOG_INF("port %d on%s", slot, ret == 0 ? "" : ": refused");
	}
	return ret;
}

int ports_power_cancel(int slot)
{
	int i = index_of(slot);
	bool was;

	if (i < 0) {
		return i;
	}

	k_mutex_lock(&lock, K_FOREVER);
	was = ports[i].queued && !ports[i].on;
	if (was) {
		ports[i].queued = false;
		ports[i].wanted = false;
		ports[i].shed = false;
		ports[i].need = 0;
	}
	k_mutex_unlock(&lock);

	if (was) {
		LOG_INF("port %d: its queued request cancelled", slot);
	}
	return was ? 0 : -EALREADY;
}

int ports_power(int slot, bool on, int32_t *others)
{
	int i = index_of(slot);
	bool queued;
	int ret;

	if (on) {
		return power_on(slot, others, false);
	}
	if (i < 0) {
		return i;
	}

	k_mutex_lock(&lock, K_FOREVER);
	queued = ports[i].queued && !ports[i].on;
	ports[i].wanted = false;
	ports[i].queued = false;
	ports[i].shed = false;
	ports[i].foreign = false;
	ports[i].need = 0;
	ret = port_off(i);
	k_mutex_unlock(&lock);

	LOG_INF("port %d off%s", slot, queued ? ": its queued request cancelled" : "");
	return ret;
}

#if HAS_MARK
static void mark(bool up)
{
	k_mutex_lock(&lock, K_FOREVER);
	marks += up ? 1 : -1;
	if (chips_up && brd->logic && marks == (up ? 1 : 0) && device_is_ready(mark_line.port)) {
		(void)gpio_pin_set_dt(&mark_line, up);
	}
	k_mutex_unlock(&lock);
}
#else
static void mark(bool up)
{
	ARG_UNUSED(up);
}
#endif

/* Off for off_time, then until its VBUS reads under CONFIG_BAY_PORTS_VBUS_OFF_MV (or the timeout) */
static int power_cycle(int slot, k_timeout_t off_time, int32_t *others, bool keep_boot)
{
	int i = index_of(slot);
	int64_t until;
	int32_t mv = 0, ma;
	int ret = ports_power(slot, false, NULL);

	if (ret != 0) {
		return ret;
	}
	mark(true);
	k_sleep(off_time);

	until = k_uptime_get() + CONFIG_BAY_PORTS_DISCHARGE_MS;
	do {
		k_mutex_lock(&lock, K_FOREVER);
		ret = chips_up ? read_meter(i, &mv, &ma) : -EAGAIN;
		k_mutex_unlock(&lock);
		if (ret != 0 || mv < CONFIG_BAY_PORTS_VBUS_OFF_MV) {
			break;
		}
		k_sleep(K_MSEC(10));
	} while (k_uptime_get() < until);
	if (ret == 0 && mv >= CONFIG_BAY_PORTS_VBUS_OFF_MV) {
		LOG_INF("port %d: VBUS still %d mV after %d ms off (nothing on it?)", slot, mv,
			CONFIG_BAY_PORTS_DISCHARGE_MS);
	}

	ret = power_on(slot, others, keep_boot);
	mark(false);

	return ret;
}

int ports_power_cycle(int slot, k_timeout_t off_time, int32_t *others)
{
	return power_cycle(slot, off_time, others, false);
}

/* RESET or BOOT of a port that is on: an off port holds both asserted */
static int line_set(int slot, bool reset, bool asserted)
{
	int i = index_of(slot);
	int ret;

	if (i < 0) {
		return i;
	}
	k_mutex_lock(&lock, K_FOREVER);
	ret = chips_up && ports[i].on ? line_write(i, reset ? cfg[i].rst : cfg[i].bst, asserted)
				      : -EAGAIN;
	k_mutex_unlock(&lock);

	return ret;
}

int ports_reset_pulse(int slot, k_timeout_t width)
{
	int ret = line_set(slot, true, true);

	if (ret != 0) {
		return ret;
	}
	mark(true);
	k_sleep(width);
	ret = line_set(slot, true, false);
	mark(false);

	return ret;
}

int ports_boot(int slot, bool power_cycle_it, int32_t *others)
{
	int ret;

	/* BOOT held across a power cycle of the port (off asserts it), or across a RESET pulse */
	if (power_cycle_it) {
		ret = power_cycle(slot, K_NO_WAIT, others, true);
	} else {
		ret = line_set(slot, false, true);
		if (ret != 0) {
			return ret;
		}
		ret = ports_reset_pulse(slot, K_MSEC(CONFIG_BAY_RESET_PULSE_MS));
	}
	k_sleep(K_MSEC(CONFIG_BAY_BOOTLOADER_HOLD_MS));
	(void)line_set(slot, false, false);

	return ret;
}

#else /* no DATA board in the devicetree: a one-port node */

void ports_dut_power(bool on)
{
	ARG_UNUSED(on);
}

int ports_init(void)
{
	return 0;
}

int ports_count(void)
{
	return 0;
}

enum data_board ports_board(void)
{
	return DATA_NONE;
}

int ports_waiting(void)
{
	return 0;
}

int ports_budget(struct ports_budget *pb)
{
	ARG_UNUSED(pb);
	return -ENOENT;
}

int ports_info(int slot, struct port_info *pi)
{
	ARG_UNUSED(slot);
	ARG_UNUSED(pi);
	return -ENOENT;
}

int ports_power(int slot, bool on, int32_t *others)
{
	ARG_UNUSED(slot);
	ARG_UNUSED(on);
	ARG_UNUSED(others);
	return -ENOENT;
}

int ports_power_cycle(int slot, k_timeout_t off_time, int32_t *others)
{
	ARG_UNUSED(slot);
	ARG_UNUSED(off_time);
	ARG_UNUSED(others);
	return -ENOENT;
}

int ports_power_wait(int slot)
{
	ARG_UNUSED(slot);
	return -ENOENT;
}

int ports_power_cancel(int slot)
{
	ARG_UNUSED(slot);
	return -ENOENT;
}

int ports_reset_pulse(int slot, k_timeout_t width)
{
	ARG_UNUSED(slot);
	ARG_UNUSED(width);
	return -ENOENT;
}

int ports_boot(int slot, bool power_cycle, int32_t *others)
{
	ARG_UNUSED(slot);
	ARG_UNUSED(power_cycle);
	ARG_UNUSED(others);
	return -ENOENT;
}

#endif
