kartben/hw-testing-rack/firmware/bay-node/src/web.c

/*
 * Web page, JSON API and Prometheus metrics (Zephyr HTTP server, port 80).
 *
 *   GET  /             status page (web/index.html, gzipped into the image)
 *   GET  /api/status   node state as JSON
 *   POST /api/power    {"action": "on" | "off" | "cycle", "ms": 1000}
 *   POST /api/reset    {"ms": 100}
 *   POST /api/boot     {}                 DUT into its bootloader
 *   GET  /api/ports    the boards: a DATA x4's four ports, or the one DUT as port 1
 *   GET  /api/usb      the USB devices: names, classes, serial numbers, ttys, USB/IP clients
 *   GET  /api/boards   each slot's Zephyr board target, and the device in it (boards.c)
 *   GET  /api/ports/<n>/board, PUT {"board": "nucleo_g474re", "runner": "...",
 *                      "probe_id": "...", "console": "usb" | "usb:02" | "aux" | "none",
 *                      "map": true, "pin": {"vid", "pid", "serial"}}   one slot's;
 *                      no board clears it.  n is 1 on a one-board node.
 *   GET  /board-targets.json   the targets the page suggests (mechanical/boards/boards.yaml)
 *   POST /api/ports/<n>/power, /reset, /boot   one port, as above; boot takes
 *                      {"power_cycle": true}: BOOT held across a power cycle
 *                      of the port.  409 when the bay's budget has no room.
 *                      On a DATA x4 node /api/power, /reset and /boot need
 *                      "port": n (409 without).
 *   POST /api/mode     {"mode": "usbip" | "classic"}
 *   GET  /metrics      Prometheus exposition format
 *
 *   GET  /api/aux        AUX UART settings and clients
 *   POST /api/aux        {"baud": 115200, "data_bits": 8, "parity": "none",
 *                         "stop_bits": 1, "enter": "cr" | "lf" | "crlf",
 *                         "echo": false, "esptool_reset": false}  (any subset, saved)
 *   POST /api/aux/break  {"ms": 250}
 *   POST /api/console/ticket             a ticket for the next WebSocket
 *   GET  /console/ws/<n>?t=<ticket>      WebSocket to the AUX UART (see aux_console.c)
 *   GET  /xterm.mjs, /xterm.css, /addon-fit.mjs, /xterm-LICENSE.txt  vendored xterm.js
 *
 *   GET  /api/access          rights of the caller, lease, connections (admin: rules, refusals)
 *   POST /api/lease           {"ttl_s": 3600, "note": "..."} | {"release": true}
 *   GET  /api/access/nonce    single-use nonce for an admin request
 *   POST /api/access/claim    {} | {"key": "<hex>"}, then {"ticket": "<hex>"} until claimed
 *   POST /api/access/rules    admin: {"enabled": true, "everyone": ["status"],
 *                              "sources": [{"name": "ci", "cidr": "10.0.4.0/28",
 *                                           "allow": ["status", "control", ...]}]}
 *   POST /api/access/kick     admin: {"id": "usbip:51234"}
 *   POST /api/access/key      admin: {"key": "<64 hex>"} (a new key)
 *
 *   GET  /api/camera          the camera, its settings and their choices
 *   POST /api/camera          {"resolution": "640x480", "exposure": "auto" | 1200,
 *                              "brightness": -1, "reset": true, ...}  (any subset, saved;
 *                              the names: camera.c, camera_configure())
 *   (the pictures are on their own port: camera.c)
 *
 * Every POST of an action answers with the new /api/status document, errors
 * with {"error": "..."} and a 4xx/5xx status.  Each request needs the right
 * for what it does (access.c): status to read, control for power, reset,
 * boot, mode, the board targets and the camera's settings, console for the console and its
 * settings; 403 when the rules refuse it, 423 while another address holds
 * the lease.  Admin requests are signed (X-Bay-Auth, see access.c).
 *
 * SPDX-License-Identifier: Apache-2.0
 */

#include <stdio.h>
#include <string.h>
#include <strings.h>

#include <zephyr/kernel.h>
#include <zephyr/version.h>
#include <zephyr/data/json.h>
#include <zephyr/net/hostname.h>
#include <zephyr/net/net_ip.h>
#include <zephyr/net/http/server.h>
#include <zephyr/net/http/service.h>
#include <zephyr/net/prometheus/collector.h>
#include <zephyr/net/prometheus/counter.h>
#include <zephyr/net/prometheus/formatter.h>
#include <zephyr/net/prometheus/gauge.h>
#include <zephyr/logging/log.h>

#include <hwtr/update.h>
#include <hwtr/web.h>

#include "bay.h"

LOG_MODULE_REGISTER(web, CONFIG_BAY_LOG_LEVEL);

/* Longest the HTTP server thread may be held by a power cycle or a reset */
#define MAX_ACTION_MS 10000

/* --- /api/status --------------------------------------------------------- */

struct status_usb {
	bool running;
	int32_t devices;
	int32_t sessions;
};

struct status_dut {
	bool on;
	bool fault;
	bool latched;
	bool meter;
	int32_t faults;
	int32_t mv;
	int32_t ma;
	int32_t mw;
};

struct status_aux {
	int32_t baud;
	const char *format; /* "8N1" */
	int32_t port;       /* raw TCP */
	int32_t rfc2217_port;
	int32_t web_clients;
	bool rfc2217;
	bool raw;
	int32_t rx;
	int32_t tx;
	int32_t dropped;
	char format_buf[4];
};

struct status_lease {
	const char *holder; /* "" when none */
	const char *note;
	int32_t remaining_s;
	bool yours;
};

struct status_access {
	bool enabled;
	bool claimed;
	const char *you;
	const char *allow[ACL_SERVICES];
	size_t allow_len;
	int32_t refused;
	struct status_lease lease;
};

/* Rack bus: the position the hub gave, its contract */
struct status_rack {
	int32_t node;    /* row x 16 + position, 0: none */
	const char *pos; /* "C3" */
	bool hub;        /* the hub's RACK frame is coming */
	int32_t hub_mv;
	bool hub_epr;
	int32_t rows_on;
};

struct status_doc {
	const char *id;
	const char *hostname;
	const char *ip;
	const char *version;
	const char *path;
	int32_t uptime_s;
	const char *last_fault;
	bool service;
	bool pc_detected;
	bool force_classic;
	struct status_usb usb;
	struct status_dut dut;
	struct status_aux aux;
	struct status_access access;
	struct status_rack rack;
	/* Storage for the strings above */
	char you_buf[ACL_IP_STR_LEN];
	char holder_buf[ACL_IP_STR_LEN];
	struct acl_lease lease;
};

static const struct json_obj_descr status_usb_descr[] = {
	JSON_OBJ_DESCR_PRIM(struct status_usb, running, JSON_TOK_TRUE),
	JSON_OBJ_DESCR_PRIM(struct status_usb, devices, JSON_TOK_NUMBER),
	JSON_OBJ_DESCR_PRIM(struct status_usb, sessions, JSON_TOK_NUMBER),
};

static const struct json_obj_descr status_dut_descr[] = {
	JSON_OBJ_DESCR_PRIM(struct status_dut, on, JSON_TOK_TRUE),
	JSON_OBJ_DESCR_PRIM(struct status_dut, fault, JSON_TOK_TRUE),
	JSON_OBJ_DESCR_PRIM(struct status_dut, latched, JSON_TOK_TRUE),
	JSON_OBJ_DESCR_PRIM(struct status_dut, meter, JSON_TOK_TRUE),
	JSON_OBJ_DESCR_PRIM(struct status_dut, faults, JSON_TOK_NUMBER),
	JSON_OBJ_DESCR_PRIM(struct status_dut, mv, JSON_TOK_NUMBER),
	JSON_OBJ_DESCR_PRIM(struct status_dut, ma, JSON_TOK_NUMBER),
	JSON_OBJ_DESCR_PRIM(struct status_dut, mw, JSON_TOK_NUMBER),
};

static const struct json_obj_descr status_aux_descr[] = {
	JSON_OBJ_DESCR_PRIM(struct status_aux, baud, JSON_TOK_NUMBER),
	JSON_OBJ_DESCR_PRIM(struct status_aux, format, JSON_TOK_STRING),
	JSON_OBJ_DESCR_PRIM(struct status_aux, port, JSON_TOK_NUMBER),
	JSON_OBJ_DESCR_PRIM(struct status_aux, rfc2217_port, JSON_TOK_NUMBER),
	JSON_OBJ_DESCR_PRIM(struct status_aux, web_clients, JSON_TOK_NUMBER),
	JSON_OBJ_DESCR_PRIM(struct status_aux, rfc2217, JSON_TOK_TRUE),
	JSON_OBJ_DESCR_PRIM(struct status_aux, raw, JSON_TOK_TRUE),
	JSON_OBJ_DESCR_PRIM(struct status_aux, rx, JSON_TOK_NUMBER),
	JSON_OBJ_DESCR_PRIM(struct status_aux, tx, JSON_TOK_NUMBER),
	JSON_OBJ_DESCR_PRIM(struct status_aux, dropped, JSON_TOK_NUMBER),
};

static const struct json_obj_descr status_lease_descr[] = {
	JSON_OBJ_DESCR_PRIM(struct status_lease, holder, JSON_TOK_STRING),
	JSON_OBJ_DESCR_PRIM(struct status_lease, note, JSON_TOK_STRING),
	JSON_OBJ_DESCR_PRIM(struct status_lease, remaining_s, JSON_TOK_NUMBER),
	JSON_OBJ_DESCR_PRIM(struct status_lease, yours, JSON_TOK_TRUE),
};

static const struct json_obj_descr status_access_descr[] = {
	JSON_OBJ_DESCR_PRIM(struct status_access, enabled, JSON_TOK_TRUE),
	JSON_OBJ_DESCR_PRIM(struct status_access, claimed, JSON_TOK_TRUE),
	JSON_OBJ_DESCR_PRIM(struct status_access, you, JSON_TOK_STRING),
	JSON_OBJ_DESCR_ARRAY(struct status_access, allow, ACL_SERVICES, allow_len, JSON_TOK_STRING),
	JSON_OBJ_DESCR_PRIM(struct status_access, refused, JSON_TOK_NUMBER),
	JSON_OBJ_DESCR_OBJECT(struct status_access, lease, status_lease_descr),
};

static const struct json_obj_descr status_rack_descr[] = {
	JSON_OBJ_DESCR_PRIM(struct status_rack, node, JSON_TOK_NUMBER),
	JSON_OBJ_DESCR_PRIM(struct status_rack, pos, JSON_TOK_STRING),
	JSON_OBJ_DESCR_PRIM(struct status_rack, hub, JSON_TOK_TRUE),
	JSON_OBJ_DESCR_PRIM(struct status_rack, hub_mv, JSON_TOK_NUMBER),
	JSON_OBJ_DESCR_PRIM(struct status_rack, hub_epr, JSON_TOK_TRUE),
	JSON_OBJ_DESCR_PRIM(struct status_rack, rows_on, JSON_TOK_NUMBER),
};

static const struct json_obj_descr status_descr[] = {
	JSON_OBJ_DESCR_PRIM(struct status_doc, id, JSON_TOK_STRING),
	JSON_OBJ_DESCR_PRIM(struct status_doc, hostname, JSON_TOK_STRING),
	JSON_OBJ_DESCR_PRIM(struct status_doc, ip, JSON_TOK_STRING),
	JSON_OBJ_DESCR_PRIM(struct status_doc, version, JSON_TOK_STRING),
	JSON_OBJ_DESCR_PRIM(struct status_doc, path, JSON_TOK_STRING),
	JSON_OBJ_DESCR_PRIM(struct status_doc, uptime_s, JSON_TOK_NUMBER),
	JSON_OBJ_DESCR_PRIM(struct status_doc, last_fault, JSON_TOK_STRING),
	JSON_OBJ_DESCR_PRIM(struct status_doc, service, JSON_TOK_TRUE),
	JSON_OBJ_DESCR_PRIM(struct status_doc, pc_detected, JSON_TOK_TRUE),
	JSON_OBJ_DESCR_PRIM(struct status_doc, force_classic, JSON_TOK_TRUE),
	JSON_OBJ_DESCR_OBJECT(struct status_doc, usb, status_usb_descr),
	JSON_OBJ_DESCR_OBJECT(struct status_doc, dut, status_dut_descr),
	JSON_OBJ_DESCR_OBJECT(struct status_doc, aux, status_aux_descr),
	JSON_OBJ_DESCR_OBJECT(struct status_doc, access, status_access_descr),
	JSON_OBJ_DESCR_OBJECT(struct status_doc, rack, status_rack_descr),
};

/*
 * Responses are built in the HTTP server thread, one at a time (/metrics too).
 * A DATA x4 bay's status with its camera, co-processor and analyzer comes
 * near 3 KB; a DATA x6's six ports, each leased with a note, take some 2 KB.
 * With PSRAM it costs no DRAM.
 */
static BAY_EXT_RAM char resp_buf[IS_ENABLED(CONFIG_ESP_SPIRAM)     ? 6144
				 : IS_ENABLED(CONFIG_BAY_ANALYZER) ? 4096
								   : 3072];

/* X-Bay-Auth, kept from the first callback of a request */
HWTR_WEB_AUTH_CAPTURE(bay_auth_header);

static void capture_auth(const struct http_request_ctx *req, char *out, size_t size)
{
	if (req->headers_status == HTTP_HEADER_STATUS_NONE) {
		return;
	}
	out[0] = '\0';
	for (size_t i = 0; i < req->header_count; i++) {
		if (strcasecmp(req->headers[i].name, "X-Bay-Auth") == 0) {
			strncpy(out, req->headers[i].value, size - 1);
			out[size - 1] = '\0';
		}
	}
}

#if defined(CONFIG_BAY_CAMERA)
/* A setting's value in JSON: numbers as they are, words quoted */
static bool is_number(const char *s)
{
	if (*s == '-') {
		s++;
	}
	if (*s == '\0') {
		return false;
	}
	for (; *s != '\0'; s++) {
		if (*s < '0' || *s > '9') {
			return false;
		}
	}
	return true;
}

/*
 * The camera object: in /api/status; in /api/camera with its settings and
 * what they may be set to
 */
static int camera_json(char *buf, size_t size, bool full)
{
	struct camera_status st;
	const char *name;
	char value[16];
	size_t len;
	int n;

	camera_status(&st);
	n = snprintf(buf, size,
		     "{\"present\":%s,\"model\":\"%s\",\"port\":%u,\"resolution\":\"%s\","
		     "\"quality\":\"%s\",\"light\":\"%s\",\"rotation\":%u,\"lit\":%s,"
		     "\"clients\":%u,\"streams\":%u,\"slots\":%u,\"frames\":%u,\"errors\":%u,"
		     "\"last_bytes\":%u,\"last_ms\":%u,\"fps\":%u.%u",
		     st.present ? "true" : "false", st.model, st.port, st.resolution, st.quality,
		     st.light ? "on" : "off", st.rotation, st.lit ? "true" : "false", st.clients,
		     st.streams, CONFIG_BAY_CAMERA_CLIENTS, st.frames, st.errors, st.last_size,
		     st.last_ms, st.fps_x10 / 10, st.fps_x10 % 10);
	if (n < 0 || (size_t)n >= size) {
		return -ENOMEM;
	}
	len = n;
	if (full) {
		len += snprintf(buf + len, size - len, ",\"settings\":{");
		for (int i = 0; camera_setting(i, &name, value, sizeof(value)) && len < size; i++) {
			const char *q = is_number(value) ? "" : "\"";

			len += snprintf(buf + len, size - len, "%s\"%s\":%s%s%s", i ? "," : "",
					name, q, value, q);
		}
		if (len < size) {
			len += snprintf(buf + len, size - len, "},\"choices\":");
		}
		if (len < size) {
			n = camera_choices_json(buf + len, size - len);
			if (n < 0) {
				return n;
			}
			len += n;
		}
	}
	if (len + 1 >= size) {
		return -ENOMEM;
	}
	buf[len++] = '}';
	buf[len] = '\0';
	return len;
}

static int camera_status_json(char *buf, size_t size)
{
	return camera_json(buf, size, false);
}
#endif

/* ip: who asks (their rights, the lease from their side), 0 for /metrics */
static void status_fill(struct status_doc *s, uint32_t ip)
{
	struct dut_power_reading r = {0};
	struct rack_hub_state hub = {0};
	struct aux_config cfg;
	struct aux_stats st;
	int devices = usb_host_device_count();
	uint8_t allowed = access_allowed(ip);
	uint32_t remaining;

	s->id = bay_id();
	s->hostname = net_hostname_get();
	s->ip = bay_net_addr();
	s->version = KERNEL_VERSION_STRING;
	s->path = bay_data_path_str(usb_mux_path());
	s->uptime_s = (int32_t)(k_uptime_get() / MSEC_PER_SEC);
	s->last_fault = fault_last();
	s->service = usb_mux_service();
	s->pc_detected = usb_mux_pc_detected();
	s->force_classic = usb_mux_force_pc_get();

	s->usb.running = usb_host_running();
	s->usb.devices = MAX(devices, 0);
	s->usb.sessions = usb_host_usbip_sessions();

	s->dut.on = dut_power_get();
	s->dut.fault = dut_fault_active();
	s->dut.latched = dut_fault_latched();
	s->dut.faults = (int32_t)dut_fault_count();
	s->dut.meter = dut_power_read(&r) == 0;
	s->dut.mv = r.bus_mv;
	s->dut.ma = r.current_ma;
	s->dut.mw = r.power_mw;

	aux_config_get(&cfg, false);
	aux_stats_get(&st);
	s->aux.baud = (int32_t)cfg.baud;
	/* "8N1": the fields are validated, one character each */
	s->aux.format_buf[0] = '0' + cfg.data_bits;
	s->aux.format_buf[1] = "NOE"[cfg.parity];
	s->aux.format_buf[2] = '0' + cfg.stop_bits;
	s->aux.format_buf[3] = '\0';
	s->aux.format = s->aux.format_buf;
	s->aux.port = CONFIG_BAY_AUX_TCP_PORT;
	s->aux.rfc2217_port = CONFIG_BAY_RFC2217_PORT;
	s->aux.web_clients = st.web_clients;
	s->aux.rfc2217 = st.rfc2217_client;
	s->aux.raw = st.raw_client;
	s->aux.rx = (int32_t)st.rx;
	s->aux.tx = (int32_t)st.tx;
	s->aux.dropped = (int32_t)st.dropped;

	s->access.enabled = access_enabled();
	s->access.claimed = access_claimed();
	acl_format_ip(ip, s->you_buf);
	s->access.you = s->you_buf;
	s->access.allow_len = 0;
	for (int svc = 0; svc < ACL_SERVICES; svc++) {
		if (allowed & ACL_BIT(svc)) {
			s->access.allow[s->access.allow_len++] = acl_service_name(svc);
		}
	}
	s->access.refused = (int32_t)access_refused_total();
	if (access_lease_get(&s->lease, &remaining)) {
		acl_format_ip(s->lease.holder, s->holder_buf);
		s->access.lease.holder = s->holder_buf;
		s->access.lease.note = s->lease.note;
		s->access.lease.remaining_s = (int32_t)remaining;
		s->access.lease.yours = s->lease.holder == ip;
	} else {
		s->access.lease = (struct status_lease){.holder = "", .note = ""};
	}

	s->rack.node = bay_rack_id();
	s->rack.pos = bay_rack_position();
	s->rack.hub = bay_rack_hub(&hub);
	s->rack.hub_mv = s->rack.hub ? hub.mv : 0;
	s->rack.hub_epr = s->rack.hub && (hub.flags & RACK_HUB_EPR);
	s->rack.rows_on = s->rack.hub ? hub.rows_on : 0;
}

/* An object written by fn, as "name", before the status document's last brace */
static __maybe_unused void status_append(const char *name, int (*fn)(char *buf, size_t size))
{
	size_t start = strlen(resp_buf) - 1;
	size_t len = start;
	int n = -ENOMEM;

	if (len + strlen(name) + sizeof(",\"\":}") < sizeof(resp_buf)) {
		len += sprintf(resp_buf + len, ",\"%s\":", name);
		n = fn(resp_buf + len, sizeof(resp_buf) - len - 1);
	}
	if (n >= 0) {
		strcpy(resp_buf + len + n, "}");
	} else {
		LOG_WRN("status: no room for the %s object", name);
		strcpy(resp_buf + start, "}");
	}
}

/* A port's name: the bay's position (or id) and the port, "C3.2" */
static void slot_name(int port, char *buf, size_t size);

void bay_slot_name(int port, char *buf, size_t size)
{
	slot_name(port, buf, size);
}

static void slot_name(int port, char *buf, size_t size)
{
	const char *pos = bay_rack_position();
	int n = snprintf(buf, size, "%s", pos[0] != '\0' ? pos : bay_id());

	for (int i = 0; i < n && buf[i] != '\0'; i++) {
		if (buf[i] >= 'a' && buf[i] <= 'z') {
			buf[i] -= 'a' - 'A';
		}
	}
	if (port > 0 && n >= 0 && (size_t)n < size) {
		snprintf(buf + n, size - n, ".%d", port);
	}
}

/* A port's power, in a word: waiting is for its turn or for power, shed for power */
static const char *port_state(const struct port_info *pi)
{
	return pi->on        ? "on"
	       : pi->latched ? "fault"
	       : pi->shed    ? "shed"
	       : pi->waiting ? "waiting"
			     : "off";
}

/*
 * One object of GET /api/ports (full) or of /api/status's ports (short):
 * a DATA board's port, or the one DUT as port 1 (no hub: busid 1-1).
 * lines: it has RESET and BOOT (the one DUT's AUX, a DATA x4's port; not a
 * DATA x6's).
 */
static int port_json(char *buf, size_t size, int port, uint32_t ip, bool full)
{
	struct port_info pi;
	char name[24], busid[16], usb[64] = "null", usbip[48] = "null", lease_str[128] = "null";
	struct dut_power_reading r = {0};
	struct acl_lease lease;
	uint32_t client_ip = 0, since_s = 0, remaining = 0;
	bool leased;

	if (port > 0) {
		if (ports_info(port, &pi) != 0) {
			return -ENOENT;
		}
	} else {
		pi = (struct port_info){.slot = 1, .on = dut_power_get(),
					.latched = dut_fault_latched() || dut_fault_active(),
					.faults = dut_fault_count(), .usb = usb_host_device_count() > 0,
					.lines = true};
		if (dut_power_read(&r) == 0) {
			pi.mv = r.bus_mv;
			pi.ma = r.current_ma;
			pi.mw = r.power_mw;
		}
	}
	slot_name(port, name, sizeof(name));
	snprintf(busid, sizeof(busid), "1-1%s%.0u", port > 0 ? "." : "", port > 0 ? pi.hub_port : 0);
	if (pi.usb && full && port > 0) {
		snprintf(usb, sizeof(usb), "{\"vid\":\"%04x\",\"pid\":\"%04x\",\"busid\":\"%s\"}",
			 pi.vid, pi.pid, busid);
	} else if (pi.usb) {
		snprintf(usb, sizeof(usb), "{\"busid\":\"%s\"}", busid);
	}
	if (pi.usb && usb_host_usbip_client(busid, &client_ip, &since_s) == 0) {
		char addr[ACL_IP_STR_LEN];

		acl_format_ip(client_ip, addr);
		snprintf(usbip, sizeof(usbip), "{\"client\":\"%s\"}", addr);
	}
	leased = port > 0 ? access_port_lease_get(port, &lease, &remaining)
			  : access_lease_get(&lease, &remaining);
	if (leased) {
		char holder[ACL_IP_STR_LEN];

		acl_format_ip(lease.holder, holder);
		snprintf(lease_str, sizeof(lease_str),
			 "{\"holder\":\"%s\",\"note\":\"%s\",\"remaining_s\":%u,\"yours\":%s}",
			 holder, lease.note, remaining, lease.holder == ip ? "true" : "false");
	}

	if (!full) {
		return snprintf(buf, size,
				"{\"slot\":\"%s\",\"port\":%u,\"hub_port\":%s%.0u,\"lines\":%s,"
				"\"power\":{\"on\":%s,\"ma\":%d,\"state\":\"%s\","
				"\"queued\":%s},\"fault\":%s,\"usb\":%s,\"usbip\":%s,\"lease\":%s}",
				name, pi.slot, port > 0 ? "" : "null", port > 0 ? pi.hub_port : 0,
				pi.lines ? "true" : "false", pi.on ? "true" : "false", pi.ma,
				port_state(&pi), pi.queued ? "true" : "false",
				pi.latched ? "true" : "false", usb, usbip, lease_str);
	}
	return snprintf(buf, size,
			"{\"slot\":\"%s\",\"port\":%u,\"hub_port\":%s%.0u,\"lines\":%s,"
			"\"power\":{\"on\":%s,\"mv\":%d,\"ma\":%d,\"mw\":%d,\"faults\":%u,"
			"\"state\":\"%s\",\"queued\":%s},"
			"\"fault\":%s,\"usb\":%s,\"usbip\":%s,\"lease\":%s}",
			name, pi.slot, port > 0 ? "" : "null", port > 0 ? pi.hub_port : 0,
			pi.lines ? "true" : "false", pi.on ? "true" : "false", pi.mv, pi.ma, pi.mw,
			pi.faults, port_state(&pi), pi.queued ? "true" : "false",
			pi.latched ? "true" : "false", usb, usbip, lease_str);
}

/*
 * /api/status's "budget": what the bay's ports are switched on within (node
 * v1.0: mW on DATA_VIN, the hub's grant or the bay's own limit; the first design: mA on
 * DUT_5V), what it draws, the ports waiting, the sheds; and why the DATA
 * lead is off (v1.0), null when it is not
 */
static int budget_status_json(char *buf, size_t size)
{
	struct ports_budget pb = {0};
	bool board = ports_budget(&pb) == 0;
	const char *why = dut_lead_str(dut_lead_state(NULL));
	int n = snprintf(buf, size,
			 "{\"unit\":\"%s\",\"limit\":%d,\"granted\":%s,\"reserve\":%d,\"draw\":%d,"
			 "\"waiting\":%u,\"sheds\":%u,\"board\":%s,\"lead_off\":%s%s%s}",
			 pb.power ? "mW" : "mA", pb.limit, pb.granted ? "true" : "false", pb.reserve,
			 pb.draw, pb.waiting, pb.sheds, board ? "true" : "false", why ? "\"" : "",
			 why ? why : "null", why ? "\"" : "");

	return n < 0 || (size_t)n >= size ? -ENOMEM : n;
}

/* The ports as a JSON array: a DATA x4's, or the one DUT's */
static int ports_json_array(char *buf, size_t size, uint32_t ip, bool full)
{
	int count = ports_count();
	size_t len = 1;
	int n;

	if (size < 3) {
		return -ENOMEM;
	}
	buf[0] = '[';
	for (int i = 0; i < MAX(count, 1); i++) {
		if (i > 0) {
			buf[len++] = ',';
		}
		n = port_json(buf + len, size - len, count > 0 ? i + 1 : 0, ip, full);
		if (n < 0 || (size_t)n >= size - len - 1) {
			return -ENOMEM;
		}
		len += n;
	}
	buf[len++] = ']';
	buf[len] = '\0';

	return len;
}

static uint32_t status_ip;

static int ports_status_json(char *buf, size_t size)
{
	return ports_json_array(buf, size, status_ip, false);
}

/*
 * /api/status's data_board: the board on the DATA lead, "x4" or "x6", null
 * without one; "unknown": something at 0x20 that is neither, left alone
 */
static int data_board_json(char *buf, size_t size)
{
	static const char *const names[] = {[DATA_NONE] = "null", [DATA_X4] = "\"x4\"",
					    [DATA_X6] = "\"x6\"", [DATA_UNKNOWN] = "\"unknown\""};
	int n = snprintf(buf, size, "%s", names[ports_board()]);

	return n < 0 || (size_t)n >= size ? -ENOMEM : n;
}

static void respond_status(struct http_response_ctx *rsp, uint32_t ip)
{
	static struct status_doc s;
	int ret;

	status_ip = ip;
	status_fill(&s, ip);
	ret = json_obj_encode_buf(status_descr, ARRAY_SIZE(status_descr), &s, resp_buf,
				  sizeof(resp_buf));
	if (ret != 0) {
		LOG_ERR("status encoding failed: %d", ret);
		rsp->status = HTTP_500_INTERNAL_SERVER_ERROR;
		strcpy(resp_buf, "{\"error\":\"encoding\"}");
	} else {
		/* Hand-written objects: the firmware (the update code's), the camera */
#if defined(CONFIG_HWTR_UPDATE)
		status_append("firmware", hwtr_update_json);
#endif
#if defined(CONFIG_BAY_CAMERA)
		status_append("camera", camera_status_json);
#endif
		status_append("budget", budget_status_json);
		status_append("ports", ports_status_json);
		status_append("data_board", data_board_json);
#if defined(CONFIG_BAY_COPROC)
		status_append("coproc", coproc_json);
#endif
#if defined(CONFIG_BAY_ANALYZER)
		status_append("analyzer", analyzer_json);
#endif
	}

	rsp->body = resp_buf;
	rsp->body_len = strlen(resp_buf);
	rsp->final_chunk = true;
}

static void respond_error(struct http_response_ctx *rsp, enum http_status status,
			  const char *msg)
{
	snprintf(resp_buf, sizeof(resp_buf), "{\"error\":\"%s\"}", msg);
	rsp->status = status;
	rsp->body = resp_buf;
	rsp->body_len = strlen(resp_buf);
	rsp->final_chunk = true;
}

static void respond_buf(struct http_response_ctx *rsp, int len)
{
	if (len < 0) {
		respond_error(rsp, HTTP_500_INTERNAL_SERVER_ERROR, "response too large");
		return;
	}
	rsp->body = resp_buf;
	rsp->body_len = len;
	rsp->final_chunk = true;
}

/* True (and the response set) when the rules refuse ip this service */
static bool refused(struct http_response_ctx *rsp, enum acl_service svc, uint32_t ip)
{
	enum acl_verdict v = access_check(svc, ip);
	char who[ACL_IP_STR_LEN];
	struct acl_lease lease;
	uint32_t remaining;
	size_t len;

	if (v == ACL_OK) {
		return false;
	}

	if (v == ACL_RESERVED && access_lease_get(&lease, &remaining)) {
		char holder[ACL_IP_STR_LEN];

		acl_format_ip(lease.holder, holder);
		snprintf(resp_buf, sizeof(resp_buf),
			 "{\"error\":\"reserved by %s%s%s%s, %u min left\"",
			 holder, lease.note[0] ? " (" : "", lease.note, lease.note[0] ? ")" : "",
			 (remaining + 59) / 60);
		rsp->status = HTTP_423_LOCKED;
	} else {
		snprintf(resp_buf, sizeof(resp_buf), "{\"error\":\"%s\"",
			 v == ACL_KICKED ? "kicked by an admin: retry in a minute"
					 : "not allowed from this address");
		rsp->status = HTTP_403_FORBIDDEN;
	}
	/* What was refused, and the address the node saw, for the page to show */
	acl_format_ip(ip, who);
	len = strlen(resp_buf);
	snprintf(&resp_buf[len], sizeof(resp_buf) - len,
		 ",\"reason\":\"%s\",\"service\":\"%s\",\"you\":\"%s\"}", acl_verdict_name(v),
		 acl_service_name(svc), who);
	rsp->body = resp_buf;
	rsp->body_len = strlen(resp_buf);
	rsp->final_chunk = true;

	return true;
}

static int status_handler(struct http_client_ctx *client, enum http_transaction_status status,
			  const struct http_request_ctx *req, struct http_response_ctx *rsp,
			  void *user_data)
{
	uint32_t ip;

	ARG_UNUSED(req);
	ARG_UNUSED(user_data);

	if (status == HTTP_SERVER_REQUEST_DATA_FINAL) {
		ip = access_peer(client->fd);
		if (!refused(rsp, ACL_STATUS, ip)) {
			respond_status(rsp, ip);
		}
	}

	return 0;
}

/* --- POST /api/... ------------------------------------------------------- */

enum api_action {
	API_POWER,
	API_RESET,
	API_BOOT,
	API_MODE,
	API_BREAK,
};

/* Default length of a BREAK, as pyserial's send_break() */
#define BREAK_MS 250

struct action_req {
	char *action;
	char *mode;
	int32_t ms;
	int32_t port;
	bool power_cycle;
	char *when;
};

static const struct json_obj_descr action_descr[] = {
	JSON_OBJ_DESCR_PRIM(struct action_req, action, JSON_TOK_STRING),
	JSON_OBJ_DESCR_PRIM(struct action_req, mode, JSON_TOK_STRING),
	JSON_OBJ_DESCR_PRIM(struct action_req, ms, JSON_TOK_NUMBER),
	JSON_OBJ_DESCR_PRIM(struct action_req, port, JSON_TOK_NUMBER),
	JSON_OBJ_DESCR_PRIM(struct action_req, power_cycle, JSON_TOK_TRUE),
	JSON_OBJ_DESCR_PRIM(struct action_req, when, JSON_TOK_STRING),
};

#define ACTION_FIELD_ACTION BIT(0)
#define ACTION_FIELD_MODE   BIT(1)
#define ACTION_FIELD_MS     BIT(2)
#define ACTION_FIELD_PORT   BIT(3)
#define ACTION_FIELD_PC     BIT(4)
#define ACTION_FIELD_WHEN   BIT(5)

/* user_data of a /api/ports/<n>/<what> resource: the action, the port above */
#define PORT_ACTION(what, port) ((what) | ((port) << 8))

static char action_err[128];

/* True (and the response set) when another address holds this DATA x4 port's lease */
static bool port_reserved(struct http_response_ctx *rsp, int port, uint32_t ip)
{
	char slot[24], holder[ACL_IP_STR_LEN], who[ACL_IP_STR_LEN];
	struct acl_lease lease;
	uint32_t remaining;

	if (port < 1 || port > ports_count() ||
	    access_check_port(ACL_CONTROL, port, ip) != ACL_RESERVED ||
	    !access_port_lease_get(port, &lease, &remaining)) {
		return false;
	}
	slot_name(port, slot, sizeof(slot));
	acl_format_ip(lease.holder, holder);
	acl_format_ip(ip, who);
	snprintf(resp_buf, sizeof(resp_buf),
		 "{\"error\":\"%s reserved by %s%s%s%s, %u min left\","
		 "\"reason\":\"reserved\",\"service\":\"control\",\"you\":\"%s\"}",
		 slot, holder, lease.note[0] ? " (" : "", lease.note, lease.note[0] ? ")" : "",
		 (remaining + 59) / 60, who);
	rsp->status = HTTP_423_LOCKED;
	rsp->body = resp_buf;
	rsp->body_len = strlen(resp_buf);
	rsp->final_chunk = true;

	return true;
}

/* A DATA x4 port's power, reset or boot; NULL, or an error and its status */
static const char *do_port_action(enum api_action what, int port, const struct action_req *req,
				  int fields, enum http_status *code)
{
	int32_t others = 0;
	uint32_t ms;
	int ret;

	switch (what) {
	case API_POWER:
		if (!(fields & ACTION_FIELD_ACTION)) {
			return "action must be on, off, cycle or cancel";
		}
		if ((fields & ACTION_FIELD_WHEN) &&
		    (strcmp(req->action, "on") != 0 || strcmp(req->when, "available") != 0)) {
			return "\"when\": \"available\" goes with \"action\": \"on\"";
		}
		if (strcmp(req->action, "on") == 0 && (fields & ACTION_FIELD_WHEN)) {
			/* On as soon as the budget has room: 202 while it waits */
			ret = ports_power_wait(port);
			if (ret == -EINPROGRESS) {
				*code = HTTP_202_ACCEPTED;
				ret = 0;
			}
		} else if (strcmp(req->action, "on") == 0) {
			ret = ports_power(port, true, &others);
		} else if (strcmp(req->action, "off") == 0) {
			ret = ports_power(port, false, NULL);
		} else if (strcmp(req->action, "cycle") == 0) {
			/* Without "ms", as long as its VBUS takes to fall under 1 V (2 s at most) */
			ms = (fields & ACTION_FIELD_MS) ? req->ms : 0;
			ret = ports_power_cycle(port, K_MSEC(ms), &others);
		} else if (strcmp(req->action, "cancel") == 0) {
			ret = ports_power_cancel(port);
			if (ret == -EALREADY) {
				*code = HTTP_409_CONFLICT;
				return "no queued request on this port";
			}
		} else {
			return "action must be on, off, cycle or cancel";
		}
		break;
	case API_RESET:
		ms = (fields & ACTION_FIELD_MS) ? req->ms : CONFIG_BAY_RESET_PULSE_MS;
		ret = ports_reset_pulse(port, K_MSEC(ms));
		break;
	case API_BOOT:
		ret = ports_boot(port, (fields & ACTION_FIELD_PC) && req->power_cycle, &others);
		break;
	default:
		return "not a port's action";
	}

	switch (ret) {
	case 0:
		return NULL;
	case -EBUSY: {
		struct ports_budget pb = {0};
		const char *u;

		(void)ports_budget(&pb);
		u = pb.power ? "mW" : "mA";
		*code = HTTP_409_CONFLICT;
		snprintf(action_err, sizeof(action_err),
			 "no room in the bay's budget: the bay draws %d %s, %d %s kept for a "
			 "start, %d %s in all%s", others, u, pb.reserve, u, pb.limit, u,
			 pb.granted ? " (the hub's grant)" : "");
		return action_err;
	}
	case -EALREADY:
		*code = HTTP_409_CONFLICT;
		return "the port's VBUS is up while it is off (a board powered from elsewhere): "
		       "it comes on once that has gone";
	case -EAGAIN:
		*code = HTTP_503_SERVICE_UNAVAILABLE;
		return "the port is off, or the DATA board is not set up (DUT_5V off?)";
	case -ENOTSUP:
		return "this port has no such line";
	case -ENOENT:
	case -ENODEV:
		*code = HTTP_404_NOT_FOUND;
		snprintf(action_err, sizeof(action_err), "no port %d on this node", port);
		return action_err;
	default:
		*code = HTTP_500_INTERNAL_SERVER_ERROR;
		return "action failed";
	}
}

static const char *do_action(enum api_action what, int port, const struct action_req *req,
			     int fields, enum http_status *code)
{
	uint32_t ms;
	int ret;

	if ((fields & ACTION_FIELD_MS) && (req->ms <= 0 || req->ms > MAX_ACTION_MS)) {
		return "ms must be 1..10000";
	}

	/* A DATA x4 node: power, reset and boot are a port's */
	if (port == 0 && (fields & ACTION_FIELD_PORT)) {
		port = req->port;
	}
	if (what == API_POWER || what == API_RESET || what == API_BOOT) {
		if (port > 0) {
			return do_port_action(what, port, req, fields, code);
		}
		if (ports_count() > 0) {
			*code = HTTP_409_CONFLICT;
			snprintf(action_err, sizeof(action_err),
				 "this node serves %d boards: say which (\"port\": 1..%d, or "
				 "/api/ports/<n>/...)", ports_count(), ports_count());
			return action_err;
		}
		if ((fields & ACTION_FIELD_PC) && req->power_cycle) {
			return "power_cycle is a DATA x4 port's";
		}
		if (fields & ACTION_FIELD_WHEN) {
			return "\"when\" is a DATA x4 port's";
		}
	}

	switch (what) {
	case API_POWER:
		if (!(fields & ACTION_FIELD_ACTION)) {
			return "action must be on, off or cycle";
		}
		if (strcmp(req->action, "on") == 0) {
			ret = dut_power_set(true);
		} else if (strcmp(req->action, "off") == 0) {
			ret = dut_power_set(false);
		} else if (strcmp(req->action, "cycle") == 0) {
			ms = (fields & ACTION_FIELD_MS) ? req->ms : CONFIG_BAY_POWER_CYCLE_MS;
			ret = dut_power_cycle(K_MSEC(ms));
		} else {
			return "action must be on, off or cycle";
		}
		break;
	case API_RESET:
		ms = (fields & ACTION_FIELD_MS) ? req->ms : CONFIG_BAY_RESET_PULSE_MS;
		ret = dut_reset_pulse(K_MSEC(ms));
		break;
	case API_BOOT:
		ret = dut_enter_bootloader();
		break;
	case API_MODE:
		if (!(fields & ACTION_FIELD_MODE)) {
			return "mode must be usbip or classic";
		}
		if (strcmp(req->mode, "classic") == 0) {
			ret = usb_mux_force_pc_set(true);
		} else if (strcmp(req->mode, "usbip") == 0) {
			ret = usb_mux_force_pc_set(false);
		} else {
			return "mode must be usbip or classic";
		}
		break;
	case API_BREAK:
		ret = aux_break((fields & ACTION_FIELD_MS) ? req->ms : BREAK_MS);
		if (ret == -EIO) {
			return "the DUT is powered off";
		}
		if (ret == -ENOTSUP) {
			return "no BREAK on this board (no tx-gpios)";
		}
		break;
	default:
		return "unknown action";
	}

	return ret == 0 ? NULL : "action failed";
}

static int action_handler(struct http_client_ctx *client, enum http_transaction_status status,
			  const struct http_request_ctx *req, struct http_response_ctx *rsp,
			  void *user_data)
{
	static uint8_t body[96];
	static size_t len;
	static bool too_long;
	struct action_req areq = {0};
	enum api_action what = (enum api_action)(POINTER_TO_INT(user_data) & 0xFF);
	int port = POINTER_TO_INT(user_data) >> 8;
	enum http_status code = HTTP_400_BAD_REQUEST;
	const char *err;
	int fields = 0;
	uint32_t ip;
	int n;

	if (status == HTTP_SERVER_TRANSACTION_ABORTED ||
	    status == HTTP_SERVER_TRANSACTION_COMPLETE) {
		len = 0;
		too_long = false;
		return 0;
	}

	if (len + req->data_len > sizeof(body)) {
		too_long = true;
	} else {
		memcpy(body + len, req->data, req->data_len);
		len += req->data_len;
	}

	if (status != HTTP_SERVER_REQUEST_DATA_FINAL) {
		return 0;
	}

	/* BREAK is the console's; power, reset, boot and mode are control */
	ip = access_peer(client->fd);
	if (refused(rsp, what == API_BREAK ? ACL_CONSOLE : ACL_CONTROL, ip)) {
		return 0;
	}

	if (too_long) {
		respond_error(rsp, HTTP_413_PAYLOAD_TOO_LARGE, "body too large");
		return 0;
	}

	if (len > 0) {
		fields = json_obj_parse(body, len, action_descr, ARRAY_SIZE(action_descr), &areq);
		if (fields < 0) {
			respond_error(rsp, HTTP_400_BAD_REQUEST, "bad JSON");
			return 0;
		}
	}

	if ((what == API_POWER || what == API_RESET || what == API_BOOT) &&
	    port_reserved(rsp, port > 0 ? port : ((fields & ACTION_FIELD_PORT) ? areq.port : 0), ip)) {
		return 0;
	}

	err = do_action(what, port, &areq, fields, &code);
	if (err != NULL) {
		respond_error(rsp, code, err);
		return 0;
	}
	/* A port's request queued until the budget has room */
	if (code == HTTP_202_ACCEPTED) {
		rsp->status = code;
	}

	/* /api/ports/<n>/...: the port's object; otherwise the status document */
	if (port > 0) {
		n = port_json(resp_buf, sizeof(resp_buf), port, ip, true);
		respond_buf(rsp, n < (int)sizeof(resp_buf) ? n : -ENOMEM);
		return 0;
	}
	respond_status(rsp, ip);

	return 0;
}

#define ACTION_RESOURCE(_action)                                                                   \
	{                                                                                          \
		.common = {                                                                        \
			.type = HTTP_RESOURCE_TYPE_DYNAMIC,                                        \
			.bitmask_of_supported_http_methods = BIT(HTTP_POST),                       \
			.content_type = "application/json",                                        \
		},                                                                                 \
		.cb = action_handler,                                                              \
		.user_data = INT_TO_POINTER(_action),                                              \
	}

static struct http_resource_detail_dynamic power_detail = ACTION_RESOURCE(API_POWER);
static struct http_resource_detail_dynamic reset_detail = ACTION_RESOURCE(API_RESET);
static struct http_resource_detail_dynamic boot_detail = ACTION_RESOURCE(API_BOOT);
static struct http_resource_detail_dynamic mode_detail = ACTION_RESOURCE(API_MODE);
static struct http_resource_detail_dynamic break_detail = ACTION_RESOURCE(API_BREAK);

/* --- GET /api/ports ------------------------------------------------------- */

static int ports_handler(struct http_client_ctx *client, enum http_transaction_status status,
			 const struct http_request_ctx *req, struct http_response_ctx *rsp,
			 void *user_data)
{
	uint32_t ip;

	ARG_UNUSED(req);
	ARG_UNUSED(user_data);

	if (status == HTTP_SERVER_REQUEST_DATA_FINAL) {
		ip = access_peer(client->fd);
		if (!refused(rsp, ACL_STATUS, ip)) {
			respond_buf(rsp, ports_json_array(resp_buf, sizeof(resp_buf), ip, true));
		}
	}

	return 0;
}

static struct http_resource_detail_dynamic ports_detail = {
	.common = {
		.type = HTTP_RESOURCE_TYPE_DYNAMIC,
		.bitmask_of_supported_http_methods = BIT(HTTP_GET),
		.content_type = "application/json",
	},
	.cb = ports_handler,
};

/* --- GET /api/usb: the devices the USB host enumerated --------------------- */

static BAY_EXT_RAM struct usb_dev_info usb_devs[USB_INFO_MAX];
static BAY_EXT_RAM char usb_buf[6144];

/*
 * A JSON string, or null for an empty one.  The strings come from the
 * devices: quotes, backslashes and control characters are escaped.
 */
char *bay_json_str(char *p, char *end, const char *s)
{
	if (s == NULL || s[0] == '\0') {
		return p + snprintf(p, end - p, "null");
	}
	if (p < end) {
		*p++ = '"';
	}
	for (; *s != '\0' && p + 7 < end; s++) {
		unsigned char c = *s;

		if (c == '"' || c == '\\') {
			*p++ = '\\';
			*p++ = c;
		} else if (c < 0x20) {
			p += snprintf(p, end - p, "\\u%04x", c);
		} else {
			*p++ = c;
		}
	}
	if (p < end) {
		*p++ = '"';
	}
	*(p < end ? p : end - 1) = '\0';

	return p;
}

/* What a device is, for people: its interfaces' classes, its serial chip */
static int usb_classes(const struct usb_dev_info *u, const char **out, int max)
{
	static const struct {
		uint16_t bit;
		const char *name;
	} names[] = {
		{USB_CLS_CDC_ACM, "CDC ACM"}, {USB_CLS_HID, "HID"}, {USB_CLS_MSC, "Mass storage"},
		{USB_CLS_DFU, "DFU"}, {USB_CLS_AUDIO, "Audio"}, {USB_CLS_VIDEO, "Video"},
	};
	int n = 0;

	if (u->classes & USB_CLS_CMSIS_DAP) {
		out[n++] = "CMSIS-DAP";
	} else if (u->classes & USB_CLS_PROBE) {
		out[n++] = "Debug probe";
	}
	if (u->read_ahead != 0) {
		out[n++] = u->vid == 0x0403 ? "Serial (FTDI)" : u->vid == 0x10c4 ? "Serial (CP210x)"
			 : u->vid == 0x1a86 ? "Serial (CH34x)" : u->vid == 0x067b ? "Serial (PL2303)"
			 : "Serial";
	}
	ARRAY_FOR_EACH_PTR(names, c) {
		if ((u->classes & c->bit) && n < max) {
			out[n++] = c->name;
		}
	}
	if (n == 0 && (u->classes & USB_CLS_VENDOR)) {
		out[n++] = "Vendor";
	}
	if (n == 0) {
		out[n++] = "Other";
	}

	return n;
}

static const char *usb_speed(uint8_t speed)
{
	/* enum usb_device_speed */
	switch (speed) {
	case 1:
		return "low";
	case 2:
		return "full";
	case 3:
		return "high";
	default:
		return "unknown";
	}
}

/* A device behind the DATA x4 hub: the port its hub port is, and its current */
static int usb_port_of(const struct usb_dev_info *u, int32_t *ma)
{
	struct port_info pi;

	for (int p = 1; u->root_port != 0 && p <= ports_count(); p++) {
		if (ports_info(p, &pi) == 0 && pi.hub_port == u->root_port) {
			*ma = pi.ma;
			return p;
		}
	}

	return 0;
}

static char *usb_dev_json(char *p, char *end, const struct usb_dev_info *u)
{
	const char *classes[8];
	char slot[24], vidpid[10];
	int port, ncls;
	int32_t ma = 0;
	uint32_t ip = 0, since_s = 0;
	bool client = usb_host_usbip_client(u->busid, &ip, &since_s) == 0;

	port = usb_port_of(u, &ma);
	slot_name(port, slot, sizeof(slot));
	snprintf(vidpid, sizeof(vidpid), "%04x:%04x", u->vid, u->pid);

	p += snprintf(p, end - p, "{\"busid\":\"%s\",\"slot\":", u->busid);
	p = bay_json_str(p, end, slot);
	p += snprintf(p, end - p, ",\"hub_port\":");
	p += u->root_port ? snprintf(p, end - p, "%u", u->root_port) : snprintf(p, end - p, "null");
	p += snprintf(p, end - p, ",\"vid\":\"%04x\",\"pid\":\"%04x\",\"name\":", u->vid, u->pid);
	p = bay_json_str(p, end, u->product[0] ? u->product : u->known ? u->known : vidpid);
	p += snprintf(p, end - p, ",\"name_from\":\"%s\",\"manufacturer\":",
		      u->product[0] ? "product" : u->known ? "table" : "ids");
	p = bay_json_str(p, end, u->manufacturer);
	p += snprintf(p, end - p, ",\"serial\":");
	p = bay_json_str(p, end, u->serial);
	p += snprintf(p, end - p, ",\"strings\":%s,\"speed\":\"%s\",\"classes\":[",
		      u->strings ? "true" : "false", usb_speed(u->speed));
	ncls = usb_classes(u, classes, ARRAY_SIZE(classes));
	for (int i = 0; i < ncls; i++) {
		p += snprintf(p, end - p, "%s\"%s\"", i ? "," : "", classes[i]);
	}
	/* The ttys a host makes of it, as udev numbers them (bayctl: /dev/serial/by-id) */
	p += snprintf(p, end - p, "],\"ttys\":[");
	for (int i = 0; i < u->tty_n; i++) {
		p += snprintf(p, end - p, "%s{\"if\":\"%02x\"%s}", i ? "," : "", u->tty_if[i],
			      u->tty_bridge ? ",\"port\":0" : "");
	}
	p += snprintf(p, end - p, "],\"usbip\":{\"client\":");
	if (client) {
		char addr[NET_INET_ADDRSTRLEN];
		struct net_in_addr in = {.s_addr = net_htonl(ip)};

		net_addr_ntop(NET_AF_INET, &in, addr, sizeof(addr));
		p += snprintf(p, end - p, "\"%s\",\"since_s\":%u", addr, since_s);
	} else {
		p += snprintf(p, end - p, "null,\"since_s\":null");
	}
	p += snprintf(p, end - p, ",\"offered\":%s,\"read_ahead\":%s},\"ma\":",
		      u->offered ? "true" : "false", u->read_ahead != 0 ? "true" : "false");
	p += port > 0 ? snprintf(p, end - p, "%d}", ma) : snprintf(p, end - p, "null}");

	return p;
}

/*
 * {"hub": the hub on the root port or null, "devices": [...]}: the hubs are
 * not in the devices; a DATA x4's empty ports are in /api/status's ports
 */
static int usb_json(char *buf, size_t size)
{
	char *p = buf, *end = buf + size;
	int n = usb_info_list(usb_devs, ARRAY_SIZE(usb_devs));
	const struct usb_dev_info *hub = NULL;
	bool first = true;

	for (int i = 0; i < n; i++) {
		if ((usb_devs[i].classes & USB_CLS_HUB) && usb_devs[i].level == 1) {
			hub = &usb_devs[i];
		}
	}
	p += snprintf(p, end - p, "{\"hub\":");
	if (hub != NULL) {
		p += snprintf(p, end - p, "{\"vid\":\"%04x\",\"pid\":\"%04x\",\"name\":",
			      hub->vid, hub->pid);
		p = bay_json_str(p, end, hub->product[0] ? hub->product
				     : hub->known ? hub->known : "USB hub");
		p += snprintf(p, end - p, ",\"data_x4\":%s}",
			      ports_board() == DATA_X4 ? "true" : "false");
	} else {
		p += snprintf(p, end - p, "null");
	}
	p += snprintf(p, end - p, ",\"devices\":[");
	for (int i = 0; i < n && p < end - 1; i++) {
		if (usb_devs[i].classes & USB_CLS_HUB) {
			continue;
		}
		if (!first) {
			*p++ = ',';
		}
		first = false;
		p = usb_dev_json(p, end, &usb_devs[i]);
	}
	p += snprintf(p, end - p, "]}");

	return p < end - 1 ? p - buf : -ENOMEM;
}

static int usb_handler(struct http_client_ctx *client, enum http_transaction_status status,
		       const struct http_request_ctx *req, struct http_response_ctx *rsp,
		       void *user_data)
{
	int len;

	ARG_UNUSED(req);
	ARG_UNUSED(user_data);

	if (status != HTTP_SERVER_REQUEST_DATA_FINAL ||
	    refused(rsp, ACL_STATUS, access_peer(client->fd))) {
		return 0;
	}
	len = usb_json(usb_buf, sizeof(usb_buf));
	if (len < 0) {
		respond_error(rsp, HTTP_500_INTERNAL_SERVER_ERROR, "response too large");
		return 0;
	}
	rsp->body = usb_buf;
	rsp->body_len = len;
	rsp->final_chunk = true;

	return 0;
}

static struct http_resource_detail_dynamic usb_detail = {
	.common = {
		.type = HTTP_RESOURCE_TYPE_DYNAMIC,
		.bitmask_of_supported_http_methods = BIT(HTTP_GET),
		.content_type = "application/json",
	},
	.cb = usb_handler,
};

/* --- GET /api/boards, GET and PUT /api/ports/<n>/board (boards.c) ---------- */

static void respond_usb_buf(struct http_response_ctx *rsp, int len)
{
	if (len < 0) {
		respond_error(rsp, HTTP_500_INTERNAL_SERVER_ERROR, "response too large");
		return;
	}
	rsp->body = usb_buf;
	rsp->body_len = len;
	rsp->final_chunk = true;
}

static int boards_handler(struct http_client_ctx *client, enum http_transaction_status status,
			  const struct http_request_ctx *req, struct http_response_ctx *rsp,
			  void *user_data)
{
	ARG_UNUSED(req);
	ARG_UNUSED(user_data);

	if (status == HTTP_SERVER_REQUEST_DATA_FINAL &&
	    !refused(rsp, ACL_STATUS, access_peer(client->fd))) {
		respond_usb_buf(rsp, boards_json(usb_buf, sizeof(usb_buf)));
	}

	return 0;
}

static struct http_resource_detail_dynamic boards_detail = {
	.common = {
		.type = HTTP_RESOURCE_TYPE_DYNAMIC,
		.bitmask_of_supported_http_methods = BIT(HTTP_GET),
		.content_type = "application/json",
	},
	.cb = boards_handler,
};

/* user_data: the port.  Writing a target is control, and the port's lease */
static int board_handler(struct http_client_ctx *client, enum http_transaction_status status,
			 const struct http_request_ctx *req, struct http_response_ctx *rsp,
			 void *user_data)
{
	static char body[512];
	static size_t len;
	static bool too_long;
	int port = POINTER_TO_INT(user_data);
	const char *err;
	uint32_t ip;
	int n;

	if (status == HTTP_SERVER_TRANSACTION_ABORTED ||
	    status == HTTP_SERVER_TRANSACTION_COMPLETE) {
		len = 0;
		too_long = false;
		return 0;
	}
	if (client->method == HTTP_PUT) {
		if (len + req->data_len >= sizeof(body)) {
			too_long = true;
		} else {
			memcpy(body + len, req->data, req->data_len);
			len += req->data_len;
		}
	}
	if (status != HTTP_SERVER_REQUEST_DATA_FINAL) {
		return 0;
	}

	ip = access_peer(client->fd);
	if (refused(rsp, client->method == HTTP_PUT ? ACL_CONTROL : ACL_STATUS, ip)) {
		return 0;
	}
	if (port > boards_slots()) {
		snprintf(action_err, sizeof(action_err), "no port %d on this node (1..%d)", port,
			 boards_slots());
		respond_error(rsp, HTTP_404_NOT_FOUND, action_err);
		return 0;
	}
	if (client->method == HTTP_PUT) {
		if (port_reserved(rsp, port, ip)) {
			return 0;
		}
		if (too_long) {
			respond_error(rsp, HTTP_413_PAYLOAD_TOO_LARGE, "body too large");
			return 0;
		}
		body[len] = '\0';
		err = boards_put(port, body, len);
		if (err != NULL) {
			respond_error(rsp, strcmp(err, "not saved") == 0 ? HTTP_500_INTERNAL_SERVER_ERROR
								       : HTTP_400_BAD_REQUEST, err);
			return 0;
		}
	}
	n = boards_slot_json(usb_buf, sizeof(usb_buf), port);
	respond_usb_buf(rsp, n);

	return 0;
}

#define BOARD_RESOURCE(_i, _)                                                                      \
	static struct http_resource_detail_dynamic board_detail_##_i = {                           \
		.common = {                                                                        \
			.type = HTTP_RESOURCE_TYPE_DYNAMIC,                                        \
			.bitmask_of_supported_http_methods = BIT(HTTP_GET) | BIT(HTTP_PUT),        \
			.content_type = "application/json",                                        \
		},                                                                                 \
		.cb = board_handler,                                                               \
		.user_data = INT_TO_POINTER(UTIL_INC(_i)),                                         \
	}

LISTIFY(BOARDS_MAX, BOARD_RESOURCE, (;));

/* --- /api/aux ------------------------------------------------------------ */

struct aux_req {
	int32_t baud;
	int32_t data_bits;
	char *parity;
	int32_t stop_bits;
	char *enter;
	bool echo;
	bool esptool_reset;
};

static const struct json_obj_descr aux_req_descr[] = {
	JSON_OBJ_DESCR_PRIM(struct aux_req, baud, JSON_TOK_NUMBER),
	JSON_OBJ_DESCR_PRIM(struct aux_req, data_bits, JSON_TOK_NUMBER),
	JSON_OBJ_DESCR_PRIM(struct aux_req, parity, JSON_TOK_STRING),
	JSON_OBJ_DESCR_PRIM(struct aux_req, stop_bits, JSON_TOK_NUMBER),
	JSON_OBJ_DESCR_PRIM(struct aux_req, enter, JSON_TOK_STRING),
	JSON_OBJ_DESCR_PRIM(struct aux_req, echo, JSON_TOK_TRUE),
	JSON_OBJ_DESCR_PRIM(struct aux_req, esptool_reset, JSON_TOK_TRUE),
};

static int index_of(const char *s, const char *const *names, int count)
{
	for (int i = 0; i < count; i++) {
		if (strcmp(s, names[i]) == 0) {
			return i;
		}
	}

	return -1;
}

/* Fields of the request over the saved settings; NULL or an error message */
static const char *aux_update(struct aux_config *cfg, const struct aux_req *req, int fields)
{
	static const char *const parities[] = {"none", "odd", "even"};
	static const char *const enters[] = {"cr", "lf", "crlf"};
	int i;

	if (fields & BIT(0)) {
		cfg->baud = req->baud;
	}
	if (fields & BIT(1)) {
		cfg->data_bits = req->data_bits;
	}
	if (fields & BIT(2)) {
		i = index_of(req->parity, parities, ARRAY_SIZE(parities));
		if (i < 0) {
			return "parity must be none, odd or even";
		}
		cfg->parity = i;
	}
	if (fields & BIT(3)) {
		cfg->stop_bits = req->stop_bits;
	}
	if (fields & BIT(4)) {
		i = index_of(req->enter, enters, ARRAY_SIZE(enters));
		if (i < 0) {
			return "enter must be cr, lf or crlf";
		}
		cfg->enter = i;
	}
	if (fields & BIT(5)) {
		cfg->echo = req->echo;
	}
	if (fields & BIT(6)) {
		cfg->esptool_reset = req->esptool_reset;
	}

	return NULL;
}

static void respond_aux(struct http_response_ctx *rsp)
{
	struct aux_stats st;
	int len = aux_config_json(resp_buf, sizeof(resp_buf), "aux");

	aux_stats_get(&st);
	/* Append the clients to the settings object */
	snprintf(&resp_buf[len - 1], sizeof(resp_buf) - len + 1,
		 ",\"web_clients\":%u,\"web_slots\":%d,\"rfc2217\":%s,\"rfc2217_port\":%d,"
		 "\"raw\":%s,\"raw_port\":%d,\"rx\":%u,\"tx\":%u,\"dropped\":%u}",
		 st.web_clients, CONFIG_BAY_CONSOLE_WEB_CLIENTS, st.rfc2217_client ? "true" : "false",
		 CONFIG_BAY_RFC2217_PORT, st.raw_client ? "true" : "false", CONFIG_BAY_AUX_TCP_PORT,
		 st.rx, st.tx, st.dropped);

	rsp->body = resp_buf;
	rsp->body_len = strlen(resp_buf);
	rsp->final_chunk = true;
}

static int aux_handler(struct http_client_ctx *client, enum http_transaction_status status,
		       const struct http_request_ctx *req, struct http_response_ctx *rsp,
		       void *user_data)
{
	static uint8_t body[192];
	static size_t len;
	static bool too_long;
	struct aux_req areq = {0};
	struct aux_config cfg;
	const char *err;
	int fields;
	int ret;

	ARG_UNUSED(user_data);

	if (status == HTTP_SERVER_TRANSACTION_ABORTED ||
	    status == HTTP_SERVER_TRANSACTION_COMPLETE) {
		len = 0;
		too_long = false;
		return 0;
	}

	if (len + req->data_len > sizeof(body)) {
		too_long = true;
	} else {
		memcpy(body + len, req->data, req->data_len);
		len += req->data_len;
	}

	if (status != HTTP_SERVER_REQUEST_DATA_FINAL) {
		return 0;
	}

	/* The port settings are the console's */
	if (refused(rsp, client->method == HTTP_POST ? ACL_CONSOLE : ACL_STATUS,
		    access_peer(client->fd))) {
		return 0;
	}

	if (client->method == HTTP_POST) {
		if (too_long) {
			respond_error(rsp, HTTP_413_PAYLOAD_TOO_LARGE, "body too large");
			return 0;
		}
		fields = json_obj_parse(body, len, aux_req_descr, ARRAY_SIZE(aux_req_descr), &areq);
		if (fields < 0) {
			respond_error(rsp, HTTP_400_BAD_REQUEST, "bad JSON");
			return 0;
		}

		aux_config_get(&cfg, true);
		err = aux_update(&cfg, &areq, fields);
		if (err != NULL) {
			respond_error(rsp, HTTP_400_BAD_REQUEST, err);
			return 0;
		}
		ret = aux_config_set(&cfg, true);
		if (ret == -EINVAL) {
			respond_error(rsp, HTTP_400_BAD_REQUEST,
				      "baud 300..5000000, data bits 5..8, stop bits 1 or 2");
			return 0;
		}
		if (ret != 0) {
			respond_error(rsp, HTTP_500_INTERNAL_SERVER_ERROR, "the UART refused it");
			return 0;
		}
	}

	respond_aux(rsp);

	return 0;
}

static struct http_resource_detail_dynamic aux_detail = {
	.common = {
		.type = HTTP_RESOURCE_TYPE_DYNAMIC,
		.bitmask_of_supported_http_methods = BIT(HTTP_GET) | BIT(HTTP_POST),
		.content_type = "application/json",
	},
	.cb = aux_handler,
};

/* --- /api/camera --------------------------------------------------------- */

#if defined(CONFIG_BAY_CAMERA)

#define CAMERA_FIELDS_MAX 16

static char *skip_space(char *p, char *end)
{
	while (p < end && (*p == ' ' || *p == '\t' || *p == '\r' || *p == '\n')) {
		p++;
	}
	return p;
}

/*
 * A flat object, {"name": "text" | number | true | false, ...}, the value's
 * type free (the settings take "auto" or a number): the pairs as strings,
 * cut in place (body has room for a NUL past end).  No escapes.
 */
static int flat_json(char *p, char *end, char **names, char **values, int max)
{
	int n = 0;

	p = skip_space(p, end);
	if (p == end || *p++ != '{') {
		return -EINVAL;
	}
	p = skip_space(p, end);
	if (p < end && *p == '}') {
		return 0;
	}
	for (;;) {
		char delim;

		if (n == max || p == end || *p != '"') {
			return -EINVAL;
		}
		names[n] = ++p;
		while (p < end && *p != '"' && *p != '\\') {
			p++;
		}
		if (p == end || *p != '"') {
			return -EINVAL;
		}
		*p++ = '\0';
		p = skip_space(p, end);
		if (p == end || *p++ != ':') {
			return -EINVAL;
		}
		p = skip_space(p, end);
		if (p < end && *p == '"') {
			values[n] = ++p;
			while (p < end && *p != '"' && *p != '\\') {
				p++;
			}
			if (p == end || *p != '"') {
				return -EINVAL;
			}
			*p++ = '\0';
			p = skip_space(p, end);
			delim = p < end ? *p++ : '\0';
		} else {
			values[n] = p;
			while (p < end && (*p == '-' || (*p >= '0' && *p <= '9') ||
					   (*p >= 'a' && *p <= 'z'))) {
				p++;
			}
			if (p == values[n]) {
				return -EINVAL;
			}
			delim = p < end ? *p : '\0';
			*p = '\0';
			p = skip_space(p + 1, end);
			if (delim == ' ' || delim == '\t' || delim == '\r' || delim == '\n') {
				delim = p < end ? *p++ : '\0';
			}
		}
		n++;
		if (delim == '}') {
			return n;
		}
		if (delim != ',') {
			return -EINVAL;
		}
		p = skip_space(p, end);
	}
}

static int camera_handler(struct http_client_ctx *client, enum http_transaction_status status,
			  const struct http_request_ctx *req, struct http_response_ctx *rsp,
			  void *user_data)
{
	static char body[256];
	static size_t len;
	static bool too_long;
	char *names[CAMERA_FIELDS_MAX];
	char *values[CAMERA_FIELDS_MAX];
	bool reset = false;
	const char *err;
	int n;
	int m = 0;

	ARG_UNUSED(user_data);

	if (status == HTTP_SERVER_TRANSACTION_ABORTED ||
	    status == HTTP_SERVER_TRANSACTION_COMPLETE) {
		len = 0;
		too_long = false;
		return 0;
	}

	/* One byte kept for the NUL that ends the last value */
	if (len + req->data_len > sizeof(body) - 1) {
		too_long = true;
	} else {
		memcpy(body + len, req->data, req->data_len);
		len += req->data_len;
	}

	if (status != HTTP_SERVER_REQUEST_DATA_FINAL) {
		return 0;
	}

	/* Its settings are the bay's, like the power: control (and the lease) */
	if (refused(rsp, client->method == HTTP_POST ? ACL_CONTROL : ACL_STATUS,
		    access_peer(client->fd))) {
		return 0;
	}

	if (client->method == HTTP_POST) {
		if (!camera_present()) {
			respond_error(rsp, HTTP_404_NOT_FOUND, "no camera on this bay");
			return 0;
		}
		if (too_long) {
			respond_error(rsp, HTTP_413_PAYLOAD_TOO_LARGE, "body too large");
			return 0;
		}
		n = flat_json(body, body + len, names, values, ARRAY_SIZE(names));
		if (n < 0) {
			respond_error(rsp, HTTP_400_BAD_REQUEST,
				      "bad JSON: a flat object of strings and numbers");
			return 0;
		}
		/* "reset": true, the image settings back to automatic first */
		for (int i = 0; i < n; i++) {
			if (strcmp(names[i], "reset") == 0) {
				reset = strcmp(values[i], "true") == 0;
			} else {
				names[m] = names[i];
				values[m++] = values[i];
			}
		}
		err = camera_configure((const char *const *)names, (const char *const *)values, m,
				       reset);
		if (err != NULL) {
			respond_error(rsp, HTTP_400_BAD_REQUEST, err);
			return 0;
		}
	}

	respond_buf(rsp, camera_json(resp_buf, sizeof(resp_buf), true));

	return 0;
}

static struct http_resource_detail_dynamic camera_detail = {
	.common = {
		.type = HTTP_RESOURCE_TYPE_DYNAMIC,
		.bitmask_of_supported_http_methods = BIT(HTTP_GET) | BIT(HTTP_POST),
		.content_type = "application/json",
	},
	.cb = camera_handler,
};

#endif /* CONFIG_BAY_CAMERA */

static struct http_resource_detail_dynamic status_detail = {
	.common = {
		.type = HTTP_RESOURCE_TYPE_DYNAMIC,
		.bitmask_of_supported_http_methods = BIT(HTTP_GET),
		.content_type = "application/json",
	},
	.cb = status_handler,
};

/* --- /api/access, /api/lease, /api/console/ticket -------------------------- */

enum access_api {
	ACC_DOC,    /* GET  /api/access */
	ACC_NONCE,  /* GET  /api/access/nonce */
	ACC_CLAIM,  /* POST /api/access/claim */
	ACC_RULES,  /* POST /api/access/rules, admin */
	ACC_KICK,   /* POST /api/access/kick, admin */
	ACC_KEY,    /* POST /api/access/key, admin */
	ACC_LEASE,  /* POST /api/lease */
	ACC_TICKET, /* POST /api/console/ticket */
};

/* What admin requests sign */
static const char *const access_paths[] = {
	[ACC_DOC] = "/api/access",
	[ACC_NONCE] = "/api/access/nonce",
	[ACC_CLAIM] = "/api/access/claim",
	[ACC_RULES] = "/api/access/rules",
	[ACC_KICK] = "/api/access/kick",
	[ACC_KEY] = "/api/access/key",
	[ACC_LEASE] = "/api/lease",
	[ACC_TICKET] = "/api/console/ticket",
};

/* Default and longest lease when the request gives no ttl_s */
#define LEASE_DEFAULT_S 3600

struct access_req {
	char *key;
	char *ticket;
	char *id;
	char *note;
	int32_t ttl_s;
	bool release;
	char *ports[ACL_MAX_PORTS + 1];
	size_t ports_len;
};

static const struct json_obj_descr access_req_descr[] = {
	JSON_OBJ_DESCR_PRIM(struct access_req, key, JSON_TOK_STRING),
	JSON_OBJ_DESCR_PRIM(struct access_req, ticket, JSON_TOK_STRING),
	JSON_OBJ_DESCR_PRIM(struct access_req, id, JSON_TOK_STRING),
	JSON_OBJ_DESCR_PRIM(struct access_req, note, JSON_TOK_STRING),
	JSON_OBJ_DESCR_PRIM(struct access_req, ttl_s, JSON_TOK_NUMBER),
	JSON_OBJ_DESCR_PRIM(struct access_req, release, JSON_TOK_TRUE),
	JSON_OBJ_DESCR_ARRAY(struct access_req, ports, ACL_MAX_PORTS + 1, ports_len,
			     JSON_TOK_STRING),
};

#define AREQ_KEY     BIT(0)
#define AREQ_TICKET  BIT(1)
#define AREQ_ID      BIT(2)
#define AREQ_NOTE    BIT(3)
#define AREQ_TTL     BIT(4)
#define AREQ_RELEASE BIT(5)
#define AREQ_PORTS   BIT(6)

static void respond_access(struct http_response_ctx *rsp, uint32_t ip, bool admin)
{
	respond_buf(rsp, access_json(resp_buf, sizeof(resp_buf), ip, admin));
}

static void respond_claim(struct http_response_ctx *rsp, uint32_t ip, const struct access_req *req,
			  int fields)
{
	uint8_t offered[ACL_KEY_LEN];
	char hex[2 * ACL_KEY_LEN + 1];
	int remaining = 0;
	int ret;

	if (fields & AREQ_TICKET) {
		ret = access_claim_poll(ip, req->ticket, hex, &remaining);
		if (ret == -EINPROGRESS) {
			respond_buf(rsp, snprintf(resp_buf, sizeof(resp_buf),
						  "{\"state\":\"pending\",\"remaining_s\":%d}",
						  remaining));
		} else if (ret == 0) {
			respond_buf(rsp, snprintf(resp_buf, sizeof(resp_buf),
						  "{\"state\":\"done\",\"key\":\"%s\"}", hex));
		} else {
			respond_error(rsp, HTTP_404_NOT_FOUND,
				      ret == -ETIMEDOUT ? "nobody pressed BOOT in time"
							: "no such claim from this address");
		}
		return;
	}

	if ((fields & AREQ_KEY) && acl_hex_decode(req->key, offered, sizeof(offered)) != 0) {
		respond_error(rsp, HTTP_400_BAD_REQUEST, "key: 64 hex digits");
		return;
	}
	ret = access_claim_start(ip, (fields & AREQ_KEY) ? offered : NULL, hex);
	if (ret == -EALREADY) {
		respond_error(rsp, HTTP_409_CONFLICT,
			      "already claimed: unlock with the admin key, or reset the node");
		return;
	}
	respond_buf(rsp, snprintf(resp_buf, sizeof(resp_buf),
				  "{\"state\":\"pending\",\"ticket\":\"%s\","
				  "\"remaining_s\":%d}",
				  hex, CONFIG_BAY_ACCESS_CLAIM_S));
}

static int port_by_slot(const char *s)
{
	char name[24];
	int count = ports_count();

	if (s == NULL) {
		return 0;
	}
	for (int p = 1; p <= count; p++) {
		slot_name(p, name, sizeof(name));
		if (strcasecmp(s, name) == 0) {
			return p;
		}
	}
	return 0;
}

static void respond_port_reserved(struct http_response_ctx *rsp, int port, uint32_t holder_ip)
{
	char slot[24], holder[ACL_IP_STR_LEN];

	slot_name(port, slot, sizeof(slot));
	acl_format_ip(holder_ip, holder);
	snprintf(resp_buf, sizeof(resp_buf),
		 "{\"error\":\"%s reserved by %s\",\"reason\":\"reserved\"}", slot, holder);
	rsp->status = HTTP_423_LOCKED;
	rsp->body = resp_buf;
	rsp->body_len = strlen(resp_buf);
	rsp->final_chunk = true;
}

static void respond_lease(struct http_response_ctx *rsp, uint32_t ip, bool admin,
			  const struct access_req *req, int fields)
{
	struct acl_lease lease;
	uint32_t remaining;
	int ret;

	if (fields & AREQ_PORTS) {
		int chosen[ACL_MAX_PORTS];
		int count = ports_count();

		if (count == 0) {
			respond_error(rsp, HTTP_400_BAD_REQUEST,
				      "this node serves one board: lease the bay (no \"ports\")");
			return;
		}
		if (req->ports_len == 0 || req->ports_len > (size_t)count) {
			respond_error(rsp, HTTP_400_BAD_REQUEST, "ports: a list of sub-slots");
			return;
		}
		for (size_t i = 0; i < req->ports_len; i++) {
			chosen[i] = port_by_slot(req->ports[i]);
			if (chosen[i] == 0) {
				respond_error(rsp, HTTP_400_BAD_REQUEST,
					      "ports: unknown sub-slot");
				return;
			}
		}
		if ((fields & AREQ_RELEASE) && req->release) {
			for (size_t i = 0; i < req->ports_len; i++) {
				if (!admin &&
				    access_port_lease_get(chosen[i], &lease, &remaining) &&
				    lease.holder != ip) {
					respond_error(rsp, HTTP_403_FORBIDDEN,
						      "only its holder or an admin may release it");
					return;
				}
			}
			for (size_t i = 0; i < req->ports_len; i++) {
				(void)access_port_lease_release(chosen[i], ip, admin);
			}
		} else {
			uint32_t ttl = (fields & AREQ_TTL) ? req->ttl_s : LEASE_DEFAULT_S;

			if (refused(rsp, ACL_CONTROL, ip)) {
				return;
			}
			if ((fields & AREQ_TTL) &&
			    (req->ttl_s < ACL_LEASE_MIN_S || req->ttl_s > ACL_LEASE_MAX_S)) {
				respond_error(rsp, HTTP_400_BAD_REQUEST,
					      "ttl_s must be 10..86400");
				return;
			}
			for (size_t i = 0; i < req->ports_len; i++) {
				if (access_port_lease_get(chosen[i], &lease, &remaining) &&
				    lease.holder != ip) {
					respond_port_reserved(rsp, chosen[i], lease.holder);
					return;
				}
			}
			for (size_t i = 0; i < req->ports_len; i++) {
				(void)access_port_lease_take(
					chosen[i], ip, ttl, (fields & AREQ_NOTE) ? req->note : "");
			}
		}
	} else if ((fields & AREQ_RELEASE) && req->release) {
		ret = access_lease_release(ip, admin);
		if (ret == -EPERM) {
			respond_error(rsp, HTTP_403_FORBIDDEN,
				      "only its holder or an admin may release it");
			return;
		}
	} else {
		/* 423 with the holder when another address has it */
		if (refused(rsp, ACL_CONTROL, ip)) {
			return;
		}
		for (int p = 1; p <= ports_count(); p++) {
			if (access_port_lease_get(p, &lease, &remaining) && lease.holder != ip) {
				respond_port_reserved(rsp, p, lease.holder);
				return;
			}
		}
		ret = access_lease_take(ip, (fields & AREQ_TTL) ? req->ttl_s : LEASE_DEFAULT_S,
					(fields & AREQ_NOTE) ? req->note : "");
		if (ret == -EINVAL) {
			respond_error(rsp, HTTP_400_BAD_REQUEST, "ttl_s must be 10..86400");
			return;
		}
	}

	status_ip = ip;
	respond_access(rsp, ip, admin);
	if (ports_count() > 0 && rsp->status == 0) {
		status_append("ports", ports_status_json);
		rsp->body_len = strlen(resp_buf);
	}
}

static void do_access(enum access_api what, struct http_client_ctx *client, char *body,
		      size_t len, const char *auth, struct http_response_ctx *rsp)
{
	const char *method = client->method == HTTP_POST ? "POST" : "GET";
	uint32_t ip = access_peer(client->fd);
	struct access_req req = {0};
	char hex[2 * ACL_KEY_LEN + 1];
	bool admin = false;
	int fields = 0;
	int ret;

	/* Before parsing: the signature covers the body as sent */
	if (auth[0] != '\0') {
		admin = access_admin(auth, method, access_paths[what], (const uint8_t *)body, len);
		if (!admin) {
			respond_error(rsp, HTTP_403_FORBIDDEN, "bad or expired admin signature");
			return;
		}
	}
	if (!admin && (what == ACC_RULES || what == ACC_KICK || what == ACC_KEY)) {
		respond_error(rsp, HTTP_403_FORBIDDEN, "admin only: sign the request with the key");
		return;
	}

	switch (what) {
	case ACC_DOC:
		if (admin || !refused(rsp, ACL_STATUS, ip)) {
			respond_access(rsp, ip, admin);
		}
		return;
	case ACC_NONCE:
		(void)access_nonce(hex);
		respond_buf(rsp, snprintf(resp_buf, sizeof(resp_buf), "{\"nonce\":\"%s\"}", hex));
		return;
	case ACC_RULES: {
		struct acl_rules rules;
		const char *err = access_rules_parse(body, len, &rules);

		if (err != NULL) {
			respond_error(rsp, HTTP_400_BAD_REQUEST, err);
			return;
		}
		if (access_rules_set(&rules) != 0) {
			respond_error(rsp, HTTP_500_INTERNAL_SERVER_ERROR,
				      "rules applied, not saved");
			return;
		}
		respond_access(rsp, ip, true);
		return;
	}
	default:
		break;
	}

	if (len > 0) {
		fields = json_obj_parse(body, len, access_req_descr, ARRAY_SIZE(access_req_descr),
					&req);
		if (fields < 0) {
			respond_error(rsp, HTTP_400_BAD_REQUEST, "bad JSON");
			return;
		}
	}

	switch (what) {
	case ACC_CLAIM:
		respond_claim(rsp, ip, &req, fields);
		break;
	case ACC_KICK:
		if (!(fields & AREQ_ID) || access_kick(req.id) != 0) {
			respond_error(rsp, HTTP_404_NOT_FOUND, "no such connection");
			break;
		}
		respond_access(rsp, ip, true);
		break;
	case ACC_KEY: {
		uint8_t new_key[ACL_KEY_LEN];

		if (!(fields & AREQ_KEY) ||
		    acl_hex_decode(req.key, new_key, sizeof(new_key)) != 0) {
			respond_error(rsp, HTTP_400_BAD_REQUEST, "key: 64 hex digits");
			break;
		}
		ret = access_set_key(new_key);
		respond_buf(rsp, snprintf(resp_buf, sizeof(resp_buf), "{\"saved\":%s}",
					  ret == 0 ? "true" : "false"));
		break;
	}
	case ACC_LEASE:
		respond_lease(rsp, ip, admin, &req, fields);
		break;
	case ACC_TICKET:
		if (!refused(rsp, ACL_CONSOLE, ip)) {
			(void)access_console_ticket(ip, hex);
			respond_buf(rsp, snprintf(resp_buf, sizeof(resp_buf),
						  "{\"ticket\":\"%s\"}", hex));
		}
		break;
	default:
		respond_error(rsp, HTTP_404_NOT_FOUND, "not found");
		break;
	}
}

static int access_handler(struct http_client_ctx *client, enum http_transaction_status status,
			  const struct http_request_ctx *req, struct http_response_ctx *rsp,
			  void *user_data)
{
	/* The rules of 8 sources fit */
	static char body[1024];
	static size_t len;
	static bool too_long;
	static char auth[100];

	if (status == HTTP_SERVER_TRANSACTION_ABORTED ||
	    status == HTTP_SERVER_TRANSACTION_COMPLETE) {
		len = 0;
		too_long = false;
		auth[0] = '\0';
		return 0;
	}

	capture_auth(req, auth, sizeof(auth));

	if (len + req->data_len >= sizeof(body)) {
		too_long = true;
	} else {
		memcpy(body + len, req->data, req->data_len);
		len += req->data_len;
	}

	if (status != HTTP_SERVER_REQUEST_DATA_FINAL) {
		return 0;
	}

	if (too_long) {
		respond_error(rsp, HTTP_413_PAYLOAD_TOO_LARGE, "body too large");
		return 0;
	}
	body[len] = '\0';

	do_access((enum access_api)POINTER_TO_INT(user_data), client, body, len, auth, rsp);

	return 0;
}

#define ACCESS_RESOURCE(_api, _method)                                                             \
	{                                                                                          \
		.common = {                                                                        \
			.type = HTTP_RESOURCE_TYPE_DYNAMIC,                                        \
			.bitmask_of_supported_http_methods = BIT(_method),                         \
			.content_type = "application/json",                                        \
		},                                                                                 \
		.cb = access_handler,                                                              \
		.user_data = INT_TO_POINTER(_api),                                                 \
	}

static struct http_resource_detail_dynamic access_doc_detail = ACCESS_RESOURCE(ACC_DOC, HTTP_GET);
static struct http_resource_detail_dynamic access_nonce_detail =
	ACCESS_RESOURCE(ACC_NONCE, HTTP_GET);
static struct http_resource_detail_dynamic access_claim_detail =
	ACCESS_RESOURCE(ACC_CLAIM, HTTP_POST);
static struct http_resource_detail_dynamic access_rules_detail =
	ACCESS_RESOURCE(ACC_RULES, HTTP_POST);
static struct http_resource_detail_dynamic access_kick_detail =
	ACCESS_RESOURCE(ACC_KICK, HTTP_POST);
static struct http_resource_detail_dynamic access_key_detail = ACCESS_RESOURCE(ACC_KEY, HTTP_POST);
static struct http_resource_detail_dynamic lease_detail = ACCESS_RESOURCE(ACC_LEASE, HTTP_POST);
static struct http_resource_detail_dynamic ticket_detail = ACCESS_RESOURCE(ACC_TICKET, HTTP_POST);

/* --- /metrics ------------------------------------------------------------ */

PROMETHEUS_COLLECTOR_DEFINE(bay_collector);

/* The library wants one label per metric: the bay id (set per scrape) */
#define BAY_LABEL ({.key = "bay", .value = ""})

PROMETHEUS_GAUGE_DEFINE(bay_dut_vbus_volts, "DUT VBUS voltage after the switch", BAY_LABEL,
			&bay_collector);
PROMETHEUS_GAUGE_DEFINE(bay_dut_current_amperes, "DUT VBUS current", BAY_LABEL, &bay_collector);
PROMETHEUS_GAUGE_DEFINE(bay_dut_power_watts, "DUT VBUS power", BAY_LABEL, &bay_collector);
PROMETHEUS_GAUGE_DEFINE(bay_dut_power_on, "DUT VBUS switch on (1) or off (0)", BAY_LABEL,
			&bay_collector);
PROMETHEUS_GAUGE_DEFINE(bay_dut_fault, "DUT VBUS in current limit or cut by a fault", BAY_LABEL,
			&bay_collector);
PROMETHEUS_COUNTER_DEFINE(bay_dut_faults_total, "DUT VBUS faults since boot", BAY_LABEL,
			  &bay_collector);
PROMETHEUS_GAUGE_DEFINE(bay_usb_devices, "USB devices enumerated on the DUT port", BAY_LABEL,
			&bay_collector);
PROMETHEUS_GAUGE_DEFINE(bay_usbip_sessions, "Open USB/IP sessions", BAY_LABEL, &bay_collector);
PROMETHEUS_COUNTER_DEFINE(bay_aux_rx_bytes_total, "Bytes from the DUT console to the client",
			  BAY_LABEL, &bay_collector);
PROMETHEUS_COUNTER_DEFINE(bay_aux_tx_bytes_total, "Bytes from the client to the DUT console",
			  BAY_LABEL, &bay_collector);
PROMETHEUS_COUNTER_DEFINE(bay_access_refused_total, "Connections and requests the rules refused",
			  BAY_LABEL, &bay_collector);
PROMETHEUS_GAUGE_DEFINE(bay_power_limit_watts,
			"Node v1.0: what the DATA ports are switched on within (the hub's grant)",
			BAY_LABEL, &bay_collector);
PROMETHEUS_GAUGE_DEFINE(bay_ports_waiting, "DATA ports wanted on and kept off, waiting for power",
			BAY_LABEL, &bay_collector);
PROMETHEUS_COUNTER_DEFINE(bay_ports_shed_total, "DATA ports shed for power since boot", BAY_LABEL,
			  &bay_collector);

static struct prometheus_metric *const metrics[] = {
	&bay_dut_vbus_volts.base,   &bay_dut_current_amperes.base, &bay_dut_power_watts.base,
	&bay_dut_power_on.base,     &bay_dut_fault.base,           &bay_dut_faults_total.base,
	&bay_usb_devices.base,      &bay_usbip_sessions.base,      &bay_aux_rx_bytes_total.base,
	&bay_aux_tx_bytes_total.base, &bay_access_refused_total.base, &bay_power_limit_watts.base,
	&bay_ports_waiting.base,    &bay_ports_shed_total.base,
};

static void metrics_update(void)
{
	static struct status_doc s;
	const char *label = bay_id()[0] != '\0' ? bay_id() : net_hostname_get();
	struct ports_budget pb = {0};

	status_fill(&s, 0);
	(void)ports_budget(&pb);

	ARRAY_FOR_EACH(metrics, i) {
		metrics[i]->labels[0].value = label;
	}

	/* Gauges reject negative values: clamp the INA226 offset around 0 A */
	prometheus_gauge_set(&bay_dut_vbus_volts, MAX(s.dut.mv, 0) / 1000.0);
	prometheus_gauge_set(&bay_dut_current_amperes, MAX(s.dut.ma, 0) / 1000.0);
	prometheus_gauge_set(&bay_dut_power_watts, MAX(s.dut.mw, 0) / 1000.0);
	prometheus_gauge_set(&bay_dut_power_on, s.dut.on ? 1.0 : 0.0);
	prometheus_gauge_set(&bay_dut_fault, (s.dut.fault || s.dut.latched) ? 1.0 : 0.0);
	prometheus_counter_set(&bay_dut_faults_total, (uint64_t)s.dut.faults);
	prometheus_gauge_set(&bay_usb_devices, s.usb.devices);
	prometheus_gauge_set(&bay_usbip_sessions, s.usb.sessions);
	prometheus_counter_set(&bay_aux_rx_bytes_total, (uint32_t)s.aux.rx);
	prometheus_counter_set(&bay_aux_tx_bytes_total, (uint32_t)s.aux.tx);
	prometheus_counter_set(&bay_access_refused_total, access_refused_total());
	prometheus_gauge_set(&bay_power_limit_watts, pb.power ? MAX(pb.limit, 0) / 1000.0 : 0.0);
	prometheus_gauge_set(&bay_ports_waiting, pb.waiting);
	prometheus_counter_set(&bay_ports_shed_total, pb.sheds);
}

static int metrics_handler(struct http_client_ctx *client, enum http_transaction_status status,
			   const struct http_request_ctx *req, struct http_response_ctx *rsp,
			   void *user_data)
{
	int ret;

	ARG_UNUSED(req);
	ARG_UNUSED(user_data);

	if (status != HTTP_SERVER_REQUEST_DATA_FINAL) {
		return 0;
	}
	if (refused(rsp, ACL_STATUS, access_peer(client->fd))) {
		return 0;
	}

	metrics_update();
	/* The formatter appends to the string already in the buffer */
	resp_buf[0] = '\0';
	ret = prometheus_format_exposition(&bay_collector, resp_buf, sizeof(resp_buf));
	if (ret < 0) {
		LOG_ERR("metrics formatting failed: %d", ret);
		return ret;
	}

	rsp->body = resp_buf;
	rsp->body_len = strlen(resp_buf);
	rsp->final_chunk = true;

	return 0;
}

static struct http_resource_detail_dynamic metrics_detail = {
	.common = {
		.type = HTTP_RESOURCE_TYPE_DYNAMIC,
		.bitmask_of_supported_http_methods = BIT(HTTP_GET),
		.content_type = "text/plain; version=0.0.4",
	},
	.cb = metrics_handler,
};

/* --- Static files: the page, gzipped into the image ----------------------- */

/* /rack.css, /rack.mjs and xterm.js are firmware/common's (hwtr_web_* in CMakeLists.txt) */

static const uint8_t index_html_gz[] = {
#include "index.html.gz.inc"
};

static struct http_resource_detail_static index_detail =
	HWTR_WEB_STATIC_GZ(index_html_gz, "text/html");

/* The board targets the page suggests, from boards.yaml (web/board_targets.py) */
static const uint8_t board_targets_gz[] = {
#include "board-targets.json.gz.inc"
};

static struct http_resource_detail_static board_targets_detail =
	HWTR_WEB_STATIC_GZ(board_targets_gz, "application/json");

/* --- /console/ws/<slot>: one WebSocket resource (and buffer) per console --- */

/*
 * A WebSocket descriptor has no peer address: the page asks for a ticket
 * first (POST /api/console/ticket checks the console right for its
 * address) and opens /console/ws/<slot>?t=<ticket>.
 */
static int console_ws_setup(int ws_socket, struct http_request_ctx *request_ctx, void *user_data)
{
	char ticket[17] = "";
	const char *t = NULL;
	uint32_t ip;

	if (request_ctx->data != NULL) {
		t = strstr((const char *)request_ctx->data, "t=");
	}
	if (t != NULL) {
		strncpy(ticket, t + 2, sizeof(ticket) - 1);
		ticket[strcspn(ticket, "&")] = '\0';
	}

	ip = access_console_redeem(ticket);
	if (ip == 0 || access_check(ACL_CONSOLE, ip) != ACL_OK) {
		return -EACCES;
	}

	return aux_console_ws_attach(POINTER_TO_INT(user_data), ws_socket, ip);
}

/*
 * The server registers each WebSocket with its resource's data buffer, so
 * two consoles on one resource would share it: one resource per slot.
 */
#define CONSOLE_WS(_slot, _)                                                                       \
	static uint8_t console_ws_buf_##_slot[256];                                                \
	static struct http_resource_detail_websocket console_ws_detail_##_slot = {                 \
		.common = {                                                                        \
			.type = HTTP_RESOURCE_TYPE_WEBSOCKET,                                      \
			.bitmask_of_supported_http_methods = BIT(HTTP_GET),                        \
		},                                                                                 \
		.cb = console_ws_setup,                                                            \
		.data_buffer = console_ws_buf_##_slot,                                             \
		.data_buffer_len = sizeof(console_ws_buf_##_slot),                                 \
		.user_data = INT_TO_POINTER(_slot),                                                \
	}

/* --- Service ------------------------------------------------------------- */

static uint16_t http_port = CONFIG_BAY_HTTP_PORT;

HTTP_SERVICE_DEFINE(bay_http, NULL, &http_port, CONFIG_HTTP_SERVER_MAX_CLIENTS, 4, NULL, NULL,
		    NULL);

HTTP_RESOURCE_DEFINE(index_res, bay_http, "/", &index_detail);
HTTP_RESOURCE_DEFINE(status_res, bay_http, "/api/status", &status_detail);
HTTP_RESOURCE_DEFINE(power_res, bay_http, "/api/power", &power_detail);
HTTP_RESOURCE_DEFINE(reset_res, bay_http, "/api/reset", &reset_detail);
HTTP_RESOURCE_DEFINE(boot_res, bay_http, "/api/boot", &boot_detail);
HTTP_RESOURCE_DEFINE(mode_res, bay_http, "/api/mode", &mode_detail);
HTTP_RESOURCE_DEFINE(ports_res, bay_http, "/api/ports", &ports_detail);
HTTP_RESOURCE_DEFINE(usb_res, bay_http, "/api/usb", &usb_detail);
HTTP_RESOURCE_DEFINE(boards_res, bay_http, "/api/boards", &boards_detail);
HTTP_RESOURCE_DEFINE(board_targets_res, bay_http, "/board-targets.json", &board_targets_detail);
HTTP_RESOURCE_DEFINE(metrics_res, bay_http, "/metrics", &metrics_detail);
HTTP_RESOURCE_DEFINE(aux_res, bay_http, "/api/aux", &aux_detail);
HTTP_RESOURCE_DEFINE(break_res, bay_http, "/api/aux/break", &break_detail);
HTTP_RESOURCE_DEFINE(access_res, bay_http, "/api/access", &access_doc_detail);
HTTP_RESOURCE_DEFINE(access_nonce_res, bay_http, "/api/access/nonce", &access_nonce_detail);
HTTP_RESOURCE_DEFINE(access_claim_res, bay_http, "/api/access/claim", &access_claim_detail);
HTTP_RESOURCE_DEFINE(access_rules_res, bay_http, "/api/access/rules", &access_rules_detail);
HTTP_RESOURCE_DEFINE(access_kick_res, bay_http, "/api/access/kick", &access_kick_detail);
HTTP_RESOURCE_DEFINE(access_key_res, bay_http, "/api/access/key", &access_key_detail);
HTTP_RESOURCE_DEFINE(lease_res, bay_http, "/api/lease", &lease_detail);
HTTP_RESOURCE_DEFINE(ticket_res, bay_http, "/api/console/ticket", &ticket_detail);
#if defined(CONFIG_BAY_CAMERA)
HTTP_RESOURCE_DEFINE(camera_res, bay_http, "/api/camera", &camera_detail);
#endif

#define CONSOLE_WS_RESOURCE(_slot, _)                                                              \
	CONSOLE_WS(_slot, _);                                                                      \
	HTTP_RESOURCE_DEFINE(console_ws_res_##_slot, bay_http, "/console/ws/" STRINGIFY(_slot),    \
			     &console_ws_detail_##_slot)

LISTIFY(CONFIG_BAY_CONSOLE_WEB_CLIENTS, CONSOLE_WS_RESOURCE, (;));

/* /api/ports/<n>/power, /reset, /boot: n = 1..4, a DATA x4's ports */
#define PORT_RESOURCES(_i, _)                                                                      	static struct http_resource_detail_dynamic port_power_detail_##_i =                        		ACTION_RESOURCE(PORT_ACTION(API_POWER, _i + 1));                                   	static struct http_resource_detail_dynamic port_reset_detail_##_i =                        		ACTION_RESOURCE(PORT_ACTION(API_RESET, _i + 1));                                   	static struct http_resource_detail_dynamic port_boot_detail_##_i =                         		ACTION_RESOURCE(PORT_ACTION(API_BOOT, _i + 1));                                    	HTTP_RESOURCE_DEFINE(port_power_res_##_i, bay_http,                                        			     "/api/ports/" STRINGIFY(UTIL_INC(_i)) "/power",                       			     &port_power_detail_##_i);                                             	HTTP_RESOURCE_DEFINE(port_reset_res_##_i, bay_http,                                        			     "/api/ports/" STRINGIFY(UTIL_INC(_i)) "/reset",                       			     &port_reset_detail_##_i);                                             	HTTP_RESOURCE_DEFINE(port_boot_res_##_i, bay_http,                                         			     "/api/ports/" STRINGIFY(UTIL_INC(_i)) "/boot", &port_boot_detail_##_i)

LISTIFY(4, PORT_RESOURCES, (;));

/* /api/ports/<n>/board: n = 1..4 (1: a one-board node's DUT) */
#define BOARD_RESOURCE_DEFINE(_i, _)                                                               \
	HTTP_RESOURCE_DEFINE(board_res_##_i, bay_http,                                             \
			     "/api/ports/" STRINGIFY(UTIL_INC(_i)) "/board", &board_detail_##_i)

LISTIFY(BOARDS_MAX, BOARD_RESOURCE_DEFINE, (;));

int web_init(void)
{
	int ret;

	/* The collector lists metrics in reverse registration order */
	for (int i = ARRAY_SIZE(metrics) - 1; i >= 0; i--) {
		ret = prometheus_collector_register_metric(&bay_collector, metrics[i]);
		if (ret != 0) {
			return ret;
		}
	}

	ret = http_server_start();
	if (ret != 0) {
		return ret;
	}

	LOG_INF("web page and API on http port %d", CONFIG_BAY_HTTP_PORT);

	return 0;
}
