kartben/hw-testing-rack/(commit log)

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2026-10-16 Keep board design rules when regenerating the schematic
    write_project rebuilt <board>.kicad_pro from scratch, so a --sch-only run
    reset board.design_settings (min track/clearance/via/drill/edge rules,
    severities, teardrops) to KiCad defaults until a full PcbBuilder run
    re-applied them, and the read-only CI DRC then checked the wrong rules.
    Load an existing project file and update only the generator-owned parts
    (net classes and patterns, sheets, REV, schematic lib fields), merging net
    classes by name so KiCad-added keys survive. A --sch-only run of bay-node
    now leaves bay-node.kicad_pro byte-identical.
    [eda.py]
2026-10-16 Add the Zephyr firmware for the bay node
    firmware/ holds a west manifest (Zephyr main + hal_espressif + crypto),
    the bay_node/esp32s3/procpu board definition with its pin map from
    electronics/bay-node/design.py, hwtr,dut-port and hwtr,usb-mux bindings,
    and the bay-node application:
    - USB/IP export of the DUT through the USB/IP host service on the DWC2
    host controller (ESP32-S3 FS quirk)
    - DUT VBUS on/off/cycle (TPS2553), fault reporting and over-current
    cut-off, INA226 V/I/P through the sensor API
    - data-path modes (PC_DET, SERVICE, MUX_FORCE_PC) and the SERVICE-mode
    handover of the USB PHY to the USB-Serial-JTAG
    - WS2812B status LED, AUX UART <-> TCP bridge, RESET/BOOT control
    - Wi-F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
    [bay.h, dut.c]
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2026-10-16 Add a web page, JSON API and Prometheus metrics to the bay node
    The node now serves, with Zephyr's HTTP server on port 80:
    - a status page (firmware/bay-node/web/index.html, gzipped into the
    image): plain HTML/CSS and an ES module, light/dark, live V/I/P with a
    current sparkline, power/reset/bootloader actions and the data-path
    switch;
    - a JSON API mirroring the shell: GET /api/status, POST /api/power,
    /api/reset, /api/boot and /api/mode;
    - GET /metrics in Prometheus format through Zephyr's Prometheus library.
    web/dev_server.py serves the page with a simulated API to work on the UI
    without a node. Both targets still build with no warnings; DRAM goes
    from 84.6% to 88.8%. Not run on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
    [bay.h, dev_server.py, main.c, web.c]
2026-10-16 Real board models in the renders; fixes to the mug and detail focus
    tools/fetch_render_assets.py now also fetches the board models makers
    publish without login: Raspberry Pi Pico 2 (MIT), Arduino UNO R4 WiFi
    (CC BY-SA 4.0) and Seeed XIAO ESP32S3 Sense, into render/assets/ (not
    committed). tools/board_models.py (STEP via cascadio) finds each PCB,
    turns the component side up and lays it on the boards.yaml frame;
    assembly_glb.py swaps them in for the stand-ins, oriented like
    orient_board(), and seats the XIAO Sense camera-down in the camera
    pods. --open-bays pulls extra drawers out for a shot.
    Photo scene: a new "boards" shot (Pico 2 on B3's pulled-out drawer),
    glazed ceramic mug moved into th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
    [assembly_glb.py, board_models.py, fetch_render_assets.py]
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2026-10-16 Schematics: draw real wires and an overview block diagram
    The generator used to connect every pin through a net label only. Now,
    in each block, the part with the most pins is the anchor and the
    two-pin parts that share a signal with one of its side pins hang off
    that pin on a real wire; parts chained behind them (R -> C -> GND)
    stack underneath, and anchor-less blocks (pull-ups, reset/boot
    buttons) are adopted by the anchor they connect to. Power symbols on
    side pins point outward; power-flag references are hidden.
    The root sheet becomes a block diagram: the supply rails each sheet
    uses across the top, and one lane per pair of sheets listing the
    signals they share.
    Every wired net still ca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
    [bay-node.kicad_sch, control.kicad_sch, dut.kicad_sch, input.kicad_sch, mcu.kicad_sch, outputs.kicad_sch, power-hub.kicad_sch, power.kicad_sch]
2026-10-16 Viewer: real USB plugs and cable routing
    Cables were tubes with a generic box at each end, oriented along the
    curve, so neither USB-C vs micro-B nor the two cables per bay (short DUT
    cable, extension through the drag chain) could be told apart.
    rack.json cables now carry their ends (receptacle face, insertion axis,
    plug type, straight or right-angle, panel socket) and their curves leave
    each plug along its exit direction. The viewer models the plugs from the
    connectors' outlines: USB-C stadium shell, micro-B/mini-B trapezoid,
    USB-A, overmold and strain relief, right-angle bodies for the short DUT
    cables, the drawer's panel-mount socket with its screws. The laptop
    cable hangs as a catenary t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
    [webscene.py]
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2026-10-16 JLC exports: one BOM line per part, CPL corrections, real quote
    - JLC BOM: lines that resolve to the same LCSC part are merged (J1/J2,
    J3/J4, SW1/SW2, U5/U6 on the node; D3 + D11-D15, J2-J6 on the hub), so
    JLC no longer deselects them as duplicates. The detailed BOM is unchanged.
    - CPL: JLC_CPL_FIX in build_board.py corrects rotation and origin per LCSC
    part to JLC's own (EasyEDA) footprints: JST VH/PH side entry 180° + half a
    pitch, SOT-223 180°, SOT-23/-5 180°, MSOP/VSSOP/SO-8/HTSSOP 270°, terminal
    and VH vertical half a pitch, USB-C, ESP32 module, TO-252 and MSK12C02
    origin offsets. Derived by fitting each part's EasyEDA pads onto the
    KiCad pads; the export stops if a li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
    [bay-node-bom-jlcpcb.csv, power-hub-bom-jlcpcb.csv, rack-bom.csv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]
2026-10-16 Hand-soldered connectors, lead-free HASL hub
    - catalog: hand_solder flag on the through-hole connectors (node J1 J2 VH,
    J6 PH; hub J1 KF128, J2-J6 VH). The JLC BOM and CPL leave them out; the
    detailed BOM flags them "hand-solder, buy loose (LCSC)" in a new Assembly
    column. Their JLC_CPL_FIX rows stay, marked as unused for now.
    - bom.py: jlc_order() applies the changes since the 2026-10-16 quote,
    indicatively: hub in lead-free HASL (~$1 instead of ENIG $17.60), no JLC
    hand-soldering fee ($3.61 per board order), loading fees of the two
    hand-soldered extended part types removed pro rata (-$6.20 node, -$4.41
    hub). Order ~$357.90 nodes + ~$49.51 hub; Electronics EUR 406 -> 375,
    to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
    [bay-node-bom-jlcpcb.csv, bay-node-bom.csv, power-hub-bom-jlcpcb.csv, power-hub-bom.csv, rack-bom.csv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]
2026-10-16 Drawer: two DATA socket positions; long boards turn their USB sideways
    Modelling the real plugs showed 5 of 16 DUT connections where the
    board's right-angle plug and the drawer's socket plug would occupy the
    same space: the DATA port sat at a fixed X and the board's USB often
    landed right in front of it, 17-22 mm away.
    The port wall now has two DATA socket positions (config/rack.yaml
    drawer.data_ports, 20 % / 80 % of the width) plus the AUX slot in the
    middle; the panel-mount socket goes in the one farther from the board's
    USB. Boards too long for a plug behind them can set `orient: side` in
    boards.yaml: the USB turns towards the right wall and the board sits to
    the left of its plate (the F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
    [board_plate.scad, boards.scad, config.scad, drawer.scad]
2026-10-16 Renders: USB plugs on every cable, lighter settings
    tools/assembly_glb.py now builds the same plugs as the viewer (USB-C,
    micro-B, mini-B, USB-A, straight or right-angle, panel socket), so the
    short DUT cables no longer end in mid-air. Photo shots default to
    1600x1000, up to 384 adaptive samples (threshold 0.01): about 40 s each.
    All photo and technical renders refreshed.
    [assembly_glb.py]
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2026-10-16 Boards v0.2: LMR51635 buck, JST PH, drawn schematics, thermal reliefs
    Addresses Fabio's review of v0.1.
    Bay node (rev 0.2):
    - 5 V buck: LMR51635YDDCR (60 V, 3.5 A, synchronous, 1.1 MHz) with a
    3.3 uH FXL0630, 3 x 22 uF out, 2 x 10 uF + 100 nF in, FB 120k/22k
    (5.16 V), EN 1M/100k UVLO (13.5 V on, 10.8 V off). Replaces the
    TPS54360B, its Schottky and compensation network. CIN straddles the
    VIN/GND pins on solid top-side islands with vias to In1 (TI SLUSF64B).
    - 24 V in/out on JST PH (carrier notches resized, rack.yaml pwr_y).
    - Power nets named along the path: 24V_BUS -> +24V -> +5V -> DUT_5V_SW
    -> shunt -> DUT_5V; the INA226 visibly runs from +3V3.
    - Stackup S+GND / GND / PWR / S+G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
    [bay-node-bom-jlcpcb.csv, bay-node-bom.csv, bay-node.kicad_pcb, bay-node.kicad_sch, carrier_base.scad, config.scad, control.kicad_sch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]
2026-10-16 Boards v0.2: Konnect review fixes (hub 24 V pours, eFuse vias, stackups)
    Review of both rev 0.2 boards with the Konnect MCP server (live KiCad 10),
    written up in docs/review-konnect.md. Fixes, all through the generator:
    Power hub
    - 24 V path as copper pours instead of 1.5 mm tracks (up to 7.3-8 A):
    VIN_RAW from J1 to Q1's tab, +24V over Q1/D2/C1/C2, a B.Cu strip under
    the eFuse row and an IN-pin island per eFuse, joined by vias.
    - six tented GND vias in each TPS26600 exposed pad, outside its mask
    opening; eFuse input/output caps moved next to their pins.
    - +24V out of the Power netclass (its tracks now only feed pull-ups/LEDs).
    Bay node
    - AMS1117 tab: solid +3V3 island with vias to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
    [bay-node.kicad_pcb, power-hub.kicad_pcb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]
2026-10-16 Bay node: Kelvin shunt for the INA226, hand-routed USB High-Speed path
    Kelvin shunt (review finding B4)
    - R19 is Device:R_Shunt on bench:R_1206_3216Metric_Kelvin: the stock 1206
    pads plus a tented sense pad on the inner edge of each terminal, tied by
    net-tie pad groups (generated by the new electronics/tools/footprints.py).
    - The INA226 reads SHUNT_P/SHUNT_N from those pads only, instead of tapping
    DUT_5V ~2.8 mm down the load track (~4-5 % gain error).
    USB High-Speed in classic mode (finding B3)
    - usb_hs_routes() in design.py draws the J3 -> U4 -> U5 -> U6 -> U8 -> J4
    chain as coupled pairs on F.Cu over In1 (0.25/0.15 mm, ~90 ohm estimate),
    ESD parts in flow-through, one B.Cu cro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
    [bay-node-bom-jlcpcb.csv, bay-node-bom.csv, bay-node.kicad_pcb, dut.kicad_sch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]
2026-10-16 Boards v0.3
    Both boards move to revision 0.3 after the Konnect review (title blocks,
    silkscreen, docs): the hub's 24 V pours and eFuse thermal vias, the stackups,
    the bay node's LDO copper, Kelvin shunt and hand-routed USB High-Speed path
    (see docs/review-konnect.md). No new part type; re-quote before ordering.
    Re-routed: the bay node now also fixes a via on each of J4's VBUS pads and on
    U10's GND pin, the two spots Freerouting left unrouted on some runs.
    ERC 0/0, DRC 0 errors / 0 warnings, 0 unconnected, parity 0 on both boards;
    JLC DFM audit 0 findings.
    [bay-node.kicad_pcb, bay-node.kicad_sch, control.kicad_sch, dut.kicad_sch, input.kicad_sch, mcu.kicad_sch, outputs.kicad_sch, power-hub.kicad_pcb]
2026-10-16 Bay node: USBLC6 in true flow-through, fixed DUT_5V run
    Fabio's remark on v0.3: the USBLC6-2SC6 is meant to be passed through, but
    the schematic put one net on both its I/O pins and the hand-routed pair ran
    a track under the package between them. The connector side is now its own
    net (PC_CONN_DP/DN, DUT_CONN_DP/DN on J3/J4 and U4/U8 pins 6/4), the protected
    side keeps PC_DP/DN and DUT_DP/DN (pins 1/3): the only path is through the
    part, and DRC would flag any copper bridging it. U4 is drawn mirrored so the
    schematic reads connector -> ESD -> mux.
    Freerouting left DUT_5V or a GND pad unrouted on some runs: DUT_5V's run from
    C21 to J4's VBUS pads (B.Cu, 0.6 mm) and short GND escapes for U10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
    [bay-node.kicad_pcb, usb.kicad_sch]
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2026-10-17 Bay node: no via drill under 0.3 mm
    JLCPCB charges ~$40 more on a 20-board order for 0.25 mm drills (it
    forces a 4-wire Kelvin test and FR4 Tg155). The small GND vias
    (fan-out, post-route ties, escapes by the USB parts) are now 0.5/0.3 mm,
    the project's DRC minimum drill is 0.3 mm and its minimum annular ring
    0.1 mm (written into the .kicad_pro, which pcbnew doesn't update). The
    B7 hop vias at both USB-C receptacles moved by 0.05-0.1 mm to keep their
    hole clearance. Re-routed: DRC 0 / 0 unconnected / parity 0, USB HS
    J3 -> J4 skew still 0.08 mm.
    [bay-node.kicad_pcb]
2026-10-17 Bay node: web serial console and RFC 2217 for the DUT's AUX UART
    The AUX UART (UART1, interrupt driven) is now shared by three kinds of
    clients, served by one thread (src/aux_console.c, replaces aux_bridge.c):
    - a web console in the status page: xterm.js 6.0.0 + fit addon (MIT,
    vendored byte for byte with the npm integrity, served gzipped from
    flash) over a binary WebSocket, /console/ws/<n>, two browsers at once;
    the last 16 KB received are replayed to a late client, and a page that
    reconnects skips what it already shows (per-boot id + stream position);
    RESET/BOOT, power off/on/cycle, BREAK, timestamps, clear, log download;
    a settings panel for baud (presets or custom), data bit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
    [aux_console.c, bay.h, check_pinmap.py, dev_server.py, dut.c, main.c]
2026-10-17 CI: bayctl rack CLI, twister hardware map, labgrid and PDUDaemon configs
    tools/bayctl.py drives the bays from a CI host through the node API,
    USB/IP and the AUX TCP port:
    - list/status/power/reset/boot/mode, attach/detach (Linux usbip, lists the
    /dev/serial/by-id entries a probe brings), prepare (USB/IP path, power,
    wait for enumeration, attach, wait for the tty), pty (stdin/stdout to the
    AUX UART for twister's serial_pty);
    - hwmap: a Zephyr twister hardware map with one pre-script per bay, probe
    id handling per runner (esp32: the port), warnings for family bays with no
    target and for runners shared by bays without a probe id;
    - export labgrid (raw NetworkSerialPort + ExternalPower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
    [bayctl.py, boards.yaml]
2026-10-17 Bay node: console screencast recorded on native_sim
    tests/console_sim builds the real aux_console.c, rfc2217.c and web.c for
    native_sim with the hardware stubbed; run.py (in the Zephyr build image)
    wires its AUX UART PTY to Zephyr's shell sample as the DUT and restarts it
    on RESET/power. web/screencast.py drives the page with Playwright and
    encodes docs/img/web-console.webp, shown in firmware/README.md and
    docs/firmware.md. CI builds the simulation too.
    Found on the way: a browser's keep-alive connections fill the HTTP
    server's client slots and it stops accepting, so the console's WebSocket
    never connects. The node now drops idle clients after 3 s; the
    simulation also gets 8 slots, as NS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
    [aux_console.c, screencast.py]
2026-10-17 Bay node: M5Stack StampS3 bench node, AUX UART loopback test
    A StampS3 runs the node application for the serial console and the
    network side: the overlay maps the AUX UART, RESET/BOOT (open drain,
    straight to an ESP32 DUT's EN/IO0) and the remaining node signals to
    header pins and the LED to its WS2812; the board conf turns USB/IP off,
    since the module's only USB PHY carries the console and the shell.
    usb_host.c reports no host when CONFIG_USBIP is off, and the SERVICE PHY
    handover depends on it.
    "bay aux loopback on" sets the ESP32 UART's internal loopback and
    "bay aux send <text>" writes a line to the DUT, to try the console path
    without a board attached. CI builds the StampS3 target too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
    [aux_console.c, bay.h, shell.c]
2026-10-17 Bay node: StampS3 smoke test results, hint for a foreign storage partition
    On a StampS3 flashed from the Mac: the firmware boots, the HTTP, RFC 2217,
    raw TCP and telnet listeners are up, the AUX settings persist across a
    reboot, and in UART loopback every byte sent comes back at 115200 and
    921600, also with the DUT switched off. 22 KB of system heap free before
    Wi-Fi connects, the console thread at 768 of 3072 bytes of stack idle.
    Nothing over the network yet: no Wi-Fi credentials on the module.
    The module's storage partition held another firmware's data, so NVS
    refused to mount (-EDEADLK) and nothing could be saved; the error now
    says to erase it, and the README says so for reused modules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
    [main.c]
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2026-10-17 Panel frame prototype: printed ladders and trays instead of the aluminium frame
    A 2 x 2 prototype of an all-printed rack:
    - ladders: side walls shared by two bays, stacked with a ridge/notch joint
    and in-plane snap hooks;
    - trays: carrier base + deck + guides in one part, with runners that slide
    into the ladder grooves and click in;
    - a base ladder with a floor plate, and a cap strip with a cap plate;
    - drawer.scad LIGHT=true: open floor, detent magnet over the ledge.
    tools/panel_proto.py renders the parts, estimates their filament with a
    slicer-like rule, and exports a 3D scene for the viewer.
    Estimates with the same rule for both designs:
    - one bay: 359 g -> 223 g;
    - 4 x 4 rack (stru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
    [drawer.scad, ladder.scad, tray.scad]
2026-10-17 Panel frame: rear X braces, regular grid plates, tighter runners
    - brace.scad: an X behind each bay and row, on split snap pins in the
    ladders' rear edges (left/right pins at different heights so neighbours
    share a ladder); the ladders get the four pin holes.
    - Cap and floor plates: a regular 30 mm grid at the camera-pod pitch with
    an insert boss at every crossing, instead of the odd keep-out shapes.
    - Runner play: 0.15 mm per side in the groove, 0.2 mm wall clearance.
    [brace.scad, ladder.scad, tray.scad]
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2026-10-17 tools/panel_frame_fea.py: lateral stiffness model of the panel frame
    A 2D frame model of the rack seen from the front:
    - column stiffness taken from the ladder meshes' sections;
    - tray and plate joints with a dead band (the runner play);
    - stacked-ladder joints as springs;
    - tension-only rear braces with pin slack;
    - pinned feet.
    It sweeps braces, play and joint stiffness for 2 x 2 and 4 x 4 grids.
    [panel_frame_fea.py]
2026-10-17 Panel frame: slack-free rear braces
    The stiffness model shows that the sway comes from the brace pins' slack.
    Once the braces are taut, the runner play in the trays no longer matters:
    a 4 x 4 sways 0.16 mm under 2 N, with or without play in the trays.
    So the braces carry the preload, in straight tension:
    - split pins 0.2 mm over their hole;
    - each diagonal 0.25 mm shorter than its holes' spacing (about 2 MPa,
    which relaxes but stays positive).
    The runners keep their 0.15 mm sliding fit, with no spring to creep.
    [brace.scad]
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2026-10-17 Panel frame becomes the design: three rows of four bays, no aluminium
    config/rack.yaml describes the panel frame (panel thickness and
    clearance, tray width) and three rows of four single bays; rackcfg
    derives the 165.8 mm column pitch, the tray positions and the overall
    size (671 x 225 x 664 mm). The aluminium-frame parts go: carrier base,
    deck, drawer guides, tier brackets, roof decks, base enclosure, bridge
    bars, feet and slot clips (git history keeps them); the fascia cut-outs
    move to lib/carrier.scad, the bay label to parts/label.scad. Double
    bays and the power box are not designed for the panel frame yet.
    STLs: the ladders and braces of every row, tray, drawer, floor and cap
    plates,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
    [base.scad, bay_label.stl, brace_a.stl, brace_b.stl, brace_base.stl, brace_c.stl, bridge_bar.scad, cap_plate.stl]
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2026-10-18 3D models in the repo, a 3D coverage check, USB-C PD parts, VRACK on the row cable
    * electronics/lib/3dmodels: the models KiCad's library lacks, attached by the catalog
    (Cat.model) and written into each board with a project-relative path (pcbgen.set_model),
    so they resolve in CI. First one: Espressif's ESP32-S3-MINI-1 STEP (espressif/
    kicad-libraries dd76561, CC-BY-SA 4.0 with the KiCad exception), aligned on KiCad's
    RF_Module:ESP32-S2-MINI-1 footprint. README: source and licence of each file.
    * tools/fetch_pcb_models.py: fetches LCSC / EasyEDA models into a git-ignored cache
    (their redistribution terms are unclear); parts opt in with Cat.model = easyeda/<LCSC>.step.
    * 3D coverag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
    [build_board.py, catalog.py, fetch_pcb_models.py, passives.py, pcb_glb.py, pcbgen.py]
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2026-10-18 Power hub v0.5: USB-C PD input (AP33772S), 4 layers, rows off until enabled
    The rack now runs from one USB PD 3.1 charger instead of the GST60A24 brick.
    Hub v0.5 (76 x 140 mm, 4 layers, In1 GND, In2 VRACK/+3V3):
    * AP33772S sink: 20 V at power-up (VSEL 39k), 28 V EPR on the controller's
    request, never 36/48 V; 5 mOhm Kelvin shunt, back-to-back IRF7842 switch,
    SMAJ30A TVS, NTC by the switch, interrupt and I2C to the ESP32-S3.
    * USB4105 5 A receptacle; the controller's buck runs from VBUS (5-28 V),
    ahead of the switch.
    * Every row's TPS26600 is off until the controller drives ROW_EN (SHDN pulled
    low); IMON per row; front PD LED.
    * ERC 0, DRC 0 errors, 0 unconnected, parity 0; 146 3D mo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
    [config.scad, controller.kicad_sch, input.kicad_sch, outputs.kicad_sch, power-hub-bom-jlcpcb.csv, power-hub-bom.csv, power-hub.kicad_pcb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]
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2026-10-18 Power hub firmware, the rack bus protocol, firmware/common
    firmware/ becomes a Zephyr module (zephyr/module.yml: boards, bindings,
    common/) that both applications add, so each still builds from any Zephyr
    workspace.
    Power hub (firmware/power-hub, board power_hub/esp32s3/procpu from
    electronics/power-hub/design.py U4):
    - USB-C PD: VBUS on the ADC, the AP33772S's I2C pull-ups on once VBUS is
    up, its drivers initialized then (zephyr,deferred-init); 28 V EPR when
    the charger offers it, else 20 V, never above 28 V (regulator node).
    - Rows A-D: eFuse enables held across a controller reset (pad hold), off
    until the contract has held 500 ms, then staggered; shedding from the
    measured IMON c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
    [bay.h, bus.c, check_pinmap.py, dev_server.py, events.c]
2026-10-18 Hub: admin-only actions claimed with BOOT; bays named after their position
    Power hub: reading stays open; every action of the page and API (rows, the
    contract choice, the enumeration, node commands) is an admin request
    signed with the hub's key (X-Bay-Auth, as on the bay nodes). The key comes
    from a claim confirmed with a press on the hub's BOOT button or "hub access
    claim" on its console USB-C; holding BOOT 10 s or "hub access reset"
    forgets it. New /api/access/nonce, /api/access/claim, /api/access/check;
    the page has the claim and unlock dialogs and an admin pill; the CTL LED
    flickers while a claim waits. No telnet shell on the hub any more: it
    switched rows without a login.
    Shared: ac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
    [access.c, acl.h, bay.h, dev_server.py, main.c]
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2026-10-18 Tray: side wall up to the drawer ledge
    The side wall stopped at CARRIER_WALL_H (20.1 mm, the underside of the old
    deck) while the ledge starts at 20.6 mm, so between the gussets the ledge
    hung 0.5 mm above the wall and was tied to it only every 24 mm. The wall
    now rises to the ledge along the guide; the 24 V jumper opening keeps its
    height. +0.2 g sliced (Bambu Studio, 0.20 mm Standard): 100.8 g. One
    assembled bay checked with SolidCraft inspect.interference: 0 overlaps.
    [rack-bom.csv, tray.scad]
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2026-10-18 Drag chain at its real size: Olimex 7×7, end pieces on anchor and foot
    The model assumed an 11 × 10 mm chain. The reference is now Olimex's
    DRAG-CHAIN-7X7 (links open on both sides, so the extension, whose plug and
    panel socket do not pass a 7 × 7 channel, is laid in). Olimex gives only
    the inner size: outer 13.5 × 10.2 mm and the end pieces (tab with 2 holes
    8 mm apart) come from Electrokit's listing of the same chain; R18 is kept,
    all of them config values to measure on arrival.
    - chain_parts: the anchor is a block outside the fixed run on two M3
    inserts, the foot a fin outside the moving run (1 mm clear of the right
    ledge) bridged to its tongue; the end pieces' tabs screw to th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
    [chain_anchor.stl, chain_bar.stl, chain_foot.stl, chain_link.stl, chain_parts.scad, rack-bom.csv, tray.scad]
2026-10-18 Power box lid: RESET and BOOT through two pin holes
    The hub's SW1 (RESET) and SW2 (BOOT) are top-actuated, in the board's
    rear-left corner (box 15.1, 133.6 and 15.1, 127.1, from KiCad). The lid now
    has a 2.2 mm hole over each, with a lead-in on top and a guide tube down to
    1 mm above the button, so a pin recovers the controller with the box
    closed. RESET and BOOT are engraved beside the holes (and in the lid's
    inlay part); the name moves 8 mm forward to make room.
    Positions in config/rack.yaml (pcb.power_hub.buttons, as design.py),
    HUB_BUTTONS for the box. Fit check: lid and hub 0 mm³, the tubes 1.0 mm
    above the buttons, every other part under them at least 1.7 mm lower.
    Co-Authored-By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
    [config.scad, power_box.scad, power_box_lid.stl, power_box_lid_labels.stl]
2026-10-18 Tray and drawer: USB-C openings cut for the plug's overmold
    The fascia's PC-port cut was the receptacle shell (9.6 × 3.8 mm), but the
    node's J3 (GCT USB4105) has its face 0.275 mm proud of the PCB edge, i.e.
    2.7 mm behind the fascia's outer face: a plug's overmold stopped on the
    fascia before the plug seated. The drawer's DATA sockets had the same
    9.6 × 3.6 cut in a 3 mm wall. Both now open to the overmold (USB-IF
    reference up to 12.35 × 6.5 mm) with clearance: a 12.8 × 7.2 mm rounded
    rectangle (carrier.scad › USBC_PLUG_CUT), so the DATA plug seats whether
    the panel socket is screwed behind the wall or passes through it. The AUX
    slot keeps its size. Checked in Blender: a reference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
    [drawer.scad]
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2026-10-18 Row cable without a twist: J2 mirrored on the bay node
    J1 and J2 are the same side-entry footprint turned 180°, so with one pinout
    on both, the 1:1 jumper between two nodes had to make a half twist. J2 now
    carries J1's pinout mirrored (J2.n = J1.(7-n): 1 POS out, 2 GND, 3 CAN_L,
    4 CAN_H, 5 GND, 6 VRACK):
    * the jumper lies flat: pin n to pin 7-n, both plugs the same face up;
    * every net crosses the node straight: the In2 VRACK strip runs from J1.1
    to J2.6 at the same height, and R30 sits by J2.1;
    * the hub keeps J1's pinout and the feeds stay 1:1: out of the box's left
    wall and back into J1 from the left, they fold over once;
    * a wrong cable burns nothing: VRACK lands on a POS pin (10k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
    [bay-node.kicad_pcb, bus.kicad_sch, power.kicad_sch, rack-bom.csv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]
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2026-10-18 Tray: a notch in the left ledge over the node's RESET button
    The bay node's RESET (SW1, TS-1187A at KiCad 7.5, 11.5, i.e. tray 11.5,
    71.5) sits under the left ledge's inner edge (x 0-12), so a pin from above
    hit the ledge. A R2 notch centred on the plunger cuts the ledge back to
    x 9.5 over 4 mm: a Ø2 pin reaches the button with the drawer pulled out
    (checked in Blender: it hit the old ledge, clears the new one and the open
    drawer), and the drawer still rests on 1.5 mm of ledge there. BOOT (tray
    19.5, 71.5) was already clear. Viewer and BOM regenerated after merging
    main 60423e8.
    [tray.scad]
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2026-10-18 Firmware updates over Wi-Fi: MCUboot, signed images, trial and rollback
    Step 1 of the update plan (docs/firmware.md, Programming), for the bay
    nodes and the power hub, with the same code in firmware/common:
    * MCUboot in front of both applications through sysbuild (swap using
    offset, ECDSA P-256). The Zephyr module moves to the repository's root
    (zephyr/module.yml) so west, and thus sysbuild, finds the boards. The
    signing key comes from HWTR_SIGNING_KEY (the module's Kconfig.sysbuild),
    MCUboot's public test key otherwise: the build warns, the page shows
    "test key", and CI builds with it (artifacts named *-test-key).
    * The image id "<application>/<board>" as a protected TLV (0xa0)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
    [bayctl.py, dev_server.py, events.c, hub.h, main.c]
2026-10-18 Hub row outputs with the OUT pinout: one row cable for everything
    The user chose to mirror the hub's row outputs too (option a'): J2-J5 now
    carry the bay nodes' OUT pinout (1 POS, 2 GND, 3 CAN_L, 4 CAN_H, 5 GND,
    6 VRACK). Every link runs from an output to an input, so every row cable,
    feed or jumper, is the same: pin n to pin 7-n, both plugs the same face up.
    The feeds take a half turn along their 25-60 cm; the CAN pair stays
    together between its GND pins.
    Hub: each ROW track leaves its eFuse as before, stops short of the
    connector's rear pin, drops to B.Cu beside the connector (three vias) and
    comes back up at pin 6, keeping the top side free for the CAN pair; R10x
    sits behind pin 1. The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
    [outputs.kicad_sch, power-hub.kicad_pcb, rack-bom.csv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]
2026-10-18 BOM: the row cables from one AliExpress listing ("Same direction")
    The single row cable type (pin n to pin 7-n, both plugs on the same face)
    is listed as "Same direction" on AliExpress 1005008045292937 (433 sold,
    4.6 stars), checked 2026-10-18 on its photos: "Same direction" shows both
    plugs on the same face, "Reverse direction" the 1:1 cable. 6 pins, lots
    of 5, every length from 20 to 80 cm:
    * jumpers: 2 lots of 20 cm (9 needed; 120 mm used, the rest folds flat at
    the front of the plenum);
    * feeds: one lot each of 30 cm (row A), 60 cm (B) and 80 cm (C).
    About EUR 19 plus shipping. The listing gives no wire gauge (26 AWG is
    usual): fine for a row's ~0.4 A, warm at the eFuse's 1.6 A lim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
    [rack-bom.csv]
2026-10-18 Real USB plugs and an arch-routed DUT cable
    The DUT cable (drawer DATA socket to the board) was a fixed-handle Bezier
    between ~12 mm cubes. Now:
    - mechanical/parts/usb_plugs.scad draws filleted plugs (USB-C after the
    USB-IF overmold, micro-B, mini-B; straight and right-angle, nickel shell)
    and the panel-mount female (25 mm flange, screws 17 mm apart, body and
    strain relief behind the wall). tools/webscene.py's USB_PLUGS is the one
    table: it sizes the parts in parts.glb and the cable exits. The viewer
    and assembly_glb.py use those meshes instead of their own boxes.
    - arch_cable(): straight up out of both right-angle plugs' reliefs, R12
    bends, as tall as the cable is long; warn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
    [rack-bom.csv, usb_plugs.scad]
2026-10-18 BOM: the AliExpress magnets, glued; chain end pieces sourced
    - Detent magnets: one lot of 50 × 6×3 N35 (AliExpress 1005010074888189,
    3.99 €) instead of 24 from supermagnete, plus a CA gel line. The pockets
    stay a slip fit: the other magnet pulls each one out of its pocket's
    mouth and the drawer boss leaves a 0.9 mm wall, so they are glued.
    mechanical.md and assembly.md say how, with the polarity check (stack
    the pair, mark the outer faces, those go into the pockets).
    - Drag chain: Olimex sells whole metres (3 m, not 2.6) and does not sell
    end pieces alone; the generic chain ships one pair per metre, so the
    other 9 pairs are a line of their own (AliExpress 1005003181041939,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
    [rack-bom.csv]
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2026-10-18 Small boards turn their USB to the side: straight DUT cables
    The user's call ("Oui, tourne"): the Pico 2, ESP32-S3/C6-DevKitC and UNO R4
    get `orient: side`, their debug USB towards the right wall, next to the
    right DATA socket. Their cable is then straight at both ends: out of the
    socket forwards, one flat bend (R12, ≥ 10 mm), into the board's side; a
    plain 15–20 cm cable. The long boards (Nucleo, nRF DK, FRDM) cannot turn
    in the 138 mm drawer and keep right-angle plugs and the arch.
    - webscene: flat_cable() for straight cables, cable_free_length(); the cable
    type's `style` (config/rack.yaml) picks the route and the plugs. A bend
    tighter than 10 mm counts as too short; no warning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
    [board_plate.scad, boards.scad, rack-bom.csv]
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2026-10-18 DATA port: a coupler, the extension's 90° plug behind it
    The panel-mount female extension (UC-138) reached 24.5 mm behind the port
    wall: its cable left 5.5 mm from the drawer's rear wall and could not turn
    back to the cable window (a R10 U-turn needs ~12 mm), and its strain relief
    sat on the zip-tie anchor. The user picked a coupler:
    - The DATA port is a USB-C female-to-female coupler screwed through the port
    wall (same flange, pilots and pads, measure the real one), 11 mm behind
    it. The drawer extension, a 40 cm C ↔ C with one 90° plug, plugs into its
    rear bent down, straight through the cable window. The route is ~32 cm
    (30 cm is short).
    - PORT_Z 8.5 → 13.5 mm above the d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
    [config.scad, drawer.scad, rack-bom.csv, usb_plugs.scad]
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2026-10-18 DATA port: our own small board on a 5-wire PH lead
    The drawer's USB-C coupler and its 90° extension are replaced by a small
    board of ours and a JST PH lead, as the user asked (5 wires: VBUS, GND,
    D−, D+, GND; the board longer, screwed at both ends, components down).
    - electronics/data-port (v1.0, 2 layers, 40 × 20 mm): GCT USB4105 source
    (Rp 22k on CC1/CC2), USBLC6 at the receptacle, JST PH 5 side entry at the
    rear edge, Ø2.7 holes 34 mm apart (config/rack.yaml › pcb.data_port).
    Routed; ERC/DRC clean, parity 0, JLC DFM clean. Added to the CI matrix.
    - Bay node: J7 DATA (B5B-PH-SM4-TB, vertical) in parallel with J4, one of
    the two in use; its pinout is the port board's mirror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
    [bay-node-bom-jlcpcb.csv, bay-node-bom.csv, bay-node.kicad_pcb, data-port-bom-jlcpcb.csv, data-port-bom.csv, data-port.kicad_pcb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]
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2026-10-18 C1 takes a straight mini-B; DUT cables and adapters as in the cart
    - The F746G-DISCO's mini-B faces the side wall with 49 mm to it: the HOQO
    "to Mini Male" (USB-C 90° ↔ mini-B straight, 25 cm) plugs in straight, bends
    up at R 10 9.7 mm from the wall and arches over to the coupler (style side,
    side_arch_cable()). No mini-B adapter. arch_between() takes the arch on
    any two upward exits.
    - The micro-B boards' cable is the HOQO "to Micro Male" at 25 cm; their
    adapters are DIY-018 singles, one UP and one DOWN per board.
    - The drawer extension: 40–50 cm (no 40 cm listing seen); a 50 cm cable's
    spare is a flat coil in front of the chain's fixed end, between the
    camera-pod bosse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
    [rack-bom.csv]
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2026-10-18 DATA lead: clear of the chain's fixed run; the board's final layout
    - The board's session confirmed the drawer's proposal (0f778dc) with the PH
    at x 17.5 instead of 21 (its courtyard clear of the USB4105's): regenerated.
    - With the PH further left, the lead dropped 0.65 mm beside the chain's fixed
    run, which the drawer slides past. It now moves right in the rear bay
    first and runs under the drawer at 6 mm from the run's centre line + half
    its width (4.8 mm clear); still clear of the camera-pod bosses and 7.8 mm
    off the fascia with the drawer out. Lead ≈ 37.5 cm: the 50 cm one fits.
    [config.scad]
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2026-10-18 Viewer: one camera, in B2, at its real size
    The user wants a single camera in the viewer, in B2 (webscene.VIEWER_CAMERAS);
    config/rack.yaml › cameras still counts the rack's own for the BOM.
    The camera looked too big. The Mega itself was right (33 × 33 mm PCB, 35 mm
    overall with Arducam's stock M12 lens; Arducam publishes no 3D model), but it
    carried that longer stock lens and sat on a 92 × 73 mm plate. Now: the ~120° M12
    lens of the hand-over (Ø14 front, 9.5 mm out of a 10.5 mm holder with its two
    screw ears), the lens tip 27.6 mm under the ceiling instead of 38, a 66 × 34 mm
    plate with a 14 mm arm to the insert square, 12 × 26 mm light boxes.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
    [webscene.py]
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2026-10-18 Camera: JPEG quality "high" reaches the camera after a boot
    video_set_ctrl() skips a value equal to the one it has cached, and the
    driver's cache starts at the default (0) without the camera being
    written: a bay saved at quality "high" (0) kept the camera's own power-on
    setting. The first time, set_ctrl_written() goes through another value
    so the camera gets the wanted one; the camera controls to come use it too.
    [camera.c]
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2026-10-18 Camera pod for the Arducam Mega and its board, under B2's cap plate
    The camera mechanics (backup/elated-camera-pod-v2), rebased on main: the
    64 × 90 WROOM node, two rows (B2's camera hangs from the cap plate), the
    pod board, the viewer's camera and the GIGA in B2.
    - camera_pod (dark PETG) has a plate on 4 × M3×6 into the ceiling's camera
    inserts. Those inserts (bay.camera_mount [109, 45]) sit right of the node
    above and clear of its chain, on the cap plate's 30 mm grid, and every
    bay's ceiling gets them. At the lens spot (bay.camera_lens [64, 27.6] =
    bay (64, 84)) the Mega's case snaps up into a sleeve, lens down, its XH
    side open, the lens tip ≈ 30.5 mm under the ceiling.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
    [camera_diffuser.stl, camera_pod.scad, config.scad, rack-bom.csv, tray.scad, usb_plugs.scad]
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2026-10-19 Camera: exposure, gain, white balance, levels, sharpness, rotation
    The bay camera's image settings, per bay, as the user asked (all the
    Arducam driver offers but colour effects):
    - "cam/cfg" v2: resolution, quality, light as before, plus exposure and
    gain (auto, or manual with a value kept while automatic), white balance
    (auto or a preset), brightness -4..4, contrast and saturation -3..3,
    sharpness (auto or 1-8, 3 MP only) and the page's rotation. A v1
    record keeps its three settings, the rest starts automatic.
    - They reach the camera between two frames (work queue plugged), each
    through set_ctrl_written(): video_set_ctrl() skips a value equal to its
    cache, which starts without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
    [bay.h, camera.c, dev_server.py, screenshots.py, shell.c, web.c]
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2026-10-19 Bay node: lead-free HASL, and the order of 10 PCBs / 10 assembled as the estimate
    The user's choice (2026-10-19): 10 PCBs in lead-free HASL, all 10
    assembled (8 bays, 2 spares; no engineering fee up to 10 PCBs). The
    board declares HASL (same tracks, re-imported session). tools/bom.py
    replaces the 2026-10-16 quote (20 ENIG / 16 assembled, before rev 0.5)
    with an estimate from JLC's current fees: ≈ $344 (PCB $19.50, setup,
    stencil, 44 part types × $1.53, 389 joints, X-ray $1.64 a board,
    components at catalogue × 1.12). Not re-quoted: the PCBA quote needs
    the user's JLC sign-in; a Standard handling fee is still to confirm.
    [bay-node.kicad_pcb, rack-bom.csv]
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2026-10-19 Sled and fixed bays: a drawer's front without a drag chain, its port block behind
    The density epic, story 1 (the user's go-ahead on the concept views): any bay
    can hold a drawer, a sled or a fixed sled, on the same tray. The choice is
    population › mount, and A3 becomes the example sled bay.
    - drawer.scad also makes the sled and the port block, cut 1 mm in front of
    the drawer's port wall.
    - The sled is the front: label, plate pocket, flanges under the guide lips
    at its rear. It has no chain foot and no magnet.
    - The port block is the rear bay: port wall, DATA board, cable window. It
    stays in the bay. -D PORTS=4 gives four USB-C at a 16 mm pitch for a
    future DATA ×4 bo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
    [board_plate.scad, drawer.scad, rack-bom.csv, tray.scad]
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2026-10-19 Power box: USB-C openings 13.0 × 7.4, the CTL LED hole 0.35 mm aside
    The USB-C cut-outs were 12.4 × 7.0 for the USB-IF maximum overmold of
    12.35 × 6.5: 0.05 mm before a printed hole comes out 0.2–0.3 mm small,
    and the PD input's 5 A EPR cables tend to the largest overmolds. Both
    ports are now 13.0 × 7.4 (same centres), inside their walls.
    The wider console opening left 0.66 mm of wall to the CTL LED's hole,
    thin enough for a slicer to drop: that hole moves 0.35 mm towards the
    row LEDs (CTL_LED_SHIFT), 1.00 mm of wall, still in front of the LED's
    3 mm face. Checked in SolidCraft (cut-out and hole solids, clearance).
    The labels under the openings follow USB_BOTTOM. Only the base and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
    [power_box.scad, power_box_base.stl, power_box_labels.stl]
2026-10-19 Sub-slots: a bay's boards:, bayctl per board, one plate per converted bay
    A bay with a DATA ×4 board (docs/multi-dut-node.md) holds up to four boards:
    `boards:` in config/rack.yaml instead of `board:`, sub-slots <bay>.1-.4 by port.
    - rackcfg: dut_slots / Rack.duts (today's form unchanged), split_slot, the
    plate's geometry (plate_size, plate_buttons, keep-outs), bay_layout and
    bay_boards (each board's `at`, or packed in a row, turned USB to the port
    wall), check_bay_plate (on the plate, apart, clear of the pins, finger
    slots, label and the RESET/BOOT pin holes by 3 mm), plate kind "boards".
    - build.py: BAY_PLATES in generated/boards.scad, a plate_bay_<id> job;
    board_plate.scad BAY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
    [board_plate.scad, boards.scad]
2026-10-19 Plates: a fenced board's corner fences leave its USB plug's way free
    SolidCraft's interference check of a converted B3 drawer (its plate, two
    XIAO and two Pico 2, their DUT cables' plugs at both ends, the port wall
    with the DATA ×4 cuts, as exact solids from the OpenSCAD CSG) found each
    XIAO's rear corner fences in its USB-C receptacle (0.3 mm³) and in its
    right-angle plug's body (2.4 mm³). The fences on the USB edge now stop
    7 mm either side of the USB's axis (a 12.4 mm right-angle plug or an
    11.5 mm adapter, and a margin); the ledges under the board stay. After it:
    no interference in the scene.
    Changes plate_xiao, plate_esp32-s3-devkitc and plate_esp32-c6-devkitc (the
    same clash on t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
    [board_plate.scad]
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2026-10-19 USB/IP: a Zephyr patch for boards that go, and bus IDs by port
    Zephyr's USB/IP service keeps a pointer to the device it exports and is
    not told when the device goes: a board that resets or is unplugged during
    a session leaves the session on freed memory. Its bus ID is the device's
    address, which changes when the board enumerates again. Both block a
    node with four boards behind a hub (docs/multi-dut-node.md), and the
    first already hits today's one-board node.
    zephyr/patches.yml carries the fix as a Zephyr commit, applied with
    `west patch apply` after `west update` (README, west.yml, CI): each export
    context is a host class instance, bound to a device when the host
    configures it and told wh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
    [main.c, test_usbip.py]
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2026-10-19 Power hub: the AP33772S FA01 starts at 5 V, the rows wait for 15 V
    The FA02 is out of stock; the FA01 replacement has no VSEL: it stays on
    the source's 5 V contract until the firmware asks for 20 or 28 V. Such
    a contract could settle and count as final, and rows.c then switched the
    rows on: locked out by their eFuses below 15 V, they would have come up
    by themselves on the way to 28 V.
    - A contract under CONFIG_HUB_ROWS_MIN_MV (15 V) never becomes final, and
    rows.c treats it as no contract: rows off, back with the next final one.
    The event log says it is too low for the rows.
    - The AP33772S driver writes VSELMIN from a new vselmin-microvolt property
    whenever the chip starts; the hub'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
    [pd.c, rows.c]
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2026-10-19 Example bay B3 converted: 2 × XIAO and 2 × Pico 2 on one plate
    B3 (the drawer shown open) holds four boards on a DATA ×4 board: B3.1 and
    B3.4 a XIAO (USB-C 90° cables), B3.2 and B3.3 a Pico 2 (micro-B on 90°
    adapters), USB to the port wall, 28 mm apart, centred on the plate.
    plate_bay_b3.stl replaces the Pico 2's plate in the BOM; the cables are
    counted per board. config/lab.example.yaml names them B3.1-B3.4 (their
    console: their own USB); twister warns that the two Pico 2 share uf2
    without a probe id.
    The viewer (tools/webscene.py) still reads one `board` per bay: `build.py
    web` needs its sub-slot support before this goes out.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
    [boards.scad, rack-bom.csv]
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2026-10-19 Hub page mock: power-up as the AP33772S FA01 does it
    dev_server.py's history started with "contract: 20 V / 5 A (VSEL, at
    power-up)", the FA02's behaviour. The FA01 starts on the charger's 5 V
    (VSELMIN 15 V keeps its switch open, the rows wait), then pd.c asks for
    28 V EPR: the mock now logs pd.c's own events for it, VBUS up, the 5 V
    contract too low for the rows, the 28 V EPR one. The four page
    screenshots with the event list are rendered again (screenshots.py); the
    dialogs are unchanged.
    [dev_server.py]
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2026-10-19 B3: the Pico 2 in front, the XIAO at the rear corners
    The four boards sat in a row 26 mm from the port wall, the front half of the
    plate empty and the cables arching to 88-102 mm with up to 74 mm left over.
    Now the two Pico 2 stand in front, 35 mm apart, their cables running straight
    back between the two XIAO, which sit at the rear corners on their short
    USB-C cables (arches 84 mm; 21 mm left to coil on the Pico 2's). No cable
    passes near another board; the finger slots and the front corners stay free.
    Checked: rackcfg check_bay_plate; SolidCraft on exact solids (drawer with the
    DATA ×4 cuts, plate, boards, every plug): no interference, the socket plugs
    0.4 mm over the U-cuts, every board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
    [boards.scad]
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2026-10-19 DATA ×4: the proposal's board, its PH 8 in the rear-right notch over the window
    The user found the viewer's DATA ×4 cable passage tight: the placeholder's
    PH 8 sat at the board's rear centre and its lead ran 30 mm along the board
    to the cable window. config/rack.yaml › pcb.data_port_x4 now carries the
    data-x4-board proposal, and drawer.scad (PORTS=4) and the viewer follow it:
    - board 108 × 24 at drawer x 15–123, y 166–190, 4 bosses;
    - four USB-C at drawer x 26 / 44 / 62 / 80 (18 mm pitch): the port wall's U's;
    - the PH 8 in a 22 × 7 rear-right notch, its mouth at y 183 like the DATA
    board's;
    - the cable window under the notch (x 100–122.5, clear of the third boss),
    the lead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
    [config.scad, drawer.scad, usb_plugs.scad]
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2026-10-19 Tray: screwdriver holes over the node's left screws
    The node's two left M3 screws (carrier x 7.5) sit under the left ledge and
    lip, so neither the screw nor a screwdriver reached them, even at the bench.
    A Ø6.4 hole through the ledge and lip over each now passes the pan head
    (0.4 mm all round) and a Ø5 shaft (0.7 mm). It is countersunk under the lip
    and on the ledge, so the drawer's rear flange can't catch an edge. At the
    ledge's front end it opens forwards and inwards. The holes follow
    NODE_HOLES (any left hole at x < 15.2).
    Checked in SolidCraft, with a FreeCAD cross-check:
    - before, head and shaft hit 49-81 mm3; after, nothing hits;
    - the drawer has no interference closed, mid-strok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
    [tray.scad]
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2026-10-19 DATA ×4: the floor bosses move with the board's holes, between the rear rows
    The board's routed layout puts its four PT 2.6 holes between the ports'
    rear rows (RESET/BOOT headers and the two expanders): KiCad (3.2, 3.5),
    (38.7, 3.5), (81.4, 3.3), (104.4, 20.6), drawer (18.2, 186.5),
    (53.7, 186.5), (96.4, 186.7), (119.4, 169.4). drawer_x4 and
    drawer_block_x4 rebuilt from config/rack.yaml; the cable window still
    starts 4.5 mm right of the third boss, under the notch.
    [config.scad]
2026-10-19 DATA ×4 v1.0: hub, four switched and measured USB-C, two TCA6408A
    electronics/data-port-x4: a converted bay's drawer board on the node's
    PH 8 lead (J7 mirrored). USB2514B on its straps (MTT, self-powered);
    per port a TPS2553-1 (≈ 0.5–0.62 A, latch-off), a 100 mΩ Kelvin shunt
    read by an INA226 (0x41/0x43/0x44/0x45), a USB4105 source with Rp 56k,
    a USBLC6 in flow-through. Two TCA6408A in the rear row, each between
    the two ports it drives (0x20 ports 1–2, 0x21 ports 3–4), so only SDA,
    SCL and INT cross the board; RESET and BOOT open drain emulated by the
    expander, through 1k to a 1 × 3 header (not fitted). AP2112K 3.3 V.
    4 layers JLC04161H-7628, 108 × 24 mm with the rear-right n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
    [data-port-x4-bom-jlcpcb.csv, data-port-x4-bom.csv, data-port-x4.kicad_pcb, data-port-x4.kicad_sch, hub.kicad_sch, port1.kicad_sch, port2.kicad_sch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]
2026-10-19 Board plate: one honeycomb plate, clip-in stops, cams and pins
    Every bay gets the same 5 mm plate: 197 hexagonal holes, 10 mm apart,
    odd rows numbered on the rims (config/rack.yaml › plate_grid,
    mechanical/lib/hexgrid.scad). Pegs clip into any hole: an undercut
    and a 45° ledge inside the plate, three openGrid-style spring skins
    on the plug that flex in the print plane, nothing below the plate.
    - parts/pegs.scad:
    - an eccentric stop (6 turns = 6 places a hole, a 45° lip);
    - a cam on its base (a spiral, 3 mm of travel, 20° undercut, self-locking);
    - a pin through a mounting hole;
    - a cable bobbin instead of the hooks.
    One STL per standoff in use.
    - tools/plate_layout.py places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
    [board_plate.scad, boards.scad, config.scad, peg_base_h10.stl, peg_base_h12.stl, peg_base_h5.stl, peg_base_h6.stl, peg_base_h9.stl]
2026-10-19 Bay node: J7 takes D+ on pin 3, the DUT pair runs straight
    U8 puts D- to the north and J7's side entry put D+ there, so D+ crossed
    under D- on B.Cu. The user chose to swap J7's pins 3/4 (3 D+, 4 D-):
    DUT_CONN_DP/DN now run straight from U8 into J7, one 45° step each, no
    via (14.6 / 14.7 mm; J3 -> J7 matched to ≈ 0.3 mm).
    The data port follows through the lead (pin n <-> 9-n): J2 5 D-, 6 D+,
    and U1's channels swap with it (D+ through 1/6), so every pad keeps the
    copper it had. Both boards re-routed: ERC 0, DRC 0, 0 unconnected,
    parity 0, JLC READY.
    The node's buck GND and +5V islands and the LDO tab are now exclusive
    (0.5 mm), as on the hub: Freerouting cut buck-5v, then C12 off the LD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
    [bay-node.kicad_pcb, data-port.kicad_pcb, data-port.kicad_sch, port.kicad_sch, rack-bom.csv, usb.kicad_sch]
2026-10-19 Cables at their real length: an elastica for every DUT cable; B3 re-placed
    The DUT cables were drawn along a route and their spare length "looped on the
    plate, not drawn", so a cable could look tidy where it would not be. Now
    webscene's rod_cable draws each one exactly as long as it is (its length end to
    end less both plugs), leaving each plug along its axis, in its shape of least
    energy (stiffness and weight, (EI/w)^⅓ ≈ 60 mm), on the plate, under the
    camera pod, out of the boards and the drawer's walls, off itself and the bay's
    other cables (segment to segment), and no tighter than 10 mm: scipy SLSQP on
    the segments' directions, the old routes only as a start. Every DUT cable in
    the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
    [rack-bom.csv]
2026-10-19 Node B leads: DATA out of the side-entry J7, the camera straight back; tie anchors clear the fascia
    The 74 × 90 node (ce919e6) puts J7 and J5 on its right edge, facing the chain, and J6
    at its rear right.
    - DATA, drawer bay: out of J7 for 6 mm, then straight into the chain's fixed end
    (33 mm in the plenum, was 47).
    - DATA, sled bay: out of J7, rising to under the sled at the node's edge + 12, as before.
    - Camera: straight back from J6 at x 63, no longer diverted to x 78.
    The row jumper's tie anchors are 1.5 mm shorter at the front (TIE 4 × 5.5, centred at y 7.25).
    A cable tie's strap now passes 0.8 mm in front of each anchor. Before, the anchor was
    0.5 mm from the fascia and the straps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
    [tray.scad]
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2026-10-19 CAN transceiver: the TJA1462AT on the hub and the node
    The TCAN1462V (C7399456) had no LCSC stock on 2026-10-18 and 19, and
    JLC's quote of the hub asked for another part. The user chose NXP's
    TJA1462AT/0Z (C3234095, 10 500 in stock) for both boards (hub U6, node
    U11): the same SOIC-8 pinout (VIO on pin 5, STB on pin 8), signal
    improvement kept, bus pins -36/+40 V instead of ±58 V. The TCAN1462V
    and the TCAN1044AV stay the alternates.
    Both boards regenerated and the same Freerouting sessions re-imported
    (tracks and vias unchanged): ERC 0, DRC 0 errors (the hub's known C8
    silkscreen warning), 0 unconnected, parity 0, JLC READY. The CPL keeps
    its 270° correction (C3234095 was already in b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
    [bay-node-bom-jlcpcb.csv, bay-node-bom.csv, bay-node.kicad_pcb, bay-node.kicad_sch, bus.kicad_sch, controller.kicad_sch, power-hub-bom-jlcpcb.csv, power-hub-bom.csv]
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2026-10-19 Bay node page mock: the camera is B2's, as the 3D viewer renders it
    The simulated camera cut its frames from a photo of a drawer, brightened
    or darkened for the light. It now serves bay B2's camera as the viewer
    (site/) renders it, the lens's distortion, the sensor's noise and auto
    exposure and the JPEG included, with the GIGA's LVGL screen playing its
    music demo:
    - grab_camera.py grabs them headless from site/ at main's state, through
    the viewer's ?debug hook (a CameraPreview at each resolution on its own
    canvas; nothing in site/ changes): 640x480, four frames 300 ms apart,
    and 1600x1200, one frame, each with the LED light on and off (1.5 MB,
    most of it the sensor noise).
    - dev_se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
    [dev_server.py, grab_camera.py, screenshots.py]
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2026-10-19 DATA ×4 v2 co-processor firmware: research and a build-only spike
    docs/coproc-firmware-research.md checks the v2 note's Zephyr firmware
    for the RP2354B co-processor against upstream main (f78c4de, 2026-10-19):
    - what Zephyr supports, file by file;
    - the stock analyzer firmwares (gusmanb, sigrok-pico, SUMP);
    - options (a) gusmanb only, (b) ours only, (c) both, swapped by a
    PICOBOOT reflash;
    - the node link: USB only; BOOTSEL then PICOBOOT for updates and
    recovery, no MCUboot;
    - the effort module by module, and the upkeep;
    - what could go upstream (drafts only).
    Recommendation: (c), staged. The stock gusmanb analyzer on day one.
    Our firmware comes when consoles or emulated devices are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
    [la_pio.c, la_pio.h, link.c, main.c]
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2026-10-19 Camera pod: the XH window clears its plug, the XH cable after the screws; jumper ties fit and are in the BOM
    From notice v25's SolidCraft check:
    - Pod sleeve: the window on the XH side stopped 0.5 mm under the Mega's XH. It is now
    XH_WIN, 21 × 10.5 mm from the case's face, so the XH and its mated plug slide up
    with 1 mm to spare.
    - XH cable: the mated XH plug sits right under the front-left M3. A Ø5 shaft
    overlaps it by 103 mm³, so no cable path avoids it. docs/assembly.md §6 now
    plugs the XH cable after the pod is screwed, then pushes the Mega up.
    - Row-jumper ties: the anchors' tunnel (2.4 × 2.2) didn't take a 2.5 mm tie.
    TIE is 4.6 wide, the tunnel 3.0 × 2.2; a 2.5 × 1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
    [camera_pod.scad, camera_pod.stl, rack-bom.csv, tray.scad, tray.stl]
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2026-10-19 Hub 37 and node 38 part types: more values merged
    From the JLC cost session's list (it does the analysis, this session
    edits the boards). No footprint or track moves; both boards regenerated
    on their Freerouting sessions (node 996/386, hub 1241/593 segments/vias),
    ERC 0, DRC 0 errors (the hub's known C8 silkscreen warning), parity 0.
    - Hub: the IMON filters and the CAN split caps on the dVdT caps' 22 nF
    (IMON RC 22 µs; the split cap only filters common mode): 38 -> 37 types,
    -$17.05 of feeders against the quote, order ≈ $212.77.
    - Node: buck EN 100k/10k (same 13.5 V / 10.8 V), PC_DET 10k/18k (3.2 V),
    I²C pull-ups 5.1k, AUX VREF 33 Ω: 42 -> 38 types, estimate ≈ $322.77.
    Docs: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
    [bay-node-bom-jlcpcb.csv, bay-node-bom.csv, bay-node.kicad_pcb, controller.kicad_sch, dut.kicad_sch, outputs.kicad_sch, power-hub-bom-jlcpcb.csv, power-hub-bom.csv]
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2026-10-19 BOM: JLC cost at volume, and the measured PCB prices
    The JLC cost section gains "At volume", generated by tools/bom.py.
    Unit cost per board at 2 / 5 / 10 / 50 / 100 assembled in one order:
    - the fees per order (setup, stencil, part types, packaging) are spread
    over the boards;
    - parts and joints are held at today's prices, since bom.py has no LCSC
    price breaks;
    - X-ray follows JLC's tiers;
    - the bare PCBs use JLC's price at that quantity.
    A floor gives each board's cost once the fees per order no longer count.
    It also gives the cost of one rack (8 nodes, 1 hub, 7 DATA ports, 2 pods,
    1 DATA x4) when building 1, 5 or 10 racks in one order, with one shipment.
    JLC_PCB_PRICE holds the jlcp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
    [rack-bom.csv]
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2026-10-19 DATA ×4: a basic-part LDO, the XC6206 in U3's spot
    U3 goes from the AP2112K-3.3 (extended) to the XC6206P332MR-G (C5446,
    JLC basic, SOT-23-3): one extended part type fewer, $3.07 an order at
    Economic PCBA. Its dropout is ≈ 0.25 V at 0.1 A against the board's
    ≈ 0.1 A of logic, so the hub, the expanders and the INA226s still run
    down to ≈ 3.6 V in; 200 mA max, 6 V in max (the node's +5V is 5.24 V).
    The AMS1117 suggested first doesn't fit (SOT-223 under J1) and its ≈ 1 V
    dropout would eat the lead's margin. U3 sits at 0° (of three
    orientations routed, the one Freerouting closed), CPL fix 180° for
    C5446.
    Re-routed: ERC 0, DRC 0 (unconnected 0, parity 0). BOM: the DATA ×4
    quote at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
    [data-port-x4-bom-jlcpcb.csv, data-port-x4-bom.csv, data-port-x4.kicad_pcb, data-port-x4.kicad_sch, hub.kicad_sch, rack-bom.csv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]
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2026-10-19 BOM: the DATA x4's length as a user decision in JLC_LEVERS
    At 108 mm the DATA x4 pays JLC's $25 engineering fee: $31.90 for 5 PCBs,
    against $13.20 within 100 mm, so a shorter board saves $18.70.
    It is a decision, not an obvious lever. The four USB-C at the drawer's
    18 mm pitch and the side-entry PH 8 set the length. A shorter board needs
    a vertical PH 8 or a moved J1, a new route, and the tray's bosses moved.
    Its owner places it in the v2.
    [bom.py]
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2026-10-19 DATA ×4: back to the AP2112K on U3, on top-side copper
    The XC6206 (82c7172) can't carry this rail. The USB2514B alone draws up
    to 155 mA at high speed with four ports busy (datasheet tables 6-4 and
    6-5; 84 mA at full speed), so the LDO burns ≈ 0.31 W from 5.24 V: more
    than a 200 mA SOT-23 LDO like the XC6206 is rated for (≈ 0.25 W), and the
    XC6206 has no thermal shutdown. The AP2112K-3.3 (600 mA, thermal
    shutdown) is back on its SOT-23-5 footprint at 0°, CPL 270° as before;
    C5446 and its catalog entry go.
    Its VIN and EN pins (with C2's +5V pad) and its GND pin now sit on
    top-side islands (exclusive, thermal reliefs) with their own vias to the
    +5V and GND planes, to spread that heat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
    [data-port-x4-bom-jlcpcb.csv, data-port-x4-bom.csv, data-port-x4.kicad_pcb, data-port-x4.kicad_sch, hub.kicad_sch, rack-bom.csv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]
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2026-10-19 Node U9 TPS2553D; hub input FETs stay 40 V
    Three checks from a BOM review:
    - Node U9: the TPS2553DDBVR (C521201, $0.19 against $0.54) instead of
    the TPS2553DBVR. Same SOT-23-6 pinout (IN GND EN FAULT ILIM OUT, EN
    active high), the same I_LIM equations (18k: 1.34-1.52 A), 85 mΩ,
    constant current then thermal cycling, plus reverse-voltage
    protection. JLC's EasyEDA footprint for it is turned 90° from the old
    part's: CPL correction 270° (fitted pad by pad, as the TPS2553-1's).
    There is no latch-off D part: the DATA x4 keeps the TPS2553DBVR-1.
    - Hub Q1/Q2 stay IRF7842 (40 V). The AP33772S drives the gate at most
    4 V above VCC, so R_DS(on) at 4.5 V decides (5.9 mΩ max); Diode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
    [bay-node-bom-jlcpcb.csv, bay-node-bom.csv, bay-node.kicad_pcb, dut.kicad_sch, rack-bom.csv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]
2026-10-19 JLC audit: CJT for the PH lever, the PD sink and CAN alternatives
    The orchestrator found the real LCSC codes behind the external review's
    wrong ones. They are now in the audit:
    - PH SMD clones: CJT's A2001WR-S-6P / -S-8P / A2001WV-S-8P cost $0.16-0.20
    at 100. On CJT the lever saves about $70 at 10 racks, against about
    $133 for the no-name parts. It stays an open decision.
    - PD sink alternatives to the AP33772S: the HUSB238A next to the CH224Q /
    CH224A. The HUSB238 (non-A) and the CH224K stop at 20-25 V.
    - Rejected, with the reasons:
    - CAN transceivers without signal improvement (TJA1051T/3, SIT1042AT/3,
    SIT1044T/3);
    - INA226 / TPS2553 clones: none in the catalog;
    - LMR51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
    [bom.py]
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2026-10-19 One drawer for both DATA boards: the ×4's port wall, the single board on port 4
    A bay now converts between the DATA port board and the DATA ×4 by swapping
    the board; the drawer (and a sled bay's port block) stays. The user
    approved the study on 2026-10-19.
    The drawer is the DATA ×4 drawer plus the single board's two bosses.
    - The single board's USB-C moves onto the fourth U (drawer x 80, was 113.6).
    Its USB4105 lands where the ×4's J401 does, so the ×4 ledges carry it.
    - Its two Ø5 bosses stand under the ×4's bare underside, 0.8 mm from its
    second USB-C's shell leg.
    - Its PH 8 lead comes up the ×4's cable window and runs along the rear
    wall to its PH.
    - The AUX pigtail takes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
    [config.scad, drawer.scad, drawer.stl, drawer_block.stl, rack-bom.csv]
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2026-10-19 Power hub: CH224A PD sink instead of the AP33772S, no input switch
    The AP33772S has no LCSC stock (Global Sourcing only). The WCH CH224A
    (C42459160, in stock) takes its place in the one-resistor mode: CFG1 6.8k
    asks for 9 V at plug-in and turns I2C on, so the controller asks for 28 V
    EPR (else 20 V) over I2C. PG (open drain) keeps the PD_INT net: IO39 and
    the front PD LED. Its supply (VHV and VBUS tied) runs through 56 ohm +
    1 uF: the pins are rated 32 V.
    No input switch: VBUS is VRACK, and the eFuses (off until enabled, UV 15 V,
    reverse blocking) do the switching. Out: the IRF7842 pair, the 5 mohm
    shunt, the NTC and their passives. Re-routed: ERC 0, DRC 0, parity 0.
    37 -> 33 part type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
    [controller.kicad_sch, input.kicad_sch, power-hub-bom-jlcpcb.csv, power-hub-bom.csv, power-hub.kicad_pcb, power-hub.kicad_sch, rack-bom.csv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]
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2026-10-19 PCBA review: hub and node fixes before the order
    On main's CH224A hub and the bay node v0.5.
    Power hub:
    - CPL: the side LEDs (C598310, C4555382) +0.825 mm, their polarity
    proven from JLC's own footprints (and C495809 at 270 deg in the table,
    for the IRF7842 the AP33772S hub had).
    - Rows: SHDN pull-downs 10k, so rows stay off without firmware (100k
    gave 1 V at the pin's 10 uA); a B5819W at each row output for the
    cable's kick; the red FAULT LEDs fed from their ROW_EN, so a row that
    is simply off shows no fault.
    - In2's VRACK band 8 mm wide; the console's USB pair hand-routed on
    F.Cu over In1 (U5's channels in the pair's order), EN's capacitor at
    the module's pin; reliefs on bot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
    [bay-node-bom-jlcpcb.csv, bay-node-bom.csv, bay-node.kicad_pcb, bus.kicad_sch, cam.kicad_sch, controller.kicad_sch, dut.kicad_sch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]
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2026-10-19 Power hub firmware: a CH224A driver replaces the AP33772S ones
    The hub v0.5 now uses a WCH CH224A as its PD sink, in the one-resistor
    mode: CFG1 6.8k asks for 9 V at plug-in and turns I2C on.
    New: a regulator driver, wch,ch224a, out of tree in
    firmware/common/drivers/regulator. The chip has one function, so it is
    not an MFD. The register map comes from the WCH CH224 datasheet v2.1;
    Zephyr has no CH224 driver.
    - set_voltage writes 5, 9, 12, 15, 20 or 28 V to register 0x0A. When none
    of those is in the range, it asks for a PPS or AVS voltage, in 100 mV
    steps, inside a range the charger offers.
    - get_voltage returns the voltage asked for while the status says PD.
    The chip cannot repor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
    [ch224a.h, check_pinmap.py, dev_server.py, hub.h, pd.c]
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2026-10-20 DATA ×4: the PCBA review's fixes
    X2: the lead's SDA, SCL and INT go through three 2N7002 (gate on this
    board's +3V3, NXP AN10441) with 4.7k / 4.7k / 10k pull-ups on this side,
    and the lead USBLC6s' VBUS pins are open: with DUT_5V off the node's
    pull-ups no longer feed the dead board through the INA226 and TCA6408A
    clamps. X3: EN pulled down, every port off until the firmware enables
    it. X4: the Port netclass patterns get their leading *, VBUS and CC are
    drawn at each receptacle (0.4 mm, no via on the CC lines), the INA226
    reads Vbus on the shunt's sense pad, and R_ILIM sits beside its pin. X5:
    a shallow +3V3 tab and no via in the 2.5 mm +5V neck under the hub; the
    bottom row's GND pads g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
    [data-port-x4-bom-jlcpcb.csv, data-port-x4-bom.csv, data-port-x4.kicad_pcb, hub.kicad_sch, port1.kicad_sch, port2.kicad_sch, port3.kicad_sch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]
2026-10-20 DATA port: the PCBA review's fixes
    D1: VBUS drawn, 0.8 mm F.Cu from J2.8 under the PH's housing into both of
    J1's VBUS pad pairs, necked to 0.5 mm at the pad row (about 15 mOhm
    instead of the routed 0.25 mm's 0.13 Ohm), in a Power netclass; thin
    tracks to the Rp, C1 and the ESD's VBUS pin. D2: 10 uF 0805 at the
    receptacle (C2, a basic part). D3: Rp 56k, "default USB power" as on
    the DATA x4: 22k would advertise 1.5 A, above the node's TPS2553D low
    end of 1.34 A. D4: a meter check of each PH 8 lead in assembly.md. D5:
    checked in SolidCraft on B-rep (port wall with its U, board, USB4105, a
    largest-size plug overmold): the mouth's 0.28 mm overhang sits inside
    the U, 2.2 mm clear each side;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
    [data-port-bom-jlcpcb.csv, data-port-bom.csv, data-port.kicad_pcb, data-port.kicad_sch, port.kicad_sch, rack-bom.csv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]
2026-10-20 Camera pod: the PCBA review's fixes
    P1: the LED resistors are 100 Ohm 0805 (C17408, a basic part; no 82 Ohm
    exists as a basic 0805 or 1206). Over the LEDs' Vf spread at that
    current (about 2.65-3.2 V) and CAM_5V at 5.0-5.2 V that gives 18-26 mA
    per LED, at most 66 mW in a 125 mW resistor and 102 mA for the four,
    inside the node's camera budget. 56 Ohm 0603 gave 36-44 mA and up to
    108 mW in 100 mW. The light drops by about a third from the 32 mA
    first planned, about 0.6 EV, which the Mega's auto-exposure takes.
    P2: the AMS1117's ringing on its 22 uF MLCC is on the bring-up list,
    with the LED current. P3: a CAM_5V load switch on IO5/IO6 noted for a
    later node.
    The CPL audit agrees on all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
    [camera-pod-bom-jlcpcb.csv, camera-pod-bom.csv, camera-pod.kicad_pcb, pod.kicad_sch, rack-bom.csv]
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2026-10-20 DATA x4: ports off until admitted, the board's chips set up after DUT_5V on
    The DATA x4 PCBA review's fixes, on the firmware side. The multi-port
    node firmware is not written yet, so this commit covers the binding, the
    design and the simulated node, which is the API's contract until then.
    - hwtr,dut-port: a DATA x4 case.
    - EN is pulled down there: every port is off until the firmware
    switches it on, within the bay's budget.
    - RESET and BOOT are expander pins with 100k pull-ups, released as
    inputs (they read 1).
    - The board's chips are reached only while DUT_5V is on.
    - New sub-slot and hub-port properties, as docs/multi-dut-node.md's
    example already uses them.
    - multi-d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
    [dev_server.py]
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2026-10-20 Viewer: B1 on a DATA ×4 v1, B3 on the planned v2, Dupont ribbons to the boards
    B1 becomes a converted bay: a Pico 2 on port 2 and the FRDM-MCXN947 on port 4 (a third board leaves no
    room for its pegs' cams), its Pico's RESET wired to RUN from v1's 1 × 3 header. B3 shows the planned
    DATA ×4 v2 (`x4: v2`: a stand-in from the concept placement, the v2 session's 2 × 6 headers; the BOM and
    the order keep v1) and a UART between B3.1 and B3.2.
    Dupont jumpers, female–female, drawn as a board's ribbon: rod_cable routes its centreline at its true
    length (a Dupont wire's radius, stiffness and bend; rod_cable takes them as parameters now, and a coarser
    step), the wires stay bonded and flat, and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
    [boards.scad, rack-bom.csv]
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2026-10-20 Bay node: the DATA x4's four ports, minimal firmware
    The node can now serve a DATA x4 board in its drawer: four boards behind
    the hub, each on its own switch, current sense and RESET/BOOT lines.
    docs/multi-dut-node.md has the design. This is the minimal version.
    Devicetree: bay_node.dtsi describes the board.
    - dut_port1-4 (sub-slot, hub-port) sit on ports_io0/1, two TCA6408A as
    ti,tca9538.
    - port1-4_sense are INA226s on 100 mOhm shunts.
    - The pins come from data-port-x4/design.py.
    - The board is probed after each DUT_5V on. When 0x20 does not answer,
    the node keeps today's one DUT, so one image serves both.
    src/ports.c:
    - It drives the chips over I2C with shadow registers, not throug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
    [bay.h, dev_server.py, dut.c, emul.c, emul.h, main.c]
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2026-10-20 JLC cost: 7 DATA ports for the rack's 6, per-rack counts from the configuration
    B1 and B3 take a DATA ×4 each, so a rack needs 6 single DATA ports.
    The DATA port order now assembles 7, six plus a spare, instead of 8: an eighth would cost $1.62
    more, since 7 and 8 boards reach the same price breaks. Estimate $37.16, was $38.87.
    jlc-parts.md took its per-rack counts from a hard-coded PER_RACK that had drifted (7 DATA ports,
    1 DATA ×4). It now reads the counts the configuration gives the orders, as the volume tables do.
    The audit follows: one rack for $683.30 / $301.59 / $249.47 at 1 / 5 / 10 racks; 240 USB4105 for
    10 racks (16× JLC's stock); the USB-C, USBLC6 and DATA ×4 hub levers recou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
    [rack-bom.csv]
2026-10-20 Viewer: Dupont ribbons as elastic strips, black USB cables, whole Pico PCB
    The Dupont ribbons get a physical model:
    - The ribbon is a Kirchhoff rod with a material frame (ribbon_rod). It
    is soft out of its plane and 1 + 2/3 (n^2 - 1) times stiffer within it,
    since its outer wires would have to stretch.
    - At each end it lies across its housings in the strip's colour order.
    - Each wire runs straight out of its housing for 5 mm (DUPONT LEAD).
    - The strip stays whole until 15 mm past the leads, or twice the pins'
    spread where they spread wider.
    - From there, each wire's free end is an elastica (rod_cable). All free
    ends at one end are the same length: what the farthest needs, plus 8 %.
    -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
    [assembly_glb.py, board_models.py, rack.yaml, webscene.py]
2026-10-20 Viewer: the board models whole, in their makers' colours, meshopt-compressed
    board_models.py's viewer copy no longer decimates. On CAD meshes,
    decimation tore boards and chips: the Pico 2's parts were cut to 12
    faces each, since the budget went to its PCB layers. The RP2350 showed
    torn triangles over its pad.
    The copy keeps every part as drawn, with one PBR material per colour:
    - gold and bright grey parts read as metal (pins, pads, shields,
    sockets);
    - the solder mask lets the copper show through;
    - parts of one material are merged.
    STEP solids painted face by face are split by material. Before this,
    the glTF export kept only their first colour, so the XIAO's black mask,
    gold pads and F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
    [board_models.py, boards.yaml]
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2026-10-20 DATA ×4 v2 cradle: the standing board held in the rear bay; the horizontal v2's boss goes
    The DATA ×4 v2 now stands at the back of the drawer: 100 × 70, 4 layers,
    four vertical USB-C through the port wall's U's (the v2 session's numbers,
    2026-10-20). x4_cradle.scad is one printed part (≈ 15 g PETG, printed as
    installed, no supports):
    - a base on the three DATA ×4 bosses (H1–H3, 3 × PT 2.6×8), short of the
    cable window;
    - two uprights whose 1.9 mm slots take the board's 5.5 mm ends;
    - a latch finger with a hook over the board's top edge at each upright's
    top: press both back to lift the board out, without tools and with the
    drawer in;
    - two T-heads through 3.4 × 6.5 notches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
    [drawer.scad, x4_cradle.scad]
2026-10-20 Power pads connect solid on the DATA ×4, the DATA port and the camera pod
    The rule from d58f976, applied to the three boards. Each one declares its power nets in design.py:
    - DATA ×4: GND, +5V, each port's 5V_SW and VBUS
    - DATA port: GND, VBUS
    - camera pod: GND, CAM_5V
    pcbgen then connects their IC and connector pins solid to the pours. A small part with an end on a
    track keeps its reliefs. The .kicad_dru carries both rules.
    Now solid:
    - DATA ×4: the four receptacles' and J1's GND pins; the hub's, expanders', INA226s', switches' and
    ESDs' GND pins and exposed pads; the LDO's VIN, EN and GND on its islands. Eighteen GND pads the
    pour didn't reach (USB4105 A1/A12/B1/B12 among them) now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
    [camera-pod.kicad_pcb, data-port-x4.kicad_pcb, data-port.kicad_pcb]
2026-10-20 The node and the hub on an M5Stack CoreS3, a bench stand-in
    Both applications now build for m5stack_cores3/esp32s3/procpu, with one
    application overlay each, in the board files' pattern of the StampS3
    stand-in. docs/cores3-bench.md has what can be tested, the wiring, the
    flash routes from Windows and macOS, and a bench plan for each.
    Node:
    - The DUT goes on the CoreS3's own USB-C: USB host and USB/IP. Its VBUS
    comes from the battery boost (BOOST_EN on at boot) through the
    AW9523B's USB_OTG_EN, which becomes dut_port's enable, so bay power
    switches it.
    - AUX on Grove C, RESET/BOOT on Grove B.
    - The INA226 and a DATA x4 on Grove A. data-x4.dtsi takes its bus from
    DATA_X4_I2C.
    - SER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
    [rows.c, status_led.c]
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2026-10-20 Board tools: every footprint's 3D model must resolve; the TCA6408A gets a body
    KiCad's renders, STEP and GLB drop a footprint whose model file doesn't exist, without an error. The
    DATA ×4's two TCA6408A (U2, U6) rendered as bare pads: their footprint names a VQFN-16 3 × 3 model
    that KiCad's library doesn't have.
    - catalog: the TCA6408A borrows KiCad's QFN-16 3 × 3 body (same outline, pins and pitch; only the
    exposed pad underneath differs). KiCad has no VQFN-16 3 × 3 model at all.
    - build_board.py: check_models() runs with ERC and DRC on every run, and its result goes into
    build/summary.json. Each footprint's model must resolve to a file: KiCad's library, the repo's,
    or the EasyED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
    [data-port-x4.kicad_pcb]
2026-10-20 Board tools: a vertical USB-C, a ferrite, through-hole parts to solder by hand, three QFN bodies
    - footprints.py: HRO TYPE-C-31-D-06 (C2689964), a vertical (top-mount)
    USB 2.0 receptacle, from JLC's own land: 16 pads at 0.5 mm in two rows,
    four plated shell legs (SH, as the KiCad symbol), two pegs. JLC's
    EasyEDA footprint lands on it pad for pad, no CPL correction.
    - catalog:
    - usbc_v, with its EasyEDA STEP lifted 3.62 mm (the file is centred on
    the body);
    - fb600, Sunlord's GZ2012D601TF (C1017, basic): 600 ohm at 100 MHz,
    500 mA, for a quiet branch of a supply;
    - hdr2x6t, the 2 x 6 pin header in through-hole (HX PZ2.54-2x6P ZZ,
    C32713279), and ph8t, the JST PH 8 ver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
    [catalog.py, footprints.py, make_step_models.py]
2026-10-20 DATA x4 v2: the standing board, 100 x 70 mm, 4 layers, one face assembled
    The analyzer bays' DATA x4 v2 (v1 plus 32 switchable pins on 8 buses and
    an RP2354B logic analyzer) stands behind the port wall, in Mechanics'
    cradle (x4_cradle.scad). This is the layout study's option B ("v2 en
    100 x 60-70 oui"). It replaces the 108 x 37 horizontal board: that one,
    with parts on both faces, still left about 30 links open at 6 layers.
    - Outline: 100 x 70 mm, drawer x 4-104, no holes. KiCad y = 72.5 - z.
    - Each end's 5.5 mm sits in the cradle's slots: no parts on either face.
    - Two notches in the bottom edge (3.4 x 6.5 at board x 31 and 67) take
    the cradle's T-heads. The front face keeps 7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
    [coproc.kicad_sch, data-port-x4-v2-bom-jlcpcb.csv, data-port-x4-v2-bom.csv, data-port-x4-v2.kicad_pcb, data-port-x4-v2.kicad_sch, hub.kicad_sch, matrix.kicad_sch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]
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2026-10-20 Config: why B1's FRDM cable is a 15 cm 90°–90° with an upright loop
    A comment where the cable is configured, so nobody straightens it:
    - the two sockets are 26.7 mm apart, and two straight plugs need 56;
    - 15 cm is the shortest standard length that reaches;
    - the cable's weight can't fold two vertical exits 35 mm apart.
    That last point was checked by starting the elastica leant either way
    and by trying plugs angled sideways.
    [rack.yaml]
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2026-10-20 DATA x4 v2: the H5VU25UC ESD and 22 ohm USB resistors, two extended types fewer, re-routed
    The user's "essaie les 3 premiers ?", via the orchestrator: two part
    swaps, each an extended part type less in the panel order.
    - R23/R24, the RP2354B's USB series resistors: 27 ohm (C25100,
    extended) -> 22 ohm 0402 (C25092, basic). The RP2350's USB is Full
    Speed only: its driver's own impedance plus 22 ohm stays inside USB's
    28-44 ohm driver window, nearer its middle than 33 ohm. Said in
    design.py.
    - U4, U105...U406, the nine 4-line ESD arrays: TI TPD4E05U06DQAR
    (C138714) -> hongjiacheng H5VU25UC (C20615800, JLC "preferred
    extended": no Economic fee; $0.03 against $0.08).
    - On its own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
    [coproc.kicad_sch, data-port-x4-v2-base-bom-jlcpcb.csv, data-port-x4-v2-base-bom.csv, data-port-x4-v2-bom-jlcpcb.csv, data-port-x4-v2-bom.csv, data-port-x4-v2-panel-bom-jlcpcb.csv, data-port-x4-v2.kicad_pcb, hub.kicad_sch]
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2026-10-21 Printed parts: a design review of every part, with its checks and mock-ups
    A review only: nothing in mechanical/parts changes. docs/printed-parts-review.md
    ranks the findings (part, change, effort, risk, obvious fix or the user's call),
    sets one visual language for the family, compares heat-set inserts with captive
    square nuts joint by joint, and gives the numbers: every snap feature by the
    cantilever formulas and a CalculiX FEM of the deflected beam, every part's
    overhangs from its exact solid in print orientation, the nut trap's fit in
    SolidCraft. Eight findings are print-and-break risks: the tray's guide lips
    (2.5 mm flat shelves) and ledge starts, the cradle's latch finger and the cam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
    [cam_pin.scad, cradle_finger.scad, drawer_front.scad, ladder_nut_trap.scad, tray_guide.scad]
2026-10-21 Printed parts review: before/after pairs, one viewpoint, framed on each change
    Every proposed change as a side-by-side pair from one fixed camera, close on
    the feature, with callouts carrying the dimensions and the strain or stress:
    eleven pairs (tray lip and ledge start, cradle finger, ladder nut trap and
    hook, cam pivot, peg skins, camera sleeve tab, latch arm, anchor boss, drawer
    front and label, detent). Six more prototypes for them; pairs.sh renders the
    two views, compose.py puts them side by side. The whole-part renders go.
    [anchor_boss.scad, detent.scad, ladder_hook.scad, latch_arm.scad, peg_skin.scad, sleeve_tab.scad]
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2026-10-21 Printed parts: the review's snap fixes and dead geometry
    From the printed-parts review (findings 2, 4, 6, 8 and 15):
    - Cradle: the latch finger is 40 mm free, its hook 0.8, its slit 1.0, with
    an R0.8 round at the slit's foot: 0.21 % across the layers (was 0.72 %).
    - Pegs, cam base: a Ø4.4 × 2 relief in the column's top and a 6.5 split:
    0.69 % (was 1.44 %). The head stays Ø3.9. The half-pins bend by the
    head over the cam's 3.6 bore, not over the 3.4 pin, so a 3.7 head would
    hold the cam by 0.05 mm a side.
    - Pegs, plug: SKIN_H 3.4, the skins' slots run to the flat's far corner:
    3.7 mm free, 1.53 % (was 2.33 %).
    - Ladders: the hooks' roots 10 mm into the band, the reliefs' ends r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
    [board_plate.scad, drawer.scad, ladder.scad, peg_base_h10.stl, peg_base_h12.stl, peg_base_h5.stl, peg_base_h6.stl, peg_base_h9.stl]
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2026-10-21 Row cables: crimped in 24 AWG, the hub and nodes keep their PH 6
    The user's pick on 2026-10-21: real AWG 24 leads, the rows stay JST PH 6
    on the hub B1 and the nodes, no PH 8, VH or PA for now. JST rates PH's
    2 A only on 24 AWG. No ready-made lead fits: AliExpress's PH 6 leads are
    26 AWG or don't say, and Pololu's 24 AWG ones are 1:1 where the rows need
    pin n to pin 7-n. So the row cables are crimped.
    * BOM: _row_cables() replaces the AliExpress jumper and feed lots. It
    lists PHR-6 housings (C157952), SPH-002T-P0.5S contacts (C111515,
    24-30 AWG, half again as spares), a UL1007 24 AWG wire kit in five
    colours and an open-barrel crimper (Engineer PA-09). Wire lengths:
    150 mm jump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
    [rack-bom.csv]
2026-10-21 Power box: the lid carries only RST and BOOT, small and debossed
    The user's pick in the printed-parts review (finding 12b):
    - The rack's name comes off the lid.
    - RESET and BOOT become RST and BOOT: 3 mm capitals debossed 0.4 mm
    in the lid's top face beside the pin holes, printed face down as the
    first layers, in one colour.
    - The lid's inlay part (power_box_lid_labels) is gone from the build, the
    viewer and the BOM.
    - The walls' engraved labels and their optional inlay stay as they are.
    Only the lid's top face changed; its rim, screws and pin holes, and so its
    joints, are untouched. Tool tests: 76 OK.
    [power_box.scad, power_box_lid.stl, power_box_lid_labels.stl, rack-bom.csv]
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2026-10-21 Fasteners: four screw types, M3 × 8 and PT 2.3 × 8 everywhere
    The user's pick in the printed-parts review (finding 13): no more M3 × 6 or
    PT 2.6 × 8.
    - M3 × 8 replaces M3 × 6 for the node PCB, the power box lid and the
    camera pods. Where it reaches past an insert, the insert's hole runs
    on (lib/common.scad › insert_hole(runout)): the node's standoffs
    through the tray's floor, the pods' bosses through their tops. The
    lid's goes 5.6 mm into the spacers' 6 mm female threads; the plates'
    insert holes already went through.
    - PT 2.3 × 8 replaces PT 2.6 × 8 everywhere the printed pilots take one:
    the DATA board, the x4 cradle (clearance 2.6), the chain's end pieces,
    the fo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
    [camera_pod.scad, chain_anchor.stl, chain_foot.stl, chain_parts.scad, drawer.scad, power_box.scad, rack-bom.csv, tray.scad]
2026-10-21 DATA x4 v2: the usability review pass, layout B and a VBUS LED per port
    One pass and one re-route for the usability review (docs/data-x4-logic-usability-review.md),
    the user's go on layout B (2026-10-21):
    - Layout B: one 2 × 6 per port, its pin names in two lines over it, the port number and the
    VBUS LED by its west end. The headers sit 2 mm lower, at drawer z 28.5
    (rack.yaml › pcb.data_port_x4_v2.header), so the viewer's jumpers follow.
    - A green VBUS LED per port (KT-0805G C2297 through 1k) on PORTn_5V_SW, before the shunt, so the
    INA226 doesn't count it.
    - The LSF0108s' Vref_B/EN come from +5V_MX through 200k, not the port's VBUS, so each group is a
    voltage domain of its own.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
    [coproc.kicad_sch, data-port-x4-v2-base-bom-jlcpcb.csv, data-port-x4-v2-base-bom.csv, data-port-x4-v2-bom-jlcpcb.csv, data-port-x4-v2-bom.csv, data-port-x4-v2-panel-bom-jlcpcb.csv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]
2026-10-21 Camera pod: two screws on a diagonal, and its front lip attached
    The user's pick in the printed-parts review (finding 16):
    - The pod hangs on 2 × M3×8 on a diagonal instead of 4. The ceiling
    keeps its four inserts and its grid, so either diagonal works.
    - No locating rib: the pod prints ceiling face down, so nothing can stand
    proud of that face. The two screws already fix where it sits and how
    it turns.
    - The sleeve's front lip touched its wall only along an edge; it now
    runs under the wall and is one solid with the pod (a loose sliver in
    the print before). The sleeve's design waits for the Mega's real case
    (finding 5).
    SolidCraft: the pod with the Mega stand-in, its board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
    [camera_pod.scad, camera_pod.stl, rack-bom.csv]
2026-10-21 Drawer detent: a printed spring tab by default, the magnets still selectable
    The user's pick in the printed-parts review (finding 14), "after a test print,
    back to magnets if it doesn't suit". A new key, drawer.detent, chooses
    (config/rack.yaml, written to generated/config.scad as DRAWER_DETENT):
    - printed (the default): a spring tab cut in the tray's left ledge, 2.5 ×
    20 mm, free at its front end, with a 0.6 mm bump (45° both ways). The
    bump drops into a notch under the drawer's left wall: 0.56 % in the
    print plane, ≈ 3 N, no parts. The tab is at carrier y 155: under a
    sled's flange, whose notch cuts the flange too, so a sled gets the
    same detent; it stays clear of the lock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
    [config.scad, drawer.scad, rack-bom.csv, tray.scad]
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2026-10-21 Visual language, part 2: the ladders and the cradle
    The user's pick in the printed-parts review (finding 11), continued.
    - Ladders:
    - R3 on every outer corner, the rows', the base's and now the cap's
    bottom ones too, so the joints meet the same radius both sides;
    - the ridge stops short of the rounded corners;
    - each row ladder's letter (A, B) debossed 0.6 mm (6 mm capitals) on
    its front post, and FRONT with an arrow in its top band, on the face
    that prints on top.
    - Cradle: R1.5 on its uprights' four vertical edges, a 0.8 round on their
    outer top edges.
    - No screw-size text: the user wants it in the manual, not on the parts.
    The ladders' screw callouts are skipped eithe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
    [ladder.scad, x4_cradle.scad]
2026-10-21 Power hub: the rows stay inside the charger's contract
    A PD charger in overload cuts its output and the whole rack restarts; an
    eFuse only trips its own row. With a 100 W charger at 20 V as the default,
    the hub now keeps what the rows draw inside what the charger granted. The
    logic is in src/budget.c, pure and tested; rows.c feeds it.
    The budget comes from the contract, not from constants. It is the current
    the CH224A reports as granted (register 0x50) at the voltage negotiated,
    less a margin: CONFIG_HUB_BUDGET_MARGIN_PCT, 10 % by default, for the hub's
    own draw and IMON's error. The rows' current and the charger's limit are
    both currents at VRACK, so one rule covers every contract:
    - 2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
    [budget.c, budget.h, dev_server.py, hub.h, main.c, rows.c, shell.c]
2026-10-21 Cradle: three M3 × 8 into heat-set inserts in the drawer's bosses
    The user's pick (2026-10-21, "option 2"): a DATA ×4 v2 board is swapped
    often, so its cradle is held by M3 into inserts instead of PT screws
    forming their thread in the plastic.
    - The drawer's three DATA ×4 bosses grow from Ø6 to Ø8 for 2 mm of wall
    round an M3 insert. Each insert's hole runs on through the floor, since
    the M3 × 8 goes 0.7 mm past it.
    - The cradle gets Ø3.4 holes and counterbores for flush pan heads, and its
    feet rings widen round the bigger bosses. Its base runs 1.5 mm deeper.
    - The cable window's left edge stays 1.5 mm off the third boss, 1 mm
    further right; webscene's DATA leads follow (x_w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
    [drawer.scad, rack-bom.csv, x4_cradle.scad]
2026-10-21 Covers: a lid over a one-board rear bay, a box over a DATA ×4
    The rear bay closed from above once a bay is validated (finding 17 of the
    printed-parts review, the user's pick: V3 plus the 1× lid). One family,
    one fixing, both optional and outside the BOM's totals.
    - cover_lid1: a flat lid on the walls' tops over the single DATA port
    board, 12 g, 28 min on the H2D.
    - cover_box4: the same outline raised into a box over the standing v2
    in its cradle, 51 g, 1 h 42. A window in front of each port's VBUS
    LED and D1, vents over the board, and one notch along its front over
    the four headers, so it lifts off with the DUT leads plugged.
    - Both hook over the port wall's front face (lips bet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
    [cover_box4.stl, cover_lid1.stl, covers.scad, drawer.scad, drawer_block.stl, rack-bom.csv]
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2026-10-21 Bay node: a fatal error restarts the node and says why
    On the XIAO bench a kernel panic in the USB host's thread halted the
    node. Zephyr's default handler stops the CPU, and nobody sees the panic:
    the console is the USB host's. The node stayed dead until it was
    power-cycled. A bay in the rack has to come back by itself.
    src/fault.c:
    - overrides k_sys_fatal_error_handler: it keeps the reason and the
    thread in RTC slow memory (kept across a software reset, lost at
    power-on), flushes the log, and restarts the node;
    - a small log backend keeps the last 400 bytes of warnings and errors in
    the same record. They carry what the panic was about: "heap corruption
    at 0x...", an assertion,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
    [bay.h, fault.c, main.c, shell.c, web.c]
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2026-10-21 Standalone bays: the CH224K DIP-switch module, standing on its edge
    Electronics picked a CH224K trigger with a DIP switch, set to 20 V
    (AliExpress 3256811726090162, docs/cabling.md). The seller gives no
    size and its photos put it near 30 × 21 mm, too wide to lie flat in the
    Solo's left strip without widening the box by 9 mm. So in both boxes it
    now stands on its long edge at the rear left:
    - its back face on a 1 mm foam pad against a low wall, its PCB's edge
    on the rear wall, a 2.5 mm fence at its far end, under its output
    pads so their wires leave freely;
    - its USB-C upright in the rear wall: the collar and the overmold's
    cut turned 90°;
    - its DIP switch faces into the box, in re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
    [config.scad, standalone.scad, standalone_quad_base.stl, standalone_solo_base.stl, standalone_solo_lid.stl]
2026-10-21 Boards: every board in the rack from its maker's 3D model
    Row A and B1 drew stand-ins: grey slabs in the photos, flat blocks in
    the viewer. Every board now has a populated model from its maker, in
    the renders and in the viewer (each licence allows publishing it):
    - A1 NUCLEO-64 and A2 NUCLEO-144: ST's STEP files (NUCLEO-G474RE MB1367,
    NUCLEO-U575ZI-Q MB1549) from the boards' manufacturing specifications,
    under ST's Open Platform License Agreement (distribution for testing
    boards based on ST products: the user's call). The NUCLEO-64's USB
    moves to MB1367's ST-LINK (x 35).
    - A3 BeaglePlay (TI AM6254 + CC1352P7, CC BY 4.0) and A4 Wio Terminal
    (Seeed, Apache 2.0) replace the nRF5284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
    [boards.scad, camera_pod.scad, peg_base_h11.stl, peg_stop_h11.stl, rack-bom.csv]
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2026-10-21 DATA x4 v2: the RF review's fixes, crystal, upstream pair, split, edge fence
    The RF review's free fixes (a bench node whose Wi-Fi a USB 3 hub beside its antenna knocked out; this board
    has no SuperSpeed), before the v2 is ordered:
    - A, the crystal: Y1 turned 180° with C4 and C5 swapped, so XI and XO don't cross. XI is 11.9 mm on F.Cu
    over the GND plane, no via (was 30 mm round the hub, 2 vias, 12 mm on B.Cu); XO 15.5 mm, no via.
    - B, the upstream pair: drawn and locked in design.py. Both pins dive under the hub's body, then run side by
    side 0.15 mm apart, down its east side and west of J1 to its pins 5 and 6, over the +3V3 plane. 35.2 mm
    each, matched by a 0.6 mm bump (Freerouting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
    [data-port-x4-v2.kicad_pcb, matrix.kicad_sch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]
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2026-10-22 DATA x4 v2: the USB High-Speed pairs drawn on F.Cu over GND, 6 layers
    The HS review (the user's rule: keep the High-Speed pairs over a continuous
    GND reference, preferably on F.Cu above In1). Freerouting had put the port
    pairs mostly on B.Cu over the split power plane, each line its own way.
    - The four port pairs and the upstream one are drawn and locked in
    design.py as coupled pairs (0.15 mm apart, about 90 ohms), equal in length
    by construction: 95, 77, 61 and 47 mm, all on F.Cu over In1 GND. UP dives
    under the hub to B.Cu for about 11 mm, then runs on F.Cu to J1 (41 mm).
    - Ports 1-3's RESET/BOOT resistor columns move down, so the band over the
    headers carries the three pairs' lan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
    [data-port-x4-v2.kicad_pcb, rack-bom.csv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]
2026-10-22 Zephyr patch: a hub port that fails is no longer reset in a loop
    An MCU-Link behind the bench's full-speed hub made Zephyr's hub class
    reset its port over and over: once the resets had failed, any change
    the port reported started them again, with a fresh count and no delay.
    zephyr/usbh-hub-port-reset.patch, three commits as Linux does it:
    the connection is debounced (TATTDB) before a reset, the reset is
    polled until the hub ends it and the device gets TRSTRCY, the port
    status and change bits are logged when the port is not enabled, and a
    port whose resets all failed is reset again only on a new connection.
    firmware/common/tests/usbh_hub builds the patched hub class on native_sim
    against a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
    [main.c]
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2026-10-22 Zephyr patch: USB/IP reads serial converters ahead
    An FT232 on the bench lost bytes over USB/IP: its 256-byte receive FIFO
    overflows while the client's next read crosses the network, since its
    bulk IN endpoint is only polled while a read of the client is at the
    node.
    A ninth commit in usbip-removal-and-busid.patch (it overlaps the unlink
    fix): CONFIG_USBIP_READ_AHEAD keeps a transfer queued on the bulk IN
    endpoint of the devices the application picks, and answers the client's
    reads with the data received. At most USBIP_READ_AHEAD_DEPTH (8)
    replies of the client's read size are held, from the USB/IP pool; while
    they are all held the endpoint is not read, the node drops nothing. The
    FTDI fr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
    [main.c, serial_emu.c, test_usbip.py]
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2026-10-22 Bay node: /metrics clears its buffer, TCP's work queue gets 1.5 KB
    Under load on the bench XIAO (three USB/IP sessions, eight web clients),
    two things showed up:
    - /metrics answered 500 to every second call in a row ("metrics
    formatting failed: -12"). Zephyr's Prometheus formatter appends to the
    string already in the buffer, and the handler reuses the page's
    response buffer: after /api/status, /metrics even returned the status
    JSON followed by the metrics. The handler now empties the buffer
    first.
    - TCP's work queue peaked at 752 bytes of the 1024 that 745f232 gave it
    (304 with the USB/IP sessions alone). It gets 1536.
    Tried on the XIAO: /metrics answers 200 call after call,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
    [web.c]
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2026-10-22 DATA x4 v2: Freerouting runs its optimizer, and a tidy pass straightens pad exits
    The user found tracks leaving J1's pads by a short straight, a 0.2 mm jog
    and only then their diagonal. Freerouting's optimizer had never run: it
    only runs on a board it sees fully routed, and it saw 12 links open.
    - Drawn tracks now end on their pad's exact centre. Freerouting joins a
    track to a pin there only: 0.5-2.5 um off, it left the eight HS lines
    and the four port switches' IN open.
    - The links only the pours used to make are drawn: a via in each QFN's
    exposed pad (free fill and cap at 6 layers), U3's islands, the hub's
    pin 19, RN3's spare pad.
    - In4's +3V3 and +5V areas overlapped by 0.2 mm al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
    [data-port-x4-v2.kicad_pcb]
2026-10-22 Zephyr patch: USB/IP lists the imported devices for the application
    The bay page's USB devices card shows each device with its USB/IP state:
    the application has to know which device a client has imported, from
    where and since when.
    A tenth commit in usbip-removal-and-busid.patch (same file: it touches
    the import the earlier commits rework): usbip_get_sessions() fills the
    bus ID, the client's address and the uptime at the import of each
    imported device, under each context's lock; usbip_device_offered() tells
    whether the service offers a device at all (not a hub, not a device
    beyond USBIP_DEVICES_COUNT). About 32 bytes per context.
    Tested on native_sim (firmware/common/tests/usbip): a `sess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
    [main.c, test_usbip.py]
2026-10-22 Zephyr patch: USB/IP requests larger than the pool, in segments
    A mass storage device behind the node (the hub's card reader, a Pico in
    BOOTSEL) gets reads and writes of up to 120 KB, and USB/IP allocated each
    request whole from its 48 KB pool: those failed with -ENOMEM.
    An eleventh commit in usbip-removal-and-busid.patch:
    CONFIG_USBIP_SEGMENT_SIZE. The data of a request over it (not on the
    control endpoint) stays in PSRAM, from the shared multi-heap, or the
    system heap without one. It goes through the pool in transfers of that
    size, one after the other:
    - an IN stops at the first short transfer or error;
    - a failure reports the data transferred before it;
    - an unlink cancels the transfer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
    [main.c, storage_emu.c, test_usbip.py]
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2026-10-22 power-hub web: enrich node menu, fix shed row toggle, surface CAN/fault alerts and event ages
    [dev_server.py]
2026-10-22 Tools: route_farm no longer reports a cached score as a failed one
    The final score pass re-reads each run's score; a cached one fell through
    to the "scoring failed" message.
    [route_farm.py]
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2026-10-22 Boards: tracks straightened after routing, bends ranked; bay node and hub re-routed
    Freerouting leaves staircases of 45° and straight segments where one bend
    would do: they are no longer than the straight route, so nothing preferred it.
    - pcbgen.tidy_tracks now runs on every board after the import: a run of up
    to 12 router segments becomes the fewest straight and 45° segments joining
    its ends (octilinear.py: one, one bend, or a dogleg on one of the run's own
    lines), at no more length and with every clearance kept. Differential
    pairs, drawn tracks, exclusive cores, fan-out reservations and footprint
    keep-outs are left alone. tools/kicad.sh <board> --tidy runs it on a
    routed b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
    [bay-node.kicad_pcb, camera-pod.kicad_pcb, data-port-x4-v2.kicad_pcb, power-hub.kicad_pcb]
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2026-10-22 DATA x4 v2: a 4-layer build kept beside the 6-layer one
    The portfolio, with the split-plane fixes and the straightening pass, now
    routes the DATA x4 v2 clean on 4 layers (F, GND, power, B): 4 of 16 scored
    runs; one 4-layer run had left 27-29 links open before. The user asked to
    keep both versions in the repo.
    - electronics/data-port-x4-v2-4l: a design.py that builds the 6-layer design
    at X4V2_LAYERS=4, routed with run order2's session. 787 vias, 5173 mm,
    2001 bends; 0 open, copper DRC 0, parity 0, ERC 0; fab outputs. Checked
    by the Hardware CI. The rack keeps the 6-layer board.
    - pcbgen.tidy_tracks first widens a router track that Freerouting's
    neck-down left under the board's m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
    [coproc.kicad_sch, data-port-x4-v2-4l-base-bom-jlcpcb.csv, data-port-x4-v2-4l-base-bom.csv, data-port-x4-v2-4l-bom-jlcpcb.csv, data-port-x4-v2-4l-bom.csv, data-port-x4-v2-4l.kicad_pcb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]
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2026-10-22 DATA x4 v2 4-layer build: re-routed with no via in a small part's pad
    The kept 4-layer build (electronics/data-port-x4-v2-4l) had 18 vias in
    0402/0603 pads and one in a 0.4 mm pin. JLC fills vias for free only from
    6 layers. With the pipeline's fix (previous commit), the same 16-setting
    portfolio, optimizer off, gives 4 clean runs; ripup30-order2 is installed.
    - 749 vias, 5194 mm, 1932 bends; 0 open, copper DRC 0, parity 0, ERC 0.
    - Vias in pads: only the 8 drawn in the QFNs' thermal pads, accepted
    unfilled.
    - The High-Speed pairs are unchanged (drawn, on F.Cu over GND).
    - Gerbers and renders regenerated; BOM and CPL unchanged.
    - Docs: the runs, where the vias in pads came from and the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
    [data-port-x4-v2-4l.kicad_pcb]
2026-10-23 DATA x4 v2: the rack's board on 4 layers again, the 6-layer build kept
    The user's choice, now that the routing portfolio and its fixes route it
    clean: JLC04161H-7628 (F, GND, power, B), cheaper and faster than 6.
    - config pcb.data_port_x4_v2.layers is 4. electronics/data-port-x4-v2 is
    rebuilt on 4 layers and routed with run ripup30-order2's session: 750 vias,
    5194 mm, 1930 bends; 0 open, copper DRC 0, parity 0, ERC 0. Its only vias
    in pads are the 8 in the QFNs' thermal pads, accepted unfilled.
    - The order panel (a logic and a base, 100 x 142 mm) is regenerated from it:
    4 layers, ENIG, both halves matching their variants.
    - The 6-layer board moves to electronics/data-port-x4-v2-6l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
    [coproc.kicad_sch, data-port-x4-v2-4l.kicad_pcb, data-port-x4-v2-6l-base-bom-jlcpcb.csv, data-port-x4-v2-6l-base-bom.csv, data-port-x4-v2-6l-bom-jlcpcb.csv, data-port-x4-v2-6l-bom.csv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]
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2026-10-23 Power hub: rows C and D not fitted for now
    The user: "ne montons pas C et D pour l'instant". The rack has two
    rows, so the hub's rows C and D keep their footprints and routing, and
    their costly parts are DNP:
    - the eFuses U13/U14;
    - the connectors J4/J5;
    - the front LEDs D13/D14 (ON) and D23/D24 (FAULT).
    Their passives stay: FLT's pull-up keeps FLT high and the IMON
    resistor keeps IMON at 0 V, so the firmware sees no phantom fault or
    current. design.py's FITTED lists the fitted rows.
    * The schematic and the PCB carry KiCad's DNP flag on those eight
    parts, set without touching placement or routing. ERC 0, DRC 0,
    unconnected 0, parity 0.
    * Fab outputs: the JLC BOM and CPL leave the ei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
    [outputs.kicad_sch, power-hub-bom-jlcpcb.csv, power-hub-bom.csv, power-hub.kicad_pcb, rack-bom.csv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]
2026-10-23 Power hub: rows C and D not fitted on the first build
    The first build fits rows A and B only: U13/U14, J4/J5 and their LEDs
    are DNP (the FLT pull-ups and IMON resistors stay). power_hub.dtsi
    disables row_c and row_d.
    rows.c already left a row the devicetree disables alone: no enable, no
    FLT interrupt, no IMON, never in the budget or switched on. Such a row
    is now absent rather than off:
    - state "absent" in /api/status, never wanted, no /metrics series;
    - POST /api/row and `hub row` refuse it ("row not fitted"), and
    rows_cycle() returns -ENODEV for it;
    - the page leaves it out of the rack and of the budget legend; the
    shell's status and bayctl print it as not fitted.
    The dev server mo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
    [bayctl.py, dev_server.py, hub.h, rows.c, screenshots.py, shell.c]
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2026-10-23 JLC cost: the hub's rows C and D not fitted, the levers corrected
    The hub's rows C/D are DNP since c234f1f (the user: "ne montons pas C et
    D pour l'instant").
    * bom.py: two JLC_SINCE_QUOTE lines on the hub's 10-19 quote, -$10.59
    components and -$0.20 joints. Per board that's 2 x TPS26600, 2 x
    S6B-PH and 4 LEDs; 58 joints, 2 boards. No part type goes (rows A and
    B use each), so no feeder fee. The hub's order: $160.93 -> $150.14.
    The quote-minus-catalogue line falls back from EUR 17.14 to EUR 7.40.
    * electronics/lib/jlc_parts.json: the hub's lines from its JLC BOM
    (bom_lines(): 4 quantities), its parts untouched.
    * JLC_LEVERS:
    - the rows lever is applied, so it goes;
    - the hub's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
    [rack-bom.csv]
2026-10-23 Outputs: no more blobs for a date (JPEG renders, deterministic zips, keep_unchanged)
    Before the history rewrite (the user: "fais faire les outils
    anti-regonflement"), tooling so the repository doesn't grow back from
    regenerated binaries.
    * Board renders are JPEG, quality 85 on white: docs/<board>-top,
    -bottom, -iso and -panel-top.jpg. build_board.render() goes through a
    PNG in build/ and removes the old PNG; panelize uses it too. The
    committed PNGs of all seven boards (node, hub, DATA port, pod, DATA x4,
    v2, v2-6l) are converted with the same code and removed: 10.4 MB ->
    3.4 MB. Silkscreen text stays sharp. The README gallery,
    electronics.md and live_photo.py follow.
    * Gerbe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
    [build.py, build_board.py, fab_dates.py, keep_unchanged.py, panelize.py]
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2026-10-23 Power hub: 47 nF soft start, the LMR51625, the controller sheet on A2
    Fixes from the schematic counter-review that the user approved.
    * Every 22 nF goes to 47 nF. The new part is C1622 (basic, the same
    0603 pads). It covers C21-C24 (eFuse dVdT), C61-C64 (the IMON
    filter, now 47 us) and C118/C119 (the CAN split terminations).
    - A row of four nodes is about 450 uF. With 22 nF the soft start
    charged it at about 2.6 A, over the 1.6 A limit.
    - With 47 nF it charges at about 1.2 A. The ramp is 7.5 ms at 20 V
    and 10.5 ms at 28 V (t = 8e3 x V_IN x C_dVdT).
    - passives.py and its cache gain the 47 nF.
    * The hub firmware's FLT blanking goes from 10 ms to 25 ms
    (HUB_ROW_FLT_BLAN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
    [controller.kicad_sch, input.kicad_sch, outputs.kicad_sch, power-hub-bom-jlcpcb.csv, power-hub-bom.csv, power-hub.kicad_pcb]
2026-10-23 Bay node: AP2114H for the 3.3 V, camera ESD clamped to +3V3
    The schematic counter-review's fixes, approved by the user.
    - U2: AP2114H-3.3TRG1 (C150716, catalog ldo_1a) instead of the AMS1117-3.3.
    It is specified stable with ceramics (C11, C12); the AMS1117 guarantees it
    only with 22 uF tantalum. Same SOT-223 "H" pinout (1 GND, 2 and tab VOUT,
    3 VIN), footprint and copper: only the part's properties change.
    - U12, U13 (USBLC6 on the camera lead): pin 5 on +3V3 instead of CAM_5V.
    With CAM_5V off (the PTC tripped), the SPI lines would feed the pod through
    the upper diodes, and CAM_5V's clamp sits above the ESP32's 3.6 V. A
    minimal patch of the routing, no re-route: the CAM_5V stu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
    [bay-node-bom-jlcpcb.csv, bay-node-bom.csv, bay-node.kicad_pcb, bay-node.kicad_sch, bus.kicad_sch, cam.kicad_sch, dut.kicad_sch, power.kicad_sch]
2026-10-23 JLC: the DATA port's and the pod's real quotes; Economic assembles the whole order
    Real JLC quotes of 2026-10-23 (devis réel) replace the two estimates.
    The fab files came from main's d44251a and were uploaded from the
    user's account with the user's OK. Green, lead-free HASL, Economic.
    The quote pages were read; nothing went to the cart.
    - DATA port: 10 PCBs, all 10 assembled: $40.76 (estimate: $37.30
    for 7 of 10).
    - Camera pod: 5 PCBs, 2 assembled: $27.28 (estimate: $26.52).
    What the quotes show, now in the model:
    - Economic PCBA assembles every PCB of an order; 2 of 5 is the one
    exception. JLC's form offers 5 or 2 for 5 PCBs, only 10 for 10 and
    only 15 for 15, so the estimate's 7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
    [rack-bom.csv]
2026-10-23 JLC: the node's and the hub's real quotes; every board's order is quoted
    Real JLC quotes of 2026-10-23 (devis réel). The fab files came from
    main (the hub's 7ff9a52, the node's f9916db) and were uploaded from the
    user's account with the user's OK. Green, lead-free HASL, Standard
    PCBA with JLC's 5 mm rails. The quote pages were read; nothing went
    to the cart.
    - Node: 10 PCBs, 10 assembled, 40 types: $266.56. It replaces the
    estimate ($316.95 with its adjustments). No X-ray (the WROOM-1 is
    castellated), and JLC's parts cost $143.36 against the estimate's
    $178.61. D4, the WS2812B-2020, is reviewed after the order; it may
    cost an advanced option.
    - Hub: 5 PCBs, 2 assembled, 33 typ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
    [rack-bom.csv]
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2026-10-23 dev_server: the DATA x4 budget on the node's meter, as ports.c
    What the bay draws on the node's meter (the board's own ~380 mA
    included) plus 100 mA within 1150 mA, web.c's 409 texts, a port
    powered from elsewhere (/dev/foreign) refused, RESET and BOOT refused
    on an off port (503), and a cycle without "ms" as short as the port's
    VBUS takes. The node's current in /api/status is its meter's.
    [dev_server.py]
2026-10-23 DNS-SD: the node's and the hub's services, kept in step
    firmware/common/lib/dnssd.c hands the mDNS responder a table of DNS-SD
    records the application describes: under the hostname, the TCP services
    that listen right now, all with one TXT record. It asks the application
    again every 2 s (or at once on hwtr_dnssd_refresh()) and swaps the table
    only when something changed; the responder's lock makes the swap safe.
    - Node: _http._tcp (80); _usbip._tcp (3240) while the DUT, or the DATA
    x4's hub, is on the S3's USB (not in classic or service mode);
    _rfc2217._tcp (4001) while its listener is open. TXT: id, pos (rack
    position), fw, mode (usbip, classic, service) and, with a DATA x4,
    slots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
    [aux_console.c, bay.h, main.c, net.c]
2026-10-23 CH446Q: the DATA x4 v2's crosspoints as Zephyr MUX controllers
    drivers/mux/mux_wch_ch446q.c, in our module, written as it would sit
    upstream (binding dts/bindings/mux/wch,ch446q.yaml). Each X line is a
    control line (#mux-control-cells = <1>), its state the mask of the Y
    lines it joins (#mux-state-cells = <2>):
    - mux_control_set() writes only the switches that change: the 7-bit
    address y * 16 + x shifted on DAT, AY2 first, on CK's rising edges,
    then the switch state latched by a pulse on STB (the WCH datasheet's
    serial address mode);
    - mux_state_get() returns the mask last written (no readback);
    - mux_control_disconnect() opens X's switches.
    DAT, CK and STB on one port, the TCA9534A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
    [main.c]
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2026-10-24 Wi-Fi capacity study: channel choice in the busy case
    The orchestrator asked for one pass with the rack on channel 11 while the
    neighbouring BSS sits on 6.
    rack-wifi.cc gains per-BSS channels (--rackChannel, --dutChannel,
    --neighbourChannel) on ns-3's spectrum PHY. Unlike Yans, that PHY lets
    a transmission leak into the next channel through the 802.11 transmit
    mask.
    The new sweep (channel) shows:
    - With the rack on 11 and the DUTs' Wi-Fi and the neighbour on 6,
    8 flashes get 339 kB/s each instead of 155 (362 on a clean channel).
    At 4 flashes, control latency is back to a clean channel's.
    - The DUTs, a few cm from the nodes, still leak into the adjacent
    channel: 33 % airtime with one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
    [channel.csv]
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2026-10-24 Wi-Fi capacity study: in-bay DUT Wi-Fi on the rack's channel
    The channel pass put the DUTs' Wi-Fi on the other channel. That advice
    was wrong for DUTs inside the bays, as architecture.md already said: the
    first pass underrated the coupling in the rack. Its log-distance law
    stops at 1 m (59.7 dB at any shorter distance), and its DUTs sat 9.4 cm
    from their nodes.
    rack-wifi.cc gains --nearLoss, for free space plus 5 dB below 1 m (the
    BabbleSim study's model), and --dutCm. The new channel_near sweep puts
    the DUTs 3 cm from their nodes:
    - On the other channel, a DUT's transmit mask alone puts -23 to -35 dBm
    into its node's channel, against -49 dBm from the AP. Control
    requests take 0.6-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
    [channel_near.csv, ci_near.csv]
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2026-10-24 Wi-Fi capacity study: 802.11ax single-user and with OFDMA
    rack-wifi.cc can run the rack BSS as 802.11ax HE20, single-user or
    with DL and UL OFDMA from ns-3's round-robin MU scheduler, at a fixed
    HE MCS, and logs the RU sizes and the share of uplink frames sent in
    trigger-based PPDUs. The `wifi6` sweep compares them with 802.11n at
    8 and 16 bays, CI with and without 2 cameras: 198 runs.
    Wi-Fi 6 moves the saturation from about 8 to about 12 flashing nodes,
    through HE's PHY: single-user HE does it alone, +32 % per node at 16.
    UL OFDMA adds 8 % at 16 and costs latency below saturation. The doc
    says where ns-3's scheduler differs from a real AP, why OBSS-PD cannot
    help here, what Zephyr's ESP3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
    [wifi6.csv]
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2026-10-25 Schematic review of every board (2026-10-25)
    A pass over the schematics on main with the schematic-analyzer and
    ee-datasheet-master skills: netlists, ERC, pin maps against LCSC's
    symbols, cross-board links, I2C addresses and page-cited datasheets.
    New fixes: POS_IN can float high on leakage (R29 470k to 150k), DATA x4
    v2 port 5 against the co-processor's D+ at hub reset, AUX and ROW OUT
    take the same plug, the hub's ON LED resistors (10k to 18k), AUX has no
    ESD. Nine datasheet questions for the user; the BAT54S pinout and the
    CH224A's VBUS rating are answered.
    Docs fixed: the CH224A's EPR status is bit 4, the node's I2C pull-ups
    are 2.2k, J7's GND pins, the row cables' pin n to 7-n labels.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
    [rack.yaml]
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2026-10-25 Schematic review S1, S4, S6: POS_IN 150k, the hub's ON LEDs on 18k, the camera's 0.75 A PTC
    The user approved them ("S1 oui / S6 oui / S4 oui").
    * S1, bay node: R29 470k -> 150k (C22807, basic).
    - Before its firmware runs, the upstream POS output (a node's IO42, the
    hub's IO10-13) floats. The BAT54S's warm leakage (about 2-3 uA at
    65 C) could then lift POS_IN through 470k to VIL.
    - Driven high through R30 + R28, 150k still gives 2.87 V, above VIH.
    - The design.py notes and bay_node.dtsi follow.
    * S4, power hub: R41-R44 (the ON LEDs on the row outputs) 10k -> 18k
    (C25810, already on the board): 1.4 mA and 37 mW at 28 V. The 10k
    ran at 75 % of its 0603 rating at 29.4 V.
    * S6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
    [bay-node-bom-jlcpcb.csv, bay-node-bom.csv, bay-node.kicad_pcb, bus.kicad_sch, cam.kicad_sch, camera-pod.kicad_pcb, outputs.kicad_sch, pod.kicad_sch]
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2026-10-25 Datasheet audit F1-F6: the pod's AP2114H, STB 5.1k, PC_DET hysteresis, the camera ESD's 100 nF, the eFuse step
    The user approved the audit's fixes for the node, the hub and the pod
    ("Go pour 1"); docs/datasheet-audit.md marks F1-F6 applied.
    * F1, camera pod: U1 AMS1117-3.3 -> AP2114H-3.3TRG1 (C150716, catalog
    ldo_1a, the node's U2).
    - The AMS1117 is specified stable only with 22 uF tantalum; the
    AP2114H is stable with the ceramic C2.
    - Same SOT-223 pinout, copper (the +3V3 pour and island round the
    tab stay) and 180 deg CPL correction.
    - One more extended type on the pod's Economic order: +$3.09 and
    $0.05 of parts (JLC_SINCE_QUOTE).
    * F2, power hub: R214 (TJA1462 STB pul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
    [bay-node-bom-jlcpcb.csv, bay-node-bom.csv, bay-node.kicad_pcb, bay-node.kicad_sch, bus.kicad_sch, cam.kicad_sch, camera-pod-bom-jlcpcb.csv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]
2026-10-25 DATA x4 v2: D2 holds the co-processor in reset with the hub (schematic review S2)
    With CFG_SEL 000 the USB2517 samples each downstream D+ / D- as a
    port-disable strap when RESET_N rises, and one high line disables the
    port (DS00001598C Table 5-1 p.10, checked by the user): the RP2354B's
    D+ pull-up on port 5 must not be up by then.
    - D2, one Schottky of a BAT54S (C7420333, preferred, no fee; VF <= 240 mV
    at 0.1 mA, <= 320 mV at 1 mA) from CP_RUN to HUB_RST_N, on both
    variants (its second diode open). RUN sits at ~0.3 V while RESET_N is
    low (R25's ~0.33 mA), under the RP2350's VIL 0.8 V.
    - R25 now also charges C6: the hub's reset to VIH 2.0 V goes from ~9.3 to
    ~4.6-5 ms, >> the 1 us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
    [data-port-x4-v2-base-bom-jlcpcb.csv, data-port-x4-v2-base-bom.csv, data-port-x4-v2-bom-jlcpcb.csv, data-port-x4-v2-bom.csv, data-port-x4-v2-panel-bom-jlcpcb.csv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]
2026-10-25 DATA x4 v2: datasheet audit fixes 1-9, conservative options, CFG_SEL 110
    The DATA x4 v2 datasheet audit's fixes, approved by the user, plus the
    conservative options that close U2, U8, U9 and U10:
    - Core regulator (fixes 1-3).
    - L1 on a polarity-marked land: bench:L_Abracon_AOTA-B201610, RP's
    0.7 x 1.7 mm pads, the dot on pad 1 = +1V1 (U1's answer).
    - The block is Raspberry Pi's RP2350B Minimal R4-S1 one, turned 180
    degrees with U11, at their coordinates. CIN and COUT sit on RP's
    0402 land (bench:C_0402_1005Metric_RP), so LX runs 0.3 mm between
    them.
    - Copper: their F.Cu areas (LX, +1V1 with the two V_OUT vias, PGND
    with its two vias, VIN) and their settings; VREG_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
    [coproc.kicad_sch, data-port-x4-v2-base-bom-jlcpcb.csv, data-port-x4-v2-base-bom.csv, data-port-x4-v2-bom-jlcpcb.csv, data-port-x4-v2-bom.csv, data-port-x4-v2-panel-bom-jlcpcb.csv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]
2026-10-25 DATA x4 v2: the co-processor's USB pair leaves past the V_OUT vias
    The regulator block's routing keep-out reached east of the V_OUT vias, over
    USB_DM / USB_DP (U11 pins 66, 67), so the router took the pair inwards with
    micro-jogs (the user's find). It now stops at the vias, and the pair
    leaves past their east side as on Raspberry Pi's board.
    - Only CP_DP / CP_DN rerouted near U11, with the tidy pass.
    - ERC 0; DRC errors 0 (the 4 silkscreen warnings on U107-U407 predate
    this); unconnected 0; parity 0.
    - All 12 ESD lines still in flow-through.
    - Micro-jogs on the board: 104 -> 95, none on the pair (main had 86).
    - Gerbers, panel, renders and GLBs regenerated.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
    [data-port-x4-v2.kicad_pcb]
2026-10-26 tidy: remove the router's micro-jogs (unjog), every routed board re-tidied
    The tidy pass left Freerouting's micro-jogs: a few short segments stepping
    a track sideways between two parallel runs, often where it necks down to
    pass two pads, or up and back down. It straightens one width at a time
    and keeps a pad's centre, so these slipped through (the user's find on
    the DATA x4 v2's co-processor pins).
    unjog(), tidy_tracks()'s last step, now handles them:
    - one of the two parallel runs slides onto the other's line, each segment
    keeping its width; the segment beyond must stay straight or at 45
    degrees, or the run's end stay inside its pad;
    - where the clearance needs the offset, the jog bec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
    [bay-node.kicad_pcb, data-port-x4-v2.kicad_pcb, data-port-x4.kicad_pcb, power-hub.kicad_pcb]
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2026-10-26 Boards: labelled bottom test pads; hub dVdT 100 nF, 50 ms FLT blank
    Eve's DFT rule on the four boards this session owns: bare pads on the
    bottom, named on B.SilkS, out of the BOM and the CPL (no part, no
    assembly fee). Supply pads 1.5 mm, signal pads 1.0 mm (new catalog
    entry "testpad1"), all more than 2 mm from any THT pad or hole
    (closest: 4.7 mm, the pod's TP4). Positions are fixed in design.py,
    so they stay put across revisions.
    - bay node, 17: TX, RX, 3V3, GND by the module (kept), then EN, IO0,
    FLT (DUT_FLT_N), ALRT (INA_ALERT_N), SDA, SCL and a second GND;
    a supply row along the bottom edge: GND, VIN, 5V, 3V3, DUT 5V,
    CAM 5V
    - power hub, 20: TX, RX, 3V3, GND, 5V, VRACK, GND (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
    [bay-node.kicad_pcb, cam.kicad_sch, camera-pod.kicad_pcb, controller.kicad_sch, data-port.kicad_pcb, dut.kicad_sch, mcu.kicad_sch, outputs.kicad_sch]
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2026-10-26 Retire the DATA x4 v1 board
    Never ordered: the DATA x4 v2's base variant does its job (hub, four
    USB-C sources, per-port current, RESET/BOOT). Its folder, its Hardware
    CI entry and its prices in bom.py go; the rack BOM is regenerated.
    config/rack.yaml keeps pcb.data_port_x4: the drawer, the carrier and the
    viewer's plugs place the v2's ports from it. docs/electronics.md keeps
    the v1 section, marked retired, since the v2 builds on it; git history
    keeps the board.
    [data-port-x4-bom-jlcpcb.csv, data-port-x4-bom.csv, data-port-x4.kicad_pcb, data-port-x4.kicad_sch, hub.kicad_sch, port1.kicad_sch, port2.kicad_sch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]
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2026-10-26 bay-node: what the front display costs (LVGL, ST7789V2, CST816)
    The user picked a Waveshare 1.9" touch LCD for the node's revision B: an
    ST7789V2 at 320 x 170 on SPI and a CST816 touch controller on I2C. The
    front-display snippet builds it into bay_node with LVGL and a status
    screen (bay id, address, DUT power, DATA x4 ports, USB/IP sessions).
    - firmware/snippets/front-display: the Kconfig fragment, with LVGL down to
    labels, buttons and images (the default theme links every widget built:
    69 KB), and bay_node's devicetree: SPI2 shared with the camera, CS on IO5
    and DC on IO6 (the node's two free pins), the resets on EN, the touch
    controller polled on I2C0.
    - firmware/bay-node/src/di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
    [bay.h, display.c, main.c]
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2026-10-27 Plate layout: the drawer's new front over the plate, the walls' real faces
    The pegs' solver didn't know what hangs off the new front. On d9a6ef3,
    B3.3's front cam (row 1, hole 8) sat under the display's frame and the A2
    Nucleo-144 (y 4.7) over the frame's left leg. SolidCraft, on main: the cam
    cuts the frame's leg (21 mm3), the module (13 mm3) and an M2 head (14 mm3);
    the PCB cuts the leg (8.5 mm3).
    - Grid.front: plate_keepouts' display and front's joint areas. Only a
    peg's flange (1.2 mm) may go under them, and no board over them.
    - The wall datums are measured from the walls' real faces, 0.5 mm off. The
    right wall is 3.2 mm off the plate now (the display lead's gap): a board
    lea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
    [rack-bom.csv]
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2026-10-27 Power hub: J1's GND via out of the A12/B1 pad (PH-1)
    The kicad-happy review's PH-1: the 0.5/0.3 GND via drawn under J1's
    left GND pads (A12/B1) sat inside the pad, open on top, so its barrel
    could drain the solder of the 5 A input's GND contact. It moves out,
    north of the pads under the receptacle (58.35, 5.3), between the shell
    leg and the peg, on a short drawn 0.3 mm track from the pad's centre.
    South of the pads is the input pour's throat to the left VBUS pads
    (A9/B4): vias there cut it off. The router's own GND via at
    (58.18, 4.92), 0.4 mm from the new one, went with it.
    Routed incrementally: the other 1262 router tracks and vias are the
    ones on main, untouched.
    Two fixes the change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
    [power-hub.kicad_pcb]
2026-10-27 DATA port: GND vias by the lead's GND pins and the ESD (DP-2)
    The kicad-happy review's DP-2: J2.4 and J2.7 carry the whole DUT return
    (up to 1.52 A), and the F.Cu island around them went down to the B.Cu
    pour through a single 0.3 mm via. Each pin now has a drawn 0.5 mm stub
    from its pad to a GND via beside the pad's end, at (8.65, 9.9) and
    (14.6, 10.0).
    The via by pin 4 sat on D-'s (LEAD_DN's), so Freerouting re-routed D-
    alone: 13.0 mm instead of 11.1, still two vias. D+ (8.6 mm) is
    unchanged. Its first attempt walled the ESD's GND pin (U1.2) off the
    F.Cu pour, so U1.2 also gets its own via, under the part between its
    rows: the short GND the USBLC6 wants.
    Every other track and via is m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
    [data-port.kicad_pcb]
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2026-10-27 DATA port: 100 nF at the ESD's VBUS pin (DP-5)
    The kicad-happy review's DP-5: ST's USBLC6 datasheet (section 2.3,
    Fig. 18) puts 100 nF right at VBUS (pin 5). Here the nearest was C1,
    4.9 mm away in a straight line but about 28 mm of track, and the
    datasheet audit wrongly gave 4.5 mm. C3, a 100 nF 0402 (C1525, basic,
    already on the DATA x4 v2), now sits on the thin track that feeds
    U1.5. It is 0.7 mm pad to pad from the pin, between J2's and U1's
    courtyards (1.36 mm apart: an 0603 doesn't fit), with its own GND via
    at (18.3, 10.72). The feed track now ends at C3.1's centre, so
    Freerouting sees the pad joined.
    J2's open pins 1-3 lose their "·" labels: C3 sits under pin 3. The
    datasheet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
    [data-port-bom-jlcpcb.csv, data-port-bom.csv, data-port.kicad_pcb, port.kicad_sch, rack-bom.csv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]
2026-10-27 DATA x4 v2: the 32 P lines drawn through their ESD, and a flow-through check in CI
    Six P lines (PORT2_P4, PORT2_P5, PORT3_P3, PORT3_P4, PORT3_P5, PORT4_P5)
    reached their 100 ohm array without crossing the H5VU25UC pad pair, so the
    clamp hung off a stub. design.py now draws and locks every P line:
    header pin on B.Cu to a via, then F.Cu through the ESD pad, across to its
    partner pad and on to the RN pad. Each H5VU25UC's GND pads share one
    drawn track to one via, between the lane vias. PORT1/PORT4_5V_SW lost
    their old B.Cu gap to P5/P6 and are drawn by hand on a short path.
    electronics/tools/flowthru.py checks the board text alone (no pcbnew):
    with the two ESD pads taken out of the net, the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
    [data-port-x4-v2.kicad_pcb]
2026-10-27 Power hub: 18 more labelled bottom test pads (PH-2)
    The kicad-happy review's PH-2, against Eve's rule: three bring-up
    checks had no probe point (the +5V_BUCK load step, a row's output
    during a short, the CAN common mode). TP21-TP38, bare pads on B.Cu
    named on B.SilkS, out of the BOM and the CPL:
    - 1.5 mm: 5V BUCK, USB 5V, VHV (the CH224A's), ROW A-D, and a GND by
    the CAN pads;
    - 1.0 mm: PD PG (PD_INT), CANH, CANL, TXD, RXD, EN A-D (ROW_EN), VSNS
    (VBUS_SENSE).
    Each pad sits where its net already is, so no routing moves:
    - 7 on a new drawn via, on one of the net's F.Cu track bends or in
    its pour (5V BUCK, USB 5V, VHV, PD PG, TXD, RXD, GND);
    - 5 on a via the router had put there, now dr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
    [controller.kicad_sch, input.kicad_sch, outputs.kicad_sch, power-hub.kicad_pcb]
2026-10-27 DATA x4 v2: C17 along the top edge, 5 mm in from the panel's bites
    C17 (the hub's 100 nF on +3V3) stood across the panel joint, its
    courtyard 1.84 mm from tab1's mouse bites: snapping the joint bends the
    board right under a 0402 standing across the bend. It now lies along
    the edge (180 degrees), east of the straps' RN2, 5.0 mm from the holes;
    the way toward pin 46 is filled by the MAX809S, RN2 and the strap
    resistors. Its fan-out vias follow; the place it left takes one more
    GND stitching via. The nearest part to a bite is now C6, along the
    edge, 2.93 mm.
    The panel notes ask for the tabs to be cut, not the joint snapped, and
    give the current clearances (the copper figure was stale).
    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
    [data-port-x4-v2.kicad_pcb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]
2026-10-27 Bay node: 15 more labelled bottom test pads (BN-2)
    The kicad-happy review's BN-2, against Eve's rule: no pad on the camera
    SPI, CAN TXD/RXD, POS_IN/POS_OUT, or the DUT's UART1 and RESET/BOOT, and
    all three GND pads in the x 43-46 column. TP18-TP32 are bare pads on
    B.Cu, named on B.SilkS and kept out of the BOM and the CPL. The
    signals are 1.0 mm and each group's GND 1.5 mm:
    - the camera SPI by R31-R34, on the lead side of the 33 ohm resistors:
    SCK, MOSI, MISO, CS, GND;
    - by U11: CAN TXD, RXD, POS IN, GND;
    - by the AUX column: AUX TX, AUX RX, RST, BOOT, POS OUT, GND.
    Each pad sits where its net already runs, so no routing moves:
    - 8 on a new via drawn on one of the net's F.Cu tracks (the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
    [bay-node.kicad_pcb, bay-node.kicad_sch, bus.kicad_sch, cam.kicad_sch, dut.kicad_sch]
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2026-10-27 DATA x4 v2: rear test pads on buses A-H and the expanders' RESET
    Eve's DFT review asked for probe points on the eight crosspoint buses
    and on both TCA6408A RESET lines, with a GND beside them. Eleven bare
    rear pads (TPS, out of the BOM and CPL, named on B.SilkS):
    - TP29-TP36, buses A to H (1.0 mm), behind the co-processor's east
    side where all eight pass. A, B, E and F sit on a rear track of their
    own, C, D and G beside one; H, front only, comes down a drawn via.
    Each goes where its bus passes, 2.6 mm or more from the next.
    - TP37 GND (1.5 mm), with a drawn via east of it: the automatic one
    went west and moved RN8's +3V3 dog-bones.
    - TP38 / TP39 EXP1 / EXP2 RST, each by its pull-u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
    [data-port-x4-v2.kicad_pcb, hub.kicad_sch, matrix.kicad_sch]
2026-10-27 DATA x4 v2: regenerated, U11's redundant exposed-pad fan-out dropped
    The first regeneration since the node's BN-2 (pcbgen.fanout_pads leaves
    a pad that already holds a drawn via of its net alone). The RP2354B's
    exposed pad (U11.81) has its drawn GND via, so its fan-out goes: a
    2.05 mm F.Cu track north from the pad's centre and its via at
    (47.0, 10.85). +1V1's F.Cu run beside it, no longer pushed round that
    via, straightens (4 segments to 3). No other net moves.
    [data-port-x4-v2.kicad_pcb]
2026-10-27 DATA x4 v2: why the hub's old strap pull-downs stay
    CFG_SEL 110 no longer reads RN1, R3, R4, R5 and R9's pins, and removing
    them was weighed. They stay: the pins are LED outputs and SUSP_IND,
    I/O12 buffers that may go high-impedance with nothing on them, and
    DS00001598C never says their input receiver is off then (Table 5-3
    p. 16; Table 8-2 p. 50 gives only a tri-state leakage). The 10k keep
    those inputs from floating, and leave a return to strap mode open by
    reworking CFG_SEL's two pull-ups alone. Docs and a design.py comment
    only; no output changes.
    [design.py]
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2026-10-27 DATA x4 v2: J1.8's missing spoke was the split's, not pin 7's
    1cf6296 said pin 7 sits 0.25 mm above J1.8 and took a spoke. It
    doesn't: J1's pads are 1.2 mm along the row at a 2 mm pitch, 0.8 mm
    apart, and J1.8 kept its upper spoke. The fourth one, west, fell on
    the power plane's +5V / +3V3 split. The comment and the docs now say
    so; nothing else changes.
    [design.py]
2026-10-28 DATA x4 v2: C1 2.7 mm off J1.8, out of the hand-soldered joint's way
    J1, the lead's PH 8, stands on the rear face, so its pins are soldered
    by hand on the front face, among the parts JLC places. C1, J1's 22 uF
    +5V bulk capacitor in 1206, had its GND end 0.9 mm from J1.8's pad
    (the lead's +5V, solid on the plane since 1cf6296 and so slow to
    heat): a bridge there would short the board's supply. C1 moves 2.6 mm
    down, to 2.7 mm off it; nothing else stands there. Its two dog-bones
    (GND, +5V) follow and one GND stitching via gives way. No other net
    moves; no routing.
    U4, the lead's ESD array 1.3 mm from J1.1-J1.3, stays: the upstream
    USB pair, drawn, runs right east of it.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
    [data-port-x4-v2.kicad_pcb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]
2026-10-28 Antennas: a check on every board, a cleanup after every import
    Eve's layout review (2026-10-28): "les antennes PCB sont légion".
    electronics/tools/antennas.py finds them in the board file alone, so
    it runs in CI:
    - a dead end: a track end that meets nothing of its net;
    - a lone via: one that meets its net on one layer, or none;
    - a double: two collinear tracks of one net that overlap;
    - a sliver: a track 0.1 mm long or shorter.
    tools/tests/test_antennas.py prints every board's count and holds it
    to none, but on the boards electronics/antennas.json still lists:
    today all five. Bay node 32, camera pod 4, DATA port 4, DATA x4 v2
    180, power hub 46; doubles and slivers only, no dead end or lone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
    [antennas.py, build_board.py, pcbgen.py]
2026-10-28 DATA port: its antennas off, a dangling track now a DRC error
    tools/kicad.sh data-port --clean (pcbgen.clean_antennas), on the
    routed board as it was, no re-route. Four router leftovers go:
    - a doubled VBUS run on F.Cu from TP2 (the VBUS test pad) towards J2
    (the lead's PH 8): the shorter track lay along the other;
    - a 7 µm VBUS dot on F.Cu near R1 (CC1's 56k Rp);
    - a 97 µm CC1 step at R1's pad 2, folded into its neighbours;
    - a 95 µm LEAD_DN stub on B.Cu inside its own via.
    ERC, DRC (0), the flow-through check and connectivity are unchanged.
    data-port leaves electronics/antennas.json's pending list:
    test_antennas now holds it to none. Its .kicad_pro makes a dangling
    track or via an e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
    [data-port.kicad_pcb]
2026-10-28 Camera pod: its antennas off, a dangling track now a DRC error
    tools/kicad.sh camera-pod --clean (pcbgen.clean_antennas), on the
    - a doubled LED_K run on F.Cu down past TP9 (LED_K's test pad): a
    track lying inside the longer one;
    - two CAM_5V steps of 36 and 71 µm at C1 (U1's 10 µF input
    capacitor), folded into their neighbours;
    - a 62 µm +3V3 stub inside its own via, beside C2 (U1's 22 µF
    output capacitor).
    ERC, DRC (0) and connectivity are unchanged. camera-pod leaves
    electronics/antennas.json's pending list; its .kicad_pro makes a
    dangling track or via an error.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
    [camera-pod.kicad_pcb]
2026-10-28 Bay node: its antennas off, a dangling track now a DRC error
    tools/kicad.sh bay-node --clean (pcbgen.clean_antennas), on the
    routed board as it was, no re-route. 32 router leftovers go:
    - 3 doubled runs on F.Cu: CAN_TXD (the CAN transceiver's TX),
    PC_VBUS and PC_CONN_DN (the PC USB-C's VBUS and D-, before U4,
    its ESD array);
    - 28 tracks of 0.1 mm or less, folded into their neighbours or, where
    they lay inside their own via or pad, taken off: on the camera's
    lines (CAM_CS_P, CAM_MOSI, CAM_LED, LED_K), CAN_H/CAN_L, VIN,
    BUCK_EN, DUT_5V and DUT_FLT_N (U9, the DUT's VBUS switch), EN, U0RX,
    AUX_TX and MUX_SEL among them;
    - SVC's 97 µm step past U5 (the PC-side USB mux), which can't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
    [bay-node.kicad_pcb]
2026-10-28 Decoupling: each capacitor's pin declared, a check on every board
    Eve's layout review (2026-10-28): "les capas de découplage sont
    parfois loin de la pin". Each board's design.py now names, in
    b.pcb["decoupling"], the power pin every decoupling capacitor serves
    ("C14": "U3.3V3"; a pin by name stands for the part's pads on its
    net, a tab and its pin both). electronics/tools/decoupling.py
    measures from the board file alone, so it runs in CI:
    - the capacitor's pad on the pin's net to the pin's pad, edge to
    edge: 2 mm at most;
    - its other pad (GND) to the nearest GND via or through-hole pad,
    edge to edge: 1 mm at most.
    tools/tests/test_decoupling.py prints each board's table, fails on a
    de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
    [decoupling.py, design.py]
2026-10-28 Power hub: its antennas off, and a fan-out that no longer doubles one
    pcbgen.fanout_pads: a pad's track to its plane via can no longer run
    along a fan-out track already there, collinear and sharing a run (a
    doubled track). On the hub, U4.60's track (the ESP32-S3-MINI-1's
    GND, the controller module) ran left at y 6.05 across U4.62 and over
    U4.62's own track, both locked, so the cleanup couldn't take it.
    U4.62 now leaves by a diagonal to its own via at (21.64, 6.61); the
    GND fan-out still reaches all 121 pads. Crossing or touching
    tracks are still allowed: rejecting them cost the hub five GND vias.
    The hub rebuilt and routed incrementally: the previous routing grafted
    (1256 of 1256 router i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
    [power-hub.kicad_pcb]
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2026-10-28 DATA x4 v2: the co-processor's crystal kept clear on F.Cu, its lines drawn
    Eve's layout review (2026-10-28), the same treatment as the hub's
    crystal, on F.Cu. Y2 (the RP2354B's 12 MHz crystal) already had its
    lines on F.Cu with no via, 5 mm over XIN/XOUT (pins 30/31); turning it
    shortens nothing, since the pins are 0.4 mm apart and C47 (DVDD pin
    32's 4.7 uF) stands right over them. What changes:
    - BUS_D (crosspoint bus D) ran under Y2 with a via. It now goes round:
    103.3 to 116.7 mm, 7 vias to 8.
    - XOUT ran under C47's body, between its pads. Now drawn up beside
    XIN and over C47 to R22 (the 1k series resistor): 5.4 to 5.6 mm.
    XIN (7.8 mm, up between the case's two bottom pads) and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
    [data-port-x4-v2.kicad_pcb]
2026-10-28 Camera pod: C1 and C2 each beside their own pin of U1
    The decoupling check had both of U1's capacitors (U1: the AP2114H,
    the camera's 3.3 V) far from their pins: C1 (10 µF, CAM_5V in) 8.0 mm
    from VI, right of the tab, and C2 (22 µF, +3V3 out) 2.26 mm from
    VOUT, left of the pins beside VI. They swap sides:
    - C1 now sits left of VI (pin 3): 0.65 mm pad to pad;
    - C2 sits right of the tab (VOUT): 1.55 mm, its +3V3 pad joined to the
    tab's copper. It sits high enough that SCK keeps its F.Cu diagonal
    below it; a first try 0.8 mm lower pushed SCK onto B.Cu, across
    the tab's bottom-side +3V3 island.
    - Each gets a drawn GND via beside its GND pad: C1's 0.30 mm away,
    C2's 0.10 mm.
    Routed in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
    [camera-pod.kicad_pcb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]
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2026-10-28 Bay node: C14 beside U3's 3V3 pin, C13 below it
    U3's (the ESP32-S3-WROOM-1's) 100 nF, C14, sat 4.6 mm from its 3V3
    pin (pin 2), behind the 22 µF C13. C14 now stands right beside the
    pin, 0.57 mm pad to pad: x 21.45, its courtyard 0.07 mm short of the
    module's (x 22.25). C13 moves 3.2 mm down, below it: 1.56 mm from
    the pin. Each keeps its own fan-out via to the In2 +3V3 area, and
    its GND pad one to In1. A first try with C14 lying down overlapped
    the module's courtyard.
    Routed incrementally: the previous routing grafted (1001 of 1052
    router items), only EN, AUX_TX and DATA_INT rerouted, then the
    cleanup (no antenna). The rebuild also brings the generator's
    newer DRU rule on through-hol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
    [bay-node.kicad_pcb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]
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2026-10-28 Power hub: C114 beside U4's 3V3 pin, C113 above it
    U4's (the ESP32-S3-MINI-1, the controller's) 100 nF, C114, sat 6.4 mm
    below its 3V3 pin (3), and the 22 µF, C113, 3.1 mm away. C114 now
    lies right beside the pin, 0.83 mm pad to pad, its courtyard 0.02 mm
    short of the module's (x 22.05). C113 sits above it, by the GND pins
    (1, 2): 1.56 mm from the pin, clear of the antenna keep-out (y 5.6)
    and of the module's pin-1 mark. Below C114, as first tried, C113
    shut pins 4-8 in, and ADC_IMON_B (U4.6) stayed open.
    Routed incrementally: only EN and ADC_IMON_B rerouted, then the
    cleanup (no antenna). ERC 0, DRC 0 (no warning), unconnected 0. The
    hub stays pending in electronics/decoupling.json (5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
    [power-hub.kicad_pcb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]
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2026-10-28 Decoupling: a capacitor's own limit; the node's first 10 µF back in
    A declaration can now carry its own limit, its reason beside it in
    design.py: {"C2": ("U1.VIN", 3.0)}. The check holds that capacitor
    to it instead of the 2 mm rule; the table names the limit. Two
    synthetic tests cover it: a capacitor within its own limit passes,
    one beyond it fails, and resolve() carries the limit through to
    check().
    On the bay node, C2 is back among the declared capacitors. The
    buck's input is TI's three (SLUSF64B table 8-1): C4 (100 nF) and C2
    (the first 10 µF, right behind it) are its hot loop. C2 keeps TI's
    place, its pads on the same top-side VIN and GND islands as U1's
    pins, 2.65 mm from VIN: i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
    [decoupling.py, design.py]
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2026-10-28 pcbgen.clean_board: read each step's result wherever it lands on the line
    In the KiCad image SWIG's memory-leak warnings go to stdout too, and one
    can land in the middle of the step's JSON line
    ("...type 'PCB_TRACK *{"doubles": 20, ...}"), so no line started with
    "{" and clean_board stopped (StopIteration) after a first round. It now
    takes the last {...} in the output, wherever it sits. Found cleaning
    the DATA x4 v2; a local KiCad, which writes those warnings to stderr,
    never showed it.
    [pcbgen.py]
2026-10-28 DATA x4 v2: its antennas off, a dangling track now a DRC error
    The antennas check (electronics/tools/antennas.py) found 175 on the v2:
    136 slivers of 0.1 mm or less and 39 doubled tracks. Regenerated on
    main's pcbgen (its cleanup after every import, and e8fc9a2's fan-out
    that no longer doubles a neighbour's track), from the same routing:
    - 134 slivers and 20 doubled router tracks removed by the cleanup; each
    sliver's neighbours now meet where it was, a move under 0.1 mm;
    - 9 GND fan-outs (stub and via) no longer generated: each doubled a
    drawn GND track at the VREF and RESET/BOOT ESD arrays (x 14, 28, 32,
    50, 68, 81.6; U108/U109 to U408/U409), whose pads keep that track;
    - PORT4_DN,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
    [data-port-x4-v2.kicad_pcb]
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2026-10-28 DATA x4 v2: C15 right under the hub's pin 5, between two pairs
    C15 (100 nF, +3V3) sat 6.9 mm west of U1's VDD33 pin 5 (U1: the
    USB2517I hub), past the 1V8PLL capacitors. Pin 5 sits between ports 2
    and 3's pairs, which leave the south row straight down: an 0402 on end
    needs 0.874 mm between them (USB clearance 0.127 mm), they left
    0.85. Each now runs 25 um out from its pins' centre (0.9 mm; ports
    1-2 and 3-4 0.325 mm apart, from 0.35), and C15 stands between them,
    its +3V3 pad up, 0.79 mm under the pin, on the pin's drawn line (its
    via stays under the case), its GND via below it.
    Routed incrementally (no other net rerouted). In the SES, the router's
    double on CP_SWDIO and its stub onto TP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
    [data-port-x4-v2.kicad_pcb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]
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2026-10-28 DATA x4 v2: C9 and C7 swap places, VDD18's 100 nF at its pin
    VDD18 (the hub's pin 25; U1: the USB2517I) had its 4.7 uF (C7) at the
    pin, 0.89 mm, and its 100 nF (C9) behind it, 2.09 mm. The layout
    review's rule wants the 100 nF at the pin and lets the bigger store
    sit a little further: the two swap places (same nets, same 0402
    footprint, no copper moves for them). C7 gets its own 2.5 mm limit
    as VDD18's store, as C8 has for VDD18PLL.
    The import settles INT's B.Cu jog under port 4 0.5 mm lower (same
    route) and adds one GND stitching via. ERC 0, DRC 0, unconnected 0,
    no antenna; panel DRC 0. The board stays pending in
    electronics/decoupling.json (6 left).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
    [data-port-x4-v2.kicad_pcb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]
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2026-10-28 DATA x4 v2: C45 at the co-processor's DVDD pin 51, VREF2 and VREF4 on swapped GPIOs
    C45 (100 nF, +1V1) sat 4.83 mm south of U11's DVDD pin 51 (U11: the
    RP2354B); its path to the pin ran 7.9 mm through two vias. It now
    stands right west of the pin, 0.51 mm, on the pin's own line, its GND
    via below it. To make room, the west face's lines below it are drawn:
    VREF4 (pin 52) and VREF2 (pin 54) each drop to B.Cu right by their
    pin, 4's via east and 2's west, and run on south as before; for those
    two runs not to cross, their GPIOs swap (VREF2 now on GPIO43, VREF4 on
    GPIO41: the user's go-ahead, 2026-10-28; no firmware maps them yet,
    the co-processor spike leaves the VREF reads out). BUS_C's dive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
    [coproc.kicad_sch, data-port-x4-v2.kicad_pcb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]
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2026-10-29 Camera pod: J2.1 reaches its 3.3 V only through C3
    The pin → cap → via rule (the layout review): C3 (100 nF, +3V3) sat
    right above J2.1, the Arducam Mega's VCC pin, but the rail came into
    J2.1 itself, so C3 only hung off it. Now J2.1's only copper is a
    drawn track to C3's +3V3 pad. A short drawn stub leaves that pad on
    the far side, and the rail comes in at the stub's end. On this
    two-layer board +3V3 has no plane: the rail is the track from U1
    (the AP2114H). Its route reaches C3 first, then the camera's pin.
    Routed incrementally: the previous routing grafted, +3V3 rerouted
    whole (its old route ended on J2.1), then the cleanup (no antenna).
    ERC 0, DRC 0, unconnected 0. The pod's thr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
    [camera-pod.kicad_pcb]
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2026-10-29 Decoupling order check: a track across the cap pad, a via on a track
    The pin → cap → via check walked a track as one piece, so a pin's track running straight across its
    capacitor's pad on to the via beyond looked like a way round the capacitor: the bay node's C23 (U11's
    VDD, the CAN transceiver) was flagged though its copper keeps the order. A track is now cut at the
    capacitor's pad into its pieces on either side. The walk also meets a via sitting on a track (its
    centre on the track's body, as KiCad connects it), not only at a track's end.
    Order problems left: bay node 8 (C23 off the list), DATA ×4 v2 29 (C11 added: a via on U1.64's track
    before its capacitor). New synthetic test: t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
    [decoupling.py]
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2026-10-29 Decoupling order check: a via on a test pad's branch feeds nothing
    A via the pin reaches before its capacitor broke the pin → cap → via order even when its other layers
    lead only to test pads: the bay node's J6.1 (the camera lead's CAM_5V, no plane) reaches TP10 on the
    bottom through a via on its own branch, while F1 → C27 → J6.1 keeps the order. Such a via (copper off
    the capacitor's layer that reaches test pads and nothing else: no pour, no part, no other via) now
    counts neither before nor after the capacitor.
    Order problems left: bay node 5 (C27 off), DATA ×4 v2 28 (C9 off: its via leads to TP22 alone). New
    synthetic test: the same via leading on to a test pad, then to a part.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
    [decoupling.py]
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2026-10-29 DATA x4 v2: C6 in the pin -> cap -> via order at reset supervisor U5
    C6 is the 100 nF of U5 (the MAX809S that holds the hub's RESET_N) on
    its VCC pin 3. Pin and capacitor each had their own via into the +3V3
    plane, so U5's supply reached C6 only through the plane. C6 moves
    0.32 mm east, its +3V3 pad right over pin 3: a drawn track runs the
    pin straight up into it and on east to its via at (86.0, 2.3); the
    pin's via at (86.07, 3.20) and C6's old one are gone, C6's GND
    dog-bone follows it.
    No router change (PORT4_CONN_DP moves by 9 um, the tidy pass). DRC
    clean, 0 unconnected, no antenna; panel DRC clean. C6: 0.62 mm, via
    0.10 mm, order ok (25 order findings left, 5 of them the agreed
    exc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
    [data-port-x4-v2.kicad_pcb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]
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2026-10-29 Bay node: the shunt's sense lines drawn as one Kelvin pair
    SHUNT_P and SHUNT_N, from R19's sense pads (2 and 3, the 50 mΩ shunt on the DUT's 5 V) to U10's IN+
    (pin 10) and IN- (pin 9, Vbus pin 8 still tied to it; the INA226), ran apart: SHUNT_P 28.7 mm with
    4 vias, SHUNT_N 51.0 mm with 2 vias, round the top of U10. They are now drawn side by side, 0.25 mm
    lines 0.15 mm apart (the class clearance), on B.Cu over their whole run (18.1 mm), with one via pair
    at each end: out of U10's pins west under its body, down through the gap between the vias south of
    it, one diagonal to R19, then up into its pads. SHUNT_P 24.6 mm, SHUNT_N 23.7 mm, 2 vias each.
    U10.7's and Q4.2's GND vias stay: leaving we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
    [bay-node.kicad_pcb]
2026-10-29 DATA x4 v2: C103-C403 in the pin -> cap -> via order at each INA226
    C103-C403 are the 100 nF of U102-U402 (each port's INA226 current
    monitor) on its VS pin 6. Pin and capacitor each had their own via
    into the +3V3 plane, so the pin reached its capacitor only through
    the plane. Each capacitor moves 0.23 mm east, its +3V3 pad right
    over pin 6: a drawn track runs the pin straight up into it and on to
    its via, north of it on ports 1 and 3, east of it on ports 2 and 4
    (where the port's EN line, and SDA on port 4, pass north of it);
    all eight old vias are gone.
    Rerouted: PORT3_EN north round C303's via (shorter, two micro-steps
    gone); PORT4_EN's bend 0.23 mm east of C403's via. PORT1_FLT_N an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
    [data-port-x4-v2.kicad_pcb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]
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2026-10-29 DATA x4 v2: C35 in the pin -> cap -> via order at co-processor pin 41
    C35 is the 100 nF of U11 (the RP2354B co-processor) on its IOVDD pin
    41, west face. The pin reached the +3V3_CP island through a line
    under the case to the island's via at (45.68, 9.05), C35 hanging on
    the pin. That line is gone: the pin runs straight west into C35 and
    C35 on north-east to a via of its own in the island, at (41.25,
    8.45), 0.27 mm or more from BUS_D's copper. C36 (pin 50) keeps its
    link up to C35, so its pin also reaches that via through its own
    capacitor first.
    The island now in the DSN (the commit before), Freerouting no longer
    joins the pins by tracks: nothing else moves. DRC clean, 0
    unconnected, n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
    [data-port-x4-v2.kicad_pcb]
2026-10-29 DATA x4 v2: the +3V3_CP island takes in the co-processor's 100 nF ring
    The co-processor's In2 island (+3V3_CP, under U11, the RP2354B)
    covered U11 alone (x 40.9-53.1, y 6.8-19.0); its 100 nF sit round it,
    outside. C37's via (40.80, 17.39) missed it by 0.1 mm, and C38, C39
    (south, pads at y 19.82) and C42, C43 (north, pads at y 5.98) had no
    spot past their +3V3_CP pad inside it. It now reaches x 40.35-53.1,
    y 4.75-21.0, so each capacitor's via, past its pad, lands in it.
    The ring holds no +3V3 or +5V via: no +3V3 via loses the plane. North
    of the island the +3V3 plane keeps a 2.8-3.1 mm band (1.83 mm locally,
    beside C31's GND via). On B.Cu the island's edge is now crossed by
    CP_ADC2, CP_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
    [data-port-x4-v2.kicad_pcb]
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2026-10-29 Decoupling: per-capacitor order exemptions; the DATA x4 v2 keeps the order
    A 100 nF that cannot keep the pin -> cap -> via order where it sits
    is now exempt from it by name, in b.pcb["decoupling_order_exempt"],
    with its reason and measures in design.py. decoupling.py still works
    its order out and shows it in the table, but no longer counts it; an
    exemption the capacitor no longer needs (it keeps the order now) is
    a problem, so the test fails until it goes. A synthetic test covers
    both.
    The DATA x4 v2 exempts nine (agreed): the hub's C11 and C15 (no via
    fits past their pads; their pins' vias under the case, beyond the
    pins), the crosspoints' C20 and C23 (+5V_MX comes in at the pin from
    und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
    [decoupling.py, design.py]
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2026-10-31 DATA x6: VIN on a PH 3 (VIN-GND-VIN); the lead's pin 8 feeds the logic
    The Electronique session's two points on the schematic:
    - J3, the 20 V input, is a PH 3 (catalog.py ph3v, B3B-PH-K, C131339) wired VIN, GND,
    VIN: a pre-crimped PH lead fits either direction. On a PH 2 a reversed lead swaps VIN
    and GND, and with the grounds already joined through the PH 8 the node's VIN would short
    to GND. About 0.85 A at 20 V over two contacts. Its 33 uF is now C72509 (RVT1H330M0607,
    6.3 x 7.7 mm, the family of the node's C1; C240518 as the alternative), right at J3.
    - J1's pin 8, the node's switched 5 V, feeds the logic again as on the x4 v2 (+5V_L: the
    3.3 V LDO and +5V_MX), with the v2's 2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
    [data-port-x6-base-bom.csv, data-port-x6-bom.csv, data-port-x6.kicad_pcb, data-port-x6.kicad_sch, hub.kicad_sch, matrix.kicad_sch, power.kicad_sch]
2026-10-31 DATA x6: 120 x 80, each pin chain in an 11 mm column
    At 100 mm a chain had 7.6 mm under its block and Freerouting stalled at
    about 290 unrouted links on 4 layers. The user chose 120 x 80 (drawer
    x 4-124), with a 1.5 x 5 mm cut in the bottom-right corner for the drag
    chain foot's boss (rack.yaml corner_notch).
    - Blocks 11 mm apart (board x 28.5-83.5). Under each: three H5VU25UC
    in a row (P1-P4; BOOT, VREF, RESET; P8-P5), both 100 ohm arrays
    upright, then the LSF0108 turned 270 deg, A row up. LANE becomes
    5 6 7 8 4 3 2 1 so no line crosses. XMAP is unchanged (the v2's).
    The middle ESD replaces the separate VREF one and stays fitted on
    the base DATA-6x.
    - Crosspoints centred between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
    [config.scad, coproc.kicad_sch, data-port-x6-base-bom.csv, data-port-x6-bom.csv, data-port-x6.kicad_pcb, data-port-x6.kicad_sch, hub.kicad_sch, matrix.kicad_sch]
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2026-10-31 DATA x6: each pin chain drawn through its ESD
    As the v2's p_lines() (the kicad-happy review's X2-1): left alone,
    Freerouting runs a header line straight to the next part and leaves
    its ESD on a stub. chain_lines() draws every port alike, on F.Cu:
    - P1-P4 leave the left column west and run down outside it, 0.35 mm
    apart (0.25 mm was too tight where they fan out). They land on the
    left H5VU25UC's pads, cross to the partner pads and go on into the
    100 ohm array. P5-P8 are the mirror image.
    - VREF runs down the channel between the two columns, BOOT and RESET
    straight down from the bottom row, all three through the middle
    H5VU25UC. BOOT and RESET go on into their 1k, now back right unde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
    [data-port-x6.kicad_pcb]
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2026-10-31 DATA x6: power only, the logic removed, one TCA9535
    The porte-revues bays take no Dupont lead, so the DATA x6 keeps only the
    power half of the DATA x4 v2, widened to six ports; the x4 v2 keeps the
    logic.
    Removed: the six header blocks, the pin chains and their ESD, the three
    CH446Q crosspoints, the LSF0108s, the RP2354B co-processor with its
    crystal, regulator and SWD header, the TCA9534A, the -5 V and +5V_MX
    supplies, the base variant (no logic to leave unfitted) and the
    flow-through list.
    Kept: the USB2517I hub with its crystal, reset and straps, the AP2114H on
    +5V_L, the lead's I2C isolation, and per port the TPS2553-1, the shunt,
    the INA226, the VBUS LED, the USBLC6 and the CC resistor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
    [coproc.kicad_sch, data-port-x6-base-bom.csv, data-port-x6-bom.csv, data-port-x6.kicad_pcb, data-port-x6.kicad_sch, hub.kicad_sch, matrix.kicad_sch, port1.kicad_sch]
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2026-11-01 DATA x6: the +5V_A plane's outline no longer crosses itself
    IN_5VA listed the west notch's points before its corner at (MID_X - 0.1,
    H - E), so the outline crossed itself and left a triangle under USB-C 3
    with no +5V_A copper. The corner now comes first, as in IN_5VB, and the
    plane fills the whole bottom-left quarter again.
    [data-port-x6.kicad_pcb]
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2026-11-01 catalog: the TCA9535's 3D body, TI's RTW package
    KiCad 10 has no model for WQFN-24-1EP_4x4mm_P0.5mm_EP2.45x2.45mm, so the
    DATA x6's U2 had no body and the models check failed. It takes KiCad's
    Texas_RTW_WQFN-24 4 x 4 instead: same outline, pins and pitch, only the
    exposed pad underneath differs.
    [catalog.py]
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2026-11-01 DATA x6: USB-C 1's pair lands on its USBLC6's pin centres
    Since d60276d8, U103, USB-C 1's USBLC6, stands at cx - 3.65, clear of
    the cradle band. hs_pairs() still aimed at its old place, cx - 4.2, so
    the drawn D+ and D- stopped inside pins 4 and 6's pads, 0.55 mm short of
    their centres, and the router added a stub to each. One constant, ESD1,
    now places U103 and ends the pair and its VBUS line on it.
    Re-routed: DRC 0, 0 unconnected, tidy run; decoupling 37/37.
    [data-port-x6.kicad_pcb]
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2026-11-01 DATA x6: the six USB-C stand, 2.2 mm east, their pairs drawn
    The six vertical USB-C are turned 90°, slot upright, all alike, and
    the pairs from each USBLC6 to its receptacle are now drawn.
    Placement:
    - usb_rot is 90 on all six in rack.yaml, also emitted to config.scad as
    DATA_X6_USB_ROT. The drawer's port wall still has lying openings: the
    mechanical side turns them from that field.
    - The grid keeps its 15.5 mm pitch but moves 2.2 mm east, to board x
    13.45 … 90.95.
    - USB-C 1's USBLC6 now stands west of it like the others, clear of
    the cradle's band. USB-C 6 ends 0.5 mm short of the east band.
    - The clusters, the USBLC6s of USB-C 2–6 and the hub pairs' drops
    stay put: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
    [config.scad, data-port-x6.kicad_pcb, drawer_x6.stl, x6_cradle.stl, x6_strip.stl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]
2026-11-01 DATA x6: the rows under the USB-C clear of the cradle's T-heads
    The cradle's T-heads come up through the two comb notches. The front
    face stays free of parts in a zone 7 wide × 6 tall round each notch:
    board x 31–38 and 62–69, y ≥ 64. The v2 follows the same rule.
    In 89f01945 the CC2 56k of USB-C 2 and 4 (R205, R405) reached into
    that zone, their pads 0.08 mm into the T-head bar itself.
    What changed:
    - Every port's row under its receptacle is reordered, the same on all
    six: CC1 56k, CC2 56k, then the 22 µF, ending 2 mm east of the
    receptacle's axis.
    - The rows of USB-C 2 and 4 now stop 0.06 mm short of the zone.
    - Only the courtyards of J201 and J401 still touch the zone's edge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
    [data-port-x6.kicad_pcb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]
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2026-11-01 Cover box: a notch over each standing slot, lips past the end slots
    A standing USB-C plug's overmold rises 1.2 mm over the drawer walls' top,
    right where cover_box4's front wall sits. Main's box hit the maximum
    overmolds in slots 1 and 6. The other four were already under its header
    notch.
    - A notch over each slot, through the cover's front: the plug cut's width
    (7.8), up to its top (z 17.7). The overmold clears it by 0.525 mm.
    - The lips come from the drawer's slot grid (DATA_PORTS), not from v1's
    U's: from the side walls to 5.1 mm short of slots 1 and 6.
    SolidCraft, against USB-IF maximum overmolds (6.5 x 12.35, R 2) and the
    DATA x6 from 5c96e539:
    - overmolds: main 30 and 53 mm3 of o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
    [cover_box4.stl, covers.scad, rack-bom.csv]
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2026-11-01 DATA x6: VIN and +5V_L in the Power class, VBUS necks widened
    The Power net class's patterns "VIN" and "+5V_L" never matched: the
    nets are named by their sheet, /Power/VIN and /Hub/+5V_L. Both sat in
    Default and were routed at 0.127 mm. VIN carried about 0.85 A over
    113 mm, about 76 mm of it to converter A (about 0.29 ohm).
    - The patterns become "*VIN" and "*+5V_L".
    - VIN and +5V_L are re-routed at the Power width, 0.6 mm. VIN is 0.6 mm
    over 109.5 of its 110.8 mm, with 0.45 and 0.3 mm only at pads.
    +5V_L is 0.6 mm over all 54.1 mm.
    - Three other nets are re-routed with them:
    - BUCK_EN, the converters' enable, sat 0.115 mm from VIN's pads,
    under the Power clearance of 0.15 mm.
    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
    [data-port-x6.kicad_pcb]
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2026-11-01 DATA x6: supplies' widths and the Sensitive class as DRC rules
    The layout review found the power nets in the wrong class (fixed in the
    last commit) and eleven spots where an enable, fault or interrupt line
    ran 0.13-0.73 mm from a USB line, a USB pad or a USB via. Two board
    rules now catch both, next to the crystal's, in BOARD_RULES:
    - Power, Port and Supply tracks are 0.25 mm at least. Two exceptions:
    the hub's fine-pitch fan-out (inside U1's courtyard), and HUB_1V8PLL.
    HUB_1V8PLL's whole 3 mm is drawn in the crystal's block, pin 62 to
    C10 and C8, between XI and RBIAS, at 0.127 mm, with no room for more.
    - A new Sensitive net class holds *PORT?_EN, *PORT?_FLT_N,
    *HUB_RST_N, INT, *LE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
    [data-port-x6.kicad_pcb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]
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2026-11-01 DATA x6: INT off the lead, J1.1 left open
    The PH 8 lead's pin map changes for the DATA boards (map B, decided
    with the camera pod's re-pin):
    1 NC · 2 SCL · 3 SDA · 4 GND · 5 D− · 6 D+ · 7 GND · 8 VIN
    A camera lead plugged into the DATA socket by mistake then puts
    nothing on pin 1, so no 30 V TVS is needed there. The node polls the
    board over I2C instead of watching INT.
    - J1.1 is left unconnected.
    - Q3 (INT's isolation FET), R8 (its 10k pull-up) and TP23 (its test
    point) go.
    - U4 (H5VU25UC) keeps SCL and SDA. Its second channel is left open.
    - The TCA9535's INT and the six INA226 ALERT pins are left open: with
    no one reading INT, a local wired-OR would serve nothing.
    - New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
    [data-port-x6-bom-jlcpcb.csv, data-port-x6-bom.csv, data-port-x6.kicad_pcb, data-port-x6.kicad_sch, hub.kicad_sch, port1.kicad_sch, port2.kicad_sch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]
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2026-11-01 Node: J7.8 to GND, the DATA lead's INT gone (map B)
    The DATA lead's pinout for node rev B: 1 DATA_VIN · 2 GND · 3 D+ · 4 D−
    · 5 GND · 6 SDA · 7 SCL · 8 GND. With the camera lead's GND moved to
    its end pins (next change), a camera lead plugged into J7 either way
    round lands J7.1 on one of the pod's GND pins and J7.8 on the other: a
    short the eFuse cuts. A 1:1 DATA lead puts J7.1 on the DATA board's
    pin 1, left unconnected on its side.
    INT leaves the lead: the node polls the DATA board over I2C (the DATA
    session confirmed nothing needs its latency). R41 (1k at J7) and R38
    (the 10k pull-up by the module) go, with their 70 mm and 2 vias across
    the board; IO4 is free. J7.8 takes a G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
    [bay-node-bom-jlcpcb.csv, bay-node-bom.csv, bay-node.kicad_pcb, bay-node.kicad_sch, mcu.kicad_sch, rack-bom.csv, usb.kicad_sch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]
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2026-11-01 DATA x6: 90-degree track corners cut at 45
    The layout review asks for 45-degree corners, no right angles. The
    board had 53 corners at 90 degrees: 7 in drawn copper and 46 from the
    router. The three acute ones the review found went with the re-routes
    of the last commits.
    - Drawn (design.py): each USBLC6's VBUS feed (pin 5 under its body
    and up between the pin rows, six of them) and RBIAS in the
    crystal's block now turn through a 0.2-0.3 mm 45-degree cut.
    - Router: 37 corners get a 45-degree cut of up to 0.5 mm, shrunk
    step by step to 0.125 mm until it keeps every clearance. Those
    corners were on VBUS, the sense lines, CC, SCL, SDA, the enables and
    faults, BUCK_EN, VIN and the hub's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
    [data-port-x6.kicad_pcb]
2026-11-01 Camera lead: GND on both end pins, CAM_5V and LED_K opposite
    The camera lead's pinout for node rev B, J6 on the node and J1 on the
    pod (its mirror):
    J6: 1 GND · 2 SCK · 3 CAM_5V · 4 MOSI · 5 MISO · 6 LED_K · 7 CS · 8 GND
    pod: 1 GND · 2 CS · 3 LED_K · 4 MISO · 5 MOSI · 6 CAM_5V · 7 SCK · 8 GND
    With J7's map B (the previous change), a wrong plug harms nothing,
    either lead variant:
    - a camera lead in J7: J7.1 (the eFused VIN) lands on one of the pod's
    end GND pins and J7.8 on the other, a short the eFuse cuts;
    - a DATA lead in J6: CAM_5V (J6.3, behind its PTC) meets the DATA
    board's D+ or SDA, never its GND;
    - a 1:1 camera lead: CAM_5V meets the pod's LED cathodes (pin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
    [bay-node.kicad_pcb, cam.kicad_sch, camera-pod.kicad_pcb, camera-pod.kicad_sch, pod.kicad_sch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]
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2026-11-01 Viewer: the DUT cables plug into the DATA ports, straight and standing
    Each DUT cable now ends in a straight USB-C plug pushed through the port
    wall's slot into its DATA board's receptacle, at the receptacle's mouth,
    turned with it (usb_rot 90: standing). It is drawn at its true length as
    it lies (rod_cable).
    Which port:
    - A one-DUT bay takes the DATA x6's port 1, the leftmost seen from the
    DUT, or the next port where the cable does not lie clear from port 1
    (too short, or against a board or a wall). The scene build tries them
    in turn.
    - A1, A2, A4 and B2 use port 1; A3 and B4 use port 2 (port 1's cable is
    6 and 31 mm short).
    - B1 and B3 use the v2's own ports (pcb.data_port_x4_v2),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
    [rack-bom.csv]
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2026-11-01 Node: the camera's CS on IO4, its pull-up beside it
    IO4, freed by the DATA lead's INT, sits at the left column's rear end,
    next to the B.Cu lane INT used under the module. The camera's CS moves
    there from IO8: it ran west to x 15 and back under the module to its
    33 ohm R34, with a branch south to its pull-up R37 (71.6 mm, 3 vias).
    Now it runs east under the module to R34 (33.4 mm, 2 vias), and R37
    takes the INT pull-up's old place beside the pin. IO8 is free.
    IO4 suits it: not a strapping, JTAG or PSRAM pin, on the DevKitC-1's
    headers; at reset it is an input, so R37 keeps the camera deselected.
    SPI2 goes through the GPIO matrix, as before.
    The devicetree's cs-gpios follows (gpio0 8 -> 4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
    [bay-node.kicad_pcb, cam.kicad_sch, mcu.kicad_sch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]
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2026-11-01 Node: the DATA lead's eFuse at 1.76 A (R16 6.8k)
    The DATA x6 now takes all its power from J7.1: about 1.0 A at 20 V
    (1.2 A with its six ports at their 0.62 A limit), 0.75 A at 28 V, and
    about 1.5 A at 13.5-15 V with every port loaded. R16's 7.5k (1.6 A)
    left 0.1 A over that corner. 6.8k: I_LIM = 12 A.kOhm / R = 1.76 A,
    1.67-1.85 A at the datasheet's +-5 %: at least 11 % above the x6's
    worst case, 39 % at 20 V, and always under the JST PH contact's 2 A.
    No JLC basic part sits in 6.34-6.65k (6.49k, 1.85 A, is extended);
    6.2k (1.94 A) could pass 2 A at its tolerance's top.
    The INA226 (R19, 50 mOhm, 1.64 A full scale) still reads the x6's
    1.5 A; only an overload saturates it. Value and notes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
    [bay-node-bom-jlcpcb.csv, bay-node-bom.csv, bay-node.kicad_pcb, bay-node.kicad_sch, bus.kicad_sch, cam.kicad_sch, dut.kicad_sch, mcu.kicad_sch]
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2026-11-01 BOM: DUT cables with a straight, slim USB-C at the standing port wall
    The drawer end of every DUT cable is now a straight USB-C within the
    USB-IF 12.35 x 6.5 mm overmold (the DATA x6 receptacles stand, 15.5 mm
    apart). Listings picked on AliExpress on 2026-11-01; none gives the
    overmold, so the ends were sized on the photos (to measure on arrival).
    cable before after (each)
    c-to-c 15 cm OLAF, both ends bent HDR bend-straight, EUR 3.69
    c-to-micro-b 25 cm HOQO, gone in FR, C end bent Waveshare straight, EUR 4.39
    c-to-micro-b-str 15 to pick Waveshare straight, EUR 3.69
    c-to-c-straight 15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
    [rack-bom.csv]
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2026-11-01 PCB generator: a netclass pattern that matches no net stops the build
    KiCad matches a netclass pattern against the whole net name, sheet path
    included, and case-sensitively: a bare "VIN" misses a sub-sheet's
    "/Power/VIN" and leaves the net in Default (its widths, its clearance,
    none of the class's rules) without a word. Measured on KiCad 10.0.7,
    each pattern alone in a class, the DSN export naming the class each net
    landed in.
    write_project() now stops on such a pattern and names the wildcard that
    reaches the net ("*VIN" takes /Power/VIN). Every board's patterns match
    today. netrules.py (plain Python) holds the check and its tests.
    [eda.py, netrules.py]
2026-11-01 PCB generator: DRC rules from the netclasses, power widths and Sensitive
    The layout review's checks were the DATA x6's own BOARD_RULES. They are
    now generated from what a board declares in NETCLASSES (netrules.py):
    - "_min_width" on a class: its tracks that wide at least, a DRC error,
    one rule per width, but where b.pcb["min_width_except"] says
    (courtyards, nets; a net as !(A.NetName == ...), the form the order
    panel renames per copy);
    - a Sensitive class beside a USB class: 3 x the USB track width between
    them, a DRC error.
    Keys starting with "_" stay out of the .kicad_pro. pcbgen writes the
    whole .kicad_dru once the parts are placed (dru_text: the shared rules,
    the generated ones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
    [build_board.py, design.py, eda.py, netrules.py, pcbgen.py]
2026-11-01 PCB generator: the Sensitive-USB clearance in the DSN for Freerouting
    The DRC rule keeps the Sensitive class 3 x the USB track width off USB
    after the route; Freerouting now routes with it. export_dsn() adds a
    class-to-class clearance to the network section, one per pair of the
    classes KiCad wrote (KiCad 10 names a net's classes together:
    "Sensitive,Default", "USB,Default"):
    (class_class (classes Sensitive,Default USB,Default)
    (rule (clearance 750)))
    It goes in before the 2 um router margin, like every other clearance,
    and canonical() leaves it in place. Freerouting 2.5.0 reads it into its
    clearance matrix (NetClass.ClassClass): on the DATA x6's DSN, 0.752 mm
    loads with the same 456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
    [build_board.py, dsn.py, pcbgen.py]
2026-11-01 PCB generator: a board's own DRC severities in its .kicad_pro
    b.pcb["severities"] ({KiCad check: error | warning | ignore}) is written
    into the board's .kicad_pro rule_severities after the generator's own
    (dangling tracks and vias as errors), by the full build and by
    build_board.py --rules. One board's call on one named check: the
    generator silences nothing. A check the .kicad_pro doesn't list (KiCad
    writes every one it knows) or an unknown severity stops the build, as
    KiCad would skip it without a word. No board sets any yet.
    [netrules.py, pcbgen.py]
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2026-11-01 Node: L1 rated 75 V (Vishay IHLP2525CZ) for 28 V EPR
    The node's buck inductor is now the Vishay IHLP2525CZEK4R7M01 (C48009678),
    rated 75 V across the inductor (doc 34104, rev. 01-Oct-2026, p. 1), where
    the FXL0630-4R7-M withstood 30 V. Same 4.7 µH; 10 A sat (-20 %), 5.5 A
    heat, DCR 37 mΩ typ.
    It keeps the FXL0630 land: Vishay's pad layout is within 0.14 mm of it and
    the IHLP's terminals sit on its pads. JLC's land for the part (the ER
    reel's, C553961; the EK listing has none) is centred with its pads along x:
    no CPL correction. Copper unchanged: the schematic regenerated, L1's fields
    and 3D model (KiCad's IHLP-2525) rewritten on the routed board.
    BOM: +$5.94 components on the node's o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
    [bay-node-bom-jlcpcb.csv, bay-node-bom.csv, bay-node.kicad_pcb, power.kicad_sch, rack-bom.csv]
2026-11-01 Power hub: L1 rated 75 V (Vishay IHLP2525CZ) for 28 V EPR
    The hub's buck inductor is now the node's: the Vishay IHLP2525CZEK4R7M01
    (C48009678), rated 75 V across the inductor (doc 34104, rev. 01-Oct-2026,
    p. 1), where the FXL0630-4R7-M withstood 30 V. On the same FXL0630 land,
    as on the node: Vishay's pad layout within 0.14 mm, JLC's land centred with
    its pads along x (no CPL correction). Copper unchanged: the schematic
    regenerated, L1's fields and 3D model rewritten on the routed board.
    BOM: +$1.19 components on the hub's order (JLC_SINCE_QUOTE). 28 V stays
    locked out (CONFIG_HUB_EPR_ALLOWED off): the DATA ×6's L2 L3 and the ×4 v2's
    L2 are still FXL0630.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
    [controller.kicad_sch, power-hub-bom-jlcpcb.csv, power-hub-bom.csv, power-hub.kicad_pcb, rack-bom.csv]
2026-11-01 bay-node: the DATA lead's power-on rule (node rev B)
    From node rev B, IO41 drives the SHDN of a TPS26600 eFuse on the rack's
    VIN, out on the DATA lead as DATA_VIN, pulled down: off without firmware.
    dut_port's new vin-efuse property selects the rule of docs/firmware.md;
    the stand-ins keep the TPS2553 behaviour.
    - Before switching on: SCL and SDA idle high (bus-gpios, only read: the
    pins stay the I2C controller's) and the node's INA226 answers. A lead
    plugged the wrong way round holds SCL low: "DATA lead reversed?".
    - On: ~FLT ignored for 20 ms while the eFuse ramps, then DATA_VIN must
    read 15 V (the node does not measure VIN itself) and ~FLT be high, else
    off again (a camera lead i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
    [bay.h, dut.c, emul.c, emul.h, main.c]
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2026-11-01 BOM: a JLC quote can be stale, priced by the calculator until a re-quote
    A board whose BOM changed after its quote carries "stale_since" (a
    date) and "stale" (why) in JLC_QUOTE. Its order then takes its
    extended part types and its parts from the BOM, the way the calculator
    prices them, instead of the quote's figures. The rows' supplier column
    says "calculator (the JLCPCB quote of ... is stale since ...)", the
    README's order table adds the reason, and the "re-quote" warning on
    the extended types is silenced.
    The tests that hold a quote against the BOM skip a stale one with that
    reason: test_panel_reproduces_the_quote, test_panel_is_the_racks_order,
    and test_economic_fees_follow_the_tiers (pe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
    [bom.py]
2026-11-01 DATA x4 v2: layout B on the x6's grid, its own 5 V from the rack's 20 V, routed
    The v2 rework, routed.
    - Layout B: its four USB-C on the DATA x6's 15.5 mm grid, positions
    2-5, standing, all alike (rack.yaml usb, usb_rot), with the x6's
    bottom-edge notches (and their tee), so one drawer and one cradle
    take either board.
    - The headers stay where they were; the power clusters move between
    the hub's drops; U2 moves west of port 1's cluster.
    Power and lead:
    - The rack's 20 V arrives on J1.8 (VIN; the node switches it through
    its eFuse). One LMR51625, the x6's converter A block with its 75 V
    4.7 uH, makes the board's 5 V in the top-left corner.
    - That converter's +5V tongu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
    [config.scad, coproc.kicad_sch, data-port-x4-v2-base-bom-jlcpcb.csv, data-port-x4-v2-base-bom.csv, data-port-x4-v2-bom-jlcpcb.csv, data-port-x4-v2-bom.csv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]
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2026-11-01 Hub: all four rows fitted, rows C and D on in the devicetree
    The hub's eFuses, connectors and LEDs for rows C and D are now fitted, so
    power_hub.dtsi no longer disables them; the CoreS3 and XIAO stand-ins keep
    B-D off. Budget, grants, CAN enumeration and POS already loop over the
    four rows; two things change with all four live:
    - budget.c's shed order passes over a row that draws nothing: with a rack
    of three rows, row D's output is on and empty, and shedding it first
    (DCBA) would free nothing and delay the next shed by a hold
    (tests/budget: test_an_empty_row_is_not_shed).
    - rack_bus's test_enumerate enumerates the four rows with one empty, as
    the hub does with every row on.
    The s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
    [budget.c, budget.h, dev_server.py, main.c, screenshots.py]
2026-11-01 Power hub: all four row outputs fitted, rows C and D no longer DNP
    The user: "Sur le hub montons toutes les sorties": a third row is coming,
    so row C's output is used right away, and D's saving was a few dollars.
    design.py's FITTED is every row; U13/U14 (TPS26600), J4/J5 (S6B) and
    D13/D14, D23/D24 (the ON and FAULT LEDs) lose their DNP flag.
    * The schematic regenerated; on the routed board only the eight
    footprints' DNP attribute changed. ERC 0, DRC 0, unconnected 0,
    parity 0; the Gerbers are unchanged (compared minus dates). The JLC
    BOM and CPL carry the eight, with rows A and B's corrections.
    * BOM: JLC's quote of 2026-10-23 had them DNP, so JLC_SINCE_QUOTE adds
    them back: +$9.4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
    [outputs.kicad_sch, power-hub-bom-jlcpcb.csv, power-hub-bom.csv, power-hub.kicad_pcb, rack-bom.csv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]
2026-11-01 BOM: JLC's re-quote of the DATA x4 v2 panel after its rework
    JLC's real quote of 2026-11-01 (jlcpcb.com, main's 68bfe5cc panel Gerbers,
    JLC BOM and CPL): the same order as 2026-10-23, 5 panels, 2 assembled,
    green, ENIG, Economic, no rails. The panel's quote is no longer stale.
    | Line | 2026-10-23 | 2026-11-01 |
    |-----------------------|-----------:|-----------:|
    | PCB | 52.00 | 52.00 |
    | Setup + stencil | 9.79 | 9.79 |
    | Components | 84.24 | 101.52 |
    | Extended types x 3.09 | 16 = 49.44 | 21 = 64.89 |
    | SMT | 5.77 | 6.77 |
    | Special components | 0.48 | 0.48 |
    | Qu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
    [rack-bom.csv]
2026-11-01 Slot bin: a dense bay's slotted bin, in the board plate's place
    The porte-revues (the user, 2026-10-31): one printed part in the plate's
    footprint, six equal lanes of 21.0 mm between 1.2 mm walls 40 mm high, lane
    k for the DATA x6's port k. A front stop at drawer y 17, behind the display
    and the front's screws. A 2.4 mm floor that takes the plate's pins, the
    RESET/BOOT pin holes and the display lead's notch, with 1.4 mm recesses under
    the ports' plugs. Set in config/rack.yaml > drawer.slot_bin; no bay uses it
    yet.
    Checked in SolidCraft (exact solids, drawer closed):
    - no overlap with the drawer, its front, the display, the cradle, the strip
    or the DATA x6;
    - 1.3 mm under six USB-IF max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
    [config.scad, slot_bin.scad, slot_bin.stl]
2026-11-01 Hub budget: an empty row is no node on the bus and IMON under 0.1 A
    The shed order passed over a row reading 0 mA, but an empty row's IMON
    reads tens of mA of offset and noise, so on the hub the skip would rarely
    trigger. An IMON floor alone cannot tell that from one idle node (35-50
    mA at 20 V). So a row is empty when the rack bus found no node on it and
    its IMON is under CONFIG_HUB_ROW_EMPTY_MA (100 mA): rows.c passes
    bus_rows_found() to the budget. A row with a node keeps its turn however
    little it draws, and so does one the bus cannot reach that draws more.
    tests/budget: the empty row at 15 mA is passed over; a row with an idle
    node at 15 mA, or with no node but 0.3 A, is still shed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
    [budget.c, budget.h, bus.c, dev_server.py, hub.h, main.c, rows.c]
2026-11-01 DATA x4 v2: design.py draws the routed board's two hand fixes
    Two fixes of 9127e89d were made on the routed board only, so a
    rebuild from design.py lost them:
    - RN8's pin 5 (+3V3) on pin 6's via. That opens BUS_D's way from
    its pull-ups, between RN8's two columns. A rebuild put pin 5's
    fan-out via back, and the graft dropped BUS_D.
    - C27 and C28's GND vias right beside their pads. The fan-out puts
    them 0.6 mm further, past the decoupling rule's 1 mm.
    Both are now drawn in design.py, at the board's exact places, so the
    fan-out leaves those pads alone. No copper changes; the board file is
    untouched.
    [design.py]
2026-11-01 DATA x4 v2, DATA x6: each converter's switch node and output as pours
    From the layout review of 2026-11-01:
    - The inductor's output reached the In2 +5V plane through one 0.6
    via and a 0.4 mm track. The three 22 uF had one via each, and no
    F.Cu joined them to the inductor. So up to 3.04 A (v2), 1.93 /
    2.39 A (x6 converters A / B), went through one via.
    - The switch node ran on 0.45 mm tracks.
    The fix, one shared helper (buck_copper(), the same block on both
    boards):
    - An F.Cu pour on the output: the inductor's output pad and the three
    22 uF pads, round the inductor's body. Five 0.6/0.3 vias to the
    power plane: two between the capacitors, three round the
    inductor's pad (two north,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
    [data-port-x4-v2.kicad_pcb, data-port-x6-bom.csv, data-port-x6.kicad_pcb, power.kicad_sch]
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2026-11-01 Viewer, Blender: a dense bay's boards on edge in the slot bin
    A bay with `plate: slots` has the slot bin in the plate's place, and up to
    six boards (`boards:`), one per DATA x6 port. rackcfg.dense_layout puts
    each board in the lane of its port (lane k to port k):
    - on the edge nearer its USB, USB to the port wall;
    - centred in the lane, against the front stop;
    - checked: no thicker than the lane (0.6 a side), no longer than the walls,
    no taller than 82 under the row above.
    boards.yaml's `on_edge` gives a board's real reach under and over its PCB
    where standoff and height, the plate's, overstate it: the NUCLEO-64 at 19
    overall, the DevKitC boards, the Wio Terminal, the UNO R4.
    The viewer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
    [assembly_glb.py, bayctl.py, boards.yaml, bom.py, rackcfg.py]
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2026-11-01 BOM: a cradle and its strip in every bay
    Every bay's DATA board stands in the printed cradle since the single DATA
    port board's retirement: the DATA x6, or a converted bay's DATA x4 v2. The
    BOM still counted a cradle and a strip only in DATA x4 bays. It also kept
    the single board's two PT 2.3x8 in every other bay, which no longer exist.
    Now it counts, in every bay:
    - a cradle and a strip;
    - 3 inserts and 3 M3x8 for the cradle;
    - 5 PT 2.3x8 for the strip.
    [rack-bom.csv]
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2026-11-02 BOM: the DATA x6's estimate with its GCT USB4145 USB-C
    The x6 now takes the GCT USB4145-03-0170-C (C5181332, 7979ce7f), but
    its fixed estimate still priced the HRO TYPE-C-31-D-06. The regen made
    up the gap in the "JLC quote minus the catalogue prices" line, which
    went from -$29.55 to -$73.71. So the x6 total did not rise.
    - jlc_parts.json: C5181332 added with JLC's price breaks from its part
    page (2026-11-01): $1.0794 at 30-99, $0.9252 at 100+. The catalog
    snapshot has none. The x6's BOM lines come from its JLC BOM. That
    clears bom.py's "add it to JLC_MIN_BUY" warning: JLC sells it by 1.
    C240518 raises no warning (JLC sells it by 1 too).
    - The x6 estimate: parts at JLC's breaks for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
    [rack-bom.csv]
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2026-11-02 BOM: the DATA x4 v2's GCT USB4145 USB-C on its quotes
    The v2 now has the x6's GCT USB4145-03-0170-C (C5181332) too, after
    3d092ab2. Its quotes (the panel's real one of 2026-11-01, the logic's
    and base's estimates) still priced the HRO TYPE-C-31-D-06.
    JLC_SINCE_QUOTE adds the price gap, at JLC's breaks:
    - the panel: 16 connectors at $1.2156 instead of $0.2842, +$14.90
    components;
    - the logic alone and the base alone: 8 at $1.4632 instead of $0.2842,
    +$9.43 each.
    Nothing else changes: one extended type swaps for another, the same 16
    pads and 4 stakes, and the same special-component fee.
    - jlc_parts.json: the v2 and base BOM lines come from their JLC BOMs.
    That clears the "add it to JL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
    [rack-bom.csv]
2026-11-02 DATA x4 v2, DATA x6: the converters' turn-on is 13.5 V typical, up to 15.1 V
    Datasheet check (2026-11-01): the LMR516x5's EN rising threshold is
    1.103 / 1.226 / 1.349 V (TI SLUSF64B §6.5). So the 100k/10k divider
    turns the converters on at 13.5 V typical, but up to 14.8 V, and to
    15.1 V with the 1 % resistors. The rack is fixed at 20 V, so no part
    changes. The notes now say so: the power sheet's EN line, the root
    sheet's rails line (VIN on above 13.5 V typ., 15.1 V at worst) and the
    EN divider's comment, on both boards.
    Notes only: ERC 0, DRC 0 / 0 / 0 with parity.
    [data-port-x4-v2.kicad_sch, data-port-x6.kicad_sch, power.kicad_sch]
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2026-11-02 DATA x4 v2: silkscreen text at a 0.15 mm stroke, and a rule that keeps it
    From the layout review of 2026-11-01: 101 silkscreen texts had a
    0.12 mm stroke, texts()' default 15 % of their 0.8 mm height:
    - the headers' pin names;
    - the test points' names;
    - the SWD pins;
    - LOGIC ONLY;
    - the board's name.
    - Each text is now drawn at max(0.15 mm, 15 % of its height). The
    2 mm port numbers keep their 0.3.
    - The board's rules gain "silkscreen text: a 0.15 mm stroke at least"
    (text_thickness on ?.Silkscreen, an error).
    - TP25's label (SCL) moves over its pad: under it, at the thicker
    stroke, it touched TP26's ring.
    Board texts and rules only, no copper. DRC 0 / 0 / 0 without a
    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
    [data-port-x4-v2.kicad_pcb]
2026-11-02 BOM: the DATA x4 v2's 27 ohm and 18.7k in the JLC parts snapshot
    The v2's R23/R24 are now 27 ohm (C25100) and R53 is 18.7k (C11476),
    after 788e9c31 and ac4c34ba. Both are extended parts, and
    jlc_parts.json didn't have them. So bom.py warned "add it to
    JLC_MIN_BUY" for each on the panel.
    - jlc_parts.json:
    - Both parts added, with their tier, stock and unit price from JLC's
    parts library through the jlc MCP. The catalog snapshot has no
    price for them.
    - The v2 and base BOM lines come from their JLC BOMs.
    - The unused 22 ohm (C25092) is dropped.
    The warnings are gone. Prices move by a cent at volume.
    - JLC_SINCE_QUOTE: the base alone carries R53 too, so it gets the same
    exten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
    [bom.py]
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2026-11-02 DATA x4 v2: +3V3 over +5V on the power plane by priority, so the panel's halves fill as the board
    The power plane's +3V3 and +5V areas are 0.2 mm apart along the split,
    under their clearance, so one of them pulls back 0.1 mm over its ~88 mm.
    Both had priority 0: KiCad then picks by the zones' UUIDs. The board's
    own pair had +3V3 win, but KiKit gives each copy on the panel new UUIDs,
    so each panel build flipped each half at random (about 8.8 mm2 of In2
    moving between +3V3 and +5V): the panel from 0d635e3d had its base half
    flipped, the one from 527101a4 both halves.
    Now pwr-3v3 priority 1 and the co-processor's +3V3_CP island 2 (it lies
    inside the +3V3 area), +5V 0. The board's fill is unc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
    [data-port-x4-v2.kicad_pcb]
2026-11-02 DATA x4 v2: no meanders on the USB pairs, no corner under 135 degrees, and a rule that keeps it
    The layout review: length-matching bumps on USB make it worse, and the USB
    pairs and the crystals' lines take no sharp corner.
    - The co-processor's pair (CP_HUB_DN/DP) no longer gets meanders after the
    routing (b.pcb["match"] dropped): CP_HUB_DN's three bumps east of the hub
    go, its line straight on B.Cu; Freerouting could not route the pair
    again, so it is main's route without the bumps, and a 127 degree kink by
    (55.6, 19.9) made a vertical then a 45 degree run. The upstream pair's
    two drawn bumps on D+ go too (bumps() and plen() with them).
    - Ports 1-3's pairs turn down off their lane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
    [data-port-x4-v2.kicad_pcb]
2026-11-02 DATA x4 v2: the High-Speed pairs matched again (45-degree bumps), and a test that keeps them within 1 mm
    018e9915 took the upstream pair's two square bumps off D+ with the router's
    meanders on CP_HUB_DN: UP_DN then ran 4.23 mm longer than UP_DP (High
    Speed, 480 Mbit/s). Only the co-processor's Full-Speed pair (CP_HUB) loses
    its matching; the High-Speed pairs keep theirs:
    - UP_DP makes up D-'s longer way with 45-degree bumps (the angle rule):
    three 1.4 mm deep west of its run down the east side, as deep as RN3
    leaves room for, and two north of its run into J1 pin 6 for the rest,
    sized from the drawn lengths. Skew 0.000 mm (was -4.231).
    - Each USB-C's crossover: D+ on B.Cu by the short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
    [data-port-x4-v2.kicad_pcb]
2026-11-02 DATA x4 v2: resets, boot lines and selects 0.75 mm off the USB lines (the Sensitive class)
    The layout review: an enable, reset or select running beside a fast line
    is the fault to avoid. The Sensitive class (0.75 mm, 3 x the USB lines'
    width, off the USB class) now also holds each port's RESET_IO / BOOT_IO
    (the expanders' outputs) and RESET_N / BOOT_N (to the DUT), the
    co-processor's BOOT_N and QSPI_SS, and the crosspoints' STBs: from 61 items
    too close to 0. Placement first:
    - each port's two 100k pull-ups 0.3 mm west, against its header's
    courtyard, and ports 1-3's pairs down their header gap at hx + 10.1
    (+0.05 mm, port 2 +0.15): 0.8 mm between them;
    - lanes 1 and 2 0.35 mm lower we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
    [data-port-x4-v2.kicad_pcb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]
2026-11-02 USB links matched pin to pin: the test checks whole links, and a 45-degree bump on each v2 port's D-
    What the signal sees is the link: the hub's pin, its pair to the USBLC6,
    the ESD's crossover to the receptacle's pin. The v2's four were 1.65 mm
    apart (D+ longer: its turns +0.66, the crossover +0.99), each part under
    1 mm alone.
    - tools/tests/test_pair_skew.py now checks b.pcb["skew"]["links"]: each
    link's P side (its nets end to end) against its N side within "tol",
    or within a figure "loose" gives that link with its reason;
    electronics/tools/skew.py sums a side's nets.
    - v2: one 45-degree bump on each port's D-, on its last run down to its
    USBLC6, 0.12 mm before its end, 1.3 mm de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
    [data-port-x4-v2.kicad_pcb]
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2026-11-02 DATA x4 v2: CP_HUB at one width, BUCK_FB and HUB_1V8 without necks
    The layout review: a signal keeps its width along its way.
    - The co-processor's pair (CP_HUB_DN/DP, USB class 0.25 mm) had eleven
    0.187 mm stretches from the router: all at 0.25 now. The one by TP32
    (BUS_D's test pad), 1.4 um short of its clearance at 0.25, moved 4 um
    south-east with its two neighbours, every corner still 45 degrees.
    - BUCK_FB (the 5 V converter's feedback) and HUB_1V8 (the hub's core
    supply) each had 0.095 mm necks by their pins: all at 0.127 now.
    Zones refilled and saved.
    DRC 0/0/0 with parity (none without refilling), panel DRC 0, antennas 0.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
    [data-port-x4-v2.kicad_pcb]
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2026-11-02 Power hub: no track under 0.127 mm, NextPCB's 5/5 mil tier
    The order's rules check (2026-11-02) found three router tracks at
    0.125 mm (4.92 mil), 2 um under NextPCB's 5 mil: two short segments of
    ADC_IMON_D (row D's IMON to U4, the ESP32-S3 module) on B.Cu and one of
    I2C_PU (U4's I2C pull-ups) on F.Cu, the router's necks.
    - design.py: b.pcb["min_track"] 0.127, the board's floor: a new session
    import sets it and tidy widens the router's necks to it.
    - The routed board: its floor 0.127 (min_track_width in the .kicad_pro)
    and those three tracks widened to it, tidy's first step alone (the
    whole tidy would also straighten 14 runs the board keeps).
    No other copper moved, no zone refilled.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
    [power-hub.kicad_pcb]
2026-11-02 Bay node: no track under 0.127 mm, NextPCB's 5/5 mil tier
    The order's rules check (2026-11-02) found one router track at 0.125 mm
    (4.92 mil), 2 um under NextPCB's 5 mil: a short F.Cu segment of
    CAM_CS_P, the camera's chip select between R34 (its 33 ohm), U13 (the
    USBLC6 on the camera lead) and J6.7, a neck the router left.
    and that track widened to it, tidy's first step alone.
    No other copper moved, no zone refilled. DRC 0 / 0 / 0 with parity on
    the fills as committed and with a refill i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
    [bay-node.kicad_pcb]
2026-11-02 Power hub: silkscreen text at a 0.15 mm stroke, and a rule that keeps it
    The order's rules check (2026-11-02): 39 silkscreen texts had a 0.12 mm
    stroke, texts()' default 15 % of their 0.8 mm height, at the edge of
    NextPCB's 5 mil legend: the bottom test pads' names (the controller's
    TX, RX, EN, IO0, 3V3, GND; 5V, VRACK, PD, SDA, SCL; the rows' FLT and
    IMON; the second round's pads).
    - Each text is now drawn at max(0.15 mm, 15 % of its height), as the
    DATA boards'. The board's name (1.0 mm, 0.15) and the row letters
    (1.2 mm, 0.18) keep theirs.
    - The routed board's strokes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
    [power-hub.kicad_pcb]
2026-11-02 Bay node: silkscreen text at a 0.15 mm stroke, and a rule that keeps it
    The order's rules check (2026-11-02): 41 silkscreen texts had a 0.12 mm
    stroke, texts()' default 15 % of their 0.8 mm height, and PC (0.9 mm)
    0.135, at the edge of NextPCB's 5 mil legend: the board's name, the
    bottom test pads' names, ROW IN / ROW OUT, DATA, AUX, CAM, RESET, BOOT,
    SVC and PC.
    DATA boards'.
    - POS OUT, TP31's name (the POS_OUT test pad), sits 3.35 mm east of it
    instead of 3.2: at the thicker stroke it touched TP31's rin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
    [bay-node.kicad_pcb]
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2026-11-02 DATA x6: a title block, the name at 1.5 mm and the project and date under it
    silk.title_block(): "DATA ×6 v1.0" at 1.5 mm (0.25 mm stroke) and
    "hw-testing-rack 2026-11" at 1.0 mm under it, in the free copper west of
    the hub, over the port numbers. The date is the revision's, fixed, never
    the build's. The old 0.8 mm name by USB-C 3 and 4 goes. Silk only: no
    copper moved.
    Renders, Gerbers and the viewer GLB regenerated. ERC 0, DRC 0/0/0 with
    parity.
    [data-port-x6.kicad_pcb]
2026-11-02 DATA x4 v2: a title block, the name at 1.5 mm and the date under it
    silk.title_block(): "DATA ×4 v2.0" at 1.5 mm (0.25 mm stroke) centred at
    (31.5, 1.75), off the panel's tab at x 9 and east of the 5 V converter's
    outline, and "2026-11" at 1.0 mm under it: the revision's date, fixed.
    They sit outside the texts' stroke rule, which would thin the name to
    0.225 mm. The old 0.8 mm name goes. Silk only: no copper moved.
    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
    [data-port-x4-v2.kicad_pcb]
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2026-11-02 DATA x6: the power plane's three areas by priority, so a rebuild fills them as the board
    +3V3, +5V_A and +5V_B on the power plane are 0.2 mm apart along their
    splits, under the planes' clearance, so one of each pair pulls back. All
    three had priority 0: KiCad then picks by the zones' UUIDs, new at each
    rebuild from design.py and in each panel copy (the v2's panel halves
    flipped at random, 8b022a3e). Four refills of the board with fresh zone
    UUIDs gave four different fills (up to 7 mm2 moving between nets).
    Now +5V_A 2, +3V3 1, +5V_B 0: the one order of the six that reproduces
    the routed board's fill exactly, so no copper moves (Gerbers, renders and
    the viewer GLB come out the same). Four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
    [data-port-x6.kicad_pcb]
2026-11-02 DATA x6: no corner sharper than 45 degrees on the USB pairs and the crystal (ANGLE_RULE), USB-C 1's D− bent once more
    The v2's ANGLE_RULE on the x6: track_angle min 134 (a drawn 45-degree turn
    measures 134.9999) on the USB netclass and the hub crystal's XI / XO. It
    found one corner: USB-C 1's D− under the A column on B.Cu turned 67 degrees
    (113) at its via by A7, because that USBLC6 stands 5.7 mm off its
    receptacle and its pin's via lies 1.2 mm west of the turn, not 4.6 as on
    ports 2-6. conn_pairs() now draws port 1's line with one more bend, two
    turns of 43 degrees (137): 0.13 mm longer, so port 1's declared
    uncompensated skew goes from 4.05 to 4.15 mm (4.128 measured). The board
    tak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
    [data-port-x6.kicad_pcb]
2026-11-02 Boards: a check against pours KiCad would rank by their UUIDs
    electronics/tools/zoneprio.py reads a board file (no pcbnew, no shapely:
    it runs in the KiCad image and in CI) and lists every two pours of
    different nets on a common copper layer, with one priority, whose
    outlines come closer than their clearance (the larger of the zones' own
    and their nets' netclasses', from the .kicad_pro). One of such a pair
    pulls back, and KiCad picks which by the zones' UUIDs, new at each
    rebuild and in each panel copy: the fill flips between builds while DRC
    stays clean. It finds the DATA x4 v2's +3V3/+5V before 8b022a3e and the
    DATA x6's three plane areas before d717760a, and nothing on any board
    now.
    b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
    [build_board.py, zoneprio.py]
2026-11-02 Silk: one title block for every board, with the BitBunk logo
    The user's logo (electronics/tools/bitbunk-logo.svg) replaces the
    "hw-testing-rack" line. As drawn it cannot be printed: the boards on
    its two shelves have pins and chips 1-2 units wide. silk.derive_logo()
    makes its silk variant from the SVG: each shelf's board a plain convex
    silhouette, the gaps round the frame, the B, the boards and the i's dot
    opened to the wordmark's own tightest letter gap (5.54 units), the
    slivers those cuts leave dropped. `python3 electronics/tools/silk.py`
    writes its outlines to bitbunk-logo.silk.json (shapely, which the KiCad
    image lacks); the boards take them from there.
    title_block() is now the one b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
    [design.py, pcbgen.py, silk.py]
2026-11-02 DATA x6: the common title block on the rear face, 4 mm off J1
    The logo, "DATA ×6 v1.0" and 2026-11 (silk.title_block()) replace the
    front face's two lines ("hw-testing-rack 2026-11" dropped). The block
    sits in the rear face's top-left corner as read from below, slid 22 mm
    in and 19.5 mm down: the nearest spot clear of the test pads, their
    names, and J1's housing by 4 mm (the user: away from the connectors).
    Silk only: copper, parts and zone fills as they were. DRC without
    refill 0 / 0 / parity 0, ERC 0, BOM and CPL unchanged. test_silk.py
    now holds this board to the common block.
    [data-port-x6.kicad_pcb]
2026-11-02 DATA x4 v2: the common title block on the rear face, 4 mm off the connectors
    The logo, "DATA ×4 v2.0" and 2026-11 (silk.title_block()) replace the
    front face's two lines. The block sits in the rear face's top-left
    corner as read from below, slid 17.5 mm in and 22 mm down: the nearest
    spot clear of the test pads, their names, and the connectors by 4 mm
    (J1's housing, J2, the headers). This board has no free edge for it:
    it sets the four boards' largest slide.
    refill 0 / 0 / parity 0, ERC 0, panel DRC 0 and its halves match the
    variants, BOM and CPL unchanged.
    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
    [data-port-x4-v2.kicad_pcb]
2026-11-02 Power hub: the common title block on the rear face
    The logo, "POWER HUB v0.5" and 2026-11 (silk.title_block()) replace the
    front face's "hw-testing-rack · power hub v0.5", which had no date.
    The block sits in the rear face's top-left corner as read from below,
    slid 11.5 mm in and 11 mm down: the nearest spot clear of H1, the test
    pads and their names, and the connectors by 4 mm.
    Silk only, no re-route: copper, parts and zone fills as they were.
    DRC without refill 0 / 0 / parity 0, ERC 0, BOM and CPL unchanged.
    [power-hub.kicad_pcb]
2026-11-02 Bay node: the common title block on the rear face, the four boards alike
    The logo, "BAY NODE v0.5" and 2026-11 (silk.title_block()) replace the
    rear face's "hw-testing-rack · bay node v0.5", which had no date. The
    block sits in the rear face's top-left corner as read from below,
    against the edge and 21 mm down: the nearest spot clear of H2, the test
    pads and their names, and the connectors by 4 mm. POS OUT's name
    takes design.py's position again (0.003 mm: the last stroke pass had
    rounded it).
    With the four NextPCB boards moved, title_lines() goes, test_s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
    [bay-node.kicad_pcb]
2026-11-02 Title block: compact, the logo 25.5 mm, in the top-right corner from below
    Three changes to the block on all four boards, so the camera pod's
    40 × 27 can take it too:
    - the logo 25.5 mm wide, as the user confirmed (its gaps 0.24999 mm);
    - one line under it, 0.6 mm down: the name and revision at 1.5 mm,
    then 1.5 mm further the date at 1.0 mm on the same baseline. pcbgen
    places the date from the name's ink (a text's "after"), and texts
    take a vertical justification ("vjust");
    - the rear face's top-right corner as read from below (top view x 0,
    y 0): with the shorter block it has the smallest slides. The bay node
    takes the corner itself; the power hub and the DATA ×6 stay against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
    [bay-node.kicad_pcb, data-port-x4-v2.kicad_pcb, data-port-x6.kicad_pcb, power-hub.kicad_pcb]
2026-11-02 Camera pod: the common title block on the rear face
    The logo, "CAM POD v1.0" and 2026-11 (silk.title_block()) replace the
    front face's "CAM POD v1.0", which had no date. The block sits in the
    rear face's top-right corner as read from below, against the rear edge
    and 2 mm in: the board's one band free for it, between H1 and the SCK
    test pad. test_silk.py now holds all five NextPCB boards to the block.
    Silk only, no re-route. DRC without refill 0 / 0 / parity 0, ERC 0,
    BOM and CPL unchanged.
    [camera-pod.kicad_pcb]
2026-11-02 Camera pod: silkscreen text at a 0.15 mm stroke, and the rule that keeps it
    The pod's texts were at 0.12 mm (15 % of 0.8 mm), under NextPCB's least
    line. They now take max(0.15, 15 % of their height), as on the other
    boards, and its .kicad_dru carries the same SILK_RULE (a text under
    0.15 mm is a DRC error). The footprints' own silk lines stay at the
    library's 0.12 mm, as on the other boards.
    Silk only, no re-route. DRC without refill 0 / 0 / parity 0 (all
    severities clean), ERC 0, BOM and CPL unchanged.
    [camera-pod.kicad_pcb]
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2026-11-02 Title block: 1 mm of air from any other silk, measured on the real shapes
    electronics/tools/silkair.py measures the block (the logo's outlines,
    the name and the date) against every other item on its face, on the
    shapes KiCad plots (text ink, outlines, pads, holes, courtyards): 1 mm
    from other silk texts and marks, 0.3 mm from pads, holes and parts'
    courtyards (test pads' left out), 4 mm from the connectors.
    build_board.py --check fails on a closer item, so the Hardware CI
    holds every board to it; test_silk.py runs it where pcbnew imports.
    Measured before: the power hub 0.81 mm from VSNS, the DATA ×4 v2 0.66
    from LOGIC ONLY and 0.76 from STB1, the camera pod 0.89 from TP5's
    ring. Each bloc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
    [camera-pod.kicad_pcb, data-port-x4-v2.kicad_pcb, data-port-x6.kicad_pcb, power-hub.kicad_pcb]
2026-11-02 Bay node: the title block 5.25 mm along the rear edge, clear of H1's screw head
    H1 is a bare M3 hole: its screw head or standoff covers its 6.4 mm
    courtyard, and the block's "k" sat 2.90 mm from its centre (the
    courtyard's radius 3.49). The block moves 5.25 mm along the rear edge,
    the nearest spot that keeps the courtyard + 0.5 mm, 1 mm of other silk,
    0.3 mm of pads and holes and 4 mm of the connectors. The check itself
    comes to silkair.py with the power hub's move, so that no commit fails it.
    silkair 0, BOM and CPL unchanged.
    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
    [bay-node.kicad_pcb]
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2026-11-02 DATA x4: no via in the +5V band, 1.3 mm of plane became 3.3 mm
    All of the +5V (3.09 A: four ports at the TPS2553s' 0.644 A limit, the LDO,
    the matrix) reaches the ports through the converter's In2 tongue, a 4 mm band
    down the cradle's band. Two things cut it: a GND stitching via every 4 mm
    (1.1 mm of anti-pad each) and LDO_WEST's 3 x 3 +3V3 vias, which left 1.30 mm
    of copper across at y 52.
    - LDO_WEST's two west columns (x 2.5, 3.85) dropped; the x 5.2 column stays,
    on the band's edge, with the tab's six
    - a vias-only keep-out over the band (x 1.3-4.65, the tongue's foot to 1.5 mm
    past the split): the stitching skips it, the edge fence (x 0.9) still ties
    the outer pours there
    Resist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
    [data-port-x4.kicad_pcb]
2026-11-02 DATA x6: no via in the +5V bands, 2.9 mm of plane became 4.0 mm
    Each converter's In2 tongue reaches its three ports' switches through a 4 mm
    band down the cradle's band (1.93 A at the TPS2553s' 0.644 A limit). A GND
    stitching via every 4 mm took 1.1 mm of it each: 2.90 mm (+5V_A) and 2.84 mm
    (+5V_B) of copper left across.
    A vias-only keep-out over each band (x 1.3-5.5 and W-5.5 to W-1.3, the
    tongue's foot to 1.9 mm past the split): the stitching skips them, the edge
    fence (x 0.9) still ties the outer pours there. 22 vias gone.
    Resistive solve of the In2 fill (0.5 oz), 1.93 A a band: narrowest cut
    2.90 / 2.84 -> 4.00 / 3.94 mm (IPC-2221 internal, 0.5 oz, 10 K: 3.9 mm),
    worst drop 34 -> 31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
    [data-port-x6.kicad_pcb]
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
