kartben/hw-testing-rack/(notices)

Notices in the files:
docs/coproc-firmware-research.md:
Licence | GPL-3.0 | GPL-3.0 | MIT (some LGPL-3/BSD-3 parts) | MIT or Apache-2.0
L control, a USB host class for its CDC data interface, and a gusmanb protocol client for the web UI, written from a protocol description of our own (GPL code is not copied).
Risks | A one-maintainer project, slow in 2026, whose protocol follows its app (pin the release). Redistributing the UF2 means GPL source obligations: point at the exact upstream tag.
